britams/-capstone-project-repo/cad/README.md

# cad — FreeCAD 모델과 그림 (시간순)

담당: 서현. 모델은 생성 스크립트(`.py`)로 만들고 `.FCStd`를 함께 올린다. 치수는 `design/`의 설계 변수표(D6)와 상용 트랩 실측표에서 읽는다.
**지금 기준은 D5e다** (아래 7·8번). 서현 PC 사본은 `capstone design_이서현\CAD files\`에 있다 (FCStd + jpg, 11/02 정리).

## 규칙 (서현 지시, 11/01~02)
- 모델을 바꾸면 **그림(PNG/JPG)도 다시 만들어 올린다**. 사람이 바로 볼 수 있어야 한다. 정투영으로 렌더하고, 렌더 전에 시점 전환 애니메이션을 끈다(`setAnimationEnabled(False)`). 켜 두면 시점이 덜 돌아간 채 찍힌다.
- **전체 조립도에는 2020 알루미늄 프로파일 프레임과 상용 트랩을 반드시 같이 그린다.** 모듈만 있는 그림은 "모듈 확대"로만 쓴다.
- 프레임은 **정방형 20 시리즈(2020)만** 쓴다.
- 구매 부품 치수는 제조사 외형도나 McMaster-Carr로 확인하고, 근거를 스크립트 주석에 적는다.
- 이음부(끼움 길이·면 접촉·나사 길)와 움직일 때의 간섭은 `D5e_check.py`로 검사한다. 통과 결과는 json으로 남긴다.
- 저장 위치는 두 곳이다: 레포 `cad/`, 그리고 서현 PC `CAD files\`(FCStd + jpg).

## 시간순 기록

| # | 날짜 | 판 | 무엇이 바뀌었나 | 파일 | 그림 | 로그 |
|---|---|---|---|---|---|---|
| 0 | 10/02 | 초기 스케치 | 재설계 전, 스탬프 방식 첫 스케치 (Inventor). 10/28 재설계로 쓰지 않음. 내용은 파일 이름 기준 설명이고 열어 보지 않았다 | `10.2_first_stamp_method_sketch.ipt` | — | — |
| 1 | 10/28 16:26 | D5 1차 | 개념 모델, 안 1 바닥 승강형 (대기·마킹 두 자세) | `D5_concept_an1.py`, `D5_concept_an1_down/_up.FCStd` | `D5_도1_측단면_대기.png`, `D5_도2_측단면_자세고정_마킹.png` | CAP-AI-11 |
| 2 | 10/28 17:16 | D5b 2차 | 상용 트랩 실측 반영. 원통 하우징을 없애고 **바닥에 서는 2020 프로파일 프레임**으로 바꿈. 트랩과는 포획통 쪽만 결합 | `D5b_frame_an1.py`, `D5b_frame_an1_down.FCStd` | `D5b_전체_등각.png`, `D5b_측단면_대기.png` | CAP-AI-13 |
| 3 | 10/28 17:52 | D5c 3차 | 모듈 다시 그림. 겹침 0·뜬 부품 0 자동 검사 시작, 도면부호 그림 도1~4 | `D5c_module_an1.py`, `D5c_module_an1_mark/_rest.FCStd` | `D5c_도1~도4_*.jpg` (도면부호), 원본 `원본_렌더/D5c_A~D_*.png` | CAP-AI-14 |
| 4 | 10/28 19:50 | D5d 4차 | 안 B: 마커 XYZ 3축(28BYJ-48 ×3 + T8, SG90 펜 들기). 카메라를 격자 위 200 mm로(AI 카메라 최소 초점 20 cm). 카메라 시야 가림 0 검사 | `D5d_module_an1_B.py`, `D5d_module_an1_B_mark/_rest.FCStd` | `D5d_도5~도8_*.jpg` (도면부호), 원본 `원본_렌더/D5d_A~D_*.png` + 도면부호 위치 `D5d_pts*.json` | CAP-AI-16 |
| 5 | 10/28 21:21 | D5d 보완 | S4 1차 환류: X·Y 볼 부싱(LM8UU·LM6UU), 빔 끝 블록 두께 18, 샤피 크리에이티브 치수 | 위와 같음 | 위와 같음 | CAP-AI-18 |
| 6 | 11/01 | **D5e** 움직이는 모델 | D5d 이음부 결함을 찾아 모두 고침 (아래 표). 구동기 정밀 모델, 관절 변수 스프레드시트로 움직임, 이음부 86개·이동 17자세 간섭 검사 통과, 한 마리 처리 동영상 | `D5e_module_kinematic.py`·`.FCStd`, `D5e_check.py`·`D5e_check_result.json`, `D5e_animate.py`, `D5e_compose_video.py` | `D5e_동작_한마리처리.mp4`·`.gif` | CAP-AI-20 |
| 7 | 11/02 | **D5e 전체 조립** | 2020 실제 T홈 단면 프레임(부재 25개 + L 브래킷 32), 상용 트랩 상세, D5e 모듈을 한 문서로. 프레임·트랩과 모듈의 겹침 0 | `D5e_full_assembly.py`·`.FCStd`, `D5e_drawing_sheet.py` | `D5e_전체조립도.png`, `D5e_도1_전체_등각.png` ~ `D5e_도5_모듈_등각.png` | CAP-AI-21 |

## 6. D5e — D5d에서 찾은 결함과 고친 것 (11/01, FreeCAD로 확인)

| D5d 결함 | 근거 | D5e에서 고친 것 |
|---|---|---|
| 문판이 돌 자리가 없어 안 열림 | 15~90° 회전에서 하우징과 19~40 mm³ 겹침 | **MG90S 혼 핀이 문판 세로 홈을 미는 미닫이(스카치 요크)**: r 9, 혼 +60° 닫힘 / −60° 열림, 행정 15.6 |
| 펜 들기 부족 | 혼 최대 들림 8.46 < 캡 컵에서 빠지는 데 필요한 8.56 mm | 혼 끝(반지름 14, 끝 둥글기 2)이 늘린 평평한 탭을 밂 → 들림 10 mm. 홀더는 안내 핀 Ø3 ×2(슬리브 40)로 안내 |
| 마커가 격자 −x 끝에서 갠트리 레일과 겹침 | 1,140 mm³ | 갠트리 받침 레일 x 25 → −18, X 봉 −x 끝 19 → 9, −x 받침 늘림 |
| 리드스크루에 너트 없음 | 모델에 너트 부품 없음 | T8 황동 플랜지 너트(Ø22×3.5, 몸통 Ø10.2, 길이 15) 3개 |
| Y 봉이 끝 블록에 맞대기만 됨 | 끼움 길이 0 | Y 봉 z 445/475 → 438/468로 내려 끝 블록에 10 mm 끼움 |
| 밀대가 스프링을 건너뜀 | 스프링이 1 mm 떨어져 하중 경로에 없음 | 밀대 칼라가 스프링을 누르도록 |
| X 모터가 몸통으로만 닿음 | 귀(나사 구멍) 고정 없음 | 모터 판 + 귀 2개 나사 자리 |
| 모터 축 길이 비현실 | — | 28BYJ-48 외형도 치수(Ø28×19, 귀 35, 축 Ø5 D컷, 축 8 치우침) |
| 통로 꺾임이 관 두 개를 겹쳐 붙인 모양 | 서현 지적 "통로 모양이 말이 안 됨" | 굽힘관(중심 반지름 20)으로, 빛 게이트는 세로관에 |

구동기·구매품 치수와 근거:
- 28BYJ-48: Ø28×19, 축 Ø5(D컷 3, 길이 6), 축은 몸통 중심에서 8 mm 치우침, 귀 구멍 간격 35 (부품 외형도)
- SG90: 22.2 × 11.8 × 22.7, 귀 32.2. MG90S: 22.8 × 12.2 × 28.5
- 커플링 5 → 8 mm, Ø19.1 × 25.4 (McMaster-Carr 4147N159와 같은 치수)
- LM8UU Ø15×24, LM6UU Ø12×19

움직이는 법: `D5e_module_kinematic.FCStd`를 열고 스프레드시트 `Joints`의 값을 바꾼 뒤 다시 계산(Ctrl+R)한다. 값은 floor(바닥 0~36.5), xm·ym(마커), horn(펜 서보), support, door_entry·door_iso·door_rel(+60 닫힘 / −60 열림), 말벌 hx·hy·hz·hpitch다.

## 7. D5e 전체 조립 (11/02)
- 프레임 2020: 기둥 610 × 4, 레일 320 × 21 (둘레 4단 16, 가로 4, 갠트리 받침 1), 합계 9.16 m, L 브래킷 32. 바깥 360 × 360, 포획통 꼭대기까지 845 mm
- 상용 트랩(REF, 하중 없음): 유인액 통, 몸통, 노란 깔때기 ×2(Ø50 → Ø19), 차양막(Ø260, 윗면 180, 구멍 55, 4토막 턱 Ø90), 포획통(높이 220, 바닥 Ø94), 고무마개, 실리콘 포획술. 실측표 값을 쓰고, 몸통 지름과 포획통 최대 지름은 사진 비례로 잡았다 [추측]
- 다시 만들기 (FreeCAD 1.x 파이썬 콘솔):
  `import sys; sys.path.insert(0, r"<repo>\cad"); import D5e_full_assembly as A; doc = A.make_full(); [A.render(doc, r"<repo>\cad", v) for v in A.VIEWS]`
  → 이어서 `python3 cad/D5e_drawing_sheet.py cad` 로 한 장 조립도를 만든다

## 다음 수정 (D5f 예정)
- 펜 홀더 안내 핀을 혼이 미는 줄 쪽으로 옮김 (e_y ≤ 10 mm → 끼임 한계 μ_c 0.44 → 0.99, S4 2차 SJ-29). 그때까지는 핀을 PTFE 테이프로 감아 쓴다 (D6 10장)
- 스프링 204는 모델에서 뺌 (11/02 결정, S4 M3·M8)
- 전기 (11/02 결정, `design/2026-11-02_전기계통_제어순서_서현.md`): **Pi 5 상자를 같은 x·y에서 위판 아래(z ≈ 540~575)로 올림** (카메라 리본 680 → 290 mm, AI 판단·서현 위임), UNO 2를 UNO 1 위 15 mm 기둥에 겹침, 데크 위 단자대·퓨즈 자리(x −30, y −65), 비상 정지 버튼 자리, 구동 레일 배럴 잭(배터리 상자도 같은 플러그)
- 빛 게이트 9쌍 자리: G1·G4·G6 + **문마다 빔 2개(문판 앞·뒤 각 2 mm: 입구·격리 x ≈ 23·29, 방생 x ≈ 81·87)** (11/02 결정), 문판 앞 끝 실리콘 립 1 mm, 아래 조명, 투명 격자 (VespAI 점검)

## 2026-11-06 — D5f 전기 배치 (자리 표시, CAP-AI-23)
- `D5f_electrical_layout.py` → `D5f_electrical_layout.FCStd`, 그림 `D5f_전기배치_등각.png`, `D5f_전기배치_정면.png`, `D5f_문빔_위.png`
- D5e 전체 조립 위에 11/02 결정을 블록으로 표시: Pi 5 + AI HAT+를 위판 아래(z 565~600, CSI 300 mm), UNO 2를 UNO 1 위 15 mm, 단자대·퓨즈, 비상 정지, ULN2003 ×3, 빛 게이트 9쌍(송신·수신 블록 + 빨간 빔)
- 15:40 다시: **스프링 204 지움**(11/02 결정, 승준 Issue #7-4), 28BYJ-48 고정은 **M4 × 2** (귀 구멍 Ø4.2, Issue #7-8)
- 16:50: 문 하우징 112·170·176 위·아래 벽에 빔 구멍 Ø4.2 (입구·격리 x 23·29, 방생 81·87, y 0), LED Ø4 × 8 자리 [추측 — 실물 확인]. ULN2003 X·Y는 2020 기둥 바깥면, G6 위아래 빔. 겹침 검사 0건 (`D5f_electrical_layout.check`)
- **남은 것**: LED·보드 고정 브래킷 모양, 실물 LED 치수 확인

### D5f 바닥 안내 — 기성품 최대 (2026-11-06 18:38, 서현, CAP-AI-27)
- 서현 "최대한 기성품으로 사용할 수 있게 하고, 바꿔" → `D5f_electrical_layout.py`의 `floor_guide()`
- 지움: D5e 146 스프링·147 PLA 밀대·148 로드셀 (캐리지 위)
- 새로: 147 Ø4 × 80 경화 축, 149 LM4UU (캐리지 158 안), 146 스프링 (캐리지 아래 컵의 Ø4.4 구멍), 148 버튼 로드셀 (컵 바닥) — 넷 다 기성품. 컵은 캐리지와 한 몸(출력)
- 축 자리 (65, 4): 커플링·너트 플랜지·가이드봉 157을 피함. 바닥판 121 가운데 Ø5 구멍 막고 (65, 4)에 Ø6 비접촉 구멍, 바닥 140 축 자리 이동
- 바닥판 121에 LM4UU를 못 넣은 이유: 길이 12 > 판 5 → 아래 보스에 칼라가 바닥 끝까지 오를 때 부딪침
- `check_floor()`: 바닥 무리를 0 / 18.25 / 36.5 mm 올려 겹침 0건, 무리끼리 0건, 전기 배치 `check()` 0건
- 그림: `D5f_바닥안내_정면.png` (새), 등각·정면·문빔 다시
- 계산: `design/2026-11-06_S4_스프링146_역학계산_2차_서현.md` 8장

## 2026-11-06 저녁 — D5g 프레임 상세 + 부품 4분류 (승준, CAP-AI-SJ-39)
- 새 스크립트 `cad/D5g_frame_detail.py` — D5f를 그대로 만든 뒤 프레임만 바꿈 (D5e·D5f 스크립트는 안 고침)
- 2020 단면을 실제 모양으로: 홈 입구 6.2, 턱 1.8, 언더컷 11.0, 깊이 6.1, 코어 7.4, Ø4.2 → `section_check()` 0.452 kg/m · 0.717 cm⁴ (데이터시트 0.45~0.50 · 0.72)
- 브래킷 32(리브·홈 키·Ø5.5), M5 × 8 볼트 64, M5 슬라이드 T너트 64 — `check(doc)` 겹침 0건, T너트 64개 홈 안
- 모델 트리를 A 구매품 73 / B 설계품 42 / C 참고 10 / D 전기 자리 21 로 묶고 색칠 → 표 `cad/2026-11-06_D5g_부품분류_구매품과_설계품.md`
- D5f에 남아 있던 P204a·P204b(뺀 스프링 바탕) 지움. .FCStd·그림은 아직 안 만듦 (승준 PC FreeCAD에 열려 있음, 저장 안 함)

## 2026-11-06 밤 — D5g 급이 방·ULN2003·떠 있던 부품 (승준, CAP-AI-SJ-40)
- `cad/D5g_feeder_uln.py` (G.make()가 부름): 설탕물 급이 = 팰컨 50 mL 거꾸로 + 코튼롤 2호 + 143 물길·그릇·기둥, 120 벽 Ø10.6 구멍, 144·142 상자 뺌
- ULN2003 판매품 모양 35 × 31.9 × 11 (X·Y는 갠트리 레일 위 197 받침, F는 데크), Pi 5 선반 199a, G4·G6 받침 199b·c
- T너트 판매품 10 × 9.5 × 4.5(아래 경사), 브래킷 키 0.5. 새 부품 겹침 0건, `floating()` 남은 것 0 (빛 빔 제외)
- 상용 트랩 포획통(REF_trap_container)은 지우지 않음 — 보기용으로 숨기지도 않기
- 설명: `design/2026-11-06_급이방_개념설계_ULN보드_승준.md`

## 2026-11-06 밤 — D5g 이음부·체결·급이 방 상세·막대 로드셀·서현 회로 요청 (승준, CAP-AI-SJ-49)
- 승준 지적: 프로파일 연결 안 됨 / 부품 지지 안 됨 / 부품 명시 안 됨 → 전부 고침
- `D5g_frame_detail.joint_places()`·`add_joint_hw()`: 가로대 100c ×4·갠트리 레일 100d 양 끝 T 이음 브래킷 20 + M5 × 8 40 + T너트 40 (옆면에 — 아래 면은 받는 레일 높이 20을 넘어 볼트 홈이 없음)
- `D5g_fasten.py` (새): 닿음 그래프(거리 ≤ 0.3)로 확인 후 '닿기만' 한 것 볼트 체결 — 218 X 봉 받침(둘레 레일 쪽은 봉이 지나가서 귀 + M5 × 12), 217 X 모터판 날개, 105 위판·101 데크 M5 × 10 × 4, 199a Pi 선반·194b 비상 정지 판 M5 × 8 × 2, 151 옆판·102 칼라는 데크 아래 M3 × 10 → 인서트
- `D5g_feeder_uln.feeder_detail_apply()`: 마킹실 벽 보스 2 + 물길 귀 M3 × 8, 뚜껑 손나사 4 (기둥 위 인서트), 튜브 똑딱 집게 고리, 코튼롤 잡이 리브. McMaster 94459A130·92545A111·91292A112·7979T44 (페이지에서 직접 확인)
- `loadcell_apply()`: 148 버튼형 → Adafruit 4540 막대(80 × 12.7 × 12.7), +y로 뻗음, 캐리지 팔 158a에 M5 × 12 × 2, 자유 끝 받침판 148s + M4 × 10. 급이 기둥 x −3 (자리 비움)
- `D5g_real_parts.apply_wago()` 5개 / `apply_circuit_extras()` 서보 허브·게이트 허브(+ J_I2C XH 4P)·MOSFET 모듈·패널 퓨즈 / 문 빔 LED 다리: 하우징 살 밖에서 90° 꺾어 옆으로 6 mm (자동 탐색)
- 새 부품·고친 부품 55개 ↔ 전체 184개 겹침 검사 0건 (인서트·나사산 맞물림, 핀이 기판을 지나는 것은 구멍으로 모델) [확실 — 스크립트]
- 부품표 `cad/2026-11-06_D5g_부품표_승준.md` (`D5g_parts_table.py`가 모델에서 뽑음), 그림 `cad/img/D5g_parts_balloon.png`·`D5g_feeder.png`·`D5g_loadcell.png`·`D5g_joint_T.png`
- .FCStd 저장 안 함 (서현만 편집 규칙) — `G.make()`로 다시 만듦 (승준 PC 약 55 s)

## 2026-11-08~09 밤 — D5g 서현 요청 고침: 십자 나사·문 서보·모터 귀·카메라 CM3·회로 기판·3D 프린트 색 (승준, CAP-AI-SJ-53)
- 새 스크립트 2개, `G.make()` 끝에서 부름 (다른 D5 스크립트는 안 고침 — `D5g_frame_detail.py`는 부르는 4줄만):
  - `cad/D5g_fix_sj53.py` — 나사·문 서보·모터 귀·카메라·홈 파기·드라이버 검사·색
  - `cad/D5g_circuit_sj53.py` — 허브 기판 2장·MOSFET 모듈·기판 나사 (서현 `전기회로/hub_boards.py`를 GitHub에서 받아 그대로 배치, KiCad 공식 3D)
- 1 브래킷: 육각 렌치 볼트 → **십자 냄비머리 ISO 7045** 전부 (M2~M5). 브래킷 100f·100f2 M5 × 8 104개는 자리를 placement에서 다시 계산 → 머리끼리 겹침 0 (틈 위아래 0.3·옆 0.25 mm) [확실 — 모델]
- 7 문 서보 112·170·176: 기둥이 하우징 밖으로 떠 있던 것 → 하우징 −y 7.4 mm 늘려 기둥 2개 모두 한 몸, MG90S 귀 M2 × 8 셀프 탭 6개
- 7 스테핑 모터 153·209·215: 귀 양쪽 M3 × 8 + 너트 (M4 너트는 몸통 R14에 틈 0). 153은 로드셀과 닿아 접시머리 + 152 접시 자리, 151 L/R에 드라이버 홈 [서현 M4 결정과 다름 → Issue]
- 카메라: AI 카메라(최대 30 fps) → **Camera Module 3 (IMX708)**, 1536 × 864 @ 120 fps 모드(가운데 잘라 씀)로 720p 60 fps. 렌즈 끝 → 격자 **153.5 mm**, 걸이 181(위판에 M3 × 10 + 인서트), 링 조명 182, 시야 `REF_camera_view`
- 2 회로: 허브 193v·193g 구멍·헤더·부품·선(버스·땜납 다리·점퍼), MOSFET 모듈 부품 26 [추측 — 판매 사진 배치]. 나사 단자는 덱 가장자리(+y) 쪽으로 돌림 (−y는 게이트 허브와 5 mm라 전선 못 꽂음)
- 기판 고정: 암-암 기둥 + 위·아래 십자 나사. 데크 밑 가로대(y +80) 위 4자리는 **198n 나일론 스페이서 + 긴 나사(M2 × 14 / M3 × 12)를 데크 아크릴 탭 구멍에** (아래 나사가 가로대에 박힘)
- 색: B1 3D 프린트 **주황 (0.95, 0.45, 0.05)** 41개 / B2 판 가공 베이지 (데크 101·위판 105) / 황동 = 인서트·T너트·기둥 / 새 나사 거의 검정
- 검사 [확실 — 스크립트]: 새 부품 ↔ 전체 겹침 = 나사산 맞물림(기둥·탭 구멍·셀프 탭)과 아래 3가지뿐
  - 서보 허브: C2(디스크) ↔ SB540 몸통 1.9 mm³, C2 ↔ 1000 µF 2.1 mm³ — **서현 배치 17·18·19열이 너무 붙음** → Issue
  - 서보 허브: SB540 다리 Ø1.2~1.3 > 만능기판 구멍 Ø1.0 (1.7 mm³) → 두 구멍 Ø1.5로 넓혀야 → Issue
  - 게이트 허브: J_I2C 하우징 ↔ 옆 헤더 핀 0.13 mm³ → Issue
- 드라이버 검사 (머리 위 60 mm, PH 드라이버 지름): 기판 나사 24개 모두 됨. 안 되는 13곳은 조립 순서로 — 카메라 M2 × 4는 링 조명 전에, 바닥 모터 M3 × 2는 캐리지·로드셀 전에, Y 캐리지 M3 × 2는 캐리지 옮기고. 143s M3 × 2·158 받침 M4·175 서보 M2·급이 발 M5는 남은 문제
- 그림: `cad/img/D5g_SJ53_*.png` 8장 (전·후, 이름표·화살표). .FCStd 저장 안 함 — `G.make()`로 다시 만듦 (승준 PC 약 75 s)

## 2026-11-09 — D5g 서현 인수: FCStd 저장, C3 HX711·DC 잭, 원점 스위치 3개, 투명 격자, 그림 (서현, CAP-AI-55)
- **C1** `cad/D5g_full.FCStd` 처음 저장 (9.8 MB, 물체 208 · 고체 약 3780). [확실] 승준 스크립트는 GUI 전제(`ViewObject`)라 freecadcmd로는 멈춤 → **FreeCAD GUI를 매크로와 함께 실행**해 만들고 검사 (`freecad.exe <매크로>`, 서현 PC 약 3분)
- **C2** 검사 (서현 PC): `check(doc)` 프레임 겹침 **0건**, 뜬 부품 **0건** (승준 `floating()`과 같은 판정을 고체 상자로 먼저 거르게 해서 87 s — 원래 함수는 이 PC에서 1시간 넘게 안 끝남). 승준 기록과 같음. 게이트 허브 부품 ↔ 선 14 mm³는 승준 모델에도 같은 값 = 납땜 자리
- **C3** `D5g_c3_hx711_dcjack.py` (새, `make()` 끝에서 부름)
  - HX711 198x: 제안 자리 (66, 95)는 급이 물길 143과 468 mm³ 겹치고 데크(y ±90) 밖 → 데크를 2 mm로 훑어 빈 자리 3곳 중 가장 가까운 **(−44.5, 54)**, 긴 쪽 y. 받침 198xc (3D 프린트) + M3 × 8 접시머리 2 (데크 탭)
  - DC 잭 194j: 제안 (−184, −22)은 비상 정지 버섯 머리(Ø40)와 플러그가 겹침 → **(−184, −35, 225)**, 194b 판을 −y로 22 mm 늘리고 Ø8 구멍
  - 겹침: 나사산 맞물림(데크 탭)뿐
- **J_I2C 193j** (Issue #9-5, 펌웨어 대화 CAP-AI-54): `D5g_real_parts.py` 4줄 — 게이트 허브 줄 6 칸 22~25 가로, 1번 핀 판 기준 (57.86, 16.27)
- **원점 스위치** `D5g_home_switches.py` (새, 서현 결정 11/09): KW11-3Z 3개 (승준 `sj_purchased_parts.py` 치수) — 레버가 닿는 면은 선을 쏘아 잼
  - F 227f: 151_L 안쪽 면, 바닥 0 mm에서 캐리지 158 아랫면 **z 262**가 누름
  - X 227x: 새 집게 226 (X 봉 −y, 3D 프린트, M3 조임) 밑, **xm 37 (펌웨어 X −18)**에서 Y 모터 브래킷 211 −x 면이 누름
  - Y 227y: 끝 블록 212A −x 면, **ym −40**에서 **펜 홀더 202 −y 면(y −54)**이 누름 — 캐리지 206 −y 면은 212A가 1 mm 틈으로 가려 못 씀
  - 검사 `HS.check(doc)`: 닿음 F 0 · X 0.044 · Y 0 mm, X 4 × Y 3 × 바닥 2 = 24 자세 겹침은 M2·M3 나사산뿐 (38 s)
  - → **펜 대기 자리 = 캡 컵 219 (CAD 65, −40) = 펌웨어 X +10 · Y −40** (X 0 = CAD 55, 원점 −18 = CAD 37). Pi `Config.park` 값 그대로 맞음 [확실 — 모델]
- **카메라 시야** (3-A 3): 렌즈 끝 z 540 → 격자 z 386.5, 40 × 40 기둥 안에 닿는 부품 0 (대기 자리에서 펜·캡 컵은 y −49~−23) [확실 — 모델]
- **격자 130 = 투명 아크릴 1.5** (서현 11/09, 구멍 그대로 — 그림은 하늘색 반투명). 링 조명 반사는 조명 시험 때 확인
- **모터 귀 = M3 × 8 + 너트 + 평와셔** (서현 11/09, Issue #9-2). 와셔는 부품표에만
- **C4** `D5g_render.py` (새, GUI 매크로, 정투영·애니메이션 끔): `img/D5g_도1_전체_등각`·`도2_정면`·`도3_측면`·`도4_위` (프레임 + 상용 트랩), `img/D5g_전기배치_위`, `img/D5g_부품번호_풍선도` — 한 장씩 열어 확인 (화살표 끝 자리 0.52배 어긋남 → 고침, '−' 글자 없음 → '-')
- 다시 만들기: `freecad.exe` 파이썬 콘솔에서 `import sys; sys.path.insert(0, r"<repo>\cad"); import D5g_frame_detail as G; doc = G.make()` (인터넷 필요 — KiCad STEP·hub_boards.py) → 그림은 `set D5G_FILE=...` 후 `freecad.exe cad\D5g_render.py`
- 남은 결정 (정하지 않음): 방생 출구 안 1/2, 급이 바닥 높이 370, 3D 프린터 판 크기, 드라이버 안 들어가는 4곳 (SJ-53)

## 2026-11-10 — 급이 방 고침 (서현, CAP-AI-56)
- 11/06 급이 방 결함 3개 [확실 — `cad/feeder_check.py`·모델]: ① 맑은 날 열팽창으로 물 +6.7~13.0 mm → 벽 구멍(여유 3.6) 넘어 마킹실로 샘 (승준 계산 2.6 mm는 물 면적에 튜브 자리를 셈 + 수증기 빠뜨림) ② 솜 끝이 마킹실로 4 mm 나와 바닥이 33 mm 넘게 오르면 짓누름 ③ 급이 높이 F 10이면 솜이 말벌보다 23 mm 위
- 고침 (`D5g_feeder_uln.py` FD): 튜브 50 → **15 mL (코닝 352096)**, 물(입구) 369 → **366**, 솜 안 끝 (16, 379) → **(21.4, 378) 벽 안 면 뒤 0.2**, 바깥 끝 (58.28, 368.85), 벽 구멍 z 378.0, 받침 리브 반지름 8.3. 급이 높이 F 31 (pi_link·trap_sim)
- 검사: `python cad/feeder_check.py` 6개 통과 (11/06 값은 1·4번 실패). 서현 PC에서 `G.make()` 다시 → `D5g_full.FCStd` 저장, 급이 부품 ↔ 전체 겹침 0, 바닥 0~36.5 mm 올림 vs 솜·벽·물길 겹침 0
- 그림: `img/D5g_급이방_단면_x55.png` (모델을 x = 55에서 자른 선, FreeCAD 안 matplotlib), 전체 그림 6장 다시 (`D5g_render.py`). 원리 동영상 `design/img/feeder/급이방_원리.mp4` (`design/calc/feeder_anim.py`)
- 설명: `design/2026-11-10_급이방_원리_사용법_고침_서현.md`

## 2026-11-10 오후 — 급이 방 McMaster 상세 + 부품별 파일 (서현, CAP-AI-57·58)
- McMaster STEP 5종을 받아 `cad/vendor_step/`에 둠 (레포에 안 올림). 급이 방 나사·인서트를 실제 모양으로 넣는 것은 `D5g_feeder_mcm.py`.
- 발 고정을 바꿈: 위에서 조이는 M5 + T너트 → 데크 아래에서 조이는 M3 × 8 (92000A118) + 발 인서트. 위에서는 그릇·서보 허브·로드셀 때문에 드라이버가 안 들어감. 데크를 프레임에 올리기 전에 조인다.
- 물길을 마킹실 벽에 붙이던 나사 2개를 없애고 앞벽을 추가함. 뚜껑 구멍 깊이 7, 기둥 Ø9, 손나사 자리 y 60.
- 부품별 파일은 `cad/parts/feeder/` (`feeder_parts.py`): 부품 7종과 App::Link 조립 파일. 검사를 모두 통과했고 `D5g_full`과 같다. 자세한 것은 그 폴더의 README.
- 남은 결정: 143을 둘로 나눌지 (출력 서포트 문제), 프린터 판 크기.

## 기본 CAD 파일 (서현 11/10 16:26 지정)
- **기본 파일 = `cad/D5g_full.FCStd`**: 3D 프린트 부품은 파랑, 나머지는 회색 (`D5g_print_color.py`, `make()` 맨 끝에서 칠함). 그림과 검사는 모두 이 파일로 한다.
  - 레포 판: McMaster 나사·인서트를 표 치수로 만든 단순 모양 (레포가 공개라서)
  - 서현 PC `CAD files\D5g\D5g_full_McMasterSTEP.FCStd`: 같은 색, 나사는 McMaster STEP 실제 모양 (레포에 안 올림)
- 급이부 부품 파일 `cad/parts/feeder/`도 같은 색 규칙이다.
- 예전 D5b~D5f FCStd는 기록용이다. 고치지 않는다.
- 2026-11-14 (서현, CAP-AI-62) 리프트 v2 (`lift_v2.py`): 바닥 덩어리 → 스프링 McMaster 9657K33 + KY-024 홀 (2.5 mm 줄면 0.48 N). 홀 모듈을 판·LM393·가변저항·핀·SS49E(다리로 세움)로 그림. 마킹실 상자 프린트 파일 따로 `print/lift/300_마킹실상자.{stl,step,FCStd}` (`lift_v2_box_print.py`) — 인서트 Ø4 × 6 자리 (±14, ±14), 세로 모서리 R1. 검사: 겹침 0, 캐리지 레일 안, 펜 69/69
- 2026-11-14 (서현, CAP-AI-62) 리프트 v3 (`lift_v3.py`): MiniSlide·거더·스프링·홀을 버리고 mightyZAP D7-6PT-3 (디바이스마트 101,000원, 행정 26, 6 N, PWM 위치 지정) 하나로. 로드 끝 M3 무두 볼트 + 너트 2 + M4·M10 DIN 9021 = 바닥, 뒤 경첩은 세운 2020 옆 홈에 M3 × 20 + 원형 스페이서 Ø6 × 4 + T너트. 판매처 STEP은 PC 받은도면에만. 검사: 겹침 0 (바닥 −7 → +3), 펜 69/69, 로드 8 → 18 mm (행정 26 안)
- 2026-11-14 (서현) 마킹실 상자 바깥 46 → 38 × 38 (안 Ø31·높이 18.5 그대로, 인서트 (±14, ±14) 벽 3 mm), 재료 24.4 → 13.0 cm³. `print/lift/300_마킹실상자.*` 다시 냄. v3 검사 겹침 0, 펜 69/69
- 2026-11-14 17:30 (서현) 마킹실 상자에 격자 한 몸 (Ø3 · 간격 4.4 · 두께 1.5, 구멍 37 — 비전 자와 같은 격자) → 망·인서트·망 나사·와셔 16개 뺌. 안 Ø31 → Ø33 (여왕벌 30 + 2, `design/2026-11-12_마킹실_최소크기_계산_서현.md`), 바깥 40 × 40, 윗면 z 9.5, 재료 16.1 cm³. 바닥 = McMaster 90313A108 (Ø31.75 × 1.3) + M4 DIN 9021 + M3 × 8 무두 볼트 + 너트. 프린트는 윗면(격자)을 판에. 검사: 겹침 0, 펜 37/37
- 2026-11-14 17:30 (서현) 격자는 투명 아크릴 주문 제작으로 (두 번째 예외). 부품 파일 2개 따로: ① `print/lift/300_마킹실상자.{FCStd,step,stl}` (프린트, 40 × 40 × 18, 13.7 cm³, 윗면 M3 인서트 4) ② `print/lift/300p_아크릴격자판.{FCStd,step,dxf}` (주문 제작, 2T 40 × 40, 네모 구멍 3.0 간격 4.4 × 37 — 열린 면적 46 %, 나사 구멍 Ø3.4 × 4). DXF는 `lift_plate_dxf.py`로 (FreeCAD 없이). v3 검사 겹침 0, 펜 37/37
- 2026-11-14 18:15 (서현) 전체 수정 1단계: 마킹실 상자 38 × 38 (옛 벽 바깥과 같음), 문 구멍 4 (−x 입구·+x 방생·−y 격리 Ø13, +y 급이 Ø11.2 솜 축 따라), 날개 → 밑 혀 24 + M5 × 10 두 개 (세운 2020 +y 홈), 세운 2020 = 데크 205 → 361 (156 mm). 아크릴판 38 × 38 (나사 구멍 (±15, ±15)). 전체 좌표 = 리프트 좌표 + (55, 0, 377). `s2_chamber_v3_check.py`: 전체와 겹침 0 (옛 마킹실·바닥 구동·컵 받침 뺌, 문·통로는 2단계). 상자 9.45 cm³, 판 2.15 cm³
- 2026-11-14 21:45 (서현, CAP-AI-62) 전체 수정 끝: `s2_doors_v3.py` (S2 고쳐 씀 — 문 3개: 입구 −x 축 376.5 서보 +y · 방생 +x 서보 +y · 격리 −y, 격리 관 −y → 세로 (55, −135) → z 557 가로 → 깔때기, 대기 PARK (75, −40)), `full_merge.py` → `D5g_full.FCStd` + 바탕화면. 검사: 바뀐 것 ↔ S1·S2·S3 정지 겹침 0 (원래부터 있던 4개 빼고), 마커 움직임(`s2_motion_v3_check.py`) 새로 닿는 것 0
- 2026-11-14 23:40 (서현, CAP-AI-62) 바닥 원판 304: McMaster 90313A108 + M4 DIN 9021 (해외구매 → 정산 불가) → **아크릴 Ø32 × 2T 구멍 Ø3.4** (격자판과 같은 판, 같이 주문 제작). DXF `print/lift/300f_아크릴바닥원판.dxf` (`lift_plate_dxf.py`). 쌓임 4.67 → 4.4, 액추에이터 0.27 mm 위로. 검사 [확실 — CAD]: 리프트 혼자 sweep 0 · static 0 · 펜 37/37 · 누름 틈 5.0, s2_doors_v3 다시 → 바뀐 것 겹침은 원래 있던 G2↔110b 19.9뿐. S2 ← S2_v3, full_merge·움직임 검사 다시
- 2026-11-15 00:35 (서현, CAP-AI-62) 리프트 나사: 열압입 인서트(인두 필요 — '나사로 조이기만'에 어긋남) → 상자 윗면 밑구멍 Ø2.5 + M3 × 8 태핑 4, Ø6 × 4 스페이서(Harwin, 해외) → M3 너트 1 + DIN 125 와셔 3, 혀 나사 = 20시리즈 M5 스프링너트. 상자 프린트 파일 다시 (9.56 cm³, solid) · 리프트 검사 겹침 0. 아크릴 묶음 DXF `print/lift/300pf_아크릴_묶음_100x90_2T.dxf` (아크릴몰 50 mm 밑 재단 불가 → 격자판 2 + 바닥 원판 2를 한 장에)
- 2026-11-15 01:10 (서현, CAP-AI-62) 서현 "출력 대행 주문 OK" → 남은 프린트 부품 32개를 `print/all/`에 STL·STEP으로 뽑음 (`_print_all.py`, D5g_full 초록 부품, 모두 isValid·메시 닫힘, 합 423.7 cm³). 비상 정지 판 194b 구멍 Ø22.5 → **Ø25.5** (`s3_estop25.py`, KGE-J4R1R 25Φ 국내 재고) → S3·D5g_full 다시. CAD 안 비상 정지 몸체는 22Φ 대표 모양 그대로
- 2026-11-15 02:12 (서현, CAP-AI-62) '자르기·인두·탭' 없애기: ① 자르던 부품 13개(급이 물길·뚜껑·기둥·발·위·병 걸이, 깔때기 2, PVC 관 5토막) → 출력 대행 `print/all2/` (`_buyfix1115.py`, 모두 solid) ② 데크 101·위판 105 → 레이저 DXF `print/all2/*_레이저_5T.dxf` (탭 구멍 M2 1.6 → 2.4, M3 2.5·2.7 → 3.4 + 아래 너트) ③ **세운 막대 307v 밑 고정이 빠져 있었음** → L 브래킷 DCB 2025(−y 면) + M5 × 8 스프링너트 + M5 × 12·너트, 데크 구멍 Ø5.5 (73.3, −22) (`lift_v3.py`, `s3_deck_hole.py`) ④ 열압입 인서트 없앰: 카메라 걸이 181 구멍 Ø4 → 태핑 Ø2.5 (출력 파일도), 데크 인서트 100n → 관통 + 너트 (`s3_insert_to_tap.py`) ⑤ 바닥 F 드라이버(DRV8833) 자리 195p·198_F 지움. S2 ← S2_v3 (lift 라벨·브래킷), full_merge. 검사 [확실 — CAD]: s2_doors_v3 겹침은 원래 있던 G2↔110b 19.9뿐, 움직임 새 접촉 없음 (펜 내린 높이 4개 그대로). PC 클론 커밋 5758cda
- 2026-11-15 02:48 (서현, CAP-AI-62) 서현 "안 자르고 그대로" → 봉·T8 규격 길이: X 봉 Ø8 163 → **200** (+x), Y 봉 Ø6 124 → **150** (+y), 안내 핀 Ø3 69 → **70** (위), X T8 93 → **150** (−x, 모터 반대), Y T8 133 → **150** (+y). 먼저 `_stdlen_check(2).py`로 여러 길이를 움직임 범위에서 검사 [확실 — CAD]: X 봉 200~300·Y 봉 150~200·핀 70~80·X T8 100~300·Y T8 150~200은 218·212 막힌 구멍 말고 안 닿음, Y T8 300은 갠트리 레일·격리 관에, 핀 100은 문 하우징에 닿음. `s2_stdlen.py`로 S2 고쳐 씀 + 218(+x)·212(B) 구멍 끝까지 + 출력 파일 다시. 고정 겹침: 212 ↔ 227ys M2 셀프 탭 나사(원래 설계 — 나사가 블록에 박힘)뿐. 움직임 검사(고정 대상에 213·218 더함) 새 접촉 없음. ※ s2_doors_v3를 다시 돌리면 그 뒤에 s2_stdlen도 다시. PC 클론 커밋 edc7962
