britams/-capstone-project-repo/전기회로/README.md

# 전기회로 — 한곳에 모은 지도와 만드는 순서 (서현, 2026-11-08, CAP-AI-49)

**쉬운 설명(그림 포함)은 `전기회로_설계_쉬운설명.html`** — 더블클릭하면 브라우저로 열린다 (레포 폴더 안에서 열어야 회로도 그림이 보임).

## 0. 결론 먼저
- [확실] **회로는 이미 정해져 있다** (11/06, CAP-AI-23~38): 회로도 4장, 넷리스트 64개, 핀 검사 통과, 구매표, 단계별 배선, 하네스표, 배터리 상자. 펌웨어 v0.2도 같은 핀으로 컴파일·시뮬 통과 (11/08).
- 남은 일은 **새로 설계하는 것이 아니라 실물로 만들면서 확인하는 것**이다 → 아래 2장 순서.
- 11/08 추가 설계 (3장): 허브 기판 배치(검사 통과), 역극성 보호 D_RP, 카메라 연결 정리.

## 1. 파일 지도 (원본은 그대로 그 자리에 — 옮기면 다른 문서·코드가 깨짐)
| 알고 싶은 것 | 파일 |
|---|---|
| 회로 전체 (핀표·넷리스트·회로도 4장) | `design/2026-11-06_회로설계_서현.md`, 그림 `design/img/circuit/` |
| 회로의 원본 (여기를 고치면 회로도·넷리스트·검사가 다시 나옴) | `design/circuit/circuit.py` → `design/circuit/out/netlist.csv`, `bom.csv` |
| 쉬운 설명 (회로도 읽는 법) | `design/2026-11-06_회로_쉬운설명_서현.md` |
| 살 것 (판매처·가격·1~3차) | `design/2026-11-06_전기부품_구매확정표_서현.md` |
| 하나씩 꽂고 확인 (B1~B5) + 시험 스케치 | `design/2026-11-06_브레드보드_단계별_배선_서현.md`, `design/circuit/bringup/b2~b5` |
| 선 하나하나 (43묶음 · 115가닥 · 45.1 m) | `design/2026-11-06_하네스표_서현.md`, `design/circuit/harness.py` |
| 배터리 상자 (B6) | `design/2026-11-06_배터리상자_회로_서현.md` |
| 전류·퓨즈·에너지 계산 | `design/2026-11-02_전기계통_제어순서_서현.md`, `design/control_sim/elec_budget.py` |
| UNO에 올릴 펌웨어 | `design/circuit/firmware/trap_motion`, `trap_doors` |
| 시뮬레이터·Pi 코드 | `관련코딩저장/` |

## 2. 만드는 순서 (각 단계 통과 기준을 지나야 다음으로)
| # | 할 일 | 통과 기준 | 근거 |
|---|---|---|---|
| E1 | 1차 부품 주문 — **CAD가 끝난 뒤** (서현 11/08). 카메라 FFC 500 mm(E18)·SB540·만능기판 2장 포함 | 1차 목록이 집에 옴 | 구매확정표 1장 |
| E2 | **B1 힘 길만**: 어댑터 → 퓨즈 → 비상 정지 → 와고 | 와고에서 5.0 V, 비상 정지 누르면 0 V | 브레드보드 1단계 |
| E3 | **B2 UNO 2 + 게이트 1쌍** (`b2_gate`) | 가리면 BLOCK, 's' 자가 시험 OK, RAIL 0/1 | 2단계 |
| E4 | **B3 문 서보 + 문 빔 2개** (`b3_door`) | 켬−끔 차이 ≥ 200, 빔 막으면 안 닫힘, 닫다가 막으면 다시 열림 | 3단계 |
| E5 | **B4 UNO 1 + 바닥 축 + 원점** (`b4_axis`) | 'h' → HOME OK | 4단계 |
| E6 | **B5 로드셀** (`b5_loadcell`) + 전부 연결 | 100 g 추로 눈금, 흔들림 ≤ 0.1 g, 전체 전류 1.9 A 아래 | 5단계 |
| E7 | **펌웨어 v0.2 올리기** (`arduino-cli upload`) → `pi_link` 켜기 순서 | `boot()` 끝까지, SELFTEST 9쌍 OK | `관련코딩저장/README.md` |
| E8 | 실물 값으로 `#define 미검증` 채우기 (문 각도, 펜 각도, 닫는 속도 등) | 값마다 시험 기록 | 펌웨어 머리말 |
| E9 | 허브 기판 납땜 → 하네스 자르기·꼬리표 → 본체 장착 | 하네스표 길이, 핀 검사 다시 | 하네스표 3장 |
| E10 | (현장 시험 정해지면) **B6 배터리 상자** | GND 고리 < 50 mV | 배터리 상자 4장 |

## 3. 11/08에 설계한 것 (CAP-AI-50)
1. **허브 기판 배치** → `hub_boards.py` (실행하면 `out/*_top.svg`·`*_solder.svg`·`hub_pinout.md`). circuit.py 넷과 대조: 합선 0, 끊김 0 (일부러 합선·끊김·핀 잘못·핀 구멍 점퍼를 넣어 검사기가 잡는 것 확인).
   - 게이트 허브 70 × 30: 게이트마다 2칸 (헤더 + 저항), 버스 +5V(위)·EMIT_LO·GND(아래), 헤더 핀 49, 저항 16 (220 Ω 6 + 10 kΩ 10), 점퍼 9, J_I2C는 CAD 자리(오른쪽 끝 10 mm) 그대로
   - 서보 허브 60 × 40: 서보 3핀 헤더 4 + 신호 핀 4 + **C1 1000 µF·C2 100 nF·D_RP** (circuit.py가 C1·C2를 서보 허브로 적어 둠)
   - 헤더 핀 순서 (하네스 쪽 듀폰 하우징도 같게): 문 빔 **C · A · E · K**, 통로 2167 **T+ · R+ · S · R− · T−**, 서보 **갈 · 빨 · 주**
2. **역극성 보호 D_RP** (AI 판단): 쇼트키 **SB540** (5 A)를 레일에 **거꾸로 걸침** (줄 K → +5V_B, A → GND), 서보 허브 위. 평소 전압 손실 0, 극성이 반대인 어댑터면 퓨즈 3 A가 끊김. 직렬 다이오드는 0.3~0.5 V 떨어져 MG90S(4.8 V~) 사양 밑이라 안 씀. circuit.py 넷·BOM에 넣음 (검사 통과). SB540 사양은 [가능성 높음] — 사기 전에 사양서 확인
3. **카메라** (원래 정해져 있었으나 문서가 흩어져 있었음): Raspberry Pi AI 카메라 IMX500 (보유), 격자 위 200 mm, **Pi 5 CAM0 (22핀) ↔ 카메라 (15핀) FFC 500 mm** 하나로 신호·전원 (아두이노와 무관). circuit.py·회로설계 문서의 '300 mm'를 500 mm로 고침 (11/07 하네스 확정 CAP-AI-38·구매 E18과 맞춤). 자세히는 HTML 8-1장

## 3-1. 11/09 고친 것 (CAP-AI-54, 승준 Issue #9 3~6번)
- `hub_boards.py`에 **부품 몸통 겹침 검사**를 더했다 (몸통·헤더 하우징·전선·귀 기둥·판 가장자리). 그전 배치를 넣으니 C2↔D_RP, C2↔C1이 승준 CAD와 같이 걸렸고, D_RP↔C1(−5.0 mm)도 걸렸다. → 서보 허브: D_RP c17, C1 c19 r11~13 (몸통이 GND 버스 위), C2 c20 r5~6, **전원 전선 c20 → c22** (그대로면 C1 몸통 밑). 넷·몸통 검사 통과.
- SB540 구멍 c17 r5·r11은 **드릴로 Ø1.5 mm** (그림에 빨간 고리).
- J_I2C: CAD 193j는 가로로 (60, 15)에 놓여 **핀이 구멍 줄 사이**에 왔고, 레일 핀과 0.23 mm 겹쳤다 (검사가 같은 것을 잡음). → **줄 6, 칸 22~25 가로**, 가운데 (61.67, 16.27) mm (판 왼쪽 아래 기준). CAD는 승준이 맞춤 (Issue).
- 와고 5개는 그대로 (AI 판단, 서현 위임): +5V 8구·GND 11구가 circuit.py와 맞고, 줄이려면 하네스(43묶음)를 다시 짜야 한다. 와고 값은 한 개 약 1,500원이라 줄여도 이득이 작다 [추측].
- 카메라 → CM3 (승준 SJ-53): 전기 연결은 같다 (15핀 리본 → CAM0) [가능성 높음]. 카메라 자리가 바뀌어 FFC 500 mm가 여전히 맞는지는 CAD 값으로 다시 잼 (3-B 3번).

회로도 PNG 4장 다시 그림 (CAP-AI-52): 1장에 D_RP·카메라 500 mm 들어감. Windows에서는 맑은 고딕으로 그림 (`python design/circuit/circuit.py`, `battery_box.py`)
## 4. 펌웨어(11/08)가 회로에 기대는 것 — 회로를 바꿀 때 같이 보기
- UNO 2 D2 레일 감지는 **내부 풀업을 쓰지 않는다** (외부 10 kΩ ← +5V_B. 내부 풀업이면 레일이 꺼져도 HIGH).
- 통로 게이트 D7·D8·D12는 허브의 **외부 10 kΩ 풀업**, 문 빔 A0~A5는 **10 kΩ → GND** (빛 받으면 높음).
- 켤 때 서보를 붙이지 않고, 붙일 때 하나씩 0.3 s 간격 → 켤 때 3.27 A 문제는 펌웨어로 막음. 퓨즈 3 A는 그대로.
- 원점 스위치 A3~A5는 UNO 내부 풀업 + 스위치 옆 100 nF.
