britams/-capstone-project-repo/cad/split/README.md

# CAD 3부분 나눔 (서현, 2026-11-11~12, CAP-AI-62)

서현 지시 (11/11 23:27): "급이부, 마킹부, 프레임 및 회로로 나누어서 보자. 한꺼번에 많이 고치지 말고, 각각 다 마치면 마지막에 어셈."

| 파일 | 들어 있는 것 (번호) |
|---|---|
| `S1_급이부.FCStd` | 142·143·144 — 물길·뚜껑·솜·기둥·앵글·니플·병·펌프·관·버림통·걸이 |
| `S2_마킹부.FCStd` | 104, 110~176, 196_gate·199b~e, 200~227, REF_hornet 등. 벌이 지나는 길(통로·문·게이트 센서), 마킹실·격자, 바닥 승강·누름, 마커 XY, 원점 스위치 |
| `S3_프레임회로.FCStd` | 100~105, 180~199 (게이트 센서 빼고), REF_trap*. 2020 프레임·데크·전기·카메라·상용 트랩 |
| `S0_전체조립.FCStd` | 위 셋의 App::Part를 링크만 걺. 세 파일이 같은 원점(전체 좌표)이라 옮기지 않음 |

## 규칙
1. **무거운 일은 따로 띄운 FreeCAD 창에서 한다**: `freecad.exe cad\<스크립트>.py` (작업 폴더 = `cad`).
   - 그 창이 멈추거나 죽어도 쓰고 있는 창은 안전하다.
   - 스크립트는 결과를 `split\_*.json`에 쓰고 스스로 닫힌다.
   - `freecadcmd`(GUI 없음)는 못 쓴다. 옛 스크립트가 ViewObject를 바로 쓰기 때문이다.
2. **한 부분만 고친다**: `edit_s1.py`, `edit_s2.py`
   - 둘레 40 mm 안의 다른 부분을 `CTX_`로 잠깐 넣고, 겹침과 움직임을 본 뒤 지운다.
3. **마지막 조립 검사**: `split3_boundary.py`
   - 서로 다른 부분끼리만, 상자가 겹치는 쌍만 계산한다.
   - 모든 쌍의 거리 계산은 금지 — 11/11에 FreeCAD를 멈춘 원인이다.
4. **처음부터 다시 만들기**: `split3_build.py`
   - `G.make()` 후 세 파일로 나눈다 (약 10분).
   - 나눈 뒤 각 파일에서 고친 것은 이것을 돌리면 사라진다. 고친 내용은 스크립트에 있으므로, 다시 만든 뒤 `edit_s*.py`를 다시 돌린다.
5. **산 부품 STEP판은 PC에만 둔다**: `s1_vendor.py` → `capstone design_이서현\CAD files\split\S1_급이부_STEP.FCStd`
   - McMaster CAD는 공개 레포에 올리지 않는다.
   - 레포 파일은 같은 자리에 단순 모양을 쓴다.

## 나누고 나서 찾은 것 (11/12)
| 무엇 | 크기 | 고침 |
|---|---|---|
| 먹이 관 ↔ 물빠짐 관 교차 | 12.3 mm³ | 관 경로를 고르는 코드가 바브(143n)에 끼운 것도 '걸림'으로 셌음 → 고침 |
| M3 너트가 각관 −x 벽 속 (STEP 너트로 드러남) | 27 mm³ | M3 × 18, 너트를 각관 바깥에 |
| 니플 육각 모서리 ↔ 기둥 | 0.16 mm | 물빠짐 y 90 → 91 |
| 물빠짐 받침 ↔ 기둥 | 27 mm³ | 받침을 y 86부터 |
| 위 앵글 M3가 물길 바닥을 구멍 없이 지남 | 21 mm³ | 서현 결정: 에폭시 접착 (나사·구멍 없앰) |
| 누름 스위치 227p가 모델에 없었음 (11/10부터) | — | 원점 스위치 apply가 '227'로 시작하는 것을 다 지웠음 → 고침 |
| 걸쇠 혀 ↔ 151_R, 스위치 자리도 151_R | 72 mm³ | 혀·스위치를 +y 쪽으로 (비어 있음 확인) + 받침판 |

## 전체 도면 (`cad/D5g_full.FCStd`)
- 서현 규칙 (11/12 01:31): 전체 도면은 서현이 **'전체 수정'**이라고 말할 때만 고친다.
- 고치는 법: `freecad.exe cad\full_merge.py` → S1·S2·S3을 한 문서로 합침 (묶음 3개, 색 그대로)
- 합친 뒤 **`C:\Users\Seohyun_Lee\Desktop\capstone design\D5g_full.FCStd`에도 덮어써서** 늘 최신 하나가 그 폴더에 있게 함 (서현 11/12 02:24)
- 11/12 01:4x 첫 합침: 진짜 모터 도면, 급이부·누름 고친 것 포함 (부품 241개, 13.4 MB). 그 전 D5g_full은 11/10 것이었다.
- 진짜 모터 도면(Adafruit 858 STEP, MIT) 넣기는 `real_motor.py` 하나로 한다. 쓰는 곳:
  - S2: `s2_motors.py`
  - 다시 만들기: `G.make()` 끝
