britams/-capstone-project-repo/cad/vendor_mit/adafruit/README.md

# Adafruit CAD (MIT)
출처: https://github.com/adafruit/Adafruit_CAD_Parts (MIT License, `LICENSE` 그대로 둠) — 받은 날 2026-11-11

| 파일 | 원본 | 쓰는 곳 |
|---|---|---|
| `858_28BYJ48.step` | `858 Stepper Motor 5VDC/858 Stepper Motor 5VDC.step` | 153·209·215 (28BYJ-48 5 V) — `s2_motors.py` |

STEP 좌표: 몸통 가운데 (0, 0), 출력축 (0, 8) +z, 귀 윗면 z 0 (귀 구멍 x ±17.5), 몸통 z −19 ~ 0, 선 상자 −y.
