britams/-capstone-project-repo/design/인터페이스_정의서.md

# 인터페이스 정의서 — 기구(서현) ↔ 비전·전자(승준)

같이 편집하는 유일한 파일. 값을 바꾸면 맨 아래 변경 이력에 날짜·이름·이유를 적는다.
상태: 5차 값 (2026-11-06, 회로 설계 CAP-AI-23~35 + 승준 SJ-43~47 기준 — 잠정값은 '잠정'). 이전: 4차 (11/02), 3차 (10/28)

| 항목 | 값 | 단위 | 정한 사람 | 근거 | 상태 |
|---|---|---|---|---|---|
| 카메라 모델 | **Raspberry Pi Camera Module 3 (IMX708, 표준 렌즈)** — 자동 초점 10 cm~무한대, **1536 × 864 @ 120 fps 모드(센서 가운데 3072 × 1728을 잘라 씀)로 720p 60 fps**, 사진 4608 × 2592 (제조사·libcamera 사양). 이전: AI 카메라 IMX500 (최대 30 fps라 60 fps 요구를 못 맞춤) | — | 승준 | 서현 요청 '720p·60 fps 이상' (11/08), CAP-AI-SJ-53 | 잠정 — **사기로 정함 (승준 11/09)**: DM 14917048, 43,780원, 케이블은 FFC 500 mm (E18 — 30 cm는 330 mm 필요라 짧음, 서현 계산). J3에서 초점·밝기 확인 |
| 카메라–격자 거리 | **153.5** (렌즈 끝 → 격자 윗면) | mm | 승준 ← 사양 | 최소 초점 10 cm보다 멀고, 720p60 모드(잘림)에서도 마킹실 40 × 40이 다 들어오며, 위판 아래 걸이 181로 달 수 있는 거리 (CAD `D5g_fix_sj53.CAM`, CAP-AI-SJ-53) | 잠정 — J3에서 초점·해상도 확인 |
| 카메라 시야 | 사진(전체) 약 199 × 115 (수평 66°·수직 41°) → 약 23 화소/mm · **720p60 모드(가운데 2/3) 약 133 × 77 → 1536 화소 기준 약 11.5 화소/mm (1280 × 720로 줄이면 약 9.6)**, 쓰는 영역은 마킹실 40 × 40 | mm × mm | 승준 | 사양으로 계산 (CAP-AI-SJ-53) | 계산값 (J3 실측 — `px_to_mm`·`rot_deg` 다시 재야 함) |
| 좌표계 (비전 → 제어) | 원점 = 격자 가운데, +x = 방생 문 쪽, +y = 먹이통 쪽, 단위 mm | — | 서현 ↔ 승준 | D5 4차 | 정함 |
| 흉부 좌표 정확도 | ±1 이내 (흉부 폭 약 4, 점 약 2 기준) | mm | 서현 → 승준 | D5 10장 | 잠정 [가능성 높음] |
| 조명 | 링 조명 (바깥 Ø30·안 Ø14, 렌즈 끝 높이, 걸이 181 팔에 붙임) | — | 승준 | 182 | 잠정 (약 150 mm 거리에서 밝기 확인) |
| 구동기 1 바닥 승강 (301) | **mightyZAP D7-6PT-3** 리니어 서보 (아이알로봇, 디바이스마트 101,000원) — 행정 26, 정격 6 N, 7.4 V (구동 레일 5 V → MT3608 승압), **PWM 900~2100 µs = 0~26 mm** (UNO 1 D2 하나, 50 Hz 계속), 정확도 0.03 mm, 스스로 위치 유지. 바닥 = 로드 끝 M3 × 8 + 너트 + M4 DIN 9021 + McMaster 90313A108 (Ø31.75). 쉼 8 mm (바닥 윗면 z 370) → 누름 18 mm (z 380, 격자 아랫면 385에서 5). **원점 스위치·누름 스위치 없음 — 힘 제한은 나중에 (지금은 거리로만)**. (11/14 전) Keshuo 15BY25 + DRV8833, 그 전 28BYJ-48 + T8 | mm | 서현 → 승준 | `cad/lift_v3.py`, 판매처 도면 d12d7 rev03 | 잠정 — 펌웨어 반영 11/14 (`trap_motion` F = PWM, 25 mm/s로 셈), PWM↔mm·속도 실측, 힘 제한 미정 |
| 구동기 2 마커 X (215) | 28BYJ-48 + T8 리드스크루, 행정 36 (흉부 영역), 안내 **LM8UU ×2** (한쪽 구동 끼임 방지 — 청동 부싱도 끼임, S4 r2). 토크 0.06 N·mm | mm | 서현 ↔ 승준 | S4 M2·M5, D6 | 잠정 |
| 구동기 3 마커 Y (209) | 28BYJ-48 + T8 리드스크루, 행정 58 (대기 자리 −40 → +18), 안내 **LM6UU ×2**. 속도 1.3~2.0 mm/s (승준 시뮬레이션 1.83) → 편도 최대 29~44 s | mm | 서현 ↔ 승준 | S4 M2, D6 | 잠정 (실물 rpm은 J6) |
| 구동기 4 마커 Z = 펜 들기 (205) | SG90 서보. 혼 끝(반지름 14, 끝 둥글기 2)이 홀더 탭 아랫면을 밀어 10 mm 들기/놓기. 홀더는 안내 핀 Ø3 ×2(슬리브 40, **PTFE 테이프**)로 안내. 필요 토크 12.4 N·mm (안전율 14.2, μ 0.3 기준 — PTFE면 더 작음). **찍는 힘 = 홀더·마커 자중 0.31~0.32 N, 스프링 204 없음.** **내릴 때 2단계: 팁 위 2 mm까지 빠르게, 마지막 2 mm는 ≤ 60 °/s** (S4 M8) | N·mm | 서현 ↔ 승준 | D5e, S4 2차(SJ-29)·M8(CAP-AI-21) | 잠정 (μ_pin·k_c 시험) |
| 구동기 5~7 문 (112·170·176) | **MG90S** 서보 ×3. 혼 핀(r 9)이 문판 세로 홈을 미는 미닫이(스카치 요크): 혼 +60° 닫힘 / −60° 열림, 행정 15.6, 닫힘 0.2 s. **닫기 전과 닫는 동안 빛 게이트로 문틈이 빈 것을 확인** (말벌이 끼면 서보가 22~44 N으로 밂, S4 M7) | — | 서현 ↔ 승준 | D5e, S4 M7 | 잠정 (F_harm 시험) |
| 누름 감지 (146·148c·227p) — 하중 센서 대신 | **(11/14 없앰 — mightyZAP 거리로만, 구동기 1)** 예전: **스프링 + 누름 스위치** (11/10 교수님 '로드셀은 과함' → 로드셀·HX711 없앰). 스프링 146 (k 103.6 N/m)이 캐리지 받침 칸 위에서 축 147을 받침 → F_p 0.5 N이면 4.83 mm 더 눌림 → 축 걸쇠 148c가 KW11-3Z 227p 레버를 누름 → UNO 1 A1 (NC 접점, 풀업: 눌림·선 끊김 = HIGH) → 펌웨어가 바닥 멈춤. 힘은 스위치 긴 구멍(±2 mm)으로 저울 위에서 한 번 맞춤 | mm · N | 서현 | S4 스프링 146 2차, `D5g_feeder_uln.press_parts`, 시뮬 88/88 (CAP-AI-60) | 잠정 — 스위치 딸깍 자리 실물로 맞춤 |
| 급이 (142·143·144) | **바깥 병 + 연동 펌프, 먹일 때만** — 병 Nalgene 2104-0008 250 mL(프레임 +y 바깥, 데크 레일에 걸이 144b) → 펌프 **(11/14) Kamoer NKP 12 V** (국내 재고, Adafruit 3910은 해외라 바꿈 — UNO 2 D6 → Q3 → **MT3608 5 → 12 V** → 펌프, 5 V 쪽 약 0.7 A [추측 — 실측]) → 실리콘 관 3.5 × 5 → 물길 +x 벽 노즐 → 솜(코튼롤 2호) 위. 한 번 100 ms ≈ 0.14 mL, 펌웨어 최대 2 s(3.3 mL ≤ 물길 넘침까지 5.1 mL). 물길 바닥 끝 물빠짐 → 프레임 밖. 뚜껑 자석 2쌍 | mL · ms | 서현 | `cad/D5g_feeder_pump.py`, `cad/feeder_check.py` 7개, 펌웨어 sim 89/89 (CAP-AI-59) | 잠정 — 한 번 양·솜 젖는 길은 실물 시험 |
| 원점(리밋) 스위치 | 마이크로 스위치 KW-11-3Z **×2 (X·Y 아래 끝) → UNO 1 A4·A5** (11/14 F 스위치 없앰 — mightyZAP은 PWM이 곧 위치, A3 예비) (내부 풀업, 눌리면 LOW, 100 nF 병렬). 켤 때 `HOME` | — | 서현 → 승준 | 회로설계 (CAP-AI-23), SJ-24 아두이노 2개 | 정함 (핀) |
| 마커 | 샤피 크리에이티브 불렛 **노랑** (그립 Ø14.7, 최대 Ø18.9, 134 mm, 13 g) — 비전은 흉부 영역(ROI)에서만 노랑 점을 찾음 (말벌 노랑 다리·주황 배띠와 구분) | — | 서현 | Issue #3, 승준 SJ-20 | 확정 (치수는 실측) |
| 여왕벌 판정 | 중흉배판(mesoscutum) 폭 **≥ 4.4 mm면 여왕벌 → 격리** (Pérez-de-Heredia 2017). PRESS 중 격자 피치 4.4 mm를 자로 쓰고, 원래 해상도 자른 영상에서 테굴라 두 점, 5장 중앙값 (σ ≤ 0.10 mm면 여왕벌 98 % 이상 잡음). **못 재면 계절 규칙:** 3~5월·9~11월 = 여왕벌로 보고 격리, 6~8월 = 일벌 | mm | 서현 → 승준 | 여왕벌 크기측정 방법 (CAP-AI-25~27), 판단 문서 A5 | 잠정 — 비전 구현·σ 실측은 승준 |
| 빛 게이트 9쌍 (114 포함) | **통로 3쌍 Adafruit 2167** (G1 입구 세로관 → UNO 2 D7, G4 격리 통로 끝 → D8, G6 방생 출구 → D12; 10 kΩ 풀업, 끊기면 LOW) / **문 빔 6쌍 3 mm IR LED 940 nm + 포토TR 낱개** (G2·G2b 입구 문 → A0·A1, G3·G3b 격리 문 → A2·A3, G5·G5b 방생 문 → A4·A5; 아날로그, 끊기면 낮아짐, 문턱값 = (송신 켬 + 끔)/2를 켤 때 자가 시험, 차이 < 200이면 고장). 송신 9개는 MOSFET Q4(D4)로 한꺼번에 켜고 끔 | — | 서현 ↔ 승준 | 회로설계 21시 (CAP-AI-34), 승준 SJ-47 (문 틈 5 mm) | 정함 (핀) — 펌웨어 반영은 승준 |
| 전장품 크기 (Pi 5 + HAT + 아두이노) | Pi 5+HAT 85×56×35, UNO 68.6×53.4×15 — 받침판(101)에 자리 있음 | mm | 승준 | D5 3차 | 높이 35는 잠정 (실물로 확인) |
| 전원 전압 · 소비 전력 | **Pi 레일:** 27 W 공식 USB-C (보유), UNO 2개는 Pi USB로 받음. **구동 레일 +5V_B:** 5 V 3 A 어댑터 → 퓨즈 5×20 3 A → 비상 정지(NC) → 와고 221-415 (+5V 2개, GND 3개). 규칙(서보 한 번에 하나)을 지키면 최대 **1.8 A**, 대기 0.34 A. UNO 5V 핀은 +5V_B와 잇지 않음, GND는 와고 한 점. 대기 7.4 W, 하루 약 80 Wh (9시간) | V · W | 서현 ↔ 승준 | 전기계통 (CAP-AI-22), 회로설계, elec_budget.py | 잠정 (실측은 브레드보드 5단계) |
| 배터리 상자 (선택) | LiFePO4 12.8 V 20 Ah → 퓨즈 5 A → **INA226 (0.01 Ω, R010)** → 강압 5.15 V (USB-C → Pi) / 5.0 V (배럴 → 본체). 본체는 그대로, 플러그 2개만 바꿔 꽂음. INA226 → Pi GPIO2/3 (주소 0x40, CAL 2560), 남은 15 % 또는 부하 중 12.0 V 아래 = 부족 → 처리 끝내고 문 열고 Pi 끔. 2.88일 | — | 서현 → 승준 | 배터리상자 회로 (CAP-AI-35) | 잠정 — 본체에 J_I2C 4핀 자리 필요 (D5g), Pi 코드 적산은 승준 |
| 운용 시간 | **낮 = 해 뜨고 30분 뒤 ~ 해 지기 30분 전** (NOAA 식 + Pi RTC, 공주 36.46 N 127.12 E) 동안만 처리. **밤: 처리 안 함** — 방생 문 닫고 입구·격리 문 열고 조명 끔 → 전부 포획통. 처리 중 해가 지면 격리. Pi 5 RTC 배터리 필요 | h | 서현 (구현 승준) | 승준 SJ-46 `control/pi/daynight.py`, trap_sim S15·S16, `관련코딩저장/pi_link/process.py` C5 (말벌 기다리는 중 해 지면 밤으로) | 정함 (서현 생각, 11/06 승준이 구현) |
| Pi ↔ 아두이노 통신 | **v0.2** — USB 시리얼 115200, 한 줄 = 명령 하나. 응답 4가지: `OK …`(받음) / `ERR <이유>` / `DONE …`(끝남) / `EVT …`(사건). 켜지면 `EVT READY trap_motion v0.2` / `EVT READY trap_doors v0.2` → **Pi는 이 이름으로 포트를 가린다** (USB 순서 무관). **UNO 1 trap_motion**: `PING` `STATUS` `HOME F/X/Y` `MOVE F/X/Y <mm>` `STOP` `ZERO` `SPEED` `LIMIT` `HOLD` `PRESS <g>`(11/14: F 10까지 올림 — 힘 감지 없음, g는 기록용) `PEN UP/DOWN` `SERVO PEN` `SETDOOR PEN` `WATCHDOG <s>`. **UNO 2 trap_doors**: `PING` `STATUS` `SELFTEST` `GATES` `DOOR IN/CAP/REL OPEN/CLOSE` `SERVO` `SETDOOR` `LIGHT TOP/BOT <0~255>` `EMIT 0/1` `RAIL` `PUMP <ms>`(최대 2000, 문과 같이 안 움직임) `WATCHDOG <s>`, 사건 `EVT GATE <이름> BLOCK/CLEAR`·`EVT RAIL 0/1`·`EVT DOOR <이름> REOPEN/BLOCKED`·`EVT PUMP STOP`. **안전 규칙(펌웨어가 거부)**: X·Y는 펜 UP일 때만, 펜 DOWN이고 마킹실 위(Y > −20.5)면 F 올리기 거부(R1′, 캡 컵이면 허용), PRESS는 펜 UP만 → `ERR PEN_DOWN` / 원점 전 `ERR NOT_HOMED` / 다른 문이 움직이는 중 `ERR BUSY` / 문 닫기는 빔이 0.2 s 비어야, 닫다가 끊기면 다시 엶, 3번이면 `BLOCKED` / 레일 꺼지면 `ERR RAIL` / 켤 때 서보 안 붙임, 하나씩 0.3 s / 명령 5 s 없으면 정지(WATCHDOG). 전체 목록·자세한 형식: 각 .ino 머리말. 핀: UNO 1 = (11/14) 바닥 mightyZAP PWM D2·스테핑 X·Y(D6~D13)·펜 서보(A0)·원점 X·Y(A4·A5) 13/18, D3~D5·A1~A3 예비, UNO 2 = 레일 감지 D2·조명 Q1 D3/Q2 D5·송신 Q4 D4·**급이 펌프 Q3 D6**·통로 게이트 D7·D8·D12·문 서보 D9~D11·문 빔 A0~A5, D13 예비 — 핀 표 `design/2026-11-06_회로설계_서현.md` | — | 서현 (펌웨어 v0.2, 11/08부터 VS Code) | `design/circuit/firmware/trap_motion`·`trap_doors` (CAP-AI-40~48), 시뮬 84/84·77/77, Pi 쪽 `관련코딩저장/pi_link` 36/36·처리 순서 | **v0.2** — 컴파일·시뮬 통과, 실물 `미검증` (승준 v0.1 `control/firmware/trap_controller/`는 그대로 둠) |
| 비전 → 제어 결과 | 카메라 한 번 볼 때 마리마다 dict 하나: `species` (velutina / crabro / other — VespAI 클래스 1/0, 신뢰도 < 0.8이면 other), `conf`, `mw_mm` (중흉배판 폭, 못 재면 None), `marked` (흉부 ROI 안 노랑 점 ≥ 1), `pose` (dorsal / ventral / side), `p` (흉부 확률), `x, y` (흉부 가운데 mm, 위 좌표계), `thorax` = (x, y, θ rad, L, w) mm + `unc` = (σ_xy, σ_θ, σ_size) — **승준 `mark_planner.plan()`의 est·unc 그대로**. Pi가 thorax로 찍을 점을 고르고(확률 ≥ 0.5, 없으면 자세 다시), 여왕·종 판단은 Pi `decide()` 한 곳 | — | 승준 → 서현 | `관련코딩저장/pi_link/vision_format.py` (make_obs·px_to_mm), `vision/scripts/mark_planner.py`·`dot_detect.py` | 잠정 — 화소 → mm 변환의 카메라 방향은 장착 뒤 격자 사진으로 (승준 확인) |

## 동작 순서 (상태 머신) — 2차 (D5 4차)
`design/2026-10-28_D2_기능시퀀스와_기능계통도.md` 1장 + D5 4차 부품 기준.
1. 대기: 112 열림, 170·176 닫힘, 140 내림, 마커 201은 대기 자리 캡 컵(219)에 앉음(205 놓음) — 카메라 시야 비어 있음
2. 114 감지 → 빛 게이트로 문틈이 빈 것 확인 → 112 닫힘 (닫는 동안 다시 확인)
3. 180 판별 (종·계급·표식·마리 수) → 로그. 방제 모드 / 여왕벌 / 다른 종 / 불확실 / 두 마리 → 8
4. 180으로 말벌이 바닥에 있는지(등이 위) 확인 → 153 상승 (148 힘 상한에서 정지)
5. 180: 등이 위인지 + 흉부 좌표 (x, y) → 아니면 140을 10 mm 내렸다 다시 (최대 N회, 모두 실패 → 표식 없이 7 + 로그 '마킹 실패')
6. 205 들기 → 215·209로 흉부 위 이동 → 205 놓음 (2단계 속도, 마지막 2 mm ≤ 60 °/s, 자중으로 찍음, 필요하면 2~3회) → 205 들기 → 대기 자리 → 205 놓음 (캡 컵) → 180 점 확인 (없으면 6 한 번 더)
7. 급이: 펌프 `PUMP 100`(약 0.14 mL)으로 솜을 적심 → 140을 솜 높이(F 31)에 둔 채 정해진 시간 → 176 열림 → 방생 → 176 닫힘 → 1 (11/10 펌프 방식, CAP-AI-59)
8. 격리: 140 내림 → 170 열림 → 포획통으로 → 170 닫힘 → 1

(11/06 보탬) 1 앞에 **낮인지 확인** (밤이면 위 '운용 시간'대로 포획통 모드), 3의 여왕벌은 '여왕벌 판정' 줄 기준. 배터리 부족이면 처리 끝내고 112·170 열고 Pi 끔. 자세한 순서·판단표: `design/2026-11-06_제어알고리즘_판단_서현.md`

## 변경 이력
| 날짜 | 이름 | 바꾼 것 | 이유 |
|---|---|---|---|
| 2026-10-28 | 서현 (Claude) | 틀 작성 | 분업 계획 |
| 2026-10-28 | 서현 (Claude, CAP-AI-14) | 카메라·조명·구동기 5개·하중 센서·진입 감지·전장품 크기 1차 값, 상태 머신 1차 | D5 3차 모델 |
| 2026-10-28 | 서현 (Claude, CAP-AI-16) | 카메라 거리 57 → 200 mm, 시야·좌표계·흉부 좌표 정확도 추가, 구동기 2(마커 이송) → X·Y·Z 3개로 (총 7개), 상태 머신 2차 | 안 B(마커 XYZ) 결정, AI 카메라 초점 범위 20 cm~ (제조사 사양) |
| 2026-10-28 | 승준 (Claude, CAP-AI-SJ-19) | Pi ↔ 아두이노 통신 1차 값, 진입 감지 신호를 Pi GPIO로 | 펌웨어 작성 — UNO 18핀이 스테핑 3·서보 4·HX711로 꽉 참. **원점(리밋) 스위치 없음 → 켤 때 위치 가정**, 넣으려면 스텝·방향 드라이버(축당 2핀)로 바꾸거나 아두이노 2개 (D6 검토 요청). 28BYJ-48+T8 약 2 mm/s (시뮬레이션 1.83). 구동부 별도 5V 전원 필요 |
| 2026-10-28 | 서현 (Claude, CAP-AI-18) | 3차 값: 구동기 1~4 사양(토크·안전율·속도), X·Y 볼 부싱, 찍는 힘은 수동값(하중 센서로 못 잼), 하중 센서 용량, 원점 스위치 1안(Pi GPIO), 마커(샤피 노랑), 구동부 전원 5 V 3 A, 재시도 10 mm | D6 설계 변수표·S4 역학계산 1차, 승준 SJ-19 요청(원점·전원) 답 |
| 2026-10-28 | 서현 (Claude, CAP-AI-19) | 구동기 1 안전율의 토크 기준(약 1.8 rpm) 표시, 구동기 2 토크 0.05 → 0.06 N·mm·청동 부싱 불가, 구동기 4 토크 4.5 → 4.9 N·mm(안전율 39 → 36) | S4 r2 — 교재·해설집 대조 후 재점검(무게중심·편심 짝힘·레일 마찰·요 + 피치 끼임) |
| 2026-10-28 | 승준 (Claude, CAP-AI-SJ-24) | 값은 안 바꿈 — **제안만 추가**: 아두이노 2개로 나눔(UNO 1 스테핑 3·펜 서보·HX711·원점 3 / UNO 2 문 서보 3·빛 게이트·조명), Pi→UNO `PATH`·`HOME` 명령, 격자 틈 3.5 mm·가는 팁·위 어둡게/아래 밝게 조명·X·Y(·바닥) NEMA17 검토 | 신뢰성 몬테카를로: 지금 격자(3.0/4.4)+샤피 불렛은 8회 재시도해도 약 35 % → 제안을 같이 바꾸면 예측 95 % 넘음. 근거 `control/2026-10-28_제어부_구성_신뢰성_AI마킹.md` (서현 결정 대기) |
| 2026-11-02 | 서현 (Claude, CAP-AI-21) | 4차 값: 구동기 4(혼 끝·핀 안내·PTFE, 토크 12.4 N·mm, 스프링 204 없음, 내리기 2단계 ≤ 60 °/s), 구동기 5~7(SG90 회전 → MG90S 미닫이, 문틈 확인 후 닫기), 상태 머신 2·6단계 | D5e 이음부 수정, S4 2차(승준 SJ-29), 동역학 M7·M8 |
| 2026-11-06 | 서현 (Claude, CAP-AI-36) | 5차 값: 하중 센서 버튼형 → 막대형 500 g~1 kg, 원점 스위치 Pi GPIO → UNO 1 A3~A5, 진입 감지 → **빛 게이트 9쌍**(통로 2167 → D7·D8·D12, 문 빔 낱개 → A0~A5 아날로그), 전원 줄(퓨즈 3 A·비상 정지·와고·최대 1.8 A), **배터리 상자** 줄 추가(INA226 R010), **운용 시간** = 승준 낮·밤 규칙, **여왕벌 판정** 줄 추가, Pi ↔ 아두이노를 UNO 2개 핀으로 | 11/06 회로 설계(CAP-AI-23~35)·승준 SJ-43~47이 이 문서에 아직 안 들어가 있었음. 상태 머신은 펌웨어 쪽이라 그대로 (승준 확인) |
| 2026-11-08 | 서현 (Claude, CAP-AI-52) | Pi ↔ 아두이노 통신 → **펌웨어 v0.2** (명령·응답 4가지·READY 이름·안전 규칙·R1′), **비전 → 제어 결과** 줄 새로 (승준 mark_planner est·unc 형식에 맞춤), 운용 시간 결정자 = 서현 | 11/08 펌웨어·제어를 VS Code에서 서현이 맡음 (분업계획). 밤에 처리 안 하는 것은 서현 생각 (서현 11/08). 승준 v0.1·control/ 파일은 안 고침 |
| 2026-11-09 | 승준 (Claude, CAP-AI-SJ-53) | 카메라 AI 카메라(IMX500) → **Camera Module 3 (IMX708)**, 카메라–격자 200 → **153.5 mm (렌즈 끝 기준)**, 시야·화소/mm 다시 계산, 조명 거리 200 → 약 150 mm. (00:38) 카메라 사기로 정함 — 상태 줄만 바꿈. (03:10) 케이블 30 cm → 500 mm 그대로 (서현 하네스 계산 330 mm, CAP-AI-55) | 서현 요청 '카메라 720p·60 fps 이상, 자리는 승준이 정해 CAD에' (11/08) — IMX500은 최대 30 fps라 못 맞춤. 720p60은 CM3 1536 × 864 @ 120 fps 잘림 모드로. 비전 `px_to_mm`·`rot_deg`·FFC 길이·구매 영향은 Issue로 알림 |
| 2026-11-10 | 서현 (Claude, CAP-AI-59) | 급이 줄 새로 (거꾸로 병 → **바깥 병 + 연동 펌프, 먹일 때만**, 물빠짐, 자석 뚜껑), 상태 머신 7 급이에 PUMP, 통신에 `PUMP <ms>`·`EVT PUMP STOP`, UNO 2 핀 D6 = 급이 펌프 Q3 | 서현 '설탕물 세팅이 불편 — 사용자 편의, 동력 써도 됨' (11/10 20:11). 고인 물이 없어 열팽창 넘침 문제도 없어짐 |
| 2026-11-10 | 서현 (Claude, CAP-AI-60) | 하중 센서 줄 → **누름 감지 (스프링 + 누름 스위치)**, 구동기 1의 정지 조건, 통신에서 `LOAD/TARE/CAL` 없앰·`PRESS` 뜻, UNO 1 핀 A1 = 누름 스위치·A2 예비 | 교수님 피드백 '로드셀은 너무 많이 갔다' (서현 11/10 21:45). 스프링 146은 원래 있음 → 스위치 하나만 더함 |
| 2026-11-12 | 서현 (Claude, CAP-AI-62) | 구동기 1: 28BYJ-48 + T8 → **산 리니어 모듈 15BY25 + DRV8833** (핀 그대로, 펌웨어 F만 양극 반걸음·80 반걸음/mm). 마킹실 안 40 → **32** (격자 9 × 9 → 7 × 7) | 서현 '리프팅 살 수 있으면 사'·'마킹실 최대한 작게' (11/12 05:15). 모듈 치수는 판매처 치수도 대표값 → 사서 잼 [가능성 높음] |
| 2026-11-14 | 서현 (Claude, CAP-AI-62) | 구동기 1 → **mightyZAP D7-6PT-3** (PWM, D2 하나, 원점·누름 스위치 없음). 마킹실 → 프린트 상자 38 × 38 (안 Ø33) + 투명 아크릴 격자판 2T (네모 3.0 간격 4.4 그대로), 바닥 쉼 z 341 → 370 (격자 385 그대로). 문: 입구 −x (축 349 → 376.5)·방생 +x·**격리 −y** (예전 −x 위), 입구·방생 서보 +y 쪽. **마커 대기 (65, −40) → (75, −40)** (X·Y 원점은 그대로) | 서현 "액추에이터로 단순하게"·"아크릴 주문 제작"·"격리 −y, 대기 x로" (11/14). 펌웨어 바꿀 것은 승준에게 Issue #11 |
| 2026-11-14 | 서현 (Claude, CAP-AI-62) | 펌웨어 반영: UNO 1 `trap_motion` F = mightyZAP PWM D2 (HOME F = F 0 펄스 + 행정 시간 대기, PRESS = F 10, ZERO·SPEED F 없음, LIMIT F ≤ 12), 누름 스위치·F 원점 스위치 줄 정리, UNO 1 핀, X 소프트 한계 +18 → +20 (대기 X +20), Pi 대기 X 10 → 20·급이 높이 F 31 → 2 | 서현 '승준 무시하고 우리가 다 해' (11/14 22:48) → Issue #11을 서현이 맡음. 시뮬 91/91·89/89, Pi 36/36·53/53. AVR 컴파일·실물 `미검증` |
| 2026-11-14 | 서현 (Claude, CAP-AI-62) | 급이 펌프 Adafruit 3910 → Kamoer NKP 12 V + MT3608, 바닥 원판 McMaster → 아크릴 Ø32 × 2T (격자판과 같이 주문 제작), RTC 배터리 뺌 (시계가 틀리면 계절 규칙 = 여왕벌 철) | 1차 주문 장바구니 `purchase/2026-11-16_1차주문_장바구니_서현.md` — 국내 재고·정산 가능한 것으로 |
