britams/-capstone-project-repo/design/2026-11-12_마킹실_최소크기_계산_서현.md

# 마킹실 최소 크기 계산 (서현, 2026-11-12, CAP-AI-62)

서현 지시 (11/12 05:10·05:15): "마킹실 크기를 할 수 있다면 최대한 작게" → "최소 크기 계산 그다음에 하고 수정하고 전체 수정해"

## 지금 크기 (`cad/D5e_module_kinematic.py`)
- 마킹실 안: 40 × 40 (벽 3 → 바깥 46)
- 높이: 승강 바닥 윗면 z 341 → 격자 아래 z 385, 44 mm
- 격자: 9 × 9 구멍 Ø3, 간격 4.4
- 승강 바닥: 39 × 39, 올림 36.5
- 문 2개가 같은 −x 벽에 아래·위로 쌓여 있음:
  - 입구 통로 축 z 349 (바닥 + 8)
  - 격리 통로 축 z 377 (격자 − 8)

## 말벌 크기 (등검은말벌 Vespa velutina) [확실 — dimensions.com]
| | 일벌 | 여왕벌 |
|---|---|---|
| 몸길이 | 20~24 mm | 30 mm |
| 몸 폭 | 5~6 mm | (따로 없음) |
| 몸 높이 | 5.5~6.5 mm | (따로 없음) |

## 계산
1. **가로·세로 (안)**
   - 말벌이 어느 방향으로 누워도 바닥에 다 들어가야 한다 → 안 정사각형 한 변 ≥ 몸길이
   - 여왕벌 30 + 양쪽 틈 1 = **32 mm** (지금 40보다 8 작게)
   - 일벌만 잡는다면 24 + 2 = 26 mm까지 가능. 하지만 트랩이 봄 여왕벌도 받으므로 32를 쓴다 [가능성 높음]
2. **격자**
   - 한 변 32에 간격 4.4, 구멍 Ø3 → 7 × 7 (폭 29.4)
   - 마커가 닿아야 하는 범위도 32 × 32로 줄어든다
3. **높이 (바닥 → 격자)**
   - 지금 높이를 정하는 것은 말벌이 아니라 문 2개다. 같은 벽에 통로(바깥 16)를 위아래로 쌓아서
     입구(바닥 + 8)와 격리(격자 − 8) 사이가 28이 된다 → 44
   - 문을 그대로 두고 줄이면: 두 통로 바깥 16 + 틈 4 → 축 간격 20 → 높이 **36** (8 줄어듦)
     - 문 하우징 112·170이 높이 23씩이라 겹치지 않으려면 23 + 틈 2 = 축 간격 25 → **높이 41** (3만 줄어듦) [확실 — 모델 bbox]
   - 문 하나를 다른 벽(+y)으로 옮기면: 높이 = 통로 16 + 위아래 2 = **20** (24 줄어듦)
     - 대신 문·통로·게이트·서보·격리 통로(172) 경로를 모두 다시 배치해야 한다
4. **올림 (stroke)**
   - 말벌이 격자에 닿을 때까지 바닥이 올라가야 함: 높이 − 말벌 높이(눌려서 약 5)
   - 높이 41 → 36 mm (지금과 같음) / 높이 20 → **15 mm**

## 바꾸면 따라 바뀌는 것
| 바꾸는 것 | 따라 바뀌는 부품 |
|---|---|
| 가로·세로 40 → 32 | 120 벽, 121 바닥판, 140 승강 바닥, 130 격자, 문 하우징 2 (벽 따라 x +4), 급이 물길·솜 (+y 벽 따라 y −4, S1), 마커 XY 원점·끝 (펌웨어 상수), 카메라 화각 |
| 높이 44 → 20 (문 하나 옮김) | 위 + 입구·격리 문·통로·게이트 전부 다시, 올림 15 (펌웨어 PRESS 행정), 바닥 구동 높이 |
| 리프팅 모듈 (산 것) | 바닥 구동 151~159 → 모듈 1개. 드라이버 ULN2003 → 양극 드라이버, 펌웨어 걸음 순서 |

## 권장 (Claude)
- 1단계: **가로·세로만 32로** 줄인다. 문 배치는 그대로 두고, 높이는 41로 (3 mm).
  부품이 벽을 따라 평행 이동만 하므로 위험이 작다.
- 높이 20은 문을 다른 벽으로 옮겨야 해서, 문을 회전 덮개로 바꾸는 계획(구매 계획 5단계)과 함께 하는 것이 낫다.
