britams/-capstone-project-repo/design/2026-11-10_급이방_상세설계_McMaster_서현.md

# 급이 방 상세설계 — 나사 하나까지 McMaster 실제 3D로 (서현, 2026-11-10, CAP-AI-57)

서현 지시 (11/10 14:45): "freecad로 정확히 상세설계해야지. McMaster 보고 전부 나사 하나하나까지 상세 설계해." 범위: 급이 방 (서현 답).
- 모델: `cad/D5g_full.FCStd`
- 스크립트: `cad/D5g_feeder_uln.py` (물길·뚜껑 모양), `cad/D5g_feeder_mcm.py` (McMaster 부품 넣기 + 검사)
- 그림: `cad/img/D5g_급이방_조립.png`, `cad/img/D5g_급이방_분해.png`, `cad/img/D5g_급이방_단면_x55.png`
- 원리·사용법: `design/2026-11-10_급이방_원리_사용법_고침_서현.md`

## ★ 11/10 밤 바뀜 — 펌프 방식 (CAP-AI-59, 이 문서 0~4장은 그 전 기록)
서현 지시: "설탕물 넣는 세팅이 불편 — 사용자 편의 좋게, 동력 써도 됨" (19:55~20:11)

- **방식:** 바깥 병 250 mL → 연동 펌프 → 관 → 물길 노즐 → 솜. 펌프는 **먹일 때만** 100 ms(약 0.14 mL) 돕니다.
  - 물길 바닥 끝에 물빠짐 구멍이 있어 고인 물은 프레임 밖으로 빠집니다.
  - 그래서 뒤집기·밀봉·물 높이 맞추기·열팽창 넘침이 모두 없습니다.
- **쓰는 법:**
  - 채우기: 병 뚜껑을 열고 붓기 (병은 프레임 바깥, 데크 높이)
  - 솜 갈기: 자석 뚜껑을 손으로 뗌
- **바뀐 부품:**
  - 없앤 것: 15 mL 튜브·그릇·받침 리브·튜브 집게, 뚜껑 손나사 92545A111 ×4·인서트 94459A130 ×4
  - 더한 것: 펌프 Adafruit 3910, 병 Nalgene 2104-0008, 실리콘 관 3.5 × 5 (병→펌프 261 · 펌프→노즐 409 · 물빠짐 248 mm), 걸이 144b(PETG), 자석 Ø6 × 2 ×4, M5 × 8 + 드롭인 T너트 ×2, MOSFET 모듈 1, 1N5819 1
  - 그대로인 것: 발 M3 × 8 92000A118 ×2 + 인서트 ×2 (2장 표의 발 값)
- **검사 [확실 — 모델·스크립트]:**
  - 겹침 '문제' 0 (관 ↔ 바브·펌프 자리, 인서트 ↔ 플라스틱, 나사산만)
  - 병 들어 올리는 길 막힘 0, 뚜껑 돌릴 손 자리 막힘 0
  - 걸이 ↔ 레일 0 mm (닿음), 발 드라이버 길 막힘 0
  - `feeder_check.py` 7/7: 펌프 고장 3.33 ≤ 5.07 mL, 노즐 ↔ 솜 틈 1.0
  - 펌웨어 시뮬 89/89, Pi 시험 53/53
- **143 크기:** 229 → **183 mm** 높이 (그릇·집게가 없어짐), PETG 57 g
- **미검증:** 펌프 머리·병 뚜껑 모양 [추측], 5 V 유량, 솜이 끝까지 젖는지, 자석 힘

## 0. 결론 (펌프 방식 전, 11/10 오후)
- **[확실 — McMaster 페이지 표 + 내려받은 STEP을 FreeCAD에서 잼]** 급이 방의 사는 부품 9종을 모두 실제 치수로 넣었다. McMaster 부품 5종은 STEP 그대로다.
- **이번 상세에서 찾아 고친 결함 5개 [확실 — 모델 검사]:**
  1. **물길 → 마킹실 벽 나사 2개에 드라이버가 안 들어감** (SJ-53 '남은 문제'): 드라이버 길이 뚜껑 기둥에 막혔다. → 나사와 벽 보스·인서트 2개를 없앰. 대신 **물길 앞벽**(두께 2, 솜 구멍)을 만들어 물이 물길 안에서 끝나게 했다. 그래서 물길을 마킹실 벽에 꽉 붙일 필요가 없다.
  2. **발 볼트 M5에 드라이버가 안 들어감**: 볼트 바로 위가 그릇이었다 (한 덩어리로 출력하는 부품이라 조립 순서로도 못 피함). 간격을 ±22로 넓혀 보니 이번엔 드라이버 길이 **서보 허브(193v)·캐리지(158)·로드셀 막대(148)**에 막히고 F 보드 나사·스페이서(198s/198n)와 겹쳤다. → **위에서 조이지 않고 데크 아래에서 M3 × 8 냄비머리(92000A118)로 발 속 인서트(94459A130)에 조인다.** 발은 두께 6, 56 → 20 × 40 (y 방향 길게), 나사는 기둥 축 x 52, y 80 ± 14. 데크 구멍 Ø3.4. M5 볼트·와셔·T너트는 없앰.
  3. **뚜껑 손나사 끝이 구멍 바닥에 닿음**: 손나사 끝 382.0 = 구멍 바닥 382.0이었다. → 구멍 깊이를 6 → 7로 해서 1.0 mm 띄움.
  4. **인서트 둘레 살이 얇음**: 기둥 Ø8이면 인서트 바깥(STEP Ø4.74) 둘레 살이 1.63 mm다. → 기둥을 **Ø9**로 해서 2.13 mm.
  5. **안쪽 손나사 2개를 손으로 잡을 자리가 없음**: 머리에서 그릇 벽까지 7 mm였다. → 손나사 자리를 y 66 → 60으로 옮겨 12.7 mm.
- 겹침 검사: 남은 겹침은 **나사산 물림(나사↔인서트, 나사↔T너트)과 인서트 홈이 플라스틱에 녹아 박히는 부피**뿐이다. 다른 부품과의 겹침은 0.

## 1. 부품표 (급이 방, 1대)
| # | 부품 | 품번 | 수량 | 치수 (출처) |
|---|---|---|---|---|
| 1 | 물길·그릇·기둥·집게 143 | 3D 프린트 PETG | 1 | 물길 안 폭 12, 바닥 윗면 364, 앞벽 2 (솜 구멍 Ø10.6, 솜 축 따라), 그릇 안 Ø35, 받침 리브 3 (입구 366), 기둥 12 × 12, 발 20 × 40 × 6 (인서트 구멍 Ø4 × 2) |
| 2 | 뚜껑 143l | 3D 프린트 PETG | 1 | 두께 2, 손나사 자리 4 (Ø3.4 구멍) |
| 3 | 손나사 M3 × 8 | **McMaster 92545A111** | 4 | 머리 Ø8 × 5 (손잡이 홈), 나사산 6.5, 18-8 스테인리스 (표·STEP) |
| 4 | 열 압입 인서트 M3 | **McMaster 94459A130** | 6 (뚜껑 4 + 발 2) | 설치 길이 4.3, 구멍 최대 Ø4, 최소 두께 5.1, 바깥 Ø4.74 (표·STEP) |
| 5 | 15 mL 원뿔 튜브 | 코닝 352096 | 1 | Ø17.37 × 118.8, 나사 Ø19.25 (제조사 도면) |
| 6 | 코튼롤 2호 | 치과 재료 (McMaster 없음) | 1 | Ø10 × 38 |
| 7 | 냄비머리 십자 M3 × 8 | **McMaster 92000A118** | 2 | 머리 Ø6 × 2.5, PH1, 18-8 (표·STEP) — 데크 아래에서 |

- 처음 안에서 뺀 것: M5 × 14 92000A324, 와셔 93475A240, T너트 4976N25 (드라이버 길이 막힘 — 0장 2번). 데크를 가로대에 고정하는 것은 원래 데크 볼트가 한다.

- 없앤 것 (11/06 설계): M3 × 8 볼트 2 (물길 → 벽), 벽 보스 인서트 2.
- STEP 파일은 `cad/vendor_step/`에 둔다 (서현 PC). 레포에는 올리지 않는다 (`.gitignore`): McMaster CAD는 '참고용' 조건이고 레포가 공개다. 다른 PC에서는 McMaster 각 페이지 → '3-D STEP' → Download로 받는다. 없으면 표 치수로 단순 모양을 넣는다.

## 2. 나사 물림·여유 (모델 값)
| 자리 | 쌓임 (위 → 아래) | 물림 | 끝 여유 | 판단 |
|---|---|---|---|---|
| 뚜껑 손나사 ×4 | 머리 밑 390 → 뚜껑 2 → 인서트 388.0~383.7 → 나사 끝 382.0 → 구멍 바닥 381.0 | 4.3 (인서트 전체) | 1.0 | 통과. 머리 밑 1.5는 민짜라 뚜껑 안에 있음 |
| 인서트 기둥 | 기둥 Ø9, 구멍 Ø4 × 7 | — | 살 2.13 | 최소 두께 5.1 ≤ 7 통과 |
| 발 나사 ×2 | 머리 밑 200 (데크 아래 면) → 데크 5 → 발 인서트 205.0~209.3 → 나사 끝 208.0 | 3.0 | 발 윗면 211까지 3.0 (기둥 밖 자리라 막힌 구멍 아님) | 통과 (M3 물림 3.0 = 지름 1배) |
| 발 인서트 | 발 두께 6, 구멍 Ø4 | — | — | 최소 두께 5.1 ≤ 6 통과 |

## 3. 공구·손 자리
- 뚜껑 손나사: 머리 둘레 반지름 12 mm, 높이 20 mm 안에 걸리는 것 — 결과는 4장.
- 발 나사: 머리 아래로 PH1 드라이버 축 Ø4.5 × 110 mm 길에 걸리는 것 (데크는 빼고 봄 — 데크를 프레임에 올리기 전에 조이므로) — 결과는 4장.
- **조립 순서:**
  1. 출력 뒤 인서트 6개를 인두로 박는다 (뚜껑 기둥 4, 발 아래 면 2 — 큰 끝이 나사 들어오는 쪽).
  2. **데크를 프레임에 올리기 전에** 급이 방을 데크 위에 얹고, 데크 아래에서 M3 × 8 2개를 PH1으로 조인다.
  3. 데크를 프레임에 올린다.
  4. 솜을 넣고, 뚜껑과 손나사를 손으로 조인다.
  5. 튜브를 꽂는다.

## 4. 검사 결과 (`D5g_feeder_mcm.check`, 서현 PC FreeCAD 1.1)
- 겹침: 인서트 ↔ 143 (녹아 박힘), 손나사 ↔ 인서트, 발 나사 ↔ 인서트 (나사산 물림)만 있다. 그 밖은 0 [확실 — `cad/_mcm_report.json`].
- 손가락 자리 (뚜껑 손나사 4): 막힘 0. 드라이버 길 (발 나사 2, PH1 Ø4.5 × 110): 막힘 0.
- 물림·여유: 2장 표 값과 같다 (뚜껑: 물림 4.3, 끝 여유 1.0 / 발: 물림 3.0, 끝 ↔ 발 윗면 3.0).
- 부품별 파일로 다시 만들어 맞춘 결과는 `cad/parts/feeder/README.md`에 있다 (CAP-AI-58). 거기서 전체 모델 발에 남아 있던 옛 M5 홈 2개를 찾아 없앴다.
