britams/-capstone-project-repo/design/2026-11-10_급이방_원리_사용법_고침_서현.md

# 급이 방 — 원리·쓰는 법·고친 것·검증 (서현, 2026-11-10, CAP-AI-56)

서현 지시 (11/10): "급이방이 어떻게 되는지 원리도 모르겠고 설계도 이상하다. 사진이든 동영상이든 보여 주고, 말이 안 되면 바꾸고, 제대로 되는지 검증해."
- 동영상: `design/img/feeder/급이방_원리.mp4` (`.gif`)
- 장면 그림: `design/img/feeder/장면_*.png`
- CAD 단면: `cad/img/D5g_급이방_단면_x55.png` (D5g 모델을 x = 55에서 직접 자른 선)
- 검사 코드: `cad/feeder_check.py` (FreeCAD 없이 돌아감, 값은 `cad/D5g_feeder_uln.py` FD 하나에서 읽음)

## 0. 결론
- **[확실 — 계산·모델] 11/06 설계(승준 SJ-41·49)는 그대로 쓰면 작동하지 않는다. 결함 3개가 있었다.**
  1. 맑은 날 설탕물이 마킹실로 샌다.
     - 튜브 안 공기가 데워지면 물을 밀어낸다. 물 높이가 +6.7 mm(5 → 30 °C), 햇빛이면 +13.0 mm 오른다.
     - 벽 구멍까지 여유는 3.6 mm뿐이다.
     - 승준 계산(+2.6 mm)은 두 군데가 틀렸다. 물 면적에 튜브 자리까지 셌고(1,616 mm², 실제 879 mm²), 수증기가 늘어나는 것을 빠뜨렸다.
  2. 솜 끝이 마킹실 안으로 4 mm 나와 있다. 누르기 때 바닥이 33 mm보다 높이 오르면 젖은 솜을 짓누른다 (끝까지 오르면 겹침 103 mm³).
  3. 급이 높이(프로그램)가 F 10 mm(바닥 351)라서, 솜 끝(374~384)이 말벌보다 23 mm 위에 있다 → 못 먹는다.
- **원리(뒤집은 병 + 솜 심지)는 맞다. 숫자 4곳만 고쳤다:**
  - 튜브 **50 → 15 mL**
  - 물 높이 **369 → 366**
  - 솜 끝 **벽 안 면 뒤로**
  - 급이 높이 **F 10 → 31**
- **[확실] 검증:** `feeder_check.py` 6개 통과, D5g 모델 겹침 0 (급이 부품끼리·전체, 바닥 0~36.5 mm 올림), Pi 순서 시험 52/52, 시뮬 24/24.
- **남은 위험 [가능성 높음 — 실물로만 확인]:**
  - 솜이 설탕물을 17 mm 높이까지 빨아올리는지
  - 말벌이 솜 면을 찾아 먹는지
  - 말벌 입 높이가 바닥 + 3 mm인지 ([추측])
  - → 책상 시험 1~3 (6장)

## 1. 원리 (그림 `장면_keep.png`, `장면_wick.png`)
1. **뒤집은 병 (병아리 물그릇):**
   - 설탕물을 가득 채운 15 mL 튜브를 거꾸로 세운다. 입구는 그릇 바닥의 받침 3개 위, 높이 366에 있다.
   - 그릇 물이 입구보다 내려가면, 입구로 공기 방울이 '꼴깍' 들어가고 그만큼 튜브 물이 내려온다.
   - → **물 높이가 늘 튜브 입구 높이(366)로 유지된다.** 사람이 맞출 것이 없다.
2. **솜 심지 (모세관):**
   - 치과용 코튼롤 2호(Ø10 × 38)를 마킹실 +y 벽의 구멍(Ø11.2)에 바깥에서 끼운다.
   - 바깥 끝은 물길 바닥(364)에 닿고 설탕물에 2 mm 잠긴다.
   - 안 끝은 벽 구멍 속, 벽 안 면에서 0.2 mm 뒤에 있다. 솜이 설탕물을 빨아올려 **벽 구멍의 솜 면이 늘 젖어 있다.**
3. **먹이기:**
   - 찍은 뒤 바닥을 31 mm 올린다 (바닥 372, 말벌 입 ≈ 375).
   - 그러면 말벌이 벽 구멍의 젖은 솜 면(372.8~383.2)을 빤다 (60 s).
   - 바닥 모터 하나로 높이만 바꾸므로 펌프·밸브·전기가 없다.

## 2. 쓰는 법 (그림 `장면_fill.png`, `장면_flip.png`)
| 언제 | 할 일 |
|---|---|
| 처음·2일마다 | 물길 뚜껑의 **손나사 4개**를 손으로 풀어 연다 → 헌 솜을 빼고 새 코튼롤을 **바깥에서 벽 구멍으로** 밀어 넣는다 (벽 안 면을 넘지 않게, 손가락으로 안쪽에서 맞춤) → 다른 끝은 물길 바닥, 잡이 리브 사이에 눕힘 → 그릇 헹굼 |
| 설탕물 채우기 | 튜브를 집게에서 **옆으로 당겨 뺌** → 설탕물(설탕 1 : 물 1)을 가득 채움 → **입구를 엄지로 막고 뒤집어** 입구가 받침에 닿게 세우고 집게에 '딸깍' → 그릇 물이 366까지 차면 저절로 멈춤 → 뚜껑 닫음 |
| 영하 | 설탕물이 얼면 튜브가 부풀 수 있음 → 밤에 영하면 튜브를 빼 둔다 [가능성 높음] |

- 15 mL면 [추측] 하루 몇 mL 쓰는 것으로 2일 넘게 간다 (솜 갈기 주기와 같음). 입구(안지름 14.7)가 좁아 엄지로 막기 쉽다.
- **누가 먹나:** 솜 면은 늘 젖어 있다. 그래서 마킹실에 들어와 벽을 타는 벌레는 무엇이든 먹을 수 있다. 고르는 장치는 바닥 높이뿐이다 (서현 질문 11/10, 덮개를 달지는 서현이 정함).

## 3. 고친 값 (`cad/D5g_feeder_uln.py` FD)
| 값 | 11/06 | 11/10 | 이유 |
|---|---|---|---|
| 튜브 | 50 mL Ø29.72 (7979T44 / 352070) | **15 mL Ø17.37 (코닝 352096, 제조사 도면)** | 공기가 적고 물 면이 넓어짐 (879 → 1,292 mm²) → 오르는 높이가 1/4 |
| 물 높이 (튜브 입구) | 369 | **366** | 벽 구멍까지 여유 3.6 → 6.4 mm |
| 솜 안 끝 (y, z) | (16, 379) — 마킹실로 4 mm 나옴 | **(21.4, 378) — 벽 안 면 뒤 0.2 mm** | 바닥이 끝까지 올라도 안 닿음 |
| 솜 바깥 끝 | (54, 372) | **(58.28, 368.85)** — 기울기 13.9°, 길이 38.0 | 물길 바닥에 닿고 2 mm 잠김 |
| 벽 구멍 가운데 z | 378.2 | **378.0** | 기울어진 솜이 지나갈 높이 11.05 ≤ Ø11.2 |
| 받침 리브 | 반지름 15 (50 mL 입구 아래) | **반지름 8.3** (15 mL 입구 살 7.33~9.6 아래) | |
| 집게 고리 | 열린 폭 26.3 < 29.7 | 열린 폭 15.6 < 17.37 (자동, tube_r 따라감) | 똑딱 끼움 그대로 |
| 급이 높이 F | 10 mm | **31 mm** (`관련코딩저장/pi_link/process.py`, `design/control_sim/trap_sim.py`) | 말벌 입 ≈ 솜 면 높이 |

## 4. 검증
**`python cad/feeder_check.py`** (11/10 결과):

| # | 검사 | 결과 |
|---|---|---|
| 1 | 열팽창 — 물 면 1,292 mm², 5→45 °C + 기압 −2 kPa (공기 + 수증기)에서 최악 물 368.9 (+2.9, 표면장력 1 포함 369.9) vs 벽 구멍 아래 끝 372.4 | 통과, 여유 2.5 |
| 2 | 솜 바깥 끝 가장 낮은 점 364.00, 잠김 2.0 mm | 통과 |
| 3 | 벽 구멍: 필요 높이 11.05 vs Ø11.2 | 통과 |
| 4 | 바닥 0~36.5 mm (0.5 간격) 올림 vs 솜: 겹침 0, 솜 가장 안쪽 y 20.20 > 바닥 끝 19.5 | 통과 |
| 5 | F 31 → 바닥 372, 입 375, 솜 면 372.8~383.2, 말벌 위 379.5 < 격자 385 | 통과 |
| 6 | 빨아올릴 높이 17.2 mm ≤ 25 | 통과 (실물 시험) |

- 같은 검사에 11/06 값을 넣으면 1번(여유 −10.4)과 4번(바닥 33 mm부터 겹침)이 **실패** → 검사가 결함을 잡는다는 확인.
- 계산식: 튜브 안 공기 n 일정, 수증기는 포화(Magnus), 가장 나쁜 채움 비율에서 밀려난 물 = 늘어난 부피 → 물 면 면적으로 나눔. 물 면은 그릇 − 튜브(입구 나사 Ø19.25) + 물길 − 솜 단면을 0.2 mm 격자로 셈.
- **D5g 모델 (서현 PC FreeCAD 1.1, 11/10):**
  - 다시 만들어 `cad/D5g_full.FCStd` 저장 (10.3 MB, 214개)
  - 급이 부품(142n·143·143l·143i·143t·143s·144n·120) ↔ 전체 겹침 0
  - 바닥 무리(140·146~149·158·159)를 0~36.5 mm 올림 vs 솜·벽·물길 겹침 0
  - 그림 6장 + 단면 x55 다시 그림
- **프로그램:** `관련코딩저장/pi_link` 시험 52/52 (재방문 급이 `MOVE F 31.000` 펌웨어가 받아들임), `test_pi_link` 36/36, `trap_sim` 24/24.

## 5. 산 것·살 것
- 코닝 352096 15 mL 튜브 (또는 같은 규격 Ø17 × 120 원뿔 튜브, 나사 뚜껑) — 50 mL 7979T44는 안 씀 → 승준 구매 목록에서 바꿔야 함 (Issue)
- 코튼롤 2호 Ø10 × 38 — 그대로

## 6. 책상 시험 (부품 오면, 트랩 조립 전에)
1. **물 높이·열팽창:**
   - 3D 프린트한 물길·그릇 + 15 mL 튜브에 물을 채운다.
   - 그릇 물 높이가 입구 ±1 mm로 유지되는지 잰다.
   - 헤어드라이어로 튜브를 50 °C쯤 데워 물이 얼마나 오르는지 잰다. 계산 +2.9 mm보다 크면 이 문서를 고친다.
2. **솜:** 설탕물 1:1로 솜 끝(17 mm 위)까지 몇 분에 젖는지, 2일 뒤에도 젖어 있는지 본다.
3. **말벌:** 현장이나 표본으로 머리(입) 높이를 재서 F 31을 맞추고, 솜 면을 찾아 먹는지 본다.
