britams/-capstone-project-repo/design/2026-11-09_미검증값_맞추는순서_서현.md

# '미검증' 값 맞추는 순서 — 하나마다 재는 법·명령·통과 기준 (서현, 2026-11-09, CAP-AI-54)

명령 정리 3-B 2번. 펌웨어 v0.2·Pi 코드에 `미검증`/`[추측]`으로 남은 값을 **실물이 생긴 뒤 어떤 순서로 맞추나**. 브레드보드 단계 B1~B5(`design/2026-11-06_브레드보드_단계별_배선_서현.md`, 전기회로 E2~E8)를 지난 뒤, 본체에 붙인 상태에서 한다.
순서와 기준은 (AI 판단, 서현 위임). 기준 숫자 중 [추측]은 첫 시험 뒤 다시 본다.

## 0. 먼저 알아 둘 것
- [확실] **`SETDOOR`(문·펜 각도)는 전원을 끄면 사라지고, 닫는 속도(`CLOSE_STEP_DEG`)·`BLOCK_SAMPLES`·`COIL_OFF_DWELL_MS`는 바꾸는 명령이 없다.** → 시험은 명령/다시 올리기로 하고, **정한 값은 `.ino`의 `#define`에 적고 다시 컴파일·업로드**한다 (`arduino-cli compile --fqbn arduino:avr:uno …` → `upload`). 고친 뒤 `관련코딩저장/sim/run_all.ps1`을 다시 돌려 시뮬이 통과하는지 본다.
- [확실] 펌웨어는 **문 3개가 같은 각도**(`DOOR_OPEN_DEG`·`DOOR_CLOSED_DEG` 하나씩)를 쓴다. 문마다 다르면 문별 배열로 고치는 작은 펌웨어 변경이 필요하다 (그때 한다).
- 시리얼은 Pi에서 `python -m serial.tools.miniterm /dev/ttyACM0 115200` 또는 PC Arduino IDE 시리얼 모니터. UNO 1 = trap_motion, UNO 2 = trap_doors (`READY` 줄로 확인).
- 순서 원칙: **다른 값이 기대는 것부터** (빔 → 문 → 축 → 하중 → 펜 → 자리 → 카메라 → 찍기·급이).
- 결과는 값마다 날짜·값·시도 횟수·통과 여부를 이 문서 7장 표에 적는다.

## 1. 문 쪽 (UNO 2, E4 뒤)
| # | 값 (지금) | 어디 | 재는 법 · 명령 | 통과 기준 |
|---|---|---|---|---|
| V1 | 문 빔 6쌍 켬−끔 차이 (`BEAM_MIN_DIFF` 200은 사양) | trap_doors | 본체 문틀에 붙인 채(틈 5 mm), **조명 위·아래 켬 + 햇빛 드는 자리**에서 `b3_door` 스케치 `k` (켬/끔 값 출력) — 문 빔마다 | 6쌍 모두 차이 ≥ 300 (200 + 여유) [추측]. 낮으면 빛 가림·LED 방향 먼저, 저항은 건드리기 전에 물어봄 |
| V2 | 문 각도 열림 30 · 닫힘 150 | `DOOR_OPEN_DEG`·`DOOR_CLOSED_DEG` | 혼을 `SERVO IN 90`에서 끼움 → `SERVO IN <각>` 5°씩 → 문판이 끝까지 열린 각, 틈을 다 막는 각을 찾음 → 끝에서 3° 덜 감 (서보가 벽을 계속 밀지 않게). `SETDOOR IN <열림> <닫힘>` → `DOOR IN OPEN/CLOSE` 20번. 문 3개 다 | 20번 모두 `DONE`, 닫힌 문 틈 빛 새지 않음, 닫힌 뒤 서보 전류 < 0.15 A (테스터) [추측] |
| V3 | 열기 시간 400 ms | `DOOR_MOVE_MS` | 휴대폰 슬로모션(240 fps)으로 `DOOR IN OPEN` 찍어 문판이 멈출 때까지 시간 | 잰 시간 + 100 ms ≤ 값 (넘으면 값 올림) |
| V4 | 닫는 속도 2°/20 ms ≈ 100 °/s, 끊김 2번, 다시 열고 1 s | `CLOSE_STEP_DEG`·`BLOCK_SAMPLES`·`REOPEN_WAIT_MS` | ① **끼임**: 부드러운 스펀지 막대 Ø6을 문틈에 넣으며 `DOOR IN CLOSE` 20번 ② **헛 끊김**: 아무것도 없이 닫기 100번 | ① 20번 모두 `EVT DOOR … REOPEN`, 스펀지에 눌린 자국 0 ② 헛 `REOPEN` 0. ①이 실패하면 속도 ↓ (1°/20 ms), ②가 실패하면 `BLOCK_SAMPLES` 3 |

인터페이스 정의서의 '닫힘 0.2 s'(S4 M7)는 서보 최고 속도 값이고, 펌웨어는 끼임 때문에 일부러 약 1.2 s로 천천히 닫는다 [확실 — 코드]. V4 결과로 정의서 줄을 고친다.

## 2. 축 쪽 (UNO 1, E5 뒤)
| # | 값 (지금) | 어디 | 재는 법 · 명령 | 통과 기준 |
|---|---|---|---|---|
| V5 | 원점 천천히 2000 µs, 스위치 3번 연속 | `HOME_SLOW_US`·`SWITCH_SAMPLES` | 축마다 `HOME X` 20번 → `DONE HOME X <반걸음>` 사이 차이 | 원점 반복 ±0.05 mm (±25 반걸음, 509 반걸음/mm), 헛 눌림 0 |
| V6 | 반걸음 1000 µs (≈ 1.96 mm/s) | `HALF_US_DEFAULT` / `SPEED` | 축마다 `SPEED X 1000`→`900`→`800` 각각 `MOVE X ±18` 왕복 30번 뒤 `HOME X` (J6 부하 시험과 같이) | 걸음 잃음(`EVT SWITCH`) 0, HOME 반걸음 차이 ±25 이내. 통과한 가장 빠른 값에서 한 칸 느리게. 1080~1460은 서지 띠라 안 씀 |
| V7 | 마지막 반걸음 뒤 20 ms | `COIL_OFF_DWELL_MS` | X 왕복 100번 뒤 `HOME X` 반걸음 차이 — 20 ms와 0 ms(다시 올림) 둘 다 | 20 ms로 차이 ±25 이내. 0 ms와 같으면 '효과 없음'으로 기록만 |

## 3. 하중 (UNO 1, E6 뒤)
| # | 값 (지금) | 어디 | 재는 법 · 명령 | 통과 기준 |
|---|---|---|---|---|
| V8 | HX711 눈금 | `TARE`·`CAL` (`b5_loadcell` `t`·`k`) | 바닥 빈 채 `TARE` → 100 g 추 → g/count → `CAL <값>` → 50 g 추 재기 | 50 g 추 ±1 g, 흔들림 sd ≤ 0.1 g. g/count는 `hxScale` 기본값으로 적음 |
| V9 | 누르는 힘 51 g (F_p 0.5 N, D6) | process `press_g` | 스펀지 더미(말벌 크기)로 `PRESS 51` 10번 → `DONE PRESS <mm> <g>` | 멈춘 힘 51 ± 3 g, 넘침(overshoot) ≤ 5 g. 넘치면 V6 F 속도 ↓ |

## 4. 펜 (UNO 1, E7 뒤)
| # | 값 (지금) | 어디 | 재는 법 · 명령 | 통과 기준 |
|---|---|---|---|---|
| V10 | 펜 위 60 · 아래 0 | `PEN_UP_DEG`·`PEN_DOWN_DEG` | `SERVO PEN <각>` 5°씩, 자로 팁 높이 → **각도-높이 표**. 아래 = 팁이 격자 윗면에 닿고 **혼이 탭에서 1~2 mm 더 내려간 각** (자중으로 찍게 — 혼이 누르면 안 됨). 위 = 팁 10 mm 위. `SETDOOR PEN <위> <아래>` | 종이 위 20번 찍기 → 점 20개, 지름 차이 ≤ 0.3 mm, 혼이 탭을 안 누름(눈으로) |
| V11 | 2단계 경계 12° | `PEN_SLOW_DEG` | V10 각도-높이 표에서 **팁 위 2 mm**인 각 (아래 각 기준 차이) | 표의 값으로. 마지막 구간 ≤ 60 °/s는 펌웨어가 지킴 (sim 58.8) |
| V12 | 마킹실 경계 Y −20.5 | `PEN_CHAMBER_Y_MM` | 펜 위로 `MOVE Y`를 1 mm씩, 팁이 마킹실 벽 안쪽에 들어가는 Y | 잰 값 − 1 mm. 정의서·`Params.y_range`도 같이 |
| V13 | 대기 자리 X 10 · Y −40 | `controller.Config.park` | CAD A2 값으로 `MOVE X`·`MOVE Y` → `PEN DOWN` 20번 | 20번 모두 팁이 캡 컵 219 안, 벽에 안 닿음 |

## 5. 카메라·좌표 (CM3가 온 뒤)
| # | 값 (지금) | 어디 | 재는 법 | 통과 기준 |
|---|---|---|---|---|
| V14 | 화소/mm 11.5 · 방향 rot_deg | `vision_format.px_to_mm` | 격자(피치 4.4 mm) 사진 → 승준 비전이 화소/mm·회전 | 격자 10칸 길이 오차 ≤ 0.5 % |
| V15 | 비전 좌표 = 펌웨어 좌표 (C3) | process C3 | 종이를 격자에 놓고 `MOVE` 9점(±15 mm 격자)에 찍기 → 사진으로 점 좌표 | 9점 모두 ±1 mm (정의서 흉부 좌표 정확도). 넘으면 원점 오프셋을 Pi에서 뺌 |
| — | 조명 | — | `design/2026-11-09_조명시험_계획_서현.md` | 그 문서 3장 |

## 6. 찍기·급이 (마커 시험)
| # | 값 (지금) | 어디 | 재는 법 | 통과 기준 |
|---|---|---|---|---|
| V16 | 닿는 시간 0.3 s · 2번 | `Params.dwell_s`·`stamps` | 검은 플라스틱(흉부 대신)에 0.1/0.3/0.5 s × 1/2번 찍고 `find_dots` | 지름 1.0~2.0 mm, 검출 ≥ 90 %, 가장 짧은 조합 |
| V17 | 급이 60 s | `Params.feed_s` | 같은 점을 t초 뒤 면봉으로 문지름 (t = 30, 60, 90, 105) | 번짐 없는 가장 짧은 t. **105 s 넘으면 R6(3분) 못 맞춤 → 서현에게** |

## 7. 기록 (시험하며 채움)
| # | 날짜 | 정한 값 | 시도 | 통과 | 메모 |
|---|---|---|---|---|---|
| V1 | | | | | |
