britams/-capstone-project-repo/design/2026-11-09_조명시험_계획_서현.md

# 조명이 필요한지 고르는 시험 — 계획과 통과 기준 (서현, 2026-11-09, CAP-AI-54)

명령 정리 `docs/2026-11-08_VSCode_전체작업_명령_서현.md` 3-B 1번. 서현 "조명 필요 없잖아" (11/08)에 답하려고 **사진으로 가린다**.
스크립트: `관련코딩저장/pi_link/light_test.py` (찍기 = Pi, 판정 = PC). 기준 값은 (AI 판단, 서현 위임) — 숫자는 [추측], 첫 실측 뒤 다시 본다.

## 0. 먼저 짚을 것
- [확실] **카메라가 바뀌었다**: AI 카메라 IMX500 (200 mm) → **Camera Module 3 (153.5 mm, 720p60 = 1536 × 864 잘림 모드, 약 11.5 화소/mm)** — 승준 SJ-53, 인터페이스 정의서 11/09. **CM3는 아직 안 샀다** → 이 시험은 CM3가 온 뒤에만 된다.
- [가능성 높음] 60 fps면 한 장 노출이 16.7 ms를 못 넘는다 → AI 카메라 때보다 빛이 더 필요하다. 그래서 '위 조명 없어도 됨'이 나올 가능성은 낮다 [추측].
- [가능성 높음] **아래 조명은 사진으로 뺄 수 없다.** 아래 조명은 '말벌이 빛 쪽 = 바닥에 머물러 등이 위로' 하는 행동 몫도 있다 (`design/2026-11-02_제어_통합정리_D5e.md` 68행). 이 시험은 "사진에 필요한가"만 답하고, 빼는 것은 살아 있는 말벌 시험(2027-07) 뒤.
- [가능성 높음] 승준 노랑 점 검출 `find_dots`는 밝기 문턱이 고정(V ≥ 130)이라 **사진이 어두워지면 검출률이 급히 떨어진다** — 합성 더미 40장, 11.5 화소/mm: 밝기 ×1.0 82 % · ×0.8 88 % · ×0.7 80 % · **×0.6 55 %** (15.6 화소/mm도 ×0.6 48 %). 합성 사진은 ×1.0에서도 90 % 목표 밑 → 승준에게 Issue (문턱을 사진 밝기에 맞추기).

## 1. 무엇을 비교하나
조명 4가지 (UNO 2 `LIGHT TOP`·`LIGHT BOT`): **(위, 아래) = (끔, 끔) · (켬, 끔) · (끔, 켬) · (켬, 켬)** × 바깥빛 2가지 (**bright** 맑은 낮 / **dim** 해 지기 30분 전 또는 트랩 위를 천으로 덮음 — 처리 마지막 시각이 해 지기 30분 전이라서).

| 쓰임 | process.py에서 | 보는 것 |
|---|---|---|
| A 판별·자세·점 확인 사진 | `lights(255, 0)` (identify, pose, verify) | 밝기·고름·노랑 점 |
| B 대기 중 마리 수 사진 | `lights(0, 255)` (idle_check, entry, after_close) | 빈 마킹실 사진과 차이로 말벌이 보이나 |

카메라는 **노출 8 ms · 게인 4 · 초점 153.5 mm · 흰색 고정** (자동 노출이 밝기 차이를 지워 버리지 않게). 8 ms면 걷는 말벌 20 mm/s가 0.16 mm ≈ 2화소 번짐 [추측].

## 2. 찍는 법 (Pi + CM3 + UNO 2, 마킹실 완성 뒤)
1. 점 찍은 더미 20개(`dot01`~`dot20`), 점 없는 더미 20개(`nodot01`~), **빈 마킹실 3번**(`empty01`~03) — 더미는 격자에 눌린 자세로
2. 더미 하나 놓을 때마다 `python light_test.py capture --amb bright --tag dot01` → 조명 4가지 × 3장 자동
3. 같은 것을 `--amb dim`으로 한 번 더
4. PC로 폴더를 옮겨 `python light_test.py analyze <폴더>` → 줄마다 O/X, 마지막에 판정 3줄

## 3. 통과 기준 (바깥빛 2가지 **모두** 통과해야 그 조합 통과)
| # | 기준 | 값 | 근거 |
|---|---|---|---|
| A1 | 마킹실 40 × 40 가운데 밝기 V 중앙값 · V ≥ 250 비율 | 80~220 · ≤ 1 % | 너무 어두우면 점 문턱(130) 밑, 포화면 노랑·흰색 구분 못 함 [추측] |
| A2 | 고름 = 빈 마킹실 4 × 4 칸 중앙값 최소/최대 | ≥ 0.6 | 한쪽이 어두우면 그쪽 점을 놓침 [추측] |
| A3 | 노랑 점 검출률 · 점 없는 더미 오검출 | ≥ 90 % · ≤ 5 % | R5 목표 90 % (승준 J4) |
| B | 빈 사진과 차이 > 30인 면적: 말벌 사진 ≥ 50 mm², 빈 사진 < 10 mm² — 맞힌 비율 | ≥ 95 % | 말벌 몸 약 20 × 8 = 160 mm² [추측]. VespAI가 아닌 대신 검사 |

## 4. 결과대로 할 일 (스크립트 판정과 같음)
| 판정 | 할 일 |
|---|---|
| A: (끔, 끔) 통과 | 위 조명 뺌 → circuit.py Q1·D3, 링 182, `LIGHT TOP` 부르는 곳, elec_budget 다시 |
| A: (켬, 끔)만 통과 | 지금 설계대로 |
| A: (켬, 켬)만 통과 | process.py 사진 찍을 때 `lights(255, 255)`, 전력 다시 |
| A: 모두 실패 | 링 밝기(LED 수·저항)·자리 다시 → CAD 대화로 |
| B: (끔, 켬) 통과 | 지금 설계대로 |
| B: (켬, 켬)만 통과 | 대기 중에도 위 조명 → 전력 (하루 Wh) 다시 |
| B: 모두 실패 | 대기 사진을 믿지 않고 빛 게이트 장부만 (idle_check 끔) |
| BOT | (끔, 끔)로도 B 통과면 "사진엔 아래 조명 필요 없음" — 그래도 빼는 것은 2027-07 행동 시험 뒤 |

## 5. 스크립트 확인 (11/09)
- `py -3.14 light_test.py selftest` → **11/11 PASS**: ① 합성 사진에서 위 조명 없음 X·있음 O, 아래 조명 B O·다 끔 B X ② 판정표 7가지를 손으로 만든 결과로 확인.
- 처음 돌렸을 때 **고름을 말벌 있는 사진으로 재서 모든 조합이 떨어짐**(말벌이 칸을 어둡게 함) → 빈 마킹실 사진으로 바꿈 [확실 — selftest].
- **미검증**: `capture`는 Pi·CM3가 없어 한 번도 안 돌렸다 (Picamera2 조작 이름은 [가능성 높음]). 노출 8 ms·게인 4·기준 숫자는 [추측].
