britams/-capstone-project-repo/design/2026-11-08_펌웨어v0.2_제어규칙_검토_서현.md

# 펌웨어 v0.2 제어 규칙 검토 — 규칙은 이 채팅, 코드는 VS Code

정리: 2026-11-08 · 이서현 (Claude 웹 채팅, **CAP-AI-42**, 제어·회로 서현 위임 → **(AI 판단, 서현 위임)**)
대상: `design/circuit/firmware/trap_motion/trap_motion.ino`, `trap_doors/trap_doors.ino` (VS Code 세션 CAP-AI-40·41, 커밋 7ab95b5)
기준: `design/2026-11-06_펌웨어_변경요청_서현.md`, `design/control_sim/trap_sim.py`, 인터페이스 정의서 5차

## 0. 나누는 법 (서현 11/08)
- **제어 규칙** (언제 무엇을 막는지, 순서, 안전, 판단 기준) = **웹 채팅 Claude**. 문서로 남기고 GitHub에 올린다.
- **코드** (펌웨어·Pi 코드 작성, 컴파일, 시뮬레이터) = **VS Code Claude**. 이 문서를 `git pull`로 받아 반영한다.
- 두 Claude는 서로의 대화를 못 본다. **연결은 GitHub 문서뿐이다.**
  - VS Code Claude가 코딩 중에 규칙을 새로 정하면, 코드 머리말의 '안전 규칙 (AI 판단)'에 적는다.
  - 웹 채팅 Claude가 그것을 검토해서 이 문서에 맞다/고침으로 남긴다.

## 1. 결과
- **[확실 — 코드 대조] 변경 요청의 규칙은 모두 들어가 있다.**
  - 핀 18/16개
  - HOME (스위치 3번 연속, 1 mm 물러났다 천천히 다시)
  - 서보 하나씩 붙이고 0.3 s 간격
  - HOLD 기본 0
  - SELFTEST로 문턱값 자동, 차이 < 200이면 FAIL
  - DOOR CLOSE 규칙 (빔 0.2 s 비어야 닫기 시작, 2 s 넘으면 WAIT, 끊기면 바로 엶, 3번이면 BLOCKED)
  - RAIL 0이면 문 명령 거부
  - READY 이름
- **VS Code Claude가 스스로 정한 규칙 6개 → 모두 받아들인다** (아래 2장).
- **고칠 것 1개**: R1 (3장).

## 2. VS Code가 정한 규칙 — 검토
| # | 규칙 (코드) | 판단 | 이유 |
|---|---|---|---|
| V1 | 켤 때 문·펜 서보를 붙이지 않음 (UNKNOWN / LIMP) | **맞다** | v0.1은 setup에서 문을 닫아 빔 확인 없이 닫힘 → 끼임 규칙을 어김 |
| V2 | 문이 움직이는 동안 다른 문은 ERR BUSY | **맞다** | 서보 한 번에 하나 (규칙 최대 1.8 A) |
| V3 | 닫기는 열린 쪽 각도에서 시작 | **맞다** | 자리를 모르는(UNKNOWN) 문이 닫는 쪽으로 튀지 않음 |
| V4 | X·Y는 펜이 UP일 때만 (MOVE·HOME) | **맞다** | 펜이 캡 컵에 꽂힌 채 끌리지 않게 |
| V5 | 스위치 쪽으로 가다 원점보다 0.5 mm 넘게 위에서 눌리면 걸음 잃음 → 정지, EVT SWITCH | **맞다** | 걸음을 잃은 채 계속 움직이지 않게 |
| V6 | HOME 최대 = 축마다 (행정 + 4 mm). 변경 요청은 20480 반걸음 | **맞다 — 변경 요청을 고친다** | Y 행정이 58 mm라 20480(40 mm)으로는 못 닿음 → 거짓 NOSWITCH. 변경 요청 1장의 '20480'은 F 기준이었음 |
| V7 | PRESS 뒤 코일 끔 (HOLD F 0 그대로) | **맞다** | `elec_budget.hold_check`: 누르는 힘 0.5 N의 역구동 토크 0.64 N·mm < 기어 마찰 59~118 N·mm (92배 이상) → 코일 없이도 자리 유지. 변경 요청의 'PRESS 중에는 HOLD 1'은 필요 없음 |

## 3. 고칠 것 (AI 판단, 서현 위임)
**R1 — 바닥(F)을 위로 올리는 것은 펜이 UP일 때만 허용한다.**
- **[확실 — 코드] 지금 코드는 `MOVE F <더 높은 mm>`에 펜 확인이 없다.**
  - PEN DOWN으로 말벌에 점을 찍는 중에 Pi가 실수로 F를 올리면, 말벌이 격자와 펜 사이에 눌린다.
  - PRESS는 힘(g) 한계로 멈추지만, MOVE에는 힘 한계가 없다.
- **규칙:**
  - `MOVE F`의 목표가 지금보다 높고 펜이 UP이 아니면 → `ERR PEN_DOWN`
  - `PRESS`도 펜이 UP이 아니면 → `ERR PEN_DOWN`
  - F를 내리는 것(목표가 더 낮음)과 `HOME F`(아래로 감)는 언제나 허용한다. 내리는 쪽은 말벌에서 멀어지는 쪽이다.
- **trap_sim 순서와 맞는지 [확실 — trap_sim 1004~1038행]:**
  - PRESS 전에 `PEN UP`을 보낸다.
  - 펜을 내리는 것은 PRESS가 끝난 뒤다.
  - 그다음 F는 내리기만 한다 (`F_retract`).
  - → 이 규칙을 넣어도 정상 순서는 막히지 않는다.
- **시험 1개 추가:** PEN DOWN 상태에서 `MOVE F 30` → `ERR PEN_DOWN`, `MOVE F 0` → OK

## 4. Pi 코드(pi_link)에 넣을 순서 규칙
| # | 규칙 | 이유 |
|---|---|---|
| P1 | 켤 때 SELFTEST 결과에서 **G1이 FAIL이면 운용을 시작하지 않고 알린다** | G1이 진입 신호다. G1이 고장이면 말벌이 들어와도 모른다 |
| P2 | 문 빔이 FAIL이면 **빔이 비어 있을 때 SELFTEST를 1번 더** 한다 (10 s 뒤). 그래도 FAIL이면 그 문은 쓰지 않고 알린다 | 켤 때 말벌이 빔 사이에 있으면 FAIL이 날 수 있다 |
| P3 | 밤 모드 순서: **REL CLOSE → IN·CAP OPEN → 조명 0 → (원하면) EMIT 0** | EMIT 0이면 닫기가 거부된다(EMIT_OFF). 그래서 닫는 것을 먼저 한다 |
| P4 | `EVT RAIL 1`(비상 정지 풀림)을 받으면 **PEN UP → HOME F·X·Y → 문은 OPEN부터** | 전원이 끊긴 동안 축과 문의 자리를 모른다 |
| P5 | 두 UNO 모두 `WATCHDOG 5`를 켤 때 보낸다 | Pi가 멈추면 닫던 문을 열고 펜을 든다 |
| P6 | `EVT DOOR <문> BLOCKED` → **5 s 쉬고 DOOR CLOSE를 다시** (최대 3번, 펌웨어 안의 3번까지 합치면 9번). 그래도 막히면 고장 `DOOR_<문>_STUCK` → 새 말벌을 받지 않고 알린다 | trap_sim `close_door()`, 시나리오 S8b (24/24 PASS) |
| P7 | **응답 이름은 펌웨어 쪽에 맞춘다**: trap_sim은 `EVT DOOR <문> CLOSED/OPEN`, 펌웨어 v0.2는 `DONE DOOR <문> CLOSED/OPEN` (BLOCKED·REOPEN만 EVT) | [확실 — 두 코드 대조] trap_sim을 옮겨 쓸 때 그대로 두면 닫힘을 영영 못 기다림 |

## 5. 바뀜 (11/08 저녁, 서현): 규칙도 VS Code Claude가 정한다
- 웹 채팅은 쓰지 않는다. 0장의 나누는 법은 여기서 끝난다.
- VS Code가 CAP-AI-44·45에서 정한 것 4개 → **직접 판단 (AI 판단, 서현 위임)**:

| # | 규칙 | 판단 | 이유 |
|---|---|---|---|
| B1 | trap_doors: 같은 문이 움직이는 중에 그 문 CLOSE → `ERR BUSY` (OPEN으로 취소는 허용) | **맞다** | [확실 — 시뮬] 고치기 전에는 WAIT 끝에 문이 OPENING으로 굳어 다른 문 명령을 못 받음 (고치기 전 코드로 2 FAIL) |
| B2 | trap_motion: 마지막 반걸음 뒤 20 ms 지나 코일 끔 | **맞다** | 반걸음 간격 1 ms라 20 ms면 충분. 이동마다 20 ms × 약 0.24 A — 에너지 무시할 만함 [가능성 높음]. 실물에서 위치가 쌓여 틀어지는지는 B4 시험으로 |
| A1 | `EVT RAIL 0` → UNO 1에 `STOP` | **맞다** | 전원이 끊긴 동안 펌웨어가 걸음을 계속 세면 위치 숫자만 앞서감. 멈춰 두고 복귀할 때 HOME(P4)으로 다시 맞춤 |
| A2 | 대기 자리 X = +10 mm (펌웨어 좌표) | **보류 — 미검증** | CAD 좌표 X 37~73을 펌웨어 −18~+18로 같은 방향으로 옮긴다고 가정했는데, X 스위치가 어느 끝에 있는지 확인 안 함 → **D5g 모델에서 캡 컵 219와 X 원점 스위치 자리를 재서 정한다 (CAD C 작업 중)** |
