britams/-capstone-project-repo/design/2026-11-06_하네스표_서현.md

# 하네스 표 — 선 하나하나 (어디서 어디로, 색, 굵기, 길이, 커넥터)

정리: 2026-11-06 20시 반 · 이서현 (Claude, **CAP-AI-32**, 제어·회로 위임)
코드: `design/circuit/harness.py` → `design/circuit/out/harness.csv` (엑셀로 열림, 선 115가닥 한 줄씩) + 아래 2장 표
바탕: 회로 `design/circuit/circuit.py`, 좌표·길이 `design/control_sim/elec_budget.py` + `harness.py` `P_EXTRA` (**D5g 실제 자리, 11/07 CAP-AI-38**)

## 0. 결론 먼저
- **11/07 확정 (CAP-AI-38):** 승준 D5g 실제 자리(Issue #7 SJ-49: 와고·허브·MOSFET·퓨즈·비상 정지·J_I2C·UNO·Pi·ULN·막대 로드셀)로 다시 계산했다.
- **[확실 — 스크립트] 43묶음, 선 115가닥, 자를 길이 합 45.1 m** (D5f 기준 35.1 m에서 늘어남).
  - 굵기별: 20 AWG 1.6 m, 22 AWG 5.0 m, 24 AWG 2.6 m, 26 AWG 12.7 m, 28 AWG 23.2 m.
  - 늘어난 이유:
    - UNO가 x −60에서 **−94**로 옮겨져 서보 허브(0, 66)까지 멀어졌다 (S04 +230, S10 +220).
    - 와고가 데크 −y 끝, MOSFET이 +y에 있다 (P10 +220).
    - J_I2C → Pi 4선(**S13 새로**, 610 mm)이 생겼다.
  - 살 때는 굵기별로 **1.5배** (자르기·실수 여유).
- **[확실 — 계산] 전압 강하가 가장 큰 선은 펜 서보 선이다 (0.12 V, 5 V의 2.4 %).** 나머지는 0.1 V 아래라 문제없다.
- **문 빔 6쌍(G04~G09)은 LED·포토TR 다리에 바로 납땜**하고, 220 Ω와 10 kΩ는 게이트 허브 기판에 둔다 (21시, 승준 SJ-47).
- **움직이는 선 4개(M03, S06, S09, V01)는 '휨 고리'를 둔다.** 각각 Y 모터, 로드셀, Y 원점, 펜 서보 선이다. 고리 길이 = 1.5 × 움직임 + 40 mm (길이에 이미 넣음). 실리콘 연선을 쓴다.
- **[확실 — 계산] AI 카메라 FFC가 아슬아슬하다.** Pi(선반 199a) → 카메라: 필요 약 320 mm, 동봉 300 mm (부품 가운데 점끼리 길이라 실제는 조금 짧을 수 있음 [가능성 높음]). → **500 mm FFC(22↔15핀)를 1개 사 둔다.** USB A–B 1 m 2개는 충분하다 (필요 680 / 650 mm).
- **[추측] D5g 모델에 없는 2개는 서현이 제안한 자리다:**
  - **HX711** (66, 95, 210): 로드셀 +y 끝 아래, 데크 위
  - **DC 잭** (−184, −22, 225): 비상 정지 판 194b의 −y 쪽, 퓨즈 반대편
  - 승준이 다시 작업할 때 CAD에 넣는다 (그 전에는 실물 조립 때 이 자리에 둠).

## 1. 쉬운 설명 (초등학생용)
- **하네스**는 '선 묶음'이에요. 기계 안 전선을 한 가닥씩 이름표를 붙여서, 어디서 어디로 가는지 적은 표예요. 이 표대로 자르고 꽂으면 누가 만들어도 똑같이 만들어져요.
- **번호 첫 글자**:
  - P = 힘 전기(Power)
  - S = 신호(Signal)
  - M = 모터 선
  - V = 서보 선
  - G = 빛 문지기(Gate) 선
  - L = 조명(Light) 선
- **색 약속**: 빨강 = +5 V, 검정 = GND, 흰색 = 빛 문지기 신호, 주황 = 서보 신호, 노랑 = 원점 스위치·조명 켜기, 파랑·초록·노랑·주황 = 모터 명령 4가닥 (IN1~4 순서).
- **굵기 (AWG)**: 숫자가 작을수록 굵어요. 전기를 많이 나르는 선(어댑터 → 와고)은 굵은 20, 신호선은 가는 26·28.
- **'기본 + 연장'**: 모터·서보·빛 문지기는 처음부터 선이 달려 나와요 (230~250 mm). 모자라는 만큼만 이어 붙여요.
- **휨 고리**: 움직이는 부품의 선은 팽팽하면 끊어져요. 그래서 둥글게 여유를 남겨요 (고무줄처럼 늘어나는 게 아니라 접혔다 펴지는 길이).

## 2. 묶음별 표

| 번호 | 어디 → 어디 | 선 (색·굵기) | 시작 핀 → 끝 핀 | 자를 길이 | 양 끝 | 움직임 |
|---|---|---|---|---|---|---|
| P01 | 어댑터 DC 잭 → 퓨즈 | +5V 들어옴 (빨강, 20 AWG) | 잭 + → 퓨즈 1 | 150 mm | DC 잭 단자 납땜/나사 / 퓨즈홀더 납땜 |  |
| P02 | 어댑터 DC 잭 GND → 와고 GND | GND (검정, 20 AWG) | 잭 − → 와고 GND 1번 | 390 mm | DC 잭 단자 납땜/나사 / 와고 221-415 (선 끝 8 mm 벗김) |  |
| P03 | 퓨즈 → 비상 정지 | +5V 퓨즈 뒤 (빨강, 20 AWG) | 퓨즈 2 → 비상 정지 NC 1 | 120 mm | 퓨즈홀더 납땜 / 비상 정지 나사 단자 |  |
| P04 | 비상 정지 → 와고 +5V | +5V_B (빨강, 20 AWG) | NC 2 → 와고 +5V 1번 | 410 mm | 비상 정지 나사 단자 / 와고 221-415 (선 끝 8 mm 벗김) |  |
| P05 | 와고 → ULN2003 F | +5V_B (빨강, 22 AWG)<br>GND (검정, 22 AWG) | 와고 +5V → ULN + (5-12V)<br>와고 GND → ULN − | 180 mm | 와고 221-415 (선 끝 8 mm 벗김) / 듀폰 암 (ULN 전원 핀) |  |
| P06 | 와고 → ULN2003 X | +5V_B (빨강, 22 AWG)<br>GND (검정, 22 AWG) | 와고 +5V → ULN +<br>와고 GND → ULN − | 700 mm | 와고 221-415 (선 끝 8 mm 벗김) / 듀폰 암 (ULN 전원 핀) |  |
| P07 | 와고 → ULN2003 Y | +5V_B (빨강, 22 AWG)<br>GND (검정, 22 AWG) | 와고 +5V → ULN +<br>와고 GND → ULN − | 770 mm | 와고 221-415 (선 끝 8 mm 벗김) / 듀폰 암 (ULN 전원 핀) |  |
| P08 | 와고 → 서보 허브 | +5V_B (빨강, 20 AWG)<br>GND (검정, 20 AWG) | 와고 +5V → 허브 +<br>와고 GND → 허브 − | 260 mm | 와고 221-415 (선 끝 8 mm 벗김) / 허브 기판 납땜 |  |
| P09 | 와고 → 게이트 허브 | +5V_B (빨강, 22 AWG)<br>GND (검정, 22 AWG) | 와고 +5V → 허브 +<br>와고 GND → 허브 − | 280 mm | 와고 221-415 (선 끝 8 mm 벗김) / 허브 기판 납땜 |  |
| P10 | 와고 → MOSFET 보드 (조명 전원) | +5V_B (빨강, 22 AWG)<br>GND (검정, 22 AWG) | 와고 +5V → 보드 V+<br>와고 GND → 보드 GND | 350 mm | 와고 221-415 (선 끝 8 mm 벗김) / 보드 나사 단자 |  |
| P11 | UNO 1·2 GND → 와고 GND | GND U1 (검정, 22 AWG)<br>GND U2 (검정, 22 AWG) | UNO 1 GND → 와고 GND<br>UNO 2 GND → 와고 GND | 210 mm | 듀폰 암 1핀 (UNO 헤더) / 와고 221-415 (선 끝 8 mm 벗김) |  |
| P12 | 레일 감지 (+5V_B → 10 kΩ → UNO 2 D2) | RAIL (주황, 28 AWG) | 허브 10 kΩ 끝 → UNO 2 D2 | 160 mm | 허브 기판 납땜 / 듀폰 암 1핀 (UNO 헤더) |  |
| S01 | UNO 1 → ULN2003 F (IN1~4) | IN1 (파랑, 26 AWG)<br>IN2 (초록, 26 AWG)<br>IN3 (노랑, 26 AWG)<br>IN4 (주황, 26 AWG) | D2 → IN1<br>D3 → IN2<br>D4 → IN3<br>D5 → IN4 | 280 mm | 듀폰 암 1핀 (UNO 헤더) / 듀폰 암 (ULN IN 핀) |  |
| S02 | UNO 1 → ULN2003 X (IN1~4) | IN1 (파랑, 26 AWG)<br>IN2 (초록, 26 AWG)<br>IN3 (노랑, 26 AWG)<br>IN4 (주황, 26 AWG) | D6 → IN1<br>D7 → IN2<br>D8 → IN3<br>D9 → IN4 | 790 mm | 듀폰 암 1핀 (UNO 헤더) / 듀폰 암 (ULN IN 핀) |  |
| S03 | UNO 1 → ULN2003 Y (IN1~4) | IN1 (파랑, 26 AWG)<br>IN2 (초록, 26 AWG)<br>IN3 (노랑, 26 AWG)<br>IN4 (주황, 26 AWG) | D10 → IN1<br>D11 → IN2<br>D12 → IN3<br>D13 → IN4 | 860 mm | 듀폰 암 1핀 (UNO 헤더) / 듀폰 암 (ULN IN 핀) |  |
| M01 | ULN2003 F → 바닥 모터 153 | 모터 5선 (모터에 달린 선) (파랑·분홍·노랑·주황·빨강, 26 AWG) | ULN JST-XH 5 → 모터 | 기본 240 (연장 없음) | JST-XH 5핀 (모터 기본) / 모터 (기본) |  |
| M02 | ULN2003 X → X 모터 215 | 모터 5선 (파랑·분홍·노랑·주황·빨강, 26 AWG) | ULN JST-XH 5 → 모터 | 기본 240 (연장 없음) | JST-XH 5핀 / 모터 (기본) |  |
| M03 | ULN2003 Y → Y 모터 209 (X로 움직임) | 모터 5선 (파랑·분홍·노랑·주황·빨강, 26 AWG) | ULN JST-XH 5 → 모터 | 기본 240 + 연장 180 | JST-XH 5핀 / 모터 (기본) | 휨 고리 |
| V01 | 서보 허브 → 펜 서보 SG90 205 (X·Y로 움직임) | 서보 3선 (갈색 GND·빨강 +5V·주황 신호, 26 AWG) | 허브 헤더 S1 → 서보 | 기본 250 + 연장 500 | 듀폰 2.54 헤더 (허브 기판) / 서보 3핀 (기본) | 휨 고리 |
| S04 | UNO 1 A0 → 서보 허브 S1 신호 | PEN 신호 (주황, 26 AWG) | A0 → 허브 S1 신호 | 350 mm | 듀폰 암 1핀 (UNO 헤더) / 허브 기판 납땜 |  |
| S05 | UNO 1 → HX711 (VCC, GND, DT, SCK) | VCC (빨강, 26 AWG)<br>GND (검정, 26 AWG)<br>DT (흰색, 26 AWG)<br>SCK (초록, 26 AWG) | 5V → VCC<br>GND → GND<br>A1 → DT<br>A2 → SCK | 470 mm | 듀폰 암 1핀 (UNO 헤더) / 듀폰 암 (HX711 헤더) |  |
| S06 | HX711 → 로드셀 (바닥과 함께 움직임) | E+ (빨강, 28 AWG)<br>E− (검정, 28 AWG)<br>A− (흰색, 28 AWG)<br>A+ (초록, 28 AWG) | E+ → 로드셀 빨강<br>E− → 로드셀 검정<br>A− → 로드셀 흰색<br>A+ → 로드셀 초록 | 230 mm | HX711 납땜 / 로드셀 선 (납땜 + 수축튜브) | 휨 고리 |
| S07 | UNO 1 → 원점 F | HOME_F (노랑, 28 AWG)<br>GND (검정, 28 AWG) | A3 → 스위치 NO<br>GND → 스위치 COM | 370 mm | 듀폰 암 1핀 (UNO 헤더) / 스위치 납땜 + 100 nF |  |
| S08 | UNO 1 → 원점 X | HOME_X (노랑, 28 AWG)<br>GND (검정, 28 AWG) | A4 → 스위치 NO<br>GND → 스위치 COM | 590 mm | 듀폰 암 1핀 (UNO 헤더) / 스위치 납땜 + 100 nF |  |
| S09 | UNO 1 → 원점 Y (빔과 함께 움직임) | HOME_Y (노랑, 28 AWG)<br>GND (검정, 28 AWG) | A5 → 스위치 NO<br>GND → 스위치 COM | 770 mm | 듀폰 암 1핀 (UNO 헤더) / 스위치 납땜 + 100 nF | 휨 고리 |
| V02 | 서보 허브 → 입구 문 서보 112 | 서보 3선 (갈색·빨강·주황, 26 AWG) | 허브 S2 → 서보 | 기본 250 + 연장 120 | 듀폰 2.54 헤더 (허브 기판) / 서보 3핀 (기본) |  |
| V03 | 서보 허브 → 격리 문 서보 170 | 서보 3선 (갈색·빨강·주황, 26 AWG) | 허브 S3 → 서보 | 기본 250 + 연장 160 | 듀폰 2.54 헤더 (허브 기판) / 서보 3핀 (기본) |  |
| V04 | 서보 허브 → 방생 문 서보 176 | 서보 3선 (갈색·빨강·주황, 26 AWG) | 허브 S4 → 서보 | 기본 250 + 연장 240 | 듀폰 2.54 헤더 (허브 기판) / 서보 3핀 (기본) |  |
| S10 | UNO 2 D9·D10·D11 → 서보 허브 S2~S4 신호 | DOOR_IN (주황, 26 AWG)<br>DOOR_CAP (주황, 26 AWG)<br>DOOR_REL (주황, 26 AWG) | D9 → 허브 S2<br>D10 → 허브 S3<br>D11 → 허브 S4 | 370 mm | 듀폰 암 1핀 (UNO 헤더) / 허브 기판 납땜 |  |
| S11 | UNO 2 → 게이트 허브 (수신 9 + 송신 켜기 1) | G2 (흰색, 28 AWG)<br>G2b (흰색, 28 AWG)<br>G3 (흰색, 28 AWG)<br>G3b (흰색, 28 AWG)<br>G5 (흰색, 28 AWG)<br>G5b (흰색, 28 AWG)<br>G1 (흰색, 28 AWG)<br>G4 (흰색, 28 AWG)<br>G6 (흰색, 28 AWG)<br>EMIT_EN (보라, 28 AWG) | A0 → 허브 G2<br>A1 → 허브 G2b<br>A2 → 허브 G3<br>A3 → 허브 G3b<br>A4 → 허브 G5<br>A5 → 허브 G5b<br>D7 → 허브 G1<br>D8 → 허브 G4<br>D12 → 허브 G6<br>D4 → 허브 Q4 TRIG | 160 mm | 듀폰 암 1핀 (UNO 헤더) / 허브 기판 납땜 |  |
| G01 | 게이트 허브 → 통로 빛 게이트 G1 (Adafruit 2167: 송신 2선 + 수신 3선) | 송신 +5V (빨강, 28 AWG)<br>송신 GND(켜기) (검정, 28 AWG)<br>수신 +5V (빨강, 28 AWG)<br>수신 GND (검정, 28 AWG)<br>수신 신호 (흰색, 28 AWG) | 허브 TX+ → 송신 빨강<br>허브 Q4 OUT− → 송신 검정<br>허브 RX+ → 수신 빨강<br>허브 GND → 수신 검정<br>허브 G1 (10 kΩ 풀업) → 수신 흰색 | 기본 230 + 연장 20 | 듀폰 2.54 헤더 (허브 기판) / 게이트 기본 선 + 연장 (납땜 + 수축튜브) |  |
| G02 | 게이트 허브 → 통로 빛 게이트 G4 (Adafruit 2167: 송신 2선 + 수신 3선) | 송신 +5V (빨강, 28 AWG)<br>송신 GND(켜기) (검정, 28 AWG)<br>수신 +5V (빨강, 28 AWG)<br>수신 GND (검정, 28 AWG)<br>수신 신호 (흰색, 28 AWG) | 허브 TX+ → 송신 빨강<br>허브 Q4 OUT− → 송신 검정<br>허브 RX+ → 수신 빨강<br>허브 GND → 수신 검정<br>허브 G4 (10 kΩ 풀업) → 수신 흰색 | 기본 230 + 연장 410 | 듀폰 2.54 헤더 (허브 기판) / 게이트 기본 선 + 연장 (납땜 + 수축튜브) |  |
| G03 | 게이트 허브 → 통로 빛 게이트 G6 (Adafruit 2167: 송신 2선 + 수신 3선) | 송신 +5V (빨강, 28 AWG)<br>송신 GND(켜기) (검정, 28 AWG)<br>수신 +5V (빨강, 28 AWG)<br>수신 GND (검정, 28 AWG)<br>수신 신호 (흰색, 28 AWG) | 허브 TX+ → 송신 빨강<br>허브 Q4 OUT− → 송신 검정<br>허브 RX+ → 수신 빨강<br>허브 GND → 수신 검정<br>허브 G6 (10 kΩ 풀업) → 수신 흰색 | 기본 230 + 연장 300 | 듀폰 2.54 헤더 (허브 기판) / 게이트 기본 선 + 연장 (납땜 + 수축튜브) |  |
| G04 | 게이트 허브 → 문 빔 G2 (낱개: IR LED 2선 + 포토TR 2선, 220 Ω·10 kΩ는 허브에) | LED +(220 Ω 뒤) (빨강, 28 AWG)<br>LED −(켜기) (검정, 28 AWG)<br>포토TR C (빨강, 28 AWG)<br>포토TR E(신호) (흰색, 28 AWG) | 허브 R220 끝 → LED 긴 다리 A<br>허브 Q4 OUT− → LED 짧은 다리 K<br>허브 +5V → 포토TR 컬렉터<br>허브 G2 (10 kΩ → GND) → 포토TR 이미터 | 400 mm | 듀폰 2.54 헤더 (허브 기판) / LED·포토TR 다리 납땜 + 수축튜브 |  |
| G05 | 게이트 허브 → 문 빔 G2b (낱개: IR LED 2선 + 포토TR 2선, 220 Ω·10 kΩ는 허브에) | LED +(220 Ω 뒤) (빨강, 28 AWG)<br>LED −(켜기) (검정, 28 AWG)<br>포토TR C (빨강, 28 AWG)<br>포토TR E(신호) (흰색, 28 AWG) | 허브 R220 끝 → LED 긴 다리 A<br>허브 Q4 OUT− → LED 짧은 다리 K<br>허브 +5V → 포토TR 컬렉터<br>허브 G2b (10 kΩ → GND) → 포토TR 이미터 | 410 mm | 듀폰 2.54 헤더 (허브 기판) / LED·포토TR 다리 납땜 + 수축튜브 |  |
| G06 | 게이트 허브 → 문 빔 G3 (낱개: IR LED 2선 + 포토TR 2선, 220 Ω·10 kΩ는 허브에) | LED +(220 Ω 뒤) (빨강, 28 AWG)<br>LED −(켜기) (검정, 28 AWG)<br>포토TR C (빨강, 28 AWG)<br>포토TR E(신호) (흰색, 28 AWG) | 허브 R220 끝 → LED 긴 다리 A<br>허브 Q4 OUT− → LED 짧은 다리 K<br>허브 +5V → 포토TR 컬렉터<br>허브 G3 (10 kΩ → GND) → 포토TR 이미터 | 450 mm | 듀폰 2.54 헤더 (허브 기판) / LED·포토TR 다리 납땜 + 수축튜브 |  |
| G07 | 게이트 허브 → 문 빔 G3b (낱개: IR LED 2선 + 포토TR 2선, 220 Ω·10 kΩ는 허브에) | LED +(220 Ω 뒤) (빨강, 28 AWG)<br>LED −(켜기) (검정, 28 AWG)<br>포토TR C (빨강, 28 AWG)<br>포토TR E(신호) (흰색, 28 AWG) | 허브 R220 끝 → LED 긴 다리 A<br>허브 Q4 OUT− → LED 짧은 다리 K<br>허브 +5V → 포토TR 컬렉터<br>허브 G3b (10 kΩ → GND) → 포토TR 이미터 | 440 mm | 듀폰 2.54 헤더 (허브 기판) / LED·포토TR 다리 납땜 + 수축튜브 |  |
| G08 | 게이트 허브 → 문 빔 G5 (낱개: IR LED 2선 + 포토TR 2선, 220 Ω·10 kΩ는 허브에) | LED +(220 Ω 뒤) (빨강, 28 AWG)<br>LED −(켜기) (검정, 28 AWG)<br>포토TR C (빨강, 28 AWG)<br>포토TR E(신호) (흰색, 28 AWG) | 허브 R220 끝 → LED 긴 다리 A<br>허브 Q4 OUT− → LED 짧은 다리 K<br>허브 +5V → 포토TR 컬렉터<br>허브 G5 (10 kΩ → GND) → 포토TR 이미터 | 520 mm | 듀폰 2.54 헤더 (허브 기판) / LED·포토TR 다리 납땜 + 수축튜브 |  |
| G09 | 게이트 허브 → 문 빔 G5b (낱개: IR LED 2선 + 포토TR 2선, 220 Ω·10 kΩ는 허브에) | LED +(220 Ω 뒤) (빨강, 28 AWG)<br>LED −(켜기) (검정, 28 AWG)<br>포토TR C (빨강, 28 AWG)<br>포토TR E(신호) (흰색, 28 AWG) | 허브 R220 끝 → LED 긴 다리 A<br>허브 Q4 OUT− → LED 짧은 다리 K<br>허브 +5V → 포토TR 컬렉터<br>허브 G5b (10 kΩ → GND) → 포토TR 이미터 | 520 mm | 듀폰 2.54 헤더 (허브 기판) / LED·포토TR 다리 납땜 + 수축튜브 |  |
| S12 | UNO 2 D3·D5 → MOSFET 보드 (조명 켜기) | L_TOP (노랑, 26 AWG)<br>L_BOT (노랑, 26 AWG) | D3 → Q1 TRIG<br>D5 → Q2 TRIG | 230 mm | 듀폰 암 1핀 (UNO 헤더) / 보드 핀 |  |
| L01 | MOSFET → 위 조명 182 | +5V (빨강, 24 AWG)<br>Q1 OUT− (검정, 24 AWG) | 보드 V+ → 조명 +<br>Q1 OUT− → 조명 − | 830 mm | 보드 나사 단자 / 조명 납땜 |  |
| L02 | MOSFET → 아래 조명 | +5V (빨강, 24 AWG)<br>Q2 OUT− (검정, 24 AWG) | 보드 V+ → 조명 +<br>Q2 OUT− → 조명 − | 470 mm | 보드 나사 단자 / 조명 납땜 |  |
| S13 | J_I2C → Pi I2C (배터리 상자 INA226, 콘센트일 때는 비어 있음) | 3.3V (빨강, 28 AWG)<br>GND (검정, 28 AWG)<br>SDA (파랑, 28 AWG)<br>SCL (노랑, 28 AWG) | J_I2C 1 VS → Pi 핀 1 (3V3)<br>J_I2C 2 GND → Pi 핀 6 (GND)<br>J_I2C 3 SDA → Pi 핀 3 (GPIO2)<br>J_I2C 4 SCL → Pi 핀 5 (GPIO3) | 610 mm | JST XH 4P 하우징 (193j에 꽂음) / 듀폰 암 1핀 (Pi 헤더) |  |

**사서 쓰는 케이블 길이 확인** (경로 + 10 %)

| 케이블 | 필요 | 있음(산 것) | 판단 |
|---|---|---|---|
| Pi USB → UNO 1 (USB A–B) | 680 mm | 1000 mm | 충분 |
| Pi USB → UNO 2 (USB A–B) | 650 mm | 1000 mm | 충분 |
| Pi CAM0 → AI 카메라 (22↔15핀 FFC) | 320 mm | 300 mm | **모자람** |

## 3. 만들 때 순서 (브레드보드 단계와 맞춤)
1. P01~P04 (어댑터 → 퓨즈 → 비상 정지 → 와고): 테스터로 5.0 V, 비상 정지 누르면 0 V
2. P08·P11·S11 + G 하나 (게이트 허브 + 빛 문지기 1쌍) → 손으로 가려 LOW
3. P07·S10 + V02 (서보 허브 + 입구 문 서보)
4. P04·S01·M01 + S07 (바닥 축) → 나머지 축 P05·P06·S02·S03·M02·M03·S08·S09
5. 나머지 (S04·V01 펜, S05·S06 로드셀, P09·S12·L01·L02 조명)
6. 배터리 상자를 쓸 때만: S13 (J_I2C → Pi)

## 4. 고칠 때
- 부품 자리가 바뀌면 → `elec_budget.py`의 `P` 또는 `harness.py`의 `P_EXTRA` 좌표 → `python3 design/circuit/harness.py`
- 연결이 바뀌면 → `circuit.py`(넷리스트)와 `harness.py`의 `H`를 같이 고침 (같은 핀 이름)
