britams/-capstone-project-repo/design/2026-11-06_배터리상자_쉬운설명_서현.md

# 배터리 상자 — 초등학생도 알게 설명

정리: 2026-11-06 22시 · 이서현 (Claude, CAP-AI-35). 자세한 것: `design/2026-11-06_배터리상자_회로_서현.md`

## 1. 왜 필요해요?
- 트랩은 보통 **콘센트**에 꽂아요. 그런데 산이나 밭에는 콘센트가 없을 수 있어요.
- 그래서 **큰 배터리를 상자에 넣고**, 콘센트 어댑터 자리에 상자의 플러그 2개를 꽂아요.
- 트랩 본체는 하나도 안 바꿔요. 어댑터 대신 상자를 꽂는 것뿐이에요.

## 2. 상자 안에는 무엇이 있나요? (물 비유: 전기 = 물)
| 부품 | 하는 일 | 비유 |
|---|---|---|
| LiFePO4 배터리 12.8 V 20 Ah | 전기를 담아 둠 (약 3일치) | 큰 물탱크 |
| 퓨즈 5 A | 물이 너무 세게 흐르면 스스로 끊어짐 | 터지면 잠기는 안전 밸브 |
| INA226 | 지금 얼마나 흐르는지, 탱크 높이가 얼마인지 잼 | 수도 계량기 |
| 주 스위치 | 상자를 켜고 끔 | 큰 수도꼭지 |
| 강압 A | 12.8 V를 5.15 V로 낮춰서 Pi(뇌)에 줌 | 센 물을 약하게 바꾸는 감압 밸브 |
| 강압 B | 12.8 V를 5 V로 낮춰서 모터·문(팔다리)에 줌 | 두 번째 감압 밸브 |
| 충전 단자 | 배터리를 다시 채움 | 탱크 물 넣는 구멍 |

## 3. 오늘 찾은 함정 2개
1. **계량기 눈금이 너무 작아요.**
   - 흔히 파는 INA226은 0.8 A까지만 잴 수 있어요.
   - 그런데 트랩은 많이 쓸 때 2~3 A가 흘러요. 눈금이 끝에 붙어서 틀린 값이 나와요.
   - → 눈금이 큰 것(**R010**, 8 A까지)을 사요.
2. **배터리일 때만 '돌아가는 길'이 하나 더 생겨요.**
   - 전기는 나갔다가 반드시 돌아와야 해요 (GND 길).
   - 콘센트 어댑터 2개는 서로 떨어져 있어서 돌아오는 길이 각자 하나씩이에요.
   - 배터리는 하나라서, 모터로 갔던 전기 일부(약 30 %)가 **USB 선을 지나 지름길로** 돌아올 수 있어요.
   - 위험하지는 않지만 신호가 지저분해질 수 있어요.
   - → 돌아오는 굵은 길(18 AWG 선)을 만들고, 실제로 재 봐요. 문제가 있으면 '서로 떨어진' 감압 밸브(절연형)로 바꿔요.

## 4. 지켜야 할 약속
- 퓨즈는 배터리 **바로 옆**(10 cm 안)에 달아요. 선이 길면 그 선이 합선돼도 못 막아요.
- 충전은 **전용 충전기(14.6 V)**로만 해요. **영하일 때는 충전하지 않아요** (이 배터리는 추우면 충전하다 망가져요).
- 플러그를 바꿔 꽂을 때는 트랩을 먼저 꺼요.
- 배터리가 15 % 남으면 Pi가 알아채요. 하던 말벌은 끝까지 처리하고, 문을 열어 두고 스스로 꺼져요.

## 5. 한 줄 요약
> 물탱크(배터리) → 안전 밸브(퓨즈) → 계량기(INA226) → 꼭지(스위치) → 감압 밸브 2개 → 뇌(Pi)와 팔다리(모터·문).
