britams/-capstone-project-repo/design/2026-11-06_제어알고리즘_판단_서현.md

# 제어 알고리즘과 판단 정리 (D5e + 11/02 결정)

정리: 2026-11-06 · 이서현 (Claude, **CAP-AI-23**, 서현 확인 대기)
참고 구현(실행됨): `design/control_sim/trap_sim.py` — 여기 적은 알고리즘이 그대로 들어 있고 시나리오 19개를 통과한다.
흐름도 원본: `design/algo/*.mmd` → 그림 `design/img/algo/`
표기: [확실] / [가능성 높음] / [추측]. **★ = 서현 판단 필요**

## 0. 결론 먼저
- 제어는 **세 층**이다: ① UNO 2가 혼자 지키는 안전(문틈·서보 하나씩) ② UNO 1이 혼자 지키는 안전(펜 든 채로만 X·Y, Pi 침묵 때 멈춤·바닥 내림) ③ Pi가 하는 판단(누구인지, 무엇을 할지). Pi가 죽어도 ①②는 남는다 [확실 — 시나리오 S12b].
- 판단에 쓰는 숫자 12개 중 **실험 없이 정한 것이 9개**다 [확실]. 대부분 J6·행동 시험에서 바뀐다. 그중 서현이 정해야 할 것 4개를 7장에 모았다.

## 1. 전체 흐름

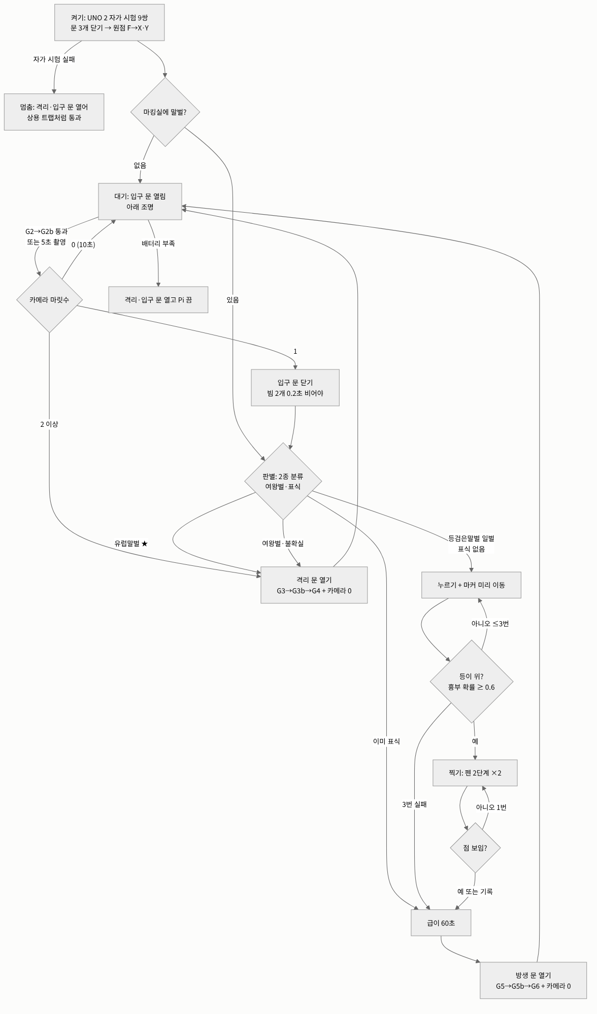
[picture p17: design/img/algo/algo_A1_전체흐름.png]
전체 흐름


## 2. 알고리즘

### A1. 문 닫기 (UNO 2, 문마다) — 끼임 막기
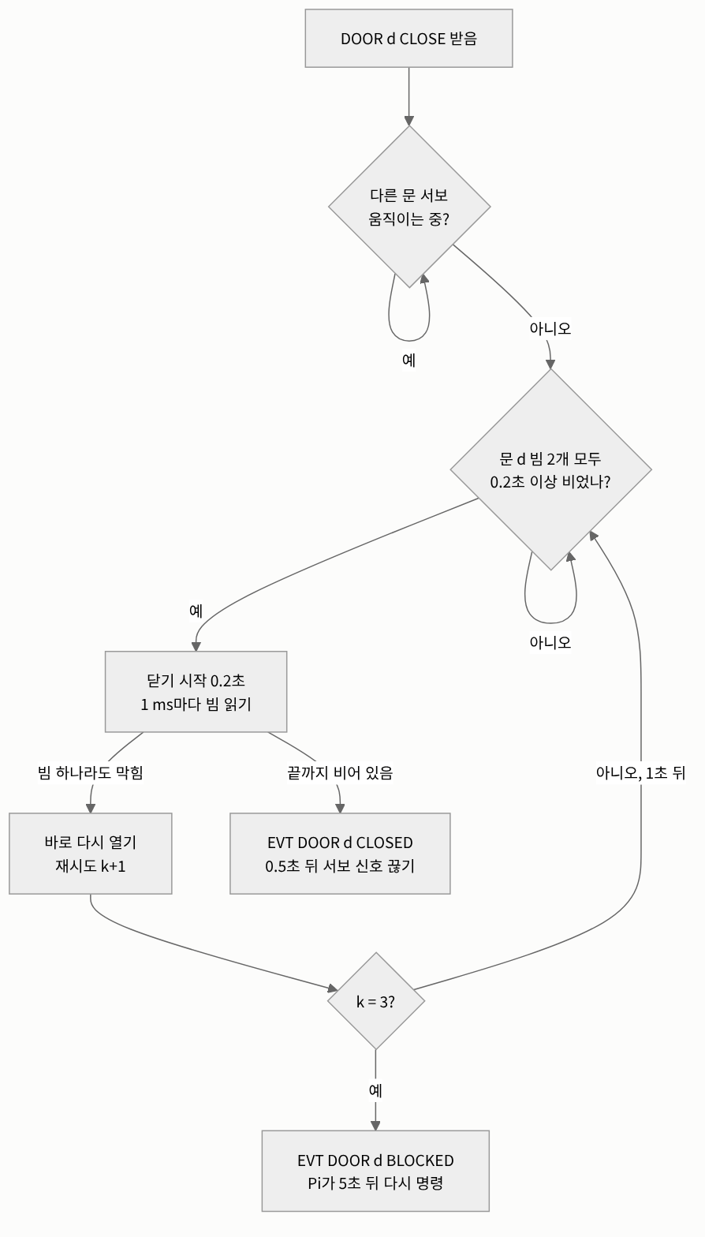
[picture p18: design/img/algo/algo_A2_문닫기.png]
문 닫기

```
on DOOR d CLOSE:
  wait until 다른 문 서보가 멈춤                # 서보 하나씩 (전류 1.9 A 안)
  repeat k = 1..3:
    wait until 빔 d_a, d_b 모두 0.2 s 이상 비어 있음
    닫기 시작 (0.2 s), 1 ms마다 빔 읽기
    if 빔 하나라도 막힘: 바로 다시 열기, "RETRY k", 1 s 쉬기, continue
    "CLOSED"; 0.5 s 뒤 서보 신호 끊기; return
  "BLOCKED"                                       # Pi가 5 s 뒤 다시 명령
```
근거: 빔 하나면 S8a·S8b 끼임, 빔 2개면 0 [확실 — 시뮬레이션]. MG90S 닫는 힘 22~44 N (S4 M7).

### A2. 빛 게이트 읽기 (UNO 2)
```
1 ms마다 9개 읽기; 같은 값 3번 연속이면 바뀐 것 → "EVT GATE n BLOCK|CLEAR ms"
SELFTEST: 송신 끔 → 9개 모두 LOW? → 송신 켬 → 모두 HIGH?  아니면 그 이름 보고
```
수신부가 죽으면 늘 '안 끊김'으로 읽혀 위험 → 켤 때 자가 시험으로 잡음 (S11b).

### A3. 장부 (Pi) — 누가 어디 있나
```
문마다 빔 2개: 처음 막힌 빔 = first, 마지막에 풀린 빔 = last
  first ≠ last → 지나감 (앞→뒤 = 정방향, 뒤→앞 = 역방향)
  first = last → 문틈에 들어왔다 되돌아감 (안 셈)
G1·G4·G6 하나짜리: 막힘→풀림 = 한 번 지나감
카메라 마릿수와 다르면 카메라를 믿고 장부를 고침, 기록
```
한계: 바짝 붙은 두 마리는 한 번으로 보일 수 있다 → 카메라가 최종 판단 (S3) [확실 — 시뮬레이션].

### A4. 누르기 + 찍기 (UNO 1 + Pi)
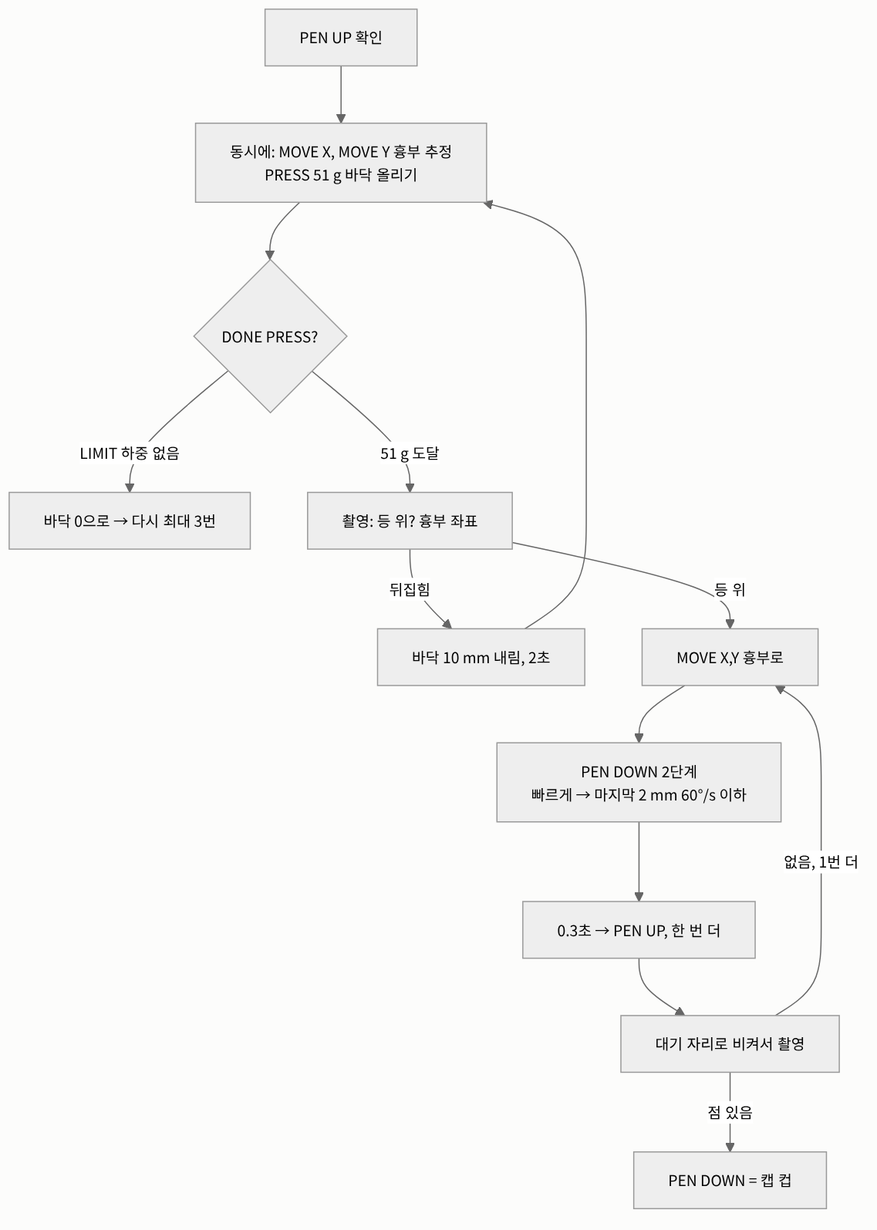
[picture p19: design/img/algo/algo_A3_누르기찍기.png]
누르기 찍기

```
PEN UP → (동시에) MOVE X tx, MOVE Y ty, PRESS 51 g
  DONE PRESS LIMIT → 바닥 0, 다시 (≤ 3번)
촬영 → 등 위 & 흉부 확률 ≥ 0.6 ?
  아니면 바닥 10 mm 내림, 2 s, 다시 누르기 (≤ 3번) → 실패면 표식 없이 급이
MOVE X/Y 흉부 → PEN DOWN 2단계(빠르게 → 마지막 2 mm 60 °/s 이하) → 0.3 s → PEN UP  ×2
대기 자리로 비켜서 촬영 → 점 있으면 PEN DOWN(캡 컵), 없으면 1번 더 → 그래도 없으면 기록
```
UNO 1 안전: 펜이 내려가 있으면 `MOVE X/Y` 거절 (`ERR PEN_DOWN`).

### A0. 낮·밤 (승준 결정 11/06 20:23, SJ-46 `control/pi/daynight.py`)
```
낮 = 해 뜸 + 30분 ~ 해 짐 − 30분 (날짜·위치로 계산, RTC)
밤: 처리 안 함 → 방생 문 닫음, 입구·격리 문 엶, 조명 끔 → 들어온 말벌은 상용 트랩처럼 포획통으로
아침: 격리 문 닫고 처리 시작
```

### A5. 내보내기 — 방생 / 격리 (Pi)
```
방생 (11/06 승준 SJ-44·45 방생부 = 짧은 목 + 위로 열린 굴뚝, 출구 조명 없음):
  (밤 규칙은 A0 — 처리 중 해가 졌으면 드물게 격리)
  위·아래(마킹실) 조명 끔 → 굴뚝 위 하늘빛 쪽으로 → 방생 문 열기
격리: 바닥 0, 조명 끔(포획통 쪽이 밝음), 격리 문 열기
기다림: 장부(문 빔 → 출구 빔 G6) 0 이고 카메라 0 → 문 닫기(A1)
  60 s: 기록  /  120 s: 알림  /  300 s(방생): 격리 문도 엶 (낮에만 일어남 — 밤에는 방생을 시작하지 않으므로)
```

### A6. 고장 (Pi + UNO)
```
Pi: 0.5 s마다 PING, 1.5 s 답 없으면 고장 → 문 그대로 → 그 장치 READY 기다림(120 s)
    → 돌아오면 다시 초기화(UNO 1이면 원점부터) → 마킹실 확인 후 이어서
    → 안 돌아오면 passthrough: 격리·입구 문 열고 멈춤 (상용 트랩처럼)
UNO 1: Pi 2 s 침묵 → 멈춤 → 펜 들기 → 바닥 10 mm 내림
UNO 2: Pi 2 s 침묵 → 닫던 문 다시 열기, 나머지 그대로
켤 때: 문 3개 먼저 닫기(원점 찾는 35 s 동안 못 들어오게) → 원점 → 마킹실 확인
```

### A7. 배터리 (Pi, 배터리 상자일 때)
```
0.5 s마다 INA226 → 남은 에너지 < 15 % 또는 부하 중 < 12.0 V → '부족'
처리 중이면 끝까지 → 조명 끔 → 격리 문 → 입구 문 열기 → Pi 끔 (UNO도 꺼짐)
```

## 3. 판단표 — 판별 결과 → 행동

| 카메라가 본 것 | 행동 | 근거 / 상태 |
|---|---|---|
| 마킹실 0마리 (10 s) | 입구 문 열어 둠, 장부 0 | 되돌아감·카메라 놓침 |
| 2마리 이상 | **둘 다 격리** | 한 번에 하나만 찍을 수 있음 |
| 등검은말벌 일벌, 표식 없음 | 누르기 → 찍기 → 급이 → 방생 | 기본 |
| 등검은말벌, 이미 표식 | 재방문 기록 → 급이 → 방생 | 다시 찍지 않음 |
| 등검은말벌 여왕벌 (중순판 폭 ≥ 4.4 mm, 못 재면 계절 규칙: 3~5·9~11월 여왕) | 격리 | 놓아주면 새 둥지 위험 [가능성 높음]. 기준은 4장 |
| 유럽말벌 | **격리** | 서현 결정 (11/06 17:05) |
| 2종 아님 또는 신뢰도 < 기준 | **격리** | 서현 결정 (11/06 17:05). 꿀벌이 들어오면 갇힘 → 입구 크기로 얼마나 걸러지는지 J6에서 기록 |
| 방제 모드 | 모두 격리 | 모드 스위치 |

## 4. 숫자 (판단 기준값)

| 값 | 지금 | 정한 근거 | 바꾸는 시험 |
|---|---|---|---|
| 종 신뢰도 기준 | 0.6 | [추측] | 우리 사진으로 다시 학습한 뒤 (승준) |
| 여왕벌 구분 | **중순판 폭(날개 뿌리 사이) ≥ 4.4 mm** | 논문 경계 4.5 mm, 불확실 띠 4.4~4.58 mm의 아래 끝 (Pérez-de-Heredia 외 2017) — (AI 판단, 서현 위임) CAP-AI-24 | 승준 표본 7마리 폭을 재서 맞는지 확인 |
| 흉부 확률 기준 | 0.6 | [추측] | J6 |
| 누르는 힘 | 51 g (0.5 N) | [확실 — D6] | 표본 |
| 자세 다시 시도 | 3번, 10 mm 내림, 2 s | [추측] | 행동 |
| 펜 닿는 시간 | 0.3 s ×2 | [추측] | 마킹 시험 |
| 급이·건조 | 60 s | [추측] | 샤피 건조 시험 |
| 문틈 빈 시간 | 0.2 s | [가능성 높음] | J6 |
| 문 재시도 | 3번, 1 s | [가능성 높음] | J6 |
| 나가기 기다림 | 60 / 120 / 300 s | [추측] | 행동 |
| 하트비트 | 0.5 s 보냄, 1.5 s 끊김 / UNO 감시 2 s | [가능성 높음] | J6 |
| 배터리 부족 | 15 % 또는 12.0 V | [가능성 높음] | 배터리 상자 |

## 5. 승준 AI와 나눈 것
- 서현 쪽(이 문서·회로 설계): `design/` 만 고침. 승준 쪽 제안: `control/` 펌웨어 UNO 1·2 나누기와 Pi 코드 (Issue #6). 인터페이스 정의서는 이번에 안 고침.

## 6. 검증
- 알고리즘은 `trap_sim.py`로 19개 시나리오 통과 + 빔 하나 비교 [확실 — 시뮬레이션]. 실물은 `미검증`.

## 7. 결정 (11/06 17:05, 서현 답 + 위임)
1. **유럽말벌 → 격리** (서현).
2. **다른 곤충 → 격리** (서현).
3. **여왕벌 기준 = 중순판 폭 ≥ 4.4 mm** (AI 판단, 서현 위임) — 8장.
4. **배터리 = 2일 → LiFePO4 12.8 V 20 Ah** (서현 '2일' + 용량은 AI 판단) — 9장.
5. **스프링 146 k = 0.1 N/mm (100 N/m)** (AI 판단, 서현 위임, 역학계산) — `design/2026-11-06_S4_스프링146_역학계산_서현.md`. 2차(교재 유제 5개)에서 사양을 d 0.229·D 2.63·Na 15·Ø2 핀(k 103.6)으로 바꿈 — `..._2차_서현.md`.

## 8. 여왕벌 기준 — 왜 중순판 폭 4.4 mm인가
- [확실 — 논문] 프랑스 둥지 10개의 암컷을 잰 연구는 **중순판 폭(mesoscutum width, 날개 뿌리 사이 거리)** 이 일벌과 신여왕(gyne)을 가장 잘 가른다고 했다. 경계 **4.5 mm**, 5 % 불확실 띠 **4.4~4.58 mm**. 무게(젖은 0.618 g, 마른 0.225 g)는 겹침이 더 컸다 (Pérez-de-Heredia 외, J. Hymenoptera Research 60:119–133, 2017).
- [확실 — 논문] 크기만으로 완벽하지 않다: 한 둥지에서 작은 암컷 3마리가 화학 성분(CHC)으로는 신여왕 쪽이었다.
- 받은 두 논문(Lioy 2021 하모닉 레이더, Rojas-Nossa 2022 둥지 찾기)에는 여왕/일벌 크기 기준이 없다 [확실 — 본문 검색].
- **4.4 mm(띠 아래 끝)로 정한 이유** [가능성 높음]: 틀리는 두 방향의 손해가 다르다. 일벌을 여왕으로 잘못 보면 → 한 마리 덜 찍음. 여왕을 일벌로 잘못 보면 → 새 둥지. 그래서 애매하면 여왕 쪽으로.
- **재는 방법은 `design/2026-11-06_여왕벌_크기측정_방법_서현.md`** (CAP-AI-25: YOLO는 찾기만, PRESS 때 격자 눈금으로 배율, 견판 키포인트 2점). 아래는 처음 적은 요약.
- **카메라로 잴 수 있나** [가능성 높음]: 격자 위 200 mm, 4056×3040에서 약 15.6 화소/mm (D5 4차) → 4.5 mm ≈ 70 화소, 띠 폭 0.18 mm ≈ 3 화소. 눌러서 등이 위일 때(POSE에서 dorsal) 날개 뿌리(견판) 두 점 사이를 **전체 해상도 사진**에서 잰다. AI 모델 입력(작게 줄인 사진)으로 재면 안 됨. 렌즈 왜곡·높이 차 보정은 J6에서 자로 확인 → `미검증`.
- 계절: 신여왕은 늦가을에 나오고 봄에는 창업 여왕이 혼자 다닌다 → 봄·가을 현장 시험에서 격리 수를 따로 센다.
- 시뮬레이션: `PRM gyne_mw_mm = 4.4`, 시나리오 S4b (4.45 mm → 격리, 4.35 mm → 찍고 방생) PASS [확실 — 시뮬레이션].

## 9. 배터리 2일
| 용량 | 보통 (카메라 늘 켬) | 절약 | 판단 |
|---|---|---|---|
| 12 Ah | 1.70일 | 2.29일 | 보통에서 2일 안 됨 |
| 15 Ah | 2.13일 | 2.87일 | 여유 6 % — 추위(10 °C 아래에서 LiFePO4 용량 줄어듦)·노화면 2일 못 감 [가능성 높음] |
| **20 Ah** | **2.84일** | 3.82일 | **선택** — 여유 42 % |

하루 필요 81 Wh (보통, 20마리) — `elec_budget.py battery_days` [확실 — 계산, 부하 값은 사양 기반]. 20 Ah ≈ 256 Wh, 무게 약 2.5 kg [추측 — 제품마다 다름]. 구매는 현장 시험 날짜가 정해지면 (승준 구매장부).

## 10. 11/06 저녁 바뀜 (CAP-AI-30, 제어·회로 위임)
승준 Issue #7 (SJ-43·44·45) 질문 4개에 대한 답:

| 질문 | 결정 | 이유 |
|---|---|---|
| 단자대 → 와고 221 + 줄 퓨즈 | **채택** (+5 V 와고 221-415 ×2 = 8구, GND ×3 = 11구) | 기성품, 받침 출력 필요 없음, 현장에서 빼고 꽂기 쉬움. 단 와고는 가는 26·28 AWG를 물기 어렵고 풀업 9개가 필요 → **서보 허브·게이트 허브 만능기판 2장은 남김**, 허브까지는 20~22 AWG |
| 방생: 출구 조명 빼기 | **채택** — 방생 때 마킹실 위·아래 조명만 끄고 방생 문 엶. 60 s 깜빡은 기록으로 바꿈 | 굴뚝 위가 하늘이라 낮엔 밝음 |
| 조명 MOSFET 하나 줄이기 | **채택** — 조명 2 + 송신 1 = 3개, UNO 2 D6 예비 (D6·D13 두 개 남음) | 출구 조명이 D6·Q3였음 |
| 밤에 들어온 말벌 | ~~NIGHT_HOLD~~ → **승준 결정(20:23, SJ-46)으로 바꿈: 밤에는 처리하지 않고 전부 포획통으로** (입구·격리 문 엶, 방생 문 닫음). 처리 중 해가 지면 격리 | 처리는 해 짐 30분 전까지만 시작하고 한 번에 약 3분이라, 마킹한 말벌이 밤에 걸리는 일은 거의 없음 [가능성 높음] → 두 안의 차이가 작아 승준 안을 따름 (Pi 코드도 승준 쪽) |

시뮬레이션: S15_night (20:00 도착 → 포획통), S16_before_dusk (16:50 도착 → 찍고 방생) 포함 **24/24 PASS**. 회로 검사: 넷 58, UNO 1 18/18, UNO 2 16/16 (D6·D13 예비) 통과.
