britams/-capstone-project-repo/design/2026-11-06_급이장치_원리_방생부_설명_승준.md

# 설탕물 급이 장치 — 원리·구조·계산 + 방생부 위치와 문제 (승준, 2026-11-06 밤, CAP-AI-SJ-41)

CAD: `cad/D5g_feeder_uln.py` (`FD` 값, `water_check()`), 전체는 `cad/D5g_frame_detail.py`의 `make()`

## 1. 한 줄 요약
**뒤집은 병(대기압으로 물이 매달림) + 솜 심지(모세관 현상)** 두 가지 물리 현상만 써서, 펌프·밸브·전기 없이 마킹실 벽에 늘 젖은 솜 끝을 내놓는다. **언제 먹게 할지는 바닥 높이(이미 있는 바닥 모터)로 정한다.**

## 2. 원리 ① — 뒤집은 병이 물 높이를 스스로 지킴 (병아리 물그릇, 마리오트 원리)
1. 팰컨 튜브(50 mL)에 설탕물을 가득 넣고 거꾸로 뒤집어 그릇에 꽂는다. 튜브 입구는 받침 리브 3개 위에 얹혀 **z 369**에 있다.
2. 튜브 안 물을 누르는 것: 위쪽 남은 공기의 압력 + 물기둥 무게. 튜브 밖 그릇 물 표면을 누르는 것: 대기압(약 101,300 Pa).
3. 물기둥 높이 최대 98.6 mm, 설탕물(1:1) 밀도 약 1,230 kg/m³ → 물기둥 압력 ρgh ≈ **1,190 Pa = 대기압의 1.2 %**. 대기압이 훨씬 크므로 튜브 안 공기는 대기압보다 1,190 Pa 낮은 상태로 물을 매달고 있다(물이 쏟아지지 않음) [확실 — 계산].
4. 말벌이 먹거나 마르면 그릇 물이 줄어 **물 표면이 튜브 입구(369) 아래로 내려감** → 입구로 공기 방울이 '꼴깍' 들어감 → 그만큼 물이 내려와 다시 입구를 막음. 그래서 **물 높이가 늘 튜브 입구 높이(±1 mm, 표면장력)** 로 지켜진다.
5. 손으로 할 일은 튜브를 채워 꽂는 것뿐. 물 높이는 리브 높이로 정해져 사람이 맞출 필요가 없다.

## 3. 원리 ② — 솜 심지(코튼롤)가 물을 벽 구멍까지 끌어올림 (모세관 현상)
- 치과용 코튼롤 2호(Ø10 × 38)를 **바깥으로 10.4° 내려 기울여** 놓는다: 마킹실 안 끝(z 379, 벽 구멍으로 2 mm 나옴) → 물길 안 바깥 끝(z 372, 아래 면 367).
- 바깥 끝 아래 **2 mm가 물에 잠김** (물 369 − 롤 아래 367). 솜 섬유 사이 좁은 틈이 물을 빨아올려 안 끝까지 젖는다. 올라가야 하는 높이는 최대 약 15 mm (367 → 384)로, 솜의 모세관 상승(수 cm)보다 작다 [가능성 높음 — 일반적인 면 심지 성질, 설탕물 점도로 느려짐 → 시험].
- **마킹실 안에는 고인 물이 없다** → 말벌이 빠지거나, 격자·바닥이 설탕물로 끈적해지지 않음. 말벌은 젖은 솜 끝을 입으로 빤다.

## 4. 왜 새지 않나 — 이번에 고친 결함과 계산
- **전(19:20 그림)**: 물 높이 374 > 벽 구멍 아래 끝 372.7 → 롤과 구멍 사이 틈(0.3 mm)으로 **설탕물이 마킹실로 흘러 들어갔을 것** [확실 — 치수 비교]. 고침.
- **지금**: 벽 구멍 Ø11.2, 아래 끝 **372.6**, 물 높이 **369** → **여유 3.6 mm** (`water_check()`).
- **낮에 데워지면?** 튜브 위 공기가 부풀어 물을 밀어냄(가장 위험한 경우). 그릇 + 물길 물 면적 1,616 mm²:

| 튜브 안 공기 | +25 °C일 때 부피 증가 | 물 높이 상승 |
|---|---|---|
| 5 mL (갓 채움) | 0.42 mL | 0.26 mm |
| 25 mL (절반) | 2.1 mL | 1.3 mm |
| 50 mL (거의 빔) | 4.2 mL | **2.6 mm** |

→ 최악 2.6 mm < 여유 3.6 mm → 넘치지 않음 [확실 — 이상기체 V ∝ T 계산]. 물길 벽 위(388)까지는 19 mm 여유.

## 5. 구조와 부품
| 번호 | 부품 | 구매/설계 | 치수 | 역할 |
|---|---|---|---|---|
| 144n | 팰컨 50 mL 원뿔 튜브 (코닝 352070 또는 같은 규격) | 구매 | Ø29.72 × 114.55 (제조사 도면) | 설탕물 통, 거꾸로 |
| 142n | 치과용 코튼롤 2호 | 구매 | Ø10 × 38 | 심지 (2일마다 갈기) |
| 143 | 급이 물길·그릇·기둥 한 덩어리 | 3D 프린트 PETG | 물길 안 폭 12, 바닥 윗면 364, 그릇 안 Ø35, 리브 3개(입구 369), 기둥 12 × 12, 발 36 × 20 × 3 | 물 받기, 튜브 세우기, 데크 고정 |
| 120 | 마킹실 벽 (+y) | 설계 변경 | Ø11.2 구멍, 중심 z 378.2 | 심지 끝이 나오는 곳 |
| — | M5 × 12 + T너트 × 2 | 구매 | | 발 → 데크 → 2020 가로대(y +80) |
- 튜브를 **y 95**에 세운 이유: 마커 X 빔(212)이 y −74~66에서 x 방향으로 지나감 → 그 밖이라 튜브가 위로 길어도(꼭대기 z 484) 안 부딪침. 물길 72 mm로 벽까지 이음.
- PETG: 설탕물·세척에 PLA보다 강함 [가능성 높음]. 물길은 위가 열린 U자 → 지지대 없이 출력, 솔로 닦을 수 있음.

## 6. 동작 순서 (서현 판단표 A4~A5와 같음)
| 단계 | 바닥 높이 | 말벌 | 급이 장치 |
|---|---|---|---|
| 대기·판별 | 341 (아래) | 바닥 위 | 솜 끝은 머리보다 약 30 mm 위 |
| 누르기·찍기 | 위로 (격자에 붙임) | 격자 아래 고정 | — |
| **급이 60 s** (= 잉크 마르는 시간) | **약 370** (말벌 입이 솜 끝 높이) [가능성 높음 — 말벌 머리 높이 4~6 mm로 잡음, 표본으로 확인] | 벽에서 나온 솜 끝을 빪 | 자동으로 물 공급 |
| 방생 | 341로 내림 | 방생 문으로 나감 | — |
- 급이에 새 모터·센서가 없다: 바닥 승강(이미 있는 28BYJ-48 F)이 높이만 바꿈. 펌웨어는 `MOVE F 급이높이` 한 줄.

## 7. 사람이 할 일 · 시험할 것
- 채우기: 튜브를 빼서 설탕물(시판 설탕 1 : 물 1, 또는 시판 양봉 사양액) 채우고 뚜껑 닫아 뒤집어 그릇에 꽂은 뒤 뚜껑을 아래에서 뺌 → 그냥 꽂아도 됨(입구가 아래라 공기만 안 들어가면 쏟아지지 않음)
- 2일마다: 코튼롤 갈기(설탕 굳음·곰팡이), 그릇 헹구기
- 시험(물·표본으로 가능): ① 물 높이가 369 ± 1에서 유지되는지 ② 솜 끝이 2일 젖어 있는지 ③ 해 아래 데웠을 때 안 넘치는지 ④ 개미가 기둥으로 오르는지(오르면 기둥에 바셀린 띠)
- 시험(현장): 말벌이 솜 끝을 찾아 먹는지, 60 s 안에 먹는지

## 8. 방생부 — 어디 있나, 어떻게 나가나, 문제
**위치**: 마킹실 **+x 쪽 벽(x 78)** 위쪽 통로 높이 z 377.
- 176 방생 문: 문 하우징(x 78~90) + MG90S 서보가 판(flap)을 돌려 엶
- 174 방생 통로: 안지름 12, 길이 50 (x 90~140)
- 175 출구 원뿔 (x 140~155) → x 155에서 프레임 밖(이 높이엔 2020 레일 없음)으로
- 빛 게이트: 문판 앞뒤 G5·G5b(빔 2개), 통로 끝 G6 (199c 받침에 고정)

**나가는 순서 (서현 A5)**: 위·아래 조명 끔, 출구 조명 켬(말벌은 밝은 쪽으로 감) → 방생 문 엶 → G5 → G6 통과를 셈 → 0이면 문 닫음. 60 s 출구 조명 깜빡, 120 s 알림, 300 s면 격리 문도 엶.

**[확실] 문제 — 출구가 막혀 있음**: 175 원뿔 끝 안 구멍이 **Ø3 mm**(안 반지름 6 → 1.5). 등검은말벌 일벌의 머리·가슴 폭은 약 5 mm라 **나갈 수 없음**. (D5e부터 있던 모양, 한쪽 문 의도로 보임)
- 바깥 말벌이 거꾸로 들어오는 것은 **방생 문(176)이 평소 닫혀 있어서** 이미 막힘 → 출구를 좁힐 이유가 없음.
- 고칠 안 (승준 결정 필요):
  - **안 1 (추천)**: 175를 곧은 관 Ø12 + 위 비 가림 갓(3D 프린트)으로. 가장 단순, 말벌이 그대로 날아 나감.
  - 안 2: 바깥으로 좁아지는 원뿔이되 끝 안지름 10 (몸이 지나가고, 바깥에서 찾기 어려움).
