britams/-capstone-project-repo/design/2026-11-06_급이방_개념설계_ULN보드_승준.md

# 설탕물 급이 방 개념설계 + 떠 있던 보드 고침 (승준, 2026-11-06 저녁, CAP-AI-SJ-40)

스크립트: `cad/D5g_feeder_uln.py` (← `cad/D5g_frame_detail.py`의 `make()`가 부름)
FreeCAD: `import D5g_frame_detail as G, D5g_feeder_uln as FU; doc = G.make(); print(G.check(doc), FU.floating(doc))`

## 1. 왜 다시 했나 (승준 지적 3가지)
1. **위쪽 가두는 통(상용 트랩 포획통)** — 화면에서 숨겨서 보여 줬음 → 다시 보이게 함. 스크립트는 통을 지우지 않음 (`REF_trap_container`, `REF_trap_cap` 그대로).
2. **보라 사각형이 공중에 떠 있음** — D5f의 `195_uln2003_X·Y`(모터 드라이버 보드 자리 상자). "x 160~180 기둥 바깥면"에 붙인다고 했지만 그 y 위치(−46~32)에는 기둥이 없었음 → 판매품 모양으로 바꾸고 2020 레일 위 받침에 볼트로 고정.
3. **급이부가 상자(144 먹이통 + 142 심지)뿐** — 설탕물 주고 방생하는 방을 개념설계.

## 2. 설탕물 급이 방 — 어떻게 먹이나 (초등생 설명)
병아리 물그릇처럼 **물병을 거꾸로 세우면, 병 입구 높이까지만 물이 차고 더 넘치지 않아요.** 물이 줄면 병에서 공기 방울이 들어가고 물이 조금 내려와 다시 채워요. 펌프도 전기도 필요 없어요.

```
   [팰컨 50 mL 튜브, 거꾸로]   ← 설탕물 50 mL
            ‖ 입구 (z 374) = 물 높이
   ┌────────╨────────┐
   │ 그릇  ~~~~~~~~ 물길 ~~~~~~~~ 코튼롤 ─┼─▶ (마킹실 벽 구멍으로 2 mm 나옴) ◀ 말벌이 빨아 먹음
   └─────┬───────────────────────────────┘
         기둥 → 데크 → 2020 가로대 (M5 × 12 + T너트)
```

순서 (서현 판단표와 같음): 진입 → 판별 → 누르기 → 찍기 → **바닥을 급이 높이로 내림 → 말벌이 벽에서 나온 코튼롤 끝을 빨아 먹음(60 s, 잉크 마르는 시간 겸함)** → 방생 문 열림 → 나감.

| 부품 | 무엇 | 치수 | 근거 |
|---|---|---|---|
| 144n 팰컨 50 mL 원뿔 튜브 (구매) | 설탕물 통, 거꾸로 꽂음 | 바깥 Ø29.72, 길이 114.55, 원뿔 16, 벽 0.97 | 코닝 352070 도면 [확실] |
| 142n 치과용 코튼롤 2호 (구매) | 심지 — 물길에서 빨아 올려 벽 구멍 끝까지 적심 | Ø10 × 38 | 판매처 여러 곳 같은 값 [가능성 높음] |
| 143 급이 물길·그릇·기둥 (설계, 3D 프린트 PETG) | 물길 안 폭 12, 바닥 z 366~369, 벽 위 388 / 그릇 안 Ø35, 받침 리브 3개로 튜브 입구를 z 374에 / 기둥 12 × 12, 발 30 × 20 × 3 + M5 구멍 2 | 이번 설계 |
| 120 마킹실 벽 (설계 변경) | +y 벽에 Ø10.6 구멍 (x 55, z 378) — 코튼롤이 2 mm 안으로 나옴 | | |
| 101 데크 (설계 변경) | 기둥 발 M5 구멍 2, F 보드 M2.5 구멍 4 | | |
| 볼트·T너트 (구매) | M5 × 12 × 2 + 2020 T너트 2 (기둥 발), M5 × 8 × 4 + T너트 4 (보드 받침) | | 볼트 길이: 발 3 + 데크 5 + 너트 4 |

**왜 이 자리(튜브를 y 95에)?** 마커를 움직이는 X 빔(212)이 y −74 ~ 66 안에서 x로 지나가요. 튜브를 그 안에 세우면 빔과 부딪쳐요. 그래서 빔이 안 지나가는 y 95에 세우고, 물길로 벽까지 이었어요.

**PETG를 쓰는 이유**: 설탕물에 젖고 자주 씻어야 해서 PLA보다 PETG가 물·세척에 강해요 [가능성 높음 — 일반적인 재료 성질]. 물길 안쪽은 지지대 없이 나오게 위가 열린 U자예요.

**시험으로 정할 것 (숫자를 지금 정하지 않음)**: 설탕물 농도(시판 설탕 1 : 물 1부터), 이틀 동안 코튼롤에서 마르는 양, 말벌이 롤 끝을 찾는지, 튜브 입구 높이(리브 높이)로 물 높이 ±1 mm 맞추기. 먹이는 시판 제품만 쓰는 규칙에 따라 시판 설탕 또는 시판 양봉 사양액을 쓴다.

## 3. ULN2003 모터 드라이버 보드 — 판매품 모양으로, 떠 있지 않게

| 부품 | 치수 | 근거 |
|---|---|---|
| 195p ULN2003 보드 × 3 (구매, 28BYJ-48 세트에 들어 있음) | 35 × 31.9 × 11, M2.5 구멍 간격 30 × 26.5, DIP16·XH 5핀·핀 헤더 6·LED 4 | 판매처 2곳 같은 값 [가능성 높음] |
| 198 M2.5 × 5 기둥 × 12 (구매) | 보드 1장에 4개 | |
| 197 보드 받침 × 2 (설계, 3D 프린트) | 38 × 52 × 3, 홈 키, M5 구멍 2 (y ±22) | 이번 설계 |

- **X·Y 보드**: 갠트리 둘레 레일(x 160~180, z 452~472) 윗면, y −30 / +22. 받침을 M5 × 8 + T너트로 레일에 고정하고, 보드는 기둥 위에. 모터 선 24 cm 안에 들어옴 (X 약 7 cm, Y 약 16 cm).
- **F 보드**: 데크 위 같은 자리(x 55, y −50), 데크에 M2.5 구멍 4 + 기둥.

## 3-1. 떠 있던 부품 전체 검사 (FU.floating) — 남은 것 0
| 부품 | 전 | 고친 것 |
|---|---|---|
| 190 Pi 5 + AI HAT+ | 위판 아래 공중 (가장 가까운 것 5 mm) | 판매품 외곽 85 × 56, 구멍 58 × 49 (B 폼팩터 [확실]) → **199a 선반**(3D 프린트)에 얹고, 선반 벽을 위 가로대(y +80) 안쪽 면에 M5 × 8 2개 |
| 196 G4 송수신기 | 격리 덕트 172에서 2 mm 떠 있음 | **199b 받침**(덕트에 끼움) |
| 196 G6 송수신기 | 방생 덕트 174에서 4 mm 떠 있음 | **199c 받침** |
| 195 ULN2003 X·Y | 기둥 없는 곳에 떠 있음 | 3장대로 197 받침 + 레일 |
- 검사: 위 부품과 새 부품 모두 **겹침 0건**, 모두 받침에 닿음. 빛 빔(`_beam`)은 빛줄기 표시라서 제외.
- 분류 개수(11/06 저녁): **A 구매품 83 / B 설계품 46 / C 참고 10 / D 전기 자리 18**

## 3-2. 급이 '방'을 따로 두지 않은 이유
말벌을 마킹실에서 다른 방으로 옮기려면 문·통로가 하나 더 필요하고, 말벌이 옮겨 가는 동안 덜 마른 잉크가 문질러질 수 있어요. 그래서 **마킹실이 그대로 급이 방이 되게** 했어요: 찍은 뒤 바닥만 내려 말벌 입이 코튼롤 끝 높이에 오게 하고, 다 먹으면 바로 옆 방생 문(176)이 열려요. (서현 판단표 순서 '찍기 → 급이 → 방생'과 같음.) 따로 방이 필요하다고 정하면 방생 통로(174) 앞에 급이 칸을 넣는 안을 다음에 그릴게요.

## 4. 이번에 바꾼 확신 정도
| 값 | 전 | 지금 | 근거 |
|---|---|---|---|
| 2020 T너트 | [추측] 목 5.8 · 날개 10.4 × 2.0 | **[가능성 높음] 10 × 9.5 × 4.5** (아래 경사로 언더컷에 맞춤) | 판매처 표기 (vxb M5 sliding T-nut 2020) |
| 브래킷 홈 키 | 1.0 | 0.5 (T너트 목과 안 겹치게) | 모델 검사 |
| 28BYJ-48 고정 나사 | [추측] M4 | **[확실] M4 × 2** | 서현 결정 (Issue #7) |
| ULN2003 보드 | 자리 상자 6 × 32 × 35 | **[가능성 높음] 35 × 31.9 × 11** | 판매처 2곳 |

## 5. 승준이 확인할 것 (나중에)
1. ULN2003 보드·T너트 실물을 캘리퍼로 재기 — 다르면 `ULN`·`TNUT` 값만 바꿈
2. 3D 프린터 출력 크기 — 143 기둥까지 높이 약 195 mm (발 → 그릇 위)
3. 설탕물 시험 — 코튼롤이 이틀 젖어 있는지, 말벌이 롤 끝에서 먹는지 (표본으로는 못 함 → 현장 시험)
