britams/-capstone-project-repo/design/2026-10-28_D6_설계변수표.md

# D6 설계 변수표 (1차)

정리일: 2026-10-28 · 작성: 이서현 (Claude와 정리, CAP-AI-18)
기준: D5 4차 모델 + 보완(`cad/D5d_module_an1_B.py`, D5 문서 10·11장), S4 역학계산 1차(`design/2026-10-28_S4_역학계산_1차.md`, 계산 `design/calc/s4_calc.py`)
상태 표기: **확정**(팀 결정·사양) / **잠정**(계산·추정, 시험으로 바뀔 수 있음) / **미정**(시험해야 정해짐)

---

## 0. 한 줄 요약
- [확실] **토크는 문제가 아니다.** 28BYJ-48 + T8(리드 8)로 바닥 승강의 토크 안전율 19.6, X·Y는 560 이상(볼 부싱). 모터는 바꾸지 않는다. 단 사양서 토크(34.3 mN·m)는 약 1.8 rpm 값이라 10~15 rpm에서의 토크는 J6에서 부하를 걸고 확인 (S4 r2).
- [가능성 높음] **시간(R6 3분)은 '급이 = 잉크 건조' 시간이 정한다.** 기구 동작은 약 64 s(15 rpm 기준). 그래서 급이 시간이 **약 105~116 s 이하**여야 3분 안에 든다 → 샤피 노랑이 말벌 몸에서 마르는 시간을 재는 게 다음 시험 1순위.
- [가능성 높음] **X 빔을 한쪽 나사로 밀면 3D 프린트 부싱도, 소결 청동 부싱도 끼인다**(S4 M5 r2: 요 + 피치 합침, 한계 μ_c = 0.068~0.103). → **직선 볼 부싱 LM8UU(X)·LM6UU(Y)로 바꿈** (모델 반영, 검사 통과, μ 여유 13.6배 이상).
- [가능성 높음] **바닥 하중 센서로는 찍는 힘을 못 잰다**(S4 M3). 찍는 힘은 홀더·마커 자중(0.32 N) + 스프링으로 정해지는 수동값. D5 9-3·10장의 "하중 센서로 찍는 힘도 잼"은 정정.

## 1. 말벌·마커
| 기호 | 변수 | 값 | 단위 | 근거 | 상태 |
|---|---|---|---|---|---|
| h_H | 말벌 몸 높이 (등–배) | 7.5 | mm | D5 모델 가정 | 잠정 (표본) |
| w_T | 흉부 폭 (일벌 / 신여왕벌) | 3.79–4.49 / 4.61–4.87 | mm | Pérez-de-Heredia 2017 | 확정 (문헌) |
| — | 마커 | **샤피 크리에이티브 수성 아크릴 불렛, 노랑** (5색 세트) | — | 서현 결정 10/28 (Issue #3), 쿠팡 국내 | 확정 |
| d_g / d_max | 마커 그립 지름 / 최대 지름 | 14.7 / 18.9 | mm | JetPens 사양 (굵은 부분 위치는 실측 전) | 잠정 (캘리퍼스) |
| L_m / m_m | 마커 길이(캡 뺌) / 질량 | 134 / 13 | mm / g | JetPens 사양 | 확정 |
| d_tip | 팁 굵기 | — | mm | 공개 자료 없음 | 미정 (실측) |
| t_dry | 점이 말벌 몸에서 마르는 시간 (= 급이 시간 하한) | 제조사 "종이 위 1~3분" | s | Sharpie | **미정 (시험 1순위)** |
| F_ink | 잉크가 묻는 최소 찍는 힘 | — | N | | 미정 (시험) |

## 2. 마킹실·격자·승강
| 기호 | 변수 | 값 | 단위 | 근거 | 상태 |
|---|---|---|---|---|---|
| a | 마킹실 안쪽 | 40 × 40 × 50 | mm | D5 | 잠정 |
| g_h / g_p / g_t | 격자 눈 / 피치 / 두께 | 3.0 / 4.4 / 1.5 | mm | D5 | 잠정 |
| s_f | 바닥 행정 | 36.5 | mm | D5 (마킹실 높이 − 말벌 높이) | 잠정 |
| s_r | 재시도 때 바닥 내림 | **10** | mm | S4 시간 계산 (전 행정보다 빠름) | 잠정 |
| — | 승강 구동 | 28BYJ-48 + T8 (Tr8×8, 4줄, 리드 8, d_m 7) | — | D5, S4 M1 | **확정** |
| T_req | 승강 필요 토크 | 1.75 | N·mm | S4 M1 | 잠정 (안전율 19.6 — 1.8 rpm 토크 기준, 속도별은 J6) |
| — | 승강 나사 자립 | 안 함 (내림 토크 −0.63 N·mm) → 모터 기어(1/64)가 잡음 | — | S4 M1 | 잠정 |
| F_p | 바닥이 말벌을 격자에 붙이는 힘 상한 (하중 센서 정지값) | **0.5** | N | 가정 — 말벌 손상 힘 F_harm 모름 | **미정 (표본 압축 시험, R7)** |
| — | 하중 센서 | 버튼형 로드셀 + HX711, 용량 1 kg 이하 권장 | — | F_p 0.5 N + 바닥 자중 0.41 N | 잠정 |

## 3. 마커 XYZ
| 기호 | 변수 | 값 | 단위 | 근거 | 상태 |
|---|---|---|---|---|---|
| — | 좌표계 | 원점 격자 가운데, +x 방생 문 쪽, +y 먹이통 쪽 | — | 인터페이스 정의서 | 확정 |
| (x_p, y_p) | 대기 자리 (캡 컵) | (+10, −40) — 모델 좌표 (65, −40) | mm | 시야 가림 검사 | 확정 |
| s_x / s_y | 흉부 영역 | ±18 / ±18 | mm | 마킹실 40 − 여유 | 잠정 |
| Δx_max / Δy_max | 대기 → 흉부 최대 이동 | 28 / 58 | mm | S4 M2 | 계산 |
| — | X·Y 구동 | 28BYJ-48 + T8 (리드 8) 각 1 | — | S4 M2 (토크 안전율 ≥ 560) | **확정** |
| — | X·Y 안내 | **LM8UU ×2 (X), LM6UU ×2 (Y)**, Ø8·Ø6 연마봉 | — | S4 M5 끼임 검사 | **확정 (D6 변경)** |
| v_xy | 이송 속도 | 1.3 (10 rpm) ~ 2.0 (15 rpm) | mm/s | 28BYJ-48 풀아웃 주파수 → 승준 J6 실측 | 잠정 |
| e_xy | 흉부 좌표 정확도 (비전 + 기구) | ±1 | mm | 흉부 폭 약 4, 점 약 2 | 잠정 |
| δ_rod | 봉 처짐 (X Ø8 봉 A / 최악 / Y Ø6 최악) | 0.0050 / 0.0070 / 0.0022 | mm | S4 M6 r2 (봉 A가 빔 무게의 61~71 %) | 계산 — e_xy에 영향 없음 |
| — | Z (펜 들기) | SG90, 혼 11.9 mm, 필요 토크 4.9 N·mm (안전율 36) | — | S4 M4 r2 (레일 마찰 계산값) | 확정 |
| W_h | 홀더 + 조임 띠 + 마커 자중 | 0.32 | N | 모델 부피 × 밀도 + 마커 13 g | 계산 |
| F_tip | 찍는 힘 = W_h + F_s − 레일 마찰 | 0.32 (+ 스프링) | N | S4 M3 | 잠정 |
| F_s | 홀더 스프링 힘 (204) | **0 ~ 0.18** (F_tip < F_p 조건) | N | S4 M3 | 미정 — F_ink 시험 후. 자중만으로 부족할 때만 약한 스프링 |
| n_dab | 같은 자리 찍기 횟수 | 1~3 | 회 | 비펌핑 마커는 한 번 양이 적을 수 있음 | 미정 |

## 4. 카메라
| 기호 | 변수 | 값 | 단위 | 근거 | 상태 |
|---|---|---|---|---|---|
| D_cam | 카메라–격자 | 200 | mm | AI 카메라 초점 20 cm~ | 확정 (J3로 확인) |
| — | 해상도 | 약 15.6 화소/mm (최대 해상도) | — | 사양 계산 | 잠정 (J3) |

## 5. 시간 예산 (R6 ≤ 180 s) — S4 M2
| 단계 | 15 rpm (2 mm/s) | 10 rpm (1.33 mm/s) |
|---|---|---|
| 진입 감지·입구 문 | 1.0 | 1.0 |
| 판별 | 2.0 | 2.0 |
| 바닥 상승 36.5 mm | 18.3 | 27.4 |
| 자세·흉부 좌표 | 1.0 | 1.0 |
| 마커 이동 (최악 58 mm) | 29.0 | 43.5 |
| 찍기 2회 + 펜 들기·놓기 | 1.6 | 1.6 |
| 점 확인 | 1.0 | 1.0 |
| 방생 (가정) | 10.0 | 10.0 |
| **기구·판별 합** | **63.9** | **87.5** |
| 재시도 1회 (10 mm 내렸다 올림 + 확인) | +11.0 | +16.0 |
| **급이 시간 상한** (재시도 0 / 1) | **116 / 105 s** | **92 / 77 s** |

- 마커가 대기 자리로 돌아가는 것과 바닥을 급이 높이로 내리는 것은 급이와 동시에 하므로 시간에 안 들어간다.
- XY를 벨트(GT2 20T)로 바꾸면 급이 상한이 139 / 128 s로 늘지만 모터는 그대로 — **건조 시간이 115 s 안팎이면 그때 검토**.
- 건조가 2~3분이면 기구로는 못 맞춘다 → R6를 4~5분으로 고치거나, 건조를 기다리는 방식(빠른 건조 마커·약한 바람)을 다시 정해야 함 [가능성 높음].

## 6. 예산·제작 (승준 정리 반영)
| 항목 | 값 | 근거 |
|---|---|---|
| 재료비 지원 | **50만 원**, 해외구매·중고 불가, 공구 불인정 | 승준 `purchase/2026-10-28_재료비_정산규칙.md` |
| 집행 | 86,240원 (트랩, 전원 어댑터, 쿨러) | 승준 SJ-18 |
| 제작 대수 | 1대 + 예비 부품 (권고) | **서현 결정 대기** |

## 7. D6에서 바뀐 것 (D5 4차 → 4차 보완, 모델 반영 완료)
| 항목 | 4차 | 보완 | 이유 |
|---|---|---|---|
| X·Y 안내 | 프린트 블록 구멍 (부싱) | LM8UU·LM6UU 직선 볼 부싱 | S4 M5 끼임 (r2, 요 + 피치): 2μ(kd + h)/L = 2.9~4.4 (PLA), 1.45~2.2 (청동) ≥ 1 |
| 빔 끝 블록 | 두께 12, x 20 | 두께 18, x 24 (LM8UU Ø15×24 들어감) | 베어링이 블록 면을 뚫지 않게 (검사로 찾음) |
| X 봉 위치 y | −64 / +54 | −65 / +57 | 블록 두께 |
| 마커 | Ø15 원통 가정 | 샤피 크리에이티브: 그립 Ø14.7 + 굵은 부분 Ø18.9 | 서현 결정 |
| 스프링 멈춤 탭·스프링 위치 | 마커 축에서 9·12.8 mm | 10.05·13.25 mm | 굵은 부분 Ø18.9와 0.6 mm 띄움 |
| 찍는 힘 측정 | "하중 센서로 잼" | 못 잼 (수동값) | S4 M3 자유물체도 |
| 재시도 | 바닥 전 행정 | 10 mm만 내림 | 시간 |

## 8. 다음 시험 (순서)
1. **샤피 노랑 점 시험** (서현·승준, 표본 또는 비슷한 더미): 건조 시간 t_dry, 최소 힘 F_ink(저울 위에서 찍어 보기), 문지름·24시간 유지(R4) → 급이 시간·스프링 결정
2. **28BYJ-48 rpm 실측** (승준 J6) → 시간 예산 다시 계산
3. **표본 압축** (표본 확보 후) → F_harm → F_p 상한 확정 (R7)
4. **마커 캘리퍼스 측정** (그립·최대 지름 위치, 팁) → 클램프·캡 컵
5. **카메라 200 mm 시험** (승준 J3)

## 9. 전장 관련 D6 답 (승준 CAP-AI-SJ-19 요청: 원점 스위치·전원)
| 항목 | 결정 (잠정) | 근거 |
|---|---|---|
| 원점 잡기 | **1안: 마이크로 스위치 3개 (X 끝, Y 끝, 바닥 아래 끝) → Pi GPIO.** 원점 잡을 때만 천천히 움직이고 Pi가 STOP 명령 | UNO 핀이 꽉 참 (SJ-19). 2 mm/s에서 명령 지연 10 ms ≈ 0.02 mm → 정확도 ±1 mm에 충분 [가능성 높음] |
| 원점 2안 | 끝 멈춤(하드 스톱): 원점 쪽으로 행정보다 길게 돌려 막힘에서 멈춤 | 28BYJ-48 정지 토크 34.3 mN·m → 리드 8·효율 0.66에서 축력 2πTη/l ≈ 18 N → 프린트 부품이 견딤 [가능성 높음]. 단 매번 너트·멈춤 면에 충격 → 1안 우선 |
| 오차 보정 | 마커를 바꾸거나 켤 때마다 격자 위 시험 점을 찍고 카메라로 어긋남(x, y)을 잼 | V블록은 지름에 따라 축이 밀림 (9-5) |
| 구동부 전원 | 5 V 3 A 어댑터 별도 (Pi 27 W와 분리) | 스테핑 3개 약 0.6 A + 서보 이동 0.2~0.65 A × 2 [가능성 높음] → 실측(J6)으로 확인 |

## 10. D5e에서 바뀐 것 (2026-11-01~02, CAP-AI-20·21, 승준 S4 2차 SJ-29)
| 항목 | D5d | D5e | 이유·근거 |
|---|---|---|---|
| 프레임 | 2020 (상자 모양으로 그림) | **2020 T홈 실제 단면**, 기둥 610 × 4, 레일 320 × 21, 합계 9.16 m, L 브래킷 32, 바깥 360 × 360, 높이 845(포획통 꼭대기) | 정방형 20 시리즈만 (서현), 갠트리 레일 처짐 약 0.004 mm |
| 갠트리 받침 레일 x | 25 | **−18** (X 봉 −x 끝 19 → 9) | 마커가 격자 −x 끝에서 레일과 겹침 1,140 mm³ |
| Y 봉 높이 z | 445 / 475 | **438 / 468** (끝 블록에 10 mm 끼움) | 맞대기만 되어 있었음 |
| 문 (112·170·176) | SG90 회전 문판 | **MG90S 미닫이(스카치 요크)**: 혼 핀 r 9, +60° 닫힘 / −60° 열림, 행정 15.6, 닫힘 0.2 s | 회전 문판이 하우징과 겹쳐 안 열림. S4 M7 |
| 문 닫기 규칙 | — | **빛 게이트로 문틈이 빈 것을 확인한 뒤 닫고, 닫는 0.2 s 동안 다시 확인** | 말벌이 끼면 서보가 22~44 N으로 밂 (S4 M7) |
| 펜 들기 (205) | 혼 모서리가 탭을 침, 들림 8.46 | 혼 끝(반지름 14 + 끝 둥글기 2)이 평평한 탭을 밂, **들림 10 mm**, 팔 14 cos θ | 캡 컵에서 빠지는 데 8.56 mm 필요 |
| 펜 홀더 안내 | 캐리지 면 레일 | **안내 핀 Ø3 ×2 + 슬리브 40, 핀을 PTFE 테이프로 감음** (AI 판단, 서현 위임) | 핀 서랍 끼임 한계 μ_c 0.44, PLA μ 0.3이면 여유 1.5배 → PTFE μ ≈ 0.1 [가능성 높음]. D5f에서 핀을 혼 쪽으로 옮김 (μ_c 0.99) |
| 스프링 204 | 0~0.18 N | **뺌** (AI 판단, 서현 위임) | 마커 무게만으로 N_tip 0.31 N, 스프링이 있으면 M8 순간 힘이 0.5 N 넘음 |
| 펜 내리는 속도 | — | **2단계: 팁 위 2 mm까지 빠르게, 마지막 2 mm는 ≤ 60 °/s** (+0.14 s) | 최고 속도면 순간 힘 0.8~1.8 N (정적 0.32 N의 2.4~5.5배), S4 M8 |
| 모터 순항 속도 | 10~15 rpm | 그대로, **2~3 rpm 순항 금지** | X 봉 고유진동수 158~186 Hz ↔ 2.1~3.0 rpm (S4 M10) |
| 너트·커플링 | 없음 | T8 황동 플랜지 너트 ×3, 커플링 5 → 8 mm Ø19.1 × 25.4 | 모델 누락 |
| 통로 꺾임 | 관 두 개 겹침 | 굽힘관 (중심 반지름 20), 빛 게이트는 세로관 | 서현 지적 |
| 질량 (승준 FreeCAD) | 바닥 41.8 / Y 118 / X 386.5 g | 바닥 53.1 / 홀더 33.0 / Y 139.4 / X 455.2 g | SJ-29 |
| Pi 5 자리 (11/02) | 데크 위 (190) | **위판 아래, 같은 x·y (z ≈ 540~575)** (AI 판단, 서현 위임) | 데크 위면 카메라 CSI 리본 약 680 mm → 공식 케이블(최대 500 mm) 모자람. 위판 아래면 약 290 mm → 300 mm 케이블 (`design/2026-11-02_전기계통_제어순서_서현.md` 7장) |
| 문틈 빛 게이트 (11/02) | 문마다 1개 (통로 쪽) | **문마다 2개 (문판 앞·뒤 각 2 mm) + 문판 앞 끝 실리콘 립 1 mm**, 빛 게이트 6 → 9쌍 (AI 추천, 서현 위임) | 빔 하나면 마킹실 쪽에서 머리만 넣은 말벌을 못 봄 — 시뮬레이션 S8a·S8b에서 빔 하나 끼임 1번씩, 2개면 0번. 방향도 앎 (같은 문서 6장) |
| 종 분류 (11/02) | 종·여왕벌·다른 종 | **등검은말벌·유럽말벌 2종만** (서현). 2종 아님·불확실 → 격리. **유럽말벌 → 격리** (서현 11/06) | VespAI와 같은 2종 → VespAI 가중치에서 다시 학습하기 쉬움 |
| 전원 방식 (11/02) | 5 V 어댑터 2개 | **콘센트 기본 + 배터리도 가능** (서현): 본체 입력(USB-C, 배럴 5 V)은 그대로, 같은 플러그의 배터리 상자(LiFePO4 12.8 V + 강압 2개 + INA226). 12 Ah면 약 1.7일 | 하루 약 72 Wh(9시간). 배터리 부족이면 처리 끝내고 격리·입구 문 열고 Pi 끔 (같은 문서 8장) |
| 다른 곤충 (11/06) | 격리 | **격리 유지** (서현 11/06 17:05) | 꿀벌이 갇힐 수 있음 → J6에서 입구로 걸러지는 정도 기록 |
| 여왕벌 기준 (11/06) | 크기 (값 없음) | **중순판 폭 ≥ 4.4 mm → 여왕벌, 격리** (AI 판단, 서현 위임) CAP-AI-24 | 논문 경계 4.5 mm, 불확실 띠 4.4~4.58의 아래 끝 (Pérez-de-Heredia 2017, 위 w_T와 같은 논문). 여왕 놓치는 손해 > 일벌 하나 덜 찍는 손해. 15.6 화소/mm → 70 화소, 전체 해상도 사진에서 잼 `미검증` |
| 배터리 (11/06) | 12 Ah (1.7일) | **LiFePO4 12.8 V 20 Ah, 2일** (서현 '2일', 용량 AI 판단) | 보통 2.84일 / 15 Ah는 2.13일로 여유 6 % → 추위·노화면 모자람 (`design/2026-11-06_제어알고리즘_판단_서현.md` 9장) |
| 스프링 146 k (11/06) | 미정, 길이 10 mm | **2차 (CAP-AI-25): 음악선 d 0.229 (0.009"), D 2.63, 유효 15감김, squared & ground, 자유 길이 14.7 mm, Ø2 강철 핀 위 → k 103.6 N/m** (Shigley 권장 범위 모두 만족). 1차 d 0.4·D 7.5 (k 104.5, C 18.75 > 12)는 차선 (AI 판단, 서현 위임). **기성품만 씀 (서현 11/06 18:32) → 카탈로그 값으로 `spring146_catalog_check.py` 7조건 통과품. D5f 컵 구멍 Ø4.4 안이라 바깥 2.8~4.1 mm** | 범위 94~118 N/m: 고장 때 힘 ≤ 1.0 N [추측 F_safe], 낮은 말벌도 한계 전 F_p, 넘침 ≤ 20 %. HX711 80 Hz. **D5f에서 스프링 자리 16 mm로** (`design/2026-11-06_S4_스프링146_역학계산_서현.md`) |
| 밀대 안내 (11/06) | 바닥판 121 Ø5 구멍 × 5 mm | **바꿈 (서현 18:38): Ø4 × 80 경화 축 + LM4UU를 캐리지 안에, 스프링·로드셀은 캐리지 아래 컵, 축 자리 (65, 4)** — 기성품 4개(축·LM4UU·스프링·로드셀), 겹침 0 (D5f) | 말벌이 20 mm 벗어나면 지금은 F_p의 20~38 %만 누름, LM4UU면 98~99 % (`design/2026-11-06_S4_스프링146_역학계산_2차_서현.md` A) |
| 여왕벌 재는 법 (11/06) | 크기 (값만) | **PRESS 때 원본 해상도 + 격자 눈금(4.4 mm) 배율 + 견판 키포인트 2점, 5장 중앙값** | σ ≤ 0.10 mm면 신여왕 98 % 이상. **못 잴 때 계절 규칙: 3~5·9~11월 여왕, 6~8월 일벌 (서현 11/06 18:32)** (`design/2026-11-06_여왕벌_크기측정_방법_서현.md`) |
| 급이 | 마킹 → 먹이 → 방생 | **유지** | 먹이 시간은 잉크 건조와 겹쳐 빼도 시간이 줄지 않고, 재방문(먹이 보상)과 바로 떠나기에 도움 [가능성 높음]. 조사 모드에서 먹이 줌/안 줌 재포획률 비교 시험 (D1 2장) |
