britams/-capstone-project-repo/design/2026-10-28_S4_기계요소설계_유제3_승준.md

# S4 보강 — 기계요소설계 유제 3개 (승준)

작성: 2026-10-28 · 이승준 (Claude와 정리, CAP-AI-SJ-23) · 승준 지시: "기계요소설계 문제는 서현이 안 풀어서 인터넷에서 찾아 3개 넣자"
서현 S4 본문(`design/2026-10-28_S4_역학계산_1차.md`)은 고치지 않고 **이 파일을 새로 만든다** (분업 원칙 3). 서현이 S4 본문 ③에 옮길지 정함.
계산: `design/calc/s4_me3_check_sj.py` → `s4_me3_results_sj.json` (나사 토크는 서현 `s4_calc.screw_torque` 그대로 사용)
출처 문제는 원문을 옮기지 않고 수치만 적음 (공개 웹 자료, 링크 표시).

---

## 0. 한 줄 요약
| 유제 | 연결 | 교재 정답 대조 | 우리 설계에 준 것 |
|---|---|---|---|
| ME1 DANotes 동력나사 문제 1 | M1 승강 나사 | 501 N·m / 3.15 kW / 19 % / 106 N·m → AI 501.2 / 3.15 / 19.1 / 105.9 (최대 0.11 %) | [확실] Tr8×8은 자립하려면 μ ≥ 0.35 필요 → **자립 불가 확정**, 바닥 유지는 모터 감속기(J6 확인) |
| ME2 DANotes 스프링 문제 2 | 홀더 스프링 204 (M3) | 110 N/mm / 619 MPa / 1.3 → AI 110.3 / 620.8 / 1.28 (최대 1.3 %) | 204 스프링 **잠정 사양**: 피아노선 Ø0.25, 코일 Ø6, 유효 5감김, k ≤ 0.036 N/mm (0.18 N에서 정적 안전율 6.8) |
| ME3 Oriental Motor 나사 구동 모터 선정 | M2 X·Y 이송 | 0.72° / 6000 펄스 / 10 kHz / 1200 rpm / 0.0567 N·m / 0.48 N·m → AI 같음 (최대 0.6 %) | [확실] **28BYJ-48은 토크 여유 약 400배, 속도(펄스 1 kHz)가 한계** → 대기→흉부 58 mm에 31 s. NEMA17이면 약 1 s |

---

### ME1 동력나사의 올림·내림 토크와 자립 — 기계요소설계 (M1 연결)
③ 교과서 유제 연계
| 항목 | 내용 |
|---|---|
| 교재명 | Wright, *Design and Analysis of Machine Elements* (DANotes, University of Western Australia) — Threaded fasteners: Tutorial problems |
| 유제 | **Problem 1** — [링크](https://danotes.mech.uwa.edu.au/threads/problems/problems.html). 수치: Acme 30 mm 1줄 피치 6, 스러스트 칼라 평균지름 40 mm, 나사 μ 0.15, 칼라 μ 0.10, 하중 100 kN. (a) 올림 토크 (b) 1 Hz일 때 동력·효율 (c) 칼라 마찰을 없애면 자립하는지와 내림 토크 (d) μ를 반으로 줄이면? |
| 유형 | 나사 올림 토크, 효율, 자립 판정, 내림 토크 |
| 유사점 | 서현 M1이 이미 (a)만 씀 → 이번에 (a)~(d) 전부 풀어 **M1의 '자립·내림 토크' 판단과 같은 함수**로 대조 |
| 변형 | Acme(α 14.5°)·1줄·리드 6 → Tr8×8(α 15°)·4줄·리드 8, 100 kN → 0.91 N, 칼라 없음. 질문을 "전원이 꺼져도 바닥이 버티나"로 |
| 교재 정답 / 해설집 / AI 재풀이 | (a) **501 N·m** / — / **501.2 N·m** (sec α 무시 — 교재와 같은 식) · sec α 넣으면 508.0 (서현 수기 508과 일치) (b) **3.15 kW, 19 %** / — / 3.15 kW, 19.1 % (c) **자립, 106 N·m** / — / 자립, 105.9 N·m (d) 정답 없음 / — / μ 0.075에서도 πμd_m = 6.36 > l = 6 → **아직 자립 (여유 0.36 mm)**, 윤활이 더 좋아지면 풀릴 수 있음 |
| 본인 풀이 / 대조 | 대기 (수기 칸) / AI–정답 0.04 %·0 %·0.5 %·0.11 % |

④ 수기 풀이 — 대기. 순서: d_m = d − p/2 → T_R = (F d_m/2)(l + π μ d_m)/(π d_m − μ l) + F μ_c d_c/2 → P = 2π f T, η = F l/(2πT) → 자립: π μ d_m > l → T_L = (F d_m/2)(π μ d_m − l)/(π d_m + μ l)

⑤ 우리 설계 적용 (M1)
- Tr8×8: 리드각 20.0° > 마찰각 8.8° → 자립 안 함 (서현 M1과 같음). **자립하려면 μ ≥ 0.351** (= l cos α/(π d_m)) — 황동–스테인리스 건조 0.15로는 불가 → 서현 결론(감속기가 잡아 줌, J6 확인) 유지
- 교재 (d)의 교훈: 자립 여유가 작은 나사는 윤활로 풀릴 수 있음 → 우리 나사는 처음부터 자립 아님이므로 **'전원 끔 → 바닥 하강' 시험(J6)이 필수**

### ME2 압축 코일 스프링 강성·밀착 응력·피로 — 기계요소설계 (M3·스프링 204 연결)
③ 교과서 유제 연계
| 항목 | 내용 |
|---|---|
| 교재명 | Wright, DANotes — Springs: Tutorial problems + Springs fatigue (식 4a: τ_m/S_us + τ_a/S_es = 1/n) |
| 유제 | **Problem 2** — [링크](https://danotes.mech.uwa.edu.au/springs/problems/problems.html). 수치: 평균 코일 지름 76, 선 지름 12.5, 유효 5감김, 자유 길이 140 mm, ASTM A229 오일 템퍼선, 끝 처리는 문제 모음 머리말대로 '맞대고 연삭'. (a) 강성 (b) 밀착 응력 (c) 2~3 kN 변동 하중의 안전율 |
| 유형 | 스프링 강성 k = G d⁴/(8 D³ N_a), 밀착 응력, Goodman형 피로 안전율 |
| 유사점 | 홀더 스프링 204가 **'찍는 힘 상한'을 정하는 압축 코일 스프링** (S4 M3, D6 F_s 0~0.18 N) — 같은 식으로 크기를 정함 |
| 변형 | 하중 kN → 0.1 N대, A229 → 피아노선, 피로 → 정적(찍는 횟수 적음, 응력 낮음) |
| 교재 정답 / 해설집 / AI 재풀이 | (a) **110 N/mm** / — / **110.3** (G 79.3 GPa — A229 표값 77.2 GPa면 107) (b) **619 MPa** / — / **620.8** (밀착 하중 5.79 kN, 직접 전단 보정 K_s = 1 + 0.5/C) (c) **1.3** / — / **1.28** (S_ut = 1855/d^0.187 = 1157 MPa (Shigley A229 상수), S_us = 0.63 S_ut, S_es = 0.13 S_ut (DANotes 표 2), 평균엔 K_s, 진폭엔 Wahl) |
| 본인 풀이 / 대조 | 대기 / AI–정답 0.24 %·0.28 %·−1.3 % |

④ 수기 풀이 — 대기. 순서: C = D/d → k → N_t = N_a + 2, L_s = d N_t → F_s = k(L_f − L_s) → τ = K 8FD/(πd³) → S_ut → τ_m, τ_a → 1/n = τ_m/S_us + τ_a/S_es
가정 표시: (c)의 진폭 응력 계수 K_h를 Wahl 계수로 봄 [가능성 높음 — DANotes '전체 응력 집중'], S_ut 식은 Shigley 상수 [가능성 높음 — DANotes 표 글자가 깨져 확인 못 함]

⑤ 우리 설계 적용 (스프링 204, **잠정 — F_ink 시험 후 서현이 정함**)
| 항목 | 값 |
|---|---|
| 조건 | 홀더가 눌리는 거리 5 mm (가정)에서 F_s ≤ 0.18 N (S4 M3) → k ≤ 0.036 N/mm |
| 사양 예 | 피아노선(음악선) d 0.25 mm, 코일 평균지름 6 mm (C = 24), **유효 감김 약 5.1** |
| 응력 | 0.18 N에서 τ = 180 MPa, S_sy ≈ 0.45 S_ut = 1216 MPa → **정적 안전율 6.8** |
| 걸리는 점 | C = 24는 감기 어려운 축(보통 4~12) → 시중 미니 스프링 중 k가 낮은 것을 사서 쓰거나, 스프링 없이 자중(0.32 N)만으로 되는지 먼저 (D6) |

### ME3 나사 구동 스테핑 모터 선정 — 기계요소설계 + 동역학 (M2 연결)
③ 교과서 유제 연계
| 항목 | 내용 |
|---|---|
| 교재명 | Oriental Motor, *Technical Reference* — Selection Calculations (Ball screw drive, stepping motor) p.G-7~8 |
| 유제 | [링크](https://www.orientalmotor.com/products/pdfs/2012-2013/G/usa_tech_calculation.pdf). 수치: 테이블+짐 40 kg, 미끄럼 μ 0.05, 볼나사 효율 0.9, 예압 너트 μ₀ 0.3, 나사 Ø15·길이 600·리드 15, 철 7.9×10³ kg/m³, 분해능 0.03 mm/스텝, 이송 180 mm를 0.8 s 안에, 가감속 0.2 s, 안전율 2 |
| 유형 | 필요 분해능 → 펄스 수·펄스 속도 → 부하 토크 → 부하 관성 → 가속 토크 → 필요 토크 → 모터 선정·관성비 |
| 유사점 | 우리 X·Y도 **나사 + 스테핑 모터 위치 결정** — 같은 순서로 "토크가 모자란가, 속도가 모자란가"를 판정 |
| 변형 | 볼나사 → T8 사다리꼴(효율 0.66), 40 kg → 0.3865 kg (X 빔 묶음, 서현 S4), 미끄럼 → 볼 부싱 μ 0.005, 이송 180 mm → 58 mm(대기→흉부)·4.4 mm(구멍 사이) |
| 교재 정답 / 해설집 / AI 재풀이 | θ_s **0.72°**, 펄스 **6000**, f₂ **10 kHz**, **1200 rpm**, F **19.6 N**, T_L **0.0567 N·m**, J_B **0.236×10⁻⁴**, J_m **2.28×10⁻⁴**, J_L **2.52×10⁻⁴ kg·m²**, 필요 토크 **0.48 N·m**, 관성비 **6.6** / — / 모두 같음 (필요 토크 0.477 N·m, −0.6 %) |
| 본인 풀이 / 대조 | 대기 / AI–정답 0.6 % 이내 |

⑤ 우리 설계 적용 (X축, 같은 순서)
| 구동 | 최고 속도 | 58 mm (대기→흉부) | 4.4 mm (구멍 사이) | 토크 안전율 | 판정 |
|---|---|---|---|---|---|
| 28BYJ-48 + ULN2003 (보유, 반걸음 1 kHz) | 1.96 mm/s | **31.1 s** | 2.4 s | 약 400 | **속도가 한계 (토크는 넉넉)** [확실 — 사양서 펄스 한계] |
| NEMA17 + A4988 (구매 시, 1/8 스텝 16 kHz ≈ 600 rpm) | 80 mm/s | **약 1.0 s** | 0.07 s | 9.7 이상 | 빠름 [가능성 높음 — 실사용 600 rpm은 모터·전압에 따라 다름] |
- 서현 S4 M2·D6 "X·Y를 벨트로 바꾸면 …"과 같은 결론을 기계요소 쪽에서 확인: **시간(R6)을 줄이려면 토크가 아니라 펄스 속도를 키워야 함** → 승준 제어부 문서 `control/2026-10-28_제어부_구성_신뢰성_AI마킹.md`에 개선안 정리

---

## 검증
- 세 문제 모두 공개 정답과 1.3 % 이내 [확실]. ME2 (c)의 1.3 %는 S_ut 식 출처 차이(Shigley 상수 vs DANotes 표) 때문으로 봄 [가능성 높음]
- 적용 계산(204 스프링, X축 비교)은 **잠정** — 홀더 행정·F_ink·NEMA17 실속도는 시험 전
