britams/-capstone-project-repo/design/2026-10-28_D5_개념설계_안1.md

# D5 개념설계 — 안 1 바닥 승강형 (1차)

정리일: 2026-10-28 · 작성: 이서현 (Claude와 정리, CAP-AI-10) · 상태: **초안 — 1차(CAP-AI-11) → 2차 구조 변경(CAP-AI-13, 7장) → 3차 다시 그림(CAP-AI-14, 8장, 현재 기준)**
앞 단계: `design/2026-10-28_D3_형태분석표와_조합안.md` (안 1 선택) · 양식: 시스템설계및제어 워크시트 3-1 (특허도면식 개념설계도, 도면부호 대응표)
치수는 모두 미정 — D6 설계 변수표에서 정한다.

---

## 1. 배치 — 상용 트랩 어디에 끼우나

```
        ┌───────────────┐
        │ 상용 포획통   │  ← 격리함으로 그대로 사용 (F5-2)
        └──────┬────────┘
        ┌──────┴────────┐ 104 상부 결합부
        │   모듈 100     │ ─────→ 174 방생 출구 (트랩 밖으로, 한 방향)
        └──────┬────────┘ 102 하부 결합부
   ════════════╧═════════════  상용 트랩 차양막(지붕)
        상용 트랩 몸통 (유인제·포획구) — 갇힌 말벌이 빛 쪽(위)으로 올라옴
```

- [가능성 높음] **상용 포획통을 격리함으로 쓴다.** 방제 모드의 "전부 가둠"과 조사 모드의 여왕벌·다른 종 격리가 모두 "포획통으로 올려 보냄" 하나로 해결된다. 원래 상용 트랩의 동작과 같아서, 모듈이 고장 나면 문을 포획통 쪽으로 열어 두는 것만으로 일반 트랩이 된다 (D2 환류 2 '고장 시 가둠').
- 방생 출구 174만 트랩 밖으로 따로 낸다 (D2 환류 1).

## 2. 구성요소와 도면부호

| 부호 | 구성요소 | 역할 (기능 번호) |
|---|---|---|
| 100 | 모듈 하우징 | 전체 지지 (F8) |
| 102 | 하부 결합부 | 상용 트랩 차양막 구멍에 끼움, 공구 없이 탈착 (F8-1) |
| 104 | 상부 결합부 | 상용 포획통 바닥과 맞물림 (F8-1) |
| 110 | 입구 | 크기로 1차 거름 — 장수말벌 대부분 차단 (F1-1) |
| 112 | 입구 문 | 한 마리 들어오면 닫힘, 추가 진입 차단 (F1-2, F1-3) |
| 114 | 진입 감지 센서 | 입구 통과 감지 (F2-1) |
| 120 | 마킹실 | 말벌 한 마리가 머무는 투명 공간. 벽은 **미끄러운 플라스틱** (말벌이 바닥에 머물게) |
| 130 | 격자망 | 마킹실 천장. 마커 팁은 통과, 머리·다리는 못 빠짐 |
| 140 | 승강 바닥 | 올라가며 말벌 등을 격자망에 살짝 붙임 (F3-1) |
| 142 | 급이구 | 승강 바닥 위의 먹이 자리 (F4-2) |
| 144 | 먹이통·심지 | 당액 저장, 심지로 급이구에 공급 (F4-1) |
| 146 | 완충 스프링 | 바닥과 구동부 사이 — 미는 힘 제한 (F3-2) |
| 148 | 하중 센서 | 미는 힘 측정, 상한에서 정지 (F3-2) |
| 150 | 바닥 구동부 | 승강 (리드스크루 + 스테핑 모터 후보) |
| 160 | 수성 아크릴 마커 | 한 색 (F3-3) |
| 162 | 마커 홀더 | 팁 접촉력 완충 스프링 |
| 164 | 마커 구동부 | 마커를 격자 눈 사이로 내림 (F3-3) |
| 166 | 마커 캡 | 대기 중 팁 마름 방지 (F3-4) |
| 170 | 분기 문 | 포획통 쪽 / 방생 출구 쪽 선택 (F5-1, F5-3). 전원이 끊기면 포획통 쪽으로 (F7) |
| 172 | 격리 통로 | 마킹실 → 상용 포획통 (한 방향) |
| 174 | 방생 출구 | 마킹실 → 트랩 밖 (한 방향 깔때기, 바깥 말벌 역진입 방지) |
| 180 | 카메라 | 격자망 위에서 내려다봄 — 종·계급·표식 판별, 마킹 확인, 로그 사진 (F2, F6-1) |
| 182 | 조명 | 촬영용 (새벽 운용) |
| 190 | 제어부 | Pi 5 (판별·순서·기록) + 아두이노 (구동기·센서) (F6, F7) |
| 192 | 모드 스위치 | 방제 / 조사 (F7-1) |
| H | 말벌 (가상선) | — |

## 3. 작동 순서 (조사 모드, 표식 없는 등검은말벌 일벌)

1. **대기**: 입구 문 112 열림, 바닥 140 내려감, 마커 160은 캡 166 안, 분기 문 170은 포획통 쪽 닫힘·방생 쪽 닫힘
2. **진입**: 말벌 H가 빛 쪽으로 올라와 입구 110 통과 → 센서 114 감지 → 입구 문 112 닫힘
3. **판별**: 카메라 180이 종·계급·표식·마리 수 판단 → 로그. 여왕벌·다른 종·불확실·두 마리 → 9로
4. **자세 고정**: 바닥 140이 올라가 H의 등을 격자망 130에 붙임. 힘은 스프링 146·하중 센서 148로 상한 이하. 카메라가 흉부가 격자 쪽인지 확인 → 아니면 바닥을 내렸다 다시 올림
5. **마킹**: 마커 160이 캡에서 나와 흉부 위로 → 구동부 164가 격자 눈 사이로 팁을 내림 → 점 → 마커는 캡으로 복귀
6. **확인**: 카메라가 점 확인 (실패 시 4~5 한 번 더)
7. **급이**: 바닥을 조금 내려 고정을 풀고, 급이구 142에서 먹게 둠 (시간 ≥ 마커 건조 시간)
8. **방생**: 분기 문 170을 방생 쪽으로 → H가 방생 출구 174로 나감 → 문 닫힘 → 1로
9. **격리** (방제 모드는 2 다음 바로 여기): 분기 문 170을 포획통 쪽으로 → H가 빛 쪽(위) 포획통으로 올라감 → 1로

## 4. 이 단계에서 드러난 것 (환류)

| 번호 | 발견 | 반영할 곳 |
|---|---|---|
| 1 | [가능성 높음] **격자망은 판별 정확도에도 쓸 수 있다.** 말벌이 격자에 붙으면 카메라–흉부 거리가 일정하고, 격자 눈이 크기 기준(자)이 된다 → 흉부 폭을 사진으로 잴 수 있음 = 여왕벌 판별을 카메라로 하는 근거 (승준 SJ-02의 '카메라냐 기구냐' 질문에 대한 답 후보) | 인터페이스 정의서, D6 |
| 2 | [추측] 흉부 폭 경계 차이가 약 0.1 mm라, 사진으로 가르려면 측정 오차가 ±0.05 mm 수준이어야 함 → 카메라 해상도·초점 거리 요구 (승준 확인) | 인터페이스 정의서 |
| 3 | 카메라 180과 마커 160이 둘 다 격자 위에 있음 → 마커가 시야를 가림. 마커가 찍을 때만 들어왔다 빠지는 구조, 또는 카메라를 비스듬히 | D6, 인터페이스 |
| 4 | 방생 때 말벌이 출구 쪽으로 가게 하는 방법 필요 — 빛 쪽으로 가는 습성 이용 (출구 쪽 밝게, 포획통 쪽 어둡게) [추측] | 조명 182, 시험 |
| 5 | 격리할 때는 반대로 포획통 쪽이 밝아야 함 → 조명 또는 가림막 전환 | 조명 182 |

## 5. FreeCAD 개념 모델 1차 (CAP-AI-11)

- 생성 스크립트: `cad/D5_concept_an1.py` (치수는 맨 위 `P` 사전 — **전부 잠정 개략값**, D6에서 확정)
- 모델: `cad/D5_concept_an1_down.FCStd`(바닥 내림 — 대기·진입), `cad/D5_concept_an1_up.FCStd`(바닥 올림 — 자세 고정·마킹). 객체 이름 = 도면부호
- 측단면 그림 (앞쪽 절반을 잘라 냄): `cad/D5_도1_측단면_대기.png`, `cad/D5_도2_측단면_자세고정_마킹.png`
- 아직 아님: 특허도면식 마무리(도면부호 인출선·무채색 선 PDF), 실측 치수 반영

모델을 그리며 발견한 것 (환류 추가):

| 번호 | 발견 | 반영 |
|---|---|---|
| 6 | [확실] 처음 배치에선 **입구가 차양막 구멍 밖**에 있어 아래에서 올라오는 말벌이 닿을 수 없었음 → 입구는 구멍 안쪽(반지름 hole_r − 벽 이내)에, 마킹실은 옆으로 비켜 배치. 스크립트에 이 조건 검사(assert)를 넣음 | `cad/D5_concept_an1.py`, D6 |
| 7 | [확실] 마킹 위치에서 **마커가 카메라와 같은 자리**를 지나감 (도 2 그림에서 겹침 확인) → 환류 3 확정. 카메라를 비스듬히 두거나 마커를 옆에서 비스듬히 넣는 안 필요 | D6, 인터페이스 정의서 (승준 J3) |
| 8 | [가능성 높음] 마커 대기 위치·구동부가 들어가려면 하우징 바깥 지름이 약 130 mm 필요 (잠정 반지름 65) → 상용 트랩 차양막(지름 약 26 cm) 위에 올라가는 크기라 문제는 없어 보이나 실측 필요 | 상용 트랩 실측 |

## 6. 다음 (서현)
1. FreeCAD로 도 1(전체 구성 측단면), 도 2(③ 자세 고정·⑤ 마킹 상태) — Python 스크립트 `cad/` 로 작성
2. 상용 트랩 실측 (차양막 구멍 지름, 포획통 바닥 결합부, 높이) → 결합부 102·104 치수
3. D6 설계 변수표: 격자 눈, 마킹실 크기, 바닥 행정·힘 상한, 마커 행정, 입구 지름 → S4 역학계산 대상 선정

## 7. 구조 변경 — 바닥에 서는 알루미늄 프로파일 프레임 (2026-10-28, 서현 결정, CAP-AI-13)

| 항목 | 1차 (CAP-AI-11) | 2차 (지금) |
|---|---|---|
| 외부 구조 | 원통 하우징 100 | **알루미늄 프로파일 프레임 100 (2020, 바닥에 섬)** — 원통 커버 없앰 |
| 하중 | 모듈이 차양막 턱 위에 얹힘 | **상용 트랩에는 하중 0.** 마킹부·급이부·구동부·제어부는 프레임에 고정한 받침판 101·105가 받침 |
| 아래 결합 | 하부 결합부 102가 차양막 구멍에 끼움 | **칼라 102**: 차양막 턱 위에 틈(약 3 mm)을 두고 덮기만 함 — 말벌 통로 틈막이, 하중·정밀도 필요 없음 |
| 위 결합 | 상부 결합부 104 | **포획통 결합부 104**: 차양막 턱(바깥 90, 안 55)을 복사해 위 받침판에 세움 → 포획통을 원래처럼 **돌려 끼움** |
| 분리 가능한 곳 (서현 확인) | — | 차양막·몸통은 한 몸. 포획통만 떼어짐 → 모듈은 그 사이 |

반영한 실측: D1 55, D2 90, H21 180, H22 145, H1 220, D3 67/83/94 mm (`design/2026-10-28_상용트랩_실측표.md`).

모델: `cad/D5b_frame_an1.py` → `cad/D5b_frame_an1_down.FCStd`, 그림 `cad/D5b_전체_등각.png`, `cad/D5b_측단면_대기.png`.
카메라는 마커와 겹치지 않게 비켜 둠 (환류 7 임시 해결, 승준 J3 결과로 확정).

환류 (2차):

| 번호 | 발견 | 반영 |
|---|---|---|
| 9 | [확실] 하중이 프레임으로 가니 **아래쪽(차양막 턱)은 돌려 끼울 필요가 없다.** 정밀 결합은 **위쪽(포획통) 한 곳**뿐 → 측정·시험 출력 부담이 절반 | 결합부 104 |
| 10 | [가능성 높음] 돌려 끼움(베이어닛) 결합은 ±0.2~0.3 mm 맞춤이 필요해 5 m 줄자(±1~2 mm)로는 부족 → **차양막 턱을 캘리퍼스로 재거나, 결합 링만 먼저 3D 출력해 맞춰 보며 2~3회 고침** | 실측표 h, 3D 프린터 |
| 11 | [가능성 높음] 전체 높이가 상용 트랩 40 cm → 약 59 cm로 늘어남 (모듈 약 18.5 cm). 프레임 바닥이 넓어(34 cm) 전도에는 유리 | S4 전도 계산 |
| 12 | 커버를 없애서 **비·빛 차단**이 없어짐 → 마킹실 주변 빛 방향 제어(환류 4·5)와 전장품 방수용 작은 덮개는 따로 필요 | D6 |

## 8. 3차 — 다시 그림 (2026-10-28, CAP-AI-14) ← 마킹부·카메라는 10장(4차)으로 바뀜

서현 지적 (10/28): 1·2차 모델은 **부품이 겹치고, 의미 없는 직사각형이 있고, 공중에 뜬 부재가 있었다.** → 처음부터 다시 그림. 환경 요소(비·바람)는 다루지 않고 시스템 설계·제어만 본다 (서현).

### 8-1. 다시 그린 원칙과 검사 결과
- 모든 부품을 실제 부품 크기로: 28BYJ-48(보유), SG90(보유), Pi 5·AI HAT+, 아두이노 UNO, T8 리드스크루 등
- 모든 부품이 다른 부품에 닿아 지지됨. 스크립트 끝에서 **자동 검사**: 부품 쌍 겹침 부피, 공중에 뜬 부품, 프레임까지 닿음으로 이어지는지
- 결과 (대기·마킹 두 상태 모두) [확실]: **겹침 0, 공중에 뜬 부품 0, 프레임과 안 이어진 부품 0.** 상용 트랩과 닿는 곳은 포획통이 결합부 104에 얹히는 것 하나뿐 (의도)
- 검사로 실제 잡아낸 것: ① 바닥을 올리면 하중 센서·스프링이 마킹실 바닥판과 겹침 → 바닥판 높이 315 → 330 mm ② 마커 지지대가 레일 반대쪽에 붙어 마커부 전체가 떠 있었음 → 수정

### 8-2. 그림
| 그림 | 파일 | 보이는 것 |
|---|---|---|
| 도 1 전체 등각 | `cad/D5c_도1_전체_등각.jpg` | 프레임·받침판·상용 트랩(참고)·제어부 |
| 도 2 모듈 등각 | `cad/D5c_도2_모듈_등각.jpg` | 입구·문 3개·통로·마커부·카메라 (말벌 경로) |
| 도 3 옆 단면 (대기) | `cad/D5c_도3_단면_대기.jpg` | 승강 구동부 내부, 마커 후퇴 |
| 도 4 옆 단면 (마킹) | `cad/D5c_도4_단면_마킹.jpg` | 바닥 36.5 mm 상승, 마커 25 mm 전진 |

모델: `cad/D5c_module_an1.py` (생성·검사 스크립트) → `cad/D5c_module_an1_rest.FCStd`, `cad/D5c_module_an1_mark.FCStd`

### 8-3. 구성 (도면부호 갱신 — 1·2차와 다른 번호 주의)

| 부호 | 구성요소 | 지지 |
|---|---|---|
| 100 | 프레임 2020 (34×34 cm, 기둥 높이 54 cm) | 바닥 |
| 101 | 받침판 (아크릴 5t) | 프레임 가로 레일 |
| 102 | 칼라 — 차양막 턱과 **2 mm 떨어진** 틈막이 | 101 아래 |
| 104 | 포획통 결합부 (차양막 턱 복사, 돌려 끼움 — 승준 실물 확인) | 105 |
| 105 | 위 받침판 | 프레임 위 레일 |
| 110·111 | 입구 통로(안지름 12)·입구 깔때기 | 101 |
| 112 | 입구 문: 하우징 + 문판 + SG90 | 마킹실 -x 벽 |
| 114 | 진입 감지 (적외선 빔 송·수신) | 110 |
| 120·121 | 마킹실 벽(안 40×40, 높이 50, 미끄러운 플라스틱)·바닥판 | 151 |
| 130 | 격자망 (눈 3 mm, 피치 4.4, 가운데 눈이 겨냥점) | 120 |
| 140 | 승강 바닥 (피스톤 39×39) | 147 |
| 142·144 | 급이 심지(+y 벽 관통, **고정** — 움직이는 관 없음)·먹이통 | 120 |
| 146·147·148 | 완충 스프링·밀대(Ø4)·하중 센서(버튼형) | 158 |
| 151·152 | 구동부 옆판 2·모터판 | 101 |
| 153 | 바닥 스테핑 모터 28BYJ-48 | 152 |
| 154·155 | 커플링·T8 리드스크루 | 153 |
| 157·158 | 가이드봉(Ø4)·캐리지(너트) | 152·121 |
| 160 | 수성 아크릴 마커 (연직에서 25° 기울여 +y 쪽에서 격자 중심 겨냥) | 165 |
| 163·164 | 마커 지지대·레일 | 130 |
| 165·167·168 | 마커 캐리지·M5 이송 나사·마커 스테핑 모터 28BYJ-48 | 164 |
| 166 | 마커 캡: **실리콘 슬릿 (수동)** — 마커가 밀고 나가면 벌어지고, 물러나면 닫혀 팁이 마르지 않음 → 캡용 구동기 없음 | 164 |
| 170 | 격리 문 (SG90) | 마킹실 -x 벽 |
| 172·173 | 격리 통로·격리 깔때기 → 포획통 | 170·105 |
| 174·175 | 방생 통로·한 방향 실리콘 출구 | 176 |
| 176 | 방생 문 (SG90) | 마킹실 +x 벽 |
| 180·181·182 | AI 카메라(격자 위 57 mm, 잠정)·브래킷·조명 링 | 105 |
| 190·191 | Pi 5 + AI HAT+ · 아두이노 UNO | 101 |
| H | 말벌 (가상선, 몸 높이 7.5 잠정) | — |

구동기 **5개**: 스테핑 2 (바닥 승강, 마커 이송) + 서보 3 (입구·격리·방생 문). 센서: 적외선 빔, 하중 센서, 카메라.

### 8-4. 바뀐 설계 판단
| 항목 | 이전 | 3차 | 이유 |
|---|---|---|---|
| 마커 진입 | 위에서 수직 (카메라와 겹침) | **+y 쪽에서 25° 기울여** | 카메라는 격자 바로 위에 둘 수 있음. 25°보다 크게 기울이면 팁이 3 mm 격자 눈 테두리에 걸림 [확실, 모델 검사] |
| 마커 캡 | 구동 캡 | 실리콘 슬릿 (수동) | 구동기 1개 줄임. 슬릿이 잉크를 닦아 내는지는 시험 필요 [추측] |
| 급이 | 승강 바닥 위 급이구 + 움직이는 관 | 벽에 고정한 심지 (바닥을 올린 높이 바로 위) | 움직이는 관이 구동부와 겹침. 먹이 주는 높이 = 바닥 올린 높이 |
| 분기 문 | 회전 플랩 1개 | 격리 문·방생 문 2개 | 두 출구가 마주 보는 벽에 있어 문 1개로 못 고름 |
| 승강 | 개략 | 28BYJ-48 + T8 리드스크루 + 가이드봉 + 캐리지, 행정 36.5 mm | S4 동력나사 계산 대상 |

### 8-5. 남은 것 (D6에서)
- 치수는 아직 잠정: 마킹실 40×40, 바닥 행정 36.5, 말벌 몸 높이 7.5, 카메라 거리 57, 격자 눈 3 — 표본·J3·J5 결과로 확정
- 포획통 결합부 104의 홈·돌기 치수 (캘리퍼스)
- 측정 정확도: 줄자 ±1~2 mm

---

## 9. 3차 검토 — 마커 자유도·말벌 자세·캡·클램프 (2026-10-28 저녁, CAP-AI-15) · **결정: 안 B (10장)**

서현 질문: "펜이 1자유도면 통을 작게 해야 하지 않나? XYZ 3축이어야 하지 않나? 팁 뚜껑은 어떻게 닫나? 마커는 샤피 수성 아크릴로 하되 클램프로 바꿔 끼울 수 있게. 벌이 움직이면?"

### 9-1. 찾은 문제
1. [확실] 3차 마커의 겨냥점은 격자 가운데 **한 곳뿐**(1자유도). 흉부 등판(폭 3.8–4.5 mm × 길이 약 5 mm [추측], 약 20 mm²) ÷ 마킹실 40×40(1,600 mm²) ≈ 1 % → 한 번 눌렀을 때 맞을 확률이 몇 % 이하 → **R3(80 %) 불가**. 1·2차 동작 순서(5장 "마커가 흉부 위로")에 있던 위치 맞추기가 3차에서 빠짐 (서현 지적).
2. [가능성 높음] **자세(등/배)**: 벽은 미끄럽고 잡을 곳은 격자 천장뿐인데 조명도 위에 있음 → 말벌이 격자에 거꾸로 매달릴 가능성이 높음. 그대로 바닥을 올리면 등이 바닥에 눌리고 **마커는 배를 찍음**. 마커 자유도를 늘려도 이건 안 풀림.
3. [가능성 높음] **속도**: 28BYJ-48 약 15 rpm × M5 피치 0.8 mm ≈ 0.2 mm/s → 마커 행정 25 mm에 편도 약 2분 → R6(3분) 위반. 바닥 승강은 T8 리드 8 mm면 약 2 mm/s(36.5 mm에 약 19 s).
4. [확실] 샤피 크리에이티브 마커(수성 아크릴, 제조사 안내): 흔들기·펌핑 불필요, 표면 건조 1–3분, 뚜껑을 안 닫으면 마를 수 있음. 팁 굵기·몸통 지름은 제조사 자료에 없음 → 캘리퍼스로 측정.
   → [가능성 높음] 급이 시간 ≥ 건조 시간(D1 2장 2)이면 급이만 1–3분 → R6 안에서 재시도할 여유가 거의 없음 (말벌 몸 위 건조 시간은 미검증).
5. [가능성 높음] 실리콘 슬릿 캡: 팁이 지날 때마다 슬릿에 닦이고, 묻은 잉크가 말라 슬릿이 굳을 수 있음.

### 9-2. 마커 위치 맞추기 — 안 비교
| 안 | 구성 | 풀리는 것 | 남는 것 | 구동기 |
|---|---|---|---|---|
| A 통로형 + 1자유도 | 마킹실을 일벌 폭 통로(약 7 mm)로, 끝에 빛·멈춤판, 겨냥점 고정. 여왕벌은 통로 전에 격리 | 좌우·머리 방향 대부분 | 통로에 들어가는지·끝에서 멈추는지 = **말벌 행동에 의존**(실험 전 모름), 좌우 여유 ±1–1.5 mm, 판별용 앞방 + 문 추가 | 5 + 서보 1 |
| B XY + Z (서현 제안) | 마킹실 40×40 유지, 카메라가 흉부 좌표 → XY 이동 → Z로 찍음 | 위치·머리 방향 전부 (말벌 행동과 무관) | 흉부 좌표 찾기(VespAI는 상자만 줌 → 승준 비전 일 추가), 카메라–XY 보정, 카메라와 공간 다툼(J3 초점 거리와 함께) | 5 + 스테핑 2 |

권고: **B** [가능성 높음] — 실험 전에는 확인할 수 없는 말벌 행동에 덜 기대고, 캡·클램프 문제가 함께 풀림(9-4·9-5). 결정은 서현.

### 9-3. 벌이 움직이면 — 동작 규칙 (두 안 공통)
1. **누르기 전**: 카메라로 말벌이 바닥에 있는지(= 등이 위) 확인. 격자에 붙었을 때(57 mm)와 바닥에 있을 때(약 94 mm) 겉보기 크기가 약 1.6배 다름 [가능성 높음]. 천장에 매달려 있으면 기다림. 누르기 전에는 위 조명을 끄고 아래·옆에서 비추고, 촬영할 때만 위 조명 [추측, 살아 있는 말벌 시험 필요]
2. **누름**: 바닥이 올라가 등을 격자에 붙임, 하중 센서로 힘 상한 (R7)
3. **확인**: 등이 위인지, 흉부 좌표 → 아니면 바닥을 내리고 다시 (최대 N회)
4. **찍기**: 눌린 상태라 확인부터 찍기까지 몇 초 동안 위치가 안 바뀜. 마커 홀더 스프링이 작은 꿈틀거림을 받아 줌. 마커가 말벌을 누르면 바닥 하중이 늘어나므로 **바닥 하중 센서로 찍는 힘도 잼**
5. **점 확인**: 카메라로 점이 찍혔는지 → 없으면 1회 재시도. N회 실패 → 표식 없이 방생 + 로그 '마킹 실패'

### 9-4. 캡
| 방식 | 원리 | 구동기 | 팁 닦임 | 어울리는 안 |
|---|---|---|---|---|
| 실리콘 슬릿 (3차) | 팁이 밀고 지나감 | 0 | 있음 | — |
| 연동 덮개 | 캐리지가 처음 몇 mm 움직일 때 레버가 덮개를 열고, 물러나면 스프링이 닫음 (디지털카메라 렌즈 덮개와 같은 원리) | 0 | 없음 | A |
| 캡 컵 (대기 자리) | 쉴 때 XY가 옆 대기 자리로 가서 Z로 실리콘 컵에 내려앉음 (잉크젯 프린터 헤드 캡과 같은 원리) | 0 | 없음 | B |

### 9-5. 클램프 (서현 결정: 샤피 크리에이티브 마커 기본, 다른 마커로 바꿔 끼울 수 있게)
- 마커마다 지름·길이·팁 길이가 다름 → 정해야 할 것 2가지
  1. **팁 끝 높이(Z)**: 끼울 때 팁을 기준판에 대고 조임(팁 맞춤 지그). B면 마커를 내려 바닥판에 닿는 순간을 하중 센서로 감지 → 자동 0점
  2. **축 위치(XY)**: V블록 클램프는 지름이 바뀌면 축이 옆으로 밀림(90° V에서 지름 차이의 약 0.71배) → A면 자가 중심 클램프(드릴 척식) 필요, B면 시험 점을 찍고 카메라로 어긋남을 재서 보정
- 홀더 스프링(162): 찍는 힘 상한, 꿈틀거림 흡수

### 9-6. 결정할 것
1. 마커 위치 맞추기: A / B
2. B면: 마킹실 40×40 유지, 마커 기울임·카메라 높이 (J3 초점 거리 결과와 함께), 이송 나사 피치(속도)

### 9-7. 마커 고르는 기준 (서현 질문 "펜촉이 두껍고 잘 안 마르는 게 맞지 않나", CAP-AI-15 추가)
"잘 안 마른다"는 두 가지로 나눠야 함: **팁은 안 말라야 하고(캡으로 해결), 말벌 몸에 찍힌 점은 빨리 말라야 함**(그루밍·R6). 잉크 자체가 늦게 마르면 R6와 표식 유지(R4)에 불리.

| 기준 | 값 | 이유 |
|---|---|---|
| 잉크 | 수성 아크릴 (D1 Q1) | 서현 결정. 단 제조사도 "매끈한 비다공성 표면에서는 덜 오래감"이라 함 → 말벌 몸 위 24시간 유지(R4) 시험 필수 |
| 팁 모양·굵기 | 둥근 팁, 지름 약 1–2 mm [가능성 높음] | 흉부 폭 3.8–4.5 mm → 점(팁보다 번짐)이 등판 안에 들어가야 날개 뿌리·머리에 안 묻음. 격자 눈(3 mm)을 통과해야 함. 납작 팁은 방향 따라 굵기가 바뀌고, 붓 팁은 눌리는 힘에 따라 점 크기가 바뀜 |
| 밸브식(펌핑) 여부 | 비밸브식이 편함 | 밸브식은 가끔 눌러 잉크를 내려야 함 → 안 B면 캡 컵 바닥에 눌러 펌핑 가능 |
| 색 | 흰색 또는 노랑 | 등검은말벌 흉부는 어두운 갈색·검정 → 카메라 대비 (R5) |
| 몸통 지름·길이 | 캘리퍼스 측정 | 클램프 범위 |
| 캡 없이 견디는 시간 | 시험값 | 캡 방식이 정해지면 덜 중요 |

### 9-8. 마커 선정 (서현 위임 "적당한 것으로 찾아서 링크", CAP-AI-15) — **10-5로 바뀜 (흔들기·펌핑 없는 마커)**
| 구분 | 제품 | 근거 | 판매처 |
|---|---|---|---|
| **1순위** | uni POSCA **PC-3M 화이트** (둥근 팁 0.9–1.3 mm), 3개 | 9-7 기준(팁 1–2 mm, 격자 눈 3 mm 통과, 흰색) 충족 [확실, 판매처 사양]. 양봉 용품점들이 여왕벌 표시펜으로 파는 제품 [확실] → 곤충 몸에 쓴 실적 있음. 팁 교체품 있음. 개당 약 2,300–2,800원 | 화방넷·펜도매 (10/28 확인 시 품절 표시 보임 → 구매 전 확인), 없으면 다나와 비교 |
| 비교용 | POSCA **PC-5M 화이트** (1.8–2.5 mm), 1개 | 점 크기 비교 시험 (등판 안에 들어가는지) | 같은 곳 |
| 보류 | 샤피 크리에이티브 마커 불렛 | 흔들기·펌핑 불필요는 자동화에 유리. 팁 굵기 미공개, 국내 판매처 못 찾음 | 해외 |

주의 [가능성 높음]: POSCA는 밸브식 — 처음에 흔들고 팁을 눌러 잉크를 내림, 흰색은 안료가 가라앉으므로 운용 전 흔들기 필요 → 아침 점검 항목, B안이면 캡 컵 바닥에 눌러 펌핑. 제조사 표기는 '수성 안료 페인트'(판매처는 '아크릴 마커'라고도 함) → D1 Q1 '수성 아크릴'의 취지(수성·불투명 페인트)로 보고 선정.

---

## 10. 4차 — 안 B 마커 XYZ (2026-10-28 저녁, 서현 결정 "B로 가자", CAP-AI-16) · **현재 기준**

### 10-1. 결정
- 마커 위치 맞추기 = **안 B (X·Y + Z)** (9-2). 9-8의 POSCA 선정은 서현 조건 "흔들기·펌핑 없는 마커"로 바뀜 → 10-5
- 9-3 동작 규칙(누르기 전 자세 확인, 누른 뒤 좌표 확인, 재시도, 점 확인)은 그대로 씀 → 인터페이스 정의서 상태 머신 2차

### 10-2. 새로 확인한 사실 — 카메라 거리
- [확실] Raspberry Pi AI 카메라: 수동 초점, **초점 범위 20 cm~무한대**, 시야 수평 66°·수직 52.3°, 4056×3040 (제조사 사양, Waveshare 상품 페이지)
- → 3차의 "격자 위 57 mm"는 초점이 안 맞는 자리였음 (3차 환류 7·J3로 남겨 둔 항목이 사양으로 판정됨)
- → 4차는 **격자 위 200 mm**. 시야 약 260×196 mm, 최대 해상도에서 약 15.6 화소/mm [계산] → 1 mm 점 ≈ 15 화소로 보임 [가능성 높음]
- 부작용 [가능성 높음]: 0.1 mm 흉부 폭 차이 ≈ 1.5 화소 → **카메라로 흉부 폭을 재서 여왕벌·일벌을 가르는 방법(5장 환류 1, J5)은 어려워짐.** 더 가까이 찍으려면 Camera Module 3(자동 초점, 더 가까운 거리) 등 다른 카메라 검토 — 승준 J3
- 좋은 점: 카메라 아래 200 mm 공간에 XYZ 이송부가 들어감

### 10-3. 구성 (도 5~8, `cad/D5d_module_an1_B.py`)
- **X**: 빔 끝 블록 2개(212)가 X 고정 봉 2개(213, Ø8, y=−64·+54)를 타고, X 리드스크루(214, T8) + 28BYJ-48(215)로 이동. 봉은 프레임 갠트리 단(z 452) 레일 위 봉 받침(218)에 고정
- **Y**: 빔 끝 블록 사이의 Y 봉 2개(207, Ø6)와 Y 리드스크루(208)를 Y 캐리지(206)가 타고 이동. 모터(209)는 −y 끝 블록 바깥 브래킷(211)
- **Z**: V블록 홀더(202)가 캐리지 앞면을 따라 위아래로 미끄러짐. 홀더 스프링(204)이 아래로 밀고(찍는 힘 상한), Z 서보(205, SG90)가 혼으로 홀더 탭을 들어 올림 (펜 플로터의 펜 들기와 같은 원리)
- **마커 클램프**: V블록(202) + 조임 띠(203) → 지름 Ø10~20 마커를 바꿔 끼움. 지름이 바뀌면 축이 옆으로 밀리는 만큼은 시험 점을 찍어 카메라로 보정 (9-5)
- **캡**: 대기 자리(x 65, y −40)의 실리콘 캡 컵(219)에 마커 원뿔이 앉음 → 팁이 마르지 않음. 구동기 추가 없음, 팁이 닦이지 않음 (잉크젯 헤드 캡 원리)
- **카메라**: 격자 위 200 mm (180), 위 받침판(105)에 매달림. 프레임 위 높이 520 → 590
- 구동기 **7개**: 스테핑 3 (바닥 승강 153, 마커 X 215, 마커 Y 209) + 서보 4 (문 112·170·176, 펜 들기 205)

### 10-4. 검사 결과 (스크립트 자동 검사, 두 상태)
| 상태 | 겹침 | 뜬 부품 | 프레임과 안 이어진 부품 | 상용 트랩 접촉 | 카메라 시야를 가리는 부품 |
|---|---|---|---|---|---|
| 대기 (마커 캡 컵) | 0 | 0 | 0 | 104–포획통만 (의도) | **0** |
| 마킹 (흉부 좌표 위) | 0 | 0 | 0 | 104–포획통만 (의도) | 201·202·203·204 (찍는 동안만, 의도) |

- 설계하며 바꾼 것: ① 펜 들기 서보가 Y 봉 경로와 겹침 → 캐리지를 400~490으로 키우고 서보를 Y 봉 아래로 ② 대기 자리 (55, −40)에서는 서보 모서리가 카메라 시야 가장자리에 걸림 → (65, −40)으로 옮김 (스크립트 시야 검사로 찾음)

| 그림 | 파일 | 보여 주는 것 |
|---|---|---|
| 도 5 전체 등각 | `cad/D5d_도5_전체_등각.jpg` | 프레임 위 높이 590, 갠트리 단, 카메라 200 mm |
| 도 6 XYZ 마킹부 등각 | `cad/D5d_도6_마킹부_등각.jpg` | X·Y·Z 구동, 클램프, 캡 컵 (대기) |
| 도 7 정면 단면 (마킹) | `cad/D5d_도7_정면단면_마킹.jpg` | 바닥이 말벌을 격자에 붙이고, 마커가 흉부 좌표의 격자 눈으로 찍음 |
| 도 8 위에서 본 그림 (대기) | `cad/D5d_도8_위_대기.jpg` | 카메라 시야(V) 밖에 마커·캐리지·서보 |

### 10-5. 마커 재선정 (서현 "흔들거나 펌핑할 필요 없는 것 중 최상")
| 순위 | 제품 | 근거 | 걸리는 점 |
|---|---|---|---|
| **1** | 사쿠라 퍼마페이크(Sakura Permapaque) Fine, 흰색, 1.0 mm | 흔들기·펌핑 불필요, 수성 안료 잉크, 불투명, 흰색, 냄새 없음·비독성(ACMI AP) [확실, Royal Talens·Blick·판매처]. 팁 1.0 mm → 9-7 기준(1~2 mm) 안 | 비다공성 표면 내구: Blick "영구 아님" vs Royal Talens "영구" — 말벌 몸 위 24시간 시험 필요. 국내 판매처 못 찾음 |
| 2 | 샤피 크리에이티브 마커 불렛, 흰색 | 흔들기·프라이밍 불필요, 수성 **아크릴**(D1 Q1 그대로), 불투명 [확실, 제조사·JetPens] | 팁 굵기 미공개, 몸통 Ø14.7~18.9·134 mm·13 g → 클램프 범위 끝, 이송부 무게 ↑. 국내 판매처 못 찾음 |

- 둘 다 2~3개씩 사서 표본·더미 시험(점 크기, 건조 시간, 문지름, 24시간 유지)으로 하나를 고름
- [가능성 높음] 비펌핑식은 심지로 잉크가 나와 한 번 찍을 때 양이 적음 → B는 같은 자리를 2~3번 찍을 수 있어 보완
- 링크: [Jerry's Artarama — Permapaque 흰색](https://www.jerrysartarama.com/sakura-permapaque-opaque-paint-art-marker-white-57082), [Honeybee Stamps — Permapaque 1.0 mm 흰색](https://honeybeestamps.com/en-au/collections/paints-pigments/products/permapaque-1-0mm-opaque-pigment-marker-white), [Royal Talens — Permapaque Fine 사양](https://www.royaltalens.com/products/sakura-permapaque-fine), [JetPens — 샤피 크리에이티브 불렛 2색](https://www.jetpens.com/Sharpie-Creative-Acrylic-Paint-Marker-Bullet-Tip-2-Color-Set/pd/42549)

### 10-6. 남은 것 (D6에서)
- [가능성 높음] **속도·시간(R6 3분)**: 28BYJ-48(약 15 rpm) + T8 리드 8 mm ≈ 2 mm/s → Y 대기→흉부 약 20~29 s, 바닥 승강 약 19 s, 여기에 급이(≥ 건조 1~3분)가 더해지면 3분을 넘을 수 있음 → D6에서 모터(NEMA17 등)·전동(벨트)·R6 목표값을 같이 검토 (S4 동력나사 계산 대상)
- 치수 잠정: 마킹실 40×40, 바닥 행정 36.5, 말벌 몸 높이 7.5, 마커 Ø15·134 (실물 측정 전), 카메라 200
- 흉부 좌표 찾기(승준 J8), 카메라 200 mm 초점·해상도(J3), 조명 밝기
- 포획통 결합부 104 홈 치수 (캘리퍼스)

---

## 11. 4차 보완 — D6 설계 변수표·S4 역학계산 반영 (2026-10-28 밤, CAP-AI-18) · **현재 기준**

근거: `design/2026-10-28_D6_설계변수표.md`, `design/2026-10-28_S4_역학계산_1차.md`. 모델은 같은 스크립트 `cad/D5d_module_an1_B.py`를 고침 (이전 판은 Git 기록).

### 11-1. 바뀐 것
| 항목 | 4차 (10장) | 보완 | 이유 |
|---|---|---|---|
| 마커 | 퍼마페이크 1순위 (해외) | **샤피 크리에이티브 불렛 노랑** (5색 세트, 쿠팡) | 서현 결정 10/28 (Issue #3) — 재료비 규칙상 해외구매 불가, 국내 판매처 있음. 노랑은 9-7 기준 "흰색 또는 노랑" 충족 |
| 마커 모델 | Ø15 원통 | 그립 Ø14.7(60 mm) + 굵은 부분 Ø18.9 (JetPens 사양, 굵은 부분 위치는 [추측]) | 실물 치수 |
| X·Y 안내 | 프린트 블록 구멍 | **LM8UU ×2 (X), LM6UU ×2 (Y)** 직선 볼 부싱 (222·221) | S4 M5: 한쪽 구동 X 빔은 PLA·청동 부싱이면 끼임 (r2 요 + 피치 합침 2μ(kd + h)/L = 2.9~4.4 / 1.45~2.2 ≥ 1) |
| 빔 끝 블록 212 | 두께 12, x 20 | 두께 18, x 24 | LM8UU Ø15×24가 블록 면을 뚫지 않게 (첫 실행 검사에서 겹침 2건 발견 → 고침) |
| X 봉 y | −64 / +54 | −65 / +57 | 블록 두께 |
| 스프링 멈춤 탭·스프링 | 마커 축에서 9·12.8 mm | 10.05·13.25 mm | 마커 굵은 부분과 0.6 mm 띄움 |
| 찍는 힘 | "하중 센서로 잼" (9-3, 10장) | **못 잼 → 수동값**: 홀더·마커 자중 0.32 N + 스프링 0~0.18 N | S4 M3 자유물체도: 팁 힘만큼 격자 반력이 줄 뿐 바닥 힘은 그대로 |
| 재시도 | 바닥 전 행정 | 10 mm만 내렸다 올림 | S4 M2 시간 (+11 s/회) |

### 11-2. 정정 [확실]
- 9-3의 4번 "마커가 말벌을 누르면 바닥 하중이 늘어나므로 바닥 하중 센서로 찍는 힘도 잼"과 10장 도 7 설명의 "바닥 하중 센서(148)로 측정"은 **틀림**. 말벌이 격자에 붙어 있는 동안 바닥 힘은 바닥 위치(스프링 146 압축)로 정해지고, 팁 힘은 격자 반력을 줄일 뿐이다. 바닥 힘이 바뀌는 건 팁 힘이 바닥 힘보다 커져 말벌이 격자에서 밀려 내려갈 때뿐 (S4 M3). 도 7 설명은 고쳐 다시 그림.

### 11-3. 검사 결과 (보완 모델, 두 상태)
| 상태 | 겹침 | 뜬 부품 | 프레임과 안 이어진 부품 | 상용 트랩 접촉 | 카메라 시야 가림 |
|---|---|---|---|---|---|
| 대기 | 0 | 0 | 0 | 104–포획통만 | **0** |
| 마킹 | 0 | 0 | 0 | 104–포획통만 | 201~204 (찍는 동안만, 의도) |

도 5~8은 보완 모델로 다시 그림 (`cad/D5d_도5~8_*.jpg`).

### 11-4. 남은 것
- 시험 1순위: **샤피 노랑 건조 시간·최소 힘** → 급이 시간(≤ 약 105 s면 R6 만족)·스프링 204 결정 (D6 8장)
- 28BYJ-48 rpm 실측(J6), 표본 압축(F_harm → F_p), 마커 캘리퍼스 실측, 카메라 200 mm(J3)
- S4 ④ 수기 풀이(서현)와 ③ 교재 유제 번호
