britams/-capstone-project-repo/design/2026-10-28_S4_역학계산_1차.md

# S4 역학계산 1차 — 말벌 자동 마킹 트랩 (시스템설계및제어 S4 양식)

정리일: 2026-10-28 · 작성: 이서현 (Claude와 정리, r1 CAP-AI-18 → **r2 CAP-AI-19**) · 설계대상: 말벌 자동 마킹 모듈 (D5 4차 + 보완) · 회차 S4 / r2
양식: 「워크시트_역학계산(학생작성용)」 4-1 → 4-2 → 4-3(①~⑤) + 검증 대장
계산: `design/calc/s4_calc.py` → `design/calc/s4_results.json` (AI값) · 교재 대조: `design/calc/s4_textbook_check.py` → `s4_textbook_check.json` · 그림: `design/calc/s4_figs.py` → `design/img/S4_*.png`

> **수기 풀이에 대해 [확실]:** 양식은 "④ 수기 풀이를 AI 계산보다 먼저" 하도록 되어 있다. 이번에는 D6 설계 결정(모터·부싱)이 급해서 **AI값을 먼저 계산해 설계에 반영했다.** 그래서 아래 ④는 서현이 채울 칸으로 비워 두고(풀이 순서만 적음), ⑤의 판정은 모두 **"잠정 — 수기 대조 후 확정"** 이다.

> **r2에서 바뀐 것 (교재·해설집 대조 후 재점검, CAP-AI-19)**
> 1. ③ 유제 번호를 모두 정함 — Riley 9-66·6-49·6-41·9-43, Meriam 3/1·3/2, Gere 9.3-1. 각 유제를 **설계 계산에 쓰는 같은 함수로** 다시 풀어 교재 정답·해설집 값과 대조 (차이 0.5 % 이내, 아래 "교재 유제 대조 대장").
> 2. **M5 끼임을 고침**: r1은 요(yaw)만 보고 "청동 부싱 끼임"이라 했는데, 요는 접촉 배분에 따라 경계가 둘(μ_c 0.098 / 0.197)이고 **나사가 봉보다 55 mm 낮아 생기는 피치까지 합치면 μ_c = 0.068~0.103** → 청동은 두 경계 모두 끼임, LM8UU는 여유 13.6배 이상.
> 3. 질량·무게중심을 FreeCAD 모델에서 부품별로 읽음 → **X 봉 A가 빔 무게의 61~71 %** (Y 모터가 봉 A 바깥에 있음). M6 하중을 반반 → 무게중심 배분 + 최악(한 봉이 전부)으로.
> 4. Y 캐리지 편심(홀더·마커가 Y 봉 면에서 −x로 24 mm) → 세로로 겹친 두 Y 봉에 **수평 짝힘 ±0.26 N** — M2 마찰과 M6 Y 봉 하중에 넣음.
> 5. M4 레일 마찰을 가정값(측압 0.2 N) 대신 홀더 편심 모멘트로 계산 → f ≤ 0.089 N, 안전율 38.9 → **36.2**.
> 6. M1 안전율 19.6은 **120 Hz(약 1.8 rpm)에서의 토크** 기준임을 밝힘 — 10~15 rpm(반 스텝 683~1024 Hz)의 토크는 사양서에 없음 → J6 부하 시험.

---

## 4-1. 전체 구성도의 외력 표기와 가상 절단면

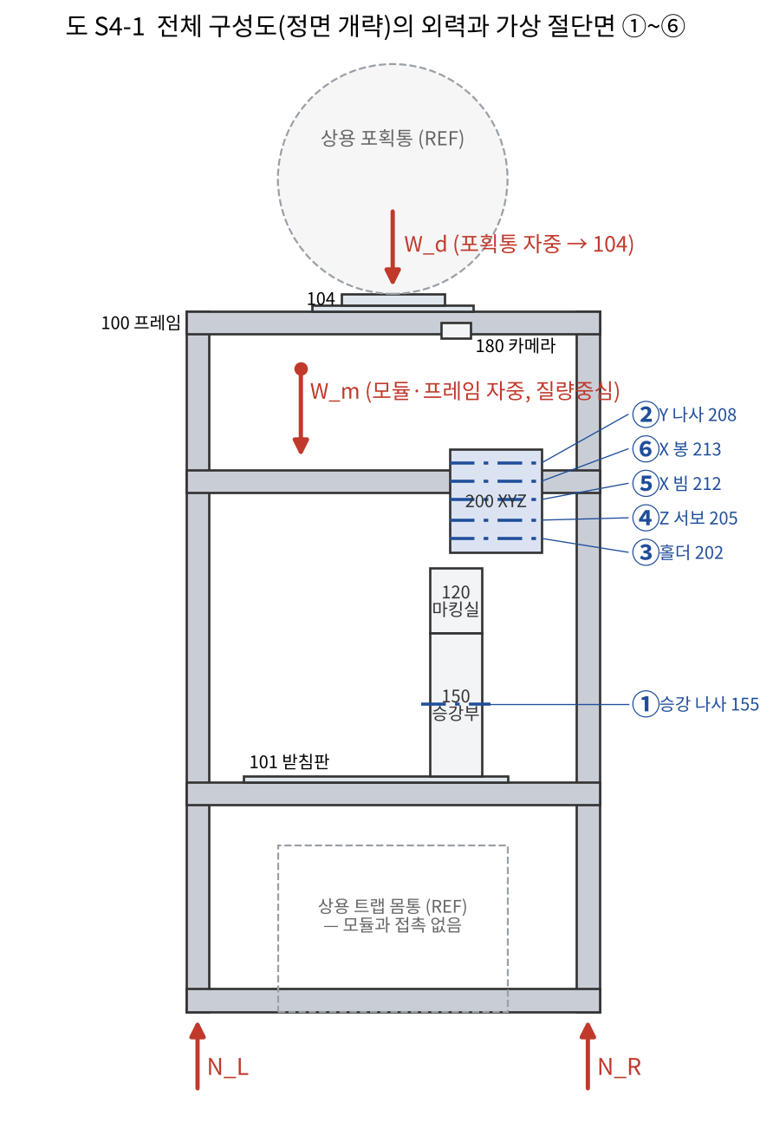
[picture p29: design/img/S4_4-1_외력_절단면.png]
도 S4-1


| 구분 (외력/내력) | 기호 | 하중 | 크기와 근거 (미지이면 '미지') | 작용점 (도면부호) |
|---|---|---|---|---|
| 외력 (전체도) | W_m | 모듈·프레임 자중 | 약 58 N [추측] = 9.81 × 약 5.9 kg (2020 프로파일 약 9.4 m × 0.5 kg/m + 아크릴판 0.37 kg + 모듈 부품 약 0.8 kg) | 질량중심 |
| 외력 (전체도) | W_d | 상용 포획통(격리함) 자중 | 약 1.5 N [추측] (빈 통 약 150 g, 미측정) | 결합부 104 |
| 외력 (전체도) | N_L, N_R | 바닥 반력 | 미지 (전체 평형: N_L + N_R = W_m + W_d) | 프레임 100 다리 |
| 내력 (절단 ①) | F, T | 승강 나사 축력·구동 토크 | 미지 (M1) | 155 T8 나사, 158 캐리지 너트 |
| 내력 (절단 ②) | F, T | Y 나사 추력·토크 (X도 같은 꼴) | 미지 (M2) | 208 / 214 |
| 내력 (절단 ③) | N_tip, F_s | 마커 팁 접촉력, 스프링 힘 | 미지 (M3) | 201·202·204 |
| 내력 (절단 ④) | T, F_lift | 펜 들기 서보 토크, 혼 힘 | 미지 (M4) | 205 |
| 내력 (절단 ⑤) | P, Q | X 나사 추력, 부싱 측압 | 미지 (M5) | 212, 222 |
| 내력 (절단 ⑥) | V, M | X 봉 전단력·굽힘 모멘트 | 미지 (M6) | 213 |

- 상용 트랩 몸통(REF)은 모듈과 닿지 않는다 (D5 검사) → 외력에 없음. 환경 하중(바람)은 다루지 않는다 (서현 10/28).

## 4-2. 가상 절단과 역학 분야

| 절단 | 떼어 낸 물체 (도면부호) | 절단면 | 절단면에 드러나는 내력 → 외력 | 역학 분야 | 계산번호 |
|---|---|---|---|---|---|
| ① | 승강 바닥·밀대·캐리지 (140·147·158) + 말벌 접촉 | 너트 바로 아래 T8 나사 (155) | 축력 F, 비틀림 T | 기계요소설계 (나사 구동 토크·자립) | M1 |
| ② | Y 캐리지 묶음 (206 + 201~205·221) / X 빔 묶음 | Y 나사 208 (X: 214) | 추력 F, 비틀림 T | 기계요소설계 + 동역학 (이송 시간·가속력) | M2 |
| ③ | 홀더 + 마커 (201·202·203) / 말벌 H | 스프링 204 위 끝, 팁–말벌 접촉면 | 스프링 힘 F_s, 접촉력 N_tip | 정역학 (평형, 한쪽 접촉 조건) | M3 |
| ④ | 서보 혼 (205) | 서보 축 | 토크 T, 혼 끝 힘 F_lift | 정역학 (모멘트) | M4 |
| ⑤ | X 빔 전체 (212·207·208·206…) | 두 X 봉의 부싱 접촉면, X 나사 | 추력 P, 측압 Q, 마찰 μN | 정역학 (마찰·끼임) / 기계요소 (안내 요소 선정) | M5 |
| ⑥ | X 고정 봉 (213) | 봉 가운데 단면 | 전단력 V, 굽힘 모멘트 M | 재료역학 (보 처짐·응력) | M6 |

설계 질문과 분야: 정역학(M3·M4·M5) · 재료역학(M6) · 동역학(M2) · 기계요소설계(M1·M2·M5) — 네 분야 모두 포함.

---

## 4-3. 역학 문제 전개

질량·무게중심 (CAP-AI-19): FreeCAD `D5d_module_an1_B`(마킹 상태)에서 부품별 부피·무게중심을 읽고 PLA 1.24(꽉 찬 값 = 상한)·강 7.85·알루미늄 2.7 g/cm³, 구매품은 사양 질량(마커 13, SG90 9, 28BYJ-48 37, LM8UU 15, LM6UU 8 g).

| 묶음 | 질량 | 무게중심 (x, y, z) mm | 비고 |
|---|---|---|---|
| 승강 바닥 묶음 (140·146·147·148·158) | 41.8 g | (55.0, 0.2, 330) | M1 |
| 홀더 + 조임 띠 + 마커 (201~203) | 32.8 g | (62.0, 0.3, 440) | 캐리지 면(x 75.8)에서 −x로 13.8 mm → M3·M4 |
| Y 캐리지 묶음 (+204·205·206·221) | 118.0 g | (79.0, 1.7, 442) | Y 봉 선(x 85.8)에서 −x로 6.8 mm → 편심 모멘트 7.9 N·mm |
| X 빔 묶음 (+207~212·222) | 386.5 g | (83.7, −17.2, 453) | 대기 상태(y −40)면 y −29.4 → 봉 A 몫 61 %(찍기) ~ 71 %(대기) |

### M1 승강 나사 구동 토크와 자립 — 기계요소설계
| 절단 / 떼어 낸 물체 | ① / 140·147·158 + 155 |
|---|---|
| 역학 분야 | 기계요소설계 |
| 검증 대상 문장·기준값 | D2 F3-1 "바닥이 말벌 등을 격자에 붙임", 인터페이스 정의서 구동기 1 (28BYJ-48 견인 토크 > 34.3 mN·m) |

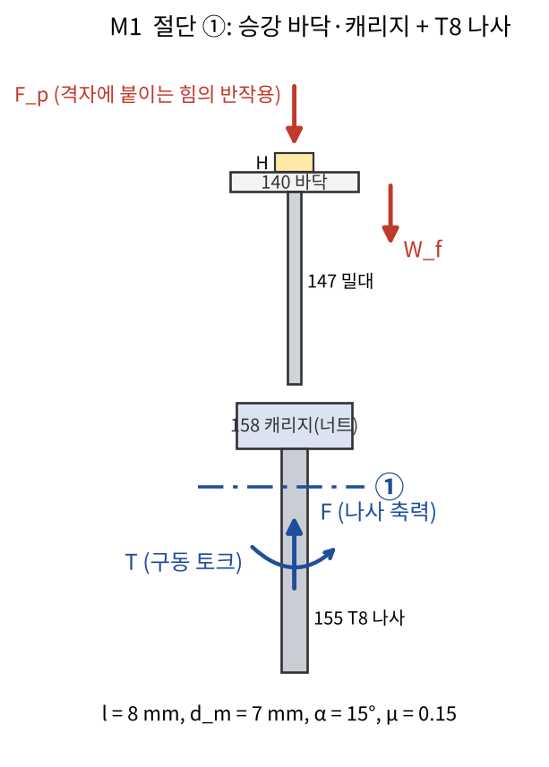
[picture p30: design/img/S4_M1_FBD.png]
M1
① 자유물체도: 

② 문제설정
- **주어진 조건**: 승강 바닥·밀대·캐리지·하중 센서·스프링의 무게 W_f = 0.41 N. 바닥이 말벌을 격자에 붙이는 힘 상한 F_p = 0.5 N (가정, R7 미정). 나사 Tr8×8: 바깥지름 8, 피치 2, 4줄, 리드 l = 8, 유효지름 d_m = 7 mm, 나사산 반각 α = 15°, 마찰계수 μ = 0.15 (황동 너트–스테인리스, 건조). 모터 28BYJ-48 견인 토크 > 34.3 mN·m (사양서, **120 Hz에서**).
- **구하는 값**: 너트 아래 단면의 축력 F와 올림 토크 T, 효율 η, 자립 여부, 모터 기준 안전율, 행정 36.5 mm 시간.
- **가정**: 칼라 마찰 없음, 가이드봉 마찰 무시, 정속(가속력 무시 — 0.04 kg × 0.02 m/s² ≈ 0.001 N).

③ 교과서 유제 연계
| 항목 | 내용 |
|---|---|
| 교재명 | (1) Wright, *Design and Analysis of Machine Elements* (DANotes, UWA) — Shigley 식 / (2) Riley·Sturges, *Engineering Mechanics: Statics* 2판 (Wiley), 9-3.2 사각나사 |
| 유제 | (1) Threaded fasteners – Problem 1 (동력나사) / (2) **문제 9-66 (p.518)** — 리드가 큰 사각나사 프레스 |
| 유형 | 나사의 올림 토크와 자립(풀 때 모멘트가 필요한가) |
| 유사점 | (2)는 **μ = 0.15로 같고, 리드각(38.5°)이 마찰각(8.5°)보다 커서 자립하지 않는** 경우 — 우리 나사(리드각 20.0° > 마찰각 8.8°)와 판정 구조가 같음 |
| 변형 | 사각나사(α = 0) → 사다리꼴 α = 15° (마찰각에 sec α), r_m 20 → 3.5 mm, 리드 100 → 8, 하중 400 → 0.91 N. 목적이 "작은 모터로 되는지·전원 꺼져도 바닥이 버티는지"로 바뀜 |
| 교재 정답 / 해설집 / AI 재풀이 | (1) 501 N·m / — / — (2) **8.59 N·m, 자립 안 함 / 8.592 N·m, 자립 안 함 / 8.592 N·m, 자립 안 함** (`screw_torque`에 α = 0) |
| 본인 풀이 / 대조 | (1) **서현 수기 508.0 N·m (10-21, scan_05)**, 정답과 1.4 % — 원문은 sec α 무시 / (2) 서현 대기. AI–정답 0.02 %, AI–해설집 0.003 % → 같은 함수로 M1 계산 |

④ 수기 풀이 — **서현 칸 (대기)**. 풀이 순서: F = W_f + F_p → T = (F d_m / 2)(l + π μ d_m sec α)/(π d_m − μ l sec α) → η = F l / (2π T) → 자립: π μ d_m sec α 와 l 비교 (= 리드각 tan⁻¹(l/π d_m)과 마찰각 tan⁻¹(μ sec α) 비교) → 내림 토크 T_L = (F d_m / 2)(π μ d_m sec α − l)/(π d_m + μ l sec α) → 속도 v = l × rpm / 60.

⑤ AI 대조와 판정
| 항목 | 내용 |
|---|---|
| AI값 (CAP-AI-19) | F = 0.910 N, **T = 1.75 N·mm**, η = 0.661, 리드각 20.0° > 마찰각 8.8° (π μ d_m sec α = 3.42 mm < l = 8) → **자립 안 함**, T_L = −0.63 N·mm (저절로 내려가려 함), 안전율 34.3 / 1.75 = **19.6 (단, 120 Hz ≈ 1.8 rpm 토크 기준)**, v = 1.33~2.0 mm/s → 36.5 mm에 27~18 s |
| 수기값 / 상대 차이 | 대기 |
| 최종 채택값 | 잠정 T = 1.75 N·mm (수기 대조 후 확정) |
| 문장 기준 만족 | 토크는 만족 [가능성 높음] — 단 10~15 rpm에서 모터 토크가 1.75 N·mm보다 큰지는 사양서로 판단 불가 (15 rpm = 반 스텝 1024 Hz로 공회전 최대 1000 Hz와 거의 같음) |
| 환류 | ① J6에서 **바닥 묶음(42 g) + 0.5 N 추를 걸고 10·15 rpm에서 탈조 없는지** 확인 (r2 추가). ② 자립하지 않지만 28BYJ-48 감속기(1/64)가 역구동을 막는다 [가능성 높음] → 전원이 꺼져도 바닥이 내려가지 않는지 J6에서 확인. 리드 2(1줄) 나사로 바꾸면 자립하지만 속도가 1/4 → 시간(M2)에 불리해서 안 바꿈 |

### M2 X·Y 이송 토크와 한 마리 처리 시간 — 기계요소설계 + 동역학
| 절단 / 떼어 낸 물체 | ② / Y 캐리지 묶음 (206 + 201~205 + 221), X 빔 묶음 |
|---|---|
| 역학 분야 | 기계요소설계 (나사 토크), 동역학 (가속력, 운동 시간) |
| 검증 대상 문장·기준값 | D1 **R6 한 마리 3분 이내** (급이 포함) |

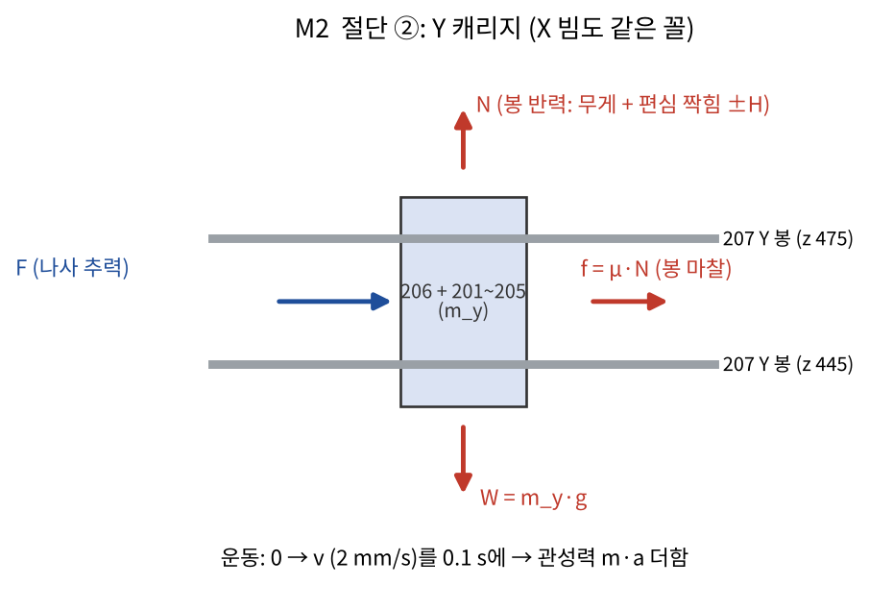
[picture p31: design/img/S4_M2_FBD.png]
M2
① 자유물체도: 

② 문제설정
- **주어진 조건**: 이동 질량 m_y = 118 g, m_x = 387 g. 안내: 볼 부싱 μ = 0.005 (카탈로그 0.002~0.003보다 크게), 비교로 PLA 부싱 0.3. 나사는 M1과 같음. 0.1 s에 2 mm/s까지 가속 (a = 0.02 m/s²). 대기 → 흉부 최대 이동 Δx = 28, Δy = 58 mm (X·Y 동시). 모터 10~15 rpm. **Y 캐리지 편심**: 묶음 무게중심이 Y 봉 선에서 −x로 6.8 mm → 모멘트 M_e = 1.16 N × 6.8 mm = 7.9 N·mm, 두 Y 봉은 z 445·475로 세로 30 mm 간격 → 수평 짝힘 H = 7.9 / 30 = **0.26 N** (r2 추가).
- **구하는 값**: 추력 F와 토크 T, 안전율, 한 마리 처리 시간과 R6를 만족하는 급이 시간 상한.
- **가정**: 봉 반력 크기 합 = 무게 + 2H (마찰을 크게 잡는 쪽). X는 M5 끼임 연립(k = 1)으로 추력. 시간 단계는 D6 5장 표 (판별 2 s, 방생 10 s는 가정), 마커 복귀·급이 높이 이동은 급이와 병렬.

③ 교과서 유제 연계
| 항목 | 내용 |
|---|---|
| 교재명 | Meriam·Kraige·Bolton, *Engineering Mechanics: Dynamics* 9판 SI (Wiley) — 3장 질점의 운동방정식 |
| 유제 | **3/1, 3/2 (p.P-41)** — 3/1: 50 kg 상자가 6 m/s로 미끄러지다 멈춤(μ_k 0.40). 3/2: 15° 경사면 위 50 kg 상자에 경사와 나란한 힘 P = 0·150·300 N (μ_s 0.20, μ_k 0.15) |
| 유형 | 마찰 있는 직선 운동: 먼저 정지 마찰을 넘는지 확인 → 넘으면 운동 마찰로 ΣF = ma |
| 유사점 | "미는 힘 − 마찰 = 질량 × 가속도"와 "움직이기 시작하는가(정지 마찰 검사)" — 이송축이 출발하는 순간과 같은 식 |
| 변형 | 경사 15° → 수평, 힘을 주고 가속도 구함 → **가속도를 주고 필요한 추력을 구함(역문제)**, 50 kg → 0.118·0.387 kg, 추력을 나사 토크(M1 식)로 바꿈, 3/1의 시간 = 속도/가속도 → 이동 시간 = 거리/속도 |
| 교재 정답 / 해설집 / AI 재풀이 | 3/1: t 1.529 s, x 4.59 m / 같음 / 1.529 s, 4.587 m · 3/2: a = −1.118(아래), 0, +2.04 m/s² / 같음 / −1.118, 0, +2.040 m/s² |
| 본인 풀이 / 대조 | 서현 대기 / AI–정답 0.06 % 이내. 해설집(미국 9판 문제별 PDF)과 SI판의 수치가 이 두 문제는 같음 |

④ 수기 풀이 — **서현 칸 (대기)**. 순서: W = m g → H = W e / 30 → F = μ(W + 2H) + m a → T (M1 식) → 안전율 → 단계별 시간 합 → 급이 상한 = 180 − (기구·판별 합).

⑤ AI 대조와 판정
| 항목 | 내용 |
|---|---|
| AI값 (CAP-AI-19) | 볼 부싱: **Y F = 0.011 N, T = 0.021 N·mm (안전율 1,650)** / **X F = 0.032 N, T = 0.061 N·mm (566)**. 참고 PLA 부싱: Y T = 0.98 N·mm (35), **X는 끼임 (M5)**. **시간: 기구·판별 합 63.9 s (15 rpm) / 87.5 s (10 rpm) → 급이 상한 116 s / 92 s, 재시도 1회면 105 s / 77 s** |
| 수기값 / 상대 차이 | 대기 |
| 최종 채택값 | 잠정 — 28BYJ-48 + T8 유지, 급이 상한 약 105 s (15 rpm, 재시도 1회) |
| 문장 기준 만족 | **조건부** — 잉크 건조(= 급이) ≤ 약 105 s일 때만 R6 만족. 샤피 표기 "종이 위 1~3분" → 시험 전에는 판정 불가 |
| 환류 | ② 원인 구분: 요구사항 쪽(건조 시간이 R6를 지배). 건조 > 115 s이면 (가) XY 벨트 (+23 s 여유) (나) R6를 4~5분으로 고침 (다) 빠른 건조 방법 — D6 5장. 재시도 바닥 내림을 전 행정 36.5 → 10 mm로 줄임 (재시도 1회 +11 s) |

### M3 찍는 힘 — 정역학
| 절단 / 떼어 낸 물체 | ③ / (a) 홀더 + 조임 띠 + 마커 (201·202·203), (b) 말벌 H |
|---|---|
| 역학 분야 | 정역학 (평형, 한쪽 접촉 조건 R ≥ 0) |
| 검증 대상 문장·기준값 | D1 R3 마킹 성공(잉크가 묻음: F_tip ≥ F_ink), R7 말벌 손상 없음(F ≤ F_harm), 말벌이 격자에 붙어 있음(R_g ≥ 0) |

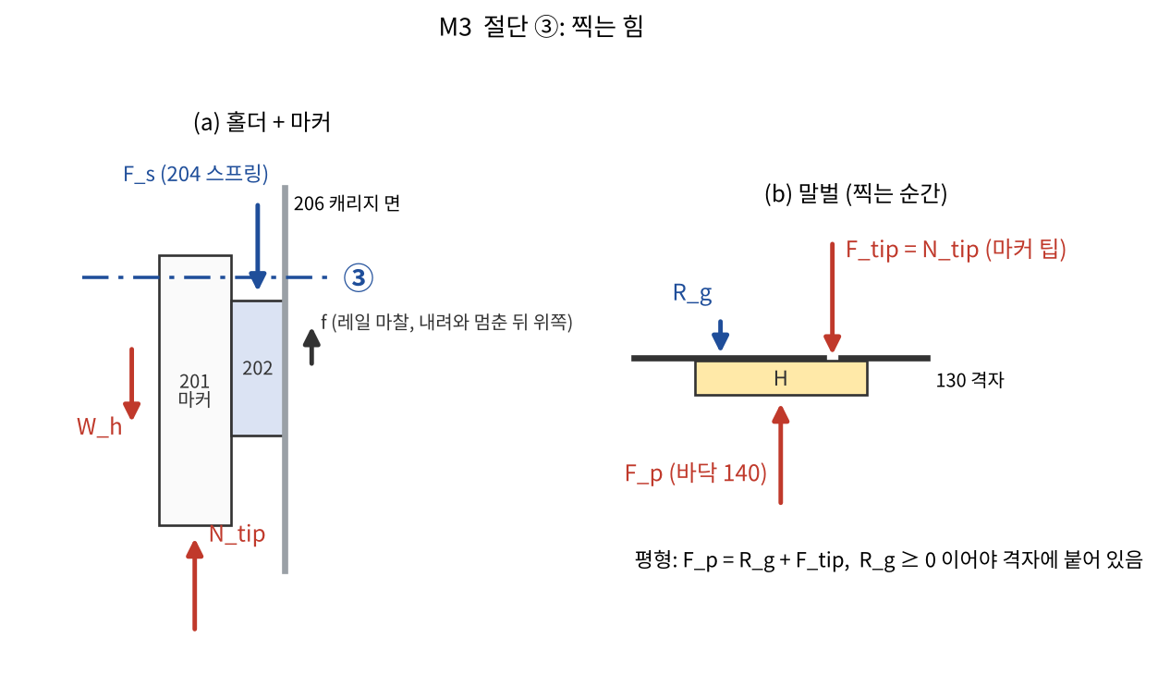
[picture p32: design/img/S4_M3_FBD.png]
M3
① 자유물체도: 

② 문제설정
- **주어진 조건**: 홀더 + 조임 띠 + 마커 무게 W_h = 0.321 N. 스프링 204 힘 F_s (구하는 값의 범위). 레일(캐리지 면) 마찰 f: 홀더 무게중심이 캐리지 면에서 e_h = 13.8 mm 떨어져 레일 법선 짝힘 2 W_h e_h / 30 = 0.296 N → f ≤ 0.3 × 0.296 = **0.089 N**. 홀더가 내려와 멈춘 뒤 f는 위쪽(N_tip을 줄임). 바닥이 말벌을 미는 힘 F_p = 0.5 N (M1과 같은 가정).
- **구하는 값**: 팁 접촉력 N_tip(= F_tip), 말벌이 격자에서 밀려나지 않는 F_s 상한, 바닥 하중 센서가 F_tip을 재는지.
- **가정**: 서보 혼은 탭에서 떨어져 있음(놓은 상태), 말벌은 강체, 팁은 격자 눈을 닿지 않고 통과.

③ 교과서 유제 연계
| 항목 | 내용 |
|---|---|
| 교재명 | Riley·Sturges, *Statics* 2판 — 6장 강체 평형 (2차원) |
| 유제 | **문제 6-49 (p.295~296)** — 300 lb 원기둥(반지름 9 in)을 20° 경사면 위 3 in 높이 턱 너머로 미는 수평력 P |
| 유형 | **접촉 반력이 0이 되는 순간이 한계** (넘어가기 시작: 경사면 반력 A = 0) |
| 유사점 | 원기둥 "A = 0이면 바닥에서 뜸" ↔ 말벌 "R_g = 0이면 격자에서 밀려 내려감". 한쪽 접촉은 밀 수만 있으므로 R ≥ 0이 평형의 조건 |
| 변형 | 한 물체·모멘트 평형 → 두 물체(홀더·말벌)·힘 평형, 한계에서 구하는 값이 "미는 힘 P" → "스프링 힘 F_s 상한" |
| 교재 정답 / 해설집 / AI 재풀이 | 장말 정답 없음 (별표 없는 문제) / **750 lb** / **749.7 lb** (모서리 반력 807.5 lb) |
| 본인 풀이 / 대조 | 서현 대기 / AI–해설집 0.04 % (해설집은 반올림) |

④ 수기 풀이 — **서현 칸 (대기)**. 순서: (a) ΣF_z: N_tip = W_h + F_s − f (0 ≤ f ≤ 0.089) → (b) ΣF_z: F_p = R_g + N_tip → R_g ≥ 0 ⇒ N_tip ≤ F_p ⇒ F_s ≤ F_p − W_h (f = 0일 때가 가장 엄함) → 바닥 힘 F_p는 바닥 위치(스프링 146 압축)로 정해지고 R_g > 0인 동안 N_tip과 무관함을 보임.

⑤ AI 대조와 판정
| 항목 | 내용 |
|---|---|
| AI값 (CAP-AI-19) | 스프링 없이 N_tip = **0.23 ~ 0.32 N** (레일 마찰 0.089 N 범위). 말벌이 격자에 붙어 있으려면 **F_s ≤ 0.18 N**. **바닥 하중 센서는 F_tip을 못 잰다** — F_tip만큼 격자 반력 R_g가 줄 뿐 F_p는 그대로 (F_tip > F_p가 되어 말벌이 밀려 내려갈 때만 바뀜) |
| 수기값 / 상대 차이 | 대기 |
| 최종 채택값 | 잠정 — 스프링 204는 "없음 또는 약한 스프링(≤ 0.18 N)", F_ink 시험 후 결정 |
| 문장 기준 만족 | R_g ≥ 0: 만족 (0.32 < 0.5). R3·R7: **판정 불가** (F_ink·F_harm 미측정) |
| 환류 | ① D5 9-3·10장의 "바닥 하중 센서로 찍는 힘도 잼"은 틀림 → 정정 (D5 11장). ② F_p 상한이 0.32 N보다 작아야 한다면(말벌이 약하면) 홀더 자중 때문에 말벌이 밀려남 → 홀더를 위로 받치는 **역스프링(무게 상쇄)** 이 필요해짐 → F_harm 시험이 설계를 가름. ③ 레일 마찰이 N_tip을 최대 28 % 줄임 → 레일 면을 매끄럽게(또는 PTFE 테이프), F_ink 시험은 실제 홀더로 |

### M4 펜 들기 서보 토크 — 정역학
| 절단 / 떼어 낸 물체 | ④ / 서보 혼 (205) |
|---|---|
| 역학 분야 | 정역학 (모멘트 평형) |
| 검증 대상 | 인터페이스 정의서 구동기 4 (SG90 정지 토크 1.8 kgf·cm = 176.6 N·mm) |

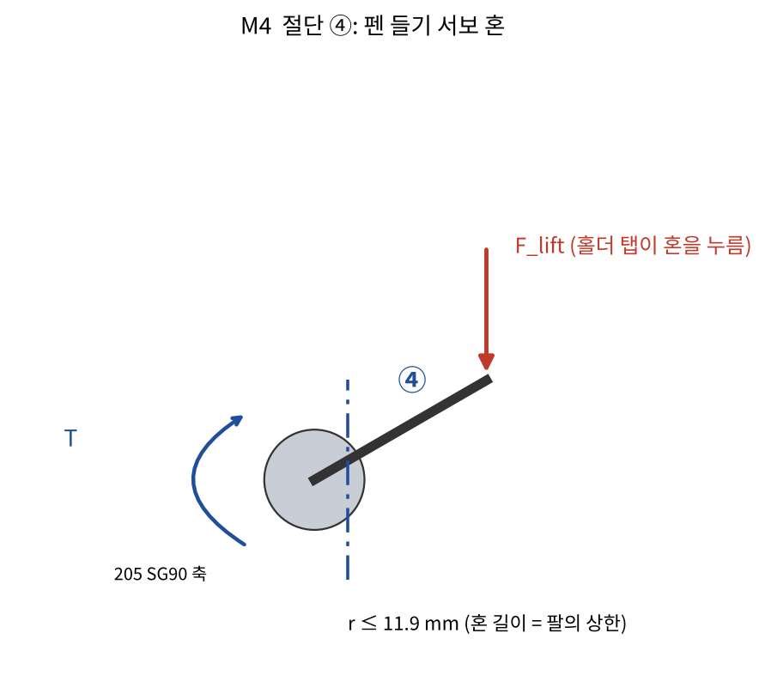
[picture p33: design/img/S4_M4_FBD.png]
M4
① 자유물체도: 

② 문제설정
- **주어진 조건**: 혼 길이 11.9 mm (탭과 닿는 점은 혼 끝보다 안쪽 → **팔 r ≤ 11.9 mm**), 들어 올릴 힘 F_lift = W_h + F_s + f = 0.321 + 0 + 0.089 = **0.410 N** (들어 올릴 때 레일 마찰은 아래로, M3에서 계산).
- **구하는 값**: 필요 토크 T, SG90 기준 안전율, 스프링을 최대(0.18 N)로 넣을 때.
- **가정**: 혼이 수평일 때가 최대 모멘트 팔, 가속 무시.

③ 교과서 유제 연계
| 항목 | 내용 |
|---|---|
| 교재명 | Riley·Sturges, *Statics* 2판 — 6장 강체 평형 (4장 힘의 모멘트 사용) |
| 유제 | **문제 6-41 (p.294)** — 핀 A로 받친 브레이크 페달, C에 30 lb(수평 아래로 30°), B에 수평 Q (C·B는 A에서 가로 4 in, 높이 11·5.5 in) |
| 유형 | 핀에 대한 모멘트 평형 ΣM_A = 0으로 레버의 다른 힘 구하기 |
| 유사점 | 핀(서보 축)을 돌아가는 레버(혼), 한 힘을 알고 다른 쪽을 모멘트로 구함 |
| 변형 | 힘 Q를 구함 → 토크 T를 구함, 비스듬한 힘의 두 성분 → 혼 끝 수직력 하나, 팔 길이는 상한값 |
| 교재 정답 / 해설집 / AI 재풀이 | 장말 정답 없음 / **Q = 62.87 lb, A = 39.82 lb ∠ 22.13°** / Q = 62.87 lb, A = 39.82 lb ∠ 22.13° |
| 본인 풀이 / 대조 | 서현 대기 / AI–해설집 0.01 % |

④ 수기 풀이 — **서현 칸 (대기)**. 순서: N_rail = 2 W_h e_h / h → f = μ N_rail → F_lift → ΣM_O: T = F_lift · r → 안전율 = 176.6 / T.

⑤ AI 대조와 판정
| 항목 | 내용 |
|---|---|
| AI값 (CAP-AI-19) | T ≤ 4.88 N·mm, **안전율 36.2** (r1 38.9 — 마찰을 계산값으로) / 스프링 0.18 N 넣으면 T = 7.0 N·mm, 25.2 |
| 최종 채택값 / 기준 | 잠정 / 만족 — SG90으로 충분 |
| 환류 | 없음 |

### M5 한쪽 구동 X 빔의 끼임 — 정역학(마찰) / 기계요소 (안내 요소 선정)
| 절단 / 떼어 낸 물체 | ⑤ / X 빔 전체 (212 끝 블록 2개 + 207·208·206…) |
|---|---|
| 역학 분야 | 정역학 (마찰, 서랍 끼임 모델) → 기계요소설계 (부싱 선정) |
| 검증 대상 | 흉부 좌표로 정확히 가는가 (e_xy ±1 mm), 모터가 멈추지 않는가 |

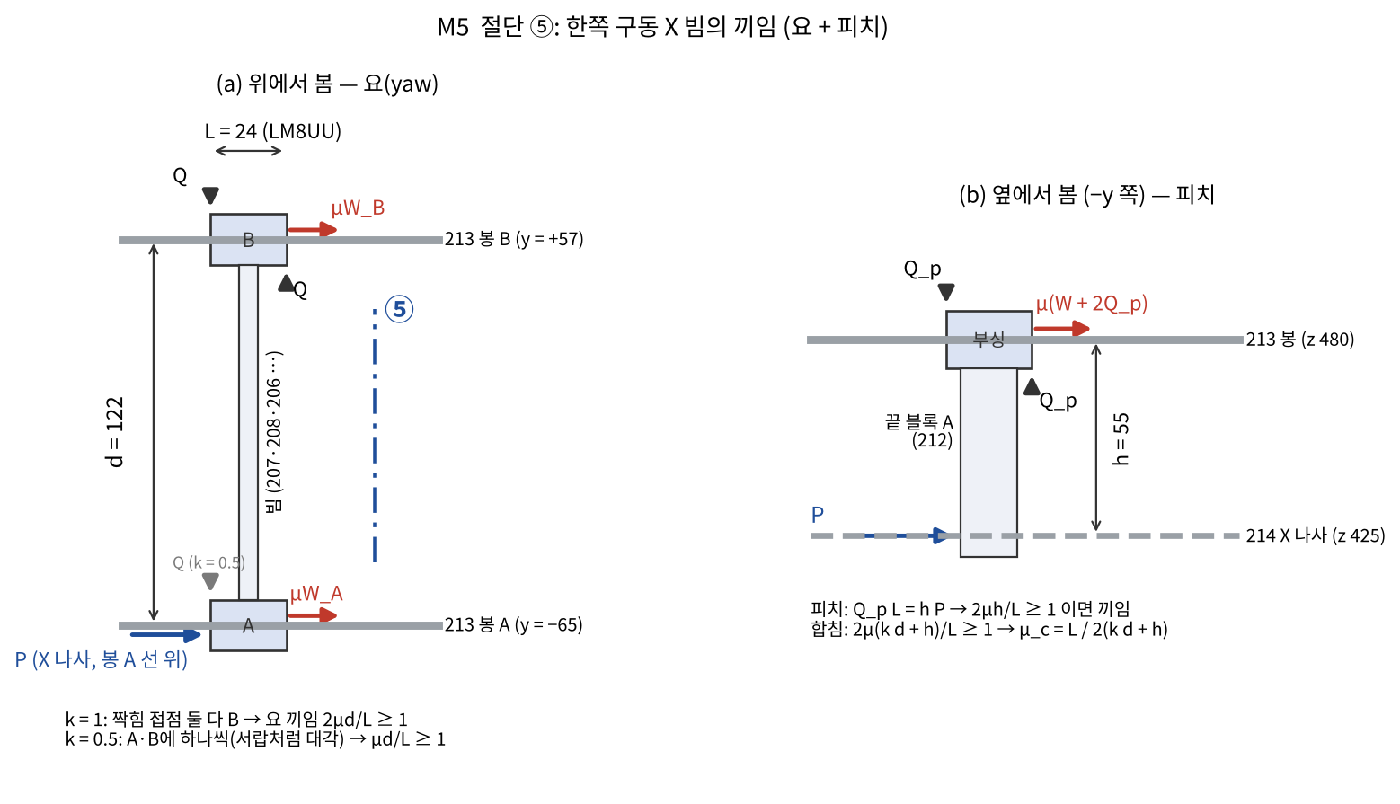
[picture p34: design/img/S4_M5_FBD.png]
M5
① 자유물체도 — (a) 위에서 봄(요), (b) 옆에서 봄(피치): 

② 문제설정
- **주어진 조건**: X 나사 추력 P는 봉 A 선 위(y = −65)에, 봉보다 **h = 55 mm 아래**(z 425 vs 480)에 작용. 먼 봉 B(y = +57)까지 d = 122 mm. 부싱 길이 L = 24 mm (LM8UU, 볼 순환부 유효 길이는 약 17 [추측] — 감도). 마찰계수: PLA 부싱 0.3, 소결 청동 0.15, 직선 볼 부싱 0.005 [가능성 높음]. 빔 무게 W = 3.79 N, B 몫 W_B = 1.49 N.
- **구하는 값**: 빔이 끼이는(아무리 밀어도 안 움직이는) 조건과, 지금 치수에서 각 부싱의 판정.
- **가정**: 마찰 = μ × (법선력 크기의 합) — 실제(벡터 합)보다 크게 잡음. 요 짝힘 접점 중 B에 있는 비율 k: **k = 1** (두 접점 모두 B 부싱 = 보수적), **k = 0.5** (A·B에 하나씩 대각으로 = Riley 9-43 서랍과 같은 꼴). 어느 쪽이 되는지는 부싱 틈새에 달림 → 두 경계를 다 봄.

③ 교과서 유제 연계
| 항목 | 내용 |
|---|---|
| 교재명 | Riley·Sturges, *Statics* 2판 — 9장 마찰 |
| 유제 | **문제 9-43 (p.495)** — 손잡이 하나로 당기는 서랍: 무게 2 lb, 옆면 μ 0.60, 바닥 레일 μ 0.10, 폭 30 in(손잡이는 옆면에서 3 in), 깊이 18 in, 틈 0.75 in |
| 유형 | 치우친 구동력 → 회전 → 대각 두 모서리 측압 → 측압의 마찰이 회전을 더 키움 → 끼임 한계 μ_c = L / (w − 2a_h) |
| 유사점 | 손잡이 = 나사(구동점이 한쪽으로 치우침), 서랍 깊이 = 부싱 길이 L, 옆면 = 봉 |
| 변형 | 손잡이를 옆면 위로(a_h = 0) 옮긴 꼴 → μ_c = L/d (k = 0.5 경계와 같은 식, 스크립트로 확인). 여기에 ① 두 접점이 B 부싱에 몰리는 경우(k = 1) ② 나사 높이 차 h에 의한 피치를 더함 |
| 교재 정답 / 해설집 / AI 재풀이 | 장말 정답 없음 / **P = 1.202 lb** (해설집은 sin θ = 0.75/18로 θ = 2.39°) / 해설집 기하 그대로 1.197 lb, 기울기를 정확히(30 cos θ + 18 sin θ = 30.75 → θ = 2.48°) 1.206 lb, **기울기 무시(θ = 0) 1.000 lb** |
| 본인 풀이 / 대조 | 서현 대기 / 해설집과 −0.4 %·+0.35 % — 해설집 θ 근사와 중간 반올림 영향, 답은 맞음. **기울기를 무시하면 −17 %**: 이 서랍은 한계(μ_c ≈ 0.72~0.75)에 가까워 기하에 민감 → 우리 볼 부싱은 한계의 1/14이라 작은 각 근사로 충분 |

④ 수기 풀이 — **서현 칸 (대기)**. 순서: 미지수 P, Q_p(피치 짝힘), Q_y(요 짝힘) — (1) ΣF_x: P = μ(W + 2Q_p + 2Q_y) + m a (2) ΣM_y(피치): Q_p L = h P (3) ΣM_z(요, A 기준): Q_y L = d μ(W_B + 2k Q_y + 2k Q_p) → 연립의 행렬식이 0이 되는 μ: **μ_c = L / 2(k d + h)** (요만: h = 0 → L/2kd, 피치만: L/2h) → μ < μ_c이면 안전.

⑤ AI 대조와 판정 (값은 2μ(k d + h)/L, 1 이상이면 끼임)
| 경우 | μ | 요 k = 1 (2μd/L) | 요 k = 0.5 (μd/L) | 피치 (2μh/L) | **합침 k = 1** | **합침 k = 0.5** | 판정 |
|---|---|---|---|---|---|---|---|
| PLA 부싱 | 0.30 | 3.05 | 1.53 | 1.38 | **4.43** | **2.90** | 끼임 |
| 소결 청동 | 0.15 | 1.53 | 0.76 | 0.69 | **2.21** | **1.45** | **끼임** (r1은 요만 보고 판정 — k = 0.5면 요만으로는 안 끼지만 피치를 합치면 끼임) |
| LM8UU 볼 부싱 (L 24) | 0.005 | 0.05 | 0.03 | 0.02 | 0.074 | 0.048 | 안전 — μ_c = 0.068 / 0.103, **여유 13.6 / 20.7배** |
| LM8UU (유효 L 17, 감도) | 0.005 | 0.07 | 0.04 | 0.03 | 0.104 | 0.068 | 안전 — μ_c = 0.048, 여유 9.6배 |

| 항목 | 내용 |
|---|---|
| 볼 부싱 추력 | P = 0.032 N (Q_p 0.40 N, Q_y 0.08 N) → T = 0.061 N·mm (M2) |
| 최종 채택값 | 잠정 — **X: LM8UU ×2, Y: LM6UU ×2** (Y는 나사가 두 봉 가운데 z 460·같은 x라 끼임 팔이 0이지만 같은 이유로 볼 부싱 통일) |
| 문장 기준 만족 | 볼 부싱이면 만족 (먼지·윤활 부족으로 μ가 0.04까지 올라도 가장 나쁜 경우 — 유효 길이 17, k = 1 — 에서 안전) |
| 환류 | ② 원인 구분: 설계안 쪽. 모델을 고침 (끝 블록 두께 12 → 18, x 20 → 24, X 봉 y −64/+54 → −65/+57) → 검사 통과 (D5 11장). 승준 구매 목록 C3에 LM8UU 2·LM6UU 2. **r2 추가: 청동 부싱(오일리스)으로 대체 불가** — 볼 부싱이 품절이면 X 나사를 봉 높이로 올리거나(h → 0) 빔 양쪽을 구동해야 함 |

### M6 X 고정 봉 처짐 — 재료역학
| 절단 / 떼어 낸 물체 | ⑥ / X 고정 봉 213 (Ø8 강봉), 참고로 Y 봉 207 (Ø6) |
|---|---|
| 역학 분야 | 재료역학 (보의 처짐·굽힘응력) |
| 검증 대상 | e_xy ±1 mm, 팁 높이 (격자 통과) |

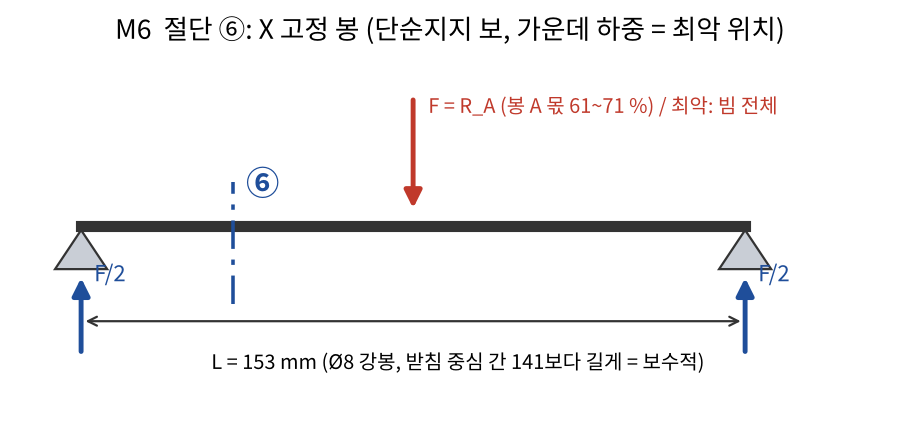
[picture p35: design/img/S4_M6_FBD.png]
M6
① 자유물체도: 

② 문제설정
- **주어진 조건**: X 빔 묶음 무게 3.79 N을 두 봉이 **무게중심 위치대로** 나눔: 봉 A 몫 R_A = 2.30 N(찍기, 61 %) ~ **2.68 N(대기, 71 %)** — Y 모터(37 g)가 봉 A 바깥(y −111)에 있어서. 최악: 한 봉이 3.79 N 전부. 봉 길이 L = 153 mm (받침 중심 간 141보다 길게 = 보수적), Ø8 강봉 E = 200 GPa. Y 봉 Ø6, L 104: 세로 하중 1.16 N(반씩 또는 한 봉이 전부) + 편심 수평 짝힘 0.26 N.
- **구하는 값**: 최대 처짐 δ, 최대 굽힘응력 σ.
- **가정**: 양끝 단순지지·하중이 가운데(움직이는 하중의 최악 위치, 빔 중심 x 63~99가 봉 가운데 95.5를 지남). 실제는 받침에 고정이라 더 작음 → 보수적.

③ 교과서 유제 연계
| 항목 | 내용 |
|---|---|
| 교재명 | Gere·Goodno, *Mechanics of Materials* 9판 SI (Cengage, 2018) — 9.3 처짐 (예제 9-3 식) |
| 유제 | **문제 9.3-1 (p.880)** — IPN 300 강 단순보, L 3 m, 하중 45 kN이 왼쪽에서 2.1 m |
| 유형 | 단순보 집중하중의 최대 처짐·받침 회전각 |
| 유사점 | 단순지지 보 + 집중하중, 같은 식 δ_max = P b (L² − b²)^{3/2} / (9√3 L E I) |
| 변형 | 하중 위치 a = b (가운데 → δ = PL³/48EI, 같은 함수), IPN 300 → Ø8 원형 단면 (I = πd⁴/64), 굽힘응력 σ = M/S 추가 (서현이 푼 5.5-19·5.5-29와 같은 꼴) |
| 교재 정답 / 해설집 / AI 재풀이 | **δ_max 1.04 mm, θ_A 9.4×10⁻⁴ rad** / 해설집은 **미국판 수치**(L 10 ft, P 10 kip, I 285 in⁴, E 29,000 ksi)로 0.0349 in, 7.93×10⁻⁴ rad / AI: SI판 E 200 GPa → 1.036 mm, 9.40×10⁻⁴ rad · 해설집 수치 → 0.03493 in, 7.927×10⁻⁴ rad |
| 본인 풀이 / 대조 | 서현 대기 / AI–정답 −0.4 %·0.02 %, AI–해설집 0.08 %. **주의: SI판 문제에 E가 없음** — 정답은 E = 200 GPa일 때 나오고, 210 GPa로 풀면 −5 %. 해설집은 판이 달라 수치 대조는 식으로만 함 |

④ 수기 풀이 — **서현 칸 (대기)**. 순서: R_A = W (y_B − y_G)/(y_B − y_A) → I = πd⁴/64 → δ = F L³/(48 E I) → M = F L/4 → σ = M/(πd³/32).

⑤ AI 대조와 판정
| 항목 | 내용 |
|---|---|
| AI값 (CAP-AI-19) | X 봉 A (대기): F = 2.68 N, **δ = 0.0050 mm**, σ = 2.04 MPa / 최악(한 봉이 전부): δ = 0.0070 mm, σ = 2.89 MPa / Y 봉 최악: F = 1.19 N, δ = 0.0022 mm, σ = 1.46 MPa |
| 최종 채택값 / 기준 | 잠정 / 만족 — 최악 처짐도 정확도 ±1 mm의 1/140 이하 → **봉 지름을 줄일 여지는 있으나 LM 부싱 규격(Ø8·Ø6)에 맞춰 유지** |
| 환류 | 없음 (과잉 만족 — 규격 부품) |

---

## 교재 유제 대조 대장 (CAP-AI-19, `s4_textbook_check.py`)

해설집: Riley 2판 Instructor's Solutions Manual(같은 판), Meriam 9판 해설집(문제별, 미국판), Gere 9판 해설집 9장(미국판). 문제 원문·해설 그림은 레포에 넣지 않음.

| M | 유제 | 값 | 책 정답 | 해설집 | AI | 차이 | 해설집에서 본 것 |
|---|---|---|---|---|---|---|---|
| M1 | Riley 9-66 | 조이는 모멘트 | 8.59 N·m | 8.592 N·m | 8.592 N·m | 0.02 % | 맞음. 자립 판정(리드각 > 마찰각)도 같음 |
| M2 | Meriam 3/1 | t, x | 1.529 s, 4.59 m | 같음 | 1.529 s, 4.587 m | 0.06 % | 맞음 |
| M2 | Meriam 3/2 | a (P = 0·150·300 N) | −1.118, 0, 2.04 | 같음 | −1.118, 0, 2.040 | 0.03 % | 맞음 |
| M3 | Riley 6-49 | P | — | 750 lb | 749.7 lb | 0.04 % | 맞음 (반올림) |
| M4 | Riley 6-41 | Q, A | — | 62.87, 39.82 lb | 62.87, 39.82 lb | 0.01 % | 맞음 |
| M5 | Riley 9-43 | P | — | 1.202 lb | 1.197 / 1.206 / 1.000 lb | −0.4 / +0.35 / −17 % | θ를 sin θ = 0.75/18로 근사(정확히는 2.48°)하고 중간값을 반올림 — 답에는 0.5 % 미만 영향. 오류 아님 |
| M6 | Gere 9.3-1 | δ_max, θ_A | 1.04 mm, 9.4×10⁻⁴ | (미국판) 0.0349 in, 7.93×10⁻⁴ | 1.036 mm / 0.03493 in | −0.4 % / 0.08 % | 해설집이 다른 판(단위·수치 다름). SI판 문제는 E를 안 줌 → 200 GPa 써야 정답 |

## 검증 대장

| 번호 | 계산 항목 (도면부호·문장) | 수기값 | AI값 (CAP-AI-19) | 차이 | 판정·원인·주체 | 채택값 | 기준 만족 |
|---|---|---|---|---|---|---|---|
| M1 | 승강 나사 토크·자립 (155, F3-1) | 대기 | T 1.75 N·mm, 안전율 19.6(1.8 rpm 기준), 자립 안 함 | — | 잠정 | 1.75 N·mm | 만족 (속도별 토크는 J6) |
| M2 | X·Y 토크, 처리 시간 (208·214, R6) | 대기 | 안전율 ≥ 566, 기구 63.9 s, 급이 상한 105~116 s | — | 잠정 | 급이 ≤ 105 s | **조건부** (건조 시험) |
| M3 | 찍는 힘 (201~204, R3·R7) | 대기 | N_tip 0.23~0.32 N, F_s ≤ 0.18 N, 하중 센서로 못 잼 | — | 잠정 | 스프링 0~0.18 N | 판정 불가 (F_ink·F_harm) |
| M4 | 펜 들기 서보 (205) | 대기 | T 4.88 N·mm, 안전율 36.2 | — | 잠정 | SG90 | 만족 |
| M5 | X 빔 끼임 (212·222) | 대기 | 합침 2μ(kd+h)/L: PLA 4.43·2.90, 청동 2.21·1.45 끼임 / LM8UU 0.074·0.048 | — | 잠정 → 설계 변경 | LM8UU·LM6UU | 만족 (변경 후) |
| M6 | X·Y 봉 처짐 (213·207) | 대기 | δ 0.0050(봉 A) / 최악 0.0070 / Y 0.0022 mm | — | 잠정 | Ø8·Ø6 유지 | 만족 |

## 환류 정리 (S4 → 설계)
1. **안내 요소: 볼 부싱으로 변경** (M5) — 모델 반영·검사 통과. r2: 피치까지 합치면 **청동 부싱도 끼임** → 대체품으로 못 씀
2. **찍는 힘은 수동값, 하중 센서로 못 잼** (M3) — D5 정정, 스프링은 시험 뒤. 레일 마찰이 찍는 힘을 최대 28 % 줄임
3. **R6는 건조 시간이 지배** (M2) — 샤피 노랑 건조 시험이 1순위, 재시도 바닥 내림 10 mm
4. **모터는 28BYJ-48 유지** (M1·M2·M4) — 토크 여유는 크지만 **사양서 토크는 1.8 rpm 값** → J6에서 실제 하중을 걸고 10·15 rpm 확인

## 남은 일
- 서현: ④ 수기 풀이 6개 + ③ "본인 풀이" 칸 (유제 7개 번호 확정: Riley 9-66·6-49·6-41·9-43, Meriam 3/1·3/2, Gere 9.3-1 — 교재·해설집은 서현 PC `Documents\공주대\` 정역학·동역학·고체역학)
- 시험: 건조 시간·F_ink, 28BYJ-48 rpm과 부하 토크(J6), 표본 압축(F_harm)
- 데이터 시트(xlsx) 예제변형·검증대장 시트 입력은 수기 대조 뒤
