britams/-capstone-project-repo/design/circuit/out/harness_table.md

| 번호 | 어디 → 어디 | 선 (색·굵기) | 시작 핀 → 끝 핀 | 자를 길이 | 양 끝 | 움직임 |
|---|---|---|---|---|---|---|
| P01 | 어댑터 DC 잭 → 퓨즈 | +5V 들어옴 (빨강, 20 AWG) | 잭 + → 퓨즈 1 | 160 mm | DC 잭 단자 납땜/나사 / 퓨즈홀더 납땜 |  |
| P02 | 어댑터 DC 잭 GND → 와고 GND | GND (검정, 20 AWG) | 잭 − → 와고 GND 1번 | 370 mm | DC 잭 단자 납땜/나사 / 와고 221-415 (선 끝 8 mm 벗김) |  |
| P03 | 퓨즈 → 비상 정지 | +5V 퓨즈 뒤 (빨강, 20 AWG) | 퓨즈 2 → 비상 정지 NC 1 | 120 mm | 퓨즈홀더 납땜 / 비상 정지 나사 단자 |  |
| P04 | 비상 정지 → 와고 +5V | +5V_B (빨강, 20 AWG) | NC 2 → 와고 +5V 1번 | 410 mm | 비상 정지 나사 단자 / 와고 221-415 (선 끝 8 mm 벗김) |  |
| P05 | 와고 → DRV8833 F | +5V_B (빨강, 22 AWG)<br>GND (검정, 22 AWG) | 와고 +5V → DRV VM<br>와고 GND → DRV GND | 180 mm | 와고 221-415 (선 끝 8 mm 벗김) / 듀폰 암 (ULN 전원 핀) |  |
| P06 | 와고 → ULN2003 X | +5V_B (빨강, 22 AWG)<br>GND (검정, 22 AWG) | 와고 +5V → ULN +<br>와고 GND → ULN − | 700 mm | 와고 221-415 (선 끝 8 mm 벗김) / 듀폰 암 (ULN 전원 핀) |  |
| P07 | 와고 → ULN2003 Y | +5V_B (빨강, 22 AWG)<br>GND (검정, 22 AWG) | 와고 +5V → ULN +<br>와고 GND → ULN − | 770 mm | 와고 221-415 (선 끝 8 mm 벗김) / 듀폰 암 (ULN 전원 핀) |  |
| P08 | 와고 → 서보 허브 | +5V_B (빨강, 20 AWG)<br>GND (검정, 20 AWG) | 와고 +5V → 허브 +<br>와고 GND → 허브 − | 260 mm | 와고 221-415 (선 끝 8 mm 벗김) / 허브 기판 납땜 |  |
| P09 | 와고 → 게이트 허브 | +5V_B (빨강, 22 AWG)<br>GND (검정, 22 AWG) | 와고 +5V → 허브 +<br>와고 GND → 허브 − | 280 mm | 와고 221-415 (선 끝 8 mm 벗김) / 허브 기판 납땜 |  |
| P10 | 와고 → MOSFET 보드 (조명·펌프 전원) | +5V_B (빨강, 22 AWG)<br>GND (검정, 22 AWG) | 와고 +5V → 보드 V+<br>와고 GND → 보드 GND | 350 mm | 와고 221-415 (선 끝 8 mm 벗김) / 보드 나사 단자 |  |
| P11 | UNO 1·2 GND → 와고 GND | GND U1 (검정, 22 AWG)<br>GND U2 (검정, 22 AWG) | UNO 1 GND → 와고 GND<br>UNO 2 GND → 와고 GND | 210 mm | 듀폰 암 1핀 (UNO 헤더) / 와고 221-415 (선 끝 8 mm 벗김) |  |
| P12 | 레일 감지 (+5V_B → 10 kΩ → UNO 2 D2) | RAIL (주황, 28 AWG) | 허브 10 kΩ 끝 → UNO 2 D2 | 160 mm | 허브 기판 납땜 / 듀폰 암 1핀 (UNO 헤더) |  |
| S01 | UNO 1 → DRV8833 F (AIN1·AIN2·BIN1·BIN2) | IN1 (파랑, 26 AWG)<br>IN2 (초록, 26 AWG)<br>IN3 (노랑, 26 AWG)<br>IN4 (주황, 26 AWG) | D2 → AIN1<br>D3 → AIN2<br>D4 → BIN1<br>D5 → BIN2 | 280 mm | 듀폰 암 1핀 (UNO 헤더) / 듀폰 암 (ULN IN 핀) |  |
| S02 | UNO 1 → ULN2003 X (IN1~4) | IN1 (파랑, 26 AWG)<br>IN2 (초록, 26 AWG)<br>IN3 (노랑, 26 AWG)<br>IN4 (주황, 26 AWG) | D6 → IN1<br>D7 → IN2<br>D8 → IN3<br>D9 → IN4 | 790 mm | 듀폰 암 1핀 (UNO 헤더) / 듀폰 암 (ULN IN 핀) |  |
| S03 | UNO 1 → ULN2003 Y (IN1~4) | IN1 (파랑, 26 AWG)<br>IN2 (초록, 26 AWG)<br>IN3 (노랑, 26 AWG)<br>IN4 (주황, 26 AWG) | D10 → IN1<br>D11 → IN2<br>D12 → IN3<br>D13 → IN4 | 860 mm | 듀폰 암 1핀 (UNO 헤더) / 듀폰 암 (ULN IN 핀) |  |
| M01 | DRV8833 F → 바닥 리니어 모듈 | 모터 4선 (모듈에 달린 선) (빨강·흰·갈색·검정, 28 AWG) | DRV AOUT1·2 BOUT1·2 → 모터 A A− B B− | 기본 240 (연장 없음) | JST-XH 5핀 (모터 기본) / 모터 (기본) |  |
| M02 | ULN2003 X → X 모터 215 | 모터 5선 (파랑·분홍·노랑·주황·빨강, 26 AWG) | ULN JST-XH 5 → 모터 | 기본 240 (연장 없음) | JST-XH 5핀 / 모터 (기본) |  |
| M03 | ULN2003 Y → Y 모터 209 (X로 움직임) | 모터 5선 (파랑·분홍·노랑·주황·빨강, 26 AWG) | ULN JST-XH 5 → 모터 | 기본 240 + 연장 180 | JST-XH 5핀 / 모터 (기본) | 휨 고리 |
| V01 | 서보 허브 → 펜 서보 SG90 205 (X·Y로 움직임) | 서보 3선 (갈색 GND·빨강 +5V·주황 신호, 26 AWG) | 허브 헤더 S1 → 서보 | 기본 250 + 연장 500 | 듀폰 2.54 헤더 (허브 기판) / 서보 3핀 (기본) | 휨 고리 |
| S04 | UNO 1 A0 → 서보 허브 S1 신호 | PEN 신호 (주황, 26 AWG) | A0 → 허브 S1 신호 | 350 mm | 듀폰 암 1핀 (UNO 헤더) / 허브 기판 납땜 |  |
| S05 | UNO 1 → 누름 스위치 PSW (바닥과 함께 움직임, NC) | PSW (흰색, 28 AWG)<br>GND (검정, 28 AWG) | A1 → NC<br>GND → COM | 510 mm | 듀폰 암 1핀 (UNO 헤더) / 스위치 다리 납땜 + 수축튜브 | 휨 고리 |
| S06 | UNO 1 → 원점 F | HOME_F (노랑, 28 AWG)<br>GND (검정, 28 AWG) | A3 → 스위치 NO<br>GND → 스위치 COM | 380 mm | 듀폰 암 1핀 (UNO 헤더) / 스위치 납땜 + 100 nF |  |
| S07 | UNO 1 → 원점 X | HOME_X (노랑, 28 AWG)<br>GND (검정, 28 AWG) | A4 → 스위치 NO<br>GND → 스위치 COM | 640 mm | 듀폰 암 1핀 (UNO 헤더) / 스위치 납땜 + 100 nF |  |
| S08 | UNO 1 → 원점 Y (빔과 함께 움직임) | HOME_Y (노랑, 28 AWG)<br>GND (검정, 28 AWG) | A5 → 스위치 NO<br>GND → 스위치 COM | 730 mm | 듀폰 암 1핀 (UNO 헤더) / 스위치 납땜 + 100 nF | 휨 고리 |
| V02 | 서보 허브 → 입구 문 서보 112 | 서보 3선 (갈색·빨강·주황, 26 AWG) | 허브 S2 → 서보 | 기본 250 + 연장 120 | 듀폰 2.54 헤더 (허브 기판) / 서보 3핀 (기본) |  |
| V03 | 서보 허브 → 격리 문 서보 170 | 서보 3선 (갈색·빨강·주황, 26 AWG) | 허브 S3 → 서보 | 기본 250 + 연장 160 | 듀폰 2.54 헤더 (허브 기판) / 서보 3핀 (기본) |  |
| V04 | 서보 허브 → 방생 문 서보 176 | 서보 3선 (갈색·빨강·주황, 26 AWG) | 허브 S4 → 서보 | 기본 250 + 연장 240 | 듀폰 2.54 헤더 (허브 기판) / 서보 3핀 (기본) |  |
| S09 | UNO 2 D9·D10·D11 → 서보 허브 S2~S4 신호 | DOOR_IN (주황, 26 AWG)<br>DOOR_CAP (주황, 26 AWG)<br>DOOR_REL (주황, 26 AWG) | D9 → 허브 S2<br>D10 → 허브 S3<br>D11 → 허브 S4 | 370 mm | 듀폰 암 1핀 (UNO 헤더) / 허브 기판 납땜 |  |
| S10 | UNO 2 → 게이트 허브 (수신 9 + 송신 켜기 1) | G2 (흰색, 28 AWG)<br>G2b (흰색, 28 AWG)<br>G3 (흰색, 28 AWG)<br>G3b (흰색, 28 AWG)<br>G5 (흰색, 28 AWG)<br>G5b (흰색, 28 AWG)<br>G1 (흰색, 28 AWG)<br>G4 (흰색, 28 AWG)<br>G6 (흰색, 28 AWG)<br>EMIT_EN (보라, 28 AWG) | A0 → 허브 G2<br>A1 → 허브 G2b<br>A2 → 허브 G3<br>A3 → 허브 G3b<br>A4 → 허브 G5<br>A5 → 허브 G5b<br>D7 → 허브 G1<br>D8 → 허브 G4<br>D12 → 허브 G6<br>D4 → 허브 Q4 TRIG | 160 mm | 듀폰 암 1핀 (UNO 헤더) / 허브 기판 납땜 |  |
| G01 | 게이트 허브 → 통로 빛 게이트 G1 (Adafruit 2167: 송신 2선 + 수신 3선) | 송신 +5V (빨강, 28 AWG)<br>송신 GND(켜기) (검정, 28 AWG)<br>수신 +5V (빨강, 28 AWG)<br>수신 GND (검정, 28 AWG)<br>수신 신호 (흰색, 28 AWG) | 허브 TX+ → 송신 빨강<br>허브 Q4 OUT− → 송신 검정<br>허브 RX+ → 수신 빨강<br>허브 GND → 수신 검정<br>허브 G1 (10 kΩ 풀업) → 수신 흰색 | 기본 230 + 연장 20 | 듀폰 2.54 헤더 (허브 기판) / 게이트 기본 선 + 연장 (납땜 + 수축튜브) |  |
| G02 | 게이트 허브 → 통로 빛 게이트 G4 (Adafruit 2167: 송신 2선 + 수신 3선) | 송신 +5V (빨강, 28 AWG)<br>송신 GND(켜기) (검정, 28 AWG)<br>수신 +5V (빨강, 28 AWG)<br>수신 GND (검정, 28 AWG)<br>수신 신호 (흰색, 28 AWG) | 허브 TX+ → 송신 빨강<br>허브 Q4 OUT− → 송신 검정<br>허브 RX+ → 수신 빨강<br>허브 GND → 수신 검정<br>허브 G4 (10 kΩ 풀업) → 수신 흰색 | 기본 230 + 연장 410 | 듀폰 2.54 헤더 (허브 기판) / 게이트 기본 선 + 연장 (납땜 + 수축튜브) |  |
| G03 | 게이트 허브 → 통로 빛 게이트 G6 (Adafruit 2167: 송신 2선 + 수신 3선) | 송신 +5V (빨강, 28 AWG)<br>송신 GND(켜기) (검정, 28 AWG)<br>수신 +5V (빨강, 28 AWG)<br>수신 GND (검정, 28 AWG)<br>수신 신호 (흰색, 28 AWG) | 허브 TX+ → 송신 빨강<br>허브 Q4 OUT− → 송신 검정<br>허브 RX+ → 수신 빨강<br>허브 GND → 수신 검정<br>허브 G6 (10 kΩ 풀업) → 수신 흰색 | 기본 230 + 연장 300 | 듀폰 2.54 헤더 (허브 기판) / 게이트 기본 선 + 연장 (납땜 + 수축튜브) |  |
| G04 | 게이트 허브 → 문 빔 G2 (낱개: IR LED 2선 + 포토TR 2선, 220 Ω·10 kΩ는 허브에) | LED +(220 Ω 뒤) (빨강, 28 AWG)<br>LED −(켜기) (검정, 28 AWG)<br>포토TR C (빨강, 28 AWG)<br>포토TR E(신호) (흰색, 28 AWG) | 허브 R220 끝 → LED 긴 다리 A<br>허브 Q4 OUT− → LED 짧은 다리 K<br>허브 +5V → 포토TR 컬렉터<br>허브 G2 (10 kΩ → GND) → 포토TR 이미터 | 400 mm | 듀폰 2.54 헤더 (허브 기판) / LED·포토TR 다리 납땜 + 수축튜브 |  |
| G05 | 게이트 허브 → 문 빔 G2b (낱개: IR LED 2선 + 포토TR 2선, 220 Ω·10 kΩ는 허브에) | LED +(220 Ω 뒤) (빨강, 28 AWG)<br>LED −(켜기) (검정, 28 AWG)<br>포토TR C (빨강, 28 AWG)<br>포토TR E(신호) (흰색, 28 AWG) | 허브 R220 끝 → LED 긴 다리 A<br>허브 Q4 OUT− → LED 짧은 다리 K<br>허브 +5V → 포토TR 컬렉터<br>허브 G2b (10 kΩ → GND) → 포토TR 이미터 | 410 mm | 듀폰 2.54 헤더 (허브 기판) / LED·포토TR 다리 납땜 + 수축튜브 |  |
| G06 | 게이트 허브 → 문 빔 G3 (낱개: IR LED 2선 + 포토TR 2선, 220 Ω·10 kΩ는 허브에) | LED +(220 Ω 뒤) (빨강, 28 AWG)<br>LED −(켜기) (검정, 28 AWG)<br>포토TR C (빨강, 28 AWG)<br>포토TR E(신호) (흰색, 28 AWG) | 허브 R220 끝 → LED 긴 다리 A<br>허브 Q4 OUT− → LED 짧은 다리 K<br>허브 +5V → 포토TR 컬렉터<br>허브 G3 (10 kΩ → GND) → 포토TR 이미터 | 450 mm | 듀폰 2.54 헤더 (허브 기판) / LED·포토TR 다리 납땜 + 수축튜브 |  |
| G07 | 게이트 허브 → 문 빔 G3b (낱개: IR LED 2선 + 포토TR 2선, 220 Ω·10 kΩ는 허브에) | LED +(220 Ω 뒤) (빨강, 28 AWG)<br>LED −(켜기) (검정, 28 AWG)<br>포토TR C (빨강, 28 AWG)<br>포토TR E(신호) (흰색, 28 AWG) | 허브 R220 끝 → LED 긴 다리 A<br>허브 Q4 OUT− → LED 짧은 다리 K<br>허브 +5V → 포토TR 컬렉터<br>허브 G3b (10 kΩ → GND) → 포토TR 이미터 | 440 mm | 듀폰 2.54 헤더 (허브 기판) / LED·포토TR 다리 납땜 + 수축튜브 |  |
| G08 | 게이트 허브 → 문 빔 G5 (낱개: IR LED 2선 + 포토TR 2선, 220 Ω·10 kΩ는 허브에) | LED +(220 Ω 뒤) (빨강, 28 AWG)<br>LED −(켜기) (검정, 28 AWG)<br>포토TR C (빨강, 28 AWG)<br>포토TR E(신호) (흰색, 28 AWG) | 허브 R220 끝 → LED 긴 다리 A<br>허브 Q4 OUT− → LED 짧은 다리 K<br>허브 +5V → 포토TR 컬렉터<br>허브 G5 (10 kΩ → GND) → 포토TR 이미터 | 520 mm | 듀폰 2.54 헤더 (허브 기판) / LED·포토TR 다리 납땜 + 수축튜브 |  |
| G09 | 게이트 허브 → 문 빔 G5b (낱개: IR LED 2선 + 포토TR 2선, 220 Ω·10 kΩ는 허브에) | LED +(220 Ω 뒤) (빨강, 28 AWG)<br>LED −(켜기) (검정, 28 AWG)<br>포토TR C (빨강, 28 AWG)<br>포토TR E(신호) (흰색, 28 AWG) | 허브 R220 끝 → LED 긴 다리 A<br>허브 Q4 OUT− → LED 짧은 다리 K<br>허브 +5V → 포토TR 컬렉터<br>허브 G5b (10 kΩ → GND) → 포토TR 이미터 | 520 mm | 듀폰 2.54 헤더 (허브 기판) / LED·포토TR 다리 납땜 + 수축튜브 |  |
| S11 | UNO 2 D3·D5 → MOSFET 보드 (조명 켜기) | L_TOP (노랑, 26 AWG)<br>L_BOT (노랑, 26 AWG) | D3 → Q1 TRIG<br>D5 → Q2 TRIG | 230 mm | 듀폰 암 1핀 (UNO 헤더) / 보드 핀 |  |
| L01 | MOSFET → 위 조명 182 | +5V (빨강, 24 AWG)<br>Q1 OUT− (검정, 24 AWG) | 보드 V+ → 조명 +<br>Q1 OUT− → 조명 − | 770 mm | 보드 나사 단자 / 조명 납땜 |  |
| L02 | MOSFET → 아래 조명 | +5V (빨강, 24 AWG)<br>Q2 OUT− (검정, 24 AWG) | 보드 V+ → 조명 +<br>Q2 OUT− → 조명 − | 470 mm | 보드 나사 단자 / 조명 납땜 |  |
| S12 | UNO 2 D6 → MOSFET 보드 (급이 펌프 켜기) | PUMP (노랑, 26 AWG) | D6 → Q3 TRIG | 230 mm | 듀폰 암 1핀 (UNO 헤더) / 보드 핀 |  |
| L03 | MOSFET → 급이 펌프 144p (프레임 밖, 다이오드 1N5819를 펌프 다리에) | +5V (빨강, 22 AWG)<br>Q3 OUT− (검정, 22 AWG) | 보드 V+ → 펌프 +<br>Q3 OUT− → 펌프 − | 600 mm | 보드 나사 단자 / 펌프 납땜 + 수축튜브 |  |
| S13 | J_I2C → Pi I2C (배터리 상자 INA226, 콘센트일 때는 비어 있음) | 3.3V (빨강, 28 AWG)<br>GND (검정, 28 AWG)<br>SDA (파랑, 28 AWG)<br>SCL (노랑, 28 AWG) | J_I2C 1 VS → Pi 핀 1 (3V3)<br>J_I2C 2 GND → Pi 핀 6 (GND)<br>J_I2C 3 SDA → Pi 핀 3 (GPIO2)<br>J_I2C 4 SCL → Pi 핀 5 (GPIO3) | 610 mm | JST XH 4P 하우징 (193j에 꽂음) / 듀폰 암 1핀 (Pi 헤더) |  |

**사서 쓰는 케이블 길이 확인** (경로 + 10 %)

| 케이블 | 필요 | 있음(산 것) | 판단 |
|---|---|---|---|
| Pi USB → UNO 1 (USB A–B) | 680 mm | 1000 mm | 충분 |
| Pi USB → UNO 2 (USB A–B) | 650 mm | 1000 mm | 충분 |
| Pi CAM0 → AI 카메라 (22↔15핀 FFC) | 330 mm | 300 mm | **모자람** |
