britams/-capstone-project-repo/ai-log/AI_명령사항_로그.md

# 캡스톤(말벌 자동 마킹 트랩) AI 명령사항 로그

위치: `C:\Users\Seohyun_Lee\Desktop\capstone design_이서현\AI로그\AI_명령사항_로그.md`
목적: 서현이 AI에게 내린 명령과 AI가 한 일을 날짜순으로 남긴다. 보고서의 AI 활용 기록(시스템설계및제어 양식 B 형식)으로 옮겨 쓸 수 있게 한다.

## 이 파일을 쓰는 규칙 (AI가 지킬 것)
1. **세션마다 맨 아래에 새 항목을 추가한다.** 이전 항목은 고치거나 지우지 않는다 (틀린 내용이 있으면 새 항목에서 정정한다).
2. 번호는 `CAP-AI-nn`으로 이어서 붙인다. 시스템설계및제어 수업의 `AI-n` 번호와 섞지 않는다.
3. 항목마다 적을 것: 날짜 · 도구(모델) · 서현의 명령(원문 요지) · AI가 한 일 · 만든/고친 파일 · 검증한 것과 못 한 것 · 남은 결정.
4. 설계값·문장·도면부호에 AI 결과를 반영하면 그 자리에 `(CAP-AI-nn)`을 붙인다. 검증하지 못한 값은 `미검증`으로 표시한다.
5. 세션이 끝나기 전에 반드시 이 파일을 갱신한다.

## 기록 이전 작업 (회고)
- 2026-10-11 보고서용 정리 폴더(`나중 보고서를 위한 정리`)의 md·PDF와 10/12 보고 PPT는 Claude와 함께 정리함. 대화 원문은 이 폴더에 없음.
- 2026-10-26 보고 PPT(`모든자료정리\10월26일_창의적종합설계1_초벌_10.26.pptx`)와 FreeCAD 개념 모델(`말벌트랩_마킹모듈_개념.FCStd`)도 AI와 작업한 것으로 보이나, 어느 대화에서 했는지 기록 없음 → 서현 확인 필요.

---

## CAP-AI-01 · 2026-10-22
- 도구: Claude (Claude 앱, 서현 PC 연결)
- 명령: "사용량이 거의 다 돼서, 다른 채팅에서 시작할 수 있도록 md 파일을 만들어 줘. 할 일은 추상적인 아이디어를 구체적으로 설계하는 것."
- AI가 한 일: `capstone design_이서현` 폴더 전체 목록 확인, 보고서용 정리 md 6개·10/12 보고 PDF·3D프린터 안내 캡처를 읽고 인수인계 문서 작성
- 만든 파일: `00_새채팅_인수인계_2026-10-22.md`
- 검증: 폴더 원본 파일 내용과 대조함. 10/26 보고 이전이라 A안 터널형은 반영 안 됨
- 남은 결정: 과제명 '형광분말' 문구, 여왕벌 격리부 구조, 한 색 vs 개체별 색, 피스톤 정지 판단, 먹이

## CAP-AI-02 · 2026-10-28
- 도구: Claude (Claude 앱, 서현 PC 연결)
- 명령 (요지):
  1. `AI로그` 폴더에 AI 명령사항 md를 만들고 계속 갱신할 것
  2. 이제 할 일: ① 설계 및 역학계산 ② VespAI 오픈소스를 받아와 실행 ③ 필요한 물품 구매
  3. `capstone design_이서현` 폴더 전체를 보고 정리하고, 새 채팅에 붙여 넣으면 바로 이어서 실행되는 '자동차 키' 같은 md 파일을 만들 것
  4. 설계는 FreeCAD로 함. 설계를 어떻게 제대로 할지 아직 정하지 못함. 위 명령을 다 하고 ①부터 같이 시작
  5. 3D 프린터는 문의하면 사용 가능 (10/29 신청서 기한 문제 해소)
- AI가 한 일:
  - 폴더 재확인 → 10/22 이후 새 자료 2개 발견: `모든자료정리\10월26일_창의적종합설계1_초벌_10.26.pptx` (16장), `교수님 피드백\10월2일_회신메일.pdf` (팀이 최문보 교수님께 보낸 2차 문의 메일)
  - 10/26 보고 내용 정리: 유인·진입부 4단 구조(600번대 부호), 1안(챔버 + XY 이송)의 문제, A안 터널형 추천, B안 제네바 원판, 제어·비전 분담, 시제품 P1~P3 계획
  - 시스템설계및제어 수업의 S4 역학계산 워크시트·작성 예시·제출 안내 확인 (4-1 외력 → 4-2 가상 절단 → 4-3 자유물체도·유제 연계·수기 풀이·AI 대조 2%)
  - VespAI 논문(O'Shea-Wheller 외 2024)과 공개 저장소 정보 확인
  - FreeCAD MCP 상태 확인 → 응답 없음 (FreeCAD가 꺼져 있거나 MCP 애드온이 실행 중이 아님)
- 만든 파일:
  - `AI로그\AI_명령사항_로그.md` (이 파일)
  - `00_새채팅_인수인계_2026-10-28.md` (10/26 내용 반영한 현재 상태)
  - `00_새채팅_시작키.md` (새 채팅에 붙여 넣는 실행용 프롬프트)
- 검증:
  - 10/26 PPT 텍스트·그림을 직접 읽어 반영함
  - 10/26 FreeCAD 모델 파일 위치 확인 못 함 — PPT에는 `문서 › 말벌트랩_개념설계`로 적혀 있으나 `C:\Users\Seohyun_Lee\Documents` 바로 아래에 그 폴더가 없음 → 서현 확인 필요
  - VespAI 공식 저장소 주소 미검증 (확인된 페이지: hiveeyes/vespai 미러)
- 남은 결정 (①설계 시작에 필요한 것): 주 구조 A안 확정 여부, FreeCAD 모델 위치, 역학계산을 수업 S4 양식으로 할지, 설치 방식(매달기/세우기), 표본 확보 상태

## CAP-AI-03 · 2026-10-28
- 도구: Claude (Claude 앱, 서현 PC 연결)
- 서현 답변·명령:
  1. A안 아님. 10/26 설계는 발표용으로 대충 만든 것이라 **설계를 완전히 다시 함. 10/26 발표자료는 제외하고 생각할 것**
  2. `지금가지고 있는 물품` 폴더를 추가했으니 무엇을 어떻게 활용할지 생각할 것
  3. 역학계산은 수업 S4 양식
  4. 설치는 **평평한 바닥에 놓는 방식**, 이번에 준 **상용 말벌 트랩을 참고**해 설계
  5. 표본 확보 방법 없음
  6. (작업 중 추가) 팀원 이승준(Claude 구독)과 효율적으로 분업하는 계획을 짤 것
- AI가 한 일:
  - 보유품 사진 14장·스캔 3장을 변환해 판독: Pi 5 4GB, AI HAT+ 26 TOPS, AI 카메라(IMX500), Pi 4B, Pi 3B, 아두이노 UNO 여러 개, 학습 키트, 릴레이, 상용 트랩 「야생 말벌 포획기」((주)야생) 실물·설명서
  - 상용 트랩 설명서 분석 (구조, 빛 광도차 원리, 꿀벌 탈출망, 설치 높이 20~25 cm, 자갈로 전도 방지, 새벽 포획, 냉동 기절, 특허 2건)
  - 재설계 절차 D0~D8 제안 (요구사항 → 기능 시퀀스 → 형태분석표 → 조합·평가 → 개념설계도 → 변수표·S4 → FreeCAD → BOM). 요구사항·형태분석표는 초안만, 선택은 팀이
  - 레트로핏 모듈 vs 새 트랩 비교 (판단은 팀 결정으로 남김)
  - 분업 계획: 서현 = 기구 설계·역학계산·문서, 승준 = VespAI·비전·전자·구매, 인터페이스 정의서로 경계 관리, 2주 일정(11/9 보고 가정)
- 만든 파일: `설계\2026-10-28_D0_재설계_전제와_절차.md`, `설계\인터페이스_정의서.md`(틀), `지금가지고 있는 물품\2026-10-28_보유물품_목록과_활용계획.md`, `2026-10-28_분업계획_서현_승준.md`, `AI로그\AI_명령사항_로그_승준.md`(틀)
- 고친 파일: `00_새채팅_시작키.md`(서현·승준 공용, 이름별 로그), `00_새채팅_인수인계_2026-10-28.md`(10/26 폐기·재설계 반영해 다시 씀)
- 검증: 보유품 모델 중 Pi 5·AI HAT+(26 TOPS)·AI 카메라·릴레이는 상자·라벨로 확인. Pi 4B·3B, 서보·스테핑 모터 종류·수량은 사진 판단(미검증). 상용 트랩 내용은 설명서 원문 그대로
- 남은 결정: 10/11 결정 유지 여부, (가) 레트로핏 vs (나) 새 트랩, D1 목표값, 표본 경로, 승준과 폴더 공유 방법·회의 일정·보고일, 승준 역할 동의

## CAP-AI-04 · 2026-10-28
- 도구: Claude (Claude 앱, 서현 PC 연결)
- 서현 결정·명령:
  1. 구조 방향: **상용 트랩에 얹는 추가 모듈(레트로핏)** 확정
  2. 공유: FreeCAD는 MCP로, 팀 공유는 Git. 레포는 서현 계정으로 생성 — https://github.com/britams/-capstone-project-repo
  3. 승준은 Git·GitHub를 써 본 적 없음 → 사용법을 공유해야 함. 설치(다운로드) 없이 Chrome에서 사용
- AI가 한 일:
  - Git 사용 시 문제 2가지 지적: ① .FCStd는 압축 파일이라 Git 병합 불가 → 모델을 Python 생성 스크립트로 만들어 함께 올리고 .FCStd는 서현만 편집 ② 논문 PDF(저작권)·대용량 PPT(최대 112 MB, GitHub 한도 100 MB)·개인정보 파일은 올리지 않음
  - 레포 상태 확인: **공개(Public)**, LICENSE(MIT)·README.md(팀원 3명 표기 — 이서현·이승준·타이린, 구글 슬라이드 링크)만 있음
  - Claude 세션에 레포 연결 시도 → 실패 (서현 GitHub 계정이 Claude에 연결되지 않음). 그래서 Chrome 업로드용 `repo\` 폴더를 서현 PC에 만듦
  - Chrome 전용 GitHub 사용법 작성 (가입·초대, 보기, 고치기, 올리기, 내려받기, Claude와 같이 쓰기, 올리면 안 되는 것, 충돌 규칙, 폴더 구조)
  - 레포 폴더 구조 제안: docs / ai-log / design / cad / vision / control / purchase / inventory, `.gitignore`
  - 시작키를 레포 기준으로 다시 씀 (서현·승준 공용, GitHub 연결 여부별 동작)
  - D0에 레트로핏 확정(C9) 반영, 인수인계·분업계획·보유물품 문서의 경로를 레포 기준으로 바꿈
- 만든 파일 (서현 PC `capstone design_이서현\repo\` = 레포 구조 사본): `docs/GitHub_사용법_Chrome.md`, `docs/00_새채팅_시작키.md`, `docs/00_새채팅_인수인계_2026-10-28.md`, `docs/2026-10-28_분업계획_서현_승준.md`, `ai-log/` 2개, `design/` 2개, `inventory/` 1개, `cad|vision|control|purchase/README.md`, `.gitignore`
- 고친 파일: 서현 PC `00_새채팅_시작키.md`(레포 사본으로 교체), `AI로그\` 2개(레포와 같게)
- 검증: 레포 공개 여부·파일 목록은 GitHub 페이지로 확인. 기존 README 원문은 가져오지 못함 → `repo\`에 README.md를 넣지 않음 (덮어쓰기 방지). 브라우저 업로드 25 MB 한도는 GitHub 안내 기준 [확실]
- 작업 중 확인: 서현 PC 폴더 이름이 `capstone design` → **`capstone design_이서현`** 으로 바뀜 → 모든 문서의 경로를 새 이름으로 고침. `00_새채팅_인수인계_2026-10-22.md`는 폴더에 없음 (서현이 정리한 것으로 봄)
- 남은 결정: 레포 비공개 전환, 승준 초대, README의 팀원 표기(타이린 이탈 반영 여부), GitHub를 Claude에 연결할지, 10/11 결정 유지 여부, D1 목표값, 표본 경로

## CAP-AI-05 · 2026-10-28
- 도구: Claude (Claude 앱, 서현 PC 연결)
- 서현 결정·명령:
  1. 레포는 **공개(Public) 유지** — 비공개 권고 철회
  2. "내 Claude 계정을 GitHub에 연결해 줘" → Claude가 대신 연결할 수 없음 (계정 연결은 서현이 직접 승인해야 함). 연결 재시도 실패 확인
  3. 인수인계는 **하나로** — 10/22판 내용 중 남길 것을 10/28판에 합침
  4. 동작 순서: **트랩으로 잡음 → 개체 확인 → 여왕벌 가둠 → 일벌은 마킹 후 먹이 주고 방생 → 재포획 시 로그로 확인**
  5. 마커: 수성 아크릴 유지, **한 색**. 재포획 일벌: **로그 + 먹이 + 방생** (덧칠 안 함)
  6. 다른 말벌 종: "양봉농가에서 쓴다면 등검은말벌과 같이 처리가 맞겠지?" (질문)
- AI가 한 일:
  - D1 문서 작성: 동작 순서·분기, 순서에서 생기는 설계 조건 5가지 (먹이가 마킹 뒤 → 자세는 기구로 고정 / 급이 시간이 잉크 건조 시간을 겸함 / 한 색이면 마커 1개 / 재포획 로그 → 표지-재포획법 활용 가능 / 판별 오류 시 애매하면 가둠), 요구사항 R1~R12 ([추측] 제안값 포함)
  - Q3 의견: 같이 처리에 반대 — 크기 차이로 통로가 커져 등검은말벌 마킹 성공률 하락, 장수말벌 방생은 농가에 손해 → **모듈 입구 크기로 걸러 상용 트랩 안에 가둠** 제안 (서현 결정 대기)
  - 함께 지적: 상용 트랩이라면 죽었을 등검은말벌 일벌을 방생하는 것도 농가 입장에선 손해 → "왜 놓아주는가" 답이 필요. 운용 모드 전환(조사/방제) 제안
  - D0 목표 항목을 확정 내용으로, GitHub 사용법을 공개 운영 기준으로, 시작키 규칙을 "인수인계는 한 파일만 갱신(이전 버전은 Git 기록)"으로 고침. 인수인계에 Craft-Lab 연락처(10/22판에서) 합침
- 만든 파일: `design/2026-10-28_D1_동작순서와_요구사항.md`
- 고친 파일: `design/…D0…`, `docs/GitHub_사용법_Chrome.md`, `docs/00_새채팅_시작키.md`(+PC 맨 위 사본), `docs/00_새채팅_인수인계_2026-10-28.md`
- 검증: 장수말벌 크기 비교는 [가능성 높음] — 문헌 수치 미확인(미검증). 표지-재포획법 적용 가능성도 문헌 확인 필요
- 남은 결정: Q3 다른 종 처리, 운용 모드 전환 여부, D1 목표값 확정, 서현·승준 GitHub 연결, PC 중복 파일 정리(서현이 직접 삭제)

## CAP-AI-06 · 2026-10-28
- 도구: Claude (Claude 앱, 서현 PC 연결)
- 서현 결정·명령:
  1. **운용 모드 2개**로 함. **방제 모드는 구별 없이 전부 가둠**
  2. "여왕벌·일벌 크기 차이가 작으니 입구 크기 맞추기는 불가능하지 않나? 다른 종을 입구 크기로 거르는 게 좋은지 확인할 것" (10/12 보고 PPT 참고)
  3. 판매 대상은 양봉업자·말벌 사냥꾼이 아니라 **정부(공공사업)**
  4. 승준 collaborator 설정 완료
- AI가 한 일:
  - 10/12 보고 PPT 8쪽 확인: 여왕벌·일벌 흉부 폭 차이 약 0.1 mm → 입구로 계급 구분은 불가 (서현 지적과 같음). 단 Claude 제안은 계급이 아니라 **장수말벌(종) 거름**이었음을 정정
  - 장수말벌 크기 조사: 일벌 몸길이 35–40 mm, 여왕벌 50 mm 이상 (Wikipedia), 일벌 머리 폭 약 9.6 mm (Matsuura & Sakagami 1973 표 2, 일본 일벌 5마리 평균, 단위 환산은 Claude 계산 — 미검증) vs 시판 선택 트랩 봄(여왕벌)용 입구 9 mm → **장수말벌 대부분은 거르지만 여유가 얇고, 토착 소형 말벌은 못 거름** → 입구 1차 + 카메라 2차 판별 안
  - **법적 제약 발견**: 등검은말벌은 2019-07-26 생태계교란 생물 지정(서울신문 2019-07-25). 생물다양성법 제24조제1항 방사·보관·운반 등 금지, 학술연구 등은 환경청 허가 시 예외, 위반 시 2년 이하 징역·2,000만 원 이하 벌금. 법제처 해석 18-0488: 잡은 교란 어류를 산 채로 놓아주는 것 = 방사 → 조사 모드 방생은 허가 필요
  - 판매 대상 판단 보완: 조사 모드는 허가 기관만 쓸 수 있어 공공기관 판매와 맞물림. 실제 사용 현장은 양봉장, 비용 부담은 정부·지자체(방제 사업 보급) 구조일 가능성 [추측]
- 고친 파일: `design/2026-10-28_D1_동작순서와_요구사항.md` (5장 운용 모드, 6장 입구 거름 검토, 7장 법적 제약, 8장 판매 대상), `docs/00_새채팅_인수인계_2026-10-28.md`, `docs/2026-10-28_분업계획_서현_승준.md`
- 검증: 교란종 지정·금지 조항은 기사·조문 요약으로 확인 [확실]. 법제처 해석의 현행 적용 여부, 관할 환경청, 장수말벌 머리 폭 환산값은 미검증
- 남은 결정: 조사 모드 다른 종 처리 안 확정, 방제 모드 로그 여부, 허가 절차 확인, D1 목표값 확정

## CAP-AI-07 · 2026-10-28
- 도구: Claude (Claude 앱, 서현 PC 연결 + GitHub 레포 연결)
- 서현 결정·명령:
  1. 법은 나중 이야기 — **만드는 것에 집중**
  2. **방제 모드에서도 촬영·종 분류 로그를 남김**
  3. 조사 모드 다른 종 처리: **입구 크기 1차 거름 + 카메라 2차 판별** 확정
  4. GitHub와 MCP를 연결했으니 **GitHub 관련 작업을 전부 할 것**
- AI가 한 일:
  - D1에 결정 반영 (방제 모드 로그, Q3 확정, R8 두 모드 공통, 7장 법적 제약은 보류 표시)
  - 레포 연결·클론 성공. 서현 PC `repo\` 사본의 문서 전체를 레포에 올림: `docs/`, `ai-log/`, `design/`, `inventory/`, `cad|vision|control|purchase/README.md`, `.gitignore`
  - `README.md`에 프로젝트 요약·모드·문서 링크·폴더 표 추가 (기존 3줄은 그대로 둠)
  - `CLAUDE.md` 추가 — 레포에서 작업하는 Claude(서현·승준 모두)가 자동으로 따르는 규칙 (읽는 순서, 답변 방식, 파일 담당, Git 규칙)
  - GitHub 사용법 6장을 연결 방법 기준으로 고침
- 검증: 클론 후 기존 파일(LICENSE, README) 확인. push 권한은 연결 안내상 "refused" 상태였음 → push 결과는 아래 남은 결정 참고
- 남은 결정: D1 목표값 확정 → D2 기능 시퀀스 → D3 형태분석표

## CAP-AI-08 · 2026-10-28
- 도구: Claude (Claude 앱, 서현 PC + GitHub 레포 연결)
- 서현 명령: "푸쉬!" (Claude GitHub 앱 설치 후) / D1 목표값은 "너가 쓴 것 중에는 이대로 가자. 미처 파악 못 한 부분이 있으면 내가 태클 걸게"
- AI가 한 일:
  - CAP-AI-07 커밋 push 성공 (`2fb855a`). PC `repo\` 사본과 레포 내용이 같음을 확인
  - D1 상태를 확정으로 바꾸고 목표값의 [추측] 표시 제거 (R3 80%, R5 90%, R6 3분, R11 대당 30만 원 등)
  - D2 작성: 말벌 한 마리 기준 기능 시퀀스(①~⑨, 두 모드 분기), 기능계통도 갱신(F1~F8, 10/11판 대비 변경), 환류 5건 — 방생 출구가 따로 필요(한 방향), 고장 시 기본값 '가둠', 새벽 처리량, 두 마리 동시 진입, 격리함 가득
- 만든 파일: `design/2026-10-28_D2_기능시퀀스와_기능계통도.md`
- 고친 파일: `design/2026-10-28_D1_동작순서와_요구사항.md`, `docs/00_새채팅_인수인계_2026-10-28.md`
- 검증: 시퀀스는 D1 확정 내용과 대조. 새벽 처리량은 자료 없음(미검증)
- 남은 결정: D2 Q5(조사 모드 다른 종 → 격리 제안), Q6(두 마리 동시 진입 → 둘 다 격리 제안), 이후 D3 형태분석표

## CAP-AI-09 · 2026-10-28
- 도구: Claude (Claude 앱, 서현 PC + GitHub 레포 연결)
- 서현 결정:
  1. **대량 처리보다 먼저 한 마리를 목적대로 제대로 처리**하는 것이 지금 목표
  2. Q5 조사 모드 다른 종 → **격리**. VespAI를 데이터로 다시 학습시키는 건 프로젝트가 100% 끝난 뒤
  3. Q6 두 마리 동시 진입 → **둘 다 격리**
- AI가 한 일:
  - D2 확정: Q5·Q6 반영, 개발 원칙 추가, 새벽 처리량 문제는 보류
  - D3 작성: 핵심 위험 정리(자세 고정은 행동 의존 해법이면 2027년 전엔 검증 불가) → 형태분석표(분리·감지·자세 고정·힘 제한·도포·마름 방지·급이·분기·한 방향 출구·고장 시 가둠) → 조합안 3개(바닥 승강형 / 좁은 통로형 / 회전 칸형) → 가중치 평가표([추측] 점수) → **안 1 바닥 승강형 권장** (양봉 여왕벌 마킹 튜브 원리, 표본·더미로 검증 가능, 힘 제어·카메라 재시도로 로보틱스 요소)
- 만든 파일: `design/2026-10-28_D3_형태분석표와_조합안.md`
- 고친 파일: `design/2026-10-28_D2_기능시퀀스와_기능계통도.md`, `docs/00_새채팅_인수인계_2026-10-28.md`
- 검증: 평가 점수는 Claude 추정(미검증). 미끄럼 코팅(PTFE 분산액)의 말벌 적용은 문헌 확인 필요
- 남은 결정: 조합안 선택(서현·승준 회의), 가중치·점수 수정, 이후 D5 개념설계도

## CAP-AI-10 · 2026-10-28
- 도구: Claude (Claude 앱, 서현 PC + GitHub 레포 연결)
- 서현 결정·명령:
  1. **안 1 바닥 승강형** 확정. 미끄럼 코팅 대신 **미끄러운 플라스틱 재질** 사용
  2. 레포에 올리고, 승준의 AI가 무엇을 해야 하는지 지시할 것 — 분업해서 승준 AI도 병렬로 쓰게. 서현 쪽 Claude가 지금 무엇을 하는지도 승준 Claude에게 설명할 것. Claude는 하던 일 계속
- AI가 한 일:
  - pull로 승준 커밋 확인 (SJ-01 쓰기 권한 확인, SJ-02 VespAI 원본 `andrw3000/vespai` 확인·실행계획·예시 스크립트) + Issue #1(인수인계 VespAI 정정 요청) 확인 → 인수인계 5장 수정 (Issue 닫기는 이 세션에서 권한 거부 → 서현·승준이 Chrome에서 닫음)
  - D3 확정 반영 (안 1, 플라스틱 재질)
  - **D5 개념설계 초안**: 배치(차양막 위·포획통 아래, **상용 포획통을 격리함으로** → 방제·격리·고장 시 동작이 하나로), 도면부호 100~192, 작동 순서 1~9, 환류 5건 (격자망을 자로 써서 흉부 폭 측정 → 여왕벌 카메라 판별 근거, 측정 오차 ±0.05 mm 요구 [추측], 카메라·마커 시야 겹침, 방생·격리 때 빛 방향 전환)
  - **승준 작업지시서**: 서현 Claude가 하는 일, 승준 할 일 J1~J7(VespAI 1단계, 보유품 점검, 근접 촬영, 점 검출, 흉부 폭 측정, 아두이노 구동, BOM)과 기한·완료 기준, 서로 기다리는 값, 붙여 넣을 첫 메시지
  - `CLAUDE.md`·시작키 읽는 순서에 승준 작업지시 추가
- 만든 파일: `design/2026-10-28_D5_개념설계_안1.md`, `docs/2026-10-28_승준_작업지시.md`
- 고친 파일: `design/…D3…`, `docs/00_새채팅_인수인계_2026-10-28.md`, `docs/00_새채팅_시작키.md`, `CLAUDE.md`
- 검증: 승준 파일 내용은 커밋에서 직접 읽음. 흉부 폭 사진 측정 가능성·오차 목표는 미검증 (J3·J5로 확인)
- 남은 결정: FreeCAD 도면(도 1·도 2) — FreeCAD 실행 필요, 상용 트랩 실측값, D6 변수표

## CAP-AI-11 · 2026-10-28
- 도구: Claude (Claude 앱, 서현 PC + FreeCAD MCP + GitHub 레포 연결)
- 서현 명령: (CAP-AI-10과 같은 지시의 연속) "너는 하던 거 계속해"
- AI가 한 일:
  - FreeCAD MCP 연결 확인 (FreeCAD 1.1, RPC 정상)
  - D5 개념 모델 생성 스크립트 `cad/D5_concept_an1.py` 작성 — 치수 사전 `P`(전부 잠정), 객체 이름 = 도면부호, 바닥 상태(down/up) 선택, 앞쪽 절반을 자른 측단면 사본 생성
  - 서현 PC에서 실행 → 모델 2개(.FCStd)와 측단면 그림 2장 저장 (`CAD files\`), 레포 `cad/`에 올림
  - 그리면서 발견: ① 입구가 차양막 구멍 밖에 있었음 → 마킹실을 옆으로 옮기고 입구 위치 조건을 스크립트 검사로 추가 ② 마킹 위치에서 마커와 카메라가 겹침(환류 3 확정) ③ 하우징 바깥 지름 약 130 mm 필요(잠정)
  - D5 문서에 모델·그림·환류 6~8 추가
- 만든 파일: `cad/D5_concept_an1.py`, `cad/D5_concept_an1_down.FCStd`, `cad/D5_concept_an1_up.FCStd`, `cad/D5_도1_측단면_대기.png`, `cad/D5_도2_측단면_자세고정_마킹.png`
- 고친 파일: `design/2026-10-28_D5_개념설계_안1.md`
- 검증: 모델 생성·저장·그림은 FreeCAD 화면으로 확인. 치수는 전부 잠정(미검증)
- 남은 결정: 카메라·마커 배치(겹침 해결), 상용 트랩 실측, 특허도면식 마무리(인출선·PDF), D6 설계 변수표

## CAP-AI-12 · 2026-10-28
- 도구: Claude (Claude 앱, 서현 PC + GitHub 레포 연결)
- 서현 명령: 구체적인 치수가 필요할 테니 보유 상용 트랩 값을 지금 재서 알려 주겠다. 차양막·노란 깔때기 입구 지름이 뭔지 모르겠다 → **부품 이름을 그림으로 알려 줄 것**
- AI가 한 일:
  - 보유 트랩 사진 6장으로 구조 확인 (포획통 / 차양막 / 몸통 + 노란 깔때기 2개 / 유인액 통, 포획통 바닥 실리콘 포획술, 몸통 위 가운데 구멍)
  - 사진 4장(A 전체, B 차양막, C 포획통 바닥, D 몸통 안쪽)에 부품 이름과 잴 곳(D1~D7, h, H1, H2)을 표시한 그림 작성
  - 실측표 작성 (기호·위치·잴 것·쓰는 곳·값 칸)
- 만든 파일: `design/2026-10-28_상용트랩_실측표.md`, `design/img/상용트랩_실측위치.jpg`
- 검증: 부품 이름은 제품 설명서(전개도)와 대조 [확실]. 포획통 바닥 테두리(D3)는 사진이 없어 그림에 표시 못 함
- 남은 결정: 서현 실측값 입력 → D6 설계 변수표

## CAP-AI-13 · 2026-10-28
- 도구: Claude (Claude 앱, 서현 PC + FreeCAD MCP + GitHub 레포 연결)
- 서현 입력·결정:
  1. 실측값 (5 m 줄자, 정확하지 않음): D1 55, D2 90, H1 220(고무마개 → 포획통 바닥), H21 180(차양막 포함), H22 145(차양막 제외), D3 안지름 67·안쪽 홈 약 83·바깥 홈 약 94, D4 약 5(가변), **D5 19 mm**(19 cm는 오기), D6 약 50, D7 = D1. 사진 4장 첨부
  2. 결합: 홈·돌기는 모름, 본드 생각 → Claude 질문에 "돌려 끼우게 설계 가능해?"
  3. **원통 커버 없애고 알루미늄 프로파일 외부 구조** (완성도). **상용 트랩에 하중이 들어가면 안 됨 → 바닥에 서는 프레임**이 펜 구동부·급이부 등을 받침. 프로파일 크기는 지정 없음
  4. 차양막과 몸통은 떼어 낼 수 없고, 떼어지는 곳은 몸통 ↔ 포획통뿐
- AI가 한 일:
  - 실측표에 값·사진·검산(H21 + H1 = 400 mm = 제품 표기 40 cm) 반영
  - 본드 대신 돌려 끼움 가능하다고 답하고, **하중을 프레임이 받으면 아래쪽은 틈막이 칼라로 충분 → 정밀 결합은 위쪽(포획통) 한 곳뿐**으로 정리. 줄자로는 부족 → 캘리퍼스 측정 또는 결합 링 시험 출력 권장
  - 2020 프로파일을 기본값으로 정함
  - `cad/D5b_frame_an1.py` 작성·실행: 프레임(2020, 34 cm 사각, 높이 35 cm), 받침판 2장, 칼라, 포획통 결합부(차양막 턱 복사), 마킹 모듈, 상용 트랩 참고 형상 → 모델·등각·측단면 그림 저장
  - D5 문서 7장(구조 변경, 환류 9~12), 승준 작업지시 J7에 프로파일·캘리퍼스 추가
- 만든 파일: `cad/D5b_frame_an1.py`, `cad/D5b_frame_an1_down.FCStd`, `cad/D5b_전체_등각.png`, `cad/D5b_측단면_대기.png`, `design/img/실측사진/*.jpg` 4장
- 고친 파일: `design/2026-10-28_상용트랩_실측표.md`, `design/2026-10-28_D5_개념설계_안1.md`, `docs/2026-10-28_승준_작업지시.md`
- 검증: 실측 검산(높이 합 40 cm) [확실]. 몸통 반지름·포획통 반지름·턱 높이는 잠정(미측정). FreeCAD 첫 실행은 응답 시간 초과였으나 파일 저장 확인
- 남은 결정: 포획통 결합 홈·돌기 측정(캘리퍼스) 또는 시험 출력, 빛·비 차단 덮개, D6 설계 변수표

## CAP-AI-14 · 2026-10-28
- 도구: Claude (Claude 앱, 서현 PC + FreeCAD MCP + GitHub 레포 연결)
- 서현 명령·결정: 캘리퍼스는 나중에 빌림, 지금은 줄자 값으로 진행. **도면을 너무 못 그렸다 — 겹치는 부분, 의미 없는 직사각형, 공중에 뜬 부재 → 다시 그려라.** 바람 적은 곳·아침 운용이므로 **환경 요소는 빼고 시스템 설계·제어만**
- AI가 한 일:
  - `cad/D5c_module_an1.py` 새로 작성: 실제 부품 크기(28BYJ-48, SG90, T8, Pi 5·AI HAT+, UNO), 모든 부품을 지지 부품에 닿게 배치, 상태 2개(대기·마킹)
  - 스크립트에 **자동 검사** 추가: 부품 쌍 겹침 부피, 공중에 뜬 부품, 프레임까지 이어지는지 → 처음 실행에서 ① 마킹 상태에서 하중 센서·스프링이 바닥판과 겹침 ② 마커부 전체가 떠 있음(지지대를 레일 반대쪽에 붙임) 발견 → 수정 → **두 상태 모두 겹침 0·뜬 부품 0·프레임 연결 100%**
  - 설계 판단: 마커 +y 쪽 25° 기울임(카메라와 안 겹침, 25° 넘으면 팁이 격자에 걸림), 실리콘 슬릿 수동 캡(구동기 1개 줄임), 급이 심지를 벽에 고정(움직이는 관 없앰), 문 2개(격리·방생), 바닥 승강 = 28BYJ-48 + T8 + 가이드봉 + 캐리지(행정 36.5)
  - 그림 4장(도 1 전체 등각, 도 2 모듈 등각, 도 3·4 옆 단면 대기·마킹)에 도면부호 풍선·인출선 표시. FreeCAD 화면 좌표로 인출선 위치를 계산
  - D5 문서 8장, 인터페이스 정의서 1차 값·상태 머신 1차, 실측표에 승준 확인(포획통 돌려 끼움) 반영, 인수인계 갱신
- 만든 파일: `cad/D5c_module_an1.py`, `cad/D5c_module_an1_rest.FCStd`, `cad/D5c_module_an1_mark.FCStd`, `cad/D5c_도1_전체_등각.jpg`, `cad/D5c_도2_모듈_등각.jpg`, `cad/D5c_도3_단면_대기.jpg`, `cad/D5c_도4_단면_마킹.jpg`
- 고친 파일: `design/2026-10-28_D5_개념설계_안1.md`, `design/인터페이스_정의서.md`, `design/2026-10-28_상용트랩_실측표.md`, `docs/00_새채팅_인수인계_2026-10-28.md`
- 검증: 겹침·지지·연결은 FreeCAD 형상 연산으로 확인 [확실]. 치수(마킹실, 행정, 카메라 거리, 말벌 몸 높이)는 잠정(미검증). 실리콘 슬릿이 잉크를 닦는지 미검증. Issue #2(승준 실측 전달)는 반영했으나 이 세션에서 Issue 닫기 권한 없음
- 남은 결정: D6 설계 변수표·S4 역학계산 대상 선정, 카메라 초점 거리(J3), 포획통 결합부 홈 치수(캘리퍼스)

## CAP-AI-15 · 2026-10-28
- 도구: Claude (Claude 앱, GitHub 레포 연결, 웹 검색)
- 서현 질문·결정: "펜이 1자유도면 통을 작게 해야 하지 않나? XYZ 3축이어야 하지 않나? 팁 뚜껑은 어떻게 닫나? **마커는 샤피 수성 아크릴로 하되 클램프로 바꿔 끼울 수 있게**. 벌이 움직이면?"
- AI가 한 일:
  - 3차 설계 검토 → ① 겨냥점이 한 곳뿐이라 R3 불가 [확실] (3차에서 위치 맞추기가 빠짐) ② 말벌이 격자 천장에 거꾸로 매달린 채 눌리면 배를 찍는 자세 문제 [가능성 높음] ③ 28BYJ-48 + M5로는 마커 행정에 편도 약 2분 [가능성 높음] ④ 슬릿 캡은 팁이 닦임 [가능성 높음]
  - 샤피 크리에이티브 마커 제조사 정보 확인: 흔들기·펌핑 불필요, 표면 건조 1–3분, 뚜껑 안 닫으면 마를 수 있음. 지름·팁 굵기는 자료 없음
  - 안 A(통로형 + 1자유도) / 안 B(XY + Z) 비교, 권고 B. 벌이 움직일 때 동작 규칙, 캡 3방식(슬릿·연동 덮개·캡 컵), 클램프 조건(팁 높이·축 위치) 정리
- 고친 파일: `design/2026-10-28_D5_개념설계_안1.md` (9장 추가), `docs/00_새채팅_인수인계_2026-10-28.md` (상태 한 줄)
- 검증: 샤피 정보는 제조사 상품 페이지 [확실]. 흉부 등판 길이, 말벌이 천장에 매달리는 경향, 조명으로 자세 유도, 말벌 몸 위 건조 시간은 미검증. 모델(cad)은 아직 안 고침
- 추가 질문 (19:04): 서현이 보낸 펜(나비엠알오 K48486982)은 사이트가 자동 읽기를 막아 **못 열어 봄** → 상품명·사진 요청. "펜촉 두껍고 잘 안 마르는 펜" → 팁 마름(캡으로 해결)과 몸 위 건조(빨라야 함)를 나눠야 하고, 팁은 굵을수록 좋은 게 아니라 흉부 등판 안에 들어갈 만큼(약 1–2 mm) [가능성 높음] → D5 9-7 기준표 추가. "권고는 맞다고 생각해서?" → 근거로 권고(시험 가능성: A의 핵심 가정은 살아 있는 말벌로만, B의 핵심 가정은 지금 표본·더미로 시험 가능), A로 바꿀 조건도 명시
- 추가 (19:17) 서현 "펜은 너가 찾아, 적당한 것으로, 링크" → **uni POSCA PC-3M 화이트 3개 + 비교용 PC-5M 화이트 1개** 선정 (여왕벌 표시펜 실적, 팁 0.9–1.3 mm, 국내 구매 가능). 샤피 크리에이티브는 국내 판매처 못 찾아 보류. D5 9-8, 승준 작업지시 J7 마커 항목 갱신. 국내 판매처 2곳은 품절 표시가 보여 재고 미확인
- 남은 결정: **마커 위치 A / B (서현)**, B면 마킹실 크기·마커 기울임·카메라 높이(J3)·이송 나사 피치. 캘리퍼스로 마커 지름·팁 굵기 측정

## CAP-AI-16 · 2026-10-28
- 도구: Claude (Claude 앱, 서현 PC + FreeCAD MCP + GitHub 레포 연결, 웹 검색)
- 서현 결정·명령: **"B로 가자"**(마커 XYZ). "흔들거나 펌핑할 필요가 없어서 자동화에 유리 — 이 조건을 만족하는 최상의 마커 골라"
- AI가 한 일:
  - 마커 조사: 흔들기·펌핑 없음 + 불투명 흰색 + 수성 → **사쿠라 퍼마페이크 Fine 흰색 1.0 mm (1순위)**, 샤피 크리에이티브 불렛 흰색(2순위, 수성 아크릴). 둘 다 국내 판매처 못 찾음 → 해외 직구, 둘 다 사서 시험 권고. POSCA 뺌
  - **AI 카메라 초점 범위 20 cm~무한대(제조사 사양) 발견** → 3차의 카메라 57 mm는 초점이 안 맞는 자리 → 200 mm로 올림. 부작용: 흉부 폭(0.1 mm 차이)으로 여왕벌 가르기 어려워짐
  - `cad/D5d_module_an1_B.py` 작성 (3차 스크립트에서 마커부·카메라·프레임 바꿈): X 고정 봉 + 빔 끝 블록 + X 나사, Y 봉 + 캐리지 + Y 나사, 펜 들기 서보 + 홀더 스프링, V블록 + 조임 띠, 캡 컵. 프레임 위 590·갠트리 단 452 추가. **카메라 시야 가림 검사** 추가 (가상선 피라미드와 부품 공통 부피)
  - 검사 결과: 두 상태 모두 겹침 0·뜬 부품 0·프레임 연결 100 %, 대기 상태 시야 가림 0. 설계 중 고친 것: 서보–Y 봉 겹침(캐리지 키움), 대기 자리 (55,−40) → (65,−40) (시야 가장자리 걸림)
  - 도 5~8 (전체 등각, XYZ 마킹부 등각, 정면 단면 마킹, 위에서 본 대기) 도면부호 그림. 인출점은 부품 위 3D 점을 화면 좌표로 바꿔 지정
  - D5 10장, 인터페이스 정의서 2차(카메라 200, 좌표계, 흉부 좌표 ±1 mm, 구동기 7개, 상태 머신 2차), 승준 작업지시(J3 갱신, J6 X·Y·Z 추가, **J8 흉부 좌표 찾기 신설**, J7 마커·XYZ 품목), 인수인계 갱신
- 만든 파일: `cad/D5d_module_an1_B.py`, `cad/D5d_module_an1_B_rest.FCStd`, `cad/D5d_module_an1_B_mark.FCStd`, `cad/D5d_도5_전체_등각.jpg`, `cad/D5d_도6_마킹부_등각.jpg`, `cad/D5d_도7_정면단면_마킹.jpg`, `cad/D5d_도8_위_대기.jpg`
- 고친 파일: `design/2026-10-28_D5_개념설계_안1.md`, `design/인터페이스_정의서.md`, `docs/2026-10-28_승준_작업지시.md`, `docs/00_새채팅_인수인계_2026-10-28.md`
- 검증: 겹침·지지·연결·시야는 FreeCAD 형상 연산 [확실]. 카메라 사양·마커 사양은 판매처·제조사 페이지 [확실]. 15.6 화소/mm는 사양으로 계산(미검증). 마커 실물 치수·말벌 몸 위 내구성·속도는 미검증
- 남은 결정: D6 — 구동 속도와 R6(3분) (28BYJ-48 + T8이면 약 2 mm/s), 카메라를 AI 카메라로 둘지(200 mm) 가까이 찍는 카메라로 바꿀지(J3), 마커 2종 시험 후 선택, 포획통 결합부 치수(캘리퍼스)

## CAP-AI-17 · 2026-10-28
- 도구: Claude (Claude 앱, GitHub 레포 연결)
- 서현 명령: "일단 깃에 올리고 승준이 AI에게 할 일을 넘기자"
- AI가 한 일:
  - D5 4차는 이미 push됨(`fc7d499`) 확인. pull로 승준 SJ-10(J2 완료)·SJ-11(구매 목록 총정리, 4차 반영) 확인
  - 승준 작업지시 맨 위에 **★ 10/28 저녁 갱신** 추가: 바뀐 것(XYZ, 카메라 200 mm, 구동기 7개), J 상태표(J1·J2 완료, J7 정리 완료, J5 보류), 다음 할 일 순서(① 지금 살 것만 주문 — 캘리퍼스는 서현이 빌리므로 안 삼 ② J6 28BYJ-48 속도 측정 먼저 — D6 R6 계산 입력 ③ J8 흉부 좌표 ④ J4 ⑤ J3 전원 어댑터 도착 후), 서현이 하는 것(D6, 11/5 목표). 붙여 넣을 말 갱신
- 고친 파일: `docs/2026-10-28_승준_작업지시.md`
- 검증: J 상태는 승준 로그 SJ-04·10·11 기준 [확실]. 28BYJ-48 속도가 R6를 좌우한다는 판단은 [가능성 높음]
- 남은 결정: **제작 대수 1대/2대 (서현)**, D6 설계 변수표

## CAP-AI-18 · 2026-10-28
- 도구: Claude (Claude 앱, 서현 PC + FreeCAD MCP + GitHub 레포 연결, 웹 검색)
- 서현 전달·명령: 승준이 지금 살 수 있는 것을 샀고 보유품도 정리했고 **펜도 정했다(제안한 퍼마페이크는 구하기 힘들어 바꿈 — 샤피 크리에이티브 노랑)**. 확인하고, **설계 계속 + 역학계산, 정리 잘하고 깃에 올려라**
- AI가 한 일:
  - 확인: 승준 SJ-12~20 (마커 결정 Issue #3, 재료비 50만 원·해외구매 불가, 86,240원 집행, J4 노랑 점 합성 96 %, J6 펌웨어 시뮬레이션 1.83 mm/s, UNO 핀 부족·원점 스위치 없음 요청)
  - S4 양식 확인 (PC `시스템설계및제어` 워크시트·작성 예시, 지난 S4의 수기 문제 목록): 4-1 → 4-2 → 4-3(①~⑤) + 검증 대장
  - **S4 역학계산 1차 (AI값)** `design/calc/s4_calc.py`: M1 승강 나사 토크·자립(1.75 N·mm, 안전율 19.6, 자립 안 함), M2 X·Y 토크와 R6 시간(기구 63.9 s → 급이 ≤ 105~116 s), M3 찍는 힘(자중 0.32 N, 스프링 ≤ 0.18 N, **하중 센서로 못 잼**), M4 펜 들기 서보(안전율 38.9), **M5 한쪽 구동 X 빔 끼임(PLA 2μd/L = 3.05 → 볼 부싱)**, M6 봉 처짐(0.0035 mm). 질량은 FreeCAD 모델 부피 × 밀도 + 사양값
  - 자유물체도 7장 `design/calc/s4_figs.py` → `design/img/S4_*.png`
  - **D6 설계 변수표** 작성 (변수·값·근거·상태, 시간 예산표, 다음 시험 순서, 원점·전원 답)
  - 모델 보완 (`cad/D5d_module_an1_B.py`): 샤피 치수(그립 Ø14.7 + Ø18.9), LM8UU·LM6UU 추가, 끝 블록 두께 12→18·x 20→24 (첫 실행 검사에서 베어링–Y 봉·브래킷 겹침 2건 발견 → 고침), 스프링·탭 위치 → 두 상태 겹침 0·뜬 부품 0·연결 100 %·시야 가림 0. 도 5~8 다시 그림, 도 7 설명 정정
  - D5 11장(보완·정정), 인터페이스 정의서 3차, 승준 작업지시 ★★(J9 마커 점 시험 신설, J6 실물, J7 C 품목), 인수인계 갱신(예산 50만, **공개 레포에 있던 3D 프린터 담당자 전화번호·메일 삭제**), 시작키·D0 예산 문구
- 만든 파일: `design/2026-10-28_D6_설계변수표.md`, `design/2026-10-28_S4_역학계산_1차.md`, `design/calc/s4_calc.py`, `design/calc/s4_results.json`, `design/calc/s4_figs.py`, `design/img/S4_*.png` 7장
- 고친 파일: `cad/D5d_module_an1_B.py`, `cad/D5d_module_an1_B_rest.FCStd`, `cad/D5d_module_an1_B_mark.FCStd`, `cad/D5d_도5~8_*.jpg`, `design/2026-10-28_D5_개념설계_안1.md`, `design/인터페이스_정의서.md`, `design/2026-10-28_D0_재설계_전제와_절차.md`, `docs/2026-10-28_승준_작업지시.md`, `docs/00_새채팅_인수인계_2026-10-28.md`, `docs/00_새채팅_시작키.md`
- 검증: 계산은 스크립트 재실행·수식 손검산(M1 토크, M5 비율, M6 처짐) [확실]. 28BYJ-48 토크는 사양서, LM8UU 치수·질량은 판매처 [확실]. 볼 부싱 μ 0.005·PLA μ 0.3·황동 μ 0.15는 일반값 [가능성 높음]. F_p 0.5 N·F_ink·건조 시간·rpm은 `미검증`. **S4 ④ 수기 풀이는 안 함 (서현 몫), ③ 교재 유제 번호 일부 미정**. 전화번호는 현재 파일에서만 지움 — Git 기록에는 남음
- 남은 결정: 제작 대수(서현), 원점 1안 확인, 샤피 노랑 점 시험(J9), S4 수기 풀이·유제 번호(교재 PDF 위치)

## CAP-AI-19 · 2026-10-28
- 도구: Claude (Claude 앱, 서현 PC 연결 + FreeCAD MCP + GitHub 레포 연결)
- 서현 명령: 고체역학(Gere)·정역학(Riley)·동역학(Meriam) 교재 PDF와 해설집 폴더(`Documents\공주대\`)를 주며 **"솔루션이 있으니 대조해 봐라. 틀린 게 있을 수도 있으니 참고하고 너가 계산 똑바로 해"**
- AI가 한 일:
  - **S4 ③ 유제 번호 확정 + 해설집 대조** — 설계 계산과 같은 함수로 다시 풀어 비교 (`design/calc/s4_textbook_check.py`): M1 Riley 9-66 (8.592 N·m, 자립 안 함 — 해설집과 같음), M2 Meriam 3/1·3/2 (0.06 % 이내), M3 Riley 6-49 (749.7 vs 해설집 750 lb), M4 Riley 6-41 (Q 62.87, A 39.82 lb 같음), M5 Riley 9-43 서랍 (1.197~1.206 vs 해설집 1.202 lb; 해설집은 θ를 sin θ = 0.75/18로 근사·중간 반올림 — 답 영향 0.5 % 미만, **기울기를 무시하면 −17 %**), M6 Gere 9.3-1 (SI판 정답 1.04 mm는 E = 200 GPa일 때 — 문제에 E 없음, 해설집은 미국판 수치라 식으로만 대조, 0.0349 in 재현)
  - 해설집에서 "틀린 답"은 못 찾음. 주의할 점 2개: Riley 9-43 해설집의 기울기 근사, Gere 해설집이 다른 판(미국판)
  - **우리 계산 재점검 (s4_calc r2)** — FreeCAD 모델에서 부품별 부피·무게중심을 읽어 다시 계산:
    - **M5 고침**: r1은 요(yaw)만, 그것도 보수적 경계 하나로 "청동 끼임"이라 함 → 요의 두 경계(B 혼자 μ_c 0.098 / A·B 대각 0.197) + 나사가 봉보다 55 mm 낮아 생기는 피치를 합친 연립 → **μ_c = L / 2(k d + h) = 0.068~0.103**. 청동은 두 경계 모두 끼임(1.45~2.2), LM8UU 0.048~0.074(여유 13.6배, 유효 길이 17로 잡아도 9.6배)
    - M6: X 봉 하중을 반반(1.90 N) → 무게중심 배분 **봉 A 61~71 %**(Y 모터가 봉 A 바깥) + 최악 한 봉 전부(δ 0.0070 mm). Y 봉에 편심 수평 짝힘 0.26 N
    - M2: Y 캐리지 편심(−x 6.8 mm, 세로 두 봉) 짝힘을 마찰에 넣음, X는 끼임 연립으로 추력 → 안전율 Y 1,650·X 566 (r1 2,186·667)
    - M4: 레일 마찰을 홀더 편심 모멘트로 계산(f ≤ 0.089 N) → 안전율 38.9 → 36.2, 혼 길이는 팔의 상한으로 명시
    - M3: N_tip 0.23~0.32 N (레일 마찰 범위), F_s ≤ 0.18 N 그대로
    - M1: 값은 그대로(1.75 N·mm), **안전율 19.6이 120 Hz(약 1.8 rpm) 토크 기준**임을 밝힘 → 15 rpm은 반 스텝 1024 Hz로 공회전 최대(1000 Hz)와 거의 같음 → J6에 부하 시험 추가
  - 그림: M5 자유물체도를 요 + 피치 두 칸으로, M6·M4·M3·M2 그림 문구 고침
- 만든 파일: `design/calc/s4_textbook_check.py`, `design/calc/s4_textbook_check.json`
- 고친 파일: `design/calc/s4_calc.py`, `design/calc/s4_results.json`, `design/calc/s4_figs.py`, `design/img/S4_M2·M3·M4·M5·M6_FBD.png`, `design/2026-10-28_S4_역학계산_1차.md`(r2), `design/2026-10-28_D6_설계변수표.md`, `design/2026-10-28_D5_개념설계_안1.md`(10장 표 한 줄), `design/인터페이스_정의서.md`(구동기 1·2·4, 변경 이력), `docs/2026-10-28_승준_작업지시.md`(J6 부하 시험), `docs/00_새채팅_인수인계_2026-10-28.md`
- 검증: 교재 정답·해설집 값을 같은 함수로 재현 (차이 0.5 % 이내) [확실]. 무게중심은 FreeCAD 형상 연산 [확실], PLA는 꽉 찬 밀도라 상한. 끼임 연립은 마찰 크기를 더해 크게 잡은 모델 [가능성 높음]. 볼 부싱 유효 길이 17 mm는 [추측]. μ 값(볼 0.005, PLA 0.3, 청동 0.15)은 일반값 — 미검증. 교재·해설집 PDF와 문제 원문은 공개 레포에 넣지 않음 (번호·쪽·주어진 수치만)
- 남은 결정: 서현 ④ 수기 풀이 6개 + ③ 본인 풀이 칸(유제 7개), J6 부하 시험 결과로 rpm 확정, 제작 대수

## CAP-AI-20 · 2026-11-01 (진행 중 — 중간 저장)
- 도구: Claude (Claude 앱, 서현 PC + FreeCAD MCP + GitHub 레포, 내장 브라우저로 McMaster·부품 외형도 확인)
- 서현 명령: ① CAD 이음부가 제대로 이어졌는지 확인, 모터를 모터로 정밀하게, 나중에 움직일 수 있게 설계, 움직이는 모습 보기 ② 고른 유제를 왜 골랐는지·무엇을 풀었는지·우리 문제에 어떻게 적용했는지(안 했으면 왜) md로, 자유물체도는 아주 세세하게 jpg로. 중간: 승준 업데이트 확인, 수시로 push, 필요하면 McMaster로 부품 확인, 통로 꺾임 모양 바로잡기, 알루미늄 프로파일 몇 시리즈인지
- 지금까지 한 일:
  - D5d 이음부 문제 찾음 (FreeCAD로 확인): 문판이 돌 자리가 없어 안 열림(회전 15~90°에서 하우징과 19~40 mm³ 겹침), 펜 들기 최대 8.46 mm < 캡 컵에서 빠지는 데 필요한 8.56 mm, 마커가 격자 -x 끝(xm 37.4)에서 갠트리 레일과 겹침(1,140 mm³), 리드스크루에 너트 없음, Y 봉 맞대기만, 밀대가 스프링을 건너뜀, X 모터 귀 고정 없음, 통로 꺾임이 관 두 개를 겹쳐 붙인 모양
  - `cad/D5e_module_kinematic.py`: 28BYJ-48(외형도: Ø28×19, 귀 35, 축 Ø5 D컷 3 길이 10, 축 8 치우침), SG90(22.2×11.8×22.7, 귀 32.2, 귀 윗면 16), MG90S, T8 플랜지 너트, 커플링 Ø19.1×25.4(McMaster 4147N159와 같은 치수), LM8UU·LM6UU / 문 = 서보 혼 핀 미닫이(스카치 요크, 행정 15.6) / 펜 들기 = 안내 핀 2개 + 혼 16 mm + 늘린 탭(들림 10 mm) / Y 봉 438·468으로 내려 끝 블록에 10 mm 끼움 / Y 너트 +y 면 / 갠트리 받침 레일 x 25 → −18 / 통로 꺾임 = 굽힘관(중심 반지름 20) / 빛 게이트를 세로관으로
  - `cad/D5e_check.py`: 이음부 86개(끼움 길이·면 접촉·나사 길 탐침·미끄럼 틈·혼 밂) 모두 통과, 정지 자세 겹침 0·뜬 부품 0, 움직임 17자세 간섭 0, 말벌 통로 통과 확인 → `cad/D5e_check_result.json`
  - 움직이는 모델: `cad/D5e_module_kinematic.FCStd` — 스프레드시트 'Joints'의 floor·xm·ym·horn·support·door_* 값을 바꾸고 다시 계산하면 움직임
  - 동영상: `cad/D5e_animate.py`(FreeCAD 프레임 390장) + `cad/D5e_compose_video.py`(글자·진행 막대) → `cad/D5e_동작_한마리처리.mp4`·`.gif`
  - 알루미늄 프로파일: 정방형 20시리즈 2020 (미스미 5시리즈 HFS5-2020, 홈 6, M5) — 갠트리 레일 처짐 약 0.004 mm라 힘으로는 충분, 부품 구하기 기준. 자를 길이 610 × 4 + 320 × 21 ≈ 9.2 m
  - 자유물체도 그림 도구 `design/calc/fbd_lib.py` + 교재 유제 7개 그림 스크립트 `design/calc/s4_fbd_textbook.py` → `design/img/fbd/T1~T7_*.jpg` (그림 하나씩 열어 확인함: 힘 방향(T5 P, T7 P 방향 바로잡음)·글자 겹침·치수, 받침은 떼어 내고 반력으로 그림)
- 남은 일 (다음 채팅이 이 순서로 이어서 함):
  1. ~~T1~T7 jpg 확인·수정~~ (완료 11/01 21:40)
  2. `s4_calc.py`를 D5e로: 질량표(D5e 부품), L_xrod 163(받침 사이), yrod_z (438, 468), 펜 서보 팔 = 혼 끝 Rt 14 + rr 2 가 평평한 탭을 밂, 안내 핀 2개(서랍 효과 2μ·e_y/h), 스프링 → M3·M4 다시 계산, M1 안내봉 회전 막이 F_g = T/26
     - 21:20 찾은 것 (미검증): D5e 혼 팔은 14 cos θ ≤ 14 mm (16 아님, 탭이 평평해 힘이 혼 끝 중심을 지남). 핀 안내 서랍 효과 2μe/h ≈ 2×0.3×35/40 = 0.53 → F_lift ≈ 2.1 W_h, T ≈ 9.6 N·mm, 안전율 ≈ 18. 홀더 무게중심·x 치우침은 FreeCAD에서 아직 못 읽음 (21:24 서현 지시로 멈춤)
  3. M1~M6 자유물체도 jpg (`design/calc/s4_fbd_module.py` 새로): M1 나사산 조각 λ 20.0°·φ′ 8.83°, M2 Y 묶음 편심 짝힘(봉 438/468), M3 물체 셋(홀더·말벌·바닥), 로드셀은 F_p를 읽음, M4 혼 끝·탭·핀, M5 yaw(k 1, 0.5)+pitch, M6 하중 나눔·SFD/BMD·봉 163
  4. ~~`design/2026-11-01_S4_유제선정과_적용.md`~~ (완료 11/01 22:00 — 유제마다 고른 이유·푼 것·적용·안 한 것·검산 안 했으면, T1~T7 jpg 넣음. D5e로 바뀐 M4 토크·M5 홀더 안내·M6 처짐은 어림값으로 적고 **미검증** 표시 → 2번 끝나면 확정값으로 고칠 것)
  5. S4 문서·D6 설계변수표(2020 프로파일, Z 안내 핀, 문 MG90S 미닫이, 갠트리 레일 −18, yrod z, 커플링·너트)·인터페이스 정의서(문·펜 사양 + 변경 이력 줄)·`cad/README`·인수인계 갱신
  6. (선택) 영상 범례 글자 잘림 고쳐 mp4/gif 다시 만들기: PC VM에서 `python3 repo/cad/D5e_compose_video.py 작업_애니메이션/frames 작업_애니메이션/out`
  7. 이 항목 '진행 중' 지우고 마무리, commit·push, PC 사본 맞추기

## CAP-AI-21 · 2026-11-02 (발표 준비)
- 도구: Claude (Claude 앱, 서현 PC 연결 — 동역학 교재·해설집 PDF 읽기, GitHub 레포)
- 서현 명령: "오늘 3시 발표, 교수님이 역학계산은 무조건 발표해 달라고 하심. 시스템설계 수업 S4처럼 정리, 승준이 바로 PPT 만들 수 있게. 문제는 10개, 동역학이 제일 중요" (서현 S4 r1 PDF 첨부 — 형식 참고)
- 한 일:
  - 승준 CAP-AI-SJ-29(D5e M1~M6 재계산·그림 6장) 그대로 씀 — 승준 파일 안 고침
  - 동역학 4문제 추가: `design/calc/s4_dyn_calc.py` → `s4_dyn_results.json`, 그림 `design/calc/s4_fbd_dyn.py` → `design/img/fbd/M7~M10_D5e_*.jpg`
    - M7 문 미닫이 = 스카치 요크 (Meriam 5/26): v_max 94 mm/s, 닫힘 0.20 s, 토크 여유 약 9,000배, 말벌 끼면 닫힘 힘 22~44 N → 빛 게이트 확인 뒤 닫기
    - M8 펜 내려찍기 충격 (Meriam 3/108): F_max = W' + v_0√(k_c m), 서보 최고 속도면 0.8~1.8 N (정적 0.32 N의 2.4~5.5배) → 마지막 2 mm ≤ 60 °/s (스프링 넣으면 ≤ 13 °/s)
    - M9 이송 시간 (Meriam 2/27): 15 rpm X 14.1·Y 29.1·바닥 18.4 s, 가속 몫 0.3 % → 속도 상한이 시간을 정함
    - M10 봉 고유진동수 (Meriam 8/8): X 봉 158~186 Hz, 공진 띠 2.1~3.0 rpm, 운전 10~15 rpm은 멂
  - 해설집 대조 [확실]: 3/108 29.43 vs 29.4 mm, 2/27 108.9 vs 108.9 s, 8/8 2.229 vs 2.23 Hz, 5/26 문자식 = 수치 미분 (10^-7). 해설집은 미국판 문제별 PDF지만 이 네 문제는 SI판과 수치 같음
  - 슬라이드 원고: `docs/2026-11-02_발표_역학계산_슬라이드원고.md` (S1~S20, 동역학 5문제 앞, 문제마다 그림 경로·화면 글·발표 멘트)
- 검증: 그림 4장 하나씩 열어 힘 방향·글자 겹침 고침. 미검증: k_c(300~3,000 N/m 추측), MG90S 토크·속도(판매처 사양), 문판 질량(부피 계산)
- 남은 결정: M8 스프링 204 넣을지, M7 문판 힘 상한 방법, 펜 홀더 핀 변경(승준 SJ-29), ④ 수기 풀이(최소 M8)
- 남은 일: CAP-AI-20의 5번(S4 본문 r3·D6·인터페이스·README·인수인계)은 발표 뒤
- 01:36 서현 추가 명령: "① 네가 맞다고 생각하는 것으로 정해 ② 수기 풀이는 시간 없음 ③ PPT 검토는 함 ④ 예상 질문이 뭐냐. CAD가 제대로 안 된 것 같다 — 알루미늄 프로파일과 산 말벌 트랩이 다 그려진 도면을 왜 안 그렸나, 내가 볼 수 있게 png를 왜 안 올리나. 전부 해"
  - 결정 (AI 판단, 서현 위임): 스프링 204 뺌 (M3 N_tip 0.31 N은 마커 무게만으로, M8 60 °/s 허용) / 펜 홀더 핀은 PTFE 테이프로 감음(μ ≈ 0.1 [가능성 높음] → 끼임 여유 4배 이상), 다음 수정(D5f)에서 핀을 혼이 미는 줄 쪽으로 옮김. 슬리브 60 mm 안은 위 멈춤 탭과 겹쳐 안 됨
  - `cad/D5e_full_assembly.py`·`.FCStd`: 2020 실제 T홈 단면 프레임(25개 부재 + L 브래킷 32) + 상용 트랩 상세(유인액 통·몸통·노란 깔때기 2·차양막·턱 4토막·포획통·고무마개·실리콘 포획술, 실측표 값, 지름 일부 [추측]) + D5e 모듈. 프레임·트랩–모듈 겹침 0 (FreeCAD common)
  - 렌더 `cad/D5e_도1~도5_*.png` (정투영 — 처음 렌더는 시점 전환 애니메이션 때문에 위 보기가 기울어 나와서 애니메이션 끄고 다시), 한 장 조립도 `cad/D5e_전체조립도.png` (`D5e_drawing_sheet.py`)
  - 슬라이드 원고에 전체 구성 슬라이드(S4), 결정 반영, 예상 질문과 답(S21) 추가, `cad/README` 갱신
- 01:49~02:08 서현 추가 명령 (CAP-AI-21 계속):
  - "CAD files 폴더에 캐드 파일이랑 jpg 다 저장" → 서현 PC `CAD files\`에 D5d·D5e FCStd, D5e 렌더 jpg(png → jpg 변환), D5c·D5d 그림, 동영상, `스크립트\`, `자유물체도\` 저장. 저장하다 PC repo 사본에 승준 SJ-29 파일 12개가 없고 3개가 옛 버전인 것을 찾아 맞춤 (그림은 PC 쪽이 약 5.8 KB 큼 — 옮길 때 메타데이터가 붙는 것으로 보임, 내용 같음 [가능성 높음])
  - "먹이를 안 주면 다시 안 올까, 유인제 때문에 오려나" → 먹이 유지 판단(시간 이득 없음, 재방문·바로 떠나기에 도움), 근거 Frontiers in Insect Science 2022 (미끼에서 표시한 개체가 최소 3번 왕복), 먹이 줌/안 줌 재포획 비교 시험 제안 → D1 2장·D6 10장에 적음
  - "역학계산 무엇을 왜 풀었는지 유치원생도 알게" → 쉬운 비유 설명, Claude 문서(https://claude.ai/artifact/488QNwxwHR4oQ3DCx1S4Ka)로 만들고 md·docx로 레포 `design/2026-11-02_S4_역학계산_쉬운설명.*`에
  - "모든 역학 문제를 역학계산 폴더에" → 서현 PC `역학계산\` (01_문서, 02_자유물체도_jpg 17장, 03_S4_r2_그림, 04_계산코드, 00_읽는순서.md). 복사본 md의 그림 링크를 폴더 구조에 맞게 고침
  - "명령·원칙을 md에 적재적소에, 필요한 것 전부 레포에, CAD는 설명과 함께 시간순으로" →
    - 작업 원칙 → `CLAUDE.md` '서현 작업 원칙' (저장·동기화, CAD, 역학계산, 결정 위임)
    - 설계 결정 → D6 10장 (D5e에서 바뀐 것 14줄), 인터페이스 정의서 4차 값(구동기 4·5~7, 상태 머신 2·6단계, 변경 이력 줄), D1 2장(급이 유지 근거)
    - CAD → `cad/README.md`를 시간순 기록으로 다시 씀 (10/02 Inventor 초기 스케치 ~ 11/02 전체 조립, 판마다 바뀐 것·파일·그림·로그 번호, D5d 결함과 D5e 수정 표, 부품 치수 근거, 다음 수정 D5f). PC에만 있던 `10.2_first_stamp_method_sketch.ipt`(내용 미확인), D5c·D5d 원본 렌더 PNG 8장과 도면부호 위치 json 2개를 `cad/`·`cad/원본_렌더/`에 올림
    - 인수인계 문서 1장 갱신
- 남은 일 (발표 뒤): S4 본문 r3 정리(1차 r2 + 승준 2차 + 동역학), D5f(핀 옮김·스프링 뺌 반영 후 렌더 다시), 시험(샤피 건조·F_ink·k_c·μ_pin·J6), 수기 풀이
- 02:21~ 서현 추가 명령 (CAP-AI-21 계속):
  - "PPT는 승준이 내일 아침에. 지금 할 수 있는 것 해. VespAI를 승준이 해 봤는데 탐지를 잘 못하더라, 확인. 안 되면 이 컴퓨터로 가져와서 내가 시험" →
    - 승준 스크립트·결과 점검: 색 변환(BGR→RGB)·가중치 해시 정상 → 원인은 장면 차이 [가능성 높음]. 우리 카메라 배율(말벌 화면 폭 약 10 %)은 VespAI가 잘 잡는 범위, 마킹실만 잘라 넣으면 범위 밖. **새 위험: 격자판 가림 — 열린 면적 36.5 %** → 투명 격자 권장 (`design/2026-11-02_VespAI_점검_서현.md`)
    - 서현 PC 시험 키트 `capstone design_이서현\VespAI_시험\` (= 레포 `design/vespai_check/`): 승준 J1 설치 스크립트 실행 → 웹캠 점검(g 격자 겹침, k 마킹실만, i 입력 640/1280, [ ] 화면 폭 mm) → 영상·사진 폴더 끌어다 놓으면 조건 5개 표. 가짜 모델로 흐름 확인 [확실], 실제 가중치·웹캠은 `미검증`
  - "센서·회로·문 여닫기·방 이동 확인·카메라 몇 개·제어를 무엇으로 정리, 제어 관련은 제어 폴더에 전부" → `design/2026-11-02_제어_통합정리_D5e.md` + 그림 2장(`design/img/control/`, `design/calc/control_figs.py`): Pi 5 + UNO 2개(움직임 / 문·센서·조명), 빛 게이트 G1~G6, MG90S 문 + 문틈 0.2 s 규칙(닫는 중 막히면 다시 엶), 카메라 1대(격자 위 200 mm) + 투명 격자 권장, 상태 머신 D5e, 핀 배정, 전원 5 V 3 A·GND 공통, 사야 할 것, 남은 결정(NEMA17·펌웨어 나누기·인터페이스 반영은 승준 확인 뒤). 승준 control/ 파일은 안 고침

  - 02:53 서현 PC에서 VespAI 설치·J1 실행 성공: Python 3.14.3 / torch 2.15.0+cpu (경로 B — `py -3.11`을 못 찾고 기본 파이썬 사용), 예시 21장 중 16장 원 결과와 같음(승준과 같음), CPU 0.106 s/장, 모델 로드 20 s → `design/vespai_check/results/2026-11-02_J1_서현PC_summary.txt`. 다음: `2_webcam_check.bat`로 흰 종이 / 격자 겹침 시험
  - 03:05 서현 웹캠 점검(휴대폰 화면 사진): 거의 못 잡음, 격자 겹치면 0, 안경·방 오검출 → VespAI 점검 문서에 결과·해석 추가: **투명 격자 필수, VespAI 그대로 안 씀, 우리 구도 사진으로 다시 학습(승준 계획 앞당김)**. 공정한 다음 시험 = 표본을 흰 종이 위 20 cm에서 찍은 사진 폴더
- 03:08~03:10 서현: "휴대폰으로 하는데 전혀 못 잡고, 격자 무늬가 있으면 절대 못 잡음. 안경·방을 말벌로 잡음. 조건이 VespAI 세팅과 달라서인가" / "hivora.eu 조건과 비슷하게 하려는데 여기도 VespAI를 쓰나, 어떻게 탐지하나"
  - 서현 PC 기록(`out_check_20261102_0257`) 분석 → 전체 75 %는 오검출 포함이라 성공률 아님, 전체 + 격자 0/25 s(오검출도 0), 마킹실만 + 격자 21/92 s(가짜일 수 있음) → `design/vespai_check/results/`에 저장, 점검 문서에 표
  - 키트 개선: 박스가 뜬 장면을 1초에 1장 자동 저장(`auto_*.jpg`) — 진짜·가짜 판정용
  - 공정한 시험 제안: VespAI 현장 사진 15장을 `3_drop…bat`에 넣어 격자 영향만 비교
  - Hivora 확인(사이트·조립 안내): XIAO ESP32-S3 Sense + 카메라를 미끼 단지 위에, 보드 안 자체 학습 모델, VespAI 언급 없음, 정확도 비공개("힌트"), 잡거나 죽이지 않고 기록만 → 점검 문서 '참고' 절

## CAP-AI-22 — 2026-11-02 08:06~ · 전기 계통·제어 순서 (서현 없이 혼자 진행)
- 명령 (08:06): "히보라는 지금 해결할 수 없으니 어쩔 수 없고, 지금 내가 없이 너 혼자서 할 수 있는 것을 찾아서 해. 전기계통 이런 거 제어순서 이런 거."
- 한 일
  - 전기 계산 `design/control_sim/elec_budget.py` → `out/elec_results.json`: 부품 전류표(근거 표시), 상태별 전류·전력, 최대 전류(규칙 지킬 때 1.8 A / **켤 때 서보 4개 동시 3.2 A > 어댑터 3 A**), 퓨즈 **T2.5A 지연형**, 전선 강하(모두 0.13 V 이하), D5e 좌표로 배선 27개 길이(가닥 합 약 37 m), **CSI 리본: Pi가 데크 위면 약 680 mm → 위판 아래로 옮기면 290 mm(300 mm 케이블)**, 하루 에너지(9시간 약 68 Wh, 24시간 186 Wh → 보조배터리 20,000 mAh로 하루 못 감 → 현장 콘센트 권장), **`HOLD F 0` 권장**(역구동 0.64 N·mm vs 기어 마찰 59~118 N·mm)
  - 제어 순서 `design/control_sim/trap_sim.py`: Pi 상태 머신 참고 구현 + 가짜 UNO 1(지금 펌웨어 + 제안 명령)·UNO 2(제안 프로토콜)·카메라·말벌. **시나리오 17개 모두 통과**, 안전 규칙 5개 검사(서보 동시 1개, 펜 든 채로만 X·Y, 누르기·찍기 중 입구 닫힘, 끼임 0, 레일 최대 < 퓨즈). 한 마리 156 s, 대기보다 0.047 Wh만 더 씀
  - 시뮬레이션으로 찾아 고친 것: 멈출 때 문 2개 동시에 엶(→ UNO 2 서보 순서 + Pi가 OPEN 확인), 켤 때 문 상태 모름(→ BOOT에서 문 3개 먼저 닫음), 빔 하나 장부가 바짝 붙은 두 마리·문틈 되돌아옴을 잘못 셈(→ 카메라가 최종 판단, 문마다 빔 2개 D5f 제안), Pi가 멈추면 말벌이 눌린 채 남음(→ UNO 1 감시가 바닥 10 mm 내림), UNO 1이 꺼지거나 재부팅되면 펜이 무게로 떨어짐(→ `-hupcl` 또는 RESET–GND 10 µF)
  - 그림 4장 `design/img/control/` (전기_배선도_상세, 제어순서_타이밍_S1, 제어_상태도, 제어_메시지순서_S1) — `design/control_sim/make_figs.py`. 하나씩 열어 글자 겹침 고침
  - 문서 `design/2026-11-02_전기계통_제어순서_서현.md` (결론 10개, 상태별 전류표, 퓨즈, 접지 규칙, 핀 최종안, 신호, 문틈 빔 2개, 배선 길이, 하루 에너지, HOLD F, 상태 머신 표, UNO 2 명령 제안, UNO 1 바꿀 것, 시나리오 표, 남은 결정). 제어 통합 정리 문서 맨 위에 바뀐 값 8개 적음, `cad/README.md` D5f에 Pi 자리·빔 2개·단자대 추가
  - 승준에게 GitHub Issue #5: 펌웨어 제안(HOLD F 0, 서보 켤 때 안 붙이기, HOME, LIMIT D5e, PEN 2단계 + DONE, 펜 내림 중 X·Y 금지, 감시 동작, 하드웨어 WDT, HX711 80 Hz, UNO 2 프로토콜). 승준 control/ 파일은 안 고침
- 검증: 계산·시뮬레이션은 스크립트로 다시 돌려 같은 값 [확실]. 사양 근거 확인(Adafruit 열린 컬렉터·끊기면 LOW·20 mA, Pi 5 3.0/8.8/0.01 W, AI 카메라 1.87 W, Hailo-8L 1.5 W, Pi 5 카메라 케이블 200·300·500 mm). **미검증**: 조명·수신부 전류, 서보 실제 전류, 시간값 대부분(look 0.6 s, 급이 60 s, 말벌 나가는 20 s), 실제 하드웨어·말벌 행동, 문틈 빔이 끼임을 다 잡는지
- 남은 결정: Pi 위판 아래로 옮길지(서현 D5f), 문마다 빔 2개 + 실리콘 립(서현 D5f, 승준 구매 +3쌍), 다른 종 격리/방생(서현), 전원 방식 콘센트/배터리(서현 + 승준), 펌웨어 나누기 반영(승준), 인터페이스 정의서 전원·센서 줄(승준 확인 뒤)
- 09:25 서현 결정 (CAP-AI-22 계속): "1. 네가 적절하다고 생각한 대로 2. 네가 추천하는 대로 3. 일단 유럽말벌·등검은말벌 분류만 4. 콘센트로 하는데 배터리도 가능하게"
  - 1 → **Pi 위판 아래** (AI 판단, 서현 위임): CSI 290 mm → 300 mm 케이블
  - 2 → **문마다 빔 2개 + 실리콘 립** (AI 추천, 서현 위임): 빛 게이트 9쌍, UNO 2 A0~A5 = G1·G2·G2b·G3·G3b·G4, D7·D8·D12 = G5·G5b·G6. 시뮬레이션에 빔 2개(방향 판정)를 넣고 비교: 빔 하나면 S8a·S8b 끼임 1번씩, 2개면 0번
  - 3 → 분류 2종(VespAI와 같음), 2종 아님·불확실 → 격리(S5b 추가). **유럽말벌을 격리할지 놓아줄지는 서현에게 물음** — 그때까지 문서 규칙(격리) 유지
  - 4 → 본체 입력(USB-C, 배럴 5 V)은 그대로, 같은 플러그로 꽂는 **배터리 상자**(LiFePO4 12.8 V + 퓨즈 5 A + INA226 → Pi I2C + 강압 5.1 V 5 A·5 V 3 A). 12 Ah면 보통 1.7일·절약 2.3일. 배터리 부족이면 처리 끝내고 격리·입구 문 열고 Pi 끔(S14 추가). 값 13~19만 원 [추측]
  - 고친 파일: 전기계통 문서 다시 씀, `design/control_sim/*`(19개 통과), 그림 4장 다시, D6 10장 4줄, `cad/README.md` D5f, 제어 통합 정리 머리말, 인수인계, Issue #5 댓글
  - 남은 결정: 유럽말벌 격리/방생(서현), 배터리로 며칠 버틸지(팩 크기), 배터리 상자 구매 시기(서현 + 승준)

## CAP-AI-23 — 2026-11-06 15:25~ · 회로 설계·알고리즘·판단 정리 (서현 50분 자리 비움, 승준 AI와 같이)
- 명령: "저번에 하던 거 해. 50분 자리 비움. 승준 AI도 같이. 내 판단 필요한 것은 남기고 할 수 있는 전부. 회로 설계, 알고리즘 정리, 판단 정리. 50분 뒤 확인. 승준 업로드 5분마다 확인. 끝나면 세 페이지 md 요약(초등학생도 알게). 승준도 FreeCAD 쓰니 내 컴 도면 GitHub에. 승준 AI와 협력"
- 한 일
  - 협력: Issue #6 — 서현 쪽 `design/`(회로·알고리즘·판단), 승준 쪽 `control/`(펌웨어 UNO 1·2 나누기, Pi 코드) 제안. 5분마다 레포·Issue 확인하는 스크립트 돌림 (15:25~)
  - FreeCAD: 서현 PC `CAD files\`·`repo\cad\`의 .FCStd 9개가 레포와 크기까지 같음 → 이미 올라가 있음 [확실]
  - 회로 설계 `design/circuit/circuit.py` → 넷 60개·끝 211개, 검사 통과(UNO 1 18/18, UNO 2 17/17 + D13 예비, 핀 겹침 없음, UNO 5V ↔ 레일 안 이어짐), `out/netlist.csv`, `out/bom.csv`, 회로도 3장 `design/img/circuit/`. 문서 `design/2026-11-06_회로설계_서현.md`
  - 알고리즘·판단 `design/2026-11-06_제어알고리즘_판단_서현.md` + 흐름도 3장(`design/algo/*.mmd` → `design/img/algo/`): 문 닫기, 게이트 읽기·자가 시험, 장부(빔 2개 방향), 누르기·찍기, 방생·격리, 고장, 배터리, 판단표, 기준값 12개(9개는 실험 전 값)
  - 쉬운 요약 3쪽 `docs/2026-11-06_오늘한일_쉬운요약_서현.md`
- 검증: 회로 검사 스크립트 통과, 알고리즘은 `trap_sim.py` 19개 통과(11/02) [확실 — 시뮬레이션]. 실물·MOSFET 모듈 핀 이름·조명 전류 `미검증`
- ★ 서현 판단 필요: 유럽말벌 격리/방생, 꿀벌 등 다른 곤충 격리/방생, 여왕벌 기준 길이(표본), 배터리 며칠
  - (15:40) D5f 전기 배치 CAD: `cad/D5f_electrical_layout.py` → `.FCStd` + 그림 3장 (서현 PC FreeCAD로 실행). Pi 위판 아래, UNO 2 겹침, 단자대·비상 정지·ULN2003, 빛 게이트 9쌍 자리. 문 빔 블록이 문 하우징과 겹침 → 다음 단계 설계
  - (15:40) 승준 AI SJ-38 확인 (구매 부품 라이브러리, 기계 부품 McMaster 대조, Issue #7): 분담 합의(서현 = 전기·회로 BOM·D5f 형상, 승준 = 기계 구매 부품). 반영: 원점 스위치 KW11-3Z, D5f에서 스프링 204 지움, 28BYJ-48 고정 M4 × 2 (AI 판단, 서현 위임 범위 — CAD 담당). 바닥 스프링 146의 k는 ★ 서현 결정으로 남김
- 16:30 서현 (밖, 30분): "위 명령과 같아" → 이어서 D5f 문 빔 설계, 5분마다 승준 확인
  - 문 하우징 112·170·176 위·아래 벽에 Ø4.2 빔 구멍(문판 슬롯 면에서 2 mm 바깥: 입구·격리 x 23·29, 방생 x 81·87, 통로 가운데 y 0을 위아래로), 3 mm IR LED 자리 Ø4 × 8 [추측 — 실물 확인]. 입구 위 LED는 입구 윗벽 + 격리 하우징과의 5 mm 틈, 격리 아래 LED는 격리 아랫벽(8 mm) → 서로 안 겹침
  - 겹침 검사(`D5f_electrical_layout.check`): 문 LED는 겹침 0. ULN2003 X·Y 블록이 X 모터판·프레임과, G6 블록이 방생 서보와, G1 블록이 기존 114 센서와 겹침 → 자리 고침
  - (16:50) 자리 고침 뒤 겹침 검사 **0건** [확실 — FreeCAD common 부피]: ULN2003 X·Y는 갠트리 쪽 2020 기둥 바깥면(x 181~187), G6은 위아래 빔(x 120), G1은 기존 114 센서 그대로. D5f 다시 저장·그림 3장. 승준 업로드 16:30~16:50 없음

## CAP-AI-24 — 2026-11-06 17:05~ · 서현 답 반영: 격리 2개, 여왕벌 기준, 배터리 2일, 스프링 146 역학계산
- 명령 (17:05, 논문 PDF 2개 첨부 — Lioy 2021 하모닉 레이더, Rojas-Nossa 2022 둥지 찾기; 레포에 안 올림): "1. 가둬. 2. 가둬. 3. 논문 찾아봐서 너가 결정해. 4. 배터리 2일. 4. 너가 역학계산해서 정해. 'systemdesign s3 뭐시기' 채팅에 내가 다 올려 놓았는데 너는 못보나?"
- 한 일
  - 1·2: 유럽말벌·다른 곤충 → **격리** (서현). `trap_sim.py` PRM `crabro_action`·`other_action`, 판단 문서 3·7장, D6
  - 3: 첨부 논문 2개에는 여왕/일벌 크기 기준 없음(본문 검색). Pérez-de-Heredia 외 2017 (J. Hymenoptera Research 60:119–133): 중순판 폭 경계 4.5 mm, 5 % 불확실 띠 4.4~4.58 mm, 무게보다 잘 가름. → **중순판 폭 ≥ 4.4 mm면 여왕벌로 격리** (AI 판단, 서현 위임) — 여왕 놓치는 손해가 더 큼. 15.6 화소/mm면 70 화소, 띠 3 화소 → 전체 해상도 사진에서 잼 (`미검증`). `PRM gyne_mw_mm = 4.4`, 시나리오 S4b 추가 → **20/20 통과**
  - 4 배터리: 2일 (서현) → **LiFePO4 12.8 V 20 Ah** (AI 판단: 보통 2.84일, 15 Ah는 2.13일로 여유 6 %). `elec_budget.py` 표에 15 Ah 줄, 전기계통·회로 문서·BOM 고침
  - 5 스프링 146: `design/calc/spring146_calc.py`(조건 C1 넘침·C2 도달·C2b 붙잡기·C3 고장 안전·C4 진동·C5 강도/좌굴) + 자유물체도 `spring146_fbd.py` → 범위 94~118 N/m, **k = 0.1 N/mm (100 N/m)** (AI 판단, 서현 위임). 피아노선 d 0.4, D 7.5, 유효 6감김, 자유 길이 16 mm, τ 304 MPa, f_n 16 Hz → HX711 80 Hz 필수. 스프링 없으면 10 Hz에서 최대 135 % 넘침. 문서 `design/2026-11-06_S4_스프링146_역학계산_서현.md`, 그림 `design/img/calc/spring146_FBD.jpg`·`spring146_힘_거리.png` (열어서 겹침 고침)
  - 쉬운 요약 3쪽, D6 10장 4줄 추가
  - 지난 채팅: 'System design S3 and S4 sessions' 채팅은 검색으로 찾음 — 태양광 추적기 수업 내용이라 말벌 스프링 값은 없음
- 검증: 스프링 계산·시뮬레이션 다시 돌려 같은 값 [확실]. **미검증**: F_safe 1.0 N(R7 전 임시), k_c 300~3000 N/m, 말벌 높이 6.5~8.5 mm, 카메라 중순판 폭 측정 정확도
- 남은 일 (순서): ① D5f CAD 스프링 146 길이 10 → 16 mm, 밀대·칼라 6 mm 위로 + 그림 ② trap_sim PRESS 시간에 닿은 뒤 2.6 s 반영 ③ R7 표본 압축 시험 뒤 F_safe 바꿔 다시 계산 ④ 승준 표본 7마리 중순판 폭 재기
- 남은 결정: 없음 (R7 결과가 F_safe < 0.8 N이면 누르기 방식 다시 의논)

## CAP-AI-25 — 2026-11-06 18:07~ · 여왕벌 크기 재는 법, 교재 유제 5개 + 스프링 146 역학계산 2차
- 명령 (18:07, 교재 PDF 4권 첨부 — Gere 고체역학, Riley 정역학, Shigley 기계요소설계, Meriam 동역학; 레포에 안 올림): "1. 알았어. 2. 여왕벌의 크기는 어떻게 확인이 가능해? 욜로는 개체를 파악하는 것이지 크기를 파악하는 도구가 아니잖아. 방법을 생각해내. 3. 알겠어. 4. 고체역학 동역학 정역학 기계요소설계 pdf를 줄테니까, 관련 문제 5개 풀고, 역학 계산을 해. 확실 98퍼센트 이상으로 항상 만들어."
- 한 일
  - 유제 5개 `design/calc/spring146_textbook_check.py`: T8 Riley 9-6, T9 Gere 2-1 (sympy 기호식), T10 Meriam 8/1 (식 + 수치 적분), T11 Shigley 10-1, T12 Shigley 10-2 (표 3칸 포함) → **52/52 일치 (≤ 2 %)**. 교재 산술 오류 2개 찾음: Shigley 10-1 F = 28.63 N (교재 28.26), 10-2 Ls = 24.68 mm (교재 24.3)
  - 역학계산 2차 `design/calc/spring146_calc2.py` + 그림 `spring146_fbd2.py` (안내 마찰 FBD, 동역학 FBD, 시간 응답 — 열어서 반력 방향·겹침 고침)
    - A 정역학: 지금 밀대 안내(Ø5 × 5 mm PLA)면 말벌이 20 mm 벗어날 때 실제 누르는 힘이 F_p의 20~38 % → LM4UU 12 mm면 98~99 %. 바닥판은 벽에 못 낌(39.46 < 40)
    - B 고체: 직렬 5요소 k_eff와 스프링만의 차이 0.13~0.17 % → 로드셀 읽음 = 스프링 힘
    - C 동역학: 닿는 순간 ±0.011 N (2.1 %), 시간 적분 최대 넘침 10 Hz 6.1 % / 80 Hz 3.6 % (닫힌식 4.5 + 2.1과 일치)
    - D 기계요소: 1차 스프링 C 18.75 > 12 (Shigley 권장 밖), 1차 G 79.3 → 82.7 GPa로 고치면 k 104.5. 156줄 표에서 조건 모두 만족 3개 → **d 0.229, D 2.63, Na 15, L0 14.7, Ø2 핀, k 103.6 N/m** (AI 판단, 서현 위임). 서지 808 Hz < 반걸음 1000 Hz의 15배 → 힘 0.0004 N로 무시 가능, 반걸음 700~900 Hz 금지
  - 문서 `design/2026-11-06_S4_스프링146_역학계산_2차_서현.md`, 1차 문서 머리말, 유제 문서 T8~T12 줄, 쉬운설명 추가, D6 3줄
  - 여왕벌 크기 `design/2026-11-06_여왕벌_크기측정_방법_서현.md`: YOLO는 찾기만(640 입력이면 2.5 화소/mm), PRESS 때 격자 아랫면에 붙은 등 + 같은 사진의 격자 눈금 4.4 mm로 배율 + 원본 해상도 조각에서 견판 키포인트 2점 + 5장 중앙값. σ ≤ 0.10 mm면 신여왕(≥ 4.61) 놓침 1.8 %. 몸 높이·무게는 기록만
- 검증: 유제 52/52, 넘침 두 방법 일치 [확실]. **미검증**: PLA μ, F_safe, k_c, 로드셀 처짐, 키포인트 오차 σ (표본 시험 J7 제안)
- 남은 결정 (서현): ① 밀대 안내를 LM4UU로 바꿀지 ② 새 스프링 사양을 기본으로, 기성품 없으면 1차 사양으로 할지 ③ 여왕벌 폭을 못 잴 때 규칙 (A 계절 규칙 권장 / B 늘 격리 / C 늘 일벌)
- 남은 일: D5f CAD (스프링 14.7 mm + Ø2 핀, LM4UU 결정 뒤 보스), 승준 Issue (키포인트 모델, 스프링 구매, 펌웨어 반걸음 금지 대역)

## CAP-AI-26 — 2026-11-06 18:32 · 서현 답: 스프링 기성품만, 계절 규칙
- 명령: "1. 밀대안내가 뭐야? 2. 새 스프링을 기본으로 하고 기성품을 무조건 쓰게 해. 3. 계절 규칙을 사용한다."
- 한 일
  - 1: 밀대 안내 설명 (답변). LM4UU 결정은 대기
  - 2: 기성품 검사 `design/calc/spring146_catalog_check.py` — 카탈로그 값(OD, d, L0, k, Ls)으로 7조건(K·T·S·F·O·R·H) 검사. 목표(2차)·차선(1차) 둘 다 통과. 2차 문서 7장, D6 고침. 승준 Issue #7에 구매 조건 댓글
  - 3: 계절 규칙 `trap_sim.py` (`month`, `season_queen_months` 3~5·9~11), 시나리오 S4c·S4d 추가 → 22/22 PASS. 여왕벌 문서 6·8장, 판단 문서, D6
- 검증: 시뮬레이션 22/22, 검사 스크립트 실행 [확실]. 기성품 실제 후보는 승준이 카탈로그로 찾음 (`미검증`)
- 남은 결정: 밀대 안내 LM4UU (서현)

## CAP-AI-27 — 2026-11-06 18:38 · 밀대 안내 바꿈 (기성품 최대)
- 명령: "최대한 기성품으로 사용할 수 있게하고. 바꿔"
- 한 일
  - 바닥판 121에 LM4UU를 넣으면 칼라가 보스에 부딪침(치수 확인) → LM4UU를 캐리지 안에, 스프링·로드셀을 캐리지 아래 컵으로 옮김. 기성품: Ø4 × 80 경화 축, LM4UU, 스프링(카탈로그), 버튼 로드셀. 출력품은 원래 있던 캐리지(컵 한 몸)·바닥판·바닥만 고침 → 출력 부품 수 그대로
  - FreeCAD (서현 PC): `cad/D5f_electrical_layout.py` `floor_guide()`, `check_floor()` → 0 / 18.25 / 36.5 mm 겹침 0건. FCStd·그림 4장 다시 (`D5f_바닥안내_정면.png` 새)
  - 계산 다시: 바닥 무리 질량 19.2 g (강철 축 + PLA 밀도; 앞선 9.86 g은 부피를 g로 읽은 값 — 고침). 축이 바닥 가운데에서 벗어나 e 최대 34.9 mm → LM4UU면 F_p의 97.2~98.8 %. 넘침 5.3 % (10 Hz) / 4.4 % (80 Hz). 목표 스프링 자유 길이 15.75 mm
  - 스프링 기성품 조건: 컵 구멍 Ø4.4 → 바깥 2.8~4.1 mm, 평균 지름 ≤ 3.6 (`spring146_catalog_check.py`). 1차 사양(바깥 7.9)은 이제 불합격
  - 2차 문서 8장, D6, cad/README
- 검증: 겹침 검사 0건 [확실 — FreeCAD], 계산 재실행 [확실]. LM4UU μ, 로드셀 실물 치수 `미검증`
- 남은 일: 승준 구매 목록 (축 Ø4 × 80 h6 경화, LM4UU, 스프링 후보 검사), 실물 로드셀 치수로 컵 고침

## CAP-AI-28 — 2026-11-06 18:46 · 마무리, 승준 AI 인수인계
- 명령: "이제 지금 하던거 마무리 준비하고, 승준 ai에서 이어서 할 수 있게해. 우리는 지금 캐드가 아니라 회로도 준비하고 그런거 해야된다니"
- 한 일
  - 승준 작업지시 새 판 `docs/2026-11-06_승준_작업지시.md`: 읽을 순서, 11/06 결정표, 구매(축·LM4UU·스프링 조건·로드셀 치수 확인·RTC 배터리 등), 펌웨어(HX711 80 Hz, 반걸음 금지 대역, 한계 0.4 N 규칙), 비전(키포인트 모델, 계절 규칙), 시험(J7 폭 오차, R7), CAD는 스크립트 `FG` 값만
  - 회로 쪽 반영: BOM에 Pi 5 RTC 배터리 추가(계절 규칙 날짜 유지), 로드셀 자리 이동 메모, 하네스 좌표 LC (65, 4, 241). 회로 검사 통과
  - 인수인계 파일 갱신, Issue #7 댓글
  - 직전 PC 동기화(18:46 중단)는 PC 파일 시각으로 확인 → 써져 있었음, 이번 커밋분과 함께 다시 맞춤
- 서현 쪽 다음 (회로도 준비): 회로도 3장 다듬기, 하네스 표(선 길이·커넥터), 브레드보드 순서, 배터리 상자 회로, 인터페이스 정의서 전원·센서 줄

## CAP-AI-29 — 2026-11-06 18:55 · 회로 쉬운 설명, 부품 보유·구매 정리, 새 채팅 시작 명령
- 명령: "회로도 내용 C:\...\제어 여기다 계속하고, 중요한 것부터 하나씩 해. 회로도 내용을 모르겠어. 나를 이해시키는 md 파일도 필요하고, 초등생 수준. 제어랑 회로는 너한테 전적으로 맡길게. 내가 가지고 있는 제어 회로 부품 정리하는 md 파일도 만들고, 새로운 채팅에서 캡스톤 프로젝트 제어부 설계를 시작하는 명령을 md로 적어줘"
- 한 일
  - **BOM 오류 고침** (중요): HX711 + 로드셀, 빛 게이트 9쌍을 '보유'로 잘못 적었음 → 둘 다 **살 것** (구매목록 D2·G6, 보유 사진 목록에 없음). UNO 4·28BYJ-48 1·MG90S 1(혼 없음)·SG90 1 보유 수량 반영 (`design/circuit/circuit.py` → bom.csv, 회로 문서)
  - 부품 정리 `design/2026-11-06_제어회로_부품_보유와_구매_서현.md` — 보유 / 구매함 / 살 것, 사는 순서, 실물 확인 부탁
  - 쉬운 설명 `design/2026-11-06_회로_쉬운설명_서현.md` + 한 장 그림 `design/img/circuit/회로_한장그림.png` (`design/circuit/kid_figure.py`, 열어서 겹침 고침)
  - 새 채팅 시작 명령 `docs/2026-11-06_새채팅_제어부설계_시작명령.md` — 다음 순서: 구매 확정표 → 하네스 표 → 브레드보드 단계 → 회로도 다듬기 → 배터리 상자 → 인터페이스 정의서
  - PC `제어\` 에 10~12번으로 복사, 00_읽는순서 갱신
- 검증: 회로 검사 통과 [확실]. 보유 수량은 사진 판독 기반 → UNO·SG90·USB 케이블·키트 저항/커패시터 `실물 확인`
- 남은 결정: 없음 (제어·회로 전부 위임)

## CAP-AI-30 — 2026-11-06 20:15 · 깃허브 확인, 승준 질문 4개 반영 (제어·회로 위임)
- 명령: "깃허브 확인하고 하던거 계속해"
- 확인: 승준 SJ-40~45 (D5g 급이·방생·실제 전기 부품 CAD), Issue #7 질문 — ① 단자대 → 와고 221 + 줄 퓨즈 ② 방생 출구 조명 빼기 ③ 조명 MOSFET 줄이기 ④ 밤 방생 규칙
- 결정 (AI 판단, 서현 위임): ① 채택 (+5 V 221-415 ×2, GND ×3, 서보·게이트 허브 만능기판은 남김 — 가는 선·풀업 때문) ② 채택: 방생 때 마킹실 불만 끔 ③ 채택: MOSFET 3, UNO 2 D6 예비 ④ **NIGHT_HOLD**: 해 진 뒤에는 방생을 시작하지 않고 급이 자리·불 끔으로 아침(해 뜬 뒤 30분)까지
- 고친 것: `trap_sim.py` (EXIT 조명 명령 없앰, daylight/night_hold, S15) → **23/23 PASS**; `circuit.py` (Q3·L_EXIT 없앰, D6 예비, 와고·허브·줄 퓨즈 BOM) → 넷 58, 검사 통과, 회로도 다시; `elec_budget.py` (출구 조명 0, G6 x 108, 하네스 줄 하나 뺌); 판단 문서 A5·10장, 회로 문서, 전기계통 문서 표, 부품 파일, 쉬운 설명·한 장 그림
- 남은 일 (순서): 전기 부품 구매 확정표(국내 판매처) → 하네스 표 → 브레드보드 단계 → 회로도 다듬기 → 배터리 상자 → 인터페이스 정의서

## CAP-AI-31 — 2026-11-06 20:30 · 전기 부품 구매 확정표 (국내 판매처)
- 한 일: `design/2026-11-06_전기부품_구매확정표_서현.md` — 1차(시험 1~3단계)·2차(움직임)·3차(나중) 주문표, 디바이스마트·아이씨뱅큐·엘레파츠·메카솔루션 링크, 읽은 가격 (MG90S 3,410, 빛 게이트 2167 3,608, KW-11-3Z 660, Adafruit 4540 1 kg 로드셀 6,710, RTC 배터리 13,200원)
- 결정 (AI 판단, 서현 위임): **로드셀 버튼형(P2981 145,200원) → 막대형 500 g~1 kg** (승준 CAD에서 캐리지 아래 외팔보로); **와고 221 → 222-415** (222는 28~12 AWG, 221은 24~12 AWG — RS 사양); 인라인 퓨즈 홀더·T2.5A를 국내에서 못 찾아 패널형 F-520 + 5×20 3 A
- 회로 BOM·부품 파일 고침, 회로 검사 통과
- 미검증: 페이지에서 가격을 못 읽은 항목(어댑터·퓨즈·비상 정지 NC 여부·와고·모터 팩·HX711·MOSFET), IRF540N 5 V 구동 여유

## CAP-AI-32 — 2026-11-06 20:27 · 깃허브 확인 (승준 SJ-46 밤 규칙), 하네스 표
- 명령: "다음 할일 해 깃허브 올리고 깃허브 확인하고 할일 해"
- 깃허브: 승준 SJ-46 `control/pi/daynight.py` — **밤에는 처리 안 하고 전부 포획통으로** (승준 결정 20:23), 와고 221-415 받침, UNO 실제 모양
- 반영: 내 NIGHT_HOLD(CAP-AI-30)와 다름 → 처리는 해 짐 30분 전까지만 시작하고 한 번에 약 3분이라 차이가 작아 **승준 안을 따름**. `trap_sim.py` `night()` (방생 문 닫고 입구·격리 문 엶, 조명 끔), 처리 중 해 지면 격리, S15_night(20:00 → 포획통)·S16_before_dusk(16:50 → 찍고 방생) → **24/24 PASS**. 판단 문서 A0·A5·10장
- 하네스: `design/circuit/harness.py` → `out/harness.csv`(117가닥), `out/harness_table.md`, 문서 `design/2026-11-06_하네스표_서현.md` (쉬운 설명 포함). 42묶음, 29.9 m, 최대 강하 0.12 V(펜 서보), 휨 고리 4개
- 미검증: 허브 자리·D5g 실제 좌표, 기본 선 길이(서보 250·모터 240 [가능성 높음])
- 다음: 브레드보드 단계별 배선 안내 → 회로도 다듬기 → 배터리 상자 → 인터페이스 정의서
- (20:35 보탬) 승준 구매 M22(와고 221-415 ×2)·CAD와 맞추려고 **와고를 221-415로 되돌림** (와고에는 20~22 AWG만 꽂으므로 221로 충분), 개수는 5개 필요하다고 Issue로 알림

## CAP-AI-33 — 2026-11-06 20:36 · 회로 논리: 브레드보드 단계별 배선 + 회로도 다듬기
- 명령: "오케이 회로논리 설계해. 다음 할 일을 진행해." (앞 질문: 도면 먼저냐 → 회로 논리는 도면과 별개, 하네스 길이만 도면 뒤)
- 한 일
  - `design/2026-11-06_브레드보드_단계별_배선_서현.md`: 1단계 힘 전기 길 → 2단계 UNO 2 + 빛 게이트(자가 시험·레일 감지) → 3단계 문 서보 + 문 빔 2개(끼임 방지) → 4단계 UNO 1 + 바닥 축(원점) → 5단계 로드셀 + 전부 연결(1.9 A 아래). 단계마다 꽂을 것(하네스 번호·핀)·통과 기준·안 될 때, 사진 기록, 부품 오기 전 대신 쓸 것, 쉬운 설명
  - 시험 스케치 `design/circuit/bringup/` b2_gate, b3_door, b4_axis, b5_loadcell (회로 시험용, 펌웨어 아님 — HX711은 라이브러리 없이 직접 읽음)
  - 회로도 다듬기: **2장에서 D2~D13 선이 한 세로줄로 모여 전부 이어진 것처럼 보이던 오류**를 넷 라벨(F_IN1…Y_IN4)로 고침, ULN 이름 겹침 고침; 1장 GND 선이 C1 이름 위를 지나던 것·+5V_B 이름 겹침 고침, 퓨즈 표기 5×20 3 A. 세 장 열어서 확인
- 미검증: **스케치 컴파일 못 함** (이 환경에서 아두이노 컴파일러 설치가 막힘) → 첫 업로드 때 IDE 확인. 서보 각도·로드셀 선 색은 실물
- 다음: 배터리 상자 회로 → 인터페이스 정의서 (전원·센서 줄) → (D5g 뒤) 하네스 확정

## CAP-AI-34 — 2026-11-06 21:00 · 승준 SJ-47 반영: 문 빔 6쌍을 낱개 IR LED + 포토TR로 (회로 논리)
- 깃허브: 승준 ade7965 — 문 하우징 틈 5 mm에 Adafruit 2167 몸통(20 × 10 × 8)이 안 들어가 문 빔 6쌍은 3 mm LED·수광 소자 낱개, 통로 3쌍만 2167
- 회로 결정 (AI 판단, 서현 위임): LED: +5V_B → 220 Ω → IR LED → Q4(송신 켜기 공통) / 포토TR 이미터 팔로어: +5V_B → C, E → 핀 + 10 kΩ → GND (빛 받으면 HIGH, 2167과 같은 방향) / **아날로그로 읽고 문턱값 = (켬 + 끔)/2를 켤 때 자가 시험으로**, 차이 < 200이면 고장 / **핀 바꿈: 문 빔 G2·G2b·G3·G3b·G5·G5b → A0~A5, 통로 G1·G4·G6 → D7·D8·D12**
- 고친 것: `circuit.py` (넷 64·끝 211, 검사 통과, 회로도 3장 다시 — 열어서 확인), `harness.py` (문 빔 4선, 42묶음 111가닥 35.1 m), 시험 스케치 b2(G1 → D7)·b3(아날로그 + 자가 시험 문턱값), 회로 문서 핀 표, 쉬운 설명, 브레드보드 안내, 구매확정표 (2167 4개 + LED·포토TR 각 10개, 읽은 가격 합 약 5.46만 원), 부품 파일, elec_budget 메모
- 미검증: 포토TR 출력 크기(거리 6~10 mm, LED 17 mA에서 켬·끔 차이 ≥ 1 V 예상 [추측]), 스케치 컴파일
- 승준에게: 펌웨어 핀 표 바뀜 (Issue #7)

## CAP-AI-35 — 2026-11-06 22:00 · 회로 논리: 배터리 상자 회로
- 명령: "오케이 회로논리 설계해. 다음 할 일을 진행해." (이어서) — 앞서 CAP-AI-33/34 변경을 PC 제어 폴더와 맞춤 (42개 파일, 00_읽는순서에 15번 추가)
- 한 일: `design/circuit/battery_box.py` (넷 11·끝 32, 검사 6가지 통과, 계산, GND 고리 계산, 회로도 4장 — 열어서 확인), 문서 `design/2026-11-06_배터리상자_회로_서현.md`, 쉬운 설명 `design/2026-11-06_배터리상자_쉬운설명_서현.md`
- 찾은 것: ① 흔한 INA226 모듈(R100 0.1 Ω)은 0.82 A까지만 잼, 우리는 최대 2.0~3.1 A → **R010(0.01 Ω)**, CAL 2560 ② 배터리일 때만 GND 고리 — 구동 되돌이 전류의 약 30 %(0.54 A)가 UNO USB로 돎 (32 mV) → 18 AWG 배럴 선 + 별 모양 GND + B6 시험(< 50 mV), 넘으면 절연형 Mean Well SD-15A-5 ③ 충전 단자는 분류 저항 뒤 ④ INA226은 적산 없음 + 밤에는 꺼짐 → Pi가 더함 (승준 코드)
- 결정 (AI 판단, 서현 위임): BB1~BB7 (퓨즈 5 A, R010, 조정형 CV/CC 강압 전류 제한 4 / 3.2 A, USB-C 전원 전용 꼬리선·PSU_MAX_CURRENT 안 넣음, 0 °C 아래 충전 금지, UPS 없음, GND 고리 시험 후 판단)
- 계산: 배터리 전류 대기 0.64 / 규칙 최대 2.01 / 최악 3.08 A, Pi 보드 4.99 V, 2.88일
- 미검증: 접점 저항 10 mΩ, 강압 무부하 0.05 W, SD-15A-5 무부하 — 실측. 강압 모듈 실제 제품은 승준 구매
- 근거: [SD-15A-5 RS](https://uk.rs-online.com/web/p/dc-dc-converters/0183821), [INA226 모듈 분류 저항 done.land](https://done.land/components/power/measuringcurrent/viashunt/ina226/)
- 다음: 인터페이스 정의서 전원·센서 줄 (변경 이력) → (D5g 뒤) 하네스 확정

## CAP-AI-36 — 2026-11-06 20:53 · 인터페이스 정의서 5차 값 (전원·센서·운용)
- 명령: "다음도 해"
- 한 일: `design/인터페이스_정의서.md` (공동 편집) — 하중 센서 막대형, 원점 스위치 UNO 1 A3~A5, 진입 감지 → 빛 게이트 9쌍(핀·종류·자가 시험), 전원 줄(퓨즈 3 A·비상 정지·와고·최대 1.8 A), 배터리 상자 줄, 운용 시간(승준 낮·밤 규칙), 여왕벌 판정 줄, Pi ↔ 아두이노 UNO 2개 핀, 상태 머신 보탬 1줄, **변경 이력 행 추가**
- 안 바꾼 것: 카메라·구동기 1~7 줄(기구 값, 11/02 그대로), 통신 명령 목록(승준 펌웨어)
- 검증: 문서 안 값을 회로설계·배터리상자·판단 문서·승준 SJ-46/47과 대조 (핀 표는 circuit.py 검사 통과 값)
- 남은 결정: 없음 (서현). 승준 확인: 펌웨어 핀 표, 하중 센서 막대 자리, J_I2C 자리
- 다음: (D5g 좌표 오면) 하네스 확정 / 승준 답(2167 보유 여부) 반영

## CAP-AI-37 — 2026-11-06 20:55 · 펌웨어 변경 요청 (승준 파일이라 요청만)
- 명령: "그렇게 해" (펌웨어 핀 표 바뀐 부분을 정리해 Issue로)
- 한 일: `control/firmware/trap_controller/trap_controller.ino` v0.1을 회로와 대조 → **UNO 1개 기준, 핀 10개 다름** (PEN A3→A0, HX711 A4/A5→A1/A2, 원점 A3~A5 없음, 문 서보 3개·빛 게이트·조명·송신·레일 감지는 UNO 2로). 요청 문서 `design/2026-11-06_펌웨어_변경요청_서현.md` (UNO별 표, HOME·SELFTEST·GATES·DOOR CLOSE 안전 규칙·LIGHT·EMIT·RAIL 명령 제안, 켤 때 서보 하나씩, HOLD F 0 권장, Pi 포트를 READY 이름으로 구분, 시뮬레이터 시험 4개) + 새 Issue
- 근거 값: elec_budget worst_cases (켤 때 3.27 A), hold_check (마찰 92배 이상, 9시간 3.7 Wh)
- 고치지 않은 것: control/ 전부 (승준 담당)
- 다음: 승준 답 기다림 (2167 보유, D5g 좌표, 펌웨어)

## CAP-AI-38 — 2026-11-07 16:14 · 승준 D5g 자리로 하네스 확정
- 명령: "승준이 올렸으니까 맞추어서 작업하면 되고, 이제 승준은 내가 말할 때까지 작업을 하지 않을 거야. 하던 거 계속해" (승준 요약 PDF '내가 뭐한거지???' 첨부)
- 확인: 승준 SJ-49 답(Issue #7) — **2167 보유 0** (M26 고침, 4개 삼), D5g 자리(와고·허브·MOSFET·퓨즈·비상 정지·J_I2C·UNO·Pi·ULN·막대 로드셀). 펌웨어(Issue #8)는 승준이 쉬므로 그대로 대기. 승준 새 파일 15개 PC에 옮김
- 한 일: `design/circuit/harness.py` P_EXTRA·`elec_budget.py` P를 D5g 값으로, **S13 J_I2C → Pi 4선** 추가, 산 케이블 길이 확인(USB 충분, **카메라 FFC 320 > 300 mm → 500 mm 삼, E18**), 하네스표 문서 갱신 (43묶음·115가닥·45.1 m), 구매확정표 E7(보유 0)·E17(길이)·E18
- 고침: 쉬운 그림·쉬운 설명·11/02 전기계통의 '퓨즈 T2.5A' → 5×20 3 A (CAP-AI-31 구매와 맞춤; 국내 2.5 A 찾으면 바꿔 끼움)
- 검증: harness·circuit(검사 통과)·battery_box(통과)·trap_sim 24/24 PASS 다시 돌림. FreeCAD로 모델에서 직접 좌표를 뽑으려 했으나 PC FreeCAD 연결 실패 → 승준이 Issue에 적은 값 사용
- [제안] (D5g 모델에 없음): HX711 (66, 95, 210), DC 잭 (−184, −22, 225) → 승준이 다시 작업할 때 CAD에
- 승준 PDF에서 고칠 곳 (승준 파일이라 Issue에만): 22쪽 '줄 퓨즈 2.5 A·T2.5 A 지연형' → 5×20 3 A 패널 홀더, 45쪽 '하루 72 Wh' → 80 Wh(20마리, 배터리 문서)
- 다음: 서현 쪽 회로 일은 끝 — 남은 것은 부품 도착 후 브링업 B1~B6, 승준 복귀 후 펌웨어(#8)·CAD 2자리

## CAP-AI-39 — 2026-11-07 16:35 · VS Code + Claude Code 시작 정리
- 명령: "지금까지 하는 거 vscode에서 실행해서 실제로 사용할 코드까지 만들어 버리고 싶은데 vscode에서 클로드 코드 실행하도록 정리해 줄래"
- 한 일: `docs/2026-11-07_VSCode_ClaudeCode_시작정리_서현.md` — 설치(winget: Git·VS Code·Arduino CLI·Python, Claude Code), 레포를 C:\capstone에 새로 clone(PC 사본은 git 아님·한글 경로 빌드 문제), arduino:avr·Servo, 확장 설치·로그인, **첫 메시지**(펌웨어 trap_motion·trap_doors·pi_link를 design/circuit/firmware/에 — control/는 승준 파일이라 안 고침, 컴파일·시뮬 시험 4개, 로그 CAP-AI-40~), 막힐 때 표
- 인수인계 파일 2026-10-28 → 2026-11-07로 이름 바꾸고 11/06 밤~11/07 줄 추가 (git mv), README 링크 고침
- 근거: Claude Code 공식 문서 setup·vs-code 페이지 (설치 명령·VS Code 1.94 이상·유료 계정 필요)
- 남은 결정 (서현): 펌웨어를 서현 폴더에 둘지, 분업계획을 바꿔 control/를 직접 고칠지 — 문서 0장 2번

## CAP-AI-42 — 2026-11-08 17:54 · (웹 채팅) 펌웨어 v0.2 제어 규칙 검토
- 명령: "코딩하려는 것은 vscode에서 하고 제어 규칙 같은 것은 너가 다 하는 것이 맞지 않나? 너가 해"
- 나눔: 제어 규칙 = 웹 채팅 Claude, 코드 = VS Code Claude, 연결 = GitHub 문서 (번호는 같은 CAP-AI 줄을 이어 씀)
- 한 일: VS Code 커밋 7ab95b5(trap_motion·trap_doors) 전체를 변경 요청·trap_sim과 대조 → `design/2026-11-08_펌웨어v0.2_제어규칙_검토_서현.md`
  - 변경 요청 규칙 모두 들어감, VS Code가 정한 규칙 V1~V7 받아들임 (V6 HOME 최대 축별 → 변경 요청 20480 고침, V7 PRESS 중 HOLD 불필요 — hold_check 92배)
  - 고칠 것 R1: F를 올리는 MOVE·PRESS는 펜 UP일 때만 (내리기·HOME F는 언제나)
  - Pi 순서 규칙 P1~P7 (G1 FAIL이면 시작 안 함, 빔 FAIL 재시험, 밤 순서 REL CLOSE 먼저, RAIL 복귀 시 PEN UP→HOME, WATCHDOG 5, BLOCKED 5 s 재시도 ×3, 응답 이름 DONE DOOR — trap_sim은 EVT DOOR)
- VS Code 세션 질문(시뮬 컴파일러)에는 'WinLibs g++ 설치'를 권함 — 실제 .ino를 시험

## CAP-AI-43 — 2026-11-08 18:21 · (웹 채팅) D5g CAD 인수 — VS Code 작업 지시
- 명령: "cad가 완벽하게 정리가 되지 않았으니까 그것을 해야 될 듯… 내가 총지휘라서 내가 수정해도 돼" → "vscode에서 cad 할래"
- 한 일: `docs/2026-11-08_CAD_D5g_정리_작업지시_서현.md` (C1 FCStd 저장 → C2 겹침·뜬 부품 검사 → C3 HX711·DC 잭 추가 → C4 전체 조립도·전기 배치·풍선도 그림 → C5 README·부품표 → C6 PC CAD files), 분업계획에 '바뀜(11/08)' 추가
- 확인: D5g는 .FCStd 없음(승준이 '서현만 편집' 규칙으로 저장 안 함), 그림은 GUI 필요 → freecadcmd + 매크로 실행으로 나눔
- 남은 결정 (서현, 그대로): 방생 출구 안 1/2, 급이 바닥 370, 3D 프린터 판 크기

## CAP-AI-40·41 — 2026-11-08 · (VS Code) 펌웨어 v0.2 trap_motion · trap_doors (커밋 7ab95b5 — 그때 로그를 못 적어 여기 채움)
- 명령: `docs/2026-11-07_VSCode_ClaudeCode_시작정리_서현.md` 5장 첫 메시지 (A·B)
- 한 일: `design/circuit/firmware/trap_motion/trap_motion.ino` (UNO 1: F·X·Y D2~D13, PEN A0, HX711 A1/A2, 원점 A3~A5 + HOME, HOLD 기본 0, READY trap_motion), `trap_doors/trap_doors.ino` (UNO 2: 레일 D2, 조명 D3·D5, 송신 D4, 게이트 D7·D8·D12, 문 서보 D9~D11, 문 빔 A0~A5, SELFTEST·GATES·EVT GATE·DOOR CLOSE 안전 규칙·LIGHT·EMIT·RAIL, READY trap_doors)
- 스스로 정한 규칙 V1~V7 → 웹 채팅이 CAP-AI-42에서 모두 받아들임
- 검증: arduino-cli 1.5.1 + arduino:avr 1.8.8, 경고 모두 켜고 0개. 브링업 b2~b5도 처음으로 컴파일 통과 (CAP-AI-33 '미검증' 풀림)
- 미검증 (#define): 문 열림/닫힘 30°/150°, 닫는 속도 100 °/s, 펜 천천히 시작 12°, 스위치 거름 3번, 원점 다시 닿는 속도 2000 µs

## CAP-AI-44 — 2026-11-08 · (VS Code) 검토 반영 + 펌웨어 PC 시뮬레이터
- 명령: "새로 받은 검토 문서 읽고 반영해, 만들 파일은 C:\capstone\-capstone-project-repo\관련코딩저장 여기에다 저장해" (+ 시뮬 컴파일러: 'WinLibs g++ 설치' 선택)
- 검토 반영 (`design/2026-11-08_펌웨어v0.2_제어규칙_검토_서현.md`): **R1** — F를 올리는 MOVE·PRESS는 펜 UP일 때만 `ERR PEN_DOWN`, 내리기·HOME F는 언제나 / 변경 요청 문서 1장 고침: V6 HOME 한도 축별(F 20,634·X 20,379·Y 31,587), V7 PRESS 중 HOLD 1 필요 없음
- 컴파일러: WinLibs는 GitHub 504로 두 번 실패 → **zig 0.17 (`zig c++`, clang 22)** 설치. `관련코딩저장/sim/`: 흉내 헤더 + 세계(코일 패턴 → 기계 위치, 스위치, HX711 클럭, 빛 게이트 9, 레일), 실제 .ino를 그대로 include, `run_all.ps1`
- 시험: **sim_motion 82/82, sim_doors 77/77** — 요청한 4개(HOME NOSWITCH, 닫는 중 빔 끊김 → REOPEN·BLOCKED, SELFTEST FAIL → 닫기 거부, RAIL 0 → 문 명령 거부) + R1 + V1~V6 + 펜 2단계 58.8 °/s
- **시뮬이 찾은 펌웨어 버그 2개 (고침, 웹 채팅 검토 필요)**:
  1. trap_doors: 열리는 중 같은 문 CLOSE → WAIT 끝에 prev=OPENING으로 굳음 → `ERR BUSY` (고치기 전 코드로 돌리면 2 FAIL [확실])
  2. trap_motion: 마지막 반걸음 코일을 켜자마자 끔 → `COIL_OFF_DWELL_MS` 20 ms 뒤 끔 (승준 v0.1도 같음, 실물 효과 미검증)
- 컴파일 (경고 0): trap_motion 11,968 B 37 % / RAM 972 B 47 %, trap_doors 10,956 B 33 % / RAM 1,006 B 49 %
- 만든·고친 파일: `관련코딩저장/sim/*`, `관련코딩저장/README.md`, 두 .ino, 변경 요청 문서, `.gitignore`(exe·pdb)
- 메모: 펌웨어 .ino는 `design/circuit/firmware/`에 그대로 둠 (Arduino 폴더 이름 규칙 + 다른 문서가 가리킴). 새 파일만 `관련코딩저장/`

## CAP-AI-45 — 2026-11-08 · (VS Code) Pi 연결 코드 pi_link (할 일 D)
- 한 일: `관련코딩저장/pi_link/` — `uno_link.py`(OK/ERR와 비동기 DONE·EVT·ERR HOME/WAIT 구분), `ports.py`(READY 이름으로 두 포트, 놓치면 STATUS 모양으로), `controller.py`(켤 때: WATCHDOG 5 → SELFTEST → RAIL → 문 3개 닫기 → HOLD F 0 → PEN UP → HOME F·X·Y → 대기 자리 + PEN DOWN, 검토 P1~P7, 밤/낮, 레일 복귀), `sim_port.py`
- 시험: `test_pi_link.py` **36/36** — 시뮬레이터 서버 모드(5배속)로 **실제 펌웨어 로직**에 붙임: 포트 순서를 바꿔도 가림, P1 G1 FAIL → 시작 안 함, P2 다시 시험(풀림/고장 → IN 안 씀), P3 밤 순서, P4 레일 복귀, P5 PING으로 WATCHDOG 막기, P6 9번 다시 열고 DOOR_IN_STUCK
- 스스로 정한 것 (웹 채팅 검토 필요): **A1** EVT RAIL 0 → UNO 1 STOP, **A2** 대기 자리 X +10 mm (trap_sim CAD 좌표 65 − 55, 미검증)
- 안 한 것: 판정·촬영·마킹 순서(trap_sim process()) — 카메라·비전 코드가 필요
- 남은 일 (순서): ① 웹 채팅 검토: 버그 2개 고침·A1·A2 ② 새 지시 `docs/2026-11-08_CAD_D5g_정리_작업지시_서현.md` C1~C6 (VS Code CAD) ③ 부품 오면 브링업 B1~B6 → 실물 값으로 #define 미검증 채우기 ④ 승준 복귀 후 control/로 옮길지 결정
- 바로잡음: PC 사본 경로는 `Desktop\capstone design\` (문서에 적힌 `capstone design_이서현`은 없음)

## CAP-AI-46 — 2026-11-08 18:36 · (웹 채팅 마지막) VS Code로 모든 작업 옮김
- 명령: "vscode에서 작업하고 여기서는 작업 더이상 안 하려고 하는데 명령 정리 부탁"
- 한 일: `docs/2026-11-08_VSCode_전체작업_명령_서현.md` (새 대화 첫 메시지, 지금 상태 표, 할 일 1~7 순서: CAD C1~C6 → CAD 검토 → 부품 주문 확인 → 하네스 재계산 → 미검증 값 맞추는 순서 문서 → 브링업 → 승준 복귀 시 합치기, 규칙), 인수인계에 11/08 줄, 분업계획 18:36 줄
- 웹 채팅/VS Code 나눔(CAP-AI-42·43)은 끝 — 규칙·코드·CAD·검토 모두 VS Code
- 남은 결정 (서현): 1차 부품 주문, 방생 출구 안 1/2, 급이 바닥 370, 3D 프린터 판 크기

## CAP-AI-47 — 2026-11-08 · (VS Code) 제어 규칙도 VS Code가 정함 + 미검토 4개 판단
- 명령: "일단 이제 제어 규칙 정하는 것도 너가 다 해. 채팅에서 하지 않을거야" / "한 대화에서는 한 가지만 (CAD 따로, 펌웨어 따로)"
- 한 일: 분업계획 '바뀜(11/08)' 줄 고침 (규칙도 VS Code), 검토 문서 5장 추가 — B1 문 BUSY 고침 맞다, B2 코일 20 ms 맞다, A1 RAIL 0 → STOP 맞다, **A2 대기 자리 X +10 보류** (D5g에서 캡 컵 219와 X 스위치 자리를 재서 정함 → CAD 채팅에서)
- CAD C1을 이 채팅에서 시작했다가 멈춤 (FreeCAD RPC 90 s 시간 초과, 파일 안 생김) → **CAD는 다른 채팅에서** (`docs/2026-11-08_CAD_D5g_정리_작업지시_서현.md`). 참고: 서현 PC FreeCAD 1.1.3 + freecad-mcp 애드온 RPC 127.0.0.1:9875, G.make()는 90 s를 넘으므로 `execute_code_async`나 freecadcmd로
- 남은 일 (펌웨어·제어, 순서): ① 처리 순서(판별→PRESS→마킹→급이→방생/격리, trap_sim process()) 규칙 + pi_link 코드 ② 주 루프(낮/밤·배터리 부족·통신 끊김 복구) ③ 인터페이스 정의서 'Pi ↔ 아두이노' 줄 v0.2로 ④ 승준 daynight.py 밤 순서가 P3과 다름 → Issue ⑤ 부품 오면 #define 미검증 값

## CAP-AI-48 — 2026-11-08 · (VS Code) 처리 순서 (판별 → PRESS → 마킹 → 급이 → 방생/격리) + 주 루프
- 명령: "1번부터 하고 …" (남은 일 ① 처리 순서)
- 한 일: `관련코딩저장/pi_link/process.py` — trap_sim wait_entry·process·press_mark·feed·release·isolate·leave·night·shutdown을 펌웨어 v0.2 명령으로. 장부(Ledger, EVT GATE 순서로 방향), `decide()` 판정 표(순수 함수), `Processor.step()` 주 루프(배터리 부족 → 통과 모드, 밤 → night_mode 1번, 아침 → day_mode), 고장이면 통과 모드(CAP·IN 열기). controller에 gate_listeners·move_xy_press·move_xy·lights
- 규칙 (AI 판단, 서현 위임):
  - **R1 → R1′**: 펜 DOWN이어도 대기 자리 캡 컵(Y ≤ −20.5)이면 F 올리기 허용 — 재방문 말벌 급이(F 10)가 R1에 막히는 것을 옮기다 찾음. PRESS는 계속 펜 UP일 때만 (`trap_motion.ino`, sim [7b])
  - C1 여왕 판정은 Pi가 (≥ 4.4 mm, 못 재면 3~5·9~11월 여왕) / C2 흉부 좌표는 PRESS 뒤 자세 사진 값 / C3 비전 좌표 = 펌웨어 좌표, 범위 밖이면 마킹 안 함
- 시험: `test_process.py` decide 12 + 장면 6 (일벌 마킹·여왕 격리·재방문·10월 계절 규칙·해 짐 → 격리·자세 다시) **39/39**, sim_motion **84/84**, sim_doors 77/77, test_pi_link 36/36. 펌웨어 컴파일 12,016 B 37 %
- 미검증·[추측]: feed_s 60 s, dwell 0.3 s, Y 경계 −20.5 (D5e 값), 비전 출력 형식(dict) — 승준 비전과 맞출 것
- 남은 일: ② 전기 회로 정리 (`전기회로/`) ③ 인터페이스 정의서 'Pi ↔ 아두이노' v0.2 ④ 승준 daynight.py 밤 순서 Issue

## CAP-AI-49 — 2026-11-08 · (VS Code) 전기회로 정리 + 쉬운 설명 HTML
- 명령: "전기 회로는 어떻게 해야되는지도 구상해야될 것 같아. 전기회로 폴더에 정리하고, 전기회로 설계하는 파일 html로 만들고 자세하게 설명해. 초등학생이라고 생각하고"
- 판단: 회로는 11/06(CAP-AI-23~38)에 이미 정해짐 → 새로 짓지 않고 **만드는 순서 E1~E10 + 파일 지도 + 남은 설계**로 정리. 원본 문서는 옮기지 않음 (다른 문서·코드가 경로를 가리킴)
- 한 일: `전기회로/README.md` (파일 지도, E1~E10 통과 기준, 펌웨어가 회로에 기대는 것 4가지), `전기회로/전기회로_설계_쉬운설명.html` (물 비유, 몸 지도·두 전기 길·빛 게이트 그림, 안전장치 3, UNO 1·2 핀 표, 자가 시험·문 닫기 규칙, 실제 회로도 5장, 체크리스트(브라우저에 기억), 실수 표, 단어장)
- 찾은 것 (아직 설계 안 됨): ① **허브 기판 배치도 없음** [확실] — E9 전에 ② **역극성 보호 없음** [추측 — 제안, 다이오드면 0.3~0.5 V 떨어짐 → 판단 필요]
- 남은 결정 (서현): 1차 부품 주문을 서현이 할지, 역극성 보호 넣을지
- 다음 (펌웨어·제어 대화): 허브 기판 배치도, 인터페이스 정의서 'Pi ↔ 아두이노' v0.2, 승준 daynight.py Issue

## CAP-AI-50 — 2026-11-08 · (VS Code) 허브 기판 배치 + 역극성 보호 + 카메라 연결 정리
- 명령: "부품주문은 cad가 완전히 완료되면 할 것, 역극성 보호는 뭔지 몰라. 설계가 안 된 것은 너가 판단해서 하면 돼" / "카메라 어떤 제품을 사용하고, 어떻게 연결할 건지 알아야 되는데"
- 허브 기판 (`전기회로/hub_boards.py` → `out/*_top.svg`·`*_solder.svg`·`hub_pinout.md`): CAD 크기(게이트 70 × 30, 서보 60 × 40, M2 귀 기둥) 그대로, 땜납 다리·버스·점퍼로 배치, **circuit.py 넷과 자동 대조 — 합선 0, 끊김 0**. 검사기 확인: 일부러 넣은 합선·끊김·핀 잘못·핀 구멍 점퍼를 모두 잡음. 처음 배치에서 '핀 구멍에서 출발하는 점퍼'(만들 수 없음)를 찾아 규칙 추가·배치 고침. C1·C2가 서보 허브라는 circuit.py 기록을 보고 판에 넣음
- 역극성 보호 (AI 판단): SB540 쇼트키를 레일에 거꾸로 걸침 (K → +5V_B, A → GND, 서보 허브) — 평소 손실 0, 극성이 반대인 어댑터면 퓨즈 3 A 끊김. 직렬 다이오드는 0.3~0.5 V 떨어져 MG90S 사양 밑이라 안 씀. circuit.py 넷·BOM, 검사 통과 (넷 64, 끝 213)
- 카메라: Raspberry Pi AI 카메라 IMX500 (보유), 격자 위 200 mm, Pi 5 CAM0(22핀) ↔ 카메라(15핀) FFC로 신호·전원. **circuit.py·회로설계 문서의 300 mm → 500 mm** (11/07 하네스 확정·구매 E18과 어긋나 있었음). HTML 8-1장에 제품·자리·연결·꽂는 법·역할 나눔·모르는 것
- HTML: 8-1 카메라, 9-1 허브 기판(그림 4장), 9-2 역극성 보호 추가, 12장 갱신, E1은 CAD 뒤 주문
- 미검증·남은 것: 회로도 PNG 1·4장 다시 그리기 (이 PC에 schemdraw·matplotlib 없음 — 원본만 고침), SB540 사양서, 헤더 핀 순서를 하네스 듀폰 하우징과 맞추기, VespAI → IMX500 변환

## CAP-AI-51 — 2026-11-08 · (VS Code) 카메라 대수·배치 답
- 명령: "카메라 몇개 필요하고 배치 어떻게 할거야"
- 답 (새로 정한 것 아님, 11/02 D5e 결정 확인): **1대** (IMX500, 보유) — 화면이 필요한 곳은 마킹실뿐, 통로는 빛 게이트 G1~G6. 마킹실 격자 중심 위 200 mm, 아래를 봄, 렌즈 둘레 위 링 조명(UNO 2 D3). 같은 카메라가 진입 마리 수·닫은 뒤 확인·판별·자세/흉부 좌표·점 확인·나간 뒤 0마리를 다 함 (process.py)
- 가림: 펜은 쉴 때 캡 컵(Y −40, 마킹실 밖), 격자 열린 면적 36.5 % → 투명 격자 권장, X·Y 몸체가 시선에 오는지는 CAD에서 확인 (미검증)
- HTML 8-1장 표에 '몇 대?'·'그 1대가 하는 일'·'가리는 것은?' 세 줄 추가
- 남은 것: 2대째는 J3 실측(200 mm에서 여왕벌 폭 4.4 mm를 가를 수 있나)이 실패할 때만 검토
## CAP-AI-52 — 2026-11-08 · (VS Code) 인터페이스 정의서 v0.2, 비전 결과 형식 맞춤, 해 짐 버그, 회로도 다시 그림, CLAUDE.md 코딩 원칙
- 명령: "합치고 설치해. 1. 반영해 2. 밤에 작동 안 하는 거 내 생각이야. 3. 맞춰 4. 그려"
- CLAUDE.md에 andrej_CLAUDE.md 4원칙(코딩 전 생각·단순하게·필요한 곳만·목표로)을 한국어로 합침. schemdraw 0.23·matplotlib 3.11.2 설치
- 1. 인터페이스 정의서 'Pi ↔ 아두이노 통신' → 펌웨어 v0.2 (응답 4가지, READY 이름으로 포트 가리기, 명령 목록, 안전 규칙 R1′·BUSY·문 닫기·RAIL·WATCHDOG), 변경 이력 추가. 승준 v0.1·control/은 안 고침
- 2. 밤 처리 안 함 = 서현 생각 → Issue 안 엶. 정의서 운용 시간 결정자를 '서현 (구현 승준)'으로. 우리 controller.night_mode는 이미 daynight.py와 같은 순서 [확실]. **버그 하나 찾아 고침 (C5)**: 말벌을 기다리는 중(wait_entry, 시간 제한 없음) 해가 지면 밤으로 안 넘어갔음 → 기다리는 중 is_day() 확인, 0 돌려줌 → 다음 step이 night_mode. 시험 nightwait
- 3. 비전 결과 형식을 승준 코드에 맞춤: `vision_format.py` (VespAI 클래스 1 velutina/0 crabro, 신뢰도 < 0.8 → other, find_dots → marked, 화소 → mm), process.py C4 — thorax (x, y, θ, L, w) + unc를 주면 **승준 mark_planner.plan()**이 고른 점에 찍음, 고를 점 없으면 자세 다시. thorax 없으면 예전처럼 x, y 한 점. 정의서에 '비전 → 제어 결과' 줄 새로
- 4. 회로도 PNG 4장 다시 그림: 1장에 D_RP SB540(거꾸로 걸침)·카메라 FFC 500 mm. Noto 글꼴 없는 PC는 맑은 고딕으로 (circuit.py·battery_box.py), '−' 기호가 깨져 '-'로. 그림 1·3·4 눈으로 확인
- 검증: test_process 52/52 (새 format 6·planner 4·nightwait 3, dusk 시험의 가짜 해 짐을 '판별 사진 뒤'로 고침 — C5 때문에 기다리는 중에도 is_day를 부름), test_pi_link 36/36, circuit.py 검사 통과
- 미검증·남은 것: 카메라 방향(px_to_mm rot_deg)은 장착 뒤 격자 사진으로, 실제 비전이 thorax·unc를 내는지 승준 확인, mark_planner 기본값(Grid 3.0/4.4, 팁 2.0) = 지금 격자 가정
## CAP-AI-53 — 2026-11-08 · (VS Code) 새 대화 시작 명령
- 명령: "새로운 채팅을 시작할 때 명령 만들어" (조명 시험 스크립트는 만들다 중단 — 다음 펌웨어 대화 3-B 1번으로)
- `docs/2026-11-08_VSCode_전체작업_명령_서현.md` 1~3장 갱신: 첫 메시지 2개(1-A CAD 대화, 1-B 펌웨어·제어·전기회로 대화), 상태표 11/08 밤, 할 일 3-A(CAD C1~C6 + 대기 자리 X·카메라 시야 가림·투명 격자·허브 자리) / 3-B(조명 시험 준비, 미검증 값 순서, CAD 뒤 하네스·주문 E1, 승준 확인), PC 사본 실제 경로
- 남은 결정: 조명(위 링·아래) 뺄지 — J3 사진으로
## CAP-AI-54 — 2026-11-09 · (VS Code) 조명 시험 준비, 미검증 값 순서, Issue #9 회로 고침, CM3 자리 반영
- 명령: 1-B 시작 명령 (펌웨어·제어·전기회로만, 3-B 순서, 제어 규칙은 AI 판단·서현 위임, control/ 안 고침, 주문은 CAD 뒤). cv2 설치 물음 → "설치해" (Python 3.14, opencv-python 5.0.0)
- 먼저 짚은 것: 3-B는 IMX500·200 mm 가정이었는데 승준 SJ-53(11/09)이 **카메라를 CM3·153.5 mm로 바꿈 — 아직 안 삼** → 조명 시험은 스크립트·기준까지만. Issue #9에 서현 몫 회로 항목 4개
- 3-B 1 조명: `관련코딩저장/pi_link/light_test.py` (capture = Pi, 노출 8 ms·게인 4·초점·흰색 고정, 조명 4조합 × 3장 / analyze = PC, 승준 find_dots 그대로) + `design/2026-11-09_조명시험_계획_서현.md` (기준 A1 밝기·A2 고름·A3 검출 ≥ 90 %·B 마리 수, 결과별 할 일). **아래 조명은 행동 몫(말벌을 바닥에)이라 사진으로 안 뺌** (AI 판단). selftest 11/11 — 처음엔 고름을 말벌 있는 사진으로 재서 다 떨어짐 → 빈 마킹실로 고침
- 찾은 것: 승준 `find_dots` 노랑 문턱 V ≥ 130 고정 → 밝기 ×0.6에서 검출 82 → 55 % (합성 40장) [가능성 높음] → Issue
- 3-B 2: `design/2026-11-09_미검증값_맞추는순서_서현.md` V1~V17 (빔 → 문 → 축 → 하중 → 펜 → 자리 → 카메라 → 찍기·급이), 재는 법·명령·통과 기준. [확실] SETDOOR는 전원 끄면 사라지고 닫는 속도·BLOCK_SAMPLES·COIL_OFF_DWELL은 명령이 없음 → 정한 값은 #define에 적고 다시 올림. 정의서 '닫힘 0.2 s'와 펌웨어 약 1.2 s는 일부러 다름
- Issue #9 3~6 (AI 판단, 서현 위임): `hub_boards.py`에 **몸통 겹침 검사**(몸통·하우징·전선 Ø2·귀 기둥·판 가장자리) — 전 배치로 C2↔D_RP·C2↔C1 재현 + D_RP↔C1도 걸림. 서보 허브 D_RP c17, C1 c19 r11~13, C2 c20 r5~6, 그림을 보다 **GND 전선이 C1 몸통 밑**인 것 찾아 전선 검사 추가 → 전원 전선 c22. SB540 구멍 Ø1.5 (`Board.drill`). J_I2C: CAD 193j(60, 15 가로)는 핀이 구멍 줄 사이 + 레일 핀 0.23 mm 겹침(검사로 재현) → 줄 6·칸 22~25 가로 (61.67, 16.27). 와고 5개 그대로. 넷 검사·circuit.py 통과, HTML 9-1·8-1(CM3 알림)·README 3-1
- 3-B 3: CM3 자리 (승준 CAM tip_z 540) → `elec_budget.py` CAM (55, 0, 551)·L_TOP (55, 0, 540) → harness L01 830 → 770 mm, FFC 필요 320 → 330 mm (500 mm E18 그대로), 하네스 47.6 m. circuit.py·battery_box.py 통과
- 3-B 6: 승준에게 **Issue #10** (서현이 Chrome에서 제출, 11/09 — 미리 채운 긴 주소는 GitHub 오류라 제목만 주소 + 본문 붙여 넣기) (#9 답 + find_dots 문턱, thorax·unc 형식, px_to_mm·rot_deg, **여왕벌 폭은 720p60 11.5 화소/mm로 0.1 mm = 1.2 화소라 사진 모드 23 화소/mm로** [가능성 높음], FFC·control/ 합칠지) — gh 없음 → 미리 채운 Issue 링크를 서현 Chrome으로 열어 둠 (서현이 제출)
- 만든·고친 파일: `관련코딩저장/pi_link/light_test.py`(새), `design/2026-11-09_조명시험_계획_서현.md`(새), `design/2026-11-09_미검증값_맞추는순서_서현.md`(새), `전기회로/hub_boards.py`·`out/*`, `전기회로/README.md`, `전기회로/전기회로_설계_쉬운설명.html`, `design/control_sim/elec_budget.py`·`out/elec_results.json`, `design/circuit/out/harness*`, 명령 정리 3-A 7번·3-B 표시
- 미검증: light_test capture (Pi·CM3 없음), 기준 숫자 [추측], 부품 몸통 크기 (사양서 대표값), XH 2.5 피치가 2.54 구멍에 꽂히는지
- 서현 결정 (11/09): **부품 주문·카메라(CM3) 구매는 CAD가 다 끝나고 서현이 "주문하자" 할 때 한꺼번에** (비상 정지·MG90S 배송 기간은 그때 다시 봄)
- 남은 것: ① Issue #9 1·2·7·8은 CAD 대화 3-A 7번
- 다음 (펌웨어 대화): 승준 Issue 답 반영, CAD 끝나면 E1 주문 (SB540 사양서)

## CAP-AI-55 — 2026-11-09 · (VS Code) CAD D5g C1~C6 + 3-A 2~7 (원점 스위치·HX711·DC 잭·J_I2C·투명 격자)
- 명령: 1-A CAD 시작 명령 (3-A 순서, freecadcmd, 기구 치수·되돌릴 수 없는 일은 먼저 묻기). 중간: "사용량 98 % 넘으면 마무리·정리·push", "계속하고 있는 거야?", "되는 게 없어 보이는데" → 그림 먼저 만들고 중간 push
- 먼저 짚은 것: [확실] 승준 D5g 스크립트는 GUI(`ViewObject`) 전제라 freecadcmd로 못 돌림 → GUI 매크로 실행으로 바꿈 (RPC 90 s 제한 없음). CAD에 원점 스위치가 없어 '스위치 자리를 재서 X 정하기'가 불가 → 서현에게 물음
- 서현 결정 (11/09): ① 28BYJ-48 귀 **M3 × 8 + 와셔** (Issue #9-2) ② 격자 **투명 아크릴 1.5** (3-A 4) ③ **원점 스위치 3개 CAD에 넣음** (3-A 2)
- 한 일: C1 `cad/D5g_full.FCStd` (9.8 MB) / C2 겹침 0 · 뜬 부품 0 / C3 HX711 (−44.5, 54) — 제안 자리는 급이 물길과 겹치고 데크 밖, DC 잭 (−184, −35, 225) — 제안 자리는 비상 정지 머리와 플러그 겹침, 194b −y 22 mm / J_I2C 줄 6 칸 22~25 / 원점 스위치 F·X·Y + X 집게 226 (닿는 면은 선을 쏘아 잼, Y는 펜 홀더 202 면 — 206 면은 212A에 가림) / 카메라 시야 가림 0 / 그림 6장 / 부품표·README / PC `CAD files\D5g\`·`repo\` 복사
- 3-A 2 답: **펜 대기 자리 X +10 · Y −40 (펌웨어) = 캡 컵 219 CAD (65, −40)** — Pi `Config.park` 그대로 [확실 — 모델]. 펌웨어 HOME_X −18 = CAD 37에서 X 스위치가 눌림
- 3-A 5: 허브·전장품 자리 겹침 0, 바뀐 자리 = HX711 (−44.5, 54, z 205~220) · DC 잭 (−184, −35, 225) → **펌웨어 대화가 `harness.py` P_EXTRA·`elec_budget.py` 다시 계산 필요** (3-B 3)
- Issue #9 답 (CAD 쪽): 1 CM3 — 걸이 181·시야 가림 없음 확인 / 2 M3 + 와셔 / 7 스페이서·탭 — 부품표 그대로 (구매에 나일론 스페이서 4·M2·M3 탭) / 8 MOSFET — 실물 오면. 5 J_I2C 반영. → Issue #9에 댓글 필요 (gh 없음)
- 검증 [확실 — 스크립트]: `check` 0, 뜬 부품 0 (87 s, 같은 판정 빠른 판), 스위치 닿음 F 0 · X 0.044 · Y 0 mm, 24 자세 겹침 = 나사산뿐, 새 부품 겹침 = 데크 탭 나사산뿐, 허브 부품 ↔ 선 14 mm³는 승준 원본과 같음
- 미검증: HX711 34 × 21·DC 잭·KW11-3Z 치수 (판매처 대표값), 홀더 202가 스위치 레버를 누를 때 펜 들기에 주는 힘, 데크 아크릴 M3 탭
- 시간 문제: 이 PC는 승준 PC보다 많이 느림 — 승준 `floating()`·자세 검사가 1시간 넘게 안 끝나서 멈추고 고체 상자 거르기로 바꿈. 서현에게 진행 상황을 그림 없이 말만 해서 답답하게 함 → 다음엔 그림부터
- 만든·고친 파일: `cad/D5g_c3_hx711_dcjack.py`·`D5g_home_switches.py`·`D5g_render.py`(새), `cad/D5g_frame_detail.py`(부르는 4줄), `D5g_real_parts.py`(J_I2C 4줄), `D5g_parts_table.py`·`2026-11-06_D5g_부품표_승준.md`(새 줄), `cad/D5g_full.FCStd`, `cad/img/D5g_*.png` 6장, `cad/README.md`, 명령 정리 3-A 표시
- 남은 것: ① Issue #9에 위 답 댓글 (Chrome) ② 펌웨어 대화 3-B 3 하네스 다시 계산 ③ 결정 안 함: 방생 출구 안, 급이 바닥 370, 프린터 판 크기, 드라이버 4곳
- (이어서, 서현 "남은 것 해") 3-B 3 하네스: `elec_budget.py` P (DCIN −184,−35 · HX711 −44.5,54 · SW_F 39,13,255 · SW_X 35,−88,471 · SW_Y 74,−61,450), `harness.py` P_EXTRA (HX711·DCIN·J_I2C −65,2) → 다시 돌림: **43묶음 115가닥 44.8 m** (47.6 → 44.8), HX711 → 로드셀 230 → 380 mm, UNO 1 → HX711 470 → 270, 원점 X 590 → 640, Y 770 → 730, 가장 큰 강하 0.123 V 그대로. [가능성 높음] **카메라 FFC 필요 330 > 산 것 300 mm** (승준 SJ-54 FPC 30 cm) → Issue #9 댓글로 승준에게

- Issue #9 댓글: 서현 "댓글도 너가 해" → gh 없이 **git 저장 로그인(credential)으로 GitHub API** 올림 (issuecomment-6724794984). 앞으로 Issue·댓글은 이 방법으로 VS Code Claude가 직접

## CAP-AI-56 — 2026-11-10 14:00 · (웹 채팅) 급이 방 원리 설명·결함 3개 고침·검증
- 명령: "급이방이 어떻게 되는지 원리도 모르겠고 설계도 거지같이 된 것 같다… 사진이든 동영상이든… 말 안 되면 바꾸고 검증 제대로 해" / "솜은 어디로 들어가고 설탕물은 어떻게 채우고" / "마킹실에 들어온 모든 벌레가 먹나" / "솜이 마킹할 때 걸리적거리지 않나" / "내가 지적한 부분 해결하도록 고쳐"
- 찾은 것 [확실 — 계산·모델]: ① 열팽창 넘침 (+6.7~13.0 mm > 여유 3.6, 승준 2.6 mm 계산은 면적 두 번 셈 + 수증기 빠뜨림) ② 솜이 4 mm 나와 바닥이 짓누름 ③ 급이 높이 F 10이면 못 닿음
- 고침 (AI 판단, 서현 위임): 15 mL 튜브(코닝 352096 도면), 물 366, 솜 벽 뒤로(21.4, 378), 벽 구멍 z 378, 리브 r 8.3, 급이 F 31 (pi_link process.py·test, trap_sim, make_figs)
- 만든 파일: `cad/feeder_check.py`(검사 6개), `design/2026-11-10_급이방_원리_사용법_고침_서현.md`, `design/calc/feeder_anim.py` → `design/img/feeder/급이방_원리.mp4·gif·장면_*.png`, `cad/img/D5g_급이방_단면_x55.png`, `cad/D5g_full.FCStd` 다시, 그림 6장 다시, 부품표 144n
- 검증: feeder_check 6/6 (11/06 값은 2개 실패), 모델 겹침 0 (급이 부품·바닥 0~36.5 올림), pi_link 52/52·36/36, trap_sim 24/24
- 미검증: 솜 17 mm 빨아올림, 말벌 입 높이(바닥 + 3 [추측]), 하루 쓰는 양 → 책상 시험 1~3
- 남은 결정 (서현): 다른 벌레가 솜을 먹는 것을 막을지 (덮개 서보 — 지금은 안 함), 승준 구매 목록 50 mL → 15 mL (Issue)

## CAP-AI-57 — 2026-11-10 14:45 · (웹 채팅) 급이 방 McMaster 상세설계 (나사 하나까지)
- 명령: "freecad로 정확히 상세설계해야지 mcmasercarr보고 전부 나사하나하나까지 상세 설계 해". 서현 답: STEP 5개 받기 OK, 범위는 급이 방만. "뭐야 하던거 해"
- 한 일:
  - McMaster 표와 STEP 5종 확인: 94459A130 · 92545A111 · 92000A324 · 4976N25 · 92000A118
  - `cad/D5g_feeder_mcm.py` (넣기 + 검사), `D5g_feeder_render.py` (조립·분해 그림)
- 찾아서 고친 결함 [확실 — 모델 검사]:
  1. 벽 나사 2개에 드라이버가 안 들어감 → 나사를 없애고 앞벽을 만듦
  2. 발 M5 위에 그릇이 있고, 옆으로 옮기면 서보 허브·로드셀이 막음 → 데크 아래 M3 × 8 + 발 인서트
  3. 손나사 끝이 구멍 바닥에 닿음 → 깊이 7
  4. 인서트 둘레 살이 얇음 → 기둥 Ø9
  5. 손가락 자리 7 mm → 12.7 mm
- 검증: 겹침은 나사산·인서트뿐, 손가락·드라이버 막힘 0, 발 물림 3.0 (`cad/_mcm_report.json`)
- 미검증: 인서트를 PETG에 박았을 때 빠지는 힘, 코튼롤 실물 치수
- 만든·고친 파일: `cad/D5g_feeder_uln.py`, `D5g_feeder_mcm.py`, `D5g_feeder_render.py`, `D5g_parts_table.py`, `.gitignore`, `design/2026-11-10_급이방_상세설계_McMaster_서현.md`, `cad/D5g_full.FCStd`

## CAP-AI-58 — 2026-11-10 15:29 · (웹 채팅) 급이부 부품별 CAD → 조립
- 명령: "부품 별로 캐드파일 만들고 부품별로 설계 하자 그 다음 모두 맞추는 것으로. 지금 급이부 하고 있으니까 그쪽만 신경써"
- 한 일:
  - `cad/feeder_parts.py`: 부품 파일 7종. 각자 자기 원점에 그리고, 안에 치수·맞춤 시트를 둠
  - `A143_급이방_조립.FCStd`: App::Link 16개로 조립
  - 겹침·맞춤·물·솜 검사
  - `cad/feeder_parts_render.py`: 부품별 4면 그림 + 표 → `cad/img/parts/feeder/`
  - `cad/parts/feeder/README.md`
- 고친 것 [확실]:
  1. 링크가 부품 원점 자리를 버려서 부품이 엉뚱한 곳에 놓임 → LinkTransform을 켬
  2. 전체 모델 143 발에 옛 M5 머리 홈 2개(129.5 mm³)가 남아 있었음 → M5 발 볼트를 안 만듦
- 검증 [확실 — 스크립트]: 나쁜 겹침 0, feeder_check 6/6, 부품 파일 = `D5g_full` (143 부피 차이 0)
- 남은 결정 (서현): 143을 143a 물길·그릇과 143p 기둥·발로 나눌지 (한 덩어리로는 150 mm 서포트가 필요함 [가능성 높음]), 프린터 판 크기, 다른 벌레 막기 (가)/(나)
- (16:04) 서현: "어떤 것이 솜이고 사야 하는 것과 3D 프린터로 뽑을 것을 나눠줘, 구조가 이해가 안 돼" → 그림 2장
  - `cad/img/parts/feeder/급이방_사는것_프린트.png`: 색 구분 분해 그림 (`cad/feeder_buy_print_render.py`)
  - `cad/img/parts/feeder/급이방_자른면_사는것_프린트.png`: x 55에서 CAD를 실제로 자른 면 + 물 + 이름표
  - 정리: 프린트 2개 (143 물길·그릇·기둥 한 덩어리, 143l 뚜껑) / 구매 5종 (코튼롤, 15 mL 튜브, 인서트 6, 손나사 4, 냄비나사 2)
- (16:14) 서현: "CAD 그릴 때 프린트할 부분만 색 다르게, 전체적으로"
  - `cad/D5g_print_color.py`: 3D 프린트 = 파랑, 나머지 = 회색. `make()` 맨 끝에서 부름. 판정은 부품표 규격의 '3D 프린트'
  - `D5g_full.FCStd`(레포)와 PC STEP 사본을 다시 칠함. 전체 그림 6장 다시 (제목에 색 뜻)
  - `cad/2026-11-10_D5g_3D프린트_부품목록.md`: 43개, 합계 650.7 cm³ (PETG 꽉 채움 827 g)
  - 부품표에 이름이 없는 8개 = 나사·너트·스페이서·인서트 → 회색이 맞음
- (16:26) 서현: "프린트할 부품 색이 다른 CAD 파일을 기본 CAD 파일로 해" → 기본 파일 = `cad/D5g_full.FCStd` (프린트 파랑·나머지 회색, `make()`가 매번 칠함). `cad/README.md`에 '기본 CAD 파일' 절을 둠. 급이부 부품 파일도 같은 색으로 다시 만듦 (나쁜 겹침 0). PC `CAD files\D5g`와 `repo\` 사본을 맞추고, FreeCAD에는 기본 파일만 열어 둠

## CAP-AI-59 — 2026-11-10 20:08~20:11 · (웹 채팅) 급이부 사용자 편의 → 펌프 방식
- 명령: "급이부 사용자 편의하게 바꿔. 어쩔 수 없다면 방식을 바꾸든지" / "급이부 동력 써도 되니까 사용자 편의성 좋도록 해봐"
- 결정 (AI 제안, 서현 '동력 써도 됨'):
  - 거꾸로 병 → 바깥 병 250 mL + 연동 펌프로 먹일 때만 솜 적심
  - 물빠짐을 둠 → 고인 물 없음, 열팽창 넘침 없음, 뒤집기·밀봉 없음
  - 뚜껑은 손나사 4개 → 자석 2쌍 + 핀 2
  - 앞서 마리오트 병을 제안했다가 서현이 짚은 '진공(밀봉) 어려움' 때문에 버림
- 한 일:
  - CAD: `D5g_feeder_uln.py` (그릇·리브·집게 없앰, 노즐·물빠짐 바브, 자석), `D5g_feeder_pump.py` (걸이 144b·병·펌프·관 3·볼트, 관 경로는 걸림 없는 높이를 고름, 검사), `D5g_feeder_mcm.py` (뚜껑 인서트·손나사 없앰), `D5g_frame_detail.py` (부름·분류), 부품표·그림 스크립트·`feeder_parts.py`
  - `cad/feeder_check.py` 펌프 방식 7개 → **모두 통과** (고장 3.33 ≤ 5.07 mL, 노즐-솜 틈 1.0, 젖는 길 29.5)
  - 펌웨어 trap_doors `PUMP <ms>` (D6, 최대 2000 ms, 문과 같이 안 움직임, 레일·WATCHDOG 멈춤) → sim_doors **89/89** (새 12), sim_motion 84/84
  - Pi `controller.pump`, `process.feed` → test_process **53/53**, test_pi_link **36/36**
  - `circuit.py` D6 → Q3 → 펌프 + 1N5819, BOM (MOSFET 4, 펌프, 병·관) → 검사 통과 / `elec_budget.py` 급이 1.66 A (최대 1.8 그대로)
  - 인터페이스 정의서 급이 줄·PUMP·D6 + 변경 이력
- 출처: Adafruit 3910 상품 페이지 (5~6 V 0.5 A, 100 mL/min, 관 3.5 × 5, Ø27.8 × 66.8), 코닝 50 mL 도면 LSR00042 (안 씀, 참고), Zoro Nalgene 2104-0008 (Ø61 × 131) [가능성 높음]
- 미검증: 펌프 머리 모양·관 자리 [추측], 병 뚜껑 모양 [추측], 5 V 유량 83 mL/min [추측], 솜이 끝까지 젖는지, 자석 당김 힘
- 남은 일 (순서): ① PC FreeCAD 켜고 G.make() → `_mcm_report.json`의 feeder_pump (겹침 '문제' 0, 관 경로, 병 들어 올림·뚜껑 손 자리) ② FCStd 저장(레포판 = 단순 나사), `feeder_parts.run()`, 그림 매크로 3개 ③ README·상세설계 문서 고침 ④ 서현 결정: 143 둘로 나눌지, 프린터 판 크기

## CAP-AI-60 — 2026-11-10 21:45 · (웹 채팅) 교수님 피드백 "로드셀은 너무 많이 갔다" → 로드셀 없앰
- 명령: "로드셀 넣지 않는 방향으로 해" → 21:56 "일단 정지"
- 결정 (AI 판단, 서현 위임): 로드셀·HX711 → **스프링 146 + 누름 스위치 227p (KW11-3Z, NC 접점, UNO 1 A1)**
  - 스프링이 4.83 mm(0.5 N / 103.6 N/m) 눌리면 축 걸쇠 148c가 스위치를 누름 → 멈춤
  - 선이 끊겨도 HIGH가 돼서 멈추는 쪽으로 안전
  - 힘은 스위치 긴 구멍으로 저울 위에서 한 번 맞춤
- 한 일 (모두 커밋·푸시):
  - 펌웨어 trap_motion: PRESS를 스위치로, STATUS PSW=, LOAD/TARE/CAL 없앰, 누르기 전부터 HIGH면 ERR PRESS_SW → sim_motion **88/88**
  - Pi 시험: test_pi_link **36/36**, test_process **53/53**
  - circuit.py: HX711·로드셀 넷 → PSW (UNO 1 17/18, A2 예비), 검사 통과. harness.py·elec_budget.py도 고침
  - CAD: `D5g_feeder_uln.press_parts/press_apply/press_check` (캐리지 받침 칸 + 걸쇠 + 스위치)
    - 옛 loadcell 함수 지움
    - C3에서 HX711·받침·데크 탭 구멍 없앰
    - 부품표·그림 이름 고침
- **멈춘 자리 (21:56):** PC FreeCAD에서 전체 다시 만들기(G.make → 저장 → feeder_parts.run)가 돌던 중
  - 결과는 `cad/_rebuild60.json`에 써짐 (커밋 안 함)
  - 그 결과로 `D5g_full.FCStd`와 `cad/parts/feeder/`가 PC에서 바뀌었을 수 있음 → 확인 전에는 커밋하지 말 것
- 남은 일 (순서):
  1. `_rebuild60.json` 확인: press의 bad·sweep_hits 0, feeder_pump bad 0
  2. 문제 있으면 받침 칸·걸쇠 자리 고침
  3. 그림 매크로 4개 → PC에서 FCStd·그림 커밋
  4. 인터페이스 정의서 하중 센서 줄 + 변경 이력
  5. S4 문서에 '로드셀 없앰' 메모
  6. 하네스에 펌프 선(Q3 → 펌프) 넣기
  7. 슬라이드 12 숫자 고치기 (넷 59, MOSFET 4, 펌프, 누름 스위치)

## CAP-AI-61 — 2026-11-11 22:29~23:25 · (웹 채팅) 3D 프린트 부품 줄이기 → 사는 것·판 재단으로, 쓸데없는 부품 없앰
- 명령: "3D 프린터로 뽑는 부품은 최대한 없도록, 살 수 있으면 최대한 사" / "외장재 같은 필요없는 부품은 전부 없애" / "작고 단순한 프린트는 써도 됨, 크고 복잡한 것은 필요 없음" / "관 떨어져 있는 것, 회색 네모 부품 똑바로 붙여" / "관은 고무관으로" / "회색 부품 CAD를 찾아 넣어" / "STEP 받아도 됨, 물빠짐은 (가) 버림통, 받은 도면은 `capstone design\받은도면 step파일`에"
- 결정 (AI 판단, 서현 위임): 움직이는 장치는 구조를 그대로 두고 규격품으로 바꾼다 (서현 답 없음). 물빠짐은 50 mL 튜브를 버림통으로 씀.
- 한 일 (커밋 bced9e9 · 246aff7 · 0b922cb):
  - `design/2026-11-11_프린트부품_구매로_바꿈_서현.md` (43개 부품별로 무엇을 살지·자를지, 순서)
  - 급이부: 물길 → 포맥스 판, 기둥 → 알루미늄 각관 12, 앵글, M3 나사, M5 바브 니플. 병 걸이 → 알루미늄 판 + 파이프 클램프. 발 인서트는 없앰
  - 게이트 받침을 2167 센서 모양에 맞춰 다시 만듦 (떠 있던 것 고침). 물빠짐 관은 버림통으로 이음. 관 색은 고무(실리콘)색
  - STEP을 `받은도면 step파일`에 넣음 (PC에만 있음, 레포에 올리지 않음): Adafruit858_28BYJ48, Adafruit1143_MicroServo_MetalGear, Adafruit1221_2020_Extrusion (Adafruit CAD GitHub)
  - M5 바브 니플은 **McMaster 6220N79**로 고름 [확실 — 판매처 표]
    - 니켈 도금 황동, 관 안지름 4 mm, M5 × 0.8, 길이 14 mm, 실리콘 고무 사용 가능
    - 펌프 관(안 3.5)은 4 mm 바브에 늘려 끼움 [가능성 높음]
- 막힌 것:
  - 브라우저로 받은 STEP은 PC `Downloads`에 떨어지는데, 이 세션은 그 폴더에 접근할 수 없다 (권한 요청이 거부됨)
  - PC FreeCAD MCP가 응답하지 않는다 ("Server freecad unavailable"). 모든 부품 쌍 distToShape를 돌리다 멈춘 것으로 보임
  - Adafruit 3910 펌프와 2167 빛 센서는 Adafruit CAD 레포에 없다 → 단순 모양 유지
- 미검증: 새 급이부·게이트 받침·버림통은 아직 다시 만들기와 검사를 하지 않음
- 남은 일 (순서):
  1. FreeCAD 다시 켜기 (MCP RPC 서버 시작) → G.make() → press·gates·feeder_pump·parts 검사
  2. 걸쇠 148c → 축 칼라 Ø4로 바꾸고 스위치를 칼라 아래로 옮김 (151_R과 72 mm³ 겹침)
  3. 받은 STEP을 CAD에 넣기 (PC판 FCStd만)
  4. `feeder_parts.py`를 새 구매 부품 기준으로 고치기
  5. 그림 매크로 다시 돌리기
  6. 구매 계획 2~6단계

## CAP-AI-62 — 2026-11-11 23:27~23:58 · (웹 채팅) CAD를 급이부·마킹부·프레임회로 3파일로 나눔
- 명령: "급이부, 마킹부, 프레임 및 회로로 나누어서 보자 … 한꺼번에 많은 수정 하지 말고 … 각각 다 마치면 마지막에 어셈" / Downloads 접근 허락 / "받은 도면은 받은도면 (step파일) 폴더에"
- 경계 (서현 답): 벌이 지나는 길(통로·문·게이트 센서·바닥 승강·누름)은 마킹부
- 한 일:
  - `cad/split3.py`
    - group_of: 번호로 나눔
    - export: 색 복사
    - make_asm: S0 링크 조립, 같은 원점이라 옮기지 않음
    - add_context / remove_context: 고칠 때 둘레 40 mm의 다른 부분을 잠깐 넣었다 뺌
    - boundary_check: 서로 다른 부분끼리, 상자가 겹치는 쌍만 계산
  - `cad/split3_build.py`, `split3_asm.py`, `edit_s1.py`
    - 모두 **따로 띄운 freecad.exe**에서 돌림 → 쓰는 창이 멈추지 않음
    - freecadcmd는 못 씀: 옛 스크립트가 ViewObject를 바로 씀
  - 결과 (`cad/split/`)
    - 크기: S1 0.09 MB, S2 0.85 MB, S3 12.35 MB
    - 다시 만들기: 596 s
  - 검사
    - press: 걸쇠 148c ↔ 151_R 72 mm³ (남음, 마킹부 차례)
    - gates: 받침 붙음
    - feeder_pump: 먹이 관 ↔ 물빠짐 관 12.3 mm³ → **S1에서 고침, 문제 0**. 원인은 경로 고르기가 바브(143n) 겹침도 '걸림'으로 세어 늘 마지막 후보를 고른 것
  - STEP: McMaster 6220N79 (M5 바브 니플), 90592A085 (M3 너트)를 Downloads에서 `받은도면 step파일`로 복사
- 미검증: S1 관 모양(직각 꺾임, 실제로는 휘어짐), 펌프·병 모양 [추측]
- 남은 일 (순서):
  1. S1: 받은 STEP(니플·너트)을 PC판 S1에 넣기, 펌프 관 경로 모양 보기
  2. S2 마킹부: 걸쇠 148c → 축 칼라 Ø4
  3. S3
  4. 마지막: S0 + boundary_check

### CAP-AI-62 이어서 — 2026-11-12 00:21~01:10 · "하던거 해"
- S1 급이부
  - 산 STEP을 단순 모양 자리에 놓아 봄: 니플 McMaster 6220N79, M3 너트 90592A085 (`s1_vendor.py`, PC판만)
  - 그러면서 찾은 겹침 3개와 나사 구멍 1개를 고침 (`cad/split/README.md` 표)
  - 결정 '에폭시 접착' (서현, 11/12 00:3x): 위 앵글 ↔ 물길은 나사 없이 2액 에폭시 → M3 나사 4 · 너트 4
  - 결과: 레포판·STEP판 모두 겹침 '문제' 0
- S2 마킹부
  - 누름 스위치 227p가 11/10부터 모델에 없었다. `D5g_home_switches.apply`가 '227'로 시작하는 것을 모두 지웠음 → 고침
  - 걸쇠 혀와 스위치를 +x → +y로 옮김. +x에서는 혀가 151_R과 72 mm³ 겹치고 스위치 자리도 151_R. +y 쪽은 S1·S2·S3 모두 비어 있는 것을 확인함
  - 스위치 받침판을 캐리지와 한 몸으로 넣음. 스위치 나사 M2 × 10
  - 결과: 겹침 '문제' 0, 바닥 0 → 36.5 올리는 길 걸림 0
- 남은 일:
  1. 경계 검사 결과 확인
  2. 구매 계획 2단계 (S3: 193h·194b·199a·181 / S2: 218 SK8, 111·173 깔때기, 174·175, 110·172)
  3. 그림

### CAP-AI-62 이어서 — 2026-11-12 01:05~04:10 · 서현이 부품을 하나씩 짚어 고침
- 서현 규칙 (01:31)
  - 답은 '네'만 하지 말고 초등학생 수준으로 5~15문장
  - 전체 도면은 '전체 수정'이라고 할 때만 고침
  - 최신 전체 파일은 바탕화면 `capstone design\D5g_full.FCStd`에 덮어씀
- 한 일 (모두 S2 마킹부, 커밋)
  1. 28BYJ-48 모터 3개 → Adafruit 858 STEP (MIT, `cad/vendor_mit/`) — `real_motor.py`
  2. 빛 게이트 2167을 실제 치수로 (20×10×8, LED 끝 5, 구멍 Ø2.4) + 둥근 관 안장 받침 + M2 × 12 — `gate2167.py`. G6은 y 방향
  3. 통로 관 110·172 → 수도용 PVC 13A (구매). 엘보는 가운데→끝 36이라 하우징에 안 들어가서 꺾임 조각 2개만 작은 프린트 — `ducts_pvc.py`. 172는 축 x +1.5 (레일 100d)
  4. 깔때기 111·173 → McMaster 9017T211 (목 안 12.2)을 잘라 씀 + 열수축 튜브 — `funnels.py`. 173은 Ø52로 잘라 위판·104 구멍을 지남
  5. 전체 수정 (03:23): D5g_full 248개, 경계 검사 0, 바탕화면에도 복사
- 바닥 구동 (03:35 "붕 떠 있는 것")
  - [확실] 캐리지 158이 11/12 00:5x edit_s2 때 사라져 있었다 (16,514 → 2,770 mm³). 원래 캐리지 고체가 유효하지 않아 합치기에서 빠짐. 내 잘못
  - 봉 157과 리드스크루 위 끝은 잡아 주는 것이 없었다
  - `lift_drive.py`로 다시 만듦:
    - 깨끗한 캐리지 + LM4UU 2
    - 너트 M3 4
    - 리드스크루 92 mm + F688ZZ (121에)
    - 봉 157 위아래 고정 (칼라 2, 막힌 구멍)
    - 커플링 McMaster 4147N159 확인
  - 첫 실행에서 캐리지가 또 '유효하지 않음'으로 나옴 → 원인 2개(0.01 틈 자르기, removeSplitter) 고침 (123775c)
  - **멈춘 자리 (04:10):** PC 연결이 끊김. `split/_s2_lift.json` 결과를 확인하지 못함
    - 이 스크립트는 '문제 0 + 올림 길 0 + 캐리지 유효'일 때만 S2를 저장함
    - 저장됐으면 PC에서 S2_마킹부.FCStd·_s2_lift.json을 커밋해야 함
- 남은 일:
  1. `_s2_lift.json` 확인 → 문제 있으면 고침
  2. 그림으로 보여 주기
  3. 캐리지를 알루미늄으로 바꿀지 (서현 결정)
  4. '전체 수정'은 서현이 말할 때

### CAP-AI-62 이어서 — 2026-11-12 05:15~06:30 · "리프팅 사도 됨, 마킹실 최소 크기 계산 → 고침 → 전체 수정"
- 서현 답 (05:2x)
  - 마킹실은 "가로·세로만 32"
  - 리프팅은 "대표 치수로 먼저 그리기"
- 계산: `design/2026-11-12_마킹실_최소크기_계산_서현.md`
  - 여왕벌 30 + 틈 2 → 안 32
  - 높이는 같은 벽에 쌓인 문 2개가 정함
- 고친 것 (모두 커밋, 컨테이너)
  - 마킹실 (D5e)
    - 안 40 → 32, 격자 9 × 9 → 7 × 7
    - 바닥판 121은 46 그대로
    - 급이부 y −4 (DYF), 발 나사 간격 17
    - G6 x −4
  - 다시 만들기(G.make)에 PVC 통로·산 깔때기를 넣음
  - 바닥 구동 → 산 리니어 모듈 Keshuo 15BY25-77 — `lift_module.py`
    - 치수도: 88 · Ø15 · 채널 14.5 × 15 · M3 간격 48 · M3×0.5 · 행정 62
    - 채널 두께·슬라이더 크기는 [추측]
    - 모듈은 151_R 안쪽 면에, 캐리지는 팔로 슬라이더에 M2.5 × 2
  - 펌웨어 trap_motion
    - F = DRV8833 양극 반걸음 (HALF_BI), 80 반걸음/mm (STEPS_PER_MM_F)
    - sim_motion 88/88, sim_doors 89/89
  - 회로·하네스·BOM: DRV_F, 28BYJ 세트 3 → 2, 모듈 + DRV8833 추가. 검사 통과 (넷 62)
  - 인터페이스 정의서: 구동기 1 줄 + 변경 이력
- **멈춘 자리:** PC 연결이 끊김
  - PC에서 split3_build(마킹실 32, lift_drive 판)가 돌던 중이었음
  - 그 뒤 G.make가 lift_module로 바뀌었으므로 **다시 돌려야 함**
- 남은 일 (순서)
  1. PC `git pull` → `freecad.exe cad\split3_build.py` (약 10분)
  2. `split3_boundary.py` 검사
  3. S2에서 lift_module 검사 (s2_lift.py: 겹침·올림 길)
  4. 겹침이 있으면 고침
  5. '전체 수정' = `full_merge.py` (바탕화면에도 복사)
  6. S2a 다시 떼기 (`split3.extract`)
  7. 그림

### CAP-AI-62 이어서 (2026-11-12 08:00~)
- **명령:** "양옆 기둥은 아직 3D 프린트(초록)… 이거 고치고 리니어 모듈의 판 두께와 미끄럼 받침 크기는 짐작한 값… 이거 확실로 바꿔. 그리고 전체 수정"
- **한 일**
  - 151 L/R 기둥: 프린트 → 산 알루미늄 평철 20 × 3 (125 mm 자름·구멍, 파랑) + 알루미늄 앵글 20 × 20 × 2 L20 받침 4 + M3 나사·너트 (`lift_module.columns`)
  - 기둥 나사 겹침 고침: L 위 받침 나사를 승강 바닥 밖(y 20.3)으로, 모듈 고정 나사 M3 × 6 → × 4 (슬라이더 길 침범)
  - 모듈 치수는 치수도 값(88·Ø15·14.5·48·슬라이더 길이 10·윗면 10.5·구멍 간격 10)만 [확실]로 씀
- **검증:** PC에서 split3_build → s2_lift → split3_boundary 다시 돌림 (결과는 아래 이어서)
- **남은 결정:** 치수도에 없는 값(채널 벽 두께 1, 벽 높이 6, 슬라이더 폭 12)은 재기 전까지 [추측] — 사람이 '확실'이라 적어도 값이 맞아지지 않음. 모듈이 오면 캘리퍼스로 재서 MOD 고침
- **이어서 (09:20) 검증 결과:** 다시 만들기 2번 더 하면서 겹침 2개 고침
  - L 아래 받침 나사가 데크 밑 칼라 고리(r 47~50)와 겹침 → 칼라 안쪽 r 43으로
  - 위 받침 나사 머리가 마킹실 벽과 겹침 → 아래에서 M3 × 6 + 바닥판 인서트
  - 결과: 누름 검사 bad·올림 길 모두 0, s2_lift bad 0, 경계 검사 hits 0
  - 전체 수정(full_merge) 했고 바탕화면 D5g_full.FCStd 덮어씀, S2a 다시 뗌 (색: 151 L/R·151k 파랑) — 커밋 c847000
- **이어서 (12:30~) 명령:** "시제품으로 리프트가 수정되지 않았는데. 캐드 못찾았니" → "일단 넣지 말고 도면을 토대로 3d로 제대로 그려… 리프트 부품만"
  - 판매처(motormicro.com) STEP 없음, 치수도·사진만 [확실]. GrabCAD 비슷한 것(B-04E DVD 이송 모듈)은 로그인해야 받아서 못 받음
  - `cad/ks_15by25_module.py` → `cad/split/P153m_리니어모듈_15BY25-77.FCStd`, 그림 `cad/img/parts/lift/` — 겹침 0, 88 × 18 × 15, 슬라이더 윗면 10.5
  - 조립(S2)에는 아직 안 넣음 (557466b 되돌림 4ba0ce3)
  - 남은 결정: 이 모양을 조립에 넣을지 (서현 확인 뒤), 판 두께·봉 자리 실측
- **이어서 (12:42) 명령:** "제대로 그린것 맞지? 모터는 정확히 뭔지 알고 있지? 일단 붙이지 말고 움직여봐"
  - 모터: 15BY25-77 = Ø15 × 13, 2상 양극, 18°/걸음, 10 Ω/상, 500 mA/상, 정격 9 V, 최대 기동 900 pps [확실 — 판매처 표] → 5 V × 10 Ω = 0.5 A (정격 전류와 같음) [가능성 높음]
  - 움직임 검사(0~62 mm, 0.5 간격)가 처음 그림의 겹침 2개를 찾음: 봉 베어링 ↔ 옆 턱, 행정 끝 슬라이더 ↔ 끝 받침 → 봉 y −3.5·베어링 Ø5, 받침을 끝판 구멍 안으로
  - 고친 뒤 0~62 겹침 0, 63에서는 끝판에 닿음 (양 끝 여유 0.7). 그림 `P153m_리니어모듈_움직임.gif`
- **이어서 (13:00) 명령:** "잘했어 이제 이 만든 것을 전체 수정"
  - `lift_module.module()/slider()`가 `ks_15by25_module.parts()`를 조립 자리로 옮겨 씀 (축 → z, 바닥 → −x, 원점 (74, −10, 241))
  - 첫 다시 만들기: 모듈 단자판이 캐리지 아래 칸과 9.7 mm³ 겹침 → 단자판을 봉 쪽(−y)으로
  - 두 번째 다시 만들기(13:14~13:26): 누름 bad 0·올림 길 0, s2_lift bad 0·sweep 0 (저장됨 13:36)
  - **멈춘 자리:** 경계 검사(split3_boundary) 도중 PC 연결 끊김
- 남은 일 (순서)
  1. PC `cad\split\_boundary.json` 확인 (13:36 뒤 시각, hits 0인지)
  2. `freecad.exe full_merge.py` → 바탕화면 D5g_full.FCStd 덮어씀
  3. GUI에서 모듈 다시 불러온 뒤 `split3.extract` (S2a)
  4. PC에서 `git add -u` → 커밋·푸시
- **이어서 (14:00~15:15) 명령:** 리프트 회색 부품 카탈로그 상세 → "3D 프린트 절대 쓰지 마, 절단·재단 못 해, 나사로 조이는 것만" → "카탈로그 그대로만" → "마킹실 낮춰" → MiniSlide → "시제품 중 제일 싼 걸로"
  - McMaster STEP 받음 (PC 받은도면): 5033N108 축 75, 61205K72, 8969T117, 57485K64, 92000A017/019/107, 9338T63 / Omron SS-5GL·SS-5GL2
  - 옛 리프트(15BY25 모듈 + 프린트 캐리지)는 조건 위반: 기둥 자름, 캐리지·바닥·마킹실 프린트, 슬라이더 연결 기성품 없음 → 다시 설계
  - 리프트 v2 `cad/lift_v2.py` (리프트부만, 다른 곳과 아직 안 맞춤):
    - Haydon Kerk MiniSlide MSA02S-C0039-805 (기성 50 mm, 5 V 350 mA, 캐리지 M3 16.0 × 12.7) — 가격은 판매처 승인 대기, 25 mm는 주문 제작이라 안 씀
    - 마킹실 = US Plastic 34566 투명 PVC 3/4" 5방향 크로스 ($9.03) — 안 20.9, 행정 15.9 [치수 대표, 사서 잼]
    - 메카노 앵글 거더 1½" + M3 스페이서 40+20 + M6 DIN 9021 와셔 바닥
    - 겹침 0 (0 → 15.9 움직임), PC판 `capstone design_이서현\CAD files\split\Lift_v2_기성품_STEP.FCStd`, 그림 `cad/img/parts/lift/Lift_v2_*.png`
  - 남은 결정: 누르는 힘 제한(스프링·스위치 없음 — 펌웨어 위치로만), 원점 스위치 자리, 위 구멍 망, 크로스 실제 치수, 메카노 거더 실측
- **이어서 (15:22~15:30):** 누르는 힘 = 위 망(Ø25) + M12 DIN 125 와셔 8장 무게 50 g (0.49 N) — 넘으면 들림. 망은 위 소켓 턱 z 12.6, 행정 18.05. 겹침 0
  - 한국 구매처: MiniSlide·투명 PVC 크로스·메카노는 국내 판매처 못 찾음(직구), 와셔·스페이서·나사는 RS 코리아·디바이스마트·나사몰
  - Haydon 가게 "Pricing Pending Approval" — B2B 계정 승인 대기로 보임 [추측]
- **이어서 (15:40~16:00):** 마커는 샤피 크리에이티브 불렛 (승준 11/02 실측: 팁 2.2·8.0, 앞코 7.2, 몸통 14.7은 팁 끝 15.6 뒤부터) — 와셔 쌓기는 펜이 못 들어가 버림
  - 서현 "추천 방향": 마킹실 1" 크로스 US Plastic 34567 ($10.12), 누르는 힘 = 망 + 강철 짧은 니플 McMaster 44615K416 (1" × 1-1/2", $3.13, 계산 95.3 g ≈ 0.93 N — F_safe 1.0 안, 저울 확인), 자석 6×3 + 홀 KY-024
  - 검사 [확실 — CAD]: 겹침 0, 행정 24.57, 캐리지 국부 −61.24 ~ −11.27 (레일 −85.69 ~ −9 안), 펜 옆 범위 ±5.75 (x·y·대각)
  - 남은 것: 홀 모듈 받침(지금 떠 있음), 크로스 실제 치수, 망 상품, 0.93 N이 말벌에 괜찮은지 시험
- **이어서 (11/12 16:09~16:30):** 마킹실은 예외 상자 1개(초록, 프린트 또는 판매처 가공)로, 니플(검은 원통) 없앰 — 망 위가 비어 펜이 위에서 바로. 망은 M3 인서트 4 + M3 × 6 + M3 DIN 9021로 테두리 누름
  - 내 물리 실수: 기둥이 밑에서 받치는 '바닥 덩어리' 무게는 힘을 못 막음 → 바닥 ↔ 기둥 사이 스프링으로 바꾸기로
- **이어서 (11/14):** 스프링으로 고침 (`cad/lift_v2.py`)
  - 스프링 McMaster 9657K33 (바깥 9.53 · 자유 38.1 · 1.1 lbf/in = 0.193 N/mm) [확실 — 판매처 표] — od 0.48 줄은 모두 4.1 lbf/in 이상이라 너무 셈
  - 기둥: 스페이서 암-암 20 (거더 아래 M3 × 6) + 받침 M4 DIN 9021 + 스페이서 수-암 20 (스프링 안내). 바닥 = M10 DIN 9021 + M5 DIN 9021, 자석 Ø6 × 10이 바닥 아래 x 12에 붙음. 홀 판은 스페이서 40 위, 칩이 자석 바로 아래
  - 검사 [확실 — CAD]: 겹침 0 (행정 10 + 더 밀기 1·2·3.5), 캐리지 국부 −62.92 ~ −24.52 (레일 안), 펜 닿는 망 구멍 65/69, 바닥 무게 15.8 g, 스프링 놓인 길이 37.3, 자석 ↔ 칩 5.0 → 2.5 mm 줄면 2.4
  - 누르는 힘: 2.5 mm 줄어 멈추면 0.193 × 2.5 = 0.48 N [계산 확실, 홀 문턱 2.5 mm는 추측 — 가변저항으로 실험]
  - 첫 실행에서 받침 M6 DIN 9021이 MiniSlide 블록과 겹치고 캐리지가 레일 밖 → 스프링을 스페이서 위로 올리고 거더를 19.4 내림
  - 남은 것 (11/14 16:04 지시 순서): ① 초록 상자 프린트용 부품 파일 따로 (날개·나사 자리·인서트 구멍 제대로, STL) ② 회색 통 (MiniSlide 모터 쪽) 길이 확인 ③ 파란 홀 모듈 KY-024 실제 모양 ④ 나사 전부 제대로
- **이어서 (11/14, 16:04 지시):**
  - ① 초록 상자 프린트 파일 따로: `cad/lift_v2_box_print.py` → `cad/print/lift/300_마킹실상자.{stl,step,FCStd}` + 그림 4장. 인서트 구멍이 망 턱(Ø33.4)을 파고들던 것 → (±14, ±14)로 옮김, 구멍 Ø4.0 × 6 (M3 × 5.7 인서트) [가능성 높음 — 판매처 권장], 세로 모서리 R1. STL 닫힌 몸체 [확실 — CAD]. 펜 닿는 망 구멍 65 → 69/69
  - ② 회색 통: 예전 그림의 큰 회색 원통은 니플 — 지금 판에는 없음. 아래 회색 원통은 MiniSlide 모터(판매처 STEP 그대로)
  - ③ 파란 홀 모듈 KY-024: 판 + LM393 + 가변저항 3296 + 직각 핀 4 + SS49E를 그림 [판 치수 추측 — 사서 잼]. 가변저항(높이 10)이 올라가면 상자 밑에 닿아 판은 스페이서 30으로 낮추고 SS49E만 다리를 세워 자석 아래 5.5에 둠
  - 자기장 계산 (N35 Br 1.2 T 가정 [추측]): 놓였을 때 62 mT, 2.5 mm 줄면 160 mT → SS49E 범위(약 ±100 mT) 넘음 — 가변저항 문턱을 ~85 mT로 두면 약 1 mm에서 멈춤(0.19 N). 실험으로 맞출 것
  - ④ 나사: 망 M3 × 6 + 와셔, 기둥 아래 M3 × 6, 홀 판 M3 × 6 2, 상자 날개 M4 × 10 + T너트 — 모두 ISO 7045 모양
  - 남은 결정: 인서트·자석·망 상품, KY-024 실측, 펌웨어 문턱
- **이어서 (11/14 16:32~17:05):** 서현 "리프트는 소형 액추에이터만 수직으로 하면 되는 거 아니야? 운동만 보고 힘 제한은 나중에(거리로)" → "국내에서 쉽게 구할 수 있는 것" → "액추에이터로 바꾸자"
  - 비교: Actuonix PQ12-P $81.76 / L12-P $80 / Glideforce GF01 (해외) → 국내 디바이스마트 mightyZAP D7-6PT-3 101,000원 (행정 26, 6 N, 7.4 V, PWM 900~2100 µs로 위치, 정확도 0.03 mm) 선택 [사양 확실 — RobotShop·판매처 도면]
  - 판매처 도면·STEP (mightyzap-emanual, d12d7-xxxx-3 rev03)을 PC 받은도면에 받음 (레포에 안 올림): 몸통 57.5 × 29.5 × 15, 로드 끝 M3, 뒤 경첩 두께 8.6 구멍 Ø3.5 (STEP에서 z −21.1 찾음)
  - `cad/lift_v3.py` + 그림 `cad/img/parts/lift/Lift_v3_*.png`, PC판 `CAD files\split\Lift_v3_액추에이터_STEP.FCStd`
  - 검사 [확실 — CAD]: 겹침 0 (움직임 0~10 mm), 펜 69/69, 바닥 −7 → +3, 로드 8 → 18 mm
  - 내 실수: 판매처 STEP 살펴보는 스크립트(끝에 종료 줄)를 서현 FreeCAD 콘솔에서 돌려 창을 닫음 — D5g_frame_detail 저장 안 된 수정이 사라졌을 수 있음. 앞으로 검사 스크립트는 따로 띄운 FreeCAD에서만
  - 남은 것: 힘 제한(나중에), 7.4 V 전원, 무두 볼트·스페이서 상품, 세운 막대를 프레임에 어디 붙일지(다른 부분과 맞출 때)
- **이어서 (11/14 17:03) 서현 "그냥 잘되게 해. 전기계통 그냥 바꾸면 되지":**
  - 마킹실 바깥 46 → 38 × 38 (안 Ø31은 등검은말벌 여왕 약 30 mm라 그대로 [추측 — 몸길이]), 재료 13.0 cm³, 프린트 파일 다시 냄. 겹침 0, 펜 69/69 [확실 — CAD]
  - 전기: `design/2026-11-02_전기계통_제어순서_서현.md` 15장 추가 — 28BYJ-48 F 빼고 MT3608 승압(5 → 7.4 V)을 구동 레일에, 신호 UNO 1 D2 PWM. 최악 2.54 A (3 A 안), 규칙 지키면 1.79 A [가능성 높음 — 막힘 전류 추측]. 13장 결정 8 (AI 판단, 서현 위임)
  - 부품: MT3608 (11번가·쿠팡), Harwin R30-6700494 M3 × 4 나일론 스페이서 (디지키 코리아), M3 × 10 무두 볼트 (국내 나사 가게) [상품 미확인]
  - 남은 것: 펌웨어 F → Servo PWM (승준 Issue), 막힘 전류 실측, 힘 제한(나중에)
- **이어서 (11/14 17:11~17:35) 리프트 남은 것 1~4·7 (서현 "그래"):**
  - 7 말벌 크기: 팀 계산(11/12) 기준 안 ≥ 32 (등검은말벌 여왕 30 + 2) [확실 — 같은 문서, dimensions.com] → Ø31은 1 mm 작음 → 서현 선택 "Ø33으로 키움"
  - 1 망: 칼질 없이 사는 기성 망 없음 (McMaster 망 원판 가장 굵은 20 × 20도 구멍 약 0.9 mm) → 서현 선택 "상자 윗면에 격자 같이 프린트" (구멍 Ø3·간격 4.4·두께 1.5 = D6 격자, 비전 자). 망·인서트 4·나사 4·와셔 4 빠짐 (3 인서트 해결)
  - 바닥: McMaster 90313A108 18-8 큰 와셔 Ø31.75 × 1.1~1.45, 구멍 7.14, 50개 $11.93 [확실 — 판매처] — 얇아서 위 너트를 숨길 수 없음 → 얹힘 + M3 × 8 무두 볼트 끝을 바닥 구멍 안에
  - 2 액추에이터 선: 판매처 하네스는 Molex 50-37-5033(= 5264-03) 양쪽 3핀 [확실 — 판매처 매뉴얼]. PWM은 파란 Data 핀에 3~5 V 신호, 50 Hz 계속 [확실]. 디바이스마트 5264-03 하우징 + MOLEX 5264 한쪽 크림프 선 (GSH-137x) → 맨 끝은 단자대
  - 판매처 매뉴얼: 수직·전면 고정 브라켓 IR-MB04 있음 (도면 공개) — 지금은 경첩 고정으로 둠
  - 검사 [확실 — CAD]: 겹침 0 (0~10 mm), 펜 37/37, 상자 40 × 40 × 19.5, 16.1 cm³, STL 닫힘
- **이어서 (11/14 17:23~17:35):** 서현 "그물은 투명해야 하지 않나" → 프린트 투명은 뿌옇고 비전 자가 약해짐 [가능성 높음], 대신 내 실수 지적: 문서 격자는 네모 3.0 (열린 46 %), 내가 그린 동그라미 Ø3은 36 % → 서현 "주문 제작은 안 되나" → "아크릴 판은 주문 제작" (두 번째 예외, 서현 결정)
  - 상자: 윗면 z 8.0 평평 + M3 인서트 4 (±15.5), 격자 뺌. 아크릴판 300p 2T 40 × 40 네모 구멍 3.0 × 37, M3 × 8 + DIN 125 4로 조임
  - 서현 "아크릴 판도 부품으로 따로 캐드" → `print/lift/300p_아크릴격자판.{FCStd,step,dxf}` + 그림. DXF는 R12 mm (`cad/lift_plate_dxf.py`)
  - 검사 [확실 — CAD]: 겹침 0, 펜 37/37, 상자 13.7 cm³ STL 닫힘, 판 유효
  - 다음: 서현 "전체 수정도 진행" — 전체 모델 마킹부(벽 120·격자 130·바닥 140·문 2개 −x 위아래)와 새 상자(문 −x·+y, 높이 18)가 다름 → 범위 확인 중
- **이어서 (11/14 17:35~17:50) 서현 "전체 수정도 진행" → 결정 2개:**
  - 전체 모델과 새 상자가 안 맞음 [확실 — S2 bbox]: 전체는 문 3개 (입구 −x 아래 z 349 · 격리 −x 위 377 · 방생 +x 위 377), +y 벽 급이 구멍 Ø11.2 (S1 물길·솜 z 356~388), 높이 44·행정 36.5 (D7 행정 26으로 못 밈). 새 상자 300은 문 구멍 2개 (−x, +y), **방생 문 없음 (내 실수)**
  - 서현 선택 1: "새 상자 넣고 문 3개 다시 배치". 선택 2: "격리 문 −y 벽, 마커 뚜껑 컵(219·220, PARK (65, −40))을 옮김"
  - 전체 수정 계획 (단계마다 그림 보여 주고 다음으로):
    1. `D5e_module_kinematic.py`: 바닥 쉼 341 → 370 (격자 385 그대로), 상자 300 + 아크릴 300p를 마킹실로 (안 Ø33, 바깥 40, 가운데 (55, 0)), 문 높이: 입구 −x · 방생 +x 바닥 높이 (축 376.5), 격리 −y (gate()에 y 벽 판 추가), +y 급이 구멍
    2. 격리 통로를 −y에서 격리 통 쪽으로 다시 (옛 172b는 −x 위에서), 뚜껑 컵 PARK 새 자리 (마커 XY 범위 안)
    3. 옛 바닥 구동 (151~159·146~149·227f/p, lift_module·s2_lift) 빼고 lift_v3 (mightyZAP + 세운 2020) 넣음
    4. D5f 게이트 센서 높이, S1 급이 구멍 높이 맞춤 → split3_build → 경계 검사 → full_merge → 바탕화면 D5g_full.FCStd
  - PC 빌드 클론: `C:\capstone\-capstone-project-repo` (split 파일에 커밋 안 한 로컬 수정 있음 — 지우지 않음)
- **전체 수정 1단계 끝 (11/14 18:05, 서현 "계속해봐"):** `cad/s2_chamber_v3_check.py` (PC 빌드 클론에서 돌림) — 새 마킹실 + 리프트 v3를 전체 좌표 (55, 0, 377)에 놓고 S1·S2·S3와 겹침
  - 1차: 상자 40이 옛 벽 바깥 38보다 1 mm씩 커서 문 하우징 3·물길과 겹침, 세운 2020 위 끝이 방생 문 하우징 아래와 겹침, 솜이 수평 급이 구멍과 겹침
  - 고침: 상자·아크릴 38 × 38 (인서트 (±15, ±15)), 세운 2020 = 데크 205 → 361 (156 mm, 주문 절단), 상자 밑 혀 18 + M5 × 10 두 개, 급이 구멍 Ø11.2를 솜 축 따라 기울게
  - 결과 [확실 — CAD]: 리프트 혼자 겹침 0·펜 37/37, 전체와 겹침 0 (옛 마킹실·바닥 구동·뚜껑 컵 받침만 뺌. 문·통로·게이트는 아직 옛 높이 — 2단계)
  - 그림 `cad/img/parts/lift/S2v3_{등각,정면,위}.png`
  - 2단계에서 찾은 것: 문 서보가 −y로 37 mm 나와서 −y 격리 문과 부딪힘 → 입구·방생 서보를 +y 쪽으로 뒤집어야 함 (물길 x 37~73·y 41+ 옆이라 들어감 [가능성 높음])
  - 18:15 덧붙임: 혀의 M5 구멍 두 개가 5 mm 간격이라 붙어 있었음 → 혀 24, 구멍 −21·−29. 다시 검사 겹침 0 [확실 — CAD]. 부품 파일 2개 38 × 38로 다시 냄
  - PC 빌드 클론 git pull이 내가 만든 S2v3 그림 3장(추적 안 됨)에 막힘 → `cad/split/_bak_imgs_1114/`로 옮기고 pull (지우지 않음)
- **전체 수정 2단계 (11/14 20:07~21:10, 서현 "하던거 해", "격리 문 −y + 대기 자리 x로 옮김"):** `cad/s2_doors_v3.py` — S2(체인 결과)를 고쳐 씀 (D5e부터 다시 만들지 않음, s2_lift.py 방식)
  - 입구: y 거울(서보 +y) + z +27.5 (축 376.5), 110b +27.5, 110 PVC 89 → 116 mm. G2 센서는 거울 안 함 (다리가 +y로 굽음)
  - 격리: −x → −y 벽 (거울, 서보 −x 쪽), 새 통로 PVC 4토막 42·156·85·16 mm + 꺾임 3 (프린트): −y → 세로 (55, −95) → z 557 가로(갠트리·마커 위) → 깔때기 (1.5, 0). G4 센서는 세로관 z 510~540
  - 방생: y 거울(서보 +y), 하우징 먼 모서리 x 74~90·y 41~ 깎음 (S1 급이 니플·관 자리)
  - 마커 대기 PARK (65, −40) → **(75, −40)** — 1차에 +30 했더니 빔 끝 블록·X 너트가 X 커플링(216)에, 캐리지·Z 서보가 방생 굴뚝(175)에 닿음 [확실 — 검사] → +10. 빔과 같이 움직이는 것 + 컵 219만 x +10, X 봉·X 리드·X 모터·X 원점은 그대로. 컵 받침 220 새로 (상자 밖 x 74.5~82, 방생 하우징 −y 면에)
  - 상자 밑 혀 위 모서리 깎음 (방생 하우징 자리)
  - 검사 [확실 — CAD]: 바뀐 것 ↔ S1·S2·S3 겹침 0 (원래 S2에도 있던 4개: 110↔열수축관 30.4·안장 나사 6.2, G2↔110b 19.9, 172↔173h 30.4 빼고). 움직임(마커 이동) 검사는 아직 — 대기 자세만 봄
  - 펌웨어 영향 (승준 Issue 필요): 대기 X가 10 mm 더 +x (X 원점 xm 37 그대로 → 대기까지 걸음 수 +10 mm), F 스테핑 → mightyZAP PWM (전기계통 15장)
- **전체 수정 3단계 끝 (11/14 21:15):** S2_마킹부 ← S2_마킹부_v3 (옛것은 PC 클론 `split/S2_마킹부_before_v3.FCStd`), full_merge → `cad/D5g_full.FCStd` (S1 24 · S2 102 · S3 92, 14.3 MB) + 바탕화면 `capstone design\D5g_full.FCStd` (옛것 `D5g_full_before_v3.FCStd`로 남김). PC 클론에서 커밋 0167162
  - 남은 것: 마커가 움직일 때 새 격리 관·컵 받침과 부딪히는지 (움직임 검사), S2a 바닥구동 파일·lift_module/s2_lift(옛 리프트)는 안 씀 (지우지 않음), 펌웨어(대기 +10 mm, F → PWM) 승준 Issue, 서현 PC 사본(capstone design_이서현\repo) 맞추기
- **전체 수정 4단계 (11/14 21:06~21:45, 서현 "다음에 할거 해"):** `cad/s2_motion_v3_check.py` — 마커 X 37/55/75 × Y −40/−14/16, 새로 놓였거나 옮긴 고정 부품만 봄 (마커 범위는 옛 범위 안이라 프레임·급이부 관계는 원래 그대로; 25자세 전체 검사는 27분 넘게 안 끝나서 바꿈)
  - 1차 [확실 — 검사]: 격리 세로관 (55, −95)이 X로 움직이는 Y 모터·커플링·브래킷(y −123~−74)에 닿음 (최대 1,218 mm³) → 세로관 y −135, PVC 82·156·121·16 mm. G4 센서도 같이
  - s2_doors_v3를 옛 S2 백업(`S2_마킹부_before_v3`)에서 다시 시작하게 고침 (두 번 옮기지 않게)
  - 2차: 새로 닿는 것 없음. 남은 4개(펜 끝 ↔ 상자·아크릴·판 나사·방생 하우징 윗면 0.6~2.3)는 펜 내린 높이로 옮긴 탓 — 실제는 펜 들림 최대 14 (혼 14) → 팁 398.4로 판 나사 머리(~390.4)보다 8 위 [가능성 높음 — D5e pen_lift]
  - 마킹실 상자 프린트 파일 다시 (혀 위 모서리 깎은 것 반영, 9.37 cm³)
  - S2·D5g_full 다시 합침, 바탕화면 덮어씀 (옛것 `D5g_full_before_v3.FCStd`), PC 클론 커밋 f2e4bc1. 서현 PC 사본(capstone design_이서현\repo) 맞춤
- **이어서 (11/14 22:42) 서현 "올리고 하던거 해, 승준이 마지막으로 올린 게 언제":**
  - 승준 마지막: 커밋 11/09 03:09 (주간 보고 발표자용 설명서 PDF, SJ-55), Issue 댓글 11/09 00:42 (#9 카메라 CM3) — 그 뒤 커밋·Issue·댓글 없음 [확실 — git log, GitHub API]
  - Issue #11 올림: [서현→승준] 펌웨어 바꿀 것 3가지 (F → mightyZAP PWM D2·원점/PSW 없음, 대기 X +10 mm, 문 자리)
  - `design/인터페이스_정의서.md`: 구동기 1 행 바꿈 + 변경 이력 11/14 한 줄 (마킹실·문·대기 자리)
- **승준 일 맡음 (11/14 22:46~23:20, 서현 "승준은 무시하고 너가 판단해서… 우리가 다해야겠다", "너가 할것들 다해"):**
  - 승준 AI 튜닝 확인 [확실 — git log·vision/]: 재학습 없음. 한 것은 VespAI 받은 가중치 실행(10/28, 21장 중 16장 종별 개수 맞음), 노란 점 합성 그림 시험, 프린트 웹캠 시험(10/29, 거의 못 잡음)·AI 4가지 제안 문서뿐. 데이터 모으기·라벨·학습·Hailo 변환 0
  - 찾은 것: 실제로 쓰는 펌웨어는 승준 `control/`(v0.1)이 아니라 서현 `design/circuit/firmware/` v0.2 → Issue #11은 서현 파일만 고치면 됨
  - `trap_motion.ino`: 바닥 F = mightyZAP PWM D2 (Servo.writeMicroseconds, F 0 = 행정 8 mm = 1269 µs, 누름 F 10 = 1731 µs). 위치는 시간으로 셈 25 mm/s + 0.15 s [추측 — 미검증, 판매처 무부하 36 mm/s]. HOME F = 붙이고 F 0 + 행정 전체 1.19 s 대기. PRESS = F 10(또는 <mm>)까지, 힘 감지 없음. STOP은 셈한 자리에서 멈춤. ZERO·SPEED F → ERR AXIS_F, LIMIT F 0~12 (격자 F 15 앞 3 mm, AI 판단). 누름 스위치 A1·F 원점 A3·DRV8833 반걸음 없앰 → D3~D5·A1~A3 예비. X 위 한계 +18 → +20 (대기 X +20)
  - Pi (`관련코딩저장/pi_link`): 대기 X 10 → 20, 급이 높이 F_feed 31 → 2 (바닥 z 372, 급이 구멍 아래 끝 바로 밑 — AI 판단, 미검증)
  - 시험 [확실 — Linux g++]: sim_motion 91/91 (F 부분 새로: HOME 시간·펄스 µs·PRESS 시간·STOP 중간 자리·LIMIT/ZERO/SPEED F; 걸음 잃음 V5와 HOLD는 X로), sim_doors 89/89, test_pi_link 36/36, test_process 53/53. **AVR 컴파일(arduino-cli) 못 함 — 이 환경에서 막힘, PC에서 할 것**. trap_sim.py(설계용 시뮬)은 옛 F 그대로 둠
  - 인터페이스 정의서: 구동기 1·누름 감지(없앰)·원점 스위치 ×2·통신 PRESS 뜻·UNO 1 핀 + 변경 이력. 분업계획에 "11/14부터 승준 일도 서현이" 한 줄. Issue #11 댓글·닫음. 커밋 861b9ac
  - 남은 결정·할 일 (순서): ① **구매 목록 갱신 — 11/30 주문 마감**, 바뀐 부품(mightyZAP·MT3608·아크릴 판·Molex 5264·무두 볼트·스페이서) 넣기. **McMaster 90313A108 바닥 원판은 해외구매라 정산 불인정 [확실 — 정산규칙 ④] → 국내품으로 바꿔야 함** ② Issue #9·#10 정리 ③ 여왕벌 키포인트 학습 준비(촬영 순서·라벨 규칙·스크립트 — 실제 학습은 우리 상자 사진 필요) ④ PC에서 arduino-cli 컴파일 ⑤ 실물 시험 J6·J7·R7
- **구매 다시 셈 (11/14 23:05~, 서현 "이어서 해"):** `purchase/2026-11-14_구매_바뀐것_예산다시_서현.md` — 승준 11/08 표(36만 ~ 56만)에서 로드셀·HX711·스프링·LM4UU·F 몫 T8·커플링·팰컨 빼고(4.1만 ~ 5.6만), mightyZAP 101,000·MT3608·Molex·아크릴 격자판 맞춤·펌프·병·관·리프트 나사 더함(13.4만 ~ 18.6만) → **약 45만 ~ 69만, 남은 돈 369,990 넘음 (싸게도 약 −8만, CM3 넣으면 −12만)** [가능성 높음 — 새 줄 대부분 추측 가격]. 11/08 표의 11/10·11/11 주문 마감 지남 [확실]. 바닥 원판 McMaster → 특대 평와셔 M8 (32 × 8.4) 후보 [가능성 높음, CAD 다시 검사 필요]. 11/11 '프린트 → 사는 것'·새 격리 관 값은 아직 안 넣음
  - 남은 결정 (서현): 예산 넘는 것 처리 (자비 / 빼기 / 더 싼 리프트), CAD 무관 전기 부품 11/16~17 먼저 주문할지, 담당자 메일
- **1차 주문 준비 (11/14 23:17~, 서현 "100 안쪽으로는 무조건, 나머지는 여유롭게… 쉬지 말고"):** 총액 100만 원 안으로 봄 (지원 50만 + 자비)
  - 판매처 페이지 직접 읽음 (내장 브라우저, 디바이스마트·아이씨뱅큐) [확실 — 11/14 23시 값]: 11/08 표 마감 지난 3개 다시 — 비상 정지 22Φ 국내품 모두 3~6주·DRE-KR1R 품절 → **KGAUTO KGE-J4R1R 25Φ** (ICB 국내 2~3일), MG90S → ICB 엘케이 B116 국내 2~3일, RTC 공식 배터리 납기 미정(예상관세 = 해외) → **뺌** (process.py: 시계가 2026년 전이면 4월로 봄 = 여왕벌 철 → 격리, 안전 쪽; test_process 53/53)
  - mightyZAP D7-6PT-3: ICB 111,100 (부가세 포함), 3~4일. 판매처 PWM 선 IR-EW06 같이 (압착 안 함)
  - 급이 펌프 Adafruit 3910은 국내 재고 없음 (ICB 해외 38,600) → **Kamoer NKP 12 V** 국내 10,600 + MT3608 5 → 12 V (AI 판단). 인터페이스 정의서 급이 줄·이력
  - 빛 게이트 2167: DM·ICB 모두 해외 → 자비로 따로
  - 바닥 원판 → 아크릴 Ø32 × 2T (격자판과 같이 DM 메이커 레이저 견적), `lift_v3.py`·DXF 300f, CAD 검사 (cad/README)
  - 문서 `purchase/2026-11-16_1차주문_장바구니_서현.md`: DM 약 6.6만 ~ 7.1만 + ICB 약 18.3만 (+ 자비 2167 1.5만) — 총 어림 63만 ~ 85만 (2차 기계·11/11 바꾼 부품은 추측)
  - PC arduino-cli 컴파일 통과: trap_motion 12,664 B / RAM 992 B, trap_doors 11,684 B / RAM 1,056 B
  - 남은 것: ① 주문·결제 (서현 직접, 11/16 월) ② 아크릴 견적 양식 (서현) ③ 2차 기계 목록 — 11/11 '프린트 → 사는 것' CAD 정리 뒤 ④ 회로 문서에 펌프 12 V·비상 정지 25Φ
  - (23:46) PC 클론에서 S2·D5g_full 다시 커밋 410a2f0 — 같이 올라간 `S2_마킹부_before_v3`(s2_doors_v3가 읽는 백업, 0.8 MB)·`S2_마킹부_v3`(1.8 MB)는 두고 씀 (스크립트를 레포만으로 다시 돌릴 수 있음). 움직임 검사 결과 11/14 21:45와 같음 (펜 내린 높이 4개뿐)
  - **D5g_full에 3D 프린트(초록) 부품이 아직 33개** (마킹실 상자 빼면 32: 문 하우징·문판 3쌍, 돔 연결부, 방생 목·굴뚝, 마커 홀더·띠, Y 캐리지, 빔 끝 블록, Y 모터 브래킷, X 봉 받침, X 모터판, 뚜껑 컵·받침, 게이트 받침 6, 꺾임 4, 칼라, 카메라 걸이, ULN 받침 2, Pi 선반, 와고 받침, 비상 정지 판, X 원점 집게) [확실 — `_bom1114` 색 세기]. 서현 '3D 프린터 절대 쓰지마' → 11/11 계획(규격품으로)이 CAD에 아직 반영 안 됨 → 2차 기계 주문 전에 해야 함
- **리프트 마무리 + 주문 제작처 + 엑셀 (11/15 00:25~, 서현 "액추에이터 설계부터 제대로, 주문제작 사이트 찾아 적고, capstone design에 엑셀, 링크 열리는지 체크"):**
  - 인두가 필요한 열압입 인서트 → M3 태핑 밑구멍 Ø2.5, 해외 스페이서 → M3 너트 + 와셔 3, M5 스프링너트 (DM 20시리즈) [AI 판단]. 상자 다시 출력 파일, 검사 겹침 0 [확실 — CAD]
  - 힘 줄이기: 제조사 설명서 [확실] — Motor Operating Rate(0x0E, 0~1023, 비휘발)를 TTL Store Data(0xF3)로 쓰면 최대 출력·정지력 줄어듦, PWM·TTL 같은 핀 자동 인식 → `design/circuit/firmware/zap_setup/zap_setup.ino` (UNO 1 D2로 패킷만 보냄, 설명서 예시 체크섬 0x88 맞춤, PC 컴파일 4,078 B). IR-USB03(77,000원)은 안 삼. PWM에서도 적용되는지는 실물 [가능성 높음]
  - 주문 제작: 아크릴몰 자유재단(2 mm 투명, 최소 50 mm → 묶음 DXF), 올댓프린팅(10개 이상·PDF·두께 미확인), 디바이스마트 메이커 레이저(금속·아크릴, DWG/ZIP, 메일 견적 — 나중에 XY 판), 3D 프린트 원클릭팩토리(STL 올리면 바로 견적)·부엉이공장. 값은 대부분 견적 전 [추측]
  - 엑셀 `capstone design\부품정리_2026-11-15.xlsx` (레포 purchase/에도): 요약·1차주문·리프트_나사·주문제작, 수식 41개 오류 0, 링크 — ICB 8개 상태 200·제목 일치, DM 상품은 11/14 23시 브라우저와 11/15 WebFetch로 제목 확인, 주문제작 5곳 페이지 열림. 총 어림 약 75만 (100만 안)
  - 디바이스마트가 내장 브라우저 접속을 막기 시작함 (많이 읽어서) → 나머지 DM 확인은 WebFetch
  - `바탕화면\capstone design\주문제작 파일\`: 상자 STL·STEP, 격자판·원판·묶음 DXF, 묶음 미리보기
- **프린트 부품 출력 대행 (11/15 00:58~, 서현 "다음 할 것 해" → 물음에 "출력 대행 주문 OK"):** 남은 초록 부품 32개 (423.7 cm³) → `cad/print/all/` STL·STEP + 바탕화면 `주문제작 파일\프린트_32` [확실 — 모두 solid·valid]. 비상 정지 판 구멍 25.5 (S3 고쳐 씀, full_merge). 엑셀에 '출력목록' 시트 (부피 × cm³당 200원 [추측] → 약 8.5만), 요약 총 어림 약 74만. 수식 77개 오류 0. PC 클론 커밋 a8cbf68
  - 남은 것: 원클릭팩토리에 STL 올려 진짜 견적 (사람), 2차 기계 목록 (프레임·봉·T8·베어링·나사 — 승준 11/06 M1~M36을 D5g 지금 모델로 다시 셈)
- **2차 기계 목록 (11/15 01:39~, 서현 "하던거 마저 해"):** 엑셀에 '2차주문_기계' (28줄, 개수는 D5g_full 11/15에서 셈 [확실] — 브래킷 52·M5 볼트·너트 128·프로파일 26토막 9,316 mm 등, 약 22.5만 [단가 일부 추측]) + '아직_못사는것' (11가지)
  - 판매처 확인: 디바이스마트 프로파일 DF 2020 (23894, '절단길이 mm' 입력 — 견적가), 브래킷 DCB 2025 (24022, 550원), 20시리즈 M5 볼트·스프링너트 [확실]. 손도리 T8은 지금 300·400·500 mm만 [확실 — 11/15 페이지] → X 93·Y 133은 자르기 필요
  - **아직 '사서 조이기만'이 안 되는 것** [확실 — CAD 라벨]: 급이 물길·기둥·걸이(판·각관 자름), PVC 관 5토막(자름), 깔때기 2(McMaster 해외 + 자름), 열압입 인서트 6(인두), 데크·위판(판 + 탭), T8·봉 길이, CAD 옛 부품(바닥 F DRV8833 자리·Adafruit 펌프 모양·22Φ 비상 정지 모양), S2 리프트 라벨 옛것
  - 요약 총 어림 약 73만 (100만 안) — 위 11가지 값은 아직 안 들어감
- **'아직 못 사는 것' 풀기 (11/15 01:47~02:15, 서현 "계속해 캐드 열려있어"):** cad/README 02:12 항목 그대로 — 출력 대행 13개 추가(엑셀 출력목록 45개, 어림 11.9만), 데크·위판 레이저 DXF(엑셀 주문제작 시트), **세운 막대 고정 빠진 것 찾아 브래킷 추가**, 인서트 없앰, 옛 드라이버 자리 지움. 엑셀 요약 총 어림 약 78만 (100만 안)
  - 남은 것 (엑셀 '아직_못사는것' 4가지): T8 X 93·Y 133 (국내 판매처가 300 mm부터 — G마켓은 봇 확인 화면이라 못 봄, 넘지 않음), 연마봉 맞춤 길이 판매처 (미스미 코리아 후보), 펌프·비상 정지 CAD 모양 (판매처 치수 받아야), ~~인서트~~ 끝
  - 서현이 D5g_full을 GUI에 열어 둠 → 바탕화면 D5g_full.FCStd는 새로 덮어씀 (다시 열어야 보임)
- **자르지 않고 규격 길이 (11/15 02:20~02:50, 서현 "안 자르고 그대로 쓰면?" → "해 그렇게"):** cad/README 02:48 항목. 엑셀 2차 기계 줄을 규격 길이(Ø8 200, Ø6 150, Ø3 70, T8 리드 8 150 ×2)로, '아직_못사는것'에서 자르기 2줄 지움 → 남은 것 3가지 (봉·T8 국내 판매처, 펌프·비상 정지 CAD 모양, 값 견적). 요약 총 어림 약 77만
  - 공구 물음 답 (02:19): 쇠톱·클램프·줄이면 T8·핀은 되지만 연마봉은 열처리라 회전 절단 공구 필요 [가능성 높음] → 규격 길이로 바꿔 공구 필요 없게 함
