britams/-capstone-project-repo/cad/2026-11-06_D5g_부품표_승준.md

# D5g 부품표 — 모든 부품 이름·구분·규격 (승준, 2026-11-06 밤, CAP-AI-SJ-49)

모델(`G.make()`)에서 `D5g_parts_table.markdown(doc)`로 바로 뽑은 표 [확실 — 모델 기준]. 번호는 모델 이름 앞 숫자 = 그림 풍선 번호.
구분: **구매** = 사는 물건 (회색) / **설계** = 우리가 3D 프린트·판 가공 (주황) / **참고** = 산 상용 트랩·말벌 크기 (초록, 고치지 않음).
개수는 모델에 든 개수 (예비 제외). 주문 개수·가격은 `purchase/2026-11-06_기계부품_구매상세_McMaster대조.md`, 전기 부품은 서현 구매확정표.
그림: `cad/img/D5g_parts_balloon.png` (전체), `D5g_feeder.png`, `D5g_loadcell.png`, `D5g_joint_T.png`

| 번호 | 이름 | 구분 | 규격·품번 | 개수(모델) | 모델 이름 |
|---|---|---|---|---|---|
| 100a | 프레임 기둥 (2020 알루미늄 프로파일) | 구매 | 2020 홈 6, 610 mm | 4 | `100a_post_1~4` |
| 100b | 프레임 둘레 레일 (2020) | 구매 | 2020, 320 mm | 16 | `100b_rail_(0·deck·gantry·top)_(x·y)±170` |
| 100c | 프레임 가로대 (2020) | 구매 | 2020, 320 mm | 4 | `100c_cross_(deck·top)_y±80` |
| 100d | 갠트리 레일 (2020) | 구매 | 2020, 320 mm | 1 | `100d_gantry_rail_x-18` |
| 100e | L 브래킷 — 기둥 이음 | 구매 | 2020 L 20 × 20 × 18, 미스미 LCNBS6-2028 짝 | 32 | `100e_bracket_2020_L` |
| 100e2 | L 브래킷 — 가로대·갠트리 T 이음 **(11/06 밤 추가)** | 구매 | 같은 것 | 20 | `100e2_bracket_2020_L_T이음` |
| 100f · 100f2 | 볼트 M5 × 8 (프레임 이음) | 구매 | ISO 4762, 미스미 E-GSCB5-8 | 64 + 40 | `100f_bolt_M5x8`, `100f2_…_T이음` |
| 100g · 100g2 | 슬라이드 T너트 M5 (홈 6) | 구매 | 10 × 9.5 × 4.5 | 64 + 40 | `100g_tnut_M5_slot6`, `100g2_…_T이음` |
| 100h · 100i | 볼트 M5 + T너트 (급이 발·ULN 받침) | 구매 | M5 × 8 / × 12 | 6 + 6 | `100h_bolt_M5x8_mounts`, `100i_tnut_M5_mounts` |
| 100j · 100k | 볼트 M5 + T너트 (부품 → 프레임: 봉 받침·모터판·위판·데크·Pi 선반·비상 정지 판) **(추가)** | 구매 | M5 × 8 / 10 / 12, McMaster 91292A124·A125 | 18 + 18 | `100j_bolt_M5_parts`, `100k_tnut_M5_parts` |
| 100m · 100n | 볼트 M3 × 10 + 열 압입 인서트 M3 (데크 아래에서 옆판·칼라) **(추가)** | 구매 | McMaster 91292A113 / 94459A130 | 8 + 8 | `100m_…`, `100n_…` |
| 101 | 데크 판 (모듈 받침) | 설계 | 판 5 mm, 가로대에 M5 × 4 | 1 | `101_deck` |
| 102 | 칼라 (트랩 고리와 틈 막이) | 설계 | 3D 프린트, 데크에 M3 × 4 | 1 | `102_collar` |
| 104 | 돔 연결부 | 설계 | 3D 프린트 | 1 | `104_dome_coupling` |
| 105 | 위판 | 설계 | 판 5 mm, 가로대에 M5 × 4 | 1 | `105_top_plate` |
| 110 | 입구 통로 | 설계 | 3D 프린트 | 1 | `110_entry_duct` |
| 111 | 입구 깔때기 | 설계 | 3D 프린트 | 1 | `111_entry_funnel` |
| 112 | 입구 문 하우징 / 문 판(미닫이) / 서보 기둥 ×2 | 설계 | 3D 프린트 | 4 | `112_entry_gate_housing·flap·post1·post2` |
| 112 | 입구 문 서보 MG90S (+ 혼·축) | 구매 | 금속 기어 마이크로 서보 | 1 | `112_entry_gate_servo_MG90S·horn·spline` |
| 114 | 입구 빛 게이트 G1 (송·수신) | 구매 | Adafruit 2167 | 1쌍 | `114_entry_sensor_tx·rx` |
| 120 | 마킹실 벽 (+ 물길 고정 보스 2) | 설계 | 3D 프린트 | 1 | `120_chamber_walls` |
| 121 | 마킹실 바닥판 | 설계 | 3D 프린트 | 1 | `121_chamber_base` |
| 130 | 격자 (말벌 누르는 망) | 설계 | **투명 아크릴 1.5 레이저 가공** (구멍 Ø3 · 간격 4.4 그대로 — 서현 11/09, CAP-AI-55) | 1 | `130_grid` |
| 140 | 승강 바닥 | 설계 | 3D 프린트 | 1 | `140_lift_floor` |
| 142n | 코튼롤 2호 (설탕물 심지) | 구매 | Ø10 × 38, 치과 재료 — McMaster 없음 | 1 | `142n_cotton_roll_#2` |
| 143 | 급이 방 물길·그릇·튜브 집게 | 설계 | 3D 프린트 PETG | 1 | `143_feed_trough` |
| 143l | 급이 방 뚜껑 (벌레 막기) | 설계 | 3D 프린트 PETG | 1 | `143l_feed_trough_lid` |
| 143i | 열 압입 인서트 M3 (급이 방) | 구매 | McMaster 94459A130 | 6 | `143i_insert_M3_heatset` |
| 143s | 볼트 M3 × 8 (물길 → 마킹실 벽) | 구매 | McMaster 91292A112 | 2 | `143s_bolt_M3x8` |
| 143t | 손나사 M3 × 8 (급이 뚜껑) | 구매 | McMaster 92545A111 | 4 | `143t_thumbscrew_M3x8` |
| 144n | 설탕물 통 15 mL 원뿔 튜브 (거꾸로) | 구매 | 코닝 352096 (Ø17.37 × 118.8) — 11/10 서현: 50 mL 7979T44에서 바꿈 (열팽창으로 넘침) | 1 | `144n_falcon_15mL_inverted` |
| 146 | 스프링 (바닥 완충) | 구매 | 바깥 ≤ 4.1 | 1 | `146_spring` |
| 147 | 축 Ø4 × 80 (바닥 안내) | 구매 | 경화 h6 | 1 | `147_shaft_D4x80` |
| 148 | 로드셀 막대 1 kg **(버튼형 → 막대형)** | 구매 | Adafruit 4540, 80 × 12.7 × 12.7 | 1 | `148_load_cell_bar` (+ `148g` 게이지 덮개) |
| 148s | 스프링 받침판 | 설계 | 3D 프린트 PETG | 1 | `148s_spring_seat` |
| 148m4 · 148m5 | 볼트 M4 × 10 (받침판) · M5 × 12 (고정 끝) | 구매 | McMaster 91292A116 · 91292A125 | 1 + 2 | `148m4_…`, `148m5_…` |
| 149 | 직선 볼 부싱 LM4UU | 구매 | | 1 | `149_LM4UU` |
| 151 | 바닥 구동 옆판 | 설계 | 3D 프린트, 데크에 M3 × 2 (보스) | 2 | `151_drive_side_L·R` |
| 152 | 바닥 모터판 | 설계 | 3D 프린트 | 1 | `152_motor_plate` |
| 153 | 바닥 모터 28BYJ-48 (+ 축) | 구매 | 5 V 스테핑 | 1 | `153_floor_stepper_28BYJ48`, `153r_…` |
| 153b · 153n | 모터 귀 나사 M3 × 8 + 너트 + **M3 평와셔** (모터 3개 × 2, 귀 구멍 Ø4.2) | 구매 | 서현 11/09 M3 확정 (Issue #9-2). 와셔는 모델에 안 그림 | 6 + 6 + 6 | `153b_stepper_ear_bolts`, `153n_stepper_ear_nuts` |
| 154 | 커플링 5 → 8 mm (바닥) | 구매 | McMaster 4147N159 / D19L25 | 1 | `154_coupling` |
| 155 | T8 리드스크루 (바닥) | 구매 | Tr8 × 8, 80 mm | 1 | `155_lead_screw_T8` |
| 157 | 돌림 막이 봉 Ø4 (바닥) | 구매 | Ø4 × 108 | 1 | `157_guide_rod` |
| 158 | 바닥 캐리지 + 로드셀 팔 158a | 설계 | 3D 프린트 PETG | 1 | `158_carriage` |
| 159 | T8 너트 (바닥) | 구매 | 황동 플랜지 | 1 | `159_floor_nut_T8` |
| 170 | 격리 문 하우징 / 문 판 / 서보 기둥 ×2 | 설계 | 3D 프린트 | 4 | `170_isolation_gate_housing·flap·post1·post2` |
| 170 | 격리 문 서보 MG90S (+ 혼·축) | 구매 | | 1 | `170_isolation_gate_servo_MG90S·horn·spline` |
| 172 | 격리 통로 (위 포획통으로) | 설계 | 3D 프린트 | 1 | `172_isolation_duct` |
| 173 | 격리 깔때기 | 설계 | 3D 프린트 | 1 | `173_isolation_funnel` |
| 174 | 방생 목 (30 mm) | 설계 | 3D 프린트 — 굴뚝과 한 덩어리 | 1 | `174_release_neck` |
| 175 | 방생 굴뚝 (위로 날아 나감) | 설계 | 3D 프린트 | 1 | `175_release_shaft` |
| 176 | 방생 문 하우징 / 문 판 / 서보 기둥 ×2 | 설계 | 3D 프린트 | 4 | `176_release_gate_housing·flap·post1·post2` |
| 176 | 방생 문 서보 MG90S (+ 혼·축) | 구매 | | 1 | `176_release_gate_servo_MG90S·horn·spline` |
| 180 | AI 카메라 | 구매 | Raspberry Pi AI Camera | 1 | `180_camera` |
| 181 | 카메라 받침 | 설계 | 3D 프린트 | 1 | `181_camera_bracket` |
| 182 | 조명 링 | 구매 | | 1 | `182_light_ring` |
| 190r | 라즈베리 파이 5 (+ AI HAT 자리) | 구매 | 공식 STEP | 1 | `190r_raspberry_pi5` |
| 191 · 192 | 아두이노 UNO 1 (구동) · UNO 2 (문·게이트) | 구매 | A000066 공식 STEP | 2 | `191_arduino_uno`, `192_arduino_uno2` |
| 193h | 와고 받침 (5칸) | 설계 | 3D 프린트, 데크에 M3 × 3 + 너트 | 1 | `193h_wago_holder` |
| 193w | 와고 레버 커넥터 221-415 (GND 3 + +5 V 2) | 구매 | 29.9 × 18.6 × 8.3 | 5 | `193w_wago_221-415`, `193w_wago_levers` |
| 193s | 볼트 M3 × 10 (와고 받침) | 구매 | McMaster 91292A113 + 너트 | 3 | `193s_bolt_M3x10_wago` |
| 193v | 서보 허브 기판 | 구매 | 만능기판 4 × 6 cm | 1 | `193v_servo_hub` |
| 193g | 게이트 허브 기판 (풀업 10 kΩ × 9) | 구매 | 만능기판 3 × 7 cm | 1 | `193g_gate_hub` |
| 193j | J_I2C 4핀 커넥터 (배터리 상자 INA226) | 구매 | JST XH B4B-XH-A | 1 | `193j_J_I2C_JST_XH_4P` |
| 194 | 비상 정지 버튼 (22 mm 버섯형 NC) | 구매 | XB7NS8442류 | 1 | `194_estop` |
| 194b | 비상 정지·퓨즈 판 | 설계 | 3D 프린트 4 mm, 레일에 M5 × 2 | 1 | `194b_estop_plate` |
| 194f | 패널 퓨즈 홀더 5 × 20 (3 A) | 구매 | F-520류 | 1 | `194f_panel_fuse_holder_5x20` |
| 194j | 패널 DC 잭 5.5 × 2.1 (구동 레일 +5V_B 입력, 배터리 상자도 같은 플러그) **(11/09 서현 추가)** | 구매 | DC-099류, 판 구멍 Ø8 — 194b를 −y로 22 mm 늘림, (−184, −35, 225) [치수 가능성 높음, 실물 재기] | 1 | `194j_dc_jack_panel_5.5x2.1` |
| 195p | 모터 드라이버 ULN2003 보드 (X·Y·F) | 구매 | 35 × 31.9 | 3 | `195p_uln2003_X·Y·F` |
| 196 | 문 빛 게이트 (3 mm IR LED + 수광, G2·G2b·G3·G3b·G5·G5b) | 구매 | 940 nm | 6쌍 | `196_gate_G*_ir_pair` |
| 196 | 빛 게이트 G4 (격리 통로) · G6 (방생 목) | 구매 | Adafruit 2167 | 2쌍 | `196_gate_G4_tx_rx`, `196_gate_G6_tx_rx` |
| 196m | MOSFET 모듈 SZH-AT021 | 구매 | 66.8 × 66.8 (구멍 미검증) | 1 | `196m_mosfet_module_SZH-AT021` |
| 197 | ULN 보드 받침 (X·Y) | 설계 | 3D 프린트, 레일에 M5 × 2 | 2 | `197_uln_bracket_X·Y` |
| 198 | ULN 기둥 M2.5 × 5 | 구매 | | 12 | `198_uln_standoff_X·Y·F` |
| 198h | 허브 기판 기둥 M2 × 8 | 구매 | | 8 | `198h_hub_standoff_*` |
| 198m | MOSFET 기둥 M3 × 6 | 구매 | | 4 | `198m_mosfet_standoff` |
| 198p | Pi 기둥 M2.5 × 5 | 구매 | | 4 | `198p_pi_standoff` |
| 198u | UNO 기둥 M3 (5 / 15 mm) | 구매 | | 6 | `198u_uno_standoff` |
| 198x | HX711 모듈 (녹색, 로드셀 증폭) **(11/09 서현 추가)** | 구매 | 34 × 21 × 1.6, 4핀 → UNO 1 A1·A2 / 6핀 → 로드셀 148 — 가운데 (−44.5, 54) [치수 가능성 높음] | 1 | `198x_hx711_module` |
| 198xc · 198xs | HX711 받침 + M3 × 8 접시머리 2 (데크 탭) **(11/09)** | 설계 + 구매 | 3D 프린트 (바닥 3 · 레일 1.5 · 턱 2) | 1 + 2 | `198xc_hx711_cradle`, `198xs_hx711_screws` |
| 199a | Pi 선반 | 설계 | 3D 프린트, 위 가로대에 M5 × 2 | 1 | `199a_pi_shelf` |
| 199b · 199c | G4 · G6 게이트 받침 | 설계 | 3D 프린트 | 2 + 2 | `199b_gate_holder_G4`, `199c_gate_holder_G6` |
| 201 | 마커 (샤피 노랑) | 구매 | | 1 | `201_marker` |
| 202 | 마커 홀더 V블록 | 설계 | 3D 프린트 | 1 | `202_marker_holder_vblock` |
| 203 | 마커 조임 띠 | 설계 | 3D 프린트 | 1 | `203_clamp_strap` |
| 205 | 펜 들기 서보 SG90 (+ 혼·축) | 구매 | | 1 | `205_z_servo_SG90`, `205h_…`, `205s_…` |
| 206 | Y 캐리지 (마커 이송) | 설계 | 3D 프린트 | 1 | `206_y_carriage` |
| 207 | Y 봉 Ø6 × 124 | 구매 | 연마봉 | 2 | `207_y_rods` |
| 208 | Y 리드스크루 T8 | 구매 | 133 mm | 1 | `208_y_lead_screw_T8` |
| 209 | Y 모터 28BYJ-48 (+ 축) | 구매 | | 1 | `209_y_stepper_28BYJ48`, `209r_…` |
| 210 | Y 커플링 5 → 8 | 구매 | | 1 | `210_y_coupling` |
| 211 | Y 모터 브래킷 | 설계 | 3D 프린트 | 1 | `211_y_motor_bracket` |
| 212 | X 빔 끝 블록 (Y 봉 잡음) | 설계 | 3D 프린트 | 2 | `212_beam_end_blocks` |
| 213 | X 봉 Ø8 × 163 | 구매 | 연마봉 | 2 | `213_x_rods` |
| 214 | X 리드스크루 T8 | 구매 | 93 mm | 1 | `214_x_lead_screw_T8` |
| 215 | X 모터 28BYJ-48 (+ 축) | 구매 | | 1 | `215_x_stepper_28BYJ48`, `215r_…` |
| 216 | X 커플링 5 → 8 | 구매 | | 1 | `216_x_coupling` |
| 217 | X 모터판 | 설계 | 3D 프린트, 레일 아랫면에 M5 × 2 | 1 | `217_x_motor_plate` |
| 218 | X 봉 받침 | 설계 | 3D 프린트, 레일에 M5 (한쪽은 귀) | 4 | `218_rod_supports` |
| 219 | 마커 뚜껑 컵 | 설계 | 3D 프린트 | 1 | `219_cap_cup` |
| 220 | 컵 받침 | 설계 | 3D 프린트 | 1 | `220_cup_bracket` |
| 221 | 직선 볼 부싱 LM6UU (Y) | 구매 | | 2 | `221_y_bearings_LM6UU` |
| 222 | 직선 볼 부싱 LM8UU (X) | 구매 | | 2 | `222_x_bearings_LM8UU` |
| 223 | 홀더 안내 핀 Ø3 | 구매 | Ø3 × 69, PTFE 테이프 | 2 | `223_holder_guide_pins` |
| 224 · 225 | T8 너트 (Y · X) | 구매 | 황동 플랜지 | 2 | `224_y_nut_T8`, `225_x_nut_T8` |
| 226 · 226s | X 원점 스위치 집게 + 팔 (X 봉 −y에 끼움) + M3 × 16 조임 나사·너트 **(11/09 서현 추가)** | 설계 + 구매 | 3D 프린트 | 1 + 1 | `226_x_home_clamp`, `226s_clamp_screw` |
| 227f · 227x · 227y | 원점 스위치 KW11-3Z (바닥 F · X · Y) + M2 × 12 셀프 탭 2개씩 **(11/09 서현 추가)** | 구매 | 레버형 20 × 6.4 × 10.2, 구멍 Ø2.3 간격 9.5 [가능성 높음] → UNO 1 A3·A4·A5 | 3 + 6 | `227f_home_switch_F`, `227x_…`, `227y_…`, `227*s_switch_screws_*` |
| REF | 상용 말벌 트랩 (산 것, 고치지 않음) · 말벌 크기 · 마킹 점 자리 | 참고 | | — | `REF_trap_*`, `REF_hornet`, `REF_mark_dot` |
