britams/-capstone-project-repo/docs/2026-11-08_VSCode_전체작업_명령_서현.md

# VS Code에서 모든 작업 — 명령 정리 (11/08부터)

정리: 2026-11-08 · 이서현 (웹 채팅 Claude 마지막 정리, **CAP-AI-46**)
결정 (서현 11/08 18:36): **이제 모든 작업은 서현 PC VS Code Claude에서 한다.** 웹 채팅은 쓰지 않는다.
- 그래서 '제어 규칙은 웹 채팅, 코드는 VS Code' 나눔(CAP-AI-42·43)은 끝났다.
- **규칙 정하기·코드·CAD·검토를 모두 VS Code Claude가 한다.**

## 1. 새 대화를 열 때 붙여 넣을 첫 메시지 (11/08 밤 갱신, CAP-AI-53)
**한 대화에는 한 가지만.** 아래에서 이번에 할 것 하나를 골라 붙인다. 대화가 길어지면 새로 열고 같은 것을 다시 붙인다.

### 1-A. CAD 대화 (다음에 할 것)
```
나는 이서현이야. 이번 대화는 CAD만 해. CLAUDE.md 대로 시작해: git pull → docs/00_새채팅_인수인계_*.md → docs/2026-11-08_VSCode_전체작업_명령_서현.md → docs/2026-11-08_CAD_D5g_정리_작업지시_서현.md → 내 AI 로그 마지막 항목 → design/인터페이스_정의서.md → cad/README.md.
명령 정리 문서 3-A 순서대로 진행해 (CAD C1~C6 + 펌웨어·회로 쪽이 CAD에 넘긴 확인 4가지).
FreeCAD는 freecadcmd로 스크립트를 돌려 (RPC execute_code는 90 s에 끊김). 기구 치수를 바꾸거나 되돌릴 수 없는 일은 먼저 물어봐.
```

### 1-B. 펌웨어·제어·전기회로 대화
```
나는 이서현이야. 이번 대화는 펌웨어·제어·전기회로만 해 (CAD는 안 함). CLAUDE.md 대로 시작해: git pull → docs/00_새채팅_인수인계_*.md → docs/2026-11-08_VSCode_전체작업_명령_서현.md → 내 AI 로그 마지막 항목(CAP-AI-52 근처) → design/인터페이스_정의서.md → 전기회로/README.md → 관련코딩저장/README.md.
그다음 "어디까지 됐고, 이번에 무엇부터 할지, 정할 것"을 짧게 말하고 명령 정리 문서 3-B 순서대로 진행해.
제어 규칙도 너가 정해 (AI 판단, 서현 위임으로 기록). 승준 control/ 파일은 고치지 말고 필요하면 Issue. 부품 주문은 CAD가 끝난 뒤.
```

## 2. 지금 상태 (11/08 밤, CAP-AI-52까지)
| 분야 | 상태 | 어디 |
|---|---|---|
| 회로 | 설계 끝: 회로도 4장(11/08 다시 그림, D_RP·카메라 FFC 500 mm), 넷 64 검사 통과, 허브 기판 2장 배치(넷 대조 통과), 역극성 보호 SB540, 하네스, 배터리 상자 | `전기회로/README.md`(지도·순서 E1~E10), `전기회로/전기회로_설계_쉬운설명.html`, `design/circuit/` |
| 카메라 | 1대 (IMX500 보유), 격자 위 200 mm, Pi 5 CAM0 ↔ FFC 500 mm | HTML 8-1장 |
| 펌웨어 | trap_motion·trap_doors v0.2, R1′, 시뮬 84/84·77/77 | `design/circuit/firmware/`, `관련코딩저장/sim/` |
| Pi 코드 | pi_link 36/36, 처리 순서 process.py 52/52 (C1~C5: 여왕 판정, 흉부 좌표, 승준 mark_planner로 찍을 점, 밤 처리 안 함·기다리다 해 지면 밤) | `관련코딩저장/pi_link/`, 비전 형식 `vision_format.py` |
| 인터페이스 정의서 | v0.2 통신 줄, '비전 → 제어 결과' 줄 (11/08) | `design/인터페이스_정의서.md` |
| CAD | D5g 스크립트만 있음 (FCStd·전체 조립도 없음) | `cad/D5g_*.py`, `docs/2026-11-08_CAD_D5g_정리_작업지시_서현.md` |
| 부품 | 주문 안 함 — **CAD가 끝난 뒤** (서현 11/08) | `design/2026-11-06_전기부품_구매확정표_서현.md` |

## 3. 할 일
### 3-A. CAD 대화
| # | 할 일 | 메모 |
|---|---|---|
| 1 | ✅ 11/09 (CAP-AI-55) **CAD C1~C6** (작업 지시 문서 그대로) | 렌더는 정투영, 프레임·상용 트랩 같이 |
| 2 | ✅ 11/09 원점 스위치 3개 CAD에 넣음 → 대기 X +10 · Y −40 그대로. **펜 대기 자리 X (A2)**: 캡 컵 219와 X 원점 스위치 자리를 재서 X 값 정함 | 지금 Pi 코드 대기 자리 X 10 · Y −40 (`관련코딩저장/pi_link/controller.py` Config.park) |
| 3 | ✅ 11/09 가림 0. **카메라 시야 가림**: 격자 위 200 mm 카메라 → 마킹실 40 × 40 시선에 X·Y 몸체·펜이 오는지 | 펜은 쉴 때 Y −40 캡 컵 |
| 4 | ✅ 11/09 서현: 투명 아크릴 1.5. **투명 격자** 쓸지 (지금 격자 열린 면적 36.5 %라 말벌이 점박이로 보임) | `design/2026-11-02_VespAI_점검_서현.md` |
| 5 | ✅ 11/09 HX711 (−44.5, 54)·DC 잭 (−184, −35, 225) → 3-B 3 다시. **허브 기판·전장품 자리** 확인: 게이트 허브 70 × 30, 서보 허브 60 × 40, J_I2C, HX711·DC 잭 | 바뀌면 3-B 3번 |
| 6 | ✅ 11/09 CAD 검토 — 그림 한 장씩, 겹침 0, 검사 스크립트 | |
| 7 | ✅ 11/09 (Issue 댓글은 Chrome으로) **Issue #9 1·2·7·8 답** (CM3 사기, 28BYJ 귀 M3, 스페이서·탭, MOSFET 자리) + 193j J_I2C를 게이트 허브 (61.67, 16.27) 가로로 (펌웨어 대화 CAP-AI-54가 넘김) | 서보 허브 레일 부품·전원 전선 자리 바뀜 → CAD 다시 만들어 겹침 확인 |

### 3-B. 펌웨어·제어·전기회로 대화
| # | 할 일 | 메모 |
|---|---|---|
| 1 | ✅ 11/09 (CAP-AI-54) `light_test.py` + `design/2026-11-09_조명시험_계획_서현.md` — CM3가 와야 찍음. **조명 필요한지 시험 준비**: J3(카메라 200 mm) 때 조명 켬/끔 사진으로 밝기 고름·점 검출률 비교하는 스크립트·통과 기준 | 서현 "조명 필요 없잖아" (11/08) → 위 링은 필요할 가능성 높음, 아래는 뺄 수도 [추측]. 결과 보고 빼면 Q1·Q2·D3·D5·LIGHT 명령 정리. 이 PC에 cv2 없음 (`pip install opencv-python` 물어보고) |
| 2 | ✅ 11/09 `design/2026-11-09_미검증값_맞추는순서_서현.md` V1~V17. **'미검증' 값 맞추는 순서 문서**: 문 각도·닫는 속도·펜 위아래·빔 문턱 등 하나마다 재는 법·명령(SETDOOR·SPEED)·통과 기준 | 브레드보드 단계별 문서 뒤에 |
| 3 | ✅ 11/09 CM3 자리(z 540) 반영, 허브 기판 Issue #9 고침 (몸통 검사) — CAD가 또 바꾸면 다시. (CAD가 자리를 바꾸면) `harness.py` P_EXTRA·`elec_budget.py` 고치고 다시 돌림, 허브 기판 크기 바뀌면 `전기회로/hub_boards.py` 다시 | `circuit.py`·`battery_box.py` 검사 통과 확인 |
| 4 | **CAD가 끝나면 1차 부품 주문 E1** — SB540 사양서 확인, FFC 500 mm(E18), 만능기판 2장 포함 | MG90S 배송 3주 |
| 5 | 부품이 오면: E2~E8 (브레드보드 → 펌웨어 업로드 → 미검증 값) | `전기회로/README.md` 2장 |
| 6 | ✅ 11/09 **Issue #10** 올림 — 승준 답 오면 반영. 승준 확인할 것 (Issue로): 비전이 thorax·unc 형식으로 주는지, 카메라 방향(rot_deg), J3 여왕벌 폭 실측, 펌웨어·pi_link를 control/과 합칠지 | |
## 4. 규칙 (CLAUDE.md에 없는 것 / 이번에 정한 것)
- **코드 폴더는 지금 그대로**: 펌웨어 `design/circuit/firmware/`, 시뮬·pi_link `관련코딩저장/`. 새 폴더를 더 만들지 않는다. `design/circuit/bringup/`은 회로 시험용으로 그대로 둔다.
- **AI 로그 번호**: 쓰기 직전에 `ai-log/AI_명령사항_로그.md` 마지막 번호 + 1 (지금 마지막 CAP-AI-53).
- **커밋**: `[서현] …`. Claude가 직접 commit·push한다. 서현이 VS Code 버튼으로 커밋할 때는 Commit ▼ → **Commit & Push**, 메시지는 `[서현]`으로.
- **받기**: 대화를 시작할 때 `git pull`. 승준이 다시 올리기 전까지는 충돌이 거의 없다.
- **PC 사본**: `Desktop\capstone design\repo\`(문서에 적힌 `capstone design_이서현`은 없음)는 git 레포가 아니다. 바뀐 파일을 복사해 맞춘다 (레포가 원본). 제어·회로 문서는 `제어\`에 번호를 붙여 복사하고, `00_읽는순서.md`에 줄을 더한다 (지금 21번까지).
- **사용량**: 90 %면 저장·push부터 한다. 96 %면 남은 일을 순서대로 로그에 적는다.
- **결정 기록**: 서현이 맡긴 결정은 '(AI 판단, 서현 위임)'. 확실도 [확실]/[가능성 높음]/[추측].
