britams/-capstone-project-repo/docs/00_새채팅_인수인계_2026-11-07.md

# 창의적종합설계(캡스톤) 인수인계 — 2026-11-07 기준 (10/28판에서 이어 씀)

작성: 이서현 (Claude와 정리) · **인수인계는 이 파일 하나만 유지** — 10/22판의 남길 내용은 여기에 합쳤고, 이전 버전은 Git 기록으로 본다
**공유 문서 원본: GitHub 레포** https://github.com/britams/-capstone-project-repo (사용법 `docs/GitHub_사용법_Chrome.md`)
대용량·참고 자료(논문, 발표 PPT, 사진, FreeCAD 작업): 서현 PC `C:\Users\Seohyun_Lee\Desktop\capstone design_이서현` — 그 안의 `repo\`가 레포와 같은 구조의 사본
AI 작업 기록: `ai-log/AI_명령사항_로그.md`(서현), `ai-log/AI_명령사항_로그_승준.md`(승준) ← 각 파일 마지막 항목이 최근 작업
분업: `docs/2026-10-28_분업계획_서현_승준.md`

---

## 1. 지금 상태 한눈에

- **설계를 처음부터 다시 한다.** 10/26 발표 설계(1안 챔버+XY, A안 터널형, B안 제네바, 600번대 유인·진입부)는 발표용으로 급히 만든 것이라 쓰지 않는다 (서현, 10/28).
- **구조 방향 확정: 상용 트랩 「야생 말벌 포획기」에 얹는 추가 모듈(레트로핏)** (10/28)
- ⚠ **[확실] 등검은말벌은 생태계교란 생물(2019-07-26 지정)** — 허가 없이 방사·보관·운반 금지. 마킹 후 방생(조사 모드)은 유역환경청 학술연구 허가 필요 [가능성 높음] → `design/2026-10-28_D1_동작순서와_요구사항.md` 7장
- **운용 모드 2개**: 방제 모드(구별 없이 전부 가둠) / 조사 모드(아래 동작 순서, 허가 기관용). **판매 대상은 공공기관**(서현 판단)
- **동작 순서 확정**: 트랩으로 잡음 → 개체 확인 → 여왕벌 가둠 → 일벌은 마킹 후 먹이 주고 방생 → 재포획 시 로그 + 먹이 + 방생. 마커는 수성 아크릴, 한 색 (`design/2026-10-28_D1_동작순서와_요구사항.md`)
- **개발 원칙: 대량 처리보다 한 마리를 목적대로 제대로** (서현 10/28)
- 설계 진행: D0 → D1·D2·D3 확정(안 1 바닥 승강형) → D5 4차(마커 XYZ, 카메라 200 mm) → **D5 4차 보완 + D6 설계 변수표 + S4 역학계산 1차 = 현재 기준** (10/28 밤): `design/2026-10-28_D6_설계변수표.md`, `design/2026-10-28_S4_역학계산_1차.md`, `design/2026-10-28_D5_개념설계_안1.md` 11장, `cad/D5d_*`. 결과: 모터는 28BYJ-48 유지(토크 안전율 19.6 이상), **X·Y는 볼 부싱 LM8UU·LM6UU**(한쪽 구동 끼임), **찍는 힘은 자중 0.32 N + 스프링(수동값, 하중 센서로 못 잼)**, **R6 3분은 잉크 건조 시간이 지배 — 급이 ≤ 약 105 s여야 함**. 마커 = **샤피 크리에이티브 노랑**(서현 10/28). S4는 AI값만 — **④ 수기 풀이는 서현 몫**. **S4 r2 (CAP-AI-19)**: ③ 유제 7개 확정(Riley 9-66·6-49·6-41·9-43, Meriam 3/1·3/2, Gere 9.3-1)·해설집 대조(`design/calc/s4_textbook_check.py`, 0.5 % 이내), M5 끼임을 요 + 피치 연립으로 고침(청동 부싱도 끼임, LM8UU 여유 13.6배), 무게중심은 FreeCAD에서 읽음. 교재·해설집 PDF는 서현 PC `Documents\공주대\`(레포에 안 올림). 다음: 샤피 노랑 점 시험(건조·최소 힘), 28BYJ-48 rpm + 부하 토크(J6), 수기 풀이
- **11/01 (CAP-AI-20, 진행 중)**: D5d 이음부 결함(문판 회전 간섭, 펜 들기 부족, 마커-레일 겹침, 너트 없음 등) → **D5e 움직이는 모델** `cad/D5e_module_kinematic.py`·`.FCStd` (스프레드시트 `Joints` 값 바꾸면 움직임), 이음부 86개·간섭 검사 통과 `cad/D5e_check.py`, 동영상 `cad/D5e_동작_한마리처리.mp4`. 프로파일 = 정방형 2020(20시리즈). 교재 유제 자유물체도 T1~T7 jpg(`design/img/fbd/`, 그림 확인 완료). **이어서 할 일 순서는 서현 로그 CAP-AI-20 '남은 일' 1~7번** (자유물체도 확인 → s4_calc D5e로·M3/M4 재계산 → M1~M6 그림 → 유제 정리 md → 문서 갱신)
- **11/02 15:00 발표 (역학계산 필수)**: 슬라이드 원고 `docs/2026-11-02_발표_역학계산_슬라이드원고.md` (S1~S21, 10문제, 동역학 M2·M7·M8·M9·M10 먼저, 예상 질문 S21). 쉬운 설명 `design/2026-11-02_S4_역학계산_쉬운설명.md`(+docx, Claude 문서 원본 있음). 승준 D5e 재계산 CAP-AI-SJ-29, 동역학·전체 조립 CAP-AI-21
- **11/02 결정 (AI 판단, 서현 위임)**: 스프링 204 뺌, 펜 홀더 핀 PTFE 테이프(D5f에서 핀 옮김), 펜 내리기 2단계(마지막 2 mm ≤ 60 °/s), 문은 빛 게이트 확인 뒤 닫기, 급이 유지 → D6 10장·인터페이스 정의서 4차 값
- **CAD 기록은 `cad/README.md`에 시간순** (10/02 초기 스케치 → D5 → D5b → D5c → D5d → D5e → D5e 전체 조립). 지금 기준 그림 `cad/D5e_전체조립도.png`
- **서현 작업 원칙(세션 지시 모음)은 `CLAUDE.md` '서현 작업 원칙'** — push·PC 동기화·사용량 90/96 %·CAD 그림 갱신·프레임과 트랩 포함·해설집 대조·자유물체도 jpg·동역학 중시
- 서현 PC 정리 폴더: `capstone design_이서현\CAD files\`(FCStd + jpg), `capstone design_이서현\역학계산\`(문서·자유물체도·계산 코드, `00_읽는순서.md`)
- **11/02 새벽 추가**: VespAI 점검(원인은 장면 차이, **격자판 가림 36.5 % → 투명 격자 권장**) `design/2026-11-02_VespAI_점검_서현.md` + 서현 PC `VespAI_시험` 키트 / **제어 통합 정리** `design/2026-11-02_제어_통합정리_D5e.md` (Pi 5 + UNO 2, 빛 게이트 6, 카메라 1, 문틈 규칙) + 서현 PC `제어` 폴더
- **11/02 아침 (CAP-AI-22, 서현 위임 혼자)**: **전기 계통·제어 순서** `design/2026-11-02_전기계통_제어순서_서현.md` + `design/control_sim/`(전기 계산, Pi 상태 머신 참고 구현 + 시나리오 17개 통과, 그림 4장). 핵심: 켤 때 서보 4개 동시 3.2 A → 하나씩, 퓨즈 T2.5A, `HOLD F 0`, Pi를 위판 아래로(CSI 300 mm), 게이트 자가 시험, 문마다 빔 2개(D5f), 하루 68 Wh → 현장 콘센트. 펌웨어 제안은 승준에게 Issue #5. **09:25 서현 결정**: Pi 위판 아래, 문마다 빔 2개(9쌍) + 실리콘 립, 분류는 등검은말벌·유럽말벌 2종만(유럽말벌 처리는 확인 대기), 콘센트 기본 + 배터리 상자(LiFePO4 12 Ah ≈ 1.7일). 시나리오 19개 통과
- **11/06 (CAP-AI-23)**: 회로 설계 `design/2026-11-06_회로설계_서현.md`(회로도 3장, 넷리스트·BOM, `design/circuit/circuit.py` 검사 통과), 알고리즘·판단 `design/2026-11-06_제어알고리즘_판단_서현.md`(흐름도 3장), 쉬운 요약 `docs/2026-11-06_오늘한일_쉬운요약_서현.md`. 승준 AI와 분담 Issue #6. 서현 결정 4개 → 17:05 답 (CAP-AI-24): 유럽말벌·다른 곤충 격리, 여왕벌 = 중순판 폭 ≥ 4.4 mm, 배터리 2일 = 20 Ah, 스프링 146 = 0.1 N/mm (`design/2026-11-06_S4_스프링146_역학계산_서현.md`). 2차 (CAP-AI-25): 교재 유제 5개 52/52, 스프링 → d 0.229·D 2.63·Na 15·Ø2 핀(k 103.6), 밀대 안내 LM4UU 제안, 여왕벌 재는 법 `design/2026-11-06_여왕벌_크기측정_방법_서현.md`. ★ 서현 결정 3개(LM4UU, 스프링 기본/차선, 못 잴 때 규칙). **11/06 18:38~ (CAP-AI-27·28)**: 서현 결정 = 스프링 기성품만(`spring146_catalog_check.py`), 계절 규칙, 바닥 안내 LM4UU + Ø4 경화 축(D5f, 겹침 0). **서현 쪽은 CAD를 멈추고 회로도·전기 준비로**. 기구·구매·펌웨어·비전은 승준 쪽이 이어 받음 → `docs/2026-11-06_승준_작업지시.md`. **제어·회로는 서현이 AI에 전부 위임 (11/06 18:55)** → 새 채팅은 `docs/2026-11-06_새채팅_제어부설계_시작명령.md`로 시작. 쉬운 설명 `design/2026-11-06_회로_쉬운설명_서현.md`, 부품 `design/2026-11-06_제어회로_부품_보유와_구매_서현.md` (HX711·빛 게이트는 살 것으로 고침)
- **11/06 밤 ~ 11/07 (CAP-AI-33~39, 제어·회로 서현 위임)**: 브레드보드 단계별 시험 + 시험 스케치 `design/circuit/bringup/`, 문 빔 6쌍 낱개 IR LED + 포토TR(아날로그 A0~A5, 승준 SJ-47), 배터리 상자 회로 `design/2026-11-06_배터리상자_회로_서현.md`(INA226 R010), 인터페이스 정의서 5차, 펌웨어 변경 요청 `design/2026-11-06_펌웨어_변경요청_서현.md` + Issue #8, **하네스 D5g 자리로 확정** (43묶음 45.1 m, 카메라 FFC 500 mm). 승준 D5g 상세설계 완료(SJ-49) + 전체 요약 PDF `design/2026-11-07_내가 뭐한거지？？？_승준.pdf`(SJ-50). **승준은 서현이 말할 때까지 작업 안 함 (11/07).** 다음: 서현 PC VS Code + Claude Code로 실제 펌웨어·Pi 코드 → `docs/2026-11-07_VSCode_ClaudeCode_시작정리_서현.md` (새 코드는 `design/circuit/firmware/`, control/는 안 고침)
- **11/08 (CAP-AI-40~46): 이제 모든 작업은 서현 PC VS Code Claude에서** (웹 채팅 안 씀). 펌웨어 v0.2(`design/circuit/firmware/`) 컴파일·시뮬 통과, pi_link 36/36(`관련코딩저장/`), 제어 규칙 검토 `design/2026-11-08_펌웨어v0.2_제어규칙_검토_서현.md`, D5g CAD 서현 인수(작업 지시 `docs/2026-11-08_CAD_D5g_정리_작업지시_서현.md`). **새 대화 첫 메시지와 할 일 순서: `docs/2026-11-08_VSCode_전체작업_명령_서현.md`**
- 환경 요소(비·바람)는 다루지 않음, 시스템 설계·제어만 (서현 10/28)
- 승준 병렬 작업: `docs/2026-10-28_승준_작업지시.md` (J1 VespAI 실행 ~ J7 BOM)
- 보유 물품과 활용: `inventory/2026-10-28_보유물품_목록과_활용계획.md` (사진 원본은 서현 PC `지금가지고 있는 물품\`)
- 공유: GitHub 레포, 사람은 Chrome으로만 사용 (설치 없음). 승준은 Git 처음 → `docs/GitHub_사용법_Chrome.md`
- 표본: **확보 방법 없음** (10/28) → 보유 상용 트랩으로 채집 또는 최문보 교수님·양봉농가에 요청. 11월이 지나면 봄까지 구하기 어려움

| 할 일 | 주 담당 | 상태 (10/28 밤) |
|---|---|---|
| ① 설계 및 역학계산 (FreeCAD, S4 양식) | 서현 | D0~D3 확정, D5 4차 보완, D6 변수표, S4 1차 r2(AI값 + 교재·해설집 대조) 완료 → 수기 풀이·시험 |
| ② VespAI 오픈소스 받아 실행 | 승준 | J1 완료(16/21 일치, 0.053 s/장), J4 노랑 점 검출 합성 시험 96 %, J6 펌웨어(시뮬레이션) → 실물 시험 |
| ③ 필요한 물품 구매 (재료비 지원 50만 원) | 승준 | 86,240원 집행(트랩·Pi 전원·쿨러), 마커 주문, 기구 부품은 D6 뒤 — 정산 규칙 `purchase/2026-10-28_재료비_정산규칙.md` |

## 2. 10/28에 확정된 것
| 항목 | 결정 |
|---|---|
| 설치 방식 | 평평한 바닥에 놓음 |
| 참고 제품 | 「야생 말벌 포획기」((주)야생, 26×26×40 cm, 특허 2건) — 실물 보유 |
| 역학계산 형식 | 시스템설계및제어 S4 양식 (4-1 외력 → 4-2 가상 절단 → 4-3 자유물체도·유제 연계·수기 풀이·AI 대조 2%) |
| CAD | FreeCAD |
| 3D 프린터 | 충남앵커공유대학 Craft-Lab (천안공과대학 기초융합실습관 211호), 문의하면 사용 가능 — 담당자 연락처는 서현 PC `3d프린터 사용\` (공개 레포라 번호는 안 적음) |
| 레포 | 공개(Public)로 운영 (서현 10/28) |
| 분업 | 서현 = 기구 설계·역학계산·문서 / 승준 = VespAI·비전·전자·구매·재료비 정산 (승준 동의 SJ-03) |

## 3. 아직 정하지 않은 것 (설계 시작에 필요)
1. 조사 모드의 다른 종 처리: 입구 크기 1차 거름(장수말벌 대부분) + 카메라 2차 판별 안 — 서현 확인 (D1 6장)
2. 방제 모드에서도 촬영·분류 로그를 남길지 (D1 5장)
2-1. 생물다양성법 현행 조문·허가 절차 확인, 2027년 실물 시험 허가 신청 시기 (D1 7장)
3. 여왕벌 판별을 카메라(흉부 폭)로 할 수 있는지 — 카메라가 200 mm로 멀어져 어려워짐 [가능성 높음] (J5 보류, J3 결과로 다시 판단)
4. 표본 확보 경로 — **이번 주가 마지막 기회** (보유 트랩 설치 / 최문보 교수님 / 양봉농가)
5. 상용 트랩 특허 청구항 확인, 모듈 결합부 실측
6. 제작 대수 (1대 + 예비 권고 / 2대) — 서현 결정 대기
6-1. 원점 스위치 1안(마이크로 스위치 3개 → Pi GPIO) 확인 (D6 9장)
6-2. Issue #1·#2·#3 닫기 (Chrome에서)
7. 회의 일정, 다음 보고일 (11/9 가정)
8. 과제명 '형광분말' 문구 수정 (지도교수님 확인)

## 4. 배경 — 바뀌지 않은 사실
- 팀 초벌: 이서현(팀장)·이승준. 지도교수 김성관 교수님(로보틱스 요소 필수, 시스템설계및제어 수업도 담당 → 같은 절차·양식). 자문 최문보 교수님(경북대).
- 재료비 지원 50만 원 (해외구매·중고 불가, 공구 불인정, 11/30 정산 서류 — 승준 정리), 기한 2027년 여름, 살아 있는 말벌 시험은 2027년 7~8월 (그 전엔 표본·더미).
- 차별점: 마킹을 사람 없이 기계가 한다.
- 방향 변천: 9/16 형광분말 자가마킹 + 비행 방향 → 10/2 피스톤 + 패드 + 왕복 시간 → 10/8 최문보 교수님 2차 답변으로 비행 방향·거리 추정 삭제 → 10/11 수성 아크릴 마커, 여왕벌 격리 → 10/26 발표안(폐기) → 10/28 재설계.
- 설계 입력값(문헌, 유럽 개체군): 흉부 폭 일벌 3.79–4.49 / 신여왕벌 4.61–4.87 mm (경계 4.5), 몸길이 일벌 약 20 mm·여왕벌 최대 약 30 mm, 시판 선택 트랩 입구 8–9 mm, 둥지는 먹이터에서 수백 m. 자세한 것은 `나중 보고서를 위한 정리\2026-10-11_조사_활동반경_크기_생활사.md`.

## 5. VespAI — 확인한 것 (할 일 ②, 승준 담당)
- 자세한 내용: `vision/2026-10-28_VespAI_저장소_확인과_실행계획.md` (승준, CAP-AI-SJ-02)
- 원본 저장소: **`andrw3000/vespai`** (2026-09-15까지 갱신). `hiveeyes/vespai`는 2024-10-12에 멈춘 사본
- 모델: YOLOv5s **박스 검출**(Detect), 클래스 2개(유럽말벌 V. crabro, 등검은말벌 V. velutina). 장수말벌·좀말벌·꿀벌 클래스 없음 → 조사 모드 2차 판별에는 한국 종 재학습 필요 → **표본이 비전 데이터로도 필요**
- 라이선스 CC BY-NC-SA 4.0(비영리) + AGPL-3.0 → 캡스톤 시제품은 문제없음, 공공기관 판매 땐 그대로 못 씀 (자체 학습 모델 필요)
- 실행: 작업 환경에선 가중치 로드가 막혀 승준 PC에서 1단계(예시 이미지) 진행 예정 → Pi 5 CPU → 필요하면 AI HAT+
- 논문: O'Shea-Wheller 외 2024, *Commun. Biol.* — https://www.nature.com/articles/s42003-024-05979-z
- 보유: Pi 5 + AI HAT+ (Hailo 26 TOPS) + AI 카메라 (IMX500)

## 6. 폴더 지도

### GitHub 레포 (공유 문서 원본)
| 폴더 | 내용 | 담당 |
|---|---|---|
| `docs/` | 시작키, 인수인계, 분업계획, GitHub 사용법 | 서현 |
| `ai-log/` | AI 로그 (서현·승준 각자) | 각자 |
| `design/` | D0 재설계 문서, 인터페이스 정의서 (이후 D1~D6, 변수표, 역학계산) | 서현 (인터페이스는 공동) |
| `cad/` | FreeCAD 생성 스크립트·모델·도면 | 서현 |
| `vision/`, `control/`, `purchase/` | VespAI·표식 검출 / 아두이노 / BOM·예산 | 승준 |
| `inventory/` | 보유 물품 활용계획 | 서현 → 승준 |

### 서현 PC `capstone design_이서현` (원본 자료 보관, 레포에 안 올림)
| 폴더 / 파일 | 내용 |
|---|---|
| `repo\` | 레포와 같은 구조의 작업 사본 (Chrome 업로드용) |
| `00_새채팅_시작키.md` | 레포 `docs/` 시작키의 사본 |
| `AI로그\`, `설계\`, `2026-10-28_분업계획_서현_승준.md` | 10/28 초판 — 이후 원본은 레포 |
| `지금가지고 있는 물품\` | 보유품 사진·상용 트랩 스캔 |
| `나중 보고서를 위한 정리\` | 10/11 S0·S1, 조사, 근거자료, 타임라인, 10/12 보고 |
| `모든자료정리\` | 9/26~10/26 아이디어·스케치·메일·보고 PPT (10/26 PPT는 참고만) |
| `교수님 피드백\` | 9/28 피드백, 10/2 팀 회신메일 (최문보 교수님 10/8 답변 원본 없음) |
| `관련 논문 정리\` | 마킹·추적 논문 7편 |
| `CAD files\` | 10/2 Inventor 스케치 |
| `3d프린터 사용\`, `기타\`, `작년수업창종최종발표자료\`, `다른팀 캡스톤 참고할만한것\` | 참고 |
| `AI 지시사항\`, `공유자료\` | 빈 폴더 |
| `반도체 쿨링\` | 무관 |
