britams/-capstone-project-repo/docs/2026-11-08_CAD_D5g_정리_작업지시_서현.md

# CAD D5g 정리 — VS Code Claude 작업 지시 (서현 PC)

정리: 2026-11-08 · 이서현 (웹 채팅 Claude, **CAP-AI-43**)
결정 (서현 11/08): **D5g CAD는 서현이 이어받는다** (총지휘). 승준은 서현이 말할 때까지 쉼. CAD 작업은 VS Code Claude가 서현 PC의 FreeCAD로 한다.
- `cad/`는 분업계획상 원래 서현 편집 폴더다. D5g 스크립트(`cad/D5g_*.py`)는 승준 AI가 만들었지만, 고쳐도 규칙 위반이 아니다.
- .FCStd는 서현만 편집 → 이번에 서현 PC에서 처음 저장한다.

## 0. 알아야 할 것
- **[확실] D5g는 .FCStd가 없다.** `G.make()`로 매번 다시 만든다 (`cad/D5g_frame_detail.py`, 약 55 s). STEP을 내려받는 부분이 있다 (UNO 등).
- **그림은 GUI가 있어야 찍힌다** (`saveImage`). freecadcmd(화면 없음)로는 못 찍는다.
  - → 모델 만들기·검사·저장은 **freecadcmd**로 한다.
  - → 그림은 **FreeCAD를 매크로와 함께 실행**한다 (`FreeCAD.exe <매크로.py>`, 찍고 끝).
  - FreeCAD 설치 경로는 PC에서 찾는다 (예: `C:\Program Files\FreeCAD 1.0\bin\`).
- 렌더 규칙 (CLAUDE.md): **정투영**, 시점 애니메이션 끔. 전체 조립도에는 **2020 프레임 + 상용 트랩**을 반드시 넣는다.

## 1. 할 일 (순서대로, 하나 끝날 때마다 commit·push)
| # | 할 일 | 통과 기준 |
|---|---|---|
| C1 | `G.make()`로 D5g를 만들어 **`cad/D5g_full.FCStd`로 저장** (25 MB 넘으면 레포에 안 올리고 PC `CAD files\`에만 두고 알림) | 파일이 열림, 부품 수를 기록 |
| C2 | 승준 검사를 그대로 다시 돌림: `check(doc)` (겹침), `floating(doc)` (뜬 부품) | 겹침 0, 뜬 부품 0 (빛 빔 제외) — 승준 기록과 같은지 |
| C3 | **HX711 모듈 추가** (약 34 × 21 × 1.6 기판 [가능성 높음 — 흔한 녹색 모듈, 실물 재기] + 핀 헤더, 서현 제안 자리 가운데 (66, 95, 210), 데크 위 받침). **DC 잭 추가** (패널형 5.5 × 2.1, Ø8 구멍, 비상 정지 판 194b의 −y 쪽 (−184, −22, 225)) | 두 부품 다 겹침 0. 겹치면 가장 가까운 빈 자리로 옮기고 좌표를 적음 → 웹 채팅이 하네스를 다시 계산 |
| C4 | 그림: **전체 조립도** (정면·측면·평면·등각 4장, 프레임 + 트랩 포함), **전기 배치도** (데크 위 와고·허브·UNO·MOSFET·HX711·DC 잭이 보이게 위에서), **부품번호 풍선도** 다시 | 한 장씩 열어 글자 겹침·잘림이 없는지 확인 |
| C5 | `cad/README.md`에 시간순 기록 (D5g 서현 인수, FCStd 저장, C3 추가, 검사 결과). 부품표 `cad/2026-11-06_D5g_부품표_승준.md`에 HX711·DC 잭 줄 추가 | — |
| C6 | 서현 PC 정리: `capstone design_이서현\CAD files\`에 FCStd + jpg(그림을 jpg로) 복사 | 폴더에 D5g가 있음 |

## 2. 하지 말 것
- 승준이 정한 기구 치수(문 하우징, 레일, 급이방, 프레임)를 바꾸지 않는다. 바꿀 필요가 보이면 **멈추고 서현에게 묻는다.**
- 남은 결정(방생 출구 안 1/2, 급이 바닥 높이 370, 3D 프린터 판 크기)은 정하지 않는다 → 목록만 보고한다.
- '미검증' 치수(MOSFET 구멍, 로드셀 구멍 간격, 패널 퓨즈 길이, 만능기판 구멍, T너트)는 실물을 재기 전까지 그대로 둔다.

## 3. 끝나면
- AI 로그에 항목을 남긴다. **번호는 쓰기 직전에 로그 마지막 번호 + 1** (웹 채팅과 VS Code가 같은 줄을 씀 — 40·41은 VS Code 몫으로 비워 둠, 43은 웹 채팅이 씀).
- 웹 채팅에 넘길 것: C3에서 바뀐 좌표, 검사 결과, 그림 경로.
