britams/-capstone-project-repo/docs/2026-11-06_승준_작업지시.md

# 승준(과 승준의 Claude) 작업 지시 — 2026-11-06

작성: 이서현 (Claude와 정리, CAP-AI-28) · 대상: 이승준, 승준의 Claude
이 파일은 서현이 관리한다. 바꿀 게 있으면 Issue(#7)로 알려 준다. 이전 지시: `docs/2026-10-28_승준_작업지시.md`
**서현 쪽은 이제 CAD를 멈추고 회로도·전기 준비로 간다.** 그래서 아래 기구·구매·펌웨어·비전 쪽은 승준 쪽에서 이어 받는다.

## 0. 승준의 Claude에게 — 먼저 읽을 것 (순서)
1. `design/2026-11-06_S4_스프링146_역학계산_2차_서현.md` — 특히 **0장 결론, 7장 결정, 8장 D5f 바닥 안내**
2. `design/2026-11-06_여왕벌_크기측정_방법_서현.md` — 여왕벌 재는 법 (YOLO는 찾기만, 키포인트로 잼)
3. `design/2026-11-06_제어알고리즘_판단_서현.md` — 판단표, 7~9장 결정
4. `design/2026-11-06_회로설계_서현.md` — 핀·넷리스트·BOM (`design/circuit/out/bom.csv`)
5. `cad/README.md` 맨 아래 'D5f 바닥 안내' + `cad/D5f_electrical_layout.py` / `.FCStd`
6. 서현 로그 `ai-log/AI_명령사항_로그.md`의 CAP-AI-23~28

## 1. 오늘(11/06) 서현 결정 — 바꾸지 말 것

| 항목 | 결정 |
|---|---|
| 유럽말벌 | 격리 |
| 2종 아닌 곤충 | 격리 |
| 여왕벌 기준 | 중순판 폭(날개 뿌리 사이) **≥ 4.4 mm → 격리** (Pérez-de-Heredia 2017 경계 4.5, 띠 4.4~4.58) |
| 여왕벌 폭을 못 잴 때 | **계절 규칙**: 3~5·9~11월 여왕 → 격리, 6~8월 일벌 → 찍고 방생 |
| 배터리 | 2일 → LiFePO4 12.8 V **20 Ah** |
| 스프링 146 | 2차 사양이 '목표', **기성품만 씀** → `design/calc/spring146_catalog_check.py` 7조건 통과품 |
| 바닥 안내 | **LM4UU + Ø4 경화 축**, 최대한 기성품 (D5f에 그림, 겹침 0건) |

## 2. 승준 쪽 할 일 (순서대로)

### 2-1. 구매 목록 (J7 갱신) — 기성품
| 부품 | 수량 | 조건 | 근거 |
|---|---|---|---|
| Ø4 경화 직선 축 h6 | 1 | 길이 80 mm (스프링을 고른 뒤 스크립트가 알려 주는 길이로 1 mm 단위, 예: Misumi PSFJ4-80 같은 길이 지정품) | 2차 문서 8장 |
| LM4UU (Ø4 / Ø8 × 12) | 1 (+ 예비 1) | 캐리지 158 안에 압입 | 8장 |
| 압축 스프링 (음악선) | 후보 2~3종 × 몇 개 | **K 94~118 N/m (0.54~0.67 lbf/in), 바깥 2.8~4.1 mm, 평균 지름 ≤ 3.6, L0 − 밀착 ≥ 11.9 mm** → 카탈로그 값을 `spring146_catalog_check.py`의 `CANDIDATES`에 넣고 돌려서 '통과'만 | 8장, 7장 |
| 버튼 로드셀 1 kg | 보유 확인 | **실제 지름·높이를 재서 서현에게** (컵 자리 Ø12.4 × 6.5로 잡음, 미검증) | 회로 BOM |
| 마이크로 스위치 KW11-3Z | 3 | 원점 | Issue #7 |
| 빛 게이트 Adafruit 2167 | 9 (보유 6 + 3) | 문마다 2개 | 회로 BOM |
| 로직 레벨 MOSFET 모듈 | 4 | 조명 3 + 송신 1 | 회로 BOM |
| Pi 5 RTC 배터리 (공식 충전식) | 1 | 계절 규칙용 날짜 유지 | 회로 BOM (11/06 추가) |
| 퓨즈 홀더 + T2.5A, 비상 정지(NC), 단자대, 10 kΩ·100 nF·1000 µF | 각 | | 회로 BOM |
| (선택) 배터리 상자 20 Ah | 1 | 현장 시험 날짜 정해지면 | 회로 BOM |
→ 전체 목록은 `design/circuit/out/bom.csv` (전기) + 위 기구 4개. 해외구매 불가 규칙 확인.

### 2-2. 펌웨어 (`control/`, Issue #5·#7)
1. UNO 1·2 나누기 (핀표: 회로 문서 1장 — UNO 1 18/18, UNO 2 17/17 + D13 예비)
2. `HOLD F 0`, HX711 **80 Hz** (RATE 다리 5 V), 바닥 올라가는 동안 **표본마다** 비교 (평균 X)
3. **반걸음 간격 686~928 Hz 금지** (스프링 서지 약 808 Hz — 실제 산 스프링 값으로 바뀜, 스크립트가 출력). 지금 1000 µs(1000 Hz)는 괜찮음
4. 캐리지 위치 한계에 닿았는데 힘 < F_p: **≥ 0.4 N이면 '눌림 OK'**, 아니면 '말벌 없음/작음' → 다시 보기
5. 문 닫기: 두 빔 모두 0.2 s 비면 닫기, 하나라도 막히면 다시 열기, 3번 실패면 BLOCKED (`design/algo/A2_문닫기.mmd`)

### 2-3. Pi 코드·비전 (`vision/`)
1. **여왕벌 키포인트 모델** — YOLO 포즈, 점 4개(왼·오른 견판, 머리 앞, 허리). PRESS 뒤 원본 해상도 조각 → **Pi AI HAT+(Hailo)에서 돌아가는지 확인**
2. 배율: 같은 사진의 격자 눈 간격 4.4 mm (FFT/자기상관) × 200/201.5
3. 5장 중앙값 ≥ 4.4 mm → 여왕. 유효 < 3장이면 2 mm 내렸다 다시 → 그래도 안 되면 **계절 규칙** (Pi 시계의 달)
4. 판단 순서·상태 머신은 `design/control_sim/trap_sim.py`의 `PiFSM`이 참고 구현 (시나리오 22/22 PASS)

### 2-4. 시험
- **J7 (새로) 여왕벌 폭 측정 오차**: 표본 7마리 캘리퍼 중순판 폭 vs 격자 아래 카메라 → σ ≤ 0.10 mm면 통과 (`여왕벌_크기측정` 문서 7장)
- **R7 표본 압축**: 말벌 다치는 힘 F_harm → F_safe. **0.8 N보다 작으면 서현에게 바로** (누르기 방식 다시 계산)
- J6: 28BYJ-48 rpm·탈조, 문 서보 2위치, 빔 막고 닫기 시험

### 2-5. CAD (승준도 FreeCAD 씀)
- D5f는 `cad/D5f_electrical_layout.py` → `make()` / `check(doc)` / `check_floor(doc)` / `render_all(doc, 폴더)`. FreeCAD에서:
  `import sys; sys.path.insert(0, r"<repo>/cad"); import D5f_electrical_layout as E; doc = E.make(); print(E.check(doc), E.check_floor(doc))`
- **서현 쪽은 CAD를 멈춘다.** 스프링·로드셀 실물 치수가 나오면 `FG` 값(맨 위 dict)만 바꾸고 `check_floor`로 0건 확인 → 커밋 메시지 `[승준]`, `cad/README.md`에 한 줄. .FCStd는 서현만 편집 규칙 → 승준은 **스크립트만 고치고 FCStd는 서현이 다시 만든다** (Issue로 알림)

## 3. 서현 쪽이 하는 것 (승준이 기다리지 않아도 됨)
- 회로도 준비: 회로도 3장 다듬기, 하네스(선 길이·커넥터) 표, 브레드보드 순서 (회로 문서 4장), 배터리 상자 회로
- 인터페이스 정의서 전원·센서 줄 (승준 확인 뒤)

## 4. 열린 질문 (서현에게)
- 없음 (11/06 결정 모두 반영). 새로 생기면 Issue #7.
