britams/-capstone-project-repo/docs/2026-11-02_발표_역학계산_슬라이드원고.md

# 11/02(월) 15:00 발표 — 역학계산(S4) 슬라이드 원고 (승준이 PPT로 옮기는 용)

정리: 이서현 (Claude와, **CAP-AI-21**) · 2026-11-02 01:30
바탕: 서현 S4 r2(`design/2026-10-28_S4_역학계산_1차.md`), 승준 S4 2차 D5e(`design/2026-11-01_S4_역학계산_2차_D5e_승준.md`, CAP-AI-SJ-29), 동역학 추가 `design/calc/s4_dyn_calc.py`(M7~M10), 유제 정리 `design/2026-11-01_S4_유제선정과_적용.md`
형식: 시스템설계및제어 수업 S4 워크시트와 같은 순서다. 4-1 외력 표기 → 4-2 가상 절단 → 4-3 문제마다 ① 자유물체도 ② 문제설정 ③ 유제 연계 ④ 수기 풀이 ⑤ AI 대조와 판정.

## PPT 만들 때 규칙 (승준)
- 슬라이드 하나 = 아래 `### S숫자` 하나다. 그림은 레포 경로 그대로 쓴다 (GitHub에서 파일 열고 "Download raw file").
- 문제 슬라이드는 **왼쪽 2/3에 그림 크게, 오른쪽 1/3에 '화면 글'**을 넣는다. '발표 멘트'는 슬라이드 노트에 넣는다.
- 그림 색은 모든 그림에서 같다. 빨강 = 주어진 힘, 파랑 = 구하는 힘·반력, 주황 = 마찰력, 보라 점선 = 관성력 m a, 초록 = 모멘트. 첫 문제 슬라이드에 범례를 한 번 넣는다.
- **교재 문제 글·해설집 그림은 붙이지 않는다** (저작권, 공개 레포). 문제 번호와 주어진 수치만 쓰고, 그림은 우리가 다시 그린 것만 쓴다.
- 숫자 옆 표시: [확실] = 계산·모델 값, [가능성 높음] = 근거 있는 가정, [추측] = 시험 전 값. 화면에는 '(시험 전)' 정도로만 쓴다.
- 순서: **동역학 5문제를 앞에** 둔다 (교수님 강조). 정역학·재료·기계요소 5문제는 그 뒤에 한 장씩 둔다.

---

## A. 도입

### S1 표지
- 제목: 말벌 자동 마킹 트랩 — 역학계산 (S4)
- 부제: D5e 움직이는 모델 기준, 10문제 (동역학 5 · 정역학 3 · 재료역학 1 · 기계요소 1)
- 팀 초벌 이서현·이승준 / 2026-11-02
- 그림(선택): `cad/D5e_동작_한마리처리.gif`의 한 장면

### S2 결론 먼저 — 역학계산으로 바뀐 설계 4가지
화면 글:
1. **펜 내려찍기 (M8, 동역학)**: 서보를 최고 속도로 내리면 찍는 순간 힘이 0.8~1.8 N이다. 정적 힘 0.32 N의 2.4~5.5배로, 0.5 N 한계를 넘는다. → **결정: 스프링 204를 빼고, 마지막 2 mm는 60 °/s 이하로 천천히** (+0.14 s).
2. **문 닫힘 (M7, 동역학)**: 토크 여유는 9,000배지만, 말벌이 문틈에 있으면 22~44 N으로 누른다. → **빛 게이트로 문틈이 빈 것을 확인한 뒤 닫음.**
3. **펜 홀더 안내 핀 (M4·M5, 정역학 마찰)**: 서랍처럼 끼일 수 있다. 끼임 한계 μ_c = 0.44, PLA μ 0.3이면 여유 1.5배뿐이다. → **결정: 핀을 PTFE(테프론) 테이프로 감아 μ ≈ 0.1(여유 4배 이상), 다음 수정에서 핀을 혼이 미는 줄 쪽으로 옮김.**
4. **처리 시간 (M9, 동역학)**: 가속 몫은 0.3 %이고 시간은 모터 속도 상한이 정한다. → R6(3분)은 급이(잉크 건조) ≤ 약 105 s일 때만 만족한다.

발표 멘트: "10문제를 풀어 설계를 네 군데 바꿨습니다. 특히 동역학으로 보니 정적 계산으로는 '만족'이던 찍는 힘과 문 닫힘이 위험으로 바뀌었습니다."

### S3 역학계산 절차와 검증 규칙
화면 글:
- 4-1 전체 외력 표기 → 4-2 가상 절단(①~⑦) → 4-3 문제마다 ①~⑤
- 문제마다 **교재 유제를 먼저 풀어 교재 정답·해설집과 맞춘 뒤**, 그 같은 계산 함수로 우리 값을 낸다.
- 유제 11개 모두 해설집과 차이 0.5 % 이내다 (기준 2 %).
- 질량·무게중심은 FreeCAD D5e 모델에서 읽었다 (부품 26개, 자세 5개).
- 계산은 파이썬 스크립트로 남겼다 → 누구나 다시 돌릴 수 있다.

발표 멘트: "AI가 낸 값을 그대로 쓰지 않았습니다. 같은 함수로 교재 문제를 먼저 풀어 해설집 답과 맞는지 확인한 뒤 우리 문제에 썼습니다."

### S4 전체 구성 (D5e 전체 조립도)
- 그림: `cad/D5e_전체조립도.png` (한 장에 등각·정면·측면·위·모듈 확대·2020 단면·부품 표). 그림 하나만 크게 넣으려면 `cad/D5e_도1_전체_등각.png`
- 화면 글:
  - 상용 트랩(야생 말벌 포획기)은 그대로 바닥에 둔다. 차양막과 포획통 사이에 마킹 모듈을 끼운다.
  - 2020 알루미늄 프로파일 프레임: 바깥 360 × 360, 기둥 610. 자를 길이는 610 × 4 + 320 × 21 = 9.16 m, L 브래킷 32개다.
  - 전체 높이 845 mm (포획통 꼭대기)
  - 프레임·트랩–모듈 겹침 검사 0, 모듈 이음부 86개 통과
- 발표 멘트: "트랩을 고치지 않고, 프레임 안에서 트랩 위에 모듈을 얹는 레트로핏 구조입니다. 이 모델에서 질량·무게중심을 읽어 역학계산을 했습니다."

### S4b 4-1 전체 외력과 가상 절단면
- 그림: `design/img/S4_4-1_외력_절단면.png` (D5d 때 그림이지만 절단 위치는 D5e와 같다. 문 ⑦은 말로 추가)
- 화면 글: 외력은 W(자중), 바닥 반력, 말벌 접촉력 N_tip·R_g, 구동 토크(28BYJ-48 ×3, SG90, MG90S ×3)다. 절단 ①~⑦은 다음 슬라이드에 있다.

### S5 4-2 가상 절단과 역학 분야 — 10문제 지도
| 절단 | 떼어 낸 물체 | 드러나는 내력 | 분야 | 계산 |
|---|---|---|---|---|
| ① | 승강 바닥·밀대·캐리지 + T8 나사 | 나사 축력 F, 토크 T | 기계요소 / 동역학 | M1 / M9 |
| ② | Y 캐리지·X 빔 묶음 | 나사 추력, 봉 반력 | **동역학** / 동역학 | M2 / M9 |
| ③ | 홀더 + 마커, 말벌 | 팁 접촉력 N_tip, 격자 반력 R_g | 정역학 / **동역학** | M3 / M8 |
| ④ | 서보 혼 + 홀더 탭 | 서보 토크, 핀 짝힘 | 정역학 | M4 |
| ⑤ | X 빔 전체, 펜 홀더 | 부싱 측압·마찰 | 정역학(마찰) | M5 |
| ⑥ | X 고정 봉 Ø8 | 전단·굽힘 모멘트, 처짐 | 재료역학 / **동역학** | M6 / M10 |
| ⑦ | 문판 (입구·격리·방생 문) | 혼 핀 힘 | **동역학** | M7 |

화면 아래 한 줄: 동역학 5 (M2·M7·M8·M9·M10) · 정역학 3 (M3·M4·M5) · 재료역학 1 (M6) · 기계요소 1 (M1)

### S6 교재 유제 — 교재 정답·해설집·AI 대조 대장
| M | 교재 유제 | 무엇 | 교재 / 해설집 | AI | 차이 |
|---|---|---|---|---|---|
| M2 | Meriam 3/1 | 마찰로 멈추는 시간·거리 | 1.529 s, 4.59 m | 1.529 s, 4.587 m | 0.06 % |
| M2 | Meriam 3/2 | 빗면 출발 판정, 가속도 | −1.118 / 0 / 2.04 m/s² | 같음 | 0.03 % |
| **M7** | **Meriam 5/26** | 스카치 요크 v, a | 해설집 v = −rω sin θ, a = −rα sin θ − rω² cos θ | 수치 미분과 대조 | 10^-7 |
| **M8** | **Meriam 3/108** | 떨어지는 질량이 스프링을 누름 | 해설집 δ = 29.4 mm | 29.43 mm | 0.1 % |
| **M9** | **Meriam 2/27** | 가속·속도 제한 최소 시간 | 해설집 108.9 s | 108.9 s | 0.0 % |
| **M10** | **Meriam 8/8** | 정적 처짐 → 고유진동수 | 해설집 2.23 Hz | 2.229 Hz | 0.05 % |
| M1 | Riley 9-66 | 나사 조이는 모멘트, 자립 | 8.59 / 8.592 N·m | 8.592 N·m | 0.02 % |
| M3 | Riley 6-49 | 접촉 반력 0 한계 | 해설집 750 lb | 749.7 lb | 0.04 % |
| M4 | Riley 6-41 | 핀 모멘트 평형 | 해설집 Q 62.87 lb | 62.87 lb | 0.01 % |
| M5 | Riley 9-43 | 서랍 끼임 | 해설집 1.202 lb | 1.197 lb (θ 무시 시 1.000, −17 %) | −0.4 % |
| M6 | Gere 9.3-1 | 단순보 처짐 | 1.04 mm | 1.036 mm (E 200 GPa) | −0.4 % |

교재: Meriam·Kraige·Bolton *Dynamics* 9판 SI, Riley·Sturges *Statics* 2판, Gere·Goodno *Mechanics of Materials* 9판 SI
발표 멘트: "해설집과 다른 곳이 두 군데 있었습니다. 9-43은 해설집이 기울기를 근사해서, 9.3-1은 SI판 문제에 탄성계수가 없어서였습니다. 둘 다 원인을 찾았습니다."

---

## B. 동역학 5문제 (핵심)

### S7 M2 X·Y 이송 추력 — 질점 운동방정식 + 마찰 (Meriam 3/1, 3/2)
- 그림: `design/img/fbd/M2_D5e_이송_편심짝힘.jpg` (작게 `T3_Meriam3-2_빗면마찰.jpg`)
- ② 문제설정:
  - 주어진 것: Y 묶음 139.4 g, X 빔 455.2 g, 볼 부싱 μ 0.005, 가속 0.02 m/s². Y 묶음 무게중심이 봉 줄에서 6.7 mm 치우쳐 있다.
  - 구하는 것: 나사 추력 F, 모터 토크 T, 안전율.
- ③ 유제: 3/2의 순서(멈춰 있다고 놓고 필요한 마찰 → μ_s N과 비교 → 넘으면 ΣF = m a)를 썼다. 경사 15°는 수평으로 바꾸고, "힘 → 가속도"를 "가속도 → 필요한 힘"(역문제)으로 바꿨다.
- ⑤ 결과 [확실]:
  - Y: 편심 짝힘 H 0.305 N, F 0.0127 N, T 0.024 N·mm, 안전율 1,405
  - X: F 0.037 N, T 0.071 N·mm, 안전율 482
  - PLA 부싱이면 X는 끼인다 (M5)
- 발표 멘트: "추력은 아주 작습니다. 이 문제의 의미는 '마찰 방향을 경우마다 정하는 순서'를 M3·M4에서 그대로 쓴 데 있습니다."

### S8 M7 문 미닫이의 운동과 닫힘 힘 — 강체 평면 운동학 (Meriam 5/26)
- 그림: `design/img/fbd/M7_D5e_문_스카치요크.jpg`
- ② 문제설정:
  - 주어진 것: MG90S 혼 핀 r = 9 mm, 혼 각 φ +60°(닫힘) ~ −60°(열림), 0.1 s/60° (ω 10.47 rad/s), 정지 토크 196 N·mm [가능성 높음], 문판 0.78 g, 슬롯 μ 0.3.
  - 구하는 것: 문판 속도·가속도, 닫힘 시간, 필요 토크, **말벌이 끼었을 때 닫힘 힘**.
- ③ 유제: 5/26 스카치 요크 s = r cos θ + d와 같은 기구다 (θ = 90° − φ).
- ① 자유물체도: 문판에 F_pin(핀이 홈 벽을 밂), mg, N, μN, F_h(말벌)가 걸리고, 운동 그림은 m a_y다.
- ⑤ 결과 [확실]:
  - v_max 94 mm/s, a_max 0.855 m/s², 닫힘 0.20 s, 행정 15.6 mm
  - 필요 토크 0.022 N·mm → **토크 여유 약 9,000배**
  - 서보가 낼 수 있는 닫힘 힘 F = T/(r cos φ) = **22 N(가운데) ~ 44 N(닫힘 끝)** → 찍는 힘 기준 0.5 N의 40~90배
- 판정: 운동은 만족, **끼임은 위험**
- 환류:
  1. 닫기 전과 닫는 0.2 s 동안 빛 게이트로 문틈을 확인한다.
  2. 문판–혼 사이에 약한 스프링을 넣거나, 닫힘 끝 10°는 느리게 닫는다.
  3. F_harm(말벌이 다치는 힘)을 시험한다.
- 발표 멘트: "토크만 보면 문제가 없지만, 같은 운동학에서 힘의 팔이 r cos φ로 줄어 닫힘 끝에서 힘이 가장 커집니다. 말벌이 끼면 40 N 넘게 누를 수 있습니다."

### S9 M8 펜 내려찍기 순간의 충격 힘 — 일-에너지 (Meriam 3/108) ★ 가장 중요
- 그림: `design/img/fbd/M8_D5e_펜_내려찍기_충격.jpg`
- ② 문제설정:
  - 주어진 것: 홀더+마커 33.0 g (W 0.324 N), 스프링 204는 0 또는 0.144 N, 핀 마찰 ≤ 0.0125 N. SG90 0.1 s/60°, 혼 끝 반지름 14 mm라 닿는 순간 혼 끝 속도 v_0 = 146 mm/s. 펠트 팁 + 말벌 흉부의 접촉 강성 k_c = 300~3,000 N/m [추측].
  - 구하는 것: 찍는 순간 최대 힘 F_max, 그리고 F_max ≤ 0.5 N(말벌이 격자에 붙어 있는 한계, M3)이 되는 내리는 속도.
- ③ 유제: 3/108(6 kg이 100 mm 떨어져 미리 50 mm 눌린 4 kN/m 스프링을 더 누름)과 같이 일-에너지로 푼다. 우리는 "떨어지는 높이" 대신 "혼이 내려 주는 속도"가 v_0이고, 스프링 대신 접촉 강성 k_c다.
- ① 자유물체도 (가장 깊이 눌린 순간): W, F_s(아래), 핀 마찰 f(위), 접촉력 N_c = k_c δ(위). 혼은 탭에서 떨어져 있다. 운동 그림은 m a(위, 감속).
- ④ 식: 혼이 W'를 받쳐 주다 떨어진 뒤 ½ m v_0² = ½ k_c (δ − δ_s)² → **F_max = W' + v_0 √(k_c m)**, W' = W + F_s
- ⑤ 결과 [확실, k_c는 추측 범위]:

  | k_c (N/m) | 최고 속도, F_s 0 | 최고 속도, F_s 0.144 N | F_max ≤ 0.5 N 되는 속도 (F_s 0) |
  |---|---|---|---|
  | 300 | 0.78 N (×2.4) | 0.93 N | ≤ 229 °/s |
  | 1,000 | 1.17 N (×3.6) | 1.31 N | ≤ 126 °/s |
  | 3,000 | 1.78 N (×5.5) | 1.93 N | ≤ 73 °/s |

- 판정: **최고 속도로 내리면 불만족** (정적 0.32 N으로는 '만족'이었음)
- 환류 (제어):
  1. **(결정) 스프링 204는 뺀다.** 두 단계로 내린다. 팁 위 2 mm까지는 빠르게, **마지막 2 mm는 60 °/s 이하**로 내린다 (+0.14 s). 이러면 F_max 0.37~0.47 N이다.
  2. 스프링 204를 넣으면 13 °/s 이하로 내리거나 (마지막 2 mm에 약 0.9 s) 스프링을 뺀다.
  3. k_c를 측정한다: 저울 위에서 펠트 팁 눌림을 잰다 (F_ink 시험과 같이).
- 발표 멘트: "정역학으로는 0.32 N이라 0.5 N 안이었습니다. 그런데 서보가 내려 주는 속도를 넣으니 순간 힘이 2~5배가 됐습니다. 그래서 서보 내리는 속도를 제어 규칙으로 정했습니다."

### S10 M9 X·Y·바닥 이송 시간 — 직선 운동, 가속도·속도 제한 (Meriam 2/27)
- 그림: `design/img/fbd/M9_D5e_이송시간_사다리꼴.jpg`
- ② 문제설정:
  - 주어진 것: 28BYJ-48 반 스텝 최대 약 1,000 Hz → 15 rpm, T8 리드 8 → 2.0 mm/s (10 rpm이면 1.33 mm/s), 가속 0.02 m/s², 이동 X 28 mm, Y 58 mm, 바닥 36.5 mm.
  - 구하는 것: 각 이동 시간, 무엇이 시간을 정하는지, R6(한 마리 3분) 판정.
- ③ 유제: 2/27과 같은 사다리꼴 속도 선도다. D ≥ v²/a이면 t = D/v + v/a.
- ⑤ 결과 [확실]:
  - 15 rpm: X 14.1 s, Y 29.1 s, 바닥 18.4 s
  - **가속 구간 몫 0.3 %** → 가속도·토크를 키워도 시간은 그대로다
  - 벨트(GT2 20T)면 Y 5.8 s
- 판정: R6 **조건부**. 기구·판별 합 63.9 s → 급이(잉크 건조) ≤ 약 105 s여야 한다.
- 환류: 시간을 줄이려면 속도 상한을 올려야 한다 (벨트·NEMA17, 승준 제안). 리드스크루를 유지하면 샤피 건조 시험이 R6를 가른다.
- 발표 멘트: "교재 문제는 가속 구간이 길지만, 우리는 0.1 s뿐입니다. 시간을 정하는 것은 모터 속도 상한입니다."

### S11 M10 봉의 고유진동수와 스텝 모터 공진 — 진동 (Meriam 8/8, M6에서 이어짐)
- 그림: `design/img/fbd/M10_D5e_고유진동수_공진.jpg`
- ② 문제설정:
  - 주어진 것: M6 정적 처짐 (X 봉 A 대기 0.0072 mm, 최악 0.0100 mm, Y 봉 0.0026 mm). 스텝 주파수 f = rpm × 4096 / 60.
  - 구하는 것: 고유진동수, 피해야 할 모터 속도.
- ③ 유제: 8/8 정적 처짐 50 mm → k = mg/δ, f_n = (1/2π)√(g/δ_st). 우리는 봉이 스프링, X 빔 몫이 질량이다.
- ⑤ 결과 [확실]:
  - X 봉 f_n 158~186 Hz, Y 봉 309 Hz, 홀더가 말벌 위에 얹혔을 때 15~48 Hz [추측: k_c]
  - 운전 10~15 rpm = 683~1,024 Hz → 고유진동수와 3.7배 이상 떨어져 있음
  - 공진 띠는 2.1~3.0 rpm
- 판정: 만족
- 환류: 순항 속도로 2~3 rpm을 쓰지 않는다. 찍는 동안은 X·Y 모터가 정지한다.
- [추측] 스텝 진동이 봉의 세로 굽힘을 얼마나 흔드는지는 모른다 → J6에서 소음·떨림을 같이 본다.
- 발표 멘트: "M6에서 처짐이 0.01 mm라 '충분하다'로 끝났던 값이, 진동으로 보면 피해야 할 모터 속도를 알려 줍니다."

---

## C. 정역학·재료역학·기계요소 5문제 (한 장씩)

### S12 M1 바닥 승강 나사 — 기계요소 (Riley 9-66)
- 그림: `design/img/fbd/M1_D5e_승강나사_캐리지.jpg` (작게 `T1_Riley9-66_나사.jpg`)
- 주어진 것: 바닥 묶음 53.1 g + 말벌 누름 0.5 N [가정], Tr8×8 (d_m 7, 반각 15°), μ 0.15, 28BYJ-48 34.3 mN·m (1.8 rpm 기준)
- 결과: 회전 막이 + 캐리지 기울어짐 짝힘(승준)까지 넣어 **T 3.19 N·mm, 안전율 10.8** [가능성 높음]
- 자립 안 함 (리드각 20.0° > 마찰각 8.83°) → 전원이 꺼지면 감속기(1/64)가 역구동을 막아야 한다 → J6에서 확인
- 유제와 다른 점: 사각나사 → 사다리꼴 (마찰각에 sec 15°)

### S13 M3 찍는 힘 — 정역학 (Riley 6-49)
- 그림: `design/img/fbd/M3_D5e_찍는힘_물체셋.jpg` (작게 `T4_Riley6-49_접촉반력0.jpg`)
- 물체 셋(홀더 / 말벌 / 바닥+밀대)으로 나눴다. 한계는 R_g = 0 (말벌이 격자에서 떨어짐) — 6-49의 "빗면 반력 A = 0"과 같은 조건이다.
- 결과: N_tip 0.311~0.323 N (핀 마찰 몫 4 %), 스프링 상한 0.177 N → 스프링은 0.144 N(4 mm 눌림)으로 한다.
- **로드셀은 찍는 힘을 못 잰다** (바닥 힘 F_p만 읽음)
- 이 정적 결과를 동역학 M8이 보완한다 (순간 힘)

### S14 M4 펜 들기 서보 — 정역학 (Riley 6-41)
- 그림: `design/img/fbd/M4_D5e_펜들기_혼_핀안내.jpg` (작게 `T5_Riley6-41_레버모멘트.jpg`)
- 핀(서보 축)에 대한 ΣM = 0, 팔 = 14 cos θ (힘의 작용선까지 수직 거리)
- 결과 (μ_pin 0.3) [가능성 높음]: **T 12.4 N·mm, SG90 안전율 14.2**. 스프링 최대면 24.8 N·mm, 7.1
- μ_pin 0.5면 끼임 (μ_c 0.44) → 다음 장

### S15 M5 한쪽 구동 끼임 — 정역학 마찰 (Riley 9-43)
- 그림: `design/img/fbd/M5_D5e_끼임_X빔_펜홀더.jpg` (작게 `T6_Riley9-43_서랍끼임.jpg`)
- 식: μ_c = L / 2(k d + h) (서랍 식 + 피치)
- X 빔: LM8UU μ_c 0.068~0.103, 여유 13.6배 → 만족. 청동 부싱은 끼임 → 볼 부싱으로 정했다.
- **펜 홀더 안내 핀 (D5e 새 위험)**: μ_c 0.44, PLA μ 0.3이면 여유 1.5배
- 고치는 법 세 가지: ① 핀을 혼이 미는 줄 쪽으로 (e_y ≤ 10 → μ_c 0.99) ② 슬리브 재질 (황동·볼 부싱·PTFE) ③ 슬리브 60 mm (μ_c 0.62, 위 멈춤 탭과 겹쳐서 지금은 불가)
- **결정 (11/02)**: 지금은 ②를 쓴다. 핀을 PTFE 테이프로 감아(승준 구매품) μ ≈ 0.1로 낮춰 여유 4배 이상을 확보한다 [가능성 높음, 마찰 시험으로 확인]. 다음 수정(D5f)에서 ①로 핀을 옮긴다.

### S16 M6 X 고정 봉 처짐 — 재료역학 (Gere 9.3-1)
- 그림: `design/img/fbd/M6_D5e_봉처짐_SFD_BMD.jpg` (작게 `T7_Gere9.3-1_단순보처짐.jpg`)
- 결과: 최악(한 봉이 전부) δ **0.0100 mm**, σ 3.62 MPa (L 163 mm) → 정확도 ±1 mm의 1/100 → 만족
- 이 처짐이 M10 고유진동수로 이어진다

---

## D. 마무리

### S17 판정 요약
| M | 분야 | 기준 | 값 | 판정 |
|---|---|---|---|---|
| M1 | 기계요소 | 28BYJ-48 토크 | T 3.19 N·mm, 안전율 10.8 | 만족 (속도별 토크는 J6) |
| M2 | **동역학** | 모터 토크 | 안전율 ≥ 482 | 만족 |
| M3 | 정역학 | R_g ≥ 0 (N_tip ≤ 0.5 N) | 0.311~0.323 N | 만족 |
| M4 | 정역학 | SG90 176.6 N·mm | 12.4 N·mm (14.2배, μ 0.3) | 만족 (μ 시험 전) |
| M5 | 정역학 | μ < μ_c | X 빔 13.6배 / 펜 핀 1.5배 → PTFE면 4배 이상 | X 만족 / **핀은 PTFE로** |
| M6 | 재료역학 | ±1 mm | 0.0100 mm | 만족 |
| M7 | **동역학** | 닫힘 시간, 끼임 | 0.20 s / 22~44 N | **끼임 위험 → 제어 규칙** |
| M8 | **동역학** | F_max ≤ 0.5 N | 최고 속도 0.8~1.8 N | **불만족 → 60 °/s 이하로** |
| M9 | **동역학** | R6 3분 | 이송 Y 29.1 s, 합 63.9 s | **조건부** (급이 ≤ 105 s) |
| M10 | **동역학** | 공진 회피 | f_n 158~186 Hz vs 683~1,024 Hz | 만족 (2~3 rpm 피함) |

### S18 환류 — 계산이 바꾼 설계·제어
1. 서보 펜 내리기 2단계 속도 (M8)
2. 문은 빛 게이트 확인 뒤 닫기, 문판 힘 상한 (M7)
3. 펜 홀더 안내 핀: 지금은 PTFE 테이프, 다음 수정에서 핀 위치 옮김 (M4·M5)
4. 스프링 204는 뺌 — 마커 무게만으로 N_tip 0.31 N (M3·M8)
5. X·Y는 볼 부싱 LM8UU·LM6UU (M5)
6. 모터 순항 2~3 rpm 금지 (M10), 시간 단축은 속도 상한이 열쇠 (M9)

### S19 남은 시험 (값을 확정할 것)
| 시험 | 정하는 값 | 쓰는 곳 | 담당 |
|---|---|---|---|
| J6 28BYJ-48 부하 시험 (10·15 rpm, 바닥 + 0.5 N) | 속도별 토크, 역구동 | M1·M9 | 승준 |
| 샤피 노랑 건조·최소 힘 F_ink | 급이 시간, 찍는 힘 하한 | M3·M9 | 서현 |
| 펠트 팁 눌림 (저울) | 접촉 강성 k_c | M8 | 서현 |
| PLA 슬리브–강 핀 마찰 | μ_pin | M4·M5 | 서현 |
| 말벌이 다치는 힘 F_harm | 찍는 힘·문 닫힘 상한 | M3·M7·M8 | 표본 필요 |

### S20 (부록) 수기 풀이와 파일
- ④ 수기 풀이: 발표 뒤 서현이 한다 (질문이 나오면 "AI값을 교재 유제·해설집으로 먼저 검증했고, 수기 대조는 다음 회차"라고 답한다).
- 계산 파일: `design/calc/s4_calc.py`(r2), `s4_calc_d5e_sj.py`(승준 D5e), `s4_dyn_calc.py`(M7~M10), `s4_textbook_check.py`(유제 대조)
- 그림: `design/img/fbd/` (T1~T7 교재 유제, M1~M10 우리 문제)

### S21 (예비) 예상 질문과 답 — 슬라이드에는 안 넣고 발표자가 외워 둠
| 예상 질문 | 답 (짧게) |
|---|---|
| AI가 계산한 값을 어떻게 믿나요? | 같은 계산 함수로 교재 유제 11개를 먼저 풀어 교재 정답·해설집과 맞췄습니다(모두 0.5 % 안). 그 함수로 우리 값을 냈습니다. 다른 두 곳(9-43, 9.3-1)은 원인까지 찾았습니다. |
| 수기 풀이는요? | 이번 회차는 AI값과 교재·해설집 대조까지입니다. 수기 대조는 다음 회차에 하고, 2 % 넘게 다르면 원인을 찾습니다. |
| k_c(접촉 강성) 300~3,000은 어디서? | 시험 전 추측 범위입니다. 범위 전체에서 결론(최고 속도면 0.5 N 초과, 60 °/s면 안)이 같아서 설계 결정에는 충분합니다. 펠트 팁 눌림을 저울로 재서 확정합니다. |
| 0.5 N 기준은 어디서? | 바닥이 말벌을 격자에 붙이는 힘(로드셀 정지값) 가정입니다. 찍는 힘이 이보다 크면 말벌이 격자에서 밀립니다(M3, 접촉 반력 0 조건). 말벌이 다치는 힘은 표본으로 시험해야 합니다. |
| 왜 동역학이 중요했나요? | 정역학으로는 찍는 힘 0.32 N이라 '만족'이었는데, 서보가 내려 주는 속도를 넣으니 순간 힘이 2~5배였습니다. 문도 토크는 9,000배 남지만 닫힘 끝에서 힘이 44 N까지 올라갑니다. 둘 다 정적 계산으로는 안 보이는 위험입니다. |
| 문에 말벌이 끼면 실제로 다치나요? | 다치는 힘(F_harm)은 아직 모릅니다. 그래서 힘을 줄이는 쪽(빛 게이트로 문틈 확인 뒤 닫기, 닫힘 끝 느리게)을 제어 규칙으로 넣었습니다. |
| 리드스크루가 자립 안 하면 바닥이 떨어지지 않나요? | 리드각 20.0° > 마찰각 8.83°라 나사만으로는 자립하지 않습니다. 28BYJ-48의 1/64 감속기가 역구동을 막는다고 봅니다. 전원을 끈 상태로 J6에서 확인합니다. |
| 3분 안에 되나요? | 기구·판별 합 약 64 s라 급이(잉크 건조)가 약 105 s 이하면 됩니다. 건조 시험이 판정합니다. 늦으면 벨트·NEMA17로 이송 속도를 올립니다(Y 29 s → 6 s). |
| 프레임은 왜 2020인가요? | 정방형만 쓰고 부품 구하기 쉬운 20 시리즈입니다. 갠트리 레일 처짐 약 0.004 mm라 힘으로는 충분합니다. |
| 교재 문제는 어떻게 골랐나요? | ① 우리 문제와 같은 식 ② 같은 판정(자립·끼임·떨어짐) ③ 교재 정답이나 해설집이 있어 대조 가능 — 셋을 다 만족하는 것만 골랐습니다 (`design/2026-11-01_S4_유제선정과_적용.md`). |
