britams/-capstone-project-repo/control/2026-10-28_제어부_구성_신뢰성_AI마킹.md

# 제어부 구성 · 신뢰성 · AI 마킹 전략 (승준 → 서현 공유)

작성: 2026-10-28 · 이승준 (Claude와 정리, CAP-AI-SJ-24) · 기준: 서현 D5 4차·D6·S4 r2, 인터페이스 정의서 3차
계산·코드: `control/analysis/reliability_mc.py`(→ `reliability_results.json`), `vision/scripts/mark_planner.py`, `control/proposals/grid_coupons_sj.py`(시험 조각 STL), `design/calc/s4_me3_check_sj.py`
표기: [확실] 계산·사양·문서 / [가능성 높음] 근거 있음, 시험 전 / [추측] 가정 — **이 문서의 확률은 모두 '가정 범위 안의 예측'이지 실물 증명이 아님**

---

## 0. 결론 먼저 (서현 필독)

| # | 결론 | 판정 | 서현 쪽 영향 |
|---|---|---|---|
| 1 | **지금 설계(서현 D6 문서: 사각 구멍 3.0·피치 4.4, 샤피 불렛 팁 = 표 3-2의 안 D0)로는 한 마리를 흉부에 제대로 찍을 확률이 1회 약 5 %, 8회 재시도해도 약 35 %** (중앙값). 흉부 '찍어도 되는' 영역이 폭 1~2 mm 안팎인데, 팁(1.5~2.5 mm)이 3 mm 구멍을 지나야 해서 갈 수 있는 자리가 구멍마다 0.3~1.3 mm 사각형뿐 | [가능성 높음] (기하는 [확실], 팁·점 크기·비전 오차는 [추측] 범위) | 격자·팁 재검토 필요 |
| 2 | **네 가지를 같이 바꾸면 예측 95 % 넘음**: ① 틈 3.5 mm(사각 피치 4.3 또는 슬롯 피치 4.5) ② 팁 약 1 mm(또는 격자 위쪽 모따기로 같은 효과) ③ 비전 흉부 좌표 σ 0.2~0.4 mm ④ 말벌이 바닥에 등을 위로 하고 있게 조명 배치 → **평균 1.9회 시도, 8회 안에 성공 P5 98 %** (표 3-2의 안 D5·D6) | [가능성 높음] | D6 격자 g_h·g_p, 조명 182, 마커 |
| 3 | **승준 원안 "확률 상위 10~20곳을 다 찍기"는 오히려 나쁨**: 흉부 위에 걸리는 구멍은 많아야 1~2개 → 찍는 곳을 2 → 3 → 10 → 20곳으로 늘려도 1곳이라도 맞을 확률은 26 → 24 → 23 → 22 %로 **안 오르고**(차이는 표본 잡음), **흉부 밖 점만 마리당 1.7 → 4.6개**로 늘어남 (지금 격자, 기하만 본 값) → **"확률 0.5 이상인 최고 1곳에 2번 찍기 → 카메라로 확인 → 실패면 자세 다시"**가 맞음 | [가능성 높음] | — |
| 4 | **'AI가 지점·경로 계산 → MCU가 빠르게 실행' 구조는 맞음.** 강화학습은 필요 없음, PID도 스테핑엔 필요 없음 → 가감속(사다리꼴) + 원점 스위치 + 시험 점 보정. 경로 최적화는 후보가 1~3곳이라 효과 작고, **'바닥 올리는 동안 마커 미리 이동'**이 13 s를 줄임 | [확실] (스테핑 구동 원리) | — |
| 5 | **속도: 28BYJ-48은 토크가 아니라 펄스(약 1 kHz → 2 mm/s)가 한계** (기계요소 유제 ME3). 재시도 1회 = 약 16 s → 8회면 3분(R6) 초과. **X·Y(+바닥)를 NEMA17 + 드라이버로 바꾸면 1회 19 s, 재시도 1회 +4.6 s** | [확실] 계산 / NEMA17 실속도 [가능성 높음] | 모터 장착부·프레임 무게 (서현 S4 다시) |
| 6 | **말벌 행동이 가장 큰 미지수**: 빛 쪽(위)으로 가는 습성 [확실 — 상용 트랩 원리, D0] → 위 링 조명이 켜져 있으면 말벌이 **격자 아래에 매달려 등이 바닥 쪽**이 될 가능성 높음 → 바닥이 올라오면 배가 카메라를 봄(뒤집힘) | [가능성 높음] | 조명 182 위치 (위 어둡게·아래 밝게) |
| 7 | **여왕벌을 흉부 폭만으로 가르면 위험**: 측정 오차 σ 0.1 mm, 경계 4.55 mm면 여왕벌 6.5 %를 일벌로 보고 놓아줌. 경계 4.40 mm면 0.2 %지만 일벌 14 %가 마킹 없이 격리됨 → **몸 길이·배 폭 같이 보기 + 애매하면 격리** | [확실] 계산 / 크기 분포 [확실 — 문헌] | D1 R(여왕벌 격리) 기준 |
| 8 | **"신뢰성 확실 95 %"는 계산으로 증명 못 함** → 실물 시험으로 보여야 함: **연속 59마리 성공(실패 0)** 또는 93마리 중 실패 1 이하면 "95 % 이상, 신뢰수준 95 %". 살아 있는 말벌은 2027 여름 → 그 전엔 표본 7마리 + 더미로 **단계별**(기하·잉크·비전) 시험 | [확실] 이항분포 | 시험 계획 |
| 9 | **Jetson Nano 필요 없음**: Pi 5 + AI HAT+(Hailo 26 TOPS)로 YOLO 계열 검출·키포인트를 실시간 [가능성 높음]. 부족한 건 계산이 아니라 **기구 속도·격자 기하·학습 데이터** | [가능성 높음] | — |

---

## 1. 말벌이 우리가 예상한 대로 움직일까?

설계가 기대하는 움직임 (인터페이스 상태 머신) ↔ 실제로 일어날 수 있는 일:

| 단계 | 설계 기대 | 예상되는 실제 | 판정 | 대책 |
|---|---|---|---|---|
| 진입 | 트랩 몸통에서 빛 쪽(위)으로 올라와 입구 110으로 | 상용 트랩이 이 원리로 동작 → **들어옴** | [확실 — 트랩 설명서 '빛의 광도차', D0] | 입구 쪽이 몸통보다 밝아야 함 (모듈이 빛을 가리면 안 들어옴) |
| 한 마리만 | 감지 → 입구 문 닫힘 | 두 마리가 붙어 들어올 수 있음 (새벽에 몰림) | [가능성 높음] | 문을 **아두이노가 바로**(수 ms) 닫음, 두 마리면 격리 (D2 Q6) |
| 마킹실 안 | 바닥에 머묾 → 바닥이 올려 등을 격자에 | **위 조명이 켜져 있으면 천장 격자로 날아올라 매달림** → 등이 아래 → 눌리면 배가 위 | [가능성 높음] | **진입~누르기 동안 위(격자 쪽) 어둡게, 바닥 쪽 밝게**(바닥을 반투명 판 + 아래 LED). 촬영은 누른 뒤 짧게 위 조명 |
| 누르기 | 등이 격자에 평평하게 | 몸을 비틀거나 다리를 격자 틈에 넣음, 날개가 접혀 흉부를 가림 | [추측] | 뒤집힘·자세 판별 AI → 아니면 바닥 10 mm 내렸다 다시 |
| 찍기 | 흉부에 점 | 팁 닿으면 움찔 → 점이 번짐, 그루밍으로 지움 | [추측] | 찍는 힘 작게(S4 M3), 급이 중 건조, J9 시험 |
| 방생 | 밝은 출구 쪽으로 | 빛 쪽 습성으로 출구를 밝게 하면 나감 | [가능성 높음] | D5 환류 4·5 그대로 |

**확인 방법**: 표본(죽음)으로는 행동을 못 봄. 이번 주(11월 전)에 **살아 있는 말벌**을 상용 트랩으로 잡으면 → 투명 아크릴 상자 + 시험 조각 격자 + 위/아래 조명을 바꿔 가며 **휴대폰 영상** (말벌이 어디에 머무는지, 등 방향) — 행동 가정 p_up(지금 0.3~0.8로 가장 넓은 범위)을 좁히는 유일한 방법.

## 2. 말벌이 어느 방에 있는지 어떻게 아나?

방: ① 트랩 몸통(유인) → ② 입구 통로(110~112) → ③ 마킹실(120) → ④ 격리 통로(172) → 포획통 / ⑤ 방생 출구(174) → 밖

| 위치 | 감지 | 부품 (보유 우선) | 판정 |
|---|---|---|---|
| ② 입구 통로 | **빛 차단 게이트 2개(앞·뒤)** → 순서로 들어감/나감 구분, 진입 시각 | 보유: 포토레지스터 3 + LED (키트). 반응 수십 ms [가능성 높음] — 걷는 말벌엔 충분. 부족분은 적외선 빔 센서 구매 | [가능성 높음] |
| ③ 마킹실 | **카메라**: 마리 수·위치·자세 (AI) | AI 카메라 (보유) | [확실] (보이는 곳) |
| ③ 마킹실 보조 | 하중 센서는 **존재 감지엔 못 씀** — 일벌 무게(약 0.3 g 안팎 [추측])가 1 kg 로드셀 잡음과 비슷 | — | [가능성 높음] |
| ④ 격리 통로 / ⑤ 방생 출구 | 빛 차단 게이트 1개씩 → **나갔는지 확인 후 문 닫기** (안 나가면 조명 바꿔 유도, 시간 초과 시 로그) | 포토레지스터 + LED (구매 소량) | [가능성 높음] |

방마다 '들어간 수 − 나간 수'로 몇 마리 있는지 셈 → 카메라와 어긋나면 로그 + 안전 동작(격리). 게이트는 **아두이노 2번(입출력)**이 읽고, 입구 게이트가 막히면 Pi를 거치지 않고 바로 입구 문을 닫음.

## 3. 신뢰성 분석 — "한 마리를 흉부에 제대로 찍고 확인할 확률"

### 3-1. 모델 (`control/analysis/reliability_mc.py`)
- 한 번 시도 = 자세(등 위 p_up) → 뒤집힘 판별 → **플래너가 고른 점**(흉부 확률 최대, 0.5 미만이면 찍지 않고 자세 다시) → 잉크(같은 자리 2번) → 점 확인(J4) → 실패면 바닥 10 mm 내렸다 올려 다시, 최대 N회
- '제대로' = 점(지름 0.8~2.0 mm) 전체가 흉부 등판의 안쪽(길이의 65~85 %, 폭의 60~80 %)에 들어감 → 날개 뿌리·머리·배에 안 묻음
- 모르는 값은 범위에서 뽑은 '세계' 120개 × 말벌 4000마리. **P5 = 120개 세계 중 하위 5 % 값 = 보수적 예측**
- 범위 (근거·판정은 코드 RANGES): 팁 지름 1.5~2.5 mm [추측], 점 1.0~2.0 [추측], 비전 σ 0.3~0.7 mm [가능성 높음 — D6 ±1 mm], 기구 σ 0.1~0.25 [추측], p_up 0.3~0.8 [추측 — 행동], 뒤집힘 판별 95~99.5 %, 잉크 1회 80~97 % [추측 — J9 전], 점 확인 검출 90~99 %·오검출 1~5 % (J4 합성 96 %/2 %)

### 3-2. 결과 (`reliability_results.json`, 세계 120 × 말벌 4000)
표의 D0~D8은 **시뮬레이션 안 번호**(코드 `DESIGNS`)이고, 서현 설계 문서 번호(D5·D6)와 다름.

| 설계안 | 1회 시도 기하 성공 (중앙/P5) | 1회 '확실한 점 없음' | 성공 N≤1 (중앙/P5) | N≤4 | N≤8 | 평균 시도 (N≤8) | 오마킹 (N≤8, 중앙/P95) | P5 ≥ 95 %인 N |
|---|---|---|---|---|---|---|---|---|
| D0 지금 (사각 3.0/4.4, 샤피 불렛) | 13 / 1 % | 80 % | 5 / 1 % | 19 / 2 % | 35 / 3 % | 6.5 | 26 / 38 % | 12회로도 안 됨 |
| D1 얇은 살 (사각 3.0/3.8) | 21 / 0 % | 65 % | 11 / 0 % | 38 / 0 % | 61 / 1 % | 5.6 | 27 / 38 % | 안 됨 |
| D2 슬롯 (틈 3.0/피치 4.0) | 33 / 6 % | 53 % | 15 / 2 % | 48 / 7 % | 72 / 13 % | 5.0 | 29 / 41 % | 안 됨 |
| D3 D2 + 비전 σ 0.2~0.4 | 41 / 19 % | 49 % | 18 / 8 % | 56 / 30 % | 81 / 51 % | 4.3 | 22 / 37 % | 안 됨 |
| D4 D3 + 등 위 자세 유도 (p_up 0.6~0.9) | 42 / 24 % | 47 % | 28 / 16 % | 73 / 48 % | 93 / 74 % | 3.4 | 22 / 37 % | 안 됨 |
| **D5 D4 + 팁 약 1 mm + 슬롯 틈 3.5/피치 4.5** | **80 / 59 %** | 10 % | 53 / 39 % | **95 / 86 %** | **100 / 98 %** | **1.9** | 13 / 25 % | **8** |
| **D6 사각 3.5/4.3 + 팁 1 mm + 비전 + 자세** | **79 / 57 %** | 9 % | 53 / 39 % | **95 / 86 %** | **100 / 98 %** | **1.9** | 14 / 25 % | **8** |
| D7 D5 + 기준 0.3 (과감) | 81 / 64 % | 4 % | 54 / 40 % | 95 / 87 % | 100 / 98 % | 1.9 | 17 / 28 % | 6 |
| D8 D5 + 기준 0.8 (신중) | 69 / 48 % | 27 % | 45 / 29 % | 90 / 74 % | 99 / 94 % | 2.3 | **7 / 16 %** | 12 |

읽는 법:
- **효과가 큰 순서**: 팁·틈(갈 수 있는 자리 넓히기) > 비전 정확도 > 등 위 자세 > 슬롯/얇은 살. 하나만 바꿔서는 95 %가 안 됨
- **오마킹**(흉부 밖에 점이 한 번이라도)은 D5에서도 약 13 % → 찍을지 정하는 기준(p_min)을 높이면 줄지만(D8 7 %) 시도가 늘어남. **0.5~0.8 사이에서 더미 시험으로 정함.** 말벌 보호와 데이터 품질 때문에 오마킹 목표도 따로 정해야 함 (예: 5 % 이하) — 서현 D1에 추가 제안
- 사각 3.5 구멍(D6)과 슬롯(D5)은 결과가 거의 같음 → **프린트가 쉽고 말벌을 잘 받치는 쪽**으로 고르면 됨 → 시험 조각으로 확인 (아래 3-4)

### 3-3. 여왕벌 판별 (크기)
| 측정 σ | 경계 4.40 mm | 4.50 mm | 4.55 mm |
|---|---|---|---|
| 0.05 mm | 여왕→일벌 0.0 % / 일벌 격리 13 % | 0.1 % / 2.2 % | 1.0 % / 0.4 % |
| 0.10 mm | 0.2 % / 14 % | 2.6 % / 5.1 % | **6.5 %** / 2.4 % |
| 0.15 mm | 2.1 % / 17 % | 7.7 % / 7.9 % | 13 % / 5.0 % |
- 흉부 폭 차이(약 0.1 mm)가 200 mm 거리 카메라의 1.5 화소 [서현 D5 10-2와 같음] → **폭 하나로는 위험**. 신여왕벌은 몸 길이가 훨씬 김(최대 약 30 mm vs 일벌 약 20 mm, 인수인계 4장) → **몸 길이 + 흉부 폭 + 배 폭**을 같이 보고, 애매하면 격리 (여왕벌 놓침은 되돌릴 수 없는 실패, 일벌 격리는 데이터 손실일 뿐)

### 3-4. 한 마리 처리 시간 (급이 제외, S4 M2 단계 기준)
| 구동 | 1회 | 2회 | 3회 | 4회 | 재시도 1회당 |
|---|---|---|---|---|---|
| 28BYJ-48 (지금) | 64.8 s | 80.9 | 96.9 | 113.0 | +16 s |
| 28BYJ-48 + 바닥 오르는 동안 마커 미리 이동 | 51.3 | 67.3 | 83.4 | 99.4 | +16 s |
| NEMA17 X·Y + 28BYJ 바닥 | 35.3 | 49.2 | 63.1 | 76.9 | +14 s |
| **NEMA17 X·Y·바닥** | **18.6** | 23.2 | 27.9 | 32.5 | **+4.6 s** |
- R6 3분에서 급이(건조, 서현 D6: 1~3분 미정)를 빼면 남는 시간이 적음 → 95 %에 필요한 재시도(최대 8회)를 하려면 **바닥까지 빠른 구동이 필요** [가능성 높음]

### 3-5. "확실한 95 %"를 보이는 실물 시험
- 이항분포: 성공 확률이 95 %라고 신뢰수준 95 %로 말하려면 **실패 0으로 59마리**, 실패 1 허용이면 93마리, 2 허용이면 124마리 [확실]
- 지금 할 수 있는 단계별 시험 (살아 있는 말벌 없이):
  1. **기하** — 시험 조각 A~D 위에 표본(액침 7마리)을 무작위로 놓고 눌러, 플래너가 고른 점에 손으로(또는 XY로) 찍기 → 59회 반복 가능 (표본 위치만 바꿈)
  2. **잉크** — J9 (건조·F_ink·문지름)
  3. **비전** — 표본·더미 사진으로 흉부 좌표 오차 σ 실측 (J8) → 위 범위 0.3~0.7을 실제 값으로
  4. **행동** — 살아 있는 말벌(이번 주) 또는 2027 여름
- 단계별로 확률을 실측하면 3-2 표를 '가정'이 아니라 '측정'으로 다시 돌릴 수 있음 → 그때 95 % 판단

## 4. AI 4가지 일 — 파이프라인 (Pi 5 + AI HAT+)

| 일 | 방법 (제안) | 입력·출력 | 학습 데이터 | 판정 |
|---|---|---|---|---|
| ① 등검은말벌인가 | VespAI는 미끼판을 멀리서 찍은 사진으로 학습 → **우리 구도(위 200 mm, 격자 너머)로 다시 학습(파인튜닝)**. 클래스: 등검은말벌 / 다른 말벌 / 꿀벌·기타 | 사진 → 종·상자 | 표본 7마리(사진 여러 각도·조명) + 인터넷 사진 + 다른 종 | [가능성 높음] (J1: 원래 사진은 0 오분류, 구도가 다르면 미지수) |
| ② 여왕벌인가 | **딥러닝 말고 측정**: 키포인트·윤곽 → 몸 길이·흉부 폭·배 폭(mm, 격자 피치를 자로 보정) → 규칙(3-3) | 키포인트 → mm 값 → 판정 | 표본 실측 | [가능성 높음] |
| ③ 뒤집혔나 | ①과 **같은 모델에 클래스로** (등 위 / 배 위) 또는 키포인트 순서 | 사진 → 자세 | 표본 앞·뒤 사진 | [가능성 높음] (등판·배 무늬가 뚜렷) |
| ④ 흉부 위치 확률 | **키포인트 모델(머리·흉부 앞·흉부 뒤·배 끝)** → 흉부 타원 + 불확실성(여러 번 추론 흩어짐 또는 히트맵 폭) → `mark_planner`가 갈 수 있는 점마다 '흉부 안 확률' 계산 → 최고 1곳 | 사진 → (x, y, θ, L, w, σ) → 찍을 점·명령 | 표본·더미 사진에 키포인트 표시 (수백 장, 증강) | [가능성 높음] |

- **모델 하나(YOLO 계열 '검출 + 키포인트')로 ①③④를 한 번에** → Hailo에서 1장 수십 ms 안 [가능성 높음]. ②는 그 결과로 계산
- 격자가 사진에 보이므로 **격자 눈을 자로 써서** 화소→mm를 매번 보정 (카메라가 조금 움직여도 됨) → 비전 σ를 줄이는 가장 싼 방법
- 라이선스: VespAI 가중치는 비영리(SJ-02). 우리 모델은 우리 데이터로 새로 학습 — 학습 도구(Ultralytics)는 AGPL [확실] → 판매용이면 다시 검토
- **Jetson Nano 필요 없음**: 병목은 계산이 아니라 기구 속도·기하 [가능성 높음]

## 5. 승준 제안(강화학습/PID, 10~20곳, 경로)에 대한 의견

| 제안 | 의견 | 이유 |
|---|---|---|
| AI가 우선순위·경로 계산 → MCU가 경로만 빠르게 실행 | **좋음 — 그대로 감** | Pi는 무거운 계산, 아두이노는 펄스 타이밍. 명령은 'PATH 점 목록' 한 줄 (펌웨어에 추가) |
| 강화학습 | **필요 없음** | 나사 리드로 '몇 펄스 = 몇 mm'가 정확히 정해져 있음. 강화학습은 수천~수백만 번 시행착오가 필요하고, 실물로 배우면 말벌·기구가 다침. 얻을 것 없음 |
| PID | **스테핑 이동엔 필요 없음** | 스테핑은 펄스 수가 곧 위치(개루프). 대신 **가감속(사다리꼴)** + **원점 스위치** + **켤 때 시험 점 찍어 카메라로 어긋남 보정**(시각 보정). PID가 쓸모 있는 곳: 바닥 누르기 — 하중이 커질수록 천천히 올리는 비례 제어로 말벌 보호 |
| 확률 상위 10~20곳 찍기 | **바꾸자** → 최고 1곳 2번 + 확인 + 실패면 자세 다시 | 3-2·0장 3번: 흉부 위 구멍은 1~2개뿐 → 나머지는 흉부 밖 점(마리당 약 4.6개). 시간도 10~20곳 × (이동 + 찍기) |
| 최적 경로 | 후보가 1~3곳이라 효과 작음 → **바닥 오르는 동안 마커를 흉부 쪽으로 미리 이동**(약 13 s 절약)이 더 큼 | 3-4 |

더 빠르고 신뢰성 높게 하는 방법 (우선순위):
1. **격자·팁**: 틈 3.5 mm(얇은 살 또는 슬롯) + 팁 약 1 mm. 팁을 못 바꾸면 **격자 윗면을 팁 원뿔 각도로 모따기**(아래 면은 그대로 받침) → 원뿔 팁이 더 깊이 들어가 '가는 팁'과 같은 효과 [가능성 높음 — 시험 조각에 추가 가능]
2. **비전 σ 줄이기**: 키포인트 모델 + 격자 자 보정 + 누른 뒤 사진 2~3장 평균
3. **자세**: 위 어둡게 / 아래 밝게 → 누른 뒤 위 조명 짧게 켜고 촬영
4. **속도**: NEMA17(+ 드라이버) X·Y·바닥 → 재시도가 싸져서 95 %에 필요한 시도를 시간 안에
5. **찍기 직전 확인**: 플래너 확률이 기준(0.5~0.8) 미만이면 찍지 않고 자세 다시 → 오마킹 줄임

## 6. 제어부 구성 (보유 부품 우선)

### 6-1. 역할 나누기
```
                    ┌──────────── Raspberry Pi 5 (보유) + AI HAT+ (보유) + AI 카메라 (보유) + 액티브 쿨러 + 27 W (구매함)
                    │  AI 4가지, 플래너(찍을 점·경로), 상태 머신, 로그, 원격 확인
       USB 시리얼 ──┼───────────────┐
                    ▼               ▼
   UNO 1 '움직임' (보유)        UNO 2 '문·센서' (보유)            UNO 3 (보유) 예비 / 시험대
   X·Y·바닥 스테핑               문 서보 3 (112·170·176)
   펜 서보 205                   빛 차단 게이트 (A0~A5, 최대 6)
   하중 센서 HX711 (바닥 누르기) 조명 켜고 끄기 (릴레이, 보유)
   원점 스위치 3                 입구 게이트 → 입구 문 바로 닫기 (Pi 안 거침)
   PATH 실행 (가감속)            두 마리 감지 → 이벤트
```
- **왜 이렇게**: 시간에 민감한 일(펄스, 하중 정지, 문 닫기)은 아두이노가 혼자 처리 → Pi(리눅스)가 AI로 바빠도 흔들리지 않음. Pi ↔ 아두이노 명령은 짧은 줄 몇 개 (지연 수 ms)
- 승준 10/28 "Pi 5가 모터를 직접" 안 대비: Pi GPIO로 스테핑을 돌리면 AI 추론 중 펄스가 끊겨 걸음을 빠뜨릴 수 있음 [가능성 높음] → 아두이노에 맡기는 게 안전

### 6-2. 핀 (UNO 1, 지금 모터 그대로일 때)
| 핀 | 연결 |
|---|---|
| D2~D5 / D6~D9 / D10~D13 | 바닥 F / 마커 X / 마커 Y — 28BYJ-48 + ULN2003 |
| A0 | 펜 서보 205 |
| A1·A2 | HX711 DT·SCK |
| A3·A4·A5 | 원점 스위치 F·X·Y (내부 풀업) |
- 원점 스위치: 서현 3차 값(인터페이스)의 1안은 Pi GPIO → 여기서는 **UNO 1에 직접** 제안 (원점 찾기 중 스위치가 눌리면 아두이노가 그 펄스에서 바로 멈춤, Pi 지연 없음). 문 서보 3개는 UNO 2로 옮겨 핀을 비움

→ 18핀 꽉 참. **NEMA17 + 스텝·방향 드라이버로 바꾸면** 축당 2핀(STEP·DIR) + EN 공통 1 → 7핀으로 줄어 여유

UNO 2: D9·D10·D11 문 서보, A0~A5 포토레지스터 게이트(분압), D2~D4 릴레이(위 조명·아래 조명·예비)

### 6-3. 펌웨어 (지금 `control/firmware/trap_controller/`를 나눔 — 다음 작업)
- UNO 1: 지금 명령 + `HOME`(원점 찾기) + `PATH n x1 y1 … d`(점 목록을 가감속으로 돌며 각 점에서 d번 찍기) + 바닥 비례 누르기
- UNO 2: `DOOR`, `LIGHT TOP/BOTTOM ON/OFF`, 게이트 이벤트 `EVT GATE IN 1 <ms>`, 입구 자동 닫힘
- 시뮬레이션(`control/firmware/sim/`)으로 먼저 확인

### 6-4. 속도 선택지
| 안 | 부품 | 속도 (X·Y) | 장점 | 단점 |
|---|---|---|---|---|
| ① 지금 | 28BYJ-48 + ULN2003 (보유 1, 구매 2) | 2 mm/s | 싸고 있음 | 재시도가 비쌈 → 95 %를 시간 안에 못 함 |
| ② 개조 | 28BYJ-48을 **양극(바이폴라)으로 개조**(기판 선 하나 끊기) + A4988/DRV8825 + 12 V | 약 2~4배 [가능성 높음 — 실측 필요] | 모터 그대로 | 손이 감, 여전히 느림 |
| ③ 교체 | **NEMA17 + TMC2209(또는 A4988)**, 12 V 전원 | 수십 mm/s (계산 80 mm/s) | 빠르고 조용, 핀 적음 | 모터·드라이버·12 V 전원 구매, **모터 무게(약 0.3 kg)·크기(42 mm)** → 서현 S4 M2·M6·프레임 다시 |
→ **추천: ③ (최소 X·Y, 가능하면 바닥도)**. 서현 D6 "모터는 28BYJ-48 유지"는 토크 기준으로는 맞지만, 신뢰성(재시도)·시간 기준으로 다시 보자는 제안

## 7. 부족한 것 (사야 할 것 — 가격은 주문 때 확인, 정산 규칙: 국내·재료만)
| 품목 | 수량 | 용도 | 필수 |
|---|---|---|---|
| 마이크로 스위치 (원점) | 3 | F·X·Y 원점 (D6 9장과 같음) | 필수 |
| 5 V 3 A 어댑터 | 1 | 서보·센서 (D6 9장) | 필수 |
| (③ 선택 시) NEMA17 + TMC2209 또는 A4988 | 2~3 | X·Y(·바닥) | 강력 추천 |
| (③ 선택 시) 12 V 2~3 A 어댑터 | 1 | 스테핑 | 같이 |
| 적외선 빔 센서 또는 LED + 포토레지스터 추가 | 3~6 | 통로 게이트 (보유 포토레지스터 3으로 시작) | 추천 |
| 아래 조명 LED(흰색 또는 근적외선) + 반투명 바닥판 | 1 | 등 위 자세 유도 | 추천 (행동 시험 후) |
| 가는 팁(약 1 mm) 수성 마커 | 1~2 | 팁 크기 비교 (샤피 불렛 실측 후) — 제품은 아직 안 찾음 [추측] | 시험 후 |
| 로드셀 + HX711 | 1 | 바닥 누르기 (D6) | 필수 (구매 목록 C) |
→ `purchase/2026-10-28_구매목록_총정리.md` G장에 반영함. 지금까지 쓴 돈 110,240원 / 50만 원 (`purchase/구매장부.md`)

## 8. 서현에게 — 설계 변경 제안 요약 (결정은 서현)
1. **격자** g_h 3.0 → **3.5 mm**, 살 0.8~1.0 mm (사각 피치 4.3 또는 슬롯 피치 4.5), 윗면 모따기 검토 → 시험 조각 STL 4종 `control/proposals/stl/` (A 지금 / B 사각 3.5 / C 슬롯 3.0 / D 슬롯 3.5)
2. **조명 182**: 위 링 조명은 촬영 때만, 진입·누르기 동안 위 어둡게 / 바닥 쪽 밝게 (바닥 반투명 판)
3. **구동**: X·Y(·바닥) NEMA17 검토 (재시도 비용) — S4 M2·M6 무게 다시
4. **마커 대기 자리**: 바닥 오르는 동안 흉부 영역 가장자리로 미리 이동 (카메라 시야 밖 유지)
5. **요구사항 추가 제안**: 오마킹(흉부 밖 점) ≤ 5 %, 여왕벌 놓침 ≤ 1 % (애매하면 격리)
6. **R6 3분**: 재시도 포함 시간 → 빠른 구동이 아니면 R6 재검토

## 9. 다음 (승준)
- J9 마커 실측 (팁이 1.5 mm 깊이에서 지름 몇 mm인지가 신뢰성의 핵심 값)
- 시험 조각 A~D 프린트 (Craft-Lab) → 팁 통과, 표본 눌러 보기
- J8 흉부 키포인트: 표본 7마리 사진 → 라벨 → 오차 σ 실측 → `reliability_mc.py` 범위 갱신
- 펌웨어 둘로 나누기 (UNO 1·2), PATH·HOME
- 살아 있는 말벌 행동 촬영 (가능하면 이번 주)
