britams/-capstone-project-repo/docs/2026-10-28_승준_작업지시.md

# 승준(과 승준의 Claude) 작업 지시 — 2026-10-28

작성: 이서현 (Claude와 정리, CAP-AI-10) · 대상: 이승준, 승준의 Claude
목적: 서현과 승준이 **병렬로** 일하기 위해, 승준 쪽이 지금부터 할 일과 서현 쪽이 하는 일을 한 장에 정리한다.
이 파일은 서현이 관리한다. 바꿀 게 있으면 Issue로 알려 준다.

---

## ★★ 10/28 밤 갱신 — D6 설계 변수표·S4 역학계산 결과 (서현, CAP-AI-18) ← 승준의 Claude는 여기부터

읽을 것: `design/2026-10-28_D6_설계변수표.md` (특히 0·5·8·9장), `design/2026-10-28_S4_역학계산_1차.md`, `design/인터페이스_정의서.md` 3차, D5 11장

**바뀐 것 / 승준 쪽에 영향**
- 모터는 **28BYJ-48 그대로** (토크 안전율: 바닥 19.6, X·Y 560 이상 — 단 사양서 토크는 약 1.8 rpm 값, S4 r2). 문제는 속도·시간 — **R6 3분은 잉크 건조(= 급이) 시간이 정함: 급이 ≤ 약 105 s** (15 rpm, 재시도 1회 기준)
- **X·Y 안내는 직선 볼 부싱**: X LM8UU ×2, Y LM6UU ×2 (프린트 부싱은 한쪽 구동 X 빔이 끼임 — S4 M5)
- **찍는 힘은 하중 센서로 못 잰다** (S4 M3) — 펌웨어 `PRESS`는 바닥이 미는 힘(F_p 상한 0.5 N 가정, 약 51 g)만 다룸. 찍는 힘은 홀더·마커 자중 0.32 N(+ 스프링)
- 재시도 때 바닥은 **10 mm만** 내렸다 올림
- 원점(SJ-19 요청) → **1안: 마이크로 스위치 3개(X·Y·바닥 아래 끝) → Pi GPIO**, Pi가 STOP. 구동부 전원 **5 V 3 A 별도** (D6 9장, 잠정)
- 마커 = 샤피 크리에이티브 **노랑** (D5 11장 반영). 노랑 다리·배띠와 헷갈림 → 흉부 ROI 안에서만 찾기 (승준 SJ-20 판단과 같음)

**다음 할 일 (승준, 순서대로)**
1. **J9 (신설) 샤피 노랑 점 시험** — 마커 도착하면: ① 검은 더미(또는 표본)에 찍고 손에 안 묻을 때까지 시간 = 건조 시간 t_dry (5회 평균) ② 주방 저울(0.1 g) 위 더미에 마커를 세워 살짝 대며 점이 생기는 최소 무게 = F_ink ③ 같은 자리 1·2·3회 찍기 점 크기·진하기 사진 ④ 붓으로 10회 문지른 뒤·24시간 뒤 남는지. → 결과를 `vision/` 기록 + 인터페이스 정의서. **t_dry가 105 s를 넘으면 서현에게 바로 알림** (R6 재검토)
2. **J6 실물** — 28BYJ-48 최대 rpm(탈조 없이) — **T8 나사에 바닥 무게 + 0.5 N(합계 약 0.9 N = 92 g)을 올린 채로 10·15 rpm에서 탈조 없는지** (S4 r2: 사양서 토크 34.3 mN·m는 약 1.8 rpm 값이라 15 rpm 토크는 모름), 전원 끈 상태에서 T8 나사에 0.9 N(약 92 g)을 올려도 안 내려가는지(역구동), MG90S/SG90 2위치
3. J8 흉부 좌표 (사진 생기면), J3 카메라 200 mm (어댑터 도착 후)
4. **J7 구매 목록 C 갱신** (D6 확정분 — 수량은 1대 기준, 대수는 서현 결정 대기): LM8UU 2, LM6UU 2, T8 리드 8 나사 + 황동 너트 3세트(바닥 약 100 mm, X 약 100 mm, Y 약 150 mm → 자르거나 근접 규격), 커플링 5→8 3, Ø8 연마봉 약 155 mm 2, Ø6 연마봉 약 105 mm 2, 마이크로 스위치 3, 5 V 3 A 어댑터 1, 로드셀 1 kg 이하 + HX711, 28BYJ-48 + ULN2003 2 (보유 1 + 2), SG90 1 + MG90S 3. 해외구매 불가 규칙 확인

## ★ 10/28 저녁 갱신 — 지금 상태와 다음 할 일 (서현, CAP-AI-17) ← 승준의 Claude는 여기부터

**바뀐 것 (D5 4차 = 현재 기준, `design/2026-10-28_D5_개념설계_안1.md` 10장)**
- 마커가 1자유도 → **X·Y·Z** (안 B). 카메라가 찾은 **흉부 좌표**로 마커가 옮겨 가서 찍는다 → 비전이 좌표를 줘야 함 (J8)
- **카메라는 격자 위 200 mm** (AI 카메라 초점 20 cm~, 제조사 사양). 그래서 흉부 폭(0.1 mm 차이)으로 여왕벌을 가르는 J5는 어려워짐 [가능성 높음] → 보류
- 구동기 **7개** (스테핑 3: 바닥·X·Y / 서보 4: 문 3 + 펜 들기). 마커는 퍼마페이크·샤피 (POSCA 뺌). 인터페이스 정의서 2차

**J 상태**
| J | 상태 |
|---|---|
| J1 VespAI 예시 실행 | 완료 (SJ-04) |
| J2 보유품 점검 | 완료 (SJ-10) — 28BYJ-48·ULN2003 각 1, MG90S 1 |
| J7 구매 목록 | 총정리 완료 (SJ-11) → 아래 1번으로 주문 |
| J3·J4·J6·J8 | 남음 |
| J5 흉부 폭 측정 | **보류** (200 mm 해상도로는 어려움 — J3 결과 보고 다시 정함) |

**다음 할 일 (순서대로)**
1. **J7 주문 — 지금 살 것만**: Pi 5 전원 어댑터 27W, 액티브 쿨러, 마커 2종 직구(퍼마페이크·샤피 흰색 각 2~3, 배송이 오래 걸리니 먼저). **캘리퍼스는 사지 않음** (서현이 빌림). 모터·봉·나사 같은 기구 품목은 D6(서현) 뒤로. 수량(1대/2대)은 서현 결정 대기 — 정해지면 작업지시에 적음
2. **J6 먼저 — 28BYJ-48 속도 측정** (보유 1개 + ULN2003 + UNO): 최대 rpm과, 손으로 살짝 부하를 줬을 때 탈조 없이 도는 rpm. **이 값이 D6의 'R6 3분 안에 되나' 계산에 바로 들어감** → 인터페이스 정의서에 rpm 기록. 이어서 MG90S 1개 2위치 동작, Pi ↔ 아두이노 명령 초안
3. **J8 흉부 좌표 찾기** (PC에서 시작 가능, Pi 불필요): 말벌 위에서 찍은 사진·더미로 ① 등이 위인지 ② 흉부 중심 (x, y) mm. 좌표계·정확도(±1 mm)는 인터페이스 정의서. VespAI는 상자만 주므로 새로 만듦 (색·모양 규칙 또는 키포인트 모델 중 승준 판단)
4. **J4 점 검출** — J8과 같은 사진으로 흰 점 검출 (R5 90 %)
5. **J3 카메라 200 mm 시험** — 전원 어댑터 도착 후. 결과(mm당 화소, 1 mm 흰 점 보이는지, 더 가까이 초점 가능한지)로 카메라를 AI 카메라로 둘지 정함

**서현이 하는 것 (승준이 기다리는 것)**: D6 설계 변수표 — 구동기별 힘·행정·**속도**, R6 시간 예산 → 모터를 28BYJ-48로 둘지 NEMA17 등으로 바꿀지 → 인터페이스 정의서 (11/5 목표). 그 뒤 S4 역학계산

---

## 0. 승준의 Claude에게 — 상황 설명

- 팀은 상용 말벌 트랩 「야생 말벌 포획기」에 얹는 **추가 모듈**을 만든다. 개발 원칙은 **"대량 처리보다 한 마리를 목적대로 제대로"**.
- 설계는 D0~D3을 끝냈고 **안 1 바닥 승강형**으로 정했다 (`design/2026-10-28_D3_형태분석표와_조합안.md`).
  - 말벌이 마킹실에 들어오면 → 카메라로 판별 → 승강 바닥이 말벌 등을 위 격자망에 살짝 붙임 → 격자 눈 사이로 마커를 내려 흉부에 점 → 먹이 → 방생
  - 여왕벌·다른 종·판별 불확실·두 마리 동시 진입·방제 모드는 상용 포획통으로 올려 보내 격리
- 구성요소·도면부호·작동 순서: `design/2026-10-28_D5_개념설계_안1.md` ← **먼저 읽을 것**
- 승준이 SJ-02에서 올린 Issue #1(인수인계 VespAI 정정)은 반영하고 닫았다.
- SJ-02의 질문 "여왕벌 판별을 카메라로 하나 기구로 하나"에 대한 서현 쪽 답 후보: **카메라.** 말벌이 격자망에 붙으면 거리가 일정하고 격자 눈이 자가 되므로 흉부 폭을 사진으로 잴 수 있다 (D5 환류 1). 이게 되는지 확인하는 게 아래 J3·J5다.

## 1. 서현의 Claude가 지금 하는 일

| 순서 | 일 | 산출물 | 승준에게 넘어가는 것 |
|---|---|---|---|
| 1 | D5 개념설계도 — FreeCAD로 도 1(전체 측단면)·도 2(자세 고정·마킹 상태) | `cad/*.py`, 도면 PDF | 마킹실·카메라 자리 개략 |
| 2 | 상용 트랩 실측 → 결합부 치수 | `design/` | 모듈 전체 크기 |
| 3 | D6 설계 변수표 (격자 눈, 마킹실 크기, 바닥 행정·힘 상한, 마커 행정, 입구 지름) | `design/*_D6_*.md` | **구동기 사양 (힘·행정·속도) → 승준 J6·J7** |
| 4 | S4 역학계산 (수업 양식) | `design/` | — |

## 2. 승준이 할 일 (순서대로)

| 번호 | 일 | 산출물 (승준 담당 폴더) | 끝난 기준 | 기한 |
|---|---|---|---|---|
| J1 | **VespAI 1단계** — 승준 PC에서 예시 이미지 실행 (SJ-02 실행계획 4-1 그대로) | `vision/` 실행 기록 | 종별 검출 수가 원 결과와 같은지, 장당 추론 시간 | 10/30 |
| J2 | **보유품 실물 점검** — Pi 5 전원(27W)·microSD·Pi 5용 카메라 케이블·서보·스테핑 모터 개수, 모르는 봉지 | `inventory/` 활용계획 갱신 | 없는 것 목록 → J7 | 10/30 |
| J3 | **Pi 5 + AI 카메라 촬영 시험** — **10/28 갱신: AI 카메라 초점 범위는 20 cm~무한대(제조사 사양) → D5 4차는 격자 위 200 mm.** 모눈종이·자·검은 더미를 200 mm에 놓고 초점·mm당 화소 수(계산값 약 15.6)·흰 점 1 mm가 보이는지. 렌즈를 더 돌려 더 가까이 맞출 수 있는지도 확인 | `vision/` 시험 기록 + **인터페이스 정의서 카메라 행** | 카메라–대상 거리, 시야(mm×mm), mm당 화소 수 | 11/3 |
| J4 | **흉부 점 검출** — 검은 물체에 흰·노랑 마커 점 → 색 임계값으로 검출하는 스크립트 (재포획 인식 목표 R5 90%) | `vision/scripts/` | 더미 20장 이상에서 검출률 | 11/6 |
| J5 | **흉부 폭 측정 초안** — 사진에서 격자 눈을 기준으로 폭 재기 (표본 오기 전 더미로) | `vision/` | 더미 측정 오차 (목표 ±0.05 mm [추측]) | 11/7 |
| J6 | **아두이노 구동 시험** — SG90 서보(문 3 + 펜 들기 1), 28BYJ-48 스테핑(바닥 승강 + **마커 X·Y**) 동작·속도(mm/s), Pi ↔ 아두이노 시리얼 명령 초안 (구동기 7개, 인터페이스 정의서 2차) | `control/` | 각 구동기 동작 영상·코드, 명령 목록 | 11/7 |
| J7 | **BOM 초안·예산 장부** — D5 도면부호 기준 품목, 2대 기준 | `purchase/` | 품목·사양·가격·링크·수량, 60만 원 대비 합계 | 11/7 |
| J8 | **흉부 좌표 찾기 (안 B, 10/28 추가)** — 격자에 눌린 말벌(우선 더미·사진) 위 사진에서 ① 등이 위인지 ② 흉부 중심 (x, y) mm (좌표계는 인터페이스 정의서). VespAI는 상자만 주므로 새로 만듦 (색·모양 또는 키포인트 모델) | `vision/scripts/` | 더미에서 좌표 오차 ±1 mm 이내 비율 | 11/7 |
| — | **표본 채집 (서현과 같이)** — 상용 트랩 설치 장소 / 최문보 교수님 / 양봉농가 | — | 11월 전 | 이번 주 |

J7 품목 후보 (D5 기준, 사양은 D6 이후 확정) — **10/28 추가: 알루미늄 프로파일 2020 + 코너 브래킷·T너트 (프레임, 바닥에 섬 — `design/2026-10-28_D5_개념설계_안1.md` 7장), 디지털 버니어 캘리퍼스 (결합부 측정용, 우선 구매)**: 적외선 빔 센서(114), 하중 센서 + HX711(148), 금속 기어 서보(112·170), 소형 리드스크루·스테핑(150·164), 촬영 조명 LED(182), 미끄러운 플라스틱 판 PTFE·POM·HDPE 중(120), 투명 아크릴, 마커(201) — **10/28 재선정(서현 '흔들기·펌핑 없는 것', CAP-AI-16): 사쿠라 퍼마페이크(Permapaque) Fine 흰색 1.0 mm 2~3개 + 비교용 샤피 크리에이티브 마커 불렛 흰색 2~3개 (둘 다 해외 직구, 시험 후 하나로)**, 링크는 `design/2026-10-28_D5_개념설계_안1.md` 10-5 (POSCA는 뺌). **안 B XYZ 추가 품목: 28BYJ-48 + ULN2003 2개, T8 리드스크루(약 100·130 mm) + 너트 2개, 커플링 5→8 2개, Ø8 봉 약 155 mm 2개, Ø6 봉 약 106 mm 2개, SG90 1개(펜 들기), 실리콘 캡 컵, 2020 프로파일 갠트리 단(둘레 4 + 받침 1)**, 스프링(146·162), Pi 5 전원·microSD(J2 결과에 따라).

## 3. 서로 기다리는 것 (인터페이스)

| 누가 → 누구 | 무엇 | 언제 | 어디 |
|---|---|---|---|
| 승준 → 서현 | 카메라 거리·시야·해상도 (J3) | 11/3 | `design/인터페이스_정의서.md` |
| 승준 → 서현 | 전장품 크기 (Pi 5 + AI HAT+ + 아두이노 + 전원) | 11/3 | 인터페이스 정의서 |
| 서현 → 승준 | 구동기별 필요한 힘·행정·속도 (D6) | 11/5 [추측] | 인터페이스 정의서 |
| 서현 → 승준 | 마킹실 크기, 카메라 장착 위치 (D5 도면) | 11/3 | `cad/`, `design/` |

## 4. 규칙 (요약 — 전체는 `CLAUDE.md`)
- 승준이 고치는 곳: `vision/`, `control/`, `purchase/`, `inventory/`, `ai-log/AI_명령사항_로그_승준.md`, 그리고 공동인 `design/인터페이스_정의서.md`(변경 이력 필수).
- 서현 담당 파일(`design/`의 나머지, `cad/`, `docs/`)은 고치지 말고 Issue로.
- 작업 전 `git pull`, 끝나면 로그 항목 추가 → commit·push. 커밋 메시지는 `[승준] …`.

## 5. 승준이 새 채팅에 붙여 넣을 말
> 레포 britams/-capstone-project-repo 를 연결해서 `CLAUDE.md` 규칙대로 시작해 줘. 나는 이승준이야. pull 하고 `docs/2026-10-28_승준_작업지시.md`의 **★★ 10/28 밤 갱신**을 읽은 뒤 '다음 할 일' 1번부터 진행해. 끝나면 내 로그에 기록하고 push 해.
