britams/-capstone-project-repo/design/circuit/out/harness.csv

id | harness | wire | color | awg | frm | frm_pin | frm_conn | to | to_pin | to_conn | route_mm | cut_mm | stock_mm | moving | drop_V
P01 | 어댑터 DC 잭 → 퓨즈 | +5V 들어옴 | 빨강 | 20 | DCIN | 잭 + | DC 잭 단자 납땜/나사 | FUSE | 퓨즈 1 | 퓨즈홀더 납땜 | 145 | 160 | 0 | False | 0.024
P02 | 어댑터 DC 잭 GND → 와고 GND | GND | 검정 | 20 | DCIN | 잭 − | DC 잭 단자 납땜/나사 | WAGO | 와고 GND 1번 | 와고 221-415 (선 끝 8 mm 벗김) | 330 | 370 | 0 | False | 0.055
P03 | 퓨즈 → 비상 정지 | +5V 퓨즈 뒤 | 빨강 | 20 | FUSE | 퓨즈 2 | 퓨즈홀더 납땜 | ESTOP | 비상 정지 NC 1 | 비상 정지 나사 단자 | 103 | 120 | 0 | False | 0.017
P04 | 비상 정지 → 와고 +5V | +5V_B | 빨강 | 20 | ESTOP | NC 2 | 비상 정지 나사 단자 | WAGO | 와고 +5V 1번 | 와고 221-415 (선 끝 8 mm 벗김) | 372 | 410 | 0 | False | 0.062
P05 | 와고 → DRV8833 F | +5V_B | 빨강 | 22 | WAGO | 와고 +5V | 와고 221-415 (선 끝 8 mm 벗김) | ULN_F | DRV VM | 듀폰 암 (ULN 전원 핀) | 156 | 180 | 0 | False | 0.003
P05 | 와고 → DRV8833 F | GND | 검정 | 22 | WAGO | 와고 GND | 와고 221-415 (선 끝 8 mm 벗김) | ULN_F | DRV GND | 듀폰 암 (ULN 전원 핀) | 156 | 180 | 0 | False | 0.003
P06 | 와고 → ULN2003 X | +5V_B | 빨강 | 22 | WAGO | 와고 +5V | 와고 221-415 (선 끝 8 mm 벗김) | ULN_X | ULN + | 듀폰 암 (ULN 전원 핀) | 635 | 700 | 0 | False | 0.011
P06 | 와고 → ULN2003 X | GND | 검정 | 22 | WAGO | 와고 GND | 와고 221-415 (선 끝 8 mm 벗김) | ULN_X | ULN − | 듀폰 암 (ULN 전원 핀) | 635 | 700 | 0 | False | 0.011
P07 | 와고 → ULN2003 Y | +5V_B | 빨강 | 22 | WAGO | 와고 +5V | 와고 221-415 (선 끝 8 mm 벗김) | ULN_Y | ULN + | 듀폰 암 (ULN 전원 핀) | 697 | 770 | 0 | False | 0.012
P07 | 와고 → ULN2003 Y | GND | 검정 | 22 | WAGO | 와고 GND | 와고 221-415 (선 끝 8 mm 벗김) | ULN_Y | ULN − | 듀폰 암 (ULN 전원 핀) | 697 | 770 | 0 | False | 0.012
P08 | 와고 → 서보 허브 | +5V_B | 빨강 | 20 | WAGO | 와고 +5V | 와고 221-415 (선 끝 8 mm 벗김) | SERVO_HUB | 허브 + | 허브 기판 납땜 | 229 | 260 | 0 | False | 0.031
P08 | 와고 → 서보 허브 | GND | 검정 | 20 | WAGO | 와고 GND | 와고 221-415 (선 끝 8 mm 벗김) | SERVO_HUB | 허브 − | 허브 기판 납땜 | 229 | 260 | 0 | False | 0.031
P09 | 와고 → 게이트 허브 | +5V_B | 빨강 | 22 | WAGO | 와고 +5V | 와고 221-415 (선 끝 8 mm 벗김) | GATE_HUB | 허브 + | 허브 기판 납땜 | 250 | 280 | 0 | False | 0.011
P09 | 와고 → 게이트 허브 | GND | 검정 | 22 | WAGO | 와고 GND | 와고 221-415 (선 끝 8 mm 벗김) | GATE_HUB | 허브 − | 허브 기판 납땜 | 250 | 280 | 0 | False | 0.011
P10 | 와고 → MOSFET 보드 (조명·펌프 전원) | +5V_B | 빨강 | 22 | WAGO | 와고 +5V | 와고 221-415 (선 끝 8 mm 벗김) | MOSFET | 보드 V+ | 보드 나사 단자 | 310 | 350 | 0 | False | 0.033
P10 | 와고 → MOSFET 보드 (조명·펌프 전원) | GND | 검정 | 22 | WAGO | 와고 GND | 와고 221-415 (선 끝 8 mm 벗김) | MOSFET | 보드 GND | 보드 나사 단자 | 310 | 350 | 0 | False | 0.033
P11 | UNO 1·2 GND → 와고 GND | GND U1 | 검정 | 22 | UNO1 | UNO 1 GND | 듀폰 암 1핀 (UNO 헤더) | WAGO | 와고 GND | 와고 221-415 (선 끝 8 mm 벗김) | 191 | 210 | 0 | False | 0.002
P11 | UNO 1·2 GND → 와고 GND | GND U2 | 검정 | 22 | UNO1 | UNO 2 GND | 듀폰 암 1핀 (UNO 헤더) | WAGO | 와고 GND | 와고 221-415 (선 끝 8 mm 벗김) | 191 | 210 | 0 | False | 0.002
P12 | 레일 감지 (+5V_B → 10 kΩ → UNO 2 D2) | RAIL | 주황 | 28 | GATE_HUB | 허브 10 kΩ 끝 | 허브 기판 납땜 | UNO2 | UNO 2 D2 | 듀폰 암 1핀 (UNO 헤더) | 139 | 160 | 0 | False
S01 | UNO 1 → DRV8833 F (AIN1·AIN2·BIN1·BIN2) | IN1 | 파랑 | 26 | UNO1 | D2 | 듀폰 암 1핀 (UNO 헤더) | ULN_F | AIN1 | 듀폰 암 (ULN IN 핀) | 246 | 280 | 0 | False
S01 | UNO 1 → DRV8833 F (AIN1·AIN2·BIN1·BIN2) | IN2 | 초록 | 26 | UNO1 | D3 | 듀폰 암 1핀 (UNO 헤더) | ULN_F | AIN2 | 듀폰 암 (ULN IN 핀) | 246 | 280 | 0 | False
S01 | UNO 1 → DRV8833 F (AIN1·AIN2·BIN1·BIN2) | IN3 | 노랑 | 26 | UNO1 | D4 | 듀폰 암 1핀 (UNO 헤더) | ULN_F | BIN1 | 듀폰 암 (ULN IN 핀) | 246 | 280 | 0 | False
S01 | UNO 1 → DRV8833 F (AIN1·AIN2·BIN1·BIN2) | IN4 | 주황 | 26 | UNO1 | D5 | 듀폰 암 1핀 (UNO 헤더) | ULN_F | BIN2 | 듀폰 암 (ULN IN 핀) | 246 | 280 | 0 | False
S02 | UNO 1 → ULN2003 X (IN1~4) | IN1 | 파랑 | 26 | UNO1 | D6 | 듀폰 암 1핀 (UNO 헤더) | ULN_X | IN1 | 듀폰 암 (ULN IN 핀) | 718 | 790 | 0 | False
S02 | UNO 1 → ULN2003 X (IN1~4) | IN2 | 초록 | 26 | UNO1 | D7 | 듀폰 암 1핀 (UNO 헤더) | ULN_X | IN2 | 듀폰 암 (ULN IN 핀) | 718 | 790 | 0 | False
S02 | UNO 1 → ULN2003 X (IN1~4) | IN3 | 노랑 | 26 | UNO1 | D8 | 듀폰 암 1핀 (UNO 헤더) | ULN_X | IN3 | 듀폰 암 (ULN IN 핀) | 718 | 790 | 0 | False
S02 | UNO 1 → ULN2003 X (IN1~4) | IN4 | 주황 | 26 | UNO1 | D9 | 듀폰 암 1핀 (UNO 헤더) | ULN_X | IN4 | 듀폰 암 (ULN IN 핀) | 718 | 790 | 0 | False
S03 | UNO 1 → ULN2003 Y (IN1~4) | IN1 | 파랑 | 26 | UNO1 | D10 | 듀폰 암 1핀 (UNO 헤더) | ULN_Y | IN1 | 듀폰 암 (ULN IN 핀) | 780 | 860 | 0 | False
S03 | UNO 1 → ULN2003 Y (IN1~4) | IN2 | 초록 | 26 | UNO1 | D11 | 듀폰 암 1핀 (UNO 헤더) | ULN_Y | IN2 | 듀폰 암 (ULN IN 핀) | 780 | 860 | 0 | False
S03 | UNO 1 → ULN2003 Y (IN1~4) | IN3 | 노랑 | 26 | UNO1 | D12 | 듀폰 암 1핀 (UNO 헤더) | ULN_Y | IN3 | 듀폰 암 (ULN IN 핀) | 780 | 860 | 0 | False
S03 | UNO 1 → ULN2003 Y (IN1~4) | IN4 | 주황 | 26 | UNO1 | D13 | 듀폰 암 1핀 (UNO 헤더) | ULN_Y | IN4 | 듀폰 암 (ULN IN 핀) | 780 | 860 | 0 | False
M01 | DRV8833 F → 바닥 리니어 모듈 | 모터 4선 (모듈에 달린 선) | 빨강·흰·갈색·검정 | 28 | ULN_F | DRV AOUT1·2 BOUT1·2 | JST-XH 5핀 (모터 기본) | M_F | 모터 A A− B B− | 모터 (기본) | 113 | 0 | 240 | False | 0.008
M02 | ULN2003 X → X 모터 215 | 모터 5선 | 파랑·분홍·노랑·주황·빨강 | 26 | ULN_X | ULN JST-XH 5 | JST-XH 5핀 | M_X | 모터 | 모터 (기본) | 196 | 0 | 240 | False | 0.009
M03 | ULN2003 Y → Y 모터 209 (X로 움직임) | 모터 5선 | 파랑·분홍·노랑·주황·빨강 | 26 | ULN_Y | ULN JST-XH 5 | JST-XH 5핀 | M_Y | 모터 | 모터 (기본) | 398 | 180 | 240 | True | 0.017
V01 | 서보 허브 → 펜 서보 SG90 205 (X·Y로 움직임) | 서보 3선 | 갈색 GND·빨강 +5V·주황 신호 | 26 | SERVO_HUB | 허브 헤더 S1 | 듀폰 2.54 헤더 (허브 기판) | PEN | 서보 | 서보 3핀 (기본) | 704 | 500 | 250 | True | 0.123
S04 | UNO 1 A0 → 서보 허브 S1 신호 | PEN 신호 | 주황 | 26 | UNO1 | A0 | 듀폰 암 1핀 (UNO 헤더) | SERVO_HUB | 허브 S1 신호 | 허브 기판 납땜 | 312 | 350 | 0 | False
S05 | UNO 1 → 누름 스위치 PSW (바닥과 함께 움직임, NC) | PSW | 흰색 | 28 | UNO1 | A1 | 듀폰 암 1핀 (UNO 헤더) | PSW | NC | 스위치 다리 납땜 + 수축튜브 | 460 | 510 | 0 | True
S05 | UNO 1 → 누름 스위치 PSW (바닥과 함께 움직임, NC) | GND | 검정 | 28 | UNO1 | GND | 듀폰 암 1핀 (UNO 헤더) | PSW | COM | 스위치 다리 납땜 + 수축튜브 | 460 | 510 | 0 | True
S06 | UNO 1 → 원점 F | HOME_F | 노랑 | 28 | UNO1 | A3 | 듀폰 암 1핀 (UNO 헤더) | SW_F | 스위치 NO | 스위치 납땜 + 100 nF | 344 | 380 | 0 | False
S06 | UNO 1 → 원점 F | GND | 검정 | 28 | UNO1 | GND | 듀폰 암 1핀 (UNO 헤더) | SW_F | 스위치 COM | 스위치 납땜 + 100 nF | 344 | 380 | 0 | False
S07 | UNO 1 → 원점 X | HOME_X | 노랑 | 28 | UNO1 | A4 | 듀폰 암 1핀 (UNO 헤더) | SW_X | 스위치 NO | 스위치 납땜 + 100 nF | 574 | 640 | 0 | False
S07 | UNO 1 → 원점 X | GND | 검정 | 28 | UNO1 | GND | 듀폰 암 1핀 (UNO 헤더) | SW_X | 스위치 COM | 스위치 납땜 + 100 nF | 574 | 640 | 0 | False
S08 | UNO 1 → 원점 Y (빔과 함께 움직임) | HOME_Y | 노랑 | 28 | UNO1 | A5 | 듀폰 암 1핀 (UNO 헤더) | SW_Y | 스위치 NO | 스위치 납땜 + 100 nF | 657 | 730 | 0 | True
S08 | UNO 1 → 원점 Y (빔과 함께 움직임) | GND | 검정 | 28 | UNO1 | GND | 듀폰 암 1핀 (UNO 헤더) | SW_Y | 스위치 COM | 스위치 납땜 + 100 nF | 657 | 730 | 0 | True
V02 | 서보 허브 → 입구 문 서보 112 | 서보 3선 | 갈색·빨강·주황 | 26 | SERVO_HUB | 허브 S2 | 듀폰 2.54 헤더 (허브 기판) | D_IN | 서보 | 서보 3핀 (기본) | 356 | 120 | 250 | False | 0.072
V03 | 서보 허브 → 격리 문 서보 170 | 서보 3선 | 갈색·빨강·주황 | 26 | SERVO_HUB | 허브 S3 | 듀폰 2.54 헤더 (허브 기판) | D_CAP | 서보 | 서보 3핀 (기본) | 390 | 160 | 250 | False | 0.078
V04 | 서보 허브 → 방생 문 서보 176 | 서보 3선 | 갈색·빨강·주황 | 26 | SERVO_HUB | 허브 S4 | 듀폰 2.54 헤더 (허브 기판) | D_REL | 서보 | 서보 3핀 (기본) | 460 | 240 | 250 | False | 0.092
S09 | UNO 2 D9·D10·D11 → 서보 허브 S2~S4 신호 | DOOR_IN | 주황 | 26 | UNO2 | D9 | 듀폰 암 1핀 (UNO 헤더) | SERVO_HUB | 허브 S2 | 허브 기판 납땜 | 328 | 370 | 0 | False
S09 | UNO 2 D9·D10·D11 → 서보 허브 S2~S4 신호 | DOOR_CAP | 주황 | 26 | UNO2 | D10 | 듀폰 암 1핀 (UNO 헤더) | SERVO_HUB | 허브 S3 | 허브 기판 납땜 | 328 | 370 | 0 | False
S09 | UNO 2 D9·D10·D11 → 서보 허브 S2~S4 신호 | DOOR_REL | 주황 | 26 | UNO2 | D11 | 듀폰 암 1핀 (UNO 헤더) | SERVO_HUB | 허브 S4 | 허브 기판 납땜 | 328 | 370 | 0 | False
S10 | UNO 2 → 게이트 허브 (수신 9 + 송신 켜기 1) | G2 | 흰색 | 28 | UNO2 | A0 | 듀폰 암 1핀 (UNO 헤더) | GATE_HUB | 허브 G2 | 허브 기판 납땜 | 139 | 160 | 0 | False
S10 | UNO 2 → 게이트 허브 (수신 9 + 송신 켜기 1) | G2b | 흰색 | 28 | UNO2 | A1 | 듀폰 암 1핀 (UNO 헤더) | GATE_HUB | 허브 G2b | 허브 기판 납땜 | 139 | 160 | 0 | False
S10 | UNO 2 → 게이트 허브 (수신 9 + 송신 켜기 1) | G3 | 흰색 | 28 | UNO2 | A2 | 듀폰 암 1핀 (UNO 헤더) | GATE_HUB | 허브 G3 | 허브 기판 납땜 | 139 | 160 | 0 | False
S10 | UNO 2 → 게이트 허브 (수신 9 + 송신 켜기 1) | G3b | 흰색 | 28 | UNO2 | A3 | 듀폰 암 1핀 (UNO 헤더) | GATE_HUB | 허브 G3b | 허브 기판 납땜 | 139 | 160 | 0 | False
S10 | UNO 2 → 게이트 허브 (수신 9 + 송신 켜기 1) | G5 | 흰색 | 28 | UNO2 | A4 | 듀폰 암 1핀 (UNO 헤더) | GATE_HUB | 허브 G5 | 허브 기판 납땜 | 139 | 160 | 0 | False
S10 | UNO 2 → 게이트 허브 (수신 9 + 송신 켜기 1) | G5b | 흰색 | 28 | UNO2 | A5 | 듀폰 암 1핀 (UNO 헤더) | GATE_HUB | 허브 G5b | 허브 기판 납땜 | 139 | 160 | 0 | False
S10 | UNO 2 → 게이트 허브 (수신 9 + 송신 켜기 1) | G1 | 흰색 | 28 | UNO2 | D7 | 듀폰 암 1핀 (UNO 헤더) | GATE_HUB | 허브 G1 | 허브 기판 납땜 | 139 | 160 | 0 | False
S10 | UNO 2 → 게이트 허브 (수신 9 + 송신 켜기 1) | G4 | 흰색 | 28 | UNO2 | D8 | 듀폰 암 1핀 (UNO 헤더) | GATE_HUB | 허브 G4 | 허브 기판 납땜 | 139 | 160 | 0 | False
S10 | UNO 2 → 게이트 허브 (수신 9 + 송신 켜기 1) | G6 | 흰색 | 28 | UNO2 | D12 | 듀폰 암 1핀 (UNO 헤더) | GATE_HUB | 허브 G6 | 허브 기판 납땜 | 139 | 160 | 0 | False
S10 | UNO 2 → 게이트 허브 (수신 9 + 송신 켜기 1) | EMIT_EN | 보라 | 28 | UNO2 | D4 | 듀폰 암 1핀 (UNO 헤더) | GATE_HUB | 허브 Q4 TRIG | 허브 기판 납땜 | 139 | 160 | 0 | False
G01 | 게이트 허브 → 통로 빛 게이트 G1 (Adafruit 2167: 송신 2선 + 수신 3선) | 송신 +5V | 빨강 | 28 | GATE_HUB | 허브 TX+ | 듀폰 2.54 헤더 (허브 기판) | G1 | 송신 빨강 | 게이트 기본 선 + 연장 (납땜 + 수축튜브) | 245 | 20 | 230 | False
G01 | 게이트 허브 → 통로 빛 게이트 G1 (Adafruit 2167: 송신 2선 + 수신 3선) | 송신 GND(켜기) | 검정 | 28 | GATE_HUB | 허브 Q4 OUT− | 듀폰 2.54 헤더 (허브 기판) | G1 | 송신 검정 | 게이트 기본 선 + 연장 (납땜 + 수축튜브) | 245 | 20 | 230 | False
G01 | 게이트 허브 → 통로 빛 게이트 G1 (Adafruit 2167: 송신 2선 + 수신 3선) | 수신 +5V | 빨강 | 28 | GATE_HUB | 허브 RX+ | 듀폰 2.54 헤더 (허브 기판) | G1 | 수신 빨강 | 게이트 기본 선 + 연장 (납땜 + 수축튜브) | 245 | 20 | 230 | False
G01 | 게이트 허브 → 통로 빛 게이트 G1 (Adafruit 2167: 송신 2선 + 수신 3선) | 수신 GND | 검정 | 28 | GATE_HUB | 허브 GND | 듀폰 2.54 헤더 (허브 기판) | G1 | 수신 검정 | 게이트 기본 선 + 연장 (납땜 + 수축튜브) | 245 | 20 | 230 | False
G01 | 게이트 허브 → 통로 빛 게이트 G1 (Adafruit 2167: 송신 2선 + 수신 3선) | 수신 신호 | 흰색 | 28 | GATE_HUB | 허브 G1 (10 kΩ 풀업) | 듀폰 2.54 헤더 (허브 기판) | G1 | 수신 흰색 | 게이트 기본 선 + 연장 (납땜 + 수축튜브) | 245 | 20 | 230 | False
G02 | 게이트 허브 → 통로 빛 게이트 G4 (Adafruit 2167: 송신 2선 + 수신 3선) | 송신 +5V | 빨강 | 28 | GATE_HUB | 허브 TX+ | 듀폰 2.54 헤더 (허브 기판) | G4 | 송신 빨강 | 게이트 기본 선 + 연장 (납땜 + 수축튜브) | 599 | 410 | 230 | False
G02 | 게이트 허브 → 통로 빛 게이트 G4 (Adafruit 2167: 송신 2선 + 수신 3선) | 송신 GND(켜기) | 검정 | 28 | GATE_HUB | 허브 Q4 OUT− | 듀폰 2.54 헤더 (허브 기판) | G4 | 송신 검정 | 게이트 기본 선 + 연장 (납땜 + 수축튜브) | 599 | 410 | 230 | False
G02 | 게이트 허브 → 통로 빛 게이트 G4 (Adafruit 2167: 송신 2선 + 수신 3선) | 수신 +5V | 빨강 | 28 | GATE_HUB | 허브 RX+ | 듀폰 2.54 헤더 (허브 기판) | G4 | 수신 빨강 | 게이트 기본 선 + 연장 (납땜 + 수축튜브) | 599 | 410 | 230 | False
G02 | 게이트 허브 → 통로 빛 게이트 G4 (Adafruit 2167: 송신 2선 + 수신 3선) | 수신 GND | 검정 | 28 | GATE_HUB | 허브 GND | 듀폰 2.54 헤더 (허브 기판) | G4 | 수신 검정 | 게이트 기본 선 + 연장 (납땜 + 수축튜브) | 599 | 410 | 230 | False
G02 | 게이트 허브 → 통로 빛 게이트 G4 (Adafruit 2167: 송신 2선 + 수신 3선) | 수신 신호 | 흰색 | 28 | GATE_HUB | 허브 G4 (10 kΩ 풀업) | 듀폰 2.54 헤더 (허브 기판) | G4 | 수신 흰색 | 게이트 기본 선 + 연장 (납땜 + 수축튜브) | 599 | 410 | 230 | False
G03 | 게이트 허브 → 통로 빛 게이트 G6 (Adafruit 2167: 송신 2선 + 수신 3선) | 송신 +5V | 빨강 | 28 | GATE_HUB | 허브 TX+ | 듀폰 2.54 헤더 (허브 기판) | G6 | 송신 빨강 | 게이트 기본 선 + 연장 (납땜 + 수축튜브) | 497 | 300 | 230 | False
G03 | 게이트 허브 → 통로 빛 게이트 G6 (Adafruit 2167: 송신 2선 + 수신 3선) | 송신 GND(켜기) | 검정 | 28 | GATE_HUB | 허브 Q4 OUT− | 듀폰 2.54 헤더 (허브 기판) | G6 | 송신 검정 | 게이트 기본 선 + 연장 (납땜 + 수축튜브) | 497 | 300 | 230 | False
G03 | 게이트 허브 → 통로 빛 게이트 G6 (Adafruit 2167: 송신 2선 + 수신 3선) | 수신 +5V | 빨강 | 28 | GATE_HUB | 허브 RX+ | 듀폰 2.54 헤더 (허브 기판) | G6 | 수신 빨강 | 게이트 기본 선 + 연장 (납땜 + 수축튜브) | 497 | 300 | 230 | False
G03 | 게이트 허브 → 통로 빛 게이트 G6 (Adafruit 2167: 송신 2선 + 수신 3선) | 수신 GND | 검정 | 28 | GATE_HUB | 허브 GND | 듀폰 2.54 헤더 (허브 기판) | G6 | 수신 검정 | 게이트 기본 선 + 연장 (납땜 + 수축튜브) | 497 | 300 | 230 | False
G03 | 게이트 허브 → 통로 빛 게이트 G6 (Adafruit 2167: 송신 2선 + 수신 3선) | 수신 신호 | 흰색 | 28 | GATE_HUB | 허브 G6 (10 kΩ 풀업) | 듀폰 2.54 헤더 (허브 기판) | G6 | 수신 흰색 | 게이트 기본 선 + 연장 (납땜 + 수축튜브) | 497 | 300 | 230 | False
G04 | 게이트 허브 → 문 빔 G2 (낱개: IR LED 2선 + 포토TR 2선, 220 Ω·10 kΩ는 허브에) | LED +(220 Ω 뒤) | 빨강 | 28 | GATE_HUB | 허브 R220 끝 | 듀폰 2.54 헤더 (허브 기판) | G2 | LED 긴 다리 A | LED·포토TR 다리 납땜 + 수축튜브 | 361 | 400 | 0 | False
G04 | 게이트 허브 → 문 빔 G2 (낱개: IR LED 2선 + 포토TR 2선, 220 Ω·10 kΩ는 허브에) | LED −(켜기) | 검정 | 28 | GATE_HUB | 허브 Q4 OUT− | 듀폰 2.54 헤더 (허브 기판) | G2 | LED 짧은 다리 K | LED·포토TR 다리 납땜 + 수축튜브 | 361 | 400 | 0 | False
G04 | 게이트 허브 → 문 빔 G2 (낱개: IR LED 2선 + 포토TR 2선, 220 Ω·10 kΩ는 허브에) | 포토TR C | 빨강 | 28 | GATE_HUB | 허브 +5V | 듀폰 2.54 헤더 (허브 기판) | G2 | 포토TR 컬렉터 | LED·포토TR 다리 납땜 + 수축튜브 | 361 | 400 | 0 | False
G04 | 게이트 허브 → 문 빔 G2 (낱개: IR LED 2선 + 포토TR 2선, 220 Ω·10 kΩ는 허브에) | 포토TR E(신호) | 흰색 | 28 | GATE_HUB | 허브 G2 (10 kΩ → GND) | 듀폰 2.54 헤더 (허브 기판) | G2 | 포토TR 이미터 | LED·포토TR 다리 납땜 + 수축튜브 | 361 | 400 | 0 | False
G05 | 게이트 허브 → 문 빔 G2b (낱개: IR LED 2선 + 포토TR 2선, 220 Ω·10 kΩ는 허브에) | LED +(220 Ω 뒤) | 빨강 | 28 | GATE_HUB | 허브 R220 끝 | 듀폰 2.54 헤더 (허브 기판) | G2b | LED 긴 다리 A | LED·포토TR 다리 납땜 + 수축튜브 | 368 | 410 | 0 | False
G05 | 게이트 허브 → 문 빔 G2b (낱개: IR LED 2선 + 포토TR 2선, 220 Ω·10 kΩ는 허브에) | LED −(켜기) | 검정 | 28 | GATE_HUB | 허브 Q4 OUT− | 듀폰 2.54 헤더 (허브 기판) | G2b | LED 짧은 다리 K | LED·포토TR 다리 납땜 + 수축튜브 | 368 | 410 | 0 | False
G05 | 게이트 허브 → 문 빔 G2b (낱개: IR LED 2선 + 포토TR 2선, 220 Ω·10 kΩ는 허브에) | 포토TR C | 빨강 | 28 | GATE_HUB | 허브 +5V | 듀폰 2.54 헤더 (허브 기판) | G2b | 포토TR 컬렉터 | LED·포토TR 다리 납땜 + 수축튜브 | 368 | 410 | 0 | False
G05 | 게이트 허브 → 문 빔 G2b (낱개: IR LED 2선 + 포토TR 2선, 220 Ω·10 kΩ는 허브에) | 포토TR E(신호) | 흰색 | 28 | GATE_HUB | 허브 G2b (10 kΩ → GND) | 듀폰 2.54 헤더 (허브 기판) | G2b | 포토TR 이미터 | LED·포토TR 다리 납땜 + 수축튜브 | 368 | 410 | 0 | False
G06 | 게이트 허브 → 문 빔 G3 (낱개: IR LED 2선 + 포토TR 2선, 220 Ω·10 kΩ는 허브에) | LED +(220 Ω 뒤) | 빨강 | 28 | GATE_HUB | 허브 R220 끝 | 듀폰 2.54 헤더 (허브 기판) | G3 | LED 긴 다리 A | LED·포토TR 다리 납땜 + 수축튜브 | 402 | 450 | 0 | False
G06 | 게이트 허브 → 문 빔 G3 (낱개: IR LED 2선 + 포토TR 2선, 220 Ω·10 kΩ는 허브에) | LED −(켜기) | 검정 | 28 | GATE_HUB | 허브 Q4 OUT− | 듀폰 2.54 헤더 (허브 기판) | G3 | LED 짧은 다리 K | LED·포토TR 다리 납땜 + 수축튜브 | 402 | 450 | 0 | False
G06 | 게이트 허브 → 문 빔 G3 (낱개: IR LED 2선 + 포토TR 2선, 220 Ω·10 kΩ는 허브에) | 포토TR C | 빨강 | 28 | GATE_HUB | 허브 +5V | 듀폰 2.54 헤더 (허브 기판) | G3 | 포토TR 컬렉터 | LED·포토TR 다리 납땜 + 수축튜브 | 402 | 450 | 0 | False
G06 | 게이트 허브 → 문 빔 G3 (낱개: IR LED 2선 + 포토TR 2선, 220 Ω·10 kΩ는 허브에) | 포토TR E(신호) | 흰색 | 28 | GATE_HUB | 허브 G3 (10 kΩ → GND) | 듀폰 2.54 헤더 (허브 기판) | G3 | 포토TR 이미터 | LED·포토TR 다리 납땜 + 수축튜브 | 402 | 450 | 0 | False
G07 | 게이트 허브 → 문 빔 G3b (낱개: IR LED 2선 + 포토TR 2선, 220 Ω·10 kΩ는 허브에) | LED +(220 Ω 뒤) | 빨강 | 28 | GATE_HUB | 허브 R220 끝 | 듀폰 2.54 헤더 (허브 기판) | G3b | LED 긴 다리 A | LED·포토TR 다리 납땜 + 수축튜브 | 395 | 440 | 0 | False
G07 | 게이트 허브 → 문 빔 G3b (낱개: IR LED 2선 + 포토TR 2선, 220 Ω·10 kΩ는 허브에) | LED −(켜기) | 검정 | 28 | GATE_HUB | 허브 Q4 OUT− | 듀폰 2.54 헤더 (허브 기판) | G3b | LED 짧은 다리 K | LED·포토TR 다리 납땜 + 수축튜브 | 395 | 440 | 0 | False
G07 | 게이트 허브 → 문 빔 G3b (낱개: IR LED 2선 + 포토TR 2선, 220 Ω·10 kΩ는 허브에) | 포토TR C | 빨강 | 28 | GATE_HUB | 허브 +5V | 듀폰 2.54 헤더 (허브 기판) | G3b | 포토TR 컬렉터 | LED·포토TR 다리 납땜 + 수축튜브 | 395 | 440 | 0 | False
G07 | 게이트 허브 → 문 빔 G3b (낱개: IR LED 2선 + 포토TR 2선, 220 Ω·10 kΩ는 허브에) | 포토TR E(신호) | 흰색 | 28 | GATE_HUB | 허브 G3b (10 kΩ → GND) | 듀폰 2.54 헤더 (허브 기판) | G3b | 포토TR 이미터 | LED·포토TR 다리 납땜 + 수축튜브 | 395 | 440 | 0 | False
G08 | 게이트 허브 → 문 빔 G5 (낱개: IR LED 2선 + 포토TR 2선, 220 Ω·10 kΩ는 허브에) | LED +(220 Ω 뒤) | 빨강 | 28 | GATE_HUB | 허브 R220 끝 | 듀폰 2.54 헤더 (허브 기판) | G5 | LED 긴 다리 A | LED·포토TR 다리 납땜 + 수축튜브 | 464 | 520 | 0 | False
G08 | 게이트 허브 → 문 빔 G5 (낱개: IR LED 2선 + 포토TR 2선, 220 Ω·10 kΩ는 허브에) | LED −(켜기) | 검정 | 28 | GATE_HUB | 허브 Q4 OUT− | 듀폰 2.54 헤더 (허브 기판) | G5 | LED 짧은 다리 K | LED·포토TR 다리 납땜 + 수축튜브 | 464 | 520 | 0 | False
G08 | 게이트 허브 → 문 빔 G5 (낱개: IR LED 2선 + 포토TR 2선, 220 Ω·10 kΩ는 허브에) | 포토TR C | 빨강 | 28 | GATE_HUB | 허브 +5V | 듀폰 2.54 헤더 (허브 기판) | G5 | 포토TR 컬렉터 | LED·포토TR 다리 납땜 + 수축튜브 | 464 | 520 | 0 | False
G08 | 게이트 허브 → 문 빔 G5 (낱개: IR LED 2선 + 포토TR 2선, 220 Ω·10 kΩ는 허브에) | 포토TR E(신호) | 흰색 | 28 | GATE_HUB | 허브 G5 (10 kΩ → GND) | 듀폰 2.54 헤더 (허브 기판) | G5 | 포토TR 이미터 | LED·포토TR 다리 납땜 + 수축튜브 | 464 | 520 | 0 | False
G09 | 게이트 허브 → 문 빔 G5b (낱개: IR LED 2선 + 포토TR 2선, 220 Ω·10 kΩ는 허브에) | LED +(220 Ω 뒤) | 빨강 | 28 | GATE_HUB | 허브 R220 끝 | 듀폰 2.54 헤더 (허브 기판) | G5b | LED 긴 다리 A | LED·포토TR 다리 납땜 + 수축튜브 | 472 | 520 | 0 | False
G09 | 게이트 허브 → 문 빔 G5b (낱개: IR LED 2선 + 포토TR 2선, 220 Ω·10 kΩ는 허브에) | LED −(켜기) | 검정 | 28 | GATE_HUB | 허브 Q4 OUT− | 듀폰 2.54 헤더 (허브 기판) | G5b | LED 짧은 다리 K | LED·포토TR 다리 납땜 + 수축튜브 | 472 | 520 | 0 | False
G09 | 게이트 허브 → 문 빔 G5b (낱개: IR LED 2선 + 포토TR 2선, 220 Ω·10 kΩ는 허브에) | 포토TR C | 빨강 | 28 | GATE_HUB | 허브 +5V | 듀폰 2.54 헤더 (허브 기판) | G5b | 포토TR 컬렉터 | LED·포토TR 다리 납땜 + 수축튜브 | 472 | 520 | 0 | False
G09 | 게이트 허브 → 문 빔 G5b (낱개: IR LED 2선 + 포토TR 2선, 220 Ω·10 kΩ는 허브에) | 포토TR E(신호) | 흰색 | 28 | GATE_HUB | 허브 G5b (10 kΩ → GND) | 듀폰 2.54 헤더 (허브 기판) | G5b | 포토TR 이미터 | LED·포토TR 다리 납땜 + 수축튜브 | 472 | 520 | 0 | False
S11 | UNO 2 D3·D5 → MOSFET 보드 (조명 켜기) | L_TOP | 노랑 | 26 | UNO2 | D3 | 듀폰 암 1핀 (UNO 헤더) | MOSFET | Q1 TRIG | 보드 핀 | 204 | 230 | 0 | False
S11 | UNO 2 D3·D5 → MOSFET 보드 (조명 켜기) | L_BOT | 노랑 | 26 | UNO2 | D5 | 듀폰 암 1핀 (UNO 헤더) | MOSFET | Q2 TRIG | 보드 핀 | 204 | 230 | 0 | False
L01 | MOSFET → 위 조명 182 | +5V | 빨강 | 24 | MOSFET | 보드 V+ | 보드 나사 단자 | L_TOP | 조명 + | 조명 납땜 | 694 | 770 | 0 | False | 0.023
L01 | MOSFET → 위 조명 182 | Q1 OUT− | 검정 | 24 | MOSFET | Q1 OUT− | 보드 나사 단자 | L_TOP | 조명 − | 조명 납땜 | 694 | 770 | 0 | False | 0.023
L02 | MOSFET → 아래 조명 | +5V | 빨강 | 24 | MOSFET | 보드 V+ | 보드 나사 단자 | L_BOT | 조명 + | 조명 납땜 | 427 | 470 | 0 | False | 0.007
L02 | MOSFET → 아래 조명 | Q2 OUT− | 검정 | 24 | MOSFET | Q2 OUT− | 보드 나사 단자 | L_BOT | 조명 − | 조명 납땜 | 427 | 470 | 0 | False | 0.007
S12 | UNO 2 D6 → MOSFET 보드 (급이 펌프 켜기) | PUMP | 노랑 | 26 | UNO2 | D6 | 듀폰 암 1핀 (UNO 헤더) | MOSFET | Q3 TRIG | 보드 핀 | 204 | 230 | 0 | False
L03 | MOSFET → 급이 펌프 144p (프레임 밖, 다이오드 1N5819를 펌프 다리에) | +5V | 빨강 | 22 | MOSFET | 보드 V+ | 보드 나사 단자 | PUMP | 펌프 + | 펌프 납땜 + 수축튜브 | 540 | 600 | 0 | False | 0.029
L03 | MOSFET → 급이 펌프 144p (프레임 밖, 다이오드 1N5819를 펌프 다리에) | Q3 OUT− | 검정 | 22 | MOSFET | Q3 OUT− | 보드 나사 단자 | PUMP | 펌프 − | 펌프 납땜 + 수축튜브 | 540 | 600 | 0 | False | 0.029
S13 | J_I2C → Pi I2C (배터리 상자 INA226, 콘센트일 때는 비어 있음) | 3.3V | 빨강 | 28 | J_I2C | J_I2C 1 VS | JST XH 4P 하우징 (193j에 꽂음) | PI_B | Pi 핀 1 (3V3) | 듀폰 암 1핀 (Pi 헤더) | 551 | 610 | 0 | False
S13 | J_I2C → Pi I2C (배터리 상자 INA226, 콘센트일 때는 비어 있음) | GND | 검정 | 28 | J_I2C | J_I2C 2 GND | JST XH 4P 하우징 (193j에 꽂음) | PI_B | Pi 핀 6 (GND) | 듀폰 암 1핀 (Pi 헤더) | 551 | 610 | 0 | False
S13 | J_I2C → Pi I2C (배터리 상자 INA226, 콘센트일 때는 비어 있음) | SDA | 파랑 | 28 | J_I2C | J_I2C 3 SDA | JST XH 4P 하우징 (193j에 꽂음) | PI_B | Pi 핀 3 (GPIO2) | 듀폰 암 1핀 (Pi 헤더) | 551 | 610 | 0 | False
S13 | J_I2C → Pi I2C (배터리 상자 INA226, 콘센트일 때는 비어 있음) | SCL | 노랑 | 28 | J_I2C | J_I2C 4 SCL | JST XH 4P 하우징 (193j에 꽂음) | PI_B | Pi 핀 5 (GPIO3) | 듀폰 암 1핀 (Pi 헤더) | 551 | 610 | 0 | False
