britams/-capstone-project-repo/control/README.md

# control
아두이노 코드, 배선도, Pi ↔ 아두이노 통신. 담당: 승준.
