britams/-capstone-project-repo/vision/README.md

# vision
VespAI 실행 기록·코드, 흉부 표식 검출, 라즈베리파이 5 + AI HAT+ + AI 카메라 설정. 담당: 승준.
