britams/-capstone-project-repo/design/2026-11-02_S4_역학계산_쉬운설명.md

# 역학계산 10문제 — 무엇을 풀었고 왜 풀었나 (아주 쉽게)

2026-11-02 · 이서현

## 한눈에

10문제는 결국 기계에게 세 가지를 물어보려고 풀었다. 힘은 모두 넉넉했고, 동역학으로 보니 위험 두 가지가 새로 보였다.

1. **힘이 모자라지 않나?** — 작은 모터가 일을 해낼 수 있는지
2. **말벌을 다치게 하지 않나?** — 너무 세게 누르거나 끼우지 않는지
3. **3분 안에 끝나나?** — 한 마리 처리 시간

숫자는 모두 계산값이다. 아직 시험으로 확인하지 않은 값은 따로 표시했다.

## ① 힘이 모자라지 않나?

모든 모터와 부품의 힘은 넉넉하다. 다만 펜 손잡이 핀은 아슬아슬해서 테프론 테이프로 보완한다.

**M1 바닥 올리는 나사** (기계요소)

- 비유: 병뚜껑을 돌리면 뚜껑이 올라가듯, 나사를 돌려 말벌이 앉은 바닥을 올린다.
- 왜: 작은 모터가 바닥을 들 수 있는지, 전기를 끄면 바닥이 미끄러져 내려가지 않는지 보려고.
- 답: 힘은 10배 넉넉하다. 나사 혼자서는 버티지 못해 모터 속 기어가 잡아 줘야 한다 (시험으로 확인).

**M2 펜을 앞뒤좌우로 옮기는 힘** (동역학)

- 비유: 장난감 자동차를 밀 때, 미는 힘이 미끄러짐을 막는 힘(마찰)보다 커야 출발한다.
- 답: 아주 작은 힘으로 충분하다. 모터 힘이 수백 배 남는다.

**M4 펜을 들어 올리는 서보** (정역학)

- 비유: 시소. 서보 팔이 펜을 들어 올린다.
- 답: 서보 힘이 14배 넉넉하다.

**M5 한쪽만 밀면 걸림** (정역학)

- 비유: 서랍을 한쪽 손잡이로만 당기면 삐뚤어져서 걸린다.
- 답: 큰 틀(X축)은 괜찮다. 펜 손잡이 쪽 핀은 아슬아슬해서, 핀을 테프론 테이프로 감아 미끄럽게 한다 [가능성 높음].

**M6 봉이 휘는 정도** (재료역학)

- 비유: 철봉에 매달리면 철봉이 살짝 휜다.
- 답: 0.01 mm로, 머리카락 굵기보다 훨씬 작다. 괜찮다.

**M10 흔들림 박자** (동역학)

- 비유: 그네를 박자에 맞춰 밀면 점점 크게 흔들린다. 모터의 덜컥거리는 박자가 봉의 박자와 같으면 봉이 크게 떨린다.
- 답: 지금 모터 속도는 박자가 달라서 괜찮다. 아주 느린 속도(2~3 rpm)만 쓰지 않으면 된다.

## ② 말벌을 다치게 하지 않나?

가만히 누르는 힘은 괜찮지만, 빠르게 내리거나 문에 끼면 위험하다. 그래서 움직이는 순서와 속도를 바꿨다.

**M3 도장 찍는 힘** (정역학)

- 비유: 도장을 너무 세게 누르면 종이가 밀린다. 펜으로 너무 세게 누르면 말벌이 바닥에서 밀려난다.
- 답: 펜 무게만으로 0.31 N이다. 한계 0.5 N 안이라 괜찮다.

**M8 펜을 내리는 속도** (동역학) — 가장 중요

- 비유: 공을 살짝 내려놓는 것과 툭 떨어뜨리는 것은 다르다. 빨리 내리면 "쾅" 부딪힌다.
- 답: 서보를 제일 빠르게 내리면 순간 힘이 가만히 누를 때의 2~5배가 된다. 그래서 마지막 2 mm는 천천히(60 °/s 이하) 내리기로 정했다.
- [추측] 2~5배는 펜 끝이 얼마나 말랑한지 재기 전 범위다.

**M7 문 닫기** (동역학)

- 비유: 자전거 페달을 돌리면 다리가 위아래로 움직이듯, 서보의 빙글 도는 움직임을 문의 왔다 갔다 움직임으로 바꾼다.
- 답: 문은 0.2초 만에 닫힌다. 하지만 말벌이 문틈에 끼어 있어도 서보는 아주 세게(22~44 N) 계속 민다. 그래서 문틈이 비었는지 센서로 확인한 뒤에 닫기로 정했다.

## ③ 3분 안에 끝나나?

기계가 움직이는 시간은 충분하고, 3분 안에 끝나는지는 잉크가 마르는 시간이 정한다.

**M9 옮기는 시간** (동역학)

- 비유: 달리기에서 출발해 빨라지는 시간은 아주 잠깐이고, 전체 시간은 최고 속도가 정한다.
- 답: 펜을 옮기는 데 약 30초 걸린다. 기계가 하는 일을 모두 합하면 약 64초라, 잉크가 약 105초 안에 마르면 3분 안에 끝난다. 이건 시험으로 확인한다.
- 더 빨라져야 하면 모터를 바꿔 최고 속도를 올려야 한다 (벨트를 쓰면 30초 → 6초).

## 교재 문제는 왜 같이 풀었나?

새 요리를 하기 전에 레시피대로 한 번 만들어 보고 맛이 맞는지 확인하는 것과 같다. 교재 문제 11개를 모두 답안지와 맞춘 뒤 우리 문제를 풀었다.

1. 우리 문제와 똑같은 모양의 교재 문제를 먼저 푼다.
2. 답안지(교재 정답, 해설집)와 맞는지 본다. 11문제 모두 0.5 % 안에서 맞았다.
3. 맞는 걸 확인한 그 방법으로 우리 기계 문제를 푼다.

그래서 "컴퓨터(AI)가 계산했으니 맞겠지"가 아니라, 답안지로 먼저 확인한 방법이라고 말할 수 있다. 교재는 Meriam 동역학, Riley 정역학, Gere 재료역학이다.

## 한 줄 요약과 10문제 표

힘은 모두 넉넉하다. 동역학으로 보니 "빨리 내리면 쾅"과 "문에 끼임"이라는 숨은 위험 두 개가 나왔고, 기계 모양은 두고 움직이는 순서·속도를 바꿔 해결했다.

| 번호 | 무엇 | 쉬운 비유 | 답 | 분야 |
| --- | --- | --- | --- | --- |
| M1 | 바닥 올리는 나사 | 병뚜껑 돌리기 | 10배 넉넉, 기어가 잡아 줌 | 기계요소 |
| M2 | 펜 옮기는 힘 | 장난감 자동차 밀기 | 수백 배 넉넉 | 동역학 |
| M3 | 도장 찍는 힘 | 도장 너무 세게 누르기 | 0.31 N, 한계 0.5 N 안 | 정역학 |
| M4 | 펜 드는 서보 | 시소 | 14배 넉넉 | 정역학 |
| M5 | 한쪽만 밀면 걸림 | 서랍 한쪽 손잡이 | X축 괜찮음, 핀은 테프론 테이프 | 정역학 |
| M6 | 봉이 휘는 정도 | 철봉에 매달리기 | 0.01 mm, 괜찮음 | 재료역학 |
| M7 | 문 닫기 | 자전거 페달 | 0.2초, 끼면 위험 → 센서 확인 후 닫기 | 동역학 |
| M8 | 펜 내리는 속도 | 공 내려놓기 vs 떨어뜨리기 | 빠르면 2~5배 → 마지막 2 mm 천천히 | 동역학 |
| M9 | 옮기는 시간 | 달리기 최고 속도 | 약 30초, 잉크 건조가 관건 | 동역학 |
| M10 | 흔들림 박자 | 그네 박자 맞춰 밀기 | 괜찮음, 2~3 rpm만 피함 | 동역학 |

Claude 문서 원본: https://claude.ai/artifact/488QNwxwHR4oQ3DCx1S4Ka

## (11/06 추가) 바닥 스프링과 바닥 막대 — 교과서 문제 5개로 다시 확인
- **쿠션 스프링:** 1 mm 누르면 10 g만큼 미는 쿠션이에요. 교과서(Shigley)에는 "너무 굵고 성긴 스프링은 공장에서 감기 어렵다"는 규칙이 있어요. 그래서 실(철사)을 0.23 mm로 가늘게, 지름을 2.6 mm로 작게 바꿨어요. 대신 가운데에 쇠 핀(Ø2)을 끼워 옆으로 휘지 않게 했어요.
- **비스듬히 끼는 막대:** 서랍 손잡이를 한쪽만 잡고 당기면 뻑뻑하죠? 말벌이 바닥 가장자리에 있으면 바닥을 받치는 막대가 구멍 속에서 비스듬히 끼어요. 그러면 기계는 "세게 눌렀다"고 생각하는데, 말벌은 원래 힘의 5분의 1~3분의 1만 받아요. 볼 베어링 통(LM4UU)을 끼우면 거의 그대로(98 % 이상) 전달돼요.
- **출렁임:** 바닥이 말벌에 닿는 순간 아주 조금(머리카락 굵기의 20분의 1) 출렁여요. 힘으로는 2 % 정도라 괜찮아요.
- **교과서 답도 틀린 곳:** 직접 계산해 보니 Shigley 예제 두 곳에 계산 실수가 있었어요. 52개 값 중 나머지는 모두 2 % 안에서 맞았어요.
