britams/-capstone-project-repo/design/2026-11-02_상용트랩_캘리퍼스실측_승준.md

# 상용 트랩 결합부 캘리퍼스 실측 (승준)

측정: 이승준, 2026-11-02 19:30~ · 디지털 버니어 캘리퍼스 · 정리: Claude (CAP-AI-SJ-33)
잴 곳 그림: `design/img/2026-11-02_캘리퍼스_측정위치_1_트랩결합부_승준.png` (기호 같음)
서현 실측표(`design/2026-10-28_상용트랩_실측표.md`, 줄자)에 반영할 값 — 실측표는 서현 담당이라 여기 따로 적고 Issue로 요청한다.

## 차양막 가운데 구멍 둘레

| 기호 | 어디 | 값 (mm) | 기준면 | 메모 |
|---|---|---|---|---|
| h1 | 안쪽 턱 꼭대기 높이 | **9.9** | 확인 중 | 셋 중 가장 높음 |
| h2 | 토막 꼭대기 높이 | **8.9** | 확인 중 | |
| h3 | 바깥 고리 꼭대기 높이 | **8.0** | 고리 바깥 판 | 셋 중 가장 낮음 → 측정 그림 C(바깥 고리가 가장 높게 그림)와 반대 |
| h3c | 바깥 고리 꼭대기 높이 (홈 c 바닥 기준) | **6.6** | 홈 c 바닥 | 홈 c 바닥이 바깥 판보다 1.4 높음 |
| 차2 | 토막 꼭대기 높이 (홈 c 바닥 기준) | **6.6** | 홈 c 바닥 | 바깥 고리와 같은 높이. h2 8.9는 다른 바닥(바깥 판)에서 잰 값 |
| 차1 | 안쪽 턱 바깥지름 | **61.9** | — | 안쪽 턱 두께 (61.9 − 56.7)/2 = 2.6, 토막 폭 (76.3 − 61.9)/2 = 7.2 → 모듈 아랫면 가운데 구멍은 61.9보다 크게 |
| 차3 | 안쪽 턱 꼭대기 높이 (빈 구간 b 바닥 기준) | **10.3** | 빈 구간 b 바닥 | 토막·바깥 고리보다 3.7 높음. 빈 구간 바닥 ≈ 홈 c 바닥으로 봄 [추측] |
| D1 | 구멍 안지름 | **56.7** | — | 줄자 55 → +1.7. CAD `TRAP["hole_r"]` 27.5 |
| D2 | 바깥 고리 바깥지름 | **91.7** (다시 잼, 처음 89.6) | — | 줄자 90. CAD `ring_r` 45 → 모듈 결합부 102(안 반지름 47)와 반지름 틈 1.35 |
| a | 토막 길이 (끝면~끝면 직선) | **33.9** | — | |
| b | 토막 사이 빈 구간 (둘레 방향 직선) | **22.1** | — | 걸쇠가 내려가는 자리로 보임 [추측] |
| c | 토막 바깥면 ~ 바깥 고리 안쪽면 홈 폭 | **6.8** | — | 사진 어림(약 2)보다 큼 → D2i·t로 확인 |
| D2i | 바깥 고리 안지름 | **89.9** | — | D2 다시 잰 값과 맞음 |
| t | 바깥 고리 두께 | **0.7** | — | D2 − 2t = 90.3 ≈ D2i 89.9 (0.4 차이) |
| ② | 처마 아랫면 높이 (홈 c 바닥 → 처마 밑) | **2.7** | 홈 c 바닥 | 걸쇠 두께 2.5보다 0.2 큼 → 걸쇠가 처마 밑에 들어가는 해석과 맞음. 처마 밑면이 경사짐(승준, 사진) |
| ① | 파인 곳 바닥 − 홈 c 바닥 | ≈ 0 | — | 승준: 차이 무시할 수준 |
| ③ | 처마 밑 파인 깊이 | 못 잼 (경사) | — | 계산: 걸쇠 끝 반지름 37.5 < 처마 바깥면 반지름 (89.9 − 2×6.8)/2 = 38.15 → 걸쇠가 처마 밑으로 약 0.65 들어감 → 파인 깊이 ≥ 0.65 |

## 포획통 바닥 (뒤집어서)

| 기호 | 어디 | 값 (mm) | 메모 |
|---|---|---|---|
| D3a | 걸쇠 고리 안지름 (매끈한 벽) | **81.2** | 줄자 67과 다름 → 서현 67은 다른 곳(걸쇠 끝끼리?)일 가능성 |
| D3b | 걸쇠 고리 바깥지름 (매끈한 벽) | **85.6** | 줄자 83 |
| D3c | 바깥 큰 벽 안지름 | **93.1** | 줄자 94 |
| w | 걸쇠 폭 (둘레 방향) | **12** | b 22.1보다 작음 → 빈 구간으로 내려감 |
| k1 | 걸쇠 고리 끝 → 걸쇠 가까운 면 | **0.6** | |
| k2 | 걸쇠 고리 끝 → 걸쇠 먼 면 | **3.1** | 걸쇠 두께 2.5 |
| p_out | 걸쇠가 고리 바깥으로 튀어나온 길이 | **0** | 승준 확인: 걸쇠는 안쪽으로만 튀어나옴 |
| p_in | 걸쇠가 고리 안쪽으로 튀어나온 길이 | **3.1** | 걸쇠 끝 지름 = 81.2 − 6.2 = 75.0 |
| g1 | 걸쇠 고리 끝 → 레일 바닥 | **6.7** | |
| g2 | 큰 벽 끝 → 레일 바닥 | **6.0** | 걸쇠 고리가 큰 벽보다 0.7 더 나옴 |

| 포1 | 걸쇠 고리 높이 (포획통 바닥판 안쪽 → 고리 끝) | **6.3** | 레일 쪽 g1 6.7보다 0.4 낮음 |
| 포2 | 걸쇠 고리 안쪽의 다른 벽·턱 | **없음** | 서현 줄자 67은 다른 곳 |

## 마커 (샤피 크리에이티브, 연두색으로 잼 — 12색 같은 몸통 [가능성 높음])

| 번호 | 무엇 | 값 (mm) | D6 값 | 메모 |
|---|---|---|---|---|
| 마1 | 팁 바로 뒤 앞코 지름 | **7.2** | — | |
| 마2 | 몸통 가장 굵은 곳 지름 | **14.7** | d_g 14.7 | D6 '그립 14.7'은 몸통 지름과 같음 |
| 마3 | 팁 끝 → 가장 굵은 곳 시작 | **15.6** | — | 몸통 14.7은 팁 끝 15.6부터 뒤끝까지 |
| 마4 | 팁 지름 | **2.2** | — | 불렛 팁 |
| 마5 | 팁 나온 길이 | **8.0** | — | |
| 마6 | 전체 길이 (캡 뺌) | **134.6** | — | |
| 마7 | 캡 바깥지름 | **18.8** | d_max 18.9 | D6 '최대 18.9'는 몸통이 아니라 캡(클립 포함) |

사진: 앞코가 두 단(7.2 → 중간 단 → 몸통 14.7)으로 보임 — 중간 단 지름은 안 잼

## 맞춰 본 것 (계산, [가능성 높음])
- 걸쇠 고리 두께 = (85.6 − 81.2)/2 = **2.2**, 포획통 레일 폭 = (93.1 − 85.6)/2 = **3.75**
- 차양막 바깥 고리(바깥 89.6)가 레일에 들어가면 큰 벽과 틈 (93.1 − 89.6)/2 = **1.75**. 이때 바깥 고리 두께는 (89.6 − 85.6)/2 = **2.0 이하**, 안지름 D2i는 **85.6 이상**이어야 함 → D2i 재면 확인
- 토막·빈 구간이 4쌍이라 4(a + b) ≈ 2πR → R ≈ 35.7 (지름 약 71) → 토막 한 개 약 57°, 빈 구간 약 36° (합 93°, 직선·원호 차이) → 토막 바깥지름 약 71~73, c 6.8과 D2i 약 86이면 맞음
- 지름 맞물림 (D2 다시 잰 뒤): 차양막 바깥 고리 89.9~91.7이 포획통 레일 85.6~93.1 안에 들어감 → 안쪽 틈 2.15, 바깥 틈 0.7 [확실, 계산]
- 높이 (h3c 6.6으로 풀림): 걸쇠 고리 끝이 홈 c 바닥에 닿을 때 레일 바닥(끝에서 6.7)과 바깥 고리 꼭대기(6.6) 틈 0.1 → 포획통이 두 곳에 함께 얹힘. 걸쇠는 홈 바닥에서 0.6~3.1 → 처마 아랫면 2.7보다 0.4 높음 → 처마 밑면이 경사(입구 쪽이 높음)라 돌리면 걸쇠가 끌려 내려가며 조여지는 방식으로 보임 [가능성 높음]
- 높이 다시 (차2·차3): 포획통 바닥판 안쪽(고리 끝에서 6.3)이 토막 꼭대기(6.6)에 얹히고 걸쇠 고리 끝은 홈 바닥에서 약 0.3 떠 있음 → 처마 경사가 걸쇠를 당겨 포획통을 토막 위에 눌러 고정하는 방식으로 보임 (겹침 0.3~0.7은 플라스틱 휨으로 흡수) [가능성 높음]. 안쪽 턱(10.3)은 포획통 바닥판보다 약 4.0 솟아 포획통 바닥 가운데 구멍(깔때기 쪽)으로 들어감 → 그 구멍 지름 > 안쪽 턱 바깥지름(차1)
- **잠금 방식 정리** [가능성 높음]: 걸쇠 4개(폭 12)가 빈 구간 b(22.1) 4곳으로 내려감 → 돌리면 토막(약 57°) 바깥면 처마 밑 경사 홈으로 들어가며 아래로 당겨짐 → 막힌 끝에서 멈춤
- 높이: 차양막 바깥 고리 8.0 > 레일 깊이 6.0~6.7 → 포획통 레일 바닥이 바깥 고리 꼭대기에 얹히고, 걸쇠 고리 끝은 차양막 바닥에서 약 1.3 위, 걸쇠는 약 1.9~4.4 높이 (h3 기준면이 같다는 가정) [추측]
- 잠김: 걸쇠(높이 1.9~4.4)가 빈 구간 b로 내려간 뒤 돌려서 토막 쪽으로 가려면, 토막 바깥면 아래쪽에 걸쇠가 들어갈 가로 홈(파인 곳)이 있어야 함 → 확인 필요 [추측]
- p_in 3.1 → 걸쇠 끝 지름 75.0. 토막 바깥지름 = D2i − 2c = 76.3 (D2i 89.9) 또는 74.6 (D2i 88.2) → 걸쇠 끝이 토막 바깥면에 겨우 닿거나 못 미침 → 토막 위에 걸리는 방식이 아닐 가능성 [추측]. 토막 바깥면의 홈, 토막 끝 계단(턱)에 걸리는지 실물로 확인
- → 처음 사진 어림(바깥 고리 안 83, 토막 바깥 79)은 원근 때문에 틀린 듯. 걸쇠 고리(81.2~85.6)는 차양막 홈 c 안에 들어가고, 걸쇠가 안쪽으로 약 4.6 mm 이상 튀어나와야 토막에 닿음 [추측]

## 통로 구멍

| 기호 | 어디 | 값 (mm) | 메모 |
|---|---|---|---|
| D4 | 실리콘 포획술 가운데 구멍 (손대지 않은 상태) | **5.9** | 줄자 약 5 |
| D5 | 노란 깔때기 좁은 끝 안지름 (말벌이 지나가는 크기) | **17.6** | 줄자 19 → −1.4 |

## 설계와 맞춰 볼 것 (서현에게 Issue로)
- [확실] D5e 입구 통로 110의 안지름은 12 mm(`PORT_R` 6). 상용 트랩이 말벌을 통과시키는 깔때기 끝은 17.6 mm. 12 mm로 말벌(특히 여왕벌)이 잘 지나가는지는 [추측] — 확인 필요
- [확실] CAD는 차양막 턱을 반지름 27.5~45, 높이 10의 한 덩어리로 둠. 실제는 안쪽 턱 9.9 · 토막 8.9 · 바깥 고리 8.0의 계단 + 홈 → 모듈 아래 결합부를 실제 모양에 맞출지

## 아직 안 잰 것
처마 밑면 경사는 안 잼 (캘리퍼스 반납) → 모듈 윗면 경사 홈은 걸쇠 치수(두께 2.5, 끝에서 0.6~3.1)에 맞춰 직접 정함 (예: 입구 3.6 → 막힌 끝 2.7) / 차양막 토막 바깥면 아래 가로 홈(있으면 높이·깊이), 빈 구간 b의 낮은 턱 높이, h1~h3 기준면 / 마커

## 서현에게 요청 (Issue 초안 — 11/03 01:40 GitHub 로그인 실패로 못 올림)
제목: [승준→서현] 상용 트랩 결합부 캘리퍼스 실측 반영 요청 (실측표·D5e CAD)

1. 실측표(`design/2026-10-28_상용트랩_실측표.md`)의 D1·D2·D3·D4·D5와 빈 칸(h·홈·돌기)을 이 파일 값으로 바꿔 주세요. 서현 줄자 D3 67은 어느 벽인지 알 수 없어 걸쇠 고리 안지름 81.2로 다시 잼.
2. CAD `TRAP`: hole_r 27.5 → **28.35** (D1 56.7), ring_r 45 → **45.85** (D2 91.7), ring_h 10(한 덩어리) → 실제는 안쪽 턱 · 토막 4개(처마 밑 경사 홈) · 홈 c(6.8) · 바깥 고리(두께 0.7, 홈 바닥에서 6.6).
   - 모듈 아래 결합부 102(안 반지름 47)와 바깥 고리 반지름 틈이 2.15 → 1.15로 줄어듦
3. 잠금은 4점 바요넷으로 보임: 포획통 걸쇠 고리(81.2/85.6) + 걸쇠 4개(폭 12, 두께 2.5, 안쪽 3.1, 끝에서 0.6~3.1) → 빈 구간 b 22.1로 내려가 돌리면 토막 처마(밑면 2.7, 경사) 밑으로 들어감.
   - 모듈 **아랫면**은 포획통 바닥(걸쇠 고리·걸쇠·레일 g1 6.7/g2 6.0·큰 벽 93.1)을 그대로 따라 하면 차양막에 잠김
   - 모듈 **윗면**(104)은 차양막 쪽(토막·처마)을 따라 하거나, 포획통을 얹기만 하는 다른 방식을 정해야 함
4. 입구 통로 110 안지름 12 mm(PORT_R 6) < 상용 깔때기 끝 D5 17.6 mm → 말벌(여왕벌) 통과 여유 확인
