britams/-capstone-project-repo/design/2026-11-02_VespAI_점검_서현.md

# VespAI가 잘 못 잡는 원인 점검 (서현, 2026-11-02, CAP-AI-21)

바탕: 승준 `vision/2026-10-29_VespAI_프린트_웹캠시험.md`(CAP-AI-SJ-26), `vision/2026-10-28_J1_VespAI_실행결과.md`, 스크립트 `vision/scripts/vespai_live_webcam.py`. 승준 파일은 고치지 않고 읽기만 했다. 점검 키트는 `design/vespai_check/`에 있고, 사용법은 그 폴더 `읽어보기.md`에 있다.

## 결론 먼저
1. [확실] **스크립트 문제는 아니다.** 승준 웹캠 스크립트는 OpenCV 프레임을 RGB로 바꿔 넣는다(`cvtColor BGR2RGB`). 가중치 해시도 확인한다. 예시 사진 시험(J1)도 원 결과와 16/21장이 같았다.
2. [가능성 높음] 원인은 **장면 차이**다. VespAI는 미끼판을 내려다보는 1080p 현장 영상(말벌이 작게 보임, 단순한 미끼판 배경)으로 학습했다. 승준 시험은 손에 든 인터넷 사진이었고 손·얼굴·옷이 화면에 들어왔다. 오검출 60 %가 피부·옷이었고, 가까이 대면 못 잡았고, 자갈 배경에서는 6 %만 잡았다. 모두 학습 장면과 다른 조건이다.
3. [확실, 계산] **우리 카메라 배율은 VespAI가 잘 잡는 범위 안이다.** 격자 위 200 mm에서 화면 폭이 약 260 mm라, 말벌(25~30 mm)이 화면 폭의 약 10~12 %가 된다. 승준 시험에서 잘 잡힌 범위는 4~18 %였다. 반대로 **마킹실(40 mm)만 잘라 넣으면 60~75 %가 되어 범위를 벗어난다** → 종 판별에는 넓은 화면을 넣는다.
4. [확실, 계산] **새로 찾은 큰 위험은 격자판 가림이다.** 카메라는 격자판(두께 1.5, 구멍 Ø3, 피치 4.4) 너머로 말벌 등을 본다. 열린 면적은 π·1.5² / 4.4² = **36.5 %**뿐이라, 말벌이 점박이 조각으로 보인다 (아래 그림). [가능성 높음] VespAI는 가리지 않은 말벌로 학습했으므로 이 상태에서는 거의 못 잡을 것이다. 다만 아직 시험하지 않았다 → 키트의 g(격자 겹침)로 확인한다.

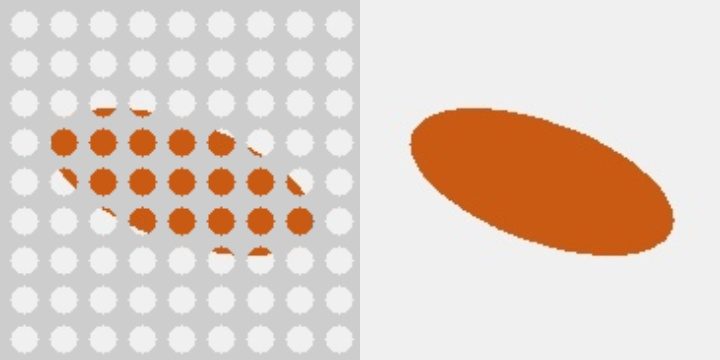
[picture p74: design/vespai_check/격자_가림_모의.jpg]
격자 가림 모의

*왼쪽: 마킹실만 잘라 격자를 겹친 모습(모의 말벌 = 주황 타원). 오른쪽: 격자 없이 마킹실만 자른 모습. 실제 말벌 사진이 아닌 도형이다.*

## 서현 PC 시험 결과 (11/02 03:05, 서현 관찰)
- 설치·J1: 예시 21장 중 16장 원 결과와 같음, CPU 0.106 s/장 (`vespai_check/results/2026-11-02_J1_서현PC_summary.txt`)
- 휴대폰 화면·사진을 웹캠에 비춘 시험: **말벌을 거의 못 잡음, 격자를 겹치면(g) 한 번도 못 잡음, 안경·방을 말벌로 잡음** (서현 관찰, `check_summary.txt`는 아직 안 받음)
- 해석:
  - [가능성 높음] **격자 결과는 예상과 같다** — 지금 격자(열린 면적 36.5 %)로는 VespAI가 못 잡는다 → **투명 격자는 권장이 아니라 필수**로 본다
  - [가능성 높음] 안경·방 오검출은 VespAI가 무늬 없는 미끼판 장면만 배웠기 때문이다. 트랩 안은 장면이 정해져 있어 이 문제는 줄지만, **학습 장면 밖에서는 믿을 수 없는 모델**이라는 것을 보여 준다
  - [추측] 휴대폰 화면을 비추면 반사·줄무늬·크기 문제가 겹쳐 실물보다 불리하다. 공정한 시험은 **표본(승준 보유 7마리)을 흰 종이 위에 두고 20 cm에서 찍은 사진**이다 → 사진 폴더를 `3_drop_video_or_folder_here.bat`에 넣어 수치로 본다
- **기록 수치 (`vespai_check/results/2026-11-02_0257_서현_휴대폰화면_*`, 1초에 한 번 기록)** [확실 — 기록값]:

  | 조건 | 기록 | 등검은말벌 박스가 뜬 초 | 유럽말벌 박스가 뜬 초 | 등검은말벌 최고 신뢰도 (중앙/최대) |
  |---|---|---|---|---|
  | 전체 640 | 75 s | 56 s (75 %) | 23 s | 0.64 / 0.83 |
  | 전체 + 격자 640 | 25 s (3번 나눠 봄) | **0** | **0** | — |
  | 마킹실만 + 격자 640 | 92 s (2번) | 21 s (23 %) | 8 s | 0.69 / 0.90 |

  - [가능성 높음] '전체 75 %'는 성공률이 아니다. 서현 관찰로 박스 상당수가 안경·방에 떴고, 기록에는 박스 위치가 없어 진짜 말벌 박스를 가를 수 없다.
  - [확실] 격자를 겹친 전체 화면에서는 박스가 하나도 안 떴다 — 말벌도, 오검출도. 이 키트의 격자는 막힌 부분을 불투명한 회색으로 칠하는 **가장 나쁜 경우**다. 실제 투명 격자는 구멍 테두리만 보인다.
  - [추측] 마킹실만 + 격자의 23 %는 확대된 격자 무늬나 배경 조각에 뜬 오검출일 수 있다 (위치 기록 없음). → 키트를 고쳐 **박스가 뜬 장면을 1초에 1장 자동 저장**(`auto_*.jpg`, 파일 이름 F 전체 / K 마킹실만, G 격자)하게 했다. 다음 시험부터는 장면을 보고 진짜·가짜를 가른다.
- **공정한 시험 (1분, 바로 가능)**: VespAI가 받은 실제 현장 사진 15장(`capstone_vespai\vespai\images\example-detections\velutina\frames`)을 `3_drop_video_or_folder_here.bat`에 끌어다 놓는다. VespAI 자기 조건의 사진에서 '전체'와 '전체 + 격자'를 비교하므로 격자 영향만 따로 보인다 (이 사진들은 말벌이 화면 가운데에 있지 않아 '마킹실만' 조건은 의미 없음).
- 결론: **VespAI를 그대로 쓰지 않는다.** 우리 마킹실 구도(위 200 mm, 투명 격자, 우리 조명)로 찍은 사진으로 다시 학습한다. VespAI 가중치는 출발점으로만 쓰고, 비영리 조건이 붙는다. 승준 SJ-26 '파인튜닝 계획'을 앞당긴다

## 설계에 주는 것 (서현 결정 필요)
| 안 | 내용 | 장단점 |
|---|---|---|
| ① 투명 격자 | 격자판을 투명 아크릴·PETG로 만들고 구멍은 그대로 둠 | 카메라는 말벌 전체를 봄. 레이저 가공·구멍 테두리 반사 확인 필요. **11/02 시험 뒤 필수로 봄** |
| ② 구멍 키우기 | Ø3 → Ø4 (피치 4.4면 열린 면적 65 %) | 벽이 0.4 mm로 얇아져 약함. 말벌 다리가 빠질 수 있음 |
| ③ 다시 학습 | 격자 너머 표본 사진으로 파인튜닝 (승준 계획) | 표본·사진 수가 필요, 시간이 걸림 |
| ④ 판별 위치 | 바닥을 올리기 전(격자에서 떨어져 있을 때) 판별 | 그래도 격자 너머라 가림은 같음 → 단독으로는 해결 안 됨 |

권장 [가능성 높음]: **①을 D5f에 넣고, 키트로 격자 영향을 먼저 수치로 확인한다.** ③은 ①과 상관없이 유지한다(한국에는 유럽말벌이 흔해 종 혼동이 실제 문제다).

## 서현이 지금 할 시험 (10~15분)
`design/vespai_check/읽어보기.md` 순서대로 한다. 실물 크기 말벌 사진을 웹캠 약 20 cm에 두고, 그대로·격자·마킹실만·둘 다를 각 30초씩 본다. 결과(`check_summary.txt`)는 레포 `design/vespai_check/results/`에 올린다. 인터넷 사진·영상은 올리지 않는다.

## 검증
- 키트 스크립트는 가짜 모델과 합성 그림으로 흐름을 확인했다 (조건 5개 표, 격자 열린 면적 0.365 = 계산값 36.5 %) [확실]. 실제 가중치·웹캠 실행은 `미검증`(서현 PC에서 실행).
- VespAI 학습 장면에 대한 설명은 승준 저장소 확인 문서(논문 O'Shea-Wheller 외 2024, *Communications Biology*, 640 입력·현장 Pi 4)와 J1 문서를 근거로 했다.

## 참고: Hivora Sense는 무엇으로 잡나 (서현 질문, 11/02 03:10)
출처: [hivora.eu](https://hivora.eu/), [Hivora Sense](https://hivora.eu/hivora-sense), [조립 안내](https://hivora.discourse.group/t/aufbauanleitung-hivora-sense-locktopf/12) (독일어, 11/02 확인)
- **무엇**: 등검은말벌 신고·둥지 기록·제거를 묶는 독일 서비스(HornetLog 앱, 협회용 플랫폼)의 **미끼 단지 카메라 모듈**. 잡거나 죽이지 않고("Es fängt nichts und tötet nichts") 사진과 시각만 남긴다. 표시한 말벌이 돌아오는 시간을 적어 둥지 방향 추정(삼각측량)을 돕는다. 지금은 직접 만드는 키트(30~40 €)이고 완제품은 없다 [확실 — 사이트].
- **하드웨어**: Seeed **XIAO ESP32-S3 Sense** 마이크로컨트롤러 보드 + 카메라(판매처 링크상 OV3660), 3D 프린트 하우징, 보조배터리. 카메라는 심지식 미끼 단지(Locktopf) **바로 위**에서 내려다본다 [확실 — 사이트].
- **탐지**: 보드 안에서 도는 AI 모델("speziell auf die Asiatische Hornisse trainiert" — 등검은말벌에 맞춰 따로 학습). 모델 이름·구조·학습 자료·정확도는 공개하지 않았다. 스스로 "판정이 아니라 힌트"라고 하고, 첫 화면의 '85 %'는 화면 예시일 뿐 정확도가 아니다 [확실 — 사이트].
- **VespAI인가**: 사이트 어디에도 VespAI라는 말이 없다 [확실]. [가능성 높음] VespAI 가중치(YOLOv5s, 14.4 MB)는 이 보드(플래시·PSRAM 각 8 MB급)에 그대로 들어가지 않으므로, **훨씬 작은 자체 모델**일 것이다. 어떤 구조인지는 [추측]이라 쓰지 않는다.
- **우리에게 주는 것**:
  1. Hivora도 VespAI도 **카메라가 단순한 바닥(미끼판·단지) 위의 말벌을 가림 없이 내려다보는 장면**에서, **그 장면으로 학습한 모델**을 쓴다. 우리가 그 조건을 따라가려면 ① 투명 격자(카메라와 말벌 사이에 가리는 것이 없게) ② 단색 바닥·벽 ③ 우리 마킹실에서 찍은 사진으로 학습, 세 가지가 필요하다.
  2. 둘 다 '말벌이 왔나·어떤 종인가'까지만 한다. 우리는 흉부 위치·뒤집힘·찍은 점 확인이 더 필요해서, 어차피 **우리 모델(검출 + 키포인트)을 따로 학습**해야 한다 (승준 SJ-24 4장).
  3. Hivora는 사람이 표시한 말벌의 재방문을 기록한다. 우리 차별점(**표시를 기계가 하고, 표시를 카메라로 확인**)이 그대로 유지된다 — 발표·보고서에서 비교 대상으로 쓸 수 있다.
