britams/-capstone-project-repo/design/2026-10-28_D1_동작순서와_요구사항.md

# D1 동작 순서와 요구사항 (1차)

정리일: 2026-10-28 · 작성: 이서현 (Claude와 정리, CAP-AI-05) · 상태: **확정 (10/28)** — Q1~Q4·운용 모드·목표값 확정. 목표값은 Claude 제안값을 서현이 채택(CAP-AI-08), 시험 결과로 고칠 수 있음. 법적 제약은 보류(제작 먼저)
앞 단계: `design/2026-10-28_D0_재설계_전제와_절차.md` (레트로핏 추가 모듈, 바닥 설치)

---

## 1. 동작 순서 (서현 결정, 2026-10-28)

> 트랩으로 잡음 → 개체 확인 → 여왕벌은 가둠 → 일벌은 마킹 후 먹이 주고 방생 → 나중에 마킹한 개체가 다시 잡히면 로그로 확인

| 단계 | 내용 | 맡는 곳 |
|---|---|---|
| S1 포획 | 상용 트랩이 유인·포획. 들어온 말벌은 빛 쪽(위)으로 올라감 | 상용 트랩 |
| S2 진입 | 위로 올라가는 길목의 모듈로 한 마리씩 들어옴 | 모듈 |
| S3 개체 확인 | 카메라로 종(등검은말벌 여부)·계급(여왕벌/일벌)·기존 표식 유무 판단 | 모듈 (비전) |
| S4-a 여왕벌 | 격리함에 가둠 | 모듈 |
| S4-b 일벌, 표식 없음 | 마킹 → 먹이 → 방생 | 모듈 |
| S4-c 일벌, 표식 있음 (재포획) | 로그 기록 → 먹이 → 방생 (덧칠 안 함) | 모듈 |
| S4-d 비표적 | 꿀벌은 상용 트랩 탈출망으로 빠짐. 장수말벌 등 다른 말벌 종은 검토 중 (3장 Q3) | 상용 트랩 / 모듈 |
| S5 기록 | 시각, 분류 결과, 표식 유무, 사진 | 모듈 (비전) |

범위 밖: 둥지 위치 추정, 비행 방향 기록, 왕복 시간으로 거리 추정 (10/8 삭제 유지). 단 재포획 시각은 로그에 남으므로 나중에 분석할 수는 있음.

## 2. 이 순서에서 생기는 설계 조건

1. [확실] **먹이가 마킹 뒤로 갔으므로, "먹는 동안 자세가 고정된다"를 쓸 수 없다.** 마킹할 때 자세는 기구로 잡아야 한다 (D3 F3 후보: 좁은 통로, 살짝 누르기, 저온 마취).
2. [가능성 높음] **마킹 후 먹이 시간이 잉크 건조 시간을 겸한다.** 바로 날려 보내면 덜 마른 잉크가 그루밍으로 지워질 수 있으므로, 급이 시간 ≥ 마커 건조 시간이 되게 정하면 된다 → 마커 벤치 시험값이 급이 시간의 하한이 됨.
   - (11/02 검토, CAP-AI-21) **먹이는 유지.** 먹이를 빼도 건조를 기다려야 하므로 시간이 줄지 않는다. [확실] 등검은말벌 일벌은 먹이가 있던 자리로 되돌아온다(미끼에서 표시한 개체의 왕복 시간으로 둥지를 찾는 방법, Frontiers in Insect Science 2022, doi 10.3389/finsc.2022.851010). [가능성 높음] 유인제만으로도 일부는 다시 오지만, 갇혔다 풀려난 개체는 먹이 보상이 없으면 재방문이 줄 수 있다. [추측] 줄어드는 양은 자료 없음 → 조사 모드에서 표시 색을 둘로 나눠 먹이 줌/안 줌 재포획률을 비교한다(내년 봄·여름).
3. [가능성 높음] **목표가 "재포획 여부 확인"이면 한 색으로 충분하다.** 개체를 구분할 필요가 없으니 마커 1개 → 마킹부 구조가 가장 단순해진다 (3장 Q4).
4. [가능성 높음] 재포획 로그는 **표지–재포획법**(Lincoln–Petersen 등)으로 양봉장에 오는 말벌 수를 어림하는 데 쓸 수 있다 — 보고서에서 "로그가 무엇에 쓰이는가"의 답이 됨. (적용 가능 여부는 문헌 확인 필요)
5. [확실] 개체 확인(S3)이 모든 분기의 입력이므로, 판별이 틀리면 여왕벌을 놓아주거나 일벌을 가둔다 → 판별 오류 시 어느 쪽이 덜 손해인지 정해야 함 (10/11: 여왕벌을 놓치는 쪽 손해가 큼 → 애매하면 가둠).

## 3. 정해야 할 것

| 번호 | 질문 | 영향 |
|---|---|---|
| Q1 | 마킹 재료 | **수성 아크릴 마커 유지** (서현 10/28) | 마킹부, 건조 시간 |
| Q2 | 재포획 일벌 처리 | **로그 + 먹이 + 방생, 덧칠 안 함** (서현 10/28) | 처리 시간, 구동 순서 |
| Q3 | 장수말벌 등 다른 말벌 종 | 방제 모드: 전부 가둠. 조사 모드: **입구 크기로 1차 거름 + 카메라 2차 판별** (6장, 서현 확정 10/28) | 판별 클래스, 모듈 입구·통로 크기 |
| Q4 | 표식 색 | **한 색** (재포획 여부만) (서현 10/28) | 마커 1개 → 마킹부 단순 |

## 4. 요구사항 (10/28 확정 — 표의 제안값은 서현 채택, CAP-AI-08)

| 번호 | 요구사항 | 목표값 | 근거 | 확인 방법 |
|---|---|---|---|---|
| R1 | 등검은말벌 판별 | ② VespAI 시험 후 정함 | VespAI 논문 | 표본·사진 시험 |
| R2 | 여왕벌 판별 — 놓치지 않는 쪽 | 흉부 폭 기준 4.5 mm보다 낮게 (값은 표본 실측 후) | Pérez-de-Heredia 2017, 10/11 | 표본 실측 |
| R3 | 마킹 성공률 (흉부에 카메라로 식별되는 점) | 80% 이상 (표본·더미 기준) | O2-1, O6-1 | P1 반복 시험 |
| R4 | 표식 유지 | 24시간 이상 | 10/7 팀 기준 | 마커 벤치 시험 |
| R5 | 재포획 표식 인식 | 90% 이상 | S4-c, S5 | 표식 있는 더미로 시험 |
| R6 | 한 마리 처리 시간 (진입 → 방생) | 3분 이내 (급이 시간 포함) | 새벽에 여러 마리가 몰림 | P1 측정 |
| R7 | 말벌 손상 없음 | 힘 상한 미정 → 표본 시험 | O3-1 | 표본 압축 시험 |
| R8 | 로그 (두 모드 모두) | 시각·종 분류·계급·표식 유무·사진, 누락 0 | S5, 5장 | P3 시연 |
| R9 | 결합 | 상용 트랩 차양막 위·포획통 아래에 끼움, 공구 없이 탈착 | C9 | 실측 후 |
| R10 | 전도 | 바닥 설치, 기준 풍속에서 넘어지지 않음 (풍속 미정) | C1, 상용 트랩 자갈 사용 | S4 계산 |
| R11 | 부품비 | 2대 기준 대당 30만 원 이내 | C3 | BOM |
| R12 | 운용 시간대 | 새벽 4:30~8:00 포함 → 촬영 조명 필요 | 상용 트랩 설명서 | — |

## 5. 운용 모드 (서현 결정, 2026-10-28)

| 모드 | 동작 | 비고 |
|---|---|---|
| **방제 모드** | 구별 없이 **전부 가둠** + **촬영·종 분류 로그를 남김** (서현 10/28) | 로그 = 출현 감지 데이터 (공공기관 판매 가치) |
| **조사 모드** | 여왕벌 가둠, 일벌 마킹 → 먹이 → 방생, 재포획 로그 | **허가 필요** (7장) |

## 6. Q3 검토 — 다른 종을 입구 크기로 거르는 게 맞나 (CAP-AI-06)

먼저 구분: **입구 크기로 여왕벌·일벌을 가르자는 게 아니다.** 그건 불가능하다 — [확실] 흉부 폭 경계 차이가 약 0.1 mm (일벌 3.79–4.49, 신여왕벌 4.61–4.87 mm, Pérez-de-Heredia 2017, 10/12 보고 8쪽). 여왕벌·일벌은 카메라로 가른다. 입구로 거르자는 건 **크기가 훨씬 큰 장수말벌**이다.

| 값 | 등검은말벌 여왕벌 (통과해야 함) | 장수말벌 일벌 (막아야 함) | 근거 |
|---|---|---|---|
| 몸길이 | 최대 약 30 mm | 35–40 mm (여왕벌 50 mm 이상) | vespa-bicolor·BWARS / Wikipedia |
| 머리 폭 | 문헌값 없음 — 시판 선택 트랩 봄(여왕벌)용 입구가 9 mm | 약 9.6 mm (일본 일벌 5마리 평균) | VespaCatch / Matsuura & Sakagami 1973 표 2 (단위 환산은 Claude 계산, 미검증) |

판단:
1. [가능성 높음] **대부분의 장수말벌은 거를 수 있지만 여유가 얇다.** 9 mm 입구 대 머리 폭 평균 9.6 mm — 평균이라 작은 일벌은 통과할 수 있다.
2. [가능성 높음] **같은 크기대의 다른 말벌(좀말벌·털보말벌 등 토착종)은 못 거른다.** 종 판별은 결국 카메라가 해야 한다.
3. 결론: **입구 크기는 1차 거름(장수말벌 대부분 차단, 비용 0), 카메라가 2차 판별.** 입구만으로 해결되지는 않는다. 입구 치수는 등검은말벌 여왕벌 머리 폭·장수말벌 소형 일벌 머리 폭을 표본으로 재서 정한다.
4. 방제 모드에서는 어차피 전부 가두므로 이 문제가 없다.

## 7. 법적 제약 — 조사 모드의 방생은 허가가 필요 (CAP-AI-06) · **보류: 서현 "법은 나중 이야기, 만드는 것에 집중" (10/28)**

- [확실] **등검은말벌은 2019년 7월 26일부터 생태계교란 생물**이다 (환경부 지정, 곤충류 3종 중 하나).
- [확실] 생물다양성법 제24조제1항: 생태계교란 생물의 수입·반입·사육·재배·**방사**·이식·양도·양수·**보관·운반**·유통 금지. 예외는 학술연구·교육·전시 등으로 **환경부(유역·지방환경청) 허가**를 받은 경우. 위반 시 2년 이하 징역 또는 2,000만 원 이하 벌금.
- [가능성 높음] 법제처 해석(18-0488): 생태계교란 어류를 잡아 **살아 있는 채로 놓아주는 것은 '방사'** → 같은 논리면 **조사 모드의 마킹 후 방생은 허가 없이 하면 위법**. (해석 이후 법이 개정됐다는 언급이 있어 현행 조문 확인 필요)
- 설계·운영에 미치는 영향:
  1. 조사 모드는 **허가받은 기관(정부·지자체·연구기관)만 운용** → 판매 대상이 공공기관이라는 판단과 맞물림
  2. 2027년 살아 있는 말벌 시험(방생 포함)은 **금강유역환경청 학술연구 허가**를 미리 받아야 함 [가능성 높음 — 관할청 확인 필요]
  3. 일반 판매·농가용은 방제 모드만
- 확인할 것: 현행 생물다양성법·시행규칙 조문(국가법령정보센터), 허가 절차·소요 기간, 죽은 표본 보관이 '보관'에 해당하는지

## 8. 판매 대상 — 공공기관 (서현 판단, 2026-10-28)

- 서현: 양봉농가·말벌 사냥꾼은 규모가 작음 → 공공사업으로 정부에 판매
- [가능성 높음] 7장 때문에 조사 모드는 사실상 공공기관만 쓸 수 있어 이 판단을 뒷받침한다. 다만 **실제 사용자는 양봉장 현장**이고 돈을 내는 쪽이 정부·지자체인 구조 — 예: 농촌진흥청 「봄철 전국 동시 방제」(2026-06-05)처럼 지자체(농업기술센터) 방제 사업으로 트랩을 보급하는 경로 [추측 — 보급 방식 확인 필요]
- 그러면 요구사항이 바뀐다: 여러 대 설치·원격 수집(로그 통합), 유지보수 간소화, 대당 단가 → R8·R11 재검토

다음: 목표값 확정 → D2 기능 시퀀스·기능계통도 갱신 → D3 형태분석표.
