britams/-capstone-project-repo/design/2026-10-28_D0_재설계_전제와_절차.md

# D0 재설계 — 전제 · 제약 · 설계 절차

정리일: 2026-10-28 · 작성: 이서현 (Claude와 정리, CAP-AI-03)
상태: **초안 — 팀(서현·승준)이 함께 확정할 것** · 10/28 레트로핏 방향 확정 반영

---

## 1. 재설계 전제

- **10/26 발표 설계(1안 챔버+XY, A안 터널형, B안 제네바, 600번대 유인·진입부)는 쓰지 않는다.** 발표용으로 급히 만든 것이라 처음부터 다시 설계한다 (서현, 2026-10-28).
- 10/26 이전 결정 중 유지하는 것 (10/28 서현 확인):
  1. 목표: 트랩으로 잡음 → 개체 확인 → 여왕벌 가둠 → 일벌은 마킹 후 먹이 주고 방생 → 재포획 시 로그 (`design/2026-10-28_D1_동작순서와_요구사항.md`)
  2. 마킹 재료: 수성 아크릴 마커, 한 색
  3. 마킹은 사람 없이 기계가 한다 — 팀 차별점
- 10/11 목적계통도·기능계통도는 출발점으로 쓰되, 이번 절차의 D2에서 다시 점검한다.

## 2. 설계 제약 (확정된 것)

| 번호 | 제약 | 근거 |
|---|---|---|
| C1 | 평평한 바닥에 놓는 방식 | 서현 2026-10-28 |
| C2 | 상용 트랩 「야생 말벌 포획기」((주)야생)를 참고해 설계 | 서현 2026-10-28, 실물 보유 |
| C3 | 예산 약 60만 원 → **재료비 지원 50만 원, 해외구매·중고 불가** (승준 10/28, D6 6장) | 계획서 → 경진대회 설명회 |
| C4 | 보유 물품을 최대한 활용 | `inventory/2026-10-28_보유물품_목록과_활용계획.md` |
| C5 | 3D 프린터 사용 가능 (Craft-Lab, 문의 후) | 서현 2026-10-28 |
| C6 | CAD는 FreeCAD, 역학계산은 시스템설계및제어 S4 양식 | 서현 2026-10-28 |
| C7 | 살아 있는 말벌 시험은 2027년 7~8월. 그 전에는 표본·더미 | 10/1 검토 |
| C8 | 2인 팀 (이서현·이승준), 기한 2027년 여름 | — |
| C9 | **상용 트랩에 얹는 추가 모듈(레트로핏)** — 유인·진입·꿀벌 분리는 상용 트랩이 맡음 | 서현 2026-10-28 (4장) |

## 3. 참고 상용 트랩 분석 — 야생 말벌 포획기

출처: 제품 상자 스캔 3장, 실물 사진 9장 (서현 PC `capstone design_이서현\지금가지고 있는 물품\`)

| 항목 | 내용 | 우리 설계에 주는 의미 |
|---|---|---|
| 크기 | 26 × 26 × 40 cm | 전체 크기 기준선 |
| 구조 (아래→위) | 액체 유인액 통(갈색) → 고체 유인제 망(초록 격자) → 몸통 + 말벌 포획구(노란 깔때기, 실리콘 포획술, 2곳) → 차양막(초록 지붕) → 포획통(투명 구형, 바닥 실리콘 포획술, 옆면 꿀벌 탈출망 슬롯) → 실리콘 뚜껑·손잡이 | 유인·진입·꿀벌 분리·비 가림이 이미 해결된 구조 |
| 핵심 원리 | 빛의 광도차를 인식하는 말벌의 습성 → 들어온 말벌이 밝은 위쪽 포획통으로 올라감 | 말벌이 **스스로 위로 올라가는 경로**가 있음 → 그 경로에 장치를 넣을 수 있음 [가능성 높음] |
| 꿀벌 분리 | 꿀벌은 포획통 위쪽 슬롯으로 바로 탈출 | 비표적 곤충 피해(O3-2) 해결 방식 참고 |
| 분리 방식 | 몸통을 돌려서 분리 (트위스트 결합) | 결합 방식 참고 |
| 설치 | 벌통에서 80~120 cm, 산 쪽(말벌이 오는 방향). 포획구 높이 지면에서 20~25 cm. 포획구 방향은 벌 드나드는 길목과 평행 | 바닥 설치(C1)와 같음. 포획구 높이 = 설계 치수 |
| 전도 방지 | 유인액 통에 자갈을 채워 바람에 넘어지지 않게 함 | **전도 계산(S4)이 실제로 필요한 문제**라는 근거 |
| 운용 | 새벽 4:30~8:00에 흑등(등검은)말벌이 많이 잡힘. 매일 저녁 유인액 보충 | 카메라 조명·전원 운용 시간대, 먹이 보충 주기 |
| 말벌 처리 | 포획통을 냉동실에 약 5분 → 기절 | 표본 채집 방법, 저온 마취 가능성 |
| 지식재산 | 특허 제10-1799771호, 제10-1845239호, PCT/KR2016/011319 | 구조를 그대로 복제한 제품은 문제될 수 있음. 결합형 추가 모듈은 청구항 확인 필요 [추측] |

## 4. 먼저 정할 큰 선택 — 상용 트랩에 얹는 모듈 vs 새 트랩

| | (가) 상용 트랩 추가 모듈 (레트로핏) | (나) 새 트랩 일체형 |
|---|---|---|
| 개념 | 차양막과 포획통 사이(말벌이 위로 올라가는 길)에 마킹 모듈을 끼움 | 유인·진입·마킹·격리를 모두 새로 설계 |
| 장점 | 유인·진입·꿀벌 분리는 검증된 제품에 맡기고 마킹(차별점)에 집중. 양봉농가가 이미 가진 트랩에 붙이는 제품 → 상업성 설명 쉬움. 보유 트랩으로 바로 시험 | 치수·배치를 자유롭게 정함. 특허 문제 없음 |
| 단점 | 상용 트랩 치수에 묶임. 특허 청구항 확인 필요. 포획통 위로 올라가는 말벌은 먹이가 없음 → 먹는 동안 마킹하려면 모듈에 급이구 필요 | 유인·진입을 다시 검증해야 함 (살아 있는 말벌 없이 검증 어려움). 작업량 증가 |
| 판단 | [가능성 높음] 2인·1년·표본만 있는 조건에서는 (가)가 유리 | |

**결정 (2026-10-28, 서현): (가) 상용 트랩 추가 모듈(레트로핏)로 간다.** (CAP-AI-04)
- 따라오는 확인 사항: ① 특허 제10-1799771호·제10-1845239호 청구항과 겹치는지 (KIPRIS에서 확인) ② 모듈이 끼워질 자리(차양막 구멍·포획통 바닥 결합부) 실측 ③ 포획통으로 올라가는 경로에 먹이가 없으므로, 먹는 동안 마킹하려면 모듈에 급이구가 필요한지 D3에서 판단

## 5. 설계 절차 — 이렇게 진행한다

10/26에 문제가 생긴 원인 [가능성 높음]: 대안 비교 없이 스케치 → CAD로 바로 가서, 그려 본 뒤에야 "말벌 위치를 모른다·구동기 7개" 같은 문제가 드러남. 이번에는 **기능별 대안을 먼저 비교하고 고른 뒤** 그린다.

| 단계 | 내용 | 산출물 | 수업 회차 대응 |
|---|---|---|---|
| D0 | 전제·제약·참고 제품 분석 (이 문서) | 이 파일 | — |
| D1 | **요구사항 명세**: 목적계통도의 2차 목적을 측정 가능한 목표값으로 | 요구사항 표 | S0·S3 문제기술서 |
| D2 | **기능 구조 재점검**: 말벌 한 마리의 동작 순서(시퀀스)대로 기능 나열 | 기능 시퀀스도 + 기능계통도 갱신 | S2 계통도 갱신 |
| D3 | **형태분석표**: 기능마다 해법 후보 3~5개 | 형태분석표 | S1~S2 |
| D4 | **조합안 2~3개 → 가중치 평가표 → 선정** | 평가표, 선정 이유 | S2·S3 |
| D5 | 개념설계도 재작성 (특허도면식, 도면부호) | 도 1·도 2, 대응표 | S3 3-1 |
| D6 | 설계 변수표 (모든 치수를 변수로, 잠정값 + 근거 + 확정 방법) → S4 역학계산 | 변수표, 역학계산 워크시트 | S4 |
| D7 | FreeCAD 파라메트릭 모델 (Spreadsheet로 D6 변수와 연결) → 도면 | .FCStd, 도면 PDF | S5 |
| D8 | 부품표(BOM)·구매 → P1 시제품 | BOM | → 할 일 ③ |

## 6. D1 요구사항 초안 (목표값은 팀이 정함)

| 번호 | 요구사항 | 목표값 (안) | 근거 | 상태 |
|---|---|---|---|---|
| R1 | 마킹 성공률 (흉부에 식별 가능한 점) | 미정 | O2-1, O6-1 | 팀 결정 |
| R2 | 표식 유지 | 24시간 이상 | 10/7 팀 기준, 재방문 간격 수 분 | 유지 확인 |
| R3 | 한 마리 처리 시간 | 미정 | 말벌 체류 시간 | 자료 조사 |
| R4 | 말벌에 가하는 힘 상한 | 미정 (표본 시험으로) | O3-1 | 시험 필요 |
| R5 | 여왕벌 판별 | 흉부 폭 기준 4.5 mm 근처 | Pérez-de-Heredia 2017 | 유지 확인 |
| R6 | 전체 크기 | 상용 트랩 26×26×40 cm 근처 | C2 | 팀 결정 |
| R7 | 바람에 넘어지지 않음 | 기준 풍속 미정 | 상용 트랩 자갈 사용 | S4 계산 |
| R8 | 꿀벌 등 비표적 곤충 방출 | 상용 트랩 수준 | O3-2 | — |
| R9 | 1대 부품비 | 60만 원 안 (2대 만들면 대당 ½) | C3 | 대수 결정 |
| R10 | 무인 운용 시간 | 미정 (새벽 4:30~8:00 포함) | 상용 트랩 설명서 | 팀 결정 |

## 7. D3 형태분석표 초안 (말벌 동작 순서대로 · 고르는 건 팀이)

| 기능 | 후보 a | 후보 b | 후보 c | 후보 d |
|---|---|---|---|---|
| F1 유인 | 상용 트랩 유인제 그대로 | 모듈 급이구의 당류 먹이 | a + b | — |
| F2 진입·한 마리 분리 | 상용 트랩 깔때기 → 위로 오르는 통로에 문 2개(에어록) | 한 방향 깔때기 + 셔터 | 회전 칸 | 좁은 통로 + 빛으로 유도 |
| F3 위치·자세 고정 | 급이구에서 먹는 동안 (행동 이용) | 좁은 통로 (구조) | 망·판으로 살짝 누르기 (양봉 여왕벌 마킹 튜브 방식) | 저온 마취 (상용 설명서: 냉동 5분에 기절) |
| F4 판별 (종·여왕벌·기존 표식) | 카메라 + AI (Pi 5 + AI HAT+, 보유) | AI 카메라 단독 (IMX500, 보유) | 무게 (로드셀) | 기계식 체 (구멍 크기) — 흉부 폭 차이 0.1 mm라 [가능성 높음] 부적합 |
| F5 마킹 도포 | 마커 직선 하강 (리드스크루·래크) | 서보 암 회전 | 슬라이더-크랭크 / 캠 | 스탬프 패드 |
| F6 배출·격리 | 방생문 + 격리 트랩도어 | 상용 트랩 포획통을 격리함으로 | 경로 분기 게이트 (회전 플랩) | — |
| F7 마커 건조 방지 | 캡 | 젖은 스펀지 대기 | 교체 주기로 관리 | — |
| F8 기록·알림 | Pi 로그 + Wi-Fi 알림 | LCD/OLED 현장 표시 (보유) | — | — |
| F9 전원 | 어댑터 (시험) | 배터리 + 태양광 (현장) | — | — |

다음 할 일: 1~4장 확인 → D1 목표값 → D3에서 기능별 후보 1~2개로 좁히기 → D4 조합·평가.
