britams/-capstone-project-repo/design/2026-10-28_D3_형태분석표와_조합안.md

# D3 형태분석표와 조합안 (1차)

정리일: 2026-10-28 · 작성: 이서현 (Claude와 정리, CAP-AI-09) · 상태: **확정 (10/28) — 안 1 바닥 승강형 선택** (서현, CAP-AI-10)
앞 단계: `design/2026-10-28_D2_기능시퀀스와_기능계통도.md` · 원칙: **한 마리를 목적대로 제대로**

---

## 0. 이 단계의 핵심 위험

[가능성 높음] 한 마리를 제대로 처리하는 데 가장 큰 걸림돌은 **④ 자세 고정 — 마커를 찍을 때 흉부 등쪽이 정해진 위치에서 마커를 보고 있어야 한다**는 것이다.
- 살아 있는 말벌은 2027년 7~8월에야 시험할 수 있다. 그 전엔 표본·더미뿐이다.
- 그래서 **말벌의 행동(스스로 먹이에 머리를 댄다, 통로에서 똑바로 걷는다 등)에 기대는 해법은 지금 검증할 수 없다.** 기구가 자세를 만드는 해법일수록 표본·더미 시험이 의미 있다.
- 평가 기준에 '표본·더미로 검증 가능'을 넣은 이유.

## 1. 형태분석표

| 기능 | 후보 a | 후보 b | 후보 c | 후보 d |
|---|---|---|---|---|
| **F1-2·1-3 한 마리 분리·차단** | 앞뒤 문 2개 (에어록, 서보 플랩) | 회전 칸 (한 칸에 한 마리) | 슬라이드 게이트 (솔레노이드) | 한 방향 깔때기 + 뒤 문 1개 |
| **F2-1 진입 감지** | 적외선 빔 센서 (구매) | 카메라 움직임 감지 (ViBe, VespAI 방식) | 리미트 스위치·무게 | — |
| **F3-1 자세 고정** | **승강 바닥이 말벌을 위 격자망에 살짝 밀어붙임** (양봉 여왕벌 마킹 튜브 원리 — 바닥에 선 말벌은 등이 위를 향함) | 몸 폭에 맞춘 좁은 통로 (몸을 못 돌림) | 저온 마취 (펠티어 냉각) | 위에서 스펀지 판으로 누름 |
| **F3-2 고정 힘 제한** | 바닥 아래 스프링 + 하중 센서 | 모터 전류로 힘 추정 | 카메라로 위치만 보고 정지 | 스프링만 (수동 제한) |
| **F3-3 흉부 도포** | 마커 직선 하강 (리드스크루 + 스테핑, 보유 28BYJ-48) | 서보 암 회전으로 팁 찍기 (보유 SG90) | 슬라이더-크랭크 | 솔레노이드 푸시 |
| **F3-4 마커 마름 방지** | 대기 위치에서 캡에 꽂힘 | 젖은 스펀지에 팁 대기 | 교체 주기로 관리 | — |
| **F4-2 급이** | 바닥판의 급이구 + 심지(모세관)로 당액 | 작은 펌프로 급이구에 공급 | 젤리 먹이 블록 | — |
| **F5-1·5-3 배출 분기 (격리 / 밖으로 방생)** | 회전 플랩 1개로 두 방향 | 출구마다 문 1개씩 | 칸 자체를 돌려 출구 선택 | — |
| **F5-3 방생 출구 한 방향** | 바깥으로 향한 한 방향 깔때기 (상용 트랩 실리콘 포획술을 반대로) | 방생할 때만 여는 문 | — | — |
| **F7 고장 시 '가둠'** | 문은 스프링 복귀로 기본 '격리 쪽 열림·방생 쪽 닫힘' | 전원 끊기면 래치가 격리 쪽으로 | — | — |

자세 고정 보조 수단 (어느 안에나 붙일 수 있음):
- 벽·천장을 **미끄러운 플라스틱 재질**로 만듦 (서현 10/28 — 코팅 대신 재질로. 후보: PTFE·POM·HDPE 판, 표본·더미로 미끄러짐 확인) → 말벌이 바닥에 머물게
- 빛 방향 조절 → 말벌이 원하는 면으로 가게 [추측 — 표본으로는 확인 불가]
- 카메라로 흉부가 마커 쪽인지 확인 → 아니면 바닥을 내렸다가 다시 올림 (재시도)

## 2. 조합안 3개

| | 안 1 — 바닥 승강형 | 안 2 — 좁은 통로형 | 안 3 — 회전 칸형 |
|---|---|---|---|
| 분리 | a 앞뒤 문 2개 | a 앞뒤 문 2개 | b 회전 칸 |
| 자세 고정 | **a 승강 바닥 → 위 격자망** | b 좁은 통로 | a 칸 바닥 승강 |
| 힘 제한 | a 스프링 + 하중 센서 | 해당 없음 | a |
| 도포 | a 마커 하강 (격자 눈 사이로) | a 또는 b (위 슬롯으로) | a |
| 급이 | a 바닥판 급이구 (고정 풀고 같은 자리에서) | a 통로 끝 급이구 | a 급이 칸 |
| 분기 | a 회전 플랩 | b 출구별 문 | c 칸 회전 |
| 구동기 (어림) | 문 2 + 바닥 1 + 마커 1 + 플랩 1 = 5 | 문 2 + 마커 1 + 출구 1 = 4 | 회전 1 + 바닥 1 + 마커 1 = 3 (정밀도 높음) |
| 로보틱스 요소 | 힘 제어 승강, 카메라 피드백 재시도 | 적음 | 인덱싱 기구 |
| 핵심 위험 | 말벌이 천장(격자)에 거꾸로 붙어 있으면 등이 아래를 봄 → 재시도·미끄럼 코팅 | 말벌이 통로에서 멈추지 않거나 뒤집혀 걸음 — **행동 의존, 지금 검증 불가** | 칸 틈에 다리·더듬이 끼임, 제작 정밀도 |

## 3. 평가표 (가중치·점수는 Claude 제안 [추측] — 회의에서 고칠 것)

| 기준 | 가중치 | 안 1 | 안 2 | 안 3 |
|---|---|---|---|---|
| 한 마리 마킹 성공 가능성 (자세가 확실히 잡히나) | 30 | 4 | 3 | 3 |
| 표본·더미로 지금 검증 가능 | 20 | 5 | 2 | 3 |
| 말벌 손상 위험 낮음 | 15 | 3 | 4 | 2 |
| 제작 쉬움 (구동기 수·정밀도) | 15 | 3 | 4 | 2 |
| 보유품 활용·비용 | 10 | 4 | 4 | 3 |
| 로보틱스 요소 (지도교수 조건) | 10 | 5 | 3 | 4 |
| **합계 (5점 만점 환산)** | 100 | **4.0** | 3.2 | 2.8 |

[가능성 높음] **안 1(바닥 승강형)을 권한다.**
- 양봉가가 실제로 쓰는 여왕벌 마킹 튜브(밀어 올려 망에 붙인 뒤 망 너머로 표시)와 같은 원리라 근거가 있다.
- 자세를 기구가 만들기 때문에 표본·더미로 시험할 수 있다.
- 힘 제어 승강과 카메라 피드백 재시도가 로보틱스 요소가 된다.

안 1의 첫 시험 항목 (P1 전에 표본·더미로):
1. 격자 눈 크기: 마커 팁은 통과, 말벌 머리·다리는 못 빠짐
2. 바닥이 밀어 올릴 때 필요한 힘과 표본이 상하지 않는 힘 상한 (R7)
3. 천장에 거꾸로 붙은 경우 재시도로 몇 번 만에 등이 위로 오나 (더미)

## 4. 결정 (10/28)
- **안 1 바닥 승강형으로 간다** (서현). 벽·천장은 미끄러운 플라스틱 재질.
- 평가표 점수는 Claude 추정값 그대로 둠 (근거 기록용).
- 다음: D5 개념설계 (`design/2026-10-28_D5_개념설계_안1.md`) → D6 설계 변수표·역학계산
