britams/-capstone-project-repo/docs/2026-10-28_분업계획_서현_승준.md

# 분업 계획 — 이서현 · 이승준 (둘 다 Claude 사용)

정리일: 2026-10-28 · 작성: 이서현 (Claude와 정리, CAP-AI-03·04) · 상태: **승준 확인 전 초안**
공유: GitHub 레포 https://github.com/britams/-capstone-project-repo — 사람은 Chrome으로만 사용 (`docs/GitHub_사용법_Chrome.md`)

---

## 1. 원칙

1. **기구(서현) ↔ 비전·전자(승준)로 나눈다.** 두 영역이 만나는 곳은 `design/인터페이스_정의서.md` 한 파일로만 맞춘다. [가능성 높음] 두 영역은 인터페이스만 정해지면 동시에 진행할 수 있어 2인 팀에 가장 효율적이다.
2. **개념 선정(D3·D4)과 표본 채집은 같이 한다.** 구조를 고르는 결정에 둘 다 참여해야 나중에 뒤집히지 않는다.
3. **파일마다 담당자 1명.** 남의 파일은 고치지 않는다. 고칠 게 있으면 그 사람에게 말하거나, 자기 이름으로 새 날짜 파일을 만든다 (공유 폴더 동기화 충돌 방지).
4. **각자 자기 Claude로 작업하고, AI 로그는 각자 파일에 남긴다.** 둘 다 `docs/00_새채팅_시작키.md`로 새 채팅을 시작한다 (키 안에 이름을 넣는 줄이 있음).
5. **공유 문서의 원본은 GitHub 레포.** 서현 PC 폴더는 논문·PPT·사진·FreeCAD 작업 보관용이다.

## 2. 역할

| | 이서현 (팀장) | 이승준 |
|---|---|---|
| 주 담당 | **할 일 ① 설계·역학계산** — D1~D7, FreeCAD, S4 역학계산 | **할 일 ② VespAI·비전** + 전자·제어 |
| 부 담당 | 문서 관리: 인수인계, 보고서 정리, 진행 PPT 틀 | **할 일 ③ 구매** — BOM 정리, 견적, 주문, 예산 장부 |
| 같이 | 표본 채집·실측, D3·D4 개념 선정 회의, 보고 발표 | 같은 항목 |
| 편집하는 파일 (레포) | `docs/`, `design/`(인터페이스 정의서 제외), `cad/`, `ai-log/AI_명령사항_로그.md` | `vision/`, `control/`, `purchase/`, `inventory/`, `ai-log/AI_명령사항_로그_승준.md` |
| 같이 편집 | `design/인터페이스_정의서.md` — 바꿀 때는 둘이 합의하고 변경 이력을 적음 | |

※ 승준의 강점(코딩·전자 경험 등)에 따라 바꿀 수 있음 — **승준 확인 필요**

> **2026-11-14 서현 결정:** 승준이 11/09 이후 작업하지 않음 → "승준 무시하고 우리가 다 해" (서현 22:48). 이날부터 **승준 담당(비전·전자·제어·구매) 일도 서현이 맡는다.** 승준 파일은 지우지 않고, 서현이 새로 쓰거나 서현 파일(`design/circuit/firmware/`, `관련코딩저장/`)에서 고친다 (CAP-AI-62).

## 3. 인터페이스 정의서에 들어갈 것 (기구 ↔ 비전·전자 경계)

| 항목 | 정하는 사람 | 상대에게 필요한 이유 |
|---|---|---|
| 카메라 위치·방향·말벌까지 거리·시야 | 승준 (시험값) → 서현 (배치) | 서현: 장착부 설계 / 승준: 초점·해상도 |
| 조명 (종류, 위치) | 승준 | 서현: 장착 공간 |
| 구동기 목록 (종류, 전압, 토크·행정, 신호) | 서현 (필요 힘·행정) ↔ 승준 (구동·배선) | 역학계산 결과가 구동기 선정으로 이어짐 |
| 센서 목록 (진입 감지 등) | 승준 | 서현: 장착 위치 |
| 전장품 크기·장착 공간 (Pi 5 + HAT, 아두이노, 전원) | 승준 (치수) → 서현 (함 설계) | 하우징 설계 |
| 동작 순서 (상태 머신) | 같이 | 기구 동작 = 제어 순서 |
| Pi ↔ 아두이노 통신 명령 | 승준 | — |
| 전원 (전압, 소비 전력, 운용 시간) | 승준 | 서현: 배터리 공간 |

## 4. 2주 일정 (다음 보고까지)

다음 진행 보고일은 **11/9(월)로 가정** [추측 — 9/28·10/12·10/26 2주 간격 기준, 확인 필요].

| 날짜 | 서현 | 승준 | 같이 |
|---|---|---|---|
| 10/28(수)~10/30(금) | D0 확인, D1 요구사항 목표값 초안, 레포 비공개 전환·승준 초대·첫 업로드 | GitHub 가입·초대 수락, `docs/GitHub_사용법_Chrome.md` 따라 해 보기, 시작키로 Claude 첫 세션, 보유 물품 실물 점검(전원·microSD·서보 개수) | **표본 채집 시작**: 상용 트랩 설치 장소 확보(양봉장·산 근처) 또는 최문보 교수님께 표본 요청 |
| 10/30(금) | | | **회의 1**: 분업 확정, (가) 레트로핏 vs (나) 새 트랩 결정, 10/11 결정 3개 유지 여부 |
| 10/31~11/2 | D2 기능 시퀀스, D3 형태분석표 정리 | Pi 5 + AI HAT+ + AI 카메라 셋업, VespAI 저장소 받아 PC에서 예시 이미지로 실행 | |
| 11/3(월) | | | **회의 2**: D3 → D4 조합·평가표 → 구조 선정 |
| 11/4~11/7 | D5 개념설계도(특허도면식), D6 설계 변수표, S4 4-1·4-2 (외력·가상 절단) | VespAI를 Pi 5로 옮겨 실행, 흉부 표식(색 점) 검출 시험, 서보·스테핑 아두이노 구동 시험, BOM 초안 | 인터페이스 정의서 1차 |
| 11/6~11/8 | | | 표본 실측 (흉부 폭·몸 높이·머리–흉부 거리), 보고 PPT 각자 파트 |
| 11/9(월) | | | 진행 보고 |

## 5. 표본 채집 — 가장 급함

- [확실] 지금 가진 「야생 말벌 포획기」는 흑등(등검은)말벌을 잡는 제품이다. 설명서상 포획통을 냉동실에 약 5분 넣으면 기절한다.
- [가능성 높음] 등검은말벌은 11월까지 활동하고 그 뒤엔 봄까지 구하기 어렵다 (10/26 보고, 농촌진흥청 장기 조사 인용). **이번 주에 설치하지 않으면 표본 없이 설계 치수를 정해야 한다.**
- 경로 후보: ① 보유 트랩을 양봉장·산 근처에 설치 ② 최문보 교수님께 표본 요청 ③ 근처 양봉농가에 트랩에 잡힌 말벌 요청
- 안전: 살아 있는 말벌이 든 포획통은 목·바닥만 잡고(설명서), 보호 장갑 착용, 냉동 후 취급

## 6. Claude · GitHub 사용 방법 (둘 다)

- 새 채팅 시작: 레포 `docs/00_새채팅_시작키.md`의 `---` 사이를 붙여 넣고, 첫 줄의 이름을 자기 이름으로.
- **Claude에 GitHub를 연결하면** Claude가 레포를 직접 읽고 commit·push 한다 → 사람은 Chrome에서 확인만. 각자 자기 Claude에서 자기 GitHub 계정으로 연결 (승준은 레포 초대를 먼저 수락).
- **연결 안 했을 때**: Claude가 레포와 같은 폴더 구조로 파일을 만들어 주면 Chrome에서 **Add file → Upload files**로 올린다.
- 세션 끝: 자기 AI 로그 맨 아래에 항목 추가(서현 `CAP-AI-nn`, 승준 `CAP-AI-SJ-nn`) → 레포에 올라갔는지 Chrome에서 확인.
- AI 결과를 설계값·도면부호에 쓰면 그 자리에 로그 번호를 붙이고, 검증 못 한 값은 `미검증`.
- FreeCAD 모델은 Python 생성 스크립트(`cad/*.py`)와 함께 올린다 (.FCStd는 Git으로 병합이 안 되고, 서현만 편집).

## 7. 정해야 할 것
1. ~~공유 방법~~ → GitHub 레포 + Chrome으로 결정 (10/28)
2. ~~레포 공개/비공개~~ → 공개 유지 (서현 10/28), 승준 collaborator 설정 완료 (10/28)
3. 승준의 강점과 이 역할 배분에 대한 동의
4. 회의 요일·방식 (대면/온라인)
5. 다음 보고일

## 바뀜 (2026-11-08, 서현 총지휘 결정)
- 승준은 서현이 말할 때까지 작업 안 함 (11/07).
- **D5g CAD**(`cad/D5g_*.py`, 승준 AI가 만듦)는 서현이 이어받는다. 작업은 서현 PC VS Code Claude → `docs/2026-11-08_CAD_D5g_정리_작업지시_서현.md`.
- **펌웨어·Pi 코드**는 서현 폴더에 새로 (`design/circuit/firmware/`, 시뮬은 `관련코딩저장/`). ~~제어 규칙은 웹 채팅 Claude가 문서로 정하고 VS Code Claude가 코드로 옮긴다.~~ → **(11/08 저녁 서현) 제어 규칙도 VS Code Claude가 정한다. 웹 채팅은 쓰지 않는다.** 규칙은 코드 머리말 '안전 규칙'과 `design/` 검토 문서에 적는다. 승준 `control/`은 승준이 돌아오면 합친다.
- (18:36) **웹 채팅을 그만 쓰고 모든 작업(규칙·코드·CAD)을 VS Code Claude가 한다** → `docs/2026-11-08_VSCode_전체작업_명령_서현.md`.
