britams/-capstone-project-repo/cad/2026-11-10_D5g_3D프린트_부품목록.md

# D5g 3D 프린트 부품 목록 (서현, 2026-11-10, CAP-AI-58)

- **모델 색: 파랑 = 3D 프린트, 회색 = 그 밖** (구매품·판 가공·프레임·전기·트랩).
  - 판정은 `cad/D5g_parts_table.py`의 규격에 '3D 프린트'가 있는지로 한다. 색칠은 `cad/D5g_print_color.py`이 하고, `D5g_frame_detail.make()` 맨 끝에서 부른다.
  - 예전에는 프린트를 주황(SJ-53)으로 칠했다. 황동 인서트·베이지 데크·빨간 기판과 섞여 구분이 안 돼서 바꿨다.
- 이 표는 모델에서 바로 뽑았다 (객체 43개). 무게는 PETG 1.27 g/cm³, 꽉 채움 기준이다. 실제 출력(채움 15~30 %)은 이보다 가볍다.
- 판 크기를 확인할 것: 143 급이 방 높이 229 mm, 212 X 빔 끝 블록 묶음 140 mm, 218 X 봉 받침 묶음 208 × 157 (4개를 합친 크기). → Craft-Lab 프린터 판 크기가 정해지면 다시 본다.
- 판 가공(101 데크, 105 위판)은 3D 프린트가 아니다 (회색).

| 번호 | 이름 | 모델 이름 | 개수 | 크기 x × y × z (mm, 묶음 전체) | 부피 cm³ | PETG g (꽉 채움) | 메모 |
|---|---|---|---|---|---|---|---|
| 102_collar | 칼라 (트랩 고리와 틈 막이) | `102_collar` | 1 | 99.9 × 99.9 × 15 | 15.5 | 19.7 | 3D 프린트, 데크에 M3 × 4 |
| 104 | 돔 연결부 | `104_dome_coupling` | 1 | 90 × 90 × 10 | 39.9 | 50.6 | 3D 프린트 |
| 110 | 입구 통로 | `110_entry_duct` | 1 | 28 × 16 × 121.9 | 11.0 | 14.0 | 3D 프린트 |
| 111 | 입구 깔때기 | `111_entry_funnel` | 1 | 61 × 61 × 30 | 8.8 | 11.2 | 3D 프린트 |
| gate_flap | 입구 문 판 (미닫이) | `112_entry_gate_flap` | 1 | 1.5 × 26.7 × 19.3 | 0.6 | 0.8 | 3D 프린트 |
| 112 | 입구 문 하우징 | `112_entry_gate_housing` | 1 | 22.5 × 54.4 × 23 | 9.9 | 12.6 | 3D 프린트 |
| 120 | 마킹실 벽 | `120_chamber_walls` | 1 | 46 × 46 × 50 | 24.5 | 31.1 | 3D 프린트 |
| 121 | 마킹실 바닥판 | `121_chamber_base` | 1 | 46 × 46 × 5 | 10.4 | 13.2 | 3D 프린트 |
| 140 | 승강 바닥 | `140_lift_floor` | 1 | 39 × 39 × 6 | 9.1 | 11.5 | 3D 프린트 |
| 143 | 급이 방 물길·그릇·튜브 집게 | `143_feed_trough` | 1 | 44.6 × 92 × 229 | 58.3 | 74.0 | 3D 프린트 PETG |
| 143l | 급이 방 뚜껑 (벌레 막기) | `143l_feed_trough_lid` | 1 | 40 × 92 × 14 | 5.5 | 7.0 | 3D 프린트 PETG |
| 148s | 스프링 받침판 | `148s_spring_seat` | 1 | 12.7 × 25 × 6.5 | 0.7 | 0.9 | 3D 프린트 PETG |
| 151 | 바닥 구동 옆판 | `151_drive_side_L` | 1 | 10.5 × 47 × 125 | 22.9 | 29.1 | 3D 프린트, 데크에 M3 × 2 |
| 151 | 바닥 구동 옆판 | `151_drive_side_R` | 1 | 10.5 × 47 × 125 | 22.9 | 29.1 | 3D 프린트, 데크에 M3 × 2 |
| 152 | 바닥 모터판 | `152_motor_plate` | 1 | 38 × 46 × 3 | 4.9 | 6.2 | 3D 프린트 |
| 158 | 바닥 캐리지 + 로드셀 팔 | `158_carriage` | 1 | 36 × 97.5 × 32 | 31.5 | 40.1 | 3D 프린트 PETG |
| gate_flap | 격리 문 판 (미닫이) | `170_isolation_gate_flap` | 1 | 1.5 × 26.7 × 19.3 | 0.6 | 0.8 | 3D 프린트 |
| 170 | 격리 문 하우징 | `170_isolation_gate_housing` | 1 | 22.5 × 54.4 × 23 | 9.9 | 12.6 | 3D 프린트 |
| 172 | 격리 통로 (위 포획통으로) | `172_isolation_duct` | 1 | 28 × 15.9 × 216 | 19.3 | 24.5 | 3D 프린트 |
| 173 | 격리 깔때기 | `173_isolation_funnel` | 1 | 61 × 61 × 25 | 7.4 | 9.3 | 3D 프린트 |
| 174 | 방생 목 (30 mm) | `174_release_neck` | 1 | 31.2 × 16 × 16 | 2.6 | 3.4 | 3D 프린트 — 굴뚝과 한 덩어리 |
| 175 | 방생 굴뚝 (위로 날아 나감) | `175_release_shaft` | 1 | 54 × 54 × 75 | 30.1 | 38.2 | 3D 프린트 |
| gate_flap | 방생 문 판 (미닫이) | `176_release_gate_flap` | 1 | 1.5 × 26.7 × 19.3 | 0.6 | 0.8 | 3D 프린트 |
| 176 | 방생 문 하우징 | `176_release_gate_housing` | 1 | 22.5 × 54.4 × 23 | 9.9 | 12.6 | 3D 프린트 |
| 181 | 카메라 받침 | `181_camera_bracket` | 1 | 33 × 42 × 70 | 13.0 | 16.5 | 3D 프린트 |
| 193h | 와고 받침 (5칸) | `193h_wago_holder` | 6 | 98.1 × 50 × 6 | 7.5 | 9.6 | 3D 프린트, M3 × 3 + 너트 |
| 194b | 비상 정지·퓨즈 판 | `194b_estop_plate` | 1 | 4 × 94 × 70 | 16.8 | 21.4 | 3D 프린트 4 mm, M5 × 2 |
| 197 | ULN 보드 받침 | `197_uln_bracket_X` | 1 | 38 × 52 × 3.5 | 5.9 | 7.5 | 3D 프린트, 레일에 M5 × 2 |
| 197 | ULN 보드 받침 | `197_uln_bracket_Y` | 1 | 38 × 52 × 3.5 | 5.9 | 7.5 | 3D 프린트, 레일에 M5 × 2 |
| 198xc | HX711 받침 | `198xc_hx711_cradle` | 1 | 24.6 × 37.6 × 6.5 | 3.5 | 4.5 | 3D 프린트, 데크 탭 M3 × 2 (CAP-AI-55) |
| 199a | Pi 선반 | `199a_pi_shelf` | 1 | 89 × 67 × 48 | 26.5 | 33.6 | 3D 프린트, 위 가로대에 M5 × 2 |
| 199b | G4 게이트 받침 | `199b_gate_holder_G4` | 2 | 20 × 5 × 6 | 0.1 | 0.1 | 3D 프린트 |
| 199c | G6 게이트 받침 | `199c_gate_holder_G6` | 2 | 5 × 6 × 24 | 0.2 | 0.2 | 3D 프린트 |
| 202 | 마커 홀더 V블록 | `202_marker_holder_vblock` | 1 | 14.4 × 54 × 40 | 10.5 | 13.3 | 3D 프린트 |
| 203 | 마커 조임 띠 | `203_clamp_strap` | 1 | 13.4 × 28 × 30 | 5.6 | 7.1 | 3D 프린트 |
| 206 | Y 캐리지 (마커 이송) | `206_y_carriage` | 1 | 26.3 × 41.8 × 93.5 | 47.6 | 60.4 | 3D 프린트 |
| 211 | Y 모터 브래킷 | `211_y_motor_bracket` | 1 | 43 × 29.9 × 32 | 9.0 | 11.4 | 3D 프린트 |
| 212 | X 빔 끝 블록 (Y 봉 잡음) | `212_beam_end_blocks` | 2 | 28 × 140 × 95 | 82.2 | 104.4 | 3D 프린트 |
| 217 | X 모터판 | `217_x_motor_plate` | 1 | 38 × 44 × 52 | 12.5 | 15.9 | 3D 프린트, 레일에 M5 × 2 |
| 218 | X 봉 받침 | `218_rod_supports` | 4 | 208 × 157 × 16.5 | 33.8 | 42.9 | 3D 프린트, 레일에 M5 |
| 219 | 마커 뚜껑 컵 | `219_cap_cup` | 1 | 14 × 14 × 12 | 1.6 | 2.0 | 3D 프린트 |
| 220 | 컵 받침 | `220_cup_bracket` | 1 | 20 × 25 × 5 | 2.5 | 3.2 | 3D 프린트 |
| 226 | X 원점 스위치 집게 + 팔 | `226_x_home_clamp` | 1 | 19 × 43 × 18 | 9.2 | 11.7 | 3D 프린트 (CAP-AI-55) |
| | **합계** | | | | **650.7** | **827** | 실제 출력은 채움 15~30 %라 이보다 가벼움 |
