britams/-capstone-project-repo/ai-log/AI_명령사항_로그_승준.md

# 캡스톤(말벌 자동 마킹 트랩) AI 명령사항 로그 — 이승준

규칙은 `AI_명령사항_로그.md`(서현)와 같다. 번호는 `CAP-AI-SJ-nn`.
세션마다 맨 아래에 추가: 날짜 · 도구 · 명령 요지 · AI가 한 일 · 만든/고친 파일 · 검증한 것과 못 한 것 · 남은 결정.

---
(첫 항목은 승준이 첫 세션에서 작성)

## CAP-AI-SJ-01 · 2026-10-28
- 도구: Claude (Claude 앱, 승준 계정 skytree611 + GitHub 레포 연결)
- 명령 (요지): "GitHub로 동료와 프로젝트를 공유하려는데 GitHub와 MCP 연결하는 법 알려줘" → "동료(britams)가 만든 레포에 collaborator로 지정됐는데, 나와 내 Claude가 레포를 자유롭게 드나들게 해 줘"
- AI가 한 일:
  - Claude GitHub 앱 설치 화면에서 이 레포가 안 보이는 이유 설명 (앱 설치는 레포 주인 계정 기준 → 승준 계정 쪽에는 이 레포가 목록에 안 뜸)
  - 이 채팅에 레포를 쓰기 권한으로 연결·클론 성공, 이 로그 항목을 push해서 쓰기 권한 확인
  - `CLAUDE.md`, 인수인계(10/28), 분업계획(10/28), GitHub 사용법, 서현 로그 마지막 항목(CAP-AI-08) 읽음
- 만든/고친 파일: `ai-log/AI_명령사항_로그_승준.md` (이 항목)
- 검증: push 성공 여부는 커밋 기록으로 확인. 다른 새 채팅에서도 연결이 유지되는지는 미검증
- 남은 결정: 분업계획(승준 담당: VespAI·비전·전자·구매) 동의 여부, 10/30 회의 1, 표본 채집 경로

## CAP-AI-SJ-02 · 2026-10-28
- 도구: Claude (Claude 앱, GitHub 레포 연결 + 클라우드 작업 환경)
- 명령 (요지): 시작키로 새 세션 — 인수인계·분업계획·로그·인터페이스 정의서 읽고 승준 담당(할 일 ② VespAI)부터 이어서 진행
- AI가 한 일:
  - 읽기 순서대로 문서 확인 (인수인계 10/28, 분업계획 10/28, 승준 로그 SJ-01, 서현 로그 CAP-AI-08, 인터페이스 정의서, vision·control·purchase·inventory)
  - VespAI 원본 저장소 확인: `andrw3000/vespai`(HEAD `004f3d8`, 2026-09-15)가 원본, 인수인계의 `hiveeyes/vespai`는 2024-10-12에 멈춘 사본
  - 저장소 구조·실행 스크립트·설치 스크립트·라이선스 분석, 가중치 7개를 **로드하지 않고** 내부 문자열로 확인 → 박스 검출(Detect), 클래스 crabro·velutina 2개
  - 발견: ① 라이선스 CC BY-NC-SA 4.0(비영리) + AGPL → 판매 제품에 그대로 못 씀 ② 고정 YOLOv5(2022)와 torch ≥2.6 조합은 가중치 로드 실패 가능 ③ monitor_run.py에 메일 비밀번호 하드코딩 → `-e` 쓰지 말 것 ④ 한국 토착 말벌 클래스 없음 → 재학습 필요, 표본이 비전에도 필요
  - 예시 이미지 실행 시도 → 작업 환경 보안 정책(외부 .pt 로드 차단)으로 **실행 못 함**. 승준 PC에서 돌릴 스크립트와 절차 작성
  - 인수인계 수정 요청을 레포 Issue로 작성 (서현 담당 파일이라 직접 안 고침)
- 만든 파일: `vision/2026-10-28_VespAI_저장소_확인과_실행계획.md`, `vision/scripts/run_vespai_examples.py`
- 검증: 커밋 비교·가중치 클래스명·라이선스 원문 [확실]. torch 버전 문제는 코드 확인만(실행 `미검증`). Hailo·IMX500 변환 절차 `미검증`. 스크립트는 문법 검사만 통과(실행 `미검증`)
- 남은 결정: 승준 PC OS·Python → 1단계 실행, 상용 판매 시나리오 유지 여부(라이선스), 여왕벌 판별을 카메라/기구 중 무엇으로 할지(D3), 분업 역할 동의, 10/30 회의 1, 표본 채집 경로

## CAP-AI-SJ-03 · 2026-10-28
- 도구: Claude (Claude 앱, GitHub 레포 연결 + 승준 Windows PC 연결(셸 없음) + 클라우드 작업 환경)
- 승준 결정·명령:
  1. 서현의 지시를 따름. **분업계획 역할에 동의** (VespAI·비전·전자·구매)
  2. 표본: 인터넷에서 구매, 안 되면 최대한 구해 봄
  3. PC는 **Windows**, Python 다운로드함 (버전 미확인)
  4. `docs/2026-10-28_승준_작업지시.md`를 읽고 **J1부터** 진행, 끝나면 로그 기록·push
- AI가 한 일:
  - pull 후 읽음: 승준 작업지시(J1~J7), D5 개념설계 안 1, 서현 로그 CAP-AI-10·11, 인수인계 5장(Issue #1 반영 확인)
  - J1 직접 실행 시도 → 승준 PC는 연결돼 있으나 이 세션에 셸 도구가 없고, 문서 폴더 접근 요청은 거부됨. 클라우드에선 외부 가중치 로드가 막힘 → **승준이 더블클릭 한 번으로 실행하는 Windows 스크립트**로 전환
  - `j1_vespai_windows.ps1/.bat`: Python 3.12/3.11 찾기(경로 A: torch 2.3.1, 없으면 B: 최신 torch + `TORCH_FORCE_NO_WEIGHTS_ONLY_LOAD`) → 가상환경 → YOLOv5 고정 커밋 zip → 가중치·예시 프레임만 받기 → **가중치 SHA-256 검사** → 실행 → 결과 파일. git 설치 불필요, 다시 실행해도 안전
  - 고정 YOLOv5(2022) 호환성 확인: `pkg_resources` 필요(→ `setuptools<80`), 실행 중 자동 pip install 기능 있음(→ `YOLOv5_AUTOINSTALL=False`), numpy 2 충돌은 CoreML 경로뿐이라 무관
  - `run_vespai_examples.py`에 원 결과 비교 추가 — 원 라벨 파일이 표를 줄바꿈 없이 덧붙여 써서 줄 수로 세면 틀림 → 마지막 표만 읽음. 결과를 `result.tsv`·`summary.txt`(UTF-8)로 저장
  - 실행계획 문서 4-1을 Windows 원클릭 절차로 갱신
- 만든 파일: `vision/scripts/j1_vespai_windows.ps1`, `vision/scripts/j1_vespai_windows.bat`
- 고친 파일: `vision/scripts/run_vespai_examples.py`, `vision/2026-10-28_VespAI_저장소_확인과_실행계획.md`
- 검증: 원 결과 파서는 실제 라벨 21개로 시험 [확실] (등검은말벌 15장 28마리, 유럽말벌 6장 18마리). Python 문법 검사 통과. **PowerShell 스크립트는 문법 검사·실행 모두 못 함(`미검증`)** — 이 환경에 PowerShell이 없고 설치도 막힘. torch 2.3.1 + numpy<2 + opencv 4.10 조합 Windows 실행 `미검증`
- **J1 상태: 미완료** — 승준이 `.bat` 실행 후 `summary.txt`·`result.tsv`를 채팅에 주면 결과 기록 (완료 기준: 종별 개수 일치, 장당 추론 시간)
- 남은 결정: 표본 구매 전 합법 여부 확인(등검은말벌은 생태계교란 생물 — 아래 참고), J2 보유품 실물 점검(10/30), 승준 PC Python 버전
- 표본 구매 메모: [확실] 등검은말벌은 생태계교란 생물(양도·양수·보관·운반 제한). 죽은 표본 거래도 해당되는지는 [추측] 미확인 → 구매 전 판매자·환경청에 확인 필요

## CAP-AI-SJ-04 · 2026-10-28
- 도구: Claude (Claude 앱, GitHub 레포 연결)
- 승준이 한 일: `j1_vespai_windows.bat` 실행 (설치 중 화면이 멈춘 것처럼 보여 질문 → 기다리면 된다고 안내) → `summary.txt`, `result.tsv` 전달
- AI가 한 일:
  - 결과 분석: Windows 11 / Python 3.13 / torch 2.14.1 CPU **경로 B로 실행 성공**. 종 오분류 0건, 종별 개수 원 결과와 **16/21장 일치**(불일치 5장 모두 등검은말벌), 검출 합계 velutina 27(원 26)·crabro 18(원 18), 신뢰도 평균 +0.007, **0.053 s/장**, 모델 로드 20.3 s
  - 불일치 원인 후보 정리 (다른 가중치 / JPEG 재저장 / 버전 차이) — 판정 [추측]
  - 설계 의미: Pi 5 CPU로 먼저 시도, 모델은 켤 때 한 번만 로드, 근접 촬영 구도는 J3에서 따로 확인
  - **정정**: SJ-03 로그·답변의 "원 결과 등검은말벌 28마리"는 계산 실수 → **26마리**
  - 스크립트에서 `--quiet` 제거 (설치 진행 표시)
- 만든 파일: `vision/2026-10-28_J1_VespAI_실행결과.md`, `vision/results/2026-10-28_J1/summary.txt`, `vision/results/2026-10-28_J1/result.tsv`
- 고친 파일: `vision/scripts/j1_vespai_windows.ps1`, `vision/2026-10-28_VespAI_저장소_확인과_실행계획.md`
- 검증: 수치는 결과 파일에서 직접 계산 [확실]. 불일치 원인·Pi 5 속도는 `미검증`. 결과 그림(out\*.jpeg)은 보지 못함
- **J1 완료** (작업지시 완료 기준: 개수 비교·장당 추론 시간 확보)
- 남은 결정: (선택) 가중치 7개로 원 결과 재현 시험 여부, J2 보유품 실물 점검(10/30), 표본 구매 전 합법 여부 확인

## CAP-AI-SJ-05 · 2026-10-28
- 도구: Claude (Claude 앱, GitHub 레포 연결 + 승준 Windows PC 폴더 `OneDrive\Desktop\창의적종합설계` 연결)
- 승준 결정·명령:
  1. **정부 규제·법은 무시하고 일단 만든다** → 표본 구매 전 합법 여부 확인 항목은 남은 결정에서 뺌 (서현 CAP-AI-07 "법은 나중"과 같은 방향)
  2. 창의적종합설계 관련 자료는 `C:\Users\user\OneDrive\Desktop\창의적종합설계`에 모두 정리
  3. 작업 끝나면 GitHub에 공유
- AI가 한 일:
  - 폴더 접근 승인 받음 → 내용 확인: 1,764개 약 1 GB (서현 자료 사본 `capstone design`, 분할 압축 `capstone design.z01`, 4주차 발표, 공유 논문, 10/25 CAD, J1 실행 환경 `capstone_vespai`, J1 스크립트 중복 `1`, 예전 시작키)
  - 이 세션 도구로는 파일 **옮기기·지우기 불가 (쓰기만 가능)** → 직접 쓴 것: `repo\`(레포 사본 36개), `00_폴더_안내.md`. 기존 파일 정리는 승준이 실행하는 **옮기기 전용 스크립트** `폴더정리_실행.bat/.ps1`(삭제 없음, 옮긴 내역 `99_정리대기\정리기록.txt`)
  - 정리 후 구조: `repo\` / `01_발표_보고` / `02_논문_참고자료` / `03_서현자료_사본` / `04_CAD_10월26일_발표안_폐기` / `05_VespAI_실행` / `99_정리대기`
  - 주의 안내: venv(약 200 MB)가 OneDrive 동기화 대상, `.z01`은 분할 압축 앞부분뿐
- 만든 파일 (승준 PC, 레포에는 안 올림 — 개인 PC용): `창의적종합설계\00_폴더_안내.md`, `폴더정리_실행.bat`, `폴더정리_실행.ps1`, `repo\`(레포 사본)
- 검증: PC 쓰기 39개 모두 성공 [확실]. 정리 스크립트는 실행·문법 검사 못 함(`미검증`). `.bat`은 ASCII만 써서 한글 깨짐 방지(같은 이름의 `.ps1`을 부름)
- 남은 결정: 승준이 `폴더정리_실행.bat` 실행, `.z01`·`99_정리대기` 삭제 여부(승준 판단), J2 보유품 실물 점검(10/30)

## CAP-AI-SJ-06 · 2026-10-28
- 도구: Claude (Claude 앱, GitHub 레포 연결)
- 승준이 한 일: `지금가지고_있는_물품.zip` 업로드 (HEIC 25장 + 중복 4장 + 스캔 3장 + 실측 위치 그림)
- AI가 한 일:
  - HEIC → JPG 변환, 중복 4장 제외. 10/23 사진은 서현 CAP-AI-03에서 판독됨 → **10/28 새 사진 위주**로 확인
  - 10/28 14:34 보유품 사진 4장 판독 → `inventory/` 4장 추가 (J2 1차): 확인된 것(Pi 5·AI HAT+·AI Camera 상자, Pi 4B, Pi 3B, UNO 4개, 릴레이, 케이블, 키트 등) / **사진으로 확인 못 한 것**(Pi 5 전원 27W, microSD, Pi 5 카메라 케이블, 서보·스테핑 개수, 쿨러, 빨간 기판)
  - 10/28 16:51 이후 사진 = 상용 트랩 실측 사진 (포획통 바닥, 차양막 구멍과 턱, 노란 깔때기, "d5 재는모습") → 서현 담당(`design/상용트랩_실측표.md`)이라 고치지 않음. "d5 재는모습"은 줄자 눈금이 사진만으로 읽히지 않아 값 미판독
- 고친 파일: `inventory/2026-10-28_보유물품_목록과_활용계획.md` (4장 추가)
- 검증: 상자 라벨로 읽은 것만 [확실], 보드 모양 판단은 [가능성 높음]. 사진(37 MB)은 레포에 안 올림
- **J2 상태: 1차(사진) 완료, 2차(개봉 확인) 남음** — 4-2 표 항목
- 남은 결정: 4-2 항목 실물 확인, 승준이 잰 D5 값을 서현에게 전달, 폴더정리 스크립트 실행

## CAP-AI-SJ-07 · 2026-10-28
- 도구: Claude (Claude 앱, GitHub 레포 연결)
- 승준 전달 (줄자 실측): D1 55, D2 90, D3 안 67·안쪽 홈 약 83·바깥 홈 약 94, D4 약 5(가변), D5 19, D6 약 50(기울어짐), H1 220(포획통 고무마개→포획통 바닥), H21 180(바닥→차양막, 차양막 포함), H22 145(차양막 제외), D7은 D1과 같아 보임, 홈·돌기는 못 찾음 → "본드로 붙이면?" (단위 mm)
- AI가 한 일:
  - 실측표가 서현 담당이라 Issue #2로 전달 → 직후 pull에서 서현이 **같은 값을 이미 반영**(5bfc02f)한 것 확인 → Issue에 중복 표시 댓글
  - 교차 확인: H1 + H21 = 400 = 제품 표기 40 cm, D2 90이 D3 홈 83~94 사이 → 턱이 포획통 홈에 들어가는 구조 [가능성 높음]
  - 본드 의견: 서현 D5 2차(바닥에 서는 프레임, 아래 결합은 돌려 끼울 필요 없음, 포획통 쪽 104만 돌려 끼움)로 사실상 해결
  - 승준이 나중에 확인할 것 목록 정리 (아래)
- 만든/고친 파일: 없음 (Issue #2 + 댓글)
- 검증: 값은 승준 줄자 측정 ±1~2 mm, 정밀 결합(104)에는 부족 — 서현 환류 10과 같은 판단
- 남은 결정 (승준 확인 목록): ① 캘리퍼스로 차양막 턱(D2·h, 홈·돌기 개수·폭) ② 포획통 바닥 홈(D3) ③ 포획통을 끼운 채 돌려서 돌려 끼움인지 확인 ④ J2: Pi 5 전원·microSD·카메라 케이블·서보·스테핑 개수 ⑤ 폴더정리 스크립트 실행

## CAP-AI-SJ-08 · 2026-10-28
- 도구: Claude (Claude 앱, GitHub 레포 연결)
- 승준 전달: ① **포획통은 돌려서 끼우고 빼는 방식** [확실, 실물 확인] ② 캘리퍼스 측정은 다음에 실험실에서 빌려서 ③ J2 상자 안 무엇을 확인할지 자세히 알려 달라
- AI가 한 일: ①을 Issue #2 댓글로 서현에게 전달 (104 돌려 끼움 확정 근거). J2 개봉 점검 체크리스트(10개 항목, 찾는 법·적을 것·없으면 조치) 작성해 승준에게 안내
- 남은 결정: J2 체크리스트 결과 → `inventory/` 반영·J7 구매 목록, 캘리퍼스 측정(D2·h·D3)

## CAP-AI-SJ-09 · 2026-10-28
- 도구: Claude (Claude 앱, GitHub 레포 + 승준 PC 폴더 `창의적종합설계` 연결)
- 승준 명령: 부품 점검은 나중에. **VespAI를 내 PC에서 PC에 연결된 카메라로 실시간 구동**되는지 해 볼 것
- AI가 한 일:
  - PC 확인: 폴더 정리 스크립트 실행됨(`05_VespAI_실행`에 venv·yolov5·vespai), Python은 Microsoft Store판 3.13, venv의 `home`이 설치 경로라 폴더 이동 뒤에도 쓸 수 있을 것 [가능성 높음]
  - 원본 `monitor_run.py`는 화면 표시 없음·메일 비밀번호 하드코딩 → **새 실시간 스크립트** `vespai_live_webcam.py`: 카메라 자동 찾기(0~3번, DSHOW→MSMF), 1280×720, 박스·종명·신뢰도·fps 화면 표시, 키(q 끝/s 저장/±신뢰도/c 카메라 바꾸기), `detections.csv`(1초 간격), `live_summary.txt`. 화면·종이 속 사진은 신뢰도가 낮게 나와 표시 기준 기본 0.5 (VespAI 기본 0.8)
  - 실행 파일 `vespai_webcam_windows.bat/.ps1`: 파일 확인 → 가중치 SHA-256 → venv 동작 확인 → 실행. PC `05_VespAI_실행`에 직접 넣음
  - 시험: 예시 프레임으로 만든 영상 + **가짜 모델**(고정 박스)로 화면 없이 루프 실행 → 그리기·기준 거르기·기록·요약 정상 [확실]
- 만든 파일: `vision/scripts/vespai_live_webcam.py`, `vision/scripts/vespai_webcam_windows.ps1`, `vision/scripts/vespai_webcam_windows.bat` (+ 승준 PC `05_VespAI_실행\`에 같은 3개)
- 검증: 실제 VespAI 가중치·실제 웹캠 실행은 `미검증` (승준 PC에서 실행 필요). PowerShell 문법 검사 못 함
- 남은 결정: 승준 실행 결과(live_summary.txt, snap) → 카메라 해상도·fps·사진 비춤 검출 여부 기록, J2 부품 점검

## CAP-AI-SJ-10 · 2026-10-28
- 도구: Claude (Claude 앱, GitHub 레포 + 승준 PC 폴더 연결, 웹 검색)
- 승준 전달 (J2 개봉 확인): microSD 32 GB ×2, Pi 5 전원 어댑터 없음(어디서 사는지 질문), Pi 5 보드 있음, AI Camera 케이블 2개(Pi 5용 넓은–좁은 + 넓은–넓은), AI HAT+ 기판·헤더·기둥·나사 있고 케이블 없음, MG90S 1(혼 없음), 28BYJ-48·ULN2003 각 1, 키트 MOTOR = 스테핑, 쿨러 있음(사진: 40 mm 팬 달린 케이스 뚜껑), 마이크로 HDMI 1, USB-C 없음, 빨간 기판 사진
- AI가 한 일:
  - 빨간 기판 판독: **L298N 듀얼 H-브리지 모터 드라이버** [확실, 인쇄 글자]
  - AI HAT+ 케이블: 공식 안내상 구성품에 포함되고 **HAT에 꽂힌 채 출고** → 기판 아랫면 확인 요청. 카메라 케이블(22핀)로 대체 불가(PCIe 16핀)
  - 쿨러 사진은 공식 Active Cooler가 아닌 케이스 뚜껑 팬 [가능성 높음] → AI HAT+와 같이 들어가는지 확인 필요
  - 전원 어댑터 구입처 검색: 디바이스마트 공식 정품 27W(5.1V/5A, KC 인증 표기, 케이블 1.2 m), 호환품(디바이스마트·엘레파츠·아이씨뱅큐 HT-PD27W-KC). 가격은 페이지에서 못 읽음(미확인)
  - `inventory/` 5장(J2 2차) 추가, `purchase/2026-10-28_구매후보_J2결과.md` 작성 — 서현이 작업지시에 추가한 캘리퍼스(우선)·POSCA 마커·프로파일 포함
- 만든 파일: `purchase/2026-10-28_구매후보_J2결과.md` / 고친 파일: `inventory/2026-10-28_보유물품_목록과_활용계획.md`
- **J2 완료** (남은 확인 2개: HAT 아랫면 케이블, 케이스 뚜껑 팬이 Pi 5 + AI HAT+와 맞는지)
- 남은 결정: 전원 어댑터 공식/호환 선택·주문(예산 장부 시작), 서보·스테핑 추가 수량(D6 후), 프린트로 웹캠 재시험

## CAP-AI-SJ-11 · 2026-10-28
- 도구: Claude (Claude 앱, GitHub 레포 + 승준 PC 폴더 연결, 웹 검색)
- 승준 전달·명령: ① AI HAT+ PCIe 케이블은 HAT에 꽂혀 있음 확인 ② 쿨러는 사야 함 ③ **사야 할 품목 총정리**
- AI가 한 일:
  - pull로 서현 D5 4차(안 B 마커 XYZ, `fc7d499`) 확인 → 마커가 POSCA에서 **퍼마페이크·샤피**로 바뀜, 구동기 7개(스테핑 3 + 서보 4), XYZ 기구 품목 추가, J8(흉부 좌표) 추가
  - 공식 Active Cooler 구입처 검색 (디바이스마트 정품)
  - `purchase/2026-10-28_구매목록_총정리.md` 작성: A 지금 주문(전원 어댑터, 액티브 쿨러, 캘리퍼스(대여 시 생략), 퍼마페이크·샤피 직구) / B 구동 시험용(28BYJ-48 세트 2, MG90S 3, SG90 1 — D6에서 NEMA17로 바뀔 수 있음) / C 기구(D6·CAD 후) / D 센서·조명(D6 후) / E 보유 / F 정할 것. 이전 후보 문서는 지난 판 표시
- 만든 파일: `purchase/2026-10-28_구매목록_총정리.md` / 고친 파일: `purchase/2026-10-28_구매후보_J2결과.md`
- 검증: 품목·수량은 서현 D5 10장·작업지시 J7 문구 그대로, 가격 미확인. 해외 직구 배송 기간은 [가능성 높음]
- 남은 결정: 2대 제작 여부(수량 2배), 캘리퍼스 구매/대여, 28BYJ-48 먼저 살지, 예산 장부 시작

## CAP-AI-SJ-12 · 2026-10-28
- 도구: Claude (Claude 앱, GitHub 레포, 웹 검색)
- 승준 질문·명령: USB-C 케이블 필요 여부 / 어댑터 하나면 되는지 / 액티브 쿨러 링크 / **퍼마페이크가 구하기 어려워 국내에서 쉬운 것으로 다시 찾기**
- AI가 한 일:
  - USB-C: 공식 27W 어댑터는 케이블 일체형 [가능성 높음] → 별도 불필요. 호환 어댑터(분리형)면 5A 케이블 필요, Pi 4 2호기면 어댑터 1개 더
  - 액티브 쿨러 링크 안내 (디바이스마트 [정품])
  - 마커 국내 대안 검색: 서현 조건(흔들기·펌핑 없음 + 불투명 흰색 + 둥근 1~2 mm)을 다 맞는 국내 제품 못 찾음. 대안 ① POSCA PC-3M 화이트(펌핑 필요) ② 흰색 젤펜(볼 팁 — 찍기 잉크량 의문) ③ 퍼마페이크 직구 → 구매목록 A-1에 기록, **서현 결정 요청 Issue** 작성 (마커 선정은 서현 D5 담당)
- 고친 파일: `purchase/2026-10-28_구매목록_총정리.md` (A-1 마커 국내 대안)
- 검증: 국내 판매처·가격·재고는 일부만 확인(시그노 화이트 0.7 핫트랙스 품절 1,870원), 나머지 `미검증`. 젤펜 찍기 동작은 [추측]
- 남은 결정: 마커 안(서현), 어댑터·쿨러 주문

## CAP-AI-SJ-13 · 2026-10-28
- 도구: Claude (Claude 앱, GitHub 레포, 웹 검색)
- 승준 질문: 퍼마페이크 비슷한 제품 없나, 가격 무관
- AI가 한 일: 흔들기 없는 불투명 흰색 마커 재검색, 흰색 펜 61종 비교 리뷰 확인 → 펠트 팁 무밸브 불투명 흰색은 퍼마페이크가 거의 유일, 가장 가까운 대안 샤피 크리에이티브(국내 판매처 없음), 국내 즉시 구입은 젤펜(시그노 브로드 UM-153 등) → **가격 무관이면 퍼마페이크 해외 특송**이 조건에 가장 맞음. 구매목록 A-1 갱신, Issue #3 댓글
- 고친 파일: `purchase/2026-10-28_구매목록_총정리.md`
- 검증: 리뷰는 흔들기 여부를 명시하지 않음 → 젤펜·샤피의 '흔들기 없음'은 제조사·판매처 표기 기준 [가능성 높음]. 국제 배송 가능 판매처는 `미검증`
- 남은 결정: 마커 안(서현, Issue #3), 퍼마페이크 특송 주문 여부(승준)

## CAP-AI-SJ-14 · 2026-10-28
- 승준: 0.5 mm 팁 가능 여부 질문 → [가능성 높음] 불리(200 mm 카메라에서 약 7~8화소, 잉크량·내구) — 더미 시험으로 판단. 승준 의견 "샤피 유성 네임펜 메탈릭 정도로 굵어야" (화면 캡처)
- AI가 한 일: 굵기는 샤피 Fine 약 1 mm로 서현 9-7 기준(1~2 mm)과 같음. 예시 제품은 **유성**이라 수성 조건 밖. 승준 화면에서 **샤피 크리에이티브 국내 판매처(캘리하우스·폴센트) 확인 → SJ-12·13의 "국내 판매처 못 찾음" 정정**, Issue #3 댓글
- 검증: 흰색 단품·팁 모양 `미검증`

## CAP-AI-SJ-15 · 2026-10-28
- 사용자가 "나 서현인데"라고 밝히고(승준 계정 채팅) 쿠팡 샤피 크리에이티브 5색 화면을 보냄 → AI 확인: 5색엔 흰색 없음, 9-7 기준 '흰색 또는 노랑'의 **노랑**으로 조건 충족(수성 아크릴·흔들기 없음·불렛 팁·국내 로켓 8,600원)
- **결정: 샤피 크리에이티브 5색, 노랑 사용, 흰색 불필요** (20:22)
- 한 일: 구매목록 A4 교체·A5 삭제, Issue #3 결정 댓글 (D5 10-5 반영은 서현 담당으로 남김)
- 고친 파일: `purchase/2026-10-28_구매목록_총정리.md`
- 검증: 색 구성·팁·수성 표기는 상품 화면 [확실]. 몸통 지름·팁 굵기는 실측 전 `미검증`
- 남은 결정: 주문(어댑터·쿨러·마커), 마커 실측, D5 10-5 갱신(서현)

## CAP-AI-SJ-16 · 2026-10-28
- 도구: Claude (Claude 앱, GitHub 레포 + 승준 PC 폴더)
- 승준 명령: 산 것을 정리해 재료비 청구를 해야 함 → 첨부 PDF(창의융합 경진대회 설명회, 6쪽)로 정리 방법을 학습해 둘 것
- AI가 한 일:
  - PDF는 이미지 슬라이드(텍스트 없음) → 쪽별 그림으로 읽음
  - 규칙 정리 `purchase/2026-10-28_재료비_정산규칙.md`: 한도 50만 원, 과제물 재료만, 사무·전산용품·지속 사용 공구 불인정, 해외구매·중고 불가, 위반 시 전액 환수, 팀장 계좌 입금(대회 후), 서류(정산보고서+제품 사진, 결과보고서, 세부내역 영수증, 재학증명서 전원, 통장사본 팀장), 영수증 순서 = 엑셀 순서(다르면 순번), 견적서는 수신자 팀장·팀원 이름, 수기 영수증은 직인, 11/30 제출
  - 우리 품목 적용: 캘리퍼스 불인정 가능성 높음 → 대여, 어댑터·쿨러·마커는 애매 → 팀장 문의, 로켓직구 주의
  - `purchase/구매장부.md` 틀(순번·구매일·판매처·품목·수량·단가·금액·결제자·용도·영수증·사진·인정 여부 + 주문 체크리스트), 구매목록에 규칙 안내 추가, **Issue #4**(예산 50/60만, 담당자 문의, 엑셀 양식 요청)
- 만든 파일: `purchase/2026-10-28_재료비_정산규칙.md`, `purchase/구매장부.md` / 고친 파일: `purchase/2026-10-28_구매목록_총정리.md`
- 검증: 규칙은 자료 원문 [확실], 품목별 인정 여부는 해석([가능성 높음]·[추측]), 엑셀 양식 미수령
- 남은 결정: 예산 50/60만(서현), 인정 여부 문의(서현), 주문 후 장부 기록

## CAP-AI-SJ-17 · 2026-10-28
- 승준 결정: **예산 50만 원**, **엑셀 정산보고서 양식은 따로 없음 → 직접 만듦**, **정산은 승준 분야 — 서현에게 요청하지 말 것**
- AI가 한 일:
  - `purchase/재료비_정산보고서.xlsx` 작성 (xlsx 스킬): ① 정산보고서 시트 — 팀 정보, 한도 500,000(출처 메모)·집행 합계·잔액·상태(한도 초과 경고) 자동, 30줄 표(순번·구매일·구매처·품목·규격·수량·단가·금액 자동·용도(도면부호)·영수증 번호 R-nn 자동·사진 번호 자동·국내·신품 O/X·비고), 노란 칸 = 입력, 회색 예시 줄(합계 제외) ② 제품사진 시트 — 순번·품목 자동 연결, 사진 붙일 칸 ③ 작성요령 시트 — 정산 규칙·서류·영수증·체크리스트
  - 검증: 수식 155개 오류 0 (LibreOffice 재계산), 사본에 시험값 넣어 금액·합계 510,500·잔액 −10,500·'한도 초과' 표시·영수증/사진 번호·사진 시트 연결 확인, PDF 미리보기 확인
  - 정산규칙 문서 6장(확정)·7장, 구매장부.md는 엑셀이 원본임을 표시, 구매목록·README 예산 50만 원으로 수정
  - **Issue #4 정정 댓글 후 닫음** (서현 요청 취소)
- 만든 파일: `purchase/재료비_정산보고서.xlsx` / 고친 파일: `purchase/2026-10-28_재료비_정산규칙.md`, `purchase/구매장부.md`, `purchase/2026-10-28_구매목록_총정리.md`, `purchase/README.md`
- 참고: 인수인계(서현 파일)에는 아직 '약 60만 원'으로 남아 있음 — 승준 지시에 따라 서현에게 요청하지 않음
- 남은 결정: 주문 후 엑셀에 기록, 어댑터·쿨러·마커 인정 여부 문의 여부(승준 판단)

## CAP-AI-SJ-18 · 2026-10-28
- 승준 전달: 지금까지 산 것 — 영수증 1(말벌 트랩), 영수증 2(어댑터·쿨러) PDF + 주문 상세 캡처 2장 → 정리
- AI가 한 일:
  - 영수증 판독: R-01 2026-10-10 불로양봉원 말벌포획기 B형 54,000 + 배송비 3,800 = **57,800** / R-02 2026-10-28 디바이스마트 27W 아답터 18,040 + 액티브 쿨러 7,700 + 배송비 2,700 = **28,440** (네이버페이 구매영수증, 결제자 이승준)
  - 발견: R-02 영수증은 상품명이 "외 1건"으로만 나와 **쿨러 세부내역이 없음** → 주문 상세 캡처를 세부내역 증빙으로 같이 보관. 네이버페이 구매영수증은 "거래내역 확인용"이라 적혀 있음 → 인정되는지 확인 필요 [추측]
  - 양식 수정: 영수증 번호를 줄마다 자동으로 붙이던 것을 **직접 입력**으로 바꿈 (영수증 하나 = 상품 + 배송비 여러 줄)
  - 엑셀에 5줄 기록 (과제명·작성일 포함), 합계 **86,240원**, 잔액 413,760원 — 영수증 합계와 일치, 재계산 오류 0
  - 영수증 PDF·캡처를 순번 이름으로 승준 PC `06_재료비_정산\영수증\`에 저장 (레포 X), `purchase/구매장부.md` 메모 갱신
- 고친 파일: `purchase/재료비_정산보고서.xlsx`, `purchase/구매장부.md`
- 남은 결정: 배송비 인정 여부, 어댑터·쿨러 전산용품 해당 여부, 구매영수증으로 충분한지(카드 매출전표 필요?), 물건 도착 후 제품 사진, 샤피 마커 주문

## CAP-AI-SJ-19 · 2026-10-28
- 승준 명령: 오늘 할 일 끝 — 서현 Claude가 레포로 계속 진행 중이니 너도 할 일 할 것 (사용자 부재, 하드웨어 없이 가능한 J6·J4부터)
- AI가 한 일 (J6):
  - `control/firmware/trap_controller/trap_controller.ino`: 구동기 7개(28BYJ-48 ×3: 바닥 F·마커 X·Y / 서보 ×4: 입구 112·격리 170·방생 176·펜 205) + HX711, 비차단 동시 이동, 소프트 한계, 바닥 하중 정지(PRESS), 문·펜, 각도 보정, 워치독, 켤 때 대기 상태
  - `control/pi/trap_link.py`: Pi·PC용 클라이언트 + 손시험 콘솔(`time X 10` 속도 측정)
  - PC 시뮬레이션(`control/firmware/sim/`, 흉내 Arduino.h·Servo.h): 명령·X·Y 동시 이동·PRESS 50 g 정지·문·펜·워치독·오류 응답 확인, 파이썬 클라이언트 ↔ 실시간 시뮬레이터 연결 시험 — X 2 mm 1.09 s (**1.83 mm/s**)
  - 발견: **UNO 18핀이 꽉 참**(진입 감지 114는 Pi GPIO로), **원점(리밋) 스위치 없음**(넣으려면 스텝·방향 드라이버 또는 아두이노 2개), 구동부 별도 5V 전원 필요
  - 인터페이스 정의서: 'Pi ↔ 아두이노 통신' 1차 값, '진입 감지' 신호 Pi GPIO, 변경 이력 추가
- 만든 파일: `control/firmware/trap_controller/trap_controller.ino`, `control/pi/trap_link.py`, `control/firmware/sim/*`, `control/2026-10-28_J6_구동부_펌웨어와_시험절차.md` / 고친 파일: `design/인터페이스_정의서.md`
- 검증: 시뮬레이션만 [확실]. 실제 UNO 컴파일·구동 `미검증` (Arduino IDE 없음). 28BYJ-48 반걸음 수 4075.77 [가능성 높음]
- 남은 결정: 원점 스위치·드라이버(서현 D6), 실물 J6 시험(승준), 구동부 전원

## CAP-AI-SJ-20 · 2026-10-28
- AI가 한 일 (J4):
  - `vision/scripts/dot_detect.py`: 노랑 점 = 색 + 지름(0.6~3.0 mm) + 원형도 + 둘레 어두움, 격자선 이어 붙이기, `--roi`, `--eval` 폴더 평가
  - `vision/scripts/make_synthetic_dummies.py`: 합성 더미(노랑 다리·주황 배띠·얼굴, 3 mm 격자, 조명·흐림·잡음) + 정답 좌표
  - 시험: 첫 80장 87.5 % → 원인(흐림으로 작아짐, 격자선이 점을 쪼갬) 고침 → **다른 시드 100장 검출 96 %, 오검출 2 %, 위치 오차 0.3 mm 이내**. 남은 오검출은 흉부 밖 다리 조각 → ROI(J8)로 해결
  - 발견: **노랑 마커는 등검은말벌의 노랑 다리·주황 배띠와 겹칠 위험** [가능성 높음]
- 만든 파일: `vision/scripts/dot_detect.py`, `vision/scripts/make_synthetic_dummies.py`, `vision/2026-10-28_J4_노랑점_검출_합성시험.md`, `vision/results/2026-10-28_J4_synthetic/*.jpg`
- 검증: 합성 기준만, 실물 `미검증` (J4 완료 기준은 실물 더미 20장)
- 남은 결정: 실물 더미 촬영(J3 후), J8 흉부 좌표(사진 필요)

## CAP-AI-SJ-21 · 2026-10-28
- 승준: J6 설명 요청 → 쉬운 말로 설명. microSD 카드 리더 필요 여부 질문 → 필요 가능성 높음(PC에서 OS 설치), 대안(Pi 5 네트워크 설치) 안내 → 승준 "그냥 사자"
- 한 일: 구매목록 A-2 추가 (USB microSD 리더, 디바이스마트 후보, **전산용품이라 정산 제외 권장**)
- 검증: 상품 사양·가격 `미검증`

## CAP-AI-SJ-22 · 2026-10-28
- 승준 결정·전달:
  1. **J6(아두이노로 모터 돌려 보기) 안 함** — "Pi 5를 쓸 때 모터를 구동하면 됨" → J6 실물 시험 보류 (펌웨어·시뮬레이션은 레포에 남김)
  2. **J4는 내일** 프린트로 VespAI 확인할 때 같이 → 지금 보류
  3. 산 것: 말벌 표본(하멜른, 국산 액침표본 7개 21,000 + 배송비 3,000 = 24,000, 영수증3), SD/TF 카드 리더기 C타입(다이소몰 2,000 + 배송비 3,000 = 5,000, 영수증4 카드 매출전표)
  4. 정산 관련은 PC `창의적종합설계\정산`에 정리 (승준이 영수증1~4 pdf·png를 이미 넣어 둠)
- AI가 한 일:
  - 엑셀: 영수증 번호를 승준 파일 이름(영수증1~3)에 맞춤, 표본 2줄 추가 → **합계 110,240원, 잔액 389,760원** (영수증 합계와 일치, 재계산 오류 0). 카드 리더(영수증4)는 **정산 제외**(전산용품, 개인 구매)
  - PC `정산\`에 `00_정산_안내.md`(정산 표·제외 품목·확인 필요·11/30 준비물·규칙 요약), `재료비_정산보고서.xlsx`, `재료비_정산규칙.md` 저장
  - 레포 `purchase/구매장부.md` 메모 갱신
- 주의: 영수증4(카드 매출전표)에 카드번호 일부·상점 전화번호 → 레포에 안 올림. 이전에 만든 PC `06_재료비_정산\` 폴더는 `정산\`과 중복 — 승준이 지워도 됨 (이 세션은 파일 삭제 불가)
- 고친 파일: `purchase/재료비_정산보고서.xlsx`, `purchase/구매장부.md`
- 남은 결정: Pi 5가 모터를 직접 구동할지(아두이노 제외 여부), 표본·배송비·아답터·쿨러 인정 여부, 카드 리더가 PC 포트(USB-C)에 맞는지

## CAP-AI-SJ-23 · 2026-10-28
- 승준 명령: "역학 계산 다 끝났다니 레포 확인하고 명령 실행. 기계요소설계 문제는 서현이 안 풀어서 인터넷에서 찾아 3개 넣어"
- AI가 한 일: 서현 S4 r2(510e4bd) 확인 → 인터넷 공개 문제 3개를 원래 답과 대조하고 우리 설계에 적용
  - ME1 동력나사 (DANotes threads P1): 올림 토크 501.2 N·m(답 501), 효율 19.1 %, 자기잠금, 내림 105.9(답 106) → **적용: T8 리드 8은 자기잠금 아님**(마찰계수 0.351 이상 필요) → 바닥은 모터 유지 토크·전원 꺼짐 대책 필요
  - ME2 압축 스프링 (DANotes springs P2): k 110.3(답 110), 밀착 응력 620.8(619), 피로 안전율 1.28(1.3) → **적용: 홀더 204 스프링** 피아노선 d 0.25·D 6·Na 5.1이면 k ≤ 0.036 N/mm, 안전율 6.8
  - ME3 스테핑 선정 (Oriental Motor 볼나사 예제): 필요 토크 0.477(답 0.48) → **적용: 28BYJ-48은 토크 여유 수백 배인데 펄스 한계로 1.96 mm/s** → 58 mm 31 s, NEMA17+A4988이면 0.97 s
- 만든 파일: `design/calc/s4_me3_check_sj.py`, `design/calc/s4_me3_results_sj.json`, `design/2026-10-28_S4_기계요소설계_유제3_승준.md` (서현 S4 본문은 안 고침 — 수기 풀이 칸은 비워 둠)
- 검증: 3문제 모두 원래 답과 1 % 안 [확실]. 적용 값의 마찰계수·스프링 치수는 `미검증`(실물 없음)
- 참고: 승준이 올린 교재 PDF 3권(Gere·Meriam·Riley)은 레포에 안 올림 (저작권·25 MB 규칙)
- 남은 결정: 서현이 S4에 넣을지, T8 바닥 역구동 대책(서현)

## CAP-AI-SJ-24 · 2026-10-28
- 승준 명령: 말벌이 예상대로 움직일까 / 어느 방에 있는지 어떻게 아나 / 설계 신뢰성 시험(확실 95 % 이상) / 제어부품 md(보유품 우선, Pi 5 + UNO 5개 섞어 빠르게) / AI 4가지(VespAI 종, 크기로 여왕벌, 뒤집힘, 흉부 확률 위치 → 빠르게 마킹) / 3D 프린트 격자 10×10, 확률 높은 10~20곳 최적 경로, 강화학습 또는 PID / 더 좋은 방법 있으면 md로 서현 공유 / Jetson Nano 필요하면 알려줘 / FreeCAD 켜 놓음 / 커밋·푸시·PC 저장
- AI가 한 일:
  - `vision/scripts/mark_planner.py`: 격자 안에서 팁이 갈 수 있는 점 → 흉부 안전영역 확률 → 점 고르기 → 경로(최근접 + 2-opt) → `MOVE`/`PEN` 또는 제안 `PATH` 명령
  - `control/analysis/reliability_mc.py`: 몬테카를로 (모르는 값 범위 '세계' 120 × 말벌 4000, 452 s) → 설계안 9개 비교, 상위 k곳 정책, 여왕벌 경계, 처리 시간, 실물 시험 마리 수 → `reliability_results.json`
  - 결과: **지금 격자 3.0/4.4 + 샤피 불렛은 8회 재시도해도 성공 약 35 %(P5 3 %)**. 틈 3.5 + 팁 약 1 mm + 비전 σ 0.2~0.4 + 등 위 자세 유도를 같이 하면 **8회 안 P5 98 %, 평균 1.9회**. 상위 10~20곳 찍기는 성공 안 오르고 흉부 밖 점만 마리당 4.6개 → 최고 1곳 2번 + 확인 + 재시도. 흉부 폭만으로 여왕벌 판별 위험(σ 0.1, 경계 4.55 → 여왕벌 6.5 % 방생). 28BYJ-48 재시도 1회 16 s vs NEMA17 4.6 s. "95 % 확실" 증명 = 실패 0으로 59마리
  - FreeCAD(승준 PC, MCP)로 격자 시험 조각 4종 생성 → STL (A 사각 3.0/4.4, B 사각 3.5/4.3, C 슬롯 3.0/4.0, D 슬롯 3.5/4.5, 50 × 50 × 1.5, 모두 유효 솔리드)
  - `control/2026-10-28_제어부_구성_신뢰성_AI마킹.md`: 말벌 행동 예측·방 위치 감지(빛 게이트 + 카메라 + 수 세기)·신뢰성 표·AI 4가지 파이프라인(키포인트 모델 하나 + 크기 측정 규칙)·강화학습/PID 의견·Pi 5 + UNO 2개 구성·핀·속도 선택지·부족 부품·서현 제안 6개
  - `purchase/2026-10-28_구매목록_총정리.md` G장(제어부 추가 품목), 인터페이스 정의서 변경 이력에 제안 행(값은 안 바꿈)
- 만든 파일: `vision/scripts/mark_planner.py`, `control/analysis/reliability_mc.py`, `control/analysis/reliability_results.json`, `control/proposals/grid_coupons_sj.py`, `control/proposals/stl/*.stl`(4개), `control/2026-10-28_제어부_구성_신뢰성_AI마킹.md` / 고친 파일: `purchase/2026-10-28_구매목록_총정리.md`, `design/인터페이스_정의서.md`(변경 이력 1행)
- 검증: 기하·확률 계산 코드 실행 [확실]. 입력 범위(팁·점 지름, 비전 오차, 말벌 자세, 잉크)는 [추측] → **신뢰성 숫자는 모두 `미검증` 예측**. STL 프린트 `미검증`
- 남은 결정 (서현): 격자 틈 3.5 mm·살 두께, 팁 굵기(마커), 조명 위/아래, NEMA17 여부(무게 다시), 오마킹·여왕벌 놓침 목표값, 원점 스위치 위치(UNO 1 vs Pi GPIO) / (승준) J9 팁 실측, 시험 조각 프린트, J8 흉부 키포인트 σ 실측, 펌웨어 UNO 2개로 나누기, 살아 있는 말벌 행동 촬영

## CAP-AI-SJ-25 · 2026-10-29
- 승준: 말벌 사진 프린트해 옴(인터넷 사진, 실물 크기 아님) → VespAI 웹캠 재시험 시작. "동영상 따로 저장할 수 있나?"
- AI가 한 일: `vision/scripts/vespai_live_webcam.py`에 녹화 추가 — `r` 키(또는 `--record`)로 시작·끝, 박스 그린 영상(`rec_*_boxes.mp4`)과 원본 영상(`rec_*_raw.mp4`, 나중에 `--source`로 다시 돌리기용) 두 개, 15 fps 실제 시간 맞춤, mp4 안 되면 avi. `vespai_webcam_windows.ps1`: 실행할 때마다 새 결과 폴더 `out_live_날짜_시각` (어제 폐기한 `out_live` 결과와 안 섞이게)
- 검증: 가짜 모델 + 합성 영상으로 시험 — 6 s 처리 → 93 프레임(15 fps ≈ 6.2 s), 두 파일 모두 다시 읽힘 [확실]. 승준 PC 웹캠에서는 `미검증`. PS1 문법 `미검증`(PowerShell 없음)
- PC 반영: `창의적종합설계\05_VespAI_실행\`(실행 폴더)와 `repo\vision\scripts\`
- 주의: 인터넷 사진을 찍은 스냅·영상은 저작권 때문에 레포에 안 올림 (숫자 결과만), 25 MB 넘는 영상도 안 올림
- 남은 결정: 실물 크기 프린트로 20 cm 거리 시험 (설계 조건)

## CAP-AI-SJ-26 · 2026-10-29
- 승준: 인터넷 등검은말벌 사진 4장(실물 크기 아님)으로 VespAI 웹캠 시험 2번 (1차 19:47 녹화 없음, 2차 19:55 녹화 107 s). "가까우면 인식 못 하고 조금 멀어야 잘 인식"
- AI가 한 일: 2차 기록 100줄 중 녹화 안 93개를 영상 프레임에서 잘라 하나씩 판독 → 라벨 CSV, 결과 md
  - 말벌 사진 위 박스 34개 중 **등검은말벌 27 (79 %)**, 박스 93개 중 **56개(60 %)는 손·얼굴·옷·커튼 오검출**(51개가 유럽말벌, 신뢰도 최고 0.92)
  - 사진별 박스 뜬 비율: 흰 바탕 약 50~60 %, 갈색 천 약 24 %, 자갈 약 6 %. 맞게 잡힌 박스 폭은 화면의 4~18 %, 화면 절반 가까이 채우면 못 잡음
  - **정정**: 1차 직후 "유럽말벌 79 % → 종을 틀림 [가능성 높음]"이라고 승준에게 말한 것은 틀림 — 유럽말벌 박스 대부분은 손·옷 오검출이었음 (2차 영상으로 확인)
  - 설계 제안: 종 판별은 넓은 화면, 흉부·뒤집힘은 마킹실 잘라서 (마킹실만 넣으면 말벌이 화면 절반 이상 → 못 잡는 조건)
- 만든 파일: `vision/2026-10-29_VespAI_프린트_웹캠시험.md`, `vision/results/2026-10-29_live_prints/detections_labeled.csv`. 영상·판독용 잘라낸 사진은 레포에 안 올림(승준 얼굴·인터넷 사진·64 MB) → 승준 PC `05_VespAI_실행\out_live_20261029_1955\분석\`
- 검증: 녹화 기능 실제 웹캠에서 동작 [확실]. 라벨은 Claude 판독(1초 안 프레임 어긋남), 승준 확인 전 → `미검증`. 프린트 결과라 실물·AI 카메라와 다를 수 있음
- 남은 결정: 표본을 격자 아래에 두고 20 cm 촬영 시험(승준), 종 판별 화면 범위(서현과)

## CAP-AI-SJ-27 · 2026-10-29
- 승준: 새로 산 것 정리 — 영수증5 테프론 테이프("곤충과 재질이 비슷하다고 해서" 시험용), 영수증6 여러 물품 중 '샤피 크리에이티브 수성 마커 총알팁 12색'만 프로젝트 관련
- AI가 한 일:
  - 엑셀 정산보고서 순번 8 테프론 테이프 900원(영수증5), 순번 9 샤피 12색 18,870원(영수증6 1행만) 추가, 작성일 10/29 → **합계 130,010원, 잔액 369,990원** (재계산 오류 0, 영수증 금액과 일치)
  - 영수증6 나머지 3개(가습기·화장지·생수 30,470원)는 정산 제외로 장부에 기록
  - **확인 필요 표시**: 영수증6 주문 할인 2,900원이 어느 상품에 붙었는지 → 샤피에 붙었으면 청구액 줄여야 함 (비율 배분 시 17,761원)
  - PC `정산\`: 영수증5.pdf(거래명세표)·영수증5.png(카드영수증)·영수증6.pdf 저장, `00_정산_안내.md`·엑셀 갱신
  - 구매목록 A4: 5색 대신 12색 구매로 표시
- 주의: 영수증5 카드영수증에 카드번호 일부·승인번호 → 레포에 안 올림. 영수증 파일은 모두 PC에만
- 고친 파일: `purchase/재료비_정산보고서.xlsx`, `purchase/구매장부.md`(5·6행 사이 빈 줄로 표가 끊기던 것도 고침), `purchase/2026-10-28_구매목록_총정리.md`
- 검증: 합계 130,010 = 110,240 + 900 + 18,870 [확실]. 테이프·샤피 인정 여부, 샤피 할인 배분 `미검증`
- 남은 결정: 할인 배분 확인(승준, 쿠팡 주문 상세), 물건 도착 후 제품 사진

## CAP-AI-SJ-28 · 2026-10-29
- 승준 판단: 영수증6 할인 2,900원은 마커가 아니라 여러 개 같이 사서 붙은 할인 → **마커는 18,870원 맞음**
- 한 일: 엑셀 순번 9 비고, 구매장부, PC `정산\00_정산_안내.md`의 '확인 필요'를 '승준 판단으로 확정'으로 바꿈. 금액·합계 변동 없음 (130,010원, 잔액 369,990원)
- 남은 것: 담당자가 할인 배분을 물으면 쿠팡 주문 상세 캡처로 설명 (캡처는 `정산\`에 같이 두면 좋음)

## CAP-AI-SJ-29 · 2026-11-01
- 승준 명령: "역학계산 해야 하는데 서현이 CAD는 만들었고 토큰을 다 써서 역학계산을 하다 말았어. GitHub 읽고 이어서 해 줘"
- 읽은 것: 서현 CAP-AI-20 남은 일(2 s4_calc를 D5e로, 3 M1~M6 자유물체도 jpg, 4 유제 md 미검증 값, 5 S4·D6·인터페이스 반영), `cad/D5e_module_kinematic.py`, S4 r2, 유제 md
- AI가 한 일 (서현 파일은 안 고침 — 새 파일만):
  - 승준 PC FreeCAD(MCP)에서 D5e `build()`·`posed()`로 부품 26개 부피·무게중심 (자세 5개) → `design/calc/d5e_mass_cad_sj.json`
  - `design/calc/s4_calc_d5e_sj.py`: 서현 `s4_calc` 함수 그대로 + D5e 질량·기하. M1 회전 막이(서현) + 캐리지 기울어짐 짝힘(승준 추가), M3·M4 핀 2개 안내(서랍 꼴) + 혼 팔 14 cos θ + 혼–탭 마찰 + 스프링 늘어남, M5 펜 홀더 끼임 한계, M6 L 163
  - `design/calc/s4_fbd_module_sj.py` → `design/img/fbd/M1~M6_D5e_*.jpg` 6장 (서현 fbd_lib 규칙, 하나씩 열어 방향·겹침 고침)
  - `design/2026-11-01_S4_역학계산_2차_D5e_승준.md`: 결론, 질량표, M1~M6, 서현 미검증 세 값의 계산값, 서현이 정할 것
  - 결과: **펜 홀더 안내 핀 μ_c 0.44** (μ 0.3이면 여유 1.5배, 0.5면 끼임), M4 T 12.4 N·mm·안전율 14.2 (스프링 최대 7.1), 찍는 힘 마찰 몫 28 % → 4 %, 스프링 상한 0.177 N, M1 T 3.19·안전율 10.8, M6 최악 0.0100 mm
- 검증: 닫힌 식으로 따로 다시 풀어 M1·M3·M4·M6 대조 (0.2 % 안) [확실]. 마찰계수(핀 0.3, 혼 0.3, 안내봉 0.3)는 `미검증`. 수기 풀이는 안 함(서현 몫, 순서만 적음)
- 남은 결정 (서현): 펜 홀더 핀 위치·슬리브(① e_y ≤ 10 ② 황동·볼 부싱 ③ 길이 60), 스프링 0.144 N 이하, S4 본문 r3·유제 md·D6·인터페이스에 옮길지 (서현 CAP-AI-20 남은 일 5·6번은 안 함)

## CAP-AI-SJ-30 · 2026-11-02
- 승준 명령: "이제 ppt 만들 거야. 이번 주엔 역학계산·설계·VespAI를 직접 카메라로 확인해 봤어. 역학계산은 교재 문제와 우리 설계의 연관성, 교재에서 무엇을 변형했는지. 설계는 역학계산 중심 메커니즘 + 기계 부품·센서. VespAI는 실험 영상 사진 + 승준·서현 결과 + 잘 안 된 이유" (서현 docx 「역학계산 10문제 — 무엇을 풀었고 왜 풀었나」 첨부)
- AI가 한 일: pptxgenjs로 28장 덱 (발표자 노트 전부, 마지막 장 노트에 예상 질문 8개)
  - 역학계산 16장: 방법·절단 지도 → 유제 연계 표 2장(같은 점 / 바꾼 점 / 해설집 대조) → M8·M7·M9·M10(동역학) → M1·M3·M4·M5·M6(교재 그림 + 우리 자유물체도 짝) → 판정 요약·바뀐 설계 6가지
  - 설계 6장: 전체 구성(D5e 등각도), 6단계 메커니즘(서현 gif 프레임 + 관련 M 번호), 기계 부품 표(계산 근거), 센서 표·배치도, 제어 블록도·계산이 만든 제어 규칙
  - VespAI 5장: 세 시험 개요, 승준 녹화(10/29) 프레임 4장(얼굴 없는 프레임만) + 79 %·60 %, 서현 기록 수치 표 + 격자 가림 모의, 원인 4개 → 대책
- 수치 출처: 서현 `docs/2026-11-02_발표_역학계산_슬라이드원고.md`, `design/calc/s4_dyn_results.json`, SJ-29 결과, `vision/2026-10-29_VespAI_프린트_웹캠시험.md`, `design/2026-11-02_VespAI_점검_서현.md`. 새 계산값 없음
- 만든 파일: 레포에 안 올림(인터넷 말벌 사진이 찍힌 영상 프레임 포함) → 승준 PC `창의적종합설계\07_발표\2026-11-02_주간발표_역학계산_설계_VespAI.pptx` (+ 생성 스크립트 `build.js`)
- 검증: validate 통과, LibreOffice로 28장 렌더해 넘침·겹침 확인 후 고침 (맑은 고딕 대신 Noto로 렌더 → PowerPoint에서 줄바꿈이 조금 다를 수 있음)
- 남은 것: 서현 실험 화면 캡처가 레포에 없어 26번 장은 서현 기록 수치 + 격자 가림 모의 그림만 씀 → 서현이 캡처를 넣으면 됨. 센서 배치도는 빛 게이트 6개 그림(11/02 결정 9쌍은 글로 표시)

## CAP-AI-SJ-31 · 2026-11-02
- 승준 명령: "예제마다 고른 이유, 설계 반영을 위해 변경한 부분을 나열해 줘. 예제 문제를 포함하면 좋겠는데 캡처본은 없나? 최종적으로 반영해서 PPT 만들어 줘"
- 캡처: 레포·PC 어디에도 없음 — 서현 발표 규칙("교재 문제 글·해설집 그림은 붙이지 않는다", 저작권) 때문에 교재 PDF에서 잘라 붙이지 않음. 대신 '교재 예제' 칸에 주어진 수치·구하는 것·답을 우리 말로 적고, 서현이 다시 그린 예제 그림(T1~T7, M7~M10의 (a))을 씀
- AI가 한 일: 덱 v2 (29장) — 문제 슬라이드 10장을 같은 틀로 바꿈: 교재 예제(문제·답·핵심) / 고른 이유 / 설계에 맞춰 바꾼 부분 / 결과 → 설계 반영. M2(Meriam 3/1·3/2) 장 새로 추가, 연계 표 머리글을 '고른 이유 · 바꾼 부분'으로, 메커니즘 1단계에 '종 판별' 추가
- 근거: 고른 이유·바꾼 부분은 서현 `design/2026-11-01_S4_유제선정과_적용.md`(T1~T7), `docs/2026-11-02_발표_역학계산_슬라이드원고.md`(S6~S16), SJ-29 D5e 값. 예제 수치(3/1 50 kg·6 m/s·μ_k 0.4 등)는 서현 그림·대조 값에서 옮김. 새 계산 없음
- 만든 파일: 승준 PC `창의적종합설계\07_발표\2026-11-02_주간발표_역학계산_설계_VespAI_v2.pptx` (+ `build_v2.js`). 레포에는 안 올림 (인터넷 사진 프레임)
- 검증: validate 통과, 29장 렌더해 넘침·겹침 확인

## CAP-AI-SJ-32 · 2026-11-02
- 승준: 버니어 캘리퍼스를 가져옴 → "어디 재야 하나", "정확히 어느 부분인지 그림으로"
- 정정: 처음에 표본(말벌) 재기로 답했으나, 레포상 캘리퍼스 용도는 **상용 트랩 결합부(서현 실측표의 빈 칸 h·홈·돌기)와 마커(D6 '잠정 — 캘리퍼스')**였음 → 바로잡음. 표본 높이 재기는 오늘 바닥 멈춤 논의에서 나온 추가 항목(뒤로)
- AI가 한 일: 측정 위치 그림 2장 — 1쪽 트랩 결합부(차양막 구멍 둘레: D1·D2·D2i·t·토막 a·틈 b·홈 c·높이 h1~h3 / 포획통 바닥: D3·홈 깊이 g·걸쇠 w·p·k) + 반단면 개념도 + 기록표, 2쪽 캘리퍼스 조 쓰는 법·마커(d_g·d_max·x·d_tip·l_tip·L)·D4/D5
- 근거: 서현 사진 `design/img/실측사진/`, `design/img/상용트랩_실측위치.jpg`(잘라 씀), 실측표 값. 사진 A에서 D1·D2 픽셀 비가 55:90과 맞음(약 5.5 px/mm) → 바깥 고리 안지름 약 83 mm, 토막 바깥 약 79 mm는 사진 어림 `미검증`. 반단면은 개념도(높이 모름)
- 만든 파일: `design/img/2026-11-02_캘리퍼스_측정위치_1_트랩결합부_승준.png`, `..._2_마커_통로_승준.png`, 그림 스크립트 `design/calc/caliper_guide_sj.py`
- 남은 것: 승준 측정값 → 승준 기록 파일로 정리 후 서현에게 실측표 반영 Issue (실측표는 서현 담당)

## CAP-AI-SJ-33 · 2026-11-02
- 승준 실측 (디지털 캘리퍼스): 차양막 구멍 둘레 높이 h1 안쪽 턱 9.9, h2 토막 8.9, h3 바깥 고리 8.0 mm
- AI가 한 일: 기록 파일 `design/2026-11-02_상용트랩_캘리퍼스실측_승준.md` 시작 (서현 실측표는 서현 담당 → 다 재면 Issue로 반영 요청)
- 발견: 측정 그림 C(개념도)는 바깥 고리를 가장 높게 그렸으나 실제는 안쪽 턱 > 토막 > 바깥 고리 → 다 재면 실측값으로 다시 그림
- 확인 중: 세 높이의 기준면(같은 바닥면인지) — 차양막이 경사면이라 기준이 다르면 비교 불가 → `미검증`
- 남은 것: D1, D2, D2i·t, a·b, c, 토막 끝 계단 / 포획통 D3·g·w·p·k / D4·D5 / 마커

## CAP-AI-SJ-34 · 2026-11-03
- 승준 실측: D1 56.7 (줄자 55), D2 89.6 (90), D4 5.9 (약 5), D5 17.6 (19) mm. D3는 이해가 안 돼서 아직
- AI가 한 일: 기록 파일에 추가, D3 설명 그림(`design/img/2026-11-03_D3_설명_승준.png`, 스크립트 `design/calc/d3_guide_sj.py`) — 걸쇠 고리 안지름 D3a · 바깥지름 D3b · 바깥 큰 벽 안지름 D3c + 끼운 단면(추정)
- 발견: D5e 입구 통로 안지름 12 mm < 상용 깔때기 끝 17.6 mm (통과 가능 여부 [추측]), CAD 차양막 턱은 한 덩어리(높이 10)인데 실제는 계단 → 서현 Issue 거리
- 남은 것: D2i·t, a·b, c, 토막 끝 계단, D3a·b·c, g, 걸쇠 w·p·k, 마커 → 다 재면 서현에게 Issue

## CAP-AI-SJ-35 · 2026-11-03
- 승준 실측: a 33.9, b 22.1, c 6.8, D3a 81.2, D3b 85.6, D3c 93.1 mm → 기록 파일에 추가 (커밋 f617332)
- AI가 한 일: 맞물림 계산 — 걸쇠 고리 두께 2.2, 포획통 레일 폭 3.75, 4(a+b) ≈ 2πR → R ≈ 35.7 (토막 약 57°, 빈 구간 약 36°). 처음 사진 어림(바깥 고리 안 83, 토막 바깥 79)은 원근 때문에 틀린 듯 → 차양막 D2i가 85.6 이상이어야 맞음 (D2i 측정으로 확인)
- g·w·p·k 설명 그림 `design/img/2026-11-03_걸쇠_gwpk_설명_승준.png` (스크립트 `design/calc/gwpk_guide_sj.py`): w 걸쇠 폭, p_in·p_out은 마주 보는 걸쇠끼리 재서 계산, k1·k2 걸쇠 위치·두께, g1·g2 레일 깊이(두 벽 기준)
- 남은 것: g1·g2, w, E_in·E_out, k1·k2, 차양막 D2i·t, 빈 구간 낮은 턱 높이, 토막 끝 계단, 마커 → 다 재면 서현에게 Issue

## CAP-AI-SJ-36 · 2026-11-03
- 승준 실측: w 12, k1 0.6, k2 3.1, g1 6.7, g2 6.0, p_out 0(걸쇠는 안쪽만), p_in 3.1, D2i 89.9, t 0.7, D2 91.7(다시 잼, 처음 89.6은 D2i보다 작아 모순), 처마 아랫면 2.7, 파인 곳 바닥 차이 ≈ 0, 바깥 고리 높이(홈 c 바닥 기준) 6.6. 처마 파인 깊이는 경사라 못 잼 → 계산(≥ 0.65)
- AI가 한 일: 처마 설명 그림(사진 표시 + 단면), 값마다 맞물림 계산·모순 찾기 → 지름 맞물림 [확실, 계산], 잠금 = 4점 바요넷(빈 구간으로 내려가 돌리면 처마 밑 경사 홈으로) [가능성 높음]
- 정정: 걸쇠가 벽 양쪽으로 튀어나온다고 본 것(사진 판단)은 틀림 — 승준 실물 확인으로 안쪽만
- 서현 요청 Issue 초안을 기록 파일 끝에 둠 — `gh` 로그인 실패(GH_TOKEN)로 Issue는 못 올림 → 다음 세션에 올리기
- 남은 것: Issue 올리기, (선택) 처마 경사·마커, 실측값으로 측정 그림 C·D3 B 다시 그리기

## CAP-AI-SJ-37 · 2026-11-03
- 캘리퍼스 반납 전 마지막 측정 (승준): 마커 7개(앞코 7.2, 몸통 14.7, 몸통 시작 15.6, 팁 2.2 × 8.0, 길이 134.6, 캡 18.8), 포획통 고리 높이 6.3·안쪽 벽 없음, 차양막 토막 6.6 · 안쪽 턱 10.3 (홈 바닥 기준) · 안쪽 턱 바깥지름 61.9
- 발견: D6 '최대 지름 18.9'는 마커 몸통이 아니라 캡. 토막 꼭대기 = 바깥 고리 꼭대기(6.6) → 포획통 바닥판이 토막 위에 얹히고 처마 경사가 당겨 고정 [가능성 높음]. 안쪽 턱은 포획통 가운데 구멍으로 들어감 → 모듈 아랫면 가운데 구멍 > 61.9
- 처마 경사(처1·처2)는 안 잼 — 걸쇠 치수로 직접 설계 가능 (필수 아님)
- 측정 종료 (02:11). 다음: 서현 Issue 올리기(초안은 기록 파일 끝, gh 로그인 필요), 실측값으로 결합부 단면 그림 다시 그리기

## CAP-AI-SJ-38 · 2026-11-06 15:24~16:14
- 도구: Claude (Claude 앱, 승준 PC FreeCAD MCP + 레포 연결)
- 승준 명령: "할 일 찾아서 해. 서현 AI도 돌아가고 FreeCAD도 켜 놓았으니 실제로 사야 하는 부품을 상세 설계. 50분. McMaster에서 필요한 부품을 찾아 설계에 정확히 넣기. CAD 없으면 무엇이 들어가야 하는지, 로그인·다운로드가 필요하면 md에. 끝나면 서현 AI와 조율해 분산. md 3쪽, 초등생도 알게, 내가 나중에 할 일까지"
- AI가 한 일:
  - 승준 PC FreeCAD에서 레포 `cad/D5e_full_assembly.py`를 GitHub에서 받아 그대로 실행(128개 부품) → 구매 부품 치수 측정
  - 발견: X 봉 Ø8 163(목록 155), Y 봉 Ø6 124(목록 106), 목록 누락 Ø4×108 봉 1·Ø3×69 핀 2, T8 길이 80/92.8/132.7, 프레임 610×4·320×21, 브래킷 32
  - McMaster: 'T8 Nuts' 페이지에서 리드 8 T8 없음 확인(가장 가까운 2391N11, M8×2.5 리드 10 아세탈). 다른 페이지는 자바스크립트라 품번을 못 읽음 → 사람이 브라우저로 받을 목록을 md에. McMaster는 해외구매라 정산 불가 → 규격·CAD 참고용만
  - `purchase/cad_parts/sj_purchased_parts.py`: 판매 규격 부품 14종 그림(LM 링 홈 포함) + `check()` 대조 → **20/20 OK**, FreeCAD 문서 `SJ_purchased_parts` 생성 (승준 PC, 저장 안 함)
  - 서현 CAP-AI-23 회로 BOM(15:31 push) 확인 → 분담: 전기 = 서현 BOM, 기계 = 승준. Issue #7로 대조 결과·D5f 요청 8개 전달 (서현 세션은 이 PC에서 메시지가 안 닿아 Issue로)
  - 구매목록 총정리 맨 위에 11/06 갱신 줄
- 만든/고친 파일: `purchase/2026-11-06_기계부품_구매상세_McMaster대조.md`, `purchase/cad_parts/sj_purchased_parts.py`, `purchase/2026-10-28_구매목록_총정리.md`(갱신 줄)
- 검증: 대조 20곳 스크립트로 OK [확실, 모델 기준]. LM·볼트 규격 [확실], T8 너트·KW11 치수 [가능성 높음], 28BYJ-48 고정 나사 M4 [추측]. 가격·국내 링크 `미검증`(안 찾음)
- 남은 결정: 몇 대(서현), 스프링 146 k(서현), 28BYJ-48 고정 나사(실물), 봉 자르기 방법(승준), McMaster STEP 받기(선택, 승준 브라우저)

## CAP-AI-SJ-39 · 2026-11-06 18:50~
- 도구: Claude (승준 PC FreeCAD MCP + 레포)
- 승준 명령: "깃허브 보고 서현의 업데이트 지시사항 확인해서 캐드를 실제 제품과 내가 설계할 것들로 나누고 상세 설계하자. 뭐가 뭔지 모르겠다. 프로파일을 이렇게 대충 설계하는 게 맞아? 맥마스터 카 보고 치수 맞춰서 다시 만들어. 세세하게"
- 읽은 것: Issue #7 서현 댓글 5개(분담 OK, 28BYJ-48 M4 × 2, 스프링 146 기성품 7조건, 서현 CAD 멈춤), `docs/2026-11-06_승준_작업지시.md`(기구·구매·펌웨어·비전 승준이 인수)
- AI가 한 일:
  - McMaster: 20 mm 시리즈·볼 부싱 페이지가 필터만 보임 → 단면은 2020 슬롯 6 데이터시트 + 미스미 LCF6-2020로 맞추고, 단면적·관성 계산으로 확인 (0.452 kg/m, 0.717 cm⁴ ↔ 0.45~0.50, 0.72)
  - `cad/D5g_frame_detail.py`: 상세 단면 25토막, L 브래킷 32(리브·키), M5 × 8 볼트 64, T너트 64, 부품 4분류(A 73 / B 42 / C 10 / D 21) 묶음·색. 검사 겹침 0건, T너트 64/64 홈 안
  - GitHub raw 캐시로 옛 파일이 받아지는 문제 → API(raw)로 받음 (다음 Claude 참고)
  - 표: `cad/2026-11-06_D5g_부품분류_구매품과_설계품.md`, purchase M10~M12 고침(M5 × 10 → 8), cad/README 기록
- 검증: 단면 계산 대조 [확실], 겹침·T너트 위치 스크립트 [확실, 모델 기준], 브래킷 치수 [가능성 높음], T너트 치수 [추측], 그림 파일 `미작성`
- 남은 결정: 브래킷·T너트·로드셀 실물 치수, 프린터 판 크기(101 데크 230 × 180), 142 심지 살지 만들지, B 상세 설계 순서(158 → 문 하우징 → 212·218 제안)

## CAP-AI-SJ-40 · 2026-11-06 19:04~
- 승준 명령: "추측을 가능성 높음까지 바꿔. 위쪽에 가두는 통은 지우지 마. 보라색 사각형은 뭐고 왜 공중에 떠 있어? 급이부는 어떻게 설계할 건데, 설탕물 주고 방생하려고 했잖아. 설탕물 주는 방은 개념설계하고, 사각형은 공중에 떠 있게 하지 말고 상세 설계로 제품이 있으면 CAD 넣고 아니면 3D 프린터로 설계해서 보고해"
- 잘못한 것: 앞 세션에서 보기용으로 상용 트랩 포획통·위판을 숨김 → 다시 보이게 함. 스크립트는 지운 적 없음.
- AI가 한 일:
  - 보라 사각형 = D5f `195_uln2003_X·Y` 자리 상자. 기둥 없는 y 위치라 떠 있었음 → ULN2003 판매품(35 × 31.9 × 11, M2.5 30 × 26.5, 판매처 2곳) 모양 + 197 받침(레일 위, M5 × 8 + T너트)
  - 설탕물 급이 개념: 병아리 물그릇 원리 — 팰컨 50 mL(코닝 352070 도면) 거꾸로 + 코튼롤 2호(Ø10 × 38) + 143 물길·그릇·기둥(PETG), 마킹실 +y 벽 구멍. 튜브는 X 빔이 안 지나가는 y 95
  - floating 검사 추가 → Pi 5(199a 선반), G4·G6(199b·c 받침)도 떠 있어서 고침. 새 부품·고친 부품 겹침 0건
  - T너트 [추측] → [가능성 높음] (판매처 10 × 9.5 × 4.5), 28BYJ-48 M4 → [확실](서현 결정)
  - 올린 교재 PDF 4권은 이번 작업에 안 씀 (레포에 올리지 않음 — 공개 레포 규칙)
- 만든/고친 파일: `cad/D5g_feeder_uln.py`, `cad/D5g_frame_detail.py`, `design/2026-11-06_급이방_개념설계_ULN보드_승준.md`, `cad/2026-11-06_D5g_부품분류_구매품과_설계품.md`, purchase M12·M17~M21, cad/README
- 검증: 겹침·닿음 스크립트 [확실, 모델 기준], 제품 치수 [확실/가능성 높음 표기대로], 급이 물 높이·마름·말벌이 먹는지 `미검증`(현장 시험)
- 남은 결정: 급이를 마킹실에서 할지 따로 칸을 둘지(지금: 마킹실), 3D 프린터 크기, 실물(T너트·ULN 보드) 캘리퍼 확인

## CAP-AI-SJ-41 · 2026-11-06 19:28~
- 승준 명령: "모터 드라이버를 상자 모양으로 퉁치지 말고 정확한 보드 모양으로. 외부 소스가 있으면 가져와. 방생부 어딨고 급이 장치 어떻게 만들 건지, 펌프·전기 없다고 했는데 어떤 방식·원리인지 세세하게 설명해"
- AI가 한 일:
  - 외부 CAD: Adafruit_CAD_Parts에는 해당 부품 없음 → KiCad 공식 3D 라이브러리(GitHub)의 STEP(DIP-16, JST XH 5핀, 핀 헤더 1×4·1×2, LED Ø3, 단자대 PT 1,5 4핀, 퓨즈 홀더 FX0457), 라즈베리파이 공식 Pi 5 STEP을 승준 PC FreeCAD가 직접 받아 넣음 (`cad/D5g_real_parts.py`, 레포에는 STEP 안 올림)
  - ULN2003 3장 = 판매 규격 기판 + KiCad 부품, 단자대·퓨즈(사진 속 긴 상자 193) = 만능기판 + KiCad 부품 + 받침, Pi 5 = 공식 STEP 구멍 4개를 선반 구멍에 맞춤 + M2.5 × 5 기둥. 모두 겹침 0건
  - 급이 결함 발견·고침: 물 높이 374 > 벽 구멍 아래 끝 372.7 → 새는 구조였음 → 물 높이 369, 코튼롤 10.4° 기울임, 구멍 Ø11.2 → 여유 3.6 mm ≥ 열팽창 최대 2.6 mm
  - 설명 문서: `design/2026-11-06_급이장치_원리_방생부_설명_승준.md` (대기압·모세관 원리, 계산, 순서, 방생부 위치)
  - 방생부 문제 발견: 175 출구 원뿔 끝 안지름 Ø3 → 말벌(약 5 mm) 못 나감 → 안 1(곧은 관 Ø12 + 갓) 추천, 승준 결정 대기
- 검증: 겹침 스크립트 [확실, 모델 기준], 압력·열팽창 계산 [확실], ULN2003 부품 배치 [가능성 높음 ±2 mm — 실물 보드 확인], Pi 선반 벽과 Pi 기판 끝 틈 0 mm(닿음, 겹침 없음) → 1 mm 띄우기 남음
- 남은 결정: 방생 출구 안 1/2, 급이 바닥 높이 370(표본으로 말벌 머리 높이 확인)

## CAP-AI-SJ-42 · 2026-11-06 19:48~
- 승준 명령: "파란 부품이 뭔지 초등생도 알게 설명해. 물 높이가 늘 입구 높이로 유지된다 같은 말은 어려우니 고쳐. 글 말고 그림 그려서 화살표로 설명해"
- AI가 한 일: 그림 설명 페이지(SVG 9장, 화살표) — ① 파란 부품 = 퓨즈 + 단자대(멀티탭 비유, 어댑터 → 퓨즈 → 단자대 → 모터·서보) ② 거꾸로 세운 튜브가 안 쏟아지는 이유(정수기 생수통·빨대 비유) ③ 물이 줄면 공기방울이 들어가 다시 채워지는 3컷 ④ 솜이 물을 옮기는 단면(휴지 비유) ⑤ 새지 않는 이유(3.6 mm = 손톱 7장, 더울 때 2.6 mm) ⑥ 언제 먹나(바닥 높이 3컷) ⑦ 방생부 위에서 본 그림 + 출구 3 mm 문제·안 1
- 만든 파일: `design/2026-11-06_그림설명_단자대_급이_방생_승준.html` (Claude 페이지로도 게시)
- 검증: 한 번 렌더해서 글자 겹침·잘림 고침
- 남은 결정: 방생 출구 안 1/2

## CAP-AI-SJ-43 · 2026-11-06 19:58~
- 승준 질문: 설탕물에 다른 벌레가 꼬이면? / 방생 출구를 좁힐 필요 있어, 일자면 되지 않아? / 파란 부품(단자대·퓨즈)이 꼭 필요해? 라즈베리파이 회로엔 이런 게 없던데
- AI가 한 일:
  - 벌레: 물길·그릇 뚜껑 143l 추가 (튜브 둘레 0.4 mm 틈만 숨구멍), 기둥 개미 막이 띠(끈끈이·바셀린) 제안, 솜 끝은 마킹실 안에만 → 들어온 벌레만 닿음. 이틀마다 솜 갈기
  - 방생: 승준 말대로 175를 일자 관(안지름 12, 15 mm) + 비 가림 갓으로 바꿈 (`release_exit_fix`). 겹침 0건
  - 파란 부품: 모터 3 + 서보 4 동시 1.5~3 A ≫ 보드 5 V 핀 약 0.5 A → 어댑터에서 따로 나눠 주는 곳은 필요. 단자대 대신 와고 레버 커넥터 + 줄 퓨즈 추천 (기판·받침 불필요) — 서현 회로 BOM이라 같이 결정
  - 그림 페이지에 4~6장 추가 (`design/2026-11-06_그림설명_단자대_급이_방생_승준.html`)
- 검증: CAD 겹침 0건 [확실, 모델 기준]. 전류값: 28BYJ-48 약 0.2 A·MG90S 멈춤 약 0.7 A·UNO 5 V 핀 약 0.5 A [가능성 높음 — 일반 사양]. 0.4 mm 틈이 개미를 막는지는 미검증(개미 막이 띠로 보완)
- 남은 결정: 와고로 바꿀지 (서현과)

## CAP-AI-SJ-44 · 2026-11-06 20:07~
- 승준 지적: 통로가 길 필요 없음. 정찰벌이 나가야 뒤따라 나가는 것 같고, 말벌은 기어가기보다 상승 비행을 좋아함 → 반영해서 수정
- AI가 한 일:
  - 근거: 상용 말벌 트랩이 '먹고 위로 날아올라 위 통에 갇히는' 원리를 씀 [가능성 높음]. 우리 장치는 한 마리씩 내보내 따라갈 정찰벌이 없음 → 혼자서도 바로 찾는 출구로
  - 방생: 174를 짧은 목 30 mm(안지름 12, 전 65 mm)로, 175를 위로 열린 굴뚝(안지름 50, x 120~174, 바닥 355·꼭대기 430, 빗물 구멍 Ø3 × 4)으로, 꼭대기 테두리 출구 조명 LED 3개(184), G6 빛 게이트를 목 위(x 108)로 옮김 (`release_shaft_apply`)
  - 자리 근거 [확실 — 모델 측정]: 마커 갠트리 x ≤ 118·z ≥ 396 (최대 이동 +13 mm까지 겹침 0), 방생 서보 x ≤ 116.5, 2020 레일 아래 면 z 452
  - 그림 페이지 5번을 새 방생 그림으로
- 검증: 목·굴뚝·조명·G6 겹침 0건, 갠트리를 x +13 옮겨도 굴뚝과 겹침 0 [확실, 모델 기준]. 말벌이 실제로 굴뚝으로 날아 나가는지는 현장 시험
- 남은 결정: 출구 조명 색(흰색/자외선 — 말벌이 더 끌리는 빛은 시험), 굴뚝 꼭대기 높이(지금 430, 레일 아래 22 mm)

## CAP-AI-SJ-45 · 2026-11-06 20:13~
- 승준 지적: 출구 조명이 필요해? 상용 트랩은 조명 없이 잘 됨. LED가 말벌이 못 오게 하는 건 아니야?
- 결정 (승준): 출구 조명 LED 184 뺌. 근거: 굴뚝 위가 하늘로 열려 낮에는 이미 밝음 [가능성 높음], 방생 때 마킹실 조명만 끄면 굴뚝이 더 밝음, 밤 LED는 나방 등 다른 벌레를 부름 [가능성 높음]. LED가 말벌을 쫓는다는 근거는 못 찾음 [추측]
- 고친 것: `cad/D5g_feeder_uln.py`(LED 안 만듦), FreeCAD 문서에서 184 지움, 그림 페이지 5번(햇빛·불 끄기로)
- 서현에게 Issue #7: 제어 A5 '출구 조명 켬·60 s 깜빡' 단계 빼기, 조명 MOSFET 1개 줄일 수 있음

## CAP-AI-SJ-46 · 2026-11-06 20:23~
- 승준 지시: "모든 걸 서현에게 맡기지 마. 캐드 상세 설계는 서현이 나한테 맡긴 일이야. 네가 처리해. 캐드 설계를 하고 제어가 따라붙는 거지. 캐드가 우선. 밤 방생 하지 마, 아침에만 작동. 밤에는 전부 가두어"
- 해석: 밤 = 처리·방생 안 함, 들어온 말벌은 전부 포획통으로 (마킹실에 있던 말벌도). 해 뜬 뒤부터 처리
- AI가 한 일:
  - `control/pi/daynight.py`: 해 뜸·짐 계산(공주), is_day(±30분), night_mode/day_mode (문·펜·바닥) — 시험 통과
  - `control/2026-11-06_낮밤_동작_승준.md`: 밤·낮 상태표, 방생 순서(출구 조명 없음)
  - 캐드(승준 결정): 193 단자대·퓨즈 기판 → 와고 221-415 × 2 + 받침 193h, 줄 퓨즈는 전선 중간. 191·192 UNO 상자 → 실제 모양(공식 기판 규격 + KiCad STEP 헤더·DIP-28·잭, USB-B는 규격 외형), 쌓는 높이 고침(아래 5, 사이 12 — 전에는 USB가 위 UNO와 부딪쳤음), 기둥 3점(헤더 옆 구멍 못 씀). 모두 겹침 0
  - 구매 M22~M24, 뺄 것 정리
- 검증: 겹침 스크립트 [확실, 모델 기준], 해 뜸·짐 계산 [가능성 높음 ±수 분]
- 남은 일 (캐드, 승준 쪽): D 자리 표시 남은 것 — 194 비상 정지(보라 원기둥), 196 빛 게이트 송수신기. UNO 공식 STEP은 SnapEDA 로그인 필요 → 승준이 받으면 바꿔 끼움

## CAP-AI-SJ-47 · 2026-11-06 20:35~
- 승준 지시: 다음 차례(남은 자리 상자) 진행, 빛 게이트가 왜 필요한지 초등생 수준으로, SnapEDA에서 아두이노 3D 받는 법
- AI가 한 일 (캐드 — 승준 결정):
  - 문 게이트 6쌍: [확실 — 모델] 입구·격리 문 하우징 사이 틈 5 mm라 Adafruit 2167(20 × 10 × 8)이 안 들어감 → 3 mm 적외선 LED + 수광 소자 낱개(KiCad LED_D3.0mm 모양)를 벽 구멍 Ø4.2에 꽂음, 다리는 몸통 뒤 1.5 mm만 (실물은 구부림)
  - 통로 게이트 G1·G4·G6: 2167 모양(판매처 치수), 빔 지나는 통로·받침에 Ø3.2 구멍 (앞 버전 코드가 이름 앞 10자로 묶어 구멍 하나만 뚫던 것 고침)
  - 비상 정지: [확실 — 모델] 데크 아래 전부 상용 트랩 차양막(지름 260)이라 데크 구멍 방식 불가 → 데크 높이 레일(x −170) 바깥에 3D 프린트 판 194b, 버섯 머리는 프레임 밖을 봄 (밖에서 누르기 쉬움), 데크의 잘못 뚫은 구멍 메움
  - 이제 D 묶음(자리 표시)은 빛줄기 9개뿐 — 전기 부품 자리 상자 없음. 모두 겹침 0
  - 그림 페이지 7번: 빛 게이트 = 보이지 않는 줄 (자동문 비유), 9쌍이 하는 일 지도
  - 구매 M25~M27
- 남은 것: UNO 공식 STEP (승준이 SnapEDA에서 받음), 비상 정지 판 앞·뒤 길이 나눔·T너트 실물 확인

## CAP-AI-SJ-48 · 2026-11-06 20:45~
- 승준: SnapEDA에서 아두이노 공식 3D(A000066.STEP, 16 MB, 'ARDUINO UNO REV3' SolidWorks 2017)를 받아 올림
- AI가 한 일:
  - 승준 PC 다운로드 폴더의 같은 파일을 FreeCAD에서 읽음 (레포에는 안 올림 — SnapEDA 약관·용량). `find_uno_step()`이 `~/Downloads/A000066*.step`을 찾고, 없으면 앞의 근사 모양으로
  - 방향 맞춤: 얇은 방향을 z로 눕힘 → Ø3.2 구멍 4개를 UNO 공식 구멍 자리와 비교 → x축 180° 뒤집기 + 회전 0°에서 4/4 맞음 [확실]
  - 고친 것 [확실 — 공식 STEP 겹침]: ① 기둥 함수 다시 돌릴 때 USB 튀어나온 6.35 mm만큼 기둥이 밀리던 버그 → 기판 원점 고정 ② UNO 사이 12 → 15 mm (위 UNO 핀 끝이 아래 UNO 부품에 닿았음) ③ 왼쪽 아래 구멍 위 기둥은 옆 부품과 닿아 외경 4 이하
  - UNO 2장·기둥 겹침 0
- 남은 것: 서현 PC에는 이 STEP이 없으면 근사 모양으로 그려짐 (필요하면 서현도 SnapEDA에서 받기)
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
