britams/-capstone-project-repo/cad/D5_도1_측단면_대기.png

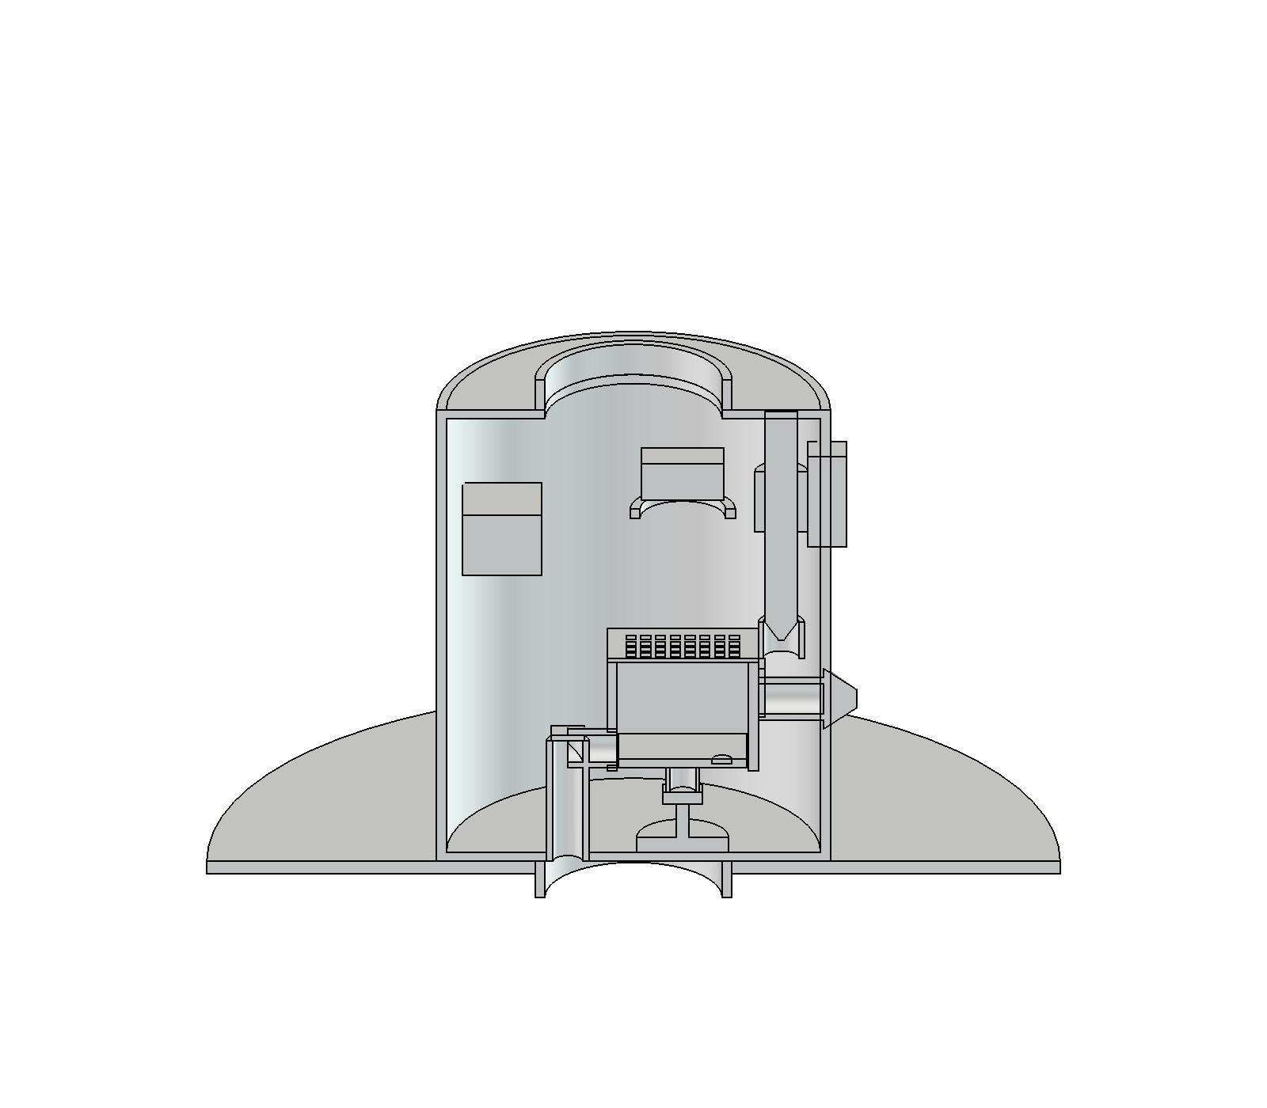
cad/D5_도1_측단면_대기.png
