britams/-capstone-project-repo/cad/D5b_전체_등각.png

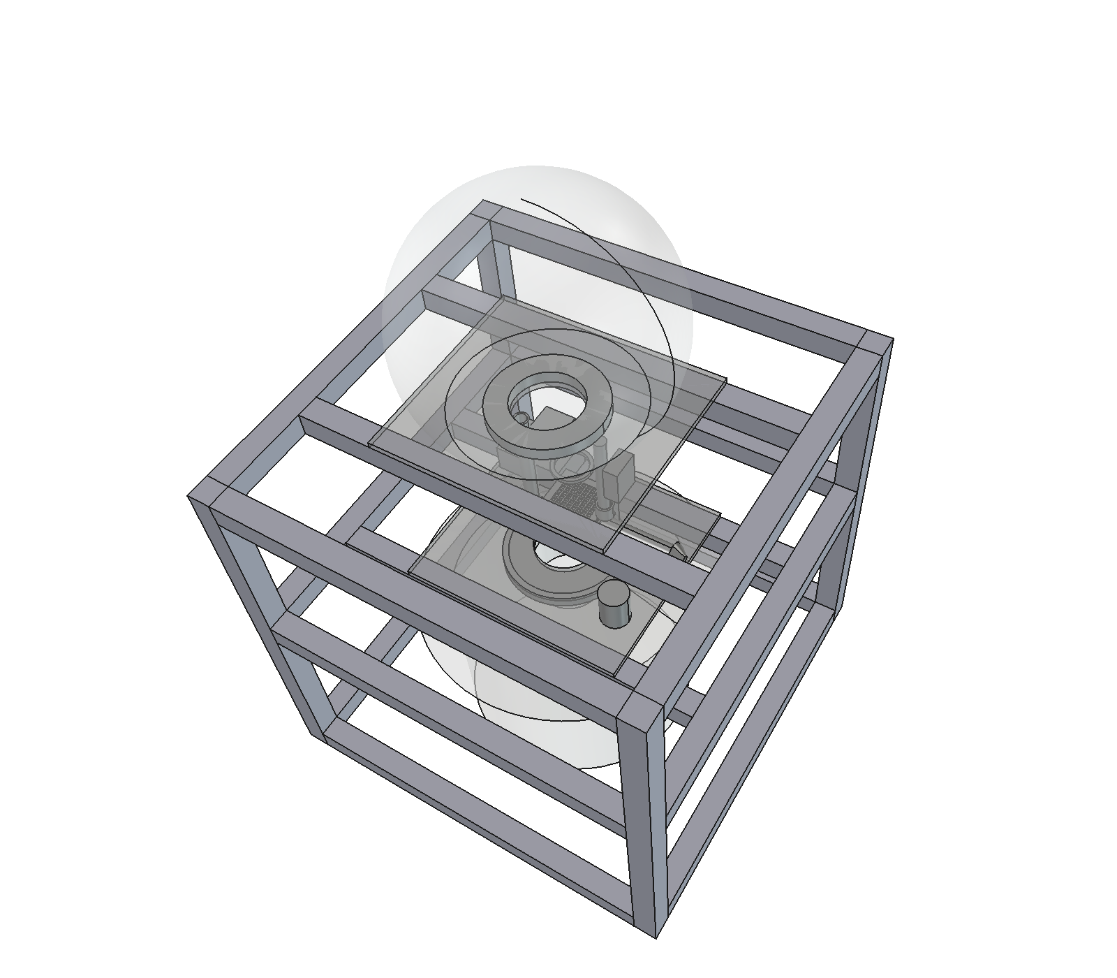
cad/D5b_전체_등각.png
