britams/-capstone-project-repo/cad/D5b_측단면_대기.png

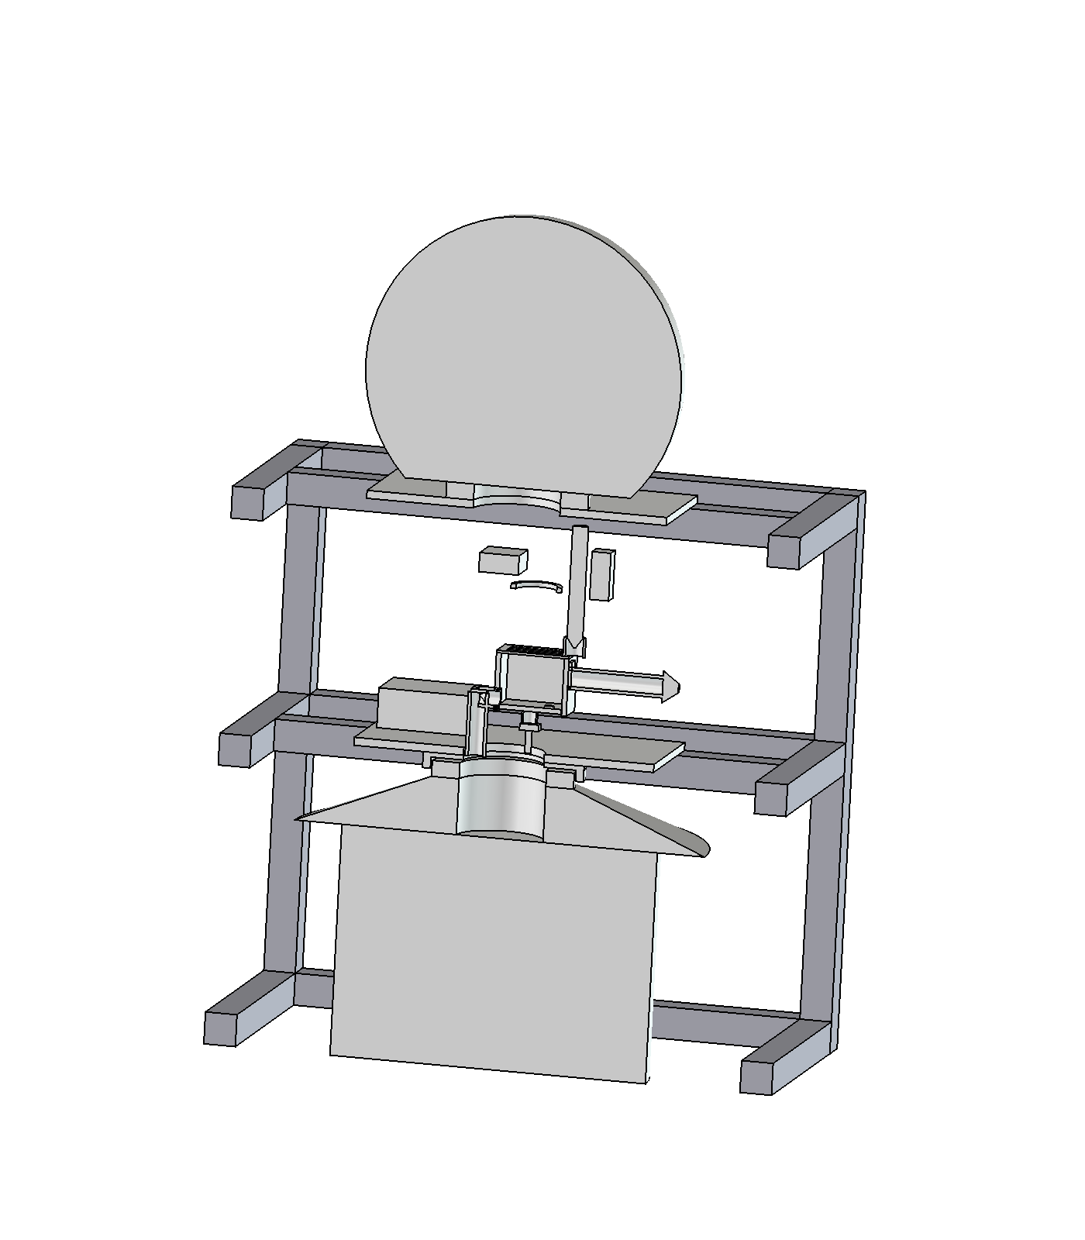
cad/D5b_측단면_대기.png
