britams/-capstone-project-repo/cad/D5c_도1_전체_등각.jpg

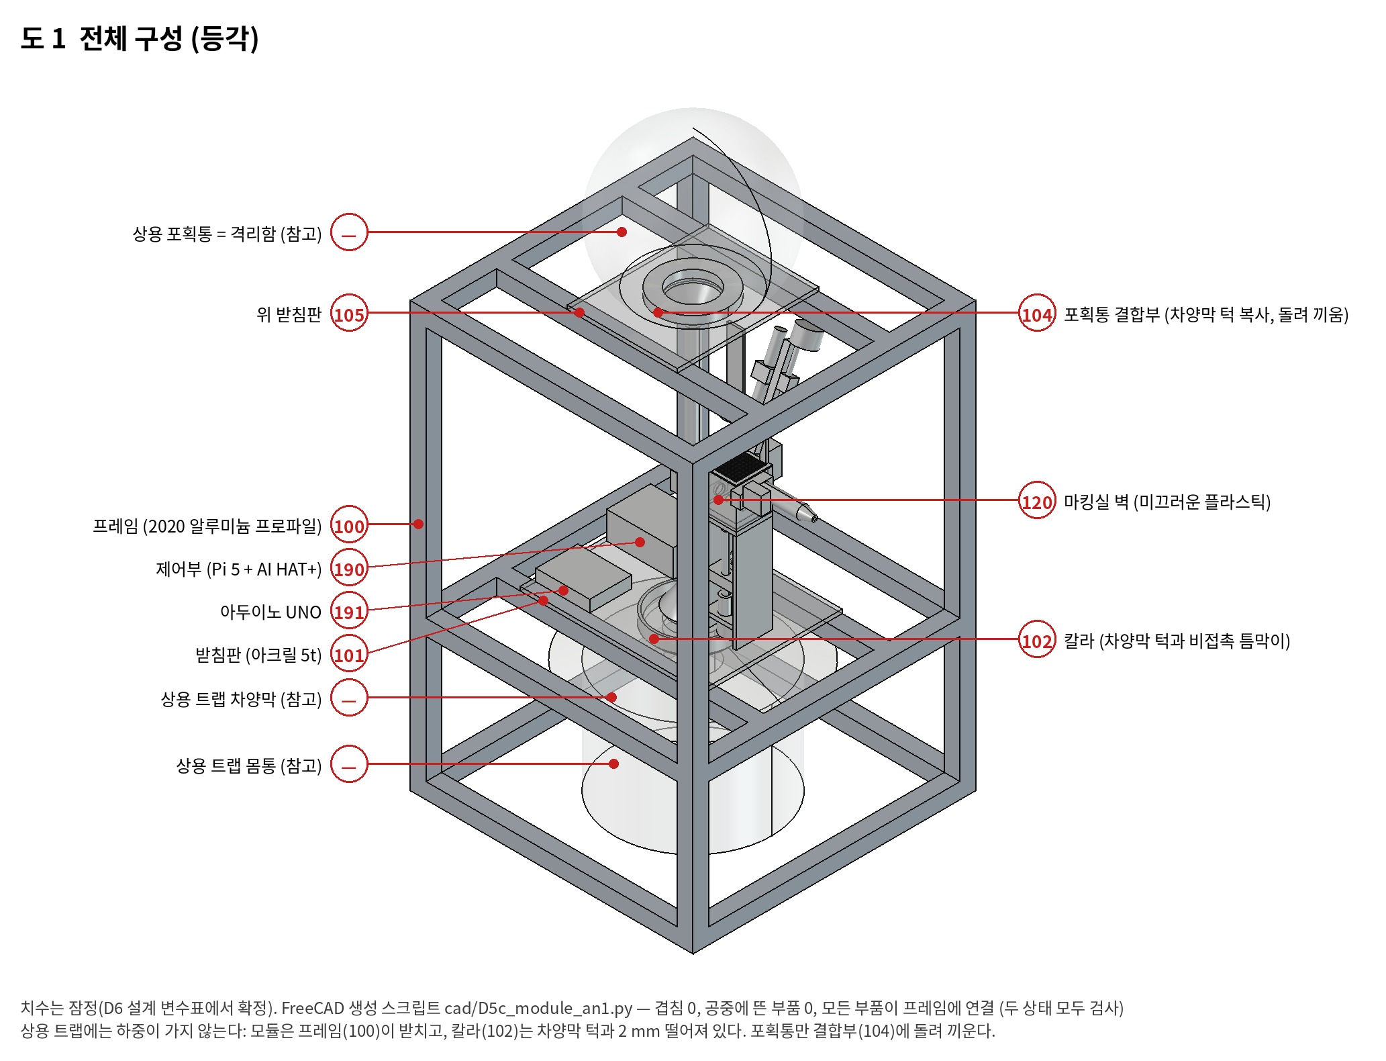
cad/D5c_도1_전체_등각.jpg
