britams/-capstone-project-repo/cad/D5c_도2_모듈_등각.jpg

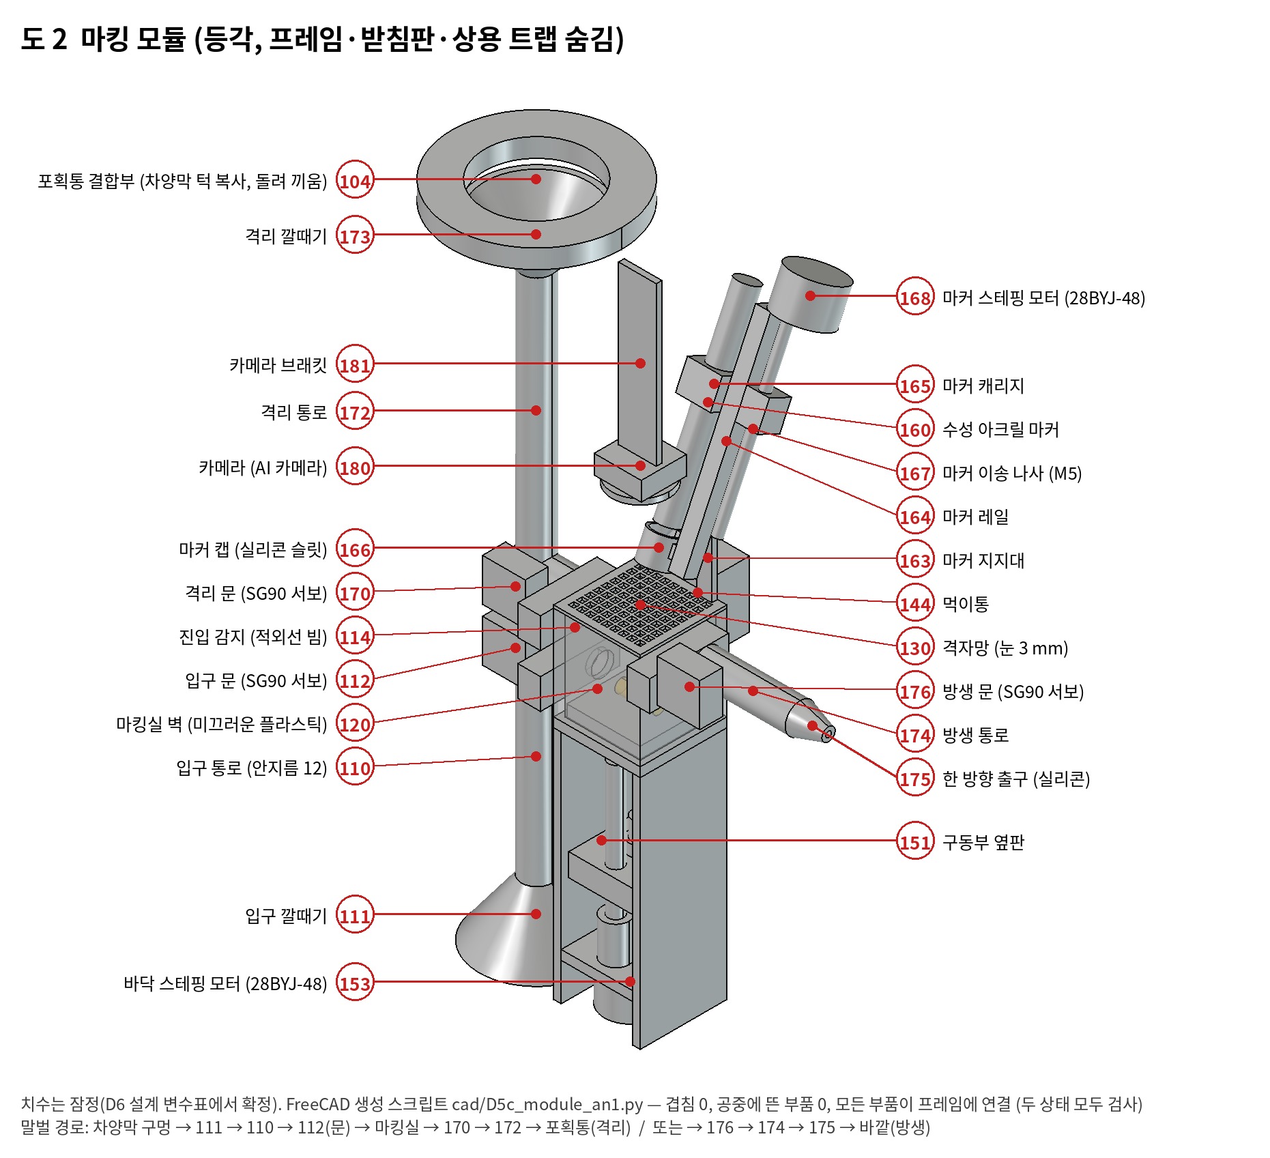
cad/D5c_도2_모듈_등각.jpg
