britams/-capstone-project-repo/cad/D5c_도3_단면_대기.jpg

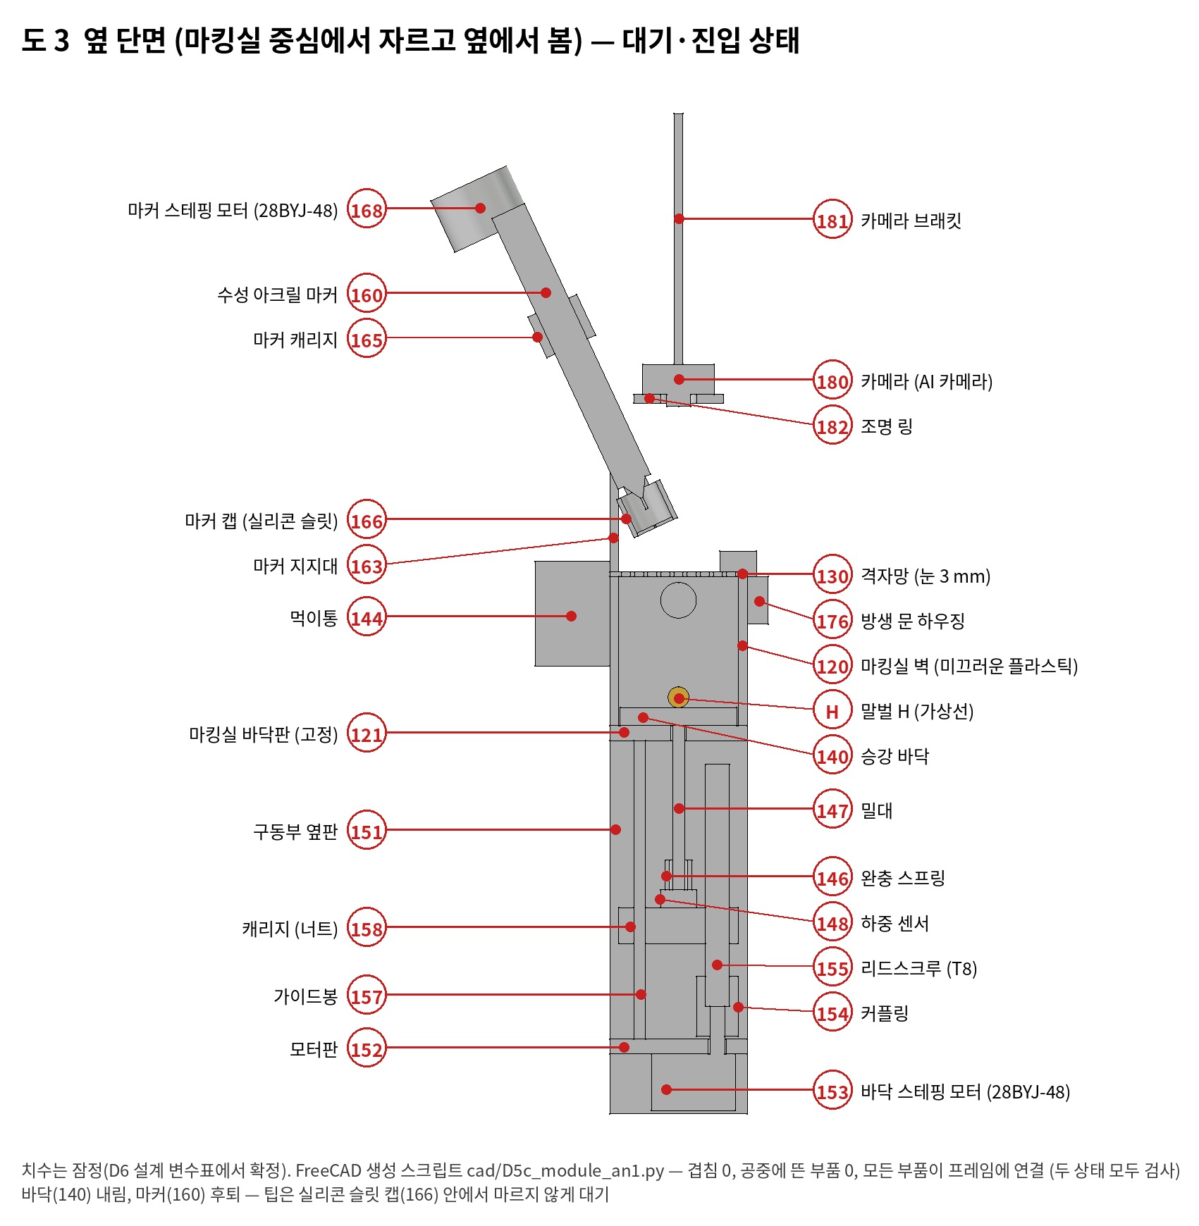
cad/D5c_도3_단면_대기.jpg
