britams/-capstone-project-repo/cad/D5d_도5_전체_등각.jpg

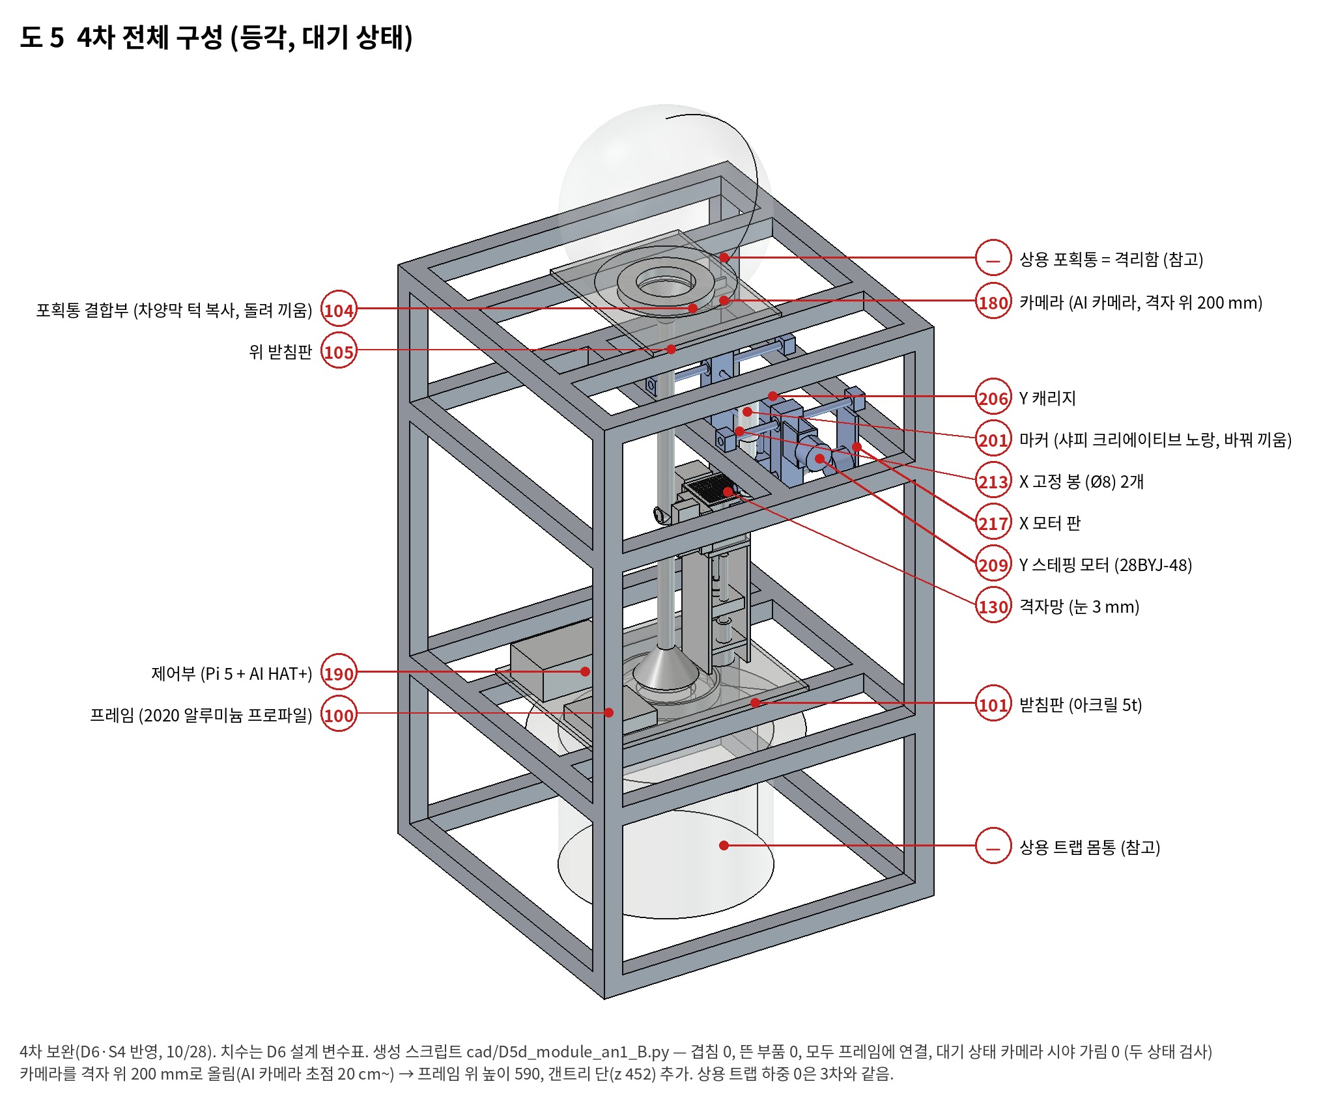
cad/D5d_도5_전체_등각.jpg
