britams/-capstone-project-repo/cad/D5d_도6_마킹부_등각.jpg

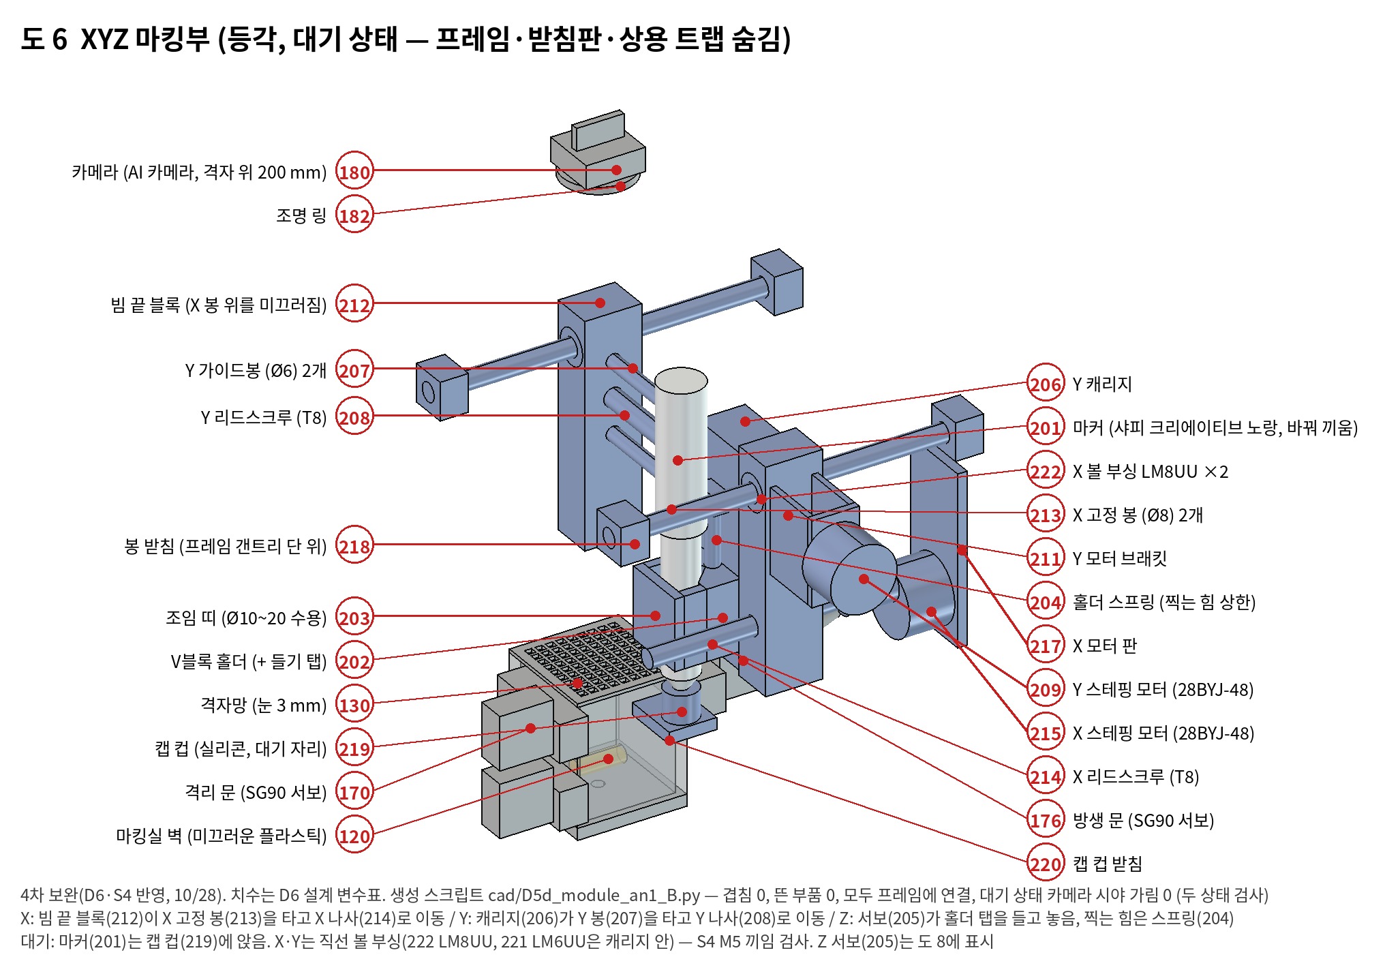
cad/D5d_도6_마킹부_등각.jpg
