britams/-capstone-project-repo/cad/D5d_도7_정면단면_마킹.jpg

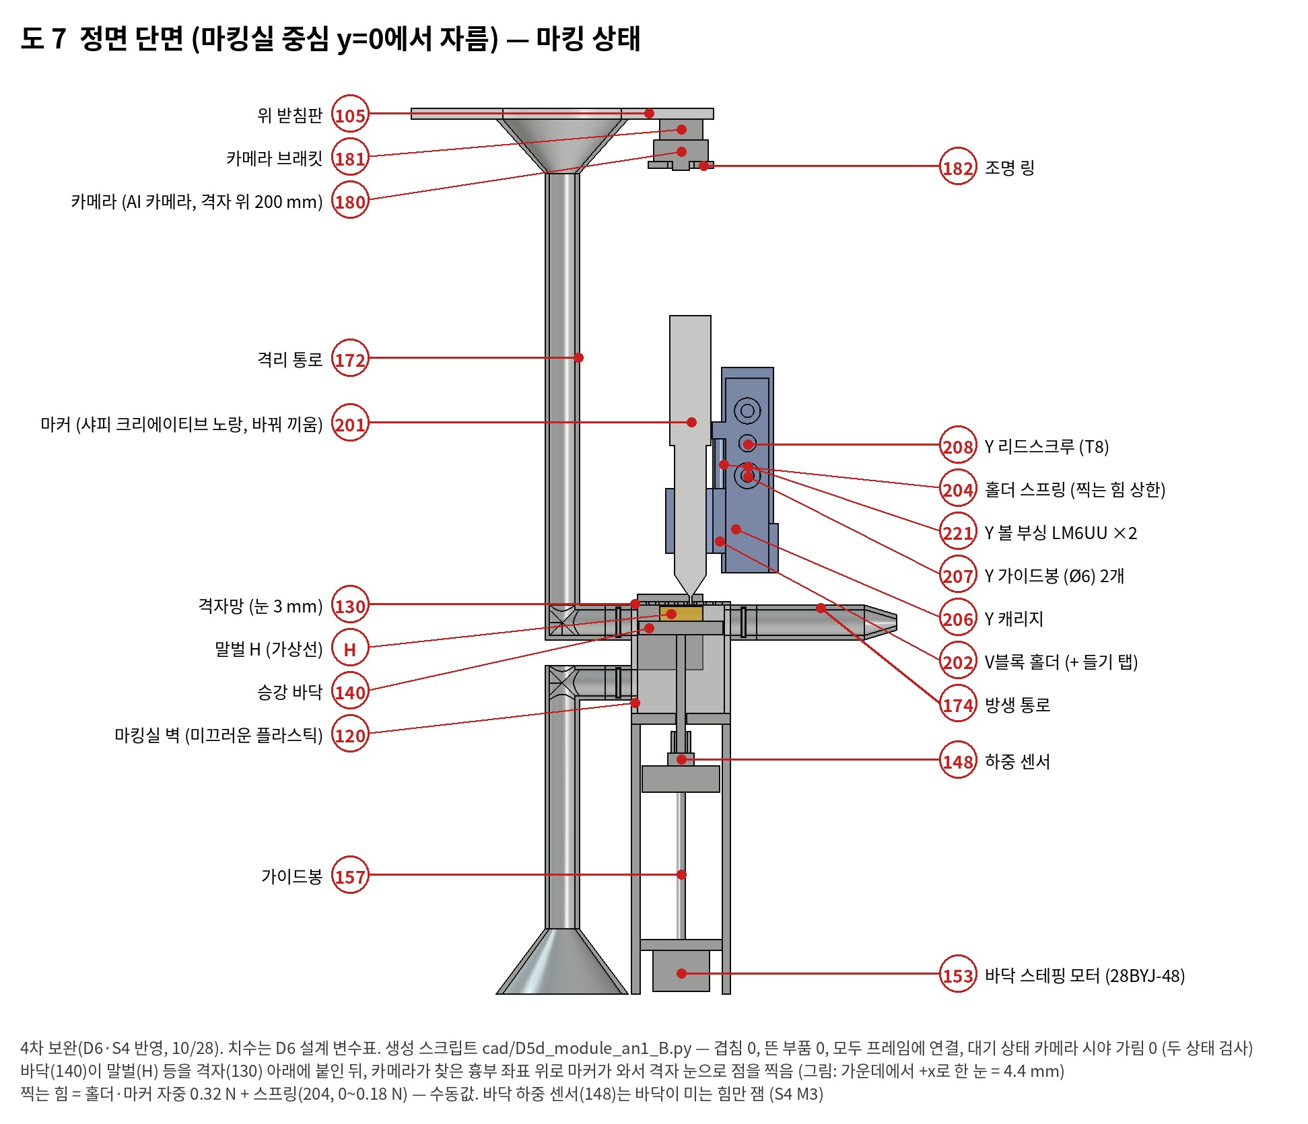
cad/D5d_도7_정면단면_마킹.jpg
