britams/-capstone-project-repo/cad/D5d_도8_위_대기.jpg

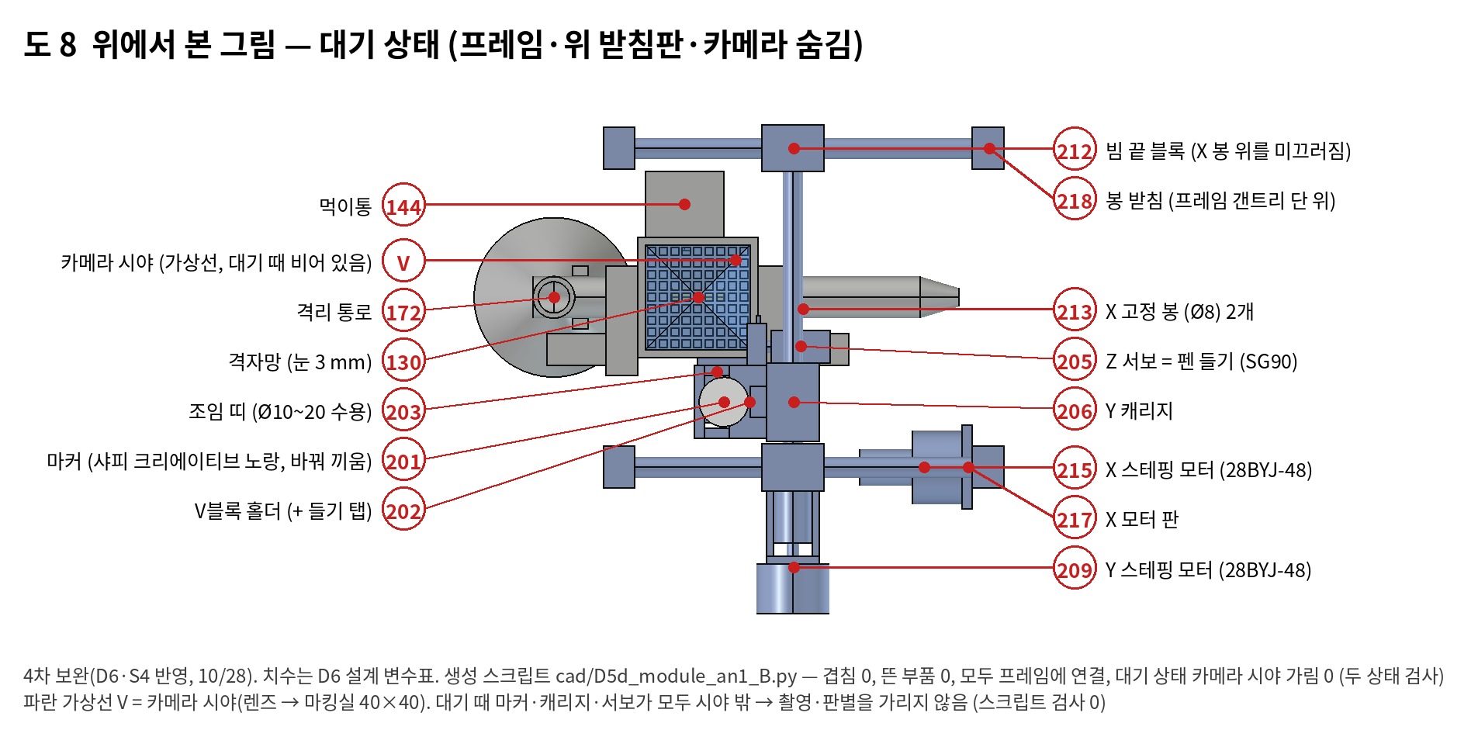
cad/D5d_도8_위_대기.jpg
