britams/-capstone-project-repo/cad/D5e_도1_전체_등각.png

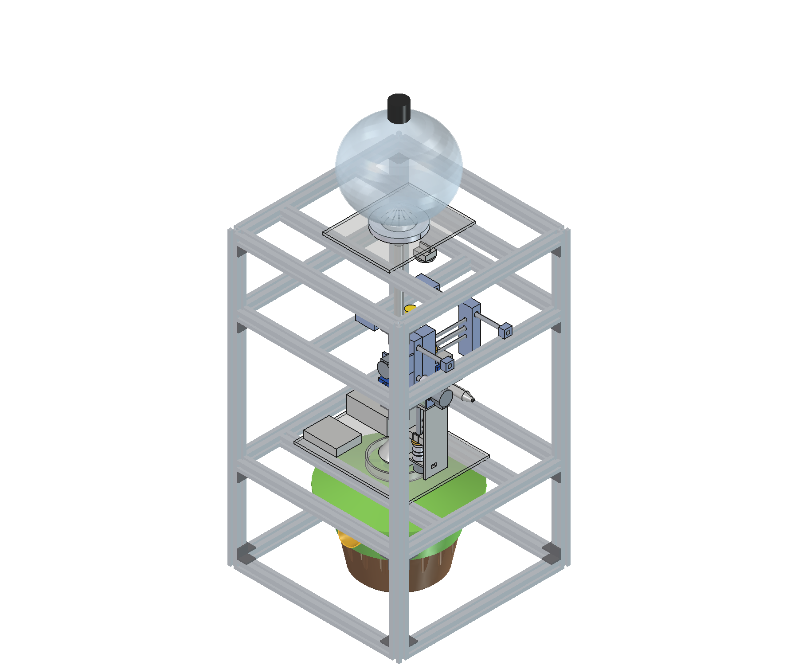
cad/D5e_도1_전체_등각.png
