britams/-capstone-project-repo/cad/D5e_도2_정면.png

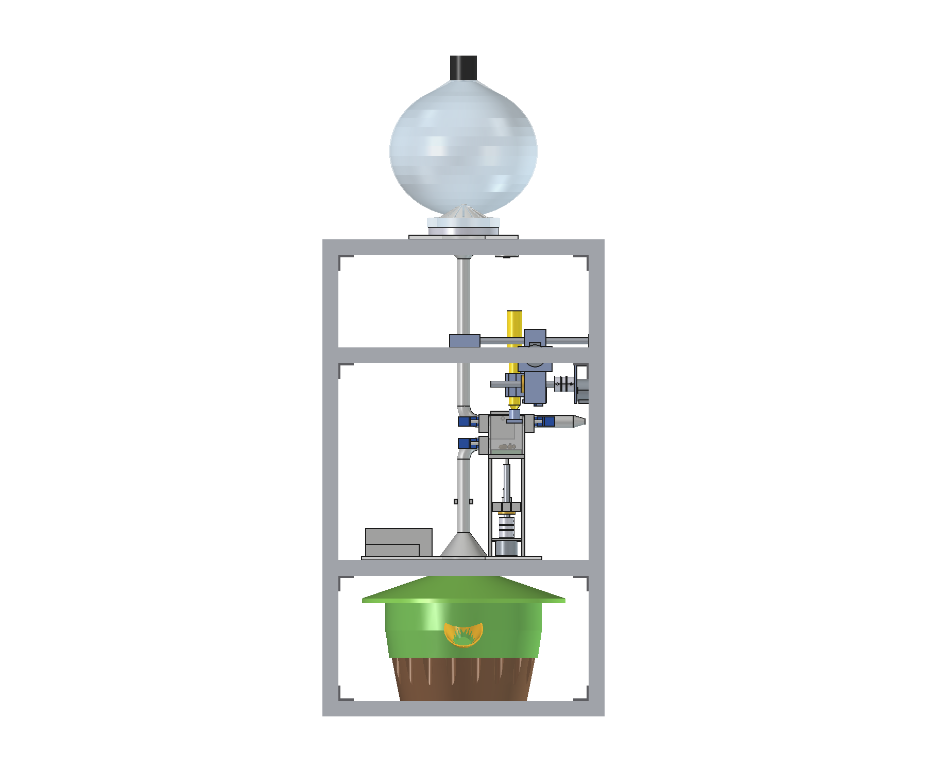
cad/D5e_도2_정면.png
