britams/-capstone-project-repo/cad/D5e_도4_위.png

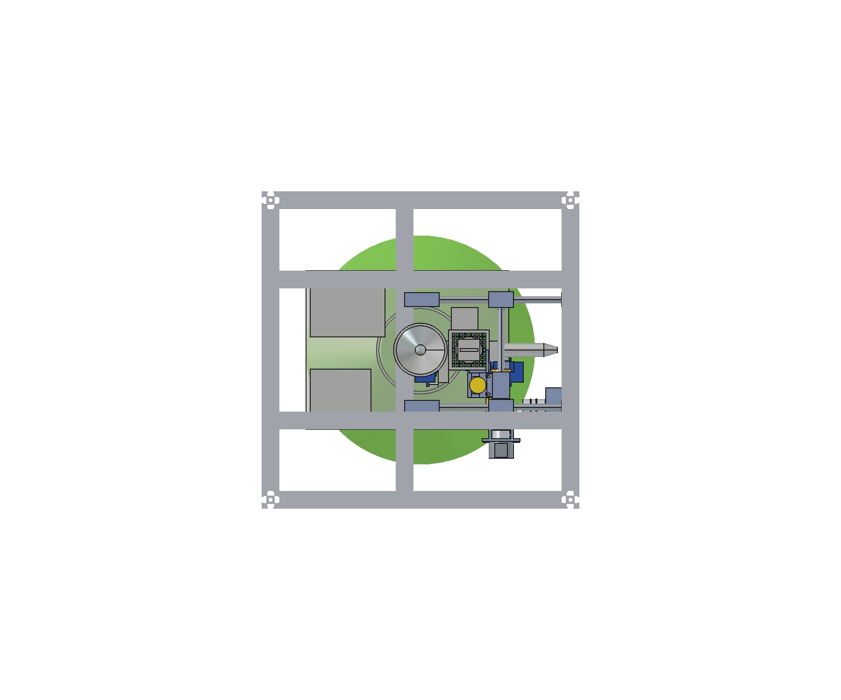
cad/D5e_도4_위.png
