britams/-capstone-project-repo/cad/D5e_도5_모듈_등각.png

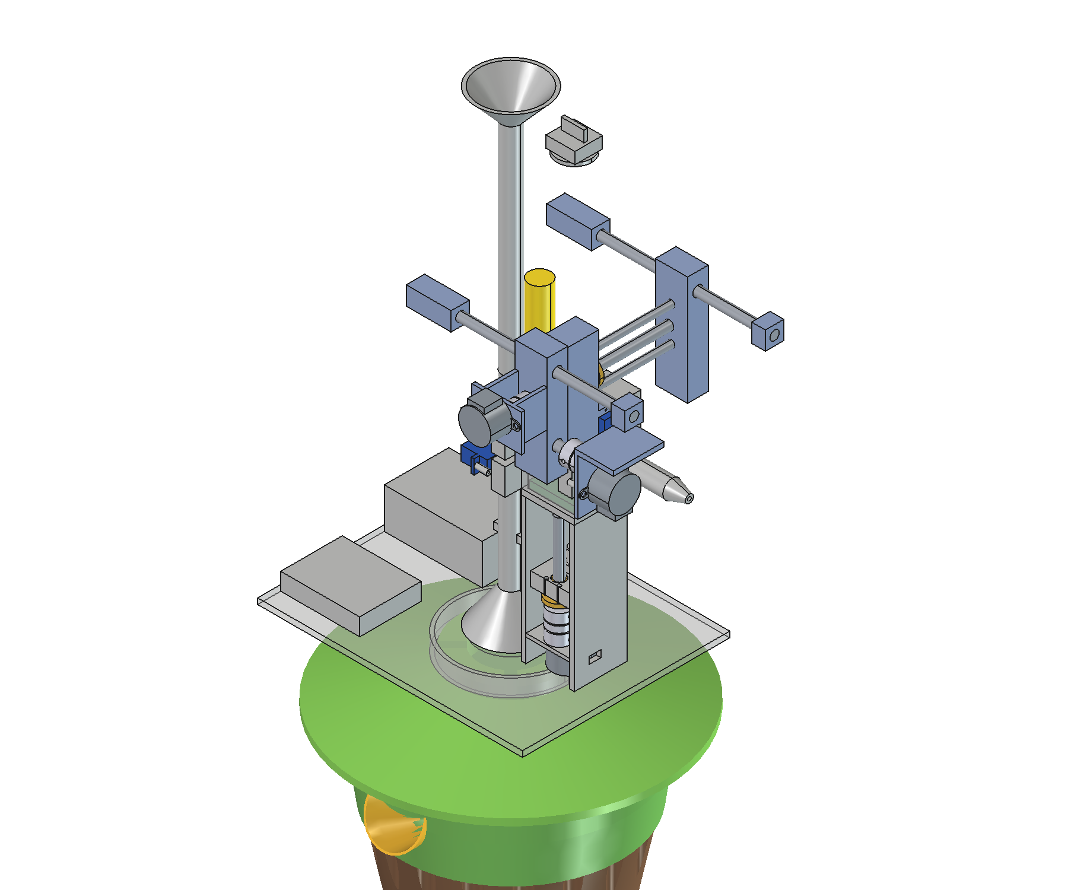
cad/D5e_도5_모듈_등각.png
