britams/-capstone-project-repo/cad/D5e_동작_한마리처리.gif

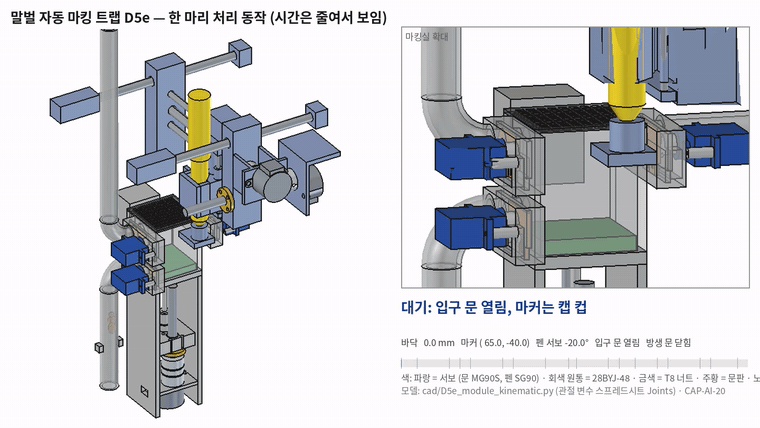
cad/D5e_동작_한마리처리.gif
