britams/-capstone-project-repo/cad/D5f_문빔_위.png

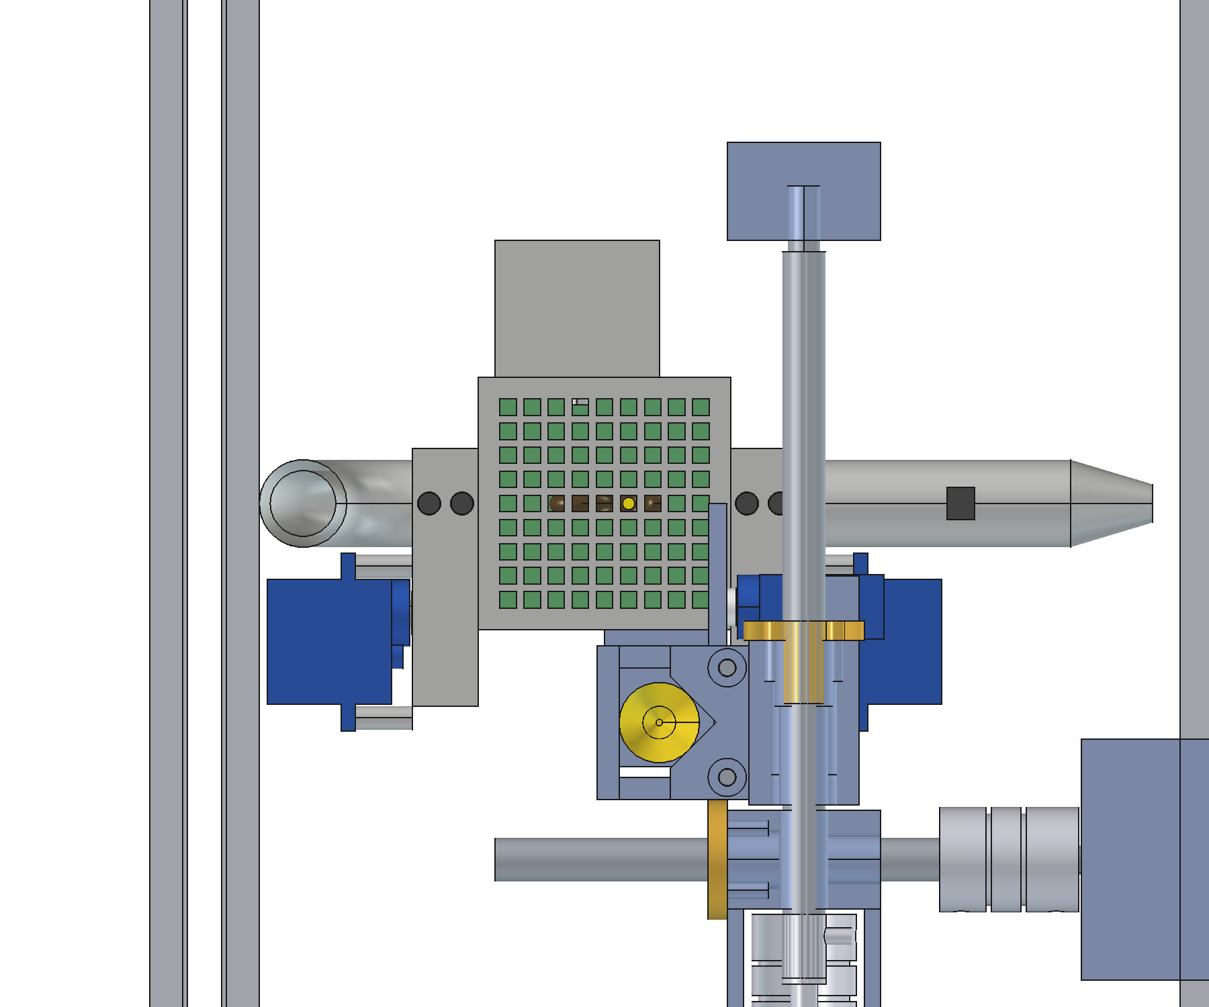
cad/D5f_문빔_위.png
