britams/-capstone-project-repo/cad/D5f_바닥안내_정면.png

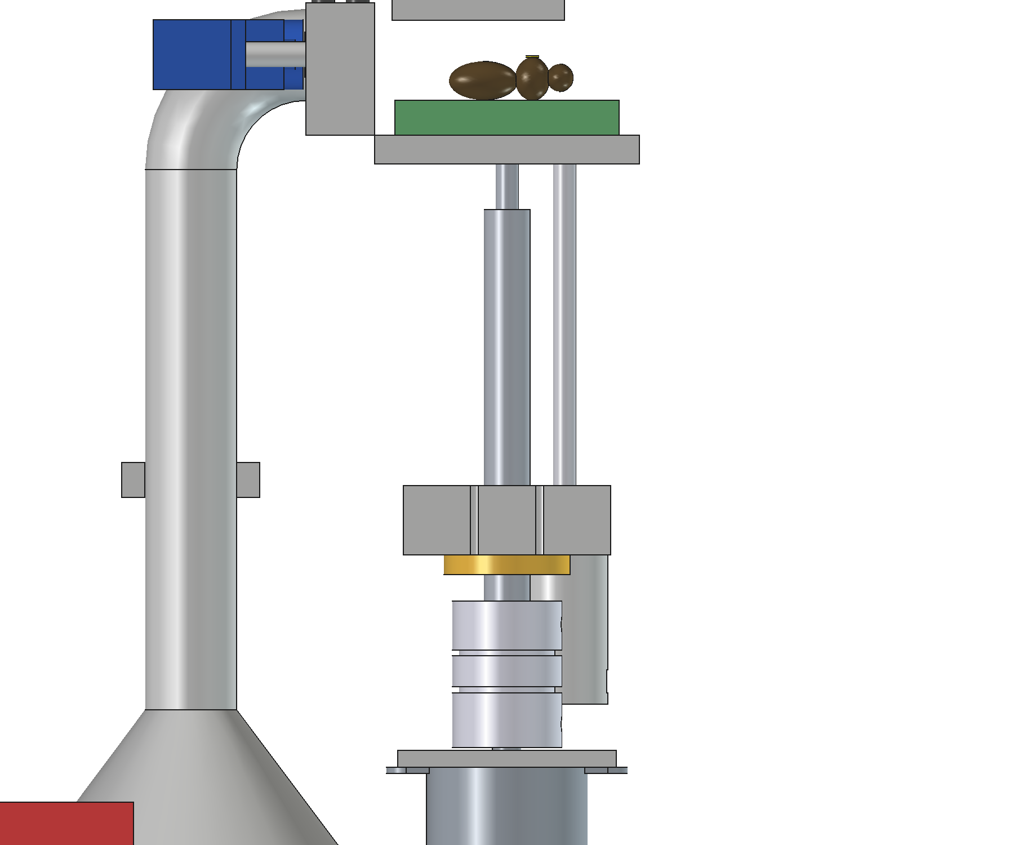
cad/D5f_바닥안내_정면.png
