britams/-capstone-project-repo/cad/D5f_전기배치_등각.png

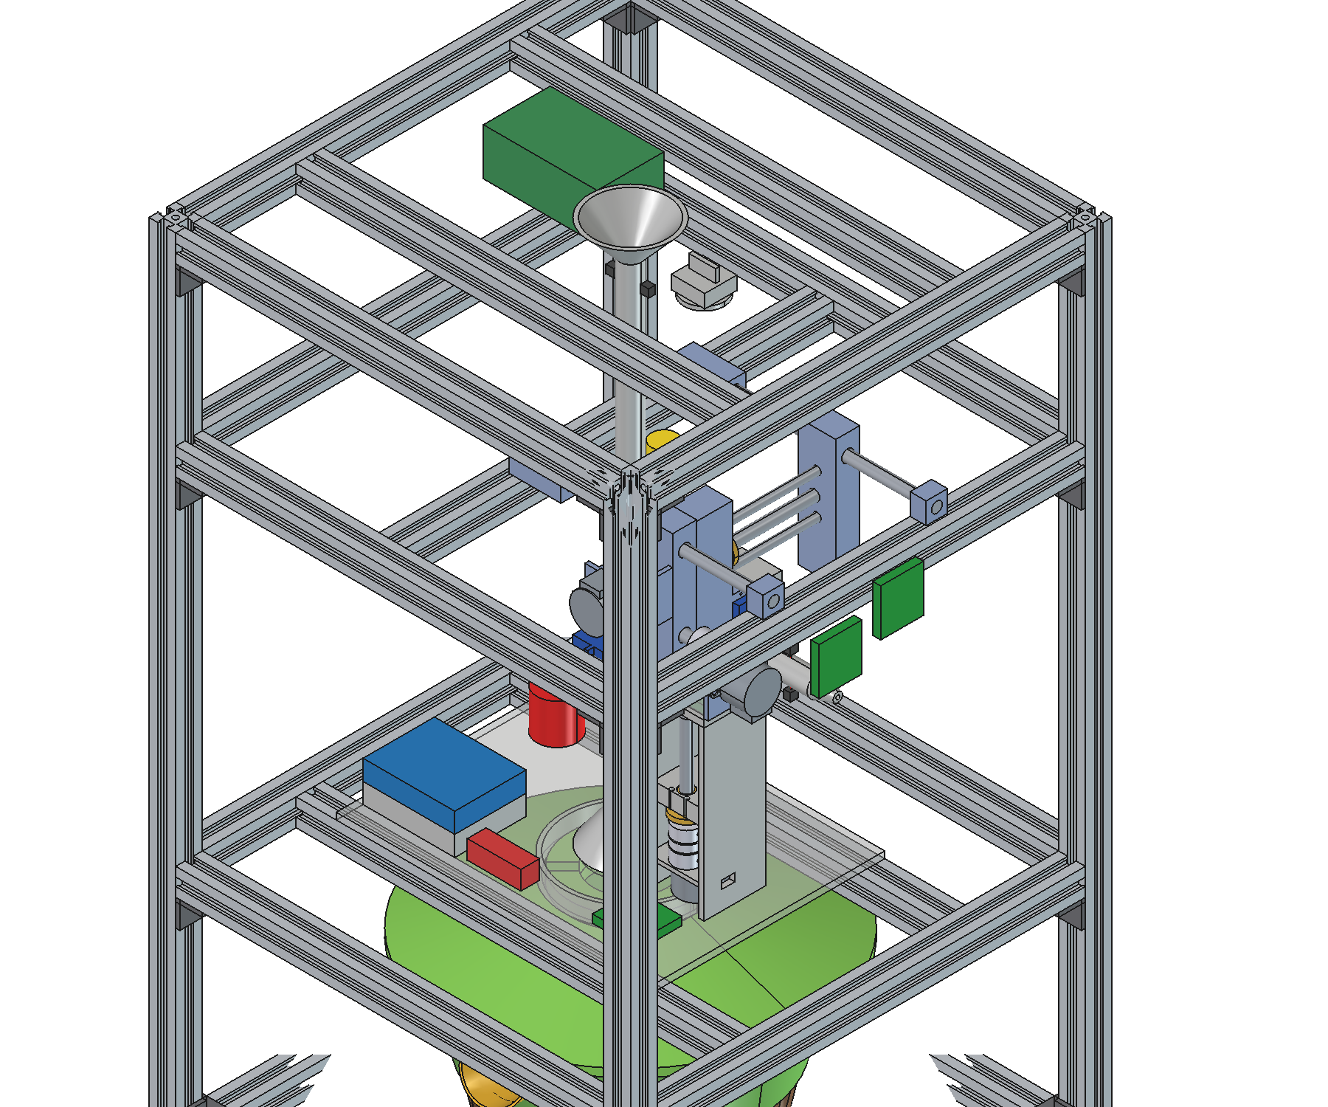
cad/D5f_전기배치_등각.png
