britams/-capstone-project-repo/cad/D5f_전기배치_정면.png

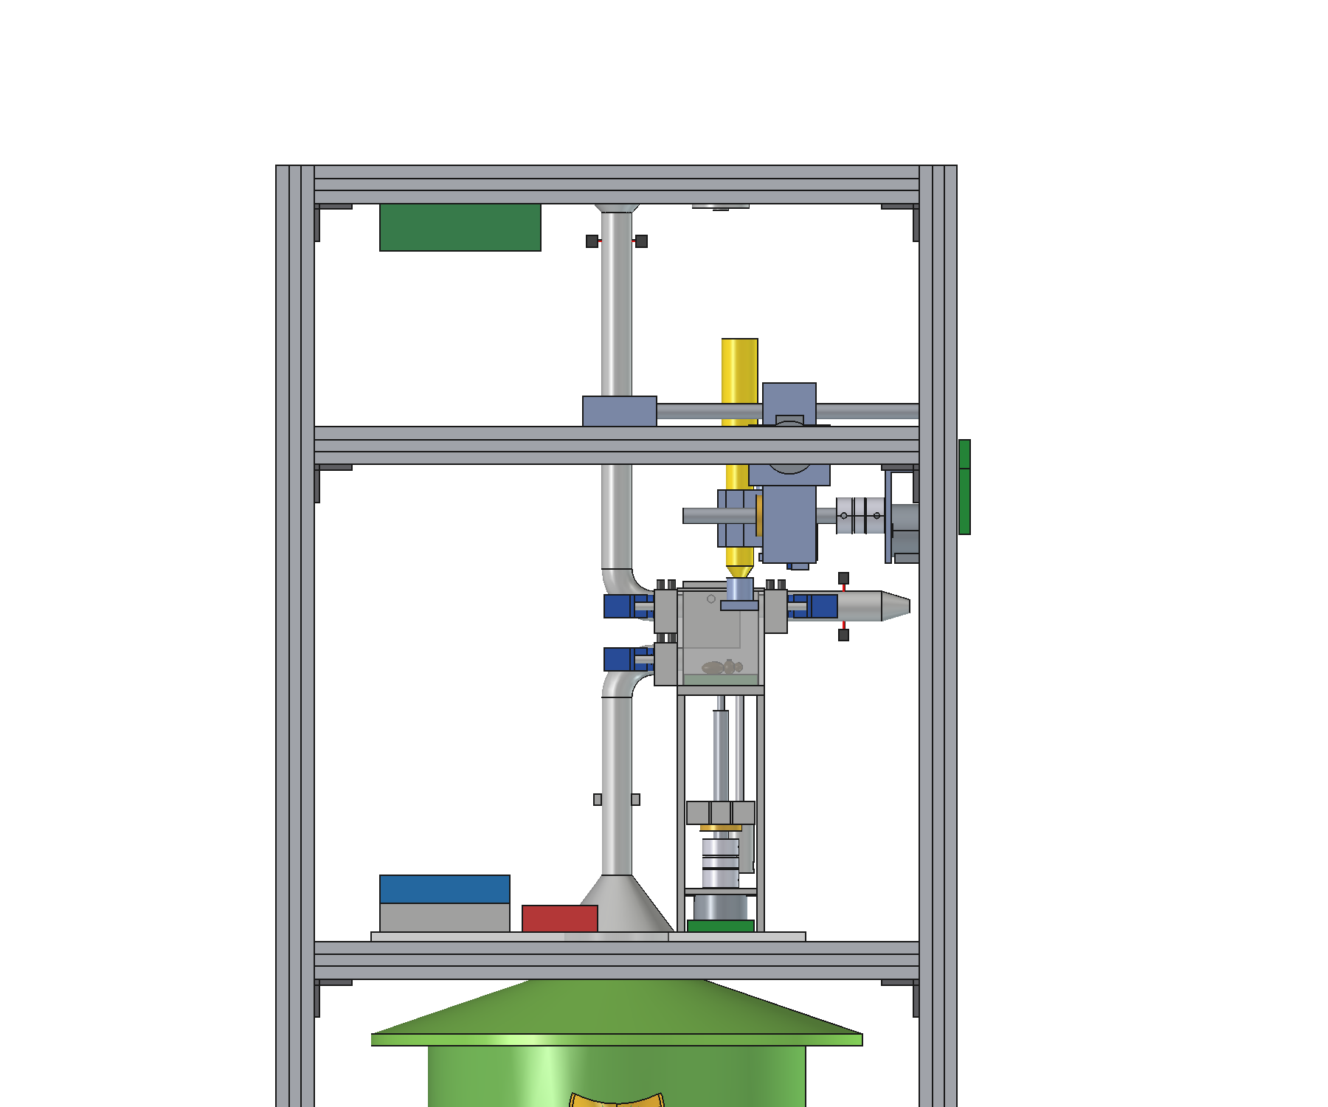
cad/D5f_전기배치_정면.png
