britams/-capstone-project-repo/cad/img/D5g_SJ53_1_bracket.png

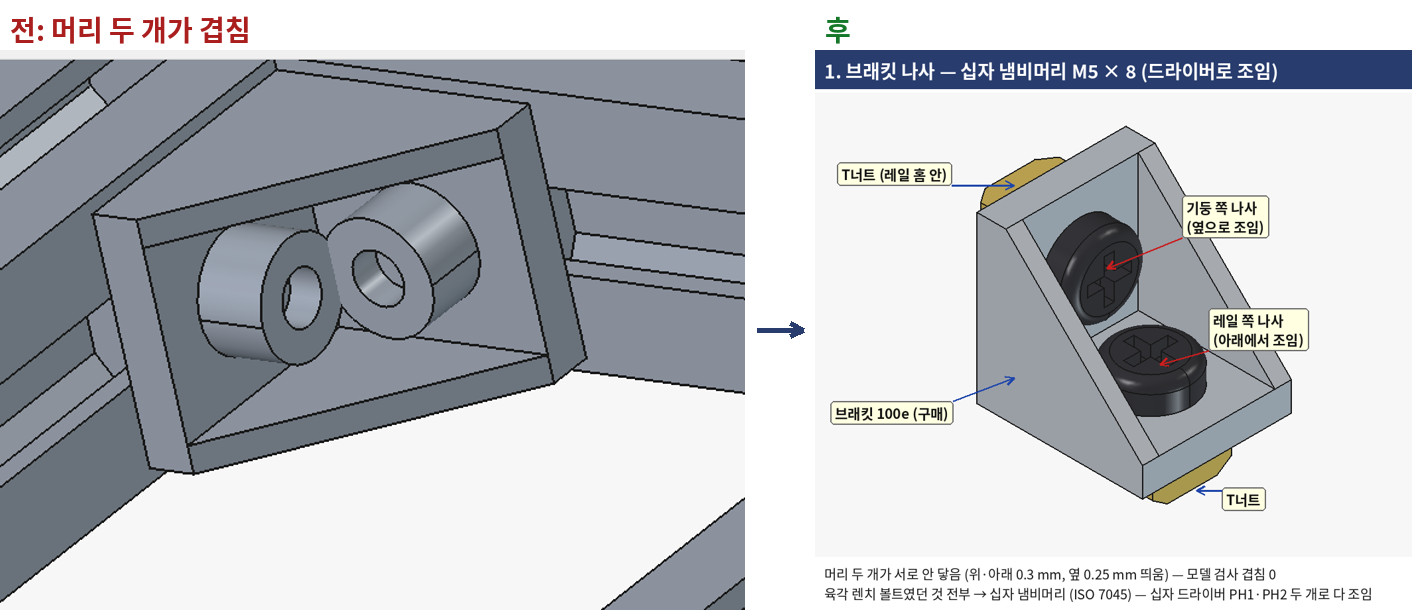
cad/img/D5g_SJ53_1_bracket.png
