britams/-capstone-project-repo/cad/img/D5g_SJ53_2_circuit.png

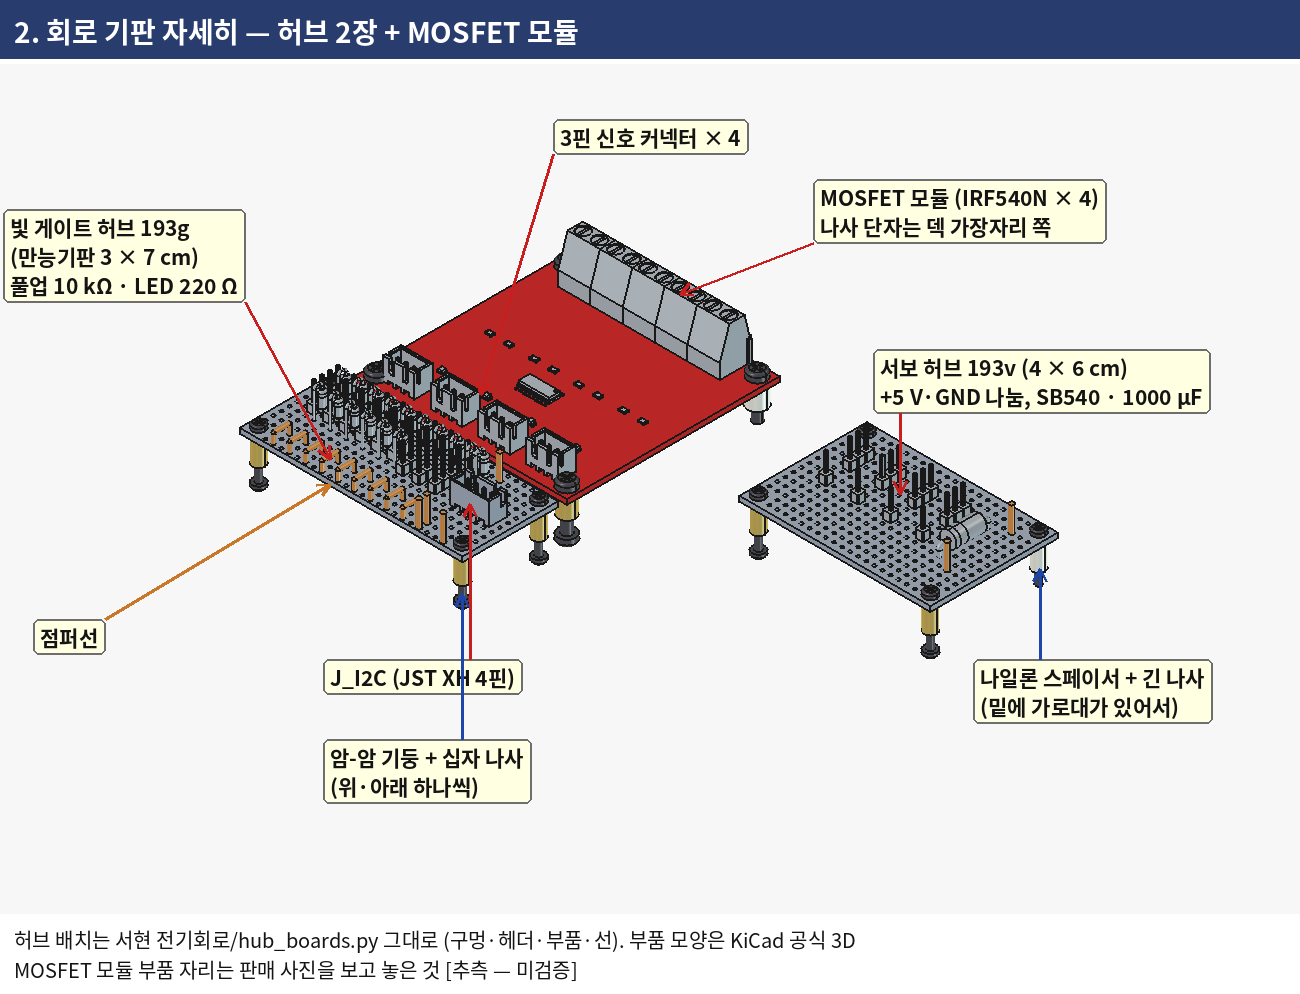
cad/img/D5g_SJ53_2_circuit.png
