britams/-capstone-project-repo/cad/img/D5g_SJ53_5_estop.png

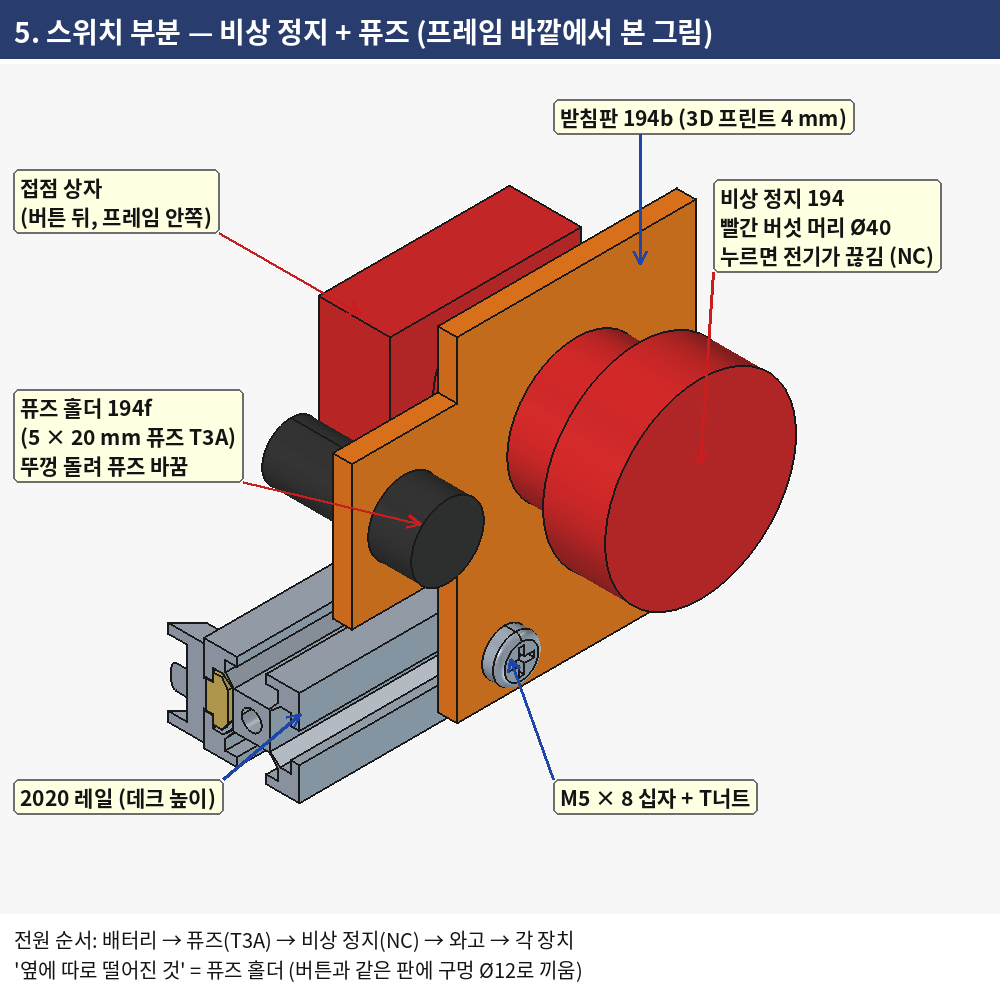
cad/img/D5g_SJ53_5_estop.png
