britams/-capstone-project-repo/cad/img/D5g_SJ53_6_floor_lift.png

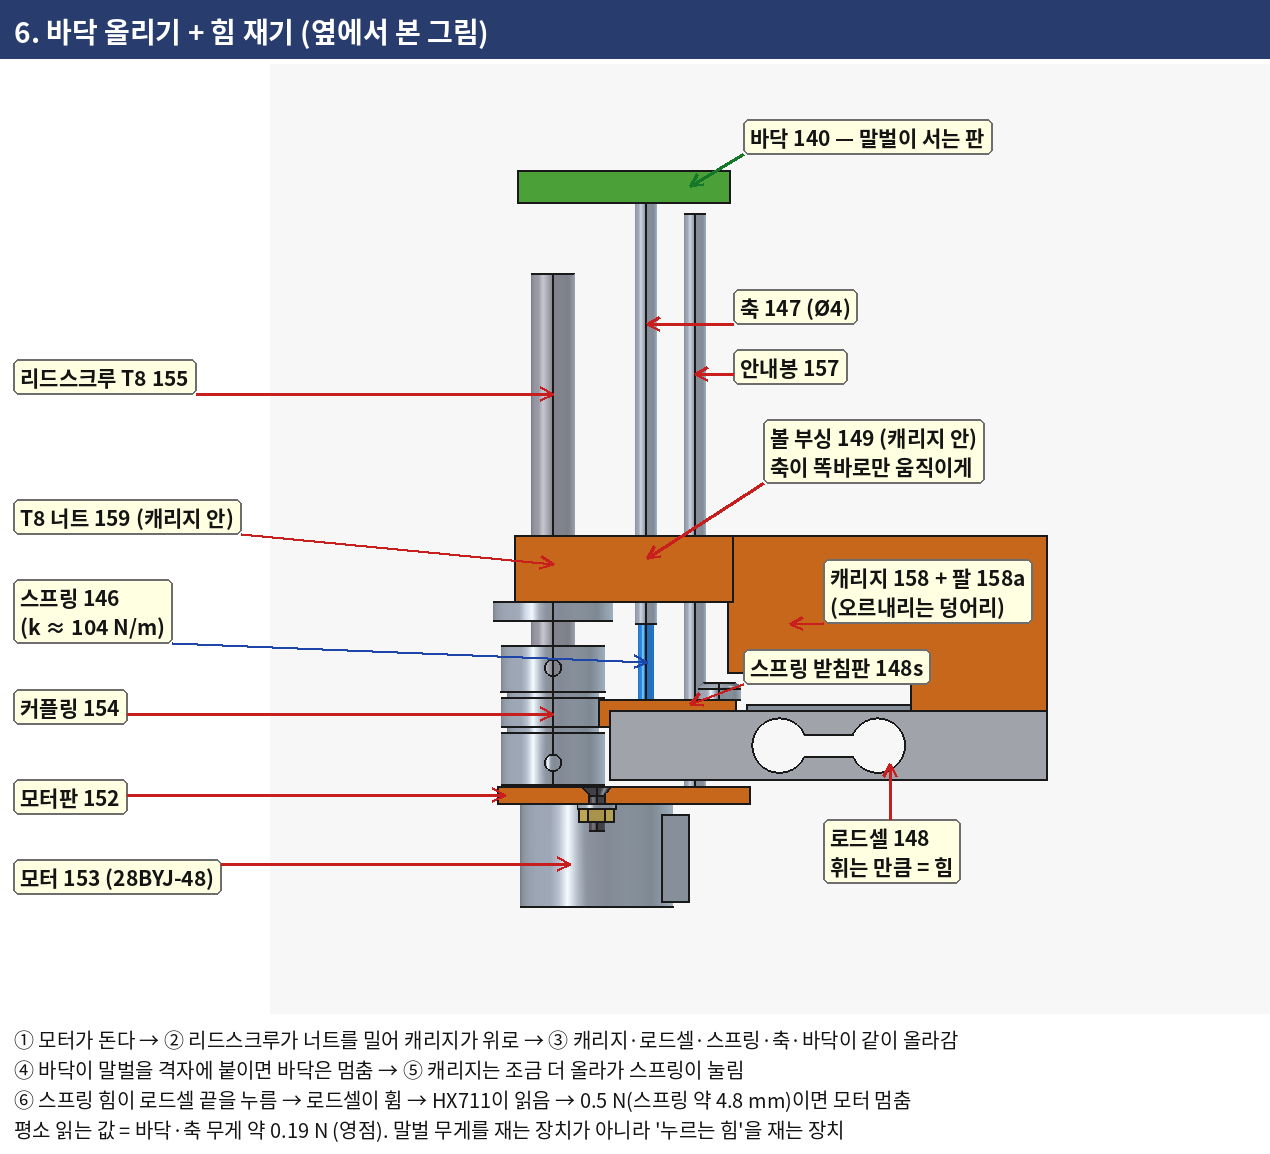
cad/img/D5g_SJ53_6_floor_lift.png
