britams/-capstone-project-repo/cad/img/D5g_SJ53_7_gate_servo.png

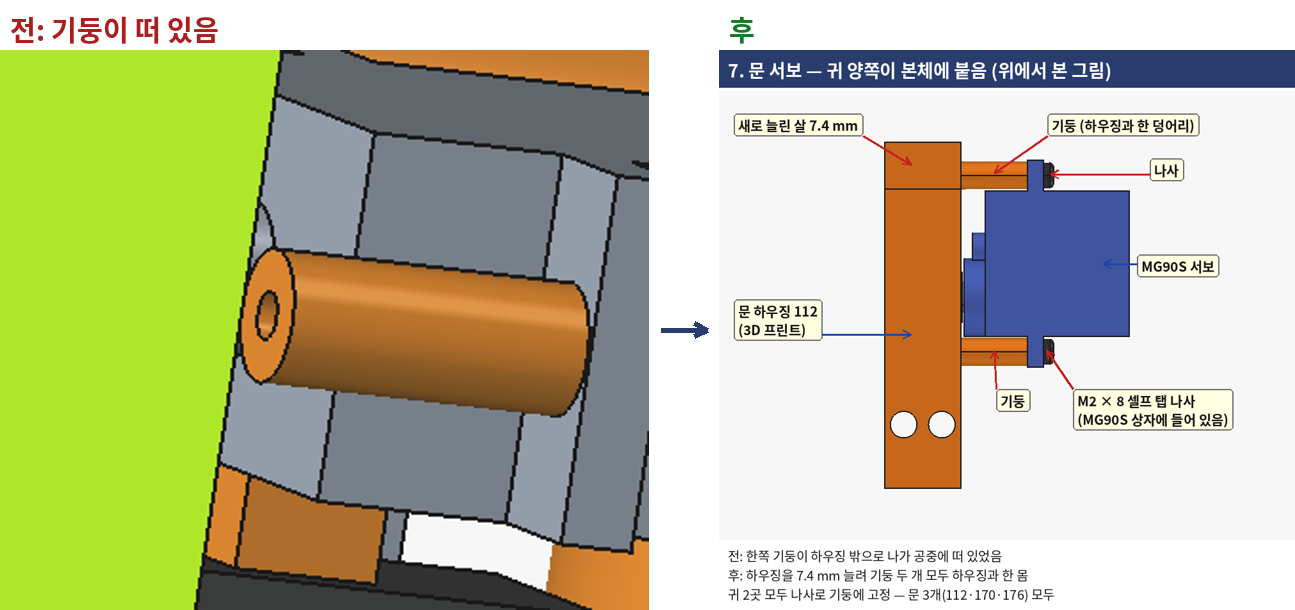
cad/img/D5g_SJ53_7_gate_servo.png
