britams/-capstone-project-repo/cad/img/D5g_SJ53_7b_stepper_ears.png

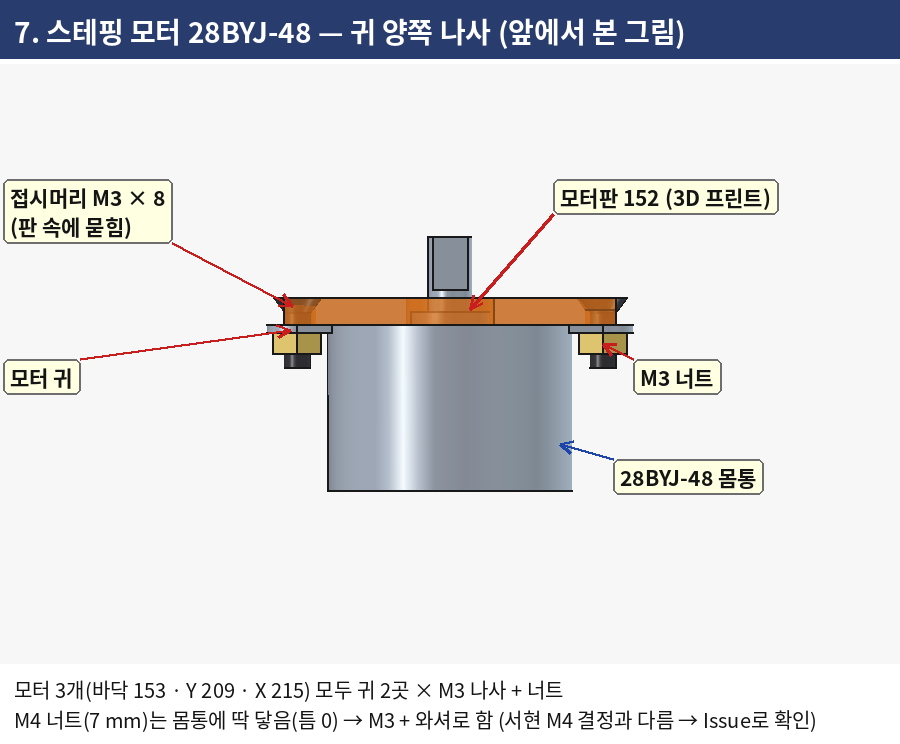
cad/img/D5g_SJ53_7b_stepper_ears.png
