britams/-capstone-project-repo/cad/img/D5g_SJ53_camera.png

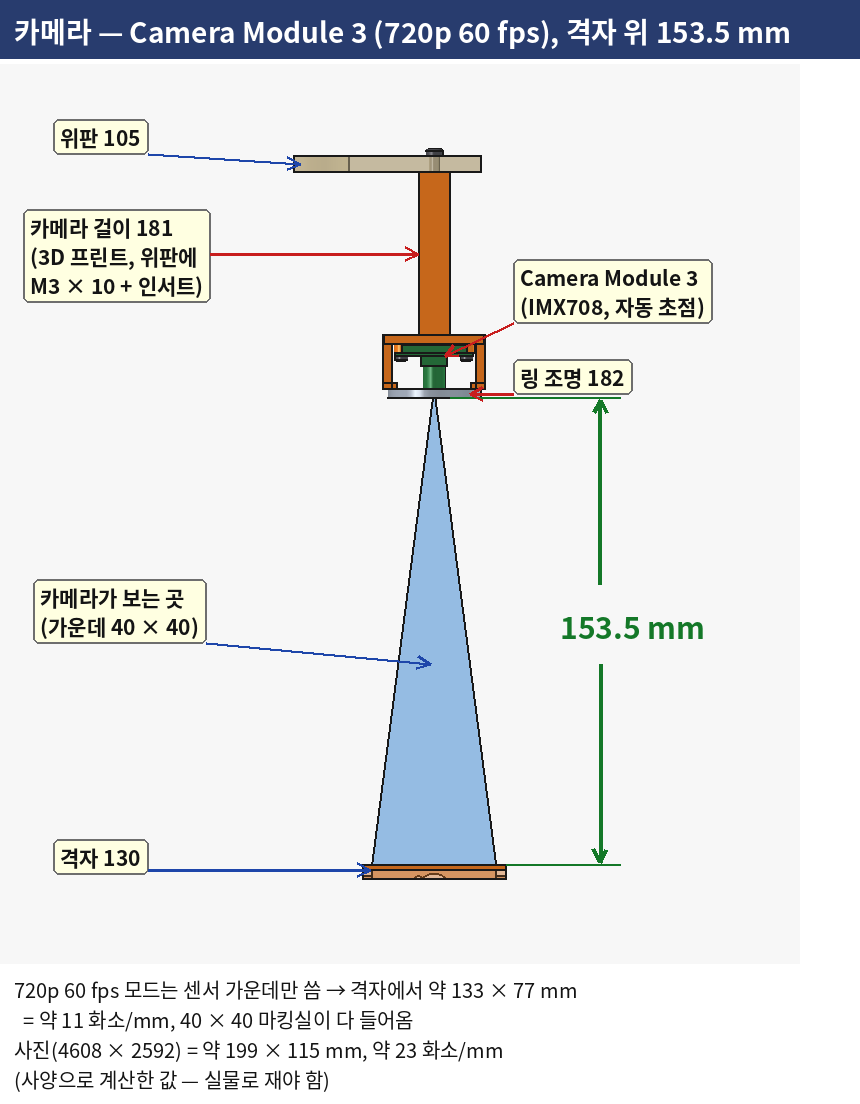
cad/img/D5g_SJ53_camera.png
