britams/-capstone-project-repo/cad/img/D5g_SJ53_colors.png

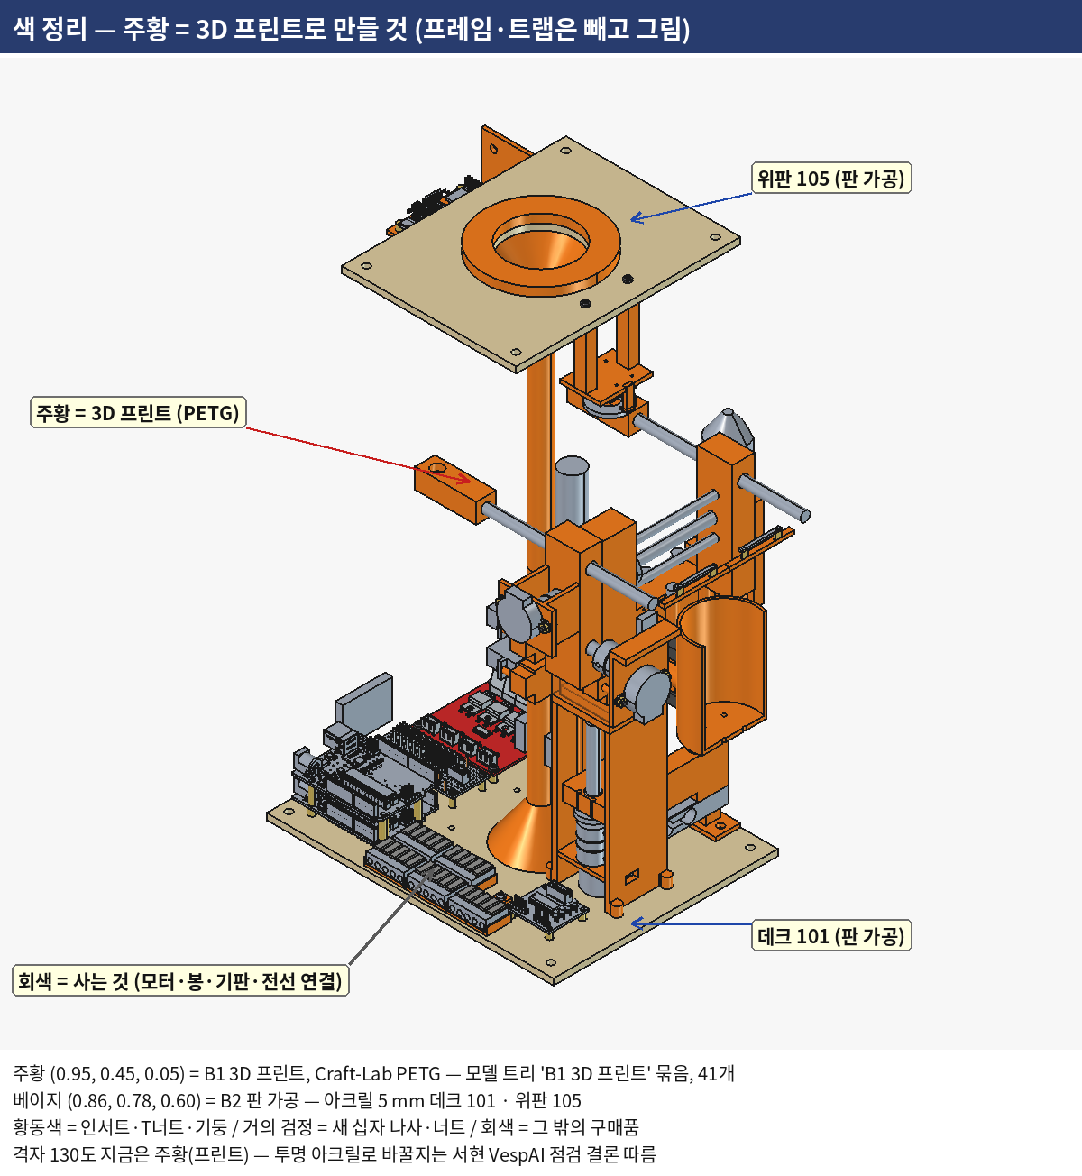
cad/img/D5g_SJ53_colors.png
