britams/-capstone-project-repo/cad/img/D5g_급이방_단면_x55.png

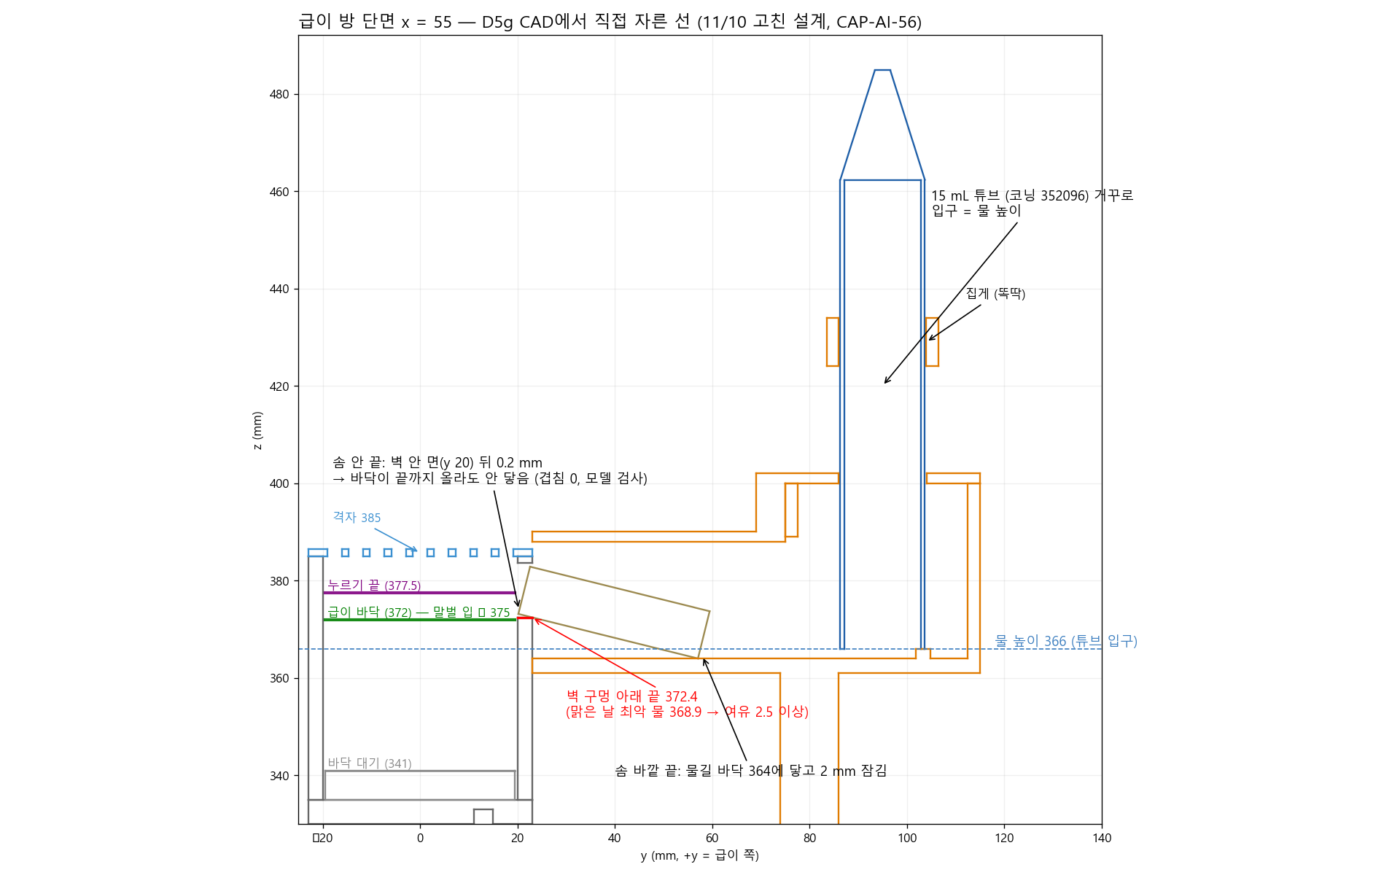
cad/img/D5g_급이방_단면_x55.png
