britams/-capstone-project-repo/cad/img/D5g_급이방_분해.png

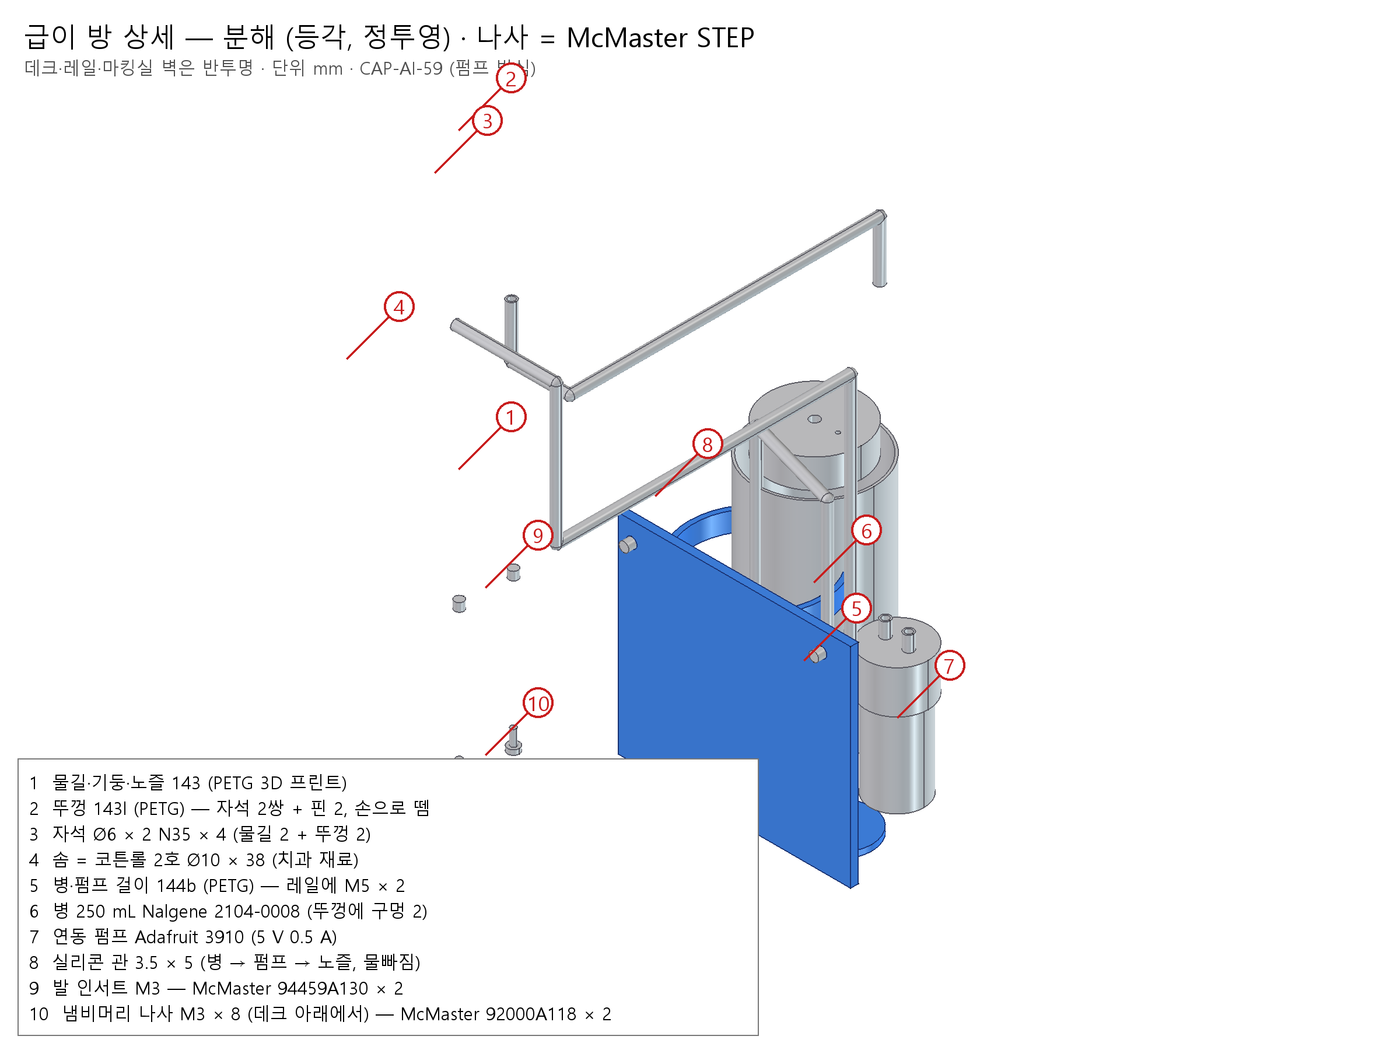
cad/img/D5g_급이방_분해.png
