britams/-capstone-project-repo/cad/img/D5g_도1_전체_등각.png

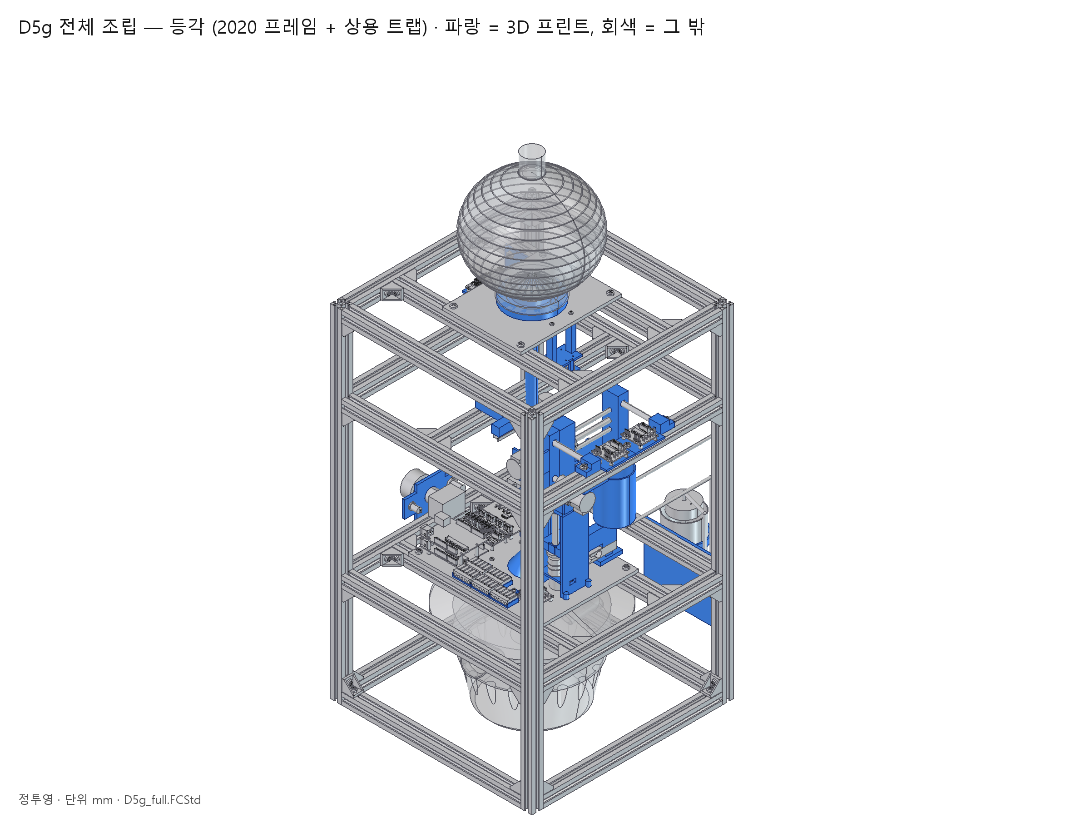
cad/img/D5g_도1_전체_등각.png
