britams/-capstone-project-repo/cad/img/D5g_도3_측면.png

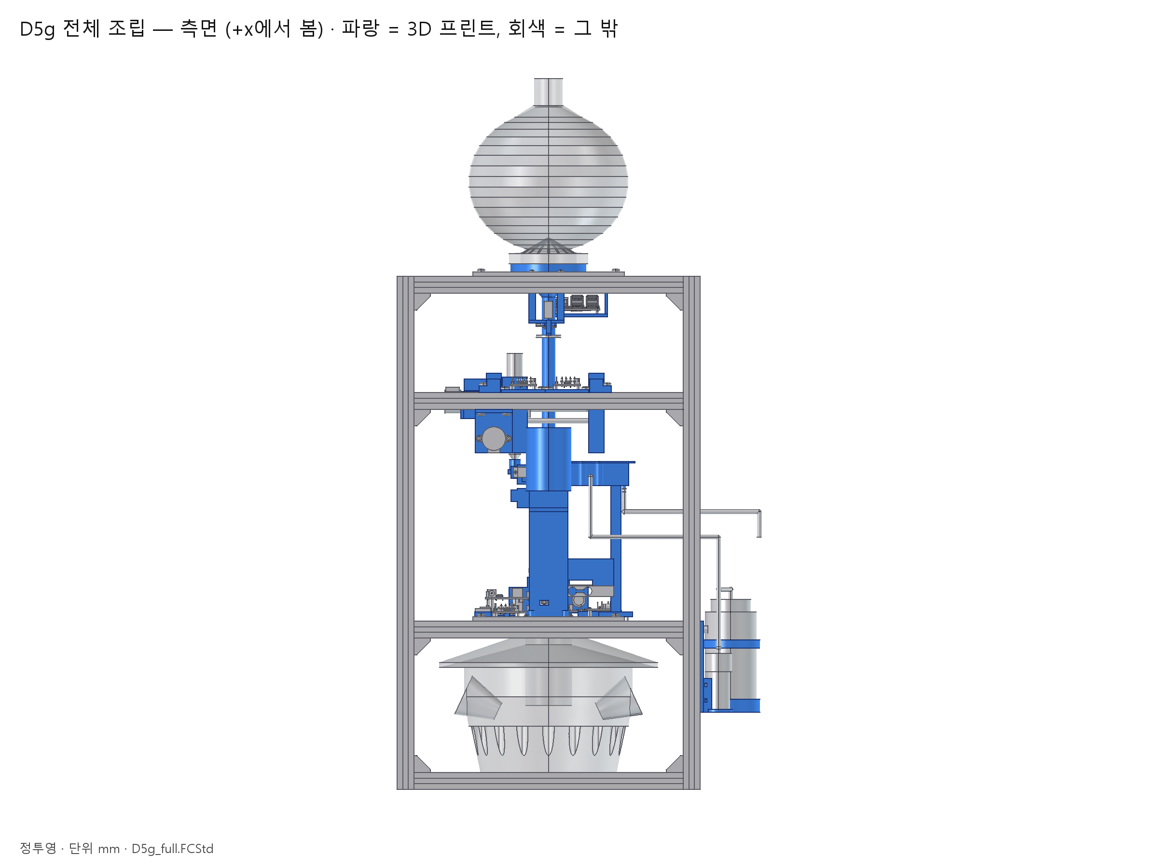
cad/img/D5g_도3_측면.png
