britams/-capstone-project-repo/cad/img/D5g_도4_위.png

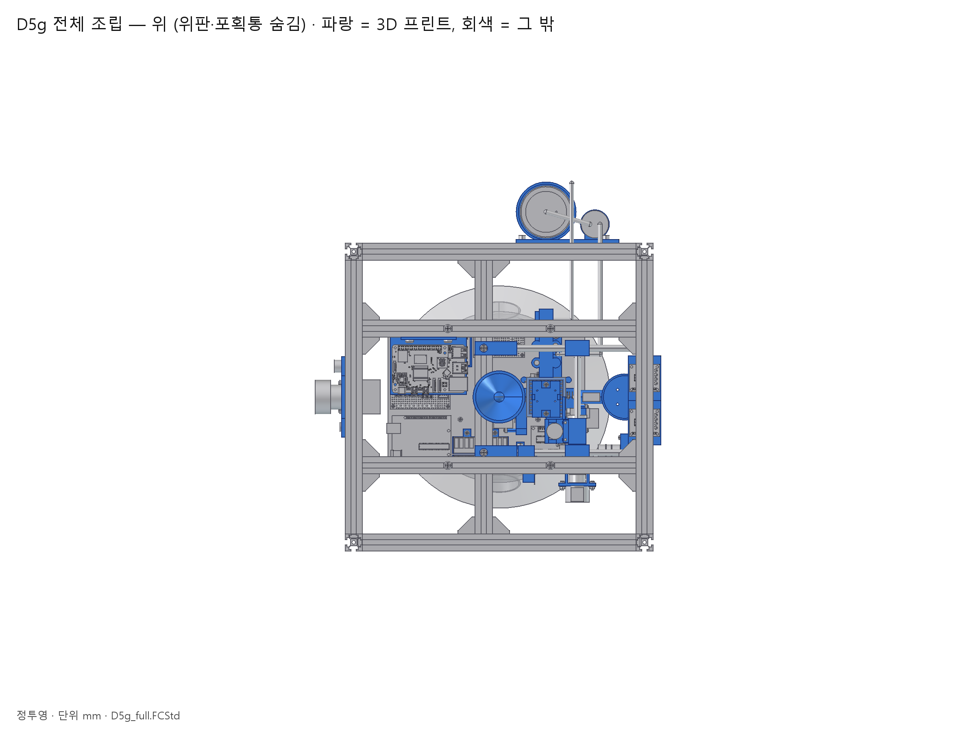
cad/img/D5g_도4_위.png
