britams/-capstone-project-repo/cad/img/D5g_부품번호_풍선도.png

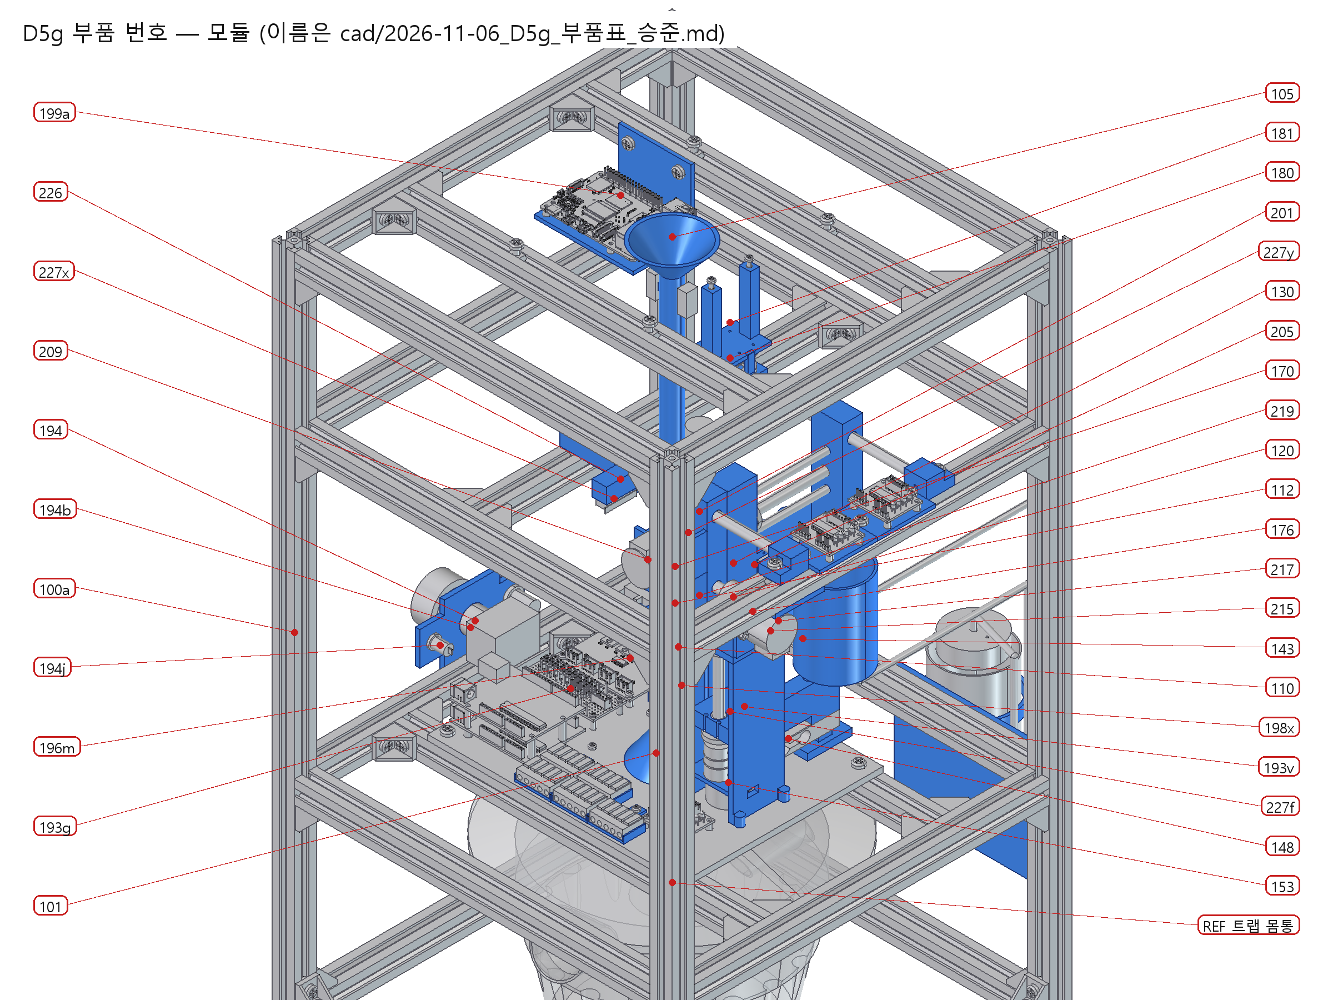
cad/img/D5g_부품번호_풍선도.png
