britams/-capstone-project-repo/cad/img/D5g_전기배치_위.png

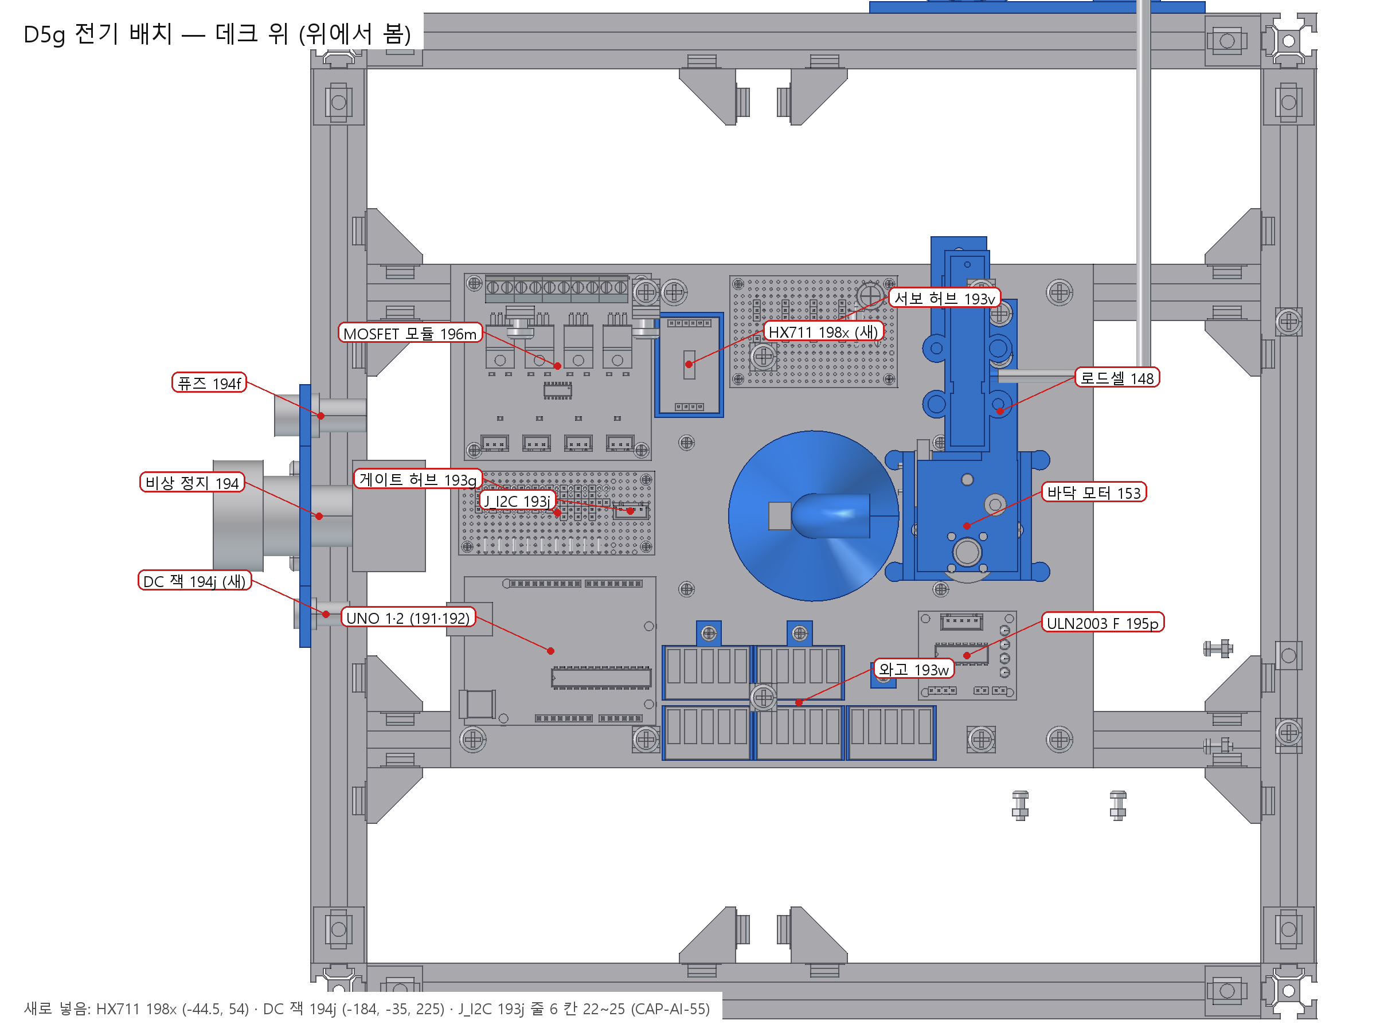
cad/img/D5g_전기배치_위.png
