britams/-capstone-project-repo/cad/원본_렌더/D5c_B_모듈_등각.png

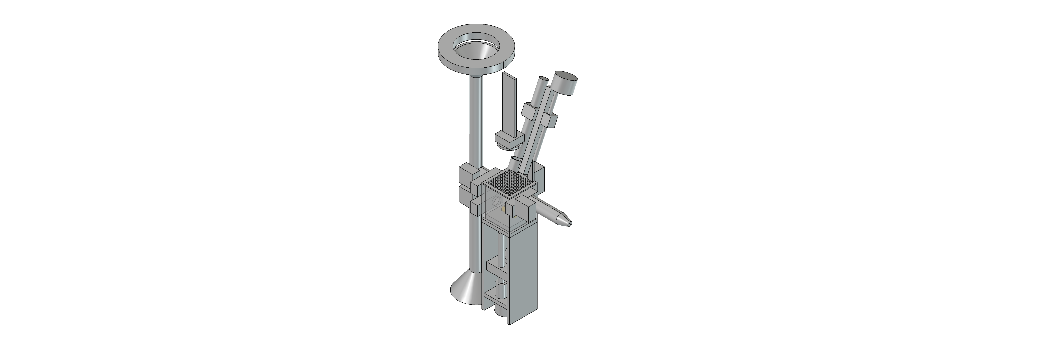
cad/원본_렌더/D5c_B_모듈_등각.png
