britams/-capstone-project-repo/cad/원본_렌더/D5d_D_위_대기.png

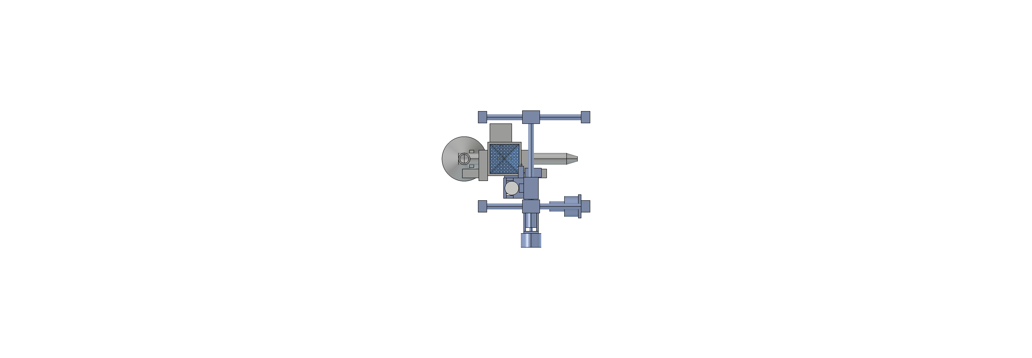
cad/원본_렌더/D5d_D_위_대기.png
