britams/-capstone-project-repo/design/img/2026-11-02_캘리퍼스_측정위치_1_트랩결합부_승준.png

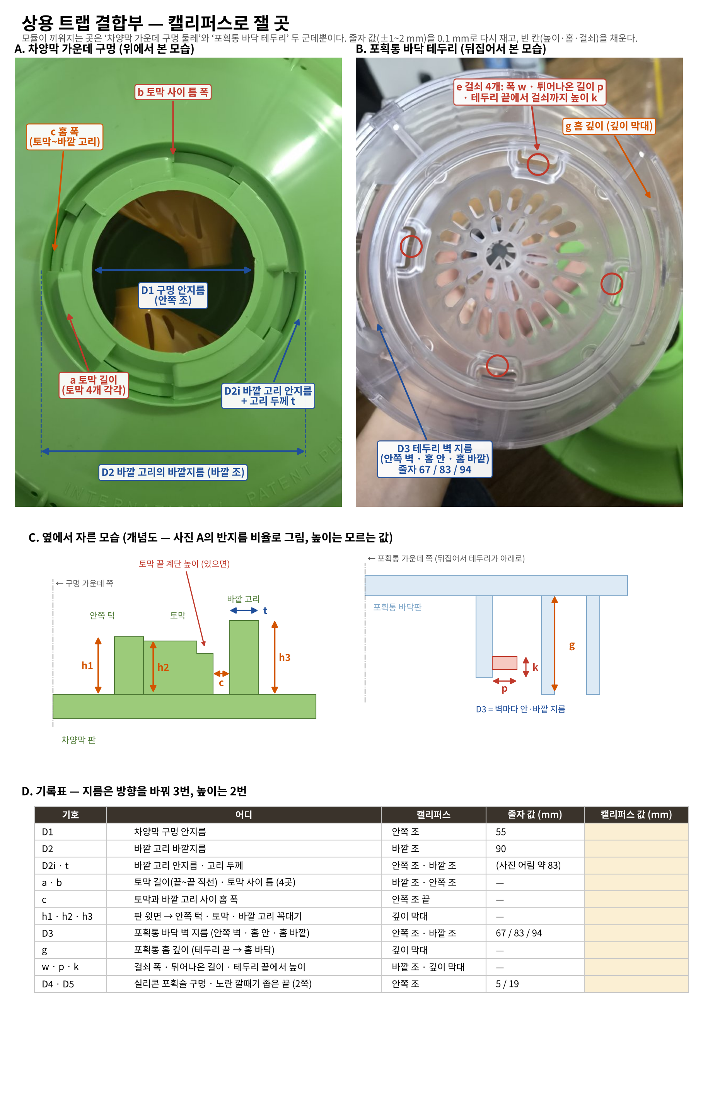
design/img/2026-11-02_캘리퍼스_측정위치_1_트랩결합부_승준.png
