britams/-capstone-project-repo/design/img/2026-11-03_D3_설명_승준.png

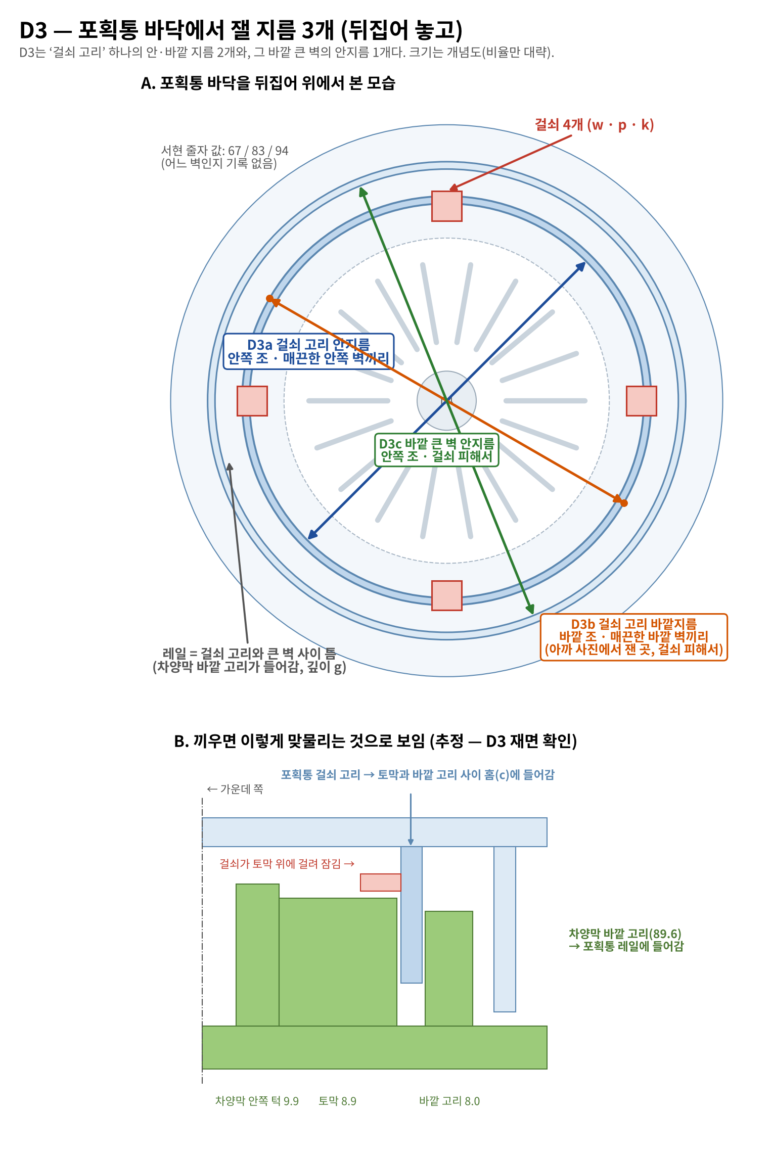
design/img/2026-11-03_D3_설명_승준.png
