britams/-capstone-project-repo/design/img/2026-11-03_걸쇠_gwpk_설명_승준.png

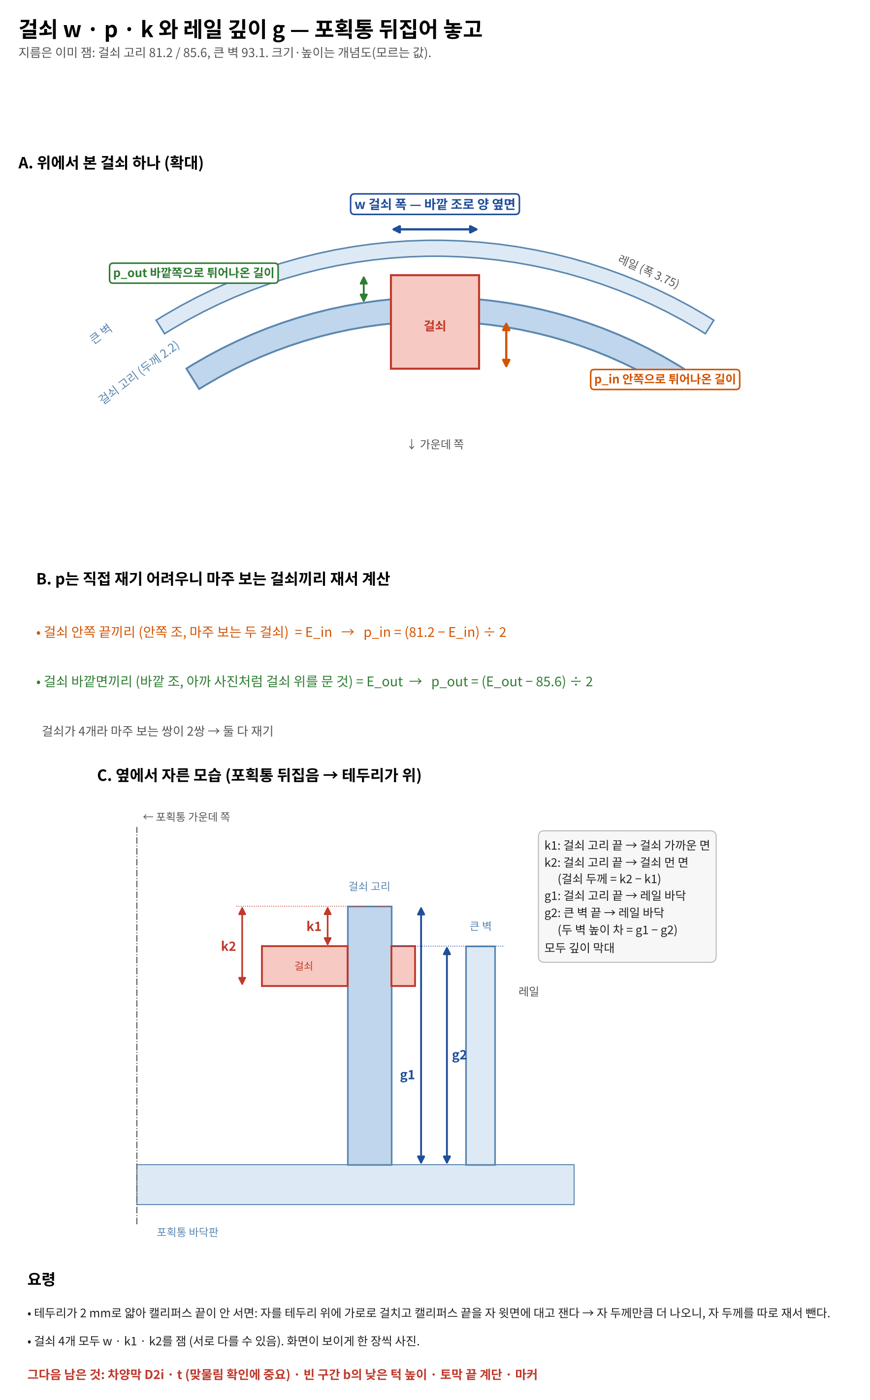
design/img/2026-11-03_걸쇠_gwpk_설명_승준.png
