britams/-capstone-project-repo/design/img/control/제어_메시지순서_S1.png

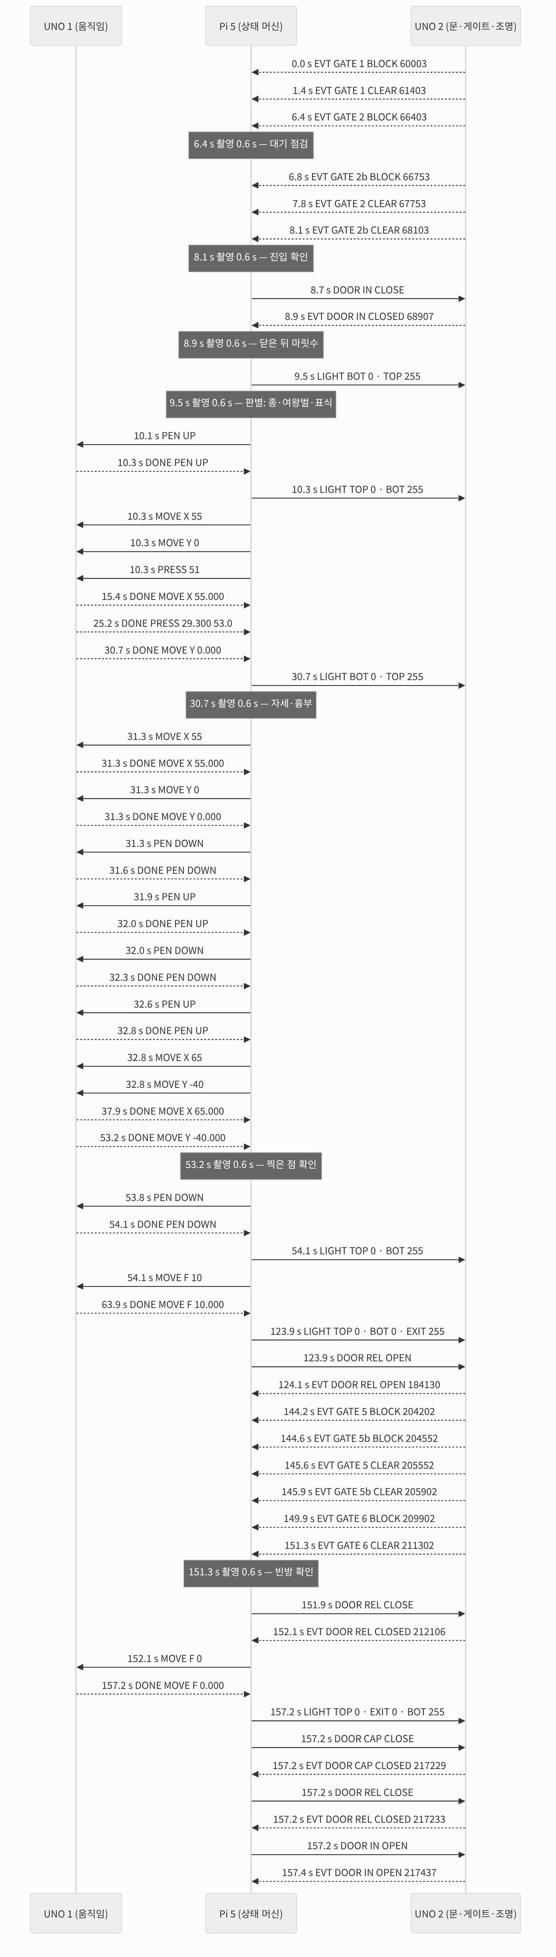
design/img/control/제어_메시지순서_S1.png
