britams/-capstone-project-repo/design/img/fbd/M7_D5e_문_스카치요크.jpg

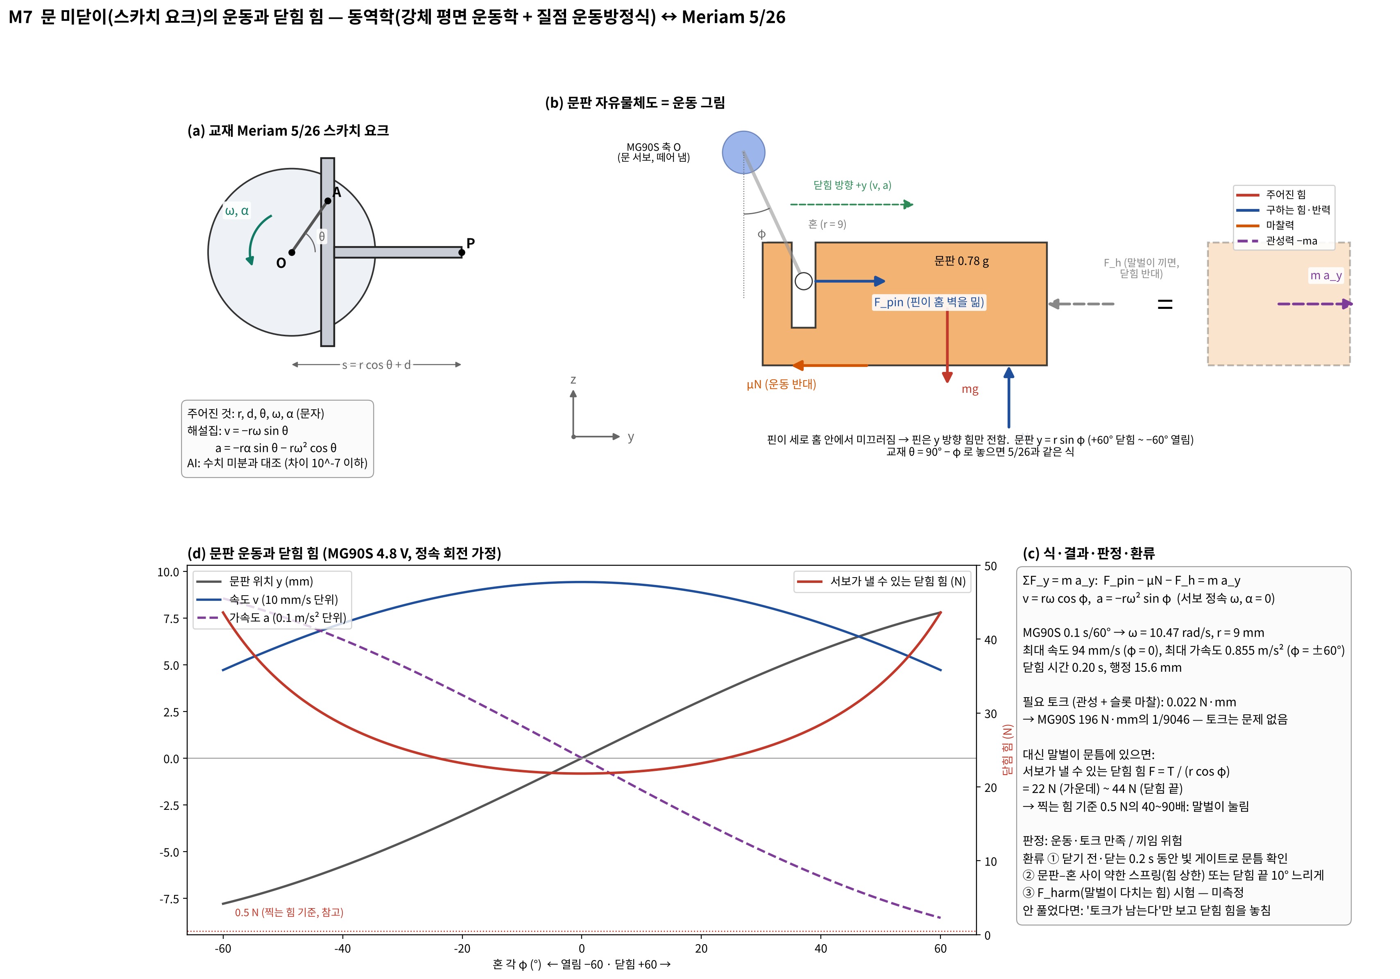
design/img/fbd/M7_D5e_문_스카치요크.jpg
