britams/-capstone-project-repo/design/img/fbd/M8_D5e_펜_내려찍기_충격.jpg

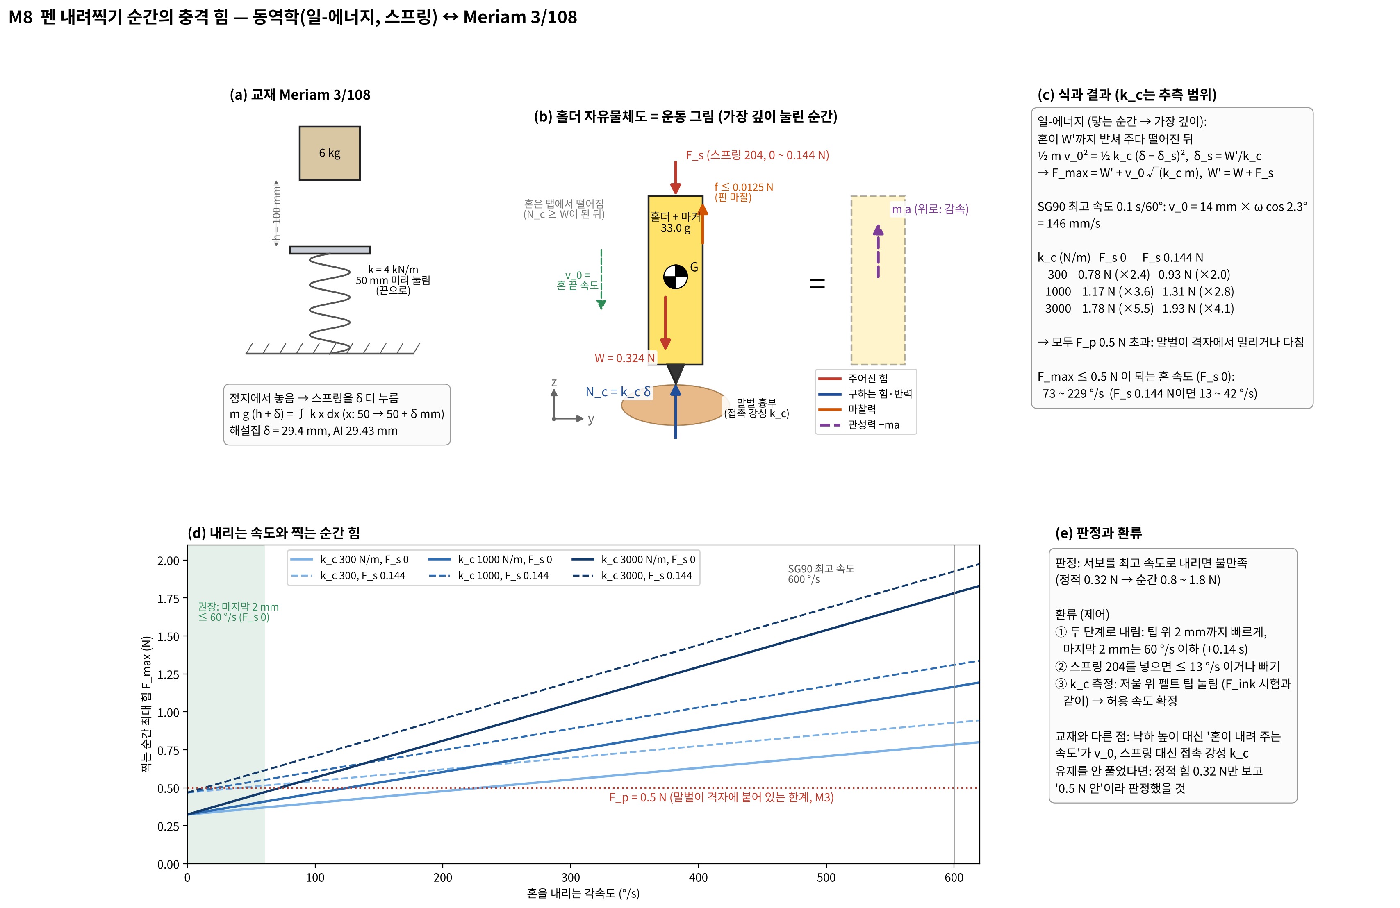
design/img/fbd/M8_D5e_펜_내려찍기_충격.jpg
