britams/-capstone-project-repo/design/img/fbd/M9_D5e_이송시간_사다리꼴.jpg

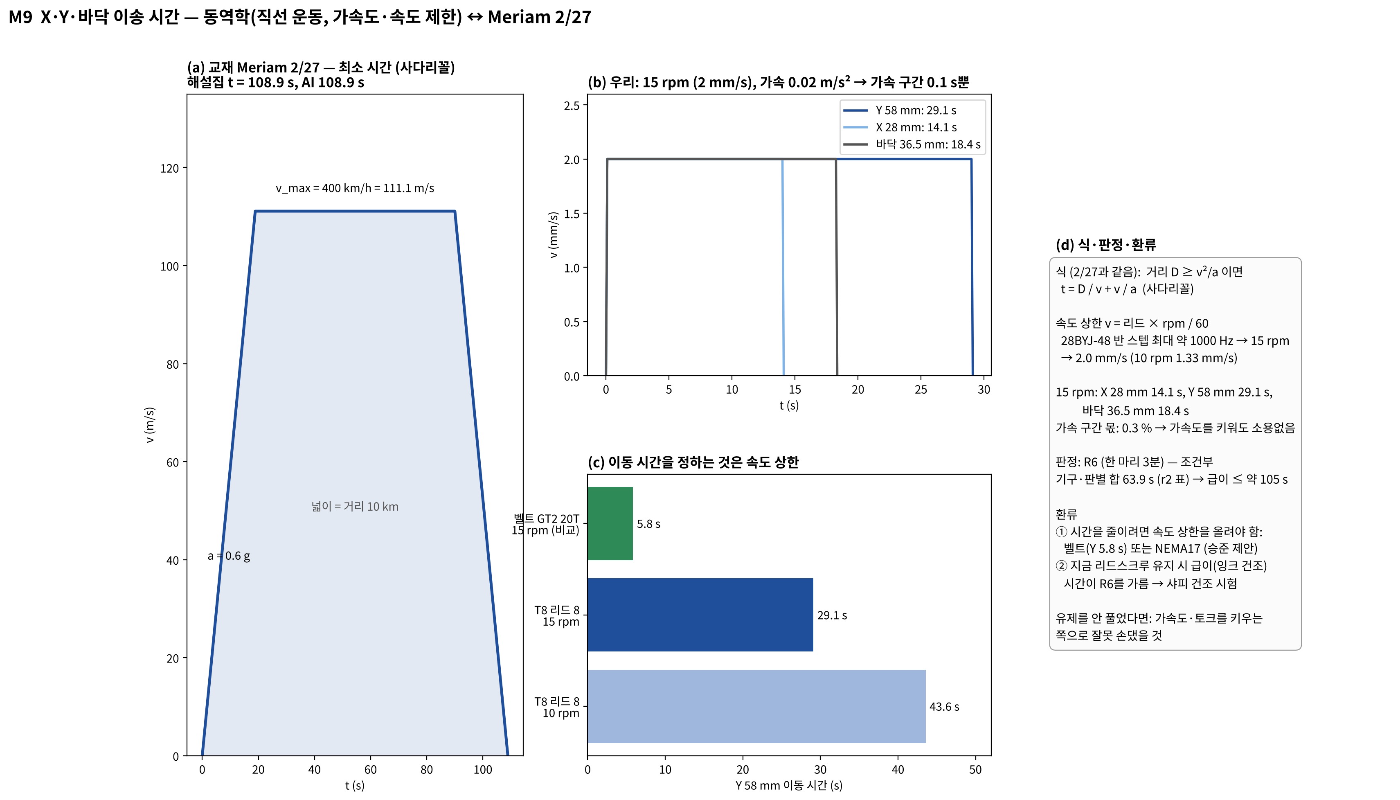
design/img/fbd/M9_D5e_이송시간_사다리꼴.jpg
