britams/-capstone-project-repo/design/img/fbd/M10_D5e_고유진동수_공진.jpg

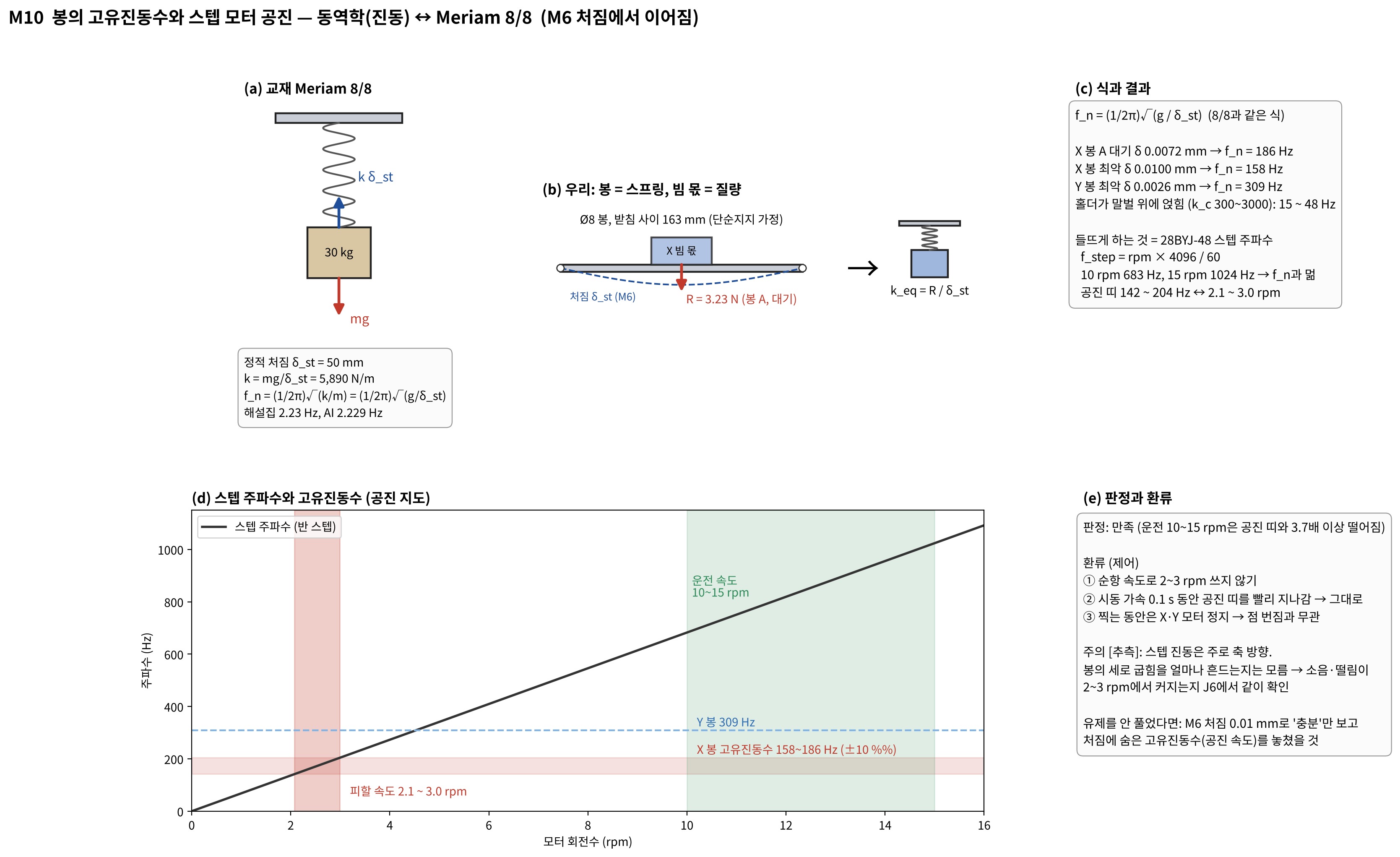
design/img/fbd/M10_D5e_고유진동수_공진.jpg
