britams/-capstone-project-repo/design/img/feeder/급이방_원리.gif

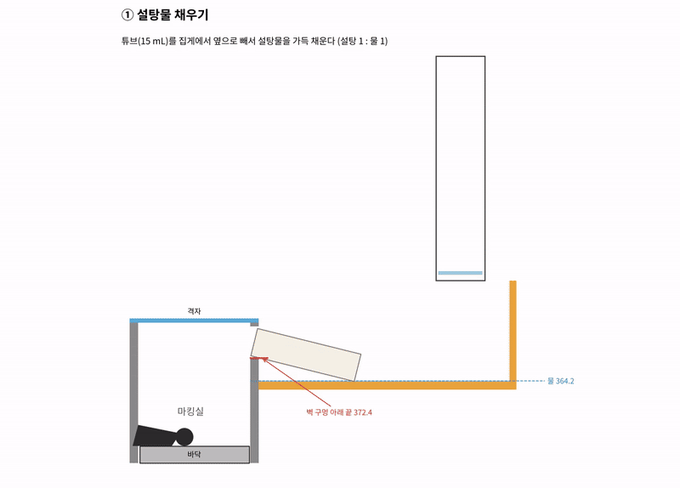
design/img/feeder/급이방_원리.gif
