britams/-capstone-project-repo/design/img/feeder/급이방_원리_6장면.png

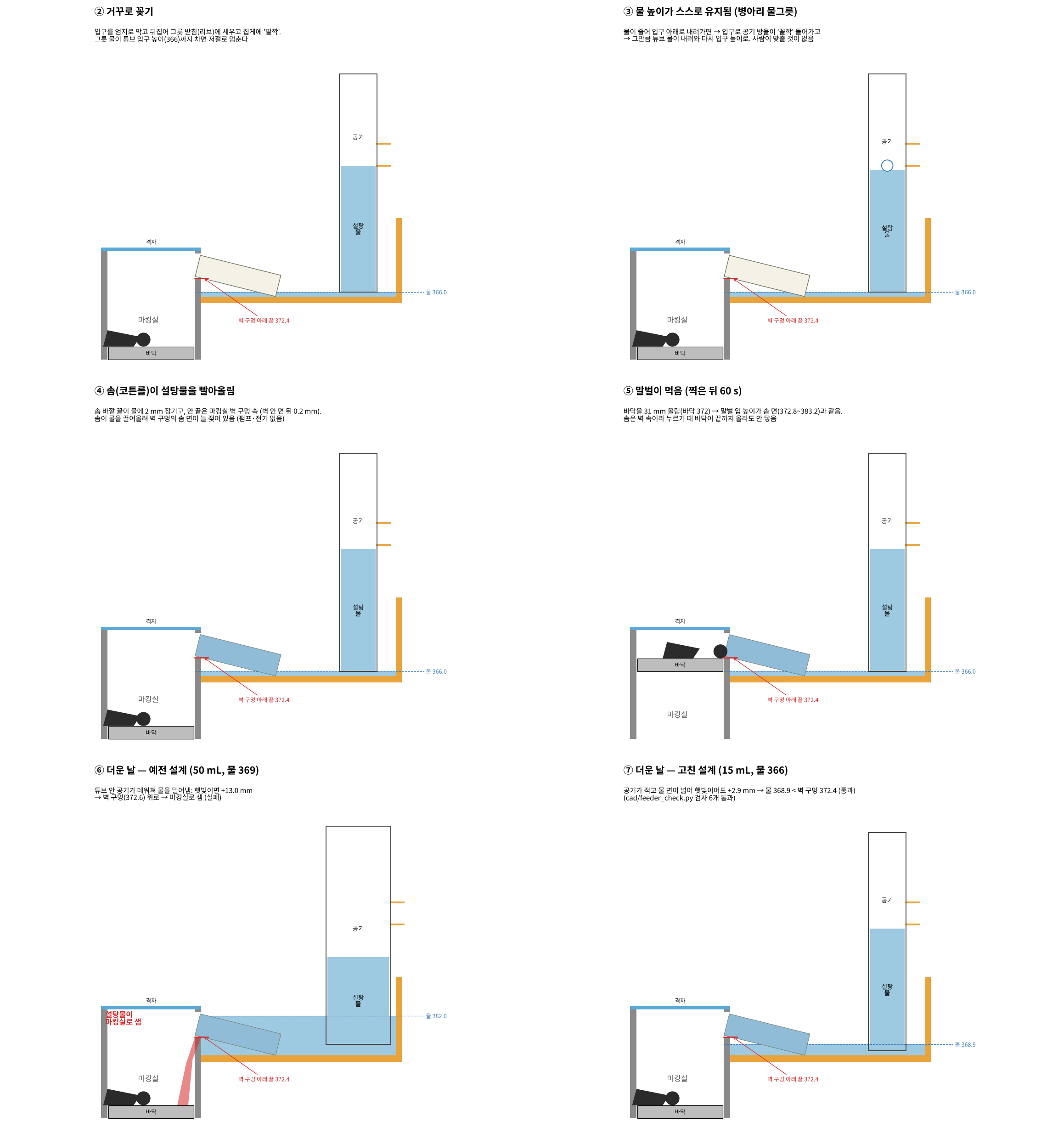
design/img/feeder/급이방_원리_6장면.png
