britams/-capstone-project-repo/design/img/feeder/장면_drink.png

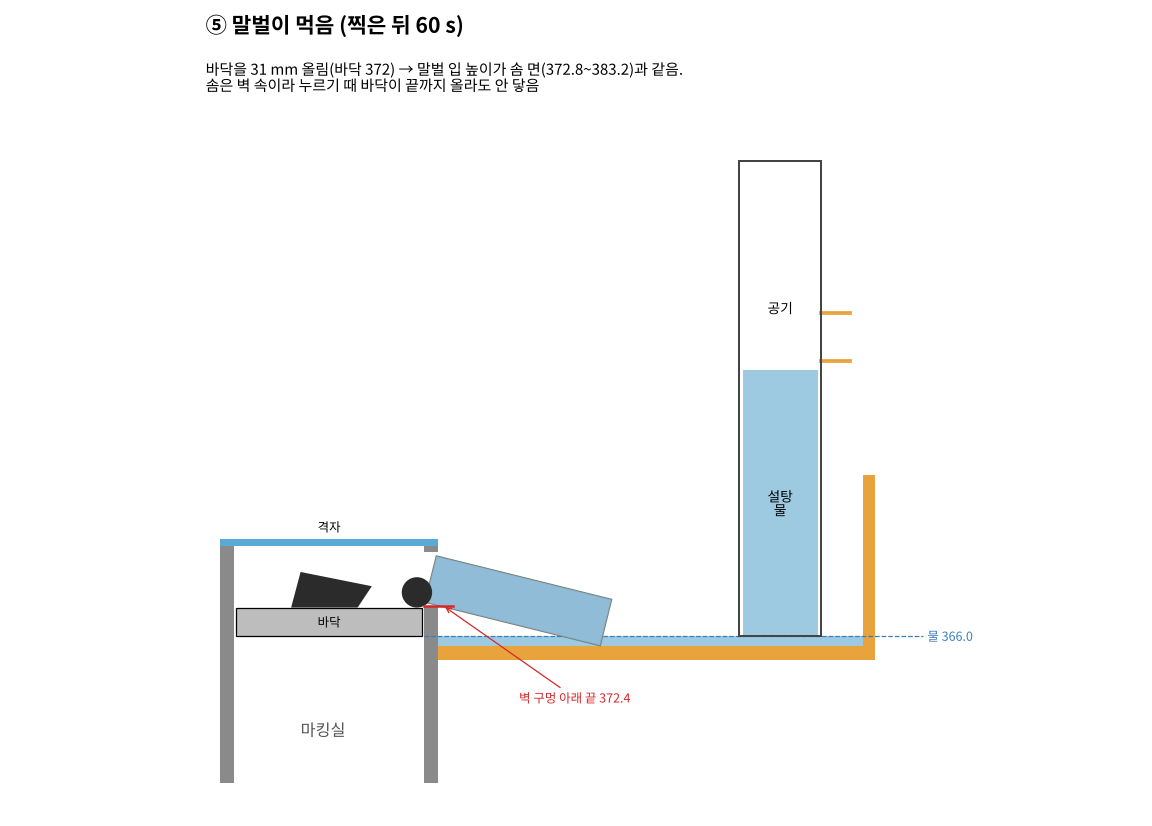
design/img/feeder/장면_drink.png
