britams/-capstone-project-repo/design/img/feeder/장면_hot_new.png

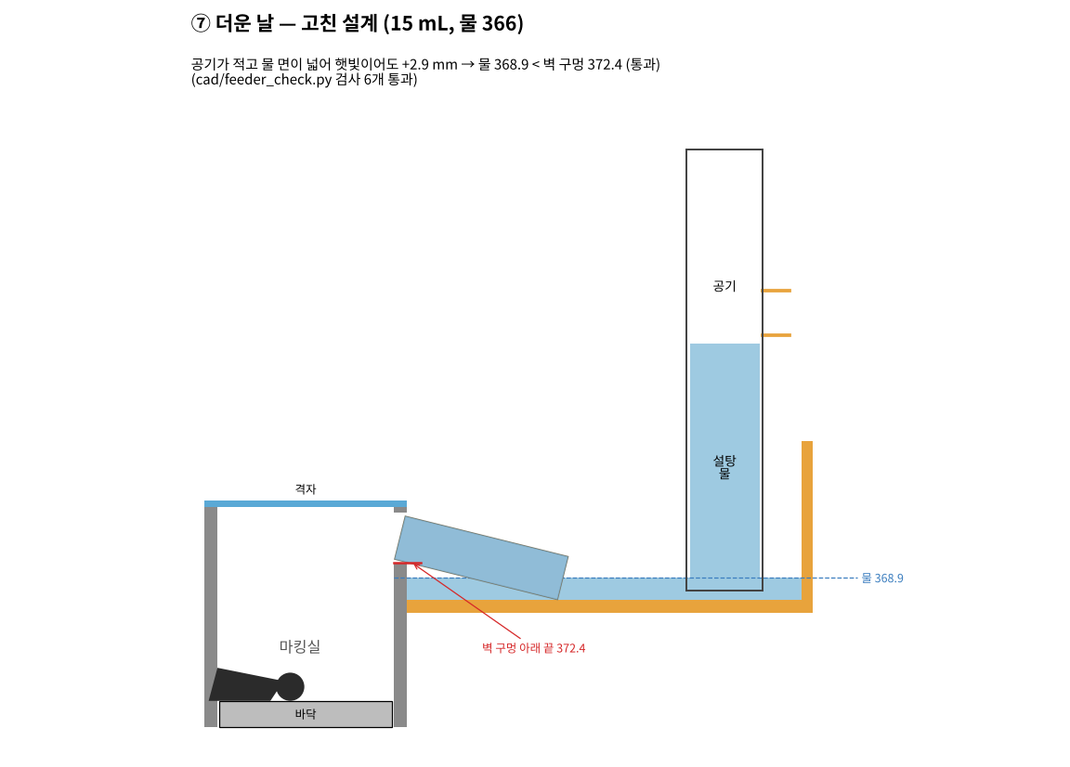
design/img/feeder/장면_hot_new.png
