britams/-capstone-project-repo/design/img/feeder/장면_keep.png

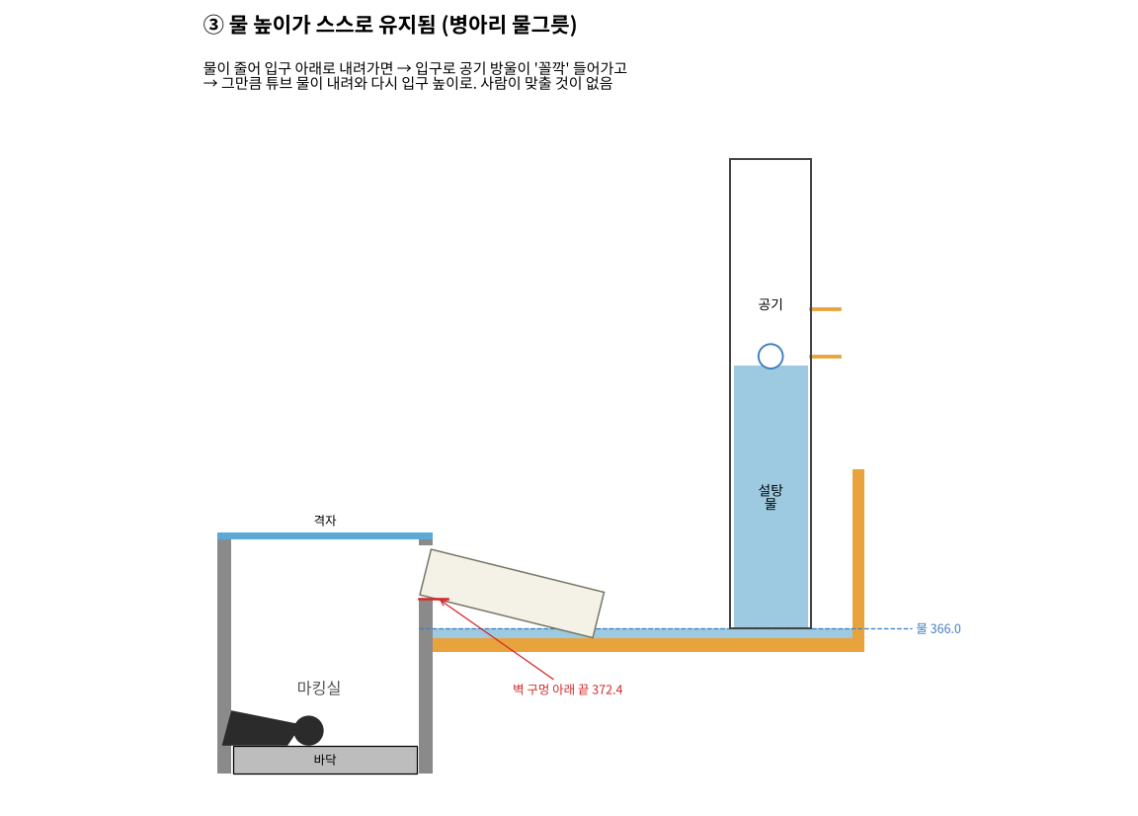
design/img/feeder/장면_keep.png
