britams/-capstone-project-repo/design/img/실측사진/몸통_차양막.jpg

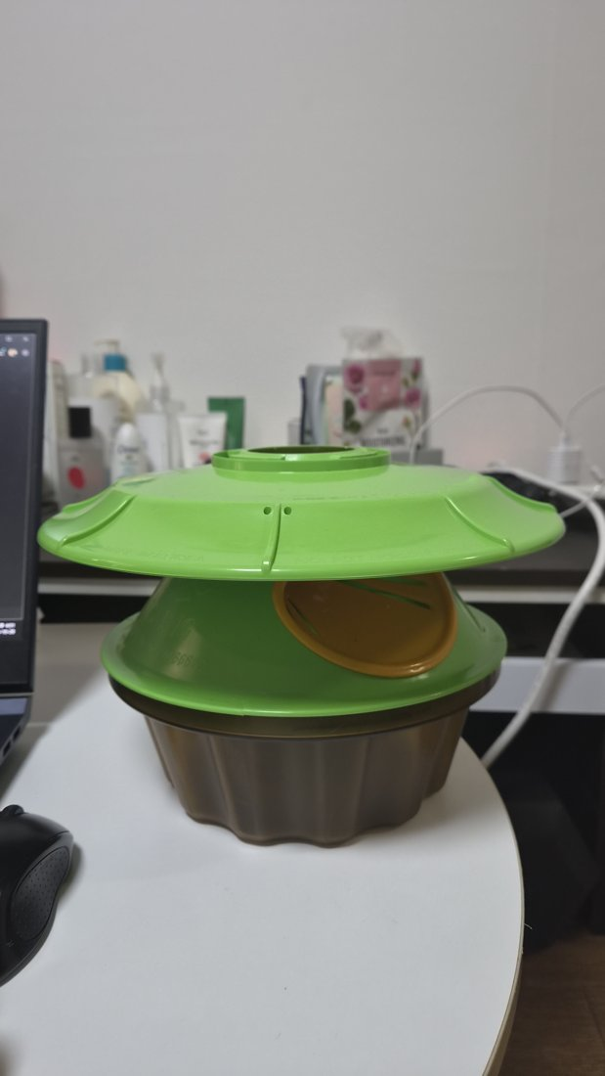
design/img/실측사진/몸통_차양막.jpg
