britams/-capstone-project-repo/design/img/실측사진/차양막_구멍_턱.jpg

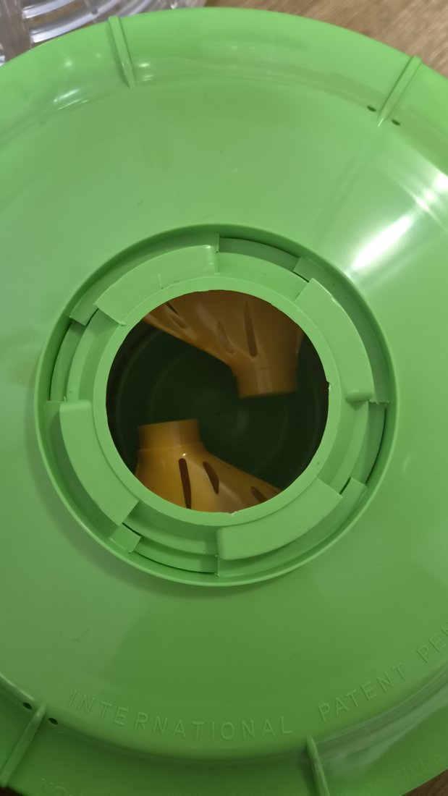
design/img/실측사진/차양막_구멍_턱.jpg
