britams/-capstone-project-repo/design/img/실측사진/포획통_바닥.jpg

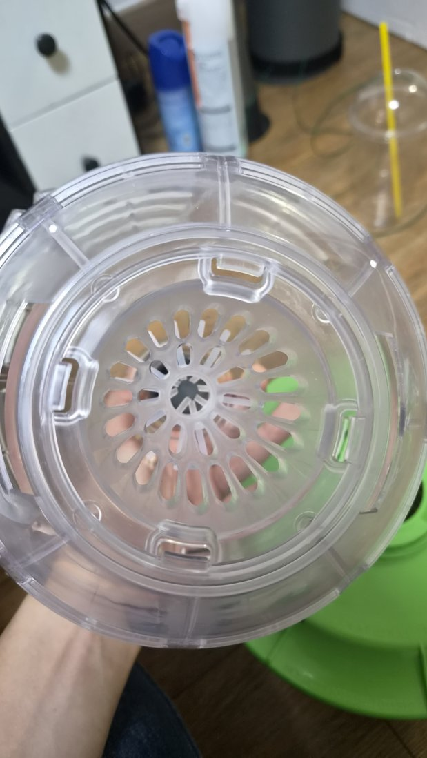
design/img/실측사진/포획통_바닥.jpg
