britams/-capstone-project-repo/design/img/실측사진/포획통_전체.jpg

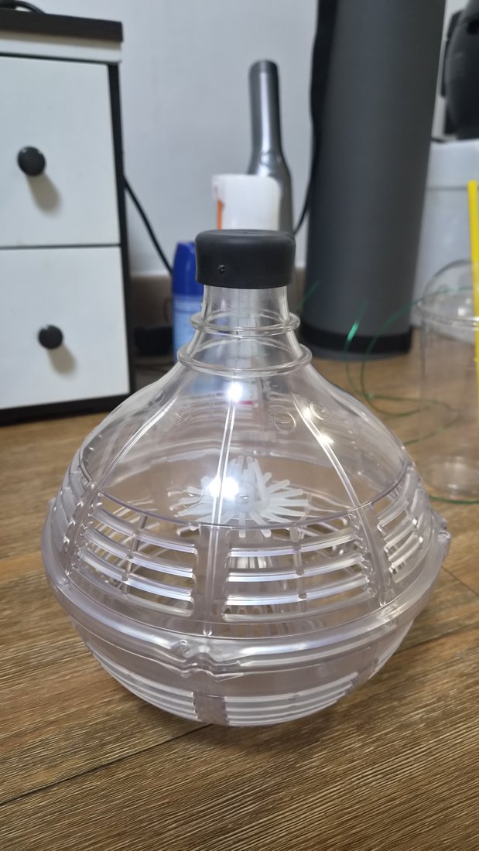
design/img/실측사진/포획통_전체.jpg
