britams/-capstone-project-repo/purchase/README.md

# purchase
BOM, 견적, 주문 기록, 예산 장부(50만 원, `재료비_정산보고서.xlsx`). 담당: 승준.
