britams/-capstone-project-repo/cad/parts/feeder/README.md

# 급이부 — 부품별 CAD → 조립 (서현, 2026-11-10, CAP-AI-58)

서현 지시 (11/10 15:29): "부품별로 캐드 파일 만들고 부품별로 설계하자. 그 다음 모두 맞추는 것으로. 급이부만."

## 어떻게 되어 있나
1. **부품 파일 하나 = 부품 하나.** 부품마다 자기 원점이 있고, 그 원점에서 그린다. 파일 안에는 시트가 두 개 있다.
   - `치수`: 부품 도면에 들어갈 값
   - `맞춤`: 다른 부품과 만나는 자리
2. **조립 파일 `A143_급이방_조립.FCStd`는 모양을 갖지 않는다.** 부품 파일을 App::Link로 불러 자리에 놓기만 한다. 인서트 6개, 손나사 4개, 발 나사 2개는 각각 같은 부품 파일을 가리키는 링크다. 그래서 부품 파일 하나를 고치면 조립의 모든 자리가 함께 바뀐다.
3. **치수를 적는 곳은 하나뿐이다.** 값은 `cad/D5g_feeder_uln.py`의 `FD`·`FDX`·`INS`·`FOOT`에만 적는다. 부품 파일, 조립 파일, `D5g_full`, `feeder_check.py`가 모두 이 값을 읽는다. 두 곳에 적으면 언젠가 어긋나기 때문이다.
4. **다시 만들 때 (PC FreeCAD 1.1):**
   - 만들기: `import feeder_parts as FP; FP.run()`
   - 그림 (GUI 매크로): `freecad.exe cad\feeder_parts_render.py`

> **(11/10 밤, CAP-AI-59) 펌프 방식으로 바뀜.**
> - 서현 "설탕물 세팅이 불편 — 사용자 편의, 동력 써도 됨"
> - 바뀐 점: 거꾸로 튜브·그릇·손나사 → 바깥 병 + 연동 펌프 + 물빠짐, 뚜껑은 자석으로 붙임
> - 아래 표와 검사는 새 방식 기준이다. 예전 방식의 검사 기록은 git 기록 `5bbb504`에 있다

| 번호 | 파일 | 구분 | 자기 원점 (조립 좌표) |
|---|---|---|---|
| 143 | `P143_물길그릇.FCStd` | 설계 · PETG | 발 아래 면, 기둥 축 (52, 80, 205) — 물길·기둥·펌프 노즐·물빠짐 바브 |
| 143l | `P143l_뚜껑.FCStd` | 설계 · PETG | 뚜껑 아래 면, 물길 앞 끝 가운데 (55, 23, 388) — 자석 자리 2·핀 2·손잡이 혀 |
| 144b | `P144b_병펌프걸이.FCStd` | 설계 · PETG | 판 아래 끝, 레일 바깥 면 y 180, x 55 (z 92) |
| 144n | `P144n_병250mL.FCStd` | 구매 · Nalgene 2104-0008 | 병 바닥 가운데 |
| 144p | `P144p_펌프.FCStd` | 구매 · Adafruit 3910 | 모터 아래 끝 가운데 |
| 142n | `P142n_코튼롤.FCStd` | 구매 · 치과 코튼롤 2호 | 솜 안 끝 가운데 (55, 21.4, 378) |
| 143m ×4 | `P143m_자석6x2.FCStd` | 구매 · 네오디뮴 Ø6 × 2 | 아래 면 가운데 |
| 144h·hf·hd | `P144h*_관_*.FCStd` | 구매 · 실리콘 관 3.5 × 5 | 조립 원점 그대로 (휘는 관이라) |
| 94459A130 ×2 | `vendor_step/parts/P94459A130_인서트M3.FCStd` | McMaster STEP | 큰 끝 z 0, 몸 −z (발) |
| 92000A118 ×2 | `vendor_step/parts/P92000A118_냄비M3x8.FCStd` | McMaster STEP | 머리 밑면 z 0 (데크 아래에서) |

McMaster 부품 파일은 레포에 올리지 않는다 (`cad/vendor_step/`는 .gitignore). McMaster CAD는 '참고용'이라는 조건으로 배포되고, 이 레포는 공개다. 조립 파일은 링크만 담고 있어서 올려도 된다. 다른 PC에서는 STEP 3개를 받아 `cad/vendor_step/`에 두고 `FP.run()`을 돌린다.

## 검사 (`_check.json`, FreeCAD 1.1, 11/10)
| 검사 | 결과 | 판단 |
|---|---|---|
| 부품끼리 겹침 (허용 안 되는 것) | **0** | 통과 [확실 — 모양 common] |
| 허용 겹침 — 인서트가 녹아 박힘 (143 ↔ 인서트) | 4.37 mm³ × 6 | 구멍 Ø4 < 인서트 바깥 Ø4.74 |
| 허용 겹침 — 나사산 물림 | 손나사 2.86 mm³ × 4, 발 나사 1.95 mm³ × 2 | 같은 번호 자리끼리만 |
| 손나사 끝 ↔ 구멍 바닥 | 1.0 mm | 통과 |
| 손나사 물림 | 4.3 (인서트 전체) | 통과 |
| 발 나사 물림 / 끝 ↔ 발 윗면 | 3.0 / 3.0 mm | 통과 (M3 지름 1배) |
| 발 인서트 최소 두께 5.1 ≤ 발 두께 | 6 | 통과 |
| 물·솜 검사 6개 (`feeder_check.py`) | 6/6 | 통과 — 넘침 여유 1.8 mm, 솜 잠김 2.0 mm |
| 조립 파일 = 전체 모델 `D5g_full` 의 같은 부품 | 143 부피 58,250.71 = 58,250.71, 차이 0 / 다른 부품 자리·크기 같음 | 통과 |
| 전체 모델에서 손가락·드라이버 길 막힘 | 0 / 0 | 통과 (`_mcm_report.json`) |

비교하다 찾은 것 [확실]: 전체 모델의 143 발 윗면에 깊이 3 mm 홈이 2개 남아 있었다 (129.5 mm³). 예전 M5 발 볼트를 먼저 만들고, 겹침을 고치는 단계가 그 머리 자리를 발에서 파낸 뒤에 볼트만 지웠기 때문이다. → M5 발 볼트를 아예 만들지 않게 바꿨다 (`D5g_feeder_uln.make_into`).

| 부품 | 크기 x × y × z | 부피 | 무게 |
|---|---|---|---|
| 143 물길·그릇 | 44.6 × 92.0 × 229.0 | 58.3 cm³ | PETG 74 g (꽉 채움 기준) |
| 143l 뚜껑 | 40.0 × 92.0 × 14.0 | 5.5 cm³ | 7 g |

## 부품별로 나누어 보니 드러난 것 — 결정 필요
**143은 한 덩어리로 출력하기에 나쁜 모양이다 [가능성 높음 — 모양에서 읽음, 출력 시험 안 함].**
- 높이가 229 mm다. 판 크기는 아직 모른다 (Craft-Lab 프린터, README의 '남은 결정').
- 세워서 출력하면 12 × 12 기둥 위 150 mm 높이에서 물길·그릇 바닥(44 × 92)이 공중에 뜬다. 바닥에서부터 서포트를 150 mm 쌓아야 하고, 물이 닿는 바닥 아래 면이 거칠어진다.
- 눕혀서 출력하면 그릇과 집게 고리가 옆으로 서고, 물길 바닥 면이 세로가 되어 층 사이로 물이 샐 수 있다.

제안: **두 부품으로 나눈다.**
- 143a 물길·그릇: 바닥을 판에 대고 출력해서 서포트가 거의 없게 한다. 물길 바닥 아래에 인서트 2개를 넣는다.
- 143p 기둥·발: 눕혀서 출력하는 단순한 막대다. 위쪽 끝을 M3 × 2로 143a에 조인다.

나누면 부품 파일 1개, 나사 2개, 인서트 2개가 늘어난다. → **서현이 정할 것: 나눌지, 한 덩어리로 둘지. 그리고 프린터 판 크기.**
