britams/-capstone-project-repo/purchase/2026-11-16_1차주문_장바구니_서현.md

# 1차 주문 장바구니 — 11/16(월) 주문용 (서현, 2026-11-14 밤 정리)

정리: 서현 (Claude, CAP-AI-62) · 서현 결정 (11/14 23:17): **"100 안쪽으로는 무조건, 나머지는 여유롭게"** → 총액 100만 원 안 (지원 50만 + 넘는 것은 자비)
가격·준비 기간: 11/14 23시 판매처 페이지에서 읽음 [확실]. 아이씨뱅큐(ICB) 검색 목록 값은 **부가세 별도**로 보고 × 1.1.
**주문·결제는 서현이 직접** (Claude는 안 함).

## 0. 결론 먼저
- **1차(전기·리프트) 약 27만 원** — 디바이스마트 약 6.6만 + ICB 약 19.8만 + 아크릴 가공 견적.
- [확실] 국내 재고 상품(준비 2~4일)만 골랐다 → 11/16 주문이면 11/20 전후 도착, 정산 사진 가능.
- 예외 1개: **빛 게이트 Adafruit 2167은 국내 재고가 없다** (ICB·DM 모두 해외 7~14일) → **자비**로 따로 산다 (정산 안 넣음).
- 판매처를 바꾼 것 (11/08 승준 표 대비): MG90S → ICB 국내품, 비상 정지 → KGAUTO 25Φ 국내 재고, 급이 펌프 Adafruit 3910(해외 38,600) → **Kamoer NKP 12 V 국내 10,600 + MT3608로 12 V 만듦**, RTC 배터리 → **뺌** (아래 3장).

## 1. 디바이스마트 (한 번에 → 66,000원 넘으면 배송비 0)
| 품목 | 상품번호 | 개수 | 부가세 포함 | 준비 |
|---|---|---|---|---|
| 라즈베리파이 카메라 모듈 3 | 14917048 | 1 | 43,780 | 1~2일 |
| 5 V 3 A 어댑터 | 15706959 | 1 | 6,380 | 3~4일 |
| 와고 221-415 | 10827023 | 5 | 4,950 | 2~3일 |
| MOSFET 4채널 SZH-AT021 | 1361314 | 1 | 3,850 | 3~4일 |
| MT3608 승압 모듈 (mightyZAP 7.4 V · 펌프 12 V · 예비) | 1342935 | 3 | 3,300 | 2~3일 |
| 퓨즈홀더 F-520 + 퓨즈 5×20 3 A × 5 | 4573 · 4537 | 1 + 5 | 726 | 1~2일 |
| 카메라 FFC 500 mm (승준 E18) | (주문할 때 검색) | 1 | 약 3,000 ~ 8,000 | — |
| **소계** | | | **약 66,000 ~ 71,000** | |

## 2. 아이씨뱅큐 (ICB)
| 품목 | 상품코드 | 개수 | 부가세 포함 | 준비 |
|---|---|---|---|---|
| **mightyZAP D7-6PT-3** + 옵션 '기본 커넥터 와이어 IR-EW06 PWM 200 mm' | P007598845 | 1 | 111,100 + 15,576 = **126,676** | 3~4일 |
| MG90S 서보 (엘케이임베디드 B116) | P016195879 | 3 | 18,150 | 2~3일 |
| 28BYJ-48 + ULN2003 세트 (PP-A406) | P019043080 | 3 (X·Y + 예비) | 6,600 | 2~3일 |
| KW-11-3Z 레버 (PP-D277) | P019041558 | 3 (X·Y + 예비) | 1,584 | 2~3일 |
| 비상 정지 KGAUTO KGE-J4R1R 25Φ 방수 (PP-B622) | P019041441 | 1 | 16,060 | 2~3일 |
| 연동 펌프 Kamoer NKP 12 V (PP-A703) | P019043095 | 1 | 11,660 | 2~3일 |
| 실리콘 관 안 3 · 바깥 5, 1 m (PP-A702BL) | P019043081 | 2 | 2,046 | 2~3일 |
| **소계** | | | **약 182,800** | |
| (자비) 빛 게이트 Adafruit 2167 3 mm | P013152497 | 3 | 15,180 | **해외 7~10일** |

## 3. 바꾼 것과 이유 (AI 판단, 서현 위임)
| 무엇 | 바꾼 것 | 이유 | 따라 고칠 것 |
|---|---|---|---|
| mightyZAP 선 | 판매처 PWM 선 IR-EW06 (14,160 별도) | 압착 공구 없이 꽂기만 (서현 '나사로 조이는 것만') | 하네스 표 |
| MG90S | DM 정품 [해외] 12,100 → ICB 국내 5,500 | DM은 '[해외]'라 정산 애매, 3개 18,000원 쌈 | 없음 |
| 비상 정지 | KSEP-2240 (준비 6주) → KGE-J4R1R **25Φ** | 22Φ 국내 재고품이 모두 3~6주 | 비상 정지 함 구멍 22 → 25 [가능성 높음 — 접점 1a1b는 판매처 사진으로 확인] |
| 급이 펌프 | Adafruit 3910 5 V (해외 38,600) → **Kamoer NKP 12 V** (국내 10,600) | 국내 재고 + 정산 가능 | 회로: Q3 → MT3608(5 → 12 V) → 펌프. 한 번 양(100 ms ≈ 0.14 mL)은 다시 잼 [추측] |
| RTC 배터리 | **뺌** | 공식품 ICB 납기 미정·예상관세(해외), 대체품도 해외 2주 | Pi 시계는 켤 때 인터넷(NTP)이나 손으로 맞춤. 전원이 계속 있으면 문제없음. 정전 뒤 날짜가 틀리면 **계절 규칙만 틀림** → Pi 코드에 "날짜가 2026년 전이면 여왕벌로 보고 격리" 한 줄 (안전 쪽) |
| 바닥 원판 | McMaster 90313A108 (해외) → **아크릴 Ø32 × 2T 구멍 3.4** | 격자판과 같은 판 → 한 번에 주문 제작 | CAD `lift_v3.py` 고침, DXF `cad/print/lift/300f_아크릴바닥원판.dxf`. M4 와셔 뺌 |
| 빛 게이트 2167 | 그대로, **자비** | 국내 재고 없음 | 없음 |

## 4. 아크릴 가공 (주문 제작) — 디바이스마트 '메이커 견적 → 레이저'
- 보낼 파일: `cad/print/lift/300p_아크릴격자판.dxf` (38 × 38, 네모 구멍 37개 + Ø3.4 × 4), `300f_아크릴바닥원판.dxf` (Ø32, 구멍 Ø3.4)
- 재료: 투명 아크릴 2T. 개수: 격자판 2 (예비 1), 원판 2 (예비 1)
- 견적 요청은 사람이 양식에 넣어야 함 → https://www.devicemart.co.kr/maker_estimate/request_form/laser
- 값: 견적 받아야 앎 [추측 1만 ~ 2.5만]

## 5. 2차 주문 (기계 — 11/19까지)
승준 11/08 표 M1~M36 (프레임 2020·브래킷·M5·T너트·봉·T8·베어링·커플링) + 리프트 나사(M3 × 8 무두, M3 너트, M3 × 20, Ø6 × 4 스페이서, M3 × 8 + DIN 125, M5 × 10, M3 인서트).
**11/11 '프린트 → 사는 것' CAD가 아직 다 안 끝나서 개수가 정해지지 않음** → CAD 정리 뒤 같은 형식으로 만든다.

## 6. 총액 어림 (100만 원 안)
| | 원 |
|---|---|
| 이미 쓴 돈 | 130,010 |
| 1차 DM + ICB | 약 249,000 ~ 254,000 |
| 자비 2167 | 15,180 |
| 아크릴 가공 | 약 10,000 ~ 25,000 [추측] |
| 2차 기계 (승준 11/08 기계 소계 19.4만 ~ 29.7만 − 리프트 몫) | 약 180,000 ~ 280,000 [추측] |
| 11/11 사는 것으로 바꾼 부품 | 약 50,000 ~ 150,000 [추측] |
| **합계** | **약 63만 ~ 85만** |
