britams/-capstone-project-repo/purchase/2026-11-14_구매_바뀐것_예산다시_서현.md

# 구매 — 11/08 표 뒤로 바뀐 것 · 예산 다시 셈 (서현, 2026-11-14)

정리: 2026-11-14 23시 · 서현 (Claude, CAP-AI-62) · 바탕: `purchase/2026-11-08_가격조사_예산_주문마감_승준.md` (승준 SJ-52, 11/08 값)
서현 11/14 "승준 무시하고 우리가 다 해" → 구매도 서현이 맡음. **주문은 안 함** (결제는 사람이).
장부: 10/29 뒤로 산 것 0 → 남은 돈 **369,990원** [확실 — `purchase/구매장부.md`]

## 0. 결론 먼저
1. **[가능성 높음] 가장 싸게 사도 남은 돈을 약 8만 원 넘는다.** 11/08 표(36만 ~ 56만)에서 리프트·급이부가 바뀐 것을 빼고 더하면 **약 45만 ~ 69만 원**이다. 가장 큰 것은 **mightyZAP 101,000원**(남은 돈의 27 %)이다.
2. **[확실] 11/08 표의 '이번 주 주문' 마감(11/10·11/11)이 이미 지났다.** 비상 정지(약 2주), MG90S, RTC 배터리가 그 3개다. 11/27까지 받으려면 **국내 재고 상품(1~3일)으로 바꿔서 11/16(월)~11/17(화)에** 주문해야 한다.
3. **[확실] 바닥 원판 McMaster 90313A108은 해외구매라 정산이 안 된다** (정산규칙 ④). 국내 규격품으로 바꿔야 한다 → 3장.
4. **[가능성 높음] 아직 값을 못 넣은 것이 있다.** 11/11 '프린트 → 사는 것'(SK8·SC8UU·PVC·포맥스 등 30여 개)과 새 격리 관(PVC 4토막 + 꺾임 3)이다. 그래서 위 합계는 **더 늘어난다**.

## 1. 11/08 표에서 빠지는 것 (리프트 v3 · 로드셀 없앰)
| # | 품목 | 빼는 돈 (싸게 ~ 비싸게) | 이유 |
|---|---|---|---|
| E11 | 막대 로드셀 1 kg × 2 | 13,420 | 11/10 교수님 '로드셀은 과함' |
| E12 | HX711 × 2 | 4,400 | 〃 |
| E13 | KW-11-3Z 5 → 3 (X·Y + 예비) | 1,320 | F 원점 스위치 없음 |
| 146 | 바닥 스프링 | 3,000 ~ 10,000 | 리프트 v3 |
| 149 | LM4UU × 2 | 6,820 | 〃 |
| 147 | Ø4 × 80 축 (봉 묶음 안) | 2,500 ~ 6,000 [추측] | 〃 |
| M7·M8 | T8 3 → 2 (F 몫) | 4,840 ~ 7,000 | 〃 |
| M9 | 커플링 3 → 2 | 2,000 ~ 4,000 [추측] | 〃 |
| M17 | 팰컨 50 mL (거꾸로 병) | 3,000 [추측] | 11/10 펌프 급이 |
| | **빼는 합** | **41,300 ~ 55,960** | |

## 2. 새로 더하는 것
| 품목 | 수량 | 돈 (원) | 근거 | 준비 |
|---|---|---|---|---|
| **mightyZAP D7-6PT-3** (아이알로봇, 디바이스마트) | 1 | **101,000** | 가능성 높음 (11/14 고를 때 본 값, 부가세 포함으로 봄) | 재고 확인 |
| MT3608 승압 모듈 | 1 (+ 예비 1) | 1,500 ~ 3,000 | 추측 | 1~3일 |
| Molex 5264-03 하우징 + 단선 압착 리드 | 1 | 1,000 ~ 3,000 | 추측 | 1~3일 |
| **아크릴 격자판 2T 맞춤 제작** (`cad/print/lift/300p_아크릴격자판.dxf`) | 1 (+ 예비 1) | 10,000 ~ 25,000 | 추측 (레이저 가공 기본료 포함) | 3~7일 |
| 마킹실 상자 프린트 (9.37 cm³) | 1 | 0 ~ 5,000 | 추측 (학교 프린터면 0) | — |
| 바닥 원판 국내품 (3장) | 1 (+ 예비) | 500 ~ 3,000 | 추측 | 1~3일 |
| 리프트 나사류: M3 × 8 무두 볼트, M3 너트, M4 DIN 9021, M3 × 20, Ø6 × 4 스페이서, M3 × 8 + DIN 125 × 4, 혀 M5, M3 인서트 4 | — | 3,000 ~ 8,000 | 추측 | 1~3일 |
| 세움 2020 156 mm + 브래킷 | 1 | 2,000 ~ 3,000 | 가능성 높음 (11/08 mm당 5원 + DCB 2025) | 3~5일 |
| 급이 펌프 Adafruit 3910 | 1 | 8,000 ~ 15,000 | 추측 | 미확인 |
| 바깥 병 Nalgene 2104-0008 250 mL | 1 | 5,000 ~ 15,000 | 추측 | 미확인 |
| 실리콘 관 3.5 × 5 | 1 m | 2,000 ~ 5,000 | 추측 | 1~3일 |
| | **더하는 합** | **134,000 ~ 186,000** | | |

## 3. 바닥 원판 (McMaster 90313A108 Ø31.75 × 1.3, 구멍 7.14) 바꿀 것
- 조건: 마킹실 구멍 Ø33 안에서 걸리지 않고(바깥 ≤ 32.4), 가운데 구멍이 M4 DIN 9021(바깥 12)보다 작고, 얇음(≤ 2 mm).
- 후보 [가능성 높음 — 일반 규격, 판매처 치수표로 확인할 것]: **특대 평와셔 M8 (바깥 32 · 구멍 8.4 · 두께 1.5~2)** — 국내 볼트 가게에 흔함. 구멍 8.4 < 12라 받침 와셔 위에 그대로 앉는다.
- CAD는 원판 지름 31.75 → 32, 구멍 7.14 → 8.4로 바꿔 다시 검사해야 함 (틈 0.6 → 0.5 mm) — 사기 전에.

## 4. 합계 다시
| | 싸게 | 비싸게 |
|---|---|---|
| 11/08 표 합계 | 356,363 | 559,173 |
| − 빠지는 것 | −41,300 | −55,960 |
| + 더하는 것 | +134,000 | +186,000 |
| **11/14 합계** | **약 449,000** | **약 689,000** |
| 남은 돈 369,990에서 빼면 | **약 −79,000** | **약 −319,000** |
| 아직 안 넣은 것 | 11/11 '프린트 → 사는 것' 30여 개, 새 격리 관(PVC·꺾임 3), 카메라 CM3 43,780 (11/09 §7) | |

카메라 CM3(43,780)까지 넣으면 싸게 사도 **약 −12만 원**.

## 5. 지금 정할 것 (서현)
| # | 무엇 | 왜 지금 |
|---|---|---|
| 1 | 예산을 넘는 것을 어떻게 할지: (가) 자비로 넘는 만큼 / (나) 빼기 — 후보: 2대째 안 만듦, 카메라 CM3 대신 보유 AI 카메라, 조명 LED 빼기 / (다) 리프트를 더 싼 것으로 | 싸게 사도 약 8만 ~ 12만 원 넘음 |
| 2 | CAD와 상관없는 전기 부품부터 11/16~11/17에 주문할지 (비상 정지는 국내 재고품으로) | 11/27까지 받아야 정산 사진을 찍음 |
| 3 | 담당자 메일: 11/30 뒤 구매 정산, 배송비 인정, 디바이스마트 `[해외]` 표시 상품 | 11/08 표 5장 #2 그대로 남아 있음 |

## 출처
- 11/08 값과 판매처: `purchase/2026-11-08_가격조사_예산_주문마감_승준.md` (그 문서의 출처 목록)
- mightyZAP: `design/인터페이스_정의서.md` 구동기 1 줄, [RobotShop 상품 페이지 (6 N · 36 mm/s)](https://ca.robotshop.com/products/ir-robot-usa-llc-mightyzap-micro-mini-linear-servo-motor-actuator-26mm-stroke-ttl-pwm-6n-36mm-s-74v)
- 정산 규칙: `purchase/2026-10-28_재료비_정산규칙.md`
