britams/-capstone-project-repo/design/2026-11-11_프린트부품_구매로_바꿈_서현.md

# 3D 프린트 부품 → 사는 것으로 바꿈 (서현, 2026-11-11, CAP-AI-61)

서현 지시 (11/11 22:45):
> "3D 프린터로 뽑는 부품은 최대한 없도록 해. 살 수 있으면 최대한 사."

서현 답:
> "주문 재단도 OK. 문 같은 것은 그냥 플라스틱 사서 내가 뚫어도 되지 않나? 마킹 구멍 뚫린 그것(격자)만 투명하게, 나머지는 값싼 플라스틱으로."

움직이는 장치를 어떻게 할지는 답이 없었다.
→ **구조는 그대로 두고 규격품으로 바꾼다** (AI 판단, 서현 위임). 28BYJ-48·T8·펌웨어·회로는 그대로다.

## 바꾸는 규칙
1. **규격품이 있으면 산다.**
   - 축 받침 SK8, 베어링 블록, 축 칼라, 서보 브래킷, 깔때기, PVC 관, 전선 몰딩, 와고 장착 캐리어, 비상 정지 함, Pi 케이스, 카메라 마운트, P클립 등.
2. **판 모양이면 산 판을 자른다.**
   - 값싼 불투명 판: 포맥스(PVC 발포판) 2·3·5 mm, PP 1.5 mm.
   - 직접 자르고 뚫어도 되고, 주문 재단해도 된다.
   - 힘을 받는 판(모터판·옆판·캐리지)은 알루미늄 판·앵글을 산 뒤 자르고 뚫는다.
3. **투명은 격자 130뿐이다** (아크릴 1.5, 11/09 결정 그대로).
4. 어느 쪽으로도 안 되는 것만 프린트로 남긴다 → **지금 표에서 0개** [가능성 높음 — CAD로 맞춰 봐야 확정].

## 부품별 (11/10 목록 43개 기준 · 198xc·148s는 11/10 이미 없앰)
치수 표시:
- [확실]: 판매처 표를 읽은 값 — SK8: 축 높이 h 20, 폭 W 42, 두께 L 14, 볼트 간격 32, M5
- [가능성 높음]: 일반 규격 대표값 — 사기 전에 판매처 치수표를 확인

| 번호 | 부품 (지금) | 바꿀 것 | 만드는 법 | 메모 |
|---|---|---|---|---|
| 104 | 돔 연결부 90 × 90 × 10 | 포맥스 5 mm × 2장 겹침 | 판 자름·구멍 | 돔 고리 자리만 원으로 |
| 110 | 입구 통로 28 × 16 × 122 | **전선 몰딩(사각 덕트) 25 × 15** 근처 규격 | 길이만 자름 | 안 치수 맞는 규격 찾기 [가능성 높음] |
| 111 | 입구 깔때기 Ø61 | **시판 소형 깔때기 Ø60** | 구매 | 끝을 잘라 통로에 끼움 |
| 112·170·176 | 문 하우징 3개 (미닫이 틀) | **서보 브래킷(MG90S, 시판) + 회전 덮개 문** | 구매 + 판 | 미닫이를 회전 덮개로 바꿈 → 틀이 필요 없어짐. 펌웨어는 각도 값만 |
| 문 판 ×3 | 미닫이 판 1.5 | **PP 1.5 mm 판** | 직접 자름 | 서보 혼에 나사 2개 |
| 120 | 마킹실 벽 46 × 46 × 50 | 포맥스 3 mm 4장 | 자름·접착 | 솜 구멍·문 구멍 뚫음 |
| 121 | 마킹실 바닥판 46 × 46 × 5 | 포맥스 5 mm | 자름 | |
| 130 | 격자 | 투명 아크릴 1.5 (그대로) | 주문 재단 | 유일한 투명 |
| 140 | 승강 바닥 39 × 39 × 6 | 포맥스 5 mm | 자름 | |
| 143 | 급이 물길·기둥 | **포맥스 2 mm U자 물길 + 알루미늄 각관 12 × 12 기둥 + 시판 바브 피팅 2개** | 자름·접착 | 노즐·물빠짐을 산 바브(관 안 3.2용)로 |
| 143l | 급이 뚜껑 | 포맥스 2 mm + 자석 | 자름 | |
| 144b | 병·펌프 걸이 | **파이프 클램프 Ø60 + 2020 L 브래킷 + 케이블 타이** | 구매 | |
| 148c | 스프링 걸쇠 (11/10 새로) | **축 칼라 Ø4 (멈춤 나사)** | 구매 | 스위치를 칼라 바로 아래로 옮김 → 혀 없어짐 (11/10 검사에서 혀가 옆판 151_R과 겹침 72 mm³ — 같이 해결) |
| 151 ×2 | 바닥 구동 옆판 | **알루미늄 앵글 20 × 20 × 2** | 자름·구멍 | |
| 152 | 바닥 모터판 | **알루미늄 판 3 mm** (또는 28BYJ 브래킷) | 자름·구멍 | |
| 158 | 바닥 캐리지 | **알루미늄 판 5 mm + 앵글** (LM4UU·T8 너트 나사로) | 자름·구멍 | 스프링 받침 칸도 앵글로 |
| 172 | 격리 통로 28 × 16 × 216 | 전선 몰딩 (110과 같은 규격) | 길이만 | |
| 173 | 격리 깔때기 | 시판 소형 깔때기 | 구매 | |
| 174·175 | 방생 목·굴뚝 Ø54 × 75 | **PVC 관 (바깥 Ø48~60 규격) + 캡** | 자름 | 규격 지름에 맞춰 굴뚝 지름을 바꿈 |
| 181 | 카메라 받침 | **Pi 카메라 마운트(시판) + 2020 L 브래킷** | 구매 | |
| 193h ×6 | 와고 받침 | **WAGO 221-500 장착 캐리어 + DIN 레일 (2020에 나사)** | 구매 | |
| 194b | 비상 정지·퓨즈 판 | **비상 정지 스위치 함(1구 박스)** | 구매 | 퓨즈 홀더는 함 안 |
| 197 ×2 | ULN 받침 | **PCB 스탠드오프 M3 + 포맥스 3 mm 판** (또는 DIN 레일 PCB 홀더) | 구매 + 판 | |
| 199a | Pi 선반 | **Pi 5 케이스(나사 구멍 있는 것) + DIN 레일 클립** | 구매 | |
| 199b·c | 게이트 받침 (작음) | **부착형 케이블 타이 마운트** | 구매 | |
| 202·203 | 마커 홀더·조임 띠 | **고무 P클립 Ø13 2개** | 구매 | 마커 지름은 실물로 [가능성 높음 Ø12~13] |
| 206 | Y 캐리지 | **SC6UU 블록 ×2 + 알루미늄 판 3 mm** | 구매 + 판 | |
| 211 | Y 모터 브래킷 | **28BYJ-48 브래킷 (시판 L형)** | 구매 | 없으면 알루미늄 앵글 |
| 212 ×2 | X 빔 끝 블록 | **SC8UU ×2 + SK6 ×4 + 알루미늄 판 5 mm** | 구매 + 판 | |
| 217 | X 모터판 | 28BYJ-48 브래킷 + 2020 T너트 | 구매 | |
| 218 ×4 | X 봉 받침 | **SK8 ×4** [확실 — h 20, W 42, L 14, 볼트 32, M5] | 구매 | 봉 높이가 지금(받침 위)과 달라질 수 있음 → CAD로 맞춤 |
| 219·220 | 마커 뚜껑 컵·받침 | **마커 뚜껑 그대로 + 고무 P클립** | 구매 | |
| 226 | X 원점 스위치 집게 | **축 칼라 Ø8 + 작은 L 브래킷** | 구매 | |

## 하는 순서 (CAD)
1. **급이부** (지금 보던 곳): 143·143l·144b·148c
2. **간단히 바꾸는 것**: 218 SK8, 193h, 194b, 199a, 181, 111·173, 174·175, 110·172
3. **바닥 구동** 151·152·158 (알루미늄)
4. **마커 X·Y** 206·211·212·217·202·203·219·220·226
5. **문 3개**: 회전 덮개로 → 펌웨어 각도·빛 게이트 자리 다시 봄
6. **마킹실·바닥판**: 120·121·140·104 판으로

각 단계가 끝나면 다음을 한다:
- 겹침과 움직임 검사
- 부품표(규격·수량) 고침
- 프린트 부품 목록 숫자 고침

## 남은 결정 (서현)
- 포맥스를 직접 자를지, 주문 재단할지 → 둘 다 되게 그린다 (직선·원 구멍만)
- 문 방식 (미닫이 → 회전 덮개): 5단계에서 그림으로 보여 주고 정함
