britams/-capstone-project-repo/purchase/2026-11-08_가격조사_예산_주문마감_승준.md

# 가격 조사 · 남은 예산 · 주문 마감일 — 2026-11-08 (승준)

정리: 2026-11-08 20시 · 이승준 (Claude와 정리, **CAP-AI-SJ-52**)
대상: 아직 안 산 것 전부 = 서현 전기 구매확정표 E1~E18 (`design/2026-11-06_전기부품_구매확정표_서현.md`) + 승준 기계 M1~M36 (`purchase/2026-11-06_기계부품_구매상세_McMaster대조.md`) + 만드는 부품 재료. **겹치는 것은 한 번만 셈** (M15=E13, M22=E5, M23=E3, M25=E7b·c, M26=E7, M27=E4, M31=E11).
가격: 11/08 판매처 페이지 값, **모두 부가세 포함으로 바꿈** (디바이스마트 목록 값은 부가세 별도라 ×1.1). 개수: D5g 부품표(`cad/2026-11-06_D5g_부품표_승준.md`) 1대 기준 — **서현이 CAD(C1~C6)를 고치면 기계 쪽 개수가 바뀜**.
**주문은 안 함** (서현 11/08: 부품 주문은 CAD 끝난 뒤).

---

## 0. 결론 먼저

1. **[가능성 높음] 남은 돈 369,990원으로 빠듯하다.** 아직 안 산 것 예상 합계 **약 36만 ~ 56만 원**. 싸게 사면 1만 원쯤 남고, 비싸게 사면 **약 19만 원 넘는다.**
2. **[확실] 11/30에 맞추려면 늦게 오는 것 3개는 이번 주(11/10~11/11)에 주문해야 한다.** 정산보고서에 **제품 사진이 꼭** 들어가야 해서, 물건이 11/27(금)까지는 와야 한다.
   - 비상 정지 KSEP-2240은 **준비 3주** → 못 맞춤. 같은 22Φ인 KGAUTO KGE-H4R1R(약 2주)로 바꿔도 **11/10까지** 주문해야 함
   - MG90S 아이씨뱅큐(3,410원)는 **배송 3주 이내** → 이미 늦음. 디바이스마트 정품(12,100원, 2~3일)은 재고가 없으면 +2주
   - Pi 5 RTC 배터리(아이씨뱅큐)는 **납기 미정** → 다른 판매처를 찾아야 함
3. **[추측 — 담당자 확인 필요] 디바이스마트에서 `[해외]`로 표시된 물건**(MG90S 정품, 28BYJ-48 3개입 KS0327)이 정산 규칙의 '해외구매'에 들어가는지 모른다. 판매처는 국내 회사이지만 물건은 해외 재고에서 온다.

## 1. 그림으로 보기

### 1-1. 돈 (막대 하나 = 약 2만 원)

```
한도 50만 원 = 막대 25칸                            한도 끝 ▼
                    |이미 쓴 돈|←──── 남은 돈 37만 ────→|
지금 장부           ███████░░░░░░░░░░░░░░░░░░             |
                    |이미 쓴 돈|←─ 살 것 ──→|
싸게 사면 (36만)    ███████▓▓▓▓▓▓▓▓▓▓▓▓▓▓▓▓▓▓              → 1만 원쯤 남음
비싸게 사면 (56만)  ███████▓▓▓▓▓▓▓▓▓▓▓▓▓▓▓▓▓▓▓▓▓▓▓▓▓▓▓▓    → 약 19만 원 넘음
                                                    ▲ 여기부터는 정산 안 됨
```

어디에 돈이 많이 드나 (싸게 ~ 비싸게):
```
전기 부품 (서현 E1~E18)                 14만 ~ 20만   ███████▓▓▓
프레임 (프로파일·브래킷·볼트·T너트)     11만 ~ 14만   ██████▓
움직이는 쇠 (봉·T8·베어링·커플링)        5만 ~ 11만   ███▓▓▓
기타 (나사·스프링·튜브) + 재료 + 배송    4만 ~ 11만   ██▓▓▓▓
                                                      █ = 싸게, ▓ = 비싸면 더 드는 만큼
```

### 1-2. 시간 (11/30 서류 마감에서 거꾸로 셈)

```
11/08(일) 오늘
   │
   ├─▶ 11/10(화)까지 주문 ── 비상 정지 (2주 + 배송) ───────────────┐
   ├─▶ 11/11(수)까지 주문 ── MG90S (DM 재고부터 확인) ──────────────┤
   │                        RTC 배터리 (다른 판매처로)               │
   ├─▶ 11/17(화)까지 주문 ── 28BYJ-48 3개입·빛 게이트·로드셀 (1주) ─┤
   ├─▶ 11/19(목)까지 주문 ── 프로파일 절단·T8·봉 (맞춤 제작 3~5일) ─┤
   ├─▶ 11/20(금)까지 주문 ── 나머지 (1~4일) ───────────────────────┤
   │                                                                 ▼
   │                                              11/27(금) 다 도착 → 사진
   └──────────────────────────────────────────────▶ 11/30(월) 서류 제출
```
계산: 주문 마감 = 11/27 − (준비 기간 + 배송 3일). 날짜는 달력 날짜로 보수적으로 셈 [가능성 높음 — 판매처 표시 준비 기간 기준, 택배 지연은 뺌].
MG90S: DM 재고가 있으면 2~3일이라 11/20까지도 되지만, 재고가 없으면 +2주라 지금 주문해도 빠듯하다 → **주문 전에 재고부터 확인** (DM 카톡·기술지원문의). 재고가 없으면 다른 국내 판매처를 찾는다.

⚠ **부딪히는 것**: 서현은 "주문은 CAD가 끝난 뒤"로 정했다. 그런데 위 마감일을 지키려면 **CAD와 상관없는 전기 부품**(비상 정지·MG90S·RTC)은 CAD가 끝나기 전에 사야 한다. → 서현 결정 필요 (5장).

## 2. 품목별 표 (1대, 부가세 포함)

근거: [확실] = 판매처 페이지에서 가격을 읽음 / [가능성 높음] = 비슷한 상품·옵션표에서 계산 / [추측] = 가격을 못 찾아 어림잡음.
DM = 디바이스마트, ICB = 아이씨뱅큐.

### 2-1. 전기 (서현 구매확정표)
| # | 품목 · 판매처 | 수량 | 금액 (원) | 근거 | 준비 | 주문 마감 |
|---|---|---|---|---|---|---|
| E1 | 5 V 3 A 어댑터 (DM 15706959, 5,800 별도) | 1 | 6,380 | 확실 | 3~4일 | 11/20 |
| E2 | DC 잭 5.5 × 2.1 | 1 | 500 ~ 1,000 | 추측 | — | 11/20 |
| E3 | 퓨즈홀더 F-520 + 퓨즈 5×20 3 A × 5 (DM 4573·4537, 각 110 별도) | 1 + 5 | 726 | 확실 | 1~2일 | 11/20 |
| E4 | **비상 정지 22Φ** — KSEP-2240(DM, 18,000 별도)은 **준비 3주** → **KGAUTO KGE-H4R1R** (알루미늄 22Φ, 1a1b = b접점 1개 있음, 11,000 별도) | 1 | 12,100 | 확실 | **약 2주** | **11/10** |
| E5 | 와고 221-415 (DM 10827023, 900 별도) | 5 | 4,950 | 확실 | 2~3일 | 11/20 |
| E6 | **MG90S** — ICB PP-A221 3,410 (**배송 3주 이내**) / DM 정품 12503480 11,000 별도 (`[해외] 2~3일`, 재고 없으면 +2주) | 3 | 10,230 ~ 36,300 | 확실 | 3주 / 2~3일 | **11/11** (DM) |
| E7 | 빛 게이트 Adafruit 2167 (ICB, 3,608) | 4 | 14,432 | 확실 | 미확인 | 11/17 |
| E7b | IR LED 3 mm 940 nm | 10 | 2,000 ~ 4,000 | 추측 | — | 11/20 |
| E7c | 포토TR 3 mm 940 nm | 10 | 3,000 ~ 5,000 | 추측 | — | 11/20 |
| E8 | 만능기판 50 × 50 양면 (DM 거상인 GA1, 2,300 별도) + 핀 헤더 | 2 | 5,560 ~ 6,060 | 가능성 높음 | 약 2일 | 11/20 |
| E9 | 전해 1000 µF | 1 | 300 ~ 500 | 추측 | — | 11/20 |
| E10 | 28BYJ-48 + ULN2003 3개입 (DM KS0327, 20,000 별도) | 1팩 | 22,000 | 확실 | `[해외] 1주` | 11/17 |
| E11 | 막대 로드셀 1 kg (ICB Adafruit 4540, 6,710) | 2 | 13,420 | 확실 | 미확인 | 11/17 |
| E12 | HX711 (DM SZH-SSBH-054, 2,000 별도) | 2 | 4,400 | 확실 | 약 2일 | 11/20 |
| E13 | KW-11-3Z (ICB, 660) — M15와 같은 것 | 5 | 3,300 | 확실 | 미확인 | 11/17 |
| E14 | MOSFET 4채널 (DM SZH-AT021, 3,500 별도) | 1 | 3,850 | 확실 | 3~4일 | 11/20 |
| E15 | **Pi 5 RTC 배터리** (ICB 5817, 13,200) — **납기 미정** | 1 | 13,200 | 확실 | **미정** | **11/11 (다른 판매처)** |
| E16 | 조명 LED 위 링·아래 (J3 사진으로 뺄 수도 — 서현 CAP-AI-53) | 0 ~ 2 | 0 ~ 10,000 | 추측 | — | J3 뒤 |
| E17 | 실리콘 전선 20~28 AWG 5종, JST-XH·듀폰 | — | 20,000 ~ 30,000 | 추측 | — | 11/20 |
| E18 | 카메라 FFC 22↔15핀 **500 mm** (DM에는 200 mm까지만 봄) | 1 | 3,000 ~ 8,000 | 추측 | — | 11/17 |
| — | 저항 10 kΩ·220 Ω, 100 nF, SB540, JST XH 4P | — | 1,500 ~ 3,000 | 추측 | — | 11/20 |
| | **전기 소계** | | **약 14.5만 ~ 20.3만** | | | |

### 2-2. 기계 (승준 M1~M36)
| # | 품목 · 판매처 | 수량 | 금액 (원) | 근거 | 준비 | 주문 마감 |
|---|---|---|---|---|---|---|
| M1 | LM8UU (DM 검색: 중국산 1,400 / 국산 3,800, 별도) | 2 | 3,080 ~ 8,360 | 확실 | 약 2일 | 11/20 |
| M2 | LM6UU (DM 검색: 1,500 / 4,250, 별도) | 2 | 3,300 ~ 9,350 | 확실 | 약 2일 | 11/20 |
| 149 | LM4UU (DM 검색: 중국산 3,100 별도) | 1 + 예비 1 | 6,820 | 확실 | 약 2일 | 11/20 |
| M3~M6, 147 | 봉 맞춤 절단 8개: Ø8 × 163 × 2, Ø6 × 124 × 2, Ø4 × 108, Ø4 × 80 (h6), Ø3 × 69 × 2 | 8 | 20,000 ~ 48,000 | 추측 | 맞춤 3~7일 | 11/19 |
| M7·M8 | T8 리드 8 + 황동 너트 (국내 3D 프린터 부품점 '손도리닷컴' 100 mm 4,840 — 검색 요약에서 읽음) — 100 · 100 · 150 mm 사서 자름 | 3 | 14,520 ~ 21,000 | 가능성 높음 | — | 11/19 |
| M9 | 커플링 5 × 8 D19L25 (국내 판매처 가격 못 찾음) | 3 | 6,000 ~ 12,000 | 추측 | — | 11/19 |
| M10 | **2020 프로파일 맞춤 절단** 320 mm × 21 + 610 mm × 4 (9.16 m) — 11번가 판매자 옵션표 300 mm 1,490 · 500 mm 2,480 · 700 mm 3,470으로 계산 (mm당 약 5원) | 25토막 | 45,470 ~ 48,900 | 가능성 높음 | 절단 3~5일 | 11/19 |
| M11·M35 | 2020 L 브래킷 (DM 신우 DCB 2025, 500 별도) — **치수가 CAD 브래킷(20 × 20 × 18)과 같은지 미검증** | 52 + 예비 4 | 30,800 ~ 43,120 | 가능성 높음 | 약 3일 | 11/20 |
| M12·M19·M20·M33·M34 | M5 볼트 8·10·12 mm (DM 대영·신우 100~130 별도) | 약 135 | 14,850 ~ 19,305 | 가능성 높음 | 2~3일 | 11/20 |
| 〃 | 20 시리즈(홈 6)용 슬라이드 T너트 M5 — DM에는 30·40용만 있음 (160 별도) | 약 135 | 22,275 ~ 29,700 | 추측 | — | 11/20 |
| M13·M14·M30·M32 | M3·M4 볼트·너트 소량 | — | 5,000 ~ 10,000 | 추측 | — | 11/20 |
| M28 | M3 인서트 (DM AMTEC Spredsert M3 × 5, 500 별도) — 열 압입형인지 확인 | 16 | 8,800 | 확실 | 약 1일 | 11/20 |
| M29 | 손나사 M3 × 8 | 4 | 1,600 ~ 3,200 | 추측 | — | 11/20 |
| M21·M24·198 | 기둥 M2 · M2.5 · M3 묶음 | — | 5,000 ~ 10,000 | 추측 | — | 11/20 |
| 146 | 바닥 스프링 (카탈로그 7조건 통과품 — 아직 못 고름) | 1 + 예비 1 | 3,000 ~ 10,000 | 추측 | — | 11/19 |
| M17·M18 | 팰컨 50 mL 튜브, 코튼롤 2호 | — | 3,000 ~ 8,000 | 추측 | — | 11/20 |
| | **기계 소계** | | **약 19.4만 ~ 29.7만** | | | |

### 2-3. 만드는 부품 재료 + 배송
| 품목 | 금액 (원) | 근거 | 메모 |
|---|---|---|---|
| 3D 프린팅 필라멘트 PETG 1 kg | 0 ~ 25,000 | 추측 | Craft-Lab에서 재료를 주면 0 — **확인 필요** |
| 판 5 mm × 2 (데크 101, 위판 105) 아크릴 재단 | 10,000 ~ 20,000 | 추측 | |
| 배송비 (DM 2,700원·6.6만 원 이상 무료, 프로파일 착불 약 3,000원 등) | 8,000 ~ 15,000 | 추측 | 배송비 인정 여부도 아직 모름 (구매장부) |

### 2-4. 합계
| | 싸게 | 비싸게 |
|---|---|---|
| 전기 | 144,848 | 202,618 |
| 기계 + 재료 + 배송 | 211,515 | 356,555 |
| **합계** | **356,363** | **559,173** |
| 남은 돈 369,990원에서 빼면 | **+13,627 (남음)** | **−189,183 (넘음)** |

- 가격을 직접 읽은 줄([확실])만 더하면 131,000 ~ 168,000원, 어림잡은 줄([추측])이 114,000 ~ 252,000원 → **합계가 이렇게 넓은 건 [추측] 줄 때문**. 승준이 [추측] 줄을 판매처에서 확인하면 범위가 좁아진다.
- **넣지 않은 것**: 배터리 상자(LiFePO4 20 Ah 등, 현장 시험 날짜가 정해지면), 2대째(만들면 기계·전기 대부분 2배).
- 계산 다시 하기: `python3 purchase/2026-11-08_가격합계.py` (이 표의 값이 그대로 들어 있음 — [추측] 줄 가격을 확인하면 그 줄만 고치고 다시 돌림).

## 3. 판매처를 바꿔야 하는 것 (서현 구매확정표와 다름)
| # | 서현 표 | 바꿀 것 | 이유 |
|---|---|---|---|
| E4 | KSEP-2240 (DM) | KGAUTO KGE-H4R1R (DM, 22Φ 1a1b) 또는 다른 22Φ NC | KSEP-2240 준비 **3주일** [확실 — DM 페이지]. KSEP는 접점 종류도 페이지에 없음 |
| E6 | ICB MG90S 3,410 | DM 정품 12,100 (재고 확인 뒤) | ICB **배송 3주 이내**, 취소·반품 불가 [확실 — ICB 페이지] → 11/30에 못 맞춤. 대신 3개에 26,070원 더 듦 |
| E15 | ICB 5817 | 다른 판매처의 공식 RTC 배터리 또는 CR2032 홀더형 | ICB **납기 미정** [확실 — ICB 페이지] |

## 4. 돈을 줄이는 방법 후보 (정하는 건 서현 — 설계가 바뀜)
- [가능성 높음] **볼트·T너트·브래킷이 프레임 값의 절반 가까이** (약 6.8만 ~ 9.2만 원). 브래킷 52개 중 일부를 3D 프린트 코너로 바꾸면 줄어든다. 단 역학계산·CAD를 다시 봐야 함 → 서현 판단
- [가능성 높음] MG90S를 싼 곳에서 사려면 3주를 기다려야 해서 11/30을 넘김 → 그 돈은 정산이 안 될 수 있음
- [추측] 봉은 긴 봉을 사서 학교 실습실에서 자르면 싸지만, 연마봉은 단단해서 자르기 어렵다 (SJ-38 4장)

## 5. 정할 것
| # | 무엇 | 누가 | 왜 지금 |
|---|---|---|---|
| 1 | CAD와 상관없는 전기 부품(비상 정지·MG90S·RTC)을 CAD 전에 먼저 주문할지 | 서현 | 11/10~11/11에 주문해야 11/30에 맞음 |
| 2 | 11/30 뒤에 산 것도 정산되는지, `[해외]` 표시 상품·배송비가 인정되는지 담당자에게 메일 문의 | 서현 (팀장 메일 규칙), 내용 정리는 승준 | 예산·주문 시한이 이 답에 달림 |
| 3 | 예산을 넘으면 무엇을 뺄지 / 자비로 살지 | 서현 + 승준 | 비싸게 사면 약 19만 원 넘음 |
| 4 | Craft-Lab 필라멘트를 학교가 주는지 | 승준이 물어봄 | 0 ~ 25,000원 차이 |
| 5 | L 브래킷 DCB 2025 치수가 CAD 브래킷과 맞는지 | 서현 CAD (C1~C6 중) | 52개라 잘못 사면 큼 |

## 6. 확인 못 한 것
- DM은 상품 페이지에 '판매가 (VAT 별도/포함)'을 같이 적는다. 검색 목록 값은 별도로 보고 ×1.1 했다 [가능성 높음]
- ICB 빛 게이트·로드셀·KW-11-3Z의 납기는 이번에 다시 보지 않았다 (서현 11/06 표의 가격만 씀)
- 네이버 쇼핑은 이 작업 브라우저에서 열 수 없었고, 손도리닷컴은 페이지를 직접 읽지 못해 검색 요약 값만 씀 → T8·커플링·T너트·봉은 승준이 Chrome에서 국내 배송인지(해외직구 아님) 같이 확인
- 쿠팡·G마켓·옥션에는 **해외직구 상품이 섞여 있다** — 주문 전에 '해외직구'·'로켓직구' 표시가 없는지 꼭 확인 (정산 규칙)

## 7. (11/09 보탬) CAD 고침 SJ-53으로 바뀌는 구매 — 승준 (CAP-AI-SJ-53)

서현 요청으로 CAD를 고치면서 살 것이 바뀐다. 자세한 건 Issue #9, `cad/README.md` 맨 아래.

| 바뀐 것 | 개수 | 값 (부가세 포함) | 확실도 | 비고 |
|---|---|---|---|---|
| **카메라 Camera Module 3 (IMX708, 표준) — 사기로 정함 (승준 11/09 00:38)** — DM 상품번호 **14917048** | 1 | **43,780** (39,800 별도) | 확실 (11/09 DM 상품 페이지) | 국내 재고(`[해외]` 아님), 준비 1~2일. AI 카메라(보유)는 최대 30 fps. Pi 4·5용 케이블 들어 있음 (길이는 페이지에 없음) |
| ~~E18 바꿈: FPC 30 cm (DM 15289281, 2,200)~~ → **취소, E18 500 mm 그대로** (11/09 03:10) | — | — | 확실 (서현 계산) | 서현 하네스 계산(꺾어 가는 길 + 여유) Pi 5 → CM3 **330 mm > 300 mm** (Issue #9, CAP-AI-55). 직선은 약 150 mm |
| M5 볼트 → **십자 냄비머리** (육각 렌치 머리 대신) | 그대로 약 135 | M12 줄 값과 비슷 | 추측 | 판매처 '십자 냄비머리 M5 × 8·10·12'로 검색 |
| 28BYJ-48 귀: M4 대신 **M3 × 8 + M3 너트 + M3 와셔** (153은 접시머리 M3 × 8) | 각 6 | M13·M14 줄 안 | 추측 | 서현 M4 결정과 다름 → #9 확인 |
| MG90S 귀 M2 × 8 셀프 탭 | 6 | 0 | 가능성 높음 | MG90S 상자에 들어 있음 |
| 카메라 M2 × 6 (4) · 걸이 M3 × 10 (2) · M3 인서트 +2 (M28 16 → 18) | — | 약 1,000 + 인서트 2개 | 추측 | |
| 기판 나사: M2 × 5 (6) · M2 × 8 (6) · M3 × 5 (2) · M3 × 8 (2) · M2 × 14 (2) · M3 × 12 (2) | 20 | 약 2,000 ~ 4,000 | 추측 | 전부 십자 냄비머리 |
| 나일론 스페이서 M2 (Ø4 × 8) 2 · M3 (Ø6 × 6) 2 + **M2·M3 탭** + 탭 핸들 | — | 미조사 | — | 데크 밑 가로대 위 4자리 (데크 아크릴에 탭) |

→ 늘어나는 돈 약 **4.4만 + 나사·탭 약 1만 ~ 2만 원** [추측]. 남은 돈이 이미 빠듯함(§0).

**카메라 주문 (승준 11/09 결정)** — 카메라 **43,780원** (케이블은 E18 500 mm로 같이 삼). DM은 66,000원(부가세 포함) 넘으면 배송비 0, 아니면 **2,700원**
- 서현 결정 (11/09): **부품 주문·카메라는 서현이 "주문하자" 할 때 한꺼번에** → 같이 사면 배송비 0 (MG90S 3개만 더해도 66,000원 넘음 [가능성 높음 — §2 값])
- 따로 주문하면 46,480원
- 정산: 세부내역 영수증(DM '카드매출전표' 또는 견적서 — 수신자 팀장·팀원 이름), 받으면 **제품 사진**, `purchase/재료비_정산보고서.xlsx`에 한 줄

## 출처 (11/08 확인)
- 디바이스마트 상품 페이지: [MG90S 정품](https://www.devicemart.co.kr/goods/view?no=12503480), [KSEP-2240](https://www.devicemart.co.kr/goods/view?no=15008357), [221-415](https://www.devicemart.co.kr/goods/view?no=10827023), [KS0327](https://www.devicemart.co.kr/goods/view?no=15526404), [로드셀 500 g](https://www.devicemart.co.kr/goods/view?no=1360975), [SZH-AT021](https://www.devicemart.co.kr/goods/view?no=1361314), [F-520](https://www.devicemart.co.kr/goods/view?no=4573), [퓨즈 3 A](https://www.devicemart.co.kr/goods/view?no=4537), [어댑터](https://www.devicemart.co.kr/goods/view?no=15706959) / 검색: LM8UU·LM6UU·LM4UU·HX711·프로파일 브라켓·인서트 M3·비상정지 스위치·만능기판 PCB
- 아이씨뱅큐: [MG90S PP-A221](https://www.icbanq.com/P014373903), [RTC 5817](https://www.icbanq.com/P015998896)
- 2020 프로파일 절단 가격: [11번가 옵션표](http://www.11st.co.kr/products/2600832763), [옥션 아진프로파일 100 mm 540원](https://itempage3.auction.co.kr/DetailView.aspx?itemno=A531983917)
- T8 리드스크류: [손도리닷컴 8파이 리드8](https://www.sondori.com/goods/goods_view.php?goodsNo=1000002008) (검색 요약)
- 정산 규칙: `purchase/2026-10-28_재료비_정산규칙.md` (제품 사진 필수, 11/30 제출, 해외구매 불가)
