britams/-capstone-project-repo/design/2026-11-06_전기부품_구매확정표_서현.md

# 전기 부품 구매 확정표 — 국내 판매처 (1대 기준)

정리: 2026-11-06 20시 · 이서현 (Claude, **CAP-AI-31**, 제어·회로 위임). 구매는 승준(정산 규칙: 국내 판매처, 세부 영수증).
가격은 11/06 판매처 페이지 값 (부가세 포함). 바뀔 수 있음 — 주문 직전에 다시 확인. 링크 페이지에서 가격을 못 읽은 것은 '페이지 확인'.
근거: `design/2026-11-06_제어회로_부품_보유와_구매_서현.md` (가진 것 / 살 것), 회로 BOM `design/circuit/out/bom.csv`

## 0. 결론 먼저
- **[확실 — 판매처 가격] 버튼형 로드셀은 너무 비싸다.** 초소형 버튼형(P2981)이 **145,200원**이다. 막대형 1 kg 로드셀(Adafruit 4540)은 **6,710원**이다.
  - → **막대형(500 g~1 kg)으로 바꾼다** (AI 판단, 서현 위임).
  - 우리 힘은 0.5 N + 바닥 무게 0.19 N ≈ 70 g이다. 500 g이 분해능에 더 좋다 [가능성 높음].
  - **D5f 컵(버튼 Ø12 × 6 자리)은 승준 CAD에서 막대 자리로 바꿔야 한다.** 막대 한쪽 끝은 캐리지 아래에 볼트 2개로 고정하고, 다른 끝 위에 스프링 받침을 둔다 → Issue #7.
- **와고는 221-415 (승준 M22와 같은 것)으로 하되 5개 필요.** 와고에 꽂는 선은 모두 20~22 AWG로 했으므로 221(24~12 AWG)이면 된다 [가능성 높음 — RS 사양]. 가는 서보·게이트 선은 허브 기판에서 받는다. 개수: +5 V 7구(입력·ULN 3·서보 허브·게이트 허브·MOSFET) → 2개 이어 8구, GND 9구(+ UNO 1·2) → 3개 이어 11구. (20:30에 222로 적었다가 승준 CAD·구매와 맞춰 221로 되돌림)
- **[확실 — 판매처 페이지] 판매처에서 못 찾은 것 2개:**
  - 줄(인라인) 퓨즈 홀더 5×20 → 패널형 퓨즈홀더 + 3 A 퓨즈로 대신
  - T2.5A 지연형 퓨즈 → 5×20 3 A로 대신. 어댑터가 3 A라 3 A 퓨즈여도 선(20 AWG)이 견딘다 [가능성 높음]

## 1. 1차 주문 (회로 시험 1~3단계 — 먼저)

| # | 부품 | 수량 | 판매처 · 링크 | 단가 | 메모 |
|---|---|---|---|---|---|
| E1 | 5 V 3 A SMPS 어댑터 (DC 5.5 × 2.1) | 1 | 엘레파츠 [RS power 5V/3A](https://www.eleparts.co.kr/goods/view?no=3190737) / 디바이스마트 [코드 일체형](https://www.devicemart.co.kr/goods/view?no=15706959) | 페이지 확인 | 힘 전기 전용 |
| E2 | DC 잭 5.5 × 2.1 (패널 또는 단자형) | 1 | 디바이스마트 '전원잭' 검색 | 페이지 확인 | 어댑터 플러그 받기 |
| E3 | 줄 퓨즈 홀더 5×20 (승준 M23, 찾으면) 또는 퓨즈홀더 F-520 (패널형) + 퓨즈 5×20 3 A | 1 + 5 | 디바이스마트 [홀더](https://www.devicemart.co.kr/goods/view?no=4573), [퓨즈 3 A](https://www.devicemart.co.kr/goods/view?no=4537) | 페이지 확인 | 인라인 홀더 대신 |
| E4 | 비상 정지 스위치 22파이 (NC 접점) | 1 | 디바이스마트 [KSEP-2240](https://www.devicemart.co.kr/goods/view?no=15008357) | 페이지 확인 | **NC(b접점)인지 확인하고 주문** |
| E5 | 와고 221-415 (5구) | 5 | 디바이스마트 [221-415](https://www.devicemart.co.kr/goods/view?no=10827023) | 페이지 확인 | +5 V 2개, GND 3개 (승준 M22는 2개 → 5개로) |
| E6 | MG90S 메탈기어 서보 | 3 | 아이씨뱅큐 [PP-A221 TowerPro MG90S](https://www.icbanq.com/P014373903) | **3,410원** | 납기 3주 이내 → 빨리. 디바이스마트 [정품](https://www.devicemart.co.kr/goods/view?no=12503480)도 있음 |
| E7 | IR 빛 게이트 3 mm (Adafruit 2167) — 통로 G1·G4·G6 | 3 (+1 예비) | 아이씨뱅큐 [2167](https://www.icbanq.com/P007530136) | **3,608원** | 21시: 문 빔은 낱개로 (승준 SJ-47 — 문 틈 5 mm). **보유 0 확인 (승준 SJ-49, 11/06 밤) → 4개 삼** |
| E7b | 적외선 LED 3 mm 940 nm — 문 빔 송신 | 6 (+4) | 아이씨뱅큐 [940 nm 3파이](https://www.icbanq.com/P002255886) | 페이지 확인 | 220 Ω 직렬 (약 17 mA) |
| E7c | 포토트랜지스터 3 mm 940 nm, 검은 몸통 (햇빛 거름) — 문 빔 수신 | 6 (+4) | 디바이스마트 [포토 트랜지스터 목록](https://www.devicemart.co.kr/goods/catalog?code=000200050007)에서 3 mm·940 nm 확인 | 페이지 확인 | 예: Everlight PT333-3B, Vishay TEFT4300 같은 것 [가능성 높음] |
| E8 | 만능기판 소형 + 핀 헤더 | 2 + 1 | 디바이스마트 '만능기판' 검색 | 페이지 확인 | 서보 허브, 게이트 허브 |
| E9 | 전해 커패시터 1000 µF 10 V 이상 | 1~2 | 디바이스마트 | 페이지 확인 | 키트에 있으면 빼기 |

## 2. 2차 주문 (회로 4단계 — 움직임)

| # | 부품 | 수량 | 판매처 · 링크 | 단가 | 메모 |
|---|---|---|---|---|---|
| E10 | 28BYJ-48 + ULN2003 3개입 팩 | 1 팩 | 디바이스마트 [KS0327 3개입](https://www.devicemart.co.kr/goods/view?no=15526404) | 페이지 확인 | 보유 1 + 3 = 4 (예비 1) |
| E11 | 막대형 로드셀 500 g 또는 1 kg | 1 (+1 예비) | 디바이스마트 [500 g Al Beam](https://www.devicemart.co.kr/goods/view?no=1360975) / 아이씨뱅큐 [Adafruit 4540 1 kg](https://www.icbanq.com/P013154465) | 1 kg: **6,710원** | 버튼형 P2981은 145,200원이라 뺌 |
| E12 | HX711 모듈 | 1 (+1) | 디바이스마트 [SZH-SSBH-054](https://www.devicemart.co.kr/1327397/related/) / 메카솔루션 [HX711](https://www.mechasolution.com/goods/goods_view.php?goodsNo=127743) | 페이지 확인 | RATE 다리를 5 V로 (80 Hz) — 납땜 필요할 수 있음 |
| E13 | 마이크로(리미트) 스위치 KW-11-3Z | 3 (+2) | 아이씨뱅큐 [KW-11-3Z 롤](https://www.icbanq.com/P014161692) | **660원** | 롤러형. 레버형이 필요하면 디바이스마트 [KW-10](https://www.devicemart.co.kr/goods/view?no=13764) |

## 3. 3차 주문 (나중)

| # | 부품 | 수량 | 판매처 · 링크 | 단가 | 메모 |
|---|---|---|---|---|---|
| E14 | MOSFET 모듈 4채널 (IRF540N) | 1 | 디바이스마트 [SZH-AT021](https://www.devicemart.co.kr/goods/view?no=1361314) | 페이지 확인 | 3채널 씀 (조명 2 + 송신 1). IRF540N은 로직 레벨이 아님 — 5 V 구동이면 0.3 A 정도 부하는 됨 [가능성 높음]. 걱정되면 DFRobot [DFR0457](https://www.devicemart.co.kr/goods/view?no=1328149) ×3 |
| E15 | Pi 5 RTC 배터리 (공식) | 1 | 아이씨뱅큐 [Adafruit 5817](https://www.icbanq.com/P015998896) | **13,200원** | 납기 미정 → 일찍 주문. 디바이스마트·메카솔루션은 CR2032 홀더형도 있음 |
| E16 | 조명 LED (위 링·아래) | 2 | 미정 | — | 사양은 비전(승준)과 같이 |
| E17 | 실리콘 연선 20·22·26·28 AWG, JST-XH·듀폰 커넥터 | — | 디바이스마트 | — | 조립 단계. 하네스 11/07 확정: 20 AWG 1.6 · 22 AWG 5.0 · 24 AWG 2.6 · 26 AWG 12.7 · 28 AWG 23.2 m (× 1.5로 삼) |
| E18 | Pi 5 카메라 FFC 22↔15핀 **500 mm** | 1 | 판매처 '라즈베리파이 5 카메라 케이블 500mm' | 페이지 확인 | 11/07 D5g 자리로 계산하면 필요 약 320 mm > 동봉 300 mm (CAP-AI-38) |

## 3-1. 배터리 상자 (현장 시험 날짜가 정해지면, 11/06 22시 CAP-AI-35)
`design/2026-11-06_배터리상자_회로_서현.md` 5장 B1~B11. 특히 **INA226은 R010(0.01 Ω) 모듈** — 흔한 R100은 0.82 A까지만 잼.

## 4. 대략 금액 (가격을 읽은 것만)
- MG90S 3 × 3,410 = 10,230원
- 빛 게이트 2167 4 × 3,608 = 14,432원 (문 빔 낱개 LED·포토TR은 개당 수백 원 [추측])
- KW-11-3Z 5 × 660 = 3,300원
- 로드셀 1 kg 2 × 6,710 = 13,420원
- RTC 배터리 13,200원
- **합 약 54,600원** + 페이지 확인 항목 (어댑터·퓨즈·비상 정지·와고·모터 팩·HX711·MOSFET·기판) [추측: 4~6만 원]

## 5. 승준에게 부탁
1. 1차 주문을 먼저. 특히 MG90S(납기 3주), RTC 배터리(납기 미정).
2. 비상 정지는 **NC(b접점)** 인지 상세 페이지에서 확인.
3. 로드셀을 막대형으로 바꾼 것을 D5g 캐리지·컵 설계에 반영 (막대 외형·볼트 구멍은 산 제품 치수로).
