britams/-capstone-project-repo/purchase/2026-11-06_기계부품_구매상세_McMaster대조.md

# 기계 구매 부품 상세 — D5e 모델에서 잰 길이 + McMaster 대조 (승준)

정리: 2026-11-06 15:24~16:14 · 이승준 (Claude와 정리, CAP-AI-SJ-38)
근거: FreeCAD에서 `cad/D5e_full_assembly.py`를 승준 PC에서 그대로 실행해 잰 값, `purchase/cad_parts/sj_purchased_parts.py`(이번에 만든 부품 라이브러리 + 대조 검사)
나눈 일: **전기·회로 부품은 서현 BOM**(`design/circuit/out/bom.csv`, CAP-AI-23) / **기계 부품(봉·나사·베어링·커플링·볼트·프레임)은 이 파일**

---

## 1. 쉽게 말하면 — 이번에 Claude가 한 일

우리 기계는 레고처럼 **직접 만드는 조각**(3D 프린터로 뽑는 판·상자)과 **사야 하는 조각**(쇠막대, 나사막대, 작은 베어링 같은 것)으로 되어 있어요.
사야 하는 조각은 가게에서 파는 크기가 정해져 있어서, 우리 그림(CAD)에 그린 크기와 **딱 맞아야** 해요. 안 맞으면 사 와도 안 들어가요.

그래서 이렇게 했어요.

1. **그림을 직접 재 봤어요.** 서현이 만든 전체 조립 그림(D5e)을 승준 컴퓨터의 FreeCAD에 열고, 사야 하는 조각마다 길이와 굵기를 컴퓨터로 쟀어요. 자로 재는 것과 같은데, 0.1 mm까지 정확해요.
2. **틀린 곳을 찾았어요.** 10월 28일에 만든 구매 목록과 비교하니 **쇠막대 길이 2개가 틀렸고**, **목록에 아예 없는 막대가 2종류** 있었어요. (2장 표에 ★로 표시)
3. **"가게 크기 그대로" 그림을 따로 그렸어요.** 사야 하는 조각 14가지를 파는 크기 그대로 그려서 FreeCAD에 한 줄로 세워 놨어요(문서 이름 `SJ_purchased_parts`). 베어링에는 고정 링이 끼는 홈까지 그렸어요.
4. **우리 그림과 가게 크기를 맞대 봤어요.** 컴퓨터가 20군데를 비교했는데 **20군데 모두 맞았어요(OK).** 즉, 지금 그림에 그려진 크기대로 사면 들어가요.
5. **McMaster(미국 부품 가게 카탈로그)도 찾아봤어요.** 중요한 걸 하나 알게 됐어요: **McMaster에는 우리가 쓰는 T8 나사(한 바퀴에 8 mm 가는 것)가 없어요.** 가장 비슷한 건 한 바퀴에 10 mm 가는 플라스틱 너트(품번 2391N11)예요. 그래서 T8은 국내 3D 프린터 부품 가게에서 사야 해요.
6. **McMaster에서는 살 수 없어요.** 우리 재료비 규칙이 "해외 구매 안 됨"이라서요. McMaster는 **크기를 확인하고 CAD를 받는 사전**으로만 쓰고, 물건은 같은 크기로 국내에서 사요.

## 2. 사야 하는 기계 부품 (1대 기준, D5e 모델에서 잼)

| # | 부품 | 규격 (정확한 크기) | 개수 | 어디에 | 모델 대조 | McMaster | 비고 |
|---|---|---|---|---|---|---|---|
| M1 | 직선 볼 부싱 **LM8UU** | 축 Ø8, 바깥 Ø15, 길이 24, 링 홈 간격 17.5 | 2 | X 빔 222 | OK | 'Metal Linear Bearings' → 축 8 mm·ball·metric 필터 (품번은 브라우저에서) | 표준 규격 [확실] |
| M2 | 직선 볼 부싱 **LM6UU** | 축 Ø6, 바깥 Ø12, 길이 19, 링 홈 간격 13.5 | 2 | Y 캐리지 221 | OK | 같은 페이지, 축 6 mm | [확실] |
| M3 | 연마봉 Ø8 ★ | **163 mm** (예전 목록 155 → 틀림) | 2 | X 봉 213 | OK | 'Linear Motion Shafts' 8 mm | 긴 봉을 사서 자르거나 163 맞춤 절단 주문 |
| M4 | 연마봉 Ø6 ★ | **124 mm** (예전 목록 106 → 틀림) | 2 | Y 봉 207 | OK | 같은 곳 6 mm | 맞춤 절단 |
| M5 | 봉 Ø4 ★ **목록에 없었음** | 108 mm | 1 | 바닥 캐리지 돌림 막이 157 | OK | 같은 곳 4 mm | 새로 추가 |
| M6 | 핀 Ø3 ★ **목록에 없었음** | 69 mm | 2 | 펜 홀더 안내 핀 223 | OK | 'Dowel pins' 또는 Ø3 봉 | PTFE 테이프 감음 (D6 10장) |
| M7 | T8 리드스크루 (Tr8×8, 4줄, 리드 8) | 80 / 93 / 133 mm | 각 1 | 바닥 155 / X 214 / Y 208 | OK | **없음** (가장 가까운 것 2391N11, 리드 10) | 100 mm 2개 + 150 mm 1개를 사서 자르기 [가능성 높음] |
| M8 | T8 황동 플랜지 너트 | 플랜지 Ø22×3.5, 몸통 Ø10.2, 길이 15, 구멍 4×Ø3.5 (PCD 16) | 3 | 159 / 225 / 224 | OK | 없음 | 보통 나사와 한 세트로 팜 |
| M9 | 커플링 5→8 mm | Ø19.1 × 25.4 (국내 'D19L25 5×8') | 3 | 154 / 216 / 210 | OK | **4147N159** (서현 근거) | 28BYJ-48 축 Ø5 ↔ T8 Ø8 |
| M10 | 2020 알루미늄 프로파일 (홈 6) | **610 mm × 4, 320 mm × 21** (합계 9.16 m, 약 4.1 kg). 단면: 홈 입구 6.2, 깊이 6.1, 가운데 Ø4.2 (D5g) | 25토막 | 프레임 100 | D5g 단면 0.452 kg/m · 0.717 cm⁴ = 데이터시트 | 20 mm 시리즈 (품번 못 읽음) | 맞춤 절단 주문이 편함 |
| M11 | 2020 L 브래킷 (다이캐스트, 리브) | 다리 20 × 20, 폭 18, 두께 3.5, 구멍 Ø5.5 [가능성 높음] | 32 | 100e (D5g) | 겹침 0 | | 미스미 짝 LCNBS6-2028 |
| M12 | **M5 × 8** 볼트 + 2020(홈 6)용 M5 슬라이드 T너트 | 볼트 ISO 4762 (11/06 저녁 10 → 8, 미스미 짝 E-GSCB5-8). T너트 10 × 9.5 × 4.5 [가능성 높음 — 판매처 표기] | 각 64 | 100f·100g (D5g) | 64개 모두 홈 안, 겹침 0 | | 프로파일과 **같은 회사** T너트 사기 |
| M13 | M3 × 10 볼트 + M3 너트 | ISO 4762 | 각 12 | T8 너트 3개 × 4구멍 | — | | |
| M14 | 28BYJ-48 고정 나사 | 귀 구멍 Ø4.2, 간격 35 → **M4 × 8** [확실 — 서현 결정, Issue #7] | 6 | 모터 3개 × 2 | — | | |
| M15 | 마이크로 스위치 (원점) | KW11-3Z 레버형 20×10.2×6.4, 구멍 Ø2.3 간격 9.5 [가능성 높음] | 3 | X·Y·바닥 아래 끝 | — | 'Snap-Acting Switches' | 서현 BOM에도 있음 → **한 번만 사기** |
| M16 | 압축 스프링 (바닥 완충 146) | 바깥 Ø9, 안 Ø6, 자유 길이 10 (모델 값) | 1 | 바닥 밀대 | — | 'Compression springs' | 힘(k)은 아직 안 정함 → 서현 확인 |

| M17 | 팰컨 50 mL 원뿔 튜브 (코닝 352070 또는 같은 규격 국산) | Ø29.72 × 114.55 | 2 (+ 예비) | 급이 144n | 겹침 0 | | 설탕물 통, 거꾸로 꽂음 |
| M18 | 치과용 코튼롤 2호 | Ø10 × 38 | 1봉 (갈아 끼움) | 급이 142n | 겹침 0 | | 심지 |
| M19 | M5 × 12 볼트 + T너트 | ISO 4762 | 2 | 급이 기둥 발 (발 3 + 데크 5) | | | |
| M20 | M5 × 8 볼트 + T너트 (추가분) | | 4 | ULN 받침 197 × 2 | | | M12와 같은 물건 → 합계 68 |
| M21 | M2.5 × 5 황동 기둥 + M2.5 × 5 나사 | | 12 + 12 | ULN2003 보드 3장 | | | Pi는 선반 셀프 탭 M2.5 × 4 |

| M22 | 와고 레버 커넥터 221-415 (5구) | 29.9 × 18.6 × 8.3 [가능성 높음] | 2 (+ 예비 1) | 193w (+5 V 줄 / GND 줄) | 겹침 0 | | 11/06 20:23 단자대·퓨즈 기판 대신 (승준 결정) |
| M23 | 줄 퓨즈 홀더 5×20 + 퓨즈 T2.5A | 전선 중간에 매달림 → 데크 자리 없음 | 1 (+ 퓨즈 예비 2) | 어댑터 + 전선 | | | 몸통 치수는 판매 페이지에 없음 → 사서 재기 |
| M24 | M3 기둥 5 mm × 3 / 15 mm × 2 (육각 5) + 15 mm × 1 (외경 4 이하 원형) + M3 나사 | 공식 STEP으로 확인 | 3 / 3 | UNO 1·2 (헤더 옆 구멍은 못 씀 → 3점) | 겹침 0 | | 11/06 20:45 사이 12 → 15 |

| M25 | 3 mm 적외선 LED (940 nm) + 3 mm 적외선 수광 소자 (포토트랜지스터) | 렌즈 Ø3, 테 Ø3.8 (벽 구멍 Ø4.2에 꽂음) | 각 6 (+ 예비 2) | 문 게이트 G2·G2b·G3·G3b·G5·G5b | 겹침 0 | | 문 하우징 사이 틈 5 mm → 2167 안 들어감 (11/06 20:35) |
| M26 | Adafruit 2167 빛 게이트 (3 mm) | 송·수신 각 20 × 10 × 8, 선 230 mm [가능성 높음] | **3쌍 (+1 예비) 새로 삼** — 보유 0 (11/06 밤 고침: '보유 6쌍'은 틀림, 구매 계획 6쌍이었음. 서현 Issue #7 확인) | 통로 게이트 G1·G4·G6 | 겹침 0 | | 회로 BOM 9쌍 → 3쌍 + 낱개 6쌍 |
| M27 | 비상 정지 버튼 22 mm 버섯형 NC (XB7NS8442 같은 것) | 머리 Ø40, 깊이 72, 판 구멍 Ø22.3 [가능성 높음] | 1 | 194, 프레임 x −170 쪽 레일 바깥 판 194b | 겹침 0 | | 데크 아래는 차양막이라 데크 구멍 불가 |
| M28 | 열 압입 인서트 M3 × 0.5 (황동, 설치 길이 4.3, 구멍 Ø4.0, 최소 살 두께 5.1) | McMaster 페이지 표 [확실] | 14 (+ 예비, 50개 1봉) | 급이 143 (뚜껑 4·벽 보스 2), 데크 위 옆판 151 (4)·칼라 102 (4) | | **94459A130** (50개 $10.91) | 인두로 눌러 넣음 (팁 McMaster 'Soldering Installation Tips') |
| M29 | 손나사 M3 × 8 (머리 Ø8 × 5, 18-8 스테인리스) | [확실 — McMaster 표] | 4 | 급이 뚜껑 143l (공구 없이 열어 코튼롤 갈기) | | **92545A111** ($1.73/개) | |
| M30 | 육각 구멍 볼트 M3 × 8 / M3 × 10 (18-8) | 머리 Ø5.5 × 3 [확실] | 2 / 11 | M3 × 8: 급이 물길 → 마킹실 벽 보스 / M3 × 10: 데크 아래에서 옆판·칼라 (8), 와고 받침 (3, 너트) | | **91292A112** / **91292A113** (100개) | |
| M31 | 막대 로드셀 1 kg (Adafruit 4540) | 80 × 12.7 × 12.7, 한쪽 2-M4 · 다른 쪽 2-M5 관통 탭, 끝에서 5·20 [치수 확실, 구멍 가능성 높음 — 데이터시트 그림] | 1 (+1) | 148 (캐리지 팔 158a 아래, +y로 뻗음) | | 없음 (서현 구매확정표 E11, 아이씨뱅큐) | 버튼형 대신 (서현 CAP-AI-36) |
| M32 | M4 × 10 / M5 × 12 볼트 (18-8) | | 1 / 2 | 로드셀 자유 끝 받침판 148s / 고정 끝 → 캐리지 팔 | | **91292A116** / **91292A125** | |
| M33 | M5 × 10 볼트 + T너트 (추가) | | 10 + 10 | 위판 105 (4)·데크 101 (4)·X 봉 받침 218 (4 — 아래 줄) | | 91292A124 | M12 T너트와 같은 물건 |
| M34 | M5 × 8 볼트 + T너트 (추가) | | 6 + 6 | 217 X 모터판 (2), 199a Pi 선반 (2), 194b 비상 정지 판 (2) | | | M12와 같은 물건 |
| M35 | 2020 L 브래킷 + M5 × 8 + T너트 (T 이음 추가) | M11·M12와 같은 물건 | 20 + 40 + 40 | 가로대 100c 4개 양 끝·갠트리 레일 100d 양 끝 (끝마다 옆면 2개) | 겹침 0 | | 11/06 밤: 승준 지적으로 추가 → 브래킷 합계 52, 볼트·T너트 합계 각 104 (+ M33·M34) |
| M36 | 50 mL 원뿔 튜브 (PP, Ø30 × 114.3, 입구 안 27) | [확실 — McMaster 표] | M17과 같은 물건 | 144n | | **7979T44** (25개 $23.79) | 국산 팰컨 튜브와 같은 규격 |

**빼는 것 (11/06 20:23)**: PCB용 단자대 PT 1,5 4핀 × 2, PCB용 퓨즈 홀더 FX0457, 만능기판 — 와고로 바꿈. 출구 조명 LED — 없앰 (SJ-45).

**안 사는 것**: 펜 홀더 스프링 204 — 11/02에 빼기로 함 (D6 10장). 모델에는 아직 남아 있음 → D5f에서 지움.
**전기 부품**(모터·서보·센서·빛 게이트·전원)은 서현 BOM에 있어서 여기 안 적음 (28BYJ-48 ×3, MG90S ×3, SG90 ×1, 로드셀 등).

## 3. CAD 파일 — 사람이 받아야 하는 것

FreeCAD에서 Claude가 판매 규격대로 직접 그렸으니 **지금 설계에는 따로 받을 필요가 없어요.** 다만 "진짜 제조사 모양"으로 바꾸고 싶으면 아래를 **승준이 브라우저로 받아야** 해요. McMaster 페이지는 자바스크립트로 그려져 Claude가 품번 목록을 다 읽지 못했어요 (11/06 확인).

| 무엇 | 어디서 | 어떻게 |
|---|---|---|
| 커플링 4147N159 STEP | mcmaster.com 에서 `4147N159` 검색 → 제품 줄 클릭 → 오른쪽 **CAD → 3-D STEP** → Download | 로그인 없이 되는 경우가 많음. 안 되면 로그인 |
| LM8UU·LM6UU 비슷한 볼 부싱 STEP | 'Metal Linear Bearings' → System: Metric, Shaft 8 mm(6 mm), Bearing Type: Ball → 바깥 15(12)·길이 24(19) 줄 | 같은 방법. 품번을 이 표에 적어 주세요 |
| 2020 프로파일·브래킷 STEP | 미스미 코리아 HFS5-2020 (국내 구매처라 정산도 됨) | 미스미는 **회원가입·로그인 필요** |
| 28BYJ-48, SG90, MG90S | 이미 서현 D5e 모델에 외형도 치수로 들어 있음 | 받을 것 없음 |

받은 STEP 파일은 `purchase/cad_parts/step/` 에 올리면 다음 Claude가 FreeCAD에서 바꿔 끼워요 (25 MB 넘으면 올리지 않기).

## 4. 승준이 나중에 할 일 (순서대로)

1. **주문 전 가격 조사** — 2장 M1~M16을 국내 판매처(디바이스마트, 엘레파츠, 미스미 코리아, 쿠팡)에서 찾아 **가격·링크**를 이 표 옆에 적기. 남은 예산 **369,990원** (구매장부 기준). 해외 판매처·중고는 안 됨.
2. **봉 자르기 방법 정하기** — Ø8×163, Ø6×124, Ø4×108, Ø3×69는 딱 맞는 길이로 팔지 않을 수 있어요. ① 맞춤 절단 파는 곳(미스미 등)에서 사기 ② 긴 봉을 사서 학교 실습실에서 쇠톱으로 자르고 끝을 줄로 다듬기. 연마봉은 단단해서 ②가 힘들 수 있어요.
3. **T8 나사도 마찬가지** — 100 mm 2개(80·93으로 자름) + 150 mm 1개(133으로 자름). 자르면 끝 나사산을 줄로 다듬어야 너트가 들어가요.
4. **마이크로 스위치는 한 번만** — 서현 전기 BOM에도 3개가 있어요. 같은 물건이니 한 번만 사요.
5. **2020 프로파일 맞춤 절단 주문** — 610 mm 4개 + 320 mm 21개. 절단 주문 시 오차 ±0.5 mm 이내인지 확인.
6. **McMaster STEP 받기 (선택)** — 3장 표 순서대로. 받으면 품번을 2장 McMaster 칸에 적어 주세요.
7. **물건이 오면 캘리퍼스로 재기** — 특히 LM8UU 바깥 Ø15, 커플링 구멍 5·8, T8 너트 플랜지 Ø22. 다르면 이 파일에 적고 서현에게 알리기.

## 5. 물어볼 것 (급하지 않음)

1. **몇 대 만들지** (1대 / 2대) — 2대면 2장 개수가 전부 2배. 아직 서현 결정 대기.
2. **바닥 스프링 146의 힘** — 지금 모델은 크기만 있고 단단한 정도(k)가 없어요. 서현 S4 값이 정해지면 그때 고르기.
3. ~~28BYJ-48 고정 나사~~ — 서현이 **M4 × 2**로 정함 (11/06, Issue #7). 끝.

## 6. 다시 하는 법 (Claude용)
FreeCAD 파이썬 콘솔에서 레포 `cad/`와 `purchase/cad_parts/`를 경로에 넣고:
`import D5e_full_assembly as A; A.make_full(); import sj_purchased_parts as P; P.check(); P.make_library()`
→ `check()`가 20줄 모두 OK면 그림과 구매 규격이 맞는 것 (11/06 결과: 20/20 OK).
