britams/-capstone-project-repo/design/2026-11-06_제어회로_부품_보유와_구매_서현.md

# 제어·회로 부품 — 가진 것, 산 것, 살 것 (1대 기준)

> 판매처·가격·링크는 `design/2026-11-06_전기부품_구매확정표_서현.md` (11/06 20시)

정리: 2026-11-06 · 이서현 (Claude, **CAP-AI-29**)

**근거**
- 보유 사진 판독 `inventory/2026-10-28_보유물품_목록과_활용계획.md`
- 승준 J2 점검 `purchase/2026-10-28_구매후보_J2결과.md`
- 구매목록 `purchase/2026-10-28_구매목록_총정리.md`, 구매장부 `purchase/구매장부.md`
- 회로 BOM `design/circuit/out/bom.csv`

**표기**
- **보유** = 이미 있음, **구매함** = 장부에 있음(주문함), **살 것** = 아직 없음
- [확실] 상자·라벨·장부로 확인 / [가능성 높음] 사진 생김새 / [실물 확인] 개수·모델을 직접 세어야 함

> ⚠ 11/06에 고친 것: 회로 BOM에 **HX711 + 로드셀**과 **빛 게이트**를 '보유'로 잘못 적었다. 둘 다 **아직 없음** → 살 것.

## 1. 한눈에

| 구분 | 개수 |
|---|---|
| 이미 있는 것 (그대로 씀) | Pi 5, AI HAT+, AI 카메라, microSD, UNO, 28BYJ-48 1세트, SG90 1, MG90S 1, 브레드보드·점퍼선, 저항·커패시터 키트, 릴레이 모듈 |
| 주문함 | Pi 27 W 어댑터, Pi 액티브 쿨러 |
| **꼭 사야 하는 것** | 28BYJ-48 세트 2, MG90S 3, HX711 + 로드셀, 빛 게이트 3쌍 + 문 빔 낱개 6쌍, 원점 스위치 3, 5 V 3 A 어댑터 + DC 잭, 줄 퓨즈·비상 정지·와고 5, Pi RTC 배터리 |
| 나중에 사도 되는 것 | MOSFET 모듈 3 (처음엔 릴레이로), 조명 LED, 실리콘 전선·커넥터, 배터리 상자 |

## 2. 자세히 — 회로도에 쓰는 것

### 머리 (판단)
| 부품 | 필요 | 가진 것 | 상태 | 메모 |
|---|---|---|---|---|
| Raspberry Pi 5 (4 GB) | 1 | 1 | **보유** [확실] | |
| AI HAT+ (Hailo 26 TOPS) | 1 | 1 | **보유** [확실] | PCIe 케이블이 HAT에 꽂혀 있음 (10/28) |
| AI 카메라 (IMX500) | 1 | 1 | **보유** [확실] | 동봉 케이블 길이 확인 → 300 mm 필요 (Pi가 위판 아래) |
| microSD 32 GB | 1 | 2 | **보유** | |
| Pi 27 W USB-C 어댑터 (공식) | 1 | 1 | **구매함** (10/28, 장부 3) | |
| Pi 5 액티브 쿨러 | 1 | 1 | **구매함** (장부 4) | |
| Pi 5 RTC 배터리 (공식 충전식) | 1 | 0 | **살 것** | 전원이 꺼져도 날짜 기억 → 여왕벌 계절 규칙 |

### 손 (아두이노 2개와 구동기)
| 부품 | 필요 | 가진 것 | 상태 | 메모 |
|---|---|---|---|---|
| Arduino UNO | 2 | 4 (정품 1 + 호환) | **보유** [가능성 높음] | 2개는 예비 |
| USB A-B 케이블 | 2 | ? | [실물 확인] | Pi ↔ UNO |
| 28BYJ-48 + ULN2003 | 3 | 1 | **살 것 2** | 바닥 F, 마커 X·Y |
| SG90 서보 | 1 | 1 (키트) | **보유** [실물 확인] | 펜 들기 |
| MG90S 서보 | 3 | 1 (혼 없음) | **살 것 3** | 문 3개. 가진 1개는 예비 |
| HX711 + 막대형 로드셀 500 g~1 kg | 1 | 0 | **살 것** | 버튼형은 145,200원이라 막대형(6,710원)으로 (11/06) — 구매확정표 E11 |
| 원점 마이크로 스위치 KW11-3Z | 3 | 0 | **살 것** | 처음 시험은 키트 택트 버튼으로 대신 가능 |

### 문지기·불 (UNO 2 쪽)
| 부품 | 필요 | 가진 것 | 상태 | 메모 |
|---|---|---|---|---|
| IR 빛 게이트 Adafruit 2167 (통로 G1·G4·G6) | 3쌍 | 0 | **살 것 3 (+1)** | 문 빔 6쌍은 낱개로 바뀜 (11/06 21시) |
| 적외선 LED 3 mm 940 nm + 포토트랜지스터 3 mm 940 nm + 220 Ω | 6쌍 | 0 | **살 것 6 (+4)** | 문 빔 (문 사이 틈 5 mm) |
| 로직 레벨 MOSFET 모듈 | 3 | 0 | 나중 | 처음엔 **보유 릴레이 모듈**(2채널 ×2, 1채널 1~2)로 켜고 끄기. 밝기 조절은 안 됨 |
| 조명 LED (위·아래) | 2 | 0 | 나중 | 출구 조명은 없앰 (승준 SJ-45, 11/06) |
| 저항 10 kΩ | 10 | 키트 | **보유** [실물 확인] | 빛 게이트 풀업 |
| 커패시터 100 nF / 1000 µF | 4 / 1 | 키트 | [실물 확인] | 1000 µF가 키트에 없으면 살 것 |

### 전기 길 (안전)
| 부품 | 필요 | 가진 것 | 상태 | 메모 |
|---|---|---|---|---|
| 5 V 3 A 어댑터 + DC 잭 5.5 × 2.1 | 1 | 0 | **살 것** | 모터·서보 전용 (구매목록 G2) |
| 퓨즈홀더 F-520 + 퓨즈 5×20 3 A | 1 | 0 | **살 것** | 인라인 홀더·T2.5A는 국내에서 못 찾음 (구매확정표 E3) |
| 비상 정지 버튼 (NC, 눌러 끊김) | 1 | 0 | **살 것** | |
| 와고 레버 커넥터 221-415 (5구) | 5 | 0 | **살 것** | 단자대 대신: +5 V 2개, GND 3개 |
| 만능기판 소형 + 핀 헤더 | 2 | 0 | **살 것** | 서보 허브, 게이트 허브 (풀업 9개) |
| 브레드보드, 점퍼선 | — | 있음 | **보유** | 시험 단계는 이걸로 |
| 실리콘 연선 26·28 AWG, JST-XH·듀폰 커넥터 | — | 0 | 나중 | 조립 단계 |
| (선택) 배터리 상자 20 Ah | 1 | 0 | 나중 | 현장 시험 날짜가 정해지면 |

## 3. 가지고 있지만 이번 회로에 안 쓰는 것
- Raspberry Pi 4 (2호기 후보), Pi 3, L298N 모터 드라이버 (예비)
- DHT11 온습도 (잉크 건조 기록에 쓸 수도), LCD 1602·OLED (현장 표시 — 핀이 모자라서 지금은 안 씀), RTC 모듈 (Pi 5 내장 RTC를 씀)
- 사운드 센서, IR 리모컨, RFID, 키패드 등 학습 키트 부품

## 4. 사는 순서 (시험 순서와 맞춤)
1. **먼저 (회로 1~3단계 시험):** 5 V 3 A 어댑터 + DC 잭, 줄 퓨즈, 비상 정지, 와고 221-415 5개, 만능기판 2, MG90S 3, 빛 게이트 9쌍
2. **다음 (4단계):** 28BYJ-48 세트 2, 원점 스위치 3, HX711 + 로드셀
3. **나중:** MOSFET 모듈 3, 조명, 실리콘 전선·커넥터, RTC 배터리, 배터리 상자

구매 담당은 승준이고 정산 규칙(국내 판매처, 세부 영수증)을 따른다 → `docs/2026-11-06_승준_작업지시.md` 2-1.
**실물 확인 부탁 (서현 또는 승준):** UNO 개수, SG90, USB A-B 케이블, 키트 안 10 kΩ·100 nF·1000 µF 개수.
