britams/-capstone-project-repo/cad/2026-11-06_D5g_부품분류_구매품과_설계품.md

# D5g 부품 분류 — 사는 것 vs 우리가 설계할 것 (승준, 2026-11-06, CAP-AI-SJ-39)

스크립트: `cad/D5g_frame_detail.py` (D5f 조립을 그대로 만들고 ① 2020 프레임을 실제 제품 모양으로 ② 모든 부품을 4묶음으로 나눠 색칠)
FreeCAD에서: `import D5g_frame_detail as G; doc = G.make(); print(G.section_check(), G.check(doc)); G.bom(doc)`

## 0. 한눈에 (FreeCAD 모델 트리의 묶음 이름과 같음)

| 묶음 | 색 | 뜻 | 개수 |
|---|---|---|---|
| **A 구매품 (실제 제품)** | 회색·은색 | 가게에서 파는 그대로 산다. 모양을 우리가 바꾸지 않는다 | 73 → **83** (저녁: 팰컨 튜브·코튼롤·ULN2003 보드·기둥·볼트·T너트 추가) |
| **B 우리가 설계할 것** | 주황 | 3D 프린트하거나 판을 잘라 만든다. **승준이 상세 설계** | 42 → **46** (143 급이 물길, 197 보드 받침 × 2, 199a Pi 선반, 199b·c 게이트 받침 / 144·142 상자 뺌) |
| C 참고: 상용 트랩·말벌 | 반투명 초록 | 이미 산 트랩과 말벌 크기. 고치지 않음 | 10 |
| D 자리 표시 (전기) | 보라 | 단자대·비상 정지·빛 게이트 — 지금은 상자로 자리만. 실제는 구매품 | 21 → **18** (ULN2003 3개는 판매품 모양으로 A에) |

비유: 레고 세트에서 **A는 상자에 들어 있는 정해진 블록**(바꿀 수 없음), **B는 우리가 직접 깎아 만드는 블록**(크기·구멍을 우리가 정함)이에요. B가 A를 잡아 주는 모양이 되어야 해서, A 치수를 먼저 정확히 알고 B를 그려요.

## 1. 2020 프레임 — 이번에 '실제 제품'으로 다시 그림

예전(D5e): 20 × 20 사각 막대에 홈 자리만 네모로 판 모양, 브래킷은 L자 판, 볼트·너트 없음.
지금(D5g):

| 부품 | 치수 | 근거 |
|---|---|---|
| 2020 프로파일 단면 | 20 × 20, 홈 입구 **6.2**, 입구 턱 **1.8**, 언더컷 폭 **11.0** (턱 아래 2.2 곧게) → 사다리꼴로 깊이 **6.1**에서 코어 **7.4**, 가운데 **Ø4.2** (M5 탭) | 2020 슬롯 6 데이터시트(홈 6.2·깊이 6.1·0.50 kg/m·0.72 cm⁴), 미스미 LCF6-2020(0.45~0.47 kg/m) |
| → 계산 대조 | 단면적 167.4 mm² → **0.452 kg/m**, 단면 2차 모멘트 **0.717 cm⁴** | 데이터시트 0.45~0.50 kg/m, 0.72 cm⁴ → **맞음** [확실, `section_check()`] |
| 길이 | 610 × 4 (기둥), 320 × 21 (레일·가로대·갠트리 받침) — 합계 9.16 m, 약 4.1 kg | D5e cut_list |
| L 브래킷 | 다리 20 × 20, 폭 18, 두께 3.5, 양옆 리브 2, 홈 키 5.6 × 1.0, 구멍 Ø5.5 (모서리에서 12) | 국내 판매 '2020 코너 브래킷' 대표 치수 [가능성 높음 — 실물 확인] |
| 볼트 | **M5 × 8** 육각 구멍붙이 (ISO 4762), 브래킷당 2 → **64개** | 미스미가 브래킷 짝으로 정한 길이(E-GSCB5-8). 예전 목록 M5 × 10 → 8로 바꿈 |
| T너트 | 2020(홈 6)용 **M5 슬라이드 T너트 10 × 9.5 × 4.5** (아래 경사) → 브래킷 64 + 받침 6 = **70개** | 판매처 표기 [가능성 높음]. 볼 스프링 너트(미스미 LCNHRN6-20-5)도 됨 |
| 검사 | 프레임 ↔ 브래킷·볼트·T너트·다른 모든 부품 겹침 **0건**, T너트 64개 모두 홈 안 | `check(doc)` [확실, 모델 기준] |

**McMaster**: 20 mm 시리즈 페이지가 필터만 보여 줘서 품번·단면 숫자를 못 읽었어요. 단면은 위 두 데이터시트로 맞추고 무게·강성 계산으로 확인했어요. 미국 구매라 어차피 정산이 안 되니 **국내 2020(홈 6) 아무 회사 제품**을 사면 되고, 회사마다 언더컷이 ±0.5 mm 달라도 T너트만 그 회사 것을 쓰면 돼요.

## 2. A 구매품 73개 — 무엇을 사나 (모델 이름 → 사는 물건)

| 모델 속 이름 | 사는 물건 | 표 |
|---|---|---|
| 100a~100d (25) / 100e / 100f / 100g | 2020 프로파일 25토막 / L 브래킷 32 / M5 × 8 볼트 64 / M5 T너트 64 | 위 1장 |
| 153·209·215 (+ r 축) | 28BYJ-48 스테핑 모터 3 (+ M4 볼트 6) | 전기 BOM |
| 154·210·216 | 커플링 5 → 8 (Ø19 × 25) 3 | purchase 11/06 M9 |
| 155·208·214 / 159·224·225 | T8 리드스크루 80·133·93 / T8 황동 너트 3 | M7·M8 |
| 157 / 207 / 213 / 223 | 봉 Ø4 × 108 / Ø6 × 124 × 2 / Ø8 × 163 × 2 / 핀 Ø3 × 69 × 2 | M3~M6 |
| 221 / 222 / 149 | LM6UU 2 / LM8UU 2 / LM4UU 1 | M1·M2, 작업지시 2-1 |
| 147 / 146 / 148 | Ø4 × 80 경화 축 h6 / 압축 스프링(카탈로그, 7조건 통과품) / 버튼 로드셀 | 작업지시 2-1 |
| 112·170·176 servo·spline·horn / 205 | MG90S 3 (혼 포함) / SG90 1 | 전기 BOM |
| 114 / 180 / 182 / 190 / 191·192 / 201 | 입구 빛 센서 / AI 카메라 / 링 조명 / Pi 5 + AI HAT+ / UNO 2 / 마커 | 전기 BOM, 마커 Issue #3 |

## 3. B 우리가 설계할 것 42개 — 승준이 상세 설계 (크기는 지금 모델 값)

| 무리 | 부품 (모델 이름) | 지금 크기 (mm) | 상세 설계에서 할 일 |
|---|---|---|---|
| 큰 판 | 101 데크 230 × 180 × 5, 105 위판 140 × 180 × 5 | 프린터보다 클 수 있음 | **프린터 판 크기 확인** → 넘으면 아크릴·MDF 레이저 절단. 2020에 붙일 M5 구멍·T너트 자리 |
| 트랩 잇기 | 102 칼라, 104 돔 커플링 | Ø100 × 15, Ø90 × 10 | 상용 트랩 실측(Issue #2)에 맞춘 끼움 틈 0.3 |
| 통로 | 110·172·174 덕트, 111·173 깔때기, 175 한쪽 문 | | 말벌 통로 안쪽 매끈하게(지지대 없이 프린트되는 방향) |
| 문 3개 | 112·170·176 하우징·판(flap)·기둥(post) | 하우징 12 × 47 × 23, 판 두께 1.5 | MG90S 고정 나사 자리(M2), 빛 게이트 Ø4.2 구멍(D5f), 판 돌쩌귀 |
| 마킹실 | 120 벽, 121 바닥, 130 격자, 140 승강 바닥 | 46 × 46 | 격자 눈 3.0 / 피치 4.4 / 두께 1.5 → 프린트 가능한지 시험 출력 |
| 바닥 승강 | 151 옆판 L·R, 152 모터판, 158 캐리지(+ 컵) | | LM4UU 압입 구멍(Ø8 −0.05), 로드셀 컵, T8 너트 M3 × 4 자리 |
| 먹이 | 143 급이 물길·그릇·기둥 (142·144 상자 대신) | 물길 안 폭 12, 그릇 안 Ø35 | `design/2026-11-06_급이방_개념설계_ULN보드_승준.md` — 팰컨 50 mL 거꾸로 + 코튼롤 2호 (구매) |
| 마커 X·Y | 206 Y 캐리지, 211·217 모터 브래킷, 212 빔 끝 블록, 218 봉 받침, 202 V블록, 203 띠, 219 뚜껑 컵, 220 컵 받침 | | LM8UU·LM6UU 압입 또는 케이블 타이 홈, 봉 고정(M3 무두나사), 28BYJ-48 M4 × 2 |
| 카메라 | 181 카메라 받침 | 20 × 3 × 10 | AI 카메라 장착 구멍(M2 × 4) — 실물 확인 |

## 4. 다음 순서 (제안)
1. **실물 재기**: 브래킷·T너트·로드셀·버튼 크기 (위 [가능성 높음] 값) → `D5g_frame_detail.py`의 `BR`·`TNUT` 값만 바꾸면 다시 그려짐
2. **B 상세 설계는 '구매품을 잡는 곳'부터**: 158 캐리지(LM4UU·로드셀·T8 너트) → 문 하우징 3개(MG90S) → 212·218(봉·LM8UU) 순서
3. 프린터 판 크기, 재료(PLA/PETG) 정하기 — 101·105가 프린터에 들어가는지
