britams/-capstone-project-repo/purchase/2026-10-28_구매목록_총정리.md

# 구매 목록 총정리 (1대 기준)

정리: 2026-10-28 20시 · 이승준 (Claude와 정리, CAP-AI-SJ-11)
근거: J2 보유품 점검(`inventory/` 4·5장), 승준 작업지시 J7 품목(서현 10/28 갱신), `design/2026-10-28_D5_개념설계_안1.md` **10장(4차 안 B, 현재 기준)**
이 파일이 `purchase/2026-10-28_구매후보_J2결과.md`를 대신한다 (그 파일의 POSCA 마커는 서현 10-5에서 빠짐).
가격은 아직 안 넣음 — 주문 직전 확인해 J7 예산 장부(50만 원)에 적는다. 2대 만들면 ★ 표시 품목은 2배.

> **정산 규칙 (CAP-AI-SJ-16)**: 지원 50만 원, 해외구매·중고 불가, 사무·전산용품·공구 불인정 → `purchase/2026-10-28_재료비_정산규칙.md`. **캘리퍼스(A3)는 공구라 불인정 가능성 높음 → 대여.** **예산 50만 원 확정, 정산 담당 승준.** 주문 기록은 `purchase/재료비_정산보고서.xlsx`.

> **11/06 갱신 (CAP-AI-SJ-38)**: 기계 부품(C장) 길이·개수는 `purchase/2026-11-06_기계부품_구매상세_McMaster대조.md`가 맞다 — Ø8 봉 155 → **163**, Ø6 봉 106 → **124**, Ø4×108·Ø3×69 추가, T8 80/93/133. 전기 부품은 서현 `design/circuit/out/bom.csv`.

## A. 지금 주문 (설계와 관계없이 확정)

| # | 품목 | 수량 | 용도 | 구입처 | 근거 |
|---|---|---|---|---|---|
| A1 | ★ **Raspberry Pi 27W USB-C 전원 어댑터 (공식, 5.1V 5A)** | 1 | Pi 5 + AI HAT+ + 카메라 전원. 케이블 일체(1.2 m) → USB-C 케이블 따로 불필요 | 디바이스마트 [공식 정품 27W](https://www.devicemart.co.kr/goods/view?no=15502416) (품절 시 [호환 PD 27W KC](https://www.devicemart.co.kr/goods/view?no=15434559)) | J2: 없음 [확실] |
| A2 | ★ **Raspberry Pi 5 Active Cooler (공식)** | 1 | AI HAT+ **아래**에 붙는 방열판+팬. 보유 팬 뚜껑은 HAT와 같이 못 씀 (승준 판단 10/28) | 디바이스마트 [정품 액티브 쿨러](https://www.devicemart.co.kr/goods/view?no=15276241) | J2 [확실] |
| A3 | **디지털 버니어 캘리퍼스 150 mm** | 1 | 포획통 결합부 104 측정 ±0.1 mm, 표본·마커 측정 | 공구 상점 | 서현 "우선 구매" — **실험실에서 빌리면 생략** (승준 10/28 대여 예정이라고 함) |
| A4 | **샤피 크리에이티브 수성 아크릴 마커 불렛 팁 5색 (빨강·노랑·초록·파랑·보라) — 노랑 사용** | 1세트 | 마커 201 (흔들기·펌핑 없음, 수성 아크릴, 불렛 팁) | 쿠팡 [5색 1세트 8,600원, 로켓](https://www.coupang.com/vp/products/9191849728) (10/28 20:21 화면) | **10/28 결정 (사용자가 서현이라고 밝힘, 승준 계정 채팅), 흰색 불필요** — CAP-AI-SJ-15. **10/29 구매함: 5색 대신 12색 세트 18,870원 (영수증6, 구매장부 순번 9)** |
| A5 | ~~퍼마페이크 / 샤피 흰색~~ | — | A4로 대체 | — | 10/28 결정으로 뺌 |

마커는 국내(쿠팡)로 바뀌어 직구 불필요. 9-7 기준 "흰색 또는 노랑" 중 **노랑**을 씀.

### A-1. 마커 국내 대안 (승준 "퍼마페이크 구하기 어려움", CAP-AI-SJ-12) — **서현 결정 대기**
서현 조건(D5 9-7·10-5): 수성 안료, 불투명 흰색, 둥근 팁 1~2 mm, **흔들기·펌핑 없음**.
[확실] 국내에서 쉽게 사는 흰색 페인트마커(POSCA, 모나미 마커스 프로 등)는 흰 안료가 가라앉아 **흔들어 쓰는 밸브식**이 대부분 — 조건을 다 맞는 국내 제품은 이번 검색으로 못 찾음.

| 안 | 제품 | 조건 | 국내 구입 | 걸리는 점 |
|---|---|---|---|---|
| ① | uni POSCA PC-3M 화이트 (0.9–1.3 mm) | 펌핑 **필요** | 화방넷·쿠팡 등 (품절 여부 확인) | 서현 9-8의 원래 1순위, 양봉 여왕벌 표시펜으로 팔림 [확실]. 안 B는 캡 컵 바닥에 눌러 펌핑 가능 (서현 9-8 주의), 아침에 흔들기 필요 |
| ② | 흰색 젤펜 (예: 유니볼 시그노 화이트) | 흔들기·펌핑 없음 | 문구점·핫트랙스 (0.7 mm 화이트는 10/28 품절 표시) | [추측] 볼 팁이라 **수직으로 콕 찍으면 볼이 안 굴러 잉크가 거의 안 나올 수 있음**, 곤충에 쓴 실적 못 찾음 → 점 시험 필수 |
| ③ | 퍼마페이크 해외 직구 그대로 | 조건 충족 | 직구 (1~3주) | 시간 |

추가 조사 (승준 "퍼마페이크 비슷한 것, 가격 무관", CAP-AI-SJ-13):
- [가능성 높음] 펠트·둥근 팁 + 불투명 흰색 + **흔들기 없는** 마커는 퍼마페이크가 거의 유일한 축 — 흰색 펜 61종 비교 리뷰(sarahrenaeclark.com)에서도 불투명 흰색 상위는 POSCA(밸브식)·젤펜·샤피였음
- 가장 가까운 대안 = **샤피 크리에이티브 마커**(수성 아크릴, 흔들기·프라이밍 불필요, 서현 2순위) — 국내 판매처는 이번에도 못 찾음 → 해외 구매
- 국내에서 바로 사는 흔들기 없는 흰색 = **젤펜**: 유니볼 시그노 브로드(UM-153, 1.0 mm, 리뷰 불투명도 5/5), 펜텔 하이브리드 젤 그립 DX 1.0 (4.5/5) — 볼 팁 찍기 문제는 ②와 같음
- 가격 무관이면 **퍼마페이크 자체를 해외 판매처에서 빠른 국제 배송(특송)으로** 사는 것이 조건에 가장 맞음 (판매처 국제 배송 여부·배송비는 주문 시 확인)

제안 [가능성 높음]: ①·②를 국내에서 싸게 1~2개씩 사서 **더미에 점 찍기 시험**을 먼저 하고, ③은 서현이 꼭 필요하다고 하면 직구.

### A-2. microSD 카드 리더 (승준 10/28 "그냥 사자", CAP-AI-SJ-21)
| 품목 | 수량 | 용도 | 구입처 후보 | 정산 |
|---|---|---|---|---|
| USB microSD 카드 리더 (USB 3.0) | 1 | PC에서 Pi 5용 OS를 microSD에 설치 | 디바이스마트 [티피링크 UA440C](https://www.devicemart.co.kr/goods/view?no=15829087) 등 — PC 포트(USB-A/C)에 맞는 것 | **[가능성 높음] 전산용품 → 재료비 정산에 넣지 않음 (개인 구매)** |

## B. 구동 시험용 — 지금 사도 되지만 D6에서 바뀔 수 있음 (J6)

안 B 구동기 7개 = 스테핑 3 (바닥 153, 마커 X 215, 마커 Y 209) + 서보 4 (문 112·170·176, 펜 들기 205). 보유: 28BYJ-48+ULN2003 1세트, MG90S 1 (혼 없음).

| # | 품목 | 살 수량 | 용도 | 걸리는 점 |
|---|---|---|---|---|
| B1 | ★ 28BYJ-48 + ULN2003 세트 | **2** (보유 1과 합쳐 3) | 바닥 153, 마커 X 215·Y 209 | [가능성 높음] 28BYJ-48 + T8 ≈ 2 mm/s라 R6(3분) 초과 우려 → D6에서 **NEMA17 등으로 바뀔 수 있음** (D5 10-6). 값이 싸서 시험용으로 먼저 사도 손해 작음 |
| B2 | ★ MG90S 서보 (혼·나사 포함) | **3** | 문 112·170·176 | 보유 MG90S(혼 없음)는 예비 |
| B3 | ★ SG90 서보 | **1** | Z 펜 들기 205 | 서현 지정 |

## C. 기구 부품 — 치수 확정(D6·CAD) 뒤 주문

| # | 품목 | 수량 (서현 D5 10장 잠정) | 용도 |
|---|---|---|---|
| C1 | ★ T8 리드스크루 + 너트 (약 100 mm, 130 mm) | 2세트 | 마커 X 214·Y 208 (바닥 승강용은 D6에서) |
| C2 | ★ 축 커플링 5 → 8 mm | 2 | 28BYJ-48 축(5 mm) ↔ T8 |
| C3 | ★ 연마봉 Ø8 약 155 mm / Ø6 약 106 mm | 각 2 | X 고정 봉 213 / Y 봉 207 |
| C4 | ★ 알루미늄 프로파일 2020 + 코너 브래킷 + T너트·볼트 | 길이·개수는 CAD에서 | 프레임 100, 갠트리 단 (둘레 4 + 받침 1) |
| C5 | 실리콘 캡 컵 | 1 | 마커 대기 캡 219 |
| C6 | 스프링 (압축) | D6 후 | 완충 146, 홀더 204 |
| C7 | 미끄러운 플라스틱 판 (PTFE·POM·HDPE 중) + 투명 아크릴 | D6 후 | 마킹실 120 |
| C8 | 3D 프린터 필라멘트 | — | Craft-Lab에서 제공되는지 먼저 확인 |

## D. 센서·조명 — D6 뒤 사양 확정

| # | 품목 | 수량 | 용도 |
|---|---|---|---|
| D1 | ★ 적외선 빔(브레이크 빔) 센서 | 1~2 | 진입 감지 114 |
| D2 | ★ 로드셀(소형) + HX711 | 1 | 바닥 미는 힘 148 |
| D3 | ★ 촬영 조명 LED (흰색, 확산판) | 1 | 조명 182 (새벽 운용) |

## G. 제어부 추가 — SJ-24 제안 (서현 D6 결정 뒤 주문)
근거: `control/2026-10-28_제어부_구성_신뢰성_AI마킹.md` 6·7장 (아두이노 2개로 나눔, 속도 안 ③). 가격은 주문 직전 확인.

| # | 품목 | 수량 | 용도 | 비고 |
|---|---|---|---|---|
| G1 | ★ 마이크로 스위치 (원점) | 3 | 바닥 F·마커 X·Y 원점 | 서현 3차 원점 스위치와 같은 품목, 배선만 UNO 1로 |
| G2 | ★ 5 V 3 A 어댑터 + DC 잭 | 1 | 서보·센서 전원 | 인터페이스 3차 값 |
| G3 | ★ (안 ③) NEMA17 스테핑 (42 × 42 mm, 약 0.3 kg) | 2~3 | X·Y(·바닥) | 고르면 B1(28BYJ-48 2세트) 안 사도 됨 — 서현 S4 무게 다시 |
| G4 | ★ (안 ③) TMC2209 또는 A4988 드라이버 모듈 | 2~3 | 스텝·방향 구동 | 핀이 축당 2개로 줄어듦 |
| G5 | ★ (안 ③) 12 V 2~3 A 어댑터 | 1 | 스테핑 전원 | |
| G6 | 5 mm LED + 포토레지스터 (또는 D1 빔 센서 추가) | 3~6쌍 | 통로 빛 게이트 (입구·격리·방생) | 보유 포토레지스터 3으로 먼저 시험 |
| G7 | 아래 조명 LED 띠 + 반투명 판 | 1 | 말벌이 등을 위로 하게 유도 | 행동 시험 뒤 |
| G8 | 가는 팁(약 1 mm) 수성 아크릴 마커 | 1 | 샤피 불렛과 점 크기 비교 (J9) | 제품 아직 안 찾음 |

## E. 안 사도 되는 것 (보유)
microSD 32 GB ×2, AI Camera Pi 5용 케이블, AI HAT+ PCIe 케이블(HAT에 꽂혀 있음 — 10/28 확인), 마이크로 HDMI 케이블, 아두이노 UNO 4 (승준 말로 5개 안팎 — 제어부는 2개 + 예비), L298N(예비), 릴레이, 점퍼선·브레드보드.

## F. 정할 것
1. 2대(P3 두 대 시연)를 만들지 → ★ 품목 수량 2배
2. A3 캘리퍼스: 구매 vs 실험실 대여 (서현과 합의)
3. B1 스테핑: 28BYJ-48로 시험 먼저 할지, D6 결과를 기다릴지
4. 예산 장부 시작 — 주문하면 날짜·품목·금액·영수증 위치를 `purchase/`에 기록
