britams/-capstone-project-repo/purchase/2026-10-28_구매후보_J2결과.md

# 구매 후보 — J2 보유품 점검 결과 (BOM 초안 전 단계)

> **지난 판** — 최신은 `purchase/2026-10-28_구매목록_총정리.md` (D5 4차 반영, POSCA 마커 제외). CAP-AI-SJ-11

정리: 2026-10-28 · 이승준 (Claude와 정리, CAP-AI-SJ-10) · 근거: `inventory/2026-10-28_보유물품_목록과_활용계획.md` 5장
상태: **후보** — 기구 쪽 수량·사양은 서현 D6(설계 변수표) 뒤 J7 BOM에서 확정. 가격은 주문 직전에 다시 확인.

| 우선 | 품목 | 수량 | 이유 | 구입처 후보 | 판정 |
|---|---|---|---|---|---|
| 필수 | **Raspberry Pi 27W USB-C 전원 어댑터 (공식 정품, 5.1V 5A)** | 1 (2호기 만들면 2) | Pi 5 + AI HAT+ + 카메라 전력. 휴대폰 충전기는 5A 미지원 → 전류 제한 | 디바이스마트 [공식 정품 27W 검은색](https://www.devicemart.co.kr/goods/view?no=15502416) (KC 인증 표기, 5.1V/5A, 케이블 1.2 m) | [확실] 사양은 상품 페이지 / 가격 미확인 |
| 대안 | 호환 PD 27W 어댑터 (KC, 5V 5A 표기) | 1 | 공식품 품절 시 | 디바이스마트 [호환 27W](https://www.devicemart.co.kr/goods/view?no=15434559), 엘레파츠·아이씨뱅큐 HT-PD27W-KC | [가능성 높음] 공식품이 더 안전 |
| 확인 후 | Raspberry Pi 5 Active Cooler (공식) | 1 | AI HAT+ 아래에 들어가는 방열판·팬. 보유 팬 뚜껑이 HAT와 같이 안 들어가면 필요 | 디바이스마트 등 | [가능성 높음] |
| 확인 후 | AI HAT+ PCIe 리본 케이블 | 0 (HAT 아랫면에 있으면) | 없으면 HAT를 못 씀 | — | 승준 확인 |
| J6 | 서보 MG90S (혼·나사 포함) | 2~3 | 입구 문 112, 분기 문 170 + 예비. 보유 1개는 혼 없음 | 디바이스마트·엘레파츠 | 수량은 D6 후 |
| J6 | 스테핑 28BYJ-48 + ULN2003 세트 | 1~2 | 바닥 구동 150, 마커 구동 164 (보유 1세트) | 위와 같음 | 리드스크루 방식은 D6 후 |
| 서현 지정 (우선) | 디지털 버니어 캘리퍼스 | 1 | 결합부 104 측정 ±0.1 mm (실측표 h·D2·D3). 실험실에서 빌리면 생략 가능 | — | 승준작업지시 J7 (서현 10/28) |
| 서현 지정 | uni POSCA PC-3M 화이트 ×3 + PC-5M 화이트 ×1 | 4 | 마커 160 | 링크: `design/2026-10-28_D5_개념설계_안1.md` 9-8 | 서현 CAP-AI-15 |
| 서현 지정 | 알루미늄 프로파일 2020 + 코너 브래킷·T너트 | D6 후 | 프레임 100 (바닥에 섬) | — | 서현 D5 7장 |

보유해서 안 사도 되는 것: microSD 32 GB ×2, AI Camera Pi 5용 케이블, 마이크로 HDMI 케이블, L298N(예비), 아두이노 UNO 4.
