britams/-capstone-project-repo/inventory/2026-10-28_보유물품_목록과_활용계획.md

# 보유 물품 목록과 활용 계획

정리일: 2026-10-28 · 근거: 서현 PC `capstone design_이서현\지금가지고 있는 물품\`의 사진 14장·스캔 3장 (사진으로 판독, 수량·모델은 실물 확인 필요) · CAP-AI-03
표기: [확실] 상자·라벨로 확인 / [가능성 높음] 생김새로 판단 / [추측] 확인 필요

## 1. 목록

### 비전·연산
| 물품 | 수량 | 사양 | 판독 | 활용 |
|---|---|---|---|---|
| Raspberry Pi 5 (4GB) | 1 | 상자 | [확실] | **주 제어·비전 컴퓨터** (판별, 상태 머신, 기록, 알림) |
| Raspberry Pi AI HAT+ (Hailo, 26 TOPS) | 1 | Pi 5 전용 | [확실] | YOLO 추론 가속 → VespAI 모델을 빠르게 돌림. 단 YOLOv5(PyTorch) → Hailo 형식(HEF) 변환 필요 |
| Raspberry Pi AI Camera (Sony IMX500) | 1 | 센서 안에서 AI 추론 | [확실] | 주 카메라 후보. 근접 촬영(흉부 표식 확인) 가능 여부·초점 거리 시험 필요 |
| Raspberry Pi 4 Model B | 1 | 마이크로 HDMI 2개, USB-C | [가능성 높음] | **2호기** (P3 두 대 시연) 또는 개발·시험용 |
| Raspberry Pi 3 Model B | 1 | 전체 크기 HDMI, 마이크로 USB | [가능성 높음] | AI엔 부족 → 로그 서버·통신 시험용 정도 |

### 제어·구동
| 물품 | 수량 | 판독 | 활용 |
|---|---|---|---|
| Arduino UNO (정품 1 + 호환품 여러 개) | 약 4~5 | [가능성 높음] | 구동기·센서 실시간 제어 (Pi와 시리얼 통신). 1대당 1개, 나머지는 시험용 |
| 9g 서보 (SG90 계열, 학습 키트) | 1 | [가능성 높음] | 문·셔터 시험용. 플라스틱 기어라 반복 마킹 구동엔 약함 → 금속 기어(MG90S 등) 구매 검토 |
| 스테핑 모터 + 드라이버 (28BYJ-48 + ULN2003 계열, 키트) | 1 | [가능성 높음] | 느린 직선 이송(리드스크루) 시험 |
| 릴레이 모듈 2채널 5V (DEVICEMART SZH-EK074) | 2 | [확실] 라벨 | 조명·펌프 등 켜고 끄기 |
| 미니 릴레이 1채널 5V (SZH-EK082) + 키트 1채널 | 1~2 | [확실] 라벨 | 위와 같음 |

### 센서·표시 (학습 키트 「Arduino Upgraded Learning Kit」)
| 물품 | 활용 후보 |
|---|---|
| 포토레지스터 ×3 | 낮·밤 판단, 빛 방향 실험 (말벌이 밝은 쪽으로 가는 습성) |
| 온습도 센서 (DHT11 계열) | 마커 건조 조건 기록 |
| 사운드 센서 | 날갯짓 소리로 진입 감지 시험 [추측 — 효과 미확인] |
| IR 수신기 + 리모컨 | 현장 수동 조작 |
| LCD 1602 (I2C), 0.96" OLED | 현장 상태 표시 |
| RTC 모듈 | 아두이노 시각 기록 (Pi 5는 RTC 내장) |
| 버튼 ×5, 부저, LED, 가변저항, 조이스틱, 브레드보드(MB-102 등), 점퍼선, 저항·커패시터 키트, 74HC595, LM35 | 시제품 회로 |
| 수위 센서 | 먹이·유인액 잔량 감지 |
| RFID(RC522), 키패드, 7세그먼트, 도트 매트릭스, 불꽃 센서 | 사용 계획 없음 |

### 기타
| 물품 | 활용 |
|---|---|
| **야생 말벌 포획기 ((주)야생)** | ① 설계 참고 제품 (`design/2026-10-28_D0_재설계_전제와_절차.md` 3장) ② **레트로핏 모듈의 바탕 (10/28 확정)** ③ **표본 채집 도구** |
| USB 케이블, HDMI 꺾임 젠더, 볼트·너트, 점퍼 와이어 키트 | 배선·조립 |

## 2. 활용 판단
- [가능성 높음] **비전 쪽은 추가 구매가 거의 필요 없다.** Pi 5 + AI HAT+ + AI 카메라면 VespAI급 판별에 충분하고, Pi 4로 2호기를 만들 수 있다.
- [가능성 높음] 구매는 **기구·소모품 쪽**에 집중된다: 금속 기어 서보, 적외선 빔 센서(진입 감지 — 키트의 IR 수신기는 리모컨용이라 해당 안 됨), 촬영용 LED 조명, 수성 아크릴 마커, 스프링, 투명 아크릴, 필라멘트, Pi 5 전원(27W)·microSD(보유 여부 확인), 표본 보관 용기.
- [추측] AI HAT+와 AI 카메라는 둘 다 AI 가속기라 하나만 써도 될 수 있다. 어느 쪽으로 모델을 돌릴지는 할 일 ②(VespAI 실행)에서 정한다.

## 3. 확인할 것
- Pi 5 전원 어댑터(27W USB-C), microSD 카드, Pi 5 케이스·쿨러 보유 여부
- 서보·스테핑 모터 실제 개수
- 정체를 모르는 봉지: YwRobot 커패시터 키트 외 파란 봉지 1개

---

## 4. J2 실물 점검 1차 — 2026-10-28 사진 (승준, CAP-AI-SJ-06)

근거: 승준이 10/28 14:34에 보유품을 펼쳐 찍은 사진 4장 (`지금가지고 있는 물품\20261028_1434xx`). 3장과 같은 표기.

### 4-1. 사진으로 확인된 것
| 물품 | 수량 | 판독 | 1장과 달라진 점 |
|---|---|---|---|
| Raspberry Pi 5 4GB **상자** | 1 | [확실] 상자 라벨 | 보드 자체는 상자 안이라 안 보임 → 개봉 확인 필요 |
| AI HAT+ (Hailo 26 TOPS) 상자 | 1 | [확실] | — |
| AI Camera (IMX500) 상자 | 1 | [확실] | — |
| Raspberry Pi 4 Model B (방열판 부착) | 1 | [가능성 높음] 마이크로 HDMI 2개·USB-C | 1장과 같음 |
| Raspberry Pi 3 Model B | 1 | [가능성 높음] 전체 크기 HDMI·마이크로 USB | 1장과 같음 |
| Arduino UNO | **4** (정품 1 + 정전기 봉투 2 + 호환품(파란색) 1) | [가능성 높음] | 1장의 "약 4~5" → 4 |
| 릴레이 2채널 (SZH-EK074) | 1봉지 (라벨 2EA) | [확실] 라벨 | — |
| 미니 릴레이 1채널 (SZH-EK082) | 1봉지 (라벨 2EA) + 상자 안 1채널 1 | [확실] 라벨 | 1채널 합계 최대 3 |
| HDMI 꺾임 젠더 / USB 꺾임 젠더 | 2 / 1 | [가능성 높음] | — |
| USB 2.0 케이블 (A–B, 아두이노용) | 2 (1.5 m 표기 1) | [가능성 높음] | — |
| 점퍼 와이어 키트(점프선 정리함), 듀폰 점퍼선 묶음 | 각 1 | [확실] | — |
| YwRobot 커패시터 키트 (KIT04001) | 1 | [확실] 라벨 | 1장 "정체 모르는 봉지" 중 하나 |
| 너트 봉지 ("5" 표시) | 1 | [확실] | — |
| Arduino Upgraded Learning Kit (브레드보드 MB-102, OLED, 부저, 가변저항 등) | 1 | [확실] | — |

### 4-2. 사진으로 확인 못 한 것 — **실물을 열어 봐야 함**
| 물품 | 왜 필요 | 없으면 |
|---|---|---|
| **Pi 5 전원 어댑터 (27W USB-C, 5V 5A)** | Pi 5 + AI HAT+ + 카메라 안정 동작 | J7 구매 (필수) |
| **microSD 카드 (32 GB 이상)** | OS·VespAI 설치 | J7 구매 (필수) |
| Pi 5용 카메라 케이블 (22핀 미니) | Pi 5 카메라 포트는 Pi 4와 다름 | [가능성 높음] AI Camera 상자에 들어 있음 → 개봉 확인 |
| **서보 (SG90) 개수** | 문 112·170 시험 (J6) | 학습 키트 카드에 그림은 있으나 실물 안 보임 |
| **스테핑 모터 28BYJ-48 + ULN2003 개수** | 바닥 150·마커 164 시험 (J6) | 위와 같음 |
| Pi 5 쿨러·케이스 | AI 추론 시 발열 | 권장 구매 |
| 상자(파란 줄무늬) 안 빨간 기판 | — | 정체 미확인 (모터 드라이버일 수 있음 [추측]) |

## 5. J2 실물 점검 2차 — 2026-10-28 개봉 확인 (승준, CAP-AI-SJ-10)

| 항목 | 결과 | 판정 | 조치 |
|---|---|---|---|
| microSD | **32 GB × 2** | [확실] 승준 확인 | 1장 Pi 5용, 1장 예비(Pi 4) — 구매 불필요 |
| Pi 5 전원 어댑터 (27W) | **없음** | [확실] | **구매 필수** → `purchase/` |
| Pi 5 보드 (4GB) | 있음 | [확실] | — |
| AI Camera 케이블 | 2개: 넓은–좁은(Pi 5용) 1 + 넓은–넓은(Pi 4·3용) 1 | [확실] | 구매 불필요 |
| AI HAT+ 구성품 | 기판·40핀 헤더·기둥·나사 있음, **PCIe 리본 케이블 못 찾음** | [가능성 높음] 케이블은 HAT 기판 **아랫면에 이미 꽂혀 출고**됨 (공식 안내: 설치 때 HAT에서 빼서 Pi 쪽에 꽂음) | 기판 아랫면 확인. **카메라 케이블(22핀)로 대체 불가** — PCIe는 16핀 |
| 서보 | **MG90S 1개** (금속 기어), 혼(날개) 없음 | [확실] | 문 112·170용 2개 이상 필요 → 혼 포함 서보 추가 구매 |
| 스테핑 모터 28BYJ-48 / ULN2003 | 각 1 | [확실] | 바닥 150·마커 164용 2세트 필요 → 1세트 추가 |
| 키트 "MOTOR" | = 스테핑 모터 (위와 같은 것) | [확실] 승준 확인 | — |
| 쿨러 | **40 mm 5V 팬(4선)이 달린 케이스 뚜껑** (사진) | [가능성 높음] 공식 Pi 5 Active Cooler가 아님 | AI HAT+는 위에 얹히므로 **방열판형 Active Cooler(HAT 아래)** 가 맞음. 이 뚜껑이 Pi 5 케이스용인지, AI HAT+와 같이 들어가는지 확인 |
| 마이크로 HDMI 케이블 | 1 | [확실] | — |
| USB-C 케이블 | 없음 | [확실] | 공식 27W 어댑터는 케이블 포함 → 별도 구매 불필요 |
| 빨간 기판 (11번) | **L298N 듀얼 H-브리지 모터 드라이버** (HW 표기, 78M05 레귤레이터, OUT1~4, +12V/GND/+5V) | [확실] 인쇄 글자 | DC 모터 2개 또는 바이폴라 스테핑 1개 구동. 28BYJ-48은 ULN2003으로 충분 → 예비 |
