britams/-capstone-project-repo/purchase/부품정리_2026-11-15.xlsx

Sheet: 요약
부품 정리 — 말벌 자동 마킹 트랩 (2026-11-15)
항목 | 원 | 근거
예산 한도 (총, 지원 50만 + 자비) | 1000000 | 서현 11/14 23:17 '100 안쪽으로'
지원금 한도 | 500000 | 정산규칙
이미 쓴 돈 (정산) | 130010 | purchase/구매장부.md (10/29까지)
1차 주문 — 정산 가능 | 250762 | 시트 1차주문_전기리프트
1차 주문 — 자비 (빛 게이트) | 15180 | 해외 → 정산 안 됨
리프트 나사 | 4434 | 시트 리프트_나사
주문 제작 (1순위 어림) | 38000 | 시트 주문제작 — 추측
2차 기계 (지금 CAD로 셈 — 시트 2차주문_기계) | 215210 | 개수 확실, 단가 일부 추측. '아직_못사는것' 시트 9가지는 아직 값 없음
프린트 부품 45개 출력 대행 | 118132 | 시트 출력목록 — cm³당 값은 추측
총 어림 (이미 쓴 돈 포함) | 771728
남는 돈 (100만 원 기준) | 228272
지원금 넘는 돈 (자비) | 271728
할 일 (사람이)
1. 11/16(월) 디바이스마트·아이씨뱅큐 주문·결제 — 1차주문 시트 + 리프트_나사 시트 (같은 디바이스마트 장바구니에 넣으면 배송비 0)
2. 아크릴몰에 '2 mm 투명, 100 × 90' 주문 + 옵션 '도면전달' → 300pf_아크릴_묶음_100x90_2T.dxf 메일
3. 원클릭팩토리에 300_마킹실상자.stl 올려 견적·주문 (윗면이 아래로 = 뒤집어 출력하라고 적기)
4. 받으면 제품 사진 (정산 필수), 영수증 '카드매출전표' 저장, 11/30 정산 서류
5. mightyZAP 힘 줄이기: UNO 1에 zap_setup 올려 숫자 입력 (design/circuit/firmware/zap_setup)
6. 원클릭팩토리에 '주문제작 파일\프린트_32' 폴더 STL 45개(프린트_32 + 프린트_추가13)를 같이 올려 견적 → 출력목록 시트 값 고침
남은 설계 (Claude): 2차 기계 목록 (프레임·봉·T8·베어링·나사)

Sheet: 1차주문_전기리프트
1차 주문 — 전기·리프트·급이 (11/16 월 주문)
파란 글씨 = 바꿔도 되는 값 (개수·단가). 금액 = 개수 × 단가. 아이씨뱅큐 값은 목록의 부가세 별도 × 1.1. 값: 11/14 23시 판매처 페이지.
구분 | 품목 | 규격·메모 | 판매처 | 상품번호 | 링크 | 개수 | 단가 (원, 부가세 포함) | 금액 (원) | 준비 기간 | 정산 | 값 근거 | 링크 확인
전기 | 라즈베리파이 카메라 모듈 3 | IMX708 표준 — 승준 11/09 결정 | 디바이스마트 | 14917048 | https://www.devicemart.co.kr/goods/view?no=14917048 | 1 | 43780 | 43780 | 1~2일 | 가능 | 확실 | 열림 확인 11/15 00시 (페이지 제목 일치)
전기 | 5 V 3 A 어댑터 | 구동 레일 +5V_B | 디바이스마트 | 15706959 | https://www.devicemart.co.kr/goods/view?no=15706959 | 1 | 6380 | 6380 | 3~4일 | 가능 | 확실 | 열림 확인 11/15 00시 (페이지 제목 일치)
전기 | 와고 221-415 (5핀) | 전원 나누기 | 디바이스마트 | 10827023 | https://www.devicemart.co.kr/goods/view?no=10827023 | 5 | 990 | 4950 | 2~3일 | 가능 | 확실 | 열림 확인 11/15 00시 (페이지 제목 일치)
전기 | MOSFET 4채널 SZH-AT021 | 조명 2·송신·펌프 Q1~Q4 | 디바이스마트 | 1361314 | https://www.devicemart.co.kr/goods/view?no=1361314 | 1 | 3850 | 3850 | 3~4일 | 가능 | 확실 | 열림 확인 11/15 00시 (페이지 제목 일치)
리프트 | MT3608 승압 모듈 | 5→7.4 V(mightyZAP) · 5→12 V(펌프) · 예비 | 디바이스마트 | 1342935 | https://www.devicemart.co.kr/goods/view?no=1342935 | 3 | 1100 | 3300 | 2~3일 | 가능 | 확실 | 열림 확인 11/15 00시 (페이지 제목 일치)
전기 | 퓨즈홀더 F-520 |  | 디바이스마트 | 4573 | https://www.devicemart.co.kr/goods/view?no=4573 | 1 | 121 | 121 | 1~2일 | 가능 | 확실 | 열림 확인 11/15 00시 (페이지 제목 일치)
전기 | 퓨즈 5×20 3 A |  | 디바이스마트 | 4537 | https://www.devicemart.co.kr/goods/view?no=4537 | 5 | 121 | 605 | 1~2일 | 가능 | 확실 | 열림 확인 11/15 00시 (페이지 제목 일치)
전기 | 카메라 FFC 22↔15핀 500 mm | 주문할 때 디바이스마트에서 '카메라 케이블 500mm' 검색 (승준 E18) | 디바이스마트 | (검색) | https://www.devicemart.co.kr/ | 1 | 5000 | 5000 | — | 가능 | 추측 | 검색해서 고를 것
리프트 | mightyZAP D7-6PT-3 리니어 서보 | 행정 26 · 6 N · 7.4 V · PWM/TTL. 옵션 '기본 커넥터 와이어 IR-EW06 PWM 200 mm'를 같이 고를 것 | 아이씨뱅큐 | P007598845 | https://www.icbanq.com/P007598845 | 1 | 111100 | 111100 | 3~4일 | 가능 | 확실 | 열림 확인 11/15 00시 (페이지 제목 일치)
리프트 | └ 옵션: 커넥터 와이어 IR-EW06 PWM 200 mm | 같은 페이지 옵션 (압착 공구 없이 꽂기) | 아이씨뱅큐 | P007598845 | https://www.icbanq.com/P007598845 | 1 | 15576 | 15576 | 3~4일 | 가능 | 확실 | 열림 확인 11/15 00시 (페이지 제목 일치)
전기 | MG90S 서보 (엘케이 B116) | 문 3개 | 아이씨뱅큐 | P016195879 | https://www.icbanq.com/P016195879 | 3 | 6050 | 18150 | 2~3일 | 가능 | 확실 | 열림 확인 11/15 00시 (페이지 제목 일치)
전기 | 28BYJ-48 + ULN2003 세트 (PP-A406) | 마커 X·Y + 예비 | 아이씨뱅큐 | P019043080 | https://www.icbanq.com/P019043080 | 3 | 2200 | 6600 | 2~3일 | 가능 | 확실 | 열림 확인 11/15 00시 (페이지 제목 일치)
전기 | KW-11-3Z 레버 (PP-D277) | X·Y 원점 + 예비 | 아이씨뱅큐 | P019041558 | https://www.icbanq.com/P019041558 | 3 | 528 | 1584 | 2~3일 | 가능 | 확실 | 열림 확인 11/15 00시 (페이지 제목 일치)
전기 | 비상 정지 KGAUTO KGE-J4R1R 25Φ | 22Φ 국내품은 3~6주 → 25Φ (함 구멍 25) | 아이씨뱅큐 | P019041441 | https://www.icbanq.com/P019041441 | 1 | 16060 | 16060 | 2~3일 | 가능 | 확실 | 열림 확인 11/15 00시 (페이지 제목 일치)
급이 | 연동 펌프 Kamoer NKP 12 V (PP-A703) | Adafruit 3910(해외) 대신 + MT3608 12 V | 아이씨뱅큐 | P019043095 | https://www.icbanq.com/P019043095 | 1 | 11660 | 11660 | 2~3일 | 가능 | 확실 | 열림 확인 11/15 00시 (페이지 제목 일치)
급이 | 실리콘 관 안 3 · 바깥 5, 1 m (PP-A702BL) |  | 아이씨뱅큐 | P019043081 | https://www.icbanq.com/P019043081 | 2 | 1023 | 2046 | 2~3일 | 가능 | 확실 | 열림 확인 11/15 00시 (페이지 제목 일치)
전기 | 빛 게이트 Adafruit 2167 3 mm | 국내 재고 없음 → 자비 (해외 7~10일) | 아이씨뱅큐 | P013152497 | https://www.icbanq.com/P013152497 | 3 | 5060 | 15180 | 7~10일 | 자비 | 확실 | 열림 확인 11/15 00시 (페이지 제목 일치)
 | 정산 가능 합계 |  |  |  |  |  |  | 250762
 | 자비 합계 |  |  |  |  |  |  | 15180
 | 디바이스마트 소계 (66,000원 넘으면 배송비 0) |  |  |  |  |  |  | 67986

Sheet: 리프트_나사
리프트 나사 (1차 주문에 같이 — 디바이스마트)
11/15 바꿈: 열압입 인서트(인두 필요) → M3 태핑 나사, Ø6 × 4 스페이서(해외) → M3 너트 1 + 와셔 3. 너트·와셔·태핑은 1개 11원 (판매 단위는 장바구니에서 확인).
구분 | 품목 | 규격·메모 | 판매처 | 상품번호 | 링크 | 개수 | 단가 (원, 부가세 포함) | 금액 (원) | 준비 기간 | 정산 | 값 근거 | 링크 확인
리프트 나사 | M3 × 8 무두볼트 (세트 스크류) | 304s 로드 끝 → 바닥 원판. 디바이스마트에 없음 → 쿠팡 '로켓배송'·네이버 소량팩 검색 (해외직구 표시 없는 것) | (소량팩) | (검색) | https://www.coupang.com/ | 1 | 3000 | 3000 | 1~2일 | 가능 | 추측 | 검색해서 고를 것
리프트 나사 | M3 너트 (니켈) | 304s 잠금 1 · 309s 틈 1 · 2020 홈 안 1 + 예비 | 디바이스마트 | 34324 | https://www.devicemart.co.kr/goods/view?no=34324 | 6 | 11 | 66 | 1~2일 | 가능 | 확실 | 열림 확인 11/15 00시 (페이지 제목 일치)
리프트 나사 | M3 평와샤 | 309s 틈 3 · 300s 4 + 예비 | 디바이스마트 | 7318 | https://www.devicemart.co.kr/goods/view?no=7318 | 10 | 11 | 110 | 2~3일 | 가능 | 확실 | 열림 확인 11/15 00시 (페이지 제목 일치)
리프트 나사 | M3 × 8 둥근머리 태핑 (PT2-3X8) | 300s 아크릴판 → 상자 밑구멍 Ø2.5 (인서트 대신) | 디바이스마트 | 11189 | https://www.devicemart.co.kr/goods/view?no=11189 | 6 | 11 | 66 | 2~3일 | 가능 | 확실 | 열림 확인 11/15 00시 (페이지 제목 일치)
리프트 나사 | M3 × 20 냄비 머신 볼트 | 309s 경첩. 디바이스마트에서 'M3*20 냄비머리' 검색 | 디바이스마트 | (검색) | https://www.devicemart.co.kr/ | 2 | 100 | 200 | — | 가능 | 추측 | 검색해서 고를 것
리프트 나사 | 20시리즈 둥근머리 렌치볼트 M5×10 (블랙) | 308s 상자 혀 → 세운 막대 | 디바이스마트 | 12530580 | https://www.devicemart.co.kr/goods/view?no=12530580 | 2 | 210 | 420 | 2~3일 | 가능 | 확실 | 열림 확인 11/15 00시 (페이지 제목 일치)
리프트 나사 | 20시리즈 스프링너트 M5 | 308s | 디바이스마트 | 12530574 | https://www.devicemart.co.kr/goods/view?no=12530574 | 2 | 286 | 572 | 2~3일 | 가능 | 확실 | 열림 확인 11/15 00시 (페이지 제목 일치)
 | 합계 |  |  |  |  |  |  | 4434

Sheet: 주문제작
주문 제작 — 아크릴 레이저·3D 프린트 (국내만, 해외구매는 정산 안 됨)
파일은 바탕화면 'capstone design\주문제작 파일' 폴더. 어림값은 [추측] — 사이트에 파일을 올리거나 견적을 받으면 그 값으로 바꿀 것 (파란 글씨).
종류 | 사이트·상품 | 무엇을·어떻게 | 링크 | 값 안내 | 개수 | 어림 (원) | 금액 (원) | 값 근거 | 추천 | 링크 확인
아크릴 레이저 | 아크릴몰 — 아크릴판 레이저 자유재단 (자동계산) | 2 mm 투명 · 판 100 × 90 · 파일: 바탕화면 '주문제작 파일\300pf_아크릴_묶음_100x90_2T.dxf' (격자판 2 + 바닥 원판 2). 50 mm 밑은 재단 불가라 묶음으로. 옵션 '도면전달' 고르고 메일로 DXF | https://www.acrylmall.com/goods/goods_view.php?goodsNo=25555 | 기본 2,000원~ (크기 자동계산) + 배송 3,000 | 1 | 8000 | 8000 | 추측 — 구멍 37개 가공비는 문의 | 1순위: 국내, 2T 투명 있음, 1장부터 | 열림 확인 11/15 00시 (페이지 제목 일치)
아크릴 레이저 | 올댓프린팅 — 아크릴 재단 (단순형/복잡형) | 같은 재료 10개 이상, PDF 파일. 두께는 페이지에 없음 (3T 굿즈용으로 보임 → 2T 아니면 CAD 다시) | https://allthatprinting.co.kr/category/%EC%95%84%ED%81%AC%EB%A6%B4-%EC%9E%AC%EB%8B%A8/50/ | 개당 250(단순)·400(복잡)원 × 10 + 배송 3,000 | 1 | 7000 | 7000 | 확실 (페이지 값) | 2순위 | 열림 확인 11/15 00시 (페이지 제목 일치)
금속·아크릴 레이저 | 디바이스마트 메이커 견적 — 레이저 가공 | 알루미늄·스틸·스테인리스·아크릴. DWG/ZIP, 1:1. 견적은 메일로 (custom@ntrex.co.kr). 나중에 XY 캐리지 알루미늄 판용 | https://www.devicemart.co.kr/maker_estimate/request_form/laser | 견적 받아야 앎 | 0 | 0 | 0 | — | XY 판 때 | 열림 확인 11/15 00시 (페이지 제목 일치)
3D 프린트 | 원클릭팩토리 — 3D 프린팅 출력 신청 | STL·STEP 올리면 바로 견적, 로그인 없이 결제. 파일: 바탕화면 '주문제작 파일\300_마킹실상자.stl' (9.56 cm³, 윗면이 위로 오게 = 뒤집어서 출력) | https://www.oneclickfactory.co.kr/print3D | 올리면 바로 나옴 | 1 | 8000 | 8000 | 추측 (9.6 cm³ 기준) | 1순위 | 열림 확인 11/15 00시 (페이지 제목 일치)
3D 프린트 | 부엉이공장 — FDM 자동견적 | STL 올리면 예상 견적, 흰 PLA 기준, 카톡 상담 | https://owlfactory.co.kr/FDM_auto | 올리면 바로 나옴 | 0 | 0 | 0 | — | 2순위 | 열림 확인 11/15 00시 (페이지 제목 일치)
아크릴 레이저 | 아크릴몰 — 데크 101 · 위판 105 (5 mm) | 바탕화면 '주문제작 파일\레이저_데크위판' DXF 2개 (230 × 180, 140 × 180). 탭 구멍은 관통으로 바꿈 (M2 2.4 · M3 3.4 + 아래 너트). 색은 아무거나 (불투명 권장 — 카메라 반사) | https://www.acrylmall.com/goods/goods_view.php?goodsNo=25555 | 크기 자동계산 + 5 mm 옵션 | 1 | 15000 | 15000 | 추측 | 1순위 (격자판과 같은 곳) | 열림 확인 11/15 00시 (페이지 제목 일치)
 | 합계 (1순위만 개수 1) |  |  |  |  |  | 38000

Sheet: 2차주문_기계
2차 주문 — 기계 (11/19까지 주문)
개수는 지금 CAD(D5g_full 11/15)에서 셈 [확실]. 단가 [추측] 줄은 주문할 때 판매처 값으로 바꿀 것 (파란 글씨). 프로파일은 mm × mm당 값.
구분 | 품목 | 규격·메모 | 판매처 | 상품번호 | 링크 | 개수 | 단가 (원, 부가세 포함) | 금액 (원) | 준비 기간 | 정산 | 값 근거 | 링크 확인
프레임 | 2020 프로파일 DF 2020 (대영) 맞춤 절단 | 610 × 4 (기둥) · 320 × 21 (레일 16·가로대 4·갠트리 1) · 156 × 1 (리프트 세움) = 26토막 9,316 mm. 상품 페이지 '절단길이(mm)'에 길이마다 넣음 — 값은 견적가격 | 디바이스마트 | 23894 | https://www.devicemart.co.kr/goods/view?no=23894 | 9316 | 5 | 46580 | 3~4일 | 가능 | 추측 — 승준 11/08 11번가 mm당 약 5원 | 열림 확인 11/15 00시 (페이지 제목 일치)
프레임 | AL 브래킷 DCB 2025 20×25 | L 32 + T 이음 20 + 세운 막대 1 + 예비 3 | 디바이스마트 | 24022 | https://www.devicemart.co.kr/goods/view?no=24022 | 56 | 550 | 30800 | 3~4일 | 가능 | 확실 | 열림 확인 11/15 00시 (페이지 제목 일치)
프레임 | 20시리즈 둥근머리 렌치볼트 M5 × 8 | 브래킷 64 + T 이음 40 + 부품 18 + 받침 4 + 급이 걸이 2 = 128 + 예비 | 디바이스마트 | 12530579 | https://www.devicemart.co.kr/goods/view?no=12530579 | 140 | 110 | 15400 | 2~3일 | 가능 | 확실 | 열림 확인 11/15 00시 (페이지 제목 일치)
프레임 | 20시리즈 스프링너트 M5 | 볼트와 같은 수 (홈 6에 넣고 돌려 고정) | 디바이스마트 | 12530574 | https://www.devicemart.co.kr/goods/view?no=12530574 | 140 | 286 | 40040 | 2~3일 | 가능 | 확실 | 열림 확인 11/15 00시 (페이지 제목 일치)
프레임 | 20시리즈 둥근머리 렌치볼트 M5 × 10 (블랙) | 데크·위판 8 + X 봉 받침 4 | 디바이스마트 | 12530580 | https://www.devicemart.co.kr/goods/view?no=12530580 | 12 | 210 | 2520 | 2~3일 | 가능 | 확실 | 열림 확인 11/15 00시 (페이지 제목 일치)
XY | LM8UU | X 빔 222 | 디바이스마트 | (검색 'LM8UU') | https://www.devicemart.co.kr/ | 2 | 1540 | 3080 | 약 2일 | 가능 | 가능성 높음 — 승준 11/08 | 검색해서 고를 것
XY | LM6UU | Y 캐리지 221 | 디바이스마트 | (검색 'LM6UU') | https://www.devicemart.co.kr/ | 2 | 1650 | 3300 | 약 2일 | 가능 | 가능성 높음 — 승준 11/08 | 검색해서 고를 것
XY | 리니어 샤프트(연마봉) Ø8 × 200 (규격 길이) | X 봉 213 — 자르지 않음 (11/15 CAD 검사: 200·250·300 됨). 국내 판매처에서 '8mm 리니어 샤프트 200mm' — 해외직구 표시 없는 것 | (국내 검색) | (검색) | https://www.devicemart.co.kr/ | 2 | 6000 | 12000 | — | 가능 | 추측 | 검색해서 고를 것
XY | 리니어 샤프트 Ø6 × 150 (규격 길이) | Y 봉 207 — 자르지 않음 (150·200 됨) | (국내 검색) | (검색) | https://www.devicemart.co.kr/ | 2 | 5000 | 10000 | — | 가능 | 추측 | 검색해서 고를 것
XY | 평행 핀(또는 Ø3 샤프트) Ø3 × 70 | 펜 홀더 안내 223 — 70 또는 80 (100은 안 됨) | (국내 검색) | (검색) | https://www.devicemart.co.kr/ | 2 | 1000 | 2000 | — | 가능 | 추측 | 검색해서 고를 것
XY | T8 리드스크루 리드 8 × 150 + 황동 너트 — X | X 214 — 자르지 않음 (100·150·300 됨, 300은 손도리 300 mm 4,840원도 가능하나 끝이 200 mm 떠 있음) | (국내 검색) | (검색) | https://www.sondori.com/goods/goods_view.php?goodsNo=1000002008 | 1 | 5000 | 5000 | — | 가능 | 추측 | 검색해서 고를 것
XY | T8 리드스크루 리드 8 × 150 + 황동 너트 — Y | Y 208 — 150 또는 200만 (300은 프레임에 닿음) | (국내 검색) | (검색) | https://www.devicemart.co.kr/ | 1 | 5000 | 5000 | — | 가능 | 추측 | 검색해서 고를 것
XY | 커플링 5 → 8 mm D19L25 | 210·216 | (국내 검색) | (확인 필요) | https://www.devicemart.co.kr/ | 2 | 3000 | 6000 | — | 가능 | 추측 | 검색해서 고를 것
작은 나사 | M3 × 8 십자 냄비 | 28BYJ-48 귀 153b 4 + 예비 | 디바이스마트 | (검색) | https://www.devicemart.co.kr/ | 6 | 30 | 180 | — | 가능 | 추측 | 검색해서 고를 것
작은 나사 | M3 × 10 십자 냄비 | 와고 3 · 데크 아래 4 · 카메라 걸이 2 | 디바이스마트 | (검색) | https://www.devicemart.co.kr/ | 11 | 30 | 330 | — | 가능 | 추측 | 검색해서 고를 것
작은 나사 | M3 × 12 · M3 × 16 · M3 × 18 십자 냄비 | 급이 143h 4 · 집게 226s 1 · 기판 긴 나사 | 디바이스마트 | (검색) | https://www.devicemart.co.kr/ | 8 | 40 | 320 | — | 가능 | 추측 | 검색해서 고를 것
작은 나사 | M3 너트 (니켈) | 귀 6 · 급이 4 · 와고 3 · 집게 1 + 예비 (리프트 몫은 리프트_나사 시트) | 디바이스마트 | 34324 | https://www.devicemart.co.kr/goods/view?no=34324 | 20 | 11 | 220 | 1~2일 | 가능 | 확실 | 열림 확인 11/15 00시 (페이지 제목 일치)
작은 나사 | M2 × 12 십자 냄비 | 원점 스위치 4 · 게이트 8 | 디바이스마트 | (검색) | https://www.devicemart.co.kr/ | 14 | 30 | 420 | — | 가능 | 추측 | 검색해서 고를 것
작은 나사 | M2 × 6 십자 냄비 | 카메라 180s | 디바이스마트 | (검색) | https://www.devicemart.co.kr/ | 4 | 30 | 120 | — | 가능 | 추측 | 검색해서 고를 것
기판 | M2.5 × 5 기둥 + 나사 | ULN2003 X·Y 8 + Pi 4 (바닥 F 몫 4는 없앰 — mightyZAP) | 디바이스마트 | (검색) | https://www.devicemart.co.kr/ | 12 | 200 | 2400 | — | 가능 | 추측 | 검색해서 고를 것
기판 | M3 기둥 5 mm × 3 · 15 mm × 3 | UNO 2장 | 디바이스마트 | (검색) | https://www.devicemart.co.kr/ | 6 | 200 | 1200 | — | 가능 | 추측 | 검색해서 고를 것
기판 | M2 × 8 암-암 기둥 · M3 × 6 기둥 · 나일론 스페이서 | 허브 2장·MOSFET | 디바이스마트 | (검색) | https://www.devicemart.co.kr/ | 12 | 200 | 2400 | — | 가능 | 추측 | 검색해서 고를 것
급이 | 네오디뮴 자석 Ø6 × 2 | 뚜껑 2쌍 | (국내 검색) | (검색) | https://www.devicemart.co.kr/ | 4 | 300 | 1200 | — | 가능 | 추측 | 검색해서 고를 것
급이 | M5 호스 니플 (바브) | 노즐·물빠짐 | (국내 검색) | (검색) | https://www.devicemart.co.kr/ | 2 | 1500 | 3000 | — | 가능 | 추측 | 검색해서 고를 것
급이 | 파이프 클램프 Ø60 2 · Ø30 2 | 병·버림통 | (국내 검색) | (검색) | https://www.devicemart.co.kr/ | 4 | 1500 | 6000 | — | 가능 | 추측 | 검색해서 고를 것
급이 | Nalgene 2104-0008 250 mL 병 (또는 같은 크기 국산 HDPE 병) | 바깥 병 | (국내 검색) | (검색) | https://www.devicemart.co.kr/ | 1 | 8000 | 8000 | — | 가능 | 추측 | 검색해서 고를 것
급이 | 50 mL 원뿔 튜브 (버림통) · 코튼롤 2호 · 케이블 타이 |  | (국내 검색) | (검색) | https://www.devicemart.co.kr/ | 1 | 6000 | 6000 | — | 가능 | 추측 | 검색해서 고를 것
리프트 | M5 × 12 볼트 + M5 너트 | 세운 막대 브래킷 → 데크 (11/15) | 디바이스마트 | (검색) | https://www.devicemart.co.kr/ | 1 | 200 | 200 | — | 가능 | 추측 | 검색해서 고를 것
통로 | 열수축 튜브 Ø25 2:1 | 깔때기 ↔ 관 2곳 | 디바이스마트 | (검색) | https://www.devicemart.co.kr/ | 1 | 1500 | 1500 | — | 가능 | 추측 | 검색해서 고를 것
 | 합계 |  |  |  |  |  |  | 215210

Sheet: 아직_못사는것
아직 '사서 조이기만'이 안 되는 것 — 다음 설계에서 바꿈
부품 | 왜 안 되나 (자르기·인두·탭·해외) | 바꿀 방법 (제안)
열압입 인서트 181i 2 (카메라 걸이) | 인두 필요 | 걸이 출력 파일 구멍 Ø4 → Ø2.5 + M3 태핑 (데크 100n 4는 관통 + 너트로 바꿈 — 데크 DXF에 반영)
CAD에 남은 옛 모양 | 144p 펌프 모양(Adafruit 3910 → Kamoer), 194_estop 22Φ 몸체 (판 구멍은 25.5로 고침) — 바닥 F 드라이버 자리는 11/15 지움 | 판매처 치수를 받아 새 모양
봉·T8 국내 판매처 | 규격 길이(Ø8 200, Ø6 150, Ø3 70, T8 리드 8 150)로 바꿔 자르기는 없앰 (11/15). 국내·해외직구 아닌 판매처를 아직 못 정함 — G마켓은 봇 확인 화면 | 주문할 때 '리니어 샤프트 8mm 200mm' 등으로 검색, 해외직구 표시 없는 것

Sheet: 출력목록
출력 대행 — 3D 프린트 부품 45개 (32 + 자르던 부품 13, 서현 11/15: 출력 대행 주문 OK)
파일: 바탕화면 'capstone design\주문제작 파일\프린트_32' + '프린트_추가13' (STL + STEP, 이름 = 도면 번호). 크기·부피는 CAD에서 셈 [확실]. 값 = 부피 × cm³당 값 [추측 — 업체 견적으로 바꿀 것]. 마킹실 상자 300은 주문제작 시트에 따로.
cm³당 값 (원) | 200 | 추측 — FDM 출력 대행 흔한 값 150~300원/cm³의 가운데. 원클릭팩토리에 올리면 바로 나옴
번호 | 파일 (STL·STEP) | 부품 | 크기 X × Y × Z (mm) | 부피 (cm³) | 조각 수 | 어림 값 (원) | 비고
1 | 112_entry_gate_housing.stl | 입구 문 하우징 | 22.5 × 54.4 × 23 | 10.06 | 1 | 2012
2 | 112_entry_gate_flap.stl | 입구 문판 | 1.5 × 26.7 × 19.3 | 0.60 | 1 | 120
3 | 170_isolation_gate_housing.stl | 격리 문 하우징 | 54.4 × 22.5 × 23 | 10.06 | 1 | 2012
4 | 170_isolation_gate_flap.stl | 격리 문판 | 26.7 × 1.5 × 19.3 | 0.60 | 1 | 120
5 | 176_release_gate_housing.stl | 방생 문 하우징 | 22.5 × 51.3 × 23 | 9.49 | 1 | 1898
6 | 176_release_gate_flap.stl | 방생 문판 | 1.5 × 26.7 × 19.3 | 0.60 | 1 | 120
7 | 104_dome_coupling.stl | 돔 연결부 | 90 × 90 × 10 | 39.86 | 1 | 7972
8 | 174_release_neck.stl | 방생 목 | 31.2 × 16 × 16 | 2.65 | 1 | 530
9 | 175_release_shaft.stl | 방생 굴뚝 | 54 × 54 × 75 | 30.08 | 1 | 6016
10 | 202_marker_holder_vblock.stl | 마커 홀더 V블록 | 14.4 × 54 × 40 | 10.50 | 1 | 2100
11 | 203_clamp_strap.stl | 마커 조임 띠 | 13.4 × 28 × 30 | 5.60 | 1 | 1120
12 | 206_y_carriage.stl | Y 캐리지 | 26.3 × 41.8 × 93.5 | 47.57 | 1 | 9514
13 | 212_beam_end_blocks.stl | X 빔 끝 블록 (2개 한 파일, 봉·T8 구멍 끝까지) | 28 × 140 × 95 | 79.92 | 2 | 15984
14 | 211_y_motor_bracket.stl | Y 모터 브래킷 | 43 × 29.9 × 32 | 8.97 | 1 | 1794
15 | 218_rod_supports.stl | X 봉 받침 (4개 한 파일, 봉 구멍 끝까지) | 208 × 157 × 16.5 | 30.64 | 4 | 6128
16 | 217_x_motor_plate.stl | X 모터판 | 38 × 44 × 52 | 12.52 | 1 | 2504
17 | 219_cap_cup.stl | 마커 뚜껑 컵 | 14 × 14 × 12 | 1.56 | 1 | 312
18 | 220_cup_bracket.stl | 컵 받침 | 7.5 × 37.8 × 5 | 1.42 | 1 | 284
19 | 226_x_home_clamp.stl | X 원점 스위치 집게 | 19 × 43 × 18 | 9.18 | 1 | 1836
20 | 199a_pi_shelf.stl | Pi 선반 | 89 × 67 × 48 | 26.48 | 1 | 5296
21 | 199b_gate_holder_G4.stl | 빛 게이트 받침 G4 (2개) | 24 × 10 × 20 | 1.32 | 2 | 264
22 | 199c_gate_holder_G6.stl | 빛 게이트 받침 G6 (2개) | 10 × 20 × 20 | 0.76 | 2 | 152
23 | 199d_gate_holder_G1_tx.stl | 빛 게이트 받침 G1 송신 | 4 × 10 × 20 | 0.66 | 1 | 132
24 | 199e_gate_holder_G1_rx.stl | 빛 게이트 받침 G1 수신 | 4 × 10 × 20 | 0.66 | 1 | 132
25 | 110b_entry_bend.stl | 입구 꺾임 조각 | 35 × 22 × 33 | 4.02 | 1 | 804
26 | 172b_isolation_bends.stl | 격리 통로 꺾임 (4조각 한 파일) | 73.4 × 152.9 × 203.5 | 8.25 | 4 | 1650
27 | 102_collar.stl | 트랩 돔 칼라 | 99.9 × 99.9 × 15 | 15.52 | 1 | 3104
28 | 181_camera_bracket.stl | 카메라 걸이 | 33 × 42 × 70 | 13.02 | 1 | 2604
29 | 197_uln_bracket_X.stl | ULN2003 받침 X | 38 × 52 × 3.5 | 5.91 | 1 | 1182
30 | 197_uln_bracket_Y.stl | ULN2003 받침 Y | 38 × 52 × 3.5 | 5.91 | 1 | 1182
31 | 193h_wago_holder.stl | 와고 받침 (6개 한 파일) | 98.1 × 50 × 6 | 7.54 | 6 | 1508
32 | 194b_estop_plate.stl | 비상 정지 판 (구멍 Ø25.5로 고침) | 4 × 94 × 70 | 16.39 | 1 | 3278 | 구멍 Ø25.5 — 25Φ 비상 정지에 맞춤 (11/15)
33 | 143_feed_trough.stl | 급이 물길 (포맥스 판 대신 한 덩어리) | 36 × 74 × 32 | 23.09 | 1 | 4618
34 | 143l_feed_trough_lid.stl | 급이 뚜껑 | 36 × 80 × 6 | 3.32 | 1 | 664
35 | 143p_post_sq12.stl | 급이 기둥 (각관 대신) | 12 × 12 × 152 | 6.65 | 1 | 1330
36 | 143a_angle_foot.stl | 급이 발 (앵글 대신) | 20 × 40 × 20 | 2.99 | 1 | 598
37 | 143b_angle_top.stl | 급이 위 (앵글 대신) | 20 × 20 × 20 | 1.50 | 1 | 300
38 | 144b_feeder_holder.stl | 병·펌프 걸이 (알루미늄 판 대신) | 148 × 4 × 108 | 63.75 | 1 | 12750
39 | 111_entry_funnel.stl | 입구 깔때기 (McMaster 대신) | 61 × 61 × 42.4 | 6.59 | 1 | 1318
40 | 173_isolation_funnel.stl | 격리 깔때기 (McMaster 대신) | 51.8 × 51.8 × 35 | 4.68 | 1 | 936
41 | 110_entry_duct.stl | 입구 관 (PVC 자르기 대신) | 18 × 18 × 116.1 | 14.09 | 1 | 2818
42 | 172_isolation_duct_1.stl | 격리 관 1 | 18 × 81.5 × 18 | 9.92 | 1 | 1984
43 | 172_isolation_duct_2.stl | 격리 관 2 | 18 × 18 × 156.5 | 19.05 | 1 | 3810
44 | 172_isolation_duct_3.stl | 격리 관 3 | 61.4 × 119.3 × 18 | 14.76 | 1 | 2952
45 | 172_isolation_duct_4.stl | 격리 관 4 | 18 × 18 × 16 | 1.95 | 1 | 390
 |  | 합계 |  | 590.7 | 59 | 118132
