britams/-capstone-project-repo/design/circuit/out/bom.csv

부품 | 수량 | 쓰는 곳 | 상태
Arduino UNO R3 | 2 | UNO 1 움직임, UNO 2 문·게이트·조명 | 보유 4 (정품 1 + 호환)
Raspberry Pi 5 + AI HAT+ + AI 카메라 | 1 | 판단 | 보유
Pi 5 카메라 케이블 22↔15핀 500 mm (FFC) | 1 | Pi 선반 199a → 카메라: 필요 약 320 mm > 동봉 300 mm (CAP-AI-38) | 살 것 (구매확정표 E18)
USB A-B 케이블 0.5 m | 2 | Pi → UNO | 보유 확인
28BYJ-48 + ULN2003 세트 | 2 | 마커 X, Y (바닥 F는 리니어 모듈로, 11/12) | 보유 1 → 살 것 1
리니어 모듈 15 mm 스테핑 + M3 리드 슬라이더 (Keshuo 15BY25-77, 행정 62) | 1 | 바닥 F — 모터·커플링·리드스크루·너트·봉·베어링 대신 (11/12) | 살 것 [치수도 대표값 — 사서 잼]
DRV8833 2채널 모터 드라이버 모듈 | 1 | 바닥 F (양극) — UNO 1 D2~D5 | 살 것
SG90 | 1 | 펜 들기 205 | 보유 1 (학습 키트, 실물 확인)
MG90S (혼 포함) | 3 | 문 112·170·176 | 보유 1 (혼 없음, 예비) → 살 것 3 (B2)
마이크로 스위치 KW11-3Z 레버형 (누름 스위치 PSW, NC 접점 씀) | 1 | 로드셀·HX711 대신 — 스프링 146이 4.8 mm(0.5 N) 눌리면 축 걸쇠가 누름 (CAP-AI-60, 교수님 피드백) | 추가 (원점 스위치와 같은 것)
Pi 5 RTC 배터리 (공식 충전식 ML-2020, J5 BAT 단자) | 1 | 전원이 끊겨도 날짜 유지 → 여왕벌 계절 규칙 (11/06) | **추가**
마이크로 스위치 KW11-3Z 레버형 (원점) | 3 | F, X, Y — 외형 20×10.2×6.4, 승준 라이브러리 SJ-38 | 추가
빛 게이트 Adafruit 2167 (3 mm) | 3 | 통로 G1·G4·G6 (11/06 21시: 문 빔은 낱개로 — 승준 SJ-47) | **살 것 3 (+1)**
적외선 LED 3 mm 940 nm | 6 | 문 빔 송신 G2·G2b·G3·G3b·G5·G5b (Ø4.2 구멍에 꽂음) | **살 것 6 (+4)**
포토트랜지스터 3 mm 940 nm (검은 몸통, 햇빛 거름) | 6 | 문 빔 수신, 이미터 팔로어 (빛 받으면 HIGH) | **살 것 6 (+4)**
저항 220 Ω | 6 | 적외선 LED 전류 약 17 mA | 키트 저항 세트 [실물 확인]
로직 레벨 MOSFET 모듈 (D4184 등) | 4 | 조명 2 (위·아래) + 송신 켜기 1 + 급이 펌프 1 (CAP-AI-59) — 출구 조명 없앰 (SJ-45) | 살 것 (시험 단계는 보유 릴레이 모듈로 대신 — 켜고 끄기만)
연동 펌프 Adafruit 3910 (5~6 V, 0.5 A, 100 mL/min, 관 3.5 × 5) | 1 | 급이 — 바깥 병에서 솜으로, 먹일 때만 (CAP-AI-59) | **살 것**
다이오드 1N5819 (펌프 역기전력) | 1 | 펌프 +, − 양 끝 (K → +5V_B) | 살 것 [사양서 확인]
Nalgene 2104-0008 250 mL 넓은 입 병 + 식품용 실리콘 관 3.5 × 5 약 1.2 m | 1 | 급이 병·관 (뚜껑에 구멍 2개) | **살 것**
저항 10 kΩ | 10 | 통로 게이트 풀업 3 + 문 빔 포토TR 부하 6 + 레일 감지 1 | 학습 키트 저항 세트에서 [실물 확인]
커패시터 100 nF | 5 | 원점 3 + 누름 스위치 1 + 단자대 1 | 키트 커패시터 세트에서 [실물 확인]
전해 커패시터 1000 µF 10 V | 1 | 서보 허브 (+5V 버스 ↔ GND 버스) | 추가
쇼트키 다이오드 SB540 (5 A 40 V, DO-201) — 역극성 보호 D_RP | 1 | 서보 허브, 줄 표시(K) +5V 쪽 — 거꾸로 꽂으면 퓨즈를 끊음 (CAP-AI-50) | 살 것 [사양서 확인]
5 V 3 A 어댑터 + DC 잭 5.5×2.1 | 1 | 구동 레일 | 구매 목록 G2
퓨즈홀더 F-520 + 퓨즈 5×20 3 A | 1 | 구동 레일 — 인라인 홀더·T2.5A를 국내 판매처에서 못 찾아 대신 (구매확정표 E3) | 살 것
비상 정지 버튼 (NC) | 1 | 구동 레일 | 추가
와고 레버 커넥터 221-415 (5구) | 5 | +5V_B 2개 이어 8구 (입력·ULN 3·서보 허브·게이트 허브·조명 2), GND 3개 이어 11구 (+ UNO 1·2 GND) — 단자대 대신 (승준 SJ-43 제안 채택) — 와고에는 20~22 AWG만 꽂음 (가는 선은 허브에서) | 살 것
만능기판 2장 (60 × 40, 70 × 30) + 1 × 40 핀 헤더 2줄 | 1 | 배치·핀 표 `전기회로/hub_boards.py` (CAP-AI-50): 서보 허브 = 서보 3핀 헤더 4 + 신호 핀 4 + C1·C2·D_RP / 게이트 허브 = 헤더 핀 49 + 10 kΩ 10 + 220 Ω 6, 점퍼 9 | 살 것 (헤더는 키트 확인)
20·22 AWG 연선 (와고 꽂는 줄) | 1 | 와고 221은 가는 26·28 AWG를 직접 물기 어려움 → 허브까지는 20~22 AWG | 살 것
실리콘 연선 26·28 AWG 각 10~15 m, 20·22 AWG 각 2 m | 1 | 배선 약 44 m (가닥 합) | 추가
듀폰·JST-XH 연장 커넥터 | 1 | 게이트·서보 연장 | 추가
(선택) 배터리 상자: LiFePO4 12.8 V 20 Ah (2일, 11/06) + 충전기 + 강압 5.1 V 5 A·5 V 3 A + INA226 + 퓨즈 5 A | 1 | 배터리 운용 | 현장 시험 날짜 보고
