britams/-capstone-project-repo/purchase/구매장부.md

# 구매 장부 (재료비 정산용)

> **원본은 `purchase/재료비_정산보고서.xlsx`** (CAP-AI-SJ-17). 이 표는 채팅에서 빠르게 적는 메모용 — 엑셀과 다르면 엑셀이 맞다.

규칙: `purchase/2026-10-28_재료비_정산규칙.md` · 담당: 승준 · 정산은 팀장(서현) 계좌로, 11/30 서류 제출
**순번 = 엑셀 정산보고서 순서 = 영수증 붙이는 순서.** 주문하면 바로 한 줄 추가.

| 순번 | 구매일 | 판매처 | 품목 (규격) | 수량 | 단가 | 금액 | 결제한 사람 | 용도 (도면부호) | 영수증(세부내역) 파일 | 제품 사진 | 인정 여부 |
|---|---|---|---|---|---|---|---|---|---|---|---|
| 1 | 2026-10-10 | 불로양봉원 (네이버페이) | 말벌포획기 B형 (본체 + 유인액 2병) | 1 | 54,000 | 54,000 | 승준 | 레트로핏 바탕 상용 트랩 (포획통 = 격리함) | 영수증1 | 사진 1 (보유품 사진 있음) | [가능성 높음] 인정 |
| 2 | 2026-10-10 | 불로양봉원 | 배송비 | 1 | 3,800 | 3,800 | 승준 | — | 영수증1 | — | 확인 필요 |
| 3 | 2026-10-28 | 디바이스마트 (네이버페이) | 라즈베리파이 27W USB-C 아답터 (공식) | 1 | 18,040 | 18,040 | 승준 | 제어부 190 전원 | 영수증2 | 도착 후 | 애매 (전산용품?) |
| 4 | 2026-10-28 | 디바이스마트 | 라즈베리파이5 액티브 쿨러 (정품) | 1 | 7,700 | 7,700 | 승준 | 제어부 190 방열 | 영수증2 | 도착 후 | 애매 (전산용품?) |
| 5 | 2026-10-28 | 디바이스마트 | 배송비 | 1 | 2,700 | 2,700 | 승준 | — | 영수증2 | — | 확인 필요 |
| 6 | 2026-10-28 | 하멜른 (네이버페이) | 등검은말벌 표본 국산 액침표본 | 7 | 3,000 | 21,000 | 승준 | 실측·시험·VespAI 사진 | 영수증3 | 도착 후 | 확인 필요 (재료로 보는지) |
| 7 | 2026-10-28 | 하멜른 | 배송비 | 1 | 3,000 | 3,000 | 승준 | — | 영수증3 | — | 확인 필요 |
| 8 | 2026-10-29 | 쿠팡 (로켓배송) | 월드크린 테프론 테이프 4m | 1 | 900 | 900 | 승준 | 마커 잉크 부착 시험(J9) 시편 — 말벌 몸처럼 잘 안 붙는 표면 대용 | 영수증5 (거래명세표 + 카드영수증) | 도착 후 | [추측] 인정 (시험 재료) |
| 9 | 2026-10-29 | 쿠팡 (로켓배송) | 샤피 크리에이티브 수성 마커 총알팁 12색 | 1 | 18,870 | 18,870 | 승준 | 마커 201 (노랑 사용), 점 크기·건조 시험(J9) | 영수증6 (1행만) | 도착 후 | 애매 (문구류?) · 금액 18,870 확정 (승준 10/29) |
| (제외) | 2026-10-28 | 다이소몰 | SD/TF 카드 리더기 C타입 + 배송비 | 1 | — | 5,000 | 승준 | OS 설치 | 영수증4 | — | **정산 제외 (전산용품, 개인 구매)** |
| (제외) | 2026-10-29 | 쿠팡 | 무드등 가습기·롤화장지·생수 (영수증6 2~4행) | 3 | — | 30,470 | 승준 | 개인 물품 | 영수증6 | — | **정산 제외 (프로젝트 무관)** |

합계 (정산): **130,010원** / 한도 500,000원 / 잔액 369,990원 — 영수증1 57,800 + 영수증2 28,440 + 영수증3 24,000 + 영수증5 900 + 영수증6 중 샤피 18,870 일치
- 영수증6: 주문 전체 49,340원에 할인 2,900원 → 결제 46,440원. **승준 판단(10/29): 여러 개 같이 사서 붙은 할인 → 샤피는 18,870원 그대로.** 담당자가 물으면 쿠팡 주문 상세 캡처로 설명
- 샤피 12색은 구매목록 A4의 5색(8,600원) 대신 산 것 (10/29)
영수증 원본·세부내역 캡처: 승준 PC `창의적종합설계\정산\` (영수증1~6, 레포에 안 올림)

체크 (주문할 때마다)
- [ ] 국내 판매처인가 (해외구매·직구·중고 X)
- [ ] 사무용품·전산용품·공구가 아닌가 (애매하면 팀장 문의 먼저)
- [ ] 세부내역 영수증(품목·금액 보임)을 받았나 → PDF·캡처로 저장
- [ ] 받은 물건 사진을 찍었나 (정산보고서 필수)
