britams/-capstone-project-repo/purchase/2026-10-28_재료비_정산규칙.md

# 재료비 정산 규칙 — 2026 천안공과대학 창의융합 경진대회 설명회 자료 요약

정리: 2026-10-28 · 이승준 (Claude와 정리, CAP-AI-SJ-16) · 원본: 승준이 받은 설명회 PDF 6쪽 (이미지 슬라이드, 레포에는 올리지 않음 — 요약만)
표기: [확실] = 자료에 그대로 있음 / [가능성 높음]·[추측] = 우리 품목에 적용한 해석 (담당자 확인 전)

## 1. 핵심 규칙 [확실]
| 항목 | 내용 |
|---|---|
| 지원 한도 | **50만 원** — 초과 불가 |
| 인정 범위 | **과제물 제작에 필요한 재료만** |
| 불인정 ① 사무용품 | 복사용지, 볼펜, 마우스 등 |
| 불인정 ② 전산용품 | 하드디스크, 램, 메모리, 토너 등 |
| 불인정 ③ 공구 | 드릴, 피펫, 전기톱 등 **계속 쓸 수 있는 공구** |
| 불인정 ④ | **해외구매, 중고거래 불가** |
| 위반 시 | 불인정 항목 집행·정산서류 미충족이면 **재료비 전액 환수** |
| 애매한 것 | **팀장(서현)이 담당자에게 메일로 문의** |
| 입금 | 모든 정산 금액은 **팀장 계좌**로, **경진대회 종료 후** 정산 |

## 2. 제출 서류 [확실]
1. 정산보고서 — **제품 사진 필수**
2. 과제결과보고서
3. 영수증 — **세부내역 필수** (첨부 3)
4. 재학증명서 — **팀원 전부**
5. 통장사본 — **팀장만**

## 3. 정산보고서 작성 요령 [확실]
- 영수증(첨부 3) + **엑셀 정산보고서**(양식은 팀장 이메일로 올 예정 — 아직 못 받음) 함께 제출
- **영수증 붙이는 순서 = 엑셀 구매물품 순서**. 다르면 영수증에 순번을 적음
- 영수증은 **구매 물품과 금액이 보이는 세부내역** 영수증이어야 함
- 견적서도 가능 — 단 **수신자를 팀장·팀원 이름으로** (연구실·지도교수님 이름 X)
- 수기 영수증은 **업체 직인**이 있어야 함

## 4. 일정 [확실, 자료상 '예정']
| 내용 | 일정 | 서류 |
|---|---|---|
| 교내 경진대회 | 2026년 11월 예정 (날짜 추후 안내) | 포스터 시안 (팀장 이메일로 양식) |
| 결과·정산 보고서 제출 | **2026-11-30** | 결과보고서, 엑셀 정산보고서, 지출 영수증 |

## 5. 우리 구매 목록에 적용 (해석 — 담당자 확인 전)
| 품목 | 판정 | 이유 |
|---|---|---|
| 서보·스테핑 모터, 리드스크루, 봉, 커플링, 프로파일, 센서, LED, 스프링, 아크릴·플라스틱 판 | [가능성 높음] 인정 | 과제물에 들어가는 재료 |
| Pi 5 전원 어댑터, 액티브 쿨러 | [추측] 애매 | 장치에 들어가는 부품이지만 '전산용품'으로 볼 수도 있음 → **팀장 문의 권장** |
| 샤피 크리에이티브 마커 | [추측] 애매 | 장치의 마킹 재료(201)지만 품목 이름이 문구류 → 정산보고서에 **용도(마커 201, 말벌 표식 잉크)** 를 분명히 적고, 필요하면 문의 |
| **디지털 캘리퍼스** | [가능성 높음] **불인정** | 계속 쓰는 측정 공구 → **실험실에서 빌리기** (승준 10/28 계획과 같음) |
| microSD | 이미 보유 — 사지 말 것 | 사면 '메모리'로 불인정 가능성 [가능성 높음] |
| 퍼마페이크 등 해외 직구 | **불인정** [확실] | 해외구매 불가 → 10/28 결정으로 이미 뺌 |
| 쿠팡 '로켓직구' 상품 | **불인정** [가능성 높음] | 해외 판매자 상품 → 주문 전 '로켓배송'(국내)인지 확인 |

## 6. 확정 (승준 10/28 20:42, CAP-AI-SJ-17)
- **예산 = 50만 원** (인수인계의 '약 60만 원'은 이전 값)
- **정산은 승준 담당** — 서현에게 요청하지 않음
- **엑셀 정산보고서 양식은 따로 없음 → 우리가 만듦**: `purchase/재료비_정산보고서.xlsx` (정산보고서·제품사진·작성요령 시트, 합계·잔액·한도 초과 자동)

## 7. 남은 확인
1. 전원 어댑터·쿨러·마커 인정 여부 — 설명회 자료상 문의는 '팀장이 메일로'. 문의할지·누가 할지는 승준 판단
