britams/-capstone-project-repo/purchase/재료비_정산보고서.xlsx

Sheet: 정산보고서
2026 천안공과대학 창의융합 경진대회 — 재료비 정산보고서
팀명 | 초벌 | 과제명 | 말벌 자동 마킹 트랩 (상용 트랩 레트로핏 모듈) |  | 팀장 | 이서현 | 정산 담당 | 이승준 | 작성일 | 2026-10-29
지원 한도 (원) |  | 500000 | 집행 합계 (원) | 130010 | 잔액 | 369990 | 상태 | 정상
입력 방법: 노란 칸만 입력 (파란 글씨). 금액·합계·잔액은 자동 계산. 회색 "예시" 줄은 형식 참고용이라 합계에 안 들어감. 순번 = 영수증 붙이는 순서 = 제품사진 시트 순서. 영수증 하나에 여러 줄(상품·배송비)이면 같은 영수증 번호(R-01 등)를 적음.
순번 | 구매일 | 구매처 | 품목명 | 규격·모델 | 수량 | 단가 (원) | 금액 (원) | 용도 (도면부호) | 영수증 번호 | 제품 사진 | 국내·신품 확인 | 비고
예시 | 2026-10-29 | 쿠팡 (로켓배송) | 샤피 크리에이티브 수성 아크릴 마커 5색 | 불렛 팁, 수성 아크릴 | 1 | 8600 | 8600 | 마커 201 — 말벌 흉부 표식 잉크 (노랑) | R-예시 | 사진 예시 | O | 형식 참고용 — 합계 제외
1 | 2026-10-10 | 불로양봉원 (네이버페이) | 말벌포획기 B형 (본체 + 유인액 2병) | 상용 트랩 「야생 말벌 포획기」 | 1 | 54000 | 54000 | 레트로핏 모듈의 바탕 상용 트랩 — 포획통을 격리함으로 사용, 설계 실측·표본 채집 | 영수증1 | 사진 1 | O
2 | 2026-10-10 | 불로양봉원 (네이버페이) | 배송비 | — | 1 | 3800 | 3800 | 위 품목 배송 | 영수증1 | 사진 2 | O | 배송비 인정 여부 확인 필요
3 | 2026-10-28 | 디바이스마트 (네이버페이) | 라즈베리파이 27W USB-C 아답터 검은색 (공식 정품) | 5.1V 5A, 케이블 일체 | 1 | 18040 | 18040 | 제어부 190 — Pi 5 + AI HAT+ + 카메라 전원 | 영수증2 | 사진 3 | O | 영수증에 "외 1건"으로만 표시 → 주문 상세 캡처를 세부내역으로 첨부
4 | 2026-10-28 | 디바이스마트 (네이버페이) | 라즈베리파이5 액티브 쿨러 (정품) | Raspberry Pi Active Cooler | 1 | 7700 | 7700 | 제어부 190 — Pi 5 방열 (AI HAT+ 아래) | 영수증2 | 사진 4 | O | R-02 영수증에 품목명 없음 → 주문 상세 캡처로 증빙
5 | 2026-10-28 | 디바이스마트 (네이버페이) | 배송비 | — | 1 | 2700 | 2700 | 위 품목 배송 | 영수증2 | 사진 5 | O | 배송비 인정 여부 확인 필요
6 | 2026-10-28 | 하멜른 (네이버페이) | 등검은말벌 표본 Vespa velutina — 국산 액침표본 | 액침표본 | 7 | 3000 | 21000 | 설계 실측(흉부 폭·몸 높이), 마킹·검출 시험(J4·J8), VespAI 재학습 사진 | 영수증3 | 사진 6 | O | 표본이 "재료"로 인정되는지 확인 필요. 상품 주문 21,000원(7개)
7 | 2026-10-28 | 하멜른 | 배송비 | — | 1 | 3000 | 3000 | 위 품목 배송 | 영수증3 | 사진 7 | O | 배송비 인정 여부 확인 필요
8 | 2026-10-29 | 쿠팡 (로켓배송) | 월드크린 테프론 테이프 4m | PTFE 테이프, 4 m | 1 | 900 | 900 | 마커 잉크 부착 시험(J9) 시편 — 말벌 몸 표면처럼 잘 안 붙는 표면 대용 | 영수증5 | 사진 8 | O | 영수증5 = 거래명세표(PDF) + 카드영수증(캡처, 카드번호 일부 보임 → 레포 X)
9 | 2026-10-29 | 쿠팡 (로켓배송) | 샤피 크리에이티브 수성 마커 총알팁 12색 | 수성 아크릴, 불렛(총알) 팁, 12색 1세트 | 1 | 18870 | 18870 | 마커 201 — 말벌 흉부 표식 잉크 (노랑 사용), 점 크기·건조 시험(J9) | 영수증6 | 사진 9 | O | 영수증6은 개인 물품 3개와 함께 주문 — 이 품목만 청구(1행). 주문 할인 2,900원은 여러 개 같이 사서 붙은 할인 → 샤피는 18,870원으로 청구 (승준 판단 10/29)
10 |  |  |  |  |  |  |  |  |  | 사진 10
11 |  |  |  |  |  |  |  |  |  | 사진 11
12 |  |  |  |  |  |  |  |  |  | 사진 12
13 |  |  |  |  |  |  |  |  |  | 사진 13
14 |  |  |  |  |  |  |  |  |  | 사진 14
15 |  |  |  |  |  |  |  |  |  | 사진 15
16 |  |  |  |  |  |  |  |  |  | 사진 16
17 |  |  |  |  |  |  |  |  |  | 사진 17
18 |  |  |  |  |  |  |  |  |  | 사진 18
19 |  |  |  |  |  |  |  |  |  | 사진 19
20 |  |  |  |  |  |  |  |  |  | 사진 20
21 |  |  |  |  |  |  |  |  |  | 사진 21
22 |  |  |  |  |  |  |  |  |  | 사진 22
23 |  |  |  |  |  |  |  |  |  | 사진 23
24 |  |  |  |  |  |  |  |  |  | 사진 24
25 |  |  |  |  |  |  |  |  |  | 사진 25
26 |  |  |  |  |  |  |  |  |  | 사진 26
27 |  |  |  |  |  |  |  |  |  | 사진 27
28 |  |  |  |  |  |  |  |  |  | 사진 28
29 |  |  |  |  |  |  |  |  |  | 사진 29
30 |  |  |  |  |  |  |  |  |  | 사진 30
합계 |  |  |  |  |  |  | 130010

Sheet: 제품사진
제품 사진 (정산보고서 필수) — 순번별로 받은 물건 사진을 C열 칸에 붙임
순번 | 품목명 | 사진 (여기에 붙이기) | 촬영일
1 | 말벌포획기 B형 (본체 + 유인액 2병)
2 | 배송비
3 | 라즈베리파이 27W USB-C 아답터 검은색 (공식 정품)
4 | 라즈베리파이5 액티브 쿨러 (정품)
5 | 배송비
6 | 등검은말벌 표본 Vespa velutina — 국산 액침표본
7 | 배송비
8 | 월드크린 테프론 테이프 4m
9 | 샤피 크리에이티브 수성 마커 총알팁 12색
10
11
12
13
14
15
16
17
18
19
20
21
22
23
24
25
26
27
28
29
30

Sheet: 작성요령
재료비 정산 규칙 요약 (출처: 2026 천안공과대학 창의융합 경진대회 설명회 자료)
지원 한도 50만 원, 초과 불가. 과제물 제작에 필요한 재료만 인정.
불인정: 사무용품(복사용지·볼펜·마우스 등), 전산용품(하드디스크·램·메모리·토너 등), 계속 쓰는 공구(드릴·피펫·전기톱 등).
해외구매·중고거래 불가. 불인정 항목 집행 또는 서류 미충족 시 재료비 전액 환수.
정산 금액은 팀장 계좌로 입금 (경진대회 종료 후). 애매한 물품은 설명회 자료상 팀장이 담당자에게 메일로 문의.
제출 서류 (2026-11-30)
이 정산보고서(제품 사진 포함) / 과제결과보고서 / 영수증(세부내역 필수) / 재학증명서(팀원 전부) / 통장사본(팀장만)
영수증
영수증 붙이는 순서 = 이 표의 순번 순서. 순서가 다르면 영수증에 순번(R-01 등)을 적음.
세부내역(품목·금액)이 보이는 영수증. 견적서도 가능 — 수신자는 팀장·팀원 이름 (연구실·지도교수님 이름 X). 수기 영수증은 업체 직인 필요.
주문할 때마다 확인
□ 국내 판매처·신품인가 (해외 직구, 쿠팡 로켓직구, 중고 X) □ 사무·전산용품·공구가 아닌가
□ 세부내역 영수증을 PDF·캡처로 저장했나 □ 물건이 오면 사진을 찍어 제품사진 시트에 붙였나
파일 정보
정산 담당 이승준. 레포 purchase/ 폴더에 보관 (영수증 원본·통장사본·재학증명서는 개인정보라 레포에 올리지 않음).
