britams/-capstone-project-repo/cad/img/parts/feeder/P142n_코튼롤.png

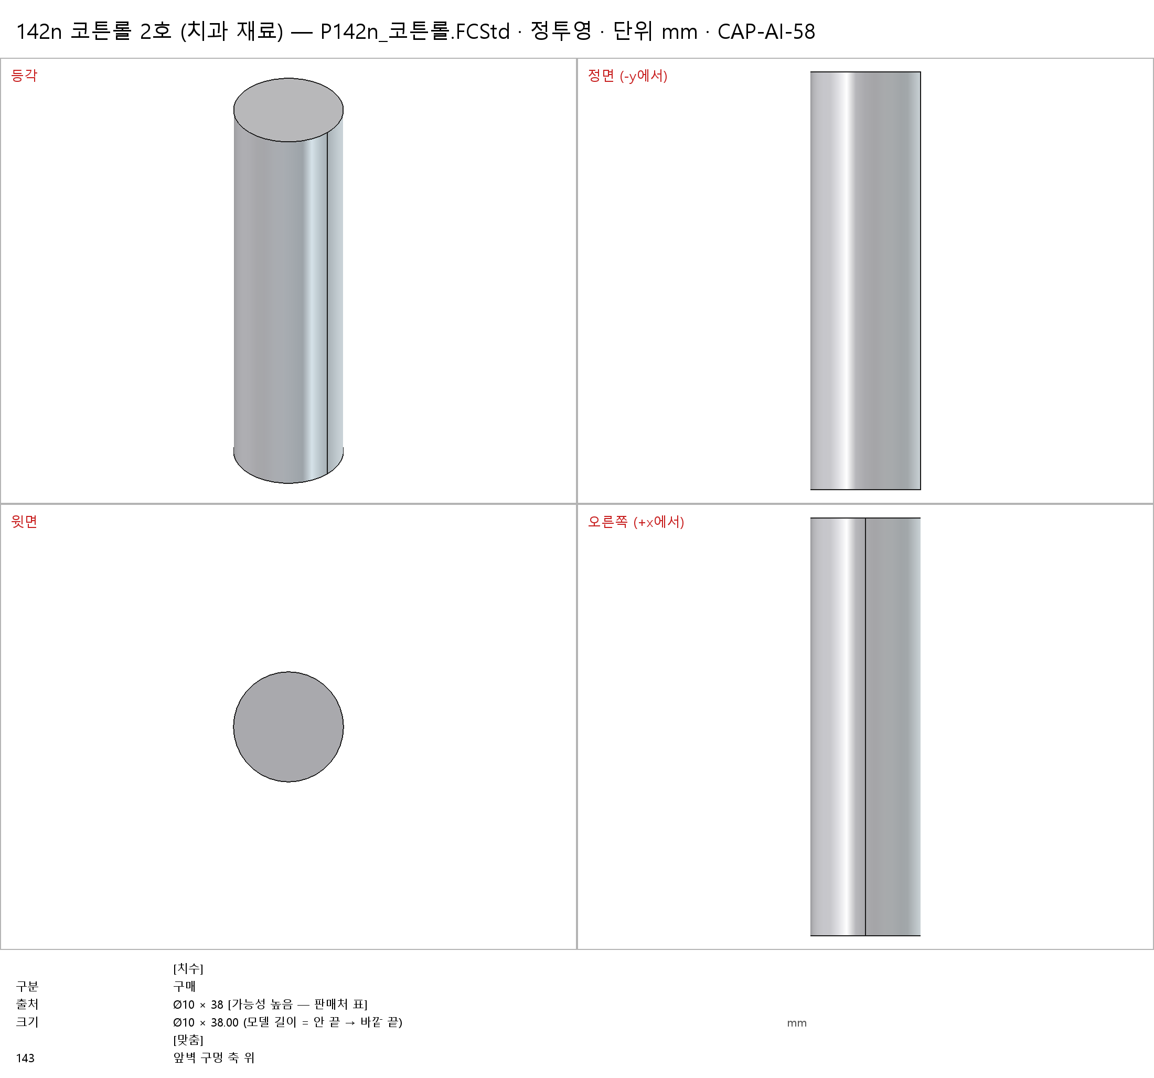
cad/img/parts/feeder/P142n_코튼롤.png
