britams/-capstone-project-repo/cad/img/parts/feeder/P143_물길그릇.png

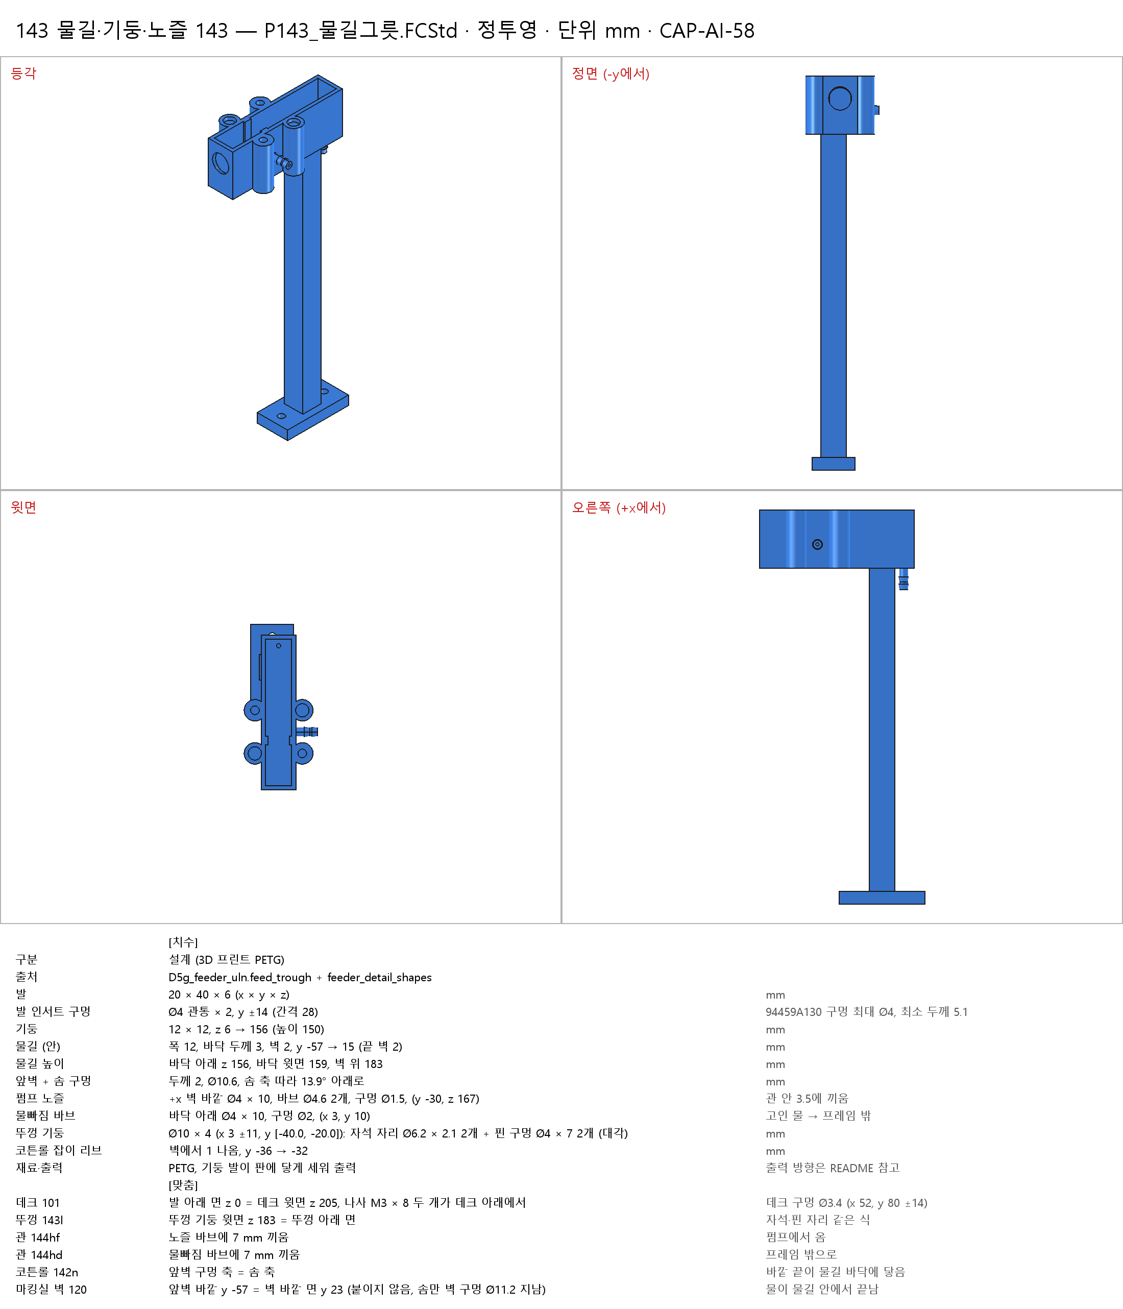
cad/img/parts/feeder/P143_물길그릇.png
