britams/-capstone-project-repo/cad/img/parts/feeder/P143l_뚜껑.png

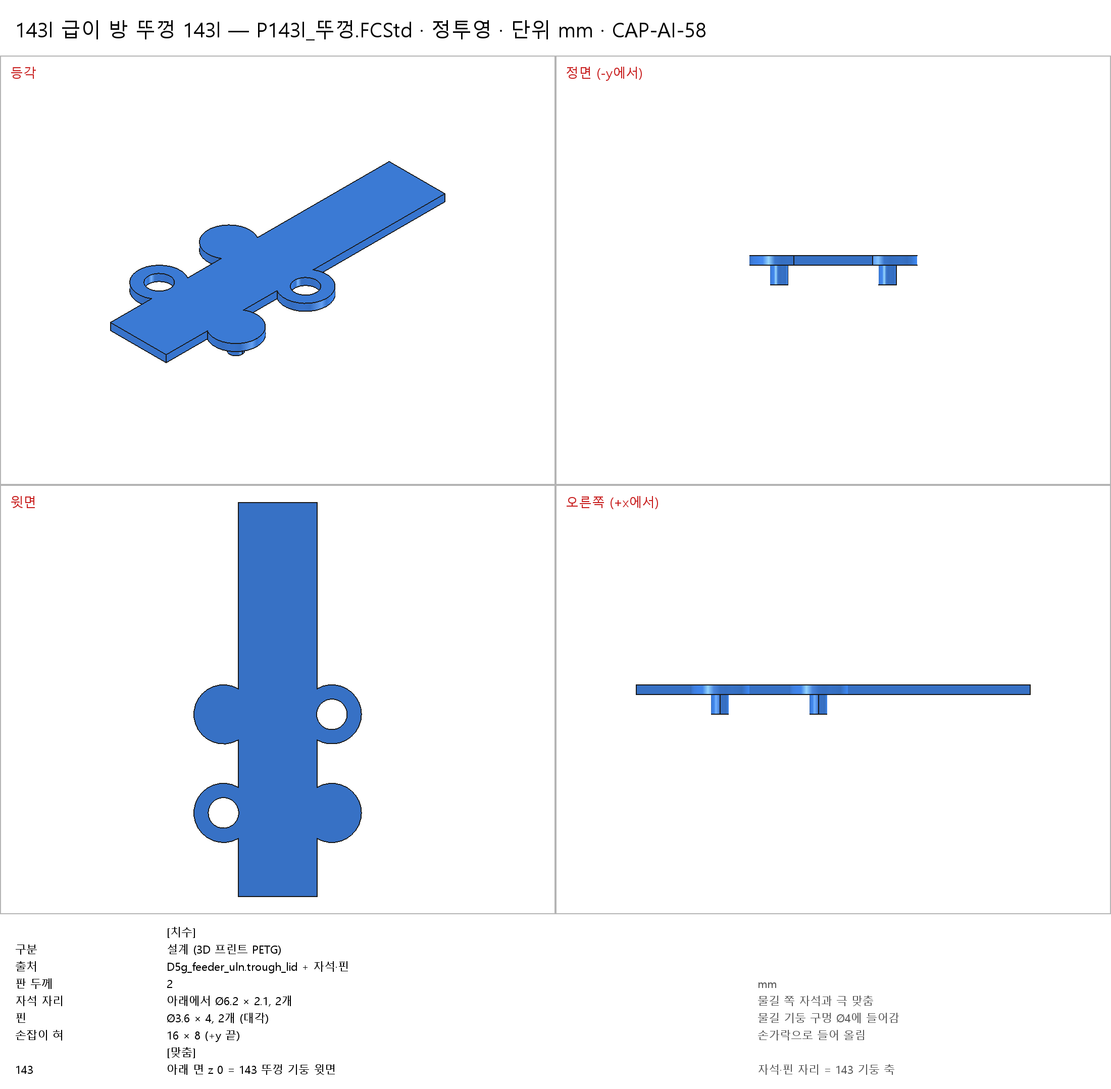
cad/img/parts/feeder/P143l_뚜껑.png
