britams/-capstone-project-repo/cad/img/parts/feeder/P144n_튜브15mL.png

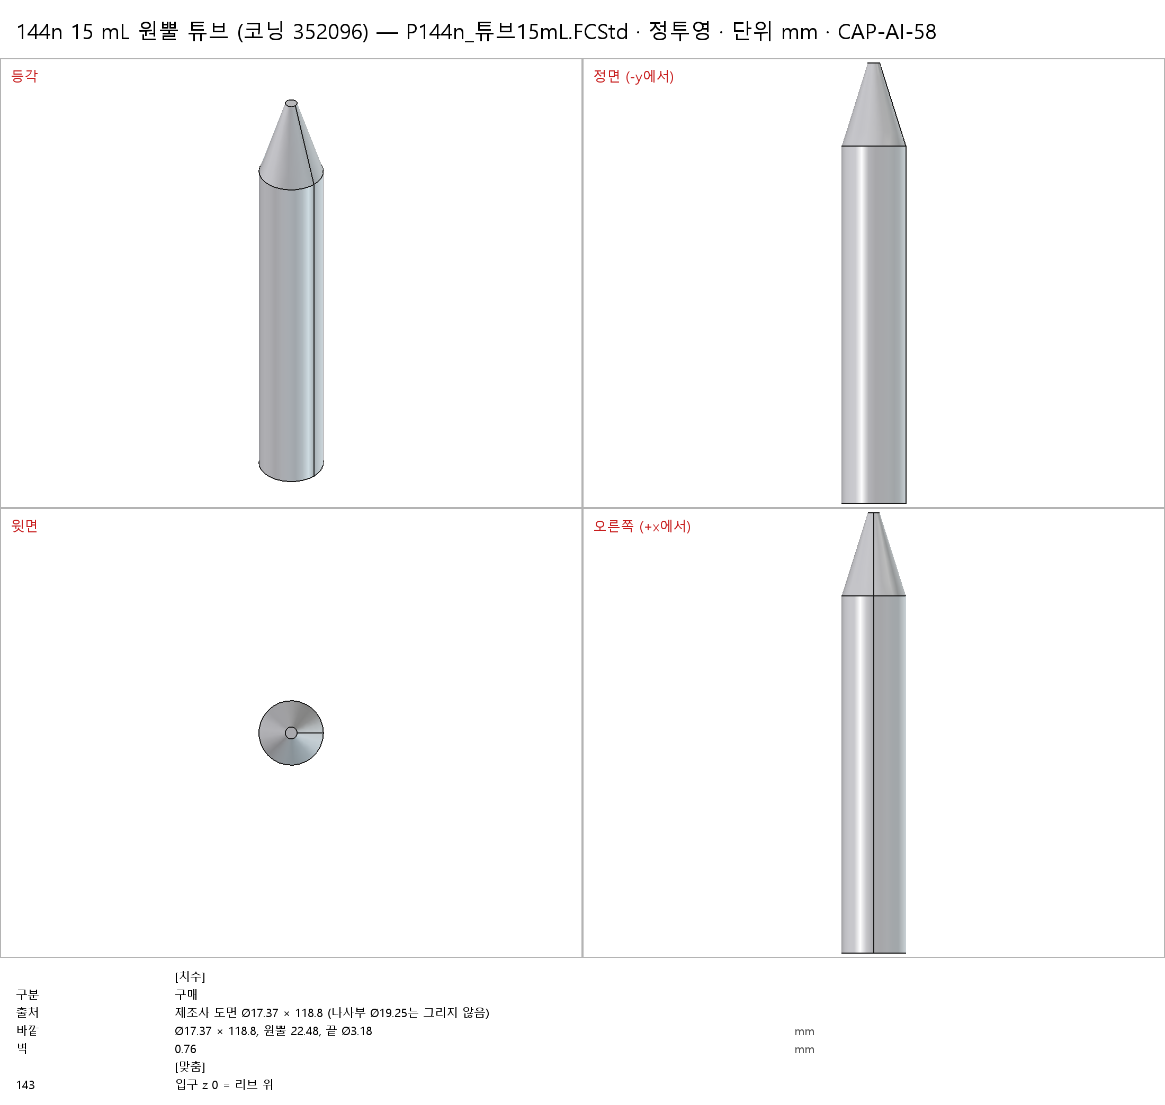
cad/img/parts/feeder/P144n_튜브15mL.png
