britams/-capstone-project-repo/cad/img/parts/feeder/P92000A118_냄비M3x8.png

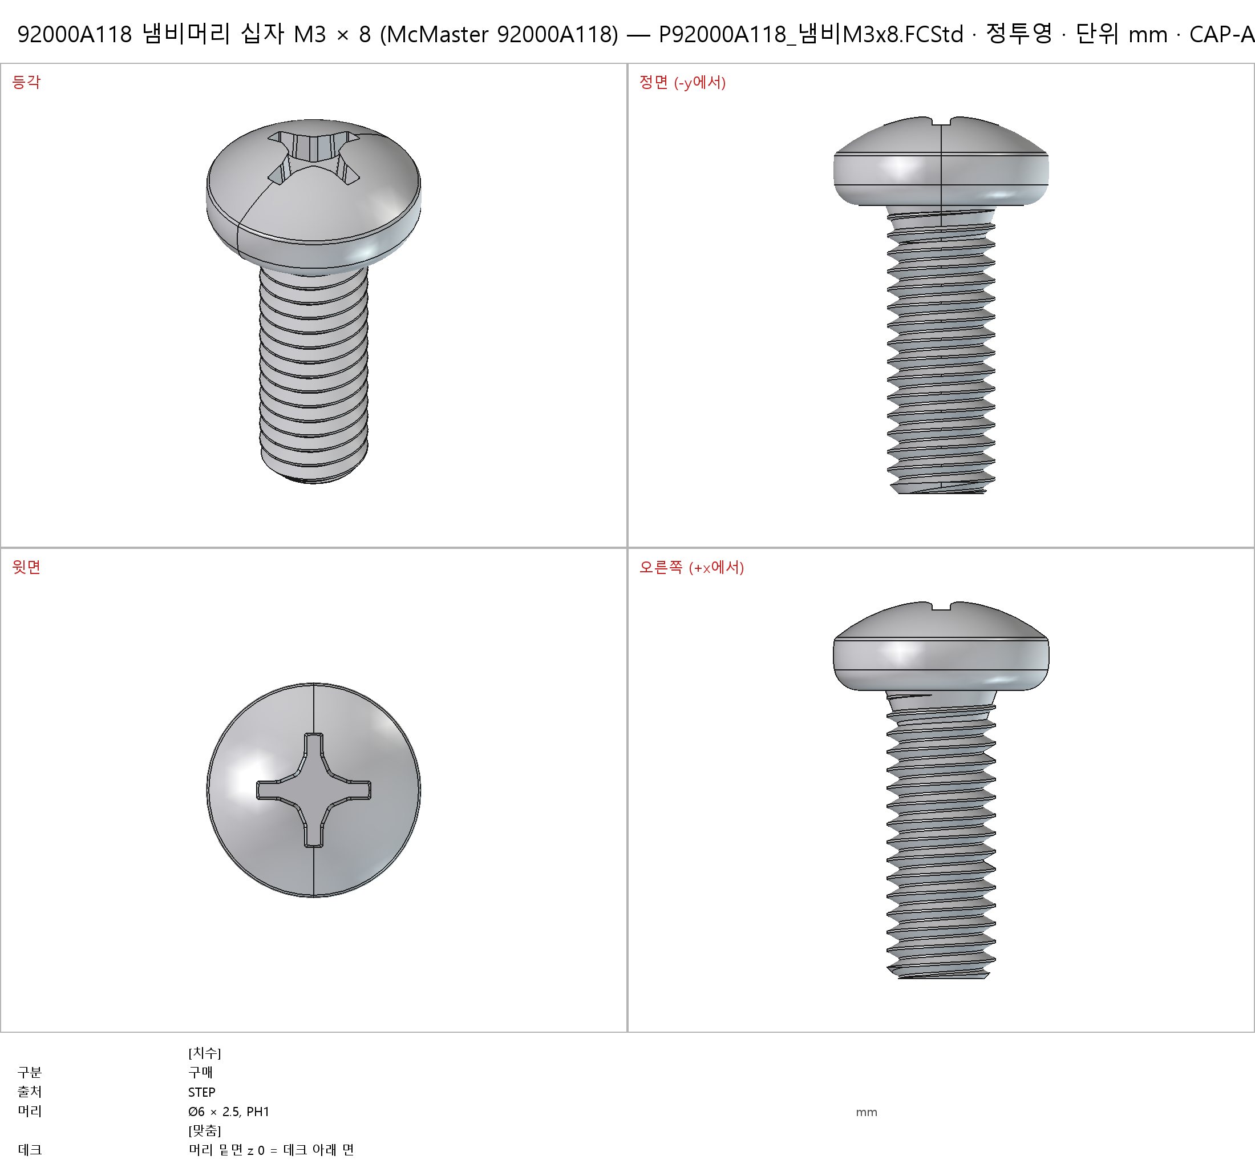
cad/img/parts/feeder/P92000A118_냄비M3x8.png
