britams/-capstone-project-repo/cad/img/parts/feeder/P92545A111_손나사M3x8.png

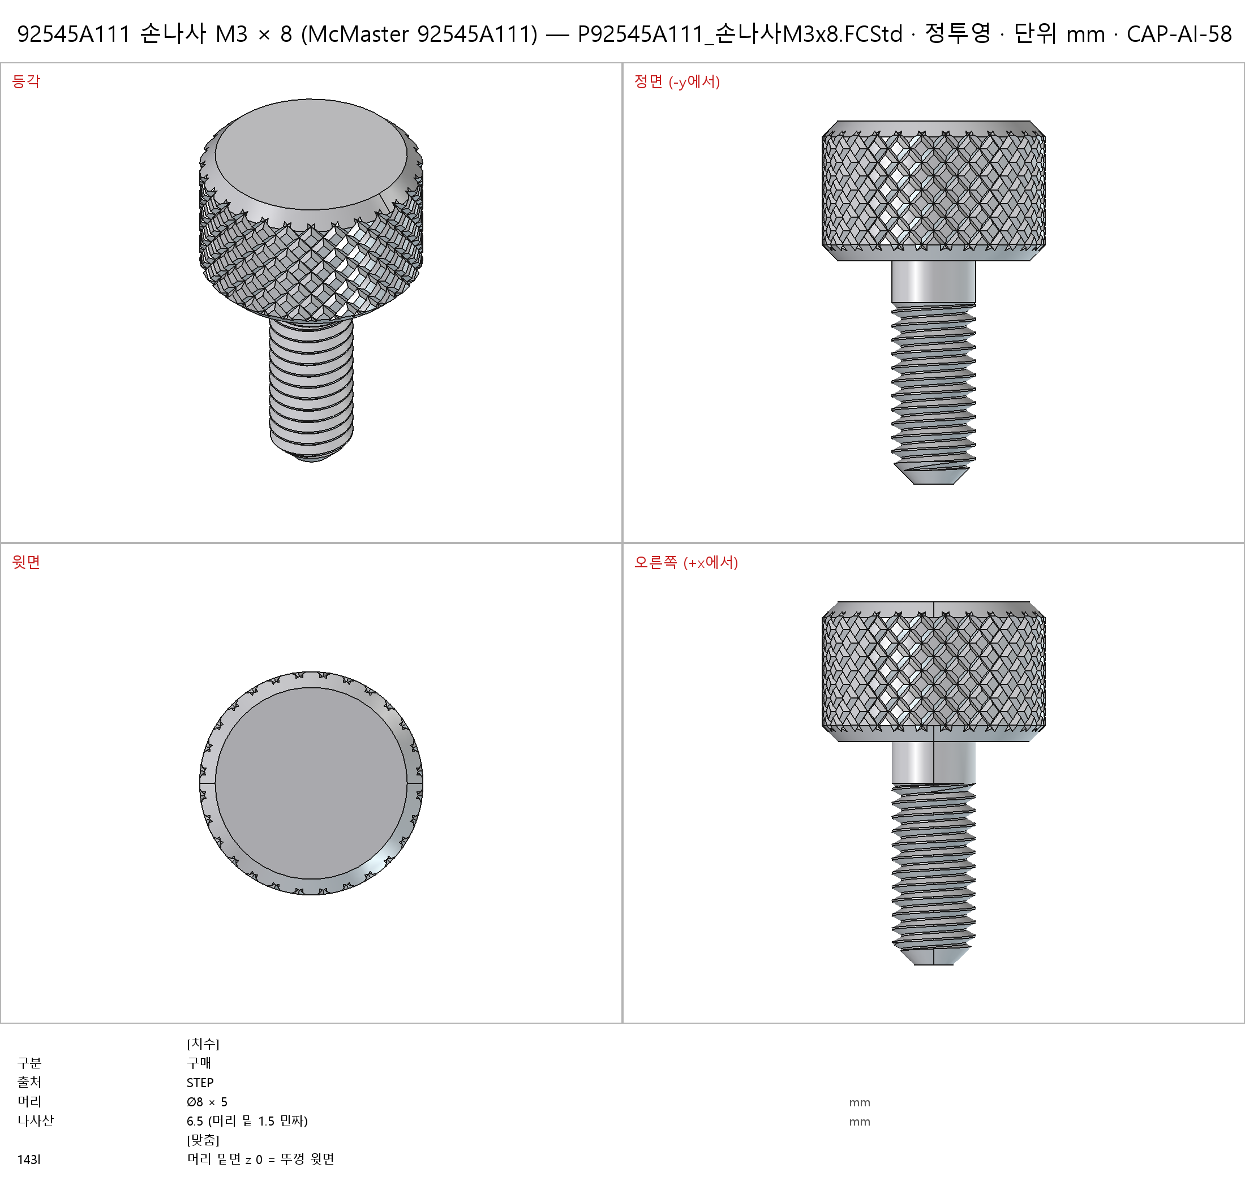
cad/img/parts/feeder/P92545A111_손나사M3x8.png
