britams/-capstone-project-repo/cad/img/parts/feeder/P94459A130_인서트M3.png

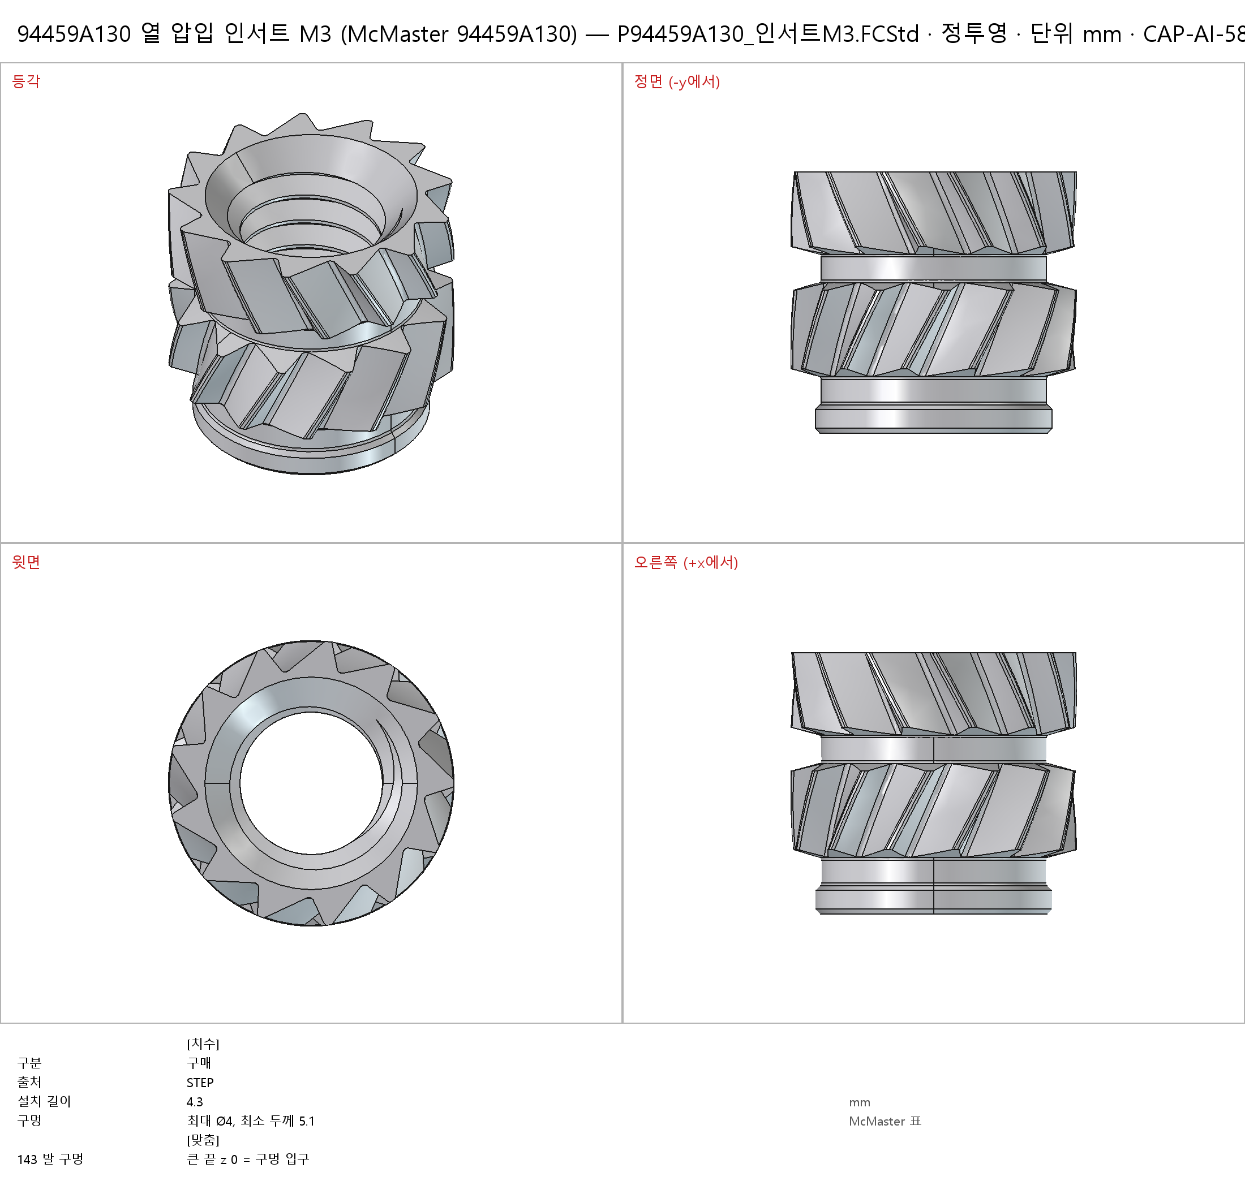
cad/img/parts/feeder/P94459A130_인서트M3.png
