britams/-capstone-project-repo/cad/img/parts/feeder/급이방_자른면_사는것_프린트.png

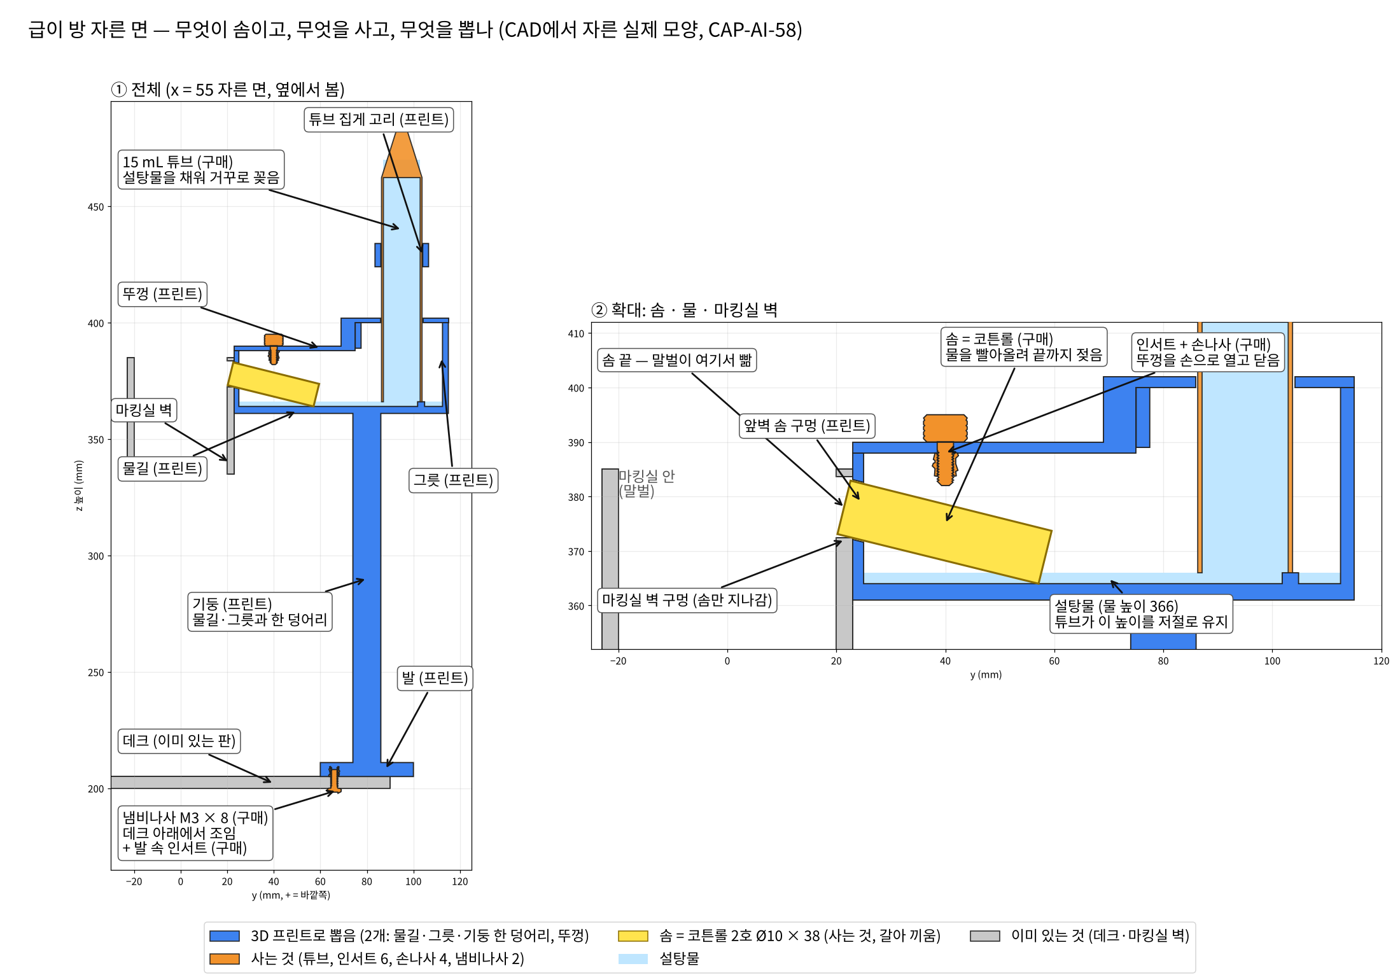
cad/img/parts/feeder/급이방_자른면_사는것_프린트.png
