britams/-capstone-project-repo/cad/img/parts/lift/Lift_v2_옆.png

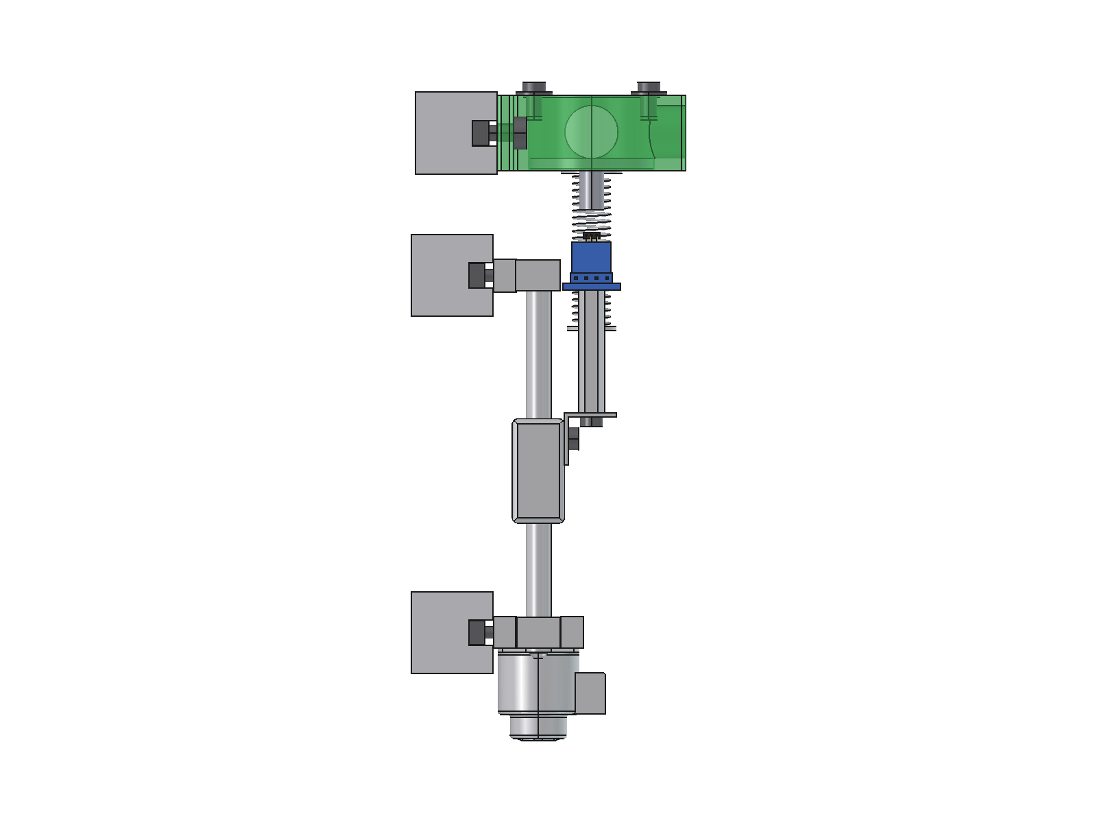
cad/img/parts/lift/Lift_v2_옆.png
