britams/-capstone-project-repo/cad/img/parts/lift/Lift_v2_정면.png

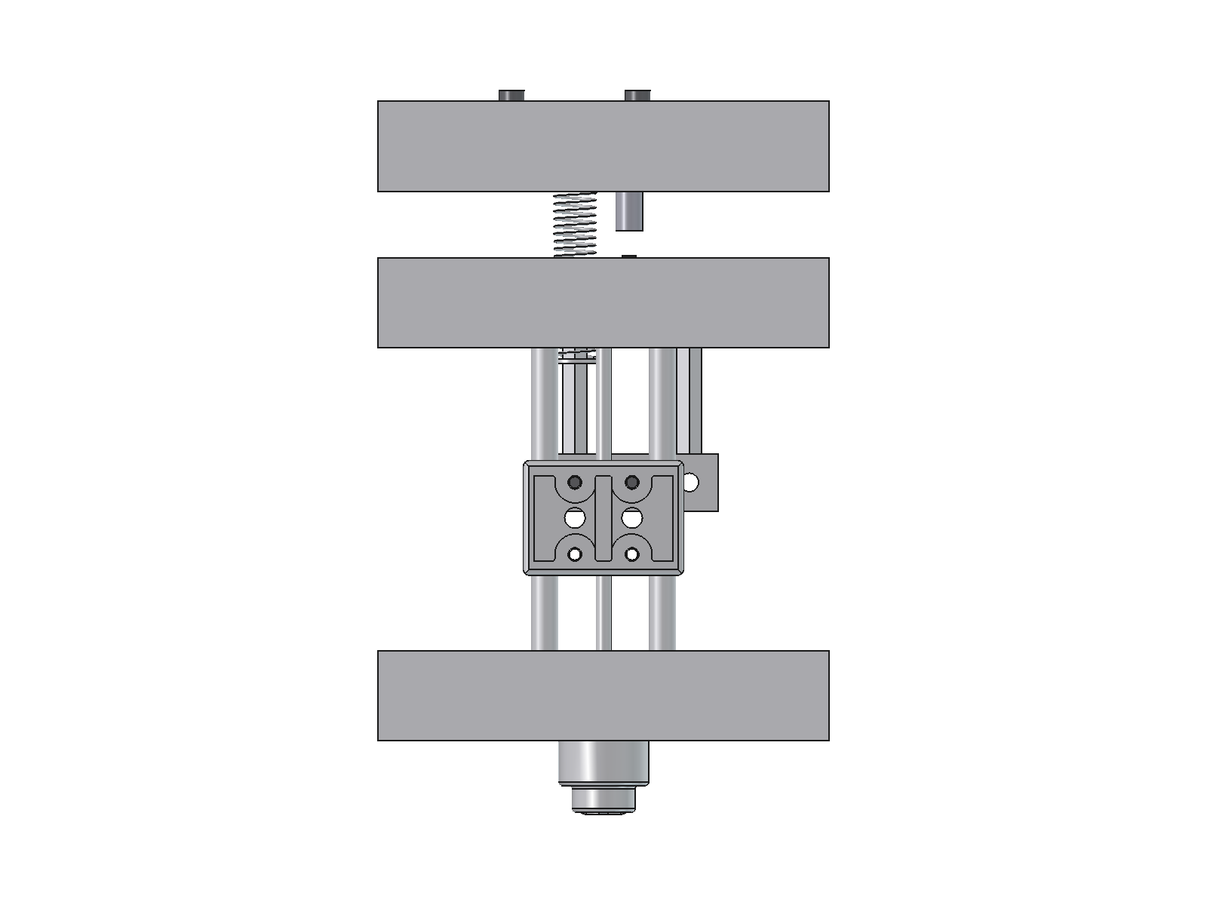
cad/img/parts/lift/Lift_v2_정면.png
