britams/-capstone-project-repo/cad/img/parts/lift/P153m_리니어모듈_등각.png

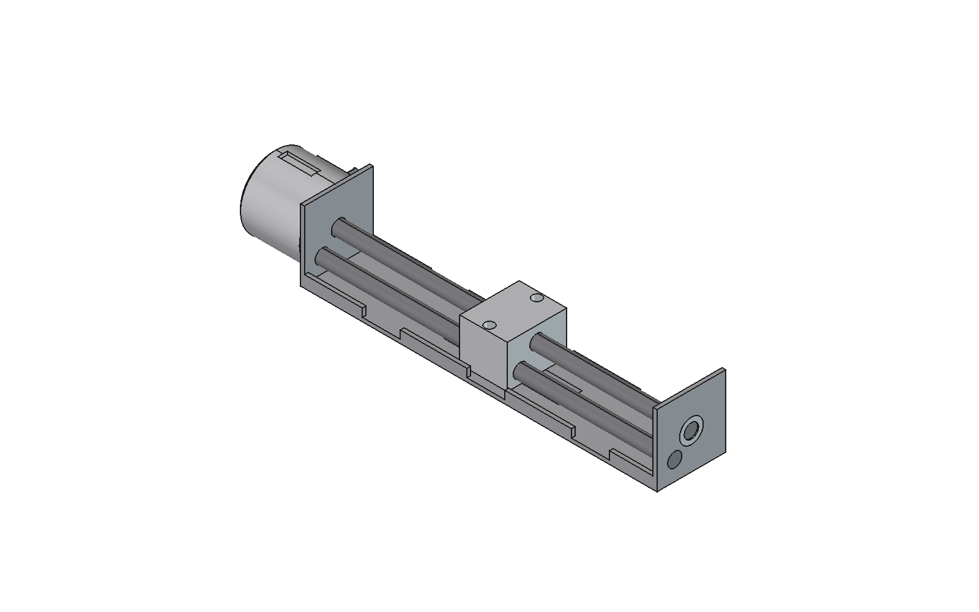
cad/img/parts/lift/P153m_리니어모듈_등각.png
