britams/-capstone-project-repo/cad/img/parts/lift/P153m_리니어모듈_정면.png

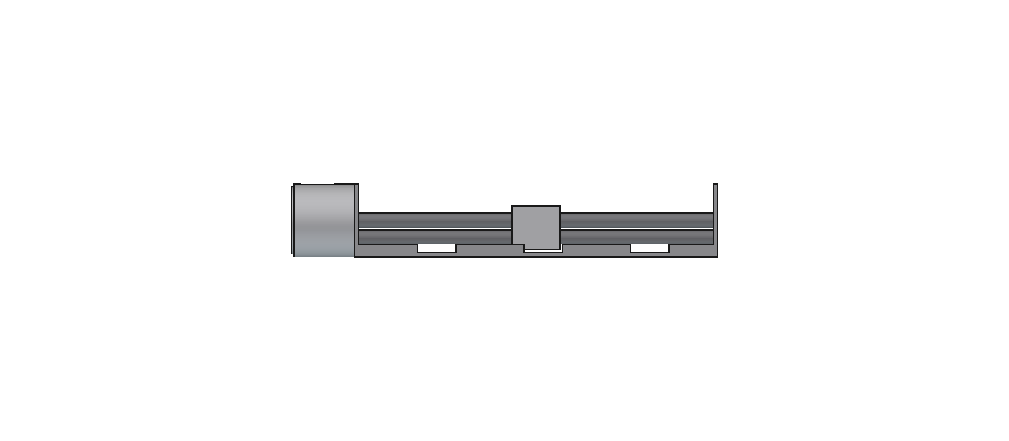
cad/img/parts/lift/P153m_리니어모듈_정면.png
