britams/-capstone-project-repo/cad/img/parts/lift/S2a_바닥구동_정면.png

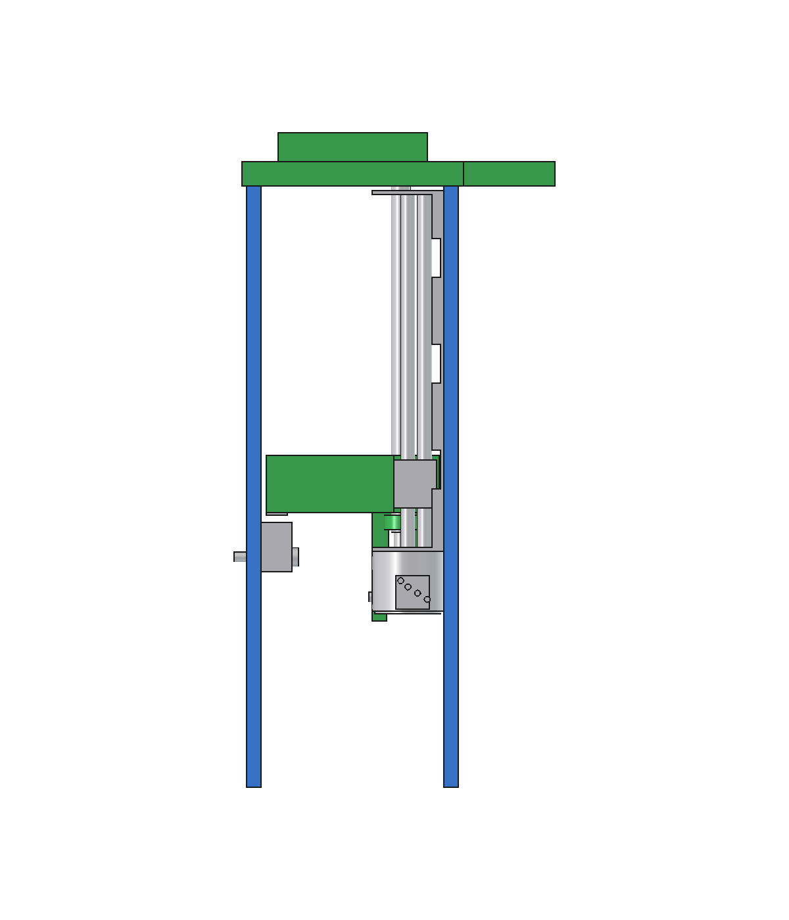
cad/img/parts/lift/S2a_바닥구동_정면.png
