britams/-capstone-project-repo/cad/img/parts/lift/S2v3_등각.png

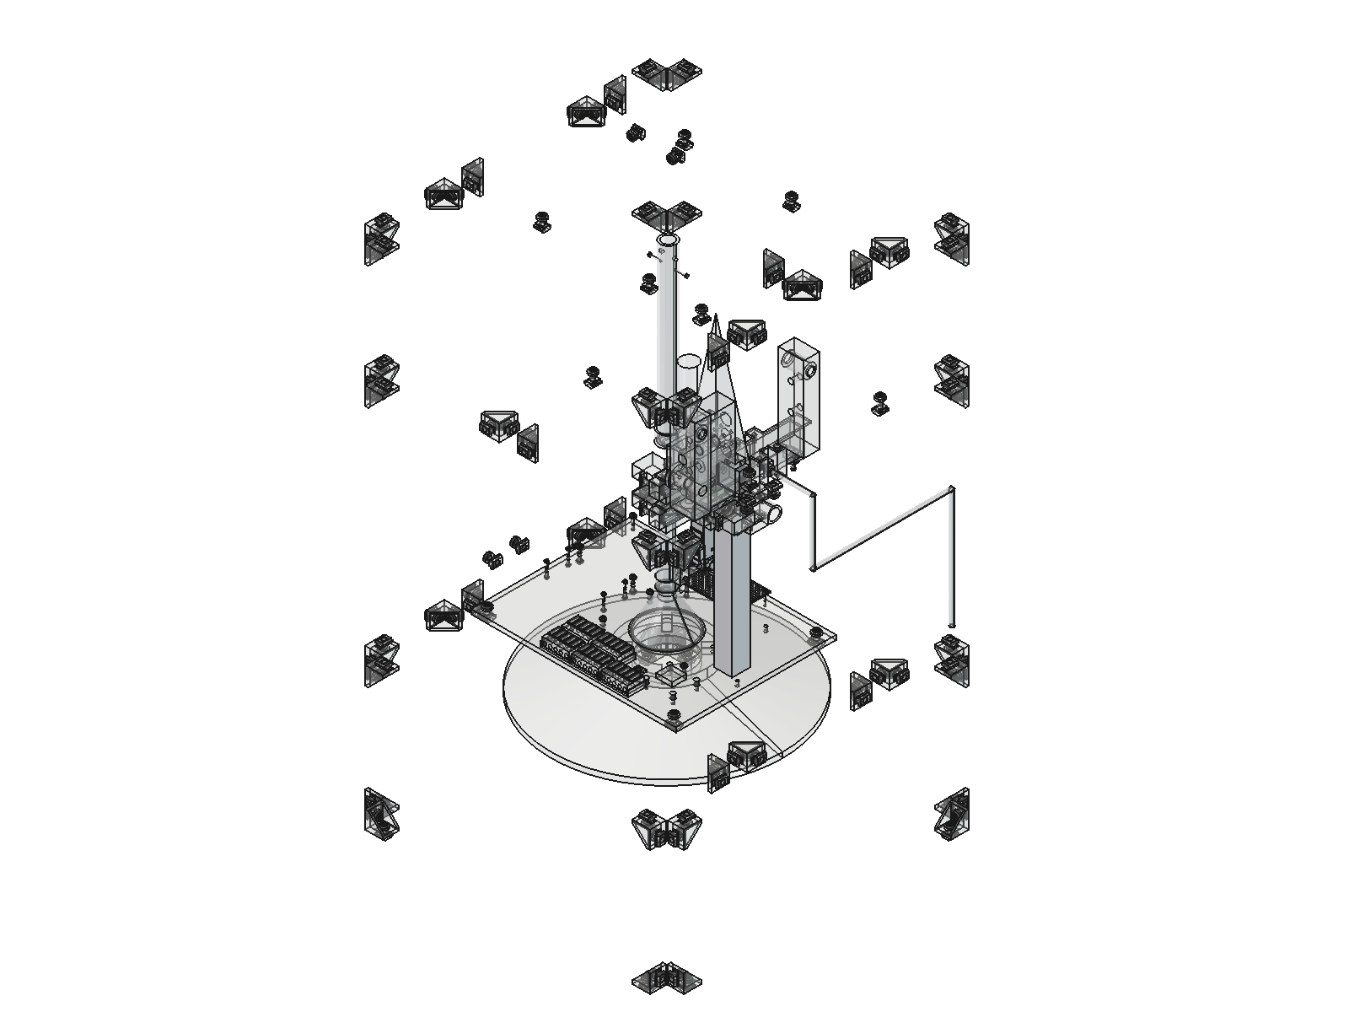
cad/img/parts/lift/S2v3_등각.png
