britams/-capstone-project-repo/cad/img/parts/lift/S2v3_정면.png

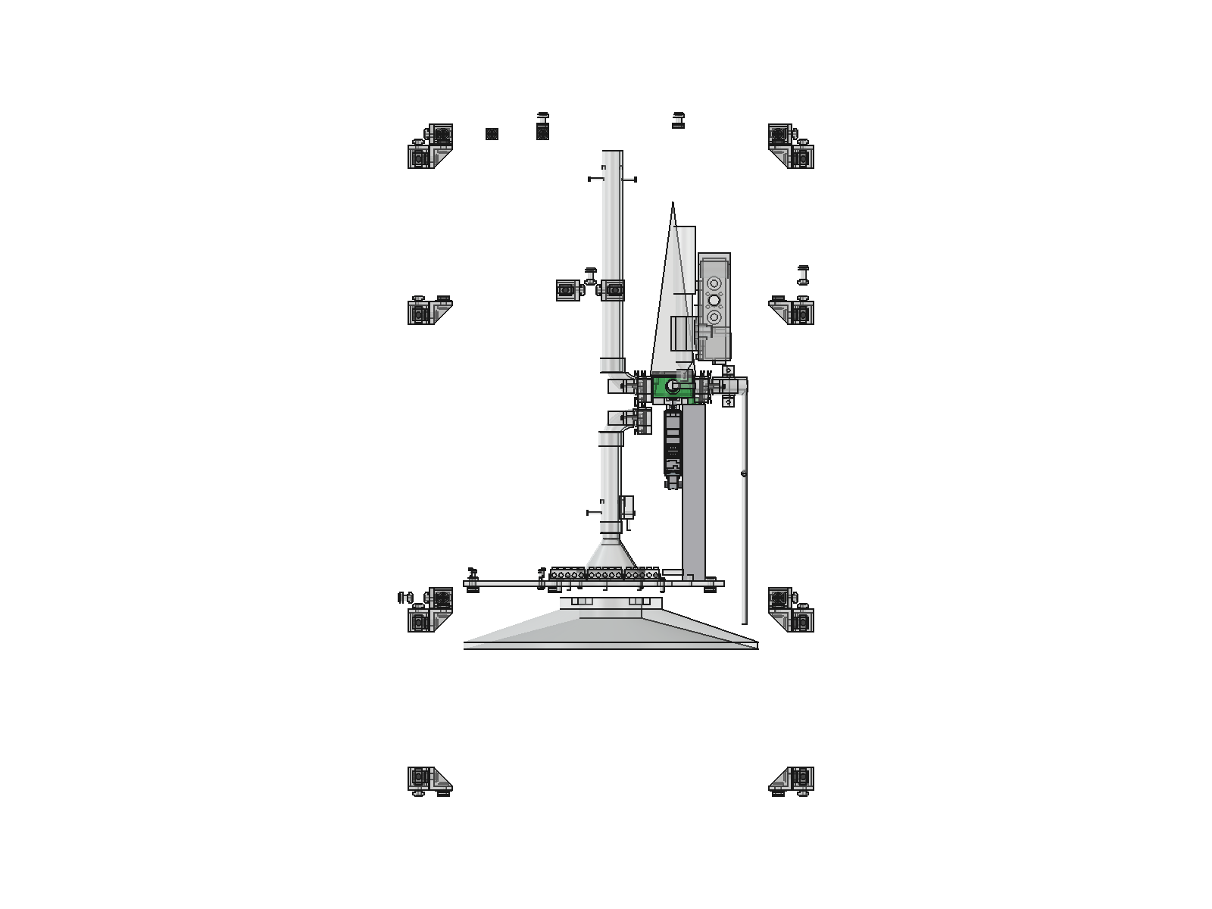
cad/img/parts/lift/S2v3_정면.png
