britams/-capstone-project-repo/cad/img/parts/lift/S2v3d_옆.png

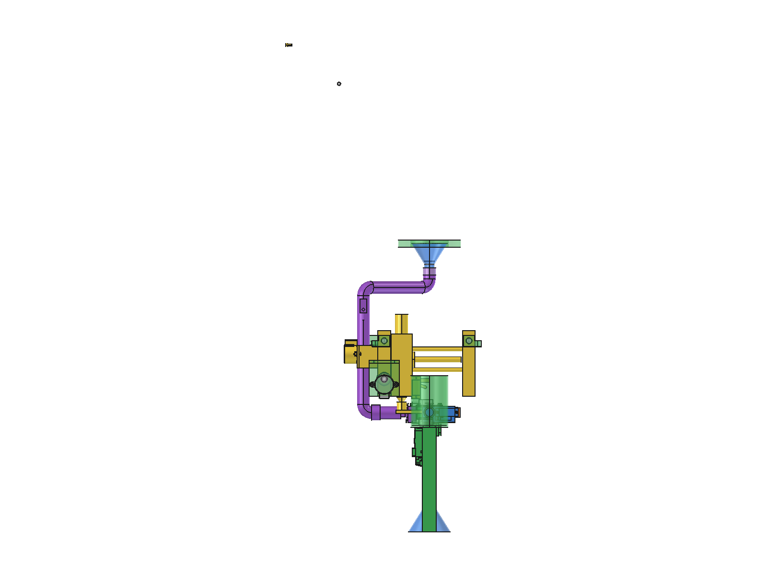
cad/img/parts/lift/S2v3d_옆.png
