britams/-capstone-project-repo/cad/img/parts/lift/S2v3d_위.png

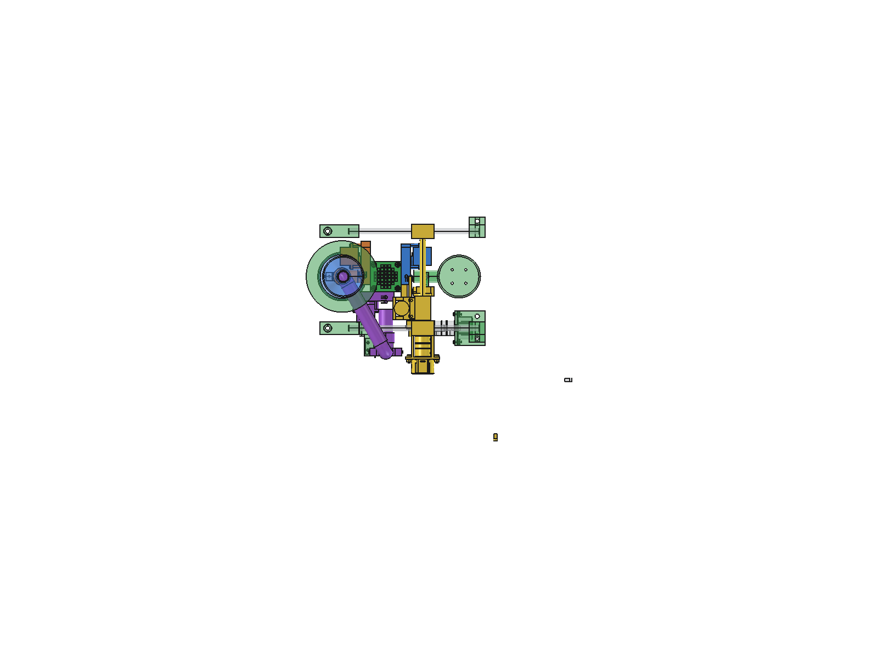
cad/img/parts/lift/S2v3d_위.png
