britams/-capstone-project-repo/cad/D5g_full.FCStd

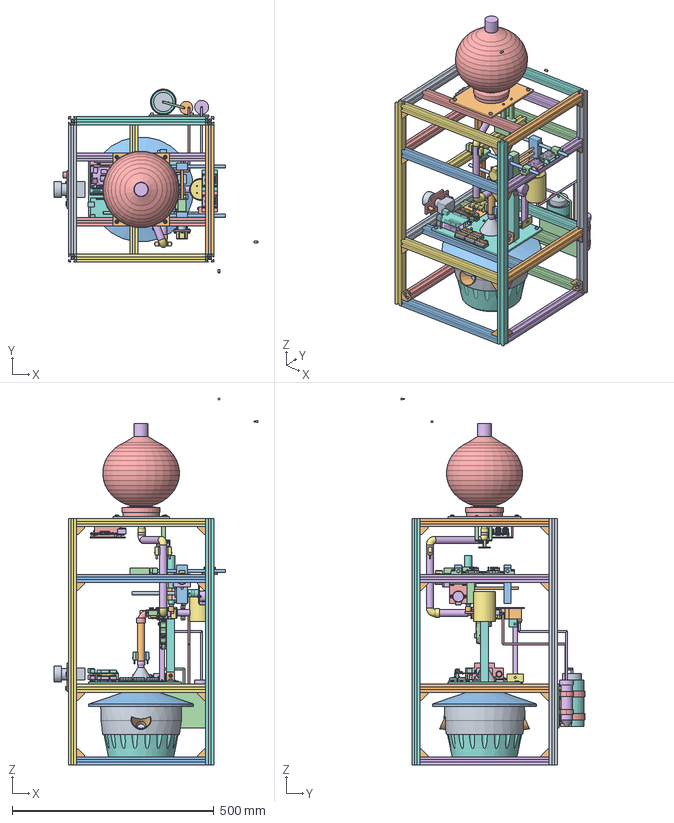
[picture p149: CAD file, 2026-11-14]
cad/D5g_full.FCStd
503.8 x 455.0 x 908.5 mm
142n_cotton_roll_#2 (Ø10×38, 구매)
143_feed_trough (물길 — 포맥스 2·3 mm 판 자름·접착 + 블록 10 mm 4 + 니플 받침 5 mm 2, CAP-AI-61)
143l_feed_trough_lid (뚜껑 — 포맥스 2 mm 자름, 자석 2쌍 + 핀 2, 손으로 뗌)
143m_magnet_trough (네오디뮴 Ø6 × 2 N35, 물길 기둥 2개, 구매)
143mm_magnet_lid (네오디뮴 Ø6 × 2 N35, 뚜껑 2개, 구매)
143p_post_sq12 (기둥 — 알루미늄 각관 12 × 12 × 1 자름, 구매)
143a_angle_foot (발 — 알루미늄 앵글 20 × 20 × 2 × 40 자름·구멍, 구매)
143b_angle_top (위 — 알루미늄 앵글 20 × 20 × 2 × 20 자름·구멍, 물길 바닥에 에폭시, 구매)
143h_screws_M3 (M3 냄비머리 12 ×2 · 18 ×2, 구매)
143hn_nuts_M3 (M3 너트 4, 구매)
143n_nipple_M5_barb (공압 M5 호스 니플 2 — 노즐·물빠짐, 구매)
144b_feeder_holder (병·펌프 걸이 — 알루미늄 판 3 mm 148 × 108 자름·구멍, CAP-AI-61)
144c_pipe_clamp (파이프 클램프 Ø60 2개 — 병, Ø30 2개 — 버림통, 판에 M4, 구매)
144w_waste_tube_50mL (버림통 — 코닝 352070 50 mL, 뚜껑에 관 구멍, 구매)
144z_cable_ties (케이블 타이 2 — 펌프, 구매)
144n_bottle_250mL (Nalgene 2104-0008 HDPE, 구매)
144nc_bottle_cap (병 뚜껑 — 관 Ø5·공기 Ø2 구멍 뚫음)
144p_pump (연동 펌프 Adafruit 3910, 5~6 V 0.5 A, 구매)
144pp_pump_ports (펌프 관 자리)
144h_tube_suck (실리콘 관 3.5 × 5, 병 → 펌프, 구매)
144hf_tube_feed (실리콘 관 3.5 × 5, 펌프 → 노즐, 구매)
144hd_tube_drain (실리콘 관 3.5 × 5, 물길 바닥 → 바깥, 구매)
144s_bolt_M5x8 (걸이 → 레일, 2개, 구매)
144t_tnut_M5_dropin (2020 드롭인 T너트 2개, 구매)
111_entry_funnel (McMaster 9017T211 PP 깔때기 — 윗테 잘라 Ø61, 목 5 남김, 구매)
110_entry_duct (수도용 PVC 13A — 바깥 18·안 13, 116 mm 자름, 빔 구멍 Ø3.2 2, 구매)
114_entry_sensor_tx (Adafruit 2167 송신 — 20 × 10 × 8, LED 끝에서 5, 실제 치수)
114_entry_sensor_rx (Adafruit 2167 수신 — 20 × 10 × 8, LED 끝에서 5, 실제 치수)
112_entry_gate_housing (D5f 빔 구멍 + 서보 기둥 2개 한 덩어리 출력, SJ-53 −y 받침)
112_entry_gate_flap
112_entry_gate_servo_MG90S
112_entry_gate_servo_spline
112_entry_gate_horn
170_isolation_gate_housing (D5f 빔 구멍 + 서보 기둥 2개 한 덩어리 출력, SJ-53 −y 받침)
170_isolation_gate_flap
170_isolation_gate_servo_MG90S
170_isolation_gate_servo_spline
170_isolation_gate_horn
176_release_gate_housing (D5f 빔 구멍 + 서보 기둥 2개 한 덩어리 출력, SJ-53 −y 받침) [11/14: +y로 뒤집음, 먼 모서리 x 74~90·y 41~ 깎음 — 급이 니플·관]
176_release_gate_flap
176_release_gate_servo_MG90S
176_release_gate_servo_spline
176_release_gate_horn
173_isolation_funnel (McMaster 9017T211 PP 깔때기 — 윗테 잘라 Ø52 (위판·104 구멍 Ø55 지남), 목 5 남김, 구매)
104_dome_coupling
174_release_neck (짧은 목 30 mm, 안지름 12 — 굴뚝과 한 덩어리 출력)
175_release_shaft (위로 열린 굴뚝 안지름 50, 꼭대기 z 430, 빗물 구멍 4)
201_marker
202_marker_holder_vblock
203_clamp_strap
205_z_servo_SG90
206_y_carriage
223_holder_guide_pins — 규격 70 mm 그대로 (자르지 않음, 11/15)
205s_z_servo_spline
205h_z_servo_horn
221_y_bearings_LM6UU
224_y_nut_T8
207_y_rods — 규격 150 mm 그대로 (자르지 않음, 11/15)
212_beam_end_blocks — 봉·T8 지나가게 구멍 끝까지 (11/15)
222_x_bearings_LM8UU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
