britams/-capstone-project-repo/cad/parts/feeder/P143l_뚜껑.FCStd

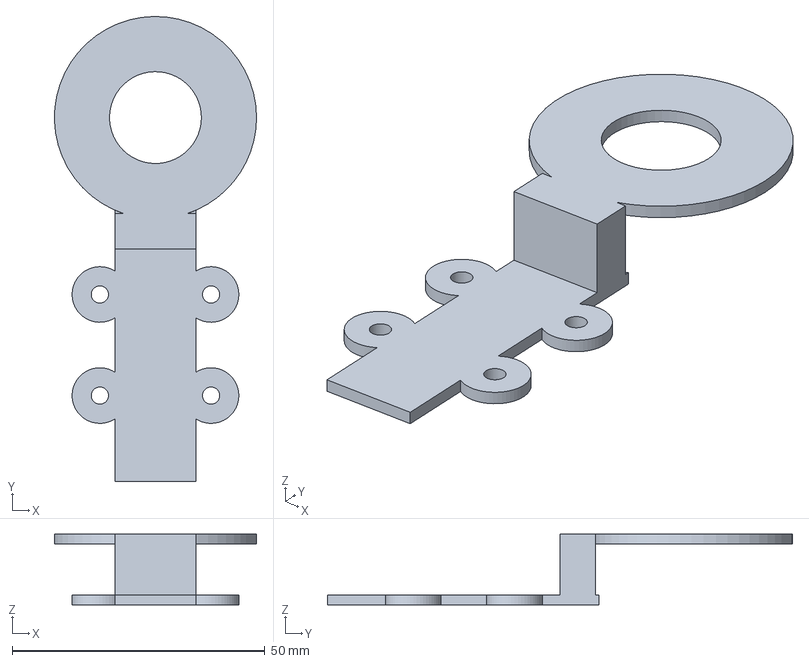
[picture p151: CAD file, 2026-11-10]
cad/parts/feeder/P143l_뚜껑.FCStd
40.0 x 92.0 x 14.0 mm
