britams/-capstone-project-repo/cad/print/all/218_rod_supports.step

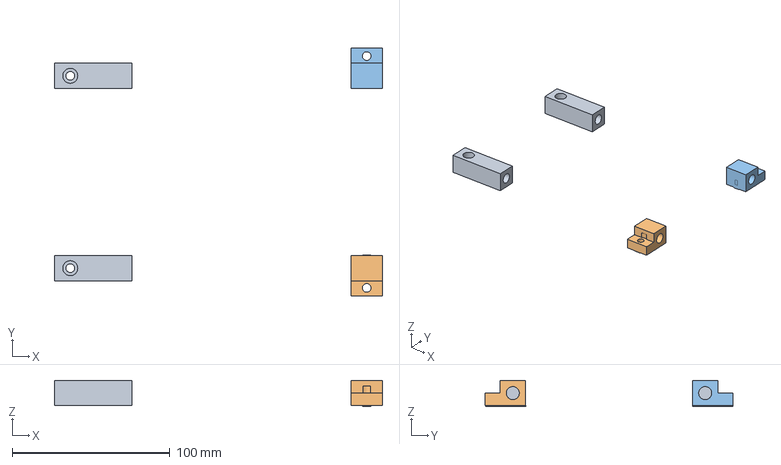
[picture p152: CAD file, 2026-11-14]
cad/print/all/218_rod_supports.step
208.0 x 157.0 x 16.5 mm
