britams/-capstone-project-repo/cad/print/all2/173_isolation_funnel.step

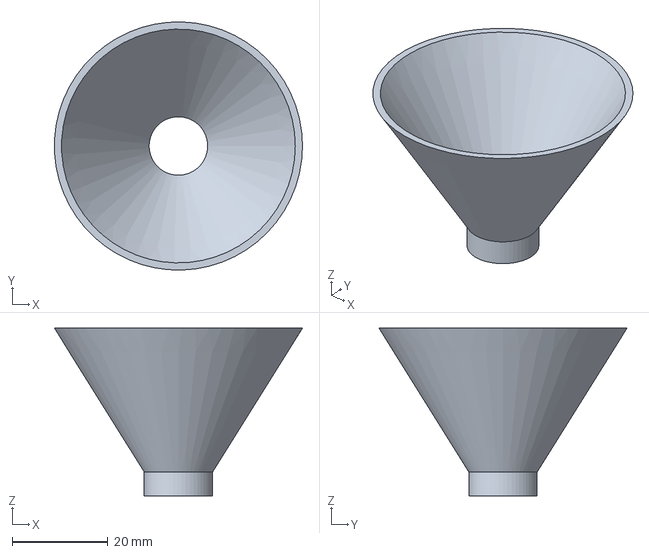
[picture p153: CAD file, 2026-11-14]
cad/print/all2/173_isolation_funnel.step
51.8 x 51.8 x 35.0 mm
