britams/-capstone-project-repo/cad/print/lift/300pf_아크릴_묶음_100x90_2T.dxf

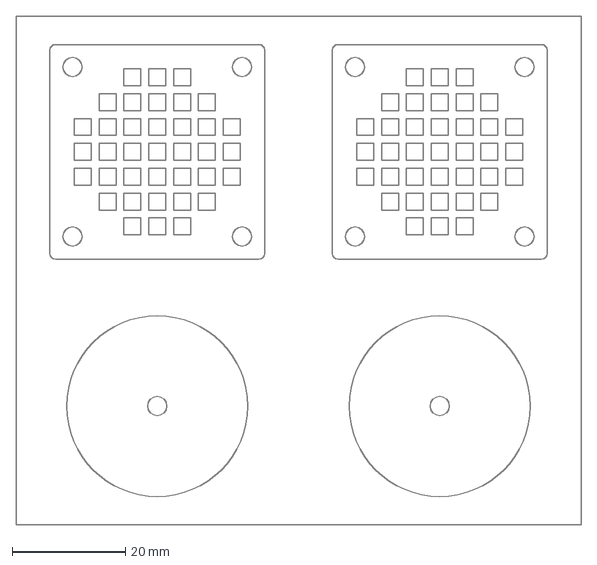
[picture p154: CAD file, 2026-11-14]
cad/print/lift/300pf_아크릴_묶음_100x90_2T.dxf
100.0 x 90.0 mm
