britams/-capstone-project-repo/cad/split/S2_마킹부.FCStd

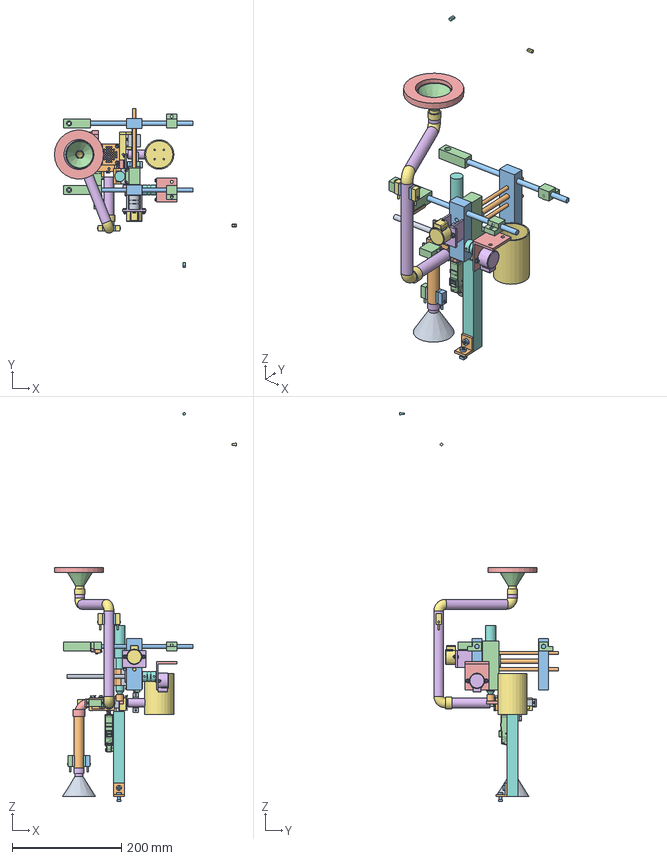
[picture p155: CAD file, 2026-11-14]
cad/split/S2_마킹부.FCStd
333.8 x 290.6 x 712.5 mm
111_entry_funnel (McMaster 9017T211 PP 깔때기 — 윗테 잘라 Ø61, 목 5 남김, 구매)
110_entry_duct (수도용 PVC 13A — 바깥 18·안 13, 116 mm 자름, 빔 구멍 Ø3.2 2, 구매)
114_entry_sensor_tx (Adafruit 2167 송신 — 20 × 10 × 8, LED 끝에서 5, 실제 치수)
114_entry_sensor_rx (Adafruit 2167 수신 — 20 × 10 × 8, LED 끝에서 5, 실제 치수)
112_entry_gate_housing (D5f 빔 구멍 + 서보 기둥 2개 한 덩어리 출력, SJ-53 −y 받침)
112_entry_gate_flap
112_entry_gate_servo_MG90S
112_entry_gate_servo_spline
112_entry_gate_horn
170_isolation_gate_housing (D5f 빔 구멍 + 서보 기둥 2개 한 덩어리 출력, SJ-53 −y 받침)
170_isolation_gate_flap
170_isolation_gate_servo_MG90S
170_isolation_gate_servo_spline
170_isolation_gate_horn
176_release_gate_housing (D5f 빔 구멍 + 서보 기둥 2개 한 덩어리 출력, SJ-53 −y 받침) [11/14: +y로 뒤집음, 먼 모서리 x 74~90·y 41~ 깎음 — 급이 니플·관]
176_release_gate_flap
176_release_gate_servo_MG90S
176_release_gate_servo_spline
176_release_gate_horn
173_isolation_funnel (McMaster 9017T211 PP 깔때기 — 윗테 잘라 Ø52 (위판·104 구멍 Ø55 지남), 목 5 남김, 구매)
104_dome_coupling
174_release_neck (짧은 목 30 mm, 안지름 12 — 굴뚝과 한 덩어리 출력)
175_release_shaft (위로 열린 굴뚝 안지름 50, 꼭대기 z 430, 빗물 구멍 4)
201_marker
202_marker_holder_vblock
203_clamp_strap
205_z_servo_SG90
206_y_carriage
223_holder_guide_pins — 규격 70 mm 그대로 (자르지 않음, 11/15)
205s_z_servo_spline
205h_z_servo_horn
221_y_bearings_LM6UU
224_y_nut_T8
207_y_rods — 규격 150 mm 그대로 (자르지 않음, 11/15)
212_beam_end_blocks — 봉·T8 지나가게 구멍 끝까지 (11/15)
222_x_bearings_LM8UU
225_x_nut_T8
211_y_motor_bracket
209_y_stepper_28BYJ48 (28BYJ-48 5 V — Adafruit 858 STEP, MIT)
209r_y_motor_shaft
210_y_coupling
208_y_lead_screw_T8 — 규격 150 mm 그대로 (자르지 않음, 11/15)
213_x_rods — 규격 200 mm 그대로 (자르지 않음, 11/15)
218_rod_supports (X 봉 받침 4, 3D 프린트 — 100d 쪽 M5 × 10, 둘레 레일 쪽 귀 + M5 × 12, T너트) — 봉·T8 지나가게 구멍 끝까지 (11/15)
217_x_motor_plate (3D 프린트 — 위 날개를 레일 아랫면에 M5 × 8 두 개)
215_x_stepper_28BYJ48 (28BYJ-48 5 V — Adafruit 858 STEP, MIT)
215r_x_motor_shaft
216_x_coupling
214_x_lead_screw_T8 — 규격 150 mm 그대로 (자르지 않음, 11/15)
219_cap_cup
196_gate_G2_ir_pair (3 mm 적외선 LED + 3 mm 수광, KiCad STEP — 다리를 몸통 뒤 1.5에서 옆으로 6 mm 꺾음(납땜 자리), 긴 다리 A·짧은 다리 K, 수광 렌즈가 LED를 마주봄)
196_gate_G2_beam
196_gate_G2b_ir_pair (3 mm 적외선 LED + 3 mm 수광, KiCad STEP — 다리를 몸통 뒤 1.5에서 옆으로 6 mm 꺾음(납땜 자리), 긴 다리 A·짧은 다리 K, 수광 렌즈가 LED를 마주봄)
196_gate_G2b_beam
196_gate_G3_ir_pair (3 mm 적외선 LED + 3 mm 수광, KiCad STEP — 다리를 몸통 뒤 1.5에서 옆으로 6 mm 꺾음(납땜 자리), 긴 다리 A·짧은 다리 K, 수광 렌즈가 LED를 마주봄)
196_gate_G3_beam
196_gate_G3b_ir_pair (3 mm 적외선 LED + 3 mm 수광, KiCad STEP — 다리를 몸통 뒤 1.5에서 옆으로 6 mm 꺾음(납땜 자리), 긴 다리 A·짧은 다리 K, 수광 렌즈가 LED를 마주봄)
196_gate_G3b_beam
196_gate_G5_ir_pair (3 mm 적외선 LED + 3 mm 수광, KiCad STEP — 다리를 몸통 뒤 1.5에서 옆으로 6 mm 꺾음(납땜 자리), 긴 다리 A·짧은 다리 K, 수광 렌즈가 LED를 마주봄)
196_gate_G5_beam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
