britams/-capstone-project-repo/cad/vendor_mit/adafruit/858_28BYJ48.step

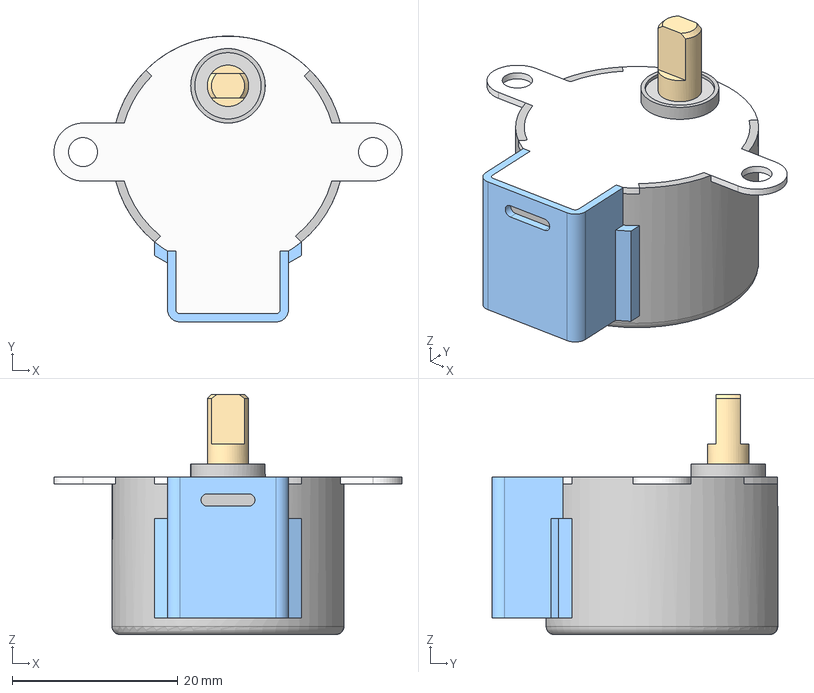
[picture p156: CAD file, 2026-11-11]
cad/vendor_mit/adafruit/858_28BYJ48.step
42.0 x 34.5 x 29.0 mm
