britams/-capstone-project-repo/control/proposals/stl/A_square_3p0_pitch4p4.stl

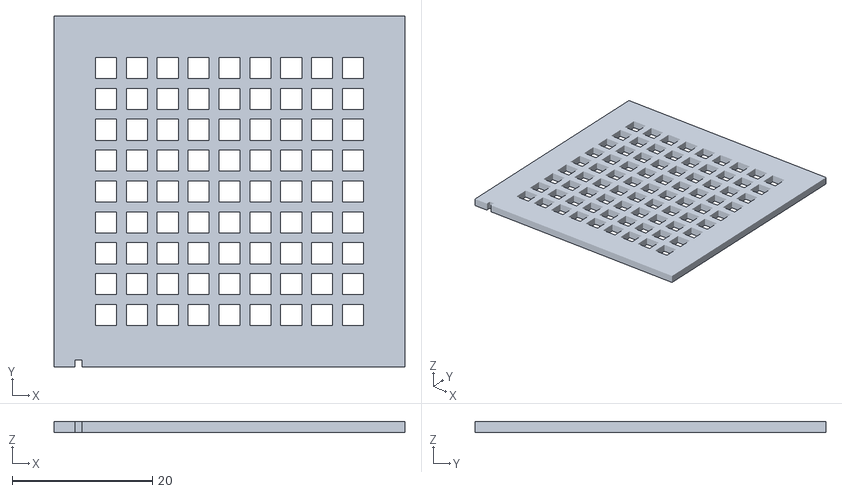
[picture p157: CAD file, 2026-10-28]
control/proposals/stl/A_square_3p0_pitch4p4.stl
50.0 x 50.0 x 1.50
