britams/-capstone-project-repo/cad/D5f_electrical_layout.FCStd

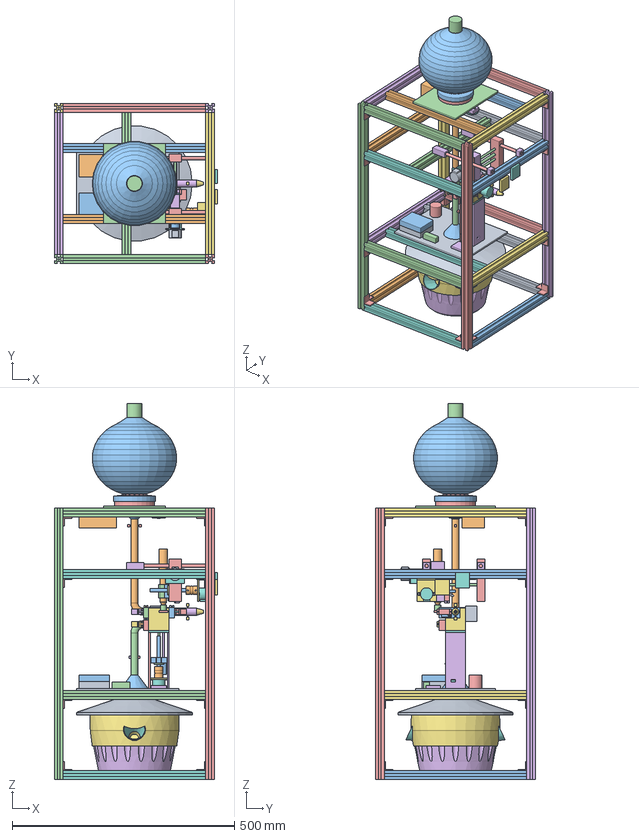
[picture p158: CAD file, 2026-11-06]
cad/D5f_electrical_layout.FCStd
367.0 x 360.0 x 845.0 mm
101_deck
102_collar
111_entry_funnel
110_entry_duct
114_entry_sensor_tx
114_entry_sensor_rx
120_chamber_walls
121_chamber_base (D5f: 가운데 구멍 막음, Ø6 비접촉 구멍)
130_grid
140_lift_floor (D5f: 축 자리 (65, 4))
158_carriage (D5f: LM4UU 자리 + 아래 컵)
159_floor_nut_T8
151_drive_side_L
151_drive_side_R
152_motor_plate
153_floor_stepper_28BYJ48
153r_floor_motor_shaft
154_coupling
155_lead_screw_T8
157_guide_rod
112_entry_gate_housing (D5f 빔 구멍)
112_entry_gate_flap
112_entry_gate_servo_MG90S
112_entry_gate_servo_spline
112_entry_gate_horn
112_entry_gate_post1
112_entry_gate_post2
170_isolation_gate_housing (D5f 빔 구멍)
170_isolation_gate_flap
170_isolation_gate_servo_MG90S
170_isolation_gate_servo_spline
170_isolation_gate_horn
170_isolation_gate_post1
170_isolation_gate_post2
176_release_gate_housing (D5f 빔 구멍)
176_release_gate_flap
176_release_gate_servo_MG90S
176_release_gate_servo_spline
176_release_gate_horn
176_release_gate_post1
176_release_gate_post2
172_isolation_duct
173_isolation_funnel
105_top_plate
104_dome_coupling
174_release_duct
175_release_oneway
142_feeder_wick
144_food_tank
201_marker
202_marker_holder_vblock
203_clamp_strap
205_z_servo_SG90
206_y_carriage
223_holder_guide_pins
205s_z_servo_spline
205h_z_servo_horn
221_y_bearings_LM6UU
224_y_nut_T8
207_y_rods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
