britams/-capstone-project-repo/cad/parts/feeder/P143_물길그릇.FCStd

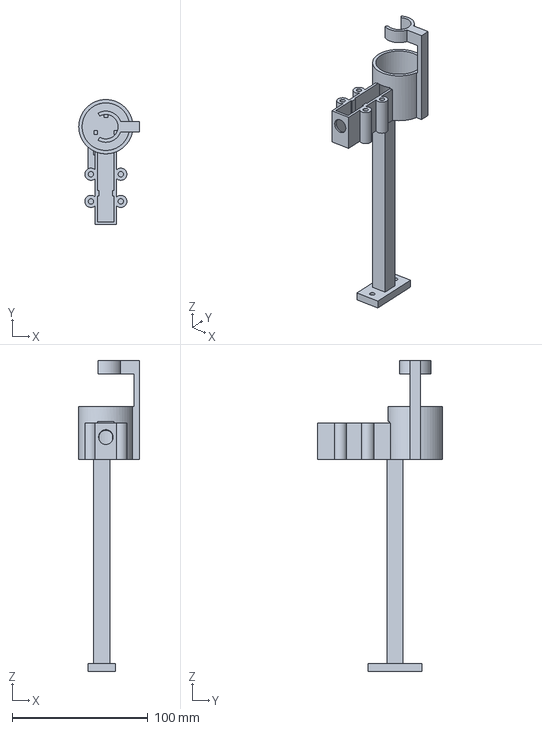
[picture p159: CAD file, 2026-11-10]
cad/parts/feeder/P143_물길그릇.FCStd
44.6 x 92.0 x 229.0 mm
