britams/-capstone-project-repo/cad/print/all/212_beam_end_blocks.step

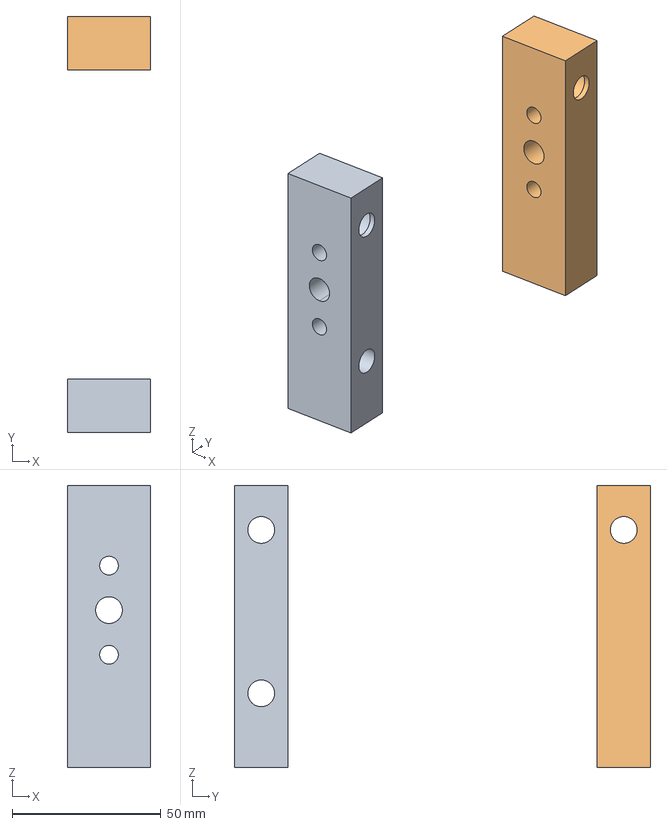
[picture p160: CAD file, 2026-11-14]
cad/print/all/212_beam_end_blocks.step
28.0 x 140.0 x 95.0 mm
