britams/-capstone-project-repo/cad/print/all2/143p_post_sq12.step

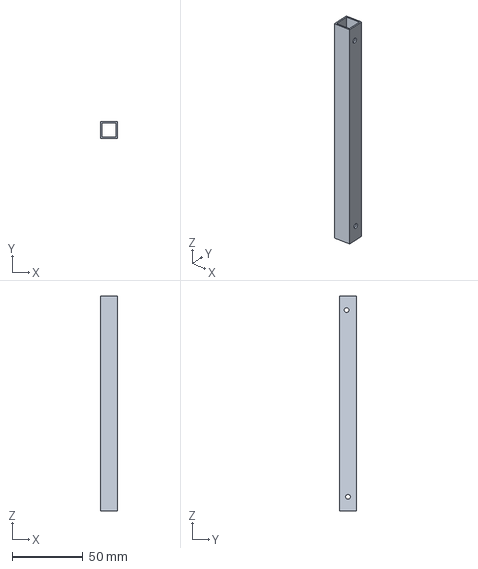
[picture p161: CAD file, 2026-11-14]
cad/print/all2/143p_post_sq12.step
12.0 x 12.0 x 152.0 mm
