britams/-capstone-project-repo/cad/print/lift/300p_아크릴격자판.step

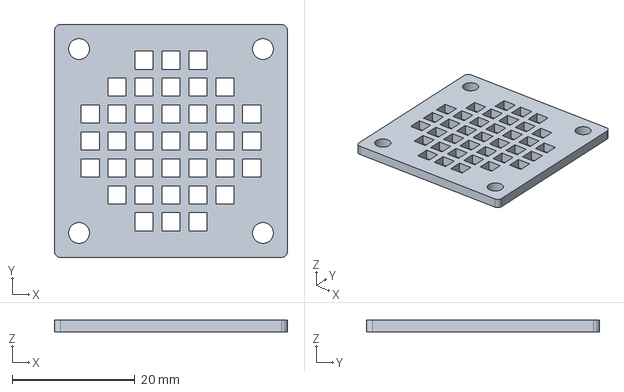
[picture p162: CAD file, 2026-11-14]
cad/print/lift/300p_아크릴격자판.step
38.0 x 38.0 x 2.00 mm
