britams/-capstone-project-repo/cad/split/S3_프레임회로.FCStd

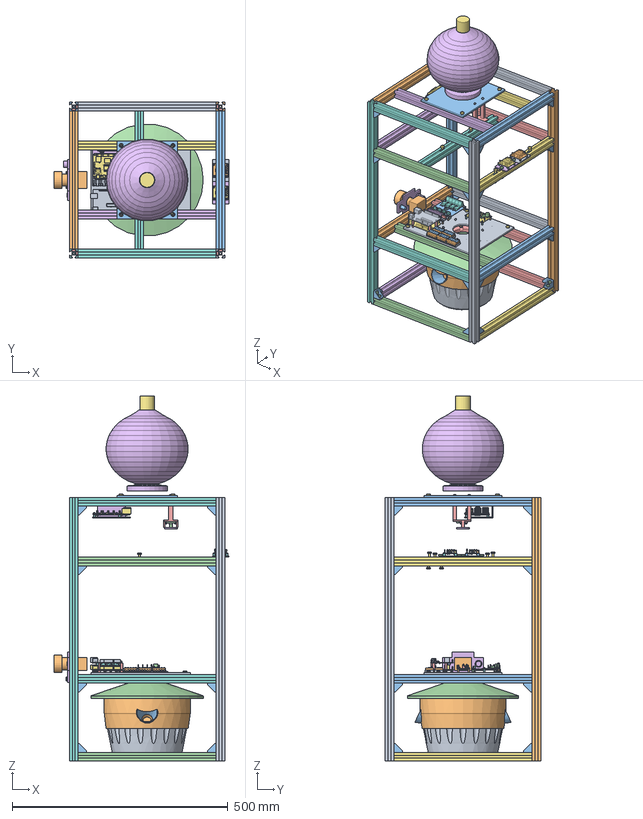
[picture p163: CAD file, 2026-11-14]
cad/split/S3_프레임회로.FCStd
404.0 x 360.0 x 845.0 mm
101_deck (데크 판 — 가로대에 M5 × 10 네 개, 급이 발·보드·옆판·칼라 구멍, 세운 막대 L 브래킷 Ø5.5 (11/15))
102_collar
105_top_plate (위판 — 가로대에 M5 × 10 네 개)
180_camera (Raspberry Pi Camera Module 3 표준 렌즈 IMX708 — 720p 60 fps, 렌즈 끝 z 540 = 격자 위 155 mm)
181_camera_bracket (3D 프린트 — 위판에서 내려오는 걸이, 카메라 M2 × 6 네 개, 위판 쪽 M3 태핑 밑구멍 Ø2.5 2 (11/15 인서트 없앰), 링 조명 팔)
182_light_ring (링 조명 Ø30 — 렌즈 둘레, 걸이 팔에 붙임)
191_arduino_uno (공식 기판 규격 + KiCad STEP 부품)
100a_post_1 (2020 상세, L 610)
100a_post_2 (2020 상세, L 610)
100a_post_3 (2020 상세, L 610)
100a_post_4 (2020 상세, L 610)
100b_rail_0_x-170 (2020 상세, L 320)
100b_rail_0_x+170 (2020 상세, L 320)
100b_rail_0_y-170 (2020 상세, L 320)
100b_rail_0_y+170 (2020 상세, L 320)
100b_rail_deck_x-170 (2020 상세, L 320)
100b_rail_deck_x+170 (2020 상세, L 320)
100b_rail_deck_y-170 (2020 상세, L 320)
100b_rail_deck_y+170 (2020 상세, L 320)
100b_rail_gantry_x-170 (2020 상세, L 320)
100b_rail_gantry_x+170 (2020 상세, L 320)
100b_rail_gantry_y-170 (2020 상세, L 320)
100b_rail_gantry_y+170 (2020 상세, L 320)
100b_rail_top_x-170 (2020 상세, L 320)
100b_rail_top_x+170 (2020 상세, L 320)
100b_rail_top_y-170 (2020 상세, L 320)
100b_rail_top_y+170 (2020 상세, L 320)
100c_cross_deck_y-80 (2020 상세, L 320)
100c_cross_deck_y+80 (2020 상세, L 320)
100c_cross_top_y-80 (2020 상세, L 320)
100c_cross_top_y+80 (2020 상세, L 320)
100d_gantry_rail_x-18 (2020 상세, L 320)
REF_trap_bait_cup
REF_trap_body
REF_trap_funnels
REF_trap_awning
REF_trap_ring
REF_trap_container
REF_trap_cap
REF_trap_silicone_star
192_arduino_uno2 (실제 모양, UNO 1 위 M3 × 12 기둥)
194_estop (22 mm 버섯형 NC, 머리 Ø40, 깊이 72 — 프레임 바깥을 봄)
100e_bracket_2020_L (32)
100f_bolt_M5x8 (64) — 십자 냄비머리 ISO 7045 M5 × 8
100g_tnut_M5_slot6 (64)
197_uln_bracket_X (3D 프린트)
195p_uln2003_X (KiCad STEP 부품 + 판매 규격 기판)
198_uln_standoff_X (M2.5 × 5 기둥 4, 구매)
197_uln_bracket_Y (3D 프린트)
195p_uln2003_Y (KiCad STEP 부품 + 판매 규격 기판)
198_uln_standoff_Y (M2.5 × 5 기둥 4, 구매)
100h_bolt_M5x8_mounts — 십자 냄비머리 ISO 7045
100i_tnut_M5_mounts
199a_pi_shelf (3D 프린트, 위 가로대 y+80에 M5 × 8 2개)
190r_raspberry_pi5 (공식 STEP rpi-5b_no_graphics.step, 구멍 4개 맞춤)
198p_pi_standoff (M2.5 × 5 기둥 4, 구매)
193h_wago_holder (3D 프린트, 와고 5칸, 데크에 M3 × 10 세 개 + 너트)
193w_wago_221-415 × 5 (아래줄 GND 3 / 윗줄 +5 V 2, 판매품 29.9 × 18.6 × 8.3)
193w_wago_levers (주황 레버)
193s_bolt_M3x10_wago (3개, 데크 아래 너트) — 십자 냄비머리 ISO 7045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
