britams/-capstone-project-repo/control/proposals/stl/B_square_3p5_pitch4p3.stl

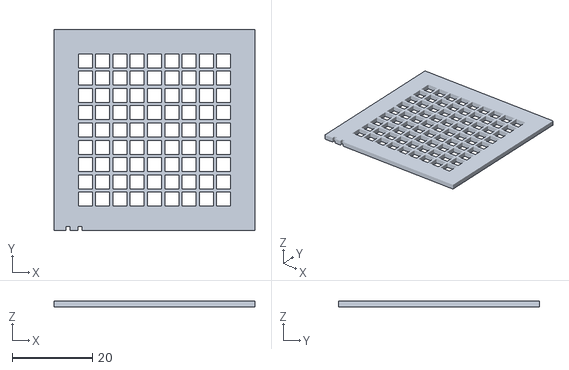
[picture p164: CAD file, 2026-10-28]
control/proposals/stl/B_square_3p5_pitch4p3.stl
50.0 x 50.0 x 1.50
