britams/-capstone-project-repo/cad/parts/feeder/P144n_튜브15mL.FCStd

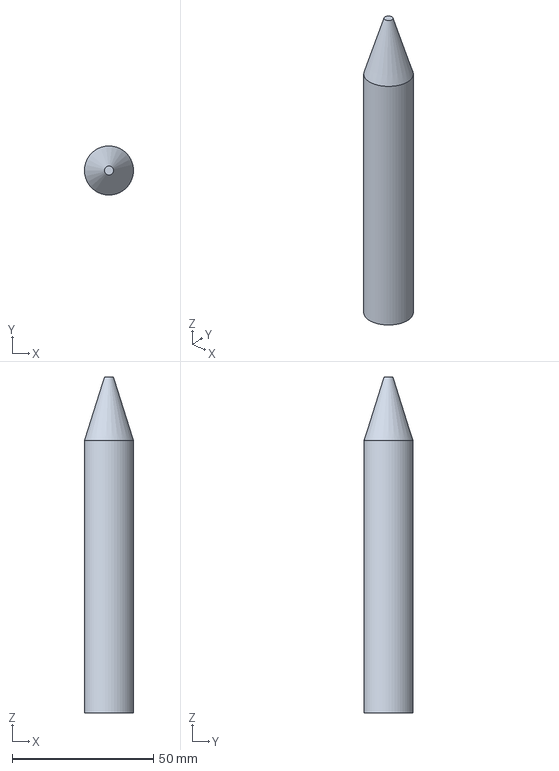
[picture p165: CAD file, 2026-11-10]
cad/parts/feeder/P144n_튜브15mL.FCStd
17.4 x 17.4 x 118.8 mm
