britams/-capstone-project-repo/cad/print/all/181_camera_bracket.step

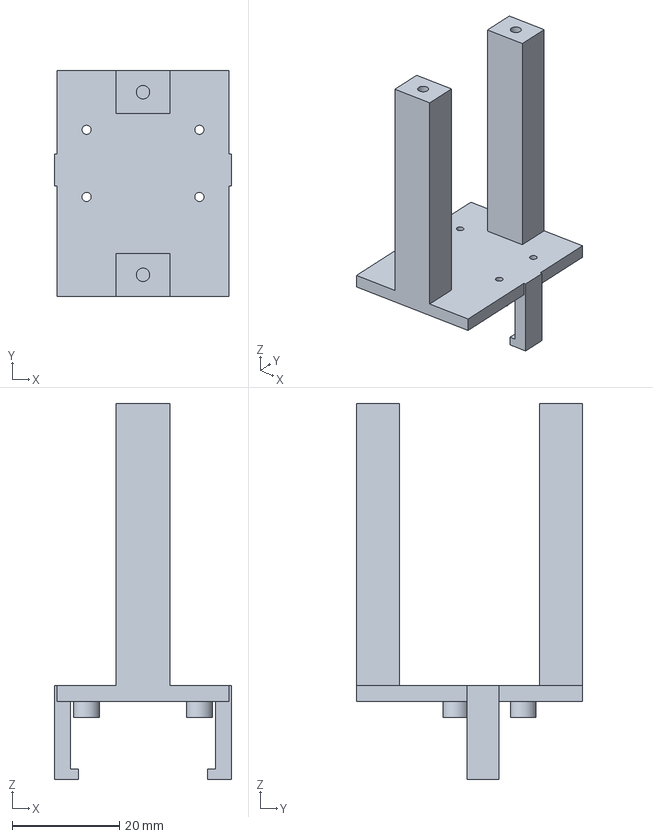
[picture p166: CAD file, 2026-11-14]
cad/print/all/181_camera_bracket.step
33.0 x 42.0 x 70.0 mm
