britams/-capstone-project-repo/cad/print/all2/111_entry_funnel.step

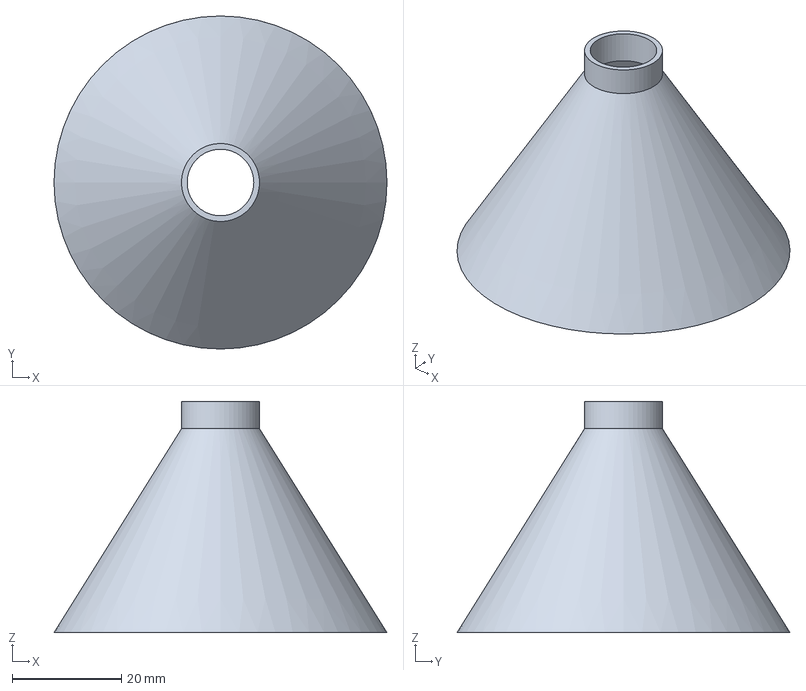
[picture p167: CAD file, 2026-11-14]
cad/print/all2/111_entry_funnel.step
61.0 x 61.0 x 42.4 mm
