britams/-capstone-project-repo/cad/print/lift/300_마킹실상자.step

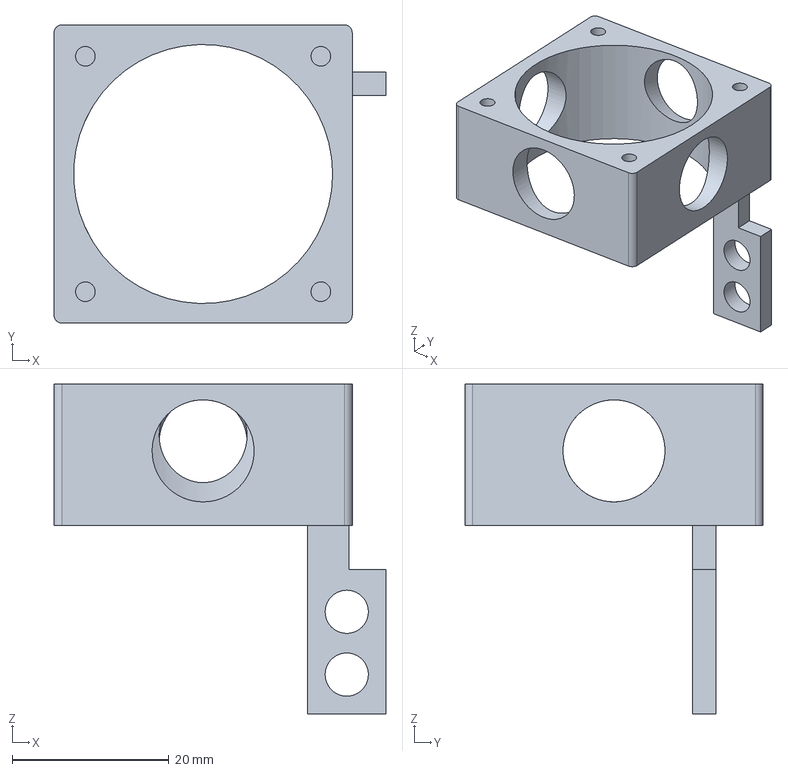
[picture p168: CAD file, 2026-11-14]
cad/print/lift/300_마킹실상자.step
42.3 x 38.0 x 42.0 mm
