britams/-capstone-project-repo/control/proposals/stl/D_slot_3p5_pitch4p5.stl

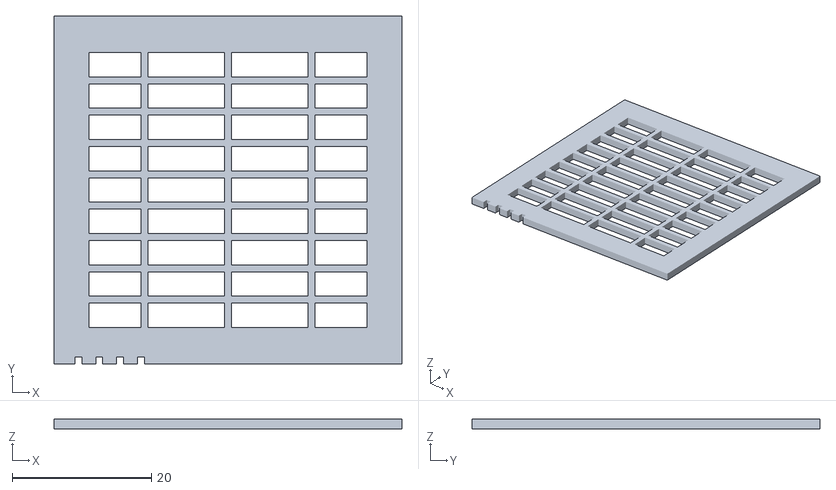
[picture p169: CAD file, 2026-10-28]
control/proposals/stl/D_slot_3p5_pitch4p5.stl
50.0 x 50.0 x 1.50
