britams/-capstone-project-repo/cad/D5e_module_kinematic.FCStd

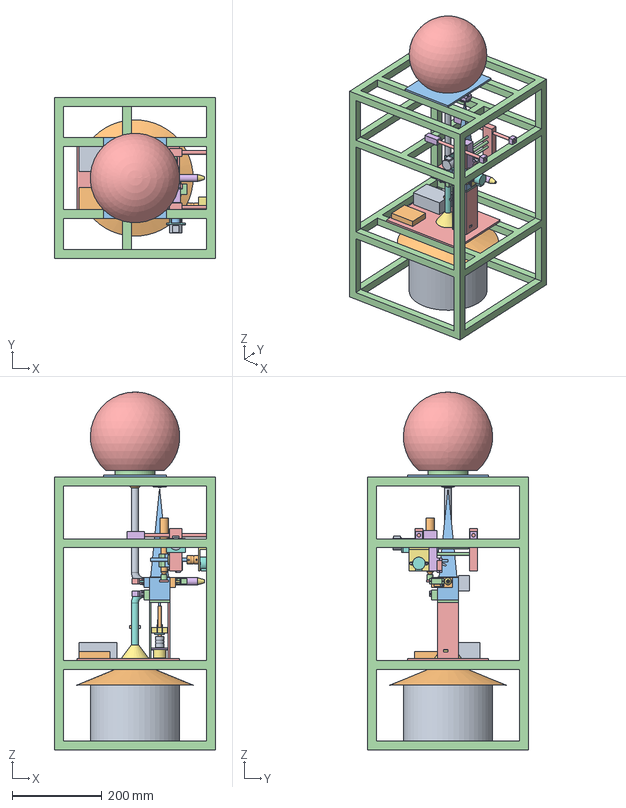
[picture p170: CAD file, 2026-11-01]
cad/D5e_module_kinematic.FCStd
360.0 x 360.0 x 800.0 mm
REF_trap_body
REF_trap_awning
REF_trap_ring
100_frame
101_deck
102_collar
111_entry_funnel
110_entry_duct
114_entry_sensor_tx
114_entry_sensor_rx
120_chamber_walls
121_chamber_base
130_grid
140_lift_floor
158_carriage
159_floor_nut_T8
148_load_cell
146_spring
147_push_rod
151_drive_side_L
151_drive_side_R
152_motor_plate
153_floor_stepper_28BYJ48
153r_floor_motor_shaft
154_coupling
155_lead_screw_T8
157_guide_rod
112_entry_gate_housing
112_entry_gate_flap
112_entry_gate_servo_MG90S
112_entry_gate_servo_spline
112_entry_gate_horn
112_entry_gate_post1
112_entry_gate_post2
170_isolation_gate_housing
170_isolation_gate_flap
170_isolation_gate_servo_MG90S
170_isolation_gate_servo_spline
170_isolation_gate_horn
170_isolation_gate_post1
170_isolation_gate_post2
176_release_gate_housing
176_release_gate_flap
176_release_gate_servo_MG90S
176_release_gate_servo_spline
176_release_gate_horn
176_release_gate_post1
176_release_gate_post2
172_isolation_duct
173_isolation_funnel
105_top_plate
104_dome_coupling
REF_trap_dome
174_release_duct
175_release_oneway
142_feeder_wick
144_food_tank
201_marker
202_marker_holder_vblock
203_clamp_strap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
