britams/-capstone-project-repo/cad/print/all/170_isolation_gate_flap.step

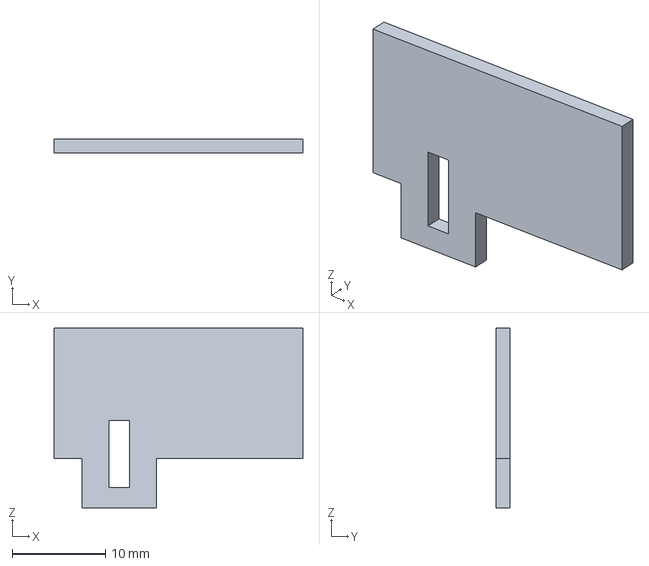
[picture p171: CAD file, 2026-11-14]
cad/print/all/170_isolation_gate_flap.step
26.7 x 1.50 x 19.3 mm
