britams/-capstone-project-repo/cad/print/all2/143a_angle_foot.step

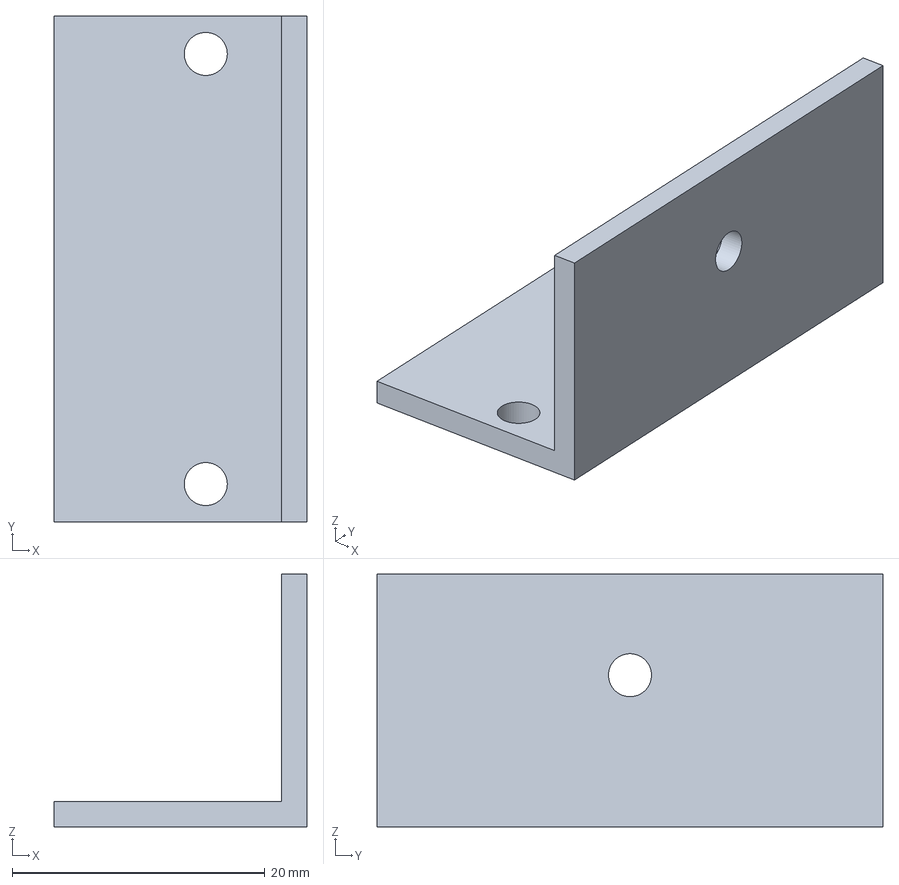
[picture p172: CAD file, 2026-11-14]
cad/print/all2/143a_angle_foot.step
20.0 x 40.0 x 20.0 mm
