britams/-capstone-project-repo/cad/print/lift/300f_아크릴바닥원판.dxf

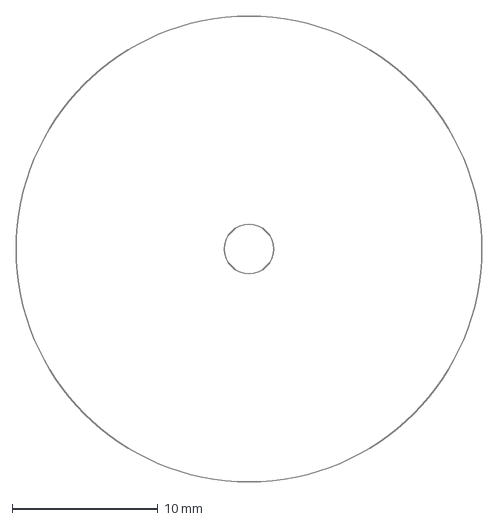
[picture p173: CAD file, 2026-11-14]
cad/print/lift/300f_아크릴바닥원판.dxf
32.0 x 32.0 mm
