britams/-capstone-project-repo/cad/split/S2_마킹부_before_v3.FCStd

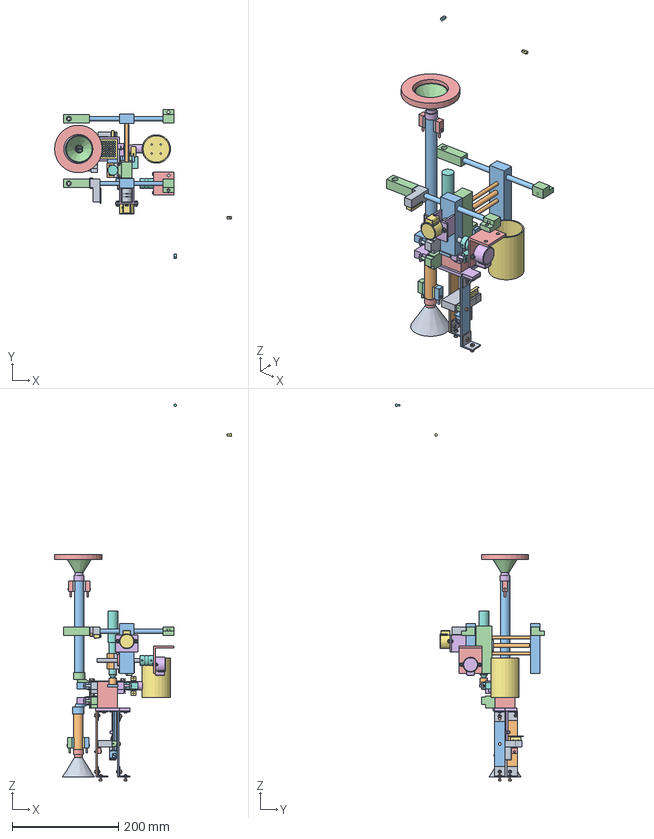
[picture p174: CAD file, 2026-11-14]
cad/split/S2_마킹부_before_v3.FCStd
333.8 x 281.1 x 710.9 mm
111_entry_funnel (McMaster 9017T211 PP 깔때기 — 윗테 잘라 Ø61, 목 5 남김, 구매)
110_entry_duct (수도용 PVC 13A — 바깥 18·안 13, 89 mm 자름, 빔 구멍 Ø3.2 2, 구매)
114_entry_sensor_tx (Adafruit 2167 송신 — 20 × 10 × 8, LED 끝에서 5, 실제 치수)
114_entry_sensor_rx (Adafruit 2167 수신 — 20 × 10 × 8, LED 끝에서 5, 실제 치수)
120_chamber_walls (+y 벽 Ø11.2 급이 구멍)
121_chamber_base (D5f: 가운데 구멍 막음, Ø6 비접촉 구멍)
130_grid (투명 아크릴 1.5 레이저 가공 — 구멍 Ø3 · 간격 4.4 그대로, 서현 11/09)
140_lift_floor (D5f: 축 자리 (65, 4))
158_carriage (바닥 캐리지 — 받침 칸 몸통 + 슬라이더 팔, LM4UU 1 (누름 축), 작은 3D 프린트 PETG)
151_drive_side_L (알루미늄 평철 20 × 3 — 125 자름·구멍 4, 원점 스위치 227f M2 탭, 구매)
151_drive_side_R (알루미늄 평철 20 × 3 — 125 자름·구멍 4, 리니어 모듈 M3 × 2, 구매)
112_entry_gate_housing (D5f 빔 구멍 + 서보 기둥 2개 한 덩어리 출력, SJ-53 −y 받침)
112_entry_gate_flap
112_entry_gate_servo_MG90S
112_entry_gate_servo_spline
112_entry_gate_horn
170_isolation_gate_housing (D5f 빔 구멍 + 서보 기둥 2개 한 덩어리 출력, SJ-53 −y 받침)
170_isolation_gate_flap
170_isolation_gate_servo_MG90S
170_isolation_gate_servo_spline
170_isolation_gate_horn
176_release_gate_housing (D5f 빔 구멍 + 서보 기둥 2개 한 덩어리 출력, SJ-53 −y 받침)
176_release_gate_flap
176_release_gate_servo_MG90S
176_release_gate_servo_spline
176_release_gate_horn
172_isolation_duct (수도용 PVC 13A — 바깥 18·안 13, 195 mm 자름, 빔 구멍 Ø3.2 2, 구매)
173_isolation_funnel (McMaster 9017T211 PP 깔때기 — 윗테 잘라 Ø52 (위판·104 구멍 Ø55 지남), 목 5 남김, 구매)
104_dome_coupling
174_release_neck (짧은 목 30 mm, 안지름 12 — 굴뚝과 한 덩어리 출력)
175_release_shaft (위로 열린 굴뚝 안지름 50, 꼭대기 z 430, 빗물 구멍 4)
201_marker
202_marker_holder_vblock
203_clamp_strap
205_z_servo_SG90
206_y_carriage
223_holder_guide_pins
205s_z_servo_spline
205h_z_servo_horn
221_y_bearings_LM6UU
224_y_nut_T8
207_y_rods
212_beam_end_blocks
222_x_bearings_LM8UU
225_x_nut_T8
211_y_motor_bracket
209_y_stepper_28BYJ48 (28BYJ-48 5 V — Adafruit 858 STEP, MIT)
209r_y_motor_shaft
210_y_coupling
208_y_lead_screw_T8
213_x_rods
218_rod_supports (X 봉 받침 4, 3D 프린트 — 100d 쪽 M5 × 10, 둘레 레일 쪽 귀 + M5 × 12, T너트)
217_x_motor_plate (3D 프린트 — 위 날개를 레일 아랫면에 M5 × 8 두 개)
215_x_stepper_28BYJ48 (28BYJ-48 5 V — Adafruit 858 STEP, MIT)
215r_x_motor_shaft
216_x_coupling
214_x_lead_screw_T8
219_cap_cup
220_cup_bracket
REF_hornet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
