britams/-capstone-project-repo/control/proposals/stl/C_slot_3p0_pitch4p0.stl

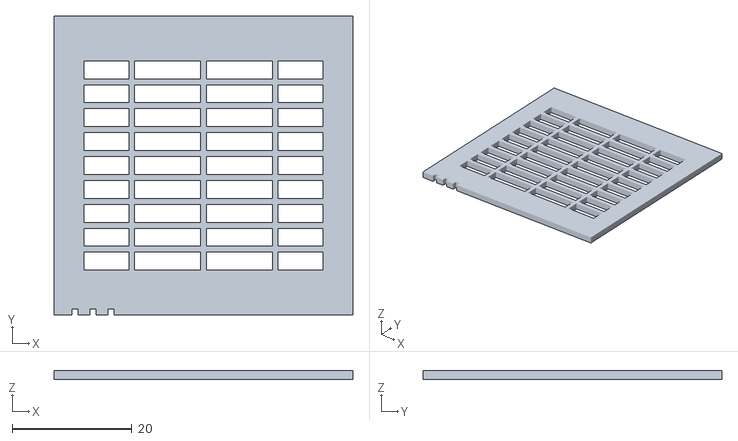
[picture p175: CAD file, 2026-10-28]
control/proposals/stl/C_slot_3p0_pitch4p0.stl
50.0 x 50.0 x 1.50
