britams/-capstone-project-repo/cad/parts/feeder/P142n_코튼롤.FCStd

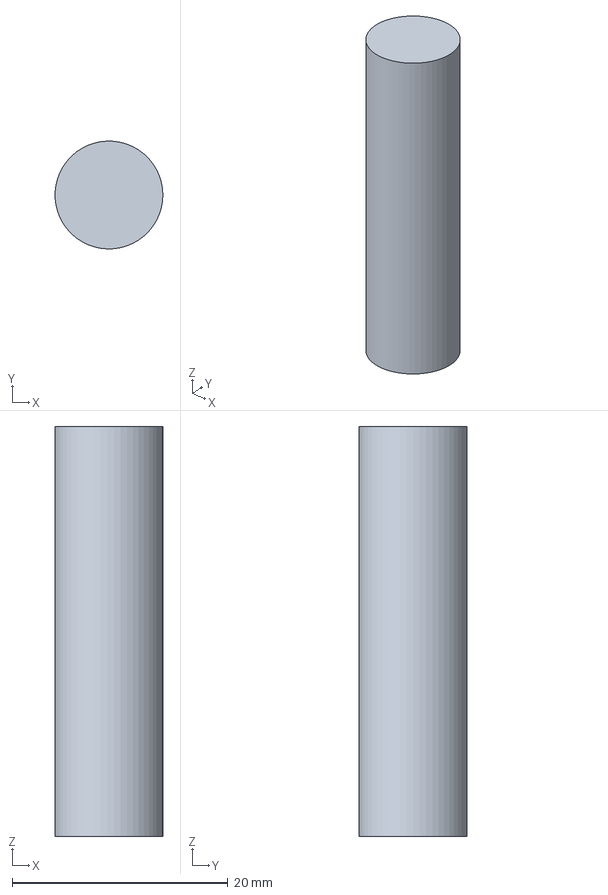
[picture p176: CAD file, 2026-11-10]
cad/parts/feeder/P142n_코튼롤.FCStd
9.99 x 10.00 x 38.0 mm
