britams/-capstone-project-repo/cad/print/all/175_release_shaft.step

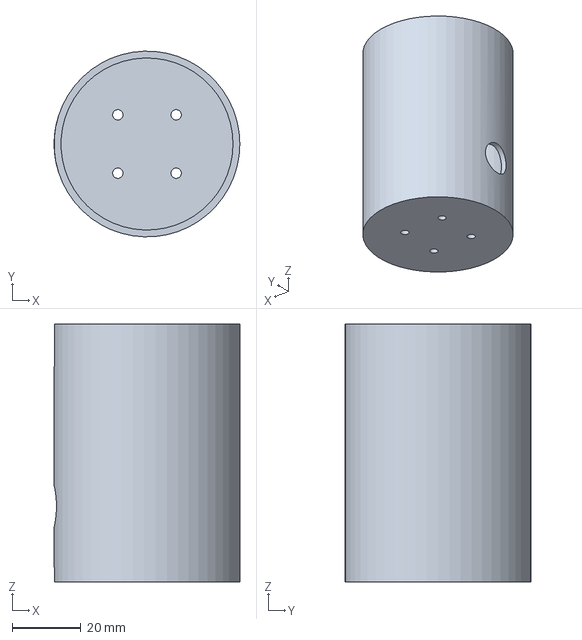
[picture p177: CAD file, 2026-11-14]
cad/print/all/175_release_shaft.step
54.0 x 54.0 x 75.0 mm
