britams/-capstone-project-repo/cad/print/all2/143_feed_trough.step

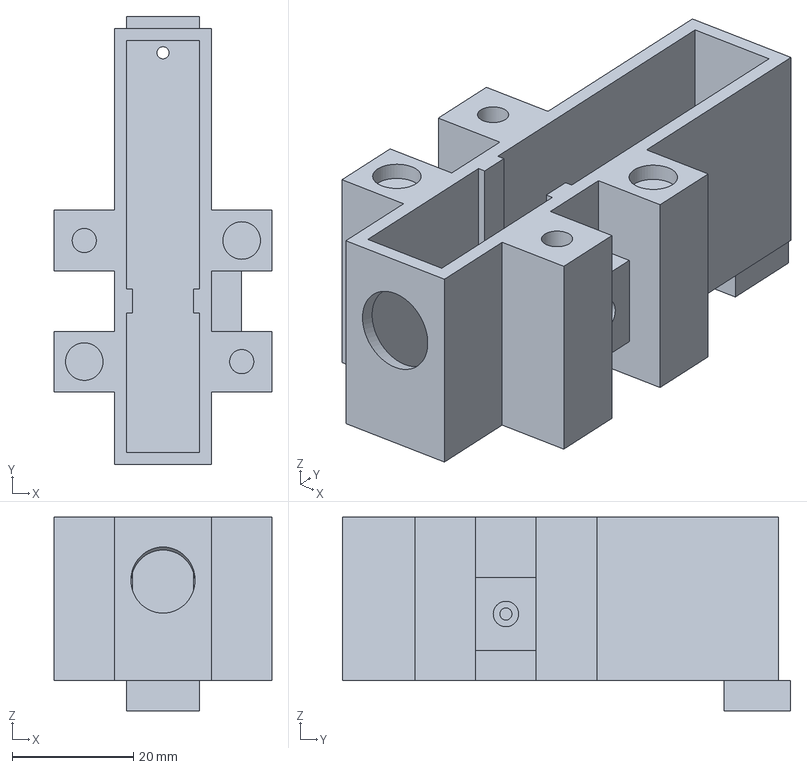
[picture p178: CAD file, 2026-11-14]
cad/print/all2/143_feed_trough.step
36.0 x 74.0 x 32.0 mm
