britams/-capstone-project-repo/cad/print/all/219_cap_cup.step

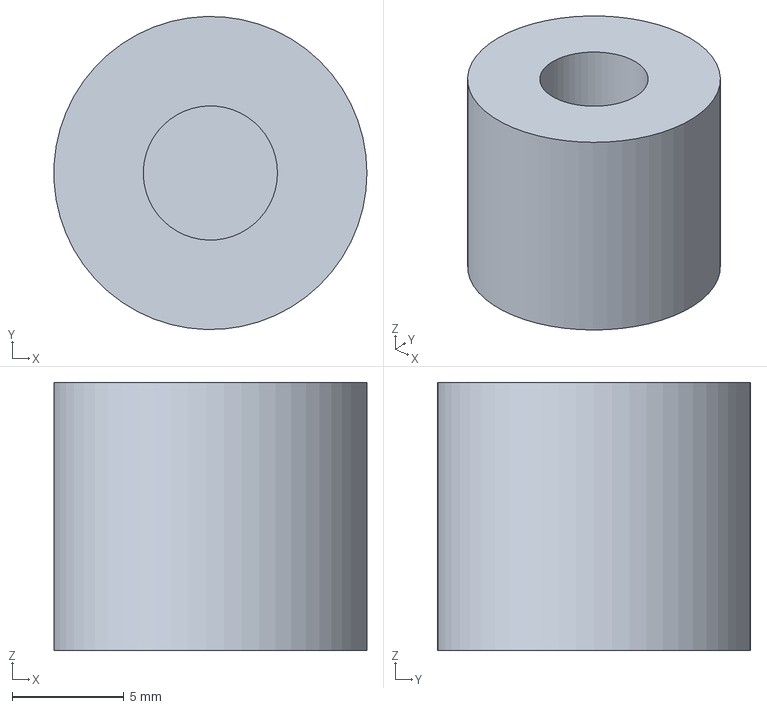
[picture p179: CAD file, 2026-11-14]
cad/print/all/219_cap_cup.step
14.0 x 14.0 x 12.0 mm
