britams/-capstone-project-repo/cad/print/all2/105_top_plate_레이저_5T.dxf

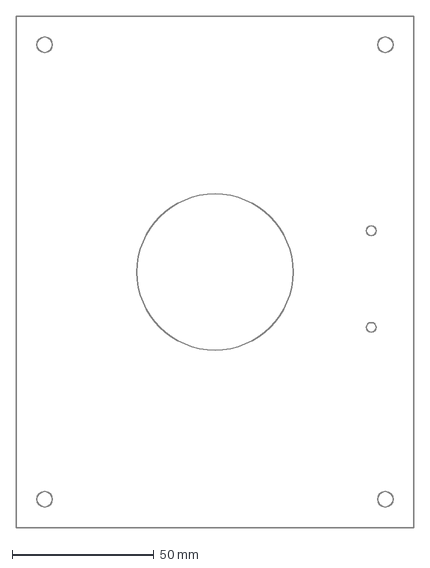
[picture p180: CAD file, 2026-11-14]
cad/print/all2/105_top_plate_레이저_5T.dxf
140.0 x 180.0 mm
