britams/-capstone-project-repo/cad/D5c_module_an1_rest.FCStd

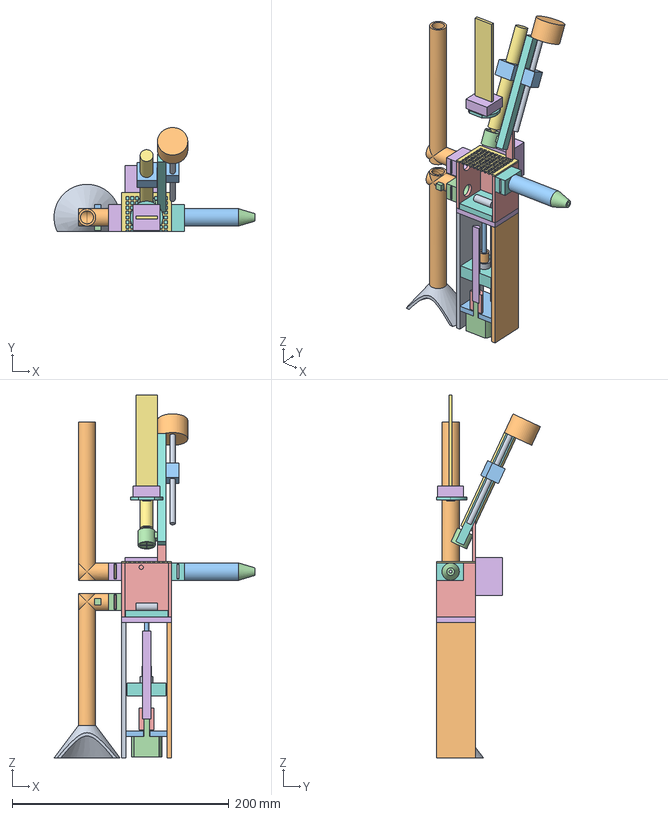
[picture p182: CAD file, 2026-10-28]
cad/D5c_module_an1_rest.FCStd
185.5 x 95.9 x 335.0 mm
SEC_111_entry_funnel
SEC_110_entry_duct
SEC_114_entry_sensor_tx
SEC_114_entry_sensor_rx
SEC_120_chamber_walls
SEC_121_chamber_base
SEC_130_grid
SEC_140_lift_floor
SEC_151_drive_side_L
SEC_151_drive_side_R
SEC_152_motor_plate
SEC_153_floor_stepper_28BYJ48
SEC_154_coupling
SEC_155_lead_screw_T8
SEC_157_guide_rod
SEC_158_carriage
SEC_148_load_cell
SEC_146_spring
SEC_147_push_rod
SEC_112_entry_gate_housing
SEC_112_entry_gate_flap
SEC_170_isolation_gate_housing
SEC_170_isolation_gate_flap
SEC_176_release_gate_housing
SEC_176_release_gate_flap
SEC_172_isolation_duct
SEC_174_release_duct
SEC_175_release_oneway
SEC_142_feeder_wick
SEC_144_food_tank
SEC_160_marker
SEC_164_marker_rail
SEC_167_marker_screw_M5
SEC_168_marker_stepper_28BYJ48
SEC_165_marker_carriage
SEC_166_marker_cap_slit
SEC_163_marker_post
SEC_180_camera
SEC_181_camera_bracket
SEC_182_light_ring
SEC_REF_hornet
