britams/-capstone-project-repo/cad/print/all/172b_isolation_bends.step

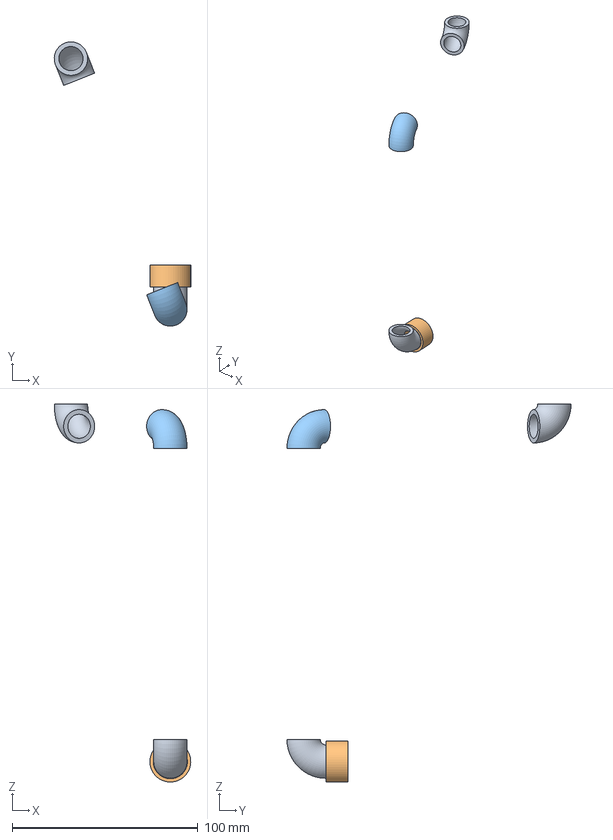
[picture p183: CAD file, 2026-11-14]
cad/print/all/172b_isolation_bends.step
73.5 x 153.0 x 203.5 mm
