britams/-capstone-project-repo/cad/print/all2/101_deck_레이저_5T.dxf

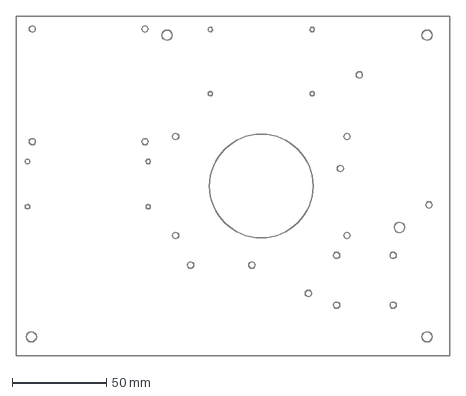
[picture p184: CAD file, 2026-11-14]
cad/print/all2/101_deck_레이저_5T.dxf
230.0 x 180.0 mm
