britams/-capstone-project-repo/cad/split/S2a_바닥구동.FCStd

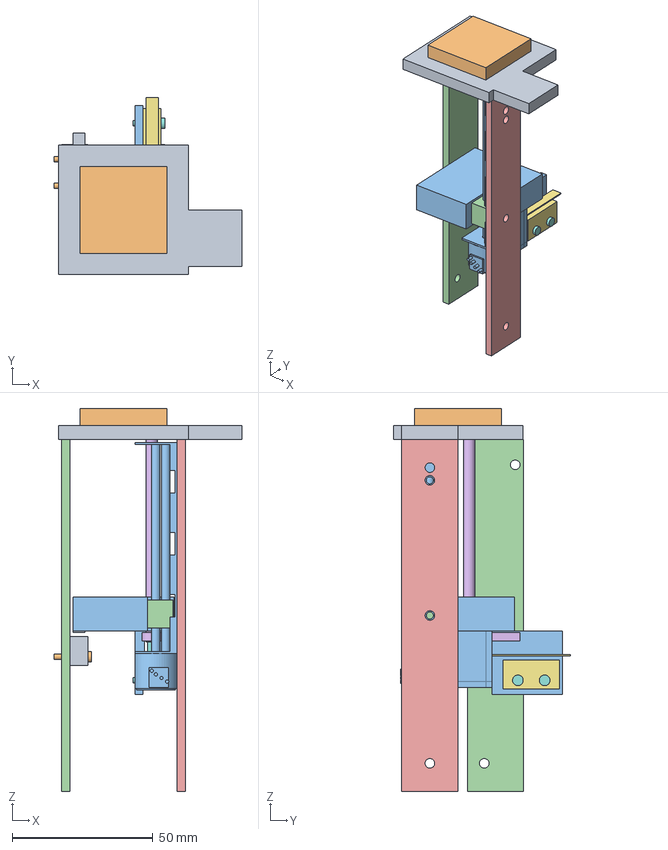
[picture p185: CAD file, 2026-11-12]
cad/split/S2a_바닥구동.FCStd
66.6 x 63.0 x 136.0 mm
121_chamber_base (D5f: 가운데 구멍 막음, Ø6 비접촉 구멍)
140_lift_floor (D5f: 축 자리 (65, 4))
158_carriage (바닥 캐리지 — 받침 칸 몸통 + 슬라이더 팔, LM4UU 1 (누름 축), 작은 3D 프린트 PETG)
151_drive_side_L (알루미늄 평철 20 × 3 — 125 자름·구멍 4, 원점 스위치 227f M2 탭, 구매)
151_drive_side_R (알루미늄 평철 20 × 3 — 125 자름·구멍 4, 리니어 모듈 M3 × 2, 구매)
147_shaft_D4x80 (기성품 경화 축)
149_LM4UU (기성품 볼 부싱)
146_spring (기성품, 바깥 2.86 자리)
227f_home_switch_F (KW11-3Z — 바닥 0 mm에서 캐리지 158 아랫면이 누름, 151_L 안쪽 면에 M2 × 12 두 개)
227fs_switch_screws_F (M2 × 12 십자 냄비머리 2 — 151_L에 셀프 탭)
153m_lift_module (리니어 모듈 Keshuo 15BY25-77 — 15 mm 2상 4선 + M3×0.5 리드, 행정 62, 151_R에 M3 × 2, 구매) [치수도·사진대로 따로 그린 것 ks_15by25_module — 판 두께·봉 자리는 추측]
153s_lift_slider (모듈 구리 슬라이더 — 캐리지에 M2.5 × 2, 모듈 일부)
153ss_slider_screws (M2.5 × 12 2 — 캐리지 팔 → 슬라이더, 구매)
148c_spring_latch (걸쇠 — 축 147에 끼워 순간접착, +y 혀가 누름 스위치를 누름, 3D 프린트 PETG 작은 것)
227p_press_switch (KW11-3Z 누름 스위치 PSW — NC, 스프링 4.8 mm(0.5 N)에서 딸깍, UNO 1 A1)
227ps_press_switch_screws (M2 × 10 십자 냄비머리 2 — 받침판에 셀프 탭, 긴 구멍으로 힘 맞춤)
