britams/-capstone-project-repo/cad/print/all/199c_gate_holder_G6.step

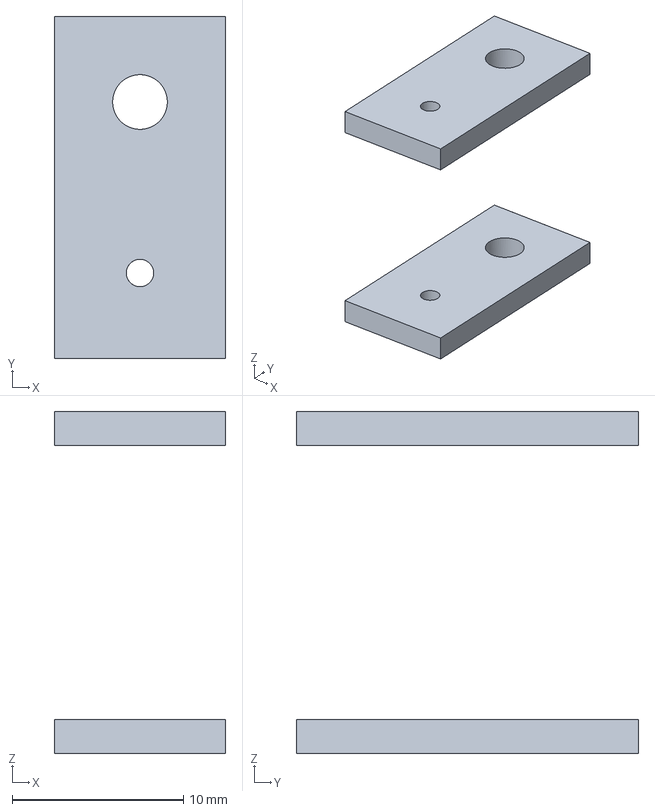
[picture p186: CAD file, 2026-11-14]
cad/print/all/199c_gate_holder_G6.step
10.0 x 20.0 x 20.0 mm
