britams/-capstone-project-repo/cad/print/all2/143b_angle_top.step

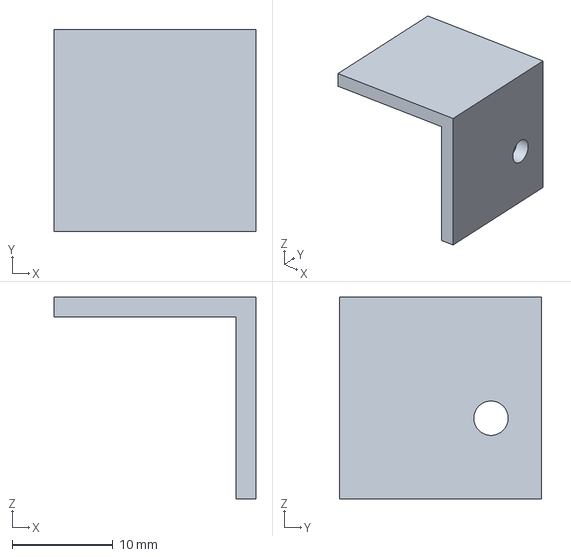
[picture p187: CAD file, 2026-11-14]
cad/print/all2/143b_angle_top.step
20.0 x 20.0 x 20.0 mm
