britams/-capstone-project-repo/cad/split/P153m_리니어모듈_15BY25-77.FCStd

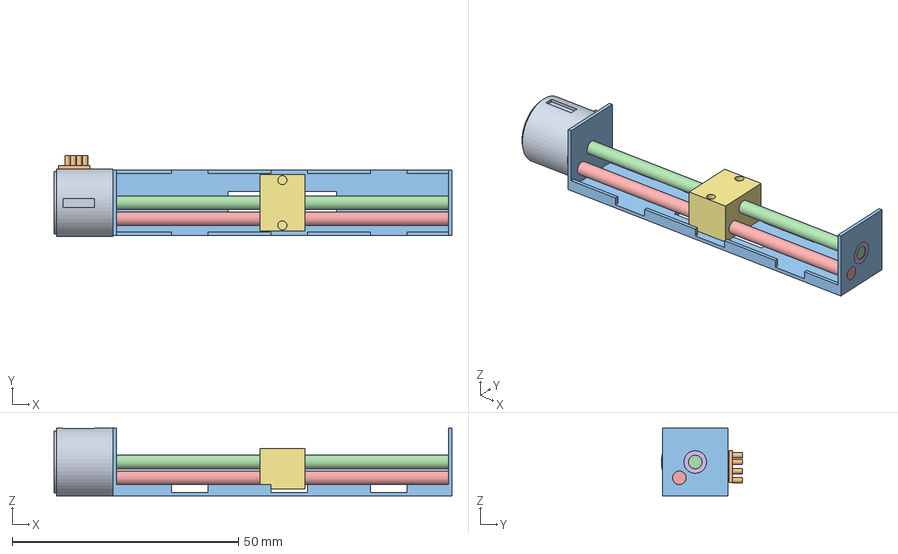
[picture p188: CAD file, 2026-11-12]
cad/split/P153m_리니어모듈_15BY25-77.FCStd
88.0 x 18.0 x 15.0 mm
153m_00 모터 15BY25 (Ø15 × 13)
153m_01 단자판·선 납땜 4
153m_02 접은 판 (바닥 + 끝판 2 + 옆 턱)
153m_03 리드 M3 × 0.5
153m_04 가이드 봉 Ø3
153m_05 리드 끝 받침
153m_06 구리 슬라이더 10 × 12.5 (2-M2.5)
153m_07 슬라이더 베어링
