britams/-capstone-project-repo/cad/D5b_frame_an1_down.FCStd

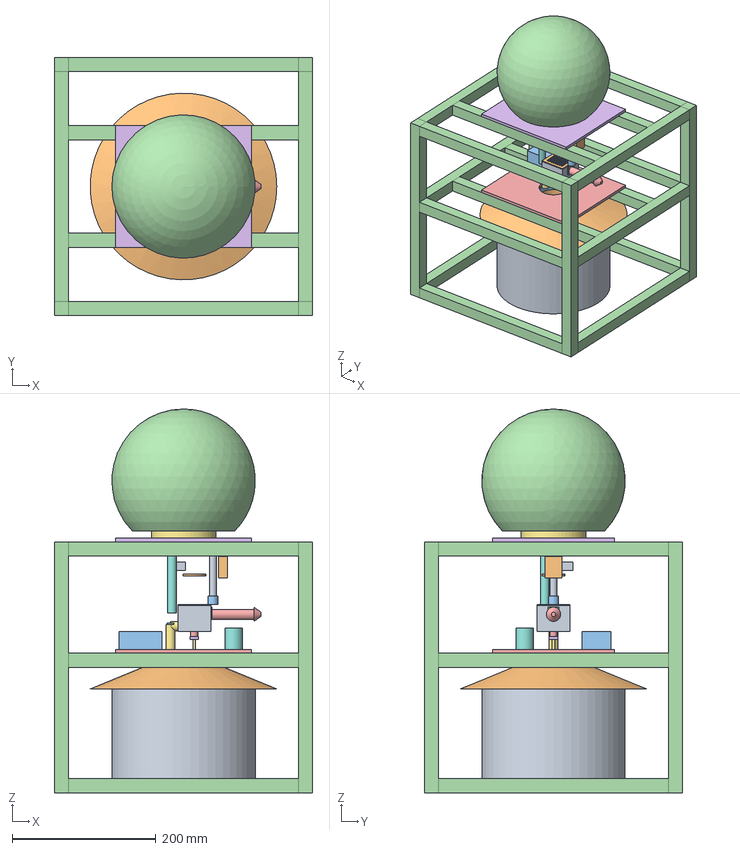
[picture p189: CAD file, 2026-10-28]
cad/D5b_frame_an1_down.FCStd
360.0 x 360.0 x 535.0 mm
REF_body
REF_awning
REF_ring
_100_frame_2020
_101_module_plate
_102_collar
_110_entry
_112_entry_gate
_120_marking_chamber
_130_grid
_140_lift_floor
_142_feeder
_146_spring
_148_load_cell
_150_floor_drive
_144_food_tank
_160_marker
_164_marker_drive
_166_marker_cap
_170_branch_gate
_174_release_exit
_105_top_plate
_104_dome_coupling
_172_isolation_path
_180_camera
_182_light
_190_controller
REF_dome
