britams/-capstone-project-repo/cad/print/all/199e_gate_holder_G1_rx.step

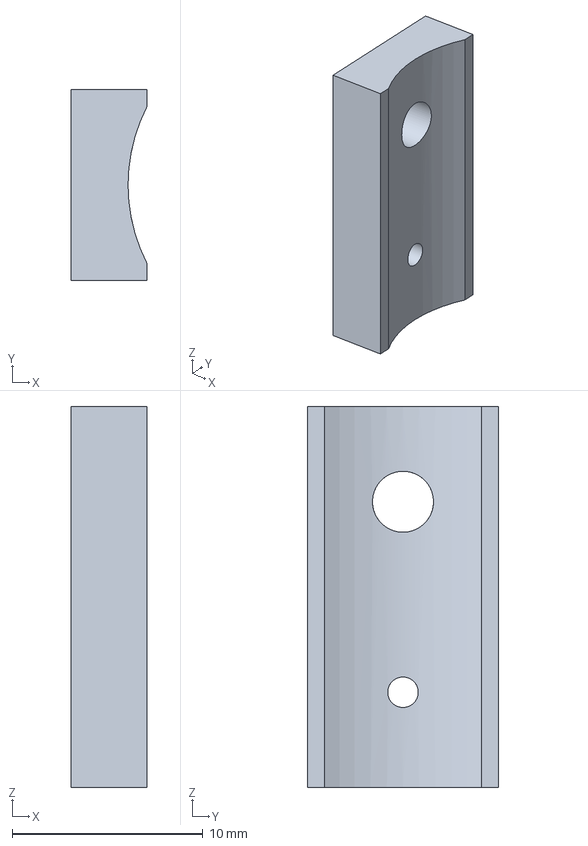
[picture p190: CAD file, 2026-11-14]
cad/print/all/199e_gate_holder_G1_rx.step
4.00 x 10.0 x 20.0 mm
