britams/-capstone-project-repo/cad/print/all2/143l_feed_trough_lid.step

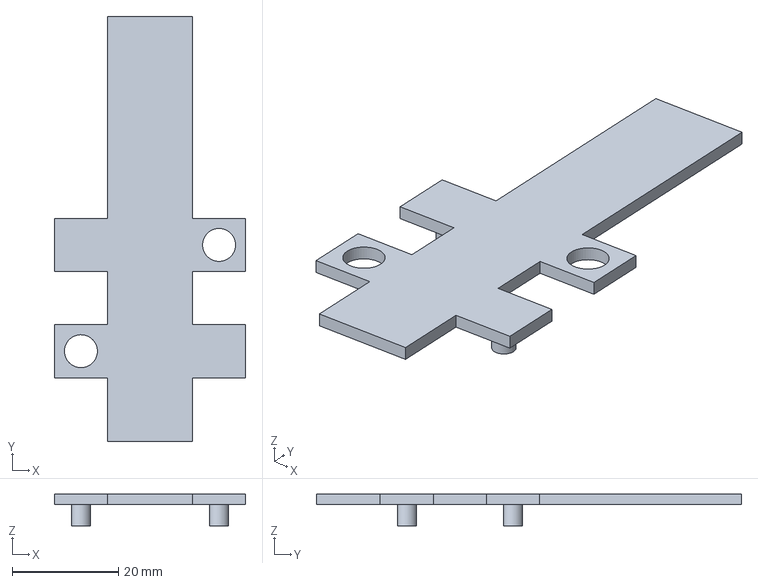
[picture p191: CAD file, 2026-11-14]
cad/print/all2/143l_feed_trough_lid.step
36.0 x 80.0 x 6.00 mm
