britams/-capstone-project-repo/cad/D5_concept_an1_up.FCStd

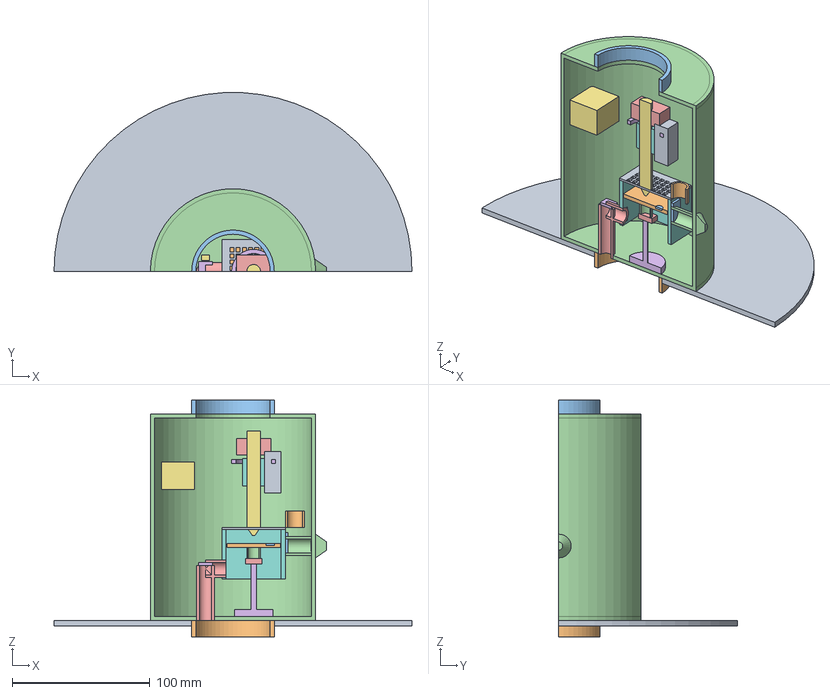
[picture p192: CAD file, 2026-10-28]
cad/D5_concept_an1_up.FCStd
260.0 x 129.8 x 172.0 mm
SEC_REF_awning
SEC_102_lower_coupling
SEC_104_upper_coupling
SEC_100_housing
SEC_110_entry
SEC_112_entry_gate
SEC_114_entry_sensor
SEC_120_marking_chamber
SEC_130_grid
SEC_140_lift_floor
SEC_142_feeder
SEC_146_spring
SEC_148_load_cell
SEC_150_floor_drive
SEC_160_marker
SEC_162_marker_holder
SEC_164_marker_drive
SEC_166_marker_cap
SEC_170_branch_gate
SEC_174_release_exit
SEC_180_camera
SEC_182_light
SEC_190_controller
