britams/-capstone-project-repo/cad/print/all/174_release_neck.step

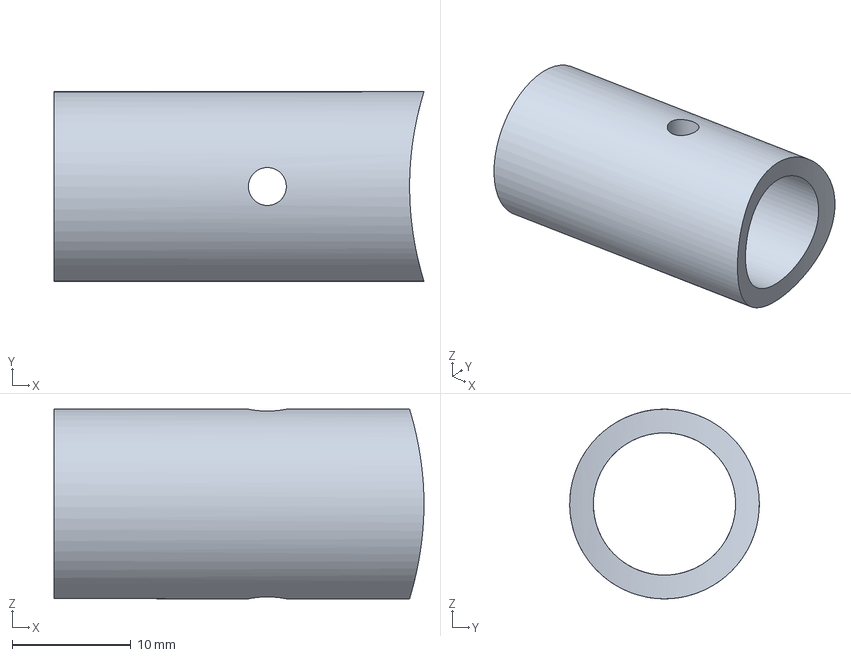
[picture p193: CAD file, 2026-11-14]
cad/print/all/174_release_neck.step
31.2 x 16.0 x 16.0 mm
