britams/-capstone-project-repo/cad/print/all2/110_entry_duct.step

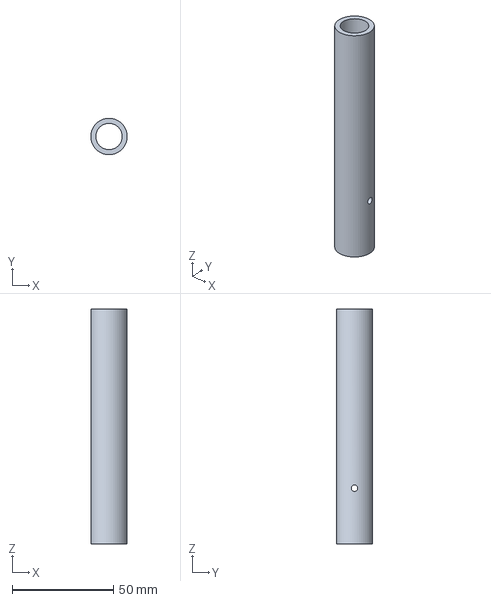
[picture p194: CAD file, 2026-11-14]
cad/print/all2/110_entry_duct.step
18.0 x 18.0 x 116.1 mm
