britams/-capstone-project-repo/cad/print/all/194b_estop_plate.step

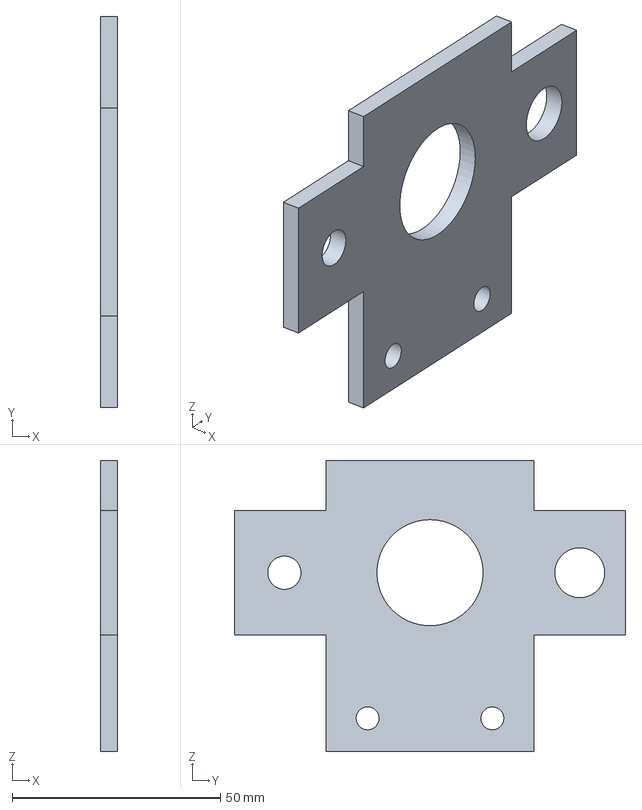
[picture p195: CAD file, 2026-11-14]
cad/print/all/194b_estop_plate.step
4.00 x 94.0 x 70.0 mm
