britams/-capstone-project-repo/cad/print/all2/172_isolation_duct_4.step

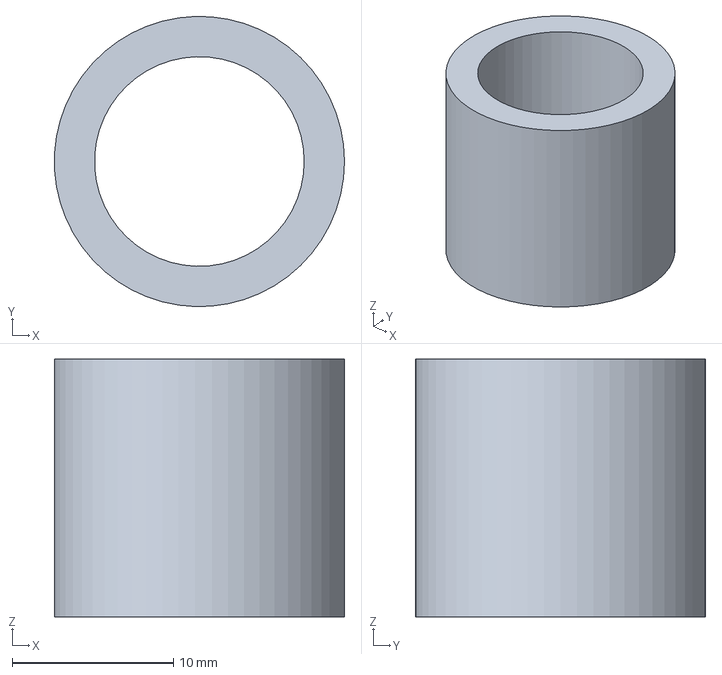
[picture p196: CAD file, 2026-11-14]
cad/print/all2/172_isolation_duct_4.step
18.0 x 18.0 x 16.0 mm
