britams/-capstone-project-repo/cad/print/all/193h_wago_holder.step

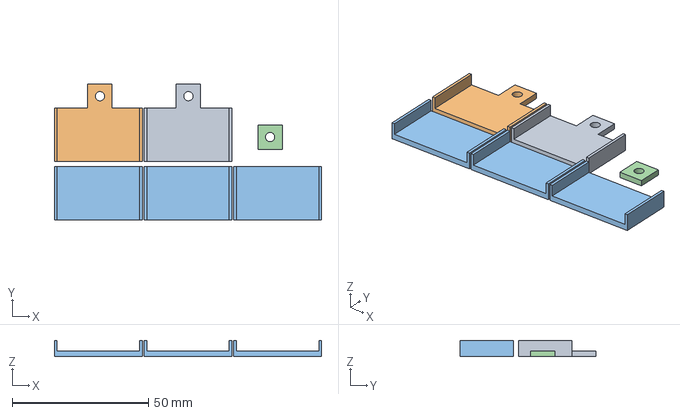
[picture p197: CAD file, 2026-11-14]
cad/print/all/193h_wago_holder.step
98.1 x 50.0 x 6.00 mm
