britams/-capstone-project-repo/cad/print/all2/172_isolation_duct_1.step

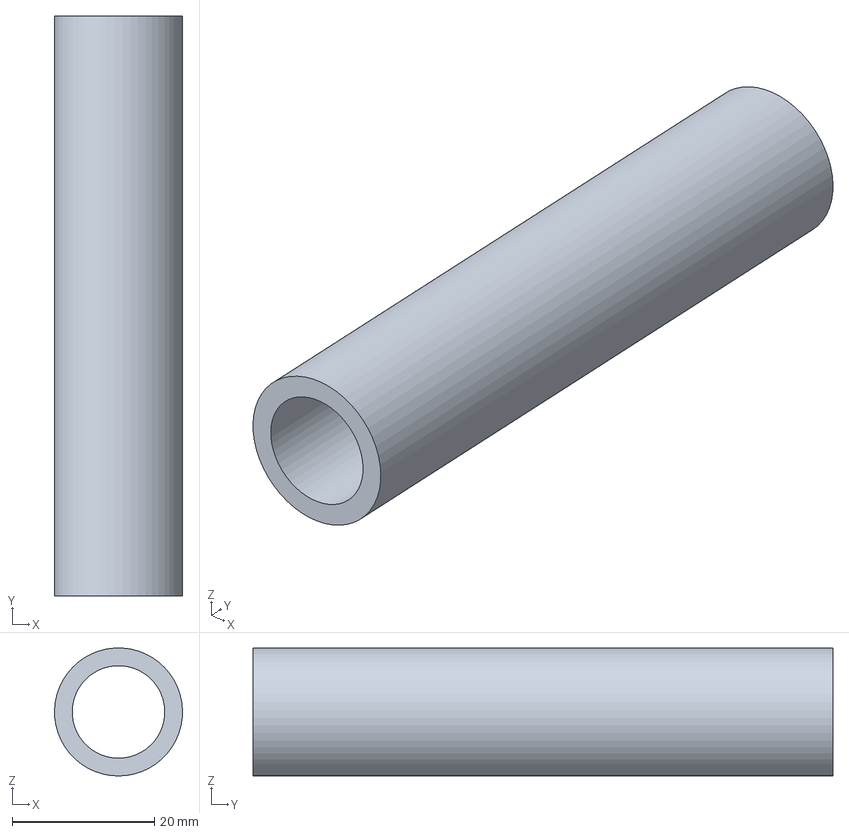
[picture p198: CAD file, 2026-11-14]
cad/print/all2/172_isolation_duct_1.step
18.0 x 81.5 x 18.0 mm
