britams/-capstone-project-repo/cad/print/all2/144b_feeder_holder.step

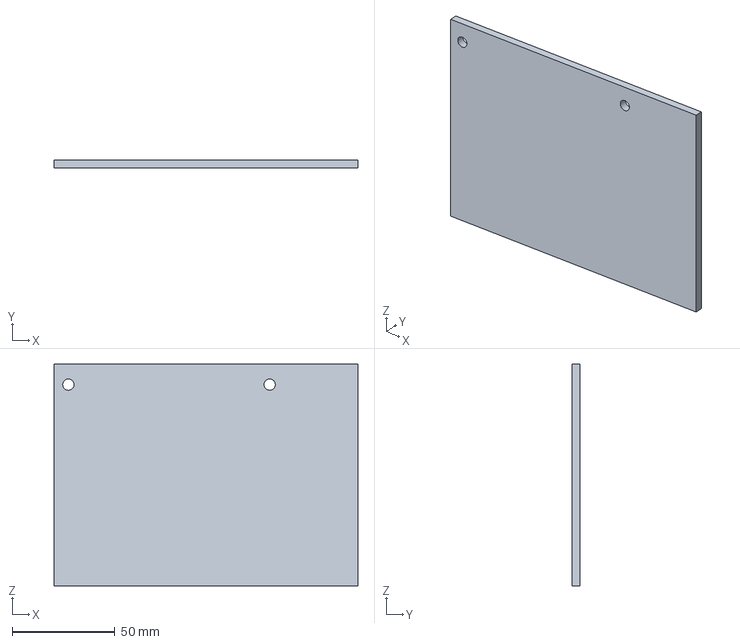
[picture p199: CAD file, 2026-11-14]
cad/print/all2/144b_feeder_holder.step
148.0 x 4.00 x 108.0 mm
