britams/-capstone-project-repo/cad/print/all/211_y_motor_bracket.step

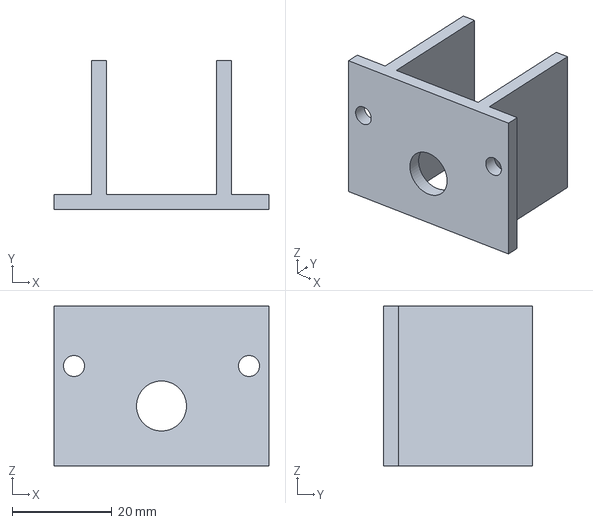
[picture p200: CAD file, 2026-11-14]
cad/print/all/211_y_motor_bracket.step
43.0 x 29.9 x 32.0 mm
