britams/-capstone-project-repo/cad/print/all2/172_isolation_duct_2.step

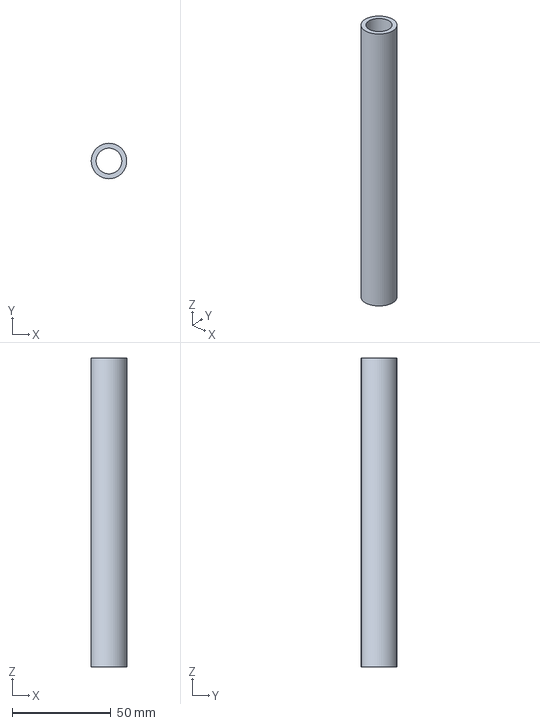
[picture p201: CAD file, 2026-11-14]
cad/print/all2/172_isolation_duct_2.step
18.0 x 18.0 x 156.5 mm
