britams/-capstone-project-repo/cad/print/all/104_dome_coupling.step

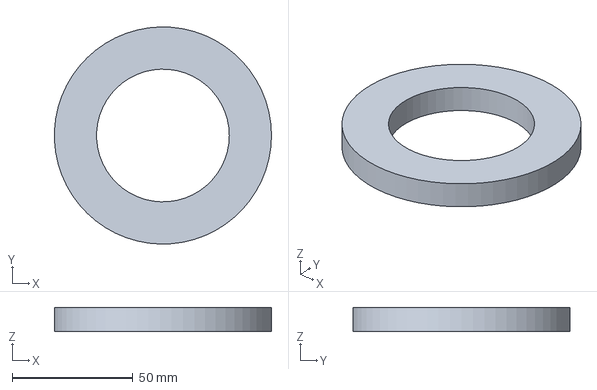
[picture p202: CAD file, 2026-11-14]
cad/print/all/104_dome_coupling.step
89.9 x 90.0 x 10.0 mm
