britams/-capstone-project-repo/cad/print/all2/172_isolation_duct_3.step

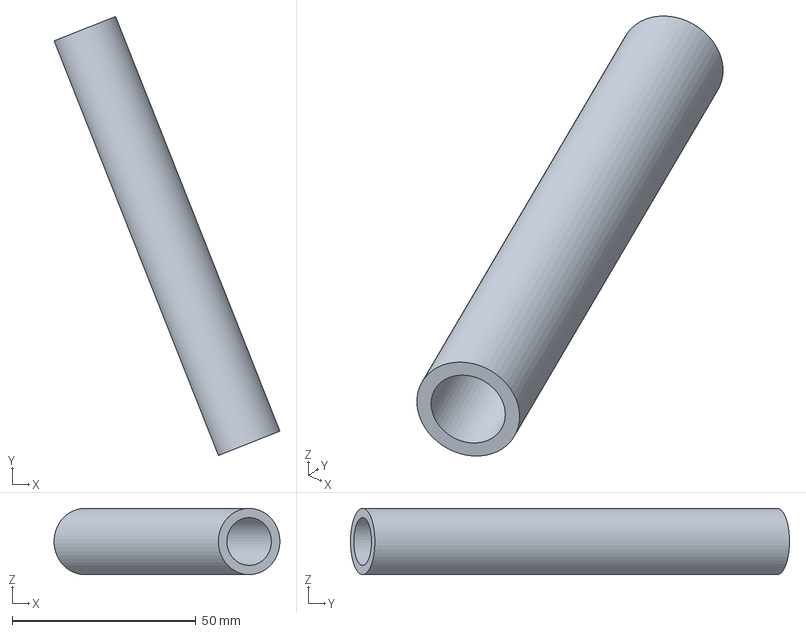
[picture p203: CAD file, 2026-11-14]
cad/print/all2/172_isolation_duct_3.step
61.4 x 119.3 x 18.0 mm
