britams/-capstone-project-repo/cad/print/all/220_cup_bracket.step

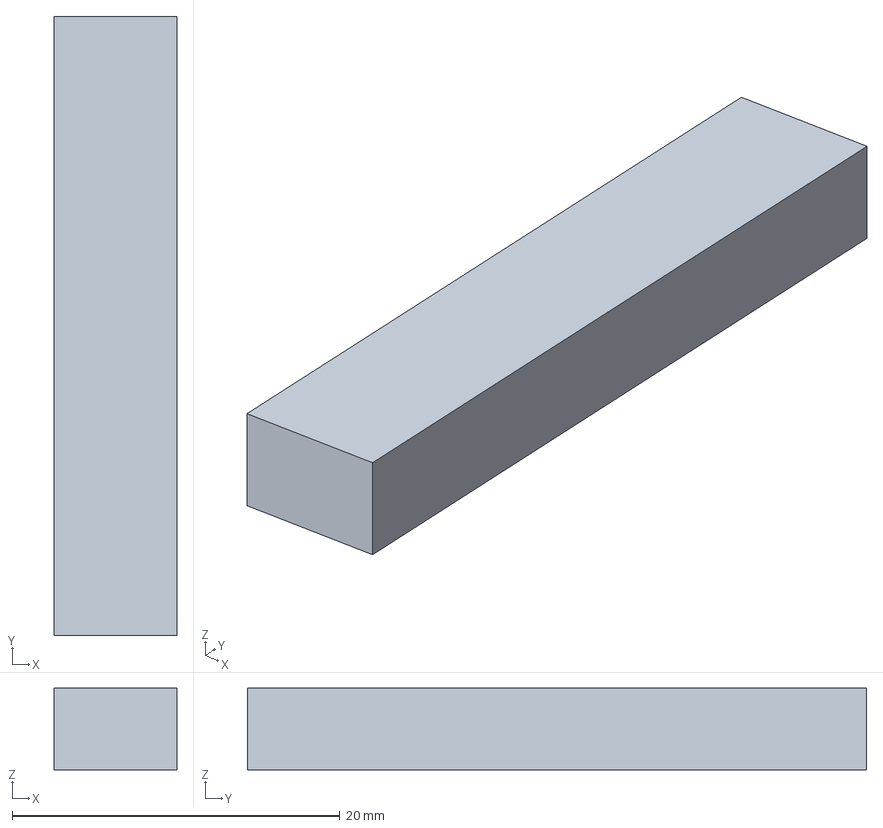
[picture p204: CAD file, 2026-11-14]
cad/print/all/220_cup_bracket.step
7.50 x 37.8 x 5.00 mm
