britams/-capstone-project-repo/cad/print/all/112_entry_gate_housing.step

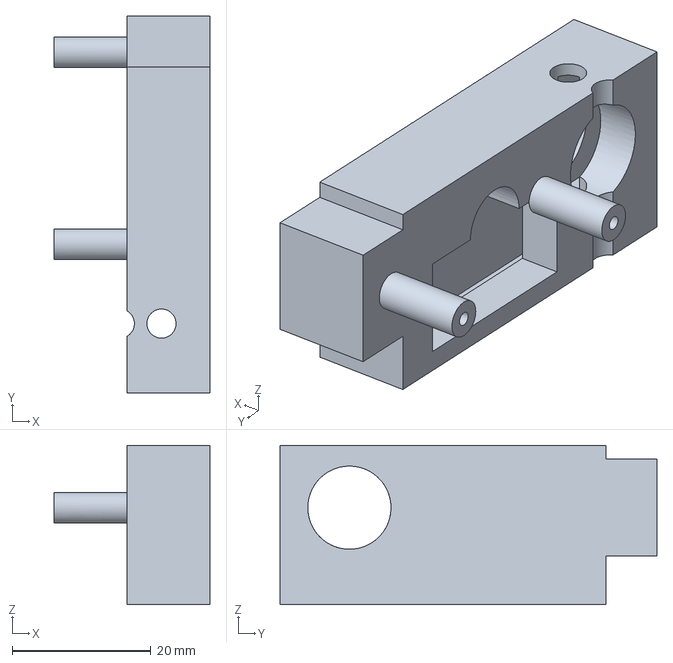
[picture p205: CAD file, 2026-11-14]
cad/print/all/112_entry_gate_housing.step
22.5 x 54.4 x 23.0 mm
