britams/-capstone-project-repo/cad/print/all/226_x_home_clamp.step

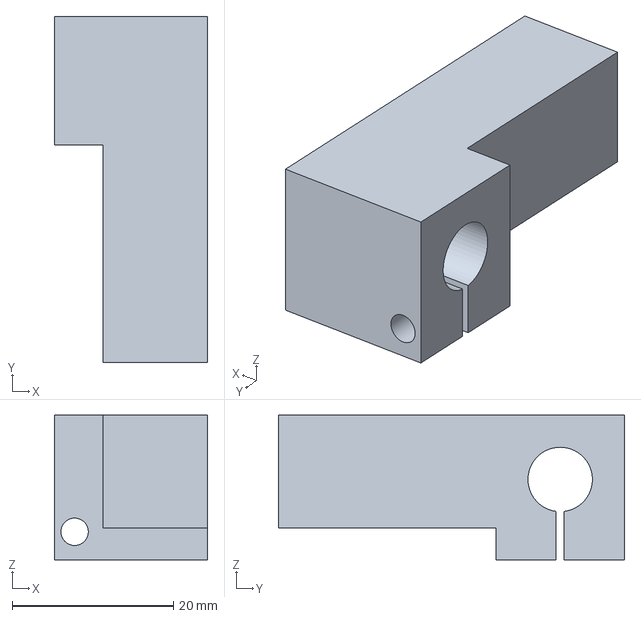
[picture p206: CAD file, 2026-11-14]
cad/print/all/226_x_home_clamp.step
19.0 x 43.0 x 18.0 mm
