britams/-capstone-project-repo/cad/print/all/206_y_carriage.step

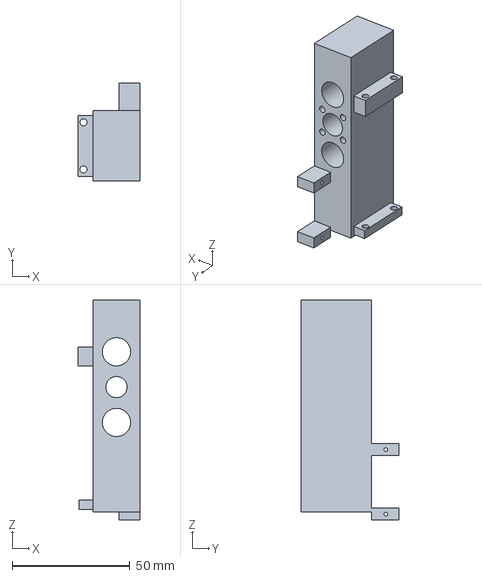
[picture p207: CAD file, 2026-11-14]
cad/print/all/206_y_carriage.step
26.3 x 41.8 x 93.5 mm
