britams/-capstone-project-repo/cad/print/all/197_uln_bracket_Y.step

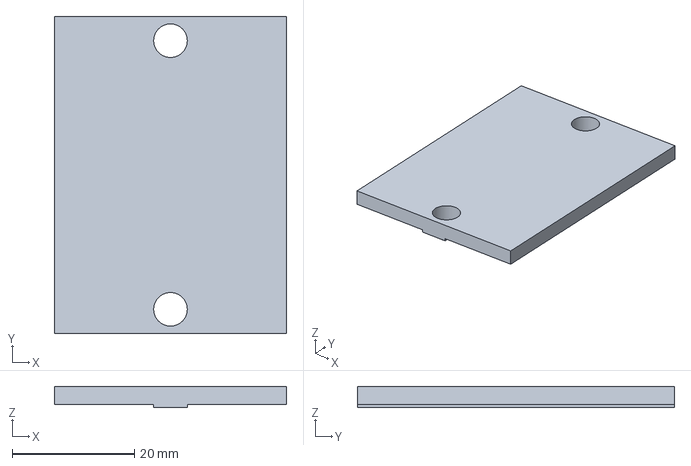
[picture p208: CAD file, 2026-11-14]
cad/print/all/197_uln_bracket_Y.step
38.0 x 52.0 x 3.50 mm
