britams/-capstone-project-repo/cad/print/all/199b_gate_holder_G4.step

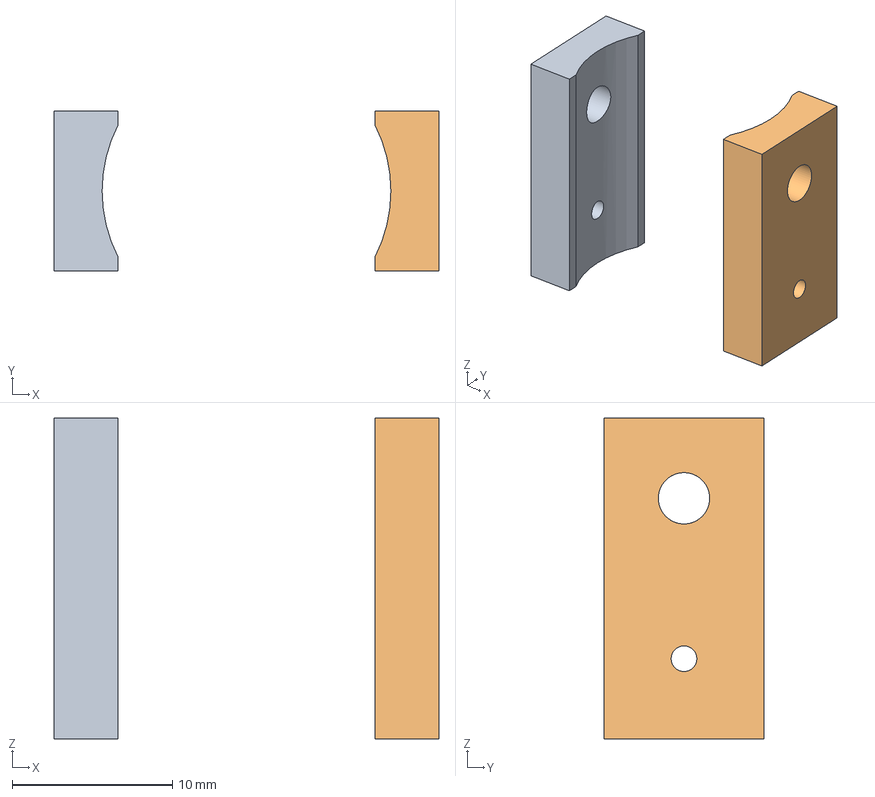
[picture p209: CAD file, 2026-11-14]
cad/print/all/199b_gate_holder_G4.step
24.0 x 10.0 x 20.0 mm
