britams/-capstone-project-repo/cad/print/all/102_collar.step

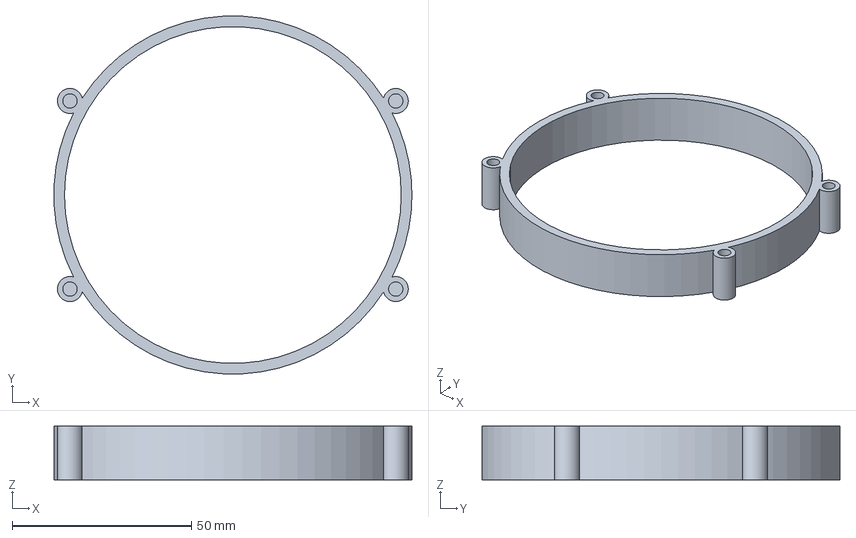
[picture p210: CAD file, 2026-11-14]
cad/print/all/102_collar.step
99.9 x 99.9 x 15.0 mm
