britams/-capstone-project-repo/cad/print/all/199a_pi_shelf.step

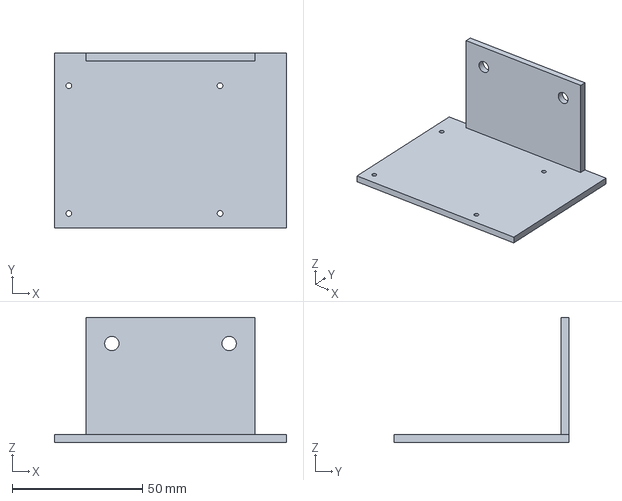
[picture p211: CAD file, 2026-11-14]
cad/print/all/199a_pi_shelf.step
89.0 x 67.0 x 48.0 mm
