britams/-capstone-project-repo/cad/print/all/217_x_motor_plate.step

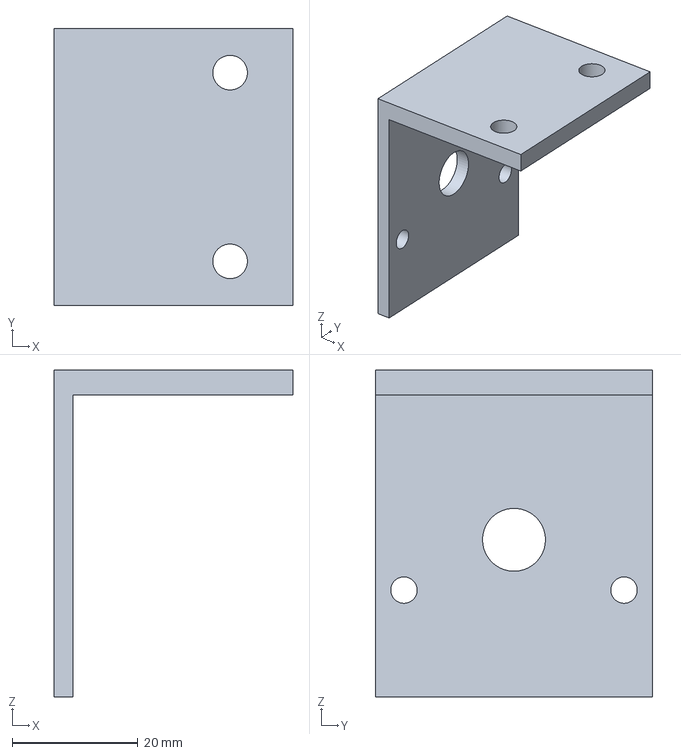
[picture p212: CAD file, 2026-11-14]
cad/print/all/217_x_motor_plate.step
38.0 x 44.0 x 52.0 mm
