britams/-capstone-project-repo/cad/print/all/176_release_gate_housing.step

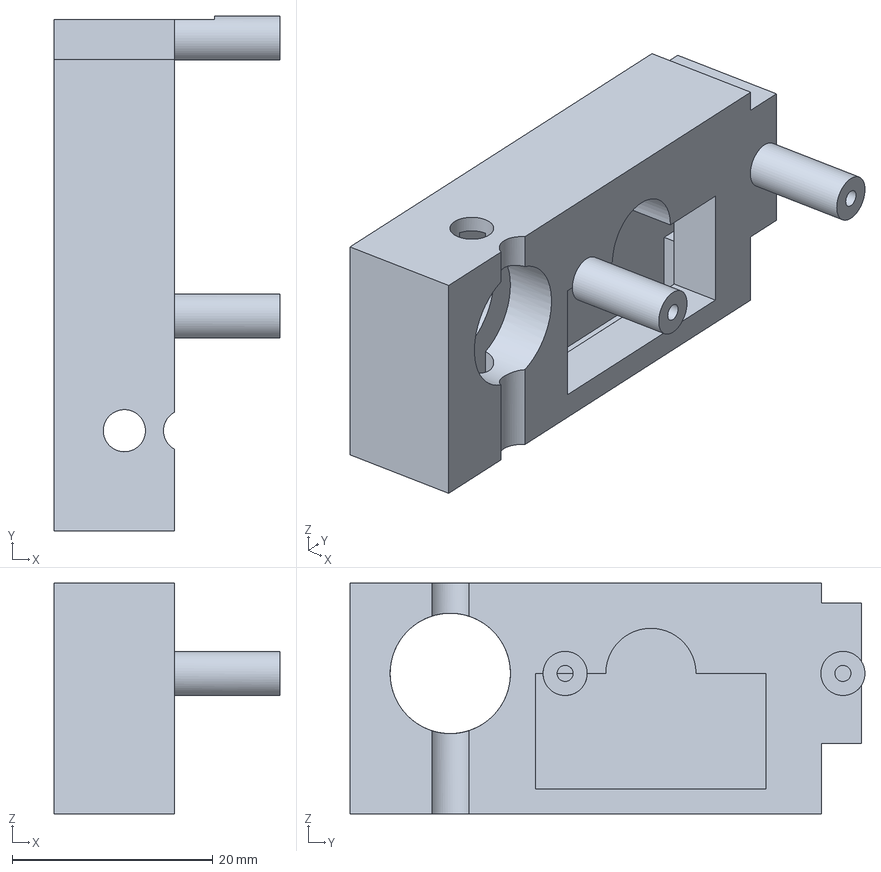
[picture p213: CAD file, 2026-11-14]
cad/print/all/176_release_gate_housing.step
22.5 x 51.4 x 23.0 mm
