britams/-capstone-project-repo/cad/print/all/110b_entry_bend.step

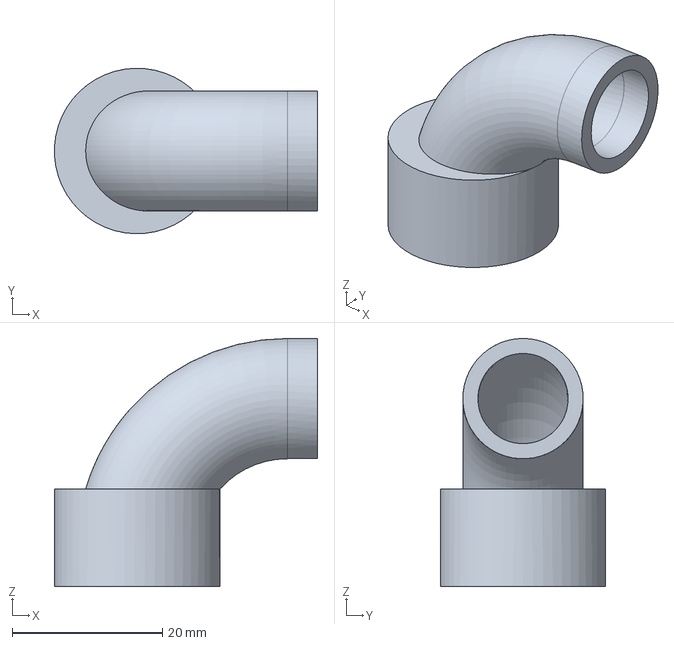
[picture p214: CAD file, 2026-11-14]
cad/print/all/110b_entry_bend.step
35.0 x 22.0 x 33.0 mm
