britams/-capstone-project-repo/cad/print/all/203_clamp_strap.step

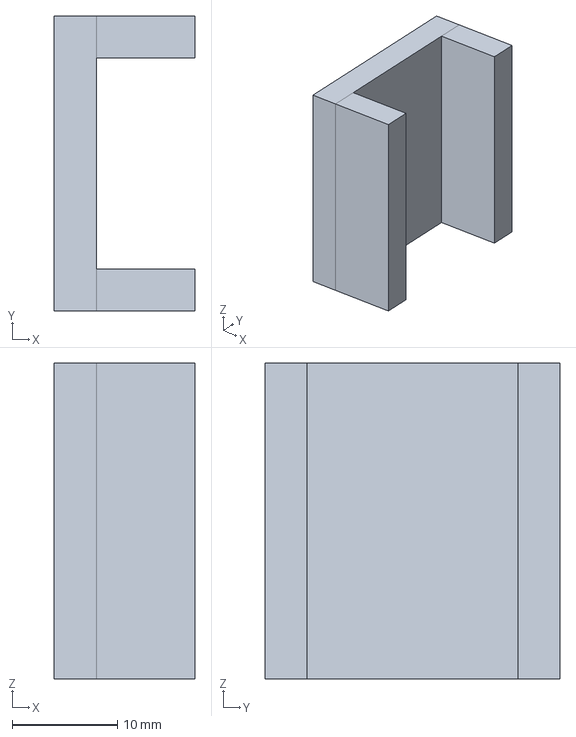
[picture p215: CAD file, 2026-11-14]
cad/print/all/203_clamp_strap.step
13.4 x 28.0 x 30.0 mm
