britams/-capstone-project-repo/cad/print/all/202_marker_holder_vblock.step

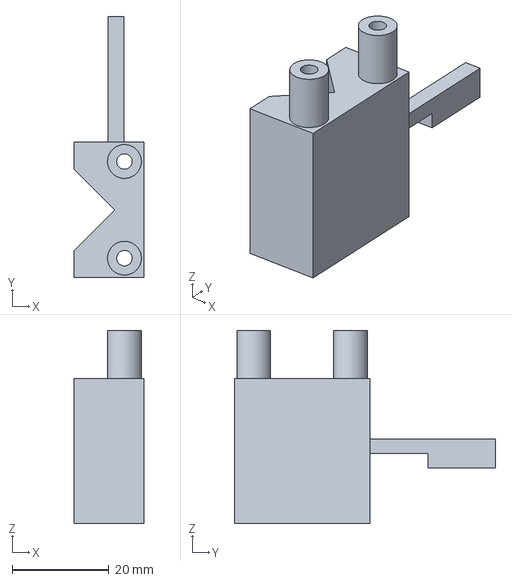
[picture p216: CAD file, 2026-11-14]
cad/print/all/202_marker_holder_vblock.step
14.4 x 54.0 x 40.0 mm
