britams/-capstone-project-repo/(list of files, cad)

Other CAD files:
cad/parts/feeder/A143_급이방_조립.FCStd
cad/D5d_module_an1_B_rest.FCStd
cad/split/S0_전체조립.FCStd
cad/D5d_module_an1_B_mark.FCStd
cad/D5c_module_an1_mark.FCStd
cad/D5_concept_an1_down.FCStd
cad/print/all/199d_gate_holder_G1_tx.step
cad/print/all/112_entry_gate_flap.step
cad/print/all/170_isolation_gate_housing.step
cad/print/all/197_uln_bracket_X.step
cad/print/all/176_release_gate_flap.step
cad/10.2_first_stamp_method_sketch.ipt
cad/print/all/102_collar.stl
cad/print/all/104_dome_coupling.stl
cad/print/all/110b_entry_bend.stl
cad/print/all/112_entry_gate_flap.stl
cad/print/all/112_entry_gate_housing.stl
cad/print/all/170_isolation_gate_flap.stl
cad/print/all/170_isolation_gate_housing.stl
cad/print/all/172b_isolation_bends.stl
cad/print/all/174_release_neck.stl
cad/print/all/175_release_shaft.stl
cad/print/all/176_release_gate_flap.stl
cad/print/all/176_release_gate_housing.stl
cad/print/all/181_camera_bracket.stl
cad/print/all/193h_wago_holder.stl
cad/print/all/194b_estop_plate.stl
cad/print/all/197_uln_bracket_X.stl
cad/print/all/197_uln_bracket_Y.stl
cad/print/all/199a_pi_shelf.stl
cad/print/all/199b_gate_holder_G4.stl
cad/print/all/199c_gate_holder_G6.stl
cad/print/all/199d_gate_holder_G1_tx.stl
cad/print/all/199e_gate_holder_G1_rx.stl
cad/print/all/202_marker_holder_vblock.stl
cad/print/all/203_clamp_strap.stl
cad/print/all/206_y_carriage.stl
cad/print/all/211_y_motor_bracket.stl
cad/print/all/212_beam_end_blocks.stl
cad/print/all/217_x_motor_plate.stl
cad/print/all/218_rod_supports.stl
cad/print/all/219_cap_cup.stl
cad/print/all/220_cup_bracket.stl
cad/print/all/226_x_home_clamp.stl
cad/print/all2/110_entry_duct.stl
cad/print/all2/111_entry_funnel.stl
cad/print/all2/143_feed_trough.stl
cad/print/all2/143a_angle_foot.stl
cad/print/all2/143b_angle_top.stl
cad/print/all2/143l_feed_trough_lid.stl
cad/print/all2/143p_post_sq12.stl
cad/print/all2/144b_feeder_holder.stl
cad/print/all2/172_isolation_duct_1.stl
cad/print/all2/172_isolation_duct_2.stl
cad/print/all2/172_isolation_duct_3.stl
cad/print/all2/172_isolation_duct_4.stl
cad/print/all2/173_isolation_funnel.stl
cad/print/lift/300_마킹실상자.FCStd
cad/print/lift/300_마킹실상자.stl
cad/print/lift/300p_아크릴격자판.FCStd
cad/print/lift/300p_아크릴격자판.dxf
cad/split/S2_마킹부_v3.FCStd
