britams/-capstone-project-repo/cad/D5e_전체조립도.png

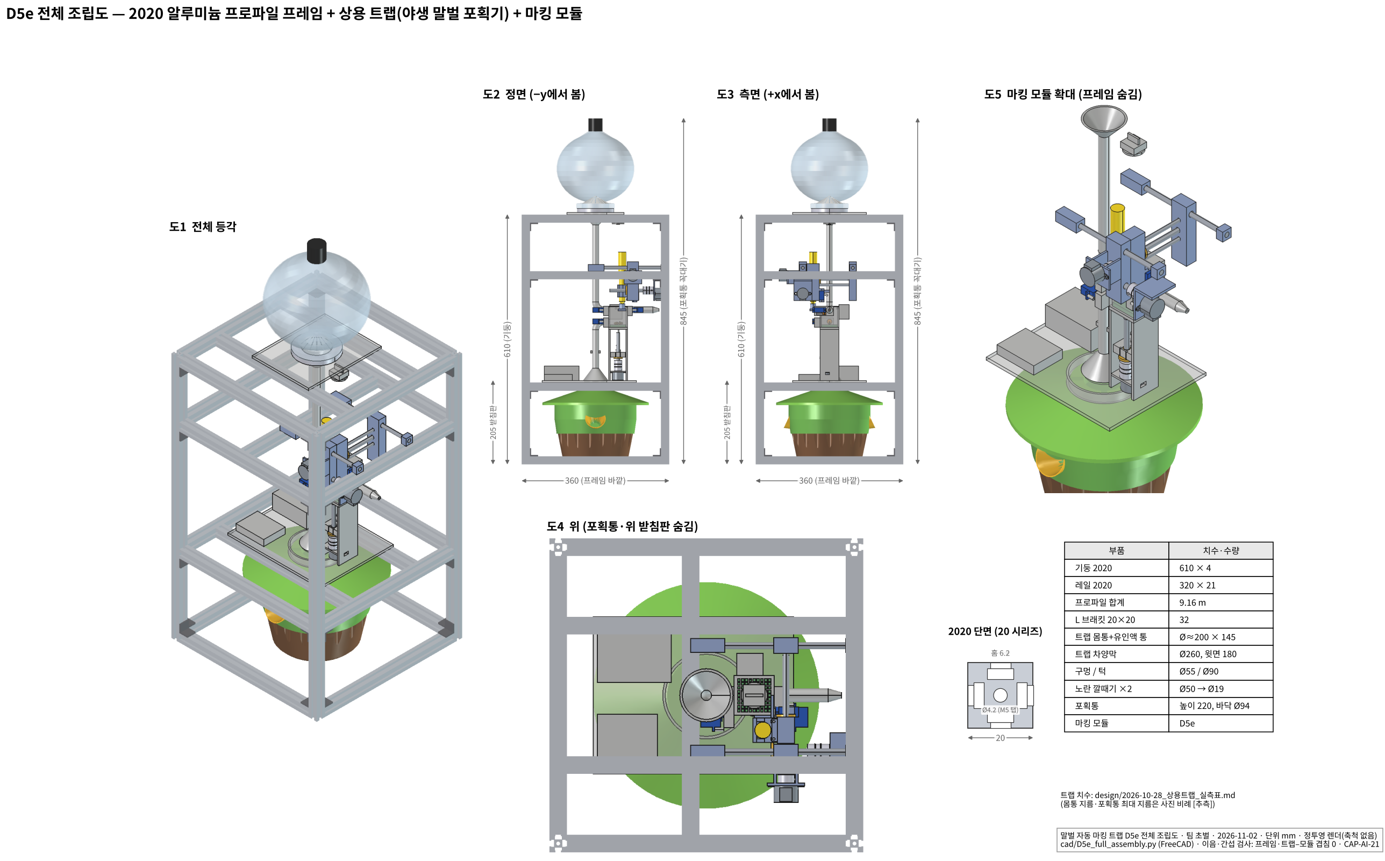
cad/D5e_전체조립도.png
