britams/-capstone-project-repo/cad/img/D5g_급이방_조립.png

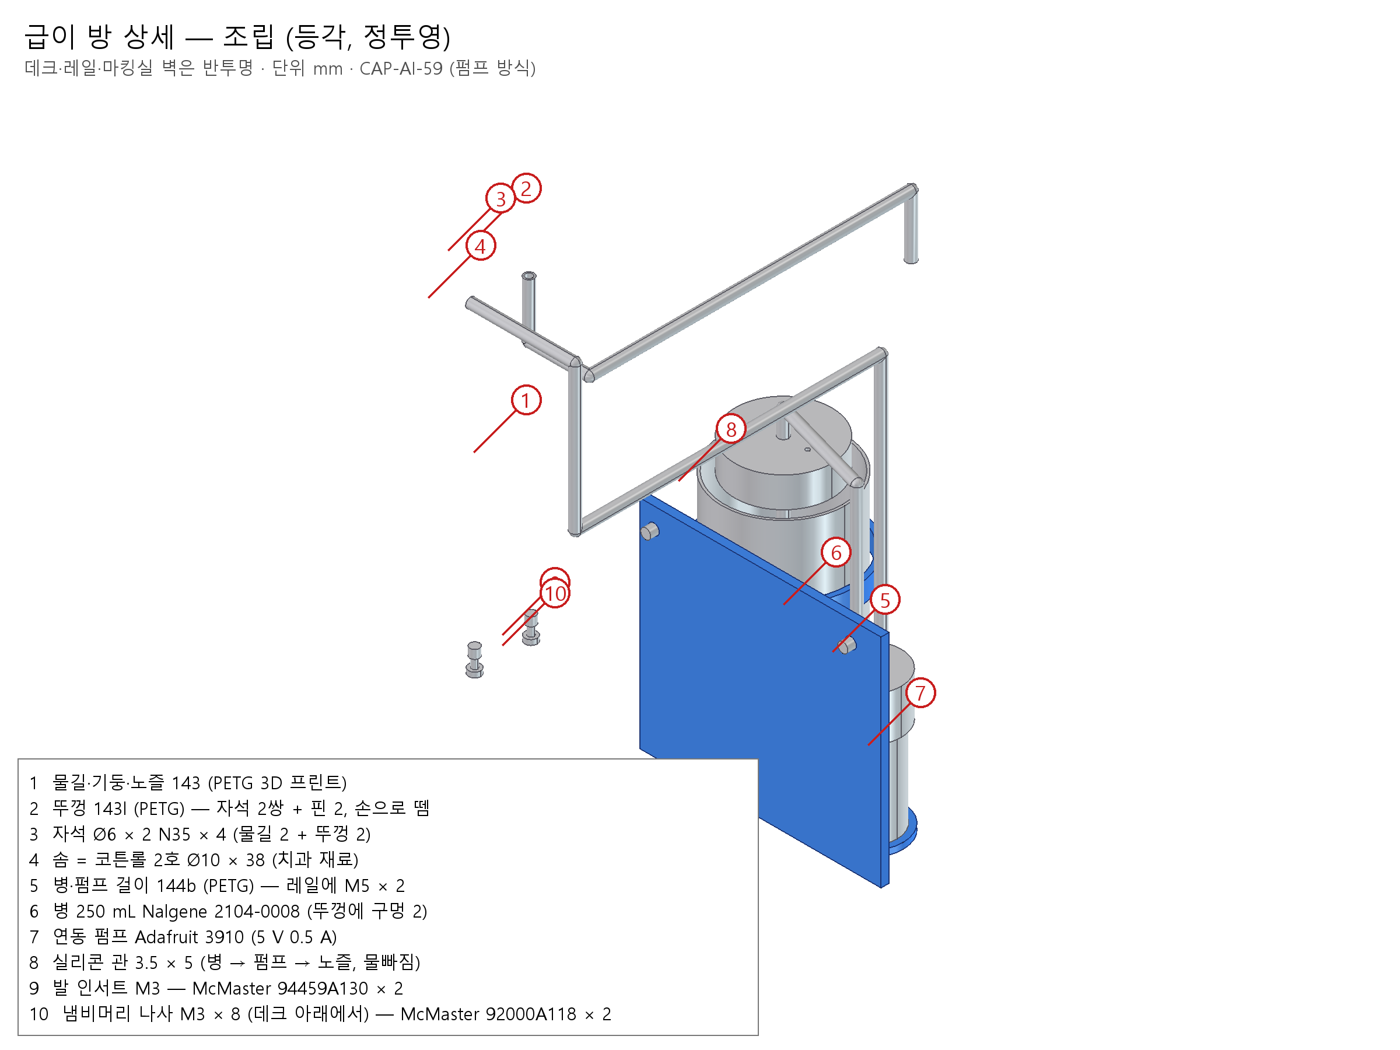
cad/img/D5g_급이방_조립.png
