britams/-capstone-project-repo/cad/img/parts/feeder/A143_급이방_조립.png

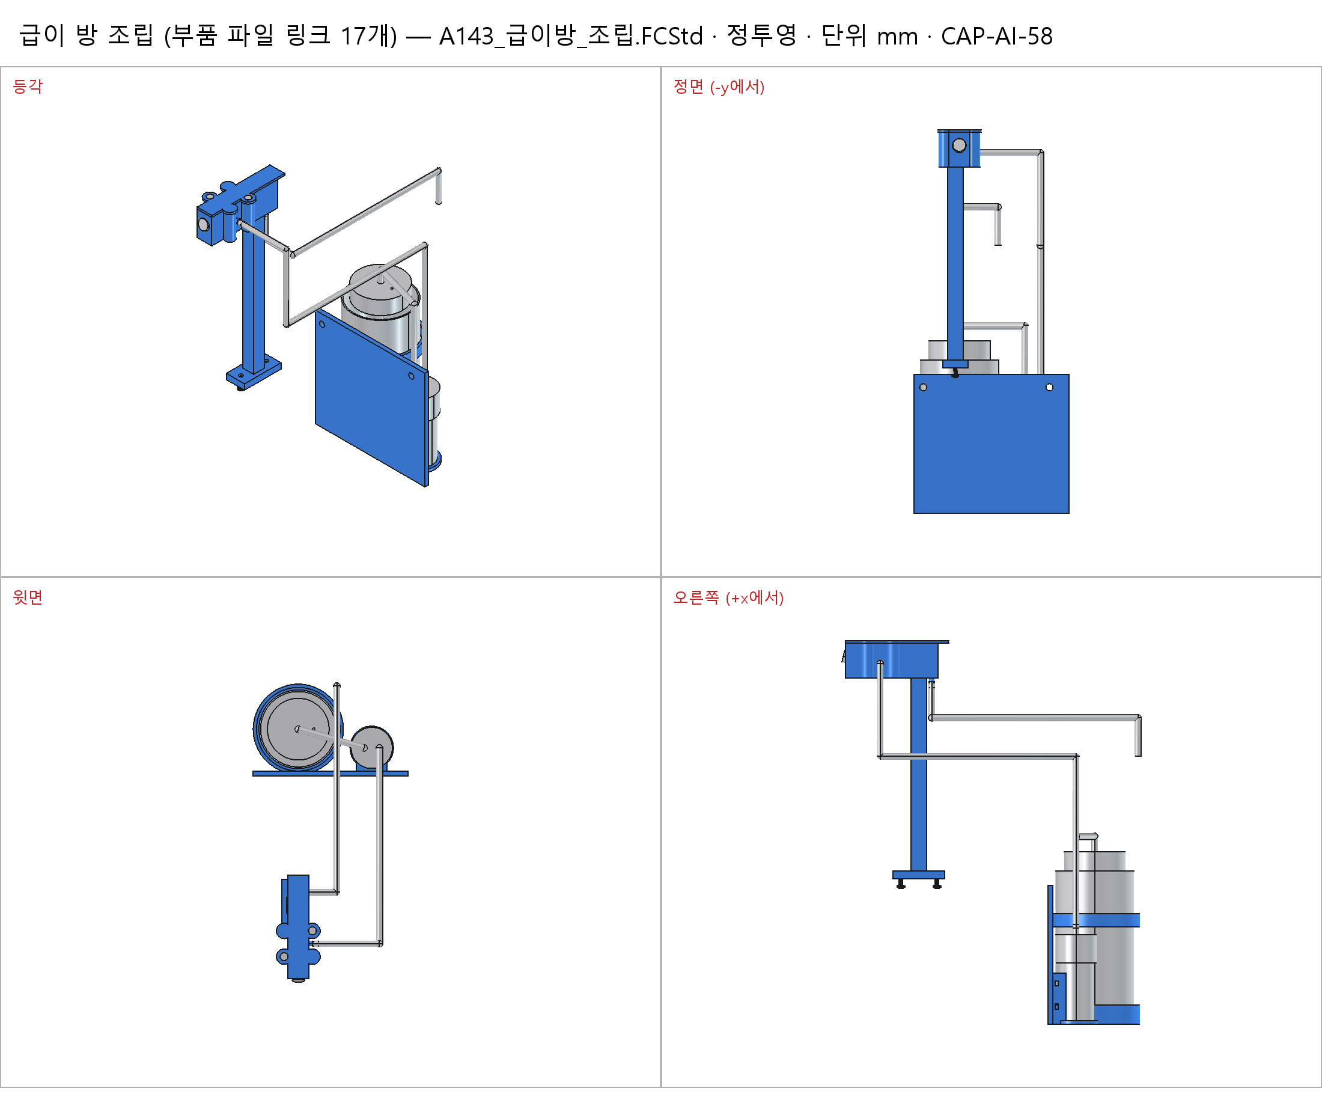
cad/img/parts/feeder/A143_급이방_조립.png
