britams/-capstone-project-repo/cad/print/lift/300_마킹실상자_아래.png

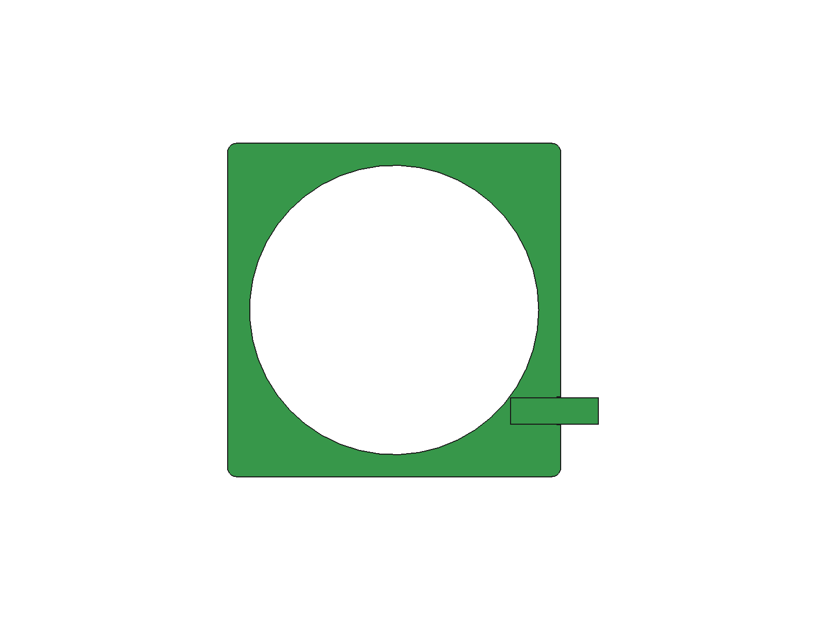
cad/print/lift/300_마킹실상자_아래.png
