britams/-capstone-project-repo/cad/print/lift/300_마킹실상자_정면.png

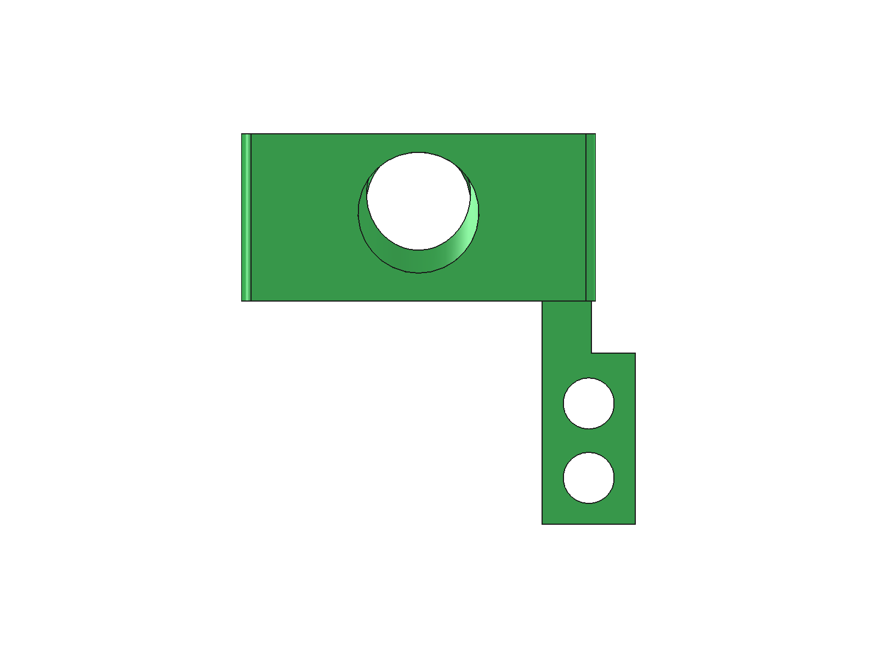
cad/print/lift/300_마킹실상자_정면.png
