britams/-capstone-project-repo/cad/print/lift/300p_아크릴격자판_등각.png

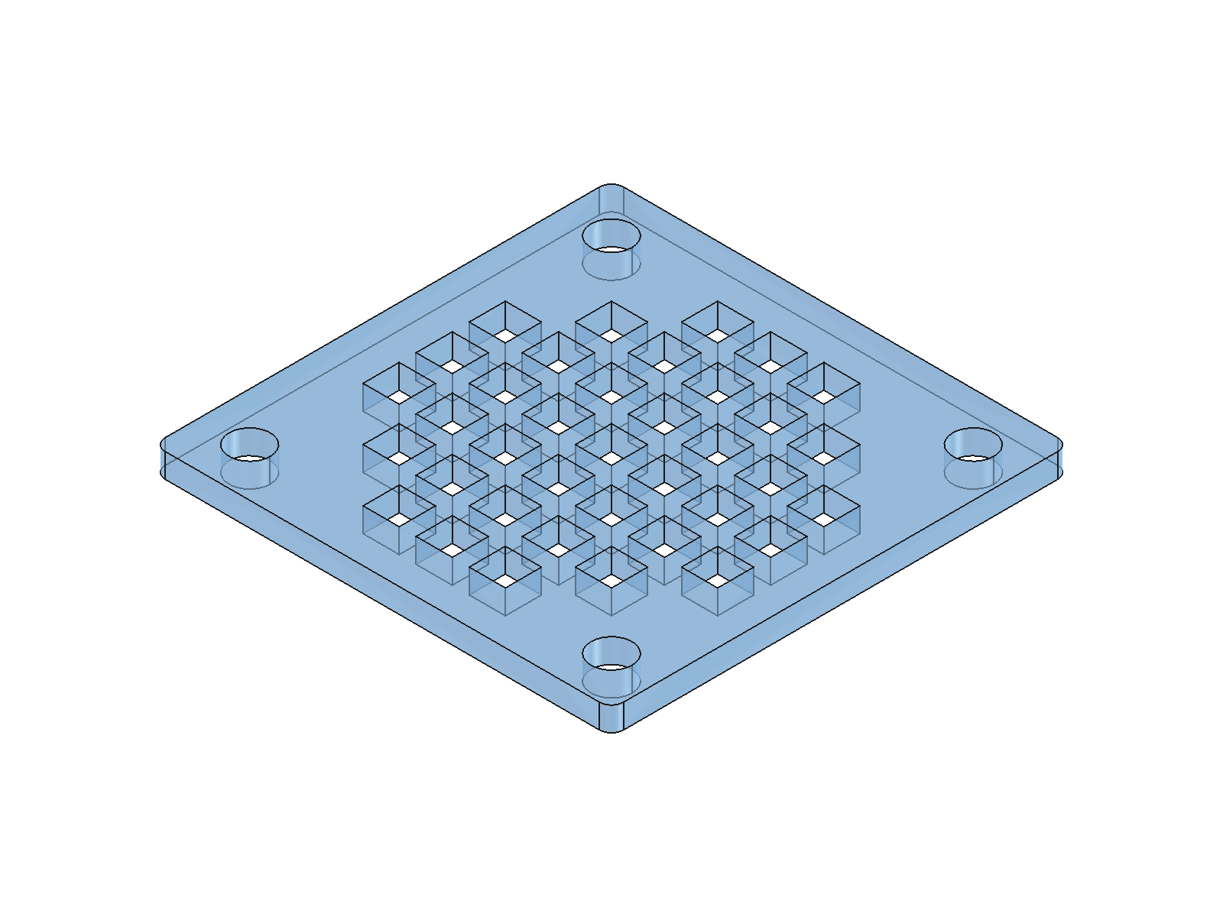
cad/print/lift/300p_아크릴격자판_등각.png
