britams/-capstone-project-repo/cad/print/lift/300pf_아크릴_묶음_미리보기.png

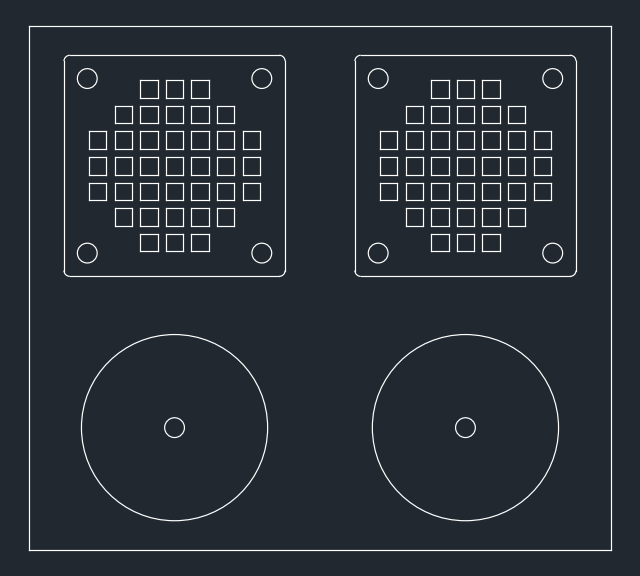
cad/print/lift/300pf_아크릴_묶음_미리보기.png
