britams/-capstone-project-repo/vision/results/2026-10-28_J1/result.tsv

정답종 | 프레임 | 검출_velutina | 검출_crabro | 원결과_velutina | 원결과_crabro | 개수일치 | 검출_신뢰도 | 원결과_신뢰도 | 추론초
velutina | frame-1.jpeg | 2 | 0 | 1 | 0 | X | 0.955,0.892 | 0.945 | 0.07
velutina | frame-2.jpeg | 2 | 0 | 1 | 0 | X | 0.955,0.895 | 0.946 | 0.05
velutina | frame-3.jpeg | 2 | 0 | 1 | 0 | X | 0.955,0.893 | 0.946 | 0.05
velutina | frame-4.jpeg | 2 | 0 | 2 | 0 | O | 0.955,0.898 | 0.947,0.881 | 0.05
velutina | frame-5.jpeg | 1 | 0 | 1 | 0 | O | 0.955 | 0.947 | 0.05
velutina | frame-6.jpeg | 1 | 0 | 2 | 0 | X | 0.956 | 0.949,0.886 | 0.05
velutina | frame-7.jpeg | 2 | 0 | 2 | 0 | O | 0.956,0.831 | 0.947,0.901 | 0.05
velutina | frame-8.jpeg | 2 | 0 | 2 | 0 | O | 0.958,0.900 | 0.949,0.864 | 0.06
velutina | frame-9.jpeg | 2 | 0 | 2 | 0 | O | 0.957,0.896 | 0.947,0.917 | 0.05
velutina | frame-10.jpeg | 2 | 0 | 2 | 0 | O | 0.958,0.824 | 0.950,0.827 | 0.05
velutina | frame-11.jpeg | 2 | 0 | 2 | 0 | O | 0.957,0.875 | 0.947,0.861 | 0.05
velutina | frame-12.jpeg | 2 | 0 | 2 | 0 | O | 0.957,0.856 | 0.947,0.854 | 0.05
velutina | frame-13.jpeg | 2 | 0 | 2 | 0 | O | 0.957,0.853 | 0.946,0.852 | 0.05
velutina | frame-14.jpeg | 2 | 0 | 2 | 0 | O | 0.957,0.910 | 0.947,0.921 | 0.05
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
