britams/-capstone-project-repo/design/vespai_check/results/2026-11-02_0257_서현_휴대폰화면_live.csv

time_s | condition | n_velutina | n_crabro | best_velutina_conf
1.1 | 전체 640 | 0 | 0 | 0.000
2.1 | 전체 640 | 0 | 0 | 0.000
3.2 | 전체 640 | 2 | 0 | 0.660
4.2 | 전체 640 | 2 | 0 | 0.828
5.2 | 전체 640 | 2 | 0 | 0.771
6.3 | 전체 640 | 1 | 0 | 0.510
7.4 | 전체 640 | 0 | 0 | 0.000
8.5 | 전체 640 | 1 | 0 | 0.671
9.5 | 전체 640 | 1 | 0 | 0.594
10.6 | 전체 640 | 1 | 0 | 0.549
11.6 | 전체 640 | 1 | 0 | 0.508
12.6 | 전체 640 | 1 | 0 | 0.513
13.7 | 전체 640 | 0 | 0 | 0.000
14.7 | 전체 640 | 1 | 0 | 0.538
15.8 | 전체 640 | 0 | 0 | 0.000
16.9 | 전체 640 | 1 | 0 | 0.505
17.9 | 전체 640 | 0 | 0 | 0.000
19.0 | 전체 640 | 1 | 0 | 0.610
20.1 | 전체 640 | 2 | 0 | 0.669
21.1 | 전체 640 | 1 | 0 | 0.611
22.2 | 전체 640 | 1 | 0 | 0.712
23.2 | 전체 640 | 1 | 0 | 0.693
24.3 | 전체 640 | 1 | 1 | 0.659
26.2 | 전체 640 | 1 | 1 | 0.691
27.2 | 전체 640 | 1 | 0 | 0.603
28.3 | 전체 640 | 2 | 0 | 0.546
29.3 | 전체 640 | 0 | 0 | 0.000
30.3 | 전체 640 | 2 | 0 | 0.653
31.4 | 전체 640 | 1 | 0 | 0.628
32.5 | 전체 640 | 1 | 0 | 0.647
33.6 | 전체 640 | 3 | 1 | 0.703
34.6 | 전체 640 | 3 | 2 | 0.640
35.7 | 전체 640 | 2 | 2 | 0.521
36.8 | 전체 640 | 3 | 2 | 0.740
37.8 | 전체 640 | 1 | 3 | 0.549
38.9 | 전체 640 | 1 | 0 | 0.665
40.0 | 전체 640 | 2 | 2 | 0.581
41.1 | 전체 640 | 0 | 2 | 0.000
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
