britams/-capstone-project-repo/vision/results/2026-10-28_J4_synthetic/nodot_000_검출.jpg

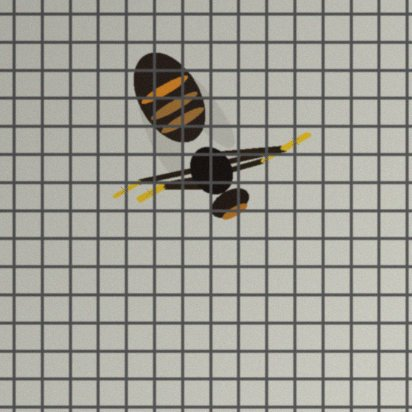
vision/results/2026-10-28_J4_synthetic/nodot_000_검출.jpg
