britams/-capstone-project-repo/cad/D5g_feeder_uln.py

# -*- coding: utf-8 -*-
"""D5g 추가 — 설탕물 급이 방(개념설계) + ULN2003 실제 보드·받침 + 공중 부양 검사 (승준, 2026-11-06, CAP-AI-SJ-40)

D5g_frame_detail.make() 가 부른다. 좌표는 D5e 좌표계 (원점 격자 가운데, +x 방생 문 쪽, +y 먹이통 쪽).

1) 설탕물 급이 방 — '병아리 물그릇' 원리 (뒤집은 병의 입구 높이가 물 높이를 정함, 펌프·전기 없음)
   흐름: 마킹 → 바닥을 급이 높이로 내림 → 말벌이 벽 구멍으로 2 mm 나온 코튼롤 끝을 빨아 먹음 → 방생 문 열림
   구매품: 팰컨 15 mL 원뿔 튜브(코닝 352096: 바깥 Ø17.37, 나사 Ø19.25, 길이 118.8, 원뿔 22.48) [확실 — 제조사 도면] (11/10: 50 mL 352070에서 바꿈)
           치과용 코튼롤 2호 Ø10 × 38 [가능성 높음 — 판매처 여러 곳 같은 값]
   설계품(3D 프린트, PETG — 설탕물·세척): 143 급이 물길(벽 → 그릇) + 튜브 그릇 + 기둥 → 발은 데크 위, M5 × 12로 데크를 지나 아래 2020 가로대(y +80) T너트에
   물 높이: 튜브 입구 z 366 (받침 리브 높이로 정함) — 벽 구멍 아래 끝 372.4보다 6.4 mm 낮음, 코튼롤 바깥 끝은 2 mm 잠김 (water_check(), 열팽창은 cad/feeder_check.py)
   바뀐 곳: 144 먹이통·142 심지(자리 상자) 지움, 120 마킹실 벽 +y 쪽에 Ø10.6 구멍 (x 55, z 378)
   튜브 자리 y 95: 마커 X 빔(212, y −74~66)이 x로 지나가는 자리 밖이라 위로 길어도 안 부딪침
2) ULN2003 드라이버 보드 — 판매품 35 × 31.9 × 11, M2.5 구멍 30 × 26.5 [가능성 높음 — 판매처 2곳 같은 값]
   X·Y 보드: 갠트리 둘레 레일(x 160~180, z 452~472) 윗면에 197 받침(3D 프린트) + M5 × 8 + T너트로 고정 (D5f 상자는 기둥 없는 곳에 떠 있었음)
   F 보드: 데크 위 같은 자리, 높이 5 받침 기둥 4개
3) floating(doc): 다른 부품과 0.3 mm 안에 닿지 않는 부품 목록 (빔·참고 제외)

(11/10 밤, 서현, CAP-AI-59) 급이를 '거꾸로 병'에서 '펌프로 먹일 때만 몇 방울'로 바꿈 — 서현 "사용자 편의성, 동력 써도 됨"
   튜브·그릇·받침 리브·튜브 집게·손나사·인서트(뚜껑) 없앰. 물길은 고인 물 없이 솜만 받침 (넘친 물 받이).
   물은 프레임 바깥 병(Nalgene 250 mL) → 연동 펌프(Adafruit 3910) → 관 → +x 벽 노즐 → 솜 위로 떨어짐. 병·펌프·관·걸이는 cad/D5g_feeder_pump.py
   뚜껑은 자석 2쌍 + 핀 2개 (공구 없이 손으로 뗌)
"""
import FreeCAD as App
import Part

V = App.Vector

# (11/06 밤 고침) 물 높이가 벽 구멍 아래 끝보다 높아 틈으로 새던 것 → 물 높이 369, 코튼롤을 바깥으로 10.6° 내려 바깥 끝만 잠김
#   벽 구멍 아래 끝 372.6 − 물 높이 369 = 3.6 mm 여유 ≥ 낮 열팽창 최대 2.6 mm (튜브 공기 50 mL, +25 K) [확실 — 계산, 문서 3장]
# (11/10 서현 고침, CAP-AI-56) 위 계산이 틀림: 물 면적에 튜브 자리까지 셈(1,616 → 실제 868 mm²) + 수증기 빠뜨림
#   → 50 mL 튜브면 맑은 날 +6.5 mm, 햇빛 +12.6 mm로 벽 구멍(여유 3.6) 넘어 마킹실로 샘 [확실 — cad/feeder_check.py]
#   고침: 15 mL 튜브(코닝 352096) + 물 높이 366 + 솜 끝을 벽 안 면 뒤로(바닥이 끝까지 올라도 안 닿음) → feeder_check.py 통과
FD = dict(x=55.0, roll_r=5.0, tip_y=21.4, tip_z=378.0, end_y=58.28, end_z=368.85,    # 코튼롤 Ø10 × 38: 안 끝(벽 속, 아래 모서리 y 20.2) → 바깥 끝(물길 바닥 364에 닿음)
          wall_hole_r=5.6, wall_hole_z=378.0,
          ch_w=12.0, ch_t=2.0, ch_y0=23.0, ch_y1=95.0, floor_z=361.0, floor_t=3.0, wall_top=388.0,
          front_t=2.0, front_hole_r=5.3,                                               # (11/10 상세) 물길 앞벽: 물길이 마킹실 벽에 안 붙어도 물이 안 새게 — 솜 구멍만 (솜 축 따라 Ø10.6)
          nz_y=50.0, nz_z=372.0, nz_bore=1.5, nz_L=10.0, nz_od=4.0, nz_barb=4.6,       # (11/10 밤, CAP-AI-59) 펌프 관 노즐: +x 벽 바깥 → 벽 안 면(솜과 1 mm)으로, 솜 축 높이(y 50에서 370.9) 조금 위
          dr_y=91.0,                                                                   # 물빠짐: 물길 바닥 끝(y 91 — 11/12: 니플 육각 모서리가 기둥 +y 면과 0.16 mm 겹쳐 90 → 91)에서 아래로 바브 → 관 → 프레임 밖 (고인 물이 생기면 바로 빠짐 — 넘침 0)
          post_y=80.0, post_w=12.0, post_foot_z=205.0,
          post_dx=-3.0)   # (SJ-49) 기둥을 x −3: 막대 로드셀(x 60.15~72.85, y ~77.5) 자리 비움   # 발: 데크(101) 윗면 z 205, 아래 2020 가로대 y +80
# (11/10 상세, CAP-AI-57) 발 고정을 '위에서 M5 + 가로대 T너트' → '데크 아래에서 M3 + 발 속 인서트'로:
#   위에서는 볼트 바로 위가 그릇(한 덩어리 출력)이라 드라이버가 못 들어가고, 옆으로 옮기면 서보 허브(x 30)·로드셀(x 74)에 막힘 [확실 — 모델 검사]
#   데크를 프레임에 올리기 전에 급이 방을 데크에 붙임 → 데크 아래가 열려 있어 드라이버가 들어감. 볼트는 가로대 띠(y 70~90) 밖 y 80 ∓ 14
# (11/12 서현 '마킹실 최소로') 마킹실 안 40 → 32: +y 벽이 y −4 → 급이 물길·솜·기둥을 같이 y −4 (DYF)
import D5e_module_kinematic as _K
DYF = (_K.CH["inner"] - 40.0) / 2.0
for _k in ("tip_y", "end_y", "ch_y0", "ch_y1", "nz_y", "dr_y", "post_y"):
    FD[_k] += DYF
FOOT = dict(t=2.0, half_x=10.0, half_y=20.0, dy=17.0)   # (11/12) dy 14 → 17: 기둥이 y −4 옮겨도 나사가 데크 아래 가로대(y 70~90) 밖   # (11/11, CAP-AI-61) 발 = 알루미늄 앵글 20 × 20 × 2 (길이 40)의 누운 다리 — 프린트 발 대신
# (11/11, CAP-AI-61) 서현 "3D 프린트 최대한 없게, 살 수 있으면 사" → 급이부 = 포맥스 판 접착 물길 + 알루미늄 각관 기둥 + 앵글 2 + M3 나사·너트 + 공압 M5 바브 니플 2
BUY = dict(sq=12.0, sq_t=1.0,                      # 알루미늄 각관 12 × 12 × 1 [가능성 높음 — 일반 규격]
           ang=20.0, ang_t=2.0, ang_L=40.0,         # 알루미늄 앵글 20 × 20 × 2 [가능성 높음]
           fit_thread=5.0, fit_L=5.0, fit_hex=9.2, fit_hex_t=3.0, fit_barb_L=8.0, fit_barb=4.0, fit_ridge=4.6, fit_bore=2.0,   # 공압 M5 호스 니플 (관 안 3~4) [가능성 높음 — 판매처 표로 확인]
           pad=12.0, pad_t=5.0,                     # 니플 받침 포맥스 5 mm (나사를 받는 두께)
           blk=10.0)                                # 뚜껑 자리 블록 포맥스 10 mm (10 × 10 × 높이)
ULN = dict(L=35.0, W=31.9, t=1.6, hx=30.0, hy=26.5, hole=2.7, stand=5.0)
ULN_SPOTS = {"X": (170.0, -30.0, 472.0, "rail"), "Y": (170.0, 22.0, 472.0, "rail"), "F": (55.0, -50.0, 205.0, "deck")}


def box(x0, x1, y0, y1, z0, z1):
    return Part.makeBox(x1 - x0, y1 - y0, z1 - z0, V(x0, y0, z0))


# ---------------- 급이 방 ----------------
def cotton_roll():
    f = FD
    p0 = V(f["x"], f["tip_y"], f["tip_z"])
    d = V(0, f["end_y"] - f["tip_y"], f["end_z"] - f["tip_z"])
    return Part.makeCylinder(f["roll_r"], d.Length, p0, d)


def feed_trough():
    """143: 물길(벽 바깥 y 23 → 끝 벽 y 95) + 기둥 → 데크. (11/10 밤) 그릇·리브 없앰 — 물은 펌프 노즐로 솜 위에"""
    f = FD
    x0, x1 = f["x"] - f["ch_w"] / 2 - f["ch_t"], f["x"] + f["ch_w"] / 2 + f["ch_t"]
    ch = box(x0, x1, f["ch_y0"], f["ch_y1"], f["floor_z"], f["wall_top"])
    ch = ch.cut(box(f["x"] - f["ch_w"] / 2, f["x"] + f["ch_w"] / 2, f["ch_y0"] + f["front_t"], f["ch_y1"] - f["ch_t"], f["floor_z"] + f["floor_t"], f["wall_top"] + 1))
    return ch.cut(front_hole()).removeSplitter()


PLACES = {}


def feeder_hardware():
    """(11/11, CAP-AI-61) 사는 것: 기둥 각관, 앵글 2 (발·위), M3 나사·너트, 공압 M5 바브 니플 2 (노즐·물빠짐)
    발 앵글: 누운 다리 x 40~60 (데크 위, 나사 x 52 · y 80 ± 14 데크 아래에서), 선 다리 x 58~60 (각관 +x 면)
    위 앵글: 누운 다리 x 40~60 z 359~361 (물길 바닥 아래, M3로 바닥과), 선 다리 x 58~60 z 341~361 (각관과 M3)"""
    f, b = FD, BUY
    px, py = f["x"] + f["post_dx"], f["post_y"]
    h = b["sq"] / 2
    z0, z1 = f["post_foot_z"] + b["ang_t"], f["floor_z"] - b["ang_t"]
    post = box(px - h, px + h, py - h, py + h, z0, z1).cut(box(px - h + b["sq_t"], px + h - b["sq_t"], py - h + b["sq_t"], py + h - b["sq_t"], z0 - 1, z1 + 1))
    L, t, a = b["ang_L"], b["ang_t"], b["ang"]
    xa0, xa1 = px - 12.0, px + h + t                       # 40 ~ 60
    yt0, yt1 = py - 16.0, py + 4.0                         # 위 앵글은 길이 20 (y 64~84): 물빠짐 받침(y 84~96)을 비킴
    def angle(zb, up, y0, y1):
        lay = box(xa0, xa1, y0, y1, zb, zb + t)
        if up:
            st = box(xa1 - t, xa1, y0, y1, zb, zb + a)
        else:
            st = box(xa1 - t, xa1, y0, y1, zb + t - a, zb + t)
        return lay.fuse(st)
    foot = angle(f["post_foot_z"], True, py - L / 2, py + L / 2)
    top = angle(f["floor_z"] - t, False, yt0, yt1)
    holes = []
    for sy in (-FOOT["dy"], FOOT["dy"]):
        holes.append(Part.makeCylinder(1.7, 10, V(px, py + sy, f["post_foot_z"] - 5)))
    holes.append(Part.makeCylinder(1.7, 30, V(xa1 + 5, py, f["post_foot_z"] + 12), V(-1, 0, 0)))
    holes.append(Part.makeCylinder(1.7, 30, V(xa1 + 5, py - 1.0, f["floor_z"] - 12), V(-1, 0, 0)))
    foot, top = foot.cut(Part.makeCompound(holes)), top.cut(Part.makeCompound(holes))
    post = post.cut(Part.makeCompound(holes))
    sc, nu = [], []
    PLACES.clear(); PLACES.update(screw=[], nut=[], nipple=[])  # (11/12, CAP-AI-62) 산 STEP을 같은 자리에 놓으려고 (s1_vendor.py)
    def screw(p, d, L_, n):                                # 냄비머리 M3: 머리 Ø5.5 × 2, 머리가 p, 몸이 d 방향
        sc.append(Part.makeCylinder(2.75, 2.0, p - d * 2.0, d).fuse(Part.makeCylinder(1.5, L_, p, d)))
        q = p + d * n
        nu.append(Part.makeCylinder(3.15, 2.4, q, d).cut(Part.makeCylinder(1.5, 3, q - d * 0.2, d)))
        PLACES["screw"].append((p, d, L_))
        PLACES["nut"].append((q, d))
    for sy in (-FOOT["dy"], FOOT["dy"]):                   # 데크 아래(z 200)에서 위로 M3 × 12 → 앵글 위 너트
        screw(V(px, py + sy, f["post_foot_z"] - 5.0), V(0, 0, 1), 12.0, 5.0 + t)
    # (11/12, CAP-AI-62) 너트가 각관 −x 벽 속에 박혀 있었음 (STEP 너트로 27 mm³ 겹침) — 닫힌 각관 안에서는 너트를 잡을 수도 없음
    #   → M3 × 18이 앵글 2 + 각관 12를 다 지나고, 너트는 각관 −x 바깥 면에 (나사 끝이 너트 밖으로 1.6)
    screw(V(xa1, py, f["post_foot_z"] + 12), V(-1, 0, 0), 18.0, t + b["sq"])
    screw(V(xa1, py - 1.0, f["floor_z"] - 12), V(-1, 0, 0), 18.0, t + b["sq"])
    # (11/12, 서현 '에폭시 접착') 위 앵글 → 물길 바닥은 나사 대신 2액 에폭시 — 바닥에 구멍이 없어 설탕물이 새거나 너트에 닿지 않음
    # 바브 니플 2: 노즐 (+x 벽 받침 → −x 방향 나사), 물빠짐 (바닥 아래 받침 → +z 방향 나사)
    def nipple(p, d):                                      # p = 받침 바깥 면, d = 나사가 들어가는 방향
        PLACES["nipple"].append((p, d))
        th = Part.makeCylinder(b["fit_thread"] / 2, b["fit_L"], p, d)
        hx = Part.makeCylinder(b["fit_hex"] / 2, b["fit_hex_t"], p - d * b["fit_hex_t"], d)
        bb = Part.makeCylinder(b["fit_barb"] / 2, b["fit_barb_L"], p - d * (b["fit_hex_t"] + b["fit_barb_L"]), d)
        rg = Part.makeCone(b["fit_ridge"] / 2, b["fit_barb"] / 2, 2.0, p - d * (b["fit_hex_t"] + b["fit_barb_L"]), d)
        return th.fuse(hx).fuse(bb).fuse(rg).cut(Part.makeCylinder(b["fit_bore"] / 2 - 0.2, 40, p - d * 20, d))
    xw = f["x"] + f["ch_w"] / 2 + f["ch_t"]
    nz = nipple(V(xw + b["pad_t"], f["nz_y"], f["nz_z"]), V(-1, 0, 0))
    dr = nipple(V(f["x"], f["dr_y"], f["floor_z"] - b["pad_t"]), V(0, 0, 1))
    return post.removeSplitter(), foot.removeSplitter(), top.removeSplitter(), Part.makeCompound(sc), Part.makeCompound(nu), Part.makeCompound([nz, dr])


def front_hole():
    """물길 앞벽(y ch_y0 ~ +front_t)의 솜 구멍 — 솜 축을 따라 (11/10)"""
    f = FD
    t = V(f["x"], f["tip_y"], f["tip_z"]); e = V(f["x"], f["end_y"], f["end_z"]); d = (e - t).normalize()
    return Part.makeCylinder(f["front_hole_r"], 30, t - d * 10, d)


def front_hole_bottom():
    """앞벽 구멍 아래 끝 z (물이 넘어가는 높이) — 앞벽 안쪽 면에서"""
    import math
    f = FD
    y = f["ch_y0"] + f["front_t"]
    th = math.atan2(f["tip_z"] - f["end_z"], f["end_y"] - f["tip_y"])
    zc = f["tip_z"] - (y - f["tip_y"]) * math.tan(th)
    return zc - f["front_hole_r"] / math.cos(th)


def wall_hole():
    f = FD
    return Part.makeCylinder(f["wall_hole_r"], 12, V(f["x"], 15.0 + DYF, f["wall_hole_z"]), V(0, 1, 0))


# ---------------- ULN2003 보드 (판매품 외형) ----------------
def uln_board(cx, cy, z0):
    """보드 아래 면이 z0+stand. 35는 x, 31.9는 y. 부품: DIP16, XH 5핀(흰), 핀 헤더 6, LED 4"""
    u = ULN
    zb = z0 + u["stand"]
    pcb = box(cx - u["L"] / 2, cx + u["L"] / 2, cy - u["W"] / 2, cy + u["W"] / 2, zb, zb + u["t"])
    for sx in (-1, 1):
        for sy in (-1, 1):
            pcb = pcb.cut(Part.makeCylinder(u["hole"] / 2, 5, V(cx + sx * u["hx"] / 2, cy + sy * u["hy"] / 2, zb - 1)))
    zt = zb + u["t"]
    chip = box(cx - 9.65, cx + 9.65, cy - 3.2 + 4, cy + 3.2 + 4, zt, zt + 3.3)                  # ULN2003A DIP-16
    xh = box(cx - 6.2, cx + 6.2, cy - 15.9, cy - 10.1, zt, zt + 7.0)                            # 모터 소켓 XH 5핀
    hdr = box(cx + 11.0, cx + 13.5, cy - 7.6, cy + 7.6, zt, zt + 8.5)                           # 입력 핀 6
    leds = [Part.makeCylinder(1.5, 5.0, V(cx - 12 + 4 * i, cy + 13.0, zt)) for i in range(4)]
    stands = [Part.makeCylinder(2.5, u["stand"], V(cx + sx * u["hx"] / 2, cy + sy * u["hy"] / 2, z0)) for sx in (-1, 1) for sy in (-1, 1)]
    board = pcb.fuse([chip, xh, hdr] + leds)
    return board, Part.makeCompound(stands)


def uln_rail_bracket(cx, cy, z0):
    """197: 레일 윗면(z0)에 놓는 판 38 × 52 × 3 — 가운데 키(홈에), M5 구멍 2 (y ±22), 보드 기둥 4 자리는 판 위"""
    p = box(cx - 19, cx + 19, cy - 26, cy + 26, z0, z0 + 3)
    p = p.fuse(box(cx - 2.8, cx + 2.8, cy - 26, cy + 26, z0 - 0.5, z0))
    for sy in (-22, 22):
        p = p.cut(Part.makeCylinder(2.75, 10, V(cx, cy + sy, z0 - 2)))
    return p.removeSplitter()


def make_into(doc, G):
    """doc(D5g)에 급이 방과 ULN2003 실제 보드를 넣는다. G = D5g_frame_detail 모듈 (볼트·T너트 모양)"""
    rm = [o for o in doc.Objects if o.Label.startswith(("144_food_tank", "142_feeder_wick", "195_uln2003"))]
    for o in rm:
        doc.removeObject(o.Name)
    for o in doc.Objects:
        if o.Label.startswith("120_chamber_walls"):
            o.Shape = o.Shape.cut(wall_hole()).removeSplitter()
            o.Label = "120_chamber_walls (+y 벽 Ø10.6 급이 구멍)"
    add = []
    add.append(("142n_cotton_roll_#2 (Ø10×38, 구매)", cotton_roll(), (0.97, 0.97, 0.92)))
    add.append(("143_feed_trough (설탕물 방 물길·그릇·기둥, 3D 프린트 PETG)", feed_trough(), None))
    f = FD
    # (11/10, CAP-AI-58) 기둥 발 M5 볼트·T너트는 만들지 않음 — 발은 데크 아래 M3 (11/11부터 앵글 + 너트, feeder_hardware). 예전에는 여기서 만든 M5 머리를
    #   겹침 고침 단계가 발에서 파낸 뒤(홈 2개, 깊이 3) 볼트만 지워져서 홈이 남았음 [확실 — 부품 파일과 비교 129.5 mm³]
    fb, ft = [], []
    for o in doc.Objects:
        if o.Label.startswith("101_deck"):
            sh = o.Shape
            for sy in (-FOOT["dy"], FOOT["dy"]):    # (11/10) 발 M3 구멍 Ø3.4 (아래에서 M3 × 8)
                sh = sh.cut(Part.makeCylinder(1.7, 20, V(f["x"] + f["post_dx"], f["post_y"] + sy, f["post_foot_z"] - 10)))
            for sx in (-1, 1):
                for sy in (-1, 1):
                    cx, cy, _z, _k = ULN_SPOTS["F"]
                    sh = sh.cut(Part.makeCylinder(1.35, 20, V(cx + sx * ULN["hx"] / 2, cy + sy * ULN["hy"] / 2, f["post_foot_z"] - 10)))
            o.Shape = sh.removeSplitter()
            o.Label = "101_deck (급이 발 M3 구멍 2, F 보드 M2.5 구멍 4)"
    for k, (cx, cy, z0, kind) in ULN_SPOTS.items():
        if kind == "rail":
            br = uln_rail_bracket(cx, cy, z0)
            add.append(("197_uln_bracket_%s (3D 프린트)" % k, br, None))
            zb = z0 + 3
            for sy in (-22, 22):
                p = (cx, cy + sy, zb)
                fb.append(Part.makeCylinder(2.5, 8, V(*p), V(0, 0, -1)).fuse(Part.makeCylinder(4.25, 5, V(*p))))
                t = G.tnut_local("rail")
                t.translate(V(-G.BR["hole_at"], 0, 0))
                t.rotate(V(0, 0, 0), V(0, 0, 1), 90)        # 길이 방향을 레일(y) 방향으로
                t.translate(V(cx, cy + sy, z0))
                ft.append(t)
        else:
            zb = z0
        board, stands = uln_board(cx, cy, zb)
        add.append(("195p_uln2003_%s (판매품 35×31.9)" % k, board, (0.10, 0.50, 0.25)))
        add.append(("198_uln_standoff_%s (M2.5 × 5 기둥 4, 구매)" % k, stands, (0.80, 0.70, 0.30)))
    add.append(("100h_bolt_M5x8_mounts", Part.makeCompound(fb), (0.1, 0.1, 0.1)))
    add.append(("100i_tnut_M5_mounts", Part.makeCompound(ft), (0.85, 0.75, 0.20)))
    objs = []
    for nm, shp, col in add:
        o = doc.addObject("Part::Feature", "SJ%02d" % len(objs))
        o.Label = nm
        o.Shape = shp
        objs.append((o, col))
    doc.recompute()
    return objs


def floating(doc, tol=0.3):
    """보이는 부품 중 다른 어떤 부품과도 tol 안에 닿지 않는 것 (떠 있는 것)"""
    skip = ("REF_", "196_gate", "SJ_fit")
    obs = [o for o in doc.Objects if hasattr(o, "Shape") and o.TypeId != "App::DocumentObjectGroup" and not o.Shape.isNull()
           and (not App.GuiUp or o.ViewObject.Visibility) and not o.Label.startswith(skip)]
    out = []
    for o in obs:
        b = o.Shape.BoundBox
        bb = App.BoundBox(b.XMin - tol, b.YMin - tol, b.ZMin - tol, b.XMax + tol, b.YMax + tol, b.ZMax + tol)
        ok = False
        for p in obs + [x for x in doc.Objects if x.Label.startswith("REF_trap") and hasattr(x, "Shape")]:
            if p is o or not bb.intersect(p.Shape.BoundBox):
                continue
            if o.Shape.distToShape(p.Shape)[0] <= tol:
                ok = True
                break
        if not ok:
            out.append(o.Label)
    return out


# ---------------- 떠 있던 부품 받침 (floating 검사에서 나온 것) ----------------
PI = dict(L=85.0, W=56.0, hx=58.0, hy=49.0, off=3.5, hole=2.7, h=35.0)   # Pi 5 + AI HAT+ (라즈베리파이 B 폼팩터: 구멍 58 × 49, 모서리 3.5) [확실 — 공식 기계 도면 규격]


def support_fixes(doc):
    """190 Pi 5 + AI HAT+ 를 위 가로대(y +80) 안쪽 면에 거는 선반(199a)에 얹고, G4·G6 빛 게이트 송수신기를 덕트에 붙이는 받침(199b·c)"""
    import D5e_module_kinematic as K
    out = []
    pi = [o for o in doc.Objects if o.Label.startswith("190_pi5_aihat (위판 아래")][0]
    b = pi.Shape.BoundBox
    x0, x1, z0 = b.XMin, b.XMax, b.ZMin
    rail_y = K.FR["cross_y"] - 10.0                 # 위 가로대 안쪽 면 (y 70)
    rail_z0 = K.FR["top_z"]
    y0 = rail_y - 3.0 - PI["W"] - 6.0             # (SJ-49) 벽 볼트 머리(5) 자리만큼 Pi를 6 mm 띄움
    # Pi를 판매품 크기(85 × 56)로, 선반 쪽에 붙여 다시 놓음 (구멍 4개 표시)
    board = box(x0, x0 + PI["L"], y0, y0 + PI["W"], z0, z0 + PI["h"])
    for sx in (0, PI["hx"]):
        for sy in (0, PI["hy"]):
            board = board.cut(Part.makeCylinder(PI["hole"] / 2, PI["h"] + 2, V(x0 + PI["off"] + sx, y0 + PI["off"] + sy, z0 - 1)))
    pi.Shape = board
    pi.Label = "190_pi5_aihat (85 × 56 판매품 외곽, 선반 199a 위)"
    shelf = box(x0 - 2, x0 + PI["L"] + 2, y0 - 2, rail_y, z0 - 3, z0)
    wall = box(x0 + 10, x0 + PI["L"] - 10, rail_y - 3, rail_y, z0 - 3, rail_z0 + 20)
    shp = shelf.fuse(wall)
    for sx in (x0 + 20, x0 + PI["L"] - 20):
        shp = shp.cut(Part.makeCylinder(2.75, 10, V(sx, rail_y - 5, rail_z0 + 10), V(0, 1, 0)))
    for sx in (0, PI["hx"]):
        for sy in (0, PI["hy"]):
            shp = shp.cut(Part.makeCylinder(1.1, 5, V(x0 + PI["off"] + sx, y0 + PI["off"] + sy, z0 - 4)))   # M2.5 셀프 탭 구멍
    out.append(("199a_pi_shelf (3D 프린트, 위 가로대 y+80에 M5 × 8 2개)", shp.removeSplitter()))
    for lab, nm in (("196_gate_G4_tx_rx", "199b_gate_holder_G4 (3D 프린트, 덕트 172에 끼움)"), ("196_gate_G6_tx_rx", "199c_gate_holder_G6 (3D 프린트, 덕트 174에 끼움)")):
        g = [o for o in doc.Objects if o.Label == lab][0]
        duct = [o for o in doc.Objects if o.Label.startswith("172_" if "G4" in lab else "174_")][0]
        pieces = []
        for s in g.Shape.Solids:
            d, pts, _ = s.distToShape(duct.Shape)
            p_s, p_d = pts[0]
            sb = s.BoundBox
            # 송수신기 면 → 덕트 면 사이를 송수신기 단면 크기로 채우는 받침
            lo = V(min(p_s.x, p_d.x), min(p_s.y, p_d.y), min(p_s.z, p_d.z))
            hi = V(max(p_s.x, p_d.x), max(p_s.y, p_d.y), max(p_s.z, p_d.z))
            for ax in ("x", "y", "z"):
                if getattr(hi, ax) - getattr(lo, ax) < 0.01:
                    setattr(lo, ax, getattr(sb, ax.upper() + "Min"))
                    setattr(hi, ax, getattr(sb, ax.upper() + "Max"))
            pieces.append(box(lo.x, hi.x, lo.y, hi.y, lo.z, hi.z))
        out.append((nm, Part.makeCompound(pieces)))
    objs = []
    for nm, shp in out:
        o = doc.addObject("Part::Feature", "SJF%d" % len(objs))
        o.Label = nm
        o.Shape = shp
        objs.append(o)
    doc.recompute()
    return objs


def gate_holders_fix(doc):
    """(11/11, CAP-AI-61) 서현 '네모 회색 부품은 뭐 하는 거야, 똑바로 붙여' — 빛 게이트 송수신기(Adafruit 2167)가 통로에서 떠 있었음.
    원인 [확실 — 코드]: 받침 199b·c를 옛 상자 모양 송수신기로 먼저 만들고, 그 뒤 D5g_real_parts가 송수신기를 2167 모양으로 바꿔서 틈이 생김.
    고침: 2167로 바꾼 뒤 받침을 다시 만듦 — 송수신기 렌즈 면 ↔ 통로 바깥 면 사이를 송수신기 면 크기(20 × 10)로 채우는 작은 받침,
    빔 구멍 Ø3.2. 받침은 통로에 순간접착, 송수신기는 받침에 양면테이프 (작고 단순한 프린트 — 서현 11/11 '작은 건 프린트 OK').
    입구 G1(114)도 같은 식으로 봄. 반환: [(이름, 틈 mm 전, 후)]"""
    jobs = (("196_gate_G4_tx_rx", "172_", "199b_gate_holder_G4"), ("196_gate_G6_tx_rx", "174_", "199c_gate_holder_G6"),
            ("114_entry_sensor_tx", "110_", "199d_gate_holder_G1_tx"), ("114_entry_sensor_rx", "110_", "199e_gate_holder_G1_rx"))
    rep = []
    for lab, duct_pre, hname in jobs:
        g = [o for o in doc.Objects if o.Label.startswith(lab)]
        duct = [o for o in doc.Objects if o.Label.startswith(duct_pre)]
        if not g or not duct:
            continue
        pieces = []
        for s in g[0].Shape.Solids:
            dmin, pts, _ = s.distToShape(duct[0].Shape)
            if dmin < 0.05:
                rep.append((lab, round(dmin, 2), "붙어 있음"))
                continue
            p_s, p_d = pts[0]
            sb = s.BoundBox
            ax = max(range(3), key=lambda i: abs([p_d.x - p_s.x, p_d.y - p_s.y, p_d.z - p_s.z][i]))
            lo = [sb.XMin, sb.YMin, sb.ZMin]
            hi = [sb.XMax, sb.YMax, sb.ZMax]
            a0, a1 = sorted(([p_s.x, p_s.y, p_s.z][ax], [p_d.x, p_d.y, p_d.z][ax]))
            lo[ax], hi[ax] = a0 - 0.01, a1 + 0.3                       # 통로 면에 0.3 묻힘 (붙음)
            if [p_d.x, p_d.y, p_d.z][ax] < [p_s.x, p_s.y, p_s.z][ax]:
                lo[ax], hi[ax] = a0 - 0.3, a1 + 0.01
            blk = box(lo[0], hi[0], lo[1], hi[1], lo[2], hi[2]).cut(s).cut(duct[0].Shape)
            c = s.BoundBox.Center
            d = V(0, 0, 0); setattr(d, "xyz"[ax], 1)
            blk = blk.cut(Part.makeCylinder(1.6, 200, V(c.x, c.y, c.z) - d * 100, d))
            pieces.append(blk)
            rep.append((lab, round(dmin, 2), "받침으로 채움"))
        for o in [o for o in doc.Objects if o.Label.startswith(hname)]:
            doc.removeObject(o.Name)
        if pieces:
            o = doc.addObject("Part::Feature", "GH_" + hname.split("_")[0])
            o.Label = hname + " (빛 게이트 받침 — 통로에 붙임, 송수신기 양면테이프, 작은 3D 프린트)"
            o.Shape = Part.makeCompound(pieces)
    doc.recompute()
    return rep


# ---------------- (11/06 20시) 벌레 막기 뚜껑 + 방생 출구 일자 ----------------
def trough_lid():
    """143l: 물길 뚜껑 (3D 프린트). (11/10 밤) 판 하나 + 기둥 자리 4 (자석 2·핀 2는 feeder_detail_shapes) + 손잡이 혀 (+y 끝)"""
    f, e = FD, FDX
    x0, x1 = f["x"] - f["ch_w"] / 2 - f["ch_t"], f["x"] + f["ch_w"] / 2 + f["ch_t"]
    lid = box(x0, x1, f["ch_y0"], f["ch_y1"], f["wall_top"], f["wall_top"] + 2)        # 포맥스 2 mm (11/11)
    lid = lid.fuse(box(f["x"] - 8, f["x"] + 8, f["ch_y1"], f["ch_y1"] + e["tab"], f["wall_top"], f["wall_top"] + 2))
    return lid.removeSplitter()


def release_exit_fix(doc):
    """175 출구 원뿔(끝 안지름 3 mm, 말벌 못 나감) → 곧은 관(안 12, 길이 15) + 위 비 가림 갓"""
    import D5e_module_kinematic as K
    old = [o for o in doc.Objects if o.Label.startswith("175_release_oneway")]
    if not old:
        return None
    b = old[0].Shape.BoundBox
    x0, z = b.XMin, K.z_upper
    pipe = Part.makeCylinder(K.DUCT_R, 15, V(x0, 0, z), V(1, 0, 0)).cut(Part.makeCylinder(K.PORT_R, 17, V(x0 - 1, 0, z), V(1, 0, 0)))
    hood = Part.makeCylinder(K.DUCT_R + 4, 12, V(x0 + 10, 0, z), V(1, 0, 0)).cut(
        Part.makeCylinder(K.DUCT_R + 2.5, 14, V(x0 + 9, 0, z), V(1, 0, 0)))
    hood = hood.common(box(x0, x0 + 30, -20, 20, z, z + 20))          # 위 반쪽만
    hood = hood.fuse(box(x0 + 10, x0 + 13, -K.DUCT_R - 4, K.DUCT_R + 4, z + K.DUCT_R - 0.5, z + K.DUCT_R + 4).common(
        Part.makeCylinder(K.DUCT_R + 4, 3, V(x0 + 10, 0, z), V(1, 0, 0))))   # 관과 갓을 잇는 턱
    old[0].Shape = pipe.fuse(hood).removeSplitter()
    old[0].Label = "175_release_exit (곧은 관 안지름 12 + 비 가림 갓, 11/06 승준)"
    doc.recompute()
    return old[0]


# ---------------- (11/06 20시) 방생: 짧게 기어 나와 위로 날아 나가는 굴뚝 ----------------
# 승준 지적: 통로가 길 필요 없음, 말벌은 기어가기보다 위로 날아오르기(상승 비행)를 좋아함.
#   한 번에 한 마리씩 내보내므로 따라갈 정찰벌이 없음 → 혼자서도 바로 찾게: 짧은 목 + 위가 밝게 열린 넓은 굴뚝.
# 자리 제약 [확실 — 모델 측정]: 마커 갠트리(206·212)가 x ≤ 118, z ≥ 396 을 오감 / 방생 서보 y −41.6 ~ −9.1, x ≤ 116.5
#   / 2020 레일(갠트리 둘레, x 160~180) 아래 면 z 452 → 굴뚝은 x 120~174, 꼭대기 z 430.
RS = dict(neck_x0=90.0, neck_x1=122.0, cx=147.0, ri=25.0, t=2.0, z_bot=355.0, z_top=430.0, floor_t=3.0,
          drain_r=1.5, led_r=2.5, led_h=8.6)


def release_shaft():
    """(174 목, 175 굴뚝, 184 출구 조명 자리) 형상. 목: 방생 문 하우징 면 x 90 → 굴뚝 벽 안 (안지름 12)"""
    import D5e_module_kinematic as K
    r, z = RS, K.z_upper
    neck = Part.makeCylinder(K.DUCT_R, r["neck_x1"] - r["neck_x0"], V(r["neck_x0"], 0, z), V(1, 0, 0)).cut(
        Part.makeCylinder(K.PORT_R, r["neck_x1"] - r["neck_x0"] + 10, V(r["neck_x0"] - 1, 0, z), V(1, 0, 0)))
    ro = r["ri"] + r["t"]
    H = r["z_top"] - r["z_bot"]
    shaft = Part.makeCylinder(ro, H, V(r["cx"], 0, r["z_bot"])).cut(
        Part.makeCylinder(r["ri"], H + 2, V(r["cx"], 0, r["z_bot"] + r["floor_t"])))
    shaft = shaft.cut(Part.makeCylinder(K.PORT_R, 2 * ro, V(r["cx"] - ro - 5, 0, z), V(1, 0, 0)).common(
        box(r["cx"] - ro - 6, r["cx"], -20, 20, z - 10, z + 10)))                      # 목이 들어오는 옆 구멍
    neck = neck.cut(Part.makeCylinder(r["ri"], H + 2, V(r["cx"], 0, r["z_bot"] + r["floor_t"])))
    import math
    for k in range(4):                                                                   # 빗물 빠지는 구멍 4 (Ø3, 말벌 못 지나감)
        a = math.radians(45 + 90 * k)
        shaft = shaft.cut(Part.makeCylinder(r["drain_r"], 10, V(r["cx"] + 12 * math.cos(a), 12 * math.sin(a), r["z_bot"] - 2)))
    leds = []
    for k in range(3):                                                                   # 출구 조명 LED 3개: 꼭대기 테두리, 안쪽 위를 비춤
        a = math.radians(90 + 120 * k)
        p = V(r["cx"] + (r["ri"] + r["t"] / 2) * math.cos(a), (r["ri"] + r["t"] / 2) * math.sin(a), r["z_top"])
        leds.append(Part.makeCylinder(r["led_r"], r["led_h"], p))
    neck = neck.cut(shaft)                                                               # 이음매: 굴뚝 벽까지만 (한 덩어리로 출력)
    return neck.removeSplitter(), shaft.removeSplitter(), Part.makeCompound(leds)


def release_shaft_apply(doc):
    """174·175를 바꾸고, 출구 빛 게이트 G6(·받침)을 목 위로 옮김 (x 120 → 108)"""
    neck, shaft, leds = release_shaft()
    for o in doc.Objects:
        if o.Label.startswith("174_release_duct"):
            o.Shape = neck
            o.Label = "174_release_neck (짧은 목 30 mm, 안지름 12 — 굴뚝과 한 덩어리 출력)"
        elif o.Label.startswith("175_release"):
            o.Shape = shaft
            o.Label = "175_release_shaft (위로 열린 굴뚝 안지름 50, 꼭대기 z 430, 빗물 구멍 4)"
    # (11/06 20:13 승준 결정) 출구 조명 LED 뺌: 굴뚝 위가 하늘로 열려 낮에는 이미 밝음, 방생 때 마킹실 조명만 끄면 굴뚝 쪽이 더 밝음.
    #   밤 LED는 나방 등 다른 벌레를 부름. 상용 트랩도 조명 없이 씀.
    for o in [o for o in doc.Objects if o.Label.startswith("184_exit_light")]:
        doc.removeObject(o.Name)
    o = None
    dx = 108.0 - 120.0
    for g in doc.Objects:
        if g.Label.startswith(("196_gate_G6", "199c_gate_holder_G6")) and hasattr(g, "Shape"):
            if abs(g.Shape.BoundBox.Center.x - 120.0) < 1.0:
                s = g.Shape.copy()
                s.translate(V(dx, 0, 0))
                g.Shape = s
    doc.recompute()
    return o


# ---------------- (11/06 밤, CAP-AI-SJ-49) 급이 방 상세설계: 고정·뚜껑 나사·튜브 집게·코튼롤 잡이 ----------------
# 구매품 (McMaster 페이지에서 직접 확인, 11/06):
#   열 압입 인서트 M3 × 0.5, 설치 길이 4.3, 구멍 Ø4.0, 최소 살 두께 5.1 — 94459A130 (50개 $10.91) [확실 — McMaster 표]
#   손나사(손으로 돌리는 나사) M3 × 8, 머리 Ø8 × 5, 18-8 스테인리스 — 92545A111 ($1.73) [확실 — McMaster 표]
#   육각 구멍 볼트 M3 × 8, 머리 Ø5.5 × 3, 18-8 스테인리스 — 91292A112 (100개 $6.46) [확실 — McMaster 표]
#   (11/10 바꿈) 15 mL 원뿔 튜브 PP 코닝 352096 Ø17.37 × 118.8, 입구 안 14.66 [확실 — 제조사 도면]. 예전 50 mL 7979T44는 안 씀 (열팽창으로 넘침)
#   코튼롤: McMaster에 없음 → 치과 재료상 '코튼롤 2호 Ø10 × 38' (국내 판매처 여럿) [가능성 높음]
INS = dict(hole=4.0, L=4.3, min_wall=5.1, boss_r=4.5, depth=7.0)        # (11/10 상세) 기둥 Ø8 → Ø9: 인서트 바깥 Ø4.74(STEP)와 벽 2.1 / 구멍 6 → 7: 손나사 끝(인서트 아래 2.2)이 바닥에 닿던 것
TS = dict(d=3.0, L=8.0, head_d=8.0, head_h=5.0)                          # 손나사 92545A111
SC = dict(d=3.0, L=8.0, head_d=5.5, head_h=3.0)                          # M3 × 8 91292A112
FDX = dict(ear_dx=13.0, ear_z=368.0, ear_y0=29.0 + DYF, ear_t=3.0,             # 물길 귀 (마킹실 벽 보스에 M3 × 8)
           lid_dx=13.0, lid_y=(40.0 + DYF, 60.0 + DYF),                              # 뚜껑 블록 자리 (x 55 ± 13 — (11/11) 블록이 벽 바깥 면 x 63에 붙음)
           pinch=(44.0, 48.0),                                           # 코튼롤 잡이 y
           boss_r=5.0, tab=8.0,                                          # (11/10 밤) 기둥 Ø10 (자석 Ø6.2 자리 둘레 1.9), 뚜껑 손잡이 혀 8 — (11/11) 기둥 → 포맥스 블록 10 × 10
           mag_d=6.0, mag_t=2.0, pin_d=3.6, pin_L=4.0,                   # 자석 Ø6 × 2 N35 니켈 도금 4개 [가능성 높음 — 일반 규격], 핀 Ø3.6 → 구멍 Ø4
           ears=False)                                                   # (11/10) 물길 → 마킹실 벽 나사 2개 없앰: 드라이버가 뚜껑 기둥에 막혀 못 들어감(SJ-53 남은 문제) + 앞벽이 생겨 붙일 이유 없음


def _screw(p, d, L, head_d, head_h, down=V(0, 0, -1)):
    return Part.makeCylinder(d / 2, L, p, down).fuse(Part.makeCylinder(head_d / 2, head_h, p, down * -1))


def feeder_detail_shapes(chamber_shape):
    """반환: (새 143 물길, 새 143l 뚜껑, 새 120 마킹실 벽, 자석(물길 쪽) 묶음, 자석(뚜껑 쪽) 묶음, M3 볼트 묶음(빈 것))
    (11/10 밤, CAP-AI-59) 손나사·인서트 → 자석 2쌍 + 핀 2, 튜브 집게 → 노즐. 아래 1)~4) 설명 중 3)은 노즐로 바뀜
    1) 마킹실 벽 바깥(+y 면 y 23)에 보스 2개 (Ø8, 6 길이, 인서트) — 물길 양옆 귀를 M3 × 8로 조임 → 물길 앞이 벽에 꽉 붙음
    2) 물길 양옆에 세로 기둥 2개 (Ø8, 위에 인서트) — 뚜껑을 손나사 2개로 누름 (공구 없이 열어 코튼롤 갈기)
    3) 그릇 +x 옆 기둥 → 튜브 집게 고리 (입구 120° 열림, 똑딱 끼움: 열린 폭 15.6 < 튜브 17.37 — 15 mL)
    4) 물길 안 코튼롤 잡이 리브 2개 (틈 10 = 롤 지름) — 물은 리브 옆이 아니라 위아래로 흐름 (리브는 벽에서 1 mm만 나옴)"""
    import math
    f, e = FD, FDX
    ch_x0, ch_x1 = f["x"] - f["ch_w"] / 2 - f["ch_t"], f["x"] + f["ch_w"] / 2 + f["ch_t"]
    trough = feed_trough()
    ins, ts, sc = [], [], []
    # 1) 벽 보스 + 귀
    wall = chamber_shape
    for sx in ((-1, 1) if e["ears"] else ()):
        cx = f["x"] + sx * e["ear_dx"]
        boss = Part.makeCylinder(INS["boss_r"], e["ear_y0"] - (23.0 + DYF), V(cx, 23.0 + DYF - 0.2, e["ear_z"]), V(0, 1, 0))
        wall = wall.fuse(boss)
        wall = wall.cut(Part.makeCylinder(INS["hole"] / 2, INS["depth"], V(cx, e["ear_y0"] - INS["depth"], e["ear_z"]), V(0, 1, 0)))
        ins.append(Part.makeCylinder(INS["hole"] / 2, INS["L"], V(cx, e["ear_y0"] - INS["L"], e["ear_z"]), V(0, 1, 0)).cut(
            Part.makeCylinder(1.5, 10, V(cx, e["ear_y0"] - 6, e["ear_z"]), V(0, 1, 0))))
        x_in = ch_x0 if sx < 0 else ch_x1
        ear = box(min(x_in, cx - 5), max(x_in, cx + 5), e["ear_y0"], e["ear_y0"] + e["ear_t"], e["ear_z"] - 5, e["ear_z"] + 5)
        ear = ear.cut(Part.makeCylinder(1.7, 10, V(cx, e["ear_y0"] - 1, e["ear_z"]), V(0, 1, 0)))
        trough = trough.fuse(ear)
        sc.append(_screw(V(cx, e["ear_y0"] + e["ear_t"], e["ear_z"]), SC["d"], SC["L"], SC["head_d"], SC["head_h"], V(0, -1, 0)))
    # 2) 뚜껑 블록 (11/11): 포맥스 10 mm 블록 4개를 물길 바깥 벽에 붙임 — 대각 2개 위에 자석 자리 Ø6.2 × 2.1, 나머지 2개 핀 구멍 Ø4 × 7
    mag_spots, pin_spots = [], []
    bh = BUY["blk"] / 2
    for sx in (-1, 1):
        cx = f["x"] + sx * e["lid_dx"]
        for k, cy in enumerate(e["lid_y"]):
            trough = trough.fuse(box(cx - bh, cx + bh, cy - bh, cy + bh, f["floor_z"], f["wall_top"]))
            if (sx < 0) == (k == 0):
                mag_spots.append((cx, cy))
                trough = trough.cut(Part.makeCylinder(e["mag_d"] / 2 + 0.1, e["mag_t"] + 0.1, V(cx, cy, f["wall_top"] - e["mag_t"] - 0.1)))
                ins.append(Part.makeCylinder(e["mag_d"] / 2, e["mag_t"], V(cx, cy, f["wall_top"] - e["mag_t"])))
            else:
                pin_spots.append((cx, cy))
                trough = trough.cut(Part.makeCylinder(INS["hole"] / 2, INS["depth"], V(cx, cy, f["wall_top"] - INS["depth"])))
    # 3) 노즐 받침: +x 벽 바깥 포맥스 12 × 12 × 5, 니플 나사 M5가 받침에 (구멍 Ø4.2 → 나사 셀프 탭), 구멍 Ø2가 벽을 지나 솜 옆으로
    b = BUY
    xw = f["x"] + f["ch_w"] / 2 + f["ch_t"]
    trough = trough.fuse(box(xw, xw + b["pad_t"], f["nz_y"] - b["pad"] / 2, f["nz_y"] + b["pad"] / 2, f["nz_z"] - b["pad"] / 2, min(f["nz_z"] + b["pad"] / 2, f["wall_top"])))
    trough = trough.cut(Part.makeCylinder(2.1, b["fit_L"], V(xw + b["pad_t"], f["nz_y"], f["nz_z"]), V(-1, 0, 0)))
    trough = trough.cut(Part.makeCylinder(b["fit_bore"] / 2, 20, V(xw + 1, f["nz_y"], f["nz_z"]), V(-1, 0, 0)))
    # 3b) 물빠짐 받침: 바닥 아래 포맥스 12 × 11 × 5
    #   (11/12, CAP-AI-62) 받침 −y 끝이 각관 +y 면(y 86)과 27 mm³ 겹쳐 있었음 (11/11까지 검사 안 함) → 받침은 y 86부터
    py_face = f["post_y"] + BUY["sq"] / 2
    trough = trough.fuse(box(f["x"] - b["pad"] / 2, f["x"] + b["pad"] / 2, max(f["dr_y"] - b["pad"] / 2, py_face), f["dr_y"] + b["pad"] / 2, f["floor_z"] - b["pad_t"], f["floor_z"]))
    #   (11/12) 위 앵글 ↔ 물길 바닥: 나사가 구멍 없이 바닥 판을 지나고 있었음 (21 mm³) → 서현 결정 '에폭시 접착' — 나사·구멍 없앰
    trough = trough.cut(Part.makeCylinder(2.1, b["fit_L"], V(f["x"], f["dr_y"], f["floor_z"] - b["pad_t"])))
    trough = trough.cut(Part.makeCylinder(b["fit_bore"] / 2, 20, V(f["x"], f["dr_y"], f["floor_z"] - 1)))
    trough = trough.cut(box(f["x"] - f["ch_w"] / 2, f["x"] + f["ch_w"] / 2, f["ch_y0"] + f["front_t"], f["ch_y1"] - f["ch_t"], f["floor_z"] + f["floor_t"], f["wall_top"] + 1))
    # 4) 코튼롤 잡이 리브
    p0, p1 = e["pinch"]
    for xr in ((f["x"] - f["ch_w"] / 2, f["x"] - f["ch_w"] / 2 + 1.0), (f["x"] + f["ch_w"] / 2 - 1.0, f["x"] + f["ch_w"] / 2)):
        trough = trough.fuse(box(xr[0], xr[1], p0, p1, f["floor_z"] + f["floor_t"] + 4.0, f["wall_top"]))
    # 뚜껑: 기둥 자리 둥근 판, 자석 자리(아래에서), 핀
    lid = trough_lid()
    for cx, cy in mag_spots + pin_spots:                  # (11/11) 뚜껑은 블록까지 덮는 네모 판 하나 (포맥스 2 mm 자름)
        lid = lid.fuse(box(cx - bh, cx + bh, cy - bh, cy + bh, f["wall_top"], f["wall_top"] + 2))
    for cx, cy in mag_spots:
        lid = lid.cut(Part.makeCylinder(e["mag_d"] / 2 + 0.1, e["mag_t"] + 0.1, V(cx, cy, f["wall_top"] - 0.01)))
        ts.append(Part.makeCylinder(e["mag_d"] / 2, e["mag_t"], V(cx, cy, f["wall_top"])))
    for cx, cy in pin_spots:
        lid = lid.fuse(Part.makeCylinder(e["pin_d"] / 2, e["pin_L"] + 0.01, V(cx, cy, f["wall_top"] - e["pin_L"])))
    return (trough.removeSplitter(), lid.removeSplitter(), wall.removeSplitter(),
            Part.makeCompound(ins), Part.makeCompound(ts), Part.makeCompound(sc))


def feeder_detail_apply(doc):
    ch = [o for o in doc.Objects if o.Label.startswith("120_chamber_walls")][0]
    tr = [o for o in doc.Objects if o.Label.startswith("143_feed_trough")][0]
    ld = [o for o in doc.Objects if o.Label.startswith("143l_")][0]
    trough, lid, wall, ins, ts, sc = feeder_detail_shapes(ch.Shape)
    tr.Shape, ld.Shape, ch.Shape = trough, lid, wall
    tr.Label = "143_feed_trough (물길 — 포맥스 2·3 mm 판 자름·접착 + 블록 10 mm 4 + 니플 받침 5 mm 2, CAP-AI-61)"
    ld.Label = "143l_feed_trough_lid (뚜껑 — 포맥스 2 mm 자름, 자석 2쌍 + 핀 2, 손으로 뗌)"
    ch.Label = "120_chamber_walls (+y 벽 Ø11.2 급이 구멍)"
    out = []
    for o in [o for o in doc.Objects if o.Label.startswith(("143i_", "143t_", "143fi_", "143f_"))]:      # (11/10 밤) 뚜껑 인서트·손나사, (11/11) 발 인서트·나사 없앰
        doc.removeObject(o.Name)
    for nm, shp, col in (("143m_magnet_trough (네오디뮴 Ø6 × 2 N35, 물길 기둥 2개, 구매)", ins, (0.55, 0.55, 0.60)),
                         ("143mm_magnet_lid (네오디뮴 Ø6 × 2 N35, 뚜껑 2개, 구매)", ts, (0.55, 0.55, 0.60)),
                         ("143s_bolt_M3x8 (McMaster 91292A112, 2개)", sc, (0.15, 0.15, 0.15))) + tuple(zip(
                             ("143p_post_sq12 (기둥 — 알루미늄 각관 12 × 12 × 1 자름, 구매)", "143a_angle_foot (발 — 알루미늄 앵글 20 × 20 × 2 × 40 자름·구멍, 구매)",
                              "143b_angle_top (위 — 알루미늄 앵글 20 × 20 × 2 × 20 자름·구멍, 물길 바닥에 에폭시, 구매)", "143h_screws_M3 (M3 냄비머리 12 ×2 · 18 ×2, 구매)",
                              "143hn_nuts_M3 (M3 너트 4, 구매)", "143n_nipple_M5_barb (공압 M5 호스 니플 2 — 노즐·물빠짐, 구매)"),
                             feeder_hardware(),
                             ((0.80, 0.82, 0.85), (0.80, 0.82, 0.85), (0.80, 0.82, 0.85), (0.15, 0.15, 0.15), (0.15, 0.15, 0.15), (0.85, 0.75, 0.30)))):
        for o in [o for o in doc.Objects if o.Label.startswith(nm.split(" ")[0])]:
            doc.removeObject(o.Name)
        if not shp.Solids:
            continue
        o = doc.addObject("Part::Feature", "P" + nm.split(" ")[0])
        o.Label, o.Shape = nm, shp
        out.append((o, col))
    doc.recompute()
    return out


# ---------------- (11/10 밤, CAP-AI-60) 로드셀 → 스프링 + 누름 스위치 ----------------
# 교수님 피드백 '로드셀은 과함' (서현 11/10 21:45) → 로드셀 148·HX711 198x 없앰.
# 원리: 스프링 146 (k 103.6 N/m, S4 2차)이 캐리지 아래 '받침 칸'(캐리지와 한 몸) 위에 앉고, 축 147 아래 끝을 받친다.
#   바닥이 말벌에 닿아 F_p 0.5 N이 되면 스프링이 δ = 0.5 / 103.6 = 4.83 mm 더 눌린다 → 축에 붙인 걸쇠 148c 가 그만큼 내려와
#   받침 칸 옆벽 바깥의 KW11 스위치 227p 레버를 누름 → 펌웨어가 바닥을 멈춤 (A1, NC 접점 — 선이 끊겨도 멈춤 쪽)
#   힘 맞추기: 스위치 나사 구멍이 세로 긴 구멍(±2 mm) → 저울 위에서 0.5 N(51 g)에 딸깍하도록 한 번 맞춤
# (11/12, CAP-AI-62) 혀·스위치를 +x → +y 쪽으로: +x에선 혀가 옆판 151_R(x 74~)과 72 mm³ 겹치고 스위치 본체(x 71~77.4)도 151_R 자리.
#   +y 쪽(x 59~74, y 12~42, z 236~300)은 S1·S2·S3 모두 비어 있음 (11/12 모양 검사). 스위치는 L이 +y, 받침판(캐리지와 한 몸) x 59~62에 M2 × 10.
PS = dict(spring_xy=(65.0, 4.0), seat_z=244.0, car_bot=262.0, cage=(59.0, 71.0, -2.0, 12.0), wall_t=2.0, floor_t=2.0,
          k=103.6, Fp=0.5, collar_r=3.5, collar_z=(258.5, 261.5), tab=(63.0, 67.0, 4.0, 22.0), slot_z=249.0,
          sw_x=62.0, sw_y=16.0, mount=(59.0, 62.0, 12.0, 37.0, 239.5))


def press_parts(carriage_shape):
    """반환: 새 캐리지(받침 칸 포함), 걸쇠 148c, 스위치 227p, 스위치 나사, 보고 dict"""
    import D5g_home_switches as HS
    p = PS
    cx, cy = p["spring_xy"]
    x0, x1, y0, y1 = p["cage"]
    zs, zb, t = p["seat_z"], p["car_bot"], p["wall_t"]
    if carriage_shape.BoundBox.ZMin < 261.9:                                            # D5f 아래 컵 지움 (로드셀 때와 같음)
        car = carriage_shape.cut(Part.makeCylinder(7.6, 262.0 - 230.0 - 0.01, V(65.0, 4.0, 230.0)))
    else:                                                                               # (11/12) lift_drive의 깨끗한 캐리지 — 컵 없음, 0.01 틈 자르기가 고체를 깨뜨림
        car = carriage_shape
    cage = box(x0, x1, y0, y1, zs - p["floor_t"], zs)                                   # 받침판 (스프링이 앉음)
    cage = cage.fuse(box(x1 - t, x1, y0, y1, zs - p["floor_t"], zb + 0.01))             # +x 옆벽 (스위치가 바깥에)
    cage = cage.fuse(box(x0, x1, y1 - t, y1, zs - p["floor_t"], zb + 0.01))             # +y 뒷벽
    cage = cage.cut(box(p["tab"][0] - 0.5, p["tab"][1] + 0.5, y1 - t - 0.1, y1 + 0.1, p["slot_z"], zb - 0.5))   # 걸쇠 혀가 지나갈 홈 (+y 뒷벽, 11/12)
    mx0, mx1, my0, my1, mz0 = p["mount"]
    cage = cage.fuse(box(mx0, mx1, my0 - 0.01, my1, mz0, zb + 0.01))                   # 스위치 받침판 (뒷벽·캐리지 판에 붙음, 11/12)
    cage = cage.fuse(Part.makeCylinder(1.1, 1.5, V(cx, cy, zs)))                        # 스프링 가운데 핀 Ø2.2
    car = car.fuse(cage)
    _rs = car.removeSplitter()                         # (11/12) removeSplitter가 고체를 깨뜨리는 경우가 있음 → 유효할 때만
    car = _rs if _rs.isValid() else car
    # 걸쇠 148c: 축에 끼우는 고리 + 옆벽 홈을 지나 스위치 위로 나온 혀 (3D 프린트, 축에 끼우고 순간접착)
    c0, c1 = p["collar_z"]
    collar = Part.makeCylinder(p["collar_r"], c1 - c0, V(cx, cy, c0)).cut(Part.makeCylinder(2.0, 10, V(cx, cy, c0 - 1)))
    tab = box(p["tab"][0], p["tab"][1], p["tab"][2], p["tab"][3], c0, c1).cut(Part.makeCylinder(2.0, 10, V(cx, cy, c0 - 1)))
    latch = collar.fuse(tab).removeSplitter()
    # 스위치 227p: 눌린 레버 면 = 걸쇠 아래 면이 δ 내려온 자리
    d = p["Fp"] / p["k"] * 1000.0
    z_lever = c0 - d
    O = V(p["sw_x"], p["sw_y"], z_lever - HS.LEVER_TOP)                                  # (11/12) 본체 x 62~68.4, y 16~36 — 받침판 x 62 면에
    sw, screws, _lv = HS.switch(O, V(0, 1, 0), V(1, 0, 0), V(0, 0, 1), screw_len=10.0)
    rep = dict(delta_mm=round(d, 2), lever_pressed_z=round(z_lever, 2), latch_rest_bottom=c0, gap_rest=round(c0 - z_lever, 2),
               spring_len_rest=round(c0 - 0.5 - zs, 2), spring_solid=3.9)
    return car, latch, sw, Part.makeCompound(screws), rep


def press_check(doc, rep):
    """누름 장치 검사: (1) 새 부품 ↔ 다른 부품 겹침 (2) 바닥 0 → 36.5 올리는 동안 움직이는 묶음 ↔ 고정 부품 겹침 (4 mm마다)"""
    mine = ("158_carriage", "148c_", "148k_", "227p_", "227ps_", "146_", "147_", "149_")          # 148k 축 칼라·146·147·149 카탈로그 부품 (11/12 14:00)
    moving = mine + ("140_", "146_", "147_", "149_", "159_", "153s")      # 153s·153ss: 리니어 모듈 슬라이더·나사 (11/12)
    allow = {("227ps_", "158_carriage"), ("148c_", "147_"), ("148k_", "147_"), ("149_", "158_carriage"), ("147_", "140_"), ("147_", "149_")}
    objs = [o for o in doc.Objects if o.TypeId == "Part::Feature" and not o.Shape.isNull() and o.Shape.Volume > 0
            and not o.Label.startswith(("REF", "FitBox")) and "beam" not in o.Label]
    pre = lambda o, ps: o.Label.startswith(ps)
    ov = []
    for a in [o for o in objs if pre(o, mine)]:
        for b in objs:
            if b is a or (pre(b, mine) and b.Name < a.Name):
                continue
            if a.Shape.BoundBox.intersect(b.Shape.BoundBox):
                v = a.Shape.common(b.Shape).Volume
                if v > 0.05:
                    ka, kb = a.Label.split(" ")[0], b.Label.split(" ")[0]
                    ok = any(ka.startswith(x) and kb.startswith(y) or kb.startswith(x) and ka.startswith(y) for x, y in allow)
                    ov.append((ka, kb, round(v, 2), "허용" if ok else "문제"))
    mv = [o for o in objs if pre(o, moving)]
    fx = [o for o in objs if not pre(o, moving)]
    sweep = []
    for k in range(0, 10):
        dz = min(36.5, 4.0 * k)
        for a in mv:
            s = a.Shape.copy(); s.translate(V(0, 0, dz))
            for b in fx:
                if s.BoundBox.intersect(b.Shape.BoundBox):
                    v = s.common(b.Shape).Volume
                    if v > 0.5:
                        sweep.append((dz, a.Label.split(" ")[0], b.Label.split(" ")[0], round(v, 1)))
    rep = dict(rep, overlaps=ov, bad=[x for x in ov if x[3] == "문제"], sweep_hits=sweep)
    return rep


def press_apply(doc):
    car_o = [o for o in doc.Objects if o.Label.startswith("158_carriage")][0]
    for o in [o for o in doc.Objects if o.Label.startswith(("148_load_cell", "148b_", "148g_", "148s_", "148m", "148c_", "227p"))]:
        doc.removeObject(o.Name)
    car, latch, sw, scr, rep = press_parts(car_o.Shape)
    car_o.Shape = car
    car_o.Label = "158_carriage (바닥 캐리지 + 스프링 받침 칸, 3D 프린트 PETG — 로드셀 없앰 CAP-AI-60)"
    out = []
    for nm, shp, col in (("148c_spring_latch (걸쇠 — 축 147에 끼워 순간접착, +y 혀가 누름 스위치를 누름, 3D 프린트 PETG 작은 것)", latch, None),
                         ("227p_press_switch (KW11-3Z 누름 스위치 PSW — NC, 스프링 4.8 mm(0.5 N)에서 딸깍, UNO 1 A1)", sw, (0.15, 0.15, 0.15)),
                         ("227ps_press_switch_screws (M2 × 10 십자 냄비머리 2 — 받침판에 셀프 탭, 긴 구멍으로 힘 맞춤)", scr, (0.1, 0.1, 0.1))):
        o = doc.addObject("Part::Feature", "P" + nm.split(" ")[0])
        o.Label, o.Shape = nm, shp
        out.append((o, col))
    doc.recompute()
    return out, rep
