britams/-capstone-project-repo/(commit log)

2026-10-28 Update team member list in README
    Removed '타이린' from the team member list.
2026-10-28 [서현] 팀 문서 초기 업로드: 인수인계·분업계획·시작키·GitHub 사용법, D0·D1 재설계 문서, AI 로그, CLAUDE.md
    Claude-Session: https://claude.ai/code/session_01DPKuseva9gJyrh3ys7z4V6
2026-10-28 [서현] D1 목표값 확정, D2 기능 시퀀스·기능계통도 초안
    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
2026-10-28 [승준] AI 로그 첫 항목 (CAP-AI-SJ-01), 레포 쓰기 권한 확인
2026-10-28 [승준] VespAI 원본 저장소 확인·실행 계획, 예시 검출 스크립트, AI 로그 CAP-AI-SJ-02
    Claude-Session: https://claude.ai/code/session_01C1g5VzudV9xVxduwEeJcMB
2026-10-28 [서현] D2 확정(다른 종·두 마리 동시 → 격리), D3 형태분석표·조합안 초안
    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
2026-10-28 [서현] 안 1 확정, D5 개념설계 초안, 승준 작업지시(J1~J7), 인수인계 VespAI 정정 (Issue #1 반영)
    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
2026-10-28 [서현] D5 FreeCAD 개념 모델 1차(생성 스크립트·모델 2개·측단면 그림), 환류 6~8
    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
    [D5_concept_an1_down.FCStd, D5_concept_an1_up.FCStd]
2026-10-28 [서현] 상용 트랩 실측표·잴 곳 그림 (D1~D7, H1·H2)
    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
2026-10-28 [승준] J1 VespAI Windows 원클릭 실행 스크립트, 원 결과 비교 기능, AI 로그 CAP-AI-SJ-03
    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
2026-10-28 [승준] J1 완료 — VespAI 승준 PC 실행 결과(16/21 일치, 0.053 s/장), 설치 진행 표시, AI 로그 CAP-AI-SJ-04
    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
    [result.tsv]
2026-10-28 [승준] AI 로그 CAP-AI-SJ-05 — 승준 PC 창의적종합설계 폴더 정리, 규제는 일단 보류
    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
2026-10-28 [승준] J2 1차 — 보유품 사진 판독(확인/미확인 목록), AI 로그 CAP-AI-SJ-06
    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
2026-10-28 [서현] 상용 트랩 실측 반영, 바닥에 서는 2020 프로파일 프레임 구조로 D5 2차 모델, 결합은 포획통 쪽만 돌려 끼움
    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
    [D5b_frame_an1_down.FCStd]
2026-10-28 [승준] AI 로그 CAP-AI-SJ-07 — 상용 트랩 실측값 전달(Issue #2, 서현 반영분과 중복 확인), 확인 목록
    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
2026-10-28 [승준] AI 로그 CAP-AI-SJ-08 — 포획통 돌려 끼움 확인 전달, J2 개봉 체크리스트
    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
2026-10-28 [승준] VespAI 실시간 웹캠 스크립트(화면 표시·기록), Windows 실행 파일, AI 로그 CAP-AI-SJ-09
    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
2026-10-28 [서현] D5 3차 — 모듈 다시 그림(겹침 0·뜬 부품 0 자동 검사), 도 1~4 도면부호 그림, 인터페이스 정의서 1차 값
    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
    [D5c_module_an1_mark.FCStd, D5c_module_an1_rest.FCStd]
2026-10-28 [서현] D5 3차 마킹부 재검토 — 1자유도 마커로는 R3 불가, 말벌 자세·캡·클램프 검토, 안 A/B 결정 대기 (CAP-AI-15)
    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
2026-10-28 [서현] D5 9-7 마커 고르는 기준 추가, 로그 CAP-AI-15 추가 질문
    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
2026-10-28 [서현] 마커 선정 POSCA PC-3M 화이트(D5 9-8), 승준 J7 마커 항목 갱신, 로그 CAP-AI-15
    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
2026-10-28 [승준] J2 완료 — 개봉 확인 결과, L298N 판독, 구매 후보(전원 어댑터 등), AI 로그 CAP-AI-SJ-10
    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
2026-10-28 [서현] D5 4차 — 안 B 마커 XYZ 모델(겹침·뜬 부품·카메라 시야 가림 0), 카메라 200 mm(AI 카메라 초점 20 cm~), 도 5~8, 마커 재선정(퍼마페이크·샤피), 인터페이스 2차, 승준 J8
    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
    [D5d_module_an1_B_mark.FCStd, D5d_module_an1_B_rest.FCStd]
2026-10-28 [승준] 구매 목록 총정리(D5 4차 안 B 반영, 지금 주문/D6 후 구분), AI 로그 CAP-AI-SJ-11
    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
2026-10-28 [서현] 승준 작업지시 10/28 저녁 갱신 — J 상태, 다음 할 일 순서(주문·J6 속도 측정·J8 흉부 좌표), 로그 CAP-AI-17
    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
2026-10-28 [승준] 마커 국내 대안(POSCA·젤펜·직구) 정리, 서현 결정 요청 Issue, AI 로그 CAP-AI-SJ-12
    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
2026-10-28 [승준] 마커 추가 조사(퍼마페이크 대안 거의 없음 → 해외 특송 제안), AI 로그 CAP-AI-SJ-13
    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
2026-10-28 [승준] AI 로그 CAP-AI-SJ-14 — 마커 굵기 의견, 샤피 크리에이티브 국내 판매처 정정
    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
2026-10-28 [승준] 마커 결정 반영 — 샤피 크리에이티브 5색(노랑), 구매목록 A4·A5, AI 로그 CAP-AI-SJ-15
    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
2026-10-28 [승준] 재료비 정산 규칙 정리, 구매 장부 틀, AI 로그 CAP-AI-SJ-16
    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
2026-10-28 [승준] 재료비 정산보고서 엑셀 양식(자동 합계·한도 경고·제품사진·작성요령), 예산 50만 원 확정, AI 로그 CAP-AI-SJ-17
    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
    [재료비_정산보고서.xlsx]
2026-10-28 [승준] 재료비 기록 — R-01 말벌포획기, R-02 어댑터·쿨러 (합계 86,240원), 영수증 번호 직접 입력으로 양식 수정, AI 로그 CAP-AI-SJ-18
    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
    [재료비_정산보고서.xlsx]
2026-10-28 [승준] 구매장부 메모에 R-01·R-02 기록 (CAP-AI-SJ-18 보완)
    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
2026-10-28 [승준] J6 아두이노 펌웨어(구동기 7·HX711), Pi 클라이언트, 시험 절차, PC 시뮬레이션, 인터페이스 통신 행 1차
    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
2026-10-28 [승준] J4 노랑 점 검출 스크립트·합성 더미 시험(96 %/2 %), AI 로그 CAP-AI-SJ-19·20
    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
2026-10-28 [승준] 구매목록에 microSD 카드 리더(정산 제외) 추가, AI 로그 CAP-AI-SJ-21
    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
2026-10-28 [서현] D6 설계 변수표, S4 역학계산 1차(M1~M6 AI값, 자유물체도), 모델 보완(볼 부싱·샤피 치수), 인터페이스 3차, 승준 J9, 로그 CAP-AI-18
    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
    [D5d_module_an1_B_mark.FCStd, D5d_module_an1_B_rest.FCStd]
2026-10-28 [승준] 표본 구매 기록(합계 110,240원), 카드 리더 정산 제외, J6·J4 보류, AI 로그 CAP-AI-SJ-22
    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
    [재료비_정산보고서.xlsx]
2026-10-28 [승준] 구매장부 영수증 폴더 경로 정정 (정산\)
    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
2026-10-28 [서현] S4 역학계산 r2: 교재 유제 7개 확정·해설집 대조(s4_textbook_check), M5 끼임 요+피치 연립으로 정정(청동도 끼임), 무게중심 FreeCAD 반영(M2·M4·M6), D6·인터페이스·J6 부하 시험, 로그 CAP-AI-19
    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
2026-10-28 [승준] 기계요소 유제 3개(동력나사·스프링·스테핑 선정) 대조·적용, 마킹 플래너, 신뢰성 몬테카를로(설계안 9개), 격자 시험 조각 STL 4종, 제어부 구성·AI 마킹 전략 md, 구매목록 G장, 인터페이스 제안 이력, AI 로그 CAP-AI-SJ-23·24
    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
    [A_square_3p0_pitch4p4.stl, B_square_3p5_pitch4p3.stl, C_slot_3p0_pitch4p0.stl, D_slot_3p5_pitch4p5.stl]
2026-10-28 [승준] mark_planner 출력 좌표를 float로 (표시 정리)
    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
2026-10-29 [승준] VespAI 웹캠 녹화 기능(r 키, 박스·원본 mp4), 실행마다 새 결과 폴더, AI 로그 CAP-AI-SJ-25
    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
2026-10-29 [승준] VespAI 프린트 웹캠 시험 결과(말벌 사진 위 등검은말벌 79 %, 박스 60 %는 손·옷 오검출, 가까우면 못 잡음), 라벨 CSV, AI 로그 CAP-AI-SJ-26
    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
    [detections_labeled.csv]
2026-10-29 [승준] 정산: 테프론 테이프(영수증5)·샤피 12색(영수증6 1행) 추가, 합계 130,010원, 영수증6 개인 물품 제외, 할인 배분 확인 필요 표시, AI 로그 CAP-AI-SJ-27
    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
    [재료비_정산보고서.xlsx]
2026-10-29 [승준] 정산: 샤피 18,870원 확정(영수증6 할인은 묶음 할인, 승준 판단), AI 로그 CAP-AI-SJ-28
    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
    [재료비_정산보고서.xlsx]
2026-11-01 [서현] D5e 움직이는 모델 작업 중: 구동기 정밀 모델(28BYJ-48·SG90·MG90S·T8 너트·커플링), 이음부 86개 검사·이동 간섭 검사 통과, 자유물체도 도구
    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
2026-11-01 [서현] D5e: 통로 꺾임을 굽힘관(R20)으로, 빛 게이트 세로관으로, 관절 변수 문서(스프레드시트 Joints), 애니메이션 스크립트
    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
2026-11-01 [서현] D5e 중간 저장: 움직이는 모델(FCStd·관절 스프레드시트), 이음부·간섭 검사 결과, 한 마리 처리 동영상(mp4·gif), 로그 CAP-AI-20(진행 중)
    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
    [D5e_module_kinematic.FCStd]
2026-11-01 [서현] 교재 유제 7개 자유물체도 초안(T1~T7 jpg, 미검증), 남은 일 순서를 로그 CAP-AI-20·인수인계에 적음
    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
2026-11-01 [서현] 교재 유제 자유물체도 T1~T7 확인·수정: 받침 떼고 반력으로, 힘 방향(T4 P, T7 P) 바로잡음, 글자 겹침·없는 글꼴 기호 정리
    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
2026-11-01 [서현] S4 유제 선정과 적용 정리 md(T1~T7: 고른 이유·푼 것·적용·안 한 것·검산 안 했으면, 자유물체도 jpg 포함), T1 그림 M1 설명 바로잡음
    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
2026-11-01 [서현] 멈춤 전 저장: 유제 정리 md의 M4 혼 팔 16 → 14 mm 바로잡음, 핀 안내 마찰 어림(미검증)과 남은 일을 로그 CAP-AI-20에 적음
    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
2026-11-01 [승준] S4 역학계산 2차(D5e) — 서현 CAP-AI-20 남은 일 2·3번 이어서: FreeCAD 질량표, M1~M6 재계산(펜 홀더 핀 안내 μ_c 0.44 발견), 자유물체도 jpg 6장, 결과 md, AI 로그 CAP-AI-SJ-29 (서현 파일은 안 고침)
    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
2026-11-01 [서현] S4 동역학 4문제 추가(M7 문 스카치 요크, M8 펜 내려찍기 충격, M9 이송 시간, M10 봉 고유진동수): Meriam 5/26·3/108·2/27·8/8 해설집 대조, 그림 4장
    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
2026-11-01 [서현] 11/02 발표 역학계산 슬라이드 원고(S1~S20, 10문제, 동역학 5문제 앞) — 승준 PPT용, 로그 CAP-AI-21, 인수인계 갱신
    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
2026-11-01 [서현] D5e 전체 조립: 2020 프로파일 프레임(T홈 단면·브래킷)·상용 트랩 상세·모듈, 정투영 렌더 5장과 한 장 조립도, 발표 원고에 결정(스프링 뺌·핀 PTFE)·예상 질문 추가, 로그 CAP-AI-21
    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
    [D5e_full_assembly.FCStd]
2026-11-01 [서현] 작업 원칙을 CLAUDE.md에, 설계 결정을 D6 10장·인터페이스 정의서 4차 값·D1에, CAD 기록을 cad/README에 시간순(초기 스케치·원본 렌더 포함)으로, 역학계산 쉬운 설명 md·docx, 인수인계·로그 CAP-AI-21
    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
    [10.2_first_stamp_method_sketch.ipt]
2026-11-01 [서현] VespAI 점검: 원인은 스크립트가 아니라 장면 차이, 격자판 가림(열린 면적 36.5 %) 위험 발견, 서현 PC 시험 키트(설치·웹캠·영상 비교, 격자·마킹실 자르기·입력 크기 조건)
    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
2026-11-01 [서현] 제어 통합 정리(D5e): Pi 5 + UNO 2, 빛 게이트 G1~G6, MG90S 문틈 규칙, 카메라 1대·투명 격자, 상태 머신·핀·전원, 블록도·배치도, 로그·인수인계
    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
2026-11-01 [서현] 인수인계: VespAI 점검·제어 통합 정리 위치
    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
2026-11-01 [서현] VespAI 서현 PC 설치·J1 결과(16/21, 0.106 s/장)
    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
2026-11-01 [서현] VespAI 점검 실행 파일: capstone_vespai를 키트 옆 폴더에서도 찾음 (서현이 바탕화면으로 옮김)
    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
2026-11-01 [서현] VespAI 서현 웹캠 결과: 거의 못 잡음·격자 겹치면 0·안경/방 오검출 → 투명 격자 필수, VespAI 그대로 안 쓰고 우리 구도로 다시 학습
    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
2026-11-01 [서현] VespAI 서현 PC 기록 수치(격자 겹치면 0, 전체 75 %는 오검출 포함), 키트에 박스 장면 자동 저장, Hivora 탐지 방식 정리
    Claude-Session: https://claude.ai/code/session_01Jzg83D8Aa1A65w4ViX2JyU
    [2026-11-02_0257_서현_휴대폰화면_live.csv]
2026-11-01 [서현] 전기 계통·제어 순서: 전류·퓨즈 T2.5A·핀·배선 길이·하루 에너지·HOLD F 0, Pi 상태 머신 참고 구현 + 시나리오 17개, 그림 4장
    - design/2026-11-02_전기계통_제어순서_서현.md (CAP-AI-22)
    - design/control_sim/: elec_budget.py, trap_sim.py, make_figs.py, out/
    - design/img/control/: 전기_배선도_상세, 제어순서_타이밍_S1, 제어_상태도, 제어_메시지순서_S1
    - 제어 통합 정리에 바뀐 값 8개, cad/README D5f에 Pi 자리·문틈 빔 2개, AI 로그·인수인계
    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
2026-11-01 [서현] AI 로그: CAP-AI-22 Issue #5 번호
    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
2026-11-01 [서현] 전기계통 문서 머리말: 서현 PC 사본 경로
    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
2026-11-02 [서현] 09:25 결정 반영: Pi 위판 아래, 문마다 빔 2개(9쌍)·실리콘 립, 분류 2종, 콘센트 + 배터리 상자 — 시뮬레이션 19개 통과·빔 하나 비교
    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
2026-11-02 [승준] AI 로그 CAP-AI-SJ-30: 11/02 주간 발표 덱 (역학계산·설계·VespAI 28장, 덱은 PC에만)
    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
2026-11-02 [승준] AI 로그 CAP-AI-SJ-31: 발표 덱 v2 — 예제마다 고른 이유·바꾼 부분·교재 예제 칸, M2 장 추가
    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
2026-11-02 [승준] 캘리퍼스 측정 위치 그림 2장(트랩 결합부·마커·통로) + 그림 스크립트, AI 로그 SJ-32
    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
2026-11-02 [승준] 상용 트랩 캘리퍼스 실측 기록 시작 (h1 9.9 · h2 8.9 · h3 8.0 mm), AI 로그 SJ-33
    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
2026-11-02 [승준] 트랩 실측 D1 56.7 · D2 89.6 · D4 5.9 · D5 17.6 mm 기록, D3 설명 그림, AI 로그 SJ-34
    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
2026-11-02 [승준] 트랩 실측 a 33.9 · b 22.1 · c 6.8 · D3a 81.2 · D3b 85.6 · D3c 93.1 mm, 맞물림 계산
    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
2026-11-02 [승준] 걸쇠 w·p·k·레일 g 설명 그림, AI 로그 SJ-35
    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
2026-11-02 [승준] 트랩 실측 w 12 · k1 0.6 · k2 3.1 · g1 6.7 · g2 6.0 mm, 높이 맞물림 계산
    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
2026-11-02 [승준] 트랩 실측: 걸쇠는 안쪽으로만 튀어나옴 (p_out 0)
    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
2026-11-02 [승준] 트랩 실측 p_in 3.1 · D2i 89.9 · t 0.7 mm (D2i > D2 모순 표시)
    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
2026-11-02 [승준] 트랩 실측 D2 91.7(다시) · 처마 아랫면 2.7 mm, 지름 맞물림 확인·높이 모순 표시
    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
2026-11-02 [승준] 트랩 실측 바깥 고리 높이(홈 바닥 기준) 6.6 mm, 잠금 방식 정리
    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
2026-11-02 [승준] 트랩 결합부 서현 요청 초안(실측표·CAD·잠금 방식·입구), AI 로그 SJ-36
    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
2026-11-02 [승준] 마커 실측 7개(몸통 14.7 · 캡 18.8 · 팁 2.2×8 · 길이 134.6) + 포획통 고리 높이 6.3
    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
2026-11-02 [승준] 트랩 실측 토막 높이 6.6 · 안쪽 턱 10.3 mm (홈 바닥 기준), 높이 맞물림 정리
    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
2026-11-02 [승준] 트랩 실측 안쪽 턱 바깥지름 61.9 mm
    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
2026-11-02 [승준] 트랩·마커 캘리퍼스 실측 마무리, AI 로그 SJ-37
    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
2026-11-06 [서현] 회로 설계(회로도 3장·넷리스트·BOM·검사), 제어 알고리즘·판단 정리(흐름도 3장), 쉬운 요약 3쪽 — CAP-AI-23
    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
    [bom.csv, netlist.csv]
2026-11-06 [승준] 구매 부품 라이브러리 + D5e 치수 대조 스크립트 (CAP-AI-SJ-38)
    Claude-Session: https://claude.ai/code/session_01C1g5Vx5Dr97fFEDkA7XBtx
2026-11-06 [서현] D5f 전기 배치 CAD(Pi 위판 아래, UNO 2, 단자대·비상 정지, 빛 게이트 9쌍 자리) + 그림 3장
    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
    [D5f_electrical_layout.FCStd]
2026-11-06 [서현] 쉬운 요약에 D5f 전기 배치 도면 추가
    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
2026-11-06 [승준] 기계 구매 부품 상세(D5e 실측 20/20 대조, McMaster), Issue #7, AI 로그 SJ-38
    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
2026-11-06 [서현] 원점 스위치를 승준 라이브러리 KW11-3Z로 맞춤 (SJ-38 반영)
    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
    [bom.csv]
2026-11-06 [서현] D5f: 스프링 204 지움, 28BYJ-48 M4 고정 (승준 Issue #7 반영)
    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
    [D5f_electrical_layout.FCStd]
2026-11-06 [서현] D5f 문 하우징 빔 구멍(입구·격리 x 23·29, 방생 81·87), ULN2003·G6 자리 고침, 겹침 검사 함수 (진행 중)
    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
2026-11-06 [서현] D5f 문 빔 구멍·ULN2003·G6 자리 확정, 겹침 0건, 그림 다시
    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
    [D5f_electrical_layout.FCStd]
2026-11-06 [서현] 17:05 답 반영: 유럽말벌·다른 곤충 격리, 여왕벌 중순판 폭 ≥ 4.4 mm, 배터리 20 Ah(2일), 스프링 146 k 0.1 N/mm 역학계산·자유물체도
    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
    [bom.csv]
2026-11-06 [서현] 교재 유제 5개(Riley 9-6, Gere 2-1, Meriam 8/1, Shigley 10-1·10-2) 52/52 대조, 스프링 146 역학계산 2차, 여왕벌 크기 재는 법
    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
2026-11-06 [서현] 스프링 146 기성품 검사 스크립트(7조건), 여왕벌 못 잴 때 계절 규칙(시뮬레이션 22/22)
    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
2026-11-06 [서현] D5f 바닥 안내를 기성품(Ø4 경화 축 + LM4UU + 카탈로그 스프링 + 버튼 로드셀)으로, 캐리지 아래 컵, 겹침 0건, 질량 19.2 g로 다시 계산
    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
    [D5f_electrical_layout.FCStd]
2026-11-06 [서현] 동역학 그림을 D5f 질량 19.2 g 값으로 다시
    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
2026-11-06 [서현] 승준 작업지시 11/06판(기구·구매·펌웨어·비전 인수), BOM에 Pi RTC 배터리, 로드셀 자리 반영, 인수인계 갱신
    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
    [bom.csv]
2026-11-06 [승준] D5g: 2020 프레임 상세(단면·브래킷·M5 볼트·T너트) + 부품 4분류 (작업 중)
    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
2026-11-06 [승준] D5g: T너트 목·날개 한 덩어리로
    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
2026-11-06 [승준] D5g 부품 4분류 표, 프레임 상세 기록, 구매 M10~M12(M5×8), AI 로그 SJ-39
    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
2026-11-06 [서현] 회로 쉬운 설명·한 장 그림, 제어 회로 부품 보유/구매 정리(HX711·빛 게이트 보유 오류 고침), 새 채팅 제어부 시작 명령
    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
    [bom.csv]
2026-11-06 [승준] D5g: 설탕물 급이 방 개념(팰컨 50 mL 뒤집기 + 코튼롤 + 물길), ULN2003 판매품 보드·레일 받침, T너트 판매품 치수, 공중 부양 검사
    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
2026-11-06 [승준] D5g 급이: 그릇 안 물길 벽 없앰(튜브 겹침), 발 볼트 간격 24
    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
2026-11-06 [승준] D5g: 떠 있던 Pi 5(선반 199a)·빛 게이트 G4·G6(받침 199b·c) 고정
    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
2026-11-06 [승준] 급이 방 개념·ULN2003·떠 있던 부품 고친 기록, 구매 M17~M21, AI 로그 SJ-40
    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
2026-11-06 [승준] 남은 [추측] 정리 (28BYJ-48 M4 확정 반영)
    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
2026-11-06 [승준] D5g 실제 전기 부품 CAD: ULN2003(KiCad STEP 부품), 단자대·퓨즈, Pi 5 공식 STEP
    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
2026-11-06 [승준] D5g 실제 부품: 단자대는 만능기판 위, Pi 5는 공식 STEP 구멍 4개를 선반 구멍에 맞추고 M2.5 × 5 기둥
    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
2026-11-06 [승준] 급이: 물 높이 369(벽 구멍보다 3.6 mm 아래), 코튼롤 10.6° 기울임 — 구멍 틈으로 새던 결함 고침
    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
2026-11-06 [승준] 급이 장치 원리·계산·방생부 설명, make()에 실제 부품 CAD 연결, AI 로그 SJ-41
    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
2026-11-06 [승준] 그림 설명 페이지(단자대·급이·방생), AI 로그 SJ-42
    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
2026-11-06 [승준] 급이 물길 뚜껑(벌레 막기), 방생 출구 일자 관 + 비 가림 갓
    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
2026-11-06 [승준] 벌레 막기·일자 출구·전기 나누는 곳 그림 설명 추가, AI 로그 SJ-43
    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
2026-11-06 [승준] 방생: 짧은 목 + 위로 열린 굴뚝(안지름 50) + 출구 조명, G6를 목으로
    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
2026-11-06 [승준] 방생 목·굴뚝 이음매 정리
    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
2026-11-06 [승준] 방생 굴뚝 그림 설명 갱신, AI 로그 SJ-44
    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
2026-11-06 [승준] 출구 조명 뺌 (굴뚝 위 햇빛, 방생 때 마킹실 불 끔), AI 로그 SJ-45
    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
2026-11-06 [서현] 승준 SJ-43~45 반영: 출구 조명·Q3 없앰(D6 예비), 단자대→와고 221+줄 퓨즈, 밤 방생 대기(NIGHT_HOLD, 시뮬 23/23)
    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
    [bom.csv, netlist.csv]
2026-11-06 [서현] 전기 부품 구매 확정표(국내 판매처·가격), 로드셀 막대형으로, 와고 222-415, 퓨즈홀더 F-520
    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
    [bom.csv]
2026-11-06 [승준] 밤에는 전부 가둠·낮에만 처리(daynight.py), 193 단자대 → 와고 221-415 + 받침
    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
2026-11-06 [승준] 아두이노 UNO 2장 실제 모양(공식 기판 규격 + KiCad STEP) + M3 기둥, 쌓는 높이 고침
    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
2026-11-06 [승준] UNO 기둥 3점 (헤더 옆 구멍 제외)
    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
2026-11-06 [승준] 낮·밤 동작 문서, 구매 M22~M24(와고·줄 퓨즈·UNO 기둥), AI 로그 SJ-46
    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
2026-11-06 [서현] 하네스 표(42묶음 117가닥 29.9 m), 밤 규칙 승준 안으로 맞춤(시뮬 24/24)
    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
    [harness.csv]
2026-11-06 [서현] 와고 221-415로 승준 구매·CAD와 맞춤(개수 5), 하네스 다시
    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
    [bom.csv, harness.csv]
2026-11-06 [승준] 빛 게이트 실제 모양(문 6쌍: 3 mm LED 낱개, 통로 3쌍: Adafruit 2167)·통로 빔 구멍, 비상 정지 22 mm 버섯형
    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
2026-11-06 [서현] 브레드보드 단계별 배선 안내 + 시험 스케치 4개, 회로도 1·2장 다듬기(2장 선 모임 오류 → 넷 라벨)
    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
2026-11-06 [승준] 비상 정지를 레일 바깥 판으로(데크 아래 차양막), 2167 빔 구멍 모든 게이트에, 선 꼬투리 뺌
    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
2026-11-06 [승준] 문 LED 다리 짧게 (틈 5 mm에서 안 닿게)
    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
2026-11-06 [승준] 빛 게이트·비상 정지 실제 모양 정리, 그림 설명 7번, 구매 M25~M27, AI 로그 SJ-47
    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
2026-11-06 [서현] 문 빔 6쌍 낱개 IR LED+포토TR(아날로그, 자가 시험 문턱값)로 회로·핀 바꿈, 하네스·스케치·구매 반영
    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
    [bom.csv, harness.csv, netlist.csv]
2026-11-06 [승준] UNO 공식 STEP 맞춤 함수 (구멍 4개로 방향 찾기)
    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
2026-11-06 [승준] UNO 공식 STEP 사용(있으면), 기판 원점 고정(기둥 6.35 mm 밀림 고침)
    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
2026-11-06 [승준] UNO 공식 STEP 반영(구멍 4개 맞춤), 기둥 사이 15 mm, AI 로그 SJ-48
    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
2026-11-06 [서현] 배터리 상자 회로(INA226 R010, GND 고리 계산, 회로도 4장), 쉬운 설명, AI 로그 CAP-AI-35
    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
2026-11-06 [서현] 회로 문서 퓨즈 표기 5×20 3 A로 맞춤
    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
2026-11-06 [서현] 인터페이스 정의서 5차 값: 빛 게이트 9쌍·원점·하중 센서·전원·배터리 상자·운용 시간·여왕벌 판정, 변경 이력, AI 로그 CAP-AI-36
    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
2026-11-06 [서현] 펌웨어 변경 요청 문서(UNO 2개 분리·핀 10개·HOME·SELFTEST·문 닫기 안전 규칙), AI 로그 CAP-AI-37
    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
2026-11-06 [승준] D5g 상세 1차: 가로대·갠트리 레일 T이음 브래킷 20, 급이 방 고정·인서트·손나사·튜브 집게, 막대 로드셀 4540, 부품 볼트 체결, 와고 5·허브 2·MOSFET·패널 퓨즈·J_I2C, LED 다리 꺾기 (검증 전)
    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
2026-11-06 [승준] D5g 상세 겹침 고침: 인서트 지름, 로드셀 팔 높이, 218 봉 구멍, LED 다리 꺾기 위치
    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
2026-11-06 [승준] 문 빔 LED 다리: 하우징 살을 벗어난 곳에서 꺾음(자동 탐색), 인서트 속 지름 = 나사 지름
    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
2026-11-06 [승준] 218 X 봉 받침: 둘레 레일 쪽은 봉이 지나가 귀 + M5 × 12로
    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
2026-11-06 [승준] LED 꺾인 다리 높이 고침, 218 늘린 부분이 봉 끝과 겹치던 것, 부품 이름표 스크립트
    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
2026-11-06 [승준] 와고 받침 나사 3개(가로대 피함), J_I2C 핀 기판 구멍, 상세설계 문서 초안
    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
2026-11-06 [승준] 부품표 스크립트: 문 하우징 속 부품 이름, 개수 묶기
    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
2026-11-06 [승준] D5g 상세설계 마무리: 부품표·번호 풍선 그림·급이 방/로드셀/T 이음 그림, 구매품 분류 보강, AI 로그 SJ-49
    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
2026-11-06 [승준] 부품 분류: 숫자 머리말은 이름 앞에서만 비교 (218 등이 설명 속 '100d' 때문에 구매품으로 잘못 칠해지던 것)
    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
2026-11-06 [승준] 과제 정리·요약 PDF '내가 뭐한거지???' (52쪽), AI 로그 SJ-50
    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
2026-11-07 [서현] D5g 실제 자리로 하네스 확정(43묶음 45.1 m, J_I2C→Pi 추가, 카메라 FFC 500 mm), 퓨즈 표기 3 A로 맞춤, AI 로그 CAP-AI-38
    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
    [harness.csv]
2026-11-07 [서현] VS Code + Claude Code 시작 정리(설치·clone·arduino-cli·첫 메시지), 인수인계 11/07판, AI 로그 CAP-AI-39
    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
2026-11-08 [서현] 펌웨어 v0.2 trap_motion(UNO 1)·trap_doors(UNO 2) 새로 — 회로 핀, HOME·SELFTEST·문 닫기 안전 규칙·RAIL, arduino-cli 컴파일 통과 (경고 0)
2026-11-08 [서현] 펌웨어 v0.2 제어 규칙 검토(V1~V7 채택, R1 F 올리기는 펜 UP일 때만, Pi 순서 P1~P7), AI 로그 CAP-AI-42
    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
2026-11-08 [서현] 검토 CAP-AI-42 반영: R1 바닥 올리기는 펜 UP일 때만, 변경요청 문서 V6·V7 고침 + 펌웨어 시뮬레이터(관련코딩저장/sim, zig c++) motion 82·doors 77 시험 통과, 시뮬이 찾은 버그 2개 수정(같은 문 열리는 중 CLOSE 굳음, 마지막 반걸음 코일 즉시 꺼짐)
    [Arduino.h, Servo.h, sim_common.h, sim_doors.cpp, sim_motion.cpp, trap_doors.ino, trap_motion.ino]
2026-11-08 [서현] 시뮬레이터 빌드 부산물 .pdb 제거 + ignore
2026-11-08 [서현] D5g CAD 서현 인수 — VS Code 작업 지시(C1~C6), 분업계획 11/08 바뀜, AI 로그 CAP-AI-43
    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
2026-11-08 [서현] Pi 연결 코드 pi_link(READY 이름으로 포트 구분, 켤 때 순서, 검토 P1~P7) + 실제 펌웨어 시뮬에 붙인 시험 36/36, 관련코딩저장 README, AI 로그 CAP-AI-40·41·44·45
2026-11-08 [서현] VS Code 전체 작업 명령 정리(첫 메시지·상태·할 일 1~7·규칙), 인수인계·분업계획 11/08, AI 로그 CAP-AI-46
    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
2026-11-08 [서현] 제어 규칙도 VS Code가 정함(분업계획·검토 문서 5장), 미검토 4개 판단(A2 대기 자리는 CAD에서), AI 로그 CAP-AI-47
2026-11-08 [서현] 처리 순서 process.py(판별→PRESS→마킹→급이→방생/격리, 장부, 주 루프) 시험 39/39, R1′(펜이 캡 컵이면 F 올리기 허용), AI 로그 CAP-AI-48
2026-11-08 [서현] 전기회로 폴더: 만드는 순서 E1~E10·파일 지도 README + 초등학생용 쉬운 설명 HTML, 남은 설계 2개(허브 기판 배치·역극성 보호), AI 로그 CAP-AI-49
2026-11-08 [서현] 허브 기판 배치(hub_boards.py, circuit.py 넷 대조 통과)·역극성 보호 SB540·카메라 FFC 500 mm로 맞춤, 전기회로 HTML 카메라·허브·역극성 장, AI 로그 CAP-AI-50
    [bom.csv, netlist.csv]
2026-11-08 [서현] 카메라 1대·배치(격자 위 200 mm, 가림 3가지) HTML 8-1장에 추가, AI 로그 CAP-AI-51
2026-11-08 [서현] 인터페이스 정의서 v0.2(통신·비전 결과 형식), 비전 결과를 승준 mark_planner에 맞춤, 기다리는 중 해 지면 밤으로(버그), 회로도 4장 다시 그림(D_RP·500 mm), CLAUDE.md 코딩 원칙, AI 로그 CAP-AI-52
2026-11-08 [승준] AI 로그 SJ-51 (FreeCAD 사본·PDF 원본 PC 저장, 인계 정리)
    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
2026-11-08 [서현] 새 대화 시작 명령(CAD·펌웨어 따로) 및 상태·할 일 갱신, AI 로그 CAP-AI-53
2026-11-08 [승준] 가격 조사·남은 예산·11/30 주문 마감일 (E1~E18 + M1~M36), 합계 스크립트, AI 로그 SJ-52
    예상 합계 35.6만~55.9만 vs 남은 돈 37.0만. 늦게 오는 것: 비상 정지 3주, MG90S(ICB) 3주, RTC 납기 미정.
    주문은 안 함 (서현: CAD 끝난 뒤).
    Claude-Session: https://claude.ai/code/session_01C1g5W1Vn4KS5EyYqEoKfSd
2026-11-08 [승준] AI 로그 SJ-52: 승준 PC FreeCAD 사본 = 레포 91bb058 모델 대조 (194개 같음)
    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
2026-11-08 [승준] D5g 서현 요청 CAD 고침 — 십자 나사·문 서보·모터 귀·카메라 CM3·회로 기판·3D 프린트 색 (CAP-AI-SJ-53)
    - cad/D5g_fix_sj53.py: 육각 렌치 볼트 → 십자 냄비머리 ISO 7045 (브래킷 머리 겹침 0), 문 서보 3개 기둥 한 몸 + M2 × 8,
    스테핑 3개 귀 M3 × 8 + 너트, Camera Module 3 + 걸이 181 + 링 182 (렌즈 끝 → 격자 153.5 mm), 3D 프린트 주황
    - cad/D5g_circuit_sj53.py: 서현 hub_boards.py 배치대로 허브 2장 자세히, MOSFET 모듈 부품(사진 배치 추측), 기판 나사·스페이서
    - cad/img/D5g_SJ53_*.png 8장, cad/README.md 기록
    - design/인터페이스_정의서.md: 카메라 모델·거리·시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
2026-11-08 [승준] SJ-53 마무리 — 구매 바뀌는 것(카메라 CM3·십자 나사·스페이서·탭), Issue #9, AI 로그
    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
2026-11-08 [승준] 카메라 Camera Module 3 사기로 정함 — DM 14917048 + FPC 30 cm, 구매 문서·인터페이스 상태·AI 로그 (CAP-AI-SJ-54)
    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
2026-11-08 [서현] 조명 시험 스크립트·계획(3-B 1), 미검증 값 맞추는 순서(3-B 2) (CAP-AI-54)
2026-11-08 [서현] 허브 기판 몸통 겹침 검사 + 서보 허브 레일 부품·전원 전선 다시 놓음, SB540 구멍 Ø1.5, J_I2C 격자 위 가로 (Issue #9 3~6, CAP-AI-54)
2026-11-08 [서현] CM3 자리 반영(하네스·전력), 명령 정리 3-B 표시, AI 로그 CAP-AI-54
    [harness.csv]
2026-11-08 [서현] Issue #10 올림, 주문·카메라는 CAD 뒤 한꺼번에 (CAP-AI-54)
2026-11-08 [서현] D5g C3 HX711·DC 잭, J_I2C 자리(Issue #9-5), 원점 스위치 3개·X 집게, 투명 격자, 그림 스크립트 — 검사 중 (CAP-AI-55)
    [D5g_c3_hx711_dcjack.py, D5g_frame_detail.py, D5g_home_switches.py, D5g_real_parts.py]
2026-11-08 [서현] D5g C1~C6: FCStd 저장, 겹침·뜬 부품 0, HX711·DC 잭, 원점 스위치 3개(대기 X +10 확인), 투명 격자, 그림 6장 (CAP-AI-55)
    [D5g_full.FCStd]
2026-11-08 [서현] 하네스를 D5g CAD 자리로 다시 계산 (HX711·DC 잭·원점 스위치·J_I2C, 44.8 m), FFC 30 cm 부족 가능 (CAP-AI-55)
    [harness.csv]
2026-11-08 [서현] AI 로그: Issue #9 댓글 올림 (CAP-AI-55)
2026-11-08 [승준] 주간 보고 발표자용 설명서 PDF 2쪽, 카메라 케이블 30 cm 취소(500 mm 그대로), AI 로그 SJ-55
    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
2026-11-10 [서현] 급이 방 고침: 15 mL 튜브·물 366·솜 끝 벽 뒤로·급이 높이 F 31, 검사 cad/feeder_check.py 6개 통과 (CAP-AI-56, CAD 다시 만들기 전)
    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
2026-11-10 [서현] D5g 다시 만듦 (급이 방 고침: 15 mL 튜브·물 366·솜 벽 뒤로) — FCStd, 그림 6장, 급이 단면 x55. 겹침: 급이 부품 0, 바닥 0~36.5 올림 vs 솜·벽·물길 0 (CAP-AI-56)
    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
    [D5g_full.FCStd]
2026-11-10 [서현] 급이 방 원리·사용법·고침 문서, 원리 동영상, 부품표 15 mL, pi_link 시험 F 31, README·AI 로그 CAP-AI-56
    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
2026-11-10 [서현] 급이 방 상세: 물길 앞벽(솜 구멍), 벽 나사 2개 없앰, 뚜껑 기둥 Ø9·구멍 7, McMaster STEP 부품 단계(D5g_feeder_mcm.py) — 다시 만들기 전 (CAP-AI-57)
    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
2026-11-10 [서현] 급이 방 조립·분해 그림 매크로 (CAP-AI-57)
    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
2026-11-10 [서현] 급이 방 상세: 발 볼트 간격 ±22(드라이버 자리), 뚜껑 손나사 y 60(손가락 자리), 드라이버 검사 추가 (CAP-AI-57)
    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
2026-11-10 [서현] 급이 방 상세설계 문서 초안 (McMaster 부품표·물림·조립 순서, 검사 결과는 다음 커밋) (CAP-AI-57)
    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
2026-11-10 [서현] 급이 방 발: 데크 아래 M3 × 8 + 발 인서트로 (위 M5는 그릇·서보 허브·로드셀에 드라이버 막힘) (CAP-AI-57)
    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
2026-11-10 [서현] 급이 방 그림·부품표: 발 M3 × 8 (92000A118) + 인서트 2, 143s·M5 와셔·T너트 뺌 (CAP-AI-57)
    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
2026-11-10 [서현] 급이 방 상세설계 문서: 발 M3 × 8 데크 아래 조임·부품표·조립 순서 (CAP-AI-57)
    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
2026-11-10 [서현] 급이부 부품별 CAD: 부품 파일 7종 + App::Link 조립 + 겹침·맞춤 검사 스크립트 (CAP-AI-58)
    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
2026-11-10 [서현] 급이부 조립: 링크 전에 조립 파일 먼저 저장 (CAP-AI-58)
    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
2026-11-10 [서현] 급이부 부품별 그림 매크로 (4면 + 치수·맞춤 표) (CAP-AI-58)
    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
2026-11-10 [서현] 급이부 조립 링크: LinkTransform 켬 — 부품 자기 원점 자리가 버려져 엉뚱한 곳에 놓이던 것 (CAP-AI-58)
    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
2026-11-10 [서현] 급이 발에 남던 옛 M5 머리 홈 2개 없앰: M5 발 볼트·T너트를 아예 안 만듦 (CAP-AI-58)
    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
2026-11-10 [서현] 급이부 부품 폴더 README 초안 (CAP-AI-58)
    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
2026-11-10 [서현] 급이부 부품별 CAD 검사 결과·결정할 것, 상세설계 4장, cad README, AI 로그 CAP-AI-57·58
    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
2026-11-10 [서현] 급이부 부품별 파일 7종·조립 파일·부품 그림 8장, D5g_full 다시 (발 M3, 옛 M5 홈 없앰), 급이 방 조립·분해 그림 (CAP-AI-57·58)
    D5g_full.FCStd는 McMaster 부품을 표 치수 단순 모양으로 넣어 저장 (STEP 든 것은 서현 PC CAD files\D5g\D5g_full_McMasterSTEP.FCStd)
    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
    [A143_급이방_조립.FCStd, D5g_full.FCStd, P142n_코튼롤.FCStd, P143_물길그릇.FCStd, P143l_뚜껑.FCStd, P144n_튜브15mL.FCStd]
2026-11-10 [서현] 부품 그림: − 글자가 □로 나오던 것 (CAP-AI-58)
    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
2026-11-10 [서현] 급이부 부품 그림 다시 (− 글자) (CAP-AI-58)
    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
2026-11-10 [서현] 급이 방 사는 것·프린트·솜 색 구분 그림 매크로 (CAP-AI-58)
    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
2026-11-10 [서현] 급이 방 사는 것·프린트·솜 색 구분 그림 (CAP-AI-58)
    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
2026-11-10 [서현] 급이 방 사는 것·프린트·솜 그림: 자른 면 그림 추가, 분해 그림 표를 오른쪽으로 (CAP-AI-58)
    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
2026-11-10 [서현] 급이 방 사는 것·프린트 분해 그림 다시 (CAP-AI-58)
    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
2026-11-10 [서현] 분해 그림 표 자리 오른쪽 아래로 (CAP-AI-58)
    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
2026-11-10 [서현] AI 로그 CAP-AI-58: 사는 것·프린트 그림
    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
2026-11-10 [서현] 전체 모델: 3D 프린트 부품만 파랑, 나머지 회색 (D5g_print_color, make 끝) + 그림 제목 (CAP-AI-58)
    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
2026-11-10 [서현] 전체 모델·그림 6장: 3D 프린트만 파랑, 나머지 회색 (CAP-AI-58)
    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
    [D5g_full.FCStd]
2026-11-10 [서현] D5g 3D 프린트 부품 목록 (모델에서 뽑음, 43개) (CAP-AI-58)
    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
2026-11-10 [서현] AI 로그: 프린트 부품 색 (CAP-AI-58)
    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
2026-11-10 [서현] 기본 CAD 파일 = 프린트 색 D5g_full.FCStd (README), 급이부 부품 파일도 같은 색 규칙 (CAP-AI-58)
    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
2026-11-10 [서현] 급이부 부품 파일 다시: 프린트 파랑·나머지 회색 (CAP-AI-58)
    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
    [A143_급이방_조립.FCStd, P142n_코튼롤.FCStd, P143_물길그릇.FCStd, P143l_뚜껑.FCStd, P144n_튜브15mL.FCStd]
2026-11-10 [서현] AI 로그: 기본 CAD 파일 지정 (CAP-AI-58)
    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
2026-11-10 [서현] 급이부를 펌프 방식으로: 바깥 병 250 mL + 연동 펌프(먹일 때만) + 물빠짐, 자석 뚜껑 — CAD·펌웨어 PUMP·Pi·회로·전원 (CAP-AI-59)
    - cad: 143 그릇·리브·집게 없앰, 노즐·물빠짐 바브, 자석 2쌍+핀 / D5g_feeder_pump.py (걸이·병·펌프·관·볼트·검사)
    - feeder_check: 고인 물 없음 → 펌프 고장 넘침·노즐·물빠짐 검사 7개 통과
    - trap_doors v0.2: PUMP <ms> (D6, 최대 2 s, 문과 같이 안 움직임, 레일·WATCHDOG 멈춤) — sim_doors 89/89
    - Pi: controller.pump, process.feed 에서 100 ms — test_process 53/53, test_pi_link 36/36
    - circuit.py: D6 → Q3 → 펌프 + 1N5819, BOM / elec_budget: 급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
    [bom.csv, netlist.csv]
2026-11-10 [서현] 인터페이스 정의서: 급이 줄(펌프 방식)·PUMP 명령·D6 Q3, 변경 이력 (CAP-AI-59)
    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
2026-11-10 [서현] AI 로그 CAP-AI-59 (펌프 방식, 남은 일)
    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
2026-11-10 [서현] 급이 걸이: 컵 팔이 병 자리를 채우던 것·볼트 머리가 병에 닿던 것 고침 (CAP-AI-59)
    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
2026-11-10 [서현] 급이부 부품 README: 펌프 방식 부품표 (CAP-AI-59)
    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
2026-11-10 [서현] 급이 상세설계 문서: 펌프 방식 요약·검사 (CAP-AI-59)
    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
2026-11-10 [서현] 로드셀·HX711 없앰 → 스프링 + 누름 스위치(A1, NC): 펌웨어 PRESS·STATUS PSW, 시뮬 88/88, Pi 36/36·53/53 (CAP-AI-60, 교수님 피드백)
    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
2026-11-10 [서현] 회로·하네스·전원: HX711·로드셀 → 누름 스위치 PSW (A1 NC, A2 예비) — 검사 통과 (CAP-AI-60)
    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
    [bom.csv, harness.csv, netlist.csv]
2026-11-10 [서현] CAD: 로드셀·HX711 → 캐리지 스프링 받침 칸 + 걸쇠 148c + 누름 스위치 227p, 검사(겹침·올림 길) (CAP-AI-60)
    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
2026-11-10 [서현] AI 로그 CAP-AI-60: 로드셀 없앰, 일단 정지 지점·남은 일
    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
2026-11-11 [서현] 인터페이스 정의서: 하중 센서 → 누름 감지(스프링+스위치), PRESS·핀, 변경 이력 (CAP-AI-60)
    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
2026-11-11 [서현] 하네스: 급이 펌프 선(UNO 2 D6 → Q3, Q3 → 펌프) + MOSFET 보드 전원 1.0 A (CAP-AI-59 빠진 것)
    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
    [harness.csv]
2026-11-11 [서현] S4 스프링 146 문서: 로드셀 없앰 메모 (δ 4.83 mm, 오차, 넘침 항목 해당 없음) (CAP-AI-60)
    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
2026-11-11 [서현] 프린트 부품 → 구매·판 재단으로 바꾸는 표 (43개, 순서) (CAP-AI-61)
    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
2026-11-11 [서현] (진행 중) 급이부: 물길 포맥스 판·각관 기둥·앵글·M3·M5 니플, 병 걸이 알루미늄 판 + 클램프, McMaster 발 인서트 없앰 — 부품 파일 스크립트는 아직 (CAP-AI-61)
    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
2026-11-11 [서현] 게이트 받침을 2167 모양 뒤에 다시 만듦(송수신기 떠 있던 것), 물빠짐 관 → 버림통 50 mL, 고무관 색 (CAP-AI-61)
    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
2026-11-11 [서현] AI 로그 CAP-AI-61 (STEP 받음 3개, 니플 6220N79, 막힌 것·남은 일)
    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
2026-11-11 [서현] CAD를 급이부·마킹부·프레임회로 3파일로 나누는 스크립트 + 링크 조립 S0 (CAP-AI-62)
    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
2026-11-11 [서현] 3파일 나누기: freecadcmd 대신 따로 띄운 freecad.exe (옛 스크립트가 ViewObject 씀), 색 복사
    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
2026-11-11 [서현] S0 조립: 조립 문서를 먼저 저장한 뒤 링크 (Owner document not saved 오류)
    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
2026-11-11 [서현] S1 급이부만 고치는 스크립트(둘레 부품을 잠깐 넣어 부딪힘 확인) + 관 경로 고침: 바브 허용·먹이 관과 물빠짐 관 교차 피함
    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
2026-11-11 [서현] split3.color_doc: App::Part 건너뜀 (PCOL.apply 오류)
    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
2026-11-11 [서현] split3.color_doc: 없는 보기 속성은 건너뜀
    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
2026-11-11 [서현] CAD 3파일로 나눔: S1 급이부·S2 마킹부·S3 프레임회로 + S0 링크 조립, S1 관 경로 고침(겹침 문제 0) (CAP-AI-62)
    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
    [S0_전체조립.FCStd, S1_급이부.FCStd, S2_마킹부.FCStd, S3_프레임회로.FCStd]
2026-11-11 [서현] AI 로그 CAP-AI-62 (3파일 나눔, S1 관 고침)
    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
2026-11-11 [서현] S1 PC판: 니플 6220N79·M3 너트 90592A085 STEP을 단순 모양 자리에 (레포엔 안 올림), 급이 하드웨어 자리 PLACES
    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
2026-11-11 [서현] 급이: STEP으로 찾은 겹침 고침 — M3 너트가 각관 벽 속(→ M3 × 18, 너트 각관 바깥), 니플 육각이 기둥에 0.16 mm(물빠짐 y 90 → 91). edit_s1이 143도 다시 만들고 검사
    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
2026-11-11 [서현] 급이 물길: 물빠짐 받침이 기둥과 27 mm³ → 받침 y 86부터, 위 앵글 M3 구멍을 물길 바닥에도 (나사가 판을 지나고 있었음)
    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
2026-11-11 [서현] S1 급이부 다시 만듦: 너트 각관 바깥·M3 × 18, 물빠짐 y 91, 받침·나사 구멍 — S1 겹침 문제 0, STEP판(PC)도 0 (CAP-AI-62)
    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
    [S1_급이부.FCStd]
2026-11-11 [서현] 급이 위 앵글 ↔ 물길: 나사 대신 에폭시 (서현 결정) — 물길 바닥 구멍·너트 없앰, M3 4개
    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
2026-11-11 [서현] S1: 위 앵글 에폭시(나사·구멍 없앰) 반영 — 겹침 문제 0, STEP판 0
    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
    [S1_급이부.FCStd]
2026-11-11 [서현] 원점 스위치 apply가 누름 스위치 227p까지 지우던 것 고침 (11/10부터 모델에 없었음)
    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
2026-11-11 [서현] 누름 걸쇠 혀·스위치를 +y 쪽으로 (+x는 151_R과 겹침), 스위치 받침판, S2만 고치는 edit_s2.py
    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
2026-11-11 [서현] S2: 누름 걸쇠 혀·스위치 +y 쪽 + 빠졌던 누름 스위치 227p 다시 — 겹침 문제 0, 올림 길 0 (CAP-AI-62)
    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
    [S2_마킹부.FCStd]
2026-11-11 [서현] 경계 검사 실행 스크립트
    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
2026-11-11 [서현] cad/split/README (3파일 규칙·찾은 것), AI 로그 CAP-AI-62 이어서
    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
2026-11-11 [서현] 경계 검사 (S1·S2·S3 서로) 겹침 0 (CAP-AI-62)
    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
2026-11-11 [서현] 28BYJ-48 모터 3개를 Adafruit 858 STEP(MIT)으로 바꾸는 스크립트 s2_motors.py
    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
    [858_28BYJ48.step]
2026-11-11 [서현] s2_motors: 빈 모양 건너뜀
    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
2026-11-11 [서현] s2_motors: 모양 연산 오류 보고
    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
2026-11-11 [서현] s2_motors: 고체 하나씩 겹침 계산 (닿는 면 Null shape)
    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
2026-11-11 [서현] S2: 28BYJ-48 모터 3개(153·209·215) → Adafruit 858 실제 도면(MIT), 겹침 0, Y 모터 이동 ±30 걸림 0 (CAP-AI-62)
    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
    [S2_마킹부.FCStd, _s2_motors.json]
2026-11-11 [서현] 진짜 모터 도면 넣기를 real_motor.py 하나로 — 전체 도면(D5g_full)용 full_motors.py, 다시 만들기(G.make)에도
    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
2026-11-11 [서현] 전체 도면 = 세 파일 합치기 (full_merge.py) — '전체 수정' 때만
    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
    [full_merge.py, split3.py]
2026-11-11 [서현] 전체 도면 D5g_full = S1+S2+S3 합침 (진짜 모터 3개, 11/11~12 고친 것 포함) (CAP-AI-62)
    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
    [D5g_full.FCStd]
2026-11-11 [서현] split README: 전체 도면은 '전체 수정' 때만, full_merge
    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
2026-11-11 [서현] 전체 수정 때 최신 D5g_full을 바탕화면 capstone design 폴더에도 덮어씀
    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
    [full_merge.py]
2026-11-11 [서현] 빛 게이트 2167 실제 치수(20×10×8, LED 끝 5, 구멍 Ø2.4) + 둥근 관 안장 받침·M2 × 12 (gate2167.py)
    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
2026-11-11 [서현] G6 2167을 y 방향으로 (x 방향은 176·G5b·175와 겹침)
    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
2026-11-11 [서현] 부품표: 게이트 안장 받침·M2 나사 199s
    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
2026-11-11 [서현] S2: 빛 게이트 2167 실제 치수 + 안장 받침 (G1·G4 관에 붙음, G6 y 방향) — 겹침 문제 0 (CAP-AI-62)
    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
    [S2_마킹부.FCStd]
2026-11-11 [서현] 통로 관 110·172 → 수도용 PVC 13A(구매) + 꺾임 조각(작은 프린트, 엘보 36 mm는 하우징에 안 들어감), 게이트 받침 관 Ø18
    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
2026-11-11 [서현] 172 PVC 세로 관 축 x +1.5 (갠트리 레일 100d에 1 mm 묻힘), G4 게이트도
    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
2026-11-11 [서현] S2: 통로 관 110·172 → PVC 13A(구매) + 꺾임 조각(작은 프린트), 게이트 받침 Ø18 — 겹침 문제 0 (CAP-AI-62)
    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
    [S2_마킹부.FCStd]
2026-11-11 [서현] 깔때기 111·173 → McMaster 9017T211 (목 안 12.2) 잘라 씀 + 열수축 튜브로 PVC와 이음 (funnels.py)
    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
2026-11-11 [서현] 173 깔때기는 윗테를 더 잘라 Ø52 — 위판·돔 연결부 구멍 Ø55를 지나 z 620 (104와 겹침 397 mm³)
    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
2026-11-11 [서현] S2: 깔때기 111·173 → McMaster 9017T211 잘라 씀 + 열수축 이음 — 겹침 0 (CAP-AI-62)
    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
    [S2_마킹부.FCStd]
2026-11-11 [서현] 전체 수정: D5g_full = S1+S2+S3 (모터·빛 게이트·PVC 통로·산 깔때기), 바탕화면 capstone design에도 (CAP-AI-62)
    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
    [D5g_full.FCStd]
2026-11-11 [서현] 전체 수정 뒤 경계 검사 겹침 0
    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
2026-11-11 [서현] 바닥 구동 다시 (lift_drive.py): 사라진 캐리지 새로(깨끗한 고체), 리드스크루 위 F688ZZ, 봉 157 위아래 고정(칼라 2·막힌 구멍), 봉 부싱 LM4UU, 너트 M3 4
    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
2026-11-11 [서현] 바닥 구동: 캐리지 고체가 깨지던 원인 2개 고침(0.01 틈 자르기, removeSplitter) + 검사에서 원점 평면·REF 말벌 뺌
    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
2026-11-11 [서현] AI 로그: 01~04시 부품 고침, 바닥 구동 멈춘 자리 (PC 연결 끊김)
    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
2026-11-11 [서현] split3.extract: 바닥 올리는 장치만 떼어 S2a_바닥구동으로
    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
2026-11-11 [서현] extract: 바닥 모터 귀 나사만
    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
2026-11-11 [서현] S2 바닥 구동 다시 (캐리지 새로·F688ZZ·봉 칼라·LM4UU) — 겹침 0, 올림 길 0, 캐리지 유효 + 바닥 구동만 뗀 S2a (CAP-AI-62)
    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
    [S2_마킹부.FCStd, S2a_바닥구동.FCStd]
2026-11-11 [서현] 색 규칙 3가지: 3D 프린트 초록 · 사서 자르거나 고침 파랑 · 그냥 삼 회색 (부품표로 판정)
    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
2026-11-11 [서현] 세 파일·S2a 다시 칠함: 프린트 초록·사서 고침 파랑·그냥 삼 회색
    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
    [S1_급이부.FCStd, S2_마킹부.FCStd, S2a_바닥구동.FCStd, S3_프레임회로.FCStd]
2026-11-11 [서현] 모터판 152: 모터 귀 접시머리 M3 자리·구멍 (나사가 판을 구멍 없이 지나고 있었음)
    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
2026-11-11 [서현] 모터판 152 접시머리 자리·구멍 (나사 ↔ 판 겹침 0)
    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
    [S2_마킹부.FCStd, S2a_바닥구동.FCStd]
2026-11-11 [서현] 마킹실 최소 크기 계산 (안 40 → 32, 높이는 문 배치가 정함)
    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
2026-11-11 [서현] 마킹실 안 40 → 32 (격자 7 × 7, 바닥판 46 그대로), 급이부 y −4·발 나사 간격 17, G6 x −4, 다시 만들기에 PVC 통로·산 깔때기 넣음
    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
2026-11-11 [서현] 바닥 F = 산 리니어 모듈 15BY25 + DRV8833: 펌웨어 F 양극 반걸음·80 반걸음/mm, 시뮬 88/88·89/89, 회로·하네스·BOM, 인터페이스 정의서
    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
    [bom.csv, harness.csv, netlist.csv]
2026-11-11 [서현] 바닥 구동 → 산 리니어 모듈 (lift_module.py): 모듈을 151_R에, 캐리지 팔 → 슬라이더 M2.5, F 드라이버 자리 DRV8833. 다시 만들기·s2_lift도 이것으로
    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
2026-11-11 [서현] 부품표: 리니어 모듈 153m·슬라이더·M2.5
    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
2026-11-11 [서현] AI 로그: 마킹실 32·리니어 모듈·DRV8833, 멈춘 자리 (PC 연결 끊김)
    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
2026-11-11 [서현] 다시 만들기: 실제 부품 실패 이유를 파일로
    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
2026-11-11 [서현] split3_build: stdout 줄 단위로 바로 씀 (os._exit 전에 잃음)
    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
2026-11-11 [서현] 실제 부품: F 자리가 DRV8833이면 ULN 기판으로 덮지 않음 (다시 만들기 실패 원인)
    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
2026-11-11 [서현] 귀 나사: 없는 모터(바닥 153)는 건너뜀
    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
2026-11-11 [서현] 리니어 모듈: 옛 로드셀 자리 148 지움, 누름 검사의 움직이는 묶음에 슬라이더
    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
2026-11-11 [서현] real_motor: 좌표를 모양에 구워 넣음 (다시 만들기에서 209가 원점으로), 경계 검사: 게이트 나사는 마킹부·카메라 시야 원뿔 뺌
    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
2026-11-11 [서현] 전체 수정: 마킹실 안 32·격자 7×7, 바닥 리니어 모듈(15BY25), 급이부 y −4 — 다시 만들기 + 경계 검사 0 + D5g_full (바탕화면 복사) (CAP-AI-62)
    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
    [D5g_full.FCStd, S0_전체조립.FCStd, S1_급이부.FCStd, S2_마킹부.FCStd, S2a_바닥구동.FCStd, S3_프레임회로.FCStd]
2026-11-11 [서현] 바닥 구동 기둥: 프린트 옆판 → 알루미늄 평철 20 × 3 + 앵글 꺾쇠 4 + M3, 바닥판 R 혀. 리니어 모듈 치수도 값(슬라이더 윗면 10.5, 길이 10, 구멍 간격 10)으로
    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
2026-11-11 [서현] 기둥 나사: L 위 나사를 승강 바닥 밖 y 20.3으로, 모듈 나사 M3 × 4 (슬라이더 길 침범)
    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
2026-11-11 [서현] AI 로그: 기둥 산 재료·나사 겹침 고침
    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
2026-11-11 [서현] 기둥 L 아래 나사를 칼라 고리 안쪽(r 43)으로, 평철·꺾쇠 구멍을 나사 자리(SEAT)와 맞춤
    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
2026-11-11 [서현] 기둥 위 꺾쇠: 바닥판 위 나사가 마킹실 벽과 겹침 → 아래에서 M3 × 6 + 열압입 인서트
    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
2026-11-12 [서현] 전체 수정: 바닥 구동 기둥을 산 알루미늄 평철 20 × 3 + 앵글 꺾쇠로 (파랑), 나사 겹침 0, 경계 검사 0
    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
    [D5g_full.FCStd, S0_전체조립.FCStd, S1_급이부.FCStd, S2_마킹부.FCStd, S2a_바닥구동.FCStd, S3_프레임회로.FCStd]
2026-11-12 [서현] AI 로그: 기둥 전체 수정 검증
    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
2026-11-12 [서현] 리니어 모듈을 판매처 사진대로: 옆벽 없앰, 가이드 봉 추가, 슬라이더 폭 14.5 (판매처 STEP 없음)
    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
2026-11-12 [서현] 되돌림: 리니어 모듈 모양 변경을 조립에 넣지 않음 (서현 12:37 '일단 넣지 말고' — 모듈만 따로 그림)
    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
2026-11-12 [서현] 리니어 모듈 15BY25-77만 따로 3D (치수도·사진대로, 조립엔 아직 안 넣음)
    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
2026-11-12 [서현] 리니어 모듈 15BY25-77 따로 그린 파일·그림 (겹침 0, 88 × 18 × 15, 슬라이더 윗면 10.5)
    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
    [P153m_리니어모듈_15BY25-77.FCStd]
2026-11-12 [서현] AI 로그: 리니어 모듈 따로 그림
    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
2026-11-12 [서현] 리니어 모듈 따로: 행정 자리 고침(끝판 안 닿게), move()로 움직여 보기
    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
2026-11-12 [서현] 리니어 모듈 따로: 움직임 검사로 찾은 겹침 2 고침 (봉 베어링이 옆 턱에, 행정 끝에서 슬라이더가 끝 받침에)
    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
2026-11-12 [서현] 리니어 모듈 따로: 움직임 그림(gif)·검사 0~62 mm 겹침 0
    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
    [P153m_리니어모듈_15BY25-77.FCStd]
2026-11-12 [서현] 움직임 그림 낱장(_frames)은 레포에서 뺌
    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
2026-11-12 [서현] AI 로그: 리니어 모듈 움직임 검사
    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
2026-11-12 [서현] 전체 수정: 바닥 리니어 모듈을 따로 그린 ks_15by25_module 모양으로 (움직임 검사 0~62 겹침 0)
    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
    [lift_module.py]
2026-11-12 [서현] 모듈 단자판을 봉 쪽(−y)으로 — 조립에서 캐리지 아래 칸과 9.7 mm³ 겹침
    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
2026-11-12 [서현] AI 로그: 리니어 모듈 전체 수정 진행 (PC 연결 끊김)
    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
2026-11-12 [서현] 전체 수정: 바닥 리니어 모듈 = 따로 그린 15BY25-77 모양 (누름·올림 길·S2·경계 검사 0), S2a·그림
    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
    [D5g_full.FCStd, S0_전체조립.FCStd, S1_급이부.FCStd, S2_마킹부.FCStd, S2a_바닥구동.FCStd, S3_프레임회로.FCStd]
2026-11-12 [서현] 리프트 회색 부품을 카탈로그 부품으로: 축 5033N108 (75, 안 자름)·부싱 61205K72·스프링 8969T117·칼라 57485K64(프린트 걸쇠 대신)·나사 92000A017/019/107, 누름 스위치를 캐리지 윗면으로
    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
2026-11-12 [서현] s2_vendor.py: 리프트 회색 부품 STEP판 (PC 전용, McMaster CAD는 레포에 안 올림)
    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
2026-11-12 [서현] S2a 떼기에 축 칼라 148k 포함
    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
2026-11-12 [서현] 리프트 v2 (기성품+나사만): MiniSlide 50 mm + 투명 PVC 크로스 마킹실 + 메카노 거더 + 스페이서 + 와셔 바닥 — 리프트부만
    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
2026-11-12 [서현] 리프트 v2: STEP 자체 겹침(캐리지↔안내 봉) 허용
    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
2026-11-12 [서현] 리프트 v2 그림 (등각·정면·옆) — 겹침 0, 행정 15.9
    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
2026-11-12 [서현] AI 로그: 리프트 v2
    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
2026-11-12 [서현] 리프트 v2: 누르는 힘 = 위 망 + M12 와셔 8장 무게(0.49 N), 행정 18.05
    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
2026-11-12 [서현] 리프트 v2 그림: 위 망 + 와셔 무게 추가, 겹침 0, 행정 18.05
    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
2026-11-12 [서현] AI 로그: 리프트 v2 누르는 힘
    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
2026-11-12 [서현] 리프트 v2: 누름 감지 = 링 자석(와셔 맨 위) + 홀 모듈 KY-024 DO → A1, 와셔 7장, 펌웨어 F 96 반걸음/mm (MiniSlide) — sim 88/88·89/89
    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
2026-11-12 [서현] 리프트 v2 그림: 링 자석 + 홀 모듈
    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
2026-11-12 [서현] 리프트 v2: 마킹실 1" 크로스(34567), 누르는 힘 = 망 + 강철 니플 44615K416(약 95 g), 자석 6×3 + 홀, 바닥 M8 9021, 행정 24.57, 펜 닿는 범위·캐리지 행정 검사 추가
    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
2026-11-12 [서현] 리프트 v2 그림: 1" 크로스 + 니플 (겹침 0, 펜 ±5.75, 캐리지 행정 안)
    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
2026-11-12 [서현] AI 로그: 리프트 v2 1" 크로스·니플
    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
2026-11-12 [서현] 리프트 v2 틀: 2020 100 mm 3개 + T너트, 레일은 무두 볼트, 위 소켓은 EMT 새들, 홀 모듈은 메카노 브래킷 (떠 있던 것 고침)
    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
2026-11-12 [서현] 리프트 v2 검사: 틀·센서 고정 부품 겹침도
    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
2026-11-12 [서현] 리프트 v2: 홀 모듈 나사 M3 × 4, 막대 앞면 0.05 띄움 (검사 겹침 3개 고침)
    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
2026-11-12 [서현] 리프트 v2: 마킹실 = 예외 상자 하나 (안 Ø31 × 14, 문 구멍 Ø13 바닥 높이 −x·+y), 바닥 M10 9021, 스페이서 25, 행정 9 — PVC 크로스 버림(문~바닥 36 mm)
    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
2026-11-12 [서현] 리프트 v2 검사: 행정 안에서만 3 mm씩
    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
2026-11-12 [서현] 리프트 v2 그림: 마킹실 상자 (예외) — 겹침 0, 행정 9, 펜 ±5.75
    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
2026-11-12 [서현] (작업 중) 리프트 v2 다시 씀: 망 위 니플 없앰, 망은 인서트+와셔로 고정, 나사 ISO 7045 모양, 홀 판 스페이서 고정 — 바닥 덩어리 힘 막기는 틀림(스프링으로 바꿀 예정), 실행·검사 안 함
    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
2026-11-14 [서현] 리프트 v2: 바닥 덩어리 → 스프링 9657K33 (0.193 N/mm) + 홀, 2.5 mm에서 0.48 N — 겹침 0, 캐리지 레일 안
    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
2026-11-14 [서현] 리프트 v2: 마킹실 상자 프린트 파일 따로(STL·STEP), 인서트 자리 옮김, KY-024 모양(판·LM393·가변저항·핀·SS49E) — 겹침 0, 펜 69/69
    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
    [300_마킹실상자.FCStd, 300_마킹실상자.step, 300_마킹실상자.stl]
2026-11-14 [서현] 리프트 v3: mightyZAP D7-6PT-3 액추에이터 하나로 (MiniSlide·거더·스프링·홀 뺌) — 겹침 0, 펜 69/69
    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
2026-11-14 [서현] 마킹실 상자 38 × 38로 줄임 (프린트 파일 다시), 전기계통 15장: 바닥 F 스테핑 → mightyZAP + MT3608 7.4 V — 겹침 0
    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
    [300_마킹실상자.FCStd, 300_마킹실상자.step, 300_마킹실상자.stl]
2026-11-14 [서현] 마킹실 상자에 격자 한 몸(망·인서트 뺌), 안 Ø33·바깥 40, 바닥 McMaster 90313A108 — 겹침 0, 펜 37/37
    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
    [300_마킹실상자.FCStd, 300_마킹실상자.step, 300_마킹실상자.stl]
2026-11-14 [서현] 마킹실 격자 → 투명 아크릴 주문 제작판 300p (DXF·STEP·FCStd 따로), 상자는 인서트 4 — 겹침 0, 펜 37/37
    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
    [300_마킹실상자.FCStd, 300_마킹실상자.step, 300_마킹실상자.stl, 300p_아크릴격자판.FCStd, 300p_아크릴격자판.dxf, 300p_아크릴격자판.step]
2026-11-14 [서현] AI 로그: 전체 수정 계획 (새 마킹실 + 문 3개 다시 배치, 격리 −y)
    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
2026-11-14 [서현] (작업 중) 전체 수정 1단계: 상자 문 구멍 4 (−x 입구·+x 방생·−y 격리·+y 급이 Ø11.2), 날개 → 바닥 혀 + 세운 2020 (데크까지), 전체 좌표 검사 스크립트
    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
    [lift_v3.py, s2_chamber_v3_check.py]
2026-11-14 [서현] (작업 중) 1단계 고침: 상자·아크릴 38 × 38 (옛 벽 바깥과 같음), 세운 막대 위 끝 361 (방생 문 아래), 혀 18
    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
    [300p_아크릴격자판.dxf]
2026-11-14 [서현] (작업 중) 1단계 검사에 리프트 혼자 검사 같이
    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
2026-11-14 [서현] (작업 중) 1단계: 급이 구멍을 솜 축 따라 기울게 (옛 벽 120과 같음)
    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
2026-11-14 [서현] 전체 수정 1단계: 새 마킹실 38 × 38 + 리프트 v3를 전체 좌표에 — 전체와 겹침 0 (문·통로는 2단계)
    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
2026-11-14 [서현] (작업 중) 상자 밑 혀 24, M5 구멍 간격 8 (두 구멍이 붙어 있던 것 고침), 프린트 안내 고침
    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
2026-11-14 [서현] 전체 수정 1단계 끝: 부품 파일 2개 38 × 38 (상자 문 구멍 4 + 밑 혀, 아크릴판), 전체와 겹침 0
    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
    [300_마킹실상자.FCStd, 300_마킹실상자.step, 300_마킹실상자.stl, 300p_아크릴격자판.FCStd, 300p_아크릴격자판.step]
2026-11-14 [서현] (작업 중) 전체 수정 2단계 스크립트: 문 3개 옮김(입구 +27.5·서보 +y, 격리 −y, 방생 서보 +y), 대기 PARK x +30, 격리 새 통로
    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
    [s2_doors_v3.py]
2026-11-14 [서현] (작업 중) 2단계 1차 검사 고침: PARK +10, 방생 하우징 모서리, 혀 모서리, G2 센서 거울 안 함, G4 위로, 격리 끝 축 x 1.5
    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
2026-11-14 [서현] (작업 중) 2단계 2차: 방생 하우징 모서리 더 깎음, 컵 받침 상자 밖만, 원래부터 있던 겹침 2개 허용
    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
2026-11-14 [서현] 전체 수정 2단계: 문 3개·격리 통로·대기 자리 옮김 — 바뀐 것과 S1·S2·S3 겹침 0 (원래부터 있던 2개 빼고), 새 부품 색 규칙
    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
    [s2_doors_v3.py]
2026-11-14 [서현] AI 로그: 전체 수정 2단계
    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
2026-11-14 [서현] 전체 수정: 새 마킹실(상자 38 + 아크릴판) + 리프트 mightyZAP + 문 3개 다시 배치(격리 −y) + 대기 (75, −40) → S2·D5g_full
    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
    [D5g_full.FCStd, S2_마킹부.FCStd]
2026-11-14 [서현] AI 로그: 전체 수정 3단계 (합침·바탕화면 복사)
    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
2026-11-14 [서현] (작업 중) 전체 수정 4단계: 마커 움직임 검사 스크립트 (X 37~75, Y −40~16)
    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
    [s2_motion_v3_check.py]
2026-11-14 [서현] 마킹실 상자 프린트 파일 다시 (혀 위 모서리 깎은 것 반영, 9.37 cm³)
    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
    [300_마킹실상자.FCStd, 300_마킹실상자.step, 300_마킹실상자.stl]
2026-11-14 [서현] (작업 중) 움직임 검사 빠르게: 9자세 + 움직임 범위 상자로 거름
    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
2026-11-14 [서현] (작업 중) 움직임 검사: 새로 놓였거나 옮긴 고정 부품만
    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
2026-11-14 [서현] (작업 중) 격리 세로관 y −95 → −135 (마커 X 이동 때 Y 모터·커플링에 닿음 — 움직임 검사)
    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
2026-11-14 [서현] (작업 중) s2_doors_v3: 옛 S2 백업에서 다시 시작 (두 번 옮기지 않게)
    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
2026-11-14 [서현] 전체 수정 4단계: 격리 세로관 y −135 (마커 X 이동 때 Y 모터와 닿던 것) → S2·D5g_full. 움직임 검사 통과 (펜 내린 높이 접촉 4개는 펜 들림 14로 비킴)
    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
    [D5g_full.FCStd, S2_마킹부.FCStd]
2026-11-14 [서현] AI 로그·cad README: 전체 수정 4단계 (움직임 검사, 격리 세로관 y −135)
    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
2026-11-14 [서현] 인터페이스 정의서: 구동기 1 mightyZAP, 11/14 변경 이력 (마킹실·문·대기 자리) + Issue #11, AI 로그
    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
2026-11-14 [서현] 펌웨어 바닥 F = mightyZAP PWM(D2, HOME=F 0 펄스+행정 시간, PRESS=F 10, 누름·F 원점 스위치 없앰), 대기 X +20·급이 F 2, 시뮬 91/91·89/89·Pi 36/36·53/53, 인터페이스 정의서·분업계획(승준 일 서현이 맡음) — Issue #11 (CAP-AI-62)
    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
    [Servo.h, controller.py, process.py, sim_motion.cpp, test_pi_link.py, test_process.py, trap_motion.ino]
2026-11-14 [서현] AI 로그: 승준 일 맡음 — 펌웨어 F mightyZAP·남은 순서 (CAP-AI-62)
    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
2026-11-14 [서현] 구매 다시 셈: 11/08 표 뒤 바뀐 것(리프트 v3·급이 펌프) 반영 — 약 45만~69만, 예산 넘음·주문 마감 지남·McMaster 원판 대체 (CAP-AI-62)
    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
2026-11-14 [서현] 바닥 원판 McMaster 90313A108(해외) → 아크릴 Ø32 × 2T 구멍 3.4 (격자판과 같이 주문 제작), M4 와셔 뺌, DXF 300f (CAP-AI-62)
    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
    [300f_아크릴바닥원판.dxf]
2026-11-14 [서현] 1차 주문 장바구니(DM·ICB 국내 재고, 약 25만): MG90S ICB, 비상 정지 25Φ, 펌프 Kamoer 12V+MT3608, RTC 뺌(시계 틀리면 여왕벌 철로), 인터페이스 정의서 (CAP-AI-62)
    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
2026-11-14 [서현] 바닥 원판 CAD 검사·AVR 컴파일 통과 기록, AI 로그 (CAP-AI-62)
    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
2026-11-14 [서현] 바닥 원판 아크릴로 바꾼 S2·D5g_full 다시 (s2_doors_v3 → full_merge, 움직임 검사 새로 닿는 것 없음) (CAP-AI-62)
    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
    [D5g_full.FCStd, S2_마킹부.FCStd, S2_마킹부_before_v3.FCStd, S2_마킹부_v3.FCStd]
2026-11-14 [서현] AI 로그: 프린트 부품 33개 남음, PC 커밋 기록 (CAP-AI-62)
    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
2026-11-14 [서현] 리프트 나사 정리: 열압입 인서트(인두 필요) → M3 태핑 밑구멍 Ø2.5, Ø6×4 스페이서(해외) → M3 너트+와셔 3, M5 스프링너트, mightyZAP 힘 줄이기 스케치 zap_setup (CAP-AI-62)
    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
2026-11-14 [서현] 마킹실 상자 프린트 파일 다시: 인서트 구멍 Ø4 → M3 태핑 밑구멍 Ø2.5 (9.56 cm³), 리프트 검사 겹침 0 (CAP-AI-62)
    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
    [300_마킹실상자.FCStd, 300_마킹실상자.step, 300_마킹실상자.stl, 300p_아크릴격자판.FCStd, 300p_아크릴격자판.step]
2026-11-14 [서현] 아크릴 묶음 DXF 100×90 2T (격자판 2 + 바닥 원판 2 — 아크릴몰 50 mm 밑 재단 불가 대응) + 미리보기 (CAP-AI-62)
    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
    [300pf_아크릴_묶음_100x90_2T.dxf]
2026-11-14 [서현] 부품정리 엑셀(1차 주문·리프트 나사·주문제작 사이트, 링크 확인), 리프트 나사 기록, AI 로그 (CAP-AI-62)
    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
    [부품정리_2026-11-15.xlsx]
2026-11-14 [서현] 프린트 부품 32개 출력 대행용 STL·STEP (cad/print/all), 비상 정지 판 구멍 Ø22.5 → Ø25.5 (KGE-J4R1R 25Φ) — S3·D5g_full (CAP-AI-62)
    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
    [102_collar.step, 102_collar.stl, 104_dome_coupling.step, 104_dome_coupling.stl, 110b_entry_bend.step, 110b_entry_bend.stl, 112_entry_gate_flap.step, 112_entry_gate_flap.stl]
2026-11-14 [서현] 엑셀 출력목록 시트(32개, 약 8.5만), cad README·AI 로그 (CAP-AI-62)
    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
    [부품정리_2026-11-15.xlsx]
2026-11-14 [서현] 엑셀 2차 기계 목록(지금 CAD로 셈)·아직 못 사는 것 11가지, AI 로그 (CAP-AI-62)
    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
    [부품정리_2026-11-15.xlsx]
2026-11-14 [서현] 세운 막대 밑 고정이 빠져 있던 것: L 브래킷 DCB 2025(−y 면) + M5 나사, 데크 구멍 스크립트·레이저 DXF(탭 → 관통 + 너트) (CAP-AI-62)
    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
2026-11-14 [서현] 자르던 부품 13개 출력 대행 파일(print/all2), 데크·위판 레이저 DXF(탭 → 관통 + 너트), 세운 막대 L 브래킷 + 데크 구멍, 인서트 없앰(카메라 걸이 태핑 Ø2.5·데크 너트), 바닥 F 드라이버 자리 지움 — S2·S3·D5g_full, 움직임 검사 새 접촉 없음 (CAP-AI-62)
    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
    [101_deck_레이저_5T.dxf, 105_top_plate_레이저_5T.dxf, 110_entry_duct.step, 110_entry_duct.stl, 111_entry_funnel.step, 111_entry_funnel.stl, 143_feed_trough.step, 143_feed_trough.stl]
2026-11-14 [서현] 엑셀(출력 45개·데크 레이저·2차 기계 고침), cad README·AI 로그 (CAP-AI-62)
    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
    [부품정리_2026-11-15.xlsx]
2026-11-14 [서현] s2_stdlen: 봉·T8 규격 길이 그대로(자르지 않음) + 218·212 구멍 끝까지, 움직임 검사 대상에 213·218 (CAP-AI-62)
    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
2026-11-14 [서현] 봉·T8 규격 길이 그대로 (X 봉 200, Y 봉 150, 핀 70, T8 150 ×2 — 자르지 않음), 218·212 구멍 끝까지 + 출력 파일 — S2·D5g_full, 움직임 검사 새 접촉 없음 (CAP-AI-62)
    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
    [212_beam_end_blocks.step, 212_beam_end_blocks.stl, 218_rod_supports.step, 218_rod_supports.stl, D5g_full.FCStd, S2_마킹부.FCStd]
2026-11-14 [서현] 엑셀 규격 길이 반영, cad README·AI 로그 (CAP-AI-62)
    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
    [부품정리_2026-11-15.xlsx]
